yohan924-ops/L6790A-Single-Stage-PFC-LLC-Converter/Design Guide/generators/README.md

# 도구 체인과 함정 — `Design Guide/generators/`

**스크립트 하나하나가 무엇을 하는지, 표준 절차와 기대값, SMath 시트의 구조가 여기 있다.**
"이렇게 하면 파일이 안 열린다 / 조용히 틀린다" 의 함정 목록은 `.claude/rules/` 에 있고 해당 파일을
건드릴 때 자동으로 로드된다.

**무엇이 어디 있나**

| | |
| :--- | :--- |
| **§9 도구 체인** | 스크립트 하나하나가 무엇을 하는가 · 표준 절차와 기대값 · Stop hook · BOM 대조 규칙 · SMath 시트의 19개 절 구조 · 시트를 PDF 로 뽑는 설정 · 진단 프로브 시트 |
| **§11 도구 함정** | → `.claude/rules/{smath,xlsx,figures,an}.md` 로 옮겼다 |

**절 번호가 9 와 11 인 이유** — 원래 `CLAUDE.md` 의 §9·§11 이었고 2026-09-22 에 턴당
토큰을 줄이려고 여기로 옮겼다. 두 문서에 걸린 README §9.3b · README §11.1 D-25 같은 참조가
수십 개라 **번호는 그대로 두었다.** 설계 내용은 `docs/DESIGN.md` 로 갔고(절 번호 1.3 · 3 · 4.2 · 4.3 · 5 · 6 · 7 을 그대로 가져갔다), 작업 규약은
`CLAUDE.md` 의 "절대 규칙" 절에 남아 있다.

---

## 9. 도구 체인 — 이것으로 전부 재생성·검증된다

전부 `Design Guide/generators/` 에 있고, 경로는 스크립트 기준 상대경로다.

| 스크립트 | 역할 |
| :--- | :--- |
| **`l6790.py`** | **수치 정본.** 가이드 식 [1]–[106] + θ 스윕의 검증된 참조 구현. **`zvs_edge(Q, λ)` 신설**(2026-09-17) — 용량성/유도성 경계의 닫힌형. `phase()` 의 분자를 0 으로 놓은 `f_n²` 의 이차식이고 수치해와 5자리 일치한다. 게인 피크와 혼동하지 말 것 (시트 §6.1 항목 8b) |
| `l6790_validate.py` | `l6790.py`가 240 W 예제를 재현하는지 한 번에 확인 |
| **`build_l6790_smath.py`** | 정본 시트 본문. 실행하면 **`l6790.py`와 22개 항목을 자동 대조**하고 결과를 찍는다 |
| **`zedpane.py`** | **ZedGraph 판(BinaryFormatter blob)의 바이트 편집기.** 축 범위·눈금 간격·숫자 서식·제목/범례 문자열·선 굵기·로그↔선형. 전부 `Reference/Smath Bode Plot Example/Zedgraph` 의 ZedGraph 5.1 소스에서 나온 것이고 추측이 없다. **판 크기(`set_size`)는 쓰지 말 것** — 함수에 이유가 적혀 있다 |
| **`harvest_pane.py`** | **SMath 가 키운 판을 떼어내 이 프로젝트 것으로 만든다.** SMath 는 판의 곡선 목록을 입력 개수에 맞추고 저장 시 되쓰므로, 4곡선 판에 8개를 먹이고 저장하면 8곡선 판이 파일에 남는다. 그것을 `panes/*.b64` 로 보관하고 곡선마다 이름(`set_curve_labels`)과 굵기를 준다. **새 곡선의 Label 은 빈 문자열을 *참조* 하고 있어** 그 참조를 문자열 레코드로 바꿔야 한다. 첫 Label 은 클래스 정의 레코드라 이름(`ZedGraph.Label`)으로 찾는다 |
| **`zedsheet.py`** | **TI 앱노트 판 카탈로그(트레이스 1~5개)와 `make()`/`emit()`.** 어느 판이 로그 x + 선형 y 이고 어느 판이 전부 로그인지가 표로 있다. `build_gainzed.py` 와 `build_l6790_smath.py` 가 같은 것을 쓴다 |
| **`smsheet.py`** | 레이아웃 빌더. **모든 수식 문자열을 두 번 파싱한다** — 한 번은 SMath RPN, 한 번은 Python SI 값. 따라서 인쇄된 값이 옆의 수식과 어긋날 수 없다 |
| **`check_theta.py`** | **`prog` 블록(벡터 대입)을 검사하는 유일한 도구.** 다른 모든 수식은 `smsheet` 가 RPN 과 Python 으로 **두 번** 파싱하므로 인쇄된 값이 옆 수식과 어긋날 수 없는데, 벡터 대입은 인쇄되는 값이 없어 오타가 어디에도 안 나타난다 — 시트가 틀린 곡선을 그럴듯하게 그릴 뿐이다. 빌더에서 수식 **문자열을 꺼내** Python 으로 평가해 시트 §8 의 닫힌형과 대조한다(θ=π/2 에서 `f.sw.a`·`f.sw.b`, θ→0 에서 `f.o`, 그리고 시트 §7.5 의 `M.Z`·`M.OL`) |
| **`check_sm.py`** | 완성된 `.sm`을 다시 훑는다: XML 적합성 / 리전 겹침 / 우측 여백 초과 / 텍스트 재줄바꿈 / 허용 밖 함수 / 쪽수·그래프·노란 셀 수 |
| **`bom_compare.py`** | **엑셀 ↔ SMath BOM 29항목 대조** — 빠르다. hook이 매번 돌린다 |
| `fix_xl_cardano.py` | **`RTC` 격자 탐색을 Cardano 닫힌형으로** — 18블록(행 220–234). `rtc_check.py` 로 편차 0.0000 % 확인 |
| `fix_xl_fbcorner.py` · `fix_xl_fnmax_shared.py` | `Vin_max` 를 FB 코너(332.34 V)로 + `fn.max` 클램프. **후자는 공유 수식을 깨뜨려 되돌렸다** — `HISTORY.md` 시트 §3.7 |
| `fix_xl_ipri.py` | 1차 실효의 θ=0 끝점(자화 전류) |
| `fix_xl_f.py` | 실현 출력전압을 `Design Spec` 에 표기 |
| `fix_xl_cc.py` | **원인 B(C.18) 수정** — `CC` 에 θ 3열 + Simpson 적분(열 J)을 넣고 설계를 거기에 연결. 적용됨 |
| **`fix_xl_simpson_refs.py`** | **살아 있는 참조 위에 손으로 적은 상수가 얹혀 있었다** — C.18 이 `CC` 에 Simpson J열을 만들고 세 셀만 연결했다. `Power Components` D60·D61·D84·D85 는 θ=π/4 한 점(`CC!C..`)을 읽은 채 F열 손입력으로 덮여 있었다. J열로 연결하고 손입력 4칸 삭제 |
| **`fix_xl_comp.py`** | **kT 를 1 에서 2 / 1.5 로** — 데이터시트 max 는 25 °C 공정산포이지 온도가 아니다. 그리고 **`V.Fo` 1.45 → 1.15 V** — 이 한 입력이 두 문서의 R_B 창을 **겹치지 않게** 벌려 놓고 있었다. R_P 1.3 k · R_B 6.2 k |
| **`fix_xl_trunc.py`** | **[64] 가 [63] 과 다른 파형을 제곱하고 있었다** — 공진 위에서 사인이 잘리는데 실효값은 온전한 반사인파로 계산했다. `CC` 25·31·32행에 절단 인수 [64a]. **저입력에서는 인수가 정확히 1 이라 값은 하나도 안 움직인다** |
| `fix_xl_bodydiode.py` | 1차 스위치 블록에 바디 다이오드 역회복 **조건** 2행 (`Power Components` D74·D75) |
| **`fix_xl_fet.py`** | **FET 선정 결함 4건** — 1차 전류 정격을 합성 탱크 피크로 · 병렬 소자 수와 소자 1개당 전류 4행 · Rdson 온도계수 · 다이오드/SR 선택. `audit_fet.py` 가 찾아낸 것들 |
| `fix_xl_fnmax_num.py` | `RTC` 26·27행 `#NUM!` 288칸. 원인 E 이후 요구 게인이 무부하 점근선 아래로 내려가 `fn.max` 의 해가 사라졌다. `CG26` 의 가드를 전 열에 적용 |
| **`fix_xl_english.py`** | **워크북을 한 언어로.** 한글 57칸(CHANGELOG 50 + 라벨 7)을 영문으로. 수식·참조·수치는 손대지 않는다 |
| **`log_xl_findings.py`** | **셀은 안 건드리고 워크북 CHANGELOG 에만 기록한다.** 두 가지 — ① `CC` J열 Simpson(7점)과 시트의 5점 규칙을 2000구간 격자와 대조했더니 **0.0011 % · 0.0013 %** 낮다(성긴 적분이 정당하다는 증거가 없어 나중에 '개선'되거나 의심받을 자리였다) ② **`Design Spec D43`(fsw.max)은 탱크의 *상류*다** — `Res. Tank Design D13·D14` 가 그것으로 나누므로 **λ 를 계산하고 따라서 `L.m` 을 계산한다.** `Device Setting` 의 오실레이터 천장과 종류가 다르다 |
| **`log_xl_unlogged.py`** | **CHANGELOG 에 빠진 변경을 채운다.** ST 원본과 설계 시트 7장을 수식·상수 단위로 대조해, CHANGELOG 열 C 가 부르지 않는 셀에 한 줄씩 쓴다(Was/Now 는 두 파일에서 읽고 Why 만 적는다). 셀은 안 건드리고 calcChain 도 보존. 다시 돌려도 더하지 않는다. 인자로 변형 워크북을 줄 수 있다 |
| `fix_xl_causes.py` · `log_xl_causes.py` | **원인 A·C·D 의 셀 수정과 그 CHANGELOG 기록.** 이미 적용됐다. 다시 돌려도 안전하다 — 적용 여부를 보고 건너뛴다 |
| **`rtc_check.py`** | **`RTC` 격자탐색의 *답*을 독립 solver 둘과 대조** — 18점(θ 6 × 입력 3). 10,008셀을 읽는 대신 결과를 본다. 셋이 코드를 공유하지 않으므로 격자가 깨지면 반드시 어긋난다 |
| **`audit_xl.py`** | **워크북 구조 감사** — 죽은 셀 · 오류값 · 빈 셀 참조 · **선정값이 자기 한계 밖** · 수식에 박힌 상수 · 라벨/수식 방향 불일치 · **선정값을 무시하고 계산값을 읽는 곳** |
| **`audit_sm.py`** | **시트 구조 감사** — 죽은 변수 · 정의 전 사용 · **한계는 있는데 비교가 없는 짝** · 설명 없는 판정값 |
| **`audit_rpn.py`** | **`.sm` 의 RPN 을 되읽어 독립 평가.** 인쇄된 값은 smsheet 의 Python 계산이고 SMath 가 실제로 도는 것은 RPN 이다. 둘이 같은지 보는 유일한 검사 |
| **`audit_dim.py`** | **차원 해석.** 두 평가 경로 모두 단위를 스칼라로 다루므로 `V + A` 를 못 잡는다. 표시 단위가 계산 차원과 맞는지도 본다 |
| **`sr_xl.py`** | **1회성, 83차 적용** — STL160N10F8 데이터시트를 워크북에: `Power Components` C92 부품명 TPH3R70APL1 → STL160N10F8 · D96 `RD` 0.0037 → 0.0032 Ω · D98 `kT.sec` 1.9 → 1.5(둘 다 빌더 상수에서 읽음), `CHANGELOG_rev0_6` 에 기록, 변형 사본에 복사. 두 번 돌려도 같다 |
| **`lge200_xl.py`** | **LGE 구버전 워크북 이식, 2026-10-16** — LGE 가 ST 구버전(시트 보호) 워크북에 넣은 입력을 벤치 사본(`measured200_xl.py` 산출물) 위에 얹어 `Calculation Excel Sheet/variants/BENCH_200W_LGE_workbook_unencrypted.xlsx` 를 쓴다. 회로도와 대조해 17칸을 넣고(C_r 117 nF · BM 접지 · n_aux/n_sec 1.5 · c.HB 5529 pF(2.2 nF 스너버와 D–S 150 pF 포함, LGE 의 500 pF 대신) · 보상망 470 nF/4.7 µF/10 k/1.6 nF(사용자 채택 권장값, 보드는 아직 220 nF/2.3 µF/22 k) · V_Z 11.74 V(R197 100 k 결정) · UPC1008 CTR 0.54/0.65(UTC DS 곡선, 등급 최소) · 부품명 등) Vin.min 180 과 Vrect 0.395/STPS30M60S 는 넣지 않았다(사유는 스크립트 머리말). 캐시는 Excel 에서 열어야 맞는다. 기록: `docs/THREE_CORE_BOARD.md` |
| **`x3m3_xl.py`** | **3코어 670 W 워크북, 2026-10-18** — 가이드 워크북을 `Calculation Excel Sheet/variants/3CORE_670W_workbook_unencrypted.xlsx` 로 복사하고 두 설계가 다른 입력만 바꾼다. 값은 전부 `Smath/variants/L6790A_7p5to1_x3m3.sm` 의 입력 셀에 적힌 숫자에서 읽는다(표시값이 아니라 — R_T 는 표시가 한 자리라 7.7 로 읽힌다). 바꾸는 칸: 탱크 F9 · F43 · F44 · F45, `Device Setting` F24 R_T; LG 보드의 피드백 부품 · 출력 뱅크(V_Z 11.74 V · UPC1008G-LS04-R · TL431G-AE2-R · R_B · 보상망 · C_fx · PX 6800 µF × 11 · h 37 mm); 같은 보드의 1차단 c.HB 3329 pF · Cpar 400 pF(C115/C117 은 레그 양단이라 제외); SR TPH3R70APL1 3.7 mΩ · k_T 1.9. 가이드 워크북의 부하별 합성 피크 블록(`peak_xl.py`)은 복사에 따라온다. 확인: LibreOffice 재계산 사본으로 `SM_OVERRIDE=<x3m3 시트> XL_OVERRIDE=<사본> python xl_sm_compare.py` → 153/153, `rtc_check` OK. 가이드 워크북은 건드리지 않는다 |
| **`peak_xl.py`** | **부하별 탱크 피크 전류(자화 + 부하), 2026-10-18 · 10-19 다시 배치**(사용자 "수식이 너무 많고 뭐가 뭔지 모르겠다 — Res. Tank Design 에 기존 양식으로 간단하게"). 결과는 `Res. Tank Design` 70–79행, 기존 "Estimated transformer current" 표와 같은 Parameters / Name / Value / Unit 양식으로 7줄: I.Lm.pk(자화 피크, 어느 부하든) · I.Lm.zc(라인 영점 f.Min 의 자화 피크) · ld.add(부하전류가 피크에 더해지기 시작하는 부하, 50 % 점 기울기로 근사) · Ilr.pk.25/50/75/100. 중간 계산은 계산용 시트 `CC` 59–74행에 그 위 블록과 같은 모양으로(부하 0 · 25 · 50 · 75 · 100 % 를 C–G 열, 3차식으로 f_sw 를 다시 풀고 Itrafo · Ilm · r.mix · 합성 피크). 전부 살아 있는 수식이고 기존 칸은 바꾸지 않는다. 100 % 값은 `Device Setting` D32 와 1.0000. 시트 §9b 와 같은 계산 — `xl_sm_compare` 8항목. 멱등(CHANGELOG 표식). 세 워크북에 적용 |
| **`bench200_sync_xl.py`** | **200 W 벤치 워크북을 670 W 워크북과 맞춘다, 2026-10-18**(사용자 "서로 맞춰야 할 것은 맞추도록") — 같은 보드 하드웨어를 적는 다섯 칸만: t.D 270 → 220 ns · h 30 → 37 · ESR.single 30 → 50.7 mΩ · kT.pri 1.8 → 1.9 · Cpar; 두 번째 패스(같은 날, 사용자 지적)로 **c.HB 5529 → 3329 pF · Cpar → 400** — C115/C117 2.2 nF 는 레그 양단(VBUS–PGND)이라 중점 용량이 아니다. 실측 트랜스포머 · 실장 제어 부품 · 200 W 뱅크 · 보상망 · BM 접지 · R_CFG 는 그대로. 멱등 |
| **`fet_xl.py`** | **1회성, 81차 적용** — STO60N045DM9 데이터시트를 워크북에: `Design Spec` D46 `c.HB` 800 → 3028.98 pF(`l6790.PRI_FET` 로 계산, 손으로 적지 않음) · `Power Components` D58 `kT.pri` 1.8 → 1.9 · D72 `Cpar` 10 → 100 pF, `CHANGELOG_rev0_6` 에 기록, 변형 사본에 복사. 두 번 돌려도 같다 |
| **`gate_xl.py`** | **게이트 드라이버 선택 · 기동 조건, 2026-10-22**(사용자 아홉 차례 — 마지막: "출력 저항이 어디는 0 어디는 10.71 Ω — 뭔가; BOM 탭에도 게이트 드라이버단 회로도"). `Power Components` 에 행을 **끼워 넣는다**(`xl_rows.py`): **76–83** 스위치 게이트 데이터(C.g · C.gs.dev · R.g · V.pl · V.th · V.th.min · Q.gd · V.gs.max), **89–174**: 빈 행 2 · **91 "LLC Half Bridge Gate Driver Selection"** · 빈 행 2 — ① 드라이버 품번 + 데이터시트 값(노랑: I.so · I.si · V.test · V.cc.min/max · t.pd · MT · t.DT · f.max · I.Q · Rth.drv · Tj.max · V.bo.min · dV/dt.max · V.hs.max · V.IH.max · Ta.drv) 과 **출력 저항 R.o.src · R.o.sink 는 Value = V.test / I.so · I.si(단락 전류에서 유도), Selected Value(노랑, 비움) = 데이터시트가 직접 주는 값이 있으면 그것** — 계산은 Selected 가 있으면 그것, 없으면 Value ② 부트 다이오드 품번 + V.F · V.RRM · I.F · I.FSM ③ 턴오프 다이오드 품번 + V.F(0 = 없음, GOFF 분리) · I.F · I.FSM ④ 회로망은 한계 행 + 별도 Select 행(Value = 제안, Selected = 설계, 판정 없음): V.drv · R.on(max = 짧은 펄스 안 10 V, min = max(드라이버 온도, 소스 전류) − R.so − R.gi) · R.off(eff.max = min(겹침 · 소프트 턴오프 · Miller), min = 싱크 전류 · D.off 서지) · C.gs(max · min) · C.boot · R.boot(min = D.boot 서지) ⑤ 최종 값 — 판정 12(k.IG · R.off.eff · k.tD · k.tD.su · V.g.su · V.bs.1 · k.Miller · k.drv · P.drv(Ta.drv) · f.SU · k.D.boot · k.D.off); 회로도(`xl_gate_fig.py`: U.drv1 · D.boot · C.boot · R.boot · R.on · R.off · D.off · C.gs — BOM 이름과 같음)는 G 열. 옛 76–80행은 84–88, 옛 81–119행(2차 섹션)은 **175–213**. **`BOM&Schematics` 91–105 "Gate driver and gate network"**: 품번 표(U.drv1/2 · D.boot · D.off)와 값 표(V.drv · R.on · R.off · C.gs · C.boot · R.boot), 살아 있는 링크, **같은 회로도를 I91 에**, 틀 아래 테두리 행은 내려감(BOM 은 공유 수식이 있어 `xl_rows` 대신 손으로). `Res. Tank Design` 81–87: I.su · k.su.OCP2 · k.su.OCP1 · f.su.OCP1. 중간 계산 `CC` 77–167(L6790A 가정 셋: 기동 데드타임 420 ns · FB 버스 235 V · V.OH 4 V, 부트 다이오드 동저항 0.5 Ω 가정 — 부트 식 다섯이 (R.boot + 0.5 Ω) 로 통일). 선정값: 가이드 · 3코어 = 시트 §14c.1 부품에 V.drv 15 V(사용자), 벤치 = LGE 보드. 확인: 기존 셀 전부 같은 값, `xl_sm_compare` 153/153, `bom_compare` 29/0, `rtc_check` OK; 행 번호 도구 다섯은 새 번호 |
| **`restore_emf_xl.py`** | **ST 원본의 EMF 그림 셋을 되살린다**(2026-10-22, 사용자 "VCO 같은 회로 이미지가 다 지워졌다") — `Device Setting` I19 Picture 75(image9.emf) · I108 Picture 3(image8.emf) · `BOM&Schematics` C62 Picture 71(image8.emf). openpyxl 이 EMF/WMF 를 떨어뜨려("image format is not supported") 초기 사본에서 사라졌던 것. 앵커 행이 세 워크북과 원본에서 같아(확인함) 원본 앵커를 그대로 복사하고 rId · 도형 id 만 새로 매긴다, `[Content_Types]` 에 emf Default 추가. 멱등(앵커 이름 존재) |
| **`xl_rows.py`** | 워크북 한 시트에 **행 끼워 넣기**(Excel 의 행 삽입을 XML 로) — 그 시트의 셀 · 행 · 병합 · 범위 · 선택, 모든 시트의 그 시트 참조(범위 포함, 문자열 리터럴 제외), 그림 앵커 · 메모 · VML 앵커를 같이 옮긴다. 공유/배열 수식 · 조건부 서식 · 데이터 유효성 · 이름 정의 · 차트 참조가 있으면 거부 |
| **`xl_gate_fig.py`** | 워크북 게이트 드라이버 섹션 옆 회로도 `figures/xl_gate_drive.png` — 레그 하나: 하프브리지 게이트 드라이버(품번 · 핀 번호 없음, IN.H · IN.L · VCC · GND · BOOT · HO · HS · LO) · 부트스트랩(R.boot · D.boot · C.boot) · 스위치마다 R.on · R.off + D.off · 선택 C.gs. 초록 이름 = 워크북 행 이름, 값은 그리지 않아 세 워크북 공용 |
| **`xl_sm_compare.py`** | **엑셀 ↔ SMath 전량 대조 135항목** — 사양·전력예산·탱크·전류·출력뱅크·IC정수·루프·보상망. 차이마다 `same` / `INTENDED`(사유 인쇄) / `** DIFF` 로 판정. **워크북을 손댔으면 이걸 돌린다** |
| **`xlsx_patch.py`** | **워크북 XML 안전 편집.** `set_cell()`(교체-또는-순서맞춰-삽입) + 쓰기 전 전 시트 구조 검사. 인자 없이 실행하면 현재 워크북을 점검만 한다 |
| **`snapshot.py`** | **CLAUDE.md 시트 §3을 시트에서 다시 만든다.** `--check` 신선도 검사 · `--picks` 노란 셀(사람이 고른 값) 목록. 지난번 대비 무엇이 움직였는지 찍어 준다 |
| **`smresult.py`** | **`<result>` 블록의 값을 제대로 읽는다.** `<result>` 도 RPN 이라 첫 토큰만 읽으면 **단항 마이너스와 지수가 통째로 사라진다.** 도구 4개가 같은 가정을 독립적으로 하고 있었다 (`HISTORY.md` 시트 §6.6) |
| **`audit_fet.py`** | **1차·2차 FET 선정 파라미터 감사** — LLC 가 요구하는 항목별로 워크북 셀과 SMath 변수가 *있는지* 와 *수식에 쓰이는지* 를 따로 판정한다. 있는데 안 쓰이는 쪽이 더 위험하다 — 검토한 것처럼 보인다. 온도 정합성(Rdson 25 °C ↔ Tj 125 °C)도 함께 본다 |
| **`cores.py`** | **코어의 카탈로그 값과, 그것으로 푸는 권선 기하.** 코어는 하나 — **PQ 50/50(TDK B65981A · N97, 카탈로그 보빈 B65982E 12핀, `CHOSEN`, 72차)**. 3코어 설계점의 PQ 40/40 은 2026-10-01 에 지웠다. `CORES` 는 데이터시트의 전자기 값, **`MECH` 는 치수도의 기계 치수**(TDK PDF 벡터에서 읽음: 바깥다리 원호 반경 `r_win_out` 22.0 · 공차 끝 `r_win_min` 21.65, 나비넥타이 요크 `wing` · `leg_y`, 플랜지 끝 반경 `r_rim`, 튜브 `tube_od`/`tube_max`, 권선 폭 `wind_w` 30.4, 핀 피치). `zones(name, ρ)` 가 반경 ρ 의 한 턴을 바깥다리 옆 · 요크 밑만 · 코어 밖 세 구간 길이로 나누고(`YOKE_SHARE` 0.5 는 가정), `turn()` 이 그것으로 평균 턴을 낸다. **`winding(V)` 가 권선을 배치하고 `report(V)` 가 그 산수를 인쇄한다** — 단면도(`figs_ref.an_core_section`)는 결과를 그리기만 한다. **들어가지 않으면 `fits` 가 False, `why` 에 이유.** 배치는 **섹션 권선**: 튜브 쪽에서 1차 한 칸(`PRI_LAYERS` 3층 × 5 T, TIW-Litz `D_PRI` ø2.9) | 칸막이 `PARTITION` 3.0 mm | NS2 한 층 → NS3 한 층(`SEC_PER` 2 T 나란히, Litz `D_SEC` ø4.0) + NAUX, **턴당 한 가닥(`PRI_PAR` · `SEC_PAR` 1) · 뒤집기 없음**. 선경은 둥근 값으로 정했다(사용자). 층 사이 피치 `K_WIND` 1.10(가정), 층마다 테이프 `T_TAPE` 0.05 mm(가정), 축 방향 피치 `k_ax` 는 두 칸과 칸막이가 권선 폭을 정확히 채우도록 넓힌다. 반환값에 `build` · `room_min` · `clear_min` · `clear_nom`(원호까지 여유). 핀은 `BOBBINS` — 핀당 한 가닥, 센터탭은 보드에서 잇는다(핀 9 · 10). **핀 번호 방향은 도면의 1 · 6 · 7 · 12 표시에서 읽었다.** 옛 나란히 감기 + 포일 배치는 **`winding_v64()`** 로 남았다 — 이식 전 한국어판(`an_kr_body.py`)이 그 키를 읽기 때문이고, 이식 때 지운다 |
| **`bobbin_outline.py`** | **B65982E 보빈 윤곽을 데이터시트 벡터 도면에서 읽는다.** `data/TDK_B65982E_coil_former.pdf`(TDK databook 04/13 p. 287, 도면 FPK0433-H, 1:2) → `data/B65982E_outline.json`(밑면도 · 정면도 · 윗면도의 윤곽 · 숨은선 · 핀, mm). 굵은 선(0.57 pt)=윤곽, 짧은 점선(0.29 pt)=숨은선, 0.38 pt=핀; 치수선 · 글자 · 중심선은 버린다. **뷰 이름이 도면에 없어서 판단 근거를 코드에 적었다**: 핀 끝이 원으로 보이고 1 · 6 · 7 · 12 가 적힌 뷰(정면도 위)가 밑면도, 핀이 없는 뷰(정면도 아래)가 윗면도 — 제1각법. `--check` 가 도면 치수(핀 12개 · 줄 간격 45.72 · 피치 7.62 · 그룹 간격 12.7 · 높이 51 · 폭 51.6 · 실장면 위 높이 52.5)와 대조(선 두께 때문에 윤곽은 +0.4 mm 쯤). 그림 45(`figs_ref.an_xfmr_pins`)가 읽는다 — 핀 위치는 `cores.PIN_XY`(치수값), 윤곽 모양만 이 파일 |
| **`leakage_fem.py`** + **`fem2d.py`** | **그린 권선의 누설 — PQ 에서의 기준.** `fem2d` 는 2D 유한체적 A_z 풀이기(scipy), `leakage_fem` 은 `cores.winding()` 배치를 두 단면(바깥다리를 지나는 코어 단면 · 턴이 코어 밖으로 나가는 끝단 단면)으로 풀고, 반경마다 `cores.zones()` 의 턴 길이로 가중한다. `estimate(V, only='NS2'|'NS3')` 가 반쪽 단락, 기본은 둘 다 단락. `gap_len(V)` 는 L_open 에 맞는 갭(프린징 포함, 이분법), `proximity(V, f)` 는 스트랜드 와전류(부하 전류 + 자화 전류 직교 합), `dc_loss(V)`, `self_test()`(1D 닫힌 식과 5e-5), `report(V)`. 결과는 `.fem_cache.json`(무시 파일)에 저장. `MU_R` 2000 은 가정. 이 복사본 값: 반쪽 **NS2 24.50 · NS3 25.14 µH**, 둘 다 단락 **23.09 µH**(요크 몫 0–1 에서 21.89–24.29), 꽉 감으면 23.20, 칸막이 2.5 mm 22.50 · 2.0 mm 21.92, 갭 1.784 mm(프린징 없으면 1.341), 구리 직류 2.27 W |
| **`leakage.py`** | **1D 해석식 누설(Roth 급수 + 창 밖).** 턴 길이를 하나(`l_N`)로 두어 PQ 의 깊은 권선에서 **반쪽 순서를 거꾸로 낸다**(NS2 > NS3) — PQ 에서는 기준이 아니고 `leakage_fem.py` 가 기준이다. AN 의 1D 상한 추정 한 줄에만 쓴다 |
| **`figstamp.py`** | **그림이 낡았는가 — 다시 그리지 않고 판정.** `figs.save()` 가 PNG 마다 설계값 해시(`an_pdf.V` · `SH` · `cores.winding`)와 그린 함수의 소스 해시를 새기고, 이 스크립트가 지금 값과 대조해 `STALE` 을 찍는다(exit 1). **65차에 넣었다** — 64차가 `n.aux` · 개방시험 전류를 바꾸고 그림 1장만 다시 그려 핀 그림에 "NAUX 3 T", 기자력 그림에 15.19 A 가 남았고, 63차의 "2 ×" 수정도 `f13_morphing` PNG 에 반영된 적이 없었다. **Stop hook 의 6번째 검사.** 설계값이 움직이면 전 그림이 STALE 이 되므로 `figs.py --plain` 전량(약 10분) |
| **`insulation.py`** | **트랜스포머 안전 절연 — 미국 · EU · 일본 · 한국 · 중국 가정용 AV.** 요구치(강화 · 5000 m · 공간 4.5 · 연면 6.4 · 고체 0.4 mm / 테이프 2층 · 3000 V ac)와 **출처 URL**(`SOURCES`), 설계에서 추정한 작업전압(`working_voltage`), **경로마다 무엇이 절연을 맡는지**(`checks` — TIW 선재 · 핀 줄 간격 · 열린 항목 둘), 열린 항목(`OPEN`). `separation_min()` 은 "간격이 절연을 맡는다면"의 값(6.4 mm)으로 AN 6.17 과 `winding_v64` 가 읽는다. `cores` · 벤더 사양서 5절 · AN 7.12 가 여기서 읽는다. `python insulation.py` 가 보고서를 찍는다(약 20 s — `an_pdf` 를 읽는다) |
| **`figcheck.py`** | **그림 기하 검사 — `check_sm.py` 의 matplotlib 판.** 여섯 가지를 본다 — 글이 **남의 패널에 떨어지는가**(`wrong-panel`, 같은 자리의 twin 축은 한 패널로 친다) · **틀 밖으로 나가는가**(`off-page`) · 글이 **선 위에 앉았는가**(`on-ink`) · 글끼리 겹치는가(`text-text`) · **배선 5종**(`no-dot` 점 없는 T · `open-end` 허공에 끝나는 배선 · `crossing` 홉도 점도 없는 교차 · `off-grid` 45° 격자 밖 · `stray-dot` 두 가닥만 만나는 점) · **인쇄 축척에서 6.5 pt 미만 글자**(`tiny`, 실패가 아니라 보고 — 2026-09-23 부터 범례·눈금·축 이름·제목·`fig.text` 까지 잰다. 전에는 `ax.texts` 만 재서 11.6 in 폭 그림의 범례가 5 pt 로 인쇄돼도 통과했다. AN 에 배치되지 않은 그림은 인쇄 폭을 몰라 판정하지 않는다). **글·선 겹침은 픽셀로 잰다** — 그림을 두 번 렌더해(그대로 / 글자 alpha 0) 차이가 글자, 둘째 렌더의 잉크가 선이고, 겹친 픽셀 수를 센다(바닥 10 px). 꼭짓점만 보던 예전 검사는 점 2개짜리 배선 사이에 앉은 글자를 전부 통과시켰다. **검사 대상은 `figs.finish(fig)` 를 부른 뒤의 그림**이고 좌표는 `figs.saved_box(fig)` 기준 비율이다 — `bbox_inches=tight` 는 캔버스가 아니라 잉크를 자르므로 캔버스 기준으로 재면 1인치 넘게 어긋난다. `figs.save()` 가 저장 직전에 `shield()` 를 불러 **선 위에 앉은 글에만** 흰 후광을 입힌다 — 회로도 축은 건드리지 않는다(후광이 배선을 끊는다). `--crops DIR` 로 겹친 곳마다 확대 조각을 저장한다. 경위는 `HISTORY.md` 2026-09-21 |
| **`an_sentences.py`** | **긴 문장 찾기**(84차). 빌드된 PDF 의 글을 문장으로 잘라 길이 분포와 한계(기본 40 단어, 인자로 바꿈) 넘는 문장을 쪽 번호와 함께 낸다. 목차의 점선 · 표 칸 · 번호 목록은 문장이 아닌데도 섞여 나오므로 눈으로 거른다. `--kr` 은 한국어판(문장 끝의 마침표에서 자른다 — 어절 수는 기호 토큰 때문에 과소이니 글자 수로 볼 것; 84차 한국어 이식 때는 ast 로 소스 문자열을 꺼내 80자 기준으로 봤다) |
| **`diode_survey.py`** | **회로 다이오드의 인쇄 크기 조사**(84차). 그림을 figcheck 처럼 그려 기록된 `diode` 기호마다 지면 pt(figcheck 의 `_page_pt`)로 환산해 그림별 최소·최대를 낸다. 기준은 모드 시트의 16 pt; 절반이면 그 그림의 `ax._sym_mult` 를 올린다. MOSFET 바디 다이오드는 일부러 작게 그리므로 기록하지 않는다. `--kind mosfet` 이면 스위치 기호의 인쇄 높이(모드 패널 40 pt · 18 pt 에서 채널 막대가 붙었다) |
| **`an_figtext.py`** | **그림 속 글자 검사**(2026-09-23 신설, 53차). 다른 검사는 본문(`an_symbols`)이나 그림의 기하(`figcheck`)만 읽고 **그림 안에 그려진 기호·숫자는 아무도 읽지 않았다** — NS2/NS3 뒤바뀜, 같은 양의 두 이름(v_tank/v_d), 회로에 자리가 없는 파형 양이 거기 있었다. 그림마다 그려진 글자를 저장 시점에 모아 ① **UNDEFINED** 기호표에 없거나 그 그림 앞 본문·캡션·앞선 그림 라벨에 없는 기호 ② **LITERAL** 그림을 그린 함수들(프로파일러로 호출된 `figs*` 함수 전부)의 **문자열 리터럴 안에** 있는 단위 붙은 숫자 — 손으로 적은 값 ③ **USES** 기호별 사용 그림(이름 불일치 발견용)을 낸다. 약 6분. 남는 LITERAL 은 관례값(400 V 버스, 100/120/230 Vac 상용전원, 측정 조건 예, 180°)뿐이다 |
| **`schemx.nodot()`** | **도면이 “여기는 접점점을 일부러 안 찍었다” 고 선언하는 자리** (2026-09-21). 세 가닥이 만나면 관례는 점을 요구하므로 `figcheck` 가 `no-dot` 으로 잡는데, 뺄 이유가 있는 자리는 **검사를 느슨하게 하는 대신 도면이 사유를 등록한다** — 안 그러면 다음번 진짜 누락이 같은 침묵에 묻힌다. 검사기는 `nodot` 으로 **보고하되 세지 않는다**(레일 `stub` 과 같은 취급). 지금 쓰이는 곳은 8구간 시트의 센터탭 하나다 |
| **기호 크기 규칙** (`schemx.scale`) | **기호는 *자기 그림 폭에 비례* 한다** — 데이터 단위 고정도, 가지 길이 비례도 아니다. `scale = max(자기 폭 / `REF_SPAN` 22.45, (자기 폭 / 축의 그림 폭 비율) / `REF_FIGSPAN` 46.0)` — 바닥 규칙은 "종이 위에서 8구간 패널의 기호보다 작아지지 않는다" 는 뜻이다. **바닥은 축의 *명목* 위치를 읽으므로 `subplots_adjust` 를 그리기 *전에* 부른다.** **권선은 턴 *반경* 을 고정하고 턴 수를 높이에서 뽑는다**(반대로 하면 긴 권선의 턴이 커진다). 코어 바 길이는 턴 반경에 비례하고, 극성점은 리드선 **바깥쪽 · 첫 턴 높이**에 둔다. **`schem.ind` 의 리드 흡수 판정은 `s` 의 비율이 아니라 턴 반경의 절반이다** — 비율로 재면 큰 인덕터에 1 px 리드가 남아 **없는 3갈래 접점**을 만든다. 현재 값 cap 0.56–0.64 · res 1.15 · turn 0.26–0.30 · winding 0.54–0.60, 회로 다이오드 0.52/0.56, **바디 다이오드만 0.26**(기생 소자). **8구간 패널은 명시 크기를 쓰므로 픽셀 단위로 그대로다.** 경위는 `HISTORY.md` 2026-09-21 |
| **`audit_guide.py`** | **가이드 수식 태그 감사** — 중복 태그 · 끊어진 참조 · 코드에 대응이 없는 식 |
| **`an_pdf.py`** | **PDF 레이아웃 엔진 (영문·한국어 AN 공용)** — 표지·법적고지·점선 목차·머리글·번호 붙은 수식(matplotlib mathtext → PNG)·그림/표 캡션. `T()` 가 **포맷 안 된 `%%`·`%(…)` 를 거부**한다 |
| **`an_body.py`** | **AN 본문.** 레이아웃과 분리돼 있고 **손으로 적은 상수가 없다** — 전부 `an_pdf.V` 보간 |
| **`figs.py`** | 그림 생성 — 교육자료 영문 · 가이드 한국어. **한글 글꼴이 없는 PC 에서 한글 그림을 쓰면 죽는다**(2026-09-21 `_hangul_guard`) — 이 컨테이너에는 맑은고딕·나눔이 없어 한글이 전부 네모로 그려지는데 **파일은 그대로 써져서** 좋은 PNG 를 덮어쓴다. 실제로 `loop_bode.png` 가 한 번 그렇게 됐고 `git status` 가 잡았다. `save()` 가 쓰기 직전에 한글을 세어 글꼴이 없으면 그 장을 **건너뛰고**, 끝에 어느 장을 다시 그려야 하는지 찍고 **exit 2** 로 끝난다 (한국어 전용 5장: `fsw_theta`·`gain_regions`·`loop_bode`·`morphing_levels`·`tank_current`). 처음에는 예외로 죽였는데 그러면 **영문 배치 작업이 첫 한국어 그림에서 멈춘다** — 조용히 건너뛰는 것도, 전부 세우는 것도 답이 아니다.  수치는 전부 `l6790.py` 에서 가져온다. `f15`~`f17` 모핑 브리지 3장, `f19` 출력뱅크 판정식. **`--plain` 은 제목을 빼고 `figures/an/` 에 쓴다**(AN 용). **`_morph_levels(T)` 는 두 언어가 같은 그리기 코드를 쓴다** — 복사하지 말 것 |
| **`figtrim.py`** | **참조 PDF 에서 잘라 온 그림 아래에 딸려 온 *원문 캡션 조각*을 찾아 잘라낸다.** 서명이 분명하다 — **맨 아래 가장자리에 닿는 얇은 잉크 띠 + 그 위의 넓은 공백**. 진짜 그림의 패널은 이미지 경계에서 잘리지 않으므로 이 모양은 캡션 조각뿐이다. `--fix` 없이 돌리면 보고만 한다 |
| **`pdffig.py`** | **참조 PDF 에서 그림을 캡션째 잘라낸다.** 캡션을 텍스트로 찾아 앵커로 삼는다. 벡터 도면(onsemi·Infineon)은 위로 훑고, 래스터 그림(MPS)은 이미지 사각형이 곧 정답이다. `list`/`show`/`get` · `--box` 로 수동 지정 |
| **`figedit.py`** | **참조 그림에 가하는 *기록된* 편집.** **`fix_freewheel_2nd_half()`** 가 Infineon Fig 2.8 의 전류 경로를 다시 그리고(시트 §6.1 항목 8d), **`mark_modes()`** 가 그림 8 의 네 구간에 괄호를 친다(항목 8e). **`_font()` 는 Arial 이 없으면 Liberation Sans 로 간다**(2026-09-17) — 예전에는 `ImageFont.load_default()` 로 떨어졌는데 그것은 **크기 인자를 무시하는 비트맵 서체**라, Arial 이 없는 PC(이 컨테이너)에서 머리글이 의도의 1/5 크기로 조용히 그려졌다. 지금은 못 찾으면 예외로 죽는다. 이유는 둘뿐이다 — 잘라낸 상자가 라벨을 못 담았거나, 원문 기호가 이 문서와 반대 뜻이거나. 그림이 *주장하는 바*를 바꾸는 편집은 금지. `trim()`(`figtrim` 으로 캡션 조각 제거)과 **`mirror()`** 를 갖는다. **`mirror()` 는 이 모듈이 직접 쓴 파일만 `figures/an/` 로 민다** — `figures/` 와 `figures/an/` 는 같은 집합이 아니다. 생성 그림은 `figs.py --plain` 이 **제목 없는 판**을 `an/` 에 쓰므로, 전부 복사하면 AN 이 제목 붙은 판을 읽게 된다(2026-09-08 실제로 13장을 그렇게 덮었다) |
| `gate_budget.py` | 게이트 구동 예산(2026-10-18) — x3m3 시트의 f.SU · c.HB · T.T · C.g_hi · R.so/R.si 와 14c.1 의 [DS] 상수로, 세 회로망(LGE 보드 18 V/47 Ω · 시트 설계 14.35 V/4.7 Ω · 1206 제안 15 V/22 Ω)의 게이트 지연 · IC 가 줘야 할 데드타임 창(f.SU 와 운전) · 드라이버/저항/다이오드 손실과 접합 상승 · 부트스트랩 첫 펄스와 정상 상태를 표로 찍는다; R_on 훑기 포함. 인자 없음 **2026-10-21: `python gate_budget.py bench200`** — 200 W 벤치 보드(입력은 그 워크북의 F9 · F43–F45 · C_T · R_T · c.HB, 운전 주파수는 `l6790.sweep` 264 Vac HB, 런 전이는 자화 피크 · 373 V); 같은 날 x3m3 에서 c.HB 에 D–S 300 pF 를 두 번 더하던 줄을 고침(시트 c.HB 가 10-18 부터 포함) |
| `gate_wave.py` | **레그 전이의 시간 영역 해석(2026-10-21, 사용자 "게이트 저항 · 커패시턴스 · 스너버를 고려해 게이트 펄스가 느려지는 것까지")** — 게이트를 RC 하나로 보던 `gate_budget` 과 달리 레그를 회로 방정식으로 푼다(scipy LSODA): L6498LD 출력(R_so/R_si 상한, 지연 85 ns) · 켜짐 R_on · 꺼짐 (R_d + 다이오드) ∥ R_p · R_g,int 4.5 Ω · STO60N045DM9 의 C_gs 4.76 nF · C_gd(V_dg) · C_ds(V_ds)(데이터시트 그림 6 벡터, `data/STO60N045DM9_caps.json`) · 채널은 그림 4 전달 특성(0.5 A @5.06 V · 50 A @6.47 V) · 바디 다이오드 · D–S 스너버 · 중점 기생 · 탱크(기동: 출력 0 V 의 L_r–C_r, FB 는 반대 레그 거울상 · HB 는 C_r 에 V_bus/2; 운전: 자화 삼각파). C_oss 곡선을 0–400 V 적분하면 1369 pF 상당이라 표의 C_oss,eq 897 pF 에 맞게 C_ds 를 0.655 배(k.oss 1 도 함께 출력). 탱크의 정상 상태는 실제 스위칭 순간(중점 50 %)에 맞춰 네 번 반복. 출력: IC 에지부터 LS 채널 차단 · 중점 50/90 % · 스위칭 전류 · HS 채널 켜짐(0.5 A)과 50 A 능력 · 켜질 때 V_DS · 전류 반전까지의 여유 · E_off · E_on. 지금은 200 W 벤치 보드만 연결(`python gate_wave.py`, 약 30 초) |
| `trans_diagram.py` | 요구사양서(`build_trans_spec.py` nocore)의 결선도 — 26OP-LM83W 승인원 방식: 1차 핀 줄 ① ⓐ ⓑ ②(보조 a–b 는 NP1 안쪽, 2026-10-18 사용자 그림) · 코어 이중선 · 2차 핀 줄 ⑥ ⑤ ④ ③, 점은 감기 시작. `draw(lang, term)` 이 PNG 바이트를 돌려주고 빌더가 xlsx 에 박는다(파일로 남기지 않음); 단독 실행은 확인용 PNG 둘 |
| `lg_core_figure.py` | LG 26OP-LM83W(KH필룩스 승인원) 트랜스포머 하나의 구성도 → `docs/LG_26OP-LM83W_core_construction.png` · `.pdf`. EE6405 한 쌍 · 두 쌍 분해도, 윗면도(축척), 단면 둘. 치수는 승인원 5 · 6 · 11 · 17 · 18쪽에서 읽은 값만 쓰고, 승인원에 없는 갭 길이 · 리츠 외경 · 2차 동판 끝 모양은 위치만 그린다(2026-10-18) |
| `redexpert_read.py` | Würth REDEXPERT 가 내보낸 SVG 곡선(`Datasheet/Wurth_885342208026_REDEXPERT/`)의 빨간 베지어 경로를 좌표로 되돌려 ESR · DF · 임피던스 · 용량–DC 바이어스 · 용량–AC 를 표로 낸다(2026-10-18). 축 매핑은 SVG 의 눈금선에서 읽어 코드에 박았다 — 다른 품목의 내보내기에는 축 범위를 다시 맞출 것. 인자: SVG 폴더 |
| **`build_trans_spec.py`** | **트랜스포머 요구사양서(xlsx) 생성.** 인자로 변형(`7p5to1_x1`; **`7p5to1_x3m3` 는 2026-10-18 부터 `nocore` 모드** — 코어 · 보빈 · 핀 배치를 지정하지 않는 요구사양서: 단자는 26OP-LM83W 식, 코어 대신 A_e ≥ 220 mm² @75 mT · 구리 단면 · 권선이 보는 주파수(기동 포함)를 적고, **안전 절연 절은 없다**(2026-10-18 사용자: LGE 안전 설계 몫; 재질도 미지정). 컨버터 · 세트 결선은 적지 않고 트랜스포머 하나의 요구만 적는다(권선비 5 : 2 : 2 : 1 표제). **2절은 26OP-LM83W 승인원식**(2026-10-18 밤): 결선도(`trans_diagram.py`) + 권선 사양표(S → F · 턴수 · 선재 · 위치 — 리츠 가닥 수는 구리 단면에서 10 가닥 단위 올림, NAUX ø0.40), 권선 전류는 4절; 이 모드만 열 6개(정본 x1 은 5개 그대로). **같은 밤 "값만"**: 설명 글은 동등 선재 · 누설 허용폭 두 줄만 남고 조건 꼬리말 · 기동 주파수 · 양산품 언급은 없다. **`--kr` 를 더하면 한국어판 `…_KR.xlsx`**(문자열 표 `TXT`, Malgun Gothic; 이 컨테이너의 PDF 렌더는 WenQuanYi 대체 글꼴). 행 번호는 커서라 정본 레이아웃은 그대로(셀 전량 대조). `7p5to1_x3lf` 는 시트만)을 **반드시** 받고 `Calculation Excel Sheet/variants/` 에만 쓴다 — 인자 없이 돌려 정본을 덮어쓴 사고가 두 번 났다. **수치는 전부 변형 시트에서 읽는다**(2026-09-07). 손으로 박은 상수 때문에 6:1 사양서가 `f.Min` 을 90 kHz 로 달고 있었다(참값 110 kHz). openpyxl 로 새로 그린다. **단자(핀) 번호는 `cores.PINMAP` 에서 읽는다**(2026-09-21 20차 — PQ 40/40 12핀 배정, AN 그림·표와 같은 출처). **코어 개수·보조 턴수도 이제 시트에서 읽는다**(2026-09-21) — `"Three identical transformers"` 와 보조 `1 T` 가 글로 박혀 있어 `N.x` = 2 인 변형에서 거짓말을 했다. **`openpxxl` 오타로 import 단계에서 죽어 있었다** — Drive 임포트 커밋이 들고 온 것이고, 2026-09-21 에 고쳤다. **빈 칸에 빈 문자열을 쓰지 말 것** — 숫자 서식이 걸린 칸에서 `0.00` 으로 그려진다. 값이 `None` 이면 셀에 아무것도 안 쓴다 |
| **`check_trans_spec.py`** | **완성된 벤더 사양서 xlsx ↔ 변형 시트 대조.** 빌더의 상수가 아니라 **실제로 나가는 파일**을 읽어 턴수(NAUX 포함)·개방/단락 인덕턴스·전류·A.e·주파수·개방 시험 전류와 5절 절연 요구치(연면·공간, `insulation.py` 와 대조, 그리고 NP1 선재가 TIW 인지)를 본다. 포화 시험 전류는 **1차 피크가 아니라 자속 등가 전류**로 판정한다 — 개방 시험은 2차 기자력 상쇄가 없어 같은 전류로도 자속이 훨씬 크다 |
| **`an_patch.py`** | **AN 본문을 문장 단위로 갈아 끼우는 편집기.** `an_body.build()` 의 최상위 문장을 ast 로 잡아 **고유 키 부분문자열**로 통째로 교체하거나 지운다 — 긴 원문을 그대로 베낄 필요가 없어 오타로 헛매칭할 일이 없고, 키가 0개나 2개 이상 맞으면 **아무것도 쓰지 않는다.** 2026-09-22 간결화(373문장)에 썼다. 한국어판 이식에도 같은 방식 |
| **`an_symbols.py`** | **AN 이 쓰는 기호 전수조사 — 정의 없이 툭 튀어나오는 것을 잡는다.** 한 건이 실제로 나갔다(`a.s` 를 나누는데 소선이 뭔지 `a.s` 가 뭔지 앞에 한 마디도 없었다, 2026-09-22 사용자). **눈으로는 못 한다** — 100쪽에 67식이고 아래첨자 달린 이름이 수백 개다. `an_body.build()` 를 레이아웃 호출만 기록기로 바꿔 다시 실행하므로 **보간이 끝난 최종 문장을 문서 순서대로** 읽고 수식 PNG 는 한 장도 안 그린다. 이 문서가 쓰는 두 언어(수식의 TeX · 본문의 `X<sub>y</sub>`)에서 이름을 뽑고 아래첨자의 세 표기(`\mu`·`&mu;`·`mu`)를 접은 뒤 뒤쪽 기호표와 대조한다. 보고 넷 — **MISSING**(쓰는데 표에 없다) · **SILENT**(수식에만 있고 본문이 한 번도 안 쓴다 = `a.s` 그 자체) · **LATE**(본문이 수식보다 뒤에 쓴다) · **홑글자**(영문 산문에서 `C` 가 기호인지 100 °C 인지 기계가 못 가린다 — 그렇다고 말하고 목록만 준다). 첫 실행에서 **쓰인 기호 288개 중 175개가 표에 없었다.** 표는 10개 그룹 130행이 됐고 지금 MISSING 0 이다. 가다가 조판 결함 둘도 잡았다 — `\qquad` 가 다음 기호에 붙어 `\qquadf` 가 됐고 `2nV.o,eff` 가 한 단어였다 |
| **`an_kr_pdf.py`** · **`an_kr_body.py`** | **한국어판 AN.** `an_pdf` 를 임포트해 `use_korean()` 으로 NanumGothic 을 끼우고 `EQWORD`/`EQAGAIN` 만 바꾼다. **레이아웃 코드는 한 벌뿐이다** |
| `audit_notes.py` | **시트가 실제로 인쇄하는 주석을 `.sm` 에서 읽어 감사한다.** 표준 절차에는 없고 필요할 때 부른다 |
| **`an_check.py`** | **완성된 AN PDF 의 기하 검사 — `check_sm.py` 의 PDF 판.** 쪽마다 틀 밖으로 나간 것 · 텍스트끼리 겹침 · 그림이 글 위에 얹힘 · 110 dpi 미만 그림 · 원본과 종횡비가 다른 그림. **쪽 아래 여백은 실패가 아니라 보고만 한다** — 큰 그림이 남은 자리에 안 들어가 밀리는 것은 정상이다. 사람이 40쪽을 읽으면 사람이 알아채는 것만 잡힌다 |
| **`an_locate.py`** | **그림 검사 결과를 인쇄된 쪽 위에 되돌려 놓는다.** `figcheck` 의 보고는 **그림 *이름*** 으로 말하는데 PDF 에는 이름이 없고 **그림 번호와 쪽 번호**밖에 없다 — 즉 소스를 연 사람만 확인할 수 있는 보고였고, PDF 를 든 사람에게는 검증 불가능한 주장이었다(2026-09-21 사용자 지적). **이름 → 쪽 대응은 픽셀로 푼다** — PDF 안의 이미지는 `figures/an/*.png` 를 재인코딩한 것이라 바이트는 다르지만 화소는 같으므로 48×48 회색 서명으로 맞춘다(그림 41장 전부 매칭, 수식 PNG 48개는 자동으로 떨어져 나간다 — 그 자체가 검출력 확인이다). 번호는 그 이미지 **바로 아래 캡션**에서 읽으므로 독자가 보는 번호 그대로다. 출력 셋 — 표 · **`--mark` 빨간 테두리와 그림당 메모 하나가 박힌 PDF 사본**(뷰어의 주석 목록이 곧 할 일 목록이다) · **`--crops DIR` 인쇄 크기로 렌더한 뒤 확대한 조각**(5 pt 가 *얼마나* 작은지는 숫자가 아니라 크기로만 보인다). **이 PDF 에 없는 그림은 그렇다고 말한다** — `an_pfc_idea`·`f03_gain_walk`·`morphing_levels`·`an_architectures` 는 한국어판·교육자료 소속이라 영문 AN 의 결함이 아니다 |
| **`audit_md.py`** | **CLAUDE.md·HISTORY.md의 주장을 기계로 대조** — 경로 존재 · § 참조 · 개수·용지 수치 · 표 정합성. 문서를 고쳤으면 이걸 돌린다 |
| **`coldstart.py`** | **정보 없는 새 세션이 이 문서만으로 이어받을 수 있는지 모의 검증** — 답해야 할 질문 21개가 CLAUDE.md 안에서 답이 나오는지, 문서가 시키는 명령이 실제로 도는지 |
| `guard.py` | Stop hook이 부르는 검증기 — 시트 §9.1b |
| `build_probe.py` | 진단용 소형 시트 P1–P20 생성 |
| **`build_gatepower_smath.py`** | **`Smath/tools/STGAP3SXS_Gate_Driver_Power.sm`(2026-11-02, 사용자 "양전압 게이트 드라이빙 시 게이트 드라이버 손실 · 전류 계산 SMath 시트, 올린 21082025_Gate_Driver_Cal.sm 처럼")** — 같은 입력 · 같은 결과(t.r · t.f · 소스/싱크 피크 전류 · 게이트 구동 전력 · 25/45 °C 접합 온도)에 더해 게이트 전력을 드라이버 출력 · 외부 저항 · 스위치 내부 R_G 로 나눠 드라이버 몫만 발열로(옛 시트는 Q_g·V·f 전부를 드라이버에), 정지 전류 · 채널 수 · 병렬 수 · 저항 손실 · T_j,max 여유, C.eq = Q_g/V 로 본 타이밍. 예제 값(WG75N65MFW1 · 18 V · 85 kHz)은 R.g_int = 0 · I.Q = 0 에서 옛 시트 결과를 재현(152 / 85 ns · 1.125 / 2 A · 0.3213 W · +39 °C) — 빌더 자체 검사 `mismatches: 0`. 온도는 °C 숫자(단위 없음) | **같은 날 개정(사용자 "STGAP3SXS 를 쓴다 — 게이트 출력 핀이 하나, R_on 과 다이오드 + R_off")**: 회로망을 OUT – R_g,on – 게이트 · R_g,on 양단에 D_off + R_g,off(캐소드가 OUT 쪽)로 바꿨다 — 턴온은 R_g,on 만, 턴오프는 R_g,on ∥ (R_g,off + V_F)(테브난 R_eff · V_eff), 다이오드 · R_g,on 가지 피크 전류, 다이오드 경로 하강 시간(10 % 점이 V_eff 위인지 판정), 다이오드 손실 V_F·Q, 부품별 손실 합 = P_G 검산, 드라이버 소스 · 싱크 정격 · 다이오드 서지 · 평균 여유. 자체 검사는 턴오프 피크를 독립 절점 해석과 대조. **같은 날 사용자가 데이터시트(DS14758 Rev 3, 2026-10)와 평가 보드 데이터 브리프(DB5386 Rev 2)를 줘서 드라이버 값을 채웠다**: R_DON · R_DOFF 최대 0.80 · 0.65 Ω, I_GON · I_GOFF 최소 7 A(−40–125 °C), I_QH 최대 6 mA, I_QDD 최대 2.5 / 13 mA(IN+ 저 / 고 — 입력 듀티로 평균), CLAMPdrv 13 V, VH UVLO on 최대 14.3 V(S 변형), f_SW 1 MHz, R_thJA 65 °C/W(2s2p), T_J 125 °C. 손실은 최대값으로 잡아 상한. 회로망 예제는 평가 보드(R15 22 Ω · R18 2.2 Ω · D1 STPS2L40ZFY · SOFTOFF R19 10 Ω · 클램프 STL7N6F7). D_off(STPS2L40ZFY) 의 V_F · I_FSM 은 데이터시트가 없어 `[TBD DS]`, Q_g 는 여전히 WG75N65MFW1 예제. **같은 날 최소화**: 입력 · 피크 전류 · 상승/하강 · 손실 · 접합 온도만 남기고 중간값은 접힌 블록에(`Sheet.set()` 은 .sm 에 정의를 쓰지 않으므로 쓰지 말 것)
| **`build_gate_smath.py`** | **`Smath/tools/L6790A_gatedrive_x3m3.sm`(2026-10-22, 사용자 "SMath 시트도 새로 수정한 엑셀에 맞춰서" → "3코어용에다가; 드라이버를 L6498 하나만 쓸 것처럼 하지 마") — `gate_xl.py` 가 워크북에 넣은 게이트 드라이버 선택 · 기동 행의 SMath 쌍둥이, 기본은 3코어 670 W 워크북의 입력(인자 `x3m3`; `guide` 를 주면 가이드 워크북 판 `…_guide.sm` 을 만든다 — 커밋하지 않는다). 드라이버는 품번이 아니라 데이터시트 값 블록(게이트 시트 §4) — 제목에 "이번 빌드: L6498LD" 라고만 적고 모든 값은 노란 입력, 다이오드(게이트 시트 §5)도 같다.** 10절 · 347 리전 · A3 가로 14쪽 · 노란 입력 56. 식 · 이름 · 순서가 워크북과 같되 **선정값 여섯(V.drv · R.on · R.off · C.gs · C.boot · R.boot)은 게이트 시트 §6 에서 먼저 넣고 게이트 시트 §8 에서 한계와 대조**한다(SMath 는 위에서 아래로 계산하므로 워크북의 상호 참조를 그대로 둘 수 없다). 못 옮기는 것 둘: E12/E6 반올림(LOOKUP)은 반올림 전 값을 보이고 워크북이 고르는 값을 라벨에 적음; IF 분기는 설계대로 고정(D.off 장착, V.drv > 10 V, 출력 저항은 단락 전류에서) — 한계를 바꾸는 IF 둘(C.gs 만으로 게이트가 버티면 Miller 기준 제외, 킥이 V.th.min 을 넘을 때만 C.gs 필요)은 `abs()` 로 만든 계단 `s.M` · `s.hold` 로 정확히 재현. **빌더 끝의 자체 검사가 LibreOffice 재계산 사본의 값 82개와 대조**(`mismatches: 0` 이어야 함; 허용 2e-4). **`MIN`/`MAX` 보조 함수는 인자와 결과를 괄호로 감싼다** — 본 시트 빌더의 형태(괄호 없음)로는 `x/MIN(a,b)` 가 `x/(…)/2` 가 되고 `MAX(0, a-b-c, 'ohm')` 이 `c/'ohm` 만 나누어 12칸이 조용히 틀렸다(첫 빌드에서 잡음) |
| `smgen.py` | RPN 변환기 — `smsheet.py` 가 `expr_rpn`·`assign_rpn`·`rpn_xml`·`parse` 를 가져다 쓴다. **예전에 "구 산출물용, 안 쓰임" 이라고 적혀 있었는데 틀렸다** |

### 9.1 표준 절차

```
cd "Design Guide/generators"

python build_l6790_smath.py                                          # 시트 생성 + 자동 대조
python check_sm.py "../../Smath/L6790A_SingleStage_PF_LLC_Design_Guide.sm"   # 기하·함수 검사
python bom_compare.py                                                # BOM 29항목
python rtc_check.py                                                  # RTC 격자 18점
python xl_sm_compare.py                                              # 전량 101항목
python snapshot.py                                                   # CLAUDE.md 시트 §3 갱신
python check_theta.py                                                # 시트 §8.4·시트 §7.5 벡터 ↔ 시트 §8 닫힌형
python check_trans_spec.py                                           # 벤더 사양서 ↔ 변형 시트
python an_check.py                                                   # AN PDF 기하
python an_symbols.py                                                 # 기호 ↔ 기호표 전수 대조
python audit_md.py                                                   # 문서 주장 대조
python figstamp.py                                                   # AN 그림이 현재 설계값·그림 코드로 그려졌나 (65차)
python -c "import an_pdf,cores;print(cores.report(an_pdf.V))"          # 권선이 보빈에 들어가는가
```

> **설계점은 `7p5to1_x1` 하나이고 정본 시트 · 정본 워크북이 곧 그것이다**(변형 파일은 같은 바이트 사본, 2026-10-01). 다른 파일을 검사하려면 `SM_OVERRIDE` · `XL_OVERRIDE` 를 준다 — 예: 워크북 캐시가 낡았을 때 LibreOffice 로 재계산한 사본을 `XL_OVERRIDE` 로 `xl_sm_compare.py` · `rtc_check.py` 에 준다. **LibreOffice 는 기본으로 xlsx 를 다시 계산하지 않는다** — 사용자 프로필의 `registrymodifications.xcu` 에 `/org.openoffice.Office.Calc/Formula/Load` 의 `OOXMLRecalcMode` = 0 을 넣고 `soffice -env:UserInstallation=file://<프로필> --headless --convert-to xlsx` 로 변환해야 캐시가 바뀐다(81차, 그냥 변환하면 43건이 낡은 값으로 남았다).

**기대값:**

```
build      mismatches: 0
check_sm   VERDICT OK
bom        items compared: 29   different: 0
theta      mismatches: 0
rtc        대조 18점 · 최대 편차 0.20 % · VERDICT OK
xl_sm      대조 153항목 — 일치 153 · 의도된 차이 0 · 불일치 0
trans_spec 불일치 0 건
an_check   no geometry problems found
an_symbols 0 missing from the table
audit_md   no problems found
```

> `xl_sm_compare.py` 는 **이제 차이가 0 이다**(2026-08-23). 원인 A–F 를 전부 닫았고, 무엇을 왜 고쳤는지는 `HISTORY.md` 시트 §3.7 과 워크북의 `CHANGELOG_rev0_6` 76–79행에 있다. 아래 문장은 그 이전 상태를 설명한 것이다 — 남은 — 도구가 A–F 태그와 그룹 요약을 인쇄하고, `HISTORY.md` 시트 §3.7 에 표가 있다. 각 그룹 안의 두 수식은 글자까지 같고 값 하나만 다르다. 새 세션이 같은
> 5건을 다시 조사할 필요가 없다. `** DIFF` 가 하나라도 나오면 그것만 보면 된다.

**빌드 후 `check_sm.py`를 반드시 돌릴 것.** 현재 상태:

```
paper A3 Landscape 1654 x 1169 · regions 2663 · overlaps 0 · right overflow 0
page straddles 0 (한 쪽이 1120 px · 접힘 33개가 26063 px 을 숨긴다)
seam clearance 가장 아슬아슬한 곳 60 px · 여백 띠 위 60 / 아래 60
text re-wrap 0 · functions [abs atan augment cos el eval ln range sin sqrt vectorize] (전부 허용 집합)
height 91236 px, 그중 67682 px 이 인쇄됨 = 61 pages · plots 0 · zedgraph 7 · pictures 3
yellow inputs 207 · VERDICT OK
```

> **"몇 쪽"은 접힘을 뺀 높이로 센다.** 접힌 영역은 종이를 안 먹으므로 파일 높이를
> 쪽 높이로 나누면 64쪽이 나오는데 실제 인쇄물은 44쪽이다. 예전에는 그 64 쪽이 문서에 적혀 있었다.
>
> **쪽 경계는 이제 실측값이다 (2026-09-09).** `Smath/tools/L6790A_ruler.sm` — 20 px 눈금과
> **자기 y 를 적은 글자**밖에 없는 시트다. 수식이 없어 F9 가 무의미하고, 접힘이 없어
> 보이는 y 가 곧 절대 y 이고, 판이 없어 스스로 밀려날 것이 없다. 그래서 인쇄하면
> **SMath 의 경계 말고는 탓할 것이 없다.** 9쪽에서 읽은 첫 눈금이
>
> ```
> 24 · 1124 · 2244 · 3364 · 4484 · 5604 · 6724 · 7844 · 8964
> ```
>
> 이고, 쪽마다 마지막 눈금이 다음 쪽 첫 눈금에서 정확히 끝난다(1104+20 = 1124). 즉
>
> ```
> break(N) = N × 1120 + 4        PAGE_CONTENT = 1120 · PAGE_ORIGIN = 4
> ```
>
> **빌더가 쓰던 1117 · 오프셋 0 은 용지 크기에서 추론한 값이었고 틀렸다** — 쪽당 3 px
> 에 원점 4 px 이라 40쪽이면 124 px, 쪽 높이의 1/9 이다. **위 여백이 쪽마다 다르고
> 아래가 휑하던 것이 전부 이것이다.** 고친 뒤 43쪽 전부 위 여백이 정확히 60 px 이고
> 아래는 62 px 이상이다.
>
> **그리고 인쇄물이 이 모델을 채점했다 (2026-09-09, 13:22 판).** 43쪽 각각의 *첫 행*을
> 파일만 보고 예측해 PDF 와 대조했더니 **42/42 전부 맞았다**(당시 42쪽). 앞선 두 번의 역산이 실패한
> 것은 앵커로 쓴 행이 `fit()` 이 경계에 밀어 놓은 행이라 **모델이 자기 메아리를 채점**하고
> 있었기 때문인데, 이번 예측은 파일에서만 만들고 인쇄물이 독립 관측이라 그 함정이 없다.
> **쪽 경계 문제는 닫혔다. 띠를 키워서 고치려 하지 말 것.**

### 9.1b 자동 안전장치 — Stop hook (`.claude/settings.json`)

**지금 이 체크아웃에는 `.claude/` 가 비어 있다 — 훅이 없다.** 아래는 켜 두었을 때의 동작이고,
켜려면 `.claude/settings.json` 에 Stop hook 으로 `guard.py` 를 걸면 된다.

**턴이 끝날 때** `guard.py` 가 돌아, 추적 파일(시트·워크북·빌더 3종)이 **바뀐 턴에만** 검사한다.
통과하면 아무 말도 안 하고, 실패하면 **exit 2 로 턴 종료를 막는다** — ① 시트가 빌더보다 오래됐나
② `check_sm` VERDICT OK ③ `bom_compare` different 0 ④ `snapshot --check`(시트 §3 이 아직 시트를
설명하나) ⑤ `audit_md`(문서가 주장하는 경로·수치가 실재하나).

**④ 가 핵심이다.** 시트 §3 은 손으로 옮겨 적다가 실제로 낡았다 — 시트가 71.4 mF 일 때 문서는
80 mF 라고 적혀 있었다. **`guard` 는 시트를 절대 쓰지 않는다** — 재빌드는 판단이 필요한 행위이고,
시트에는 사용자가 SMath 에서 손으로 잡은 레이아웃이 들어 있을 수 있다.

### 9.2 BOM은 엑셀과 SMath가 항상 같아야 한다

`bom_compare.py`는 **엑셀 BOM 시트를 읽지 않는다.** BOM 셀은 링크이고 캐시값은 Excel이
재계산하기 전까지 낡아 있으므로, **링크가 가리키는 원본 셀**을 읽는다:

```
Res. Tank Design       F9 F43 F44 F45
Power Components       F7 D23 D24 D25 D38
Device Setting         F24 F45 D43 D46 F61 F83 F90 F91 F108 D21
CompensationNet&Check  D14 D36 F37 F41 F43 F93~F96
```

SMath 쪽은 `<result>`와 `<contract>` 표시 단위를 함께 읽어 환산한다.
**`<result>`는 이미 표시 단위 값이다** — SI로 착각해 또 나누면 전부 불일치로 보인다
(`HISTORY.md` 시트 §6.5).

### 9.3 SMath 시트의 구조 (19개 절)

| 절 | 내용 |
| :-- | :--- |
| 1–2 | 사양 · 사전 선택 (**노란 입력 셀 130개** — 시트 전체 기준) |
| 3–4 | 전력 예산 [6]–[17] · morphing 등가 입력 [18]–[20] |
| 5–7 | 권선비·요구 게인 [21]–[25] · 탱크 [26]–[35] · [43]–[45] · 최종 확인 [46]–[54] |
| 8 | **라인사이클 동작점 (닫힌형, `HISTORY.md` 시트 §2)** — HB/FB 양 코너, ZVS [38a] |
| 9 | 최악 코너 전류·응력 [63]–[70] |
| 10 | **라인사이클 실효값 (5점 Simpson)** — C_out 리플, 정류소자, 1차 |
| 11 | 출력 커패시터 [101]–[110] + **최악 위상 홀드업** |
| 12 | 트랜스포머 (LGE 3직렬 구조, A_L·자속). **개방시험 전류는 `L.mu_x` 로 나눈다 — `L.open_x` 가 아니다**. 시험 전류 자체는 시트 §14 에 있다 (시트 §6.1 항목 13) |
| 13 | 반도체 **요구조건** [111]–[121] — 소자를 고르지 않는다 |
| 14 | IC 주변 정수 [72]–[100] + **14b DS 동작 한계 13항 전수 판정** |
| 15 | 전압 루프 [122]–[132] (`K.HV`·`K.M`·`K.FF` 노출) |
| 16 | **보상망·옵토 바이어싱 [133]–[148]** — ST 도면 + 기호↔변수 대조표, 16.4 solver 없는 교차주파수, **16.6 보드선도 — ZedGraph 판 2장**, **16.7 ST 툴과 다른 점** |
| 17 | 설계 요약 (판정 지표 전부 "> 1" 형태) |
| 18 | 가정값 출처와 민감도 표 — [DS]/[TOOL]/[PICK] 구분 |
| 19 | **BOM — 전부 살아 있는 참조.** 각 행이 그 값을 만든 변수를 그대로 에코한다(`S.show`). 위쪽 노란 셀을 바꾸고 F9만 누르면 BOM이 따라온다. 부품번호만 텍스트 |

**시트 §16.6 보드선도** — **ZedGraph 판 2장**. 왼쪽에 |T|·|G_cto|·|EA| 를 **한 프레임에**
(|T| 가 나머지 둘의 합이므로 같이 봐야 한다), 오른쪽에 **루프 위상**. 양쪽에 `f.cross` 세로선이
서 있고 위상 쪽에는 목표 `Φ.M` 가로선이 하나 더 있다 — 여유를 **두 선이 만나는 자리에서 읽는다**.
**x축이 진짜 로그축이라 0.1 · 1 · 10 · 100 · 1000 Hz 로 읽힌다** — 예전에는 SMath 에 로그축이
없어 데이터에 `log10(f/Hz)` 를 넣고 눈금을 글로 설명했다.

> **위상 축 이름을 주의할 것.** 그리는 값은 `180° + arg T` 이고, **이것이 위상 여유가 되는 곳은
> |T| = 0 dB 인 한 점뿐**이다. 다른 주파수에서는 −180° 로부터의 거리일 뿐 여유가 아니다.
> 그래서 축 이름이 "phase margin" 이 아니라 `180 deg + arg T` 다.

그래프가 못 뜨더라도 판단이 가능하도록 **5개 디케이드 지점의 |T|·arg T를 일반 스칼라 행으로
따로 인쇄**한다. 이 스칼라는 루프 블록과 독립이므로, 곡선과 어긋나면 **틀린 쪽은 그래프**다.

**시트 §7.5 게인 곡선** — ZedGraph 판 **2장 · 각 8트레이스**. 계열이 *부하* 가 아니라 **라인 위상 θ** 다
— 단일단에서 동작 중 움직이는 것이 부하가 아니라 위상이기 때문이다. 반주기 동안 `Q ∝ sin²θ` 로 내려가고
요구 게인은 `1/sinθ` 로 올라가며, **그 두 발산이 상쇄되는 것이 이 토폴로지 전부**다.

| | 트레이스 |
| :--- | :--- |
| 두 프레임 공통 | `M.OL`(무부하) · `M(f_n)` at θ = π/2 · π/3 · π/4 |
| 왼쪽 @`V.in_min` | 그 세 위상의 **요구 게인 점선 3개** + **`M.Z`** |
| 오른쪽 @FB 코너 | 그 세 위상의 요구 게인 점선 3개 + **`M.inf`** |

**두 프레임의 차이는 점선 3개뿐이고 곡선은 같다 — 그것이 "입력 전압이 바뀌면 무엇이 달라지나"의 답이다.**
`M(f_n,Q)` 는 `λ.act` 와 `Q(θ) = Q.pk sin²θ` 로 정해지고 `Q.pk` 는 **전부하 라인 피크**의 값이라 입력 전압이
들어가지 않는다. `M.OL`·`M.Z`·`M.inf` 도 마찬가지다. **입력 전압은 `M.req` 로만 들어온다.**

> **그래서 라인 조건마다 프레임을 만들 이유가 없다** (2026-09-09 사용자 질문). 같은 그림을 여섯 번
> 그리고 수평선 3개만 옮기는 꼴이 된다. **그리고 이 두 장은 서로 다른 것의 최악이라 그 둘이어야 한다:**
> 왼쪽(최저 입력)은 요구 게인이 가장 높고 주파수가 `f.o` 에 가장 가까우므로 **게인과 ZVS 의 최악**,
> 오른쪽(최고 입력)은 요구 게인이 가장 낮아 주파수가 치솟으므로 **VCO 천장의 최악**이다.
> 110 V·230 V 같은 중간 조건은 둘 사이라 새로 보이는 것이 없다.
>
> **2026-09-09 에 여섯 조건을 한 장에 얹은 "개관 프레임"을 넣었다가 도로 뺐다.** 만든 이유는
> 110 V·230 V 의 동작점이 그림에 없다는 것이었고, 여섯 교차점이 시트 §8 의 Cardano 해와 정확히 일치해
> 검산이 되기도 했다. 뺀 이유는 둘이다 — **θ=π/2 한 점만 보는데 그 점이 모든 조건에서 가장 여유 있는
> 순간**이라 판정 그림 둘 사이에 놓이면 "곡선이 선 위에 있으니 통과"로 오독되고, 실제로 사용자에게
> 다섯 번 설명해도 전달되지 않았다. **설명이 다섯 번 필요한 그림은 제 몫을 못 하는 그림이다.**
> 그 동작점들은 시트 §8 에 숫자로 있고 시트 §14c 가 위상 축으로 그린다. 다시 만들지 말 것.

- **`M.OL`** = 무부하 게인(Q=0). `f_n0` 에 **극(pole)** 이 있고, 그 극이 `f_n0` 가 하한인 이유다.
- **`M.Z`** = **첨두들의 궤적 = 용량성/유도성 경계.** 닫힌형: `Q² = −2aλ/(f_n³·b·(1+1/f_n²))`,
  `a = 1+λ−λ/f_n²`, `b = f_n−1/f_n`. **`f_n0` 과 공진 사이에서만 존재**하므로(공진 위는 어떤 부하에서도
  유도성) 클램프하지 않고 **자기 x 벡터**로 그 구간만 그린다.
- **`M.inf` = 1/(1+λ.act) = 0.6857** — 무부하 게인의 절대 바닥. **`k.lam` 이 묻는 것이 이것**이다:
  9:1 은 `M.FBmax` 0.7928 > 0.6857 이라 무부하 해가 있고, 7.5:1·6:1 은 아래라 없다(워크북 `#NUM!`).

**시트 §14c 라인 반주기 (신설)** — ZedGraph 판 **3장**.

| 프레임 | 트레이스 |
| :--- | :--- |
| **`f.sw(θ)`** | 라인 조건 6곡선 + **`f.o`·`f.Min`·`f.r`·`f.sw_max_spec` 가로선 4개.** **`f.Max` 는 일부러 안 그린다** — VCO 천장 319.6 kHz 는 최고 트레이스(209.5)보다 반이나 높아 혼자 y축을 350 까지 끌어올리고 곡선 6개를 아래로 눌렀다. `k.ceil` 이 숫자로 판정하고, 그려지는 `f.sw_max_spec` 225 kHz 가 둘 중 낮은 천장이므로 **그것을 통과하면 `f.Max` 는 자동으로 통과**한다. **이 판만 y축이 `yauto`** 라 데이터를 따라간다 |
| `M.req(θ)` | 세 입력의 `M.pk/sinθ` |
| `P(θ)` | `2·P.out·sin²θ` × 100/75/50/25 % |

가운데가 핵심이다 — **`k.floor` 와 `k.ceil` 이 비율이 아니라 거리로 보이는 유일한 자리**이고,
첫 보드에서 스코프로 재는 첫 그림이다(`T.idle` 확정).

> **`f.sw(θ)` 는 시트 §8 의 3차식을 θ 로 훑은 것이 *아니다*.** 그렇게 만들었더니 **SMath 가 계산을 끝내지
> 못했다**(2026-09-08). 문제는 점 개수가 아니라 **참조 사슬의 깊이**였다 — θ → Q → a2,a0 → a1 → p,q → z → f
> 로 7단이고 단마다 여러 번 참조한다. **게인식을 주파수가 아니라 *위상* 에 대해 풀면 `sin²θ` 의 이차식**이
> 되어 닫힌형이 나온다:
> `Q.pk²b²s⁴ − s²/M.pk² + a² = 0`, `a = 1+λ−λ/f_n²`, `b = f_n−1/f_n`, **물리적 근은 마이너스 쪽**.
> `f_n` 을 `f_n0` 에서 시트 §8 이 이미 주는 코너값(`f.n.a`·`f.n.b`)까지 훑고 각 점의 θ 를 읽는다 —
> **`cos` 도 세제곱도 `acos` 항등식도 없고 사슬은 4단**이다. 양 끝이 곧 시트 §8 이므로 검산도 강하다
> (108.47 / 209.47 kHz 대 108.48 / 209.49, θ→0 에서 85.11 대 `f.o` 85.07). `V.in_nom` 곡선은
> 끝점이 시트에 없어 뺐다.

> **두 하한을 혼동하지 말 것.** `f_n0` 는 *무부하* 게인이 발산하는 주파수 = 어떤 부하로도 그 아래는
> 조정 불가. **용량성/유도성 경계는 그게 아니라 각 곡선 자신의 첨두**이고 부하에 따라 움직인다
> (전부하는 f_n 0.612). 둘 다 하한이지만 같은 하한이 아니다. `k.floor` 가 재는 것은 `f_n0` 쪽이다.

숫자를 새로 만들지 않는다; 시트 §17 이 비율로만 말하던 것을 한 프레임에 놓았을 뿐이다.

> **중첩된 분수·근호의 높이를 넉넉히 잡을 것.** `smsheet._rh()` 는 분수 한 단을 0.18줄, 근호를 0.40줄로
> 쳤는데 그건 **한 단에만 맞는 값**이다 — SMath 는 단마다 선과 위아래 여백을 그리고 근호는 내용에 따라
> 자라므로 부족분이 깊이에 따라 쌓인다. 그래서 깊게 중첩된 식만 위아래를 침범했다(2026-09-08 사용자 지적).
> 분수 0.35 · 근호 0.55 + 내용의 10 % · 함수 0.30 · 지수 0.90 · 상자 여백 22 px 로 올렸다.
> **그리고 `S.prog(h=...)` 는 이제 상한이 아니라 *하한* 이다** — 손으로 적은 `h` 는 검사되지 않는 추측이라,
> 추정값이 더 크면 추정값을 쓴다.

> **판 위아래 공간은 손으로 예약한다 — `check_sm` 이 원리적으로 못 보는 유일한 겹침이다.** SMath 는
> 프레임 아래에 **입력 행렬 이름을 한 줄씩 중괄호로** 그리는데 그것은 리전 **밖**이라 파일에 기록이 없다.
> `zedsheet` 의 `LEAD`(프레임 위) · `CAPTION` · `PER_CURVE` · `TRAIL`. **지금은 20 · 0 · 0 · 20 이다** —
> `showInputData="false"` 가 그 이름 목록 자체를 없앴으므로 자리를 예약할 이유가 사라졌다(예전 240 · 60 · 33 · 350 은
> 목록이 그려지던 시절의 값이고, 문서에 그대로 남아 있었다). **한 줄에 두 판을 놓으면 둘째는 `lead=False`.**
>
> **판 높이는 `ZS.fit()` 이 정하는 상한과 `emit()` 이 재는 잔여 공간 중 작은 쪽이다.** `emit()` 은 쪽에 남은
> 자리가 `KEEP` 배 이상이면 판을 줄여서 넣고, 아니면 다음 쪽으로 민다. **`KEEP` 은 2026-09-09 에 0.6 → 0.8
> 로 올렸다** — 0.6 에서는 같은 계열의 판이 637 · 952 · 577 로 제각각 나왔고 사용자가 그것을 손으로 키웠다.
> 0.8 이면 큰 판 다섯이 전부 **952(한 쪽에 들어가는 최대치)** 로 균일해진다. **대가는 두 쪽이다** — 42 → 44쪽이고
> 7쪽·27쪽 아래가 700 px 넘게 빈다. **판이 이 문서의 존재 이유이므로 종이가 지불한다.**
>
> **한 판이 쓸 수 있는 최대는 952 px 이다** — 띠 사이 1000 px 에서 위 20 · 아래 20+8 을 뺀 값. 그보다 크게
> 잡으면(사용자가 한때 1106 으로 했다) **어느 쪽에도 안 들어가 항상 회색 띠로 잘린다.**
> **한 줄에 두 판을 놓으면 둘째는 `lead=False`** — 아니면 여백이 두 번 들어간다.

> **벡터 원소 대입 안에 단위를 넣지 말 것.** 플롯 행렬은 순수한 숫자여야 하고, 단위가 붙은 값이 들어가면
> 그 자리에서 **바로 오류가 난다**(2026-09-08, `el(fs.1,k) := f.r/'kHz/…` 로 실제로 냈다). 시트 §16.6 이 이미
> 같은 규칙을 적어 두고 있었는데 시트 §14c 에서 어긴 것이다. 단위는 **눈에 보이는 스칼라 행에서 한 번씩** 뗀다 —
> `q.fr`·`q.fo`·`q.fmn`·`q.fmx`·`q.fsp`·`q.po`·`q.fc`. 그러면 읽는 사람이 위 행과 대조할 수도 있다.
> **`'kHz` 자체는 죄가 없다** — 시트가 식 안에서 13번 쓰고 프로브 P16 이 검증한 단위다. 자리가 문제였다.

> **`S.prog` 는 두 검사기의 사각지대다.** `smsheet` 는 prog 블록을 Python 으로 평가하지 않고,
> `audit_sm` 은 빌더의 `S.row/const/set` 만 훑었다. 그래서 시트 §14c 가 시트 §8 자리에 있으면서 시트 §14 의 `f.Min` 을
> 참조하던 **전방 참조를 아무도 못 잡았다** — 빌드는 깨끗하고 시트는 깨져 있었다. 이제 `audit_sm` 의
> **검사 6** 이 *완성된 `.sm` 을 리전 좌표 순서대로* 읽어 잡는다(빌더를 훑어서는 못 잡는다 — prog 문의 절반이
> `%s` 로 만들어져 이름이 소스에 없다). 리전을 뒤집으면 336건을 잡으므로 검출력도 확인됐다.

> **상수 선은 2점 벡터로 그린다.** 요구 게인·주파수 한계·목표 위상여유 같은 **가로선**을 스윕 전 구간에서
> 계산하는 것은 순수한 낭비다 — 직선은 두 점이면 정확히 같다. `k.2 := range(1,2)` 와 축 양 끝 벡터
> (`fx.2`·`tx.2`·`bx.2`)를 쓴다. **가로선을 2점으로 만든 것은 영구적이다** — 직선은 두 점이면
> 정확하므로 점을 더 줘도 산수만 는다.
>
> **스윕 점 개수는 2026-09-09 에 되돌렸다.** 2026-09-08 에 "계산이 너무 오래 걸린다"는 지적으로
> 절반으로 줄였다가, 곡선 해상도를 되찾으라는 지시로 **전부 2배**로 올렸다:
> `N.gc` 201→**401** · `N.mz` 120→**240** · `N.th` 121→**241** · `N.fs` 120→**240** ·
> `N.bp` 121→**241**. 원소 대입이 3,494 → **6,988** 이다(가로선 14개는 그대로).
> **`N.fs` 는 반드시 짝수로 유지할 것** — 홀수면 스윕 한가운데에서 거울상의 부호가 0 으로 나눈다.
> 다섯 개 전부 노란 셀이므로 느리면 시트에서 직접 되돌리고 F9 만 누르면 된다(재빌드 불필요).

> **판의 *창* 과 *범례* 도 구워진다 — `[BUILD]` 표시가 그 뜻이다.** `x.gl`·`x.gh`·`x.lo`·`x.hi` 를
> 고치면 **데이터만 넓어지고 프레임은 그대로**라 나머지가 잘리고, `r.g2`~`r.g6`(부하 분율)를 고치면
> 곡선만 움직이고 범례는 **옛 퍼센트를 계속 말한다.** 둘 다 F9 가 아니라 재빌드가 필요하다.
> **F9 가 안 통하는 노란 셀은 시트에서 이 아홉뿐**이라 라벨을 `[PICK]` 이 아니라 `[BUILD]` 로 달았다.
> 범례에 퍼센트를 적을 수 있는 이유가 이것이다 — 값이 아니라 **빌드에 고정된 라벨**이기 때문이다.

> **로그축은 `baseTic` 을 반드시 지정한다.** 자동이면 `ceil(log10(min))` 즉 **min 이상의 첫 온전한
> decade** 에서 눈금을 시작한다. decade 단위 step 이면 맞지만, **0.1 decade 같은 소수 step 이면
> 0.5~2.5 축이 1 부터 눈금을 그려 왼쪽 절반에 숫자가 하나도 안 나온다.** `zedsheet._logfit()` 이
> 모든 로그축에 `log10(min)` 을 박는다. (2026-09-08 사용자가 발견)

> **판 글자에는 계산값을 절대 넣지 않는다 (2026-09-08 사용자 지적).** ZedGraph 판은 **정적
> 바이트 덩어리**다 — 노란 셀을 고치고 F9 를 눌러도 판 안의 글자는 안 바뀌므로, 제목에 적힌
> "crossover 17.57 Hz" 는 곡선이 움직인 뒤에도 그대로 남는다. BOM 에 손으로 숫자를 적지 않는
> 것과 **같은 규칙**이다. 범례는 **값이 아니라 변수 이름**을 말하고(`Q = Q.pk x r.g2`), 값은
> 프레임 바로 위의 행에 있다. `zedsheet._no_values()` 가 소수점 있는 숫자가 들어간 판 글자를
> **빌드 단계에서 거부**한다.

### 9.3b 시트를 PDF 로 뽑을 때의 설정 (사용자 지정, 2026-09-09)

SMath 의 CLI(`-e`·`-p`·`-t`)는 이 PC 에서 라이선스로 막혀 있으므로 GUI 로 인쇄한다.

| 항목 | 값 |
| :--- | :--- |
| 실행 파일 | **`Solver.exe`** — `SMathStudio_Desktop.exe` 는 런처라 바로 종료된다. 프로세스 이름도 `Solver` 다 |
| 프린터 | **ezPDF Builder Supreme** |
| 인쇄 방향 | **가로** — 대화상자에서 직접 고른다 |
| 컬러 모드 | 컬러 |

**F9 를 먼저 누르지 않으면 플롯 행렬이 안 채워져 그래프 틀만 인쇄된다.**
기본 프린터를 바꿨으면 반드시 원복한다.

> **인쇄한 뒤 저장하지 말 것 — SMath 는 저장하면서 리전 좌표를 전부 다시 쓴다.**
> 순서는 **열기 → F9 → 인쇄 → 저장하지 않고 닫기** 다. 저장을 하면 시트를 다시
> 빌드해야 하고 F9 를 다시 눌러야 한다. 근거는 `.claude/rules/smath.md` 의 D-25.

### 9.4 진단 시트 `L6790A_probe.sm`

큰 시트가 안 열리거나 붉은 리전이 나오면 이것부터 연다.
**P1–P20이 각각 구성요소를 하나씩만 쓰므로, 처음 실패하는 번호가 곧 원인**이다.

| 프로브 | 검사 대상 | 기대값 |
| :-- | :--- | ---: |
| P1–P3 | 평문 수·단위·`<contract>` 표시단위 | 3 / 90 V / 150 kHz |
| P4–P7 | 소문자 `ohm`, 단위 상쇄, `sqrt`, 단위 있는 값의 비 | 0.024 ohm / 700 W / 1.4142 / 0.6 |
| P8–P9 | `atan` | 0.7854 |
| P10–P14 | `min`/`max`·`acos`·`tan` 대체식, `π` | 3·5 / 180 V·264 V / 1.0472 / 1.1918 / 3.1416 |
| **P15** | **시트 §8 Cardano 블록 전체 (k=1 분기)** | **q.x 1.43277, q.fn 0.83543** |
| **P16** | **본 시트가 쓰는 단위 21종 전수 (kohm·mohm 포함)** | 전부 1.0000 |
| P17 | 단위 있는 값의 비 → 비정수 거듭제곱 | 1.5239 / 1.2345 |
| **P18** | **`for`·`range`·`line`·`el` 루프 + 루프 안의 단위 처리** | −0.8000 / 40.0364 |
| **P19** | **`<plot>` 리전 자체** | 기울기 −20 dB/dec 직선, 44.0 → 4.0 dB |
| **P20** | **접기(`AreaRegion`)** | 접힌 상태로 열림 |
| P21–P26 | 벡터 안의 `cos` · 단항 마이너스 · `acos` 항등식 · 스칼라÷벡터 · f.sw 사슬 전체와 그 중간값 전부 | 전부 통과 |
| **P27–P29** | **팬 세로 길이를 무엇이 정하는가** — 같은 그래프를 손 안 댄 것 · 리전만 2배 · 리전과 블롭 rect 둘 다 2배 | **미확인 — `CLAUDE.md` 시트 §8.1** |

---

## 11. 도구 함정 — `.claude/rules/` 로 옮겼다

`.sm` 의 함정은 **`.claude/rules/smath.md`**, `.xlsx` 의 함정과 BOM 셀·사양 변경 시 같이 바꿀 셀은
**`.claude/rules/xlsx.md`**, 그림 규칙은 **`.claude/rules/figures.md`**, AN 규칙은 **`.claude/rules/an.md`** 에 있다.
해당 경로의 파일을 건드리는 세션에 자동으로 로드된다(2026-09-22). 번호 §11 은 옛 참조를 위해 남긴다.
