yohan924-ops/L6790A-Single-Stage-PFC-LLC-Converter/docs/DESIGN.md

# 설계 계획서 — L6790A 단일단 PF LLC

**이 문서는 설계 판단·현재 설계값·미확정 항목·동작 원리·반복 실수·핀 규칙이다.**
설계 수치를 쓰거나 설계 서술을 고치기 전에 읽는다. 세션 시작 시 자동으로 읽히지는 않는다 —
`CLAUDE.md` 가 필요할 때 이리로 보낸다.

**절 번호가 1.3 · 3 · 4.2 · 4.3 · 5 · 6 · 7 인 이유** — 원래 `CLAUDE.md` 의 절이었고
2026-09-22 에 여기로 옮겼다. `HISTORY.md` 와 `Design Guide/generators/README.md` 가 이 번호로
가리키므로 그대로 둔다. **주의:** 두 문서에서 "시트 §8 · §12 · §14 · §16.6" 처럼 8 이상은
대개 **SMath 시트의 절**(19개)이고, "시트 §1.3 · §3 · §4.2 · §6.1" 처럼 여기 있는 번호는
이 문서의 절이다 — 같은 접두어를 두 뜻으로 써 온 것이라 번호로 가른다.

---

## 1. 사양과 결정

### 1.3 아키텍처 판단 — 25 V 직출력 (확정, 2026-08-21)

ST 평가보드는 **48 V 중간 버스를 만든 뒤 후단 벅 3개**로 나눈다 (BUCK1 24 V/21 A → OLED).
즉 **ST 자신도 OLED 레일을 단일단 LLC로 직접 만들지 않는다.**
우리는 그 후단 벅을 없애는 구성이며, **그 대가가 75 mF 출력 뱅크다.**

사용자 확정 사항:

| 항목 | 확정값 |
| :--- | :--- |
| 아키텍처 | **25 V 직출력** (48 V + 후단 벅 안은 채택하지 않음) |
| 리플 허용치 | 최대 5 % (pk-pk) |
| 홀드업 | 12 ms · 최저 19 V · 최대 출력 전류 · @100 Vac |
| 홀드업 시작 위상 | **최악 위상 기준** — 리플 골(θ=45°)에서 AC가 끊기는 것이 최악이므로 `V_out − ΔV_pp/2`에서 시작 |
| 라인 주파수 | 47–63 Hz. **최악은 최소값이므로 시트 전체가 `f.line_min` = 47 Hz 기준** |
| 입력 브리지 | 양쪽 다 계산하고 시트에서 선택 (`s.br` = 1 동기 / 0 다이오드) |
| 1차 스위치 · 드라이버 · SR | **2026-10-01 사용자가 부품을 정했다** — 1차 STO60N045DM9(병렬 없음, 자리마다 1개), 게이트 드라이버 **L6498LD(SO-14) 2개**(레그마다 1개, L6790A 에는 드라이버가 없다), 2차 SR 컨트롤러 **TEA2095TE**(상세 설계는 하지 않는다 — 연결과 한계만), SR MOSFET 레그당 **2병렬**. 그 전의 "소자를 고르지 말 것"(요구값만 산정)을 대신한다. 시트 §13 · §14c.1–14c.3 |
| SMath | 사양 변경이 가능하도록 **전 입력을 변수로** |
| **VCC** | **보조권선 2T + 제너 레귤레이터** — 외부 VCC 를 쓰지 않는다 (2026-09-25 사용자, 2026-09-01 의 외부 12 V 결정을 뒤집음). 권선 → 다이오드 → C_aux → NPN 에미터 팔로워(베이스 = 15 V 제너, `R.BZ` **560 Ω** 급전) → 바이패스 다이오드(DS 5.1.8) → VCC · `C.VCC` **1000 µF**(2026-10-01, 실제 게이트 전하 · 드라이버 하한으로 다시 고름 — 전에는 820 Ω · 680 µF). VCC 13.6 V(12.85–14.35 V, 제너 ±5 %). **ST 워크북과 의도된 차이** — 워크북은 보조권선 직결을 가정한다(`k.auxr` 0.836 은 오류가 아니다). 시트 §14c |
| **보조권선** | **VCC 공급 + ZCD 감지.** `n.aux` = **1.0** → **2 T** (15:2 트랜스포머 한 개). V_aux 25 V. **삼중절연선(TIW)으로 2차 위에** 감는다 — 출력을 따라가야 `V.aux = n.aux·V.out` 이 성립하고, 1차 회로이므로 2차와 강화절연이 필요하다 |
| **권선비** | **세트 7.5 : 1 — 확정** (2026-09-21 사용자 정정). **트랜스포머 한 개, 1차 15턴 : 2차 2턴**(변형 이름 `7p5to1_x1`, 2026-10-01 부터 정본 시트 · 워크북 · AN · 벤더 사양서가 모두 이 설계점 하나). `n.T` 7.5 · `n` 6.0134 · `λ` 0.556 · `L.m` 45 µH(PQ 50/50 의 누설에 맞춘 탱크 L_r 25 · C_r 180 nF). 예전의 코어 3개 직렬(유닛 5:2) · 6:1 · 8:1 · 9:1 설계점은 지웠다 — 이 브랜치의 커밋 `0821491`, 근거는 `HISTORY.md`. **2026-10-07: 실제 시험 보드가 3코어(옛 탱크 C_r 100 · L_r 11 · R_T 11 k)라 그 변형 `7p5to1` 의 시트 · 워크북 · 사양서만 얼어 있는 사본으로 되살렸다** — `docs/THREE_CORE_BOARD.md` |
| **OVP1** | 목표 27.5 V 대신 **28.93 V** — `R.ZCD_H` 을 E24 **220 kΩ** 로 (계산값 208.17 k, `R.ZCD_L` 19 kΩ). 계산값보다 큰 E24 를 골라 리플 꼭대기에서 떨어뜨린다. OVP2 31.45 V, 기동 종료 17.11 V. **`n.aux` = 1.0 기준이다** (2026-09-25) |
| **절연** | **가정용 AV(TV) — 미국·EU·일본·한국·중국 전부를 한 구조로** (2026-09-25 사용자). 1차(NP1 · NAUX · 코어) ↔ 2차 **강화절연**, 5000 m(GB 4943.1-2022), PD2 · OVC II · 재료군 IIIb. **공간거리 4.5 mm · 연면거리 6.4 mm · 고체절연 0.4 mm 또는 테이프 2층 · 내전압 3000 V ac 60 s(4242 V dc)**. 수치와 출처는 `insulation.py`, 아래 §4.4 |

---

---

## 3. 현재 설계값 — **정본**

<!-- BEGIN GENERATED  ...  snapshot.py 가 씁니다. 손으로 고치지 마십시오 -->

SMath 시트에서 **기계가 읽어 적은 값**이다. 사람이 고치지 말 것 —
`cd "Design Guide/generators" && python snapshot.py` 로 다시 만든다.
시트를 바꾸고 이 블록을 갱신하지 않으면 **Stop hook이 턴을 막는다.**

```
탱크     Cr 180 nF · Lr 25 μH · Lm 45 μH · λ_act 0.556 · fr 75 kHz · fo 44.8 kHz
         Q_pk 0.863 · R_ac 13.65 Ω · n 6.013 · n_T 7.5
주파수   f_sw HB코너 62.2 kHz · f_sw FB코너 118.5 kHz · T_ZC 636 ns · k_ZVS 2.891
전류     I_sec,pk 99.7 A · I_Lr,pk 18.12 A · I_trafo,pk 16.58 A · I_Lm,pk 11.13 A
         I_pri,rms 13.5 A · I_pri,라인 10.41 A · I_diode 28.5 A · I_Cout 30.54 A
출력     Cout 개당 470 μF · 개수 160 · Cout 합계 75.2 mF · 리플 1.184 V · 리플 4.74 %
         홀드업 13.42 ms · k_hold 1.119 · ESR 뱅크 0.1875 mohm · R&N 18.2 mV · 개당 리플전류 0.19 A · 세라믹 10 μF
자기     직렬 개수 1 · Np 15 · Ns 2 · A_L 311 nH · B_pk 126 mT · A_e 필요 208 · k_Ae 1.594 · 개방시험 전류 14 A
IC       R_CS 24 mohm · 개당 120 mohm · 병렬 5 · I_OCP1 22.9 A · k_OCP 1.265
         R_T 22 kohm · C_T 470 pF · f_Min 48.3 kHz · f_Max 285.6 kHz
         R_CFG 30 kohm · V_BO 84.85 V · R_BM 30 kohm · C_in 2200 nF · n_aux/n_sec 1
루프     G_o 130.1 rad/s · EA_o 36.2 rad/s · f_z 6.05 Hz · f_p 47.3 Hz · f_px 999 Hz
         f_cross 17.57 Hz · Φ_M 49.64 ° · 3차 고조파 4.23 %
보상망   R_I 100 kohm · R_o 11 kohm · R_P 1.3 kohm · R_B 6.2 kohm · V_Z 12 V
         C_Fo 82 nF · C_F 560 nF · R_F 47 kohm · C_fx 1.55 nF
1차      V_DS 최소 485.4 V · P_in 684.8 W
```

**판정 지표 — 전부 "> 1" 이어야 한다** (시트 §17):

```
k.675 2.364          k.ADT_hi 1.909       k.ADT_lo 5.500       k.Ae 1.594
k.BO 1.061           k.CFG_hi 1.567       k.CFG_lo 2.000       k.CT_hi 2.128
k.CT_lo 1.741        k.CTd 1.293          k.CVCC 1.039         k.Caux 14.550
k.Cin 1.071          k.D3rd 1.182         k.DSsense 1.500      k.GM 3.418
k.Goff_D 2.400       k.Goff_avg 8.600     k.Goff_si 1.860      k.Goff_t 1.150
k.IDaux 1.773        k.LOUT2 6.960        k.NRCS 1.142         k.OCP 1.265
k.OUTdrv 1.286       k.OVP1 1.052         k.OVsat 1.258        k.PM 0.993
k.PSR 1.539          k.Pdrv 1.736         k.Ploss 0.324  <-- 미달 k.QgSR 1.599
k.RBSR 1.083         k.RBZ 1.172          k.RBZ_hi 1.020       k.RBZ_lo 1.039
k.RB_hi 1.051        k.RB_lo 1.070        k.RCS 1.022          k.RDSsec 1.539
k.RN 1.652           k.RP 1.106           k.RT_hi 1.395        k.RT_lo 4.300
k.RTd 1.079          k.RZ 1.075           k.SRVCC 1.208        k.SRdch 3.659
k.SRlo 1.129         k.SRpin 1.045        k.SU 1.416           k.TT 1.294
k.TTd 1.118          k.VBO 1.209          k.VCC 1.742          k.VCCdrv 1.176
k.VCClo 1.071        k.VCEOQ 1.950        k.VCaux 1.626        k.VDSsec 1.250
k.VGSR 1.040         k.VIH 1.600          k.VIL 2.375          k.VRbs 1.236
k.ZVS 2.891          k.auxr 0.836  <-- 미달 k.ceil 2.410         k.dvdt 1.222
k.floor 1.077        k.hold 1.119         k.lam 0.446  <-- 미달 k.pulse 10.810
k.tau_hi 1.188       k.tau_lo 4.042       k.thand 2.821

통과 72 / 75   미달: k.Ploss, k.auxr, k.lam   ← 아래 설명 참조
k.OVP1 1.052 은 V.OVP1_act 28.93 V, 목표 27.5 V, 하한은 V.out+5 % -> 합격
k.PM 0.993 은 Φ.act 49.64°, 목표 50°, 합격선 45° -> 합격
k.Ploss 0.324 는 1차 정적 도통 소자(LVG2) 9.62 W 대 잠정 예산 3 W. 어느 기술로도 소자 1개로는 불가능하다(열간 25.3 mohm 필요, 600 V 최선이 17 mohm@25C). **2026-08-24 사용자가 현 구성으로 확정** — 방열판 여부는 시제품 열 실측에서 판정한다. **오류가 아니다**
k.auxr 0.836 는 ST 툴의 **직결** 판정(보조권선을 VCC 에 바로 물릴 때 OVP2 에서 25 V 이하인가)이다. 본 설계는 2026-09-25 부터 보조권선 2T 가 **제너 레귤레이터를 거쳐** VCC 를 대므로 25 V 한계는 레귤레이터 출력에 걸리고 그것은 `k.VCC` 가 판정한다(시트 §14c). 워크북과 값을 맞추려고 계산은 남겨 둔다 — 워크북과 **의도된 차이**. **오류가 아니다**
k.lam 0.446 는 **무부하** 최소 게인 조건이라 전부하 판정과 무관하다. 무부하 게인은 점근선 1/(1+λ.act) 아래로 내려가지 않으므로 요구 게인이 그보다 낮으면 아예 해가 없다 — 그때는 버스트 모드가 맡는다. 9:1 은 231 kHz 에서 해가 있고 7.5:1 · 6:1 은 해가 없다. 가이드 부록 C.31. **오류가 아니다**
```

> 아래는 **판정이 아니라 그냥 비율**이다. "1 미만"이라고 문제 삼지 말 것:
> 

<!-- END GENERATED -->
### 3.1 왜 이 값들인가 — 놓치기 쉬운 선택 3가지

- **C_r을 계산값(94 nF)보다 크게, L_m을 계산값(22 µH)보다 작게** 잡았다. Q_pk를 낮추고 λ_act를
  지켜 ZVS 여유를 벌기 위해서다. 240 W 예제는 T_ZC 여유가 12 %뿐이었으나 여기는 108 %다.
- **CT(N_rect=1)를 택했다.** 25 V 저전압/대전류에서는 내압 여유보다 도통 손실이 지배한다.
  FB는 도통 경로에 소자가 2개라 **도통 손실이 정확히 2배**(9.6 W vs 4.8 W).
  부수 이득: ST 툴의 C.5 결함을 원천 회피하고 EVL 보드와 검증 경로를 공유한다.
- **권선비는 누설 통합형 N_p/N_s = 15/2 → n_T 7.5 → n 6.04.** LGE 기존 보드의
  3직렬 구조를 그대로 쓴다 (`HISTORY.md` 시트 §5.2). 도면에는 권선비뿐 아니라 **반드시 개방
  인덕턴스와 단락 인덕턴스를 함께 지정**한다 — n과 n_T를 혼동하면 게인이 통째로 어긋난다.

---

---

## 4. 미확정과 실측

### 4.2 아직 미확정 (잠정값으로 진행 중)

| # | 항목 | 잠정값 | 비고 |
| :-- | :--- | :--- | :--- |
| 0 | **1차 MOSFET — 확정** | STO60N045DM9 | ST MDmesh DM9 · 600 V · 45 mΩ max · TO-LL(드라이버 소스 핀). **fast-recovery 바디 다이오드**라 시트 §13.1b 요구에 맞다. 데이터시트 DS14711 Rev 4 를 2026-10-01 사용자가 줬다. `kT.pri` = **1.9** — Fig. 10 벡터 곡선에서 125 °C 1.898(전에는 사용자가 이전 판 곡선을 눈으로 읽은 1.8). `C.oss_tr` 897 pF(0–400 V) → `c.HB` = 2·897 pF·400 V/(√2·V.eq_min) + 100 pF = **3029 pF**(800 pF 가정을 대신, 400 V 전하를 그대로 써서 상한), `Q.ZVS2` 4.22 > `Q.ZVS1` 1.975 라 탱크는 그대로, `T.T` 170 ns. `Q.g` 는 Table 5 의 90 nC(0–10 V)와 Fig. 5 의 105 nC(12 V, 벡터)로 플래토 위 직선 `C.g_hi` 7.5 nF → 구동 전압에서 122.6 nC(14.35 V) · 142.5 nC(17 V). 열: R_thJC 0.4, 40×40 mm 2 oz 동박 R_thJA 22 °C/W → 정적 소자 9.27 W 면 204 °C 상승, **방열판 필수**(케이스–주위 10.4 °C/W 이하 @25 °C). `kT.sec` = **1.9** 는 2026-08-24 확정 (V_GS = 10 V 곡선, 25 °C 3.2 → 125 °C 6.1 mΩ). `kT.sec` = **1.9** 도 2026-08-24 확정 (V_GS = 10 V 곡선, 25 °C 3.2 → 125 °C 6.1 mΩ). **축이 Ta 로 적혀 있어도 "Pulse test" 라 다이가 자기발열하지 않아 Tj = Ta 다** — 펄스가 아닌 곡선이면 이렇게 쓰면 안 된다 |
| 1 | **T_idle** | 250 / 700 ns 병기 | 증거는 250 ns 쪽(`HISTORY.md` 시트 §4). **실측 전까지 확정 아님** |
| 2 | LLC단 효율 η_HB | 0.98 | 낙관적. 0.95로 바꿔도 R_CS·R_ac 3 %만 이동 |
| 3b | **2차 SR — 2 병렬로 확정** | 실측 판정 | **2026-08-24 확정.** `n.SR` = 2 · (당시) 3.7 mΩ · kT 1.9 — **83차에 STL160N10F8(3.2 mΩ · 1.5)로 바뀌어 `k.PSR` 1.539**. 소자당 14.15 A rms · 49.2 A peak · **1.41 W**, 레그당 2.82 W 로 **`k.PSR` = 1.065** — 3 W 예산을 거의 다 쓰지만 그대로 간다. 3 병렬이면 1.598 로 회복되나 채택하지 않았다. **패키지 전류정격(리드·클립)을 다이보다 먼저 확인할 것** |
| 3 | 출력 커패시터 뱅크 부피/높이 | 미정 | 75.2 mF / 30.2 A rms. 세트 공간이 안 되면 재설계 |
| 4 | 대기전력 목표 | 미정 | 버스트 진입점 `r.BM` = 0.11 가정 |
| 5 | **1차 손실 — 예산 미달을 감수하기로 확정** | 실측 판정 | **2026-08-24 확정: 현 구성 그대로 간다.** `n.par` = **1**, 병렬도 GaN도 쓰지 않는다. HB 모핑에서 정적 도통 소자(LVG2)가 탱크 전류 전체(10.9 A rms)를 연속으로 흘려 **9.62 W**, 요구 Rth(j-a) **10.4 °C/W**. 어느 기술로도 소자 1개로는 3 W 가 불가능하다 — 열간 25.3 mΩ(25 °C 기준 약 14 mΩ)이 필요한데 600 V 급 최선이 17 mΩ 이다. **방열판을 쓸지는 시제품 열 실측에서 결정한다**(시트 §4.3 항목 11). 스위칭 3자리는 4.81 W 로 문제없다. **`k.Ploss` = 0.312 는 이 결정의 결과이지 오류가 아니다. 다시 열지 말 것** |
| 5b | **`R.T` — 21.5 kΩ, 시제품 실측 후 결정** (2026-09-30, PQ 50/50 탱크) | `R.T` 21.5 kΩ | **트랜스포머 공차와 영교차 dead zone 을 `R.T` 하나로 맞바꾸는 관계다.** 이 탱크(L_r 25 · L_m 45 µH · C_r 180 nF)는 f_o 44.84 kHz, `f.Min` 48.29 kHz, `k.floor` 1.077 — 견디는 L.open 하락 `1−1/k.floor²` = **13.8 %** 라 **±10 % 공차가 들어간다**(ETD 54 탱크의 23.2 kΩ · 4.4 % 와 다르다). 대가로 `f.Min` 이 f_o 보다 7.7 % 높아 영교차 dead zone 이 넓어진다 — **이 탱크의 dead zone 비율은 다시 계산하지 않았다**(ETD 54 탱크의 표는 이 탱크 값이 아니라 지웠다). `R.T·C.T` 10.1 µs 로 DS 범위 2.5–12 µs 안. 영교차에서 칩이 실제로 f.Min 까지 내려가는지는 초안 DS 가 공개하지 않아 모른다 — "f.Min > f.o" 는 그렇다고 가정한 안전 규칙이다. 판정 실측은 §4.3 1 · 6 · 12 |
| 5c | **2차 SR 병렬 수 `n.SR`** | 2 (해소) | 9:1 에서는 `k.PSR` 0.929 로 미달이었다. **정본이 7.5:1 이 되면서 `k.PSR` 1.063 으로 통과** — 3 병렬로 올릴 이유가 없어졌다(3b 의 2 병렬 확정과 같은 값) |
| 5d | **코어 — TDK PQ 50/50(N97, B65981A) · 카탈로그 보빈 B65982E + 칸막이 3.0 mm** | `k.Ae` 1.594 | 시트는 필요한 **`A.e ≥ 208 mm²`** 와 자속을 계산하고, `A.e` 는 `cores.CHOSEN` 에서 읽는다(332 mm², `B_pk` 125.5 mT). 권선창 · 권선 배치 · 누설은 `cores.py` · `leakage_fem.py` 와 AN 7장. 2026-10-01 전까지 정본 시트는 코어 3개 자리표시자(EE6405, 113.1 mm²)였다 |
| 6 | 부록 C.9의 근거 불명 상수 | — | [28]의 π²/8, [36]의 지수 5, [128]의 0.744, K_HV |
| 7 | EVL 보드의 n = 3.2가 n인지 n_T인지 | — | 트랜스포머 실측으로만 판정 가능 |
| 8 | LGE 기존 보드의 동작점 | 버스 400 V | **버스는 400 V 로 확정**(1차 소자가 650 V 라 640 V 불가). 2차는 **직렬**이고 3개가 하나의 15:3 으로 동작한다(병렬이면 B_pk 356 mT 로 포화). 다만 그러면 요구 게인 0.536 에 부하 Q > 1 이 되어 **아직 안 닫힌다** — C_r 실측 또는 PFC단 도면 필요. `HISTORY.md` 시트 §5.2a. **우리 설계에는 영향 없다** |
| 9 | **`k.ZVS` 가 한 점만 본다** | **정본(7.5:1) 도 낙관적** | 시트는 `T.ZC` 를 **저입력 코너 전부하** 한 점에서만 잰다. 그 점은 *게인* 최악점이고 ZVS 최악점이 아니다 — 부하를 덜면 게인을 깎으려고 `f.sw` 가 올라가 자화전류 피크 `V.in/(4 f.sw L.m)` 가 떨어지는데 중점 용량은 그대로다. 부하·등가입력 2차원 스윕: **9:1** 530 ns @ 저코너 전부하(시트 2.408 과 일치) · **7.5:1(정본)** 401 ns @ 고코너 25 % 부하(시트 2.091 → **실제 1.824**) · **6:1** 363 ns @ 고코너 50 % 부하(시트 2.073 → **실제 1.649**). **셋 다 여전히 통과하므로 설계 변경 사유는 아니다.** `n` 이 큰 9:1 만 전부하 코너가 최악이었다. 시트에 부하 축을 넣는 것은 시트 §8 Cardano 블록을 부하마다 반복해야 해서 큰 작업이라 미뤄 두었다 — AN 은 이미 2차원으로 훑어 보고한다(`an_body._zvs_grid`). `HISTORY.md` 2026-09-08 |

> **1–5는 전부 SMath 시트의 노란 셀이다.** 값이 정해지면 셀만 고치고 F9.
| 10 | **보조권선 VCC 레귤레이터의 가정** | 시트 §14c.2 | 2026-10-01 실제 부품으로 다시 계산했다 — `I.VCC` = I_CC + 드라이버 정지전류 1.2 mA + 4·Q.g_run·f.Max = **144.3 mA**(전 92.8). 기동 하한은 L6790A 의 8 V 가 아니라 **`V.CC_floor` 10.61 V**(L6498 플로팅 권장 최소 9.3 V + 부트스트랩 다이오드 1.0 V(가정) + 리플 0.31 V). 기동 전류는 f.SU 를 T.OSC_SU 1 ms 동안만(DS: 16단계) 쓰고 그 뒤는 f.Max, 게이트 전하가 VCC 를 따라 줄어드는 것을 ln 으로 적분 → `C.VCC_req` 884 µF → **1000 µF**(230 Vac 첫 펄스까지 1.89 s), `R.BZ_max` 656 Ω → **560 Ω**(`P.DZ` 393 mW, `P.Qpass` 2.12 W · 공칭 1.44 W). `β.min` 50 · `I.DZ_min` 1 mA · 제너 ±5 % 는 **부품에 거는 요구값**이고, `V.F_j` 0.7 V · `V.F_bs` 1.0 V 는 가정. `t.hand` 는 **부하 없이 정격 전류로 출력 뱅크를 채운다**는 가정(TV 가 패널 부하를 레일이 선 뒤에 거는 경우) |
| 12 | **절연 — 규격 원문 미확인** | `insulation.py` | 표 값은 규격 원문이 아니라 제조사 세미나(PI · ATIS · TI)와 **CB 시험성적서 2건**(TÜV · UL)에서 읽었다. 작업전압은 설계에서 **추정**(187 V rms, 373 V pk @264 Vac)했고 인증기관이 측정한다. 30 kHz 초과 공간거리 표, 개정판(ed.3/4)의 내전압 값, 양산 내전압, 2차 리드·핀 ↔ 코어 거리, TIW 승인 주파수(500 kHz, 이 탱크의 `f.SU` 477 kHz 는 그 아래 — Lr14 에서는 503 kHz 로 넘었다)는 **인증기관·벤더 확인 항목** |
| 13a | **게이트 드라이버 L6498LD · SR TEA2095TE** | 시트 §14c.1 · 14c.3 | 내장 부트스트랩 DMOS(175 Ω)는 f.Max 에서 14.0 V 를 떨어뜨려 쓸 수 없다 → **외부 고속 다이오드**(VCC→BOOT, 1차 스위치급 내압, 부품 미정), C.BOOT 470 nF. `k.TTd` = (t.D − MT 30 ns)/T.T = 1.118 — **L_r 23.5 µH 아래면 1 미만**(FEM 하한 23.3 µH 바로 위, `an_body._ttd_lr_edge`). 드라이버 손실 0.537 W/개(출력 저항을 단락전류로 잡은 가정), 중점 기울기 40.9 V/ns(I_Lm,pk 기준, 공진 위에서는 더 클 수 있다 — 실측). LOUT2 → LIN 풀다운 58 kΩ min 은 FB/HB 판별을 해치지 않는다(`k.LOUT2` 6.96). DRV_EN 은 L6498 에 EN 이 없어 개방. **SR MOSFET 은 STL160N10F8**(2026-10-02, DS14249 Rev 5): 3.2 mΩ max · k_T 1.5(Fig. 13 벡터 1.504 @125 °C) → 소자당 0.974 W, 합 3.90 W(`k.PSR` 1.539), 100 V/80 V(`k.VDSsec` 1.25), Q_g,sync 72 nC + 7.96 nC/V × 1.2 V = 81.6 nC(`k.QgSR` 1.599). Q_g 와 k_T 는 typ 값뿐. **TEA2095TE 전원은 시트 §14c.4 의 15 V 제너 팔로워**(13.55–15.05 V, 150 mA 로 크기, 실제 94.2 mA, Q_SR 1.01 W 공칭). TEA2095TE 방전 기능(1.1–1.7 s 무동작 → 0.4 W)이 무부하 딥버스트와 겹치는지 실측. **84차(2026-10-04)**: 게이트마다 **턴오프 경로 D_G,off 1N4148W + R_G,off 2.2 Ω**(R_G 4.7 Ω 에 반병렬; I_pk 0.83 A · 플래토까지 101 ns vs 117 · s.drv 0.564 · P.drv 0.576 W, 시트 §14c.1). **Q_VCC · Q_SR = FZT651**(SOT-223, 컬렉터 패드 50×50 mm 2 oz 41.7 °C/W → 허용 주위 62 / 54 °C; 25×25 mm 면 18 °C — 시트 §14c.5). D_BS **ES1J**(V_F 1.30 V @1 A 로 시트 갱신). **TEA2095TE VCC 는 R_SR 10 Ω + C_SR 100 nF ‖ 2.2 µF**(k.SRpin 1.045; 100 nF 만이면 0.915). 옵토 SFH617A-2(CTR 값은 설계 pick — 곡선으로 확인), **TL431 두 개 다 B 등급**(R_B 창: B 1.020 · A 1.012 · 무등급 0.998). V_Z 레일은 시트 §16.1b(R_Z 2.2 k · R_Z1 38.3 k · R_Z2 10 k · C_Z 10 µF · Q6, 11.80–12.30 V). **남은 가정**: FZT651 h_FE 70 min 은 데이터시트 표 값(I_C 조건은 미대조) · 1N4148W 반복 피크 정격은 없어 IFSM(1 µs)과 평균으로 봤다 · R_sink 4.5 Ω 가정 |
| 13 | **AN 예제 트랜스포머 — TDK PQ 50/50(N97, B65981A) · 카탈로그 보빈 B65982E(12핀) + 칸막이 3.0 mm** | 시제품 실측 | 2026-09-30(72·73차). ETD 54 의 1차 3다발 · 층마다 뒤집기가 양산 불가라 버리고(사용자), 데이터시트 보빈이 있는 코어 중 **턴당 한 다발 · 층마다 권선 하나 · 뒤집기 없음**으로 반경을 채우는 것이 PQ 50/50 뿐이었다(`HISTORY.md` 72차). 치수는 TDK PDF 벡터에서 읽었다(바깥다리 원호 ø44, 나비넥타이 요크, 플랜지 끝 반경 21.3–21.6). **NP1 15 T = 3층 × 5 T, TIW-Litz ø2.9(401 × ø0.10) · 칸막이 3.0 mm · NS2 2 T 한 층 → NS3 2 T 한 층, Litz ø4.0(880 × ø0.10) · NAUX 2 T TIW 맨 위 · 층마다 테이프 0.05 mm · k_w 1.10(층 사이) · 축 방향 피치 1.218**. 반경 빌드 9.72 mm, 원호까지 0.68 mm(공차 끝 0.23). J 3.31 · 4.12 A/mm². **누설은 2D FEM(`leakage_fem.py`)**: 반쪽 **NS2 24.50 · NS3 25.14 µH**, 둘 다 단락 23.09 µH(요크 몫 0–1 에서 반쪽 23.35–26.40). 탱크 L_r 25 µH 는 반쪽 기준 — **사양서는 반쪽마다 ±10 % 로 잰다**(둘 다 단락은 기록값). 칸막이 2.5 mm 면 22.50, 2.0 mm 면 21.92 µH(둘 다 단락). 탱크는 C_r · L_m · R.T 고정으로 L_r 22.3–28.6 µH 에서 41/44. 갭 1.784 mm(FEM, 프린징 없으면 1.341). 구리 직류 2.27 W, 스트랜드 와전류 NP1 1.51–2.20 · 2차 0.78–1.14 W(62–75 kHz). `leakage.py`(1D 해석식)는 PQ 에서 반쪽 순서를 거꾸로 내므로 기준이 아니다. **남은 것**: 핀 전류 정격(보빈 업체) · Litz ø4.0 굽힘 반경 · EFOLIT 절연 두께(0.2 mm 가정) · 누설 실측 · 온도 · 핀 번호 방향(도면은 1 · 6 · 7 · 12 표시) |

### 4.3 최우선 실측 항목

1. **T_idle 확정** — 라인 반주기에 걸친 f_sw(θ) 실측. **모든 오실레이터 정수가 여기 걸려 있다**
2. **FB morphing 경계(235 V_pk, 전부하)의 f_sw** — 계산 249.6 kHz.
   T_idle = 700 ns면 VCO 상한과 거의 같다
3. **HB morphing 경계(245 V_pk, 전부하)의 ZVS** — 계산 T_ZC 457 ns.
   게이트·중점 파형으로 하드 스위칭 여부 직접 확인
4. **출력 100/120 Hz 리플과 OLED 패널 휘도** — 아키텍처 판정의 근거
5. **C_out 뱅크의 리플 전류와 온도 상승** — 계산 30.2 A rms, 개당 0.19 A
6. 90 Vac 전부하 입력 전류와 THD — 영교차 사각지대 정량화
7. **콜드 스타트업 — 75 mF 출력 뱅크를 120 ms HVSU 창 안에 세울 수 있는가.**
   240 W 예제의 4 mF보다 18배 큰 부하다. **본 프로젝트 고유의 신규 리스크**
8. 경부하에서 FB 리플 대 버스트 임계 마진 ([147] [148], R_BM 조정)
9. EVB 트랜스포머 개방/단락 인덕턴스 + 턴수 → n vs n_T 확정
10. **최악 위상 AC 드롭아웃** — θ = 45°(리플 골)에서 AC를 끊고 12 ms 후 출력이 19 V 이상인지
11. **1차·2차 소자 온도 상승 — 방열판 필요 여부를 여기서 판정한다.** 계산상 LVG2 자리 **9.27 W**(케이스–주위 10.4 °C/W 이하, 기판 동박만으로는 204 °C 상승) · SR 소자당 **1.41 W**. `k.Ploss` 0.324 · `k.PSR` 1.065 를 감수하기로 한 결정이 성립하는지가 여기서 갈린다. **HB 모핑 상태(라인 피크 > 245 V)에서 잴 것** — FB 모드에서는 그 자리가 스위칭이라 절반밖에 안 뜬다
12. **`R.T` 결정용 — 영교차 동작.** ① f.sw(θ) 에서 영교차 근처 주파수가 실제로 f.Min 까지 내려가는지 ② 90 · 230 Vac 전부하 입력 전류 파형과 THD 를 `R.T` 21.5 kΩ 과 한 단 높은 값으로 ③ 영교차 근처 게이트·중점 파형에서 하드 스위칭 여부. §4.2 5b
13. **VCC 와 보조권선 전압 대 출력** — 무부하 · 전부하 · 콜드 스타트. 보조권선이 출력을 따라가는지(`V.aux = n.aux·V.out`), `C.VCC` 가 언제 넘겨주는지, 게이트 드라이버 실제 전류, 패스 트랜지스터·HVSU 온도. §4.2 10
13a. **게이트 · 중점 타이밍과 V_BO** — 두 레그에서 게이트에 남는 데드타임, 콜드 스타트 동안 V_BO(9.3 V 이상), 중점 dv/dt(50 V/ns 이하), SR 게이트 파형(핀당 2개), 무부하 최장 버스트 휴지(1.1 s 미만). §4.2 13a
14. **트랜스포머 누설 · 권선 빌드 — 첫 샘플.** NS2 단독 · NS3 단독 단락값(탱크가 보는 값, 사양 ±10 %)과 둘 다 단락값(기록). 추정 반쪽 24.50 · 25.14 µH, 둘 다 단락 23.09 µH(PQ 50/50 · 칸막이 3.0 mm · k_w 1.10, 2D FEM)는 계산이지 측정이 아니다 — 높으면 칸막이를 얇게(2.5 mm 에서 약 −0.6 µH), 낮으면 조정 수단이 없다. 실제 권선 높이로 k_w 와 원호까지 여유(계산 0.68 mm)를 확정하고, 핀 온도 · 갭 근처 1차 권선 온도를 잰다. §4.2 13
14. **트랜스포머 작업전압과 내전압** — 첫 샘플에서 1차 ↔ 2차 작업전압(추정 187 V rms)과 3000 V ac 60 s. 인증기관에 보내기 전에. §4.4

### 4.4 트랜스포머 안전 절연 (2026-09-25)

가정용 AV 기기(TV)를 **미국 · EU · 일본 · 한국 · 중국**에 한 구조로 낸다. 요구치는 **가장 엄한 시장** 기준이다.
정본은 `Design Guide/generators/insulation.py`(출처 URL 포함)이고, 벤더 사양서 5절 · AN "Safety insulation" 두 절이 거기서 읽는다.

| 항목 | 값 | 근거 |
| :--- | :--- | :--- |
| 등급 | 1차(NP1 · NAUX) ↔ 2차(NS2 · NS3 · **코어**) **강화절연** | Class II 세트. Class I 도 덮는다. 1차가 TIW 라 코어는 2차 쪽이다(2026-09-25 구조 변경 전에는 코어를 1차로 봤다) |
| 조건 | PD2 · OVC II · 재료군 IIIb · **5000 m** | 보빈 CTI 미상이라 IIIb. 5000 m 는 GB 4943.1-2022 의 기본 가정 |
| 공간거리 | 3.0 mm × 1.48 = 4.44 → **4.5 mm** | 과도전압 2500 V, 강화는 한 단계 위 4000 V → 3.0 mm. 고도 계수 1.48. 두 CB 성적서 모두 4.5 mm 적용 |
| 연면거리 | 2 × 3.2 = **6.4 mm** | 320 V 행(264 Vac 와 추정 작업전압을 보간 없이 덮는 행). 강화 = 기초 × 2 |
| 고체절연 | 두께 ≥ **0.4 mm**, 또는 테이프 **2층**(층마다 강화 내전압 통과) | TÜV 성적서 |
| 내전압 | **3000 V ac 60 s (4242 V dc)**, NP1+NAUX ↔ NS2+NS3+코어 | TÜV 성적서(Class II · 100–240 V · 5000 m). 적용 개정판에서 재확인 |
| NP1 · NAUX | **TIW, 강화절연 승인품** — NP1 은 **TIW-Litz 1가닥**(401 × ø0.10, 바깥지름 ø2.9, 절연 0.2 mm 가정) | Elektrisola EFOLIT: ø1.5–5.0 mm, VDE 강화, 1000 V rms, 500 kHz. 이 굵기 · 절연 두께의 공급 여부는 벤더 확인 |
| 구조 | **2칸 보빈 섹션 권선**(onsemi AN-4151 · TDK · Infineon · LGE 양산품과 같은 구조): 카탈로그 보빈 B65982E, 튜브 쪽에서 1차 15 T 한 칸(3층 × 5 T, 턴당 한 가닥) \| **칸막이 3.0 mm** \| NS2 한 층(2 T) → NS3 한 층(2 T), 턴당 Litz 한 다발 + NAUX. 뒤집기 · 자리 바꾸기 없음. **층마다 테이프 0.05 mm(가정)**. 강화절연은 **전선(TIW)** 이 맡고 칸막이는 누설만 정한다 | 보빈은 TDK 카탈로그품, 칸막이만 추가 |

PQ 50/50(설계점, 72·73차): 반경 여유 10.40 mm(바깥다리 원호 반경 22.0 − 튜브 23.2/2, 공차 끝 9.95) 를 1차 3 × (2.9 × 1.10 + 0.05) = 9.72 mm 로 채우고, 2차 칸은 2 × (4.0 × 1.10 + 0.05) + NAUX = 9.61 mm 다(k_w 1.10). 원호까지 0.68 mm(공차 끝 0.23). `insulation.checks()` 는 경로마다 **무엇이 절연을 맡는지**를 적는다 — 선재가 맡는 경로(두 칸이 맞닿는 칸막이 면 포함)는 통과, 1차 핀 ↔ 코어 공간거리 6.01 mm(≥ 4.5) 통과, **1차 핀 · TIW 벗긴 끝 ↔ 코어 요크 · 2차 리드**가 열린 항목. TIW 승인 주파수 500 kHz 는 `f.SU` 477 kHz 를 덮는다. 핀 줄 사이 45.72 mm 는 통과.

---

---

## 5. 동작 원리 — 설계에 직접 쓰이는 형태만

상세는 가이드 §2. 여기서는 설계 판단에 곧바로 쓰이는 것만.

1. **게인은 제어 변수가 아니다.** 양쪽 포트가 전압원(출력은 mF급 C_out, 입력은 벌크 없는
   |v_ac(θ)|)이므로 순시 게인 `M(θ) = n·V_o,eff / V_drive(θ)`가 **경계조건으로 강제**된다.
   주파수가 조절하는 것은 Q, 즉 **전력**이다. → `f_sw(θ)` 변조가 곧 PFC.
2. **두 발산이 상쇄된다.** θ→0에서 요구 게인은 1/sinθ로 발산하지만 부하는 sin²θ로 소멸하고,
   Q→0의 게인 천장은 하측 공진 `f_o`에서 발산한다. **f_o가 주파수 하한**이다.
3. **λ ≈ 0.5 (m = L_p/L_r ≈ 3)가 단일단의 지문.** 일반 LLC의 m = 5–10을 쓰면 저입력에서
   기동조차 못 한다. 순환 전류가 크다는 것이 승압단 제거의 대가다.
4. **FB 핀은 전력 지령이다.** `V_FB = 0.5 V + 0.167 (V/Ω·W)·R_CS·P_in`. 최대전력 제한 ·
   버스트 진입점 · 과부하 검출이 전부 이 하나의 스케일 위에 있다.

**Morphing:** 라인 피크 235 V 이하 → 풀브리지(구동 2배), 245 V 이상 → 하프브리지.
LOUT2를 정적 High로 두어 2번 레그 로우사이드를 계속 도통시키는 방식이며 C_r이 DC를 차단한다.
추가 하드웨어 불필요.

> **▷ 그 결과 탱크가 보는 등가 입력 범위는 90–264 Vac가 아니라 173.2–332.3 Vac (1.92:1)이다.**
> - **HB 경계 245 V_pk → 등가 173.2 Vac** = 게인·**ZVS 최악 코너**
> - **FB 경계 235 V_pk → 등가 332.3 Vac** = **주파수 최악 코너**
>
> 이 두 점을 놓치면 설계가 성립하지 않는다. **ST 원본 툴은 이 둘 다 안 봤다.** 수정본
> rev 0.6은 HB 코너를 `Design Spec` D20(C.8)에서, FB 코너를 `RTC!C9 = MAX(D79, D81)`
> (2026-08-23)에서 본다. 시트 §4.1 인용 블록 참조.
>
> **▷ 히스테리시스 밴드를 넣으면 8 %가 더 넓다 (2026-08-24).** 235–245 V_pk 사이에서는
> **라인 전압만으로 모드가 안 정해진다** — 올라오는 중이면 245 V_pk 까지 FB 를 유지하고,
> 내려가는 중이면 235 V_pk 까지 HB 를 유지한다. 그래서 진짜 최악은 **166.2–346.5 Vac
> (2.08:1)** 이다. 여유가 게인 15.6 → **10.9 %**, ZVS 2.08 → **1.70배**, f_sw,max
> 249.6 → **263.2 kHz** 로 줄지만 **전 항목 통과한다.** 사양을 조일 때 좁은 쪽 숫자를
> 쓰지 말 것. 실사용 계통은 이 밴드(166–173 Vrms)에 앉지 않으므로 **AC 소스로 임계를
> 통과시키는 시험과 라인 딥/서지에서만 만난다** — 즉 시험에서 만난다. **프로그래머블 AC
> 소스이므로 램프가 아니라 스텝으로 볼 것** (175 → 160 V 및 그 반대). 가이드 §3.3.
>
> **▷ 위험 사항 하나 — 전환 순간의 출력 강하.** 구동이 한 라인 사이클 만에 2:1 로 변하는데 루프 교차는 17.6 Hz 다. **홀드업(전력 0, 12 ms)이 더 가혹하고 그건 이미 만족하므로 C_out 이나 루프를 손댈 이유는 없다.** 다만 그 포함관계를 시간영역으로 확인한 적은 없다. 가이드 §3.3 에 위험 사항으로 적어 두었다.

---

---

## 6. 설계에서 반복해서 틀리는 지점

### 6.1 이 토폴로지에서 반복해서 틀리는 지점

1. 탱크는 **등가 입력 범위의 진짜 양 끝**(173.2 / 332.3 Vac)에서 설계한다
2. λ ≈ 0.5를 예상한다. L_m/L_r = 5–10은 저입력 기동 실패
3. f_Min을 f_o 이상에 둔다. ACP 보호에만 의존하지 말 것
4. 권선비는 항상 **반사 전압 n·V_o,eff**로 검산한다
5. **합성 공진 전류 피크**로 판정할 것이 둘이다 — OCP1 여유와 **1차 소자 전류 정격**. `I.trafo_pk` 는 반사 부하 전류일 뿐이고 자화 전류가 빠져 있다. 가이드 [79]·[115], ST 툴 `D39`·`D65` 가 전부 이 오류였다 (부록 C.14 · C.28)
6. 출력 커패시터 리플 전류는 **2f_l 성분 포함**, 그리고 **CT면 노드 실효값**으로 판정한다
   (`HISTORY.md` 시트 §3.5)
7. L_m은 계산값 **이하**로 택한다. 위로 반올림하면 ZVS 여유가 사라진다
8. ZVS 최종 확인은 [36]–[38] 닫힌형이 아니라 **[38a] 전 영역 스윕**으로 한다.
   닫힌형의 오차는 **부호가 정해져 있지 않다** — 240 W 예제에서는 22.9 % 낙관, 본 설계에서는
   34.4 % 보수. [36] 이 적합식이고 실제 Q 가 아니라 설계값 `Q_ZVS` 로 평가하기 때문이다.
   **낙관적일 수 있다는 것이 위험한 쪽**이고, 워크북의 `RTC` 격자는 스윕과 5자리까지 일치한다
   (수치는 `HISTORY.md` 2026-08-24).
8b. **용량성/유도성 경계는 게인 피크가 아니다** (2026-09-17, 사용자가 AN 그림에서 발견).
    탱크가 용량성인 것은 `arg Z_in < 0` 인 동안이므로 경계는 **위상이 0 이 되는 점**이고,
    그 자리는 게인 곡선의 피크보다 **위**에 있다. λ 0.556·Q_pk 0.863(이 탱크)에서 피크 54.1 kHz 대
    경계 56.6 kHz 이고 **피크 바로 그 자리의 위상이 아직 −7.8°** 다(2026-10-01 `l6790.M` · `zvs_edge` · `phase` 로 다시 계산; E 60 시절 탱크 Q 0.766 에서는 105.4 대 110.1 kHz, −8.4°). 피크는 게인 곡선만
    있으면 되니까 쓰는 근사이고 **틀리는 방향이 나쁜 쪽**이다 — 아직 하드 스위칭하는
    구간을 유도성이라고 보고한다. 닫힌형이 있다: `Q²u² + (λ²+λ−Q²)u − λ² = 0`, `u = f_n²`
    — `l6790.zvs_edge(Q, λ)` 이고 `l6790.phase()` 의 수치해와 5자리까지 같다.
    **Q→0 에서 `f_n0` 로 수렴**하므로 무부하에서는 두 정의가 일치한다.
    **본 설계는 영향 없다** — 전 라인 위상 · 부하 4종 · 입력 3종을 훑어도 최악이 여전히
    영교차 근처의 `f.Min`/`f.o` = **1.023**(= `k.floor`, R.T 23.2 kΩ)이고, θ > 20° 에서는 1.097 이상이다.
    ZVS 판정 자체는 [38a] `T.ZC` 스윕이라 두 근사 어느 쪽도 안 쓴다
8c. **프리휠링(STEP 2·6)은 전력 전달 *다음* 이되 *같은 반주기 안* 이다.** 순서는
    `S1·S4 전력 전달(1) → S1·S4 켜진 채 프리휠링(2) → 데드타임(3·4) → S2·S3 전력 전달(5) →
    프리휠링(6) → 데드타임(7·8)`. **ZVS 는 데드타임에서만 일어난다.** "freewheeling" 이라는 말을
    위상천이 풀브리지 계열과 Toshiba AN 은 **데드타임의 바디 다이오드**에 쓴다 — 다른 자료와
    대조하기 전에 어느 구간인지부터 볼 것. 독립 출처는 Toshiba `Resonant Circuits and Soft
    Switching`(2019) 의 AN §3.2 8개 모드.
8d. **Infineon AN 2012-09 의 Figure 2.8 은 캡션과 맞지 않는다** — "freewheeling, 2nd half"
    라는데 그리고 있는 것은 데드타임이다(S2·S3 가 켜진 동안 S1·S4 의 바디 다이오드는 역바이어스).
    `figedit.fix_freewheel_2nd_half()` 가 다시 그린 판을 쓴다.
13. **개방시험(포화) 전류의 근거는 OVP2 다. 임의 마진을 다시 넣지 말 것.**
    개방시험은 2차 기자력 상쇄가 없어 같은 전류로도 자속이 훨씬 크므로, 시험 전류는
    *동작 자속을 재현하는* 전류이지 동작 전류가 아니다 — 15 A < 18.3 A 는 모순이 아니다.
    공진 아래에서 자화 도통 구간이 `T.r/2` 로 고정되므로 자화전류는 `f.sw` 와 무관하고
    출력 전압에만 비례하고, 최악 자속은 컨트롤러가 허용하는 최대 출력 = **OVP2** 에서 나온다:
    `I.sat_spec = I.sat_eq × V.OVP2_act/V.out`. **곱할 임의의 수가 없다.**
    분모는 `V.out` 이다 — 정확한 자속비 `(V.OVP2_act+N.rect·V.rect)/(V.out+N.rect·V.rect)` 이상이 되는 쪽.
    `V.o_eff` 로 나누면 `V.rect` > 0 일 때 그보다 작아진다(이 설계는 SR 이라 `V.rect` = 0, 값 같음. 62차).
    `I.sat_eq` 의 분모는 `L.mu_x` 다(`L.open_x` 가 아니다) — 개방시험에서 코어 중앙다리를 도는
    것은 `L.mu` 몫뿐이고, 그래서 `I.sat_eq` 는 `I.Lm_pk` 와 같아야 한다. `check_trans_spec.py` 가
    OVP2 대조를 한다. (되돌렸다 잡힌 경위는 `HISTORY.md` 2026-09-21)
9. 커패시터 ESR은 **사용 주파수**의 값을 쓴다 (데이터시트 tanδ는 120 Hz)
10. **소자 1개에 실제로 흐르는 전류로 응력을 판정한다.** 전류표는 스위치 *위치*당(1차) ·
    *레그*당(2차)이고, 병렬 개수(`n.par` · `n.SR`)로 나눠야 소자 값이 된다. 병렬 개수가
    없으면 R_DS(on) 이 "레그당"인지 "소자당"인지도 정해지지 않는다 — 두 문서가 갈라진
    지점이 정확히 여기였다. **센터탭 레그는 2차 전류 전체를 흘린다 — 절반이 아니다**
11. **R_DS(on) 은 25 °C 표제값이 아니라 Tj,max 값으로 손실을 낸다.** 슈퍼정션 약 2배,
    저전압 SR 약 1.5배. 25 °C 손실로 "Tj 125 °C 용 Rth" 를 구하면 **약 2배 후하게** 나온다
12. **C_oss 는 어느 것인지 적는다.** 표제 Coss · Co(er) · Co(tr)(= Qoss)이 3–5배 다르다.
    ZVS 는 전하 문제이므로 **Co(tr)** 이다
### 6.2 핀 규칙 (DS 명시 — 위반 시 즉시 오동작)

| 핀 | 규칙 |
| :--- | :--- |
| ISEN (6) | **필터·직렬저항 금지.** 최대전력 법칙과 OCP 설정점이 이 핀을 공유. AMR ±3 V |
| CFG (11) / BM (10) | **커패시터 금지** (파워업 시 핀스트랩). CFG는 15–100 kΩ 밖이면 IC 래치. BM을 GND에 연결하면 버스트 비활성 |
| DRV_EN (3) / RT (7) | **커패시터 금지** (2 ms마다 15 µs 샘플링 → 오검출 디스에이블). DRV_EN 은 **개방** — L6498 에 enable 입력이 없다 |
| LOUT2 (13) | **풀다운 금지** (morphing 사용 시). 300 µA가 2.5 V를 만들어야 하므로 약 8 kΩ 이하는 고정 HB로 읽힌다. L6498 LIN 의 내부 풀다운(58 kΩ min)은 괜찮다(`k.LOUT2` 6.96) |
| HVSU (1) | 입력 브리지 **앞단(AC 측)**에 HV 다이오드 2개(1000 V급). 브리지 뒤에 달면 X-cap 방전과 브라운아웃 감지가 모두 죽는다 |
| ZCD (12) | 보조 권선 극성은 **LOUT1(및 HOUT2) ON일 때 ZCD가 양(+)**. 반대면 하드 스위칭 |
| HOUTx/LOUTx | **로직 레벨 출력(V_OH 4 V)이며 드라이버가 아니다.** 레그마다 **L6498LD** 1개(HIN←HOUTx, LIN←LOUTx, V_IH 2.5 V max · V_IL 0.95 V min) |

---

## 7. 문서 성격 경고

- 데이터시트는 **DRAFT**다. TBD가 남아 있고 내부 모순이 있다.
  **양산 설계 전 정식 릴리스 DS로 반드시 재검증한다.**
- 설계 가이드는 **비공식 자료**이며 ST 공식 간행물이 아니다.
- 부록 C.5(툴의 권선비 2배)는 제공 자료로부터의 **역추론**이며 ST 문서에 명시된 바가 아니다.
  본 프로젝트는 CT(N_rect=1)를 택하므로 이 문제 자체가 발생하지 않는다.
- **AN 의 그림은 전부 우리가 그린 것이다.** 한때 15장이 ON Semiconductor · Infineon ·
  Toshiba · MPS 의 AN 을 잘라 붙인 것이었으나 `figs_ref.py` 로 전부 다시 그렸고, 캡션은
  **그림의 출처가 아니라 논지의 출처**를 인용한다. 원본 크롭은 `figures/an_ref_*_raw.png`
  4장만 기록으로 남아 있고 **어느 산출물에도 안 실린다.** (2026-09-20, `HISTORY.md`)

---

# ── 여기부터는 운영 지시 ──

**아래 세 절은 설계 내용이 아니다.** 이 폴더에서 작업하는 도구 사용자(Claude)가
파일을 깨뜨리지 않고 산출물을 재생성·검증하기 위한 절차다 — 스크립트 목록과 함정 목록
자체는 **`Design Guide/generators/README.md`** 에 있다(시트 §9).
설계를 읽으려는 사람은 여기서 멈춰도 된다 — 위 시트 §1~시트 §7이 계획서 전부다.
