yohan924-ops/L6790A-Single-Stage-PFC-LLC-Converter/docs/THREE_CORE_BOARD.md

# 3코어 시험 보드(유닛 5:2 × 3, 옛 탱크) — 되살린 변형 `7p5to1`

> 2026-10-07 사용자: 실제 시험 보드는 **5:2 트랜스포머 3개(1차 직렬 · 2차 병렬)** 이고 탱크는 **옛 설계점**(C_r 100 nF · R_T 11 kΩ)이다.
> 2026-10-01 에 "PQ50 만 남기고 지워" 지시로 삭제했던 변형 `7p5to1` 의 시트 · 워크북 · 벤더 사양서를 커밋 `0821491` 에서 되살렸다. **사양서의 단자는 되살린 뒤 고쳤다**: 2026-09-22 에 AN 핀 그림 작업을 하며 사양서 단자를 PQ 40/40 12핀 번호(1–3 / 7–9 / 10–12 / 4–6)로 바꾸고 "Coil former TDK B65884E" 줄을 넣었는데, 사용자는 PQ 40/40 을 쓰라고 한 적이 없다(2026-09-23 "PQ4040 쓰지도 않는 코어"). 2026-09-01 에 확정한 대로 **기존 양산품 26OP-LM83W 승인원 방식(1–2 / 3–5 / 4–6 / a–b, 센터탭은 보드에서 4·5 연결)** 으로 되돌리고 코어 · 보빈 · 핀 배치는 벤더 선택으로 두었다(2026-10-07).
> **얼어 있는 사본이다.** 지금 빌더(`build_l6790_smath.py` · `build_trans_spec.py`)에는 이 변형이 없어 다시 만들지 않는다. 고칠 일이 생기면 `0821491` 의 빌더를 꺼내 쓰거나, 현재 빌더에 `7p5to1` 항목을 되살린다(그러면 81–84차의 시트 §14c.1–14c.5 가 옛 탱크로 계산되므로 결과를 따로 검토해야 한다).

| 파일 | 무엇 |
| :-- | :-- |
| `Smath/variants/L6790A_7p5to1.sm` | 3코어 설계점의 SMath 시트(47쪽, 노란 입력 130개). `check_sm` OK(2026-10-07 재확인). 시트 §14c(보조권선 VCC)까지 있고 시트 §14c.1–14c.5(게이트 드라이버 · 기동 · SR · 열)는 없다 |
| **삭제 2026-10-18**(커밋 `810e0f4` 에서 복구) `Calculation Excel Sheet/variants/L6790_workbook_7p5to1.xlsx` | ST 툴 수정본, 옛 탱크 |
| **삭제 2026-10-18**(커밋 `810e0f4` 에서 복구) `Calculation Excel Sheet/variants/Transformer_Spec_7p5to1.xlsx` | 벤더 사양서 — **유닛 하나 기준**, 단자는 26OP-LM83W 승인원 방식(1–2 / 3–5 / 4–6 / a–b). 코어 · 보빈은 지정하지 않는다 |
| `Calculation Excel Sheet/variants/BENCH_200W_transformer_asbuilt.xlsx` | **실제 제작된 트랜스포머의 간단 사양서**(2026-10-07) — 벤더 핀(1차 1–4 · NS2 5–9 · NS3 7–11 · NAUX 2–3, 4핀 + 8핀 보빈), 와이어(Litz 0.1 × 130 / 0.1 × 110 bifilar / ø0.4), 코어 도면(EE 42 × 36 × 19, A_e 114 · l_e 58.82 · V_e 6706, 재질 미기재), 측정 3항(10.33 · 3.67 µH ±10 %, DC overlap 16 A) + 반쪽 누설 기록 + 극성 시험. 값은 `Transformer_Spec_7p5to1.xlsx` 에서 읽어 넣었다(손으로 적지 않음). 벤더 사본의 DC overlap 15 A 는 9월 21일판 값. **간단판(사용자: 메모 삭제 · 그림 · 와이어는 허용 전류로)**: 와이어 열은 설계 요구가 아니라 **그 와이어가 4.5 A/mm² 에서 흘릴 수 있는 전류**(NP1 1.02 mm² → 4.6 A, NS 0.86 → 3.9 A, NAUX 0.126 → 0.57 A rms; 설계 요구 10.9 / 9.4 A 의 절반 아래) · 보빈(4 + 8핀) · 코어(정면 · 측면, A–F) 그림은 `asbuilt_spec_pics.py` 가 벤더 그림을 본떠 그린다(보빈은 벤더 사양서의 측면 그림 — 위 8핀 단자 블록 · 플랜지 2 · 권선 통 · 아래 4핀 블록과 발; 2026-10-07 사용자 “보빈 생긴게 너무 다른데” 뒤 다시 그림) · 사양서 본체는 `asbuilt_spec.py` 가 만든다 · A4 가로 한 쪽. **2026-10-11 실측 열 추가**(사용자 “트랜스포머도 내가 실측한 걸로”, 이어서 “1개 기준으로만, 반쪽은 의미 없으니 빼”): 2절 표에 `Measured (per unit)` — 개방 10.3 µH, 누설(양쪽 단락) 1.9 µH(1.8–2.0), DC overlap 미측정. 반쪽 단락 항목(2a)과 세트 값 줄은 뺐다. 요구값 열은 그대로 두었다(누설은 요구의 약 절반). 스위칭 주파수 줄은 설계 탱크(L_r 11 µH) 값임을 적었다 |
| `Calculation Excel Sheet/variants/3CORE_670W_transformer_spec.xlsx` · `…_KR.xlsx` | **세 번째 안의 벤더 요구사양서 — 코어 · 보빈 · 핀 배치를 지정하지 않는다**(2026-10-18 사용자: "코어를 특정하지 말고 사양만"). `build_trans_spec.py 7p5to1_x3m3`(`nocore` 모드)가 변형 시트에서 만든다: **2026-10-18 개정판(70.5 nF / 10 / 15 µH · R_T 7.68 k)**: 유닛당 5 : 2+2 · 개방 8.33 µH ±10 % · 누설(반쪽씩) 3.33 µH ±10 % · 개방 시험 17 A · 구리 1차 ≥ 2.9 / 2차 ≥ 2.5 mm²(3.75 A/mm² 에서 올림, 10-18 개정 전류 10.86 / 9.20 A; 스트랜드 ≤ 0.10 · 포일 ≤ 0.20 mm) · **A_e ≥ 220 mm²(B_pk ≤ 75 mT, 자속 경로 전체의 유효 단면 — 플랫 코어는 요크가 정하고 한 보빈의 코어 두 개는 합산)** · 권선이 보는 주파수 130–292 kHz, 기동 527 kHz · 단자 26OP-LM83W 식(1–2 / 3–5 / 4–6 / a–b). **2026-10-18 저녁 사용자 지시로 안전 절연 절(5절) · 공진 주파수 줄 · 코어 재질 줄을 뺐다**(절연 시스템은 LGE 안전 설계가 쓴다; 벤더에겐 권선에 걸리는 주파수 자체가 중요하지 스위칭이냐 공진이냐는 무관; 재질은 아직 특정 못 함) — 정본 사양서(`7p5to1_x1`)의 5절은 그대로. **그 뒤 다시 "순수하게 트랜스포머 입장에서만"(사용자)**: 제목 아래 컨버터 · 출력 문구, 세트 구성(3개 직렬 · 병렬, "값은 트랜스포머 하나 기준"), 공진 인덕터 · C_r · 발진기 · 외부 인덕터 언급, NAUX 의 직렬 결선 설명을 전부 빼고 권선비 5 : 2 : 2 : 1 · 구조 · 권선 · 전기 요구 · 동작 조건(권선 주파수 · A_e)만 남겼다. **한국어판 `3CORE_670W_transformer_spec_KR.xlsx`** 는 같은 빌더의 `--kr`(문자열 표 `TXT`, 글꼴 Malgun Gothic, 한글 폭 보정 0.6). 정본 사양서는 영문 그대로. 누설 미달 시 유닛당 2.67–3.67 µH 는 C_r · 발진기 재선정으로 받는다(아래 시험 빌드). **4 · 5절은 한 항목 한 줄로 간추렸다**(2026-10-18 사용자 "정보가 너무 많아"): 동작 조건 4줄(f_sw · f_r · A_e · 재질), 절연 6행 — 손실 배분 · 요크 설명 긴 문장 · 절연 조건 긴 문장은 뺐다. 공진 주파수 줄에 "공진 아래에서 권선 전류는 f_r 의 반파 정현 — 도체는 f_r 기준" 을 적었다. **2026-10-18 밤(사용자 "도체 설명은 이해하기 어렵다 — 권선 스펙까지 넣자" · "권선 그림도, a–b 는 1 · 2 사이")**: 2절을 26OP-LM83W 승인원식으로 바꿨다 — 결선도(`trans_diagram.py`: 1차 줄 ① ⓐ ⓑ ②, 2차 줄 ⑥ ⑤ ④ ③, NAUX 는 NP1 안쪽, 점은 감기 시작 1 · a · 3 · 4) + 권선 사양표(S → F · 턴수 · 선재 · 위치: NP1 리츠 ø0.10 × 370 (2.91 mm²) 1차 구역, NS2 · NS3 리츠 ø0.10 × 320(2.51 mm²) 2차 구역 바이파일러, NAUX 단선 ø0.40 2차 구역 NS2 · NS3 옆). 가닥 수는 구리 단면 2.9 / 2.5 mm² 에서 10 가닥 단위로 올린 값, NAUX ø0.40 은 벤치 부품의 보조 선(1 T · 0.2 A dc 라 손실 무시). 도체 문단은 없애고 "같은 구리 · 소선 ≤ ø0.10 이면 다른 선재도" 한 줄로, 권선 전류는 4절로 옮겼다. 열 6개(정본 x1 은 5개 그대로, 출력 대조 동일). **그 뒤 "값만"(사용자, 같은 밤)**: 감는 방향 · 점 · 센터탭 · 단자 번호 출처 · 구역 배치 · 조건 꼬리말(정격 부하 · 기동 주파수 · 직류 부하 · B_pk · 코어 세트 합산) · 구조 문장의 양산품 · 제작사 언급을 전부 뺐다. 남은 글은 동등 선재 한 줄(구리 ≥ 표 · 소선 ≤ ø0.10 · NS2/NS3 동박 ≤ 0.20) 과 누설 허용폭 한 줄(2.67–3.67 µH, 샘플 전 통보). 핀 배치는 결선도 · 표가 곧 사양이다(사용자: 제작사가 아니라 우리가 정한다). 한국어판 외래어는 영어로(Litz · bifilar · peak) |
| `Calculation Excel Sheet/variants/3CORE_670W_workbook_unencrypted.xlsx` | **세 번째 안의 ST 워크북**(2026-10-18, 사용자 "670W용으로도 다시 Workbook 만들자") — `x3m3_xl.py` 가 가이드 워크북을 복사해 F9 n 5.8095 · F43 C_r 70.5 nF · F44 L_r 10 µH · F45 L_m 15 µH · `Device Setting` F24 R_T 7.68 kΩ 를 x3m3 시트에서 읽어 넣는다. **같은 날 사용자 지시로 LG 보드의 부품을 따른다**: V_Z 11.74 V(R197 100 k / R204 27 k) · 옵토 UPC1008G-LS04-R(CTR 0.54 / 0.65 · V_F 1.45) · TL431G-AE2-R(I_min 0.5 mA) · R_B 5.23 k · 보상망 **220 nF / 1.5 µF / 18 k**(영점 · 극 유지; 3차 고조파 2.8 % · PM 48.9° · f_c 12.6 Hz — 사용자 2026-10-18 "추천안으로"; 150 / 1 µF / 27 k 는 4.1 % · 17.4 Hz, 16개 뱅크 때는 100 / 680 / 39 k) · C_fx 1.6 nF · 출력 Rubycon PX 6800 µF / 35 V **× 11**(사용자 2026-10-18: 16개는 못 쓴다; C_out 74.8 mF · 리플 4.8 % · 홀드업 13.3 ms 로 용량은 충족, **개당 리플 전류 2.62 A rms 는 PX 정격 1.92 A @120 Hz, ×1.15 = 2.21 A @≥10 kHz 를 넘는다** — 보드에서 캔 온도 확인) · ESR 50.7 mΩ(120 Hz tan δ 상한) · 세라믹 10 µF × 16 · h 37 mm · c.HB **3329 pF**(C_oss 환산 2929 + 기생 100 + D–S 150 pF × 2; C115/C117 2.2 nF 는 레그 양단이라 제외 — 처음 넣었던 5529 는 10-16 의 오독, 같은 날 사용자 지적으로 정정, 200 W 워크북도 함께) · Cpar 400 · SR TPH3R70APL1 3.7 mΩ × 2/레그 · k_T 1.9(ST 기본값, 도시바 시트 없음). 1차 STO60N045DM9 는 가이드와 같다. ST 워크북은 유효 권선비 하나로만 트랜스포머를 보므로 유닛 수 · 턴 수 · A_e 칸은 없다. LibreOffice 재계산 사본이 x3m3 시트와 153/153. 시트 판정 71/75 그대로, k.TT 1.95 · k.TTd 1.68(c.HB 3329) · k.PSR 1.64 → 1.12. **의존 수식의 캐시는 가이드 값이다 — Excel 에서 한 번 열었다 저장할 것** |
| **삭제 2026-10-18**(커밋 `810e0f4` 에서 복구) `Calculation Excel Sheet/variants/L6790_workbook_7p5to1_measured_200W.xlsx` | **실측 트랜스포머로 200 W 시험용 워크북 사본**(2026-10-09, `measured200_xl.py`). 사용자 실측: 유닛마다 개방 10.3 µH, 누설 1.9 / 2.0 / 1.8 µH(2차 양쪽 단락, 100 kHz 1 V) — 설계 3.67 µH 의 약 절반. 한 유닛은 반쪽만 단락하면 2.0 µH(양쪽 1.8). 바꾼 칸: `Design Spec` D27 657.5 → 200 W, `Res. Tank Design` F44 L_r 11 → 5.7 µH, F45 L_m 20 → 25.2 µH, F9 n 6.0241 → 6.773. **C_r 100 nF · R_T 11 kΩ 는 그대로**: C_r 68–150 nF 를 3코어 시트 수식으로 훑어, 264 Vac 라인 피크 주파수를 f_Max 아래 12 % 이상 두면서 전류 · 자속이 가장 작은 값. LibreOffice 재계산 사본으로 f_r 210.8 kHz · f_o 90.5 kHz · FB 코너 1098.6 kHz 가 시트 계산과 같음을 확인. **k.CT 0.12 미달은 FB 코너(166 Vac) 하나 때문** — 150–180 Vac 를 피해 시험한다. 그 밖 90–130 Vac(FB) · 200–264 Vac(HB) 에서 200 W 라인 피크 144–282 kHz, ZVS 여유 2.5배 이상. 90 Vac 게인은 약 690 W 까지 남는다. 워크북 D43 의 C_r 제안 19 nF 는 L_r 을 자유롭게 고르는 절차의 값이라 고정된 L_r 에는 맞지 않는다(f_r 약 480 kHz). **2026-10-11 시험 보드에 단 값으로 맞춤**: `Device Setting` F61 R_BM 30 → 16 kΩ, F91 R_ZCD,H 220 → 360 kΩ, F108 R_CFG 30 → 13 kΩ, `Power Components` F7 C_in 2200 → 660 nF(330 nF × 2, 2026-10-12 — 하한 3 nF/W × P_in = 617 nF 은 넘는다), D23/D24 출력 커패시터 470 µF × 160 → **6800 µF × 5 = 34 mF**(보드 실장, 2026-10-12). LibreOffice 재계산: 보상망을 설계값(C_Fo 82 nF · C_F 560 nF · R_F 47 kΩ · C_fx 1.55 nF)으로 두면 f_cross 17.6 → **32.8 Hz**, 위상 여유 49.6 → **43.0°**, 2f_L 의 E/A 이득 0.205 → **0.384**, 3차 고조파 **9.4 %**, 워크북의 "BM 문턱에서 FB 리플" 115 mV · R_BM 5.7 kΩ 줄이라는 제안 — 같은 날 벤치에서 BM 을 GND 로 묶자 부하 시 출력 처짐이 사라짐(버스트 오진입). 보상망 실장값은 아직 모른다. **34 mF 용 보상망 제안(2026-10-13, 워크북 사본에 C_Fo · C_F · R_F 48조합을 넣어 LibreOffice 재계산, 다른 루프 부품은 설계값 가정)**: C_Fo 220 nF · C_F 2.2 µF · R_F 22 kΩ · C_fx 1.55 nF → f_cross 17.5 Hz · 위상 여유 52.5° · 3차 고조파 3.6 % · BM 문턱 FB 리플 45 mV(설계 82 nF · 560 nF · 47 kΩ 는 32.8 Hz · 43.0° · 9.4 %). 사본의 선정값 칸은 바꾸지 않았다. R_T 11 kΩ · C_T 470 pF 는 이 탱크에서 워크북 절차(R_T ≤ RT.ceil 11.22 kΩ, f_Min ≈ f_o)대로의 값. **벤치 결과(2026-10-13)**: 110 Vac 200 W 에서 R_T 11 kΩ(f_Min 92.3 kHz)은 약 20 s 뒤 FB 가 출렁이며 스위칭이 끊겼고, 10 kΩ(101 kHz)은 그 전에 달았던 8.2 kΩ(122 kHz)보다 나빴고(사용자 정정: 비교 기준은 8.2 kΩ — f_Min 이 높을수록 좋아지는 단조 경향), **6.8 kΩ(f_Min 145 kHz · f_Max 361 · f_SU 536 kHz)에서 해결** — 사본 F24 를 6.8 로. 해석(추정): f_Min 근처에서 자화 전류 n·V_out/(4fL_m) 18.2 A · 유닛당 자속 약 268 mT(92 kHz) → 11.6 A · 171 mT(145 kHz) — 코어 재질 미상(사양서 TBD)이라 포화 여유는 모른다. 내 "게인 부족이라 f_Min 을 올리면 나빠진다"는 해석은 틀렸다. 90 Vac 200 W 도 출력 처짐 없음(사용자, 2026-10-13 — FHA 라인 피크 필요 145 kHz = f_Min 인데도). 남은 확인: 역률 · 트랜스포머 온도 · 고입력(f_Max 361 kHz). **두 번째 보드(같은 트랜스포머 여분, 2026-10-13)**: R_CS 24 mΩ · R_T 6.8 kΩ · C_T 470 pF · C_r 100 nF · R_CFG 13 kΩ · BM GND · ZCD 윗저항 540 kΩ · 34 mF 용 보상망(C_Fo 220 nF · C_F 2.2 µF · R_F 22 kΩ). 200 W 에서 FB 1.5 V(포화 아님 — R_CS 를 줄여도 변화 없어 원복 권고)인데 출력이 무부하 25.0 → 200 W 24 V. 적분형 보상이면 DC 오차가 없어야 하므로 원인(분압 기준점/보상 결선)은 미확정 — REF 직접 측정은 루프를 흔들어 분압 양끝 전압으로 간접 확인하도록 했다. 임시 조치로 R_O 11 kΩ ‖ 470 kΩ(예상 무부하 25.5 · 200 W 24.5 V), 사용자: 올라감 → 200 W 실측 23.8 V 라 200 kΩ(≈24.5 V) 또는 130 kΩ(≈25.1 V, 무부하 약 27 V) 제안; 양산은 켈빈 감지 + 세라믹/필름 적분 커패시터로 원인 제거.
| **삭제 2026-10-18**(커밋 `810e0f4` 에서 복구) `Calculation Excel Sheet/variants/L6790_workbook_7p5to1_measured_200W_opt.xlsx` | **재검토 값을 넣은 두 번째 사본**(2026-10-14, `measured200_opt_xl.py` — 위 사본에서 만든다): `Res. Tank Design` F43 C_r 100 → **47 nF**, `Device Setting` D21/F21 C_T 470 → **330 pF**(수식은 D21 을 읽는다), F24 R_T 6.8 → **9.1 kΩ**, F91 R_ZCD,H 360 → 270 kΩ, F108 R_CFG 13 → 27 kΩ, F61 R_BM 16 → 15 kΩ, `CompensationNet&Check` F93–F95 → 220 nF · 2.2 µF · 22 kΩ. 근거와 LibreOffice 재계산 값은 아래 "재검토(2026-10-14)" 절. Excel 에서 한 번 열어야 캐시가 맞는다 |
| `Calculation Excel Sheet/variants/BENCH_200W_LGE_workbook_unencrypted.xlsx` | **LGE 구버전 워크북의 입력을 옮긴 세 번째 사본**(2026-10-16 자료, `lge200_xl.py` — 벤치 사본에서 만든다; **2026-10-18 `bench200_sync_xl.py` 로 670 W 워크북과 같은 보드 하드웨어 다섯 칸을 맞춤**: t.D 220 · h 37 · ESR 50.7 mΩ · kT.pri 1.9 · Cpar, 그리고 `peak_xl.py` 의 부하별 피크(`Res. Tank Design` 70–79); **두 번째 패스로 c.HB 5529 → 3329 pF · Cpar 400** — C115/C117 은 레그 양단): C_r 100 → **117 nF**, c.HB 800 → **5529 pF**(C_oss(tr) 897 pF × 2 를 245 V 로 환산 2929 + 기생 100 + C115 2.2 nF + D–S 150 pF × 2; LGE 의 500 pF 는 스너버를 빠뜨린 값이라 쓰지 않음 — **2026-10-18 정정: C115 는 회로도에서 레그 양단(VBUS–PGND)이라 c.HB 에 들지 않는다, 회로도대로면 3329 pF; 보드 확인 뒤 고친다(아래 '회로도 10-18판')**), t_D 220 → 270 ns, 커패시터 높이 25 → 30 mm, 세라믹 10 → 50 µF, P.in.BM 75 → 0 · R.BM 16 → 0(BM 접지), n_aux/n_sec 1.0 → **1.5**, TL431G-AE2-R(I.min 0.5 mA = UTC DS max) · UPC1008G-LS04-R(V.Fo 1.45 V, **CTR 0.37/0.53 → 0.54/0.65** — UPC1008 I_C–I_F 곡선의 등급 최소 환산), V_Z 12 → **11.74 V**(12V_FB 레일 TL431 분압 R197 을 130 k → **100 k** 로 바꾸기로 함, 2026-10-17 사용자 — 회로도 130 k 는 14.5 V), **보상망 C_Fo 82 → 470 nF · C_F 560 → 4700 nF · R_F 47 → 10 kΩ**(UPC1008 CTR 에 맞춘 권장 A 를 사용자가 채택, 2026-10-17 — 보드에는 아직 220 nF / 2.2 ‖ 0.1 µF / 22 k) · C_fx 1.55 → 1.6 nF, 브릿지 라벨 GBU1006 × 2, f_L 47 → 50 Hz. 넣지 않은 것: Vin.min 180(F20 은 173.2 Vac 수식), Vrect 0.395 V + STPS30M60S(구버전엔 SR 선택이 없어 쇼트키로 흉내 낸 것 — 이 사본은 Conf.SR 2 · TPH3R70APL1 · R_D 3.7 mΩ). 아래 "LGE 자료 2026-10-16" 절 |

## 재검토(2026-10-14): 이 트랜스포머로 110/230 Vac 역률과 저입력 안정을 둘 다 잡는 값

스크립트는 스크래치(`opt/review.py`, 라인 반주기 FHA 걷기 — 각 위상에서 IC 가 [f_Min, f_Max] 안의 가장 낮은 주파수로 sin² 전력을 맞추고, 못 맞추면 f_Min 에서 가능한 만큼만 보낸다. R_s 0.3 Ω). 워크북 사본 `L6790_workbook_7p5to1_measured_200W_opt.xlsx`(`measured200_opt_xl.py`) 로 교차 확인했다.

**벤치 결과를 설명하는 물리.** 아래 공진에서 자화 전류 피크는 n·V_out/(4·f_r·L_m) = 8.0 A 로 f_sw 와 무관하다(워크북 CC 시트 Ilm.pk 7.97 A, 시트 §12 주석) — 내가 앞서 말한 "92 kHz 에서 18 A" 는 틀렸다. 대신 **f_Min 이 f_o 에 가까우면 라인 영점 근처에서 탱크 전체(L_r + L_m, C_r)가 직렬 공진으로 거의 단락이 되어** 작은 입력 전압으로도 순환 전류가 R_s 로만 제한된다: 모델 최대 전류 11k(92 kHz) 16 A → 8.2k(122) 11.3 A → 6.8k(145) 9.5–10 A — 벤치 순위(11k 실패 · 10k 가 8.2k 보다 나쁨 · 6.8k 해결)와 같은 방향이고, 16 A 는 DC overlap 사양(16 A 에서 L 90 %)의 무릎이다. 측정(11k, 골짜기 11.3 A)보다 모델이 크게 나오므로 순위용. **역률은 f_Min 의 무부하 게인 M0(f_Min) 이 커야(= f_o 에 가까워야) 영점 근처가 비지 않는다**: M0 145 kHz = 1.34 → 사각 52–55°, PF(FHA) 0.83–0.86(실측 230 Vac 0.7). 두 요구는 같은 손잡이를 반대로 당긴다 → **f_o 를 f_Min 쪽으로 옮기는 것, 즉 C_r 만이 해법**(B = n·V_out/(4 f N A_e) 라 L_m 을 키워도 포화 여유는 안 바뀐다).

| 후보 | f_o / f_r | f_Min / f_Max / f_SU | M0(f_Min) | PF(FHA) 110 FB / 230 HB | 사각 | I_max(골짜기) | B_max/유닛 | 라인피크 f: 90/110/230/264 | 비고 |
| :-- | --: | --: | --: | --: | --: | --: | --: | --: | :-- |
| A0 100 nF · 470p/11k | 90.5 / 211 | 92 / 320 / 503 | 20 | 1.00 / 1.00 | 3° | 16 A | 235 mT | 143/179/192/277 | 벤치 실패 |
| A2 100 nF · 470p/6.8k | 90.5 / 211 | 145 / 361 / 536 | 1.34 | 0.83 / 0.86 | 52–55° | 9.5–10 A | 139–149 mT | 145/178/191/275 | 벤치 OK, PF 0.7 |
| B2 56 nF · 390p/8.2k | 121 / 282 | 145 / 399 / 597 | 2.7 | 0.985 / 0.987 | 23–24° | 9.4 A | 139 mT | 190/238/257/368 | |
| **B3 47 nF · 330p/9.1k** | 132 / 308 | 154 / 444 / 661 | 3.1 | **0.991 / 0.992** | 20° | **8.9 A** | **131 mT** | 207/260/280/400 | **추천** |
| B4 47 nF · 330p/10k | 132 / 308 | 141 / 435 / 654 | 6.7 | 0.999 / 0.999 | 9° | 10 A | 147 mT | 207/260/280/401 | 골짜기 전류 A2 수준 |
| B5 39 nF · 330p/9.1k | 145 / 338 | 154 / 444 / 661 | 7.4 | 0.999 / 0.999 | 8° | 9.1 A | 134 mT | 227/286/308/438 | 264 Vac 100 W 에서 f_Max 닿음 |

**벤치 결과(2026-10-14, 사용자): B3 쪽으로 C_r · C_T · R_T 만 바꾸자 역률이 나빠지고 출력 전압이 떨어졌다.** 스코프(2 ms/div, 트리거 156 V — 110 Vac 로 보임, 부하·FB 미기록): 공진 전류 최대 9.3 A 가 라인 피크 근처에 몰리고 골짜기에서는 작다. 사용자 관찰로는 라인 피크 근처에서만 공진 위(어보브)로 동작한다. 110 Vac FB 의 피크 156 V 는 n·V_out 169 V 보다 낮아 게인 1.085 가 필요하므로, 피크에서 공진 위라면 거기서 전력을 다 못 보낸다. **위 표의 FHA 추천은 이 보드에서 맞지 않았다 — 원인 미확정**(FB 전압 · 피크/골짜기 확대 파형 · 실제 C_r 값 대기). 되돌릴 기준점은 A2(C_r 117.5 nF 실장 = 47 nF 2직렬 × 5병렬, 470p/6.8k).

추가 측정(같은 날): 출력 18 V 까지 떨어짐, 입력 173 W, **FB 3.5 V 이상(포화)**, 공진 전류는 라인 피크 ±30° 에만, 그 구간은 공진 위. FB 가 포화인데 전력이 묶였으므로 IC 안의 전력 제한이다. DS §5.2.4–5.2.6 에서 FB 와 무관하게 주파수를 올려 전력을 깎는 것은 OCP1(ISEN −550 mV = 22.9 A, 측정 9.3 A 라 아님) · OVP1(출력 18 V 라 아님) · **ACP-soft(ISEN 으로 용량성 판정)** 셋뿐이라 ACP-soft 가 가장 유력하다(확인 전). 물리: f_r/f_o = √((L_r+L_m)/L_r) = 2.33 은 트랜스포머가 정하고 C_r 로는 안 바뀐다. 역률은 f_Min 을 f_o 쪽으로, 아래 공진 ZVS 는 f_Min 을 f_r 쪽으로 당긴다 — 옛 값은 f_r/f_Min 1.34 에서 돌았고 새 값은 약 1.9–2.3(발진기 실측 −15 % 포함)이라 한 스위칭 반주기에 공진 반파가 거의 두 번 들어가 전류가 바뀐 부호로 스위칭된다. FHA 는 이것을 못 본다. **C_r 로는 역률과 ZVS 를 둘 다 못 잡는다 — 비율을 바꾸려면 L_r 을 늘려야 한다(외부 직렬 인덕터; 설계 L_r 11 µH 에서 5.3 µH 모자람).**

탱크 · R_T · C_T 를 되돌린 뒤(같은 날): **ZCD 상단만 270 kΩ(22 pF 없이)으로 바꾸자 출력이 여전히 떨어지고, 540 kΩ 으로 되돌리자 회복.** DS §5.2.7: OVP1(ZCD 2.3 V, 필터 500 ns)은 스위칭을 멈추지 않고 전력을 줄이며 CSS 를 다시 충전한다 — 보조권선 피크(누설 링잉 포함)가 270k 에서 OVP1 을 넘었을 가능성. 확인 전. 기동 끝(1.36 V)과 OVP1(2.3 V)의 비는 1.69 라, 정상 운전의 ZCD 피크가 그 사이(약 1.6–1.8 V)에 오도록 R_ZCD,H 를 실측 피크로 고른다.

ZCD 실측(같은 날, 110 Vac 풀로드, R_ZCD,L 19 kΩ, ZCD 22 pF): 540 kΩ 에서 ±1.3 V(링잉 거의 없음) → 보조권선 평탄부 약 38 V, aux/sec ≈ 1.5 — **워크북의 n_aux/n_sec 1(2 T)이 틀렸고 실제 3 T 직렬로 보인다(확인 전)**. 270 kΩ 실패는 링잉이 아니라 평탄부(ZCD 2.5 V)가 OVP2 를 넘은 것. 360 kΩ 에서 ±2.0 V → 보조권선 39.9 V. **390 kΩ 권장**: ZCD 1.85 V · 기동 끝 18.3 V · OVP1 31.0 V · OVP2 33.7 V(출력 캡 35 V 아래) · OVP1 여유 24 %.

**보드 상태(2026-10-14 저녁, 사용자)**: C_r 117.5 nF(47 nF 2S×5P MLCC) · C_T 470 pF · **R_T 9.1 kΩ**(250 ns 상수로 f_Min 110 · f_Max 334 · f_SU 515 kHz, 실측은 10–15 % 낮을 수 있다; f_r/f_Min 1.76 · f_Min/f_o 1.32) · R_ZCD,H 360 kΩ + ZCD 20 pF · R_CS 24 mΩ. **110 Vac/50 Hz 에서 PF 0.98.** 9.1 k 는 보드 1 에서 8.2 k(f_Min 122)·10 k(101)가 110 Vac 200 W 20 s 뒤 불안정했던 구간 안의 값 — 장시간 200 W 시험이 아직 없고, 보드 차이인지 ZCD(540 → 360 k, SU-end 도달)인지 모른다. 220 Vac 는 기동 스파이크 때문에 미시험. 벤치 워크북 사본(`measured200_xl.py`)은 F24 9.1 로 갱신, `_opt` 사본은 실패 기록으로만 남긴다.

**기동 스파이크(무부하 AC 기동 캡처, 입력 전압 미기록, 10 ms/div)**: HS_VDS1 최대 376.8 V(정상 운전 피크 약 200 V), 탱크 전류 +17.1/−18.1 A(OCP1 22.9 A 근처), **처음 약 20 ms(라인 피크 2–3개, V_out < 약 13 V)에만**, 그 뒤 깨끗. 사용자: 턴온 스파이크. 레일 2.2 nF/레그 · D–S 150 pF 는 효과 없음(역회복 기전이라 당연). 원인 후보 둘, 0.5–1 µs/div 확대 캡처(HS/LS V_DS · 탱크 전류 · LS V_GS)로 구분 대기: ① V_out 낮아 자화전류 없음 + f < f_r(194.5 kHz) 용량성 ② 기동 중 데드타임 연장(DS §5.2.3) 동안 전류가 0 을 지나 반대로(di/dt ≈ V_bus/L_r ≈ 35 A/µs @ 200 V, 420 ns 면 15 A). 220 Vac 정상 상태 측정은 90 Vac 기동 뒤 라인 램프(모핑 on-the-fly, DS §5.1.3) 또는 출력 프리차지(> 17 V, SU-end 위)로 가능 — 기동 문제의 해결은 아니다. 264 Vac 냉기동은 단순 비례로 600 V 를 넘을 수 있어(STO60N045DM9 V_DSS 600 V) 계단식 + 80 % 중단 기준으로만.

**기동 스파이크 — 확대 파형 판독(2026-10-22, 같은 덱 슬라이드 7의 1 µs/div, 10-14 03:03, V_out 약 0.5 V, 약 444 kHz, C115 장착)**: 위 후보 ① ② 는 **둘 다 아니다** — 모든 전이에서 탱크 전류 방향이 맞고 12–14 A(ZVS 필요량 약 1.8 A). 보인 것: (a) 기동 패턴 비대칭 — HS1 약 0.6 µs · LS1 약 1.6 µs · 레그 2 는 1.05/1.2 µs, 한 에지에서 레그 1 이 0.57 µs 먼저 전환해 LS1 · LS2 동시 온 구간(전류 평탄)이 생기고 **HS1 이 피크(약 +12 A)를 혼자 끊는다**(리포트의 "HB1 duty not 1:1"). (b) 그 순간 HS_VDS1 이 약 150 V 버스 위에서 0–340 V 로 12.8 MHz 진동(중점은 0 V 에 붙어 있음 = 버스 쪽 링), 두 레그가 함께 바뀌는 에지는 ±80 V. (c) 한 장면에서 HS1 차단 약 180 ns 뒤 HS_VDS1 이 약 95 ns 동안 0 V, 같은 시간 LS_VDS1 약 320 V — 전류가 중점 밖으로 흐르는 중이라 **HS1 채널 재도통**(LS1 바디 다이오드 역회복을 동반). 재도통 원인 후보: 입력 유기 · 느린 턴오프((10 Ω + D) ∥ 47 Ω) · Miller — HIN · HS V_GS 동시 측정으로 가린다. (d) C115 장착 상태에서 12.8 MHz 이고 진폭 ±170 V / 12 A ≈ 14 Ω 라 링 용량은 C115(2.2 nF 면 ±70 V)가 아니라 FET 쪽(C_oss + 150 pF, 약 0.5–1 nF), 커뮤테이션 루프 약 150–260 nH 추정 — C115 를 4.4 nF 로 늘려 주파수가 −29 % 면 C115 주도, −5–10 % 면 루프 · FET 주도. 대책 순서: FET 핀(HS 드레인–LS 소스, R_CS 위)에 47 nF 630 V C0G(TDK C4532C0G2J473J) 레그당 1–2개 → 같은 조건 재캡처 + HIN 측정 → HIN 에 V_IH 넘는 펄스면 입력 RLC(4.7 µH + 270 Ω + 220 pF, 12.8 MHz 에서 ×0.13), 아니면 턴오프 저항 2.2–4.7 Ω. D–S 150 pF 를 떼면 기동 중 정지 · 재기동(OCP2/ACP)이 생겼다(사용자, 10-21) — 유지. 슬라이드 5 · 9 의 제목과 그림은 맞다(1 ms/div 화면의 트리거 208/356 V · 시각으로 확인).

**230 Vac PF 0.7 의 후보(2026-10-15)**: 탱크 수준에서는 230 HB(탱크 피크 163 V) ≈ 110 FB(156 V) 라 데드 앵글(51° vs 54°)도 모델 PF 도 같다 — 차이는 탱크 밖. ① **고주파 리플이 라인으로 샘**(EMI 필터 없음, 브리지 뒤 660 nF 뿐): 230 V 는 기본파 전류가 절반(0.96 vs 2.0 A)이고, HB 에서는 버스 전류가 HS1 반주기에만 흘러(LS1 반주기는 탱크가 LS1–LS2 로 순환) 리플 주성분이 2·f_sw 가 아니라 f_sw 라 660 nF 가 덜 거른다. 110 V PF 0.98 ↔ 라인 HF 약 0.4 A rms; 230 V 에서 비중 4배면 PF ≈ 0.78. **사용자 확인: AC 입력 전류가 지저분하고 220 V 에서 더 심하다** — ① 과 맞는다. ② IC 의 HB 제어(ISEN 이 HS1 반주기만 봄, +200 mV 의 고입력 용도) — 저주파 파형 모양(영점 비움 · 피크 몰림)으로 구분. 판별: 분석기 라인 필터(500 Hz) ON/OFF 의 PF 두 값, 라인 전류의 20 MHz vs 저역 뷰, 임시 DM 필터(X2 0.47 µF – DM 초크 200 µH/≥5 A – X2 0.22 µF, f_c ≈ 16 kHz, 145 kHz 에서 약 38 dB)로 재측정. 규격(IEC 61000-3-2)은 40차까지라 HF 는 EMI 필터의 몫.

**EMI 필터(CLCLC) 장착 후(2026-10-15, 사용자)**: PF **110 Vac 0.99 · 220 Vac 0.96** (R_T 9.1 k · ZCD 360 k · C_r 117.5 nF, 200 W). 230 V PF 0.7 의 대부분이 고주파 리플(①)이었다는 것이 확인됐다. 220 V 에 남은 0.04 의 내역(X캡 진상 전류 · 영점 데드 앵글 · C_in 100 Hz 왜곡)은 미분리 — 고조파 모드의 THD·변위 역률로 가른다.

B3 의 손실 지표(200 W): I_pri,rms 4.4–5.2 A(A2 4.5–5.3) · 1차 MOSFET 4개 전도 2.6–3.6 W(R_DS 68 mΩ hot) · R_CS 0.47–0.64 W · L6498 하나 0.21–0.25 W(47/10 Ω) · 라인피크 자속 81 mT(A2 117) · 자화 피크 5.5 A(A2 8.0) · ZVS 전환 71–138 ns(ADT 최대 420). C_r 스트레스: 90 Vac 피크 124 V, 골짜기 196 V, 230 HB 238 V(DC 163 포함), 264 HB 230 V, I_rms 4.4–5.2 A → 폴리프로필렌 ≥ 400 V dc, 200–400 kHz 에서 I_rms ≥ 6 A. 워크북(opt 사본) 재계산: f_r 307.5 · f_o 132.1 · f_Min 153.7 · f_Max 443.9 · f_SU 660.7 · RT.ceil 10.72(k.RT 1.18) · I_Lm,pk 5.46 · I_pri,rms(π/2) 5.42 · P_RCS 0.70 W · BM 진입 37.4 W(R_BM 15k) · OVP1/2 35.0/38.0 V · SU-end 20.7 V(ZCD 270k) · BO 76.4 Vac(R_CFG 27k) · 루프 17.5 Hz / 52.5° / D3 3.64 %. k.CT 는 여전히 미달(150–173 Vac FB 코너는 λ 0.226 의 점근 게인 0.816 > 필요 0.72 라 어떤 값으로도 불가 — 외부 직렬 인덕터 ≥ 5 µH 가 유일한 길, 탱크 재계산 필요).

**한계.** FHA 는 아래 공진에서 게인을 낮게, 위 공진에서 높게 잡는다(140 Vac 실측 250 kHz vs FHA 383–417; 90 Vac 200 W 가 6.8k 에서 버틴 것도 FHA 로는 불가). 사각·전류는 순위로만 쓴다. 코어 재질(사양서 TBD)·권선 R_ac 를 몰라 절대 효율은 못 낸다. 발진기 상수 250 ns 는 기동 주파수 실측(430 vs 503 kHz)으로 보아 ±10–15 %.(R_CS 는 이미 120 mΩ × 5 = 24 mΩ). 재계산: 버스트 진입 입력 39.9 W, OVP1 45.9 V · OVP2 49.9 V, 기동 끝 27.1 V, V_BO 36.8 Vac — 13 kΩ 는 DS Table 6 의 15 kΩ 아래라 워크북 식(4 V/kΩ)을 그대로 쓴 값이다. Excel 에서 한 번 열어야 캐시가 맞는다 |

## 200 W 브링업 테스트 리포트(2026-10-16, `261016_LGE_670W_L6790A_Single_Stage_PFC_LLC_Test.pdf`)

보드 2 · R_T 9.1 k · C_T 470 p · C_r 117.5 nF(X7R 2S5P) · ZCD 360 k + 20 p · R_CS 24 mΩ · 55G6 EMI 필터 + C_in 660 nF · C_out 34 mF · SR ON. 스코프 측정 패널에서 읽은 값:

| | 110 Vac/50 Hz | 230 Vac/50 Hz |
| :-- | :-- | :-- |
| P_in (리포트) · 효율(25 V 가정) | 238 W · 84.0 % | 231 W · 86.6 % |
| **스코프 V_out 평균** | **24.2–24.3 V** → P_out ≈ 194 W, 실효율 **≈ 81.7 %** | 24.2–24.4 V → **≈ 84.2 %** (보드 2 의 부하 레귤레이션 처짐, Kelvin 센스 미해결) |
| PF (분석기) | 0.99 | 0.96 |
| 라인 전류 rms / 최대 | 2.21 A / 3.68 A | 1.03 A / 1.75–1.93 A (최대값은 HF 잔털 포함) |
| f_sw 범위 (리포트) · 라인 피크 실측 | 110–190 kHz · **190.4 kHz** | 110–250 kHz · **253.1 kHz** |
| 탱크 전류 피크 / 반주기 rms | +9.4 / −9.7 A · 5.48 A | +9.5 / −9.8 A · 4.99 A |
| HS_VDS1 최대 | 203–217 V (버스 피크 156 V + 링잉 50–60 V) | 350–357 V (버스 325 + 25–30 V) |
| V_out 리플 pk-pk (34 mF) | 1.04–1.08 V | 1.07–1.10 V |

**읽은 것.** ① f_Min 실측 110 kHz = 250 ns 상수 계산값(110.4) — 발진기 상수는 여기서는 맞다(기동 주파수의 −15 % 는 별개). ② 110 V 라인 피크 190.4 kHz 는 공칭 f_r 194.5 kHz 바로 아래(필요 게인 1.09) — 모델과 맞다. ③ **230 V HB 라인 피크 253 kHz 는 공칭 탱크로는 불가능**(f_r 위에서는 게인 < 1 인데 필요 게인 1.04 로 25 V 를 냈다; 확대 파형도 공진 위 사인). 공진점이 그 자리에 오려면 **C_r,eff ≈ 69 nF(−40 %)** — HB 에서만 C_r 에 DC 바이어스(V_bus/2 ≈ 163 V, 2직렬이라 부품당 81 V)가 걸리고 X7R 은 바이어스로 용량이 준다. 같은 이유로 HB 에서는 f_o 도 올라가 f_Min 110 kHz 와의 간격이 좁아져 영점 데드 앵글이 커지고(230 V 라인 전류가 영점 근처에서 눌림, PF 0.96), 라인 피크가 250 kHz 로 올라가 스위칭 손실도 는다. **가장 유력한 "같은 탱크인데 230 V 가 다른" 원인 — PP 필름 C_r 로 바꿔 230 V 라인 피크 주파수가 ~190 kHz 로 내려오는지로 확정.** 새 설계(C_r 150 nF, HB 에서 DC 163 V + AC ~100 V)는 처음부터 필름. ④ 리플 1.05–1.1 V: 이상적 sin² 전력이면 I_out/(2π·f_l·C) = 0.75 V(34 mF), ESR(5개 병렬 ~6 mΩ) +0.1 V, 전해 −20 % 허용차(27 mF)면 0.94 + 0.1 ≈ 1.04 V — 데드 앵글 없이도 설명된다(데드 앵글 40° 면 리플 1.1 V 지만 PF 0.93 이라 110 V 의 0.99 와 안 맞는다). ⑤ 110 V FB 에서 V_DS 가 버스보다 50–60 V 높다 — 전환 링잉(확대 파형의 LS_VDS1 링잉), 264 V HB 정상 상태는 버스 373 + 30–60 → 400–430 V 로 600 V 안. 기동 스파이크(377 V @ ~110 V)는 별개. ⑥ 탱크 rms 5.0–5.5 A 가 110/230 V 에서 거의 같다 — 자화 순환 전류가 지배(모델 I_m,pk 8.6 A, 실측 피크 9.4–9.8). ⑦ 리포트의 트랜스포머 쪽은 `asbuilt_spec.py` 사양서 그대로 + "ST 요청대로 안 만들어짐, 권선 굵기 부족 → 최대 200 W".
⑧ **반주기 비대칭(사용자 관찰)**: 230 V HB 확대에서 공진 전류 +7.52 / −6.56 A(14 %), HS_VDS1 양의 듀티 46.9 % → **HS 가 53 %, LS 47 %**; 110 V FB 는 듀티 50–51.6 %, 전류 +7.44 / −7.92 A(6 %). 센터탭 반쪽 누설 불일치는 FB 에도 같은 크기로 나타나야 하므로 FB 의 6 % 까지만 설명한다(벤더 반쪽 단락값은 NS2 · NS3 따로 기록되지 않았다). HB 에서만 더해지는 몫의 후보: (a) **IC 의 HB 타이밍** — R_CS 가 HS1 반주기만 보므로 LS1 반주기는 다른 규칙으로 정해진다(설계팀 질문) · (b) **X7R C_r 의 전압 의존 용량** — HB 에서 C_r 이 163 ± 70 V 라 + 스윙과 − 스윙의 용량이 달라 반주기마다 공진 주기 · 피크가 다르다(FB 는 바이어스 0 이라 대칭). 듀티 53/47 의 결과: V_Cr,DC = 0.53·V_bus, 센터탭 두 반쪽 전류 불균형(SR 발열 차), rms 소폭 증가. 판별: NS2-only / NS3-only 단락 누설(유닛 3개 각각) · 230 V 확대에서 두 반주기의 사인 구간 길이 비교(같으면 IC 타이밍) · NS2/NS3 연결 바꿔 비대칭이 뒤집히는지 · 필름 C_r 로 교체(253 kHz 와 함께 사라지면 X7R).

## LGE 자료 2026-10-16 — 회로도 2쪽 · 구버전 워크북 · 테스트 덱 11장

**받은 것**: ① Altium 회로도 PDF 2쪽(AC EMI 필터 = sheet 1/3, 메인 보드 = sheet 3/3, Frank KWON, 2026-10-16) ② `16102026_LGE_200W_L6790A_Single_Stage_PFC_LLC_TV_Power.xlsx` — ST 원본 레이아웃 그대로(10 시트 · 셀 수 동일 · 수식 수정 0), 시트 보호가 걸려 있을 뿐이라 openpyxl 로 읽힌다. **ST 원본과 다른 상수 36칸** ③ `…_Test.pptx` — 2026-10-16 보고서 PDF 와 같은 파형 + 요약 + 트랜스포머 사양 슬라이드.

**회로도에서 읽은 보드(메인 보드)**: L6790A SO16N — R_T 9.1 k(R215, R210 0 Ω) · C_T 470 pF(C110) · ZCD R206 360 k / R208 18 k + R213 1 k = 19 k / C121 20 pF · CFG R212 13 k · **BM R211 0 Ω → GND** · ISEN R226 0 Ω, R_CS 120 mΩ 6432 × 5 = 24 mΩ · FB 핀 1.5 nF + 100 pF · DRV_EN R224 1 k(N.C.) · HVSU 는 ACL/ACN 에서 HS1M 둘(D31/D32)로 · **VCC 는 외부 18 V(P2 "External 18V For L6790A")**, 보조권선은 ZCD 만 구동. 게이트: L6498LD × 2, 부트 MURS160 + 10 Ω, C_boot 100 nF, **ON 47 Ω(R115 단독) · OFF (1N4148WS + R114 10 Ω) ∥ 47 Ω**(2026-10-18 정정 — 처음엔 "ON 47 + 10 Ω" 으로 잘못 읽었다; 게이트 구동 전원 VCC_GD 는 Q39 가 "Shorted" 라 외부 18 V(VCC3) 그대로), 입력 47 pF × 2. 1차 STO60N045DM9 TO-LL × 4, **레그마다 VBUS–PGND 에 C115/C117 2.2 nF/2 kV**(2026-10-18 정정 — 처음엔 반브리지 중점으로 잘못 읽었다), D–S 150 pF(C64/C67/C74/C79 — 회로도에는 N.C. 로 돼 있으나 모든 FET 에 실장, 사용자 2026-10-17) C_r 47 nF/630 V X7R 3216 × 10(2S × 5P) = 117.5 nF("Cr=117nF"). T2 1차 15 T(12–10) · 2차 2 T + 2 T(4–5–6) · **보조 3 T(8–7)**. SR: TPH3R70APL1 × 2/레그(Q25/Q26 · Q29/Q30) + TEA2095TE/1, 게이트 2.2 Ω, **SR 전원도 외부 12 V(P1) → 78D09 9 V**. 출력 6800 µF/35 V × 5 + 10 µF × 5, L2 EF-83W 후단 필터. 루프: TL431 Q44, R_I 100 k(R181) · R_o 1 k + 10 k = 11 k · R_B 6.2 k(R178) · R_P 1.3 k(R183) · **C_Fo 220 nF(C95) · R_F 22 k(R187) + C_F 2.2 µF(C98) ‖ 0.1 µF(C99)** · 옵토 UPC1008G-LS04-R(U13) · 12V_FB 레일 BSS169 + TL431 Q46(130 k / 27 k ≈ 14.5 V). 더미 부하 1.5 kΩ 1 W × 18(R137–R154, Q31 2N7002 + 180 k DISCHARGE). AC 필터 보드: LGE 55G6 필터(CM L3 + DM L4 · L5 + C122–124, 값 미측정), GBU1006 × 2 — BD2 는 N 측 · BD3 는 L 측(AC 핀 묶음), C125/C126 330 nF/275 VAC. 회로도 상단 표(λ 0.226 · n_T 7.5 · Z_o 6.98 · Z_O 16.25 Ω · f_no 0.429 · f_r 194.89 · f_o 83.70 kHz · L_µ 27.90 · L_L1 3.00 · L_L2 0.053 µH · I_R0,crit 1.763 A)는 워크북 `Res. Tank Design` D50–D56 과 같다.

**테스트 덱의 새 사실**: 110 Vac 25 V / 8 A P_in 238 W(84.0 %) · PF 0.99 · f_sw 110–190 kHz; 230 Vac 231 W(86.6 %) · PF 0.96 · 110–250 kHz; 리플 1.1 Vpp(34 mF); SR ON; 55G6 필터 + 660 nF. "VCC should be powered before AC powering" · AC 기동 400 Vpk 스파이크 · **230 Vac 기동에서 HB1 MOSFET 파손 확인** · 기동 시와 230 V 에서 HB1 듀티 1:1 아님(HOUT1/LOUT1 확인 예정 — 2026-10-16 ⑧과 같은 결론). 트랜스포머 사양 슬라이드: 1차 Litz 0.1 × 130(1.02 mm², 4.5 A/mm² 로 4.6 A rms) · 2차 0.1 × 110 bifilar(0.86 mm², 3.9 A rms) · 보조 ø0.4 · "Winding thickness is too small → Max 200 W with this transformer" · "Transformer was not made as ST requested" · 코어 42 × 7.85 × 19 × 36, E 6.0 · F 4.85 mm(A_e 114 · l_e 58.82 · V_e 6706 mm³, 재질 TBD).

**워크북 이식**(`lge200_xl.py` → `BENCH_200W_LGE_workbook_unencrypted.xlsx`): 36칸 중 15칸은 벤치 사본에 이미 있었고(P_out 200 · V_o,min 19 · Δv 5 % · T_hold 12 ms · n 6.773 · L_r 5.7 · L_m 25.2 µH · C_in 660 nF · 6800 µF × 5 · R_T 9.1 k · R_ZCD,H 360 k · R_CFG 13 k · C_oss 897 pF · STO60N045DM9 · R_D 3.7 mΩ), 21칸을 새로 넣었다(위 파일 표). 넣지 않은 둘: `Design Spec` F20 Vin.min 180 Vac(우리 F20 은 245 V/√2 = 173.2 Vac 모핑 수식, 180 은 툴의 "165–180" 힌트 안이지만 덜 보수적) · D58 Vrect 0.395 V + `Power Components` C92 STPS30M60S(구버전엔 SR 선택이 없어 쇼트키 전압강하로 흉내 — 보드는 TPH3R70APL1 SR, 시험도 SR ON; rev0_6 은 Conf.SR 2 · TPH3R70APL1 · R_D 3.7 mΩ · Vrect 0). **LibreOffice 재계산(OOXMLRecalcMode 0) 과 LGE Excel 캐시 비교** — 같은 입력에서 같은 것: f_r 194.89 · f_o 83.70 · λ 0.226 · Z_o 6.98 · OVP1/OVP2 30.59 / 33.25 V(보조 45.9 / 49.9 V) · SU-end 출력 18.1 V · V_BO 36.8 V · BM 0 · f_z/f_p 3.29 / 36.2 Hz. 다른 것: ① **f_Min / f_Max / f_SU 110.4 / 333.7 / 514.6 kHz**(rev0_6 의 250 ns 상수 — 벤치 f_Min 110 kHz 와 일치) vs 구버전 108.1 / 312.9 / 466.5 ② 합성 피크 8.63 A(부하 5.57 + 자화 8.62, 위상 반영) vs 구버전 5.47 A(부하만) → k.OCP1 2.66, 스위치 전류 정격 11.2 vs 7.1 A ③ k.CT 0.123 — FB 코너 166 Vac 에 1090 kHz 가 필요한 알려진 항목(150–180 Vac 회피), 구버전은 264 Vac HB 만 보고 CT.max 748 pF ④ 정지 소자(HB 의 LVG2) 손실 3.75 W vs 구버전 100.6 W(구버전 수식 오류) ⑤ 루프 f_cross 17.5 Hz · 위상여유 52.5° · 3차 3.24 %(구버전 17.3 / 53.7 / 3.20) — 2026-10-13 의 34 mF 제안값이 보드에 그대로 실렸다 ⑥ P_in 205.6 W(η 98 % 가정)와 실측 238 W 의 32 W 차이는 ⑦ 의 손실 예산 그대로 ⑦ k.naux 0.56 < 1 은 보조권선을 VCC 에 직결할 때의 검사라 이 보드(VCC 외부, 보조는 ZCD 만)에는 해당 없음 ⑧ 2차 권선 rms 9.7 A(rev0_6 [64]) vs 구버전 11.1 A, 출력 커패시터 rms 11.2 vs 8.7 A — 수식 차이, 사양서 전류는 rev0_6 값을 쓴다.

**옵토커플러 UPC1008G-LS04-R 반영(2026-10-17)**: UTC UPC10XX 데이터시트(unisonic.com.tw 에서 받음): 등급 UPC1008 CTR 130–260 % @ I_F 5 mA · V_F 1.45 typ / 1.6 max @ 50 mA(V_F 곡선 없음) · f_c 80 kHz · t_r 3 / t_f 4.7 µs @ R_L 100 Ω(SFH617A 와 같은 사양급 → C.opto 3 nF 유지) · UTC TL431 I_min 0.3 typ / 0.5 max mA(LGE 의 0.5 = max). 6쪽 UPC1008 I_C–I_F 곡선(래스터 300 dpi 로 읽음, 5 mA 에서 192 %): I_F 0.1 / 0.2 / 0.3 / 0.5 / 1 mA 에서 CTR 50 / 70 / 82 / 100 / 128 %. 워크북 동작점(I_tr 150 / 300 µA)을 자기일관으로 풀면 등급 최소(× 130/192) **0.54 / 0.65**(I_F 0.28 / 0.46 mA), typ 0.71 / 0.86, 등급 최대 0.86 / 1.07 → ST 관행(SFH617A 0.37 / 0.53 도 등급 하한 근처)대로 등급 최소값을 넣었다. **결과: 보드 보상망(220 nF / 2.3 µF / 22 k) 그대로면 f_cross 23.6 Hz · 위상여유 47.8° · 3차 4.7 %(등급 최소), typ 28.9 / 43.4° / 6.2 %, 등급 최대 33.0 / 40.1° / 7.5 % — SFH617A 가정(17.5 / 52.9° / 3.2 %)으로 고른 보상망이라 새 옵토에서는 목표(PM 50° · 3차 5 %)를 typ 이상에서 놓친다.** C_Fo 만 키우면 3차는 내려가도 PM 은 더 나빠진다(330–470 nF 에서 30–40°). 임피던스를 같은 비율로 줄여야 한다(C_Fo · C_F × k, R_F ÷ k; LibreOffice 재계산): A 470 nF / 4.7 µF / 10 k → 등급 최소 12.5 Hz · 55.6° · 2.2 %, typ 15.7 · 54.1° · 2.9 %, 최대 18.4 · 52.2° · 3.5 %; B 390 nF / 3.3 µF / 12 k → 14.5 · 52.8° · 2.7 / 18.2 · 50.9° · 3.5 / 21.2 · 48.9° · 4.2; C 470 / 4.7 µF / 12 k → 14.1 · 53.4° · 2.3 / 17.6 · 50.3° · 3.0 / 20.4 · 47.6° · 3.6. **권장 A**(등급 전체에서 PM ≥ 52°, 3차 ≤ 3.5 %), 과도응답을 더 원하면 B. 실장 옵토의 CTR 을 I_F · I_C 로 재면 등급 안 위치가 정해져 더 좁힐 수 있다. **사용자 결정(2026-10-17)**: 12V_FB 분압 R197 130 k → 100 k(11.74 V, 사용자 시뮬레이션은 12 V 였다 — 회로도 130 k 와 어긋난 것은 시뮬레이션 넷리스트 값 차이로 추정) 와 **보상망 A(470 nF / 4.7 µF / 10 k)** 를 사본에 넣었다. **R_B 판정**(워크북의 R.B.min 은 최대 FB 전류 300 µA 를 낼 수 있는 가장 큰 R_B 라 선택값은 그 아래여야 한다; R_p 1.3 k 가 V_F/R_p 만큼 바이어스를 가로채므로 V.Fo 에 민감): V_Z 11.74 V 에서 DS 값 V.Fo 1.45 V 면 R.B.max 5.60 / R.B.min 4.94 k 로 보드 6.2 k 는 상한 위이고, LED 동작점(0.3 mA)의 현실적인 V_F 1.1 V 면 7.25 / 6.23 k 로 6.2 k 가 통과한다. → **옵토 LED 양단 전압(핀 1–2) 실측**으로 가른다: ≤ 1.15 V 면 6.2 k 유지, 아니면 R_B 4.7 k — 그 경우 루프 이득이 1.32배 올라 A 로는 등급 최대에서 22.9 Hz · 48.6° · 4.6 % 라 **A2 680 nF / 6.8 µF / 6.8 k**(11.4 / 14.4 / 16.9 Hz · 55.8 / 54.9 / 53.5° · 2.0 / 2.6 / 3.2 %)로 간다. 사본은 R_B 6.2 k · A 다.

**정리(2026-10-17, 사용자 답)**: ZCD 아래 저항은 R208 18 k + R213 1 k = **19 k** — 워크북 19 k 가 맞다(내가 R213 을 따로 읽었다). **c.HB 는 사용자가 확인할 것이 아니라 값을 정할 문제였다**: C115/C117 2.2 nF 는 실장이고(2026-10-14 사용자 "각 레그마다 2.2 nF") STO60N045DM9 C_oss(tr) 897 pF 는 데이터시트 값이므로 **c.HB = 2929(C_oss × 2, 245 V 환산, `l6790` [116]) + 100(기생) + 2200 + 150 × 2(D–S, 2026-10-17 사용자: 모든 FET 에 실장, 회로도 누락) = 5529 pF** 로 넣었다. 워크북에서 c.HB 를 읽는 곳은 둘뿐이다: `Res. Tank Design` D60 I.R0,crit = √(2·c.HB/(L_r + L_m))·√2·V_in,min — 에너지 기준 ZVS 임계 전류, 500 pF 에서 1.39 A · 5529 pF 에서 4.64 A, 자화 피크 8.62 A 와 비교 — 와 D37 전이 시간 T.T. 데드타임 기준(워크북에 없음)으로는 C·V_bus/t_D 가 5.0 A(245 V) · 5.8 A(325 V, C_oss 환산 2208 + 2600) · 6.2 A(373 V) 필요하고 8.6 A 가 있으니 여유 1.4–1.7배. 구버전 D60 은 √2 가 빠져 있다(500 pF 에서 1.024 A = 5.689 mA/V × 180 V). t_D 270 ns 는 LGE 값 그대로(IC 의 데드타임은 적응형). **두 150 pF 가 더해지는 이유(2026-10-17 사용자 질문)**: 전이 때 충방전되는 노드는 버스가 아니라 중점이다 — HS 캡은 중점–+레일, LS 캡은 중점–GND 에 있고 +레일과 GND 는 벌크 커패시터로 교류 같은 노드라, 중점이 ΔV 움직이면 LS 캡은 C·ΔV 를 받고 HS 캡은 C·ΔV 를 내놓는데 둘 다 중점을 지나 탱크 전류가 댄다 → (C_HS + C_LS)·ΔV. 버스 양단에서 보면 직렬(75 pF)이지만 그 노드는 전이와 무관하다. 두 C_oss 를 2 × 897 로 더한 것과 같은 이유. 직렬로 봐도 c.HB 는 4 % 차이. **데이터시트 재확인(2026-10-17)**: STO60N045DM9 DS14711 Rev 4 는 81차에 업로드본에서 읽어 표 값만 남아 있고(C_oss eq. 시간등가 0–400 V **897 pF**, C_oss @400 V **86 pF**, Q_g 90 nC @10 V — 빌더 상수 `C.oss_tr` · `C.oss_400`) PDF 는 저장소에 없다. 이 세션에서는 st.com(503 · 빈 응답) · Farnell(503) · RS(403) · Mouser(봇 차단) · alldatasheet(403) 전부 막혀 곡선을 다시 못 읽었다. 그러나 표의 두 값으로 전하가 묶인다: Q_oss(400 V) = 897 pF × 400 V = 358.8 nC 이고, 초접합 C_oss 는 전압이 오르면 단조 감소하므로 245–400 V 구간의 C_oss 는 86 pF 이상(400 V 값)이고 넉넉히 1.5배 129 pF 이하로 잡으면 Q_oss(245 V) = 339–346 nC → 두 소자 전하를 245 V 로 나눈 C_oss 항 **2767–2820 pF**(규칙 [116] 의 2929 보다 4–6 % 작다); 325 V 에서 2148–2168 · 373 V 에서 1905–1912 pF. 따라서 c.HB(245 V) = 5.37–5.42 nF 이고 워크북의 **5529 pF 는 ≤ 3 % 보수적 — 유지**. 곡선을 읽어도 이 1 % 띠 안에서만 움직인다. 참고로 LCSC 에 있는 형제 소자 STP60N043DM9(DS, 2023-08) 표는 C_oss 82 pF @400 V · C_oss eq. 729 pF(0–400 V) 로 표 형식(시간등가 정의 · 400 V 조건)만 확인했고 값은 쓰지 않았다(다른 다이). **5.5 nF 가 정상 범주인가(2026-10-17)**: 잣대는 전이 시간 C·V_bus/I_m 이 IC 의 적응 데드타임 창(DS: T_ADT 40–420 ns, ADT 전 최소 펄스 370 ns) 안에 드는가다. LGE 보드 5.4 / 4.8 / 4.5 nF × 245 / 325 / 373 V ÷ 8.6 A = **154 / 181 / 195 ns**(420 ns 의 절반 아래); ST EVK 는 2.2 nF + STL38N60DM6 C_oss 두 개 ≈ 3 nF 에 I_m 2.57 A 라 ≈ 330–390 ns 로 창을 거의 채운다; 정본 PQ50 시트는 3.0 nF(C_oss 만) 에 11 A 라 ≈ 70 ns. 즉 LGE 값은 둘 사이, ZVS 가 유지되는 한 정상이고 ST 관행보다 오히려 작은 쪽이다. 얻는 것: 턴오프 손실 ∝ 1/C(2.2 nF 가 C_oss 만일 때의 약 1/5) · 중점 dv/dt 1.6–1.9 V/ns(C_oss 만이면 약 40 V/ns). **값이 문제가 되는 때는 ZVS 가 깨지는 순간뿐**: 스위칭 순간 전류가 C·V/420 ns = 3.2 / 3.7 / 4.0 A(245 / 325 / 373 V) 아래면 전이가 창 안에 못 끝나 하드 턴온이 되고, 그때 반대편 스위치에 걸린 C115 2.2 nF 의 ½CV²(155 V 에서 26 µJ · 325 V 에서 116 µJ)가 채널로 방전되며 전류 펄스 ≈ V·√(C/L_loop)(L 20 nH 가정 ≈ 50 A @155 V · 108 A @325 V)와 링잉이 생긴다 — 110 Vac 기동에서 본 HS_VDS1 376.8 V 는 버스 155 V 의 2.4배이고 같은 비율이면 325 V 버스에서 ~780 V 다. DS 5.2.3 의 소자화 감지는 '첫 펄스들'의 하드 스위칭만 막고 ADT 가 켜지면 보류된다. 그러므로 230 Vac 기동 파손의 후보에 바디 다이오드 역회복(기존)과 함께 **스너버 방전**을 올린다. 시험: 230 V 기동 조사에 한해 C115/C117 을 떼거나 470 pF 로 줄여 첫 펄스 스파이크(HS_VDS1 · LS 게이트, 1 µs/div, 110 V 부터)를 비교한다 — 정상 운전의 턴오프 손실은 그만큼 늘므로(t_f 가 느리면 수 W) 양산값은 파형을 본 뒤 정한다. 워크북 c.HB 5529 pF 는 보드 그대로 유지. 보조 3 T 는 유닛당 1 T 직렬(사양서)이라 n_aux/n_sec 1.5 와 ZCD 2.0 V 실측이 맞는다.

**회로도 10-18판(2026-10-18, `181026_LGE_200W_…_TV_Power.pdf`)** — 10-16판과 픽셀 단위로 대조하면 바뀐 곳은 둘이다: ① **C127–C130 150 pF/2 kV** 가 네 FET(Q27 · Q28 · Q32 · Q34)의 D–S 에 그려졌다(전에는 C64/C67/C74/C79 N.C., 실장은 2026-10-17 사용자 말대로) ② **R197 130 k → 100 k** — 12V_FB 레일(BSS169 Q40 + TL431 Q46, 하단 R204 27 k)이 2.495 × (1 + 100/27) = **11.7 V**(전 14.5 V). 보상망(C95 · R187 · C98 · C99)은 그대로다. **트랜스포머 극성(사용자: "권선 시작점이 맞나")**: 데이터시트 §5.3.4(LOUT1 · HOUT2 ON 에서 ZCD 양) · 그림 9 와 같은 배치 — 1차 ● 12 → HB1(Q27/Q28, U9 ← HOUT1/LOUT1), 10 → C_r → HB2(Q32/Q34, U10 ← HOUT2/LOUT2); 보조 ● 8 → R136 → VCC_GND, 7 → ZCD_AUX; 2차 ● 4(→ DSA) · 5(탭 → 출력), 6 → DSB. LOUT1 + HOUT2 에서 10 쪽이 + 라 7 이 + 다. 기능을 정하는 것은 1차 ↔ 보조 극성뿐이고 2차는 통째로 뒤집어도 같다(센터탭 전파 — 어느 SR 이 어느 반주기에 켜지느냐만 바뀐다). 두 반쪽의 상대 극성(직렬 가극)과 유닛 셋의 방향(1차 · 보조 직렬은 끝 → 다음 시작, 2차 병렬은 같은 끝끼리)은 지켜야 한다. **정정**: C115/C117 2.2 nF 는 10-16판에서도 반브리지 중점이 아니라 **레그 양단(VBUS–PGND)** 이다(중점 선이 건너뛰기 표시로 지나간다). 중점 스너버로 읽은 것은 내 오독이다 — 회로도대로면 c.HB = 2929 + 100 + 150 × 2 = **3329 pF**(워크북 사본의 5529 아님)이고, 하드 턴온 때 방전되는 것은 D–S 150 pF 의 ½CV²(325 V 에서 7.9 µJ)뿐이라 위 '정리' 단락의 "C115 방전" 파손 후보는 철회한다. 실제 보드가 회로도와 같은지 확인한 뒤 `BENCH_200W_LGE_workbook_unencrypted.xlsx` 의 c.HB 를 고친다. **레그 입력 교체(사용자: LEG1 이 IC 에서 멀다)**: 된다 — 네 논리 신호를 함께 바꾸고(HOUT1 ↔ HOUT2, LOUT1 ↔ LOUT2) **보조권선 두 끝도 바꾼다**(7 → GND, 8 → ZCD_AUX; 그대로 두면 LOUT1 · HOUT2 에서 ZCD 가 음이 되어 DS 말대로 첫 펄스가 하드 스위칭). 데이터시트가 레그 위치로 요구하는 것은 이 ZCD 극성뿐이다(그림 9 의 HB1 → 트랜스포머 · HB2 → C_r 는 예시이고 다른 제약은 적혀 있지 않다). FB 는 대칭이고 C_r 의 DC(V_in/2, HB)는 어느 레그가 스위칭하든 같다(탱크는 직렬 고리). 바뀌는 것은 HB 모드(그림 7: LOUT2 상시 ON, 레그 1 만 스위칭)의 둘이다: 정지 소자(탱크 전류 전체를 계속 흘리는 하단)가 Q34 → **Q28** 로 옮겨 가 열 설계가 따라가야 하고, 1차의 튀는 끝이 12 → 10 으로 바뀌어(정지 쪽 12 가 0 V) 1차–2차 결합 공통모드 잡음이 달라질 수 있다 — 전도 EMI 재확인. LOUT2 가 U9 LIN 으로 가도 같은 L6498LD 입력(100 Ω + 47 pF, 내부 풀다운 58 kΩ min)이라 핀스트랩(풀다운 금지)은 그대로다. 트랜스포머 사양(감기 시작 1 · 3 · 4 · a = 점)은 바뀌지 않고 PCB 결선만 바뀐다.

**기동 듀티 비대칭 · 기동 주파수와 구동 회로(2026-10-18, 사용자 "AC 기동의 Leg1 HS–LS 듀티 비대칭을 고민해 줘 · 기동 주파수가 게이트 드라이버 · 구동 회로에 맞나")** — ① **관찰**(테스트 덱 7쪽 확대 캡처: 110 Vac 무부하 AC 기동 직후, 1 µs/div, V_out 평균 0.53 V): 주파수 ≈ 480–530 kHz(= f_SU), **Leg1 노드 high(HS1) ≈ 0.6 µs · low(LS1) ≈ 1.3–1.5 µs, Leg2 는 ≈ 50/50** — 매 주기 두 하단이 같이 켜진 0 V 구간(≈ 0.35 µs)이 생기고 탱크 전류는 −9.7 / +7.3 A 삼각파에 그 구간만 평평하다. 네 노드 전이는 모두 전류가 ZVS 방향일 때 일어났다(전류 프로브 방향 확인 필요). HS1 이 꺼지는 모서리에 12.8 MHz 링잉(HS_VDS1 최대 343 V, 버스 ≈ 124 V)이 있고 같은 순간 정지해 있던 Leg2 의 HS_VDS2 도 +85 V 울린다 — 레그 디커플링이 2.2 nF(C115/C117)뿐인 버스 레일의 링잉. ② **해석**: 비대칭은 Leg1 에만 있고 Leg2 는 발진기 반주기를 따르므로 전력단이 아니라 IC 패턴이다 — DS §5.2.3 "Demagnetization sensing: 스위칭을 시작할 때마다 ZCD · ISEN 에 따라 켜짐 펄스나 데드타임을 늘릴 수 있다, ADT 가 켜지면 멈춘다" 와 맞고 ZCD 극성 규칙도 LOUT1 기준이다. 오래 가는 이유: ZCD ≈ 0.075 × V_out(3T/2T · 360 k/19 k)이라 V_out < 2.7 V 동안 ±0.2 V 문턱 아래 — 탈자화를 ZCD 로 못 보고, C_out 34 mF(설계 75 mF)가 그 구간을 수 ms 로 늘린다. 부트스트랩 탓은 아니다(VCC_GD 18 V 에서 f_SU 정상 상태 V_BS ≥ 14.8 V; 부트 부족이면 HS 펄스가 통째로 빠지지 LS1 이 매번 늘지 않고, 같은 회로의 Leg2 는 대칭). ③ **위험**: FB(110 Vac)에서는 0 V 구간일 뿐이고 이 캡처는 소프트 스위칭이다. HB(230 Vac, LOUT2 상시 ON)에서는 C_r 의 DC 가 D_HS1 × V_bus 에 앉는다(D 0.3 이면 0.5 대신 0.3 V_bus) — IC 가 듀티를 바꿀 때(ADT 전환 · ZCD 가 살아날 때) C_r DC 가 최대 0.2 V_bus ≈ 65 V 옮겨 가는 동안 탱크 전류가 치우쳐 한쪽 모서리의 ZVS 가 깨질 수 있고, 그러면 바디 다이오드 역회복과 위 링잉이 325 V 버스 위에 얹힌다 — **230 Vac 기동 HB1 파손의 가설(미확인)**. ④ **시험**: (A) L6790A 핀의 HOUT1 · LOUT1 · HOUT2 · LOUT2 + 노드1 + 탱크 전류를 AC 투입 트리거로 첫 50 ms — 논리 단에서 LOUT1 > HOUT1 이면 IC(§5.2.3), 논리는 대칭인데 노드만 비대칭이면 구동 회로; 첫 HVG1 펄스가 빠지는지도 (B) AC 전에 V_out 을 5 V · 20 V 로 미리 충전 — 비대칭 구간이 줄면 ZCD 무감 구간 확정 (C) HB 기동을 180 · 200 · 220 Vac 로 올리며(HS_VDS1 480 V 에서 중단) 듀티가 바뀌는 순간 늦게 넘어가는 모서리가 있는지 (D) 레그마다 100–220 nF/630 V(C0G · 필름)를 레그 바로 옆에 — 660 nF 입력 예산 안에서 — 달고 링잉 비교 (E) ST BU 에 ADT 전 기동 데드타임 · LOUT1 연장 한도 확인(DS 에 없음). 230 Vac 정상 상태의 53/47(⑧)은 ADT 가 켜진 뒤의 별개 현상이다. ⑤ **기동 주파수와 구동 회로**(x3m3 f_SU 526.6 kHz — 지금 보드 R_T 9.1 k 의 515 kHz 와 같은 급, 실측 480–530 kHz; R_T · C_T 가 정하고 1 ms 동안 16단계로 내려간다; IC 상한 ≈ 675 kHz): 반주기 950 ns, 전류 역전은 모서리 뒤 T/4 = 475 ns. V_out ≈ 0 에서 스위칭 전류는 L_r–C_r 직렬 전류 FB 155 V 8.3 A · 235 V 12.5 A · HB 325 V 8.7 A, 전이 T.T FB 62 · HB 125 ns(c.HB 3329 pF), dv/dt 2.5–3.8 V/ns(L6498 한계 50). LGE 게이트 회로(켜짐 47 Ω, 꺼짐 (D + 10 Ω) ∥ 47 Ω, 18 V, 드라이버 출력 저항 상한 10.7/9.7 Ω, 게이트 7.5 nF): τ_on 467 ns — 6.3 V 까지 201 ns, f_SU 펄스 끝에서 게이트 12.2–14.2 V(18 V 못 감); τ_off 168 ns — 플래토까지 121–148 ns(정상 운전 190 ns). 쓸 수 있는 데드타임 창(들어오는 게이트 6.3 V 가 전이 뒤 · 전류 역전 전): FB 13–365 ~ 78–430 ns, HB 75–365 ~ 140–430 ns — **IC 최대 420 ns 는 게이트 12 V 에서 창 상한 365 ns 를 넘는다**(V_th 기준이면 약 450 ns 라 경계); ADT 전 기동 데드타임은 DS 에 없다 → 측정. 최소 펄스 370 ns(ADT 전) ≤ 530–730 ns OK. 부트스트랩(C63/C72 100 nF · R113/R155 10 Ω · MURS160): 정상 상태 V_BS ≥ 14.8 V OK, **첫 LOUT1 펄스(370–600 ns)로는 0 → 5.3–7.7 V(τ 1 µs) — 첫 HS1 펄스가 L6498 UVLO 로 빠질 수 있다**(FB 재시작 그림 6 은 LOUT2 만 5 µs 미리 켜 Leg2 부트만 채운다) → R113/R155 를 2.2–3.3 Ω 로(τ 0.22–0.33 µs). 손실: 드라이버 0.45 W(f_SU) · 0.40 W(292 kHz) ≤ 1 W OK; **R115/R120/R157/R162 47 Ω(0603) 0.10 W(110 kHz) – 0.27 W(292 kHz) – 0.43 W(f_SU), R114 류 10 Ω 0.05–0.13 W — 보통 0603 정격 0.1 W 를 운전 중에도 넘는다**(품목 정격 확인; 1206 이상, 또는 VCC_GD 15 V · R_on 22 Ω); D17 류 1N4148WS 평균 15–48 mA · 피크 0.7 A(반복 피크 정격 확인). 가정: 게이트 = 7.5 nF 선형(ZVS, 드레인이 내려간 뒤의 기울기), 드라이버 출력 저항은 단락 전류 하한에서 낸 상한, MURS160 V_F 1.0 V; 하드 스위칭이면 밀러 전하가 더해진다. **⑥ 재계산 — `gate_budget.py`(2026-10-18 밤, 사용자: "527 kHz 가 데드타임 · 상승 · 하강 시간으로 감당되는지 계산이 없다, 게이트 저항은 전부 1206, 부트 저항을 낮추는 근거가 없다, 저항을 낮추면 드라이버가 타지 않나"; 켜짐 47 Ω 단독으로 정정한 뒤)**. 세 회로망을 같은 식으로: LGE 보드(18 V · 47 / (10+D)∥47 · 부트 10 Ω × 100 nF) · 시트 설계(14.35 V · 4.7 / (2.2+D)∥4.7 · ES1J × 470 nF) · 1206 제안(15 V · 22 / (4.7+D)∥22 · 부트 3.3 Ω × 100 nF). **타이밍 — 셋 다 527 kHz 를 감당한다**: 반주기 950 ns, 전류 역전 T/4 = 475 ns; 게이트 지연 LGE τ_on 467 ns(V_th 117 · 플래토 201 ns) · τ_off 168 ns, 제안 279 / 135 ns, 시트 149 / 118 ns; 530 ns 펄스 끝 게이트 12.2 / 12.8 / 13.9 V(10 V 정격 소자라 충분); 깨끗한 ZVS 의 IC 데드타임 창 LGE 95–363(FB) · 157–363(HB) ns, 제안 108–395 · 171–395, 시트 142–457 · 205–457 — **IC 최대 420 ns 가 LGE · 제안의 창 상한을 25–57 ns 넘지만 그 뒤 노드는 2차식으로 천천히 되돌아가(50 V 되돌아가는 데 FB 147 · HB 101 ns) 부분 하드 스위칭은 464–541 ns 부터, 완전 하드는 621–653 ns 부터**: 즉 ADT 범위의 데드타임은 전부 무해하고, 위험한 것은 ADT 전 기동 패턴이 데드타임을 460 ns 넘게 늘리는 경우뿐(DS 미기재 → 측정 · BU). 운전 중 필요한 데드타임 171–203 ns 는 ADT 40–420 안. 드라이버 자체 상승 · 하강은 제한이 아니다(출력 저항 상한 10.7 / 9.7 Ω 이 22 Ω 이상의 외부 저항에선 루프의 1/3 미만; 출력 전류 0.3–0.9 A 로 1.4 / 1.55 A 하한 안 — 자기 제한). **발열 — 저항을 낮추면 게이트 전력이 드라이버로 옮겨 간다**: 게이트 전력은 한 드라이버당 2 × C_g V² f 로 고정(18 V · 292 kHz 1.42 W, 15 V 0.99 W, 14.35 V 0.90 W)이고 드라이버 몫 = R_drv/(R_drv + R_G + R_g,int). 292 kHz(정격 라인 피크, 연속 최악)에서 드라이버 손실 · 접합 상승(R_th 120 K/W): LGE 0.41 W · +50 K, 시트 설계 0.53 W · +64 K(시트의 k.Pdrv 1.43 은 25 °C 정격 기준 — 세트 안 70 °C 면 T_j 134 °C 로 경계), 제안 0.41 W · +50 K; R_on 훑기(292 kHz): 18 V 에서 4.7 Ω 0.83 W(+100 K, 불가) · 22 Ω 0.59 W · 47 Ω 0.41 W, 15 V 에서 4.7 Ω 0.58 W · 22 Ω 0.41 W · 47 Ω 0.29 W. 1 ms 의 f_SU 버스트(0.46–0.92 W)는 1 mJ 미만이라 다이 온도에 무의미 — 기동이 아니라 연속 운전이 드라이버를 정한다. R_on 1206(0.25 W): 18 V · 47 Ω 0.27 W(107 %, 불가) · 22 Ω 0.21 W(84 %), 15 V · 22 Ω 0.146 W(58 %) · 47 Ω 0.186 W(74 %); 꺼짐 가지 10 Ω 0.10 W(1206 40 %), 다이오드 평균 27–31 mA · 피크 0.6–0.8 A. **부트스트랩 — 근거**: 스위칭 전에는 노드가 버스 중간쯤에 떠 있어 다이오드가 역바이어스라 C_boot 는 빈 채로 첫 LOUT 펄스(370–730 ns)에만 충전된다; LGE τ = 10 Ω × 100 nF = 1.0 µs 라 **5.3–8.8 V — DS 권장 최소 9.3 V 미달 → 첫 HOUT1 이 게이트 펄스를 못 만들 수 있다**(L6498 의 V_BS 기동 문턱값은 메모에 없음 — 확인; FB 재시작 그림 6 은 LOUT2 만 5 µs 미리 켠다); 3.3 Ω 이면 τ 0.33 µs → 9.4–12.5 V, 빈 C_boot 로의 피크 충전 전류 1.7 → 4.2 A(0.3 µs; MURS160 · ES1J 급 I_FSM 수십 A — DS 로 확인), 저항 없이 다이오드만이면 26 A 라 몇 Ω 은 둬야 한다; f_SU 정상 상태는 셋 다 문제없다(V_BS 최소 12.8–14.8 V). **결론**: 527 kHz 는 타이밍으로는 감당된다; 바꿀 것은 ① 구동 전압 15 V(18 V 는 모든 손실을 1.44배) ② R_on 22 Ω 1206(드라이버 +50 K · 저항 58 %) ③ 꺼짐 4.7 Ω + 1N4148W ∥ 22 Ω ④ 부트 저항 3.3 Ω(시험 A 에서 첫 HS1 펄스가 빠지면) ⑤ 시트 설계의 4.7 / 2.2 Ω 도 같은 이유로 22 / 4.7 로 올릴 것(켜짐 지연 49 → 87 ns, ZVS 영향 없음). 드라이버 소손 경로 중 평균 전력 · 피크 전류는 위와 같고, 남는 것은 노드 링잉이 OUT 핀에 주는 음전압(기동 캡처의 LS_VDS1 ±100 V 링잉) — 버스 디커플링(위 D)이 그 답이다. 가정: V_th 4 V · 주위 70 °C · 드라이버 출력 저항 상한(실제는 더 낮아 외부 저항 몫이 조금 더 크다). **⑦ 18 V 기준 재권고 · VCC 시퀀스 · 켈빈 PGND(2026-10-18 밤, 사용자가 L6498LD DocID030318 Rev 3 · STO60N045DM9 DS14711 Rev 4 를 줌 → `Datasheet/`)**. L6498 실값: t_on/t_off 85 typ · 120 max ns(둘이 같아 상쇄, MT 30 max 만 남음), t_r/t_f 25 ns @1 nF(7.5 nF 게이트에선 ≈ 190 ns — 출력 저항 ≈ 10 Ω, 위 상한과 일치), I_so 1.7/1.4 A · I_si 2.5/1.55 A(25 °C typ/전온도 min), VCC 권장 10–20 V(abs 21), VBO_thON 8.0/8.6/9.1 V · VBO_thOFF 7.5/8.0/8.5 V, 권장 V_BO ≥ 9.3 V, **VPS = PGND − SGND 권장 ±5 V · abs min VCC − 21 V(18 V 에서 −3 V)**, OUT 권장 −9 V dc · 480 V, f_sw 권장 최대 800 kHz @1 nF, T_j 권장 125 °C, R_th 120 K/W(SO-14). **18 V 권고 — 값은 그대로, 패키지만 1206**: R_on 47 Ω(0603 → 1206), R_off 10 Ω + 1N4148WS(1206), 부트 R113/R155 10 → 3.3 Ω. 근거: 라인 주기 시간평균 주파수(`l6790.sweep`, x3m3 정격)는 FB 코너 213 kHz · 230/264 Vac HB 143/151 kHz · 110 Vac FB 140 kHz 라 1206 0.25 W 의 47 Ω 은 평균 0.19/0.13 W(78/54 %), 라인 피크 292 kHz 순간 0.27 W(107 %)는 초 단위 열시정수에 묻힌다(0.5 W 급 1206 이면 여유); 드라이버는 상한 0.41 W(피크) · 0.30 W(평균) → +36–50 K, 70 °C 에서 106–120 °C(권장 125 안, 벤치 25 °C 61–75 °C) — R_on 을 22 Ω 로 내리면 0.54 W(+65 K), 4.7 Ω 0.83 W(+100 K)라 불가; 68 Ω 로 올리면 V_th 까지 157 ns · f_SU 창 120–297 ns 라 IC 420 ns 에서 HB 노드가 ≈ 75 V 되돌아가 기동 부분 하드 스위칭; R_off 22 Ω 은 드라이버 0.06 W 를 아끼지만 채널 핀치오프(V_gs 4.5 → 4 V) 20 → 26 ns 로 느려져 MOSFET 턴오프 중첩 손실이 더 는다(거칠게 0.5 → 0.8 W/소자 @292 kHz) → 10 Ω 유지. 부트 3.3 Ω 근거: 첫 LOUT 펄스(370–730 ns)로 10 Ω × 100 nF 는 5.3–8.8 V — **VBO_thON max 9.1 V 미만이라 첫 HVG 가 안 나올 수 있다**; 3.3 Ω 이면 9.4–12.5 V, 빈 C_boot 피크 (18 − 1)/3.3 = 5.2 A · 0.3 µs(MURS160 급 I_FSM 수십 A). **VCC 시퀀스(사용자 ①②)**: 보드는 VCC3(외부 18 V) → D18 1N4148WS → VCC_IC(C120 10 µF + C108 0.1 µF) = 17.3 V — L6790A VCCon 17 V(typ, DRAFT DS 에 min/max 없음)보다 0.3 V 위라 이 샘플에선 되지만 사양 여유는 없다; 드라이버 VCC_GD 는 Q39 'Shorted' 라 18 V 직결(L6498 권장 상한 20 V). 17 V 는 L6790A VCC 핀만의 요구이고 L6498 에는 없다 → 드라이버 레일만 15 V 로 나눌 수 있다(Q39 자리). 외부 15 V 를 D18 로 넣으면 핀 14.3 V 에서 HVSU 가 10.1 µF 를 17 V 까지 올려야 한다: 2.7 V × 10.1 µF /(9 − 3 mA) ≈ 4.5 ms(115 Vac 13 mA 면 2.7 ms) — **충전기가 켜져 있다면**. DS 는 충전기 켜짐을 'VCC 가 12 V(VCC_HVSUon) 아래로 떨어질 때'로만 적고, POR 뒤 첫 VCCon 까지 켜져 있는지는 안 적었다 → 사용자 ②의 우려는 성립 가능: 외부 소스가 VCC 를 12–17 V 에 붙들면 HVSU 가 17 V 까지 올려 주리란 보장이 DS 에 없다. 안전 구간은 둘: 핀 기준 **< 12 V**(다이오드 경유 프리바이어스, HVSU 가 정상 기동) 또는 **≥ 17.5 V**(외부가 VCCon 을 넘김 — 지금 방식; 18.5–20 V 외부면 여유, 단 드라이버 레일은 20 V 아래로 분리). 12–17 V 는 애매 구간. **확인 시험 하나**: 외부 15 V(D18 경유) 걸고 AC 투입 → VCC_IC 가 17 V 로 올라 기동하면 POR 부터 충전기 ON(15 V 외부 가능), 14.3 V 에 머물면 애매 구간 실재. 'VCC 가 AC 보다 먼저' 는 벤치 전용 제약이다: IC 와 드라이버가 다 외부 전원이라 AC 먼저면 HVSU 가 VCC_IC 만 17 V 로 올리고(D18 때문에 VCC3/VCC_GD 로는 못 감) 게이트 펄스 없이 120 ms 뒤 HVSU 차단 → UVLO 2 s 재시도 반복; 제품은 외부 VCC 가 없어 HVSU 0 → 17 V → 기동 → 보조 레귤레이터(12.85–14.35 V, 바이패스 다이오드)로 넘어가므로 시퀀스 문제가 없다. **켈빈 PGND(사용자 ④) — 맞는 연결**: STO60N045DM9 핀 2 'Driver source' · 3–8 'Power source'; 보드는 PGND_1/2 → Q28/Q34 핀 2 만, OUT → Q27/Q32 핀 2 만, R227–R230(핀 2 ↔ 3–8 연결) N.C. — 게이트 루프가 전원 소스 리드 · 션트 인덕턴스를 빠져나가고 V_GS 에 션트 전압(24 mΩ × 18 A = 0.43 V)과 L·di/dt 가 안 실린다; L6498 그림 6 의 'PGND → 하단 소스' 를 켈빈 소자에 적용한 것이다. 조건: VPS 권장 ±5 V · abs −3 V(18 V 기준) — PGND 는 션트(24 mΩ)로만 접지되므로 기동 때 PGND_1 − SGND 를 재 볼 것(음으로 3 V 넘으면 드라이버 abs max; 15 V 레일이면 −6 V); C68/C80 0.1 µF 는 VCC–PGND 사이에 핀 바로 옆(DS 의 C_VCC2 = LVG 루프 커패시터); R227–R230 은 계속 N.C.; 블리더는 불필요(DS 각주 1: VCC > 3 V 에서 LVG/HVG < 1 V 보증). **⑧ 시퀀스 · 래치 · 켈빈 루프(2026-10-18 밤, 사용자 "AC 먼저 넣고 VCC 넣으면 동작한 적이 없다 — 래치인가" · "15 V 면 HVSU 가 충전 전류를 안 흘리는데 시퀀스가 어떻게 되나" · "게이트 전류가 PGND 로 안 돌아가고 션트로 나가는 것 아니냐")**. ① **AC 먼저 → 래치가 맞다, 다만 원인은 'VCC 있고 AC 없음'이 아니라 'AC 있고 드라이버 전원 없음'**: DS 그림 4 는 AC(브라운인 이상)가 있는 채로 VCC 가 VCCon 에 닿는 순간 LOUT1 이 시작됨을 보여준다. AC 먼저면 HVSU 가 VCC_IC 만 17 V 로 올리고(D18 때문에 VCC3/VCC_GD 로는 못 감; 10.1 µF 라 AC 투입 뒤 13–19 ms), 드라이버가 꺼져 있어 **IC 자신의 스위칭 7 주기**(AC 주기가 아니다 — f_SU ≈ 500 kHz 면 첫 펄스 뒤 약 14 µs) 동안 ISEN · ZCD 신호가 없다 → **5.2.9 ISEN 단선 보호 → 래치**. 래치 상태에서는 HVSU 가 'latched condition 4.5 mA' 로 VCC 를 12–17 V 에 유지하므로 AC 가 있는 한 안 풀리고, 뒤에 18 V 를 넣어도 VCC 가 POR 아래로 안 가니 그대로다(DS 에 래치 해제 조건은 명시돼 있지 않다 — 통상 POR). 해제: AC 와 외부 VCC 를 모두 끊어 VCC_IC < 7 V(VCC_PORoff). 'VCC 먼저 + AC 없음'은 래치가 아니라 브라운아웃 대기(5.2.2: 브라운인 되면 HVSU 재충전 + 세이프 스타트) — 벤치 경험과 일치. 제품(외부 VCC 없음)은 드라이버가 같은 VCC 에 있어 생길 수 없다. 벤치 대책: 시퀀스 유지, 또는 외부 18 V 를 AC 와 연동(릴레이 · 시퀀서). ② **15 V 시퀀스**(정정 — 처음엔 '12/17 V 히스테리시스'라고 잘못 읽었다, 사용자 지적): 그림 4(400 dpi 로 다시 봄)의 120 ms 구간 톱니는 **VCCon 과 그 조금 아래(VCC_HVSUon 까지 가지 않는, 이름 없는 레벨) 사이**다 — 기동 중에는 HVSU 가 VCC 를 17 V 근처에 얕은 히스테리시스로 붙들고, 120 ms(THVSU_OUT) 뒤 발전기를 끈다; 그때 보조가 없으면(점선) VCC 가 **VCC_HVSUon 12 V 까지 내려가 거기서 유지**된다(4.5 mA 'restart after timeout' 모드). 즉 12 V 는 120 ms 뒤의 재가동 문턱이지 기동 중 하한이 아니다. 0 → 17 V 의 첫 충전은 한 번에 연속이다(V_VCC_SO 1 V 아래에선 작은 전류). 외부 15 V(핀 14.3 V)의 질문은 이렇게 된다: 0 → 14.3 V 로 올라온 IC 는 '첫 VCCon 이전' 상태이고 120 ms 타이머도 돈 적이 없으므로 충전기가 꺼질 사건이 없었다 → AC 가 오면 9–13 mA 로 14.3 → 17 V(4.5/2.7 ms) → VCCon → 기동 → 120 ms 뒤 발전기 OFF → VCC_IC 는 I_CC 로 17 → 14.3 V 내려와 D18 이 받치고(VCCoff 8 V 위, 12 V 재가동 안 됨) → 15 V 외부로 운전. '첫 VCCon 이전엔 충전기가 켜져 있다'는 그림의 첫 램프에서 읽은 것이고 상태기계는 DS 에 없다(HV 가 있을 때 VCC < 12 V 였어야 켜지는 구현이면 실패) → 시험 하나(외부 15 V + AC 투입 → VCC_IC 17 V 도달 여부). 안 되면 핀 기준 ≥ 17.5 V 외부(드라이버 레일은 분리) 또는 < 12 V 프리바이어스. ③ **켈빈 루프 — 보드가 이미 맞다**(정정: 처음엔 C65 도 SGND 로 잘못 읽고 '켈빈 무효'라 썼다 — 사용자 지적, 1400 dpi 로 다시 봄): **C65 10 µF(U10 은 C78)는 VCC–PGND_1(켈빈)**, C68 0.1 µF(C80)는 VCC–VCC_GND(SGND)다 — L6498 DS 그림 6 의 C_VCC2(VCC–PGND) · C_VCC1(VCC–SGND) 과 같은 구성. 하단 게이트 펄스는 C65 → VCC → LVG → R_G → 게이트 → 켈빈 핀 2 → PGND_1 → C65 로 국소 순환하고, 션트에는 평균 전류(Q_g·f ≈ 40 mA/소자 → 24 mΩ 에 1 mV)만 흐른다 — 게이트 전류가 션트로 나간다는 걱정은 평균분에만 해당하고 무시할 크기다. PGND 를 VCC_GND 에 직접 이으면 안 된다(켈빈 본딩 + PGND 배선이 션트와 병렬 → 주전류 일부가 켈빈 핀으로, ISEN 왜곡). 남는 메모 둘: 10 µF 3216 MLCC 는 18 V 바이어스에서 용량이 반쯤으로 줄어도 0.1 µC 펄스엔 충분하지만 핀 7–5 에 0.1 µF 하나 더 두면 ESL 면에서 낫다(필수 아님); HS 쪽은 C63/C72 100 nF 가 BOOT–OUT(= Q27/Q32 켈빈)이라 같은 국소 루프다.

**⑨ RT 로 붙들고, 풀릴 때 로드 스위치로 VCC_GD 를 켜는 기동(2026-10-18 밤, 사용자 질문)** — DS: 디스에이블 문턱 RT 0.5 V · DRV_EN 1.5 V(히스테리시스 100 mV), 2 ms 마다 15 µs 샘플링, 해제 뒤 세이프 스타트; DRV_EN 은 출력(V_OH 4 V · 500 Ω)이기도 하며 **스위칭 50 µs 전(T_DRV_EN_early, typ 만 있음)** 에 High. 반대 근거는 시간 하나다: 첫 펄스는 RT 해제 뒤 빠르면 약 65 µs(샘플이 바로 걸릴 때), 늦어도 2.05 ms 에 나오는데, 지금 부품(Q39 KTN2907 PNP, R223 10 k → I_B 1.7 mA → I_C 0.2–0.5 A)으로 드라이버 레일 ≈ 22 µF(C96 2.2 + C65/C78 10 + 10 + 0.1 ×3)를 17 V 까지 채우는 데 **0.7–1.3 ms** 가 걸린다 → 절반쯤의 기동에서 첫 펄스가 빈 드라이버로 나가 ISEN 단선 래치. 근본적 불가가 아니라 속도 문제이고 해법은 둘: **(B, 권장) 두 단계 제어** — 외부 신호 하나가 로드 스위치를 바로 켜고 RT 풀다운 트랜지스터는 ≥ 5 ms 뒤에 놓는다(지연 RC 는 그 트랜지스터의 게이트에, RT 핀에는 커패시터 금지). 지금 PNP 그대로 되고, 버스트 모드(BM 접지라 지금은 비활성)와도 무관. **(A) DRV_EN 구동 고속 스위치** — Q39 를 P-MOSFET(30 V · 수십 mΩ)로, 직렬 1–2.2 Ω, 드라이버 레일 용량을 ≤ 4–5 µF 로(C65/C78 10 → 1 µF: 펄스당 0.135 µC 라 0.14 V 처짐이면 충분), VCC3 쪽에 47–100 µF 벌크 → τ ≈ 10 µs, 17 V 까지 ≈ 25 µs < 50 µs; C104 는 DRV_EN 경로에서 제거; 스코프로 DRV_EN ↑ → VCC_GD ≥ 16 V 가 40 µs 안인지 확인(T_DRV_EN_early 는 typ 뿐). 이 방식은 ST 가 'idle 모드 전력 절감'으로 의도한 쓰임이지만 버스트마다 레일을 다시 채운다. 어느 쪽이든 AC 먼저/VCC 먼저 순서는 무관해진다(디스에이블 중엔 펄스가 없어 래치가 안 생김).

**⑩ AC 먼저 → 수백 ms 뒤 VCC3 → 외부 EN 이 RT 를 놓는 시퀀스(2026-10-18 밤, 사용자)** — 이 순서는 성립한다: 드라이버 전원(VCC3)이 RT 해제보다 먼저 있으므로 첫 펄스가 빈 드라이버로 나가지 않는다. AC 투입 → HVSU 가 VCC_IC 를 17 V 로 → RT 가 0.5 V 아래라 디스에이블(§5.1.6: 스위칭 정지, HVSU 는 줄인 전류로 IC 유지, I_DIS 800 µA) → VCC3 18 V 가 들어와 D18 경유 17.3 V 로 VCC_IC 를 넘겨받고 VCC_GD 를 채움 → EN 이 RT 를 놓으면 다음 2 ms 샘플에서 세이프 스타트. **확인할 것 하나(DS 미기재)**: AC 로 VCC 가 처음 VCCon 에 닿을 때 IC 가 펄스보다 RT 를 먼저 보는가 — 그림 4 는 VCCon 에서 바로 LOUT1 을 그리고, 디스에이블 확인은 '2 ms 마다 15 µs' 로만 적혀 있다. 첫 펄스가 먼저 나오면 드라이버가 꺼져 있어 7 스위칭 주기 뒤 ISEN 래치. 시험: RT 를 GND 로 잡고 VCC3 없이 AC 만 → IC 핀 LOUT1/HOUT1 을 단일 트리거로 — 펄스가 하나도 없어야 한다; 그 뒤 VCC3 → EN 해제로 기동되는지. 펄스가 보이면 BU 확인, 그때는 DRV_EN 도 같이 Low 로(같은 샘플 규칙이라 같은 결과일 가능성 높음) 또는 VCC3 먼저로 되돌린다. 회로: RT 핀 노드(R210 0 Ω 앞, IC 쪽)를 N-MOSFET(2N7002 급, C_oss 수 pF)으로 VCC_GND 에 — 핀에 커패시터 · RC 금지, 게이트 쪽에 RC 는 가능; EN 이 2차/시스템 쪽 신호면 옵토로 넘긴다(RT 는 VCC_GND 기준); EN 해제 전에 VCC_GD ≥ 16 V 를 보장(VCC3 투입 뒤 ≥ 5 ms). 남는 위험은 기존과 같다: 해제 시점의 라인 위상에서 HB 세이프 스타트(230 Vac) · 첫 LOUT 부트 충전(부트 3.3 Ω).

**조치 목록(2026-10-18 밤 정리 — 위 ⑤–⑧의 결론만)**. 벤치 보드: ① 시퀀스는 VCC(18 V) 먼저 → AC; AC 를 먼저 넣었으면 둘 다 끄고 VCC_IC < 7 V 뒤 재시도(§5.2.9 래치 — L6790A 의 HOUT/LOUT 는 VCC_IC 로 나오지만 L6498 의 VCC 핀은 VCC3 라 D18 때문에 비어 있어 게이트 펄스가 없다) ② 게이트 저항 값 유지(47 / 10 Ω + 1N4148WS), 0603 → 1206(0.5 W 급이면 여유); 부트 R113/R155 10 → 3.3 Ω ③ 입력 660 nF 중 220 nF × 2 를 레그 옆으로(230 V 기동 파손 처방) ④ C_r X7R → C0G(2S × 3P 70.5 nF; 패드가 달라 보드 개정 때, 벤치는 한 열이라도) ⑤ PGND · 켈빈 · C65/C78 은 손대지 않는다 ⑥ 측정 A(IC 핀 HOUT1 · LOUT1 · HOUT2 · LOUT2 + 노드 1 + 탱크 전류, AC 투입 트리거 50 ms — 기동 비대칭이 IC 로직인지, 첫 HS1 펄스가 나오는지) · B(V_out 5 / 20 V 프리차지) · C(디커플링 뒤 180 → 220 Vac HB 기동 계단) ⑦ BU 질의: ZCD 문턱 아래 탈자화 감지 패턴과 데드타임 연장 한도 · 래치 해제 조건 · HVSU 충전기가 12–17 V 프리바이어스에서 켜지는지 ⑧ 선택: 외부 15 V(D18 경유) + AC 시험 → VCC_IC 17 V 도달하면 드라이버 레일 15 V 로(손실 0.69 배). 670 W 설계: 시트 14c.1 의 R_G 4.7 / 2.2 → 22 / 4.7 Ω(사용자 확인 뒤 빌더 수정) · 레그 디커플링을 회로도에 · 레그 교체 시 보조권선 7 ↔ 8 동반 · 요구사양서는 현재 판으로 발송. 하지 말 것: PGND–VCC_GND 직결 · 18 V 에서 R_G 4.7 Ω · 노드 RC 스너버 · 외부 VCC 12–17 V 구간(시험 전).

## 두 번째 권선(저주파) 설계안 — 변형 `7p5to1_x3lf` (2026-10-16)

사용자: 지금 트랜스포머로는 670 W 를 못 돌리고(벤더 와이어가 설계 요구 전류의 절반, 코어가 141 mT · 194.5 kHz), 200 W 효율이 110 Vac 84 % · 230 Vac 87 % 뿐이다. 본사 EVK(EVAL 240W-60V, ITACOIL OP2207034 · `L6790_Tec_MKT_18_06_26`)를 참고해 **같은 3코어 구조로 주파수를 내려** 다시 감는다. 수치는 전부 `build_l6790_smath.py` 의 변형 `7p5to1_x3lf`(`L6790_VARIANT=7p5to1_x3lf`) → `Smath/variants/L6790A_7p5to1_x3lf.sm` 에서 읽는다(빌더 대조 mismatches 0 · `check_sm` OK · **판정 71/75**, 미달은 정본과 같은 셋(k.Ploss · k.auxr · k.lam)과 k.CVCC 0.997).

**EVK 에서 읽은 것**(슬라이드 이미지에서 읽음 — 저해상도라 C_r 은 추정): 240 W / 60 V / 4 A. 트랜스포머 L_pri(개방) 225 µH · 누설 52.2 µH(Sec1 또는 Sec2 단락) → L_m ≈ 173 µH · **λ ≈ 0.30** · 권선비 Sec1:Pri:Sec2:AuxS:AuxP = 1:2.9:1:0.4:0.4 → n·V_out = 174 V(우리 169 V 와 같은 급). 회로도의 C13 · C14 33 nF 가 공진 캡이면 C_r 66 nF → **f_r ≈ 86 kHz · f_o ≈ 41 kHz · Z_0 ≈ 28 Ω · Q(240 W) ≈ 0.27**. 실측 파형: 라인 피크 93 kHz(공진 바로 위) · π/4 71 kHz · 영점 근처 47.2 kHz(f_Min/f_o ≈ 1.1) — 115 FB 와 230 HB 가 같은 주파수. R_CS 180‖180‖220 mΩ = 63.9 mΩ → **P_in,max 263 W = 1.1 × P_in**(우리 200 W 보드의 24 mΩ 은 700 W). C_in 820 nF(3.4 nF/W). ZCD 240k/22k 에 aux/sec 0.4 → **ZCD 평탄부 ≈ 2.0 V**(우리 360 k 선택과 같다). R_T 28.7k · C_T 470p · R_BM 30k. 출력 6 × 680 µF/80 V. 결과: 효율 **94.4 %(115 V) · 96.4 %(230 V)** — 230 V 가 2 % 좋은 것은 EVK 도 같다 · PF 0.98/0.95 · THD 1.75/3 % · BM 진입 56 W · 무부하 < 180 mW.

**84–87 % 의 추정 내역(200 W, 벤치 탱크)**: 철손 ~11 W(3코어 × 6.7 cm³, 141 mT · 194.5 kHz, N87 급 Steinmetz 가정 ±50 % — **열화상으로 코어 온도를 먼저 볼 것**) · 자화 전류 8.6 A pk 의 전도 ~3.4 W · 브리지 110 V 3.6 W(230 V 1.8 W) · R_CS 0.6 · SR·게이트·필터 ~2 W → 약 21 W = 10.5 % → 89.5 %. 실측과의 차 3–5 % 는 미해명(골짜기 하드 스위칭 · 권선 AC 저항). 주파수를 내리고 턴을 늘리면 철손이 11 → 4.6 W 로 간다(아래).

| 항목 | 첫 권선(설계 / 실물) | **두 번째 권선 `7p5to1_x3lf`** |
| :-- | :-- | :-- |
| 유닛당 권선 N_p : N_s+N_s | 5 : 2+2 | **10 : 4+4** (n_T 7.5 그대로) |
| C_r / L_r / L_m | 100 nF / 11 / 20 µH (실물 117.5 / 5.7 / 25.2) | **150 nF / 18 / 33 µH**(λ 0.545 · Q_pk 0.80 · Z_0 11.0 Ω) |
| f_r / f_o | 151.8 / 90.4 (실물 194.5 / 83.5) | **96.9 / 57.5 kHz** |
| R_T · C_T → f_Min / f_Max / f_SU | 11 k · 470 p → 92 / 320 / 503 | **16.5 k · 470 p → 62.5 / 296.5 / 485 kHz**(k.RTd 1.088 · k.floor 1.085) |
| B_pk/유닛 (A_e 114) | 182 (실물 141) mT | **141.5 mT** |
| 철손 추정(3코어, ±50 %) | 15 (실물 11) W | **4.6 W** |
| 유닛당 개방 L (벤더 측정값) · A_L | 10.33 µH · 413 nH | **17.0 µH ±10 % · 170 nH** |
| 유닛당 누설(2차 둘 다 단락) | 3.67 µH (실물 1.9) | **6.0 µH** — 같은 동심 구조면 1.9 × (10/5)² = 7.6 µH 가 나올 것; **실측 뒤 C_r 재선정**(L_r 22 µH 면 120 nF, f_r 98 kHz) |
| I_Lm,pk / I_trafo,pk / **합성 피크 I_Lr,pk** | 12.4 / 16.4 / 18.3 A | **11.8 / 16.5 / 18.2 A**(단순 합 28.3) |
| 1차 rms 라인피크 / 라인주기 | 13.76 / 10.9 A | **13.6 / 10.7 A** → Litz ≥ 2.4 mm² @4.5 A/mm² |
| 2차 반권선 rms, 유닛당 | 9.4 A | **9.5 A** → ≥ 2.1 mm² |
| OCP1 (R_CS 24 mΩ) | 22.9 A · k 1.25 | 22.9 A · **k.OCP 1.258** |

**창 적합성 — 미확정(벤더 보빈 창 면적 필요)**: 유닛당 구리 10 × 2.4 + 8 × 2.1 ≈ 40 mm², Litz 외경 기준 약 80 mm² + aux · 테이프 → 95–100 mm². 코어 도면(A 42 · D 36 · E 6 · F 4.85)에서 창은 변 15 × 9.7 mm ≈ 145 mm² 총, 보빈 빼면 ~110 mm² 로 추정 → **4.5 A/mm² 에서는 85–90 % 채움이라 들어가지 않을 가능성이 크다.** 6 A/mm² 면 30 mm²(~65 %, 열 실측 조건). 안 들어가면 같은 높이의 한 단계 큰 플랫 코어. 더 낮은 f_r(75 kHz, PQ50 탱크 180/25/45 를 15 : 6+6 으로, B 122 mT, 철손 ~2.3 W)은 구리 60 mm² 라 큰 코어에서만 가능.

**"2차 2 T(또는 1 T) 유지 + 인덕턴스만 키워 주파수를 내리기" 검토(2026-10-16, 사용자 요청 — 얇고 넓은 LG형 코어라 4 T 가 어렵다)** — 스크래치 `x3/scan3.py`(l6790 모델). 결론 **불가**, 이유 셋. ① 자속 B = V_out/(4·f_r·N_s·A_e): N_s 2 · A_e 114 에서 141 mT(194.5 kHz) → 183(150) → 274 mT(100 kHz); N_s·A_e 고정이면 철손 ∝ f^−1.2 라 주파수를 내릴수록 늘어난다(56 nF/25/50 의 f_r 134 kHz: 204 mT · 17.5 W 대 11.3 W). 100 kHz 로 가려면 A_e ≥ 223 mm²/유닛(75 kHz 는 298). ② 스위칭 관련 손실(게이트 + 턴오프 추정)은 1.4–1.9 W 로 200 W 손실 36 W 의 5 % — 반으로 줄여도 1 W. ③ 자화 피크 I_m = (π/2)·λ·n·V_out/Z_0 — **f_r 과 무관**하고 Z_0 는 657 W 부하가 정한다(Q_pk ≈ 0.8 → Z_0 11–13 Ω; Z_0 16/18/30 Ω 은 90 Vac 에서 라인 각의 50/42/22 % 만 공급 가능 — 불가). 그래서 657 W 탱크는 어느 주파수든 I_m ≈ 10 A 이고, 200 W 시험 효율이 낮은 것은 그 탱크를 30 % 부하로 돌리는 데 따른 고정 손실(철손 11 + 순환 전도 7 W)이다. **N_s 1 은 7.5:1 × 3유닛과 양립 불가**(N_p 2.5), 자속 2배(f_r ≥ 390 kHz), 72차 ELP 8:1 탐색도 해 없음. **얇은 코어 · 5:2+2 로 할 수 있는 것 = 원 설계점을 자속에 맞춰 재배치(M3)**: C_r **68 nF 필름** · L_r 10 · L_m 20 µH(λ 0.5 · Z_0 12.1 · Q_pk 0.86) · f_r 193 · f_o 111 kHz · R_T 8.3 k · C_T 470 p → f_Min 120 · f_Max 341 kHz · B 142 mT · A_L 400 nH/유닛(지금 412 — 갭 거의 그대로) · **누설 3.3 µH/유닛 필요**(원 사양 3.67, 납품 1.9 — 칸막이/나란히 감기 또는 외부 5 µH) · I_m 9.9 · 합성 피크 18.6 · I_pri,rms 9.9 A · 유닛당 구리 ≈ 19 mm²(지금 와이어의 2배, 10:4+4 의 절반이라 창에 들어감) · 657 W 손실 추정 철손 11.4 + 1차 전도 15.7 + 게이트/턴오프 1.8 W. PF 창 · ZVS 여유 · 기동 전류(Z_0 7 → 12)는 고쳐지지만 **효율은 10:4+4(철손 4.6 W)보다 657 W 에서 약 1 %, 200 W 에서 약 3 % 낮다** — 효율을 올리려면 A_e(넓은 다리의 플랫 코어) 또는 저손실 재질뿐.

**"코어를 키우면?"(2026-10-16)** — 5:2+2 · 3유닛 유지, 철손 = 3 × V_e × P_v(f, B), B = V_out/(4·f_r·2·A_e), N87 급 ±50 %: | 코어 | 193 kHz | 150 | 120 | 100 | 75 | — EE42×36×19(114 mm², 6.7 cm³) 142 mT 11.4 W / 183 15.4 / 228 20.1 / 274 25.0 / 365 35.3 W · **A_e 225 급(13.9 cm³, ELP 43/10/28 류) 72 mT 4.3 W / 93 5.8 / 116 7.6 / 139 9.5 / 185 13.4 W** · A_e 308 급(24.8 cm³, E 58/11/38 류) 53 mT 3.5 / 68 4.7 / 85 6.2 / 101 7.7 / 135 10.9 W. 큰 코어는 주파수를 내릴 수 **있게** 하지만, 그 크기를 주파수 내리는 데 쓰면 부피가 같이 늘어 철손이 거의 안 준다(225 급 · 100 kHz 9.5 W ≈ 지금 11.4 W); **같은 ~190 kHz 에서 B 를 내리는 데 쓰면 11.4 → 4.3 W**(10:4+4 의 4.6 W 와 같음). 스위칭 관련 손실은 턴오프 속도에 따라 1–4 W(R_G,off 10 Ω 이면 위쪽) — 주파수 반감으로 1–2 W, 턴오프 경로(정본 84차 D_G,off)로도 줄일 수 있다. 자화 전류는 f_r 무관. → **권장: 큰 플랫 코어(A_e ≥ 220 mm²/유닛, 창 총면적 ≥ ~90 mm², 같은 높이급) + 5:2+2 + M3 탱크(68 nF 필름 / 10 / 20 µH, f_r 193) + 저손실 재질.** 주파수를 내리는 건 코어를 그 이상 키울 때만 뜻이 있다.

**"670 W 로 올라가면 스위칭 손실도 커지니 주파수를 내리는 게 이득?"(2026-10-16)** — 아니다. 손실 예산을 다시 세웠다(스크래치 계산. 가정: 1차 STO60N045DM9 자리마다 1개, 45 mΩ × k_T 1.5(정본 1.9 면 +27 %) · R_CS 24 mΩ · 브릿지 V_F 0.9 V + 10 mΩ · EMI 필터 + 배선 0.10 Ω · SR STL160N10F8 레그당 2병렬 3.2 mΩ × 1.5 · 게이트 122 nC × 14.3 V, SR 81.6 nC × 11.2 V · 레그 커패시턴스 2.5 nF(2.2 nF 스너버 + C_oss + 150 pF) · 바디 다이오드 1 V × 140 ns · 제어 · 드라이버 정지 1.2 W · 권선 3.5 W · 34 mF 뱅크 ESR 2 W — 권선 · 뱅크 · 철손은 ±50 % 짐작. 턴오프 에너지는 채널 전류가 t_f 동안 직선으로 꺼지고 레그 커패시턴스가 나머지를 받는 수치 모델(V_bus 클램프), t_f 20 / 50 / 100 ns 세 경우. 전류 · 평균 f_sw 는 `l6790.sweep` 의 라인주기 값):
① **스위칭 손실은 부하를 따라 커지지 않는다.** 공진 아래에서 끄는 전류는 자화 전류 피크 n·V_out/(4·f_r·L_m)(지금 8.6 A · M3 9.9 A · 97 kHz 안 11.8 A)이고 부하 전류가 안 들어간다. 지금 탱크로 200 → 657.5 W(110 V)에서 커지는 것은 MOSFET 도통 5.5 → 11.9 W(200 W 의 1차 rms 6.4 A 가 이미 순환 전류다) · R_CS 1.0 → 2.1 · SR 0.4 → 4.2 · **브릿지 + 필터 3.6 → 15.3 W** 이고, 게이트 + SR 게이트 + 바디 2.0 → 1.9 W, 턴오프 0.2 / 1.6 / 6.2 → 0.2 / 1.5 / 6.1 W 로 그대로다(평균 f_sw 124 → 122 kHz).
② **주파수 반감의 이득은 1.3–4.1 W(0.2–0.6 %)다.** 657.5 W · 110 V 의 스위칭 관련 합(게이트 + SR 게이트 + 바디 + 턴오프): M3(f_r 193, 평균 154 kHz) 3.0 / 5.1 / 12.7 W, 97 kHz 탱크(평균 79 kHz) 1.7 / 3.2 / 8.6 W. 그런데 2 T 2차로 97 kHz 를 받으려면 A_e 225 급이어야 하고 그 코어의 철손은 97 kHz 에서 9.5 W, 193 kHz 에서 4.3 W — 차이 5.2 W 가 스위칭 이득을 먹는다. 합계(110 V, t_f 20 / 50 / 100 ns): **M3 + 225 코어 45.2 / 47.3 / 54.9 W(93.6 / 93.3 / 92.3 %)** · 97 kHz 탱크 + 225 코어 51.4 / 52.9 / 58.3 W(92.8 / 92.5 / 91.9 %) · 10:4+4 EE42 46.5 / 48.0 / 53.4 W(93.4 / 93.2 / 92.5 %) · 지금 탱크 그대로 53.7 / 54.9 / 59.5 W. 230 V(HB, 스위칭 소자 2개): 34.1 / 35.2 / 39.1 W(95.1 / 94.9 / 94.4 %) · 40.8 / 41.6 / 44.4 · 35.9 / 36.7 / 39.5 W.
③ **턴오프 손실이 실제로 크다면 고칠 것은 주파수가 아니라 턴오프 경로다.** t_f 100 ns 급이면 193 kHz 에서 10 W 인데 반감은 10 → 7 W, D_G,off + 낮은 R_G,off(정본 84차)로 t_f 20 ns 급이면 10 → 0.4 W. **HOUT/LOUT(V_GS) · V_DS · 탱크 전류를 20 ns/div 로 같이 찍어 t_f 를 읽는 것이 먼저다** — 이 보드의 t_f 는 모른다.
④ **90 % 중반**: 657.5 W 에서 94 / 95 / 96 % 는 손실 42.0 / 34.6 / 27.4 W. 230 V 는 큰 플랫 코어(철손 4–5 W)면 어느 탱크로도 94.5–95 %. **110 V 는 이 모델로 ~93 %** — 브릿지 11.2 + 필터 4.1 W(2.3 %)와 MOSFET 10.7 + R_CS 1.9 W(1.9 %)가 바닥이다. 94 % 로 올리려면 1차 MOSFET 자리마다 2병렬(도통 −5.4, 게이트 +1.1 W) · 저 DCR 필터(−1~2 W) · SR 레그당 3개(−1.1 W); 95 % 는 브릿지 11 W 를 손대지 않고는 안 나온다. ST 의 "95 % @115 Vac"(L6790_Tec_MKT p.13)는 EVL6790-240W(60 V / 4 A — 2차 전류 1/6.6, 라인 전류 1/2.7) 수치라 657 W / 25 V 의 기준이 못 된다.
⑤ **200 W 실측 84 / 87 %(손실 38.1 / 29.9 W)** 를 같은 모델로 보면 110 V 30.6 / 31.9 / 36.6 W, 230 V 27.6 / 28.3 / 30.7 W. 제일 큰 한 덩어리가 **철손 11.3 W(손실의 1/3)** 이고 부하가 올라가도 그대로다(657 W 에서는 1.7 %). 230 V 가 좋은 큰 이유는 라인 전류가 반이라 브릿지 + 필터 3.6 → 1.6 W 인 것이지 스위칭(게이트 · 바디 −0.9 W, 턴오프 −0.1~−3 W)이 아니다.
⑥ **모델에 없는 것 — X7R C_r 의 유전 손실.** C_r 의 무효전력 I²/(ωC) 는 200 W 에서 약 470 var(6.4 A · 74 V rms)이고 손실 = 무효전력 × DF. X7R 의 DF 는 DS 에 1 kHz 2.5 % 이하만 있고 150–250 kHz · 60 V rms 에서의 값은 모른다 — 1–2.5 % 면 **4–11 W**, 한 개당 0.4–0.9 W(Würth 885342208026 · 1206, 2S × 5P — 아래 2026-10-18 문단). 필름(PP, DF 0.05 % 이하)이면 0.2 W. 657 W M3 탱크(68 nF, 135 V rms)는 무효전력 1200 var 라 X7R 이면 12–30 W 가 되어 애초에 안 되고, 필름이면 0.4–0.6 W. **200 W 10분 뒤 C_r 온도(손 · 열화상)가 바로 답한다.** 필름 교체 시험은 C_r,eff −40 %(230 V) 가설과 이것을 한 번에 가른다. X2 급 필름을 쓸 때는 V_rms–주파수 허용 곡선을 봐야 한다 — X2 는 50/60 Hz 용이라 100 kHz 대의 허용 V_rms 가 정격보다 훨씬 낮은 품종이 많다. 공진용(펄스 · dV/dt 정격)의 PP 가 맞다.
⑦ **"지금 85 % 인데 어떻게 93 % 가 되나"(같은 날)** — 손실을 부하 무관(철손 11.3 · 순환 전류 도통 4.0 · 정지 1.2 · 게이트 + 바디 1.9 · 턴오프 0.2–6.1 W = 18.6–24.6 W)과 부하 비례(MOSFET + R_CS 의 부하 성분 · 브릿지 · 필터 · SR · 권선 · C_out)로 나누면, 110 V 에서 부하 비례분이 200 W 7.6 W → 657.5 W 35.1 W 로 4.6배가 되는 동안 부하 무관분은 그대로다. 200 W 는 1차 rms 6.4 A 중 자화 성분이 5.0 A 인 가벼운 부하다. 모델 합계: 200 W 26.2–32.1 W(86–88 %) · 657.5 W 53.7–59.5 W(91.7–92.5 %); 230 V 23.2–26.3 W(88–90 %) · 42.3–45.4 W(93.5–94.0 %). **실측 38.1 / 29.9 W 와의 차이 6–12 / 3.6–6.7 W 는 설명되지 않는다.** 그 성격에 따라 지금 보드 그대로 657.5 W 의 예측이 갈린다: 부하 무관형(N87 급보다 나쁜 코어 재질 등)이면 110 V 60–72 W(90.1–91.6 %) · 230 V 46–52 W(92.7–93.5 %), 전류 제곱형(X7R 유전 손실 · 가는 권선 — 1차 rms 6.4 → 9.4 A 라 ×2.2)이면 110 V 67–86 W(88.4–90.7 %) · 230 V 50–59 W(91.7–93.0 %). 85 → 93–95 % 중 약 5 %p 는 부하가 커져 고정 손실이 희석되는 몫이고(보드를 안 바꿔도 생긴다), 설계 변경(큰 코어 −7 W · 필름 C_r · 빠른 턴오프)의 모델상 몫은 약 1 %p(110 V 53.7–59.5 → 45.2–54.9 W · 230 V 42.3–45.4 → 34.1–39.1 W)다. **④ 의 93 / 95 % 는 이 6–12 W 의 출처를 찾아 없앤다는 조건부 숫자다** — 손실 배분 측정(온도 · 턴오프 파형 · 필름 교체)이 설계 변경보다 먼저인 이유.
⑧ **"본사 240 W 보드는 왜 효율이 좋은가"(같은 날)** — EVK 예비 측정(SR 보드, "optimizations on going"): 115 V 25 / 50 / 75 / 100 % 부하 92.5 / 94.3 / 94.4 / 94.3 %, 230 V 93.1 / 96.3 / 96.4 / 96.3 % → 풀로드 손실 14.5 / 9.2 W, 25 % 부하(60 W) 4.9 / 4.4 W. 같은 모델을 EVK 에 적용(ITACOIL 225 / 52.2 µH → λ 0.302 · n_eff 2.54 · C_r 66 nF → f_r 85.7 · f_o 41.3 kHz · Z_0 28.1 Ω · I_m 2.57 A pk; MOS-HB 보드 STL38N60DM6 91 mΩ × 1.5, R_G 1 Ω(150 Ω 자리 미실장) + 레그 2.2 nF; R_CS 63.9 mΩ; GBJ1506U; CM 초크 17 + 33 mH, DCR 은 자료에 없어 0.25 Ω 가정; SR TEA2095 레그당 2개, 15 mΩ 가정; 게이트 60 nC × 12 V 가정): 115 V 풀로드 1차 rms 2.86 A(순환 1.46 A rms) · 평균 f_sw 66 kHz · MOSFET 2.23 W(순환분 0.72) · R_CS 0.52 · 브릿지 3.60 · 필터 1.22 · SR 0.24 · 게이트 + 바디 + 턴오프 0.37 · 정지 1.0 = 9.2 W → **실측 14.5 W 와의 차 5.3 W 가 철손 + 권선 + 나머지**; 25 % 부하에서는 그 차가 1.5–1.7 W 라 **철손은 2 W 아래(≤ 0.7 %)**. 출력 기준 비율(EVK 115 V 풀로드 / 우리 지금 200 W 110 V 실측 / 우리 새 설계 657.5 W 110 V 모델): 브릿지 + 필터 2.0 / 1.8 / 2.3 % · 1차 MOSFET + R_CS 1.15 / 3.3 / 1.9 %(그중 순환 전류 0.3 / 2.0 / 0.8 %) · 2차(SR + 권선 + C_out) ~0.15 / 0.4 / 1.1 % · 철손 ≤ 0.7 / 5.7 / 0.65 % · 게이트 + 바디 + 정지 0.55 / 1.6 / 0.6 % · 턴오프 ~0 / 0.1–3.1 / 0.06–1.5 % · 미해명 (철손 포함 2.2) / 3–6 / — → 합계 6.0 / 19 / 6.9–8.4 %. **차이의 뿌리는 넷**: ⓐ 60 V / 4 A 출력 — 2차 전류가 1/6.6 이라 2차 I²R 이 1/43, 우리는 2병렬 SR · 굵은 Litz 로 눌러도 1.1 %; ⓑ 전력 2.7배 — 같은 비율을 지키려면 R_DS · R_CS · 필터 DCR 도 1/2.7 이어야 하는데 우리 45 / 24 mΩ 은 그들 91 / 64 mΩ 의 1/2 · 1/2.7 뿐(MOSFET 1.6 vs 0.9 %); ⓒ 순환 전류 — I_m 2.57 A 는 부하 피크 4.95 A 의 0.52배(λ 0.30 · Z_0 28 Ω), 우리는 8.6–9.9 A 로 12.2 A 의 0.7–0.8배이고 200 W 에서는 2.3배; ⓓ 턴오프 — I_m 1/3.8(에너지 1/15) · 주파수 1/2.3 · R_G 1 Ω 이라 0.01 W. 브릿지 + 필터는 그들도 2 % 를 못 피한다. 그들의 86 kHz 는 60 V 출력이라 2차 턴을 충분히 감을 수 있어 가능한 것이고(턴수는 자료에 없다), 25 V · 2 T 로 86 kHz 면 유닛당 A_e 292 mm² 가 필요하다. 우리 200 W(30 % 부하) 84–87 % 와 그들 25 % 부하 92.5–93.1 % 의 8 %p ≈ 20 W 는 철손 초과 ~6 W(그들 ≤ 1.7 W 를 전력비 2.74 로 늘려도 4.7 W) + 순환 전류 ~2 W + 미해명 6–12 W 다.
⑨ **차이 13 %p 의 분해(같은 날)** — 우리 200 W · 110 V 19 %(38.1 W) 대 EVK 115 V 풀로드 6.0 %: **철손 11.3 − ≤1.7 W → 4.8 %p** · **턴오프 + 미해명 12.2 W → 6 %p**(모델 26.2–32.1 W 의 t_f 폭과 실측 차를 합친 것, 서로 겹치므로 합으로만 센다: X7R C_r 유전 손실 4–11 W · 느린 게이트 ≤ 6 W · 벤더 와이어(설계 전류의 절반)) · **순환 전류 4.0 − 0.7 W → 1.7 %p**(657 W 탱크 Z_0 7 Ω 을 200 W 로 돌린 것, 657 W 에서는 0.8 %) · 게이트 + 바디 + 정지 3.2 − 1.4 W → 0.9 %p(주파수 1.9배 · Q_g 2배) · 브릿지 · 필터 · 도통 · 2차는 3.45 대 3.0 % 로 같다. 즉 **절반은 트랜스포머(철손 + 순환 전류 6.5 %p), 절반은 측정으로만 갈리는 12 W** 다.

**세 번째 안(2026-10-17) — 변형 `7p5to1_x3m3`: 플랫 코어 3개 · 5 : 2+2 · f_r 193 kHz.** 사용자 조건(2차 2 T 유지 · 얇고 넓은 코어 · 3코어 · 90 % 중반)에 맞춰, 큰 플랫 코어(A_e 225, TDK ELP 43/10/28)와 정본의 정규화 탱크(λ 0.556 · Q 0.86 · n 6.01)를 193 kHz 로 환산한 68 nF / 10 / 18 µH 로 빌드하니 **69/75 — k.ZVS 0.962 · k.TTd 0.946 미달**(L_m 20 µH 였던 첫 빌드는 67/75, k.ZVS 0.294: 코너 a = 모핑 문턱 173 Vac HB 의 라인 피크가 게인 피크의 1.6 % 아래, FHA 입력 위상 3.5°). 원인은 주파수다: 영점 교차 시간 T.ZC = φ/(2πf) 가 같은 위상이라도 193 kHz 에선 75 kHz 의 1/2.6 이라 220 ns 데드타임 기준이 빡빡하다. `l6790.sweep` 로 f_r 160–193 kHz × λ 0.5 / 0.556 / 0.62 × Z_0 10 / 11.8 / 13.5 Ω 을 훑으니 **k.ZVS 는 Z_0 에 극도로 민감**(193 kHz · λ 0.556 에서 Z_0 11.8 Ω 1.12 → 12.1 Ω 0.96 → 13.5 Ω 0.02)하고, Z_0 를 내리거나 λ 를 올리면 회복된다(I_m 은 그만큼 는다). 빌더로 확인한 두 후보(둘 다 **71/75**, 미달은 정본과 같은 k.CVCC(C_VCC 1200 µF 필요) · k.Ploss · k.auxr · k.lam 뿐): **B** C_r 75 nF(150 nF 필름 2직렬) · L_r 9.1 · L_m 15 µH(λ 0.607 · Z_0 11.0 Ω · Q 0.83 · n 5.917) → k.ZVS 1.73 · k.TT 2.14 · k.TTd 1.84 · I_Lm 12.8 A · I_pri 라인주기 10.97 / 피크 13.75 A · 합성 피크 18.3 A · 2차 권선당 9.31 A · 유닛당 L_open 8.03 · L_m 6.34 · L_lk 3.03 µH · A_L 321 nH · 포화 시험 16.1 A; **C** 68 nF · 10 · 16 µH(λ 0.625 · Z_0 12.1 · Q 0.93 · n 5.883) → 1.42 / 1.74 / 1.50 · I_Lm 11.9 A · 10.57 / 13.5 A · 18.1 A · 유닛당 8.67 / 6.80 / 3.33 µH · 347 nH · 15.0 A. 공통: f_o 118–120 · f_Min 126.6(R_T 7.87 k · C_T 470 p) · f_Max 346 · f_SU 525 kHz · B_pk 72 mT · 보조 유닛당 1 T 를 **두 유닛만 직렬**(비 1, ZCD 220 k / 19 k, OVP 27.5 / 29.9 V — 셋 직렬이면 비 1.5 라 보조 전압이 OVP2 에서 50 V, k.SRVCC 0.76 미달). **B 를 변형으로 둔다**: LGE 보드처럼 중점 2.2 nF 스너버(c.HB 5.5 nF)를 쓰면 k.TT 가 B 2.14 → 1.17, C 1.74 → 0.95 라 B 만 남고, 도통 손실 차이는 약 1 W(I_pri² 비 1.08)다.

**코어(TDK ELP 43/10/28 쌍, B66291/B66461, IEC 62317-9, 데이터시트 06/13)**: A_e 225 · A_min 217 mm² · l_e 61.6 mm · V_e 13.75 cm³ · 70 g/세트 · 43.2 × 27.9 × (9.5 × 2) mm · 창 반경 (35.4 − 8.1)/2 = 13.65 mm × 축(권선 폭) 5.4 × 2 = 10.8 mm. N97 A_L 7500 ±25 %(무갭) · P_V < 7.0 W/세트 @200 mT · 100 kHz · 100 °C → 72 mT · 193 kHz 로 환산(지수 2.5 / 1.3, 상한) ≤ 1.3 W/세트, 3 세트 ≤ 3.8 W(N95 도 가능, N49 는 193 kHz 에선 오히려 불리). A_L 321 nH 는 N87 K1/K2 계수로 총 갭 ≈ 1.15 mm(벤더는 갭이 아니라 A_L 로 맞춘다). 권선 적합(유닛당): 1차 5 T TIW-Litz ≥ 3.0 mm²(0.1 × 400, OD ≈ 3.0 mm) 2층(3 + 2 T) 반경 6 mm · 2차 2 + 2 T Litz ≥ 2.5 mm²(0.1 × 320, OD ≈ 2.5 mm) 한 층 반경 2.5 mm · 보조 1 T ø0.4 TIW · 테이프 → 반경 약 10 mm / 13.65 mm, 남는 3.5 mm 가 1차–2차 간격(누설). 평면 코어라 표준 와이어 보빈이 없다 — 벤더 보빈 확인 항목. **누설이 관건**: 5 T 라 N² 이 작아 유닛당 3.0 µH 가 쉽지 않다(1차원 동심 추정 1.7–2 µH, 벤더의 지난 권선은 가는 선으로 1.9 µH). 사양서에는 L_lk 3.0 µH ±15 % 를 적되 **L_r 8–11 µH(3 × L_lk) 안이면 C_r 로 f_r 을 맞추고**, 모자라면 외부 공진 인덕터 L_ext = 9.1 − 3·L_lk 자리를 보드에 둔다. 손실: 코어 ≤ 1.3 + 구리 ≈ 1.0 W/유닛(1차 5 T × MLT 0.1 m × 5.6 mΩ/m × 10.97² · 2차 2 × 2 T × 7 mΩ/m × 9.31² · AC 계수 1.3) → 세트 약 7 W, 유닛당 2.3 W 는 자연대류에서 50 K 급 상승이라 배치 간격 확인. 수입 검사(유닛): L_open 8.03 µH ±10 % · L_lk 3.03 µH ±15 %(5–9 · 7–11 단락, 2–3 개방, 100 kHz 1 V) · DCR 1차 ≤ 3.5 mΩ · 2차 ≤ 2 mΩ · 권선비 5 : 2 : 2 : 1 과 극성(핀 맵 `cores.PINMAP`) · 내전압(정본 사양서 조항) · 16.1 A DC 바이어스에서 90 % · **선 규격(가닥 수 × 지름) 신고** — 지난번 "ST 요청대로 안 만든" 일을 막는 항목. 보드 쪽 동반 변경: C_VCC 1200 µF · 보조 2 T 결선 · C_r 필름 150 nF × 2 직렬 · R_T 7.87 k · 스너버 유지 시 B. 벤더 사양서 파일은 보빈 · 핀이 정해진 뒤 `build_trans_spec.py` 를 3유닛용으로 확장해 만든다.

**"LG 트랜스포머(26OP-LM83W)와 같은 코어(EE6405)를 쓰면?"(2026-10-17, 사용자 질문)** — 승인원(`LGE Material/기존 PFC + LLC 트랜스포머 사양서.pdf` 5 · 6 · 7 · 11 · 12 · 17 · 18쪽)을 다시 읽었다(HISTORY §5.2b). ① **한 유닛에 EE6405 가 두 세트다**: 보빈 중앙 구멍 8.5 × **68.0** mm(= 코어 깊이 C 33.5 × 2) · 권선부 길이 68 · 몸체 60 × 103 · 완성품 143.9 × 67 × 4.8 mm · 사이드 본드 면적 **3216 mm² = 2 세트 × 2 창 × 24 × 33.5**. HISTORY §5.2 의 "A_e 113.1" 은 세트 하나 값이고 권선이 두 센터 다리를 함께 감으므로 유닛의 유효 단면은 **226 mm²** — 변형 `7p5to1_x3m3` 가 가정한 225 와 같다. 즉 **자속 조건은 같은 코어 두 세트로 충족된다**(2 T · 192.6 kHz 에서 71.7 mT; 한 세트면 143 mT). 어제 "코어 단면이 LG 것의 두 배여야 한다" 고 한 것은 세트 하나를 유닛으로 센 것이라 틀렸다 — 같은 급이다. ② **창 높이가 1.4 mm 다**: 코어 표 B 2.30(반쪽 높이) · F 0.70 · B−F 1.60 은 요크 1.6 · 다리 0.7 로 읽어야 IEC 환산 A_e 가 108 mm²(≈ 113, **요크 2 × 1.6 × 33.5 = 107 이 병목** — 센터 다리 8 × 33.5 = 268 이 아니다)이 되고 반대로 읽으면 48 이다; 옆면도(두꺼운 판에 낮은 돌기)와 보빈 권선부 두께 1.30 ± 0.1 도 같은 쪽이다. → 창은 한쪽 **24(반경) × 1.4(축) mm = 33.6 mm²**, 깊이 2 × 33.5, MLT ≈ 170 mm(1차 DCR 55 mΩ max 와 어긋나지 않음: 0.45 mm² × 5 T → 32 mΩ@20 °C). LG 2차가 0.5 mm 동판 1 T 두 장(겹쳐 1.0 mm)이고 1차가 ø1.1 리츠 한 층인 이유다. ③ **그 창에 670 W 권선이 안 들어간다**: 1차 11 A rms 에 LG 리츠 0.04 × 360(0.45 mm²)은 24 A/mm² · 유닛당 DC 5.1 W(100 °C). 1.5–1.8 mm² 가 필요한데 그 리츠 다발은 ø2.1–2.3 mm 로 창 높이를 넘고, 1.0 × 1.8 mm 로 눌러도 5 T 가 반경 10–11 mm 다. 2차 2+2 T 는 LG 포일 0.5 × 4.5 를 겹치면 2.0 mm(> 1.4), 옆으로 놓으면 18 mm 라 1차와 합쳐 24 mm 를 넘는다 — 포일 폭 3 mm(6 A/mm²)로 줄여야 12 + 11 + 칸막이 0.7 ≈ 23.5 mm, 여유 0. ④ LG 식 분할 배치(센터 다리 쪽 1차 칸 · 바깥 2차 칸)는 5 T 에서 누설 14 µH/유닛(560 nH/T²)인데 우리 요구는 3.0 µH(121 nH/T²)라 배치도 그대로 못 쓴다. ⑤ 철손은 세트 둘 V_e 12.9 cm³/유닛으로 ELP 43/10/28 쌍(13.7)과 같은 급이라 **GP98 이 N97/PC95 급이면** 3 유닛 4 W 안팎 — GP98 의 손실 곡선은 못 찾았다(웹 검색 1회, 관유다 자료 필요). **결론: 같은 EE6405 는 자속 · 철손 쪽은 되지만 창 높이 1.4 mm 때문에 2 T 2차 · 670 W 구리가 들어가지 않는다.** 되는 길은 같은 발자국(64 × 33.5 두 세트, A_e 226/유닛)에 다리만 높인 코어(창 4–5 mm → 두께 4.8 → 8 mm 급) — 벤더 맞춤이며 "같은 코어" 는 아니다. 세트를 셋으로 늘려도(A_e 339, 48 mT) 창 높이는 그대로라 소용없고, 1 T 2차는 5 : 1+1 → n_T 15 로 권선비가 깨진다.

**요구사양서(2026-10-18, 사용자: "코어를 특정해서 사양서를 만들지는 말고 사양만 특정해서 깔끔하게")** — `build_trans_spec.py` 에 `nocore` 모드를 넣고 `3CORE_670W_transformer_spec.xlsx` 를 만들었다(위 표). 정본 사양서(`7p5to1_x1`)는 셀 전량 대조로 바뀐 것이 없다. 코어 자리에 들어간 요구는 셋: **A_e ≥ 220 mm²**(= V_o/(4·f_r·2·0.075 T) = 216 → 10 단위 올림; 자속 경로 전체 기준, 요크 제한 · 코어 두 개 합산 명시) · **재질 N97/PC95/3C95 급** · 손실 배분 코어 1.3 + 구리 1.0 W/유닛. 구리는 설계 예(3.0 / 2.5 mm²)의 3.75 A/mm² 로 적었다 — 플랫 코어는 턴 길이가 길어 일반 가정 4.5 A/mm² 보다 굵게. 높이는 수치로 적지 않았다(세트 기구가 정한다 — 26OP-LM83W 4.8 mm 를 "flat construction" 의 기준으로만 언급). **표피효과의 기준 주파수(2026-10-18, 사용자 질문)**: 공진 아래에서 2차 전류와 1차의 부하 성분은 f_r 의 반파 정현 펄스이고 자화 성분만 f_sw 의 삼각파다; 공진 위에서는 f_sw 의 연속 정현이 된다. 스트랜드 · 포일 두께는 **f_r 193 kHz(δ 0.17 mm @100 °C)** 와 전부하 최고 307 kHz(δ 0.14 mm) 둘 다 덮게 ø0.10 으로 잡았다. **"공진 위 영역은 거의 안 들어가나?"(같은 날)** — 아니다. `l6790.sweep`(FHA, x3m3 탱크 n 5.917 · Q_pk 0.833 · λ 0.607)로 라인 반주기를 훑으면 요구 게인 M_req = 2·n·V_o/(√2·V_eq·sinθ) 가 1 아래로 내려가는 각에서 f_sw > f_r 이고, 그 경계는 V_eq·sinθ > 2·n·V_o/√2 = **209 V** 다(FB 는 V_eq = 2·Vac, HB 는 Vac). 즉 **FB 105 Vac 위, HB 209 Vac 위에서는 라인 피크 둘레가 공진 위**이고 그 시간 · 에너지 비율은 부하와 무관하다(FHA 에서 f_r 의 게인은 Q 와 무관하게 1). 전부하: 90 Vac FB 0 %(피크 171 kHz) · 105 Vac 5 %/11 %(시간/에너지, 피크 193) · **110 Vac 20 %/39 %(201 kHz)** · 120 Vac 33 %/60 %(217) · 166 Vac FB 가장자리 57 %/88 %(307) · 173 Vac HB 가장자리 0 %(166) · 209 Vac HB 0 %(193) · **230 Vac 27 %/51 %(209)** · 264 Vac 42 %/73 %(238 kHz). 30 % 부하(197 W)는 비율이 같고 피크 주파수만 오른다(166 Vac FB 가장자리 471 kHz — FHA 는 공진 위 주파수를 과대 산정한다, 140 Vac 실측 250 vs FHA 383–417). 공진 아래에만 머무는 조건은 90–105 Vac FB 와 173–209 Vac HB 뿐이다. 그래서 사양서 4절 공진 주파수 줄을 "공진 아래 f_r 반파 정현 · 위에서는 f_sw 정현(라인 피크 둘레), 도체는 범위 상단 기준" 으로, 2절 도체 주석의 표피 깊이를 193 kHz 와 307 kHz 둘 다로 고쳤다. **본사 240 W EVK 실측이 같은 그림이다(사용자 지적, 같은 날)**: 슬라이드의 115 Vac FB = 230 Vac HB 파형 라인 피크 93 · π/4 71 · 영점 근처 47.2 kHz 를 f_r ≈ 86 kHz(C_r 66 nF 추정)로 나누면 **1.08 · 0.83 · 0.55 f_r**, 우리 x3m3 모델의 115 FB / 230 HB 는 **1.08 · 0.85 · 0.66 f_r**(피크 209 · π/4 164 · f_Min 126.6 kHz) — 피크가 공진 살짝 위인 것은 ST 툴의 권선비 규칙(공진점을 V_in,res = 0.95 × V_in,nom 에 두므로 정격 라인 피크는 공진 위, `l6790.design` 의 `d_res`; x3m3 는 n 5.917 이라 공진점 209 V eq = 0.91 × 230) 그대로다. 영점 쪽 차이(0.55 vs 0.66)는 f_Min 의 선택 차이(우리는 k.floor 규칙으로 f_Min > f_o). **누설 공차 · 허용 범위를 시험 빌드로 확인**(`build_l6790_smath.py` 사본으로 x3m3 를 다시 빌드, 스크래치 `x3spec/trials.py`, R_T 7.87 k · C_T 470 p 고정): 설계점 71/75; **C_r 75 nF 고정에 누설 −15 % (L_r 7.74)는 k.CTd 0.966 · k.ceil 0.991 로 69/75** — f_r 209 kHz 에 f_Max 346 이 모자란다; −10 % (8.19)는 k.CTd 1.041 · k.ceil 1.037 로 71/75, +15 % 도 71/75 → **공차는 통일 ±10 %** 그대로(2026-09-07 규칙). 범위: L_r 8.0 µH 를 C_r 85.3 nF 로, 11.0 µH 를 62.1 nF 로 다시 맞추면 둘 다 71/75(k.ZVS 1.90 · 1.57, Z_0 9.7 · 13.3 Ω) — 단 그 끝점의 −10 % 코너는 발진기 재선정 없이는 미달(8.0 의 −10 %: k.CTd 0.915 · k.ceil 0.973; 11.0 의 −10 %: k.floor · k.RTd 0.989)이라 사양서에는 "C.r 과 발진기 설정을 다시 고른다" 로 적었다. 벤더가 3.03 을 못 맞추면 견적 단계에서 도달값을 받고 그 값에 C_r · R_T · C_T 를 다시 고른 뒤 ±10 % 를 건다. 또 하나 — **f.SU 525 kHz 가 TIW-Litz 승인 주파수 500 kHz(EFOLIT, DESIGN.md §4.2 12)를 넘는다**: 사양서 5-5 에 "기동 주파수 525 kHz 를 덮는 승인품" 으로 적었고, 못 구하면 기동 주파수를 낮추는 쪽(R_T · C_T)을 봐야 한다 — 미결.

**C_r 를 MLCC 로(2026-10-18, 사용자: "75 nF 는 병렬로 맞추기 어렵고 필름도 쓰기 어렵다 — MLCC 로는 절대 안 되나?")** — 안 되는 것은 MLCC 가 아니라 **X7R(2종 유전체)** 이다. ① **손실**: C_r 이 다루는 무효전력은 657.5 W · 90 Vac 에서 I_pri,lc 10.97 A rms × X_C 11.0 Ω = **1325 var**(라인주기 평균; HB 가장자리 173 Vac 도 1326 var). 손실 = var × DF: C0G DF 0.03 %(전형) 0.4 W · 0.1 %(규격 상한) 1.3 W, **X7R 1 % 13 W · 2.5 % 33 W**(데이터시트 DF 는 1 kHz 값이고 고주파 · 큰 AC 에서 더 커진다 — AVX 노트: "X7R 의 DF 는 주파수와 함께 계속 커져 발열로 고장"). 지금 200 W 보드의 X7R C_r 이 ⑥ 에서 4–11 W 로 추정된 것과 같은 선이다. ② **용량 안정성**: HB 모드에서 C_r 에는 V_in(t)/2 의 DC 바이어스(264 Vac 피크에서 187 V)가 걸린다 — X7R 은 여기서 20–40 % 가 빠져 f_r 이 올라간다(200 W 보드의 "230 V 에서 C_r,eff −40 %" 가설이 바로 이것); FB 모드(저입력)에는 바이어스가 없다. 온도 ±15 % · 에이징 · AC 전압 의존도 겹친다. C0G 는 0 ± 30 ppm/°C, 바이어스 · AC · 에이징 무관, 공차 J ±5 %. ③ **전압 · 전류**: `l6790.sweep` 으로 라인주기를 훑은 C_r 피크 전압은 FB 90 Vac 197 V(AC 394 Vpp, 바이어스 0) · **HB 173 Vac 가장자리 324 V(AC 403 Vpp + DC 122 V)** · 230 Vac 318 · 264 Vac 313 V → 630 V 급 C0G 한 단(직렬 없이)으로 2배 여유. 전류 11 A rms 는 용량비로 나뉜다(68 nF 한 알이 10 A — C0G DF 0.05 % 면 ESR 6 mΩ · 0.6 W, X7R DF 2 % 면 243 mΩ · 24 W). AVX 1210 33 nF C0G 의 리플 정격은 200 kHz 3.72 A(노트 그림 7)라 2220 급 4–5알 병렬이면 알당 2–3 A 로 정격 안이다 — 선정 품목의 리플 정격 곡선으로 확인. ④ **구할 수 있는 값**: 630 V C0G 2220 은 TDK C5750C0G2J683J230KC(68 nF, ±5 %) · KEMET 2220 630 V C0G 가 0.15–0.2 µF 까지 품목에 있다(웹 검색 결과 — 재고 · 가격은 확인 필요). 75 nF = 68 + 6.8, 또는 5 × 15 nF. ⑤ **표준값으로 재중심해도 된다(시험 빌드, f_r 193 kHz 고정, R_T 7.87 k)**: 75/9.1(설계) 71/75 k.ZVS 1.73 · **80 nF/8.5 µH(8 × 10 nF) 71/75 k.ZVS 1.80** · **82 nF/8.3 µH(E12) 71/75 k.ZVS 1.83, Z_0 10.1** · 88/7.7(4 × 22 nF) 71/75 k.ZVS 1.93 · 68/10(E6) 71/75 k.ZVS 1.62 · 100/6.8 은 69/75(k.CTd 0.889 · k.ceil 0.973 — Z_0 8.2 로 너무 낮다). C_r 을 키우면 Z_0 가 내려가 ZVS 여유는 늘고 누설 목표(L_r/3)는 2.57–2.83 µH 로 **더 쉬워진다**; 대신 I_Lm 12.8 → 13.1 A(88 nF) 로 순환 전류가 2–3 % 는다. **권장: C0G 630 V 2220 병렬, 값은 75–88 nF 중 품목이 맞는 것(82 nF E12 가 무난), 사양서 · 시트는 값이 정해지면 재빌드.** 필름을 쓴다면 공진용(펄스 정격 PP)이지 X2 가 아니다(⑥). **"200 W 시험의 C_r(47 nF 2S × 5P = 117.5 nF X7R)이 정말 그렇게 손실이 컸나?"(사용자, 같은 날)** — 단정은 못 한다, DF 를 모르기 때문이다. 벤치 탱크(117.5 nF · 5.7 / 25.2 µH · n 6.773)를 200 W 로 훑으면 C_r 전류 6.4 A rms(라인주기) · 무효전력 **280–440 var**(전류 성분을 f_r 194.5 kHz 로 보느냐 평균 f_sw 130 kHz 로 보느냐의 폭) · C_r 피크 전압 60 V(110 FB) / 223 V(230 HB, 바이어스 포함). 10알에 나뉘어 **알당 1.27 A rms · 약 22 V rms** 다 — 2S 가 전압을 반으로 나눠 AC 전계를 낮추고 5P 가 열을 나누므로 눈에 안 띌 수 있다. 손실 = var × DF: **DF 0.5 % 면 1.4–2.2 W(알당 0.14–0.22 W) · 1 % 면 2.8–4.4 W · 2.5 % 면 7–11 W(알당 0.7–1.1 W)**. 1206 의 보드 위 열저항을 대략 100 K/W 안팎(패드 · 동박에 크게 좌우)으로 보면 알당 0.15 W 는 15 K 안팎, 0.7 W 는 70 K 급이다 — **열화상 한 장이 DF 를 알려 준다**(⑨ 의 미해명 6–12 W 중 C_r 몫이 얼마인지도). 소신호 DF 는 LCR 미터 100 kHz 로 잴 수 있지만 큰 AC 에서의 값은 아니다; 가장 확실한 것은 한 열(2S)을 C0G 로 바꿔 효율 차를 보는 것. **사용자가 준 커패시터 사양서(같은 날 "커패시터 사양서는 줬었잖아")** — Würth **885342208026**, WCAP-CSMH, 데이터시트 2022-09-29 rev 001.000(`Datasheet/Wurth_885342208026_WCAP-CSMH_47nF_630V_X7R_1206.pdf`, we-online 에서 내려받음): **1206**(3.2 × 1.6 × 1.6 mm) · 47 nF ±10 %(1 kHz · 1 ±0.2 V rms · 25 °C) · 630 V DC · **X7R Class II** · **DF 2.5 % max(1 kHz · 1 V rms · 25 °C)** · IR 2.127 GΩ min(500 V 60 s) · TC ±15 % · −55…+125 °C · 내전압 150 % V_R 15 s. 8쪽 전부가 표 · 치수 · 포장 · 납땜 프로파일 · 주의사항이고 **ESR/임피던스–주파수, 용량–DC 바이어스, 용량–AC 전압 곡선은 없다** — 그래서 손실 계산에 쓸 수 있는 DF 는 1 kHz 소신호 상한 2.5 % 뿐이고, 130–195 kHz · 알당 22 V rms 에서의 값은 이 사양서로는 모른다. 알당 X_C 는 194.5 kHz 에서 17.5 Ω 이라 DF 0.5 / 1 / 2.5 % 는 ESR 0.09 / 0.17 / 0.44 Ω, 10알 × 1.27² × ESR = 1.4 / 2.8 / 7.1 W. Würth REDEXPERT 에는 이 품목의 ESR–주파수 · DC 바이어스 곡선이 있으니 **200 kHz ESR 한 값**을 읽으면 손실이 16 × ESR[Ω] W 로 바로 나온다(소신호 값이라 큰 AC 에서는 하한). **REDEXPERT 곡선 5장(사용자 제공, 같은 날; `Datasheet/Wurth_885342208026_REDEXPERT/*.svg`, 벡터 경로를 `redexpert_read.py` 로 읽음)**: ① **ESR–주파수(소신호)**: 1 kHz 5.9 Ω(DF 0.18 %) · 100 kHz 374 mΩ(1.08 %) · 130 kHz 299 mΩ(1.11 %) · **194.5 kHz 208 mΩ(DF 1.16 %)** · 300 kHz 142 mΩ(1.21 %) · 1 MHz 59 mΩ(1.68 %) — 임피던스 곡선에서 역산한 C 는 45–47 nF 로 일관. **200 W 손실 하한 = 10알 × 1.27² × ESR: 194.5 kHz 기준 3.4 W, 자화 성분 1.0 A @130 kHz + 부하 성분 0.8 A @194.5 kHz 로 나누면 4.3 W** — 데이터시트 상한 2.5 % 의 절반, 전형값 가정 1 % 와 같은 자리다. ② **용량–DC 바이어스**: 0 V 47.0 · 41 V −5.6 % · 50 V −9.5 % · **81 V −25 %**(230 Vac HB 라인 피크에서 알 하나, 2S) · **93 V −31 %**(264 Vac) · 120 V −44 % · 163 V −58 %(2S 열 전체의 V_in/2) · 300 V −79 %. 스윙을 포함한 전하 평균 유효 용량: 230 HB 200 W 알당 82 V ± 30 V → 35.2 nF(−25 %) → **열 전체 88 nF, f_r × 1.16 = 225 kHz**; 264 HB → 81 nF, × 1.20; FB(110 · 90 Vac)는 0~−6 %. 공진 위 운전 1.08 배를 곱하면 230 V 라인 피크 ≈ 243 kHz — **실측 253 kHz 가 이것이다**(2026-10-14 의 "C_r,eff −40 %" 가설 확정: 바이어스 −25 % + 공진 위 운전). ③ **용량–AC 전압**(0–12 V rms 까지만): 1 V 0 · 2 V +1.7 · 5 V +6.2 · 8 V +9.9 · 10 V +12 % — 알당 실제 22 V rms 는 그래프 밖이고, 이렇게 가파른 AC 의존은 히스테리시스가 커진다는 뜻이라 큰 신호 DF 는 소신호 1.16 % 보다 높다. **결론: 200 W 에서 C_r 손실은 최소 3.4–4.3 W(소신호 ESR), 실제는 그 이상 — 미해명 6–12 W 의 절반 안팎이 여기일 수 있다. 657 W 에 같은 급 X7R 이면 1325 var × 1.16 % = 15 W 가 하한.** 열화상 한 장이 큰 신호 값을 준다. **TDK C4532C0G2J473J320KA 를 2S × 3P = 70.5 nF 로(사용자 제안, 2026-10-18; TDK 사이트에서 내려받은 특성 CSV 5종 `Datasheet/TDK_C4532C0G2J473J320KA/`)** — 1812(4.5 × 3.2 × 3.2 mm) · 47 nF ±5 % · 630 V · C0G. 데이터: **ESR 100–300 kHz 2.3–3.3 mΩ(192 kHz 2.96 mΩ, DF 0.017 %)** · C 47.7 nF 가 1 MHz 까지 평탄 · SRF 17.1 MHz(ESL 1.8 nH) · **DC 바이어스 0–630 V 에서 47.0 nF 그대로** · −55~125 °C 에서 −0.2 %. 어레이: 알당 전류 1/3, 전압 1/2 → 657 W 에서 알당 3.66 A rms · 피크 168 V(HB 가장자리, DC 61 + AC 76 V rms; 정격의 27 %) · **손실 0.04 W/알, 6알 0.24 W**(큰 신호 10배 여유를 줘도 2.4 W) — X7R 의 15 W 와 비교 끝. 200 W 는 알당 2.1 A · 0.014 W. 2S 는 C0G 에선 용량 안정성 때문이 아니라 **알 하나가 단락돼도 나머지가 324 V 피크를 630 V 로 받는 안전 여유** 때문에 유지할 가치가 있다(LGE 양산품도 2S). 탱크(시험 빌드, R_T 7.87 k): **70.5 nF + L_r 9.68 µH(f_r 193 유지) 71/75, k.ZVS 1.66 · Z_0 11.7 Ω · 유닛당 누설 3.23 µH**; 70.5 nF + L_r 9.1 µH(그대로) 는 f_r 198.7 kHz 로 71/75 이지만 k.ZVS 1.56 · k.floor 1.037 로 여유가 줄고; 1S × 2P 94 nF 은 k.CTd 0.952 로 70/75(Z_0 8.8). → **채택 가능, f_r 을 지키려면 L_r 9.7 µH(누설 목표 3.23 µH/유닛)로 사양서 · 시트를 다시 빌드.** 벤치 200 W 보드에서 X7R 대 C0G 를 같은 탱크로 가르려면 2S × 5P = 117.5 nF(10알, 1812 라 1206 패드엔 안 맞음). **TDK 허용 곡선 3종(사용자 추가 제공, 같은 날; `ripple_temperature_rise.csv` · `max_allowable_current.csv` · `max_allowable_voltage.csv`)**: 리플 온도상승은 ΔT = k·I² 로 85 / 100 / 300 kHz 에서 k 1.09 / 0.90 / 0.50 °C/A² 이고, 허용 전류 · 허용 전압 곡선은 **ΔT 20 °C 기준**으로 서로 환산된다(저주파는 630 Vp-p 로 캡): 100 kHz 4.72 A · 452 Vp-p, 130 kHz 5.50 A · 405 Vp-p, **190 kHz 6.34 A · 320 Vp-p**, 240 kHz 6.35 A · 253 Vp-p, 300 kHz 6.35 A · 203 Vp-p. 카탈로그 PDF 는 여전히 못 읽었지만 이 곡선이 그 표다. **대조(2S × 3P, 알 하나 = 전류 1/3 · 전압 1/2, 새 탱크 70.5 nF / 10 / 15, 라인주기 최악각)**: 657 W HB 가장자리 **3.65 A rms(허용의 57 %) · 217 Vp-p @190 kHz(68 %) · ΔT ≈ 9 °C**; 657 W 90 FB 3.60 A · 212 Vp-p(66 %); 264 HB 3.17 A · 141 Vp-p @230 kHz(53 %); 200 W 는 2.7 A · 155 Vp-p(43 / 48 %). **전류 · 전압 · 온도 모두 TDK 허용 안, 여유 1.5배 이상.** 1S × 2P(94 nF)였다면 알당 전압이 열 전압 전체(≈ 320 Vp-p)라 허용의 100 % 였을 것 — 2S 가 전압 쪽에서도 필요했다. 남은 확인은 1812 의 굴곡 균열(소프트 터미네이션 품종 여부)뿐. **출처**: KYOCERA-AVX "C0G High Voltage MLCC in DC-DC and OBC Applications"(스크래치 `avx_c0g/avx.txt`), TDK 테크라이브러리 "MLCC C0G in resonant circuits"(403 으로 본문 못 읽음), RS · chipdip 품목 페이지.

**부하별 합성 피크 — 자화전류에 부하전류가 더해지는가(2026-10-18, 사용자 "빌로우 영역에서 부하가 작으면 공진전류가 더해져도 피크는 자화전류 그대로일 수 있고 반대로 완전히 더해질 수도 있다 — 자동으로 계산하게")** — 공진 아래에서 자화전류는 반주기 **끝**에서 피크인 삼각파이고 반사 부하전류는 **가운데**에서 피크인 반파 정현이라, r.mix = 2·I_Lm/(π·I_trafo) ≥ 1 이면 합은 자화 피크에서 끝나고(부하가 더해지지 않음) 그 아래에서만 부하가 피크를 올린다(가이드 식 [79], 시트 §9 의 x.pk). 시트 §9b(빌더) 는 V_in,min 라인 피크에서 부하 0 · 25 · 50 · 75 % 마다 시트 §8 의 3차식으로 주파수를 다시 풀어 이 판정을 하고(100 % 는 시트 §9), 시트 §14.1 에 부하별 OCP1 여유 m.OCP.* 와 영점 교차(f.Min, 어느 부하든)의 자화 바닥 I.Lm_pk.zc 를 둔다. 워크북 셋에는 `peak_xl.py` 가 결과 7줄을 `Res. Tank Design` 70–79행(기존 Parameters / Name / Value / Unit 양식), 중간 계산을 `CC` 59–74행에 살아 있는 수식으로 넣었다(2026-10-19 사용자 "수식이 너무 많다 — Res. Tank Design 에 간단하게" 로 `Device Setting` 116–141행에서 옮김; `xl_sm_compare` 8항목, 100 % 값은 D32 와 1.0000). 부하전류가 피크에 더해지기 시작하는 부하 ld.add(근사): 가이드 44 % · 3코어 51 % · 200 W 99 %. 25 · 50 % 열은 빌더가 `l6790.sweep(load=…)` 와 대조한다(mismatches 0). 결과(LibreOffice 재계산): | 부하 | 가이드 PQ50 I_Lr,pk | 3코어 670 W | 200 W 벤치(117 nF / 5.7 / 25.2 µH, n 6.773) | — 0 % 11.13 / 12.77 / 8.62 A(= 자화 피크) · 25 % 11.13 / 12.77 / 8.62 · 50 % 11.42 / 12.77 / 8.62 · 75 % 14.26 / 14.85 / 8.62 · 100 % 18.12 / 18.22 / 8.63 A. 즉 **가이드는 25 %, 3코어는 50 % 까지 피크가 자화전류 그대로**이고 200 W 벤치는 정격에서도 자화전류(8.62 A)가 피크다(r.mix 0.985). OCP1 22.9 A(R_CS 24 mΩ) 여유는 100 % 에서 1.27 / 1.26 / 2.66, 영점 교차 바닥에서 2.06 / 1.80 / 2.66. 한계 둘: 무부하는 IC 가 버스트라 0 % 열은 그 주파수에서 탱크가 지닐 자화전류이지 정상 상태가 아니고, 영점 교차 근처 주파수가 f.Min 까지 내려간다는 것은 전부하에서 확인된 거동이다. OVP(ZCD 의 보조권선 전압)는 탱크 전류와 무관하다 — 자화전류가 건드리는 것은 R_CS · OCP1/OCP2 · 최대전력 법칙(16.8/R_CS)이다.

**기동 링잉 후속 벤치(2026-10-26 · 27, 사용자, 200 W 시험 중)** — ① 게이트 입력(드라이버 HIN/LIN)에 RLC 필터 4.7 µH + 270 Ω + 220 pF 를 달자 링잉이 "조금" 줄었다. 링잉 주파수 실측 **약 6.5 MHz = VDS 링과 같음**(10-14 캡처의 12.8 MHz 가 아님). 이 필터는 6.5 MHz 에서 ×0.40 뿐이라(12.8 MHz ×0.135) "조금" 과 맞는다. 필터 강화는 하지 않는다 — L6498 문턱 비대칭(V_il 0.95–1.45 · V_ih 2.0–2.5 V) 때문에 끄는 에지가 늦어 데드타임을 먹는다: 지금 값 최악 41 ns(HOUT 4 V 가정, 5 V 면 57), 470 pF 면 94–137 ns(설계 데드타임 220 ns). 6.5 MHz 는 주파수가 절반이라 L·C 4배 — 루프 176 nH(10-14 진폭 추정) 그대로면 링 용량 3.4 nF ≈ C115 2.2 + C_oss 0.9 + D–S 0.3 nF, 즉 레그 전체가 입력 660 nF 까지의 버스 인덕턴스와 공진하는 모양(확인 전). 처방은 FET 핀 47 nF C0G(HS 드레인–LS 파워 소스 3–8번 핀, R_CS 위, 켈빈 핀 아님 — **장착 여부 미확인**). ② **110 Vac 기동 탱크 전류 약 ±30 A @ 약 400 kHz**(C_T 470 p / R_T 9.1 k, 계산 f_SU 515 kHz 의 0.78배) — OCP2 31.25 A 의 96 %. 공칭 탱크(5.7 µH / 117 nF, FB 156 V) 정상 상태 모델은 21.4 A 라 1.4배 차이: 후보는 기동 과도(탱크 자유 진동이 겹침) · L_r 이 약 4.4 µH · 피크에 링이 얹힘 · 기동 비대칭 패턴 — **미확정**(110 V FB 라 X7R DC 바이어스는 아님). 30 A 가 OCP1 22.9 A 를 넘는데 주파수가 오르지 않는 이유(기동 고정 주파수 구간의 OCP1 동작)는 DRAFT DS 로 모른다 — ST 질의. ③ 기동 주파수를 낮추자는 제안은 이 측정으로 철회하고 **C_T 330 pF / R_T 13 kΩ 으로 올림**(계산 f_SU 638 · f_Max 413 · f_Min 110 kHz, 실제 약 500 kHz 추정; 끊는 전류 추정 16–21 A) → VDS 링이 "약간" 줄었다. 벤치 워크북 사본 재계산: 최악 버스 I.su 17.5 A · k.su.OCP1 1.31 · OCP2 1.78 이지만 **게이트가 못 따라감** — R_on 47 Ω 에서 V.g.su 9.75 V CHECK · k.tD.su 0.57 CHECK(기동 데드타임 420 ns 가정 대비 허용 81–240 ns). R_on 22 Ω 이면 13.1 V · 0.87(15 Ω 이하는 f_Max 413 kHz 에서 드라이버 손실 0.83 W 초과). R_on 손실은 f_Max 에서 0.35–0.40 W 라 지금 1608(0.1 W 급)은 정격 초과 가능 — 2010 또는 1206 × 2. ④ **R_CS 를 키우자 링이 줄었다** — 저항의 감쇠(수십 mΩ vs 링 임피던스 약 7 Ω)가 아니라 OCP 문턱이 내려가 기동 전류가 제한된 효과로 본다. 200 W 시험에서는 36 mΩ 까지(OCP1 15.3 A · 200 W 피크 8.6 A 여유 1.77 · 기동 OCP2 20.8 A / 17.5 A = 1.19), 48 mΩ 는 기동 OCP2 초과 가능. 670 W(3코어 워크북 R.CS 상한 24.5 mΩ, 풀로드 피크 18.2 A)에는 가져갈 수 없으므로, 47 nF · R_on 22 Ω · RC 감쇠기 효과는 24 mΩ 에서도 확인할 것. RC 감쇠기는 47 nF 와 같은 자리(버스 양단이라 c.HB · ZVS 불변), 값은 ΔC(1–2 nF C0G) 를 붙여 주파수 이동으로 링 L · C 를 잰 뒤 R_d = √(L/C), C_d = 3–4 C(잠정 7 Ω · 10–15 nF, 레그당 정상 운전 2–3 W, 무유도 저항).

**무부하 AC 기동 VDS 피크 — 230 Vac 약 650 V, 110 Vac 약 280 V(2026-10-27, 사용자, R_CS 40 mΩ · C_T 330 p / R_T 13 k)**: 230 V 피크가 **2 × 버스 피크(2 × 325 = 651 V)** 와 같고 110 V 도 1.8 × 156 V 다 — 끊는 전류가 아니라 버스 전압에 비례하므로 R_CS · f_SU 로 줄지 않은 것과 맞는다. 해석(확인 전): 레그 국부 용량이 C115 2.2 nF 뿐이라 저장 전하 0.72 µC(325 V)가 STO60N045DM9 바디 다이오드 Q_rr 1.16 µC(25 °C) · 2.8 µC(150 °C)(DS: 56 A, 100 A/µs)보다 작다 — HS 가 역회복 중인 LS 바디 다이오드 위로 켜지면(10-14 캡처의 HS1 재도통) 레일이 0 근처까지 꺼지고 버스 인덕턴스가 되채우며 2 × V_bus 로 넘친다. **600 V V_(BR)DSS 를 넘으므로 애벌런치 영역일 가능성이 크고(I_AR 6 A), 230 V 기동 파손과 같은 기전으로 본다 — 230 Vac 시험 중단.** 국부 용량별 Q_rr 에 의한 레일 처짐(325 V): 2.2 nF 전량 · +47 nF 24–57 V · +2 × 47 nF 12–29 V · +2 × 47 nF + 2 × 220 nF 2–5 V. 처방: 레그마다 47 nF C0G × 2 를 FET 핀에 + 입력 660 nF 중 220 nF × 2 를 레그 옆으로(10-18 조치 ③), R_on 22 Ω 로 하드 커뮤테이션 감소, 650 V 를 본 FET 는 V_(BR)DSS · 게이트 누설 · R_DS(on) 확인 또는 교체. 재시험은 110 V → 180 V → 230 V 계단, VDS 480 V(80 %)에서 중단.

**200 W 보드의 기동 주파수 515 kHz 를 지금 게이트 회로가 감당하나(2026-10-21, 사용자 "L6498LD 와 게이트 저항 변경 전 회로로 지금 스타트업 주파수가 감당 가능한지")** — `gate_budget.py bench200`(같은 모델, 200 W 탱크 117 nF / 5.7 / 25.2 µH, C_T 470 p · R_T 9.1 k → f_SU 515 · f_Max 334 · f_Min 110 kHz, c.HB 3329 pF; 회로는 18 V · R_on 47 Ω(0603) · R_off (10 Ω + 1N4148WS) ∥ 47 Ω · 부트 10 Ω × 100 nF). **감당한다 — 결론 셋.** ① 타이밍: 게이트가 플래토까지 201 ns(켜짐) · 187 ns(꺼짐); 515 kHz 에서 깨끗한 ZVS 를 주는 IC 데드타임 창은 FB 70–378 ns · HB 105–378 ns. IC 가 최대 420 ns 를 쓰면 들어오는 스위치가 전류 반전 42 ns 뒤에 켜지고 그동안 중점이 되돌아가는 폭은 FB 155 V 에서 약 7 V · HB 325 V 에서 약 15 V 라 거의 ZVS 다. 완전한 하드 스위칭에는 573 ns 이상이 필요한데 IC 최대가 420 ns 라 **게이트 회로만으로는 하드 스위칭이 나지 않는다** — 입력 유기 가설과 맞는다. ② 드라이버: f_SU 0.47 W(ΔT_j 56 K)는 1 ms 뿐이라 열적으로 무의미; 연속 최악(264 Vac HB 라인 피크 263 kHz) 0.38 W → T_j 70 + 46 = 116 °C; 피크 전류 0.29 / 0.78 A(한계 1.4 / 1.55 A); 데이터시트 최대 f_SW 800 kHz(1 nF 부하); VCC 18 V 는 권장 10–20 V 안, 절대최대 21 V; 기동 dv/dt 4.5–4.7 V/ns ≪ ±50 V/ns. 게이트는 f_SU 에서 12.5 V(데드타임 420 ns) · 14.4 V(220 ns)까지만 차지만 RDS(on) 규정 10 V 위. ③ 약점 둘 — 기동만의 문제는 하나: **부트 10 Ω × 100 nF 는 첫 LOUT 펄스(370–730 ns)로 C_BOOT 를 5.3–8.8 V 까지만 채워 첫 HOUT 하나가 UVLO 로 빠질 수 있다**(권장 V_BO ≥ 9.3 V; 두 번째 LOUT 뒤 약 11 V) → 3.3 Ω 이면 첫 펄스로 9.4 V 이상. 다른 하나는 연속 운전: R_on 47 Ω 0603(0.1 W)이 라인 평균 0.12 W(115/230 Vac) · 0.15 W(264 Vac) · 라인 피크 0.17–0.24 W 라 정격 초과 → 1206. 기동의 0.43 W 는 1 ms(0.43 mJ)라 문제 아님. 가정: V_th 4 V(DS 3.5–4.5), 드라이버 R_so / R_si 는 15 V / 단락 전류 최소로 본 상한 10.7 / 9.7 Ω, **기동 중 IC 데드타임은 데이터시트에 없다**(ADT 40–420 ns, 펄스 370 ns 이상에서 ADT 가동) — 420 / 220 ns 두 경우로 봤으니 V_GS 로 실측할 것.

**게이트 펄스가 얼마나 늦어지나 — 저항 · MOSFET 커패시턴스 · 스너버를 넣은 시간 영역 해석(2026-10-21, 사용자)** — `gate_wave.py`(200 W 보드, 탱크 117 nF / 5.7 µH, f_SU 515 kHz; 1차 STO60N045DM9 의 그림 4 · 6 을 벡터로 읽어 넣음). 지금 회로(18 V · 47 Ω / (10 Ω + D) ∥ 47 Ω · D–S 150 pF), IC 에지 기준: **LOUT 하강 → LS 채널 실제 차단 305–328 ns**(드라이버 85 + 게이트 방전 220–243; 6.0 → 5.06 V 밀러 구간만 105 ns) · **HOUT 상승 → HS 채널 켜짐(0.5 A) +293–320 ns, 50 A 능력 +353–380 ns**(운전 180 kHz 에서도 +286–316 ns). RC 하나로 본 `gate_budget`(4 V 까지 117 ns + 85)보다 약 100 ns 늦다 — 이 MOSFET 은 그림 4 에서 5.0 V 에 0.3 A · 6.0 V 에 22 A 라 실제 도통이 5.06 V 부터이고, V_DS ≈ 0 의 입력 C 가 7.2 nF(C_gd 2.4 nF 포함)이며, 데드타임 420 ns 면 HS 게이트가 앞선 전이의 dv/dt 로 −1.4 V 에서 출발한다. 두 에지가 거의 같이 늦어서 전력단의 데드타임은 IC 값과 10–20 ns 안으로 같다. 기동 스위칭 전류 15.7 A(정상 상태, 라인 피크)에서 **HS 채널이 켜질 때 V_DS −0.9~−1.4 V(바디 다이오드 도통, ZVS)** 이고 전류 반전까지 여유는 데드타임 420 ns 에서 62–69 ns · 220 ns 에서 255–261 ns(22 Ω 1206 안: 138–145 / 326–332 ns). **스너버 150 pF 는 게이트 타이밍을 거의 안 바꾸고(±3 ns) 중점 최대 dv/dt 를 반으로 줄인다**: 기동 FB 40 → 22 V/ns, 기동 230 Vac HB **54 → 27 V/ns**(L6498LD dV/dt 내성 ±50 V/ns — 스너버가 없으면 넘는다), 운전 18 → 9.5 V/ns; E_off 는 4–13 % 감소(기동 10.1 → 9.7 µJ FB, 12.0 → 10.5 µJ HB; 운전 3.3 µJ). 470 pF · 1 nF 는 dv/dt 12 · 6.5 V/ns, 전이 10–90 % 27 · 36 ns. 입력 RLC 필터는 HIN · LIN 에 같은 지연을 더하므로 이 여유를 먹지 않는다(문턱 비대칭 16–31 ns 는 데드타임을 줄이는 쪽 → 여유는 오히려 는다). 가정: C_oss 를 표의 897 pF 에 맞춰 0.655 배(곡선 그대로면 E_off 약 −20 %, 타이밍 ±5 ns), 드라이버 저항은 상한, 지연 85 ns 는 typ(max 120), 기동 IC 데드타임은 데이터시트에 없어 220 / 420 두 경우, 기동 탱크는 출력 0 V 의 L_r–C_r.

**설계점 개정(2026-10-18, 사용자: "L_r 도 10 µH 로 하고 L_open 도 소수점 없게")** — 변형 `7p5to1_x3m3` 를 **C_r 70.5 nF(TDK C4532C0G2J473J320KA 2S × 3P) · L_r 10 µH · L_m 15 µH(L_open 25 µH) · R_T 7.68 kΩ(E96) · C_T 470 pF** 로 다시 빌드했다(mismatches 0 · check_sm OK · **71/75**, 미달은 그대로 k.CVCC 0.833 · k.Ploss · k.auxr · k.lam). 세트 10 / 25 µH 라 유닛은 **3.33 / 8.33 µH** — 둘 다 정수로 하려면 L_r 9 µH(3.00 / 8.00)인데 70.5 nF 에선 f_r 199.8 kHz · k.ZVS 1.54 · k.floor 1.035 로 여유가 줄어 10 µH 를 택했다(75 nF 에서라면 9/15 가 8.00/3.00 에 71/75 · k.ZVS 1.71). 바뀐 값: f_r 192.7 → **189.6 kHz** · f_o 119.9 · f_Min 126.6 → **129.6**(R_T 7.87 → 7.68 k, k.floor 1.056 → **1.081**, R.T_ceil 8.34 k) · f_Max 348.6 · 전부하 f_sw 130–292 kHz · f_SU 527 kHz · Z_0 11.0 → 11.9 Ω · Q_pk 0.93 · k.ZVS 1.73 → **1.72** · k.TTd 1.85 · I_Lm 12.8 A · B_pk 73.3 mT(A_e 225 자리값) · 1차 10.9 / 18.2 A · 2차(유닛) 9.2 / 31.2 A · I_VCC 175 mA · 개방 시험 17 A. **후보 비교(시험 빌드)**: A 70.5/10/14(L_open 24 → 8.00/3.33) 71/75 이지만 k.floor 1.035 · I_Lm 13.5 A; **B 70.5/10/15 채택**; C 70.5/10/17(27 → 9.00/3.33) k.ZVS 1.32; D 70.5/10/20(30) k.ZVS 0.49 탈락; E 75/10/14 k.dvdt 0.977 탈락. **코너 확인(모두 71/75)**: L_r ±10 %(9 / 11 µH) k.ZVS 1.54 / 1.90; L_open ±10 %(9/13.5 · 11/16.5) k.floor 1.025 / 1.133(R_T 7.87 이었으면 1.002); 누설 범위 L_r 8 µH(C_r 88.1 nF 재중심) · 11 µH(64.1) 71/75 → 사양서의 2.67–3.67 µH 문구 유지. 시트 · 사양서 재빌드 완료(파일 표). 이전 단락들의 75 / 9.1 / 15 · f_r 193 · 3.03 µH 는 10-17 상태다.

**본사 EVL6790_670W(48 V / 14 A) 탱크와 비교(2026-10-17)** — 사용자 전언 "66 nF · 11 · 22 µH" 를 `EVB Schematic/MOTHER B_EVL6790_670W_REV1` 로 확인했다(HISTORY §5.1 의 역산과 같다). T1 TL301698A-003 옆 PARAMETERS 주석: **L_r 11 µH · L_m 22 µH · n 3.2 · n_as 0.33 · I_pri 9.67 A rms / 17.63 A pk · I_sec 16.30 A rms / 56.41 A pk**. 공진 커패시터는 C9 · C12 · C13 **33 nF(B32652A0333J000, 필름) 3개 병렬 = 99 nF**("3 in parallel × current rating" — 66 nF 는 두 개만 센 값). → **f_r 152.5 kHz · f_o 88.1 kHz · λ 0.50 · Z_0 10.5 Ω**. n 3.2 를 ST 툴 표기대로 유효비로 보면(툴은 F9 "n" 이 유효비, D51 "n.T" 가 실권선비; 반사 전압 154 V 가 우리 148 V 와 같은 급이라는 CLAUDE.md 의 비교와도 맞다) Q.pk 0.74 · 코너 필요 게인 1.254 · FHA 피크 1.389 · **여유 +10.8 %** · I_m 11.4 A. 도터보드 R_T 13 k · C_T 470 p → f_Min 78.6 kHz(f_o 의 0.89배 — 우리 k.floor 규칙과 달리 f_o 아래) · f_Max 309 kHz. 즉 본사도 λ 0.5 · Z_0 ≈ 10.5 Ω 급이고 우리와의 차이는 **주파수(152.5 vs 193 kHz)** 다. 같은 정규화 설계(λ 0.5 · Z_0 11.0 · Q 0.78)를 193 kHz 로 옮긴 후보 D(75 nF / 9.1 / 18.2 µH, R_T 8.3 k)를 빌더로 돌리면 71/75 이지만 **k.ZVS 1.058 · k.TTd 1.011** 의 턱걸이(I_Lm 10.9 A · I_pri 라인주기 10.47 A)다 — T.ZC 가 1/f 라 193 kHz 에선 152.5 kHz 보다 시간 여유가 21 % 적다. 그래서 λ 0.607 로 피크 여유를 더 산 **B(k.ZVS 1.73)를 유지**한다(I_m 1.9 A 더, 도통 약 1 W). 본사처럼 152 kHz 로 내리면 B_pk 72 → 91 mT 로 철손 약 1.8배(≈ 7 W)라 2 T 2차에선 택하지 않는다. 같은 잣대의 다른 안: 첫 M3 68/10/20 여유 +3.2 %(k.ZVS 0.29) · C 68/10/16 +13.1 % · 정본 PQ50 +9.5 % · ST 원본 워크북(100/11/24, n 7.45) +18.9 %. 남은 미확정은 HISTORY §5.1 그대로 n 3.2 가 유효비인지 실권선비인지(트랜스포머 실측으로 판정).

**미결**: ① 보빈 창 실측 → 코어 확정 ② 누설 실측 → C_r(150 ↔ 120 nF) ③ k.CVCC 0.997 → C_VCC 1000 → 1200 µF 검토 ④ aux 4 T 의 유닛 배분(2+1+1 또는 한 유닛) · R_ZCD,H 재계산(지금 보드는 aux/sec 1.5 에 360 k) ⑤ 벤더 사양서 `build_trans_spec.py 7p5to1_x3lf` 는 코어 확정 뒤 ⑥ (x3m3, 2026-10-18) TPH3R70APL1 데이터시트 — Q_g · C_iss · R_thJA · k_T 를 모른다, 시트의 그 행들은 STL160N10F8 값 그대로 ⑦ (x3m3) c.HB 3329 pF 는 D–S 150 pF 가 670 W 보드에도 실장된다는 가정 — 보드 확정 뒤 다시 ⑧ 두 워크북이 아직 다른 보드 선택: 브릿지(GBU1006 × 2 vs GBJ1506U) · BM 접지(0 vs 75 W / 30 k) · R_CFG(13 vs 30 k) · ZCD 분압(360 k · aux/sec 1.5 vs 220 k · 1.0 — 트랜스포머가 정한다).

**워크북의 자화 전류 · 합성 피크**: ST 원본에도 `CC!C28:E28` "Ilm.pk.tsw (trapezoidal)" = n·V_out/(4·L_m·f_sw,s)(V_in,min 의 θ = π/4 · π/3 · π/2)가 있다. 원본에 **없는** 것은 위상을 넣은 합성 피크 — 원본 `Device Setting!D32 = CC!E27`(부하 성분만)이고, rev0_6 의 D32 가 `IF(2·E28/(π·E27) ≥ 1, E28, E28·(2·acos(−2·E28/(π·E27))/π − 1) + E27·√(1 − (2·E28/(π·E27))²))`(가이드 식 [79], `l6790.py` 의 `comp`) 로 바꿨고 k.OCP1(D50) 과 MOSFET 정격(Power Components C65)이 이것을 읽는다. 다른 판의 ST 워크북에 옮길 때 이 세 셀을 넣으면 된다.

## 설계점(2026-10-01 시점의 `docs/DESIGN.md` §3 그대로)

```
탱크     Cr 100 nF · Lr 11 μH · Lm 20 μH · λ_act 0.55 · fr 151.8 kHz · fo 90.4 kHz
         Q_pk 0.765 · R_ac 13.7 Ω · n 6.024 · n_T 7.5
주파수   f_sw HB코너 127.1 kHz · f_sw FB코너 249 kHz · T_ZC 460 ns · k_ZVS 2.091
전류     I_sec,pk 98.6 A · I_Lr,pk 18.32 A · I_trafo,pk 16.37 A · I_Lm,pk 12.41 A
         I_pri,rms 13.76 A · I_pri,라인 10.91 A · I_diode 28.34 A · I_Cout 30.24 A
출력     Cout 개당 470 μF · 개수 160 · Cout 합계 75.2 mF · 리플 1.184 V · 리플 4.74 %
         홀드업 13.42 ms · k_hold 1.119
자기     직렬 개수 3 · Np 5 · Ns 2 · A_L 413 nH · B_pk 182 mT · A_e 필요 103 · 개방시험 전류 15.6 A
IC       R_CS 24 mohm · 개당 120 mohm · 병렬 5 · I_OCP1 22.9 A · k_OCP 1.251
         R_T 11 kohm · C_T 470 pF · f_Min 92.2 kHz · f_Max 319.6 kHz
         R_CFG 30 kohm · V_BO 84.85 V · R_BM 30 kohm · C_in 2200 nF · n_aux/n_sec 1
루프     f_cross 17.57 Hz · Φ_M 49.64 ° · 3차 고조파 4.23 %
보상망   R_I 100 kohm · R_o 11 kohm · R_P 1.3 kohm · R_B 6.2 kohm · V_Z 12 V
         C_Fo 82 nF · C_F 560 nF · R_F 47 kohm · C_fx 1.55 nF
VCC      보조권선 유닛당 1 T(둘만 직렬 = 2 T) · 제너 15 V · R_BZ 820 Ω · C_VCC 680 μF · V_CC,reg 13.6 V
```

## 트랜스포머 수입 검사(유닛 하나, 1차 단자 1–2, LCR 100 kHz / 1 V, 직렬 등가 L_s)

| 항목 | 요구 | 조건 |
| :-- | --: | :-- |
| L_open | 10.33 µH ±10 % | 나머지 권선 전부 Open. 3개 직렬 = 31 µH(L_r + L_m) |
| 누설 | 3.67 µH ±10 % | **2차 둘 다 Short**(NS2 3–5 + NS3 4–6), NAUX a–b Open. 3개 직렬 = 11 µH = L_r. 반쪽 하나만 Short 한 값은 이보다 높게 나오고 기록만 한다 |
| DC overlap | 16 A 에서 초기 인덕턴스의 90 % 이상 | 상온 |
| 권선비 · 극성 | 3–5, 4–6 각각 1차의 2/5; 4·5 를 잇고 3–6 이 그 두 배 | 0 근처면 반쪽이 거꾸로 |
| 센터탭 | 보드에서 4·5 연결 | 트랜스포머 안에서 잇지 않는다 |

공진으로 확인하면(C_r 100 nF): 2차 Short 에서 f_r 151.8 kHz, 전부 Open 에서 f_o 90.4 kHz. 세 유닛을 직렬로 이은 채 잰다.

## 이 보드에 지금 문서가 맞지 않는 것

- 정본 시트 · 워크북 · AN(영문 · 한국어)은 전부 **PQ 50/50 한 개, C_r 180 nF · L_r 25 · L_m 45 µH · R_T 21.5 kΩ** 기준이다. 판정 여유 · 주파수 · 탱크 전류가 다르다. 이 보드의 숫자는 위 블록과 되살린 시트에서 읽는다.
- 81–84차에 확정한 부품(STO60N045DM9 · L6498LD · 턴오프 경로 · STL160N10F8 · TEA2095TE 전원 · FZT651 · BZT52H-C15 · R_BZ 560 Ω · C_VCC 1000 µF)은 PQ50 탱크로 계산한 것이다. 옛 보드의 f_Max 319.6 kHz 에서는 게이트 전류 N_sw·Q_g·f 가 2.6 배 크므로 I_VCC · R_BZ · C_VCC · P_drv · V_BO 를 옛 시트 §14c 의 값(R_BZ 820 · C_VCC 680, Q_g 78.6 nC typ 가정)으로 봐야 하고, 드라이버 · SR 판정은 아예 없다.
- 벤치 측정 항목(AN 7.32)과 접지 · 프로브 규칙은 두 보드에 같다. 모핑 경계 235/245 V_pk, 등가 입력 173.2–332.3 Vac 도 같다.
