yohan924-ops/L6790A-Single-Stage-PFC-LLC-Converter/Calculation Excel Sheet/variants/Transformer_Spec_7p5to1_x3m3_KR.xlsx

트랜스포머 요구사양서
권선비 NP1 : NS2 : NS3 : NAUX = 5 : 2 : 2 : 1
1. 구조
• 납작한(저배) 구조. 전체 높이는 첫 샘플 전에 협의.
2. 권선 사양
번호 | 권선 | S → F | 턴수 | 선재 (구리 단면) | 위치
1 | NP1 1차 | 1 → 2 | 5 T | Litz ø0.10 × 370 (2.91 mm²) | 1차 구역
2 | NS2 2차 A | 3 → 5 | 2 T | Litz ø0.10 × 320 (2.51 mm²) | 2차 구역, NS3 와 함께 (bifilar)
3 | NS3 2차 B | 4 → 6 | 2 T | Litz ø0.10 × 320 (2.51 mm²) | 2차 구역, NS2 와 함께 (bifilar)
4 | NAUX 보조 | a → b | 1 T | 단선 ø0.40 (0.13 mm²) | 2차 구역, NS2 · NS3 옆
동등 선재 가능: 구리 단면 표 이상 · 소선 ≤ ø0.10 mm; NS2 · NS3 는 두께 ≤ 0.20 mm 동박도 가능.
3. 전기 요구사양
측정: LCR 미터, 100 kHz / 1 V.
번호 | 항목 | 단자 | 요구값 |  | 조건
1 | 인덕턴스 | 1 – 2 | 8.33 µH ±10 % |  | 다른 권선 개방
2 | 누설 인덕턴스 | 1 – 2 | 3.33 µH ±10 % |  | NS2 단락(NS3 · NAUX 개방); 이어서 NS3 단락(NS2 · NAUX 개방) — 둘 다
3 | DC 중첩(포화) | 1 – 2 | 초기 인덕턴스의 90 % 이상 |  | 17 A dc, 상온
항목 2: 샘플 전에 알리면 2.67–3.67 µH 까지 가능, 그때 ±10 % 는 알린 값 기준.
4. 동작 조건
• | 권선 주파수 |  | 130 – 292 kHz
• | 권선 전류 NP1 |  | 10.9 A rms / 18.2 A peak
• | 권선 전류 NS2, NS3 |  | 9.2 A rms / 31.2 A peak
• | 권선 전류 NAUX |  | 175 mA dc
• | 코어 유효 단면적 |  | Ae ≥ 220 mm²
