yohan924-ops/L6790A-Single-Stage-PFC-LLC-Converter/Calculation Excel Sheet/GUIDE_PQ50_657W_workbook_rev0_6_unencrypted.xlsx

Sheet: CHANGELOG_rev0_6
L6790 design spreadsheet r1.0 - corrections applied (design guide rev 0.6)
Every change below is documented as a cell comment in place. Open in Excel and press Ctrl+Alt+F9 to force a full recalculation.
Sheet | Cell | Was | Now | Why
Design Spec | D20 | =IF('Design Spec'!D80=0,IF(2*D13>IF(165>D14/2,165,D14/2),_xlfn.CONCAT(IF(165>D14/2,165,_xlfn.FLOOR.MATH(D14/2)),"-",2*D13),2*D13),D13) | =MIN(2*D13,245/SQRT(2)) | C.8 : with morphing the worst LOW equivalent input is the HB side of the morphing threshold, VHVPK_BIH/sqrt2 = 173.24 Vac - not a 165..180 range.
Design Spec | F20 | 180 | =D20 | C.8 : selected value must follow the corrected D20 (173.24 Vac).
Design Spec | D81 | None | =2*235/SQRT(2) | C.8 NEW : highest equivalent input = FB side of the morphing threshold, 2*VHVPK_BOH/sqrt2 = 332.34 Vac. This corner fixes the MAXIMUM operating frequency (240.9 kHz), which the tool never evaluates.
Res. Tank Design | D9 | =(SQRT(2)*'Design Spec'!D89)/(2*(('Design Spec'!D95+'Design Spec'!D107*'Design Spec'!D106)/'Design Spec'!D107)) | =(SQRT(2)*'Design Spec'!D89)/(2*('Design Spec'!D95+'Design Spec'!D107*'Design Spec'!D106)) | C.5 : the rectifier drop is already counted Nrect times in the numerator; dividing by Nrect again doubles n. Physical Np/Ns = n*Vo.eff/(Vout+Nrect*Vrect).
Res. Tank Design | F9 | 5 | 2.5 | C.5 : selected turns ratio follows the corrected D9 (2.519 -> 2.5).
Res. Tank Design | D10 | =2*IF(F9,F9,D9)*(('Design Spec'!D95+'Design Spec'!D107*'Design Spec'!D106)/'Design Spec'!D107)/(SQRT(2)*'Design Spec'!D83) | =2*IF(F9,F9,D9)*(('Design Spec'!D95+'Design Spec'!D107*'Design Spec'!D106))/(SQRT(2)*'Design Spec'!D83) | C.5 : reflected output voltage is (Vout+Nrect*Vrect), not divided by Nrect.
Res. Tank Design | D11 | =2*IF(F9,F9,D9)*(('Design Spec'!D95+'Design Spec'!D107*'Design Spec'!D106)/'Design Spec'!D107)/(SQRT(2)*'Design Spec'!D79) | =2*IF(F9,F9,D9)*(('Design Spec'!D95+'Design Spec'!D107*'Design Spec'!D106))/(SQRT(2)*'Design Spec'!D79) | C.5 : reflected output voltage is (Vout+Nrect*Vrect), not divided by Nrect.
Res. Tank Design | D17 | =((IF(F9,F9,D9))^2)*(4/((PI())^2))*(((('Design Spec'!D95+'Design Spec'!D107*'Design Spec'!D106)/'Design Spec'!D107)^2)/('Preliminary Calculation'!D10)) | =((IF(F9,F9,D9))^2)*(4/((PI())^2))*(((('Design Spec'!D95+'Design Spec'!D107*'Design Spec'!D106))^2)/('Preliminary Calculation'!D10)) | C.5 : reflected output voltage is (Vout+Nrect*Vrect), not divided by Nrect.
Res. Tank Design | D20 | =((SQRT((D16*(1+D16))))/(2*IF(F9,F9,D9)))*((SQRT(2)*'Design Spec'!D83)/((('Design Spec'!D95+'Design Spec'!D107*'Design Spec'!D106)/'Design Spec'!D107))) | =((SQRT((D16*(1+D16))))/(2*IF(F9,F9,D9)))*((SQRT(2)*'Design Spec'!D83)/((('Design Spec'!D95+'Design Spec'!D107*'Design Spec'!D106)))) | C.5 : reflected output voltage is (Vout+Nrect*Vrect), not divided by Nrect.
Res. Tank Design | D35 | =(PI()*'Design Spec'!D98)/(SQRT(2)*('Preliminary Calculation'!D17/100)*'Design Spec'!D83*COS('Res. Tank Design'!D29)) | =(2*PI()*'Design Spec'!D98)/(SQRT(2)*('Preliminary Calculation'!D17/100)*'Design Spec'!D83*COS('Res. Tank Design'!D29)) | C.6 : at the line peak the instantaneous tank power is 2*Pout, not Pout. The tool value is exactly half.
Res. Tank Design | D60 | =(SQRT(2*(('Design Spec'!D111*(10^-12))/((IF(F44,F44,D44)+IF(F45,F45,D45))*(10^-6)))))*('Design Spec'!D83) | =(SQRT(2*(('Design Spec'!D111*(10^-12))/((IF(F44,F44,D44)+IF(F45,F45,D45))*(10^-6)))))*(SQRT(2)*'Design Spec'!D83) | C.6 : Vin must be the PEAK, not the rms value.
Device Setting | D3 | =MIN('Design Spec'!D104,D2*1.5) | =MAX(D2,MIN('Design Spec'!D104,D2*1.5)) | NEW (guide eq.[62]) : the outer MAX was missing, so the oscillator could be sized for a ceiling BELOW the real maximum operating frequency.
Device Setting | D83 | =D74/((D79/'Design Spec'!D107)) | =D74/D79 | C.8 : the same sheet computes V.aux.OVP2 WITHOUT dividing by Nrect, so the limit was 2x too permissive. Correct upper bound = V.AUX.max / V.OVP2.out.
Preliminary Calculation | D17 | =('Design Spec'!D98)/('Design Spec'!D98+('Preliminary Calculation'!D13+'Preliminary Calculation'!D12))*100 | =D9/(D9+D13)*100 | NEW : D17 is used downstream AS eta.HB, but computed Pout/(Pout+Pd.rect+Pd.LLC) = eta.rect*eta.HB. Identical only while Vrect = 0.
Preliminary Calculation | D19 | =D17*D18/100 | =D17*D8/100*D18/100 | NEW : keep eta.tot = eta.HB * eta.rect * eta.ac after the D17 correction.
CC | C25 | =IF('Design Spec'!$D$107=1,C24/2,C24/SQRT(2)) | =IF('Design Spec'!$D$107=1,C24*SQRT(MIN(C21,C22)/C22/4),C24*SQRT(MIN(C21,C22)/C22/2)) | C.8 : below resonance the secondary current is a half-sine that flows only for 1/(2*fr) of each half period; the rms therefore carries sqrt(d), d = min(fsw,fr)/fr. The same sheet already applies d in row 31.
CC | D25 | =IF('Design Spec'!$D$107=1,D24/2,D24/SQRT(2)) | =IF('Design Spec'!$D$107=1,D24*SQRT(MIN(D21,D22)/D22/4),D24*SQRT(MIN(D21,D22)/D22/2)) | C.8 : below resonance the secondary current is a half-sine that flows only for 1/(2*fr) of each half period; the rms therefore carries sqrt(d), d = min(fsw,fr)/fr. The same sheet already applies d in row 31.
CC | E25 | =IF('Design Spec'!$D$107=1,E24/2,E24/SQRT(2)) | =IF('Design Spec'!$D$107=1,E24*SQRT(MIN(E21,E22)/E22/4),E24*SQRT(MIN(E21,E22)/E22/2)) | C.8 : below resonance the secondary current is a half-sine that flows only for 1/(2*fr) of each half period; the rms therefore carries sqrt(d), d = min(fsw,fr)/fr. The same sheet already applies d in row 31.
CC | C26 | =IF('Design Spec'!$D$107=1,C25,C25/SQRT(2)) | =IF('Design Spec'!$D$107=1,C25,C25/SQRT(2)) | C.6 : referenced D108 (Vf.BR) instead of D107 (rectifier configuration).
CC | D26 | =IF('Design Spec'!$D$108=1,D25,D25/SQRT(2)) | =IF('Design Spec'!$D$107=1,D25,D25/SQRT(2)) | C.6 : referenced D108 (Vf.BR) instead of D107 (rectifier configuration).
CC | E26 | =IF('Design Spec'!$D$108=1,E25,E25/SQRT(2)) | =IF('Design Spec'!$D$107=1,E25,E25/SQRT(2)) | C.6 : referenced D108 (Vf.BR) instead of D107 (rectifier configuration).
CC | C31 | =SQRT(0.5*IF(C21>C22,C22,C21)/C22*(C24^2)-C23^2) | =SQRT(0.5*MIN(C21,C22)/C22*(C24^2)-C23^2+C15^2/2) | C.8 : row 31 held only the switching-frequency component at ONE line phase. The output bank also carries the whole 2*fl buffer current, Iout/sqrt2. NOTE: still a single-phase estimate - the guide value 4.72 A comes from a full theta average, eq.[70a].
CC | D31 | None | =SQRT(0.5*MIN(D21,D22)/D22*(D24^2)-D23^2+D15^2/2) | C.8 : row 31 held only the switching-frequency component at ONE line phase. The output bank also carries the whole 2*fl buffer current, Iout/sqrt2. NOTE: still a single-phase estimate - the guide value 4.72 A comes from a full theta average, eq.[70a].
CC | E31 | None | =SQRT(0.5*MIN(E21,E22)/E22*(E24^2)-E23^2+E15^2/2) | C.8 : row 31 held only the switching-frequency component at ONE line phase. The output bank also carries the whole 2*fl buffer current, Iout/sqrt2. NOTE: still a single-phase estimate - the guide value 4.72 A comes from a full theta average, eq.[70a].
CompensationNet&Check | D15 | =300/D31 | 300 | C.8 : I.FB.max is the 300 uA datasheet minimum. D43 divides by CTR again, so CTR was applied twice (300 -> 566 -> 1068 uA).
CompensationNet&Check | D42 | =(D14-(D22+D28))/(((D16*10^-6)/D29)+(D23*10^-3))/1000 | =(D14-(D22+D28))/(((D16*10^-6)/D29)+(D28/(F41*1000)))/1000 | NEW / DS 5.2.12 : the denominator term is V_F/R_P, not I.min. They coincide only when R_P is chosen exactly at R_P,max.
CompensationNet&Check | D43 | =(D14-(D22+D28))/(((D15*10^-6)/D31)+(D23*10^-3))/1000 | =(D14-(D22+D28))/(((D15*10^-6)/D31)+(D28/(F41*1000)))/1000 | C.8 + DS 5.2.12 : CTR applied once, and V_F/R_P instead of I.min.
CompensationNet&Check | F43 | 4.7 | 6.8 | C.8 : with the corrected window 6.27..7.13 kOhm, 4.7 kOhm is outside.
Power Components | D40 | =D28*D28*(((2*PI()*CC!C21*1000*D38*10^-6)/(D36/100))+(D27/1000)^-1)^-1 | =D28*D28*(((2*PI()*CC!E21*1000*D38*10^-6)/(D36/100))+(D27/1000)^-1)^-1 | C.8 : D37/D39 use fsw at theta=pi/2 (CC!E21) but D40 used CC!C21 (theta=pi/4).
RTC | 2803 cells, rows 16-18, 41-46, 53-58, 67-72, 81-86, 95-107 | (Vout+Nrect*Vrect)/Nrect | (Vout+Nrect*Vrect) | C.5 propagated. The RTC gain and Q grid carries its own copy of the reflected output voltage and divided it by Nrect a second time. Left unfixed, the corrected n = 2.5 halves every gain in the grid and the whole sheet returns #NUM.
NOT fixable by a cell edit - structural limits of the workbook
RTC!25/26 - the fn search grid stops at fn.max = sqrt(lambda/(1+lambda-1/M.Vmax.pk)) = 1.3703 (205.9 kHz). The real full-load operating point at the FB morphing threshold sits at fn = 1.603 (240.9 kHz) and simply cannot be represented. Device Setting!D2 therefore still reports 187 kHz.
CC rows 20-31 evaluate only theta = pi/4, pi/3, pi/2. Eq.[70a] (output-capacitor rms) and the mains-cycle rms currents need an average over the whole half line cycle.
Design Spec!D33/34/37 - the OutCap_Sel_DB auto-selection result is referenced by no cell; Power Components uses manual entries only, with no warning when the two disagree.
Design Spec!D48 (Cp = 2 nF) is a dead input cell, referenced nowhere.
Power Components!D77 - C.tot = 2*Coss + Cpar is never fed back into Design Spec!D46 (c.HB), so eq.[116] iteration does not happen.
Device Setting!B113 - the 'Split resonant capacitors for forced HB configuration' clause has a heading but no content (DS 5.3.1 requires two Cr/2 capacitors in that configuration).
Res. Tank Design!D9 vs D51 - n is labelled 'Physical Turn Ratio' and n.T 'Real Turn Ratio' at the same time. Only one of them can be the ratio you actually wind (guide 3.10).
ADDED 2026-08-21 - ISEN (pin 6) block, guide eq. [79] [81] [84]. None of these five were touched by rev 0.6.
Device Setting | D32 | =CC!E27 (= I.trafo.pk only) | =IF(z>=1,CC!E28,CC!E28*(2*ACOS(-z)/PI()-1)+CC!E27*SQRT(1-z^2)), z=2*CC!E28/(PI()*CC!E27) | C.14 (guide eq.[79]): R.CS is in the bridge return and sees the COMPOSITE tank current, load component plus magnetizing component. The cell is named Ilr.pk.max but was wired to I.trafo.pk, which is about 10 % low, so R.CS.max2 came out about 10 % too permissive. Closed form: the peak of I.Lm.pk*(2x-1)+I.trafo.pk*sin(pi*x) is at cos(pi*x)=-z.
Device Setting | D33 | =MAX(CC!C29,'Preliminary Calculation'!D11) | =MAX(CC!E29,'Preliminary Calculation'!D11) | C.16: CC!C29 is the switching-period rms at theta = pi/4 only - neither the line-cycle rms (the physically correct basis for dissipation) nor the worst switching period. Guide eq.[81] and its worked example use the worst switching period, CC!E29 at theta = pi/2. Conservative, and it makes the parallel-resistor count honest.
Device Setting | D45 | =D43*(3/220+1/440)^-1 (= 188.571 mOhm, constant) | =D44 | C.15: this was not a calculation. (3/220+1/440)^-1 = 62.857 mOhm is the EVL board network 220||220||220||(220+220) written as a conductance sum; multiplying by D43 only cancelled the /D43 on the next row, so R.CS stayed 62.857 mOhm whatever the design. It also exceeded its own ceiling D44 without any warning once the spec changed. D45 is now the calculated maximum single resistor and F45 holds the selection.
Device Setting | F45 / D43 / D46 | text "220||220||220||(220+220)" / 3 / =D45/D43 | 120 (mOhm) / 5 / =IF(ISNUMBER(F45),F45,D45)/D43 | F45 is now a numeric selected value, following the IF(selected,selected,calculated) idiom used everywhere else in this workbook. 5 x 120 mOhm = 24.0 mOhm, which is below D38 and matches the SMath design sheet. Note the old network was NOT three equal resistors: it was five 220 mOhm parts (three single + two in series, equivalent to 3.5 in parallel) sharing power 28.6 / 28.6 / 28.6 / 7.1 / 7.1 %, so the "N identical resistors" model behind D46 never described it.
Device Setting | F61 | 78 (kOhm) | 30 (kOhm) | Consequence of the R.CS correction, not an independent change: D61 R.BM.max = 16.7*(P.in.BM*R.CS) is proportional to R.CS, so it fell from 78.7 to 30.1 kOhm. Leaving 78 kOhm would have moved the burst entry to 195 W. 30 kOhm reproduces the D57 = 75 W that was already selected. NOTE: D57 = 75 W is itself a leftover from the 240 W example - it is 11 % of P.in here, not the 30 % it was there.
Device Setting | D45 / B45 | =D44 (122.668 mOhm) | =LOOKUP(D44/10^INT(LOG10(D44)),{E24 mantissas})*10^INT(LOG10(D44)) | D44 is the ceiling, not a part number - 122.668 mOhm cannot be bought. D45 now reports the largest E24 value at or below it (120 mOhm), so the row reads as a suggestion and F45 stays the place where the real choice goes. D46 already takes IF(ISNUMBER(F45),F45,D45)/D43, so leaving F45 empty falls back on the suggestion.
BOM&Schematics | C19:G22 | the capacitor bank was one row holding only the SINGLE value (680 uF), with the count on its own line and no total anywhere; a first fix put Count/TOTAL in H/I, which sits under the Power Part Schematics picture and overwrote the column G source hint | four rows inside the existing C..F table: single, count, TOTAL (= E19*E20/1000, in mF) and the ceramic. The blank row 22 is used so no row is inserted and nothing below moves | A bank is only defined by single x count = total. Column G carries =IF(E..,"","<source sheet>") on every row of this sheet and must not be taken.
BOM&Schematics | F44 / F38 | C.f unit "uF"; number of sense resistors unit "mOhm" | C.f unit "nF"; count unit "-" | Labelling errors. C.f is 200 nF everywhere else (CompensationNet&Check F94) and D38 is a count.
CompensationNet&Check | F43 | 16 kOhm - BELOW its own D43 minimum of 16.024 kOhm | 16.5 kOhm | Outside the D42..D43 window the FB anti-saturation circuit loses its linear range. 16.5 k sits inside 16.02..18.22 k with 3 % margin at the bottom and 10 % at the top.
Device Setting | F108 | 32 kOhm - V.BO = 90.5 V, ABOVE V.AC_min = 90 V | 30 kOhm - V.BO = 84.9 V | D108 gives 31.82 k as the ceiling for a 90 V brown-out point. At 32 k the converter browns out at minimum line. 30 k also keeps CFG inside the 15..47 k morphing window.
Res. Tank Design / Power Components | C65 C67 C60 C61 C84 C85 / F60 F61 F84 F85 / D78 D100 | CC!C25/C26/C29/C30 (a SINGLE point, theta=pi/4) were labelled "mains cycle" rms, and those values fed the semiconductor loss calculations directly. | Relabelled "@theta=pi/4 (approx.)", and added yellow input cells in column F carrying the line-cycle rms from the SMath sheet (F60 10.90 / F61 7.707 / F84 and F85 28.31 A). The loss formulas D78 and D100 prefer the selected value via IF(ISNUMBER(F..),F..,D..). | theta=pi/4 equals the line-cycle rms only if the envelope is sin(theta). The real envelope is sin^2(theta), so the primary is understated by 5.9 % and the secondary by 17.6 %; loss goes as the square, so rectifier loss is out by a factor 1.38 (7.93 -> 10.98 W, required Rth 12.60 -> 9.11 C/W). The CC sheet had only three theta columns, too few to integrate, so the SMath figures were imported. HISTORY.md C.18
CompensationNet&Check | H132:AV167 (196 cells) | The high-frequency pole f_px is computed in D104 and then referenced by no loop-verification formula at all. Gain, phase and crossover were built from f_z and f_p alone. | Inserted the f_px term into 196 cells: /(1+(f/f_px)^2) into the 120 gain formulas, -ATAN(f/f_px) into the 76 phase formulas. | Phase near crossover came out 0.8 to 1.1 degrees optimistic. In a design whose margin sits close to 45 degrees that can invert the verdict. Appendix C.12
CompensationNet&Check | D73 | Labelled "Required E/A Gain @ 2fL,min", but the denominator was D65 - the ripple at the NOMINAL line frequency. D68 computes the f_l,min ripple and was never referenced. | Denominator changed to D68. | 50/47 = 1.064x optimistic. The error propagates EA_o -> f_MB -> f_z -> C_Fo -> R_F, moving the compensation values by 3 to 6 %. Where a line-frequency RANGE is specified, the minimum is the worst case. Appendix C.13
Design Spec | D46 · D47 | The ST tool defaults c.HB = 500 pF and t.D = 270 ns were still in place. | c.HB = 800 pF, t.D = 220 ns - the parts actually selected for this design. | The SMath sheet used 800 pF / 220 ns from the start, so the two documents disagreed at the INPUT. Q.ZVS.2 is non-dominant, so the tank does not move; only the T.ZC verdict becomes correct.
Device Setting | D13 | T_idle = 350 ns (the value implied by the C_T,max expression in DS section 5.3.2). | 250 ns - back-solved from all eight cells of the f_osc row of DS Table 5. Now identical to the SMath sheet. | The datasheet implies three different values (700 / 350 / 250 ns). The eight measured cells of Table 5 all land within 0.2 ns of 250.0 ns, so that reading was adopted. The two documents have to agree on the input for the comparison to mean anything. NOT CONFIRMED until measured - re-check the margin at 700 ns too. Appendix C.1
CompensationNet&Check | C130:E134 (new) | Gain margin appears nowhere in the workbook. Only phase margin, in D124. | f.180 = SQRT(f_p*f_px - f_z*(f_p+f_px)) locates arg T = -180 deg in closed form; GM[dB] and the ratio k.GM against target are computed from |T| there. Currently f.180 = 206.0 Hz, GM = 34.3 dB, k.GM = 3.43. | Phase margin alone does not close the stability argument. This compensator has one zero against two poles at high frequency, so the phase heads for -270 deg and arg T crosses -180 at a finite frequency. No bisection is needed - take the tangent, divide through by f, and a single square root remains.
CompensationNet&Check | F41 | R_P selected 1.5 kOhm, while D41 right beside it computes an upper limit of 1.4375 kOhm. The limit is violated by 4.3 %. | 1.4 kOhm (E96) | R_P,max = V_F/I_min [144]. At 1.5 k the shunt-regulator cathode current falls to 1.15/1.5 = 0.767 mA, below the 0.8 mA minimum, and it stops regulating. AN UPPER LIMIT IS ROUNDED DOWN. The 240 W example in the design guide rounds 1.44 up to 1.5 and commits the same violation. Side effect: the R_B window moves from 16.02-18.22 to 15.39-17.41 kOhm; the selected 16.5 k is still inside it (7.2 % low, 5.5 % high). Appendix C.14
Power Components | F7 | C_in selected 2000 nF, while D7 computes a lower limit of 2054.32 nF. Short by 2.6 %. | 2200 nF (E6) | 3 nF/W is a FLOOR. Below it the differential attenuation of the EMI filter is insufficient.
Device Setting | C24 | Labelled "RT.min". But f_Min = 1/(2*(C_T*R_T + T_idle)) FALLS as R_T rises, so this value is the R_T at which f_Min exactly equals f_o - and R_T must stay BELOW it. | Relabelled "RT.ceil (NOT a minimum)". | Read as labelled, a designer rounds R_T up, the VCO clamp drops below f_o, and entry into the capacitive region is left to the ACP protection alone - which the design rules explicitly forbid. The selected 11 kOhm is below the 11.02 k ceiling, so the direction is right.
Device Setting | C22 C25 C84 (new) | The C_T design ceiling (D19) and floor (D20), the R_T ceiling (D24) and the n_aux/n_sec ceiling (D83) are all computed, and no cell compares any of them against the selected value. | Three ratio cells added - k.CT, k.RT.ceil, k.naux (C22, C25, C84). All must read greater than 1. | A limit that is computed but never compared lets a violation pass silently. Same structure as C.15, where the R_CS selection exceeded its own D44 ceiling by 2.6x without a warning. The SMath sheet carries the same checks as k.CTd / k.RTd / k.auxr.
CC | D39 E39 D52 E52 | The same defect C.6 fixed was still present in the 75 % and 50 % load blocks: IF('Design Spec'!$D$108=1,...) reads Vf.BR (0.08 V) instead of the rectifier configuration (D107). 0.08 is never 1, so the condition is always false and the FB branch (/SQRT(2)) runs even in a CT design. | All four cells re-pointed to $D$107. | The C.6 fix in rev 0.6 was applied to the 100 % load block (row 26) only and missed the other two. Nothing currently reads rows 34-54, so there is no numerical impact today - which is why it survived. The moment those blocks are used, the per-winding rms comes out 29 % low. Appendix C.25
BOM&Schematics | C55 · C56 | R.ZCD.L (19 k) was described as the "Upper ZCD resistor" and R.ZCD.H (162 k) as the "Lower ZCD resistor". The values and links were right; only the two descriptions were swapped. | "Lower ZCD resistor (to GND)" / "Upper ZCD resistor (to aux winding)" | Built as this BOM reads, the divider ratio is inverted: the OVP1 threshold becomes 2.3/0.8 x (19/162+1) = 3.2 V instead of 27.4 V, and the converter trips into OVP the instant it starts. Appendix C.26
BOM&Schematics | E37 | The formula read 'Device Setting'!D$45, which is the CALCULATED E24 value, and ignored the selected value F45. | =IF('Device Setting'!F45,'Device Setting'!F45,'Device Setting'!D45) | Invisible today because D45 and F45 happen to be 120 mOhm both. Change F45 and the BOM does not follow. The workbook idiom is IF(F,F,D) and every other BOM row uses it. Appendix C.27
Design Spec | C15 · C59 | Two different inputs are both labelled "Config.". D15 selects the input arrangement and feeds only D80; D59 selects the output rectifier configuration and drives 125 cells through D107. | C15 = "Config.mains", C59 = "Config.rect" | Going by the name, a user edits the upper one, changes nothing about the rectifier configuration, and believes they did. The wiring is correct, so only the labels were fixed.
Res. Tank Design | D28 · D29 · D30 | The ZVS check is never recomputed after the tank is selected. D28 re-derives f.n = 0.82111 from the fitted expression [36] (whose exponent 5 has no basis in any ST document); D29 takes the phase at the design ceiling Q_ZVS = 0.8466 rather than the Q the converter runs at; and D30 divides by the TARGET 'Design Spec'!D102 = 150 kHz rather than the real resonant frequency. Result: T_ZC = 303 ns, 34 % below the truth. | The realised values were already inside the workbook - the grid solution RTC!$BB$149 = 0.84006 and RTC!$C$41 = 0.7717. D28 -> RTC!$BB$149, both Q occurrences in D29 -> RTC!$C$41, and the denominator of D30 -> D55 (the real f.r, 151.748 kHz). T_ZC 303 -> 457 ns. The tank-selection path (D26 -> D27 -> D43..D45) was not touched.
CompensationNet&Check | D110 | The verification block carries its own line-frequency input, D110 = 50 Hz, while the design block designs at the worst case of 47 Hz (D7, D68, D73, D83). The design is therefore verified at a gentler line frequency than it was designed for, and D116, AV122, D125, D126, D128 and D129 all come out optimistic. | D110 = 47 (the worst case of the 47-63 Hz specification, matching Design Spec!D17). Third harmonic 3.86 -> 4.31 %, burst FB ripple 47.3 -> 52.9 mV, R_BM adjustment range 2.37 -> 2.65 kohm.
Power Components | D22 · D33 | Hold-up is assumed to start discharging from the nominal output, 25 V (D14). The real output swings 24.41 to 25.59 V on the 2f_L ripple and the AC can be lost at any phase, so the worst case is the ripple trough. Energy goes as V^2, so the result is 12.5 % optimistic. The actual ripple is already in D31, one row below. | D14^2 replaced by (D14-D31/2)^2 in both formulas. Required capacitance 59.77 -> 67.22 mF, achieved hold-up 15.10 -> 13.42 ms. The chain is D22 -> D31 -> D26 -> D23/D24 (selected by hand), so this is not a circular reference.
CC · Res. Tank Design · Power Components | CC F~H 20:31 · CC 32 · CC J · Res.Tank D65 D67 · Power D28 | C.18 - the three currents the design calls line-cycle rms are in fact a single point at theta=pi/4. Res.Tank D65 = CC!C29, D67 = CC!C25 and Power D28 = CC!C31 each read one cell of CC. The output bank ripple current reads 21.77 A where the line-cycle rms is 30.19 A - 28 % low, and that value sets the number of output capacitors. | RTC already solves six theta (pi/12 to pi/2 in 15 deg steps); CC was only reading three of them. Columns F, G and H now take the remaining three from RTC!BC150, BC153 and BC154, row 32 holds the square of the node current, and column J carries a Simpson integral (weights 1,4,2,4,2,4,1 divided by 18). The theta=0 sample is exactly zero because the load goes as sin^2(theta). D65 -> CC!J29, D67 -> CC!J25, Power D28 -> CC!J31. Against a 721-point sweep: secondary -0.04 %, bank ripple -0.08 %, primary -1.83 %. Only the primary keeps a residual, because the magnetising current does not vanish at theta=0; extrapolating the endpoint makes it worse (+4.7 %), and theta -> 0 is burst territory that is never reached.
Power Components | D74 · D75 | The primary switch selection block asks for no body-diode recovery condition. In normal ZVS the body diode conducts only during the dead time and the channel takes the current over at almost zero volts, so no recovery happens; in the CAPACITIVE region the current leads, the opposite device turns on while this diode is still conducting, the diode is hard reverse-recovered, and a shoot-through current crosses the bus. Overload, a load step, low line and start-up all enter that region for a few cycles, so it has to be survivable rather than merely avoided. | D74 = SQRT(2)*Vac,max = 373.4 V (the capacitive region offers no soft transition, so it is the raw rectified line peak); D75 = CC!C28 = the magnetising peak, 12.36 A. No Qrr is assumed - that is a device number. Specify trr and Qrr AT THESE CONDITIONS, not at the datasheet default (usually 25 C and a low dI/dt): Qrr roughly doubles from 25 C to 125 C.
Power Components | D62 · D66 · D68 · D87 · D91 · D103 (new) | Every current in these blocks was per switch POSITION (primary) or per LEG (secondary), and the loss and rating rows then used them as though one device carried the lot. There was no parallel-device count anywhere, so R_DS(on) meant per leg here and per device in the SMath sheet and the two could not be compared. | n.par (D68) = 2 primary devices in parallel per switch position and n.SR (D103) = 3 SR devices in parallel per leg. Four rows carry what ONE device sees: Imos.rms.dev (D62) = 3.854 A and Ilr.pk.dev (D66) = 9.159 A on the primary, Isr.rms.dev (D87) = 9.437 A and Isr.pk.dev (D91) = 32.79 A on the secondary. The loss formulas D78 and D100 are now built on those per-device currents. | n.par = 2 is set by the LOSS budget, not by the current rating: the statically-on device in half-bridge mode carries the whole tank current (10.9 A rms), and at 24 mOhm/25 C - about the best a 600 V superjunction part offers - a single device dissipates 5.7 W against a 3 W budget. CAUTION: these rows assume ideal current sharing. R_DS(on) spread means the hottest device takes more; allow about 20 % when sourcing, or bin the parts.
Power Components | D80 · D98 (new) · D70 · D96 · D78 · D100 · D102 | D78 and D100 computed conduction loss from R_DS(on) at 25 C, and D79 and D101 then asked what R_th holds the junction at 125 C. The numerator and the denominator of the same calculation were at different temperatures. Device data D70 and D96 still held the ST example parts. | kT.pri (D80) = 2.0 and kT.sec (D98) = 1.5 carry the R_DS(on) rise to Tj,max and enter D78 and D100. D70 = 24 mOhm and D96 = 2 mOhm at 25 C, the classes the D65 and D90 requirements ask for. Loss per primary device 2.970 -> 0.713 W with the required Rth 33.7 -> 140 C/W; total rectifier loss 1.603 W, which is what SMath section 13.3 computes. | A limit evaluated at the wrong temperature is not conservative, it is wrong in the dangerous direction - the required R_th was about 2x too generous. KNOWN LIMITATION, unchanged: D78 and D79 describe a SWITCHING device. In half-bridge morphing mode the L6790A holds LOUT2 high, so the low-side device of leg 2 conducts continuously and dissipates twice as much; the workbook has no row for it and SMath section 13.3 does (P.mos_dc). Also unchanged: Tj,max stays a literal 125 inside D79 and D101.
Power Components | D93 (new) · D95 · C67 · C92 | The secondary loss was a DIODE model, Vf*Iavg + rd*Irms^2, and C92 named a Schottky - while this design rectifies synchronously, where the channel carries the current and the forward drop does not apply. C67 and C92 also named parts that meet none of the requirement rows above them. | Conf.SR (D93) selects 1 = diode/Schottky or 2 = SR MOSFET; at 2 the forward-drop term drops out of D100. D95 keeps its value and says in its label that it applies only at Conf.SR = 1. C67 and C92 now state the requirement the part has to meet instead of naming one. | The sheet can express either rectifier now, rather than silently assuming a diode. NOT MODELLED at Conf.SR = 2: the body diode conducts during the SR dead time, and its Qrr is recovered every cycle. Both need an SR dead time the sheet does not have. A part number in a live sheet also has to be re-checked by hand on every input change, and it is the one thing on the sheet no calculation can verify.
Power Components | D65 (primary switch current rating) | The primary switch current rating was 1.3 * CC!E27 = 1.3 * Itrafo.pk = 21.31 A. Itrafo.pk is the REFLECTED LOAD current alone. A bridge switch carries the composite tank current i_Lr, which is the load current plus the magnetizing current, and those two peak at different instants. Guide equation [115] is written the same way. | 1.3 * 'Device Setting'!D32 = 23.81 A. D32 is the composite peak the workbook already solves for the OCP1 setting, and it agrees with the SMath sheet (I.Lr_pk) to five figures. | The rating was 12 % light on the one parameter that decides whether the switch survives an overload. It is also the quantity OCP1 watches, so the protection threshold and the device rating are now derived from the same number instead of two different ones.
RTC | C26:CF26 (82 cells + row 27) | Every cell of row 26 returned #NUM!, and row 27 with it - 164 error cells. fn.max = SQRT(lambda/(1+lambda-1/M)) has no root once M falls below the no-load asymptote 1/(1+lambda) = 0.6452, and cause E moved Vin_max to the FB morphing corner (332.34 Vac equivalent), which took the required gain down to M = 0.6383. | The per-column expression now carries the same guard CG26 already had: IF(1+lambda-1/M>0, SQRT(...), $CG$26). All three shared-formula groups in the row were rewritten as plain formulas so that no master is left pointing at followers with different text. | Nothing read rows 26 or 27 - the grid axis comes from CG25 = 1.5*CG26 by linear interpolation and the answers come from the Cardano block, so no number moves. But 164 visible errors read as a broken workbook and they bury real findings in the audit output. The guard is not a fudge: below the asymptote there is genuinely no no-load crossing, and the ceiling then comes from the loaded curve and from the design f_sw,max, which are the other two terms of the CG26 MAX. Grid top is now f_n = 2.2241 = 337.5 kHz, and f_sw,max 249.6 kHz sits inside it.
CC | C25:H25 · C31:H31 · C32:H32 | [64] takes the secondary rms as Ipk*SQRT(d/4) with d = MIN(fsw,fr)/fr, which clamps to Ipk/2 above resonance - the rms of a FULL half sine. But [63], one row above, computes the peak from a TRUNCATED sine: its 1-COS(PI*fr/fsw) denominator is exactly that truncation. Above resonance the switching half period ends before the resonant half sine does and the current never returns to zero, so the two rows describe different waveforms. | Multiplied the mean square by the truncation factor 1-SIN(2*Dphi)/(2*Dphi), Dphi = PI*fr/MAX(fsw,fr), in rows 25, 31 and 32. Below resonance Dphi = PI and the factor is exactly 1. | NO VALUE IN THIS WORKBOOK CHANGES. CC evaluates at Vin,min, where fsw runs 90.4 to 127.5 kHz and never reaches fr = 151.7 kHz, so the factor is 1 at every theta. At the FB morphing corner, where 56 % of the line cycle is above resonance, the old expression is 8.0 % low on the per-leg rms (23.04 vs 24.89 A) - and 8.4 % low on the guide's 240 W example. Both designs still have their worst secondary rms at LOW line (28.33 A here), so no sizing moves. It matters if a re-spec makes high line the worst corner. The same correction is in l6790.py, the SMath sheet (k.tr) and guide [64a].
Power Components | D60 · D61 · D84 · D85 · F60 · F61 · F84 · F85 | These four read CC!C29, C30, C25 and C26 - the SINGLE theta=pi/4 sample - with a hand-typed yellow override in column F carrying the line-cycle value copied from the SMath sheet. The override dates from before the C.18 fix, which gave CC a Simpson integral in column J and re-pointed Res. Tank Design D65 and D67 and Power Components D28 at it. These four were missed. | D60 -> CC!J29, D61 -> CC!J30, D84 -> CC!J25, D85 -> CC!J26, and the four F overrides cleared so nothing is typed by hand any more. Column C labels now say "line cycle, Simpson" instead of "@theta=pi/4". | This is the C.27 pattern: a typed constant on top of a live reference. Change an input and the J column follows while the typed F cells do not, so the design silently keeps yesterday's numbers. The typed values were rounded as well - 10.9 against 10.8976 and 28.31 against 28.3008 - so the loss and rating rows built on them were out by up to 0.04 %. Nothing moves visibly today because the typed values were correct when they were typed; the point is that they could not stay correct.
Power Components | D82 (new) · D79 | D78 is the loss in a SWITCHING device and D79 sized R_th from it. In half-bridge morphing mode the L6790A holds LOUT2 statically high, so the low-side switch of leg 2 conducts CONTINUOUSLY and carries the whole tank current rather than I/SQRT(2) - twice the loss. The workbook had no row for that device, so its thermal answer was for the cooler of the two. | D82 = D70*D80*(D60/D68)^2, the loss in the statically-on device, and D79 now divides by MAX(D78,D82). With n.par = 1: switching device 2.85 W, static device 5.70 W, required Rth 35.1 -> 17.5 C/W. | This was recorded as a known limitation while n.par = 2 held the static device at 2.85 W. With one device per position it is the binding case, and half-bridge mode is not a corner - it is what the converter runs in on a 220 V mains. NOTE that 5.70 W exceeds the provisional 3 W budget by 1.9x. To meet 3 W the part would need 25.3 mOhm HOT, about 12.6 mOhm at 25 C, and no 600 V superjunction device is made that low - the best available class is 17 to 24 mOhm, which gives 4.04 to 5.70 W. Either the budget rises to about 6 W or that one position needs two devices in parallel. The SMath verdict k.Ploss reports the shortfall as 0.526.
Power Components | D80 · D98 | Both temperature multipliers were set to 1 while D70 and D96 hold the datasheet MAXIMUM R_DS(on). A datasheet maximum covers process spread at T_j = 25 C; it says nothing about temperature. | kT.pri = 2 and kT.sec = 1.5, the usual rise to T_j = 125 C for a 600 V superjunction part and a low-voltage trench SR FET. Read the exact factor off the part's normalized R_DS(on) vs T_j curve and correct these. | With STO60N045DM9 at 45 mOhm max: switching device 2.67 -> 5.35 W, statically-on device 5.34 -> 10.69 W, required Rth 18.7 -> 9.36 C/W. The statically-on device is the one that conducts continuously in half-bridge morphing mode, which is the normal mode on a 220 V mains.
CompensationNet&Check | D28 · F41 · F43 | V.Fo was 1.45 V here and 1.15 V in the SMath sheet. It feeds R.P_max and both ends of the R.B window, and the 20 % it put between them left the two R.B windows DISJOINT - 5.873..6.652 k here against 6.934..8.001 k there - so no resistor value could satisfy both documents. R.P was selected at 1.8 k and R.B at 5.6 k, which violate the SMath limits. | V.Fo = 1.15 V on both. R.P = 1.3 k, below the 1.438 k ceiling. R.B = 6.2 k. NOTE that the R.B window MOVES WITH R.P - V.Fo/R.P sits in its denominator - so bringing R.P down to 1.3 k pulled the window from 6.934..8.001 k to 5.759..6.477 k. 6.2 k is the geometric middle of the window that actually applies. | The loop drives the LED at I.FB/CTR of about 0.55 mA, where an SFH617A sits near 1.1 V; 1.45 V is its drop at tens of milliamps, which this loop never reaches. 1.15 V is also the conservative choice for R.P, whose limit is a MAXIMUM and must be rounded down - at 1.8 k the shunt regulator cathode current falls under its 0.8 mA minimum and it stops regulating (appendix C.23). C.Fo, C.F and R.F depend on R.B and are re-selected in the SMath sheet against the new calculated values.
Power Components | D58 · D78 · D79 · D80 · D82 | B81 is the SECONDARY section title, and the statically-on primary loss had been added at row 82 - below it - so a primary number sat inside the secondary section. kT.pri was at row 80, an input dropped into the middle of the primary results block. | The primary results block, rows 77 to 80, now reads Ctot, loss in one SWITCHING device, loss in the STATICALLY-ON device, and Rth on the worse of the two. Row 82 is cleared. kT.pri moved to row 58, under the section title, where it applies to the whole block. | No value changes: D78 2.850 W, D79 5.700 W (was D82), D80 17.54 C/W. Nothing outside this block read any of the moved cells, so only the workbook-to-SMath comparison had to follow (P.mos_dev now maps to D79).
Power Components | D58 (kT.pri confirmed) | kT.pri was 2, an estimate for the superjunction class. | 1.8, read off the STO60N045DM9 normalized RDSon vs Tj curve at Tj = 125 C. | Hot RDSon 90 -> 81 mOhm. Switching device 5.34 -> 4.81 W, statically-on device 10.69 -> 9.62 W, required Rth 9.36 -> 10.40 C/W. kT.sec = 1.5 is still an estimate - confirm it from the SR part datasheet the same way.
Power Components | D98 (kT.sec confirmed) | kT.sec was 1.5, an estimate for the low-voltage trench class. | 1.9, read off the SR part RDSon vs Ta curve at VGS = 10 V: about 3.2 mOhm at 25 C against 6.1 mOhm at 125 C. The axis is labelled Ta rather than Tj, but it is a PULSE test - the die cannot self-heat during the pulse, so Tj = Ta and the curve is the junction dependence. A non-pulsed RDSon vs Ta curve could not be used this way. | Hot RDSon 5.55 -> 7.03 mOhm, leg 2.775 -> 3.515 mOhm. Loss per device 1.11 -> 1.41 W, total secondary 4.45 -> 5.63 W, and the budget margin k.PSR falls 1.349 -> 1.065. The 3 W per leg budget is now nearly spent: a third device per leg would restore it. The 25 C figure entered in D96 must be the one specified at the SAME VGS = 10 V.
Res. Tank Design | D12 | =(1/(D11))-1 D11 evaluates the gain at VAC.max = 264 V | =1/(2*IF(F9,F9,D9)*((DS!D95+DS!D107*DS!D106))/(SQRT(2)*DS!D81))-1 | lambda.min.1 asks that the tank can REACH DOWN to the lowest required gain, which happens at the HIGHEST equivalent input. After morphing that is the FB side of the threshold, Design Spec D81 = 332.34 V, not the AC maximum 264 V. RTC!C9 was re-pointed to the same corner (cause E) and this row was left behind. lambda.min.1 0.0019 -> 0.2613, and the resulting lambda requirement 0.125 -> 0.5785. NO SELECTED VALUE CHANGES - lambda.act stays 0.4583 from L.r/L.m - but the workbook now shows the selection sitting below the NO-LOAD requirement asked at f.sw,max,spec. At full load the same corner is reached at 209.5 kHz; at no load it needs about 231 kHz against a 225 kHz target, inside the 319.6 kHz VCO ceiling.
 |  |  |  | rev 0.7 - changes that were made earlier but never written into this log (found 2026-09-23 by comparing every design-sheet formula and constant with the ST original). Records only: no cell was changed.
Design Spec | G23 | (empty) | ='CompensationNet&Check'!D38 | Added. Shows the output voltage the fitted divider actually regulates to (CompensationNet&Check D38) next to the target in D23, so the E-series rounding of R.I / R.O is visible on the specification page.
Design Spec | D24 | 16 | 19 | Project specification: hold-up ends at or above this voltage (docs/DESIGN.md, specification table).
Design Spec | D25 | 10 | 5 | Project specification: output ripple at most this, peak to peak.
Design Spec | D26 | 10 | 12 | Project specification: hold-up time at 100 Vac, full load, starting at the ripple trough.
Res. Tank Design | D65 | =CC!C29 | =CC!J29 | C.18: the line-cycle rms now comes from the Simpson integral in CC column J instead of the single-phase theta = pi/4 approximation in column C. The C.18 rows of this log name the CC cells, not this reader.
Res. Tank Design | D67 | =CC!C25 | =CC!J25 | C.18: the line-cycle rms now comes from the Simpson integral in CC column J instead of the single-phase theta = pi/4 approximation in column C. The C.18 rows of this log name the CC cells, not this reader.
Res. Tank Design | F45 | 24 | 20 | Selected magnetizing inductance of this design point, chosen together with the turns ratio so that n.T = n*sqrt(1+lambda.act) is a ratio that can be wound. The calculated D45 is the no-load condition at the high corner, which the design knowingly does not meet (burst mode covers it), so it is not a value to round to.
Power Components | D28 | =CC!C31 | =CC!J31 | C.18: the line-cycle rms now comes from the Simpson integral in CC column J instead of the single-phase theta = pi/4 approximation in column C. The C.18 rows of this log name the CC cells, not this reader.
Power Components | D71 | 86 | 897 | Entered with the STO60N045DM9 selection. WHICH datasheet capacitance this is (small-signal Coss, Co(er) or Co(tr)) is not recorded, and ZVS needs Co(tr). D77 Ctot = 2*D71 + D72 is read by no formula: the ZVS check uses Design Spec D46 (the midpoint capacitance input). Open item - confirm against the datasheet.
Device Setting | F21 | (empty) | 470 | Selected timing capacitor, shown in the selection column like the other blocks. No formula reads F21 - they read D21, which holds the same value. Keep the two equal.
Device Setting | D22 | (empty) | =MIN(D19/D21,D21/D20) | Added margin check: the timing capacitor inside its window, min(CT.max/CT, CT/CT.min) > 1.
Device Setting | D25 | (empty) | =D24/IF(ISNUMBER(F24),F24,D24) | Added margin check: RT.ceil (D24) over the selected RT > 1, i.e. f.Min stays above f.o. RT.ceil is a MAXIMUM despite the ST label "Minimum Resistor value".
Device Setting | D49 | (empty) | =0.55/D46*1000 | Added: OCP1 trip current from the 0.55 V ISEN threshold over R.CS (D46, mOhm).
Device Setting | G49 | (empty) | =0.75/D46*1000 | Added: OCP2 trip current from the 0.75 V ISEN threshold over R.CS.
Device Setting | D50 | (empty) | =D49/D32 | Added margin check: OCP1 over the composite tank peak D32, target > 1.2.
Device Setting | F83 | 3 | 1.5 | Selected auxiliary-to-secondary ratio: 3 auxiliary turns on 2 secondary turns. The auxiliary winding only senses (ZCD); VCC comes from an external 12 V rail, so the D83 limit - which protects VCC at OVP2 - does not apply, and D84 below 1 is expected.
Device Setting | D84 | (empty) | =D83/IF(ISNUMBER(F83),F83,D83) | Added margin check k.naux = D83 / selected ratio. It matters only when the auxiliary winding supplies VCC; here the winding only senses (ZCD) and VCC comes from an external rail, so a value below 1 is not a failure.
Device Setting | F91 | 680 | 330 | Selected upper ZCD resistor: the E24 value just ABOVE the calculated one, so that OVP1 lands above the output ripple peak rather than on it.
Device Setting | D71 (and cached D88, D98, D99) | D71 "DS_IC start-up phase end th at ZCD pin" held 1.35 V, the ST tool value. The draft datasheet electrical characteristics table gives V_ZCD_SUend = 1.36 V (typ). | D71 = 1.36 V, the datasheet value (user decision 2026-09-24). D88, D98 and D99 keep their formulas; their cached values were recomputed. | The output voltage at which start-up hands over to the loop (D99) moves by +0.7 %. Nothing else reads these cells; no margin moves.
Device Setting | F83, F91, B84 (and cached D84-D100, BOM E56) | The auxiliary winding was a ZCD sense winding (n.aux 1.5, three turns on three cores in series, R.ZCD_H 330 k) and VCC came from an external 12 V rail. The user decided (2026-09-25) that there is no external rail: the auxiliary winding supplies VCC, 2 turns, through a Zener regulator. | F83 = 1.0 (2 T on N.s = 2), F91 = 220 k (E24 above the calculated 208.2 k). B84 explains that D84 < 1 is intended. Formulas unchanged; cached values recomputed. | OVP1 28.93 V, OVP2 31.45 V, start-up hand-over 17.11 V. D84 = 0.84 reads as a failure in the ST tool and is not one here - the regulator between the winding and VCC is a deliberate difference from the ST tool's direct-feed assumption.
 |  |  |  | Lr14 copy, 2026-09-26 (user): tank L.r 14 uH / L.m 25.46 uH / C.r 100 nF. lambda stays 0.55, so n is unchanged; f.r falls to 134.5 kHz. The example transformer (E 60/22/16) then fills its window exactly.
Res. Tank Design | F44 | 11 | 14 | L.r leakage (resonant) inductance, uH
Res. Tank Design | F45 | 20 | 25.46 | L.m magnetizing inductance, uH
 |  |  |  | Lr14 copy, 2026-09-27 (user): the transformer is TDK ETD 54/28/19 on its catalogue former B66396W with a 2.0 mm partition and nothing left empty; its leakage, 23.4 uH, is the tank L.r. lambda stays 0.55 (L.m 42.55 uH), C.r 200 nF keeps Q near 0.8; f.r 73.6 kHz, f.o 43.8 kHz, so R.T moves to 23.2 kOhm (f.Min 44.8 kHz).
Res. Tank Design | F43 | 100 | 200 | C.r resonant capacitor, nF
Res. Tank Design | F44 | 14 | 23.4 | L.r leakage (resonant) inductance, uH
Res. Tank Design | F45 | 25.46 | 42.55 | L.m magnetizing inductance, uH
Device Setting | F24 | 11 | 23.2 | R.T timing resistor, kOhm
 |  |  |  | PQ50 copy, 2026-09-30 (user): the transformer is ONE TDK PQ 50/50 (N97) on its catalogue former B65982E with a 3.0 mm partition, 15 : 2 (NP1 3 x 5 T TIW-Litz d 2.9, NS2 then NS3 2 T layers Litz d 4.0). 2-D FEM leakage 23.3-26.4 uH, so L.r 25 uH; C.r 180 nF (E12), L.m 45 uH (lambda 0.556), R.T 21.5 kOhm (E96, f.Min 48.3 kHz).
Res. Tank Design | F43 | 200 | 180 | C.r resonant capacitor, nF
Res. Tank Design | F44 | 23.4 | 25 | L.r leakage (resonant) inductance, uH
Res. Tank Design | F45 | 42.55 | 45 | L.m magnetizing inductance, uH
Device Setting | F24 | 23.2 | 21.5 | R.T timing resistor, kOhm
Res. Tank Design | F9 | 6.0241 | 6.0134 | n effective turns ratio = 7.5/sqrt(1 + L.r/L.m), lambda 25/45
 |  |  |  | STO60N045DM9 datasheet (DS14711 Rev 4), 2026-10-01 (user): c.HB is now the charge of two devices, 2 x 897 pF x 400 V over the corner bus sqrt(2) x V.eq_min, plus 100 pF layout (was an 800 pF pick); kT.pri from Fig. 10. Q.ZVS2 falls to 4.22 but Q.ZVS1 1.97 still binds, so the tank is unchanged; T.T rises to 170 ns (t.D 220 ns).
Design Spec | D46 | 800 | 3028.98 | c.HB midpoint capacitance, pF - from C_oss eq. 897 pF (0..400 V)
Power Components | D58 | 1.8 | 1.9 | kT.pri RDSon rise to Tj 125 C - Fig. 10 vector read 1.898
Power Components | D72 | 10 | 100 | Cpar midpoint layout parasitic, pF - as the SMath sheet
 |  |  |  | STL160N10F8 datasheet (DS14249 Rev 5), 2026-10-02 (user): the SR MOSFET, two per leg. RDSon 3.2 mOhm max and kT 1.5 replace the earlier 3.7 mOhm and 1.9; the SR conduction loss falls from 5.71 to 3.90 W. 100 V against the 80 V recommended.
Power Components | C92 | TPH3R70APL1 | STL160N10F8 | SR part number
Power Components | D96 | 0.0037 | 0.0032 | RD SR RDSon max 25 C, VGS 10 V - STL160N10F8 Table 3
Power Components | D98 | 1.9 | 1.5 | kT.sec RDSon rise to Tj 125 C - Fig. 13 vector read 1.504
 |  |  |  | LED rail V_Z designed (sheet 16.1b), 2026-10-02: a TL431B shunt regulator fed from V_out through R_Z 2.2 kOhm, divider 38.3k / 10k. A +-5 % Zener does not fit the R_B window (k 1.07 / 1.051).
CompensationNet&Check | D14 | 12 | 12.05085 | V_Z = V.R (1 + R.Z1/R.Z2)
 |  |  |  | peak tank current vs load (Res. Tank Design 70-79, CC 59-74) - ADDED (user, 2026-10-18/19): below resonance the magnetizing current peaks at the end of the half cycle and the load current in the middle, so at light load the peak IS the magnetizing current and only above ld.add does the load raise it ([79], as Device Setting D32 at 100 %). Res. Tank Design 73-79 hold the results; CC 59-74 re-solve the frequency at 0/25/50/75/100 % load (closed-form cubic of the SMath sheet, section 8) and compute I.trafo, I.lm and the composite peak. Live formulas on the book inputs; no existing cell changes.
Res. Tank Design | D73:D79 |  |  | I.Lm.pk, I.Lm.zc, ld.add, Ilr.pk at 25/50/75/100 %
CC | B59:G74 |  |  | working: cubic, fsw, Itrafo.pk, Ilm.pk, r.mix, composite peak
 |  |  |  | gate driver selection in the switch section, start-up in Res. Tank Design - ADDED (user, 2026-10-22). Power Components rows inserted (xl_rows.py, every reference followed): 76-83 the switch gate data (STO60N045DM9: C.g 7.5 nF Qg slope, C.gs 4.76 nF, R.g 4.5, V.pl 6.3, V.th 4.0 / 3.5, Q.gd 13 nC, V.gs 20 V); 89-174 LLC Half Bridge Gate Driver Selection - part number, driver datasheet values (L6498LD: 1.4 / 1.55 A at 15 V, 10-20 V, 85 ns, MT 30 ns, no internal dead time, 800 kHz, 0.6 mA, 120 K/W, 125 C, V.BO 9.3 V), gate network (Value = recommendation, Selected Value = design sheet section 14c.1 parts (R.G 4.7, R.G_off 2.2 ohm + 1N4148W, C.BOOT 470 nF, ES1J V.F 1.3 V, no series resistor) at V.drv 15 V (user, 2026-10-22; the sheet regulator is 12.85-14.35 V), G = OK / CHECK and the allowed range), results with G = OK / CHECK and the limit, schematic at column G, two blank rows before and after the section. Old rows 76-80 are now 84-88 and old 81-119 (the secondary section) 175-213. BOM&Schematics 91-105: gate driver and gate network (PN and values, live links); CHANGELOG entries above this line name the old rows. Res. Tank Design 81-87: start-up I.su, k.su.OCP2, k.su.OCP1, f.su.OCP1. CC 77-168: the working (gate_budget.py model).
Power Components | B76:E83 |  |  | switch gate data (yellow)
Power Components | B89:G174 |  |  | gate driver selection
Res. Tank Design | B81:F87 |  |  | start-up: I.su, k.su.OCP2, k.su.OCP1, f.su.OCP1
CC | B77:D168 |  |  | gate drive working

Sheet: Design Spec
 |  |  |  |  |  | Release 1.0
Input data specs. and pre design choices
Parameters | Name | Value | Unit
Minimum Input voltage | VAC.min | 90 | Vac
Maximum Input voltage | VAC.max | 264 | Vac
Selected configuration: universal mains range | Config.mains | 1 | -
Line frequency | fl | 50 | Hz
Minimum Line frequency | fl.min | 47 | Hz
Parameters | Name | Value | Unit | Selected value
Minimum voltage for Res. Tank Design | Vin.min | 173.2411614 | Vac | 173.2411614
Parameters | Name | Value | Unit |  |  |  | *25
Regulated Output Voltage - TARGET (the divider is chosen to hit this) | V.out | 25 | V | realised value (selected divider) -> | 25.17681818
Minimum admitted voltage (for hold up req) | Vo_min_adm | 19 | V
Output voltage ripple pk-pk | ∆vout | 5 | %
Hold up capability | Thold | 12 | ms
Maximum Output Power | Pout | 657.5 | W
Expected HB efficiency | ηLLC | 98 | %
Max capacitor height (empty or 0 for unlimited) | h | 25 | mm
Output cap estimation (MCLPR series) | Name | Value | Unit
Output capacitor working voltage | W.V | 50 | V
Single capacitor value | Cout.s.est | 4700 | uF
Equivalent Series Resistor | ESR.single | 0.08465688462 | Ω
Case Size diameter | ØD | 30 | mm
Case Size height | h | 25 | mm
Estimated number of cap | n.Cap | 16 | -
Expected ouptut cap volume [cm3] | Cap.Volume | 282.74 | cm3
Parameters | Name | Value | Unit
Upper Resonant Frequency | f.R1 | 150 | kHz
Minimum switching frequency | fsw.min | 50 | kHz
Maximum Switching Frequency (1.5*f.R1 sugg) | fsw.max | 225 | kHz
Parameters | Name | Value | Unit
Single HB midpoint estimated Cap | c.HB | 3028.98 | pF
Dead Time | t.D | 220 | ns
Parassitic Capacitance | Cp | 2 | nF
EMI filter resistance | R.EMI | 0.15 | Ω
Parameters | Name | Value | Unit
Bridge Rectifier Voltage Drop | Vf.BR | 0.08 | V
Dynamic Resistance (1 diode) | Rd | 0.04 | Ω
Output stage configuration (CT/FB)
Parameters | Name | Value | Unit
Output Rectifier Voltage Drop | Vrect | 0 | V
Output Rectifier configuration (1 = CT, 2 = FB) | Config.rect | 1 | -
Configuration 1: CT=Center Tap Rectification |  |  |  | Configuration 2: FB=Full Bridge Rectification
To blank
Parameters | Name | Value | Unit
Minimum Input voltage (for input curr) | VAC.min | 90 | Vac
Maximum Input voltage | VAC.max | 264 | Vac
Universal range configuration |  | 0
Maximum equivalent input for Res. Tank Design (FB morphing side) | Vin.FBmax | 332.3401872 | Vac |  |  | 0 | Universal range = calcoli ok
Parameters | Name | Value | Unit |  |  | 1 | FB a bassa rete = I calcoli del tank sono ok, cambia la dissipazione ?
Minimum voltage for Res. Tank Design | Vin.min | 173.2411614 | Vac |  |  | 2 | HB a bassa rete = va dimezzata la tensione di ingresso con la quale si calcola il tank, aumenta dissipazione sui mos
 |  |  |  |  |  | 3 | FB ad alta rete = va raddoppiata la tensione di ingresso con la quale si calcola il tank, diminuisce dissipazione sui mos
Parameters | Name | Value | Unit |  |  | 4 | HB ad alta rete = I calcoli del tank sono ok, cambia la dissipazione sul ponte a diodi in ingresso (dovrebbe già essere corretta nei calcoli, prendendo Vinmin)
High line resonant operation | Vin.nom | 225 | Vac
Nominal input voltage (config dependent) | Fixed | 225 | Vac
Above resonance modulation depth |  | 5 | %
Input voltage for imposing resonant operation | Vin.res | 213.75 | Vac
Line frequency | fl | 50 | Hz
Minimum Line frequency | fl.min | 47 | Hz
Maximum cap height | h | 25 | mm
Parameters | Name | Value | Unit
Regulated Output Voltage | V.out | 25 | V
Minimum admitted voltage (for hold up req) | Vo_min_adm | 19 | V
Output voltage ripple | ∆vout | 5 | %
Maximum Output Power | Pout | 657.5 | W
Expected HB efficiency | ηLLC | 98 | %
Upper Resonant Frequency | f.R1 | 150 | kHz
Minimum switching frequency | fsw.min | 50 | kHz
Maximum Switching Frequency | fsw.max | 225 | kHz
Output Rectifier Voltage Drop | Vrect | 0 | V
Output Rectifier configuration (1 = CT, 2 = FB) |  | 1
Bridge Rectifier Voltage Drop | Vf.BR | 0.08 | V
Dynamic Resistance (1 diode) | Rd | 0.04 | Ω
HB midpoint estimated Cap | c.HB | 800 | pF
Dead Time | t.D | 220 | ns
Cap… | Cp | 2 | nF
EMI filter resistance | R.EMI | 0.15 | Ω

Sheet: Preliminary Calculation
Preliminary Calculations
Parameters | Name | Value | Unit
Output current | Iout | 26.30 | A
Output rectifier efficiency | η.rect | 100.00 | %
Transformer output power | P.sec | 657.50 | W
LLC converter input power | P.in.LLC | 670.92 | W
Max mains input rms current | I.in.max | 7.45 | A
Output rectifier dissipation | P.d.Drect | 0.00 | W
LLC converter dissipation (trafo+MOS) | P.d.LLC | 13.42 | W
Bridge rectifier dissipation | P.D.br | 5.52 | W
EMI filter resistance dissipation | P.D.Rin | 8.34 | W
TOTAL power dissipation | P.D | 27.27 | W
HB converter expected efficiency | η.HB | 98.00 | %
EMI filter and bridge rectifier efficiency | η.ac | 97.98 | %
Total expected efficiency | η.tot | 96.02 | %
Rated input power | P.in | 684.77 | W

Sheet: Res. Tank Design
Resonant Tank Design
FHA-based design
Parameters | Name | Value | Unit | Selected Value
Physical Turn Ratio (npri/nsec): | n | 6.046 | - | 6.0134
Maximum Voltage Gain@Vin.min | M.Vmin.pk | 1.229 | -
Minimum Voltage Gain@Vin.min | M.Vmax.pk | 0.807 | -
Min λ ratio for min gain req | λ.min.1 | 0.560 | -
Min λ ratio for max freq req | λ.min.2 | 1.009 | -
Min λ ratio for max freq req (TD) | λ.min.TD | 1.241 | -
Min λ ratio for min freq req | λ.min.3 | 0.125 | -
Equivalent output impedance | Rac | 13.701 | Ω
For ZVS at Vin.min and max load | QZVS.1 | 1.957 | -
For ZVS at Vin.max and zero load | QZVS.2 | 15.853 | -
ZVS condition
Parameters | Name | Value | Unit
Margin to achieve ZVS | ZVSmargin | 15 | %
Selected quality factor | QZVS | 1.702 | -
Resonant tank characteristic imp | Z0 | 23.318 | Ω
Minimum fsw.norm at Vin.min.pk | f.n.min | 0.838 | -
Minimum resonant tank phase shift | φ.min | 0.367 | -
Resonant current ZC instant | T.ZC | 460.02 | ns
Reference Dead time | T.D | 220.00 | ns
ZVS condition satisfied? | Yes
Parameters | Name | Value | Unit
Peak Resonant Current | IR1.pk | 18.44 | A
Minimum current for achieving ZVS | IR0 | 6.62 | A
Transition time | T.T | 29.59 | ns
Resonant Tank Parameters
Parameters | Name | Value | Unit | Selected Value
Turn Ratio | n | 6.024 | -
Resonant Capacitor | C.r | 45.503 | nF | 180
Leakage inductance | L.r | 11.258 | µH | 25
Magnetizing inductance | L.m | 8.866 | µH | 45
Final Design Check
Parameters | Name | Value | Unit
Series over parallel inductance ratio | λ | 0.550 | -
Real Turn Ratio | n.T | 7.500 | -
Series resonant characteristic imp | Z.o | 10.49 | Ω
Parallel resonant characteristic imp | Z.O | 17.61 | Ω
Normalized parallel resonant frequency | f.no | 0.596 | -
Series resonant frequency | f.r | 151.75 | kHz
Parallel resonant frequency | f.o | 90.39 | kHz
Primary inductance | L.μ | 24.90 | µH
Primary side leakage inductance | L.L1 | 6.10 | µH
Secondary side leakaged inductance | L.L2 | 0.108 | µH
Current for achieving ZVS | I.R0.crit | 1.760 | A
Estimated transformer current
Parameters | Name | Value | Unit
Primary RMS current @ Vin min | Ipri.rms @θ=π/4 (approx.) | 10.91 | A
Primary peak current @ Vin_min | Ipri.pk (at Vin.min pk) | 16.37 | A
Secondary RMS current @ Vin min | Isec.rms @θ=π/4 (approx.) | 28.33 | A
Secondary peak current @ Vin_min | Isec.pk (at Vin.min pk) | 98.62 | A
Peak tank current vs load (magnetizing + load)
Parameters | Name | Value | Unit
Magnetizing current peak (any load) | I.Lm.pk |  | A
Magnetizing current peak @ line zero crossing (f.Min) | I.Lm.zc |  | A
Load above which the load current adds to the peak (approx.) | ld.add |  | %
Peak tank current @ 25 % load | Ilr.pk.25 |  | A
Peak tank current @ 50 % load | Ilr.pk.50 |  | A
Peak tank current @ 75 % load | Ilr.pk.75 |  | A
Peak tank current @ 100 % load | Ilr.pk.100 |  | A
Start-up with the output near 0 V
Parameters | Name | Value | Unit | Check
Start-up tank peak at f.SU | I.su |  | A
OCP2 margin at start-up (>1) | k.su.OCP2 |  | -
OCP1 margin at start-up (>1) | k.su.OCP1 |  | -
Start-up floor before OCP1 | f.su.OCP1 |  | kHz

Sheet: Power Components
Input capacitor selection
Parameters | Name | Value | Unit | Selected Value
Minimum Input Cap. | C.in.min | 2054.32 | nF | 2200
Output capacitor selection
Parameter | Name | Value | Unit
Output cap considering ripple pk-pk | Cout1 | 71247.23 | uF
Ouptut cap considering hold up | Cout2 | 67222.38 | uF
Number of output capacitors | n.Cout | 160 | -
Insert the single capacitor value | Cout.single | 470 | uF
Insert the ESR value of the single capacitor | ESR.single | 30 | mΩ
Total ouptut capacitor Cout | Cout | 75200.00 | uF
Total ESR of Cout | ESR | 0.19 | mΩ
Output cap RMS current | I.Cout.RMS | 30.22 | A
Parameter | Name | Value | Unit
Low frequency ripple voltage pk-pk recalculation | V_Ripple_pk-pk | 1.18 | V
% Ripple pk-pk on Vout | Ripple pk-pk % | 4.74 | %
Hold up time recalculation | Thold | 13.42 | ms
Estimated maximum R&N @ Vinmin | R&N_0 | 18.49 | mV
Maximum allowed R&N @ fsw | R&N_max | 30 | mV
Displacement factor of ceramic capacitor | DF | 2.5 | %
Suggested minimum ceramic capacitor | Cceramic min | 0.00 | uF
Select the ceramic capacitor | Cceramic | 10 | uF
Estimated R&N @ fsw | R&N | 17.45 | mV
Estimated dissipated power on output capacitors | P.Cout | 0.16 | W
Input Bridge Rectifier
Parameter | Name | Value | Unit
Maximum RMS Input Current | Iin | 7.45 | A
Parameter | Name | Value | Unit
Selected Bridge Forward Voltage (1 diode) | Vth | 0.08 | V
Dynamic Resistance (1 diode) | Rd | 0.04 | Ω |  | Bridge rectifier schematic
 |  |  |  |  | GBJ1506U
Please Select a BRIDGE RECTIFIER part number | GBJ1506U
Parameter | Name | Value | Unit
Rectified Sine Current (half wave)_RMS | I hw_RMS | 5.27 | A
Rectified Sine Current (half wave)_Average | I hw_Average | 3.36 | A
Power dissipation | Pbridge | 5.52 | W
LLC Half Brigdge Power Switch Selection
Rdson multiplier at Tj,max - same VGS = 10 V curve | kT.pri | 1.9 | -
Parameter | Name | Value | Unit
Primary RMS current @Vin min - whole tank | Ipri.rms (line cycle, Simpson) | 10.91 | A
Primary RMS Switch current @Vin min - per switch POSITION | Imos.rms per position (line cycle, Simpson) | 7.72 | A
Primary RMS current in ONE device | Imos.rms.dev | 7.72 | A
Parameter | Name | Value | Unit
Suggested Min Voltage rating for each power | VDS | 485.28 | V
Suggested Min Current rating per switch POSITION | IF Switch (composite tank peak) | 23.81 | A
Primary peak current in ONE device | Ilr.pk.dev | 18.32 | A
Please Select a dedicated Switch part number | STO60N045DM9
Devices in parallel per switch position | n.par | 1 | -
Parameter | Name | Value | Unit
Rdson max @Tc = 25˚C, VGS = 10 V, ID = 28 A (per device) | Rdson | 0.045 | Ω
Drain Capacitance | Coss | 897 | pF
Parassitic Drain Node Capacitance | Cpar | 100 | pF
Operating Ambient Temperature | Ta | 25 | C˚
Body diode recovery condition - bus voltage | Vbd.rr | 373.35 | V
Body diode recovery condition - current | Ibd.rr | 12.41 | A
Gate capacitance, Qg slope above the plateau | C.g | 7.5 | nF
Gate-source capacitance (Ciss - Crss) | C.gs.dev | 4.76 | nF
Internal gate resistance | R.g | 4.5 | Ω
Miller plateau voltage | V.pl | 6.3 | V
Gate threshold, typ | V.th | 4 | V
Gate threshold, min | V.th.min | 3.5 | V
Miller charge over the bus swing | Q.gd | 13 | nC
Gate-source voltage rating | V.gs.max | 20 | V
Parameter | Name | Value | Unit
Total HB parassitic Capacitance | Ctot | 1804 | pF
Maximum Power Losses estimation for ONE SWITCHING device | Pdiss.s | 4.82 | W
Power loss in the STATICALLY-ON device (HB morphing mode) | Pdiss.dc | 9.65 | W
Estimated Rth max j-a at Tj = 125˚C, on the WORSE device | Rth | 10.37 | ˚C/W
LLC Half Bridge Gate Driver Selection
Please Select a dedicated Gate Driver part number | L6498LD
Parameter | Name | Value | Unit | Selected Value
Source current, min | I.so | 1.4 | A
Sink current, min | I.si | 1.55 | A
Test supply voltage for I.so, I.si | V.test | 15 | V
Output resistance, source (or type the DS value) | R.o.src |  | Ω
Output resistance, sink (or type the DS value) | R.o.sink |  | Ω
Supply voltage, min | V.cc.min | 10 | V
Supply voltage, max | V.cc.max | 20 | V
Propagation delay | t.pd | 85 | ns
Delay matching, max | MT | 30 | ns
Internal dead time (0 = none) | t.DT | 0 | ns
Maximum switching frequency | f.max | 800 | kHz
Quiescent current, max | I.Q | 0.6 | mA
Thermal resistance j-a | Rth.drv | 120 | ˚C/W
Junction temperature, max | Tj.max | 125 | ˚C
Bootstrap supply, min | V.bo.min | 9.3 | V
HS pin dV/dt immunity | dV/dt.max | 50 | V/ns
HS pin voltage rating | V.hs.max | 480 | V
Logic input high, max | V.IH.max | 2.5 | V
Operating Ambient Temperature | Ta.drv | 25 | ˚C
Please Select the bootstrap diode part number | ES1J
Parameter | Name | Value | Unit
Forward voltage | V.F.boot | 1.3 | V
Repetitive reverse voltage | V.RRM.boot | 600 | V
Average forward current | I.F.boot | 1 | A
Surge current (8.3 ms) | I.FSM.boot | 30 | A
Please Select the turn-off diode part number | 1N4148W
Parameter | Name | Value | Unit
Forward voltage (0 = no diode, GOFF pin) | V.F.off | 0.7 | V
Average forward current | I.F.off | 0.3 | A
Surge current (1 us) | I.FSM.off | 2 | A
Parameters | Name | Value | Unit | Selected Value
Maximum gate drive voltage | V.drv.max |  | V
Minimum gate drive voltage | V.drv.min |  | V
Select the gate drive voltage | V.drv |  | V | 15
Maximum turn-on resistor (10 V within the pulse) | R.on.max |  | Ω
Minimum turn-on resistor (driver temperature, current) | R.on.min |  | Ω
Select the turn-on resistor (Value: E12) | R.on |  | Ω | 4.7
Maximum turn-off path resistance (off in time) | R.off.eff.max |  | Ω
Minimum turn-off resistor (sink current, D.off surge) | R.off.min |  | Ω
Select the turn-off resistor (Value: E12) | R.off |  | Ω | 2.2
Maximum gate-source capacitor (10 V within the pulse) | C.gs.max |  | nF
Minimum gate-source capacitor (Miller) | C.gs.min |  | nF
Select the gate-source capacitor (Value: E6) | C.gs |  | nF | 0
Maximum bootstrap capacitor (first pulse to V.bo.min) | C.boot.max |  | nF
Minimum bootstrap capacitor (10 x C.gate) | C.boot.min |  | nF
Select the bootstrap capacitor (Value: E6) | C.boot |  | nF | 470
Maximum bootstrap resistor (first pulse to V.bo.min) | R.boot.max |  | Ω
Minimum bootstrap resistor (D.boot surge) | R.boot.min |  | Ω
Select the bootstrap resistor (Value: E12) | R.boot |  | Ω | 0
Parameters | Name | Value | Unit | Check
Peak gate current, turn-on | I.g.on |  | A
Peak gate current, turn-off | I.g.off |  | A
Driver current margin (>1) | k.IG |  | -
Turn-off path resistance | R.off.eff |  | Ω
Dead time needed in run | t.D.need |  | ns
Dead time allowed in run | t.D.max |  | ns
Dead time margin in run (>1) | k.tD |  | -
Start-up dead time needed | t.D.su.min |  | ns
Start-up dead time allowed | t.D.su.max |  | ns
Start-up dead time margin (>1) | k.tD.su |  | -
Gate voltage, end of start-up pulse | V.g.su |  | V
V.BS after the first LOUT pulse | V.bs.1 |  | V
V.BS minimum, steady at f.SU | V.bs.min |  | V
Miller margin (>1) | k.Miller |  | -
Midpoint dv/dt at start-up | dv/dt.su |  | V/ns
Driver ratings margin (>1) | k.drv |  | -
Maximum driver dissipation at Ta | P.drv.max |  | W
Driver dissipation at f.Max | P.drv |  | W
Driver junction temperature | Tj.drv |  | ˚C
Start-up switching frequency | f.SU |  | kHz
R.on dissipation at f.Max | P.Ron |  | W
R.off dissipation at f.Max | P.Roff |  | W
D.boot peak current | I.boot.pk |  | A
D.boot average current | I.boot.avg |  | mA
D.boot reverse voltage | V.R.boot |  | V
D.boot margin (>1) | k.D.boot |  | -
D.off peak current | I.off.pk |  | A
D.off average current | I.off.avg |  | mA
D.off margin (>1) | k.D.off |  | -
Secondary Side Power Switch Selection in center tap configuration
Parameter | Name | Value | Unit [ ]
Secondary RMS current @Vin min - each winding | Isec.rms per winding (line cycle, Simpson) | 28.33 | A
Secondary RMS Switch current @Vin min - each LEG | Idiode.rms per leg (line cycle, Simpson) | 28.33 | A
Secondary peak Switch current @Vin min - each LEG | Isec.pk | 98.62 | A
Secondary RMS current in ONE device | Isr.rms.dev | 14.16 | A
Parameter | Name | Value | Unit [ ]
Suggested Min Voltage rating for each power switch | VDS | 60.00 | V
Suggested Min Current rating per LEG | IF Switch | 118.34 | A
Secondary peak current in ONE device | Isr.pk.dev | 49.31 | A
Please Select a dedicated Switch part number | STL160N10F8
Rectifier device type (1 = diode/Schottky, 2 = SR MOSFET) | Conf.SR | 2 | -
Parameter | Name | Value | Unit
Rectifier forward voltage drop (Conf.SR = 1 only) | Vth | 0 | V
Rdson max @25˚C, VGS = 10 V (per device) | RD | 0.0032 | Ω
Operating Ambient Temperature | Ta | 25 | C˚
Rdson multiplier at Tj,max - same VGS = 10 V curve | kT.sec | 1.5 | -
Parameter | Name | Value | Unit
Maximum Power Losses estimation for ONE device | Pdiss_d | 1.41 | W
Estimated Rth, per device, at Tj = 125˚C | Rth | 70.90 | ˚C/W
Total Power dissipation, all rectifier devices | Pdiss | 5.64 | W
SR devices in parallel per leg | n.SR | 2 | -
Conf.1: CT=Center Tap Rectification | Conf.2: FB=Full Bridge Rectification

Sheet: Device Setting
Minimum switching frequency = lower resonant frequency | f.sw.min | 90.39 | kHz
1-VCO timing components setting
Parameters | Name | Value | Unit |  |  |  | VCO block diagram
Maximum Timing Capacitor | CT.max | 702.59 | pF
Minimum Timing Capacitor | CT.min | 176.04 | pF
Select the timing capacitor between CTmin and Ctmax | CT | 470.00 | pF | 470
 | k.CT (>1) | 1.49 | -
Parameters | Name | Value | Unit | Selected Value
Minimum Resistor value | RT.ceil (NOT a minimum) | 11.24 | kΩ | 21.50
 | k.RT.ceil (>1) | 1.02 | -
Parameters | Name | Value | Unit
Actual Max. switching frequency | f.Max | 319.61 | kHz
Actual Min. switching frequency | f.Min | 92.25 | kHz
Actual Start-up switching frequency | f.start-up | 503.33 | kHz
2-ISEN (Pin6) Current sense resistor calculation
Parameters | Name | Value | Unit
Max input power at FB voltage clamped to the VFB.max | R.CS.max1 | 24.53 | mΩ
Minimum input voltage, the maximum input peak current | R.CS.max2 | 30.03 | mΩ
Sense dissipation @ low mains | P.Rcs.avg | 4.65 | W
Single sense resistor maximum power dissipation | P.Rcs.sing | 1 | W
Minimum number or parallel sense resistors | N.Rcs.sing | 5 | -
Select number of parallel sense resistors | N.Rcs.parall | 5 | -
Maximum value of single sense resistor | Max.Rcs.parall | 122.67 | mΩ
Suggested single sense resistor (largest E24 value at or below D44) - put your actual choice in F45 | R.CS.single | 120.00 | mΩ | 120 |  |  | 327.2727273 | 180||180||240
Current sense resistor | R.CS | 24 | mΩ
Actual estimated power dissipation on current sense resistor | P.Rcs.act | 4.54 | W
Actual estimated maximum input power | Pin.max | 700.00 | W
OCP1 / OCP2 trip currents [84] - ADDED | I.OCP1 | 22.92 | A | I.OCP2 | 31.25 | A
OCP1 margin over the composite peak D32 - target > 1.2 | k.OCP1 | 1.25 | -
3-BM (pin10) - Burst mode resistor setting:
Parameters | Name | Value | Unit
Input power burst mode threshold | P.in.BM | 75 | W
Expected converter efficiency at BM entering threshold | η.BM.in | 90 | %
Parameters | Name | Value | Unit | Selected Value
Maximum burst mode resistor | R.BM.max | 30.06 | kΩ | 30
Parameters | Name | Value | Unit
Expected BM entering threshold | P.in.BM.exp | 74.85 | W
Expected output power at BM entering | P.o.BM.exp | 67.37 | W
4-ZCD (Pin12) resistors setting:
Parameters | Name | Value | Unit
OVP1 threshold percentage | V.OVP1% | 10 | %
OVP1 threshold | V.OVP1 | 27.50 | V
OVP2 threshold | V.OVP2 | 29.89 | V
Parameters | Name | Value | Unit | Selected Value
Bias current of ZCD resistor divider at OVP1 threshold | I.bias.OVP1 | 120 | µA
Maximum auxiliary to secondary turn ratio (naux/nsec) | n.aux_sec_max | 0.836 | - | 1.000
Auxiliary ratio check for a winding wired STRAIGHT to VCC. This design feeds VCC through a Zener regulator (about 13.6 V), so D84 < 1 is intended: the 25 V limit applies to the regulator output, checked in the SMath sheet section 14c (k.VCC). | k.naux (>1) | 0.84 | -
Parameters | Name | Value | Unit | Selected Value
Peak aux voltage at OVP1 | V.aux.OVP1 | 27.50 | V
Peak aux voltage at OVP2 | V.aux.OVP2 | 29.89 | V
Peak aux voltage at end of start-up | V.aux.startup.end | 16.26 | V
Peak output voltage at end of start-up | V.out.startup.end | 16.26 | V
Lower ZCD resistor divider | R.ZCD.L.min | 19.17 | kΩ | 19
Upper ZCD resistor divider | R.ZCD.H.max | 208.17 | kΩ | 220
Parameters | Name | Value | Unit
OVP1 actual thresholds | V.OVP1 | 28.93 | V
OVP2 actual thresholds | V.OVP2 | 31.45 | V
OVP1 on auxiliary winding | V.aux.OVP1 | 28.93 | V
OVP2 on auxiliary winding | V.aux.OVP2 | 31.45 | V
Actual End-Start-up voltage on aux | V.aux.startup.end | 17.11 | V
Actual End-Start-up voltage on output | V.out.startup.end | 17.11 | V
Actual auxiliary regulated voltage | V.aux.reg | 25.00 | V
5-CFG (Pin11) - resistor setting:
Parameters | Name | Value | Unit | Selected Value |  |  | Configuration table summary
Configuration resistor value | R.CFG.max | 31.82 | kΩ | 30
Actual brownout threshold | V.BO | 84.85 | V
LOUT2 setting | Connect to driver
Actual configuration | Morphing enabled
Split resonant capacitors for forced HB configuration

Sheet: CompensationNet&Check
FB and secondary side voltage control loop
Parameters | Name | Value | Unit |  | Secondary side voltage control loop schematics:
Feedback supply voltage | V.Z | 12.05085 | V
Please Select a Voltage Regulator part number | TL431AIT
Parameters | Name | Value | Unit
Tx431 referemce voltage | V.R | 2.495 | V
Tx431 min operating current | I.min | 0.8 | mA
Please Select an Optocoupler part number | SFH617A
Parameters | Name | Value | Unit
Optodiode voltage drop | V.Fo | 1.15 | V
Optocoupler transfer ratio when Itr = 150uA | CTR.steady | 0.37
Optocoupler capacitance | C.opto | 3 | nF
Optocoupler transfer ratio when Itr = 300uA | CTR.max | 0.53 | -
Output feedback divider and Vout setting
Parameters | Name | Value | Unit | Selected value
Upper resistor divider | R.I | 100.00 | kΩ
Lower resistor divider | Ro | 11.09 | kΩ | 11
Regulated output voltage - ACTUAL, from the selected divider (target is Design Spec D23) | Vout | 25.18 | V
Parameters | Name | Value | Unit | Selected value
Limiting Resistor | R.p.Max | 1.44 | kΩ | 1.3
External EA biasing resistor_max value | R.B.max | 6.48 | kΩ
External EA biasing resistor_min value | R.B.min | 5.76 | kΩ | 6.2
Maximum Feedback current | I.FB | 290.22 | µA
Feedback Loop Requirements
Parameters | Name | Value | Unit
Required phase margin | Φ.M | 50 | deg
Max. 3rd harm. Distortion @ full load: | D.3rd% | 5 | %
Output Power setpoint | Po | 657.5 | W
Parameters | Name | Value | Unit | Selected value
Error Amplifier FB voltage at output power Po | V.FB(Po) | 2.69 | V
Output ripple voltage @ 2fL and output power Po (peak-peak): | DV(Po,fl) | 1.11 | V
Control-to-output Transfer Function (Constant-power Load) @ output power Po | Go(Po) | 130.06 | Hz
Error Amplifier Quiescent Point | V.FB_set | 3.19 | V
Output ripple voltage @ 2fLmin: (peak-peak) | ΔV.O | 1.18 | V
Parameters | Name | Value | Unit
Control-to-output Transfer Function (Constant-power Load) worst case | G.o_wstOC | 130.06 | Hz
Control-to-Output TF Crossover Frequency | f.cto_Cross | 20.70 | Hz
Required E/A Gain @ 2fLmin | EA_G.2fl | 0.454 | -
Max-to-min input voltage ratio | Γ.v | 1.13 | -
Parameters | Name | Value | Unit
Required Venable's α factor | α.v | 1.2 | - | fissato
Required Venable's K factor | K.v | 2.72 | -
Compensated Error Amplifier Goal Transfer Function (Type II + HF pole):
Parameters | Name | Value | Unit
Required Unity Gain Factor | EA.o_Goal | 36.20 | Hz
Required Central Frequency | f.MB | 16.92 | Hz
Required Pole Frequencies | f.p_Goal | 46.06 | Hz
Required Zero Frequency | f.z_Goal | 6.22 | Hz
Added high frequency pole | f.p_HF | 1000 | Hz
ERROR AMPLIFIER Compensation Network Implementation (circuit connected to pin 9)
Parameters | Name | Value | Unit | Selected value
Calculated feedback capacitor CFo | C.Fo | 77.88 | nF | 82
Calculated feedback capacitor CF | C.f | 525.49 | nF | 560
Calculated feedback resistor RF | R.f | 45.72 | kΩ | 47
Calculated feedback capacitor CFo for fpx pol | C.fx | 1.55 | nF | 1.55
Implemented Error Amplifier Transfer Function Expression
Parameters | Name | Value | Unit
Implemented EA Unity Gain Factor | EA.o | 32.53 | Hz
Implemented EA Zero and Pole Frequency | f.z | 6.05 | Hz
Implemented EA Zero and Pole Frequency | f.p | 47.34 | Hz
Implemented EA Higher Pole Frequency: | f.px | 999.40 | Hz
Loop Compensation Check @ Operating Conditions
Parameters | Name | Value | Unit
Line frequency | fl | 47 | Hz
Output Power percentage | P.o.% | 100 | %
Output Power setpoint | P.o.x | 657.5 | W
Parameters | Name | Value | Unit
Error Amplifier Quiescent Point | V.FB_OC | 3.19 | V
Output ripple voltage @ 2fL: (peak) | ΔV.O_OC | 1.18 | V
Control-to-Output Transfer function (constant-power load) | G.o_OC | 130.06 | Hz
Control-to-Output TF Crossover Frequency | f.cto_cross | 20.70 | Hz
Feedback Loop Requirements check |  |  |  |  |  |  |  |  |  |  |  |  |  |  |  |  |  |  |  |  |  |  |  |  |  |  |  |  |  |  |  |  |  |  |  |  |  |  |  |  |  |  | Fcross |  | 2*fL
Parameters | Name | Value | Unit |  | frequency | 0.1 | 0.2 | 0.3 | 0.4 | 0.5 | 0.6 | 0.7 | 0.8 | 0.9 | 1 | 2 | 3 | 4 | 5 | 6 | 7 | 8 | 9 | 10 | 20 | 30 | 40 | 50 | 60 | 70 | 80 | 90 | 100 | 200 | 300 | 400 | 500 | 600 | 700 | 800 | 900 | 1000 | 17.57 | frequency | 94 | Hz
Crossover Frequency | f.cross | 17.57 | Hz |  | G.cto_OC | 206.9953766 | 103.4976883 | 68.99845886 | 51.74884414 | 41.39907531 | 34.49922943 | 29.57076808 | 25.87442207 | 22.99948629 | 20.69953766 | 10.34976883 | 6.899845886 | 5.174884414 | 4.139907531 | 3.449922943 | 2.957076808 | 2.587442207 | 2.299948629 | 2.069953766 | 1.034976883 | 0.6899845886 | 0.5174884414 | 0.4139907531 | 0.3449922943 | 0.2957076808 | 0.2587442207 | 0.2299948629 | 0.2069953766 | 0.1034976883 | 0.06899845886 | 0.05174884414 | 0.04139907531 | 0.03449922943 | 0.02957076808 | 0.02587442207 | 0.02299948629 | 0.02069953766 | 1.178032941 | G.cto_OC
Actual Phase Margin | ϕ.M.Act | 49.64 | Deg
Actual E/A Gain @ 2fL | EAG.2fl.Act | 0.384 | -
Actual 3rd Harmonic Distortion @ 2fL | D.3rd%.Act | 4.23 | % |  | IGcto_OCI | 46.3192129 | 40.29861299 | 36.77678781 | 34.27801308 | 32.33981282 | 30.7561879 | 29.4172521 | 28.25741316 | 27.23436272 | 26.3192129 | 20.29861299 | 16.77678781 | 14.27801308 | 12.33981282 | 10.7561879 | 9.417252104 | 8.257413164 | 7.234362715 | 6.319212904 | 0.298612991 | -3.22321219 | -5.721986922 | -7.660187182 | -9.243812103 | -10.5827479 | -11.74258684 | -12.76563728 | -13.6807871 | -19.70138701 | -23.22321219 | -25.72198692 | -27.66018718 | -29.2438121 | -30.5827479 | -31.74258684 | -32.76563728 | -33.6807871 | 1.423148696 | IGcto_OCI
 |  |  |  |  | Fase_Gcto_OC | -90 | -90 | -90 | -90 | -90 | -90 | -90 | -90 | -90 | -90 | -90 | -90 | -90 | -90 | -90 | -90 | -90 | -90 | -90 | -90 | -90 | -90 | -90 | -90 | -90 | -90 | -90 | -90 | -90 | -90 | -90 | -90 | -90 | -90 | -90 | -90 | -90 | -90 | Fase_Gcto_OC
Estimated FB ripple at BM entering threshold | ΔV.FM@BM | 51.91 | mV
Suggested reduction of RBM resistor | ΔRBM | 2.60 | kΩ
 | f.180 | 202.45 | Hz
 | |T|@f.180 | 0.02 | -
 | GM | 34.18 | dB |  | EA (f) | 51.78709973 | 25.90399324 | 17.28092592 | 12.97286094 | 10.39078858 | 8.671703656 | 7.445745189 | 6.527981292 | 5.815670824 | 5.24716805 | 2.724507086 | 1.922880914 | 1.54657223 | 1.336326744 | 1.206074545 | 1.119367952 | 1.058364868 | 1.013442979 | 0.9790367312 | 0.8239076325 | 0.7375270701 | 0.66099957 | 0.5923020719 | 0.532158134 | 0.480336654 | 0.4359568903 | 0.3979419901 | 0.3652572913 | 0.1935027735 | 0.1278718805 | 0.09345195995 | 0.07219399527 | 0.05775229833 | 0.04732962548 | 0.0394933956 | 0.0334269107 | 0.02862605143 | 0.8488727291 | EA (f) | 0.3842823964 | EA(2fL)
 | GM.target | 10.00 | dB |  | IEA(f)I | 34.28443179 | 28.26733436 | 24.75134017 | 22.26071526 | 20.33297017 | 18.76208856 | 17.43816339 | 16.29557802 | 15.29199634 | 14.39849947 | 8.705758836 | 5.679047776 | 3.787404154 | 2.518253203 | 1.627483031 | 0.9794573711 | 0.4927083066 | 0.1159863678 | -0.184020283 | -1.682429479 | -2.644440696 | -3.595976461 | -4.549134964 | -5.479185907 | -6.369085431 | -7.211129078 | -8.00360465 | -8.748022118 | -14.26625612 | -17.86449896 | -20.58823172 | -22.82997847 | -24.76861456 | -26.49733864 | -28.06951049 | -29.51807518 | -30.86477106 | -1.423148367 | IEA(f)I
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
 |  |  |  |  | 26 | 17.571 | 17.571 | 5.581789273e-07 | -1.523165025e-06 | 17.571 | -4.824940227e-07
 |  |  |  |  | 27 | 17.571 | 17.571 | 5.581789273e-07 | -4.824940227e-07 | 17.571 | 3.78422087e-08

Sheet: BOM&Schematics
 |  |  |  | Power Part Schematics
BOM and Schematics
Resonant tank parameters
Parameters | Name | Value | Unit
Magnetizing inductance | L.m | 20.00 | µH
Leakage inductance | L.r | 11.00 | µH
Resonant Capacitor | C.r | 100.00 | nF
Pri. to Sec. turn ratio | n | 6.02 | -
Auxiliary to Secondary turn ratio | n.aux_sec | 1.50 | -
Input and output cap
Parameters | Name | Value | Unit
PFC input Capacitor | Cin | 2200 | nF
Output EL capacitor (single) | C.out.single | 470 | µF
Number of output EL capacitors | n.Cout | 160 | -
Output capacitance TOTAL | C.out | 75.2 | mF
Output ceramic, high frequency | Cout ceramic | 10 | µF
HVSU connecting diodes PN
Selected component | PN
Example of Diodes PN (x 2) | S1M
Input Bridge Rectifier PN
Selected component | PN
Input Bridge Rectifier PN | GBJ1506U
Sense resistor
Parameters | Name | Value | Unit
Rsense total value | R.CS | 24.00 | mΩ
Single Rsense value | R.CS.single | 120.00 | mΩ
Number of Rsense | N.Rcs.parall | 5 | -
Compensation network and Output Divider
Parameters | Name | Value | Unit
Feedback capacitor CFo | C.fo | 82.0 | nF
Feedback capacitor CF | C.f | 560.0 | nF
Feedback resistor RF | R.f | 47.0 | kΩ
feedback capacitor | C.fx | 1.6 | nF
Output Voltage upper resistor | R.I | 100.0 | kΩ
Output Voltage lower resistor | R.o | 11.0 | kΩ
Photodiode parallel resistor | R.P | 1.3 | kΩ
Bias resistor | R.B | 6.2 | kΩ | Controller Part Schematics
L6790 pin configuration
Parameters | Name | Value | Unit
Lower ZCD resistor (to GND) | R.ZCD.L | 19.0 | kΩ
Upper ZCD resistor (to aux winding) | R.ZCD.H | 220.0 | kΩ
VCO Timing Capacitor | C.T | 470.0 | pF
VCO Timing Resistor | R.T | 11.0 | kΩ
Burst Mode resistor | R.BM | 30.0 | kΩ
CFG resistor | R.CFG | 30.0 | kΩ
Half Bridge Switches PN
Parameters | Name | PN
Primary switches | HVG1, HVG2, LVG1, LVG2 | STO60N045DM9
Output power stage PN
Parameters | Name | PN
Center Tap diodes | D1, D2 | TPH3R70APL1
Optocoupler PN
Parameters | PN
Feedabck Optocoupler | SFH617A
EA Voltage Reference PN
Parameters | PN
External Error Amplifier | TL431AIT
Gate driver and gate network
Parameters | Name | PN
Gate drivers (one per leg) | U.drv1, U.drv2
Bootstrap diode (one per leg) | D.boot
Turn-off gate diode (one per switch) | D.off
Parameters | Name | Value | Unit
Gate drive voltage | V.drv |  | V
Turn-on gate resistor (one per switch) | R.on |  | Ω
Turn-off gate resistor (one per switch) | R.off |  | Ω
Gate-source capacitor, option (one per switch) | C.gs |  | nF
Bootstrap capacitor (one per leg) | C.boot |  | nF
Bootstrap resistor (one per leg) | R.boot |  | Ω

Sheet: RTC
 | 1 | 2 | 3 | 4 | 5 | 6 | 7 | 8 | 9 | 10 | 11 | 12 | 13 | 14 | 15 | 16 | 17 | 18 | 19 | 20 | 21 | 22 | 23 | 24 | 25 | 26 | 27 | 28 | 29 | 30 | 31 | 32 | 33 | 34 | 35 | 36 | 37 | 38 | 39 | 40 | 41 | 42 | 43 | 44 | 45 | 46 | 47 | 48 | 49 | 50 | 51 | 52 | 53 | 54 | 55 | 56 | 57 | 58
θ | 0.1 | 0.2 | 0.3 | 0.4 | 0.5 | 0.6 | 0.7 | 0.8 | 0.9 | 1 | 1.1 | 1.2 | 1.3 | 1.4 | 1.5 | 1.6 | 1.7 | 1.8 | 1.9 | 2 | 2.1 | 2.2 | 2.3 | 2.4 | 2.5 | 2.6 | 2.7 | 2.8 | 2.9 | 3 | 3.09 | 3.1
V.out | 25 | 25 | 25 | 25 | 25 | 25 | 25 | 25 | 25 | 25 | 25 | 25 | 25 | 25 | 25 | 25 | 25 | 25 | 25 | 25 | 25 | 25 | 25 | 25 | 25 | 25 | 25 | 25 | 25 | 25 | 25 | 25 | 25 | 25 | 25 | 25 | 25 | 25 | 25 | 25 | 25 | 25 | 25 | 25 | 25 | 25 | 25 | 25 | 25 | 25 | 25 | 25 | 25 | 25 | 25 | 25 | 25 | 25
V.f | 0 | 0 | 0 | 0 | 0 | 0 | 0 | 0 | 0 | 0 | 0 | 0 | 0 | 0 | 0 | 0 | 0 | 0 | 0 | 0 | 0 | 0 | 0 | 0 | 0 | 0 | 0 | 0 | 0 | 0 | 0 | 0 | 0 | 0 | 0 | 0 | 0 | 0 | 0 | 0 | 0 | 0 | 0 | 0 | 0 | 0 | 0 | 0 | 0 | 0 | 0 | 0 | 0 | 0 | 0 | 0 | 0 | 0
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

Sheet: OutCap_Sel_DB
Case Size Table and Permissible Ripple Current |  |  |  |  |  |  |  | Multicomp PRO MCLPR Series
W.V. | Cap.(μF) | Case Size ØD [mm] | Case Size L [mm] | R.C. [A rms] | tan(delta) | Estimated ESR | Volume cm3 | Cap/Vol | Energy/Vol maximum | Energy/Vol suitable cap | Total volume | Min | W.V. | Cap.(μF) | Case Size ØD [mm] | Case Size L [mm] | ESR | Expected cap volume [cm3] | W.V. | Cap.(μF) | Case Size ØD [mm] | Case Size L [mm] | ESR | Number of caps | Volume check
25 | 3300 | 20 | 30 | 2.05 | 0.2 | 0.08038128439 | 9.424777961 | 350.1408748 | 109419.0234 |  |  |  |  |  |  |  |  | 282.7433388 | 50 | 4700 | 30 | 25 | 0.08465688462 | 16 | 282.7433388
25 | 3300 | 22 | 25 | 2.1 | 0.2 | 0.08038128439 | 9.503317777 | 347.2471486 | 108514.7339
25 | 4700 | 20 | 30 | 2.5 | 0.3 | 0.08465688462 | 9.424777961 | 498.6854884 | 155839.2151
25 | 4700 | 22 | 25 | 2.2 | 0.3 | 0.08465688462 | 9.503317777 | 494.5641207 | 154551.2877 |  |  |  |  |  |  |  |  | Output voltage |  | 25 | link
25 | 5600 | 22 | 31 | 2.6 | 0.3 | 0.07105131388 | 11.78411404 | 475.2160391 | 148505.0122 |  |  |  |  |  |  |  |  | Ripple pk-pk |  | 5
25 | 6800 | 22 | 30 | 2.85 | 0.3 | 0.05851284672 | 11.40398133 | 596.2829824 | 186338.432 |  |  |  |  |  |  |  |  | Maximum output voltage |  | 30.625
25 | 6800 | 25 | 26 | 2.7 | 0.3 | 0.05851284672 | 12.76272016 | 532.8017787 | 166500.5558 |  |  |  |  |  |  |  |  | Min cap for ripple pk-pk |  | 71247.23 | link
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
450 | 220 | 25 | 50 | 1.06 | 0.2 | 1.205719266 | 24.54369261 | 8.963606395 | 907565.1475
450 | 220 | 35 | 37 | 0.97 | 0.2 | 1.205719266 | 35.59817176 | 6.180092661 | 625734.3819
450 | 330 | 35 | 47 | 1.13 | 0.2 | 0.8038128439 | 45.21929926 | 7.297768993 | 738899.1105
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
