yohan924-ops/L6790A-Single-Stage-PFC-LLC-Converter/Calculation Excel Sheet/variants/3CORE_670W_transformer_spec.xlsx

TRANSFORMER SPECIFICATION
Turns NP1 : NS2 : NS3 : NAUX = 5 : 2 : 2 : 1
1. CONSTRUCTION
• Flat (low-profile) construction. Overall height agreed before the first samples.
2. WINDING SPEC
No | Winding | S → F | Turns | Wire (copper) | Location
1 | NP1 Primary | 1 → 2 | 5 T | Litz ø0.10 × 370 (2.91 mm²) | Primary section
2 | NS2 Secondary A | 3 → 5 | 2 T | Litz ø0.10 × 320 (2.51 mm²) | Secondary section, with NS3 (bifilar)
3 | NS3 Secondary B | 4 → 6 | 2 T | Litz ø0.10 × 320 (2.51 mm²) | Secondary section, with NS2 (bifilar)
4 | NAUX Auxiliary | a → b | 1 T | Solid ø0.40 (0.13 mm²) | Secondary section, beside NS2 · NS3
Equivalent wire acceptable: copper ≥ table, strand ≤ ø0.10 mm; NS2 · NS3 may be copper foil ≤ 0.20 mm thick.
3. ELECTRICAL REQUIREMENTS
Measured with an LCR meter at 100 kHz / 1 V.
No | Item | Terminal | Requirement |  | Condition
1 | INDUCTANCE | 1 – 2 | 8.33 µH ±10 % |  | Other windings OPEN
2 | LEAKAGE INDUCTANCE | 1 – 2 | 3.33 µH ±10 % |  | NS2 SHORT (NS3, NAUX open); then NS3 SHORT (NS2, NAUX open) — both
3 | D.C OVERLAP | 1 – 2 | ≥ 90 % of initial inductance |  | 17 A dc, room temperature
Item 2: 2.67 to 3.67 µH is acceptable if stated before samples; the ±10 % then applies to the stated value.
4. OPERATING CONDITIONS
• | Winding frequency |  | 130 to 292 kHz
• | Winding current NP1 |  | 10.9 A rms / 18.2 A peak
• | Winding current NS2, NS3 |  | 9.2 A rms / 31.2 A peak
• | Winding current NAUX |  | 175 mA dc
• | Core effective area |  | Ae ≥ 220 mm²
