yohan924-ops/L6790A-Single-Stage-PFC-LLC-Converter/Calculation Excel Sheet/variants/Transformer_Spec_7p5to1_x3m3.xlsx

TRANSFORMER SPECIFICATION
Turns NP1 : NS2 : NS3 : NAUX = 5 : 2 : 2 : 1
1. CONSTRUCTION
• Flat (low-profile) construction as the production part 26OP-LM83W. Core and coil former are the supplier’s choice; the windings are as section 2. The overall height is agreed before the first samples.
2. WINDING SPEC
No | Winding | S → F | Turns | Wire (copper) | Location
1 | NP1 Primary | 1 → 2 | 5 T | Litz ø0.10 × 370 (2.91 mm²) | Primary section
2 | NS2 Secondary A | 3 → 5 | 2 T | Litz ø0.10 × 320 (2.51 mm²) | Secondary section, with NS3 (bifilar)
3 | NS3 Secondary B | 4 → 6 | 2 T | Litz ø0.10 × 320 (2.51 mm²) | Secondary section, with NS2 (bifilar)
4 | NAUX Auxiliary | a → b | 1 T | Solid ø0.40 (0.13 mm²) | Secondary section, beside NS2 · NS3
Winding direction: all windings in the same direction. S = start, F = finish; the starts (1, 3, 4, a) are the dots (●) in the diagram above.
Primary section and secondary section side by side, as 26OP-LM83W; the spacing between them sets item 3-2. NAUX is in the secondary section so that its voltage follows the secondaries.
Centre tap is made on the PCB by joining pins 4 and 5 — do NOT join them inside the transformer. One conductor per pin; a secondary pin carries its whole winding current (9.2 A rms): confirm the pin current rating, or bring the secondary ends straight out.
Another wire is acceptable with at least the same copper and strands ≤ ø0.10 (skin depth 0.14 mm at 292 kHz); NS2 and NS3 may also be copper foil ≤ 0.20 mm thick.
Terminal numbers follow the production part 26OP-LM83W (approval sheet, KH Feelux); the pin layout is the supplier’s choice.
3. ELECTRICAL REQUIREMENTS
Measured with an LCR meter at 100 kHz / 1 V.
No | Item | Terminal | Requirement |  | Condition
1 | INDUCTANCE | 1 – 2 | 8.33 µH ±10 % |  | All other windings OPEN. L.mag + L.leak, not L.mag alone.
2 | LEAKAGE INDUCTANCE | 1 – 2 | 3.33 µH ±10 % |  | EACH HALF: NS2 short alone, then NS3 short alone; the other half and NAUX open. Both must pass. A target, not a maximum.
3 | D.C OVERLAP | 1 – 2 | ≥ 90 % of initial inductance |  | Test current 17 A, normal temperature
Item 2 is a target, not a maximum: if the construction cannot reach it, state the value it reaches BEFORE samples — 2.67 to 3.67 µH is acceptable, the ±10 % then applying around the stated value.
With NS2 and NS3 both shorted the reading is lower: record it, do not hold it to item 2. The auxiliary is NOT shorted.
4. OPERATING CONDITIONS
• | Winding frequency |  | 130 to 292 kHz |  | of the winding current and voltage at full load; up to 527 kHz briefly at start-up
• | Winding current NP1 |  | 10.9 A rms / 18.2 A peak |  | at full load — the wire of section 2 carries it at ≤ 3.74 A/mm²
• | Winding current NS2, NS3 |  | 9.2 A rms / 31.2 A peak |  | each, at full load
• | Winding current NAUX |  | 175 mA dc |  | dc load
• | Core effective area |  | Ae ≥ 220 mm² |  | keeps B.pk ≤ 75 mT with 2 T at 190 kHz. Ae of the whole flux path: yoke-limited in a flat core; two core sets (pairs) placed side by side in one former add.
