yohan924-ops/L6790A-Single-Stage-PFC-LLC-Converter/Calculation Excel Sheet/variants/Transformer_Spec_7p5to1_asbuilt.xlsx

TRANSFORMER SPECIFICATION — as built, with bench measurement
L6790A single-stage PF LLC, 25 V / 26.3 A. 3 units per set (primaries in series, secondaries in parallel). Values per unit.
1. WINDING
No | Winding | Terminal | Turns | Wire | Current capability (4.5 A/mm²)
1 | NP1 Primary | 1 – 4 | 5 T | Litz 0.1 mm × 130 (1.02 mm²) | 4.6 A rms
2 | NS2 Secondary A | 5 – 9 | 2 T | Litz 0.1 mm × 110, bifilar (0.86 mm²) | 3.9 A rms
3 | NS3 Secondary B | 7 – 11 | 2 T | Litz 0.1 mm × 110, bifilar (0.86 mm²) | 3.9 A rms
4 | NAUX Auxiliary | 2 – 3 | 1 T | ø0.4 mm (0.126 mm²) | 0.57 A rms
Centre tap on the PCB: the NS2 end and the NS3 start that add up (section 4). Not joined inside the transformer.
2. ELECTRICAL REQUIREMENTS (LCR 100 kHz / 1 V, series L_s, per unit)
No | Item | Terminal | Measured (3 units) | Requirement | Condition
1 | INDUCTANCE | 1 – 4 | 10.3 / 10.3 / 10.3 µH | 10.33 µH ±10 % | all other windings OPEN
2 | LEAKAGE INDUCTANCE | 1 – 4 | 1.9 / 2.0 / 1.8 µH | 3.67 µH ±10 % | 5–9 and 7–11 both SHORT, 2–3 OPEN
2a | Leakage, one half | 1 – 4 | 2.0 µH (one unit; 1.8 both SHORT) | record | 5–9 only SHORT, then 7–11 only SHORT
3 | D.C OVERLAP | 1 – 4 | not measured | ≥ 90 % of initial inductance | 16 A dc, room temperature, other windings OPEN
Measured 2026-10-09. Set of 3 in series: L_r 5.7 µH (sum of leakage), L_m 25.2 µH (open 30.9 − L_r), n_eff = 7.5 / √(1 + L_r/L_m) = 6.773. Leakage is about half the requirement.
3. CORE (A_e 114 mm², l_e 58.82 mm, V_e 6706 mm³, C1 0.52 mm⁻¹, ≈ 33.8 g/pair, material: TBD)
 | A | 42.00 ± 0.60 |  | E | 6.00 ± 0.20
 | B | 7.85 ± 0.15 |  | F | 4.85 ± 0.15
 | C | 19.00 ± 0.30 |  | B − F | 3.00 ± 0.15
 | D | 36.00 +0.5 / −0.3
4. POLARITY (before fitting)
Drive 1–4 with ~5 V, 50–100 kHz sine. 5–9 and 7–11 read 2/5 of it, 2–3 reads 1/5. Join one end of NS2 to one end of NS3 and find the pair whose remaining ends read double: those two pins are the centre tap. Near zero = wrong pair.
 | Switching frequency | 92 to 249 kHz |  | at full load, design tank (L_r 11 µH)
