yohan924-ops/L6790A-Single-Stage-PFC-LLC-Converter/Calculation Excel Sheet/variants/Transformer_Spec_7p5to1.xlsx

TRANSFORMER SPECIFICATION
L6790A single-stage PF LLC converter 25 V / 26.3 A output — turns ratio 7.5 : 1
1. CONFIGURATION
• Three identical transformers per set — primaries in series, secondaries in parallel.
• EVERY VALUE BELOW IS PER TRANSFORMER.
2. WINDING
No | Winding | Terminal | Turns | Winding current rms / peak
1 | NP1 Primary | 1 – 2 | 5 Ts | 10.9 A / 18.3 A
2 | NS2 Secondary A | 3 – 5 | 2 T | 9.4 A / 32.9 A
3 | NS3 Secondary B | 4 – 6 | 2 T | 9.4 A / 32.9 A
4 | NAUX Auxiliary (VCC, ZCD) | a – b | 1 T | 104 mA dc load (VCC)
Centre tap is made on the PCB by joining pins 4 and 5 — do NOT join them inside the transformer.
Terminal numbers follow the existing production part 26OP-LM83W (approval sheet, KH Feelux): primary 1 – 2, secondaries 3 – 5 and 4 – 6, auxiliary a – b. Core, bobbin and pin layout are the supplier’s choice.
3. ELECTRICAL REQUIREMENTS
Measured with an LCR meter at 100 kHz / 1 V.
No | Item | Terminal | Requirement | Condition
1 | INDUCTANCE | 1 – 2 | 10.33 µH ±10 % | All other windings OPEN. L.mag + L.leak, not L.mag alone.
2 | LEAKAGE INDUCTANCE | 1 – 2 | 3.67 µH ±10 % | SECONDARY ALL SHORT (NS2 + NS3). NAUX open. Resonant inductor — a target, not a maximum.
3 | D.C OVERLAP | 1 – 2 | ≥ 90 % of initial inductance | Test current 16 A, normal temperature
Both measured at 1 – 2 of ONE transformer. Three in series give a total ratio of 7.5 : 1.
Item 2 follows the existing production part 26OP-LM83W clause 4-2, "SECONDARY ALL SHORT" — same vendor, same centre-tapped construction. The auxiliary is NOT shorted.
4. OPERATING CONDITIONS
• | Switching frequency |  | 92 to 249 kHz | at full load
• | Core effective area |  | Ae ≥ 103 mm² | holds the peak flux density at or below 0.20 T
Core, bobbin, wire and winding arrangement are the supplier’s choice, provided sections 3 and 5 are met.
5. SAFETY INSULATION
Household AV (TV) for the US, EU, Japan, Korea and China: IEC 62368-1 as adopted there, GB 4943.1-2022 in China (5000 m).
No | Item | Between | Requirement | Condition
1 | Insulation grade | primary | secondary | REINFORCED | Primary = NP1, NAUX; secondary = NS2, NS3 and the CORE. Pollution degree 2, overvoltage category II, material group IIIb, 5000 m.
2 | Creepage | primary | secondary | ≥ 6.4 mm | Wherever the triple insulation ends: primary pins and stripped wire ends to the core and to secondary leads and pins (320 V rms row, reinforced = 2 × basic).
3 | Clearance | primary | secondary | ≥ 4.5 mm | 3.0 mm at 2000 m × 1.48 for 5000 m, rounded up.
4 | NP1 wire | NP1 | secondary | TIW-Litz, reinforced | Triple-insulated Litz approved as reinforced insulation to IEC 62368-1, one wire from pin to pin. The partition between the sections carries NO insulation; it sets item 3-2.
5 | NAUX wire | NAUX | secondary | TIW, reinforced | Triple-insulated wire approved as reinforced insulation to IEC 62368-1, wound OVER the secondary; leads stay insulated up to the primary-row pins. Its approved frequency must cover the start-up frequency.
6 | Solid insulation | primary | secondary | DTI ≥ 0.4 mm or ≥ 2 tape layers | Where tape or sleeving carries it: each tape layer passes the reinforced test. Sleeve primary leads that leave the triple insulation near the core.
7 | Electric strength | primary | secondary | 3000 V ac 60 s (4242 V dc) | NP1 + NAUX joined against NS2 + NS3 + core joined. Type test, no breakdown. Routine test voltage and time as agreed with the certifier.
The working voltage behind item 2 is an estimate from the design (187 V rms, 373 V peak at 264 Vac); the certifying body measures it.
NAUX: 1 T on EVERY unit; the set series-connects 2 turns in all, the rest stay open.
