yohan924-ops/L6790A-Single-Stage-PFC-LLC-Converter/Calculation Excel Sheet/variants/Transformer_Spec_7p5to1_x1.xlsx

TRANSFORMER SPECIFICATION
L6790A single-stage PF LLC converter 25 V / 26.3 A output — turns ratio 7.5 : 1
1. CONFIGURATION
• One transformer per set on TDK PQ 50/50 (core B65981A, B65982E coil former, 12 pins).
• EVERY VALUE BELOW IS PER TRANSFORMER.
2. WINDING
No | Winding | Terminal | Turns | Winding current rms / peak
1 | NP1 Primary | 1 – 3 | 15 T | 10.4 A / 18.1 A
2 | NS2 Secondary A | 7 – 9 | 2 T | 28.5 A / 99.7 A
3 | NS3 Secondary B | 10 – 12 | 2 T | 28.5 A / 99.7 A
4 | NAUX Auxiliary (VCC, ZCD) | 4 – 6 | 2 T | 144 mA dc load (VCC)
Centre tap is made on the PCB by joining pins 9 and 10 — do NOT join them inside the transformer. One conductor per pin; a secondary pin carries its whole winding current: confirm the pin current rating, or bring the secondary ends straight out.
Coil former TDK B65982E (PQ 50/50), 12 pins, with a 3.0 mm partition added between the two sections. Pin numbers as the data sheet gives them in its view from below, the pin side: pin 1 at the chamfered corner, 1 to 6 in one row and 7 to 12 in the other, 6 facing 7 and 1 facing 12. The data sheet prints 1, 6, 7 and 12; the pins between are counted. Seen from the component side of the board, left and right are exchanged.
3. ELECTRICAL REQUIREMENTS
Measured with an LCR meter at 100 kHz / 1 V.
No | Item | Terminal | Requirement | Condition
1 | INDUCTANCE | 1 – 3 | 70.00 µH ±10 % | All other windings OPEN. L.mag + L.leak, not L.mag alone.
2 | LEAKAGE INDUCTANCE | 1 – 3 | 25.00 µH ±10 % | EACH HALF: NS2 short alone, then NS3 short alone; the other half and NAUX open. Both must pass. Resonant inductor — a target, not a maximum.
3 | D.C OVERLAP | 1 – 3 | ≥ 90 % of initial inductance | Test current 14 A, normal temperature
Both measured at 1 – 3 of ONE transformer. Item 2 is set by the winding and the partition between the two sections: measure it, and each half alone, on the first samples; a thinner partition lowers it.
Item 2, each half: in service only one half conducts at a time, and the two halves lie in different layers. With NS2 and NS3 both shorted the reading is lower (about 23.1 µH estimated): record it, do not hold it to item 2. The auxiliary is NOT shorted.
4. OPERATING CONDITIONS
• | Switching frequency |  | 48 to 118 kHz | at full load
• | Core effective area |  | Ae ≥ 208 mm² | holds the peak flux density at or below 0.20 T
The core, coil former and winding arrangement of the reference design set item 3-2. Another construction is acceptable only when sections 3 and 5 are met and the first samples are approved.
5. SAFETY INSULATION
Household AV (TV) for the US, EU, Japan, Korea and China: IEC 62368-1 as adopted there, GB 4943.1-2022 in China (5000 m).
No | Item | Between | Requirement | Condition
1 | Insulation grade | primary | secondary | REINFORCED | Primary = NP1, NAUX; secondary = NS2, NS3 and the CORE. Pollution degree 2, overvoltage category II, material group IIIb, 5000 m.
2 | Creepage | primary | secondary | ≥ 6.4 mm | Wherever the triple insulation ends: primary pins and stripped wire ends to the core and to secondary leads and pins (320 V rms row, reinforced = 2 × basic).
3 | Clearance | primary | secondary | ≥ 4.5 mm | 3.0 mm at 2000 m × 1.48 for 5000 m, rounded up.
4 | NP1 wire | NP1 | secondary | TIW-Litz, reinforced | Triple-insulated Litz approved as reinforced insulation to IEC 62368-1, one wire from pin to pin. The partition between the sections carries NO insulation; it sets item 3-2.
5 | NAUX wire | NAUX | secondary | TIW, reinforced | Triple-insulated wire approved as reinforced insulation to IEC 62368-1, wound OVER the secondary; leads stay insulated up to the primary-row pins. Its approved frequency must cover the start-up frequency.
6 | Solid insulation | primary | secondary | DTI ≥ 0.4 mm or ≥ 2 tape layers | Where tape or sleeving carries it: each tape layer passes the reinforced test. Sleeve primary leads that leave the triple insulation near the core.
7 | Electric strength | primary | secondary | 3000 V ac 60 s (4242 V dc) | NP1 + NAUX joined against NS2 + NS3 + core joined. Type test, no breakdown. Routine test voltage and time as agreed with the certifier.
The working voltage behind item 2 is an estimate from the design (187 V rms, 373 V peak at 264 Vac); the certifying body measures it.
