yohan924-ops/L6790A-Single-Stage-PFC-LLC-Converter/Calculation Excel Sheet/ST_original_04092026_LGE_670W_L6790A_spreadsheet_unencrypted.xlsx

Sheet: Design Spec
 |  |  |  |  | Release 1.0
Input data specs. and pre design choices
Parameters | Name | Value | Unit
Minimum Input voltage | VAC.min | 90 | Vac
Maximum Input voltage | VAC.max | 264 | Vac
Selected configuration: universal mains range | Config. | 1 | -
Line frequency | fl | 50 | Hz
Minimum Line frequency | fl.min | 47 | Hz
Parameters | Name | Value | Unit | Selected value
Minimum voltage for Res. Tank Design | Vin.min | 165-180 | Vac | 173.2411614
Parameters | Name | Value | Unit
Regulated Output Voltage | V.out | 25 | V
Minimum admitted voltage (for hold up req) | Vo_min_adm | 16 | V
Output voltage ripple pk-pk | ∆vout | 10 | %
Hold up capability | Thold | 10 | ms
Maximum Output Power | Pout | 657.5 | W
Expected HB efficiency | ηLLC | 98 | %
Max capacitor height (empty or 0 for unlimited) | h | 25 | mm
Output cap estimation (MCLPR series) | Name | Value | Unit
Output capacitor working voltage | W.V | 50 | V
Single capacitor value | Cout.s.est | 4700 | uF
Equivalent Series Resistor | ESR.single | 0.08465688462 | Ω
Case Size diameter | ØD | 30 | mm
Case Size height | h | 25 | mm
Estimated number of cap | n.Cap | 8 | -
Expected ouptut cap volume [cm3] | Cap.Volume | 141.37 | cm3
Parameters | Name | Value | Unit
Upper Resonant Frequency | f.R1 | 150 | kHz
Minimum switching frequency | fsw.min | 50 | kHz
Maximum Switching Frequency (1.5*f.R1 sugg) | fsw.max | 225 | kHz
Parameters | Name | Value | Unit
Single HB midpoint estimated Cap | c.HB | 800 | pF
Dead Time | t.D | 220 | ns
Parassitic Capacitance | Cp | 2 | nF
EMI filter resistance | R.EMI | 0.15 | Ω
Parameters | Name | Value | Unit
Bridge Rectifier Voltage Drop | Vf.BR | 0.08 | V
Dynamic Resistance (1 diode) | Rd | 0.04 | Ω
Output stage configuration (CT/FB)
Parameters | Name | Value | Unit
Output Rectifier Voltage Drop | Vrect | 0 | V
Output Rectifier configuration (1 = CT, 2 = FB) | Config. | 1 | -
Configuration 1: CT=Center Tap Rectification |  |  |  | Configuration 2: FB=Full Bridge Rectification
To blank
Parameters | Name | Value | Unit
Minimum Input voltage (for input curr) | VAC.min | 90 | Vac
Maximum Input voltage | VAC.max | 264 | Vac
Universal range configuration |  | 0
 |  |  |  |  | 0 | Universal range = calcoli ok
Parameters | Name | Value | Unit |  | 1 | FB a bassa rete = I calcoli del tank sono ok, cambia la dissipazione ?
Minimum voltage for Res. Tank Design | Vin.min | 173.2411614 | Vac |  | 2 | HB a bassa rete = va dimezzata la tensione di ingresso con la quale si calcola il tank, aumenta dissipazione sui mos
 |  |  |  |  | 3 | FB ad alta rete = va raddoppiata la tensione di ingresso con la quale si calcola il tank, diminuisce dissipazione sui mos
Parameters | Name | Value | Unit |  | 4 | HB ad alta rete = I calcoli del tank sono ok, cambia la dissipazione sul ponte a diodi in ingresso (dovrebbe già essere corretta nei calcoli, prendendo Vinmin)
High line resonant operation | Vin.nom | 225 | Vac
Nominal input voltage (config dependent) | Fixed | 225 | Vac
Above resonance modulation depth |  | 5 | %
Input voltage for imposing resonant operation | Vin.res | 213.75 | Vac
Line frequency | fl | 50 | Hz
Minimum Line frequency | fl.min | 47 | Hz
Maximum cap height | h | 25 | mm
Parameters | Name | Value | Unit
Regulated Output Voltage | V.out | 25 | V
Minimum admitted voltage (for hold up req) | Vo_min_adm | 16 | V
Output voltage ripple | ∆vout | 10 | %
Maximum Output Power | Pout | 657.5 | W
Expected HB efficiency | ηLLC | 98 | %
Upper Resonant Frequency | f.R1 | 150 | kHz
Minimum switching frequency | fsw.min | 50 | kHz
Maximum Switching Frequency | fsw.max | 225 | kHz
Output Rectifier Voltage Drop | Vrect | 0 | V
Output Rectifier configuration (1 = CT, 2 = FB) |  | 1
Bridge Rectifier Voltage Drop | Vf.BR | 0.08 | V
Dynamic Resistance (1 diode) | Rd | 0.04 | Ω
HB midpoint estimated Cap | c.HB | 800 | pF
Dead Time | t.D | 220 | ns
Cap… | Cp | 2 | nF
EMI filter resistance | R.EMI | 0.15 | Ω

Sheet: Preliminary Calculation
Preliminary Calculations
Parameters | Name | Value | Unit
Output current | Iout | 26.30 | A
Output rectifier efficiency | η.rect | 100.00 | %
Transformer output power | P.sec | 657.50 | W
LLC converter input power | P.in.LLC | 670.92 | W
Max mains input rms current | I.in.max | 7.45 | A
Output rectifier dissipation | P.d.Drect | 0.00 | W
LLC converter dissipation (trafo+MOS) | P.d.LLC | 13.42 | W
Bridge rectifier dissipation | P.D.br | 5.52 | W
EMI filter resistance dissipation | P.D.Rin | 8.34 | W
TOTAL power dissipation | P.D | 27.27 | W
HB converter expected efficiency | η.HB | 98.00 | %
EMI filter and bridge rectifier efficiency | η.ac | 97.98 | %
Total expected efficiency | η.tot | 96.02 | %
Rated input power | P.in | 684.77 | W

Sheet: Res. Tank Design
Resonant Tank Design
FHA-based design
Parameters | Name | Value | Unit | Selected Value
Physical Turn Ratio (npri/nsec): | n | 6.046 | - | 7.4527
Maximum Voltage Gain@Vin.min | M.Vmin.pk | 1.521 | -
Minimum Voltage Gain@Vin.min | M.Vmax.pk | 0.998 | -
Min λ ratio for min gain req | λ.min.1 | 0.002 | -
Min λ ratio for max freq req | λ.min.2 | 0.003 | -
Min λ ratio for max freq req (TD) | λ.min.TD | 0.004 | -
Min λ ratio for min freq req | λ.min.3 | 0.125 | -
Equivalent output impedance | Rac | 20.970 | Ω
For ZVS at Vin.min and max load | QZVS.1 | 0.257 | -
For ZVS at Vin.max and zero load | QZVS.2 | 1.044 | -
ZVS condition
Parameters | Name | Value | Unit
Margin to achieve ZVS | ZVSmargin | 15 | %
Selected quality factor | QZVS | 0.223 | -
Resonant tank characteristic imp | Z0 | 4.682 | Ω
Minimum fsw.norm at Vin.min.pk | f.n.min | 0.460 | -
Minimum resonant tank phase shift | φ.min | 0.261 | -
Resonant current ZC instant | T.ZC | 601.94 | ns
Reference Dead time | T.D | 220.00 | ns
ZVS condition satisfied? | Yes
Parameters | Name | Value | Unit
Peak Resonant Current | IR1.pk | 8.90 | A
Minimum current for achieving ZVS | IR0 | 2.30 | A
Transition time | T.T | 85.35 | ns
Resonant Tank Parameters
Parameters | Name | Value | Unit | Selected Value
Turn Ratio | n | 7.453 | -
Resonant Capacitor | C.r | 226.610 | nF | 100
Leakage inductance | L.r | 11.258 | µH | 11
Magnetizing inductance | L.m | 88.000 | µH | 24
Final Design Check
Parameters | Name | Value | Unit
Series over parallel inductance ratio | λ | 0.458 | -
Real Turn Ratio | n.T | 9.000 | -
Series resonant characteristic imp | Z.o | 10.49 | Ω
Parallel resonant characteristic imp | Z.O | 18.71 | Ω
Normalized parallel resonant frequency | f.no | 0.561 | -
Series resonant frequency | f.r | 151.75 | kHz
Parallel resonant frequency | f.o | 85.07 | kHz
Primary inductance | L.μ | 28.98 | µH
Primary side leakage inductance | L.L1 | 6.02 | µH
Secondary side leakaged inductance | L.L2 | 0.074 | µH
Current for achieving ZVS | I.R0.crit | 1.171 | A
Estimated transformer current
Parameters | Name | Value | Unit
Primary RMS current @ Vin min | Ipri.rms (mains cycle) | 10.40 | A
Primary peak current @ Vin_min | Ipri.pk (at Vin.min pk) | 15.51 | A
Secondary RMS current @ Vin min | Isec.rms (mains cycle) | 31.17 | A
Secondary peak current @ Vin_min | Isec.pk (at Vin.min pk) | 115.57 | A

Sheet: Power Components
Input capacitor selection
Parameters | Name | Value | Unit | Selected Value
Minimum Input Cap. | C.in.min | 2054.32 | nF | 2200
Output capacitor selection
Parameter | Name | Value | Unit
Output cap considering ripple pk-pk | Cout1 | 35623.62 | uF
Ouptut cap considering hold up | Cout2 | 35636.86 | uF
Number of output capacitors | n.Cout | 160 | -
Insert the single capacitor value | Cout.single | 470 | uF
Insert the ESR value of the single capacitor | ESR.single | 30 | mΩ
Total ouptut capacitor Cout | Cout | 75200.00 | uF
Total ESR of Cout | ESR | 0.19 | mΩ
Output cap RMS current | I.Cout.RMS | 24.41 | A
Parameter | Name | Value | Unit
Low frequency ripple voltage pk-pk recalculation | V_Ripple_pk-pk | 1.18 | V
% Ripple pk-pk on Vout | Ripple pk-pk % | 4.74 | %
Hold up time recalculation | Thold | 21.10 | ms
Estimated maximum R&N @ Vinmin | R&N_0 | 21.67 | mV
Maximum allowed R&N @ fsw | R&N_max | 30 | mV
Displacement factor of ceramic capacitor | DF | 2.5 | %
Suggested minimum ceramic capacitor | Cceramic min | 0.00 | uF
Select the ceramic capacitor | Cceramic | 10 | uF
Estimated R&N @ fsw | R&N | 20.62 | mV
Estimated dissipated power on output capacitors | P.Cout | 0.11 | W
Input Bridge Rectifier
Parameter | Name | Value | Unit
Maximum RMS Input Current | Iin | 7.45 | A
Parameter | Name | Value | Unit
Selected Bridge Forward Voltage (1 diode) | Vth | 0.08 | V
Dynamic Resistance (1 diode) | Rd | 0.04 | Ω |  | Bridge rectifier schematic
 |  |  |  |  | GBJ1506U
Please Select a BRIDGE RECTIFIER part number | GBJ1506U
Parameter | Name | Value | Unit
Rectified Sine Current (half wave)_RMS | I hw_RMS | 5.27 | A
Rectified Sine Current (half wave)_Average | I hw_Average | 3.36 | A
Power dissipation | Pbridge | 5.52 | W
LLC Half Brigdge Power Switch Selection
Parameter | Name | Value | Unit
Primary RMS current @Vin min | Ipri.rms | 10.40 | A
Primary RMS Switch current @Vin min | Ipri.rms (per mos) | 7.35 | A
Parameter | Name | Value | Unit
Suggested Min Voltage rating for each power | VDS | 485.28 | V
Suggested Min Current rating for each power | IF Switch | 20.16 | A
Please Select a dedicated Switch part number | STO60N045DM9
Parameter | Name | Value | Unit
Rdson resistance@25˚C | Rdson | 0.045 | Ω
Drain Capacitance | Coss | 86 | pF
Parassitic Drain Node Capacitance | Cpar | 10 | pF
Operating Ambient Temperature | Ta | 25 | C˚
Parameter | Name | Value | Unit
Total HB parassitic Capacitance | Ctot | 182 | pF
Maximum Power Losses extimation for each switch | Pdiss.s | 2.43 | W
Extimated Rth max j-a | Rth | 41.10 | ˚C/W
Secondary Side Power Switch Selection in center tap configuration
Parameter | Name | Value | Unit [ ]
Secondary RMS current @Vin min-each winding | Isec.rms (per winding) | 31.17 | A
Secondary RMS Switch current @Vin min-each diode | Idiode.rms (per diode) | 31.17 | A
Secondary peak Switch current @Vin min-each diode | Isec.pk | 115.57 | A
Parameter | Name | Value | Unit [ ]
Suggested Min Voltage rating for each power switch | VDS | 60.00 | V
Suggested Min Current rating for each power switch | IF Switch | 138.68 | A
Please Select a dedicated Switch part number | TPH3R70APL1
Parameter | Name | Value | Unit
Forward voltage drop | Vth | 0 | V
Rdson resistance@25˚C | RD | 0.0031 | Ω
Operating Ambient Temperature | Ta | 25 | C˚
Parameter | Name | Value | Unit
Maximum Power Losses extimation for each switch | Pdiss_d | 3.01 | W
Extimated Rth | Rth | 33.20 | ˚C/W
Total Power dissipation | Pdiss | 6.02 | W
Conf.1: CT=Center Tap Rectification | Conf.2: FB=Full Bridge Rectification

Sheet: Device Setting
Minimum switching frequency = lower resonant frequency | f.sw.min | 85.07 | kHz
1-VCO timing components setting
Parameters | Name | Value | Unit |  | VCO block diagram
Maximum Timing Capacitor | CT.max | 754.99 | pF
Minimum Timing Capacitor | CT.min | 184.25 | pF
Select the timing capacitor between CTmin and Ctmax | CT | 470.00 | pF
Parameters | Name | Value | Unit | Selected Value
Minimum Resistor value | RT.min | 11.76 | kΩ | 11.00
Parameters | Name | Value | Unit
Actual Max. switching frequency | f.Max | 300.41 | kHz
Actual Min. switching frequency | f.Min | 90.58 | kHz
Actual Start-up switching frequency | f.start-up | 457.30 | kHz
2-ISEN (Pin6) Current sense resistor calculation
Parameters | Name | Value | Unit
Max input power at FB voltage clamped to the VFB.max | R.CS.max1 | 24.53 | mΩ
Minimum input voltage, the maximum input peak current | R.CS.max2 | 35.47 | mΩ
Sense dissipation @ low mains | P.Rcs.avg | 2.65 | W
Single sense resistor maximum power dissipation | P.Rcs.sing | 1 | W
Minimum number or parallel sense resistors | N.Rcs.sing | 3 | -
Select number of parallel sense resistors | N.Rcs.parall | 5 | -
Maximum value of single sense resistor | Max.Rcs.parall | 122.67 | mΩ
Select current sense resistor | R.CS.single | 120.00 | mΩ | 220||220||220||(220+220) | 327.2727273 | 180||180||240
Current sense resistor | R.CS | 24 | mΩ
Actual estimated power dissipation on current sense resistor | P.Rcs.act | 2.60 | W
Actual estimated maximum input power | Pin.max | 700.00 | W
3-BM (pin10) - Burst mode resistor setting:
Parameters | Name | Value | Unit
Input power burst mode threshold | P.in.BM | 75 | W
Expected converter efficiency at BM entering threshold | η.BM.in | 90 | %
Parameters | Name | Value | Unit | Selected Value
Maximum burst mode resistor | R.BM.max | 30.06 | kΩ | 30
Parameters | Name | Value | Unit
Expected BM entering threshold | P.in.BM.exp | 74.85 | W
Expected output power at BM entering | P.o.BM.exp | 67.37 | W
4-ZCD (Pin12) resistors setting:
Parameters | Name | Value | Unit
OVP1 threshold percentage | V.OVP1% | 10 | %
OVP1 threshold | V.OVP1 | 27.50 | V
OVP2 threshold | V.OVP2 | 29.89 | V
Parameters | Name | Value | Unit | Selected Value
Bias current of ZCD resistor divider at OVP1 threshold | I.bias.OVP1 | 120 | µA
Maximum auxiliary to secondary turn ratio (naux/nsec) | n.aux_sec_max | 0.836 | - | 3.000
Parameters | Name | Value | Unit | Selected Value
Peak aux voltage at OVP1 | V.aux.OVP1 | 82.50 | V
Peak aux voltage at OVP2 | V.aux.OVP2 | 89.67 | V
Peak aux voltage at end of start-up | V.aux.startup.end | 48.42 | V
Peak output voltage at end of start-up | V.out.startup.end | 16.14 | V
Lower ZCD resistor divider | R.ZCD.L.min | 19.17 | kΩ | 19
Upper ZCD resistor divider | R.ZCD.H.max | 662.52 | kΩ | 680
Parameters | Name | Value | Unit
OVP1 actual thresholds | V.OVP1 | 28.21 | V
OVP2 actual thresholds | V.OVP2 | 30.66 | V
OVP1 on auxiliary winding | V.aux.OVP1 | 84.62 | V
OVP2 on auxiliary winding | V.aux.OVP2 | 91.97 | V
Actual End-Start-up voltage on aux | V.aux.startup.end | 49.67 | V
Actual End-Start-up voltage on output | V.out.startup.end | 16.56 | V
Actual auxiliary regulated voltage | V.aux.reg | 75.00 | V
5-CFG (Pin11) - resistor setting:
Parameters | Name | Value | Unit | Selected Value | Configuration table summary
Configuration resistor value | R.CFG.max | 31.82 | kΩ | 30
Actual brownout threshold | V.BO | 84.85 | V
LOUT2 setting | Connect to driver
Actual configuration | Morphing enabled
Split resonant capacitors for forced HB configuration

Sheet: CompensationNet&Check
FB and secondary side voltage control loop
Parameters | Name | Value | Unit |  | Secondary side voltage control loop schematics:
Feedback supply voltage | V.Z | 12 | V
Please Select a Voltage Regulator part number | TL431AIT
Parameters | Name | Value | Unit
Tx431 referemce voltage | V.R | 2.495 | V
Tx431 min operating current | I.min | 0.8 | mA
Please Select an Optocoupler part number | SFH617A
Parameters | Name | Value | Unit
Optodiode voltage drop | V.Fo | 1.15 | V
Optocoupler transfer ratio when Itr = 150uA | CTR.steady | 0.37
Optocoupler capacitance | C.opto | 3 | nF
Optocoupler transfer ratio when Itr = 300uA | CTR.max | 0.53 | -
Output feedback divider and Vout setting
Parameters | Name | Value | Unit | Selected value
Upper resistor divider | R.I | 100.00 | kΩ
Lower resistor divider | Ro | 11.09 | kΩ | 11
Regulated ouput voltage | Vout | 25.18 | V
Parameters | Name | Value | Unit | Selected value
Limiting Resistor | R.p.Max | 1.44 | kΩ | 1.3
External EA biasing resistor_max value | R.B.max | 6.93 | kΩ
External EA biasing resistor_min value | R.B.min | 4.47 | kΩ | 6.2
Maximum Feedback current | I.FB | 290.22 | µA
Feedback Loop Requirements
Parameters | Name | Value | Unit
Required phase margin | Φ.M | 50 | deg
Max. 3rd harm. Distortion @ full load: | D.3rd% | 5 | %
Output Power setpoint | Po | 657.5 | W
Parameters | Name | Value | Unit | Selected value
Error Amplifier FB voltage at output power Po | V.FB(Po) | 2.69 | V
Output ripple voltage @ 2fL and output power Po (peak-peak): | DV(Po,fl) | 1.11 | V
Control-to-output Transfer Function (Constant-power Load) @ output power Po | Go(Po) | 130.06 | Hz
Error Amplifier Quiescent Point | V.FB_set | 3.19 | V
Output ripple voltage @ 2fLmin: (peak-peak) | ΔV.O | 1.18 | V
Parameters | Name | Value | Unit
Control-to-output Transfer Function (Constant-power Load) worst case | G.o_wstOC | 130.06 | Hz
Control-to-Output TF Crossover Frequency | f.cto_Cross | 20.70 | Hz
Required E/A Gain @ 2fLmin | EA_G.2fl | 0.483 | -
Max-to-min input voltage ratio | Γ.v | 1.13 | -
Parameters | Name | Value | Unit
Required Venable's α factor | α.v | 1.2 | - | fissato
Required Venable's K factor | K.v | 2.72 | -
Compensated Error Amplifier Goal Transfer Function (Type II + HF pole):
Parameters | Name | Value | Unit
Required Unity Gain Factor | EA.o_Goal | 38.51 | Hz
Required Central Frequency | f.MB | 17.45 | Hz
Required Pole Frequencies | f.p_Goal | 47.50 | Hz
Required Zero Frequency | f.z_Goal | 6.41 | Hz
Added high frequency pole | f.p_HF | 1000 | Hz
ERROR AMPLIFIER Compensation Network Implementation (circuit connected to pin 9)
Parameters | Name | Value | Unit | Selected value
Calculated feedback capacitor CFo | C.Fo | 73.20 | nF | 82
Calculated feedback capacitor CF | C.f | 525.49 | nF | 560
Calculated feedback resistor RF | R.f | 44.32 | kΩ | 47
Calculated feedback capacitor CFo for fpx pol | C.fx | 1.55 | nF | 1.55
Implemented Error Amplifier Transfer Function Expression
Parameters | Name | Value | Unit
Implemented EA Unity Gain Factor | EA.o | 32.53 | Hz
Implemented EA Zero and Pole Frequency | f.z | 6.05 | Hz
Implemented EA Zero and Pole Frequency | f.p | 47.34 | Hz
Implemented EA Higher Pole Frequency: | f.px | 999.40 | Hz
Loop Compensation Check @ Operating Conditions
Parameters | Name | Value | Unit
Line frequency | fl | 47 | Hz
Output Power percentage | P.o.% | 100 | %
Output Power setpoint | P.o.x | 657.5 | W
Parameters | Name | Value | Unit
Error Amplifier Quiescent Point | V.FB_OC | 3.19 | V
Output ripple voltage @ 2fL: (peak) | ΔV.O_OC | 1.18 | V
Control-to-Output Transfer function (constant-power load) | G.o_OC | 130.06 | Hz
Control-to-Output TF Crossover Frequency | f.cto_cross | 20.70 | Hz
Feedback Loop Requirements check |  |  |  |  |  |  |  |  |  |  |  |  |  |  |  |  |  |  |  |  |  |  |  |  |  |  |  |  |  |  |  |  |  |  |  |  |  |  |  |  |  |  | Fcross |  | 2*fL
Parameters | Name | Value | Unit |  | frequency | 0.1 | 0.2 | 0.3 | 0.4 | 0.5 | 0.6 | 0.7 | 0.8 | 0.9 | 1 | 2 | 3 | 4 | 5 | 6 | 7 | 8 | 9 | 10 | 20 | 30 | 40 | 50 | 60 | 70 | 80 | 90 | 100 | 200 | 300 | 400 | 500 | 600 | 700 | 800 | 900 | 1000 | 17.57 | frequency | 94 | Hz
Crossover Frequency | f.cross | 17.57 | Hz |  | G.cto_OC | 206.9953766 | 103.4976883 | 68.99845886 | 51.74884414 | 41.39907531 | 34.49922943 | 29.57076808 | 25.87442207 | 22.99948629 | 20.69953766 | 10.34976883 | 6.899845886 | 5.174884414 | 4.139907531 | 3.449922943 | 2.957076808 | 2.587442207 | 2.299948629 | 2.069953766 | 1.034976883 | 0.6899845886 | 0.5174884414 | 0.4139907531 | 0.3449922943 | 0.2957076808 | 0.2587442207 | 0.2299948629 | 0.2069953766 | 0.1034976883 | 0.06899845886 | 0.05174884414 | 0.04139907531 | 0.03449922943 | 0.02957076808 | 0.02587442207 | 0.02299948629 | 0.02069953766 | 1.177884121 | G.cto_OC
Actual Phase Margin | ϕ.M.Act | 50.65 | Deg
Actual E/A Gain @ 2fL | EAG.2fl.Act | 0.386 | -
Actual 3rd Harmonic Distortion @ 2fL | D.3rd%.Act | 4.25 | % |  | IGcto_OCI | 46.3192129 | 40.29861299 | 36.77678781 | 34.27801308 | 32.33981282 | 30.7561879 | 29.4172521 | 28.25741316 | 27.23436272 | 26.3192129 | 20.29861299 | 16.77678781 | 14.27801308 | 12.33981282 | 10.7561879 | 9.417252104 | 8.257413164 | 7.234362715 | 6.319212904 | 0.298612991 | -3.22321219 | -5.721986922 | -7.660187182 | -9.243812103 | -10.5827479 | -11.74258684 | -12.76563728 | -13.6807871 | -19.70138701 | -23.22321219 | -25.72198692 | -27.66018718 | -29.2438121 | -30.5827479 | -31.74258684 | -32.76563728 | -33.6807871 | 1.422051342 | IGcto_OCI
 |  |  |  |  | Fase_Gcto_OC | -90 | -90 | -90 | -90 | -90 | -90 | -90 | -90 | -90 | -90 | -90 | -90 | -90 | -90 | -90 | -90 | -90 | -90 | -90 | -90 | -90 | -90 | -90 | -90 | -90 | -90 | -90 | -90 | -90 | -90 | -90 | -90 | -90 | -90 | -90 | -90 | -90 | -90 | Fase_Gcto_OC
Estimated FB ripple at BM entering threshold | ΔV.FM@BM | 52.14 | mV
Suggested reduction of RBM resistor | ΔRBM | 2.61 | kΩ
 |  |  |  |  | EA (f) | 51.78709999 | 25.90399375 | 17.2809267 | 12.97286198 | 10.39078988 | 8.671705218 | 7.445747016 | 6.527983384 | 5.815673183 | 5.247170677 | 2.724512542 | 1.922889577 | 1.546584617 | 1.336343468 | 1.20609628 | 1.119395409 | 1.058398776 | 1.013484072 | 0.9790857403 | 0.8240725944 | 0.737859279 | 0.6615287896 | 0.5930428709 | 0.5331163005 | 0.4815134434 | 0.437351389 | 0.3995523227 | 0.3670812061 | 0.1973394179 | 0.1335087481 | 0.100659135 | 0.08072498441 | 0.06736082496 | 0.05778452033 | 0.05058801402 | 0.04498333097 | 0.04049544152 | 0.848979576 | EA (f) | 0.3859784418 | EA(2fL)
 |  |  |  |  | IEA(f)I | 34.28443184 | 28.26733453 | 24.75134056 | 22.26071595 | 20.33297125 | 18.76209013 | 17.43816552 | 16.29558081 | 15.29199986 | 14.39850382 | 8.705776228 | 5.679086909 | 3.787473723 | 2.518361905 | 1.627639561 | 0.9796704245 | 0.4929865783 | 0.1163385523 | -0.1835854914 | -1.680690573 | -2.640529137 | -3.589025013 | -4.53827821 | -5.463560766 | -6.347831666 | -7.183389796 | -7.968526807 | -8.704757001 | -14.09572314 | -17.48980553 | -19.94293612 | -21.8598406 | -23.43185205 | -24.76376975 | -25.91904739 | -26.93896777 | -27.85187723 | -1.42205515 | IEA(f)I
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
 |  |  |  |  | 26 | 17.573 | 17.573 | 1.122032809e-06 | -9.585321409e-07 | 17.573 | 8.174936017e-08
 |  |  |  |  | 27 | 17.573 | 17.573 | 8.174936017e-08 | -9.585321409e-07 | 17.573 | -4.38391634e-07

Sheet: BOM&Schematics
 |  |  |  | Power Part Schematics
BOM and Schematics
Resonant tank parameters
Parameters | Name | Value | Unit
Magnetizing inductance | L.m | 24.00 | µH
Leakage inductance | L.r | 11.00 | µH
Resonant Capacitor | C.r | 100.00 | nF
Pri. to Sec. turn ratio | n | 7.45 | -
Auxiliary to Secondary turn ratio | n.aux_sec | 3.00 | -
Input and output cap
Parameters | Name | Value | Unit
PFC input Capacitor | Cin | 2200 | nF
Number of output EL capacitor | n.Cout | 160 | -
PFC Output EL Capacitor (single) | Cout | 470 | µF
PFC Output Ceramic Capcitor | Cout ceramic | 10 | µF
HVSU connecting diodes PN
Selected component | PN
Example of Diodes PN (x 2) | S1M
Input Bridge Rectifier PN
Selected component | PN
Input Bridge Rectifier PN | GBJ1506U
Sense resistor
Parameters | Name | Value | Unit
Rsense total value | R.CS | 24.00 | mΩ
Single Rsense value | R.CS.single | 120.00 | mΩ
Number of Rsense | N.Rcs.parall | 5 | mΩ
Compensation network and Output Divider
Parameters | Name | Value | Unit
Feedback capacitor CFo | C.fo | 82.0 | nF
Feedback capacitor CF | C.f | 560.0 | µF
Feedback resistor RF | R.f | 47.0 | kΩ
feedback capacitor | C.fx | 1.6 | nF
Output Voltage upper resistor | R.I | 100.0 | kΩ
Output Voltage lower resistor | R.o | 11.0 | kΩ
Photodiode parallel resistor | R.P | 1.3 | kΩ
Bias resistor | R.B | 6.2 | kΩ | Controller Part Schematics
L6790 pin configuration
Parameters | Name | Value | Unit
Upper ZCD resistor | R.ZCD.L | 19.0 | kΩ
Lower ZCD resistor | R.ZCD.H | 680.0 | kΩ
VCO Timing Capacitor | C.T | 470.0 | pF
VCO Timing Resistor | R.T | 11.0 | kΩ
Burst Mode resistor | R.BM | 30.0 | kΩ
CFG resistor | R.CFG | 30.0 | kΩ
Half Bridge Switches PN
Parameters | Name | PN
Primary switches | HVG1, HVG2, LVG1, LVG2 | STO60N045DM9
Output power stage PN
Parameters | Name | PN
Center Tap diodes | D1, D2 | TPH3R70APL1
Optocoupler PN
Parameters | PN
Feedabck Optocoupler | SFH617A
EA Voltage Reference PN
Parameters | PN
External Error Amplifier | TL431AIT

Sheet: RTC
 | 1 | 2 | 3 | 4 | 5 | 6 | 7 | 8 | 9 | 10 | 11 | 12 | 13 | 14 | 15 | 16 | 17 | 18 | 19 | 20 | 21 | 22 | 23 | 24 | 25 | 26 | 27 | 28 | 29 | 30 | 31 | 32 | 33 | 34 | 35 | 36 | 37 | 38 | 39 | 40 | 41 | 42 | 43 | 44 | 45 | 46 | 47 | 48 | 49 | 50 | 51 | 52 | 53 | 54 | 55 | 56 | 57 | 58
θ | 0.1 | 0.2 | 0.3 | 0.4 | 0.5 | 0.6 | 0.7 | 0.8 | 0.9 | 1 | 1.1 | 1.2 | 1.3 | 1.4 | 1.5 | 1.6 | 1.7 | 1.8 | 1.9 | 2 | 2.1 | 2.2 | 2.3 | 2.4 | 2.5 | 2.6 | 2.7 | 2.8 | 2.9 | 3 | 3.09 | 3.1
V.out | 25 | 25 | 25 | 25 | 25 | 25 | 25 | 25 | 25 | 25 | 25 | 25 | 25 | 25 | 25 | 25 | 25 | 25 | 25 | 25 | 25 | 25 | 25 | 25 | 25 | 25 | 25 | 25 | 25 | 25 | 25 | 25 | 25 | 25 | 25 | 25 | 25 | 25 | 25 | 25 | 25 | 25 | 25 | 25 | 25 | 25 | 25 | 25 | 25 | 25 | 25 | 25 | 25 | 25 | 25 | 25 | 25 | 25
V.f | 0 | 0 | 0 | 0 | 0 | 0 | 0 | 0 | 0 | 0 | 0 | 0 | 0 | 0 | 0 | 0 | 0 | 0 | 0 | 0 | 0 | 0 | 0 | 0 | 0 | 0 | 0 | 0 | 0 | 0 | 0 | 0 | 0 | 0 | 0 | 0 | 0 | 0 | 0 | 0 | 0 | 0 | 0 | 0 | 0 | 0 | 0 | 0 | 0 | 0 | 0 | 0 | 0 | 0 | 0 | 0 | 0 | 0
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
IF<0,005 | 0 | 0 | 0 | 0 | 0 | 0 | 0 | 0 | 0 | 0 | 0 | 0 | 0 | 0 | 0 | 0 | 0 | 0 | 0 | 0 | 0 | 0 | 0 | 0 | 0 | 0 | 0 | 0 | 0 | 0 | 0 | 0 | 0 | 0 | 0 | 0 | 0 | 0.546019157 | 0 | 0 | 0 | 0 | 0 | 0 | 0 | 0 | 0 | 0 | 0 | 0.7101449275 | 0.7246376812 | 0 | 0 | 0 | 0 | 0 | 0 | 0

Sheet: OutCap_Sel_DB
Case Size Table and Permissible Ripple Current |  |  |  |  |  |  |  | Multicomp PRO MCLPR Series
W.V. | Cap.(μF) | Case Size ØD [mm] | Case Size L [mm] | R.C. [A rms] | tan(delta) | Estimated ESR | Volume cm3 | Cap/Vol | Energy/Vol maximum | Energy/Vol suitable cap | Total volume | Min | W.V. | Cap.(μF) | Case Size ØD [mm] | Case Size L [mm] | ESR | Expected cap volume [cm3] | W.V. | Cap.(μF) | Case Size ØD [mm] | Case Size L [mm] | ESR | Number of caps | Volume check
25 | 3300 | 20 | 30 | 2.05 | 0.2 | 0.08038128439 | 9.424777961 | 350.1408748 | 109419.0234 |  |  |  |  |  |  |  |  | 141.3716694 | 50 | 4700 | 30 | 25 | 0.08465688462 | 8 | 141.3716694
25 | 3300 | 22 | 25 | 2.1 | 0.2 | 0.08038128439 | 9.503317777 | 347.2471486 | 108514.7339
25 | 4700 | 20 | 30 | 2.5 | 0.3 | 0.08465688462 | 9.424777961 | 498.6854884 | 155839.2151
25 | 4700 | 22 | 25 | 2.2 | 0.3 | 0.08465688462 | 9.503317777 | 494.5641207 | 154551.2877 |  |  |  |  |  |  |  |  | Output voltage |  | 25 | link
25 | 5600 | 22 | 31 | 2.6 | 0.3 | 0.07105131388 | 11.78411404 | 475.2160391 | 148505.0122 |  |  |  |  |  |  |  |  | Ripple pk-pk |  | 10
25 | 6800 | 22 | 30 | 2.85 | 0.3 | 0.05851284672 | 11.40398133 | 596.2829824 | 186338.432 |  |  |  |  |  |  |  |  | Maximum output voltage |  | 31.25
25 | 6800 | 25 | 26 | 2.7 | 0.3 | 0.05851284672 | 12.76272016 | 532.8017787 | 166500.5558 |  |  |  |  |  |  |  |  | Min cap for ripple pk-pk |  | 35623.62 | link
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
450 | 220 | 25 | 50 | 1.06 | 0.2 | 1.205719266 | 24.54369261 | 8.963606395 | 907565.1475
450 | 220 | 35 | 37 | 0.97 | 0.2 | 1.205719266 | 35.59817176 | 6.180092661 | 625734.3819
450 | 330 | 35 | 47 | 1.13 | 0.2 | 0.8038128439 | 45.21929926 | 7.297768993 | 738899.1105
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
