yohan924-ops/L6790A-Single-Stage-PFC-LLC-Converter/PQ50/Design Guide/figures/an/bom_power_stage.png

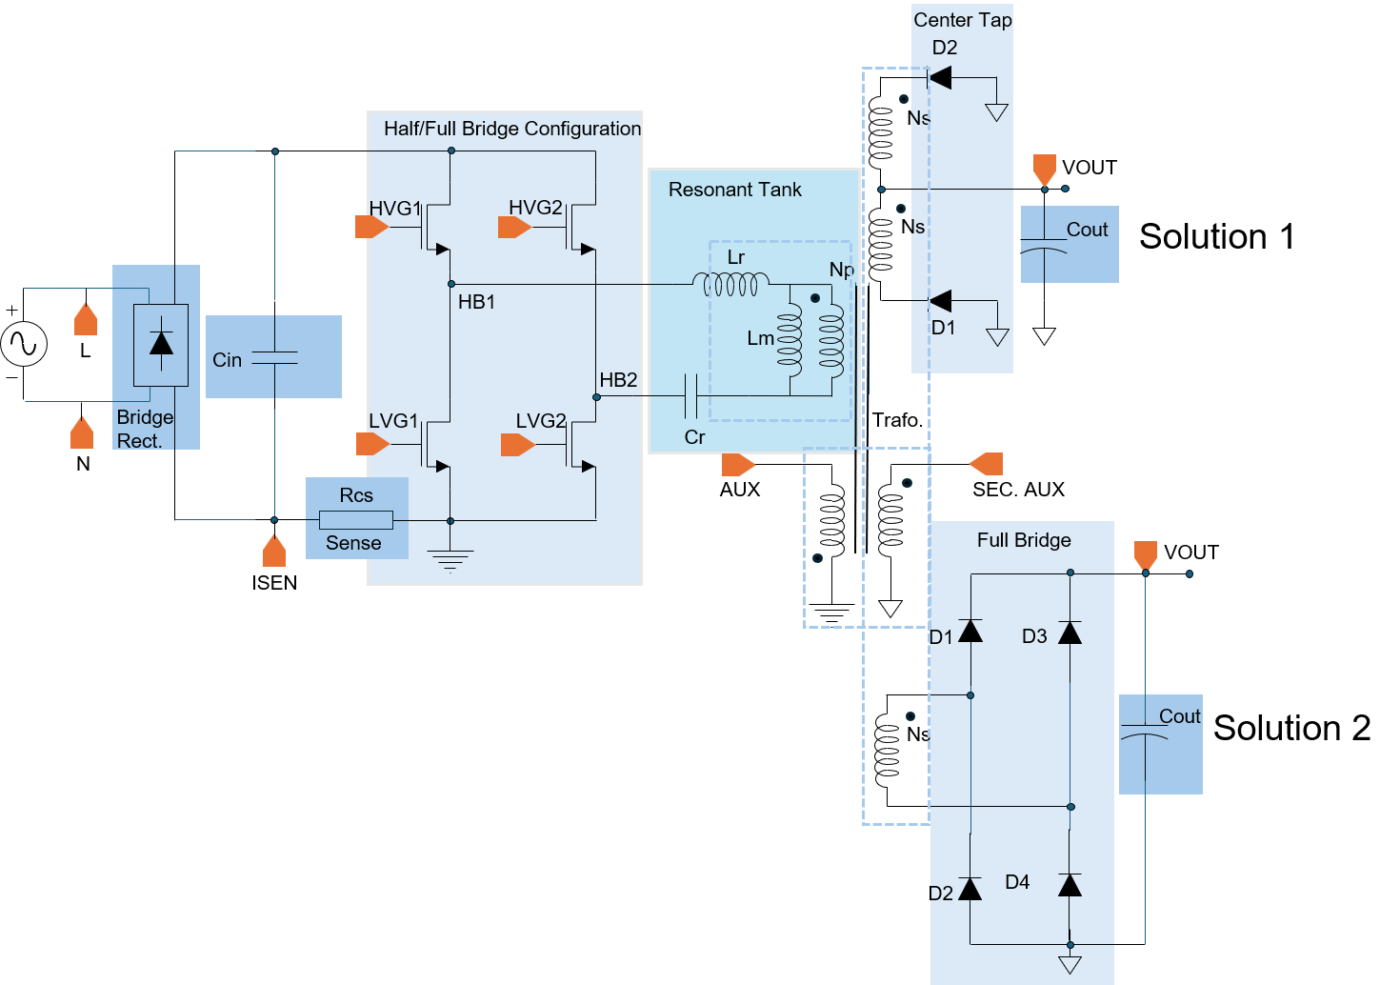
PQ50/Design Guide/figures/an/bom_power_stage.png
