yohan924-ops/L6790A-Single-Stage-PFC-LLC-Converter/docs/LG_26OP-LM83W_core_construction.pdf

위쪽 반쪽 (센터 다리에 갭 · 승인원 "TOP GAP")

갭 위치 (길이는 승인원에 없음)

아래쪽 반쪽 (갭 없음)

A = 64.0 (폭)

C = 33.5 (깊이)

D 8.0
창 24.0

4.0

한 반쪽: 판 1.6 + 다리 0.7 = 2.3 mm. 두 반쪽을 맞대면 두께 4.6 mm, 창 높이 1.4 mm.
한 쌍의 A_e 113.1 mm² · l_e 57.13 mm · V_e 6461 mm³ (승인원 17쪽). 두께 방향은 3배로 그렸다.

## ① 코어 한 세트 = 반쪽 2개 (EE6405 한 쌍)

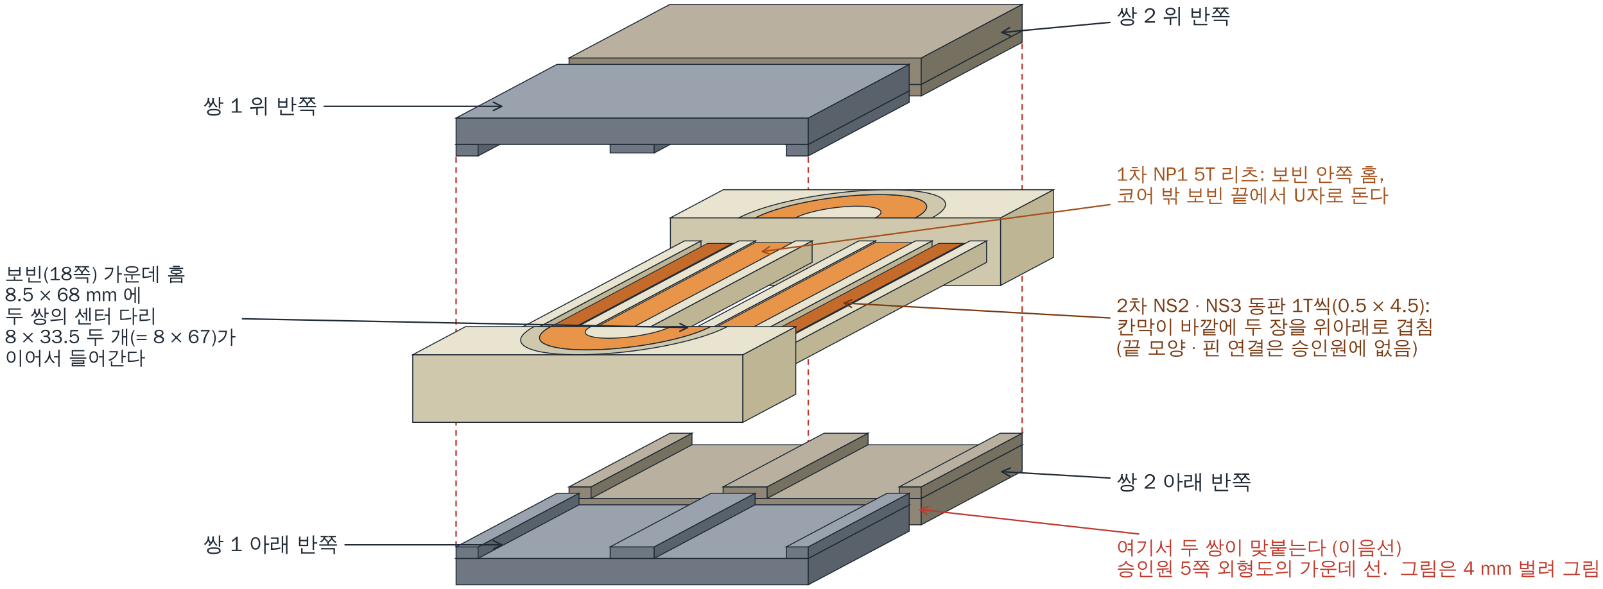
[picture p8: figure]
여기서 두 쌍이 맞붙는다 (이음선) 승인원 5쪽 외형도의 가운데 선. 그림은 4 mm 벌려 그림; 보빈(18쪽) 가운데 홈 8.5 × 68 mm 에 두 쌍의 센터 다리 8 × 33.5 두 개(= 8 × 67)가 이어서 들어간다; 1차 NP1 5T 리츠: 보빈 안쪽 홈, 코어 밖 보빈 끝에서 U자로 돈다; 2차 NS2 · NS3 동판 1T씩(0.5 × 4.5): 칸막이 바깥에 두 장을 위아래로 겹침 (끝 모양 · 핀 연결은 승인원에 없음)

두께 방향 3배. 보빈 끝 블록의 홈 깊이는 단순화.

## ② LG 26OP-LM83W: ①의 한 쌍을 깊이 방향으로 2쌍 → 반쪽 4개 + 보빈 하나 + 권선 한 벌 (분해도)

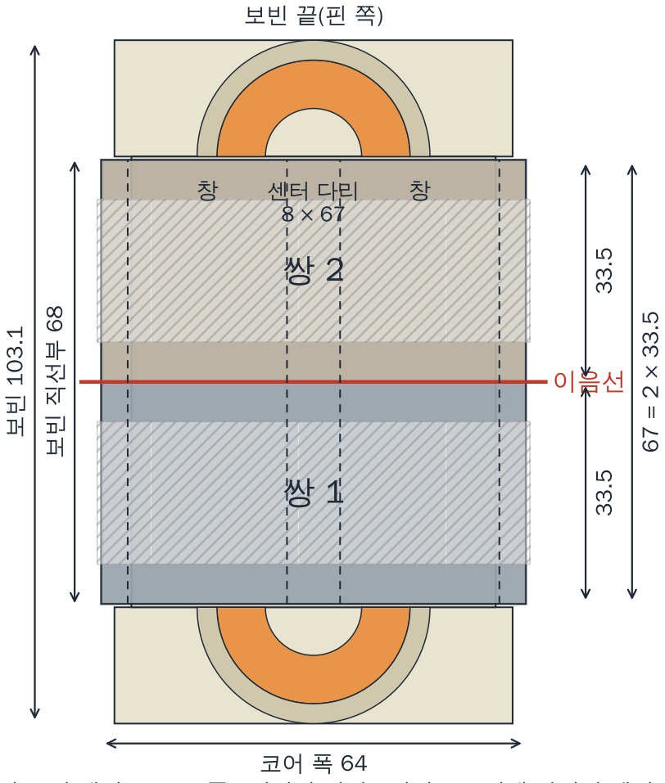
[picture p9: figure]
이음선33.5 33.5; 직선부 68

빗금 띠 = 코어 고정 테이프(21.5 폭), 쌍마다 하나. 점선 = 코어에 가려진 센터 다리 · 창. 주황 = 1차 권선이 코어 밖으로 나와 U자로 도는 부분.

## ③ 위에서 본 모습 (축척 그대로, mm)

2차 NS2 · NS3 동판 2장 (겹침)

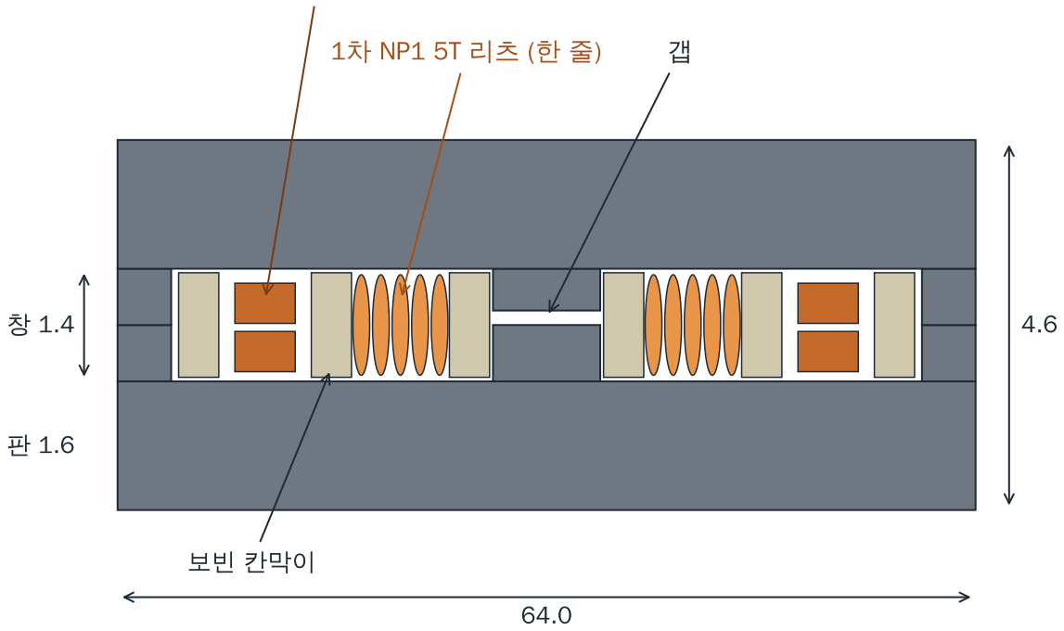
[picture p10: figure]
보빈 칸막이

창 24.0 | 8.0

창 폭 24 mm 를 바깥쪽부터: 보빈 레일 · 2차 동판 · 칸막이 · 1차 리츠 · 안쪽 벽 순(승인원 11쪽 · 18쪽).
높이 1.4 mm 라 1차는 한 줄, 2차는 0.5 mm 판 두 장이 한계. 갭 길이 · 리츠 외경은 승인원에 없어 크기 없이 위치만 표시.

## ④ 단면 A–A: 한 쌍을 폭 방향으로 자른 면 (두께 방향 6배)

이음선

쌍 1 | 쌍 2

갭(위 반쪽 센터 다리, 길이 미기재)
1차 권선
(U자 끝)

1차 권선
(U자 끝)
보빈 끝 | 보빈 끝
33.5 | 33.5

센터 다리 67 (= 33.5 × 2)

권선은 두 쌍의 센터 다리 전체(67 mm)를 한 바퀴로 감싸고, 코어 밖 보빈 끝에서 돌아 나간다. 그래서 자속이 지나는 단면도 두 쌍 합계: A_e 113.1 × 2 = 226 mm² (높이는 한 쌍과 같은 4.6 mm).

## ⑤ 단면 B–B: 센터 다리를 길이 방향으로 자른 면 (두께 방향 6배)

# LG 26OP-LM83W (KH필룩스) 트랜스포머 하나의 구성 — 승인원 치수 그대로

코어 EE6405 반쪽 4개 = 한 쌍(반쪽 2개)을 깊이 방향으로 2쌍 맞붙임. 권선 하나가 두 쌍의 센터 다리를 한꺼번에 감는다. (LG 보드에는 이 트랜스포머가 3개, 1차 직렬)

근거(승인원, KH필룩스 2025-05-26): 17쪽 코어 치수 A 64 · B 2.30 · C 33.5 · D 8.0 · E 56 · F 0.70 · B-F 1.60 / 18쪽 보빈 중앙 홈 8.50 · 직선부 68.00 · 82.50 · 97.10 · 103.10 · 14.50 · 29.10 · 35.10 · 48.90 · 54.90 · 60.00 / 5쪽 외형도: 도면의 143.9 mm 치수를 자로 재면 코어 영역 66.9 mm, 윗면 · 밑면 모두 정확히 가운데에 이음선, 테이프 띠가 각 쌍 중심에 하나씩 / 6쪽 권선표 / 11쪽 내부 구조(8절).
사양서 어디에도 코어 수량은 숫자로 적혀 있지 않다(19쪽 QC 공정도는 다른 모델 24OP-LM77G 의 표). 갭 길이 · 리츠 외경 · 2차 동판의 끝 모양은 승인원에 없어 치수 없이 그렸다.
