yohan924-ops/L6790A-Single-Stage-PFC-LLC-Converter/PQ50/Design Guide/generators/README.md

# 도구 체인과 함정 — `Design Guide/generators/`

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

**무엇이 어디 있나**

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

---

## 9. 도구 체인 — 이것으로 전부 재생성·검증된다

전부 `Design Guide/generators/` 에 있고, 경로는 스크립트 기준 상대경로다.

| 스크립트 | 역할 |
| :--- | :--- |
| **`l6790.py`** | **수치 정본.** 가이드 식 [1]–[106] + θ 스윕의 검증된 참조 구현. **`zvs_edge(Q, λ)` 신설**(2026-09-17) — 용량성/유도성 경계의 닫힌형. `phase()` 의 분자를 0 으로 놓은 `f_n²` 의 이차식이고 수치해와 5자리 일치한다. 게인 피크와 혼동하지 말 것 (시트 §6.1 항목 8b) |
| `l6790_validate.py` | `l6790.py`가 240 W 예제를 재현하는지 한 번에 확인 |
| **`build_l6790_smath.py`** | 정본 시트 본문. 실행하면 **`l6790.py`와 22개 항목을 자동 대조**하고 결과를 찍는다 |
| **`zedpane.py`** | **ZedGraph 판(BinaryFormatter blob)의 바이트 편집기.** 축 범위·눈금 간격·숫자 서식·제목/범례 문자열·선 굵기·로그↔선형. 전부 `Reference/Smath Bode Plot Example/Zedgraph` 의 ZedGraph 5.1 소스에서 나온 것이고 추측이 없다. **판 크기(`set_size`)는 쓰지 말 것** — 함수에 이유가 적혀 있다 |
| **`harvest_pane.py`** | **SMath 가 키운 판을 떼어내 이 프로젝트 것으로 만든다.** SMath 는 판의 곡선 목록을 입력 개수에 맞추고 저장 시 되쓰므로, 4곡선 판에 8개를 먹이고 저장하면 8곡선 판이 파일에 남는다. 그것을 `panes/*.b64` 로 보관하고 곡선마다 이름(`set_curve_labels`)과 굵기를 준다. **새 곡선의 Label 은 빈 문자열을 *참조* 하고 있어** 그 참조를 문자열 레코드로 바꿔야 한다. 첫 Label 은 클래스 정의 레코드라 이름(`ZedGraph.Label`)으로 찾는다 |
| **`zedsheet.py`** | **TI 앱노트 판 카탈로그(트레이스 1~5개)와 `make()`/`emit()`.** 어느 판이 로그 x + 선형 y 이고 어느 판이 전부 로그인지가 표로 있다. `build_gainzed.py` 와 `build_l6790_smath.py` 가 같은 것을 쓴다 |
| **`smsheet.py`** | 레이아웃 빌더. **모든 수식 문자열을 두 번 파싱한다** — 한 번은 SMath RPN, 한 번은 Python SI 값. 따라서 인쇄된 값이 옆의 수식과 어긋날 수 없다 |
| **`check_theta.py`** | **`prog` 블록(벡터 대입)을 검사하는 유일한 도구.** 다른 모든 수식은 `smsheet` 가 RPN 과 Python 으로 **두 번** 파싱하므로 인쇄된 값이 옆 수식과 어긋날 수 없는데, 벡터 대입은 인쇄되는 값이 없어 오타가 어디에도 안 나타난다 — 시트가 틀린 곡선을 그럴듯하게 그릴 뿐이다. 빌더에서 수식 **문자열을 꺼내** Python 으로 평가해 시트 §8 의 닫힌형과 대조한다(θ=π/2 에서 `f.sw.a`·`f.sw.b`, θ→0 에서 `f.o`, 그리고 시트 §7.5 의 `M.Z`·`M.OL`) |
| **`check_sm.py`** | 완성된 `.sm`을 다시 훑는다: XML 적합성 / 리전 겹침 / 우측 여백 초과 / 텍스트 재줄바꿈 / 허용 밖 함수 / 쪽수·그래프·노란 셀 수 |
| **`bom_compare.py`** | **엑셀 ↔ SMath BOM 29항목 대조** — 빠르다. hook이 매번 돌린다 |
| `fix_xl_cardano.py` | **`RTC` 격자 탐색을 Cardano 닫힌형으로** — 18블록(행 220–234). `rtc_check.py` 로 편차 0.0000 % 확인 |
| `fix_xl_fbcorner.py` · `fix_xl_fnmax_shared.py` | `Vin_max` 를 FB 코너(332.34 V)로 + `fn.max` 클램프. **후자는 공유 수식을 깨뜨려 되돌렸다** — `HISTORY.md` 시트 §3.7 |
| `fix_xl_ipri.py` | 1차 실효의 θ=0 끝점(자화 전류) |
| `fix_xl_f.py` | 실현 출력전압을 `Design Spec` 에 표기 |
| `fix_xl_suend.py` | `Device Setting` D71 기동 종료 ZCD 임계 1.35 → **1.36 V**(DS 값, 2026-09-24 사용자) + D88·D98·D99 캐시값 재계산 · CHANGELOG 기록. 정본·variants 복사본·6:1 |
| `fix_xl_aux2t.py` | `Device Setting` F83 `n.aux` 1.5 → **1.0**, F91 `R.ZCD_H` 330 → **220 k**, B84 설명(보조권선이 제너 레귤레이터를 거쳐 VCC 공급 — D84 < 1 은 **의도된 차이**), D84–D100 · `BOM&Schematics` E56 캐시 재계산 · CHANGELOG. 정본·variants 복사본·6:1 (2026-09-25) |
| `fix_xl_cc.py` | **원인 B(C.18) 수정** — `CC` 에 θ 3열 + Simpson 적분(열 J)을 넣고 설계를 거기에 연결. 적용됨 |
| **`fix_xl_simpson_refs.py`** | **살아 있는 참조 위에 손으로 적은 상수가 얹혀 있었다** — C.18 이 `CC` 에 Simpson J열을 만들고 세 셀만 연결했다. `Power Components` D60·D61·D84·D85 는 θ=π/4 한 점(`CC!C..`)을 읽은 채 F열 손입력으로 덮여 있었다. J열로 연결하고 손입력 4칸 삭제 |
| **`fix_xl_comp.py`** | **kT 를 1 에서 2 / 1.5 로** — 데이터시트 max 는 25 °C 공정산포이지 온도가 아니다. 그리고 **`V.Fo` 1.45 → 1.15 V** — 이 한 입력이 두 문서의 R_B 창을 **겹치지 않게** 벌려 놓고 있었다. R_P 1.3 k · R_B 6.2 k |
| **`fix_xl_trunc.py`** | **[64] 가 [63] 과 다른 파형을 제곱하고 있었다** — 공진 위에서 사인이 잘리는데 실효값은 온전한 반사인파로 계산했다. `CC` 25·31·32행에 절단 인수 [64a]. **저입력에서는 인수가 정확히 1 이라 값은 하나도 안 움직인다** |
| `fix_xl_bodydiode.py` | 1차 스위치 블록에 바디 다이오드 역회복 **조건** 2행 (`Power Components` D74·D75) |
| **`fix_xl_fet.py`** | **FET 선정 결함 4건** — 1차 전류 정격을 합성 탱크 피크로 · 병렬 소자 수와 소자 1개당 전류 4행 · Rdson 온도계수 · 다이오드/SR 선택. `audit_fet.py` 가 찾아낸 것들 |
| `fix_xl_fnmax_num.py` | `RTC` 26·27행 `#NUM!` 288칸. 원인 E 이후 요구 게인이 무부하 점근선 아래로 내려가 `fn.max` 의 해가 사라졌다. `CG26` 의 가드를 전 열에 적용 |
| **`fix_xl_english.py`** | **워크북을 한 언어로.** 한글 57칸(CHANGELOG 50 + 라벨 7)을 영문으로. 수식·참조·수치는 손대지 않는다 |
| **`log_xl_findings.py`** | **셀은 안 건드리고 워크북 CHANGELOG 에만 기록한다.** 두 가지 — ① `CC` J열 Simpson(7점)과 시트의 5점 규칙을 2000구간 격자와 대조했더니 **0.0011 % · 0.0013 %** 낮다(성긴 적분이 정당하다는 증거가 없어 나중에 '개선'되거나 의심받을 자리였다) ② **`Design Spec D43`(fsw.max)은 탱크의 *상류*다** — `Res. Tank Design D13·D14` 가 그것으로 나누므로 **λ 를 계산하고 따라서 `L.m` 을 계산한다.** `Device Setting` 의 오실레이터 천장과 종류가 다르다 |
| **`log_xl_unlogged.py`** | **CHANGELOG 에 빠진 변경을 채운다.** ST 원본과 설계 시트 7장을 수식·상수 단위로 대조해, CHANGELOG 열 C 가 부르지 않는 셀에 한 줄씩 쓴다(Was/Now 는 두 파일에서 읽고 Why 만 적는다). 셀은 안 건드리고 calcChain 도 보존. 다시 돌려도 더하지 않는다. 인자로 변형 워크북을 줄 수 있다 |
| `fix_xl_causes.py` · `log_xl_causes.py` | **원인 A·C·D 의 셀 수정과 그 CHANGELOG 기록.** 이미 적용됐다. 다시 돌려도 안전하다 — 적용 여부를 보고 건너뛴다 |
| **`rtc_check.py`** | **`RTC` 격자탐색의 *답*을 독립 solver 둘과 대조** — 18점(θ 6 × 입력 3). 10,008셀을 읽는 대신 결과를 본다. 셋이 코드를 공유하지 않으므로 격자가 깨지면 반드시 어긋난다 |
| **`audit_xl.py`** | **워크북 구조 감사** — 죽은 셀 · 오류값 · 빈 셀 참조 · **선정값이 자기 한계 밖** · 수식에 박힌 상수 · 라벨/수식 방향 불일치 · **선정값을 무시하고 계산값을 읽는 곳** |
| **`audit_sm.py`** | **시트 구조 감사** — 죽은 변수 · 정의 전 사용 · **한계는 있는데 비교가 없는 짝** · 설명 없는 판정값 |
| **`audit_rpn.py`** | **`.sm` 의 RPN 을 되읽어 독립 평가.** 인쇄된 값은 smsheet 의 Python 계산이고 SMath 가 실제로 도는 것은 RPN 이다. 둘이 같은지 보는 유일한 검사 |
| **`audit_dim.py`** | **차원 해석.** 두 평가 경로 모두 단위를 스칼라로 다루므로 `V + A` 를 못 잡는다. 표시 단위가 계산 차원과 맞는지도 본다 |
| **`xl_sm_compare.py`** | **엑셀 ↔ SMath 전량 대조 135항목** — 사양·전력예산·탱크·전류·출력뱅크·IC정수·루프·보상망. 차이마다 `same` / `INTENDED`(사유 인쇄) / `** DIFF` 로 판정. **워크북을 손댔으면 이걸 돌린다** |
| **`xlsx_patch.py`** | **워크북 XML 안전 편집.** `set_cell()`(교체-또는-순서맞춰-삽입) + 쓰기 전 전 시트 구조 검사. 인자 없이 실행하면 현재 워크북을 점검만 한다 |
| **`snapshot.py`** | **CLAUDE.md 시트 §3을 시트에서 다시 만든다.** `--check` 신선도 검사 · `--picks` 노란 셀(사람이 고른 값) 목록. 지난번 대비 무엇이 움직였는지 찍어 준다 |
| **`smresult.py`** | **`<result>` 블록의 값을 제대로 읽는다.** `<result>` 도 RPN 이라 첫 토큰만 읽으면 **단항 마이너스와 지수가 통째로 사라진다.** 도구 4개가 같은 가정을 독립적으로 하고 있었다 (`HISTORY.md` 시트 §6.6) |
| **`audit_fet.py`** | **1차·2차 FET 선정 파라미터 감사** — LLC 가 요구하는 항목별로 워크북 셀과 SMath 변수가 *있는지* 와 *수식에 쓰이는지* 를 따로 판정한다. 있는데 안 쓰이는 쪽이 더 위험하다 — 검토한 것처럼 보인다. 온도 정합성(Rdson 25 °C ↔ Tj 125 °C)도 함께 본다 |
| **`cores.py`** | **코어의 카탈로그 값과, 그것으로 푸는 권선 기하.** 코어는 둘 — AN 예제의 **PQ 50/50(TDK B65981A · N97, 카탈로그 보빈 B65982E 12핀, `CHOSEN`, 이 복사본 72차)** 과 3코어 설계점의 **PQ 40/40**. `CORES` 는 데이터시트의 전자기 값, **`MECH` 는 치수도의 기계 치수**(TDK PDF 벡터에서 읽음: 바깥다리 원호 반경 `r_win_out` 22.0 · 공차 끝 `r_win_min` 21.65, 나비넥타이 요크 `wing` · `leg_y`, 플랜지 끝 반경 `r_rim`, 튜브 `tube_od`/`tube_max`, 권선 폭 `wind_w` 30.4, 핀 피치). `zones(name, ρ)` 가 반경 ρ 의 한 턴을 바깥다리 옆 · 요크 밑만 · 코어 밖 세 구간 길이로 나누고(`YOKE_SHARE` 0.5 는 가정), `turn()` 이 그것으로 평균 턴을 낸다. **`winding(V)` 가 권선을 배치하고 `report(V)` 가 그 산수를 인쇄한다** — 단면도(`figs_ref.an_core_section`)는 결과를 그리기만 한다. **들어가지 않으면 `fits` 가 False, `why` 에 이유.** 배치는 **섹션 권선**: 튜브 쪽에서 1차 한 칸(`PRI_LAYERS` 3층 × 5 T, TIW-Litz `D_PRI` ø2.9) | 칸막이 `PARTITION` 3.0 mm | NS2 한 층 → NS3 한 층(`SEC_PER` 2 T 나란히, Litz `D_SEC` ø4.0) + NAUX, **턴당 한 가닥(`PRI_PAR` · `SEC_PAR` 1) · 뒤집기 없음**. 선경은 둥근 값으로 정했다(사용자). 층 사이 피치 `K_WIND` 1.10(가정), 층마다 테이프 `T_TAPE` 0.05 mm(가정), 축 방향 피치 `k_ax` 는 두 칸과 칸막이가 권선 폭을 정확히 채우도록 넓힌다. 반환값에 `build` · `room_min` · `clear_min` · `clear_nom`(원호까지 여유). 핀은 `BOBBINS` — 핀당 한 가닥, 센터탭은 보드에서 잇는다(핀 9 · 10). **핀 번호 방향은 도면의 1 · 6 · 7 · 12 표시에서 읽었다.** 옛 나란히 감기 + 포일 배치는 **`winding_v64()`** 로 남았다 — 이식 전 한국어판(`an_kr_body.py`)이 그 키를 읽기 때문이고, 이식 때 지운다 |
| **`bobbin_outline.py`** | **B65982E 보빈 윤곽을 데이터시트 벡터 도면에서 읽는다.** `data/TDK_B65982E_coil_former.pdf`(TDK databook 04/13 p. 287, 도면 FPK0433-H, 1:2) → `data/B65982E_outline.json`(밑면도 · 정면도 · 윗면도의 윤곽 · 숨은선 · 핀, mm). 굵은 선(0.57 pt)=윤곽, 짧은 점선(0.29 pt)=숨은선, 0.38 pt=핀; 치수선 · 글자 · 중심선은 버린다. **뷰 이름이 도면에 없어서 판단 근거를 코드에 적었다**: 핀 끝이 원으로 보이고 1 · 6 · 7 · 12 가 적힌 뷰(정면도 위)가 밑면도, 핀이 없는 뷰(정면도 아래)가 윗면도 — 제1각법. `--check` 가 도면 치수(핀 12개 · 줄 간격 45.72 · 피치 7.62 · 그룹 간격 12.7 · 높이 51 · 폭 51.6 · 실장면 위 높이 52.5)와 대조(선 두께 때문에 윤곽은 +0.4 mm 쯤). 그림 45(`figs_ref.an_xfmr_pins`)가 읽는다 — 핀 위치는 `cores.PIN_XY`(치수값), 윤곽 모양만 이 파일 |
| **`leakage_fem.py`** + **`fem2d.py`** | **그린 권선의 누설 — PQ 에서의 기준.** `fem2d` 는 2D 유한체적 A_z 풀이기(scipy), `leakage_fem` 은 `cores.winding()` 배치를 두 단면(바깥다리를 지나는 코어 단면 · 턴이 코어 밖으로 나가는 끝단 단면)으로 풀고, 반경마다 `cores.zones()` 의 턴 길이로 가중한다. `estimate(V, only='NS2'|'NS3')` 가 반쪽 단락, 기본은 둘 다 단락. `gap_len(V)` 는 L_open 에 맞는 갭(프린징 포함, 이분법), `proximity(V, f)` 는 스트랜드 와전류(부하 전류 + 자화 전류 직교 합), `dc_loss(V)`, `self_test()`(1D 닫힌 식과 5e-5), `report(V)`. 결과는 `.fem_cache.json`(무시 파일)에 저장. `MU_R` 2000 은 가정. 이 복사본 값: 반쪽 **NS2 24.50 · NS3 25.14 µH**, 둘 다 단락 **23.09 µH**(요크 몫 0–1 에서 21.89–24.29), 꽉 감으면 23.20, 칸막이 2.5 mm 22.50 · 2.0 mm 21.92, 갭 1.784 mm(프린징 없으면 1.341), 구리 직류 2.27 W |
| **`leakage.py`** | **1D 해석식 누설(Roth 급수 + 창 밖).** 턴 길이를 하나(`l_N`)로 두어 PQ 의 깊은 권선에서 **반쪽 순서를 거꾸로 낸다**(NS2 > NS3) — PQ 에서는 기준이 아니고 `leakage_fem.py` 가 기준이다. AN 의 1D 상한 추정 한 줄에만 쓴다 |
| **`figstamp.py`** | **그림이 낡았는가 — 다시 그리지 않고 판정.** `figs.save()` 가 PNG 마다 설계값 해시(`an_pdf.V` · `SH` · `cores.winding`)와 그린 함수의 소스 해시를 새기고, 이 스크립트가 지금 값과 대조해 `STALE` 을 찍는다(exit 1). **65차에 넣었다** — 64차가 `n.aux` · 개방시험 전류를 바꾸고 그림 1장만 다시 그려 핀 그림에 "NAUX 3 T", 기자력 그림에 15.19 A 가 남았고, 63차의 "2 ×" 수정도 `f13_morphing` PNG 에 반영된 적이 없었다. **Stop hook 의 6번째 검사.** 설계값이 움직이면 전 그림이 STALE 이 되므로 `figs.py --plain` 전량(약 10분) |
| **`insulation.py`** | **트랜스포머 안전 절연 — 미국 · EU · 일본 · 한국 · 중국 가정용 AV.** 요구치(강화 · 5000 m · 공간 4.5 · 연면 6.4 · 고체 0.4 mm / 테이프 2층 · 3000 V ac)와 **출처 URL**(`SOURCES`), 설계에서 추정한 작업전압(`working_voltage`), **경로마다 무엇이 절연을 맡는지**(`checks` — TIW 선재 · 핀 줄 간격 · 열린 항목 둘), 열린 항목(`OPEN`). `separation_min()` 은 "간격이 절연을 맡는다면"의 값(6.4 mm)으로 AN 6.17 과 `winding_v64` 가 읽는다. `cores` · 벤더 사양서 5절 · AN 7.12 가 여기서 읽는다. `python insulation.py` 가 보고서를 찍는다(약 20 s — `an_pdf` 를 읽는다) |
| **`figcheck.py`** | **그림 기하 검사 — `check_sm.py` 의 matplotlib 판.** 여섯 가지를 본다 — 글이 **남의 패널에 떨어지는가**(`wrong-panel`, 같은 자리의 twin 축은 한 패널로 친다) · **틀 밖으로 나가는가**(`off-page`) · 글이 **선 위에 앉았는가**(`on-ink`) · 글끼리 겹치는가(`text-text`) · **배선 5종**(`no-dot` 점 없는 T · `open-end` 허공에 끝나는 배선 · `crossing` 홉도 점도 없는 교차 · `off-grid` 45° 격자 밖 · `stray-dot` 두 가닥만 만나는 점) · **인쇄 축척에서 6.5 pt 미만 글자**(`tiny`, 실패가 아니라 보고 — 2026-09-23 부터 범례·눈금·축 이름·제목·`fig.text` 까지 잰다. 전에는 `ax.texts` 만 재서 11.6 in 폭 그림의 범례가 5 pt 로 인쇄돼도 통과했다. AN 에 배치되지 않은 그림은 인쇄 폭을 몰라 판정하지 않는다). **글·선 겹침은 픽셀로 잰다** — 그림을 두 번 렌더해(그대로 / 글자 alpha 0) 차이가 글자, 둘째 렌더의 잉크가 선이고, 겹친 픽셀 수를 센다(바닥 10 px). 꼭짓점만 보던 예전 검사는 점 2개짜리 배선 사이에 앉은 글자를 전부 통과시켰다. **검사 대상은 `figs.finish(fig)` 를 부른 뒤의 그림**이고 좌표는 `figs.saved_box(fig)` 기준 비율이다 — `bbox_inches=tight` 는 캔버스가 아니라 잉크를 자르므로 캔버스 기준으로 재면 1인치 넘게 어긋난다. `figs.save()` 가 저장 직전에 `shield()` 를 불러 **선 위에 앉은 글에만** 흰 후광을 입힌다 — 회로도 축은 건드리지 않는다(후광이 배선을 끊는다). `--crops DIR` 로 겹친 곳마다 확대 조각을 저장한다. 경위는 `HISTORY.md` 2026-09-21 |
| **`an_figtext.py`** | **그림 속 글자 검사**(2026-09-23 신설, 53차). 다른 검사는 본문(`an_symbols`)이나 그림의 기하(`figcheck`)만 읽고 **그림 안에 그려진 기호·숫자는 아무도 읽지 않았다** — NS2/NS3 뒤바뀜, 같은 양의 두 이름(v_tank/v_d), 회로에 자리가 없는 파형 양이 거기 있었다. 그림마다 그려진 글자를 저장 시점에 모아 ① **UNDEFINED** 기호표에 없거나 그 그림 앞 본문·캡션·앞선 그림 라벨에 없는 기호 ② **LITERAL** 그림을 그린 함수들(프로파일러로 호출된 `figs*` 함수 전부)의 **문자열 리터럴 안에** 있는 단위 붙은 숫자 — 손으로 적은 값 ③ **USES** 기호별 사용 그림(이름 불일치 발견용)을 낸다. 약 6분. 남는 LITERAL 은 관례값(400 V 버스, 100/120/230 Vac 상용전원, 측정 조건 예, 180°)뿐이다 |
| **`schemx.nodot()`** | **도면이 “여기는 접점점을 일부러 안 찍었다” 고 선언하는 자리** (2026-09-21). 세 가닥이 만나면 관례는 점을 요구하므로 `figcheck` 가 `no-dot` 으로 잡는데, 뺄 이유가 있는 자리는 **검사를 느슨하게 하는 대신 도면이 사유를 등록한다** — 안 그러면 다음번 진짜 누락이 같은 침묵에 묻힌다. 검사기는 `nodot` 으로 **보고하되 세지 않는다**(레일 `stub` 과 같은 취급). 지금 쓰이는 곳은 8구간 시트의 센터탭 하나다 |
| **기호 크기 규칙** (`schemx.scale`) | **기호는 *자기 그림 폭에 비례* 한다** — 데이터 단위 고정도, 가지 길이 비례도 아니다. `scale = max(자기 폭 / `REF_SPAN` 22.45, (자기 폭 / 축의 그림 폭 비율) / `REF_FIGSPAN` 46.0)` — 바닥 규칙은 "종이 위에서 8구간 패널의 기호보다 작아지지 않는다" 는 뜻이다. **바닥은 축의 *명목* 위치를 읽으므로 `subplots_adjust` 를 그리기 *전에* 부른다.** **권선은 턴 *반경* 을 고정하고 턴 수를 높이에서 뽑는다**(반대로 하면 긴 권선의 턴이 커진다). 코어 바 길이는 턴 반경에 비례하고, 극성점은 리드선 **바깥쪽 · 첫 턴 높이**에 둔다. **`schem.ind` 의 리드 흡수 판정은 `s` 의 비율이 아니라 턴 반경의 절반이다** — 비율로 재면 큰 인덕터에 1 px 리드가 남아 **없는 3갈래 접점**을 만든다. 현재 값 cap 0.56–0.64 · res 1.15 · turn 0.26–0.30 · winding 0.54–0.60, 회로 다이오드 0.52/0.56, **바디 다이오드만 0.26**(기생 소자). **8구간 패널은 명시 크기를 쓰므로 픽셀 단위로 그대로다.** 경위는 `HISTORY.md` 2026-09-21 |
| **`audit_guide.py`** | **가이드 수식 태그 감사** — 중복 태그 · 끊어진 참조 · 코드에 대응이 없는 식 |
| **`an_pdf.py`** | **PDF 레이아웃 엔진 (영문·한국어 AN 공용)** — 표지·법적고지·점선 목차·머리글·번호 붙은 수식(matplotlib mathtext → PNG)·그림/표 캡션. `T()` 가 **포맷 안 된 `%%`·`%(…)` 를 거부**한다 |
| **`an_body.py`** | **AN 본문.** 레이아웃과 분리돼 있고 **손으로 적은 상수가 없다** — 전부 `an_pdf.V` 보간 |
| **`figs.py`** | 그림 생성 — 교육자료 영문 · 가이드 한국어. **한글 글꼴이 없는 PC 에서 한글 그림을 쓰면 죽는다**(2026-09-21 `_hangul_guard`) — 이 컨테이너에는 맑은고딕·나눔이 없어 한글이 전부 네모로 그려지는데 **파일은 그대로 써져서** 좋은 PNG 를 덮어쓴다. 실제로 `loop_bode.png` 가 한 번 그렇게 됐고 `git status` 가 잡았다. `save()` 가 쓰기 직전에 한글을 세어 글꼴이 없으면 그 장을 **건너뛰고**, 끝에 어느 장을 다시 그려야 하는지 찍고 **exit 2** 로 끝난다 (한국어 전용 5장: `fsw_theta`·`gain_regions`·`loop_bode`·`morphing_levels`·`tank_current`). 처음에는 예외로 죽였는데 그러면 **영문 배치 작업이 첫 한국어 그림에서 멈춘다** — 조용히 건너뛰는 것도, 전부 세우는 것도 답이 아니다.  수치는 전부 `l6790.py` 에서 가져온다. `f15`~`f17` 모핑 브리지 3장, `f19` 출력뱅크 판정식. **`--plain` 은 제목을 빼고 `figures/an/` 에 쓴다**(AN 용). **`_morph_levels(T)` 는 두 언어가 같은 그리기 코드를 쓴다** — 복사하지 말 것 |
| **`figtrim.py`** | **참조 PDF 에서 잘라 온 그림 아래에 딸려 온 *원문 캡션 조각*을 찾아 잘라낸다.** 서명이 분명하다 — **맨 아래 가장자리에 닿는 얇은 잉크 띠 + 그 위의 넓은 공백**. 진짜 그림의 패널은 이미지 경계에서 잘리지 않으므로 이 모양은 캡션 조각뿐이다. `--fix` 없이 돌리면 보고만 한다 |
| **`pdffig.py`** | **참조 PDF 에서 그림을 캡션째 잘라낸다.** 캡션을 텍스트로 찾아 앵커로 삼는다. 벡터 도면(onsemi·Infineon)은 위로 훑고, 래스터 그림(MPS)은 이미지 사각형이 곧 정답이다. `list`/`show`/`get` · `--box` 로 수동 지정 |
| **`figedit.py`** | **참조 그림에 가하는 *기록된* 편집.** **`fix_freewheel_2nd_half()`** 가 Infineon Fig 2.8 의 전류 경로를 다시 그리고(시트 §6.1 항목 8d), **`mark_modes()`** 가 그림 8 의 네 구간에 괄호를 친다(항목 8e). **`_font()` 는 Arial 이 없으면 Liberation Sans 로 간다**(2026-09-17) — 예전에는 `ImageFont.load_default()` 로 떨어졌는데 그것은 **크기 인자를 무시하는 비트맵 서체**라, Arial 이 없는 PC(이 컨테이너)에서 머리글이 의도의 1/5 크기로 조용히 그려졌다. 지금은 못 찾으면 예외로 죽는다. 이유는 둘뿐이다 — 잘라낸 상자가 라벨을 못 담았거나, 원문 기호가 이 문서와 반대 뜻이거나. 그림이 *주장하는 바*를 바꾸는 편집은 금지. `trim()`(`figtrim` 으로 캡션 조각 제거)과 **`mirror()`** 를 갖는다. **`mirror()` 는 이 모듈이 직접 쓴 파일만 `figures/an/` 로 민다** — `figures/` 와 `figures/an/` 는 같은 집합이 아니다. 생성 그림은 `figs.py --plain` 이 **제목 없는 판**을 `an/` 에 쓰므로, 전부 복사하면 AN 이 제목 붙은 판을 읽게 된다(2026-09-08 실제로 13장을 그렇게 덮었다) |
| **`build_trans_spec.py`** | **트랜스포머 요구사양서(xlsx) 생성.** 인자로 변형(`7p5to1`/`7p5to1_x1`/`8to1`/`6to1`)을 **반드시** 받고 `Calculation Excel Sheet/variants/` 에만 쓴다 — 인자 없이 돌려 정본을 덮어쓴 사고가 두 번 났다. **수치는 전부 변형 시트에서 읽는다**(2026-09-07). 손으로 박은 상수 때문에 6:1 사양서가 `f.Min` 을 90 kHz 로 달고 있었다(참값 110 kHz). openpyxl 로 새로 그린다. **단자(핀) 번호는 `cores.PINMAP` 에서 읽는다**(2026-09-21 20차 — PQ 40/40 12핀 배정, AN 그림·표와 같은 출처). **코어 개수·보조 턴수도 이제 시트에서 읽는다**(2026-09-21) — `"Three identical transformers"` 와 보조 `1 T` 가 글로 박혀 있어 `N.x` = 2 인 변형에서 거짓말을 했다. **`openpxxl` 오타로 import 단계에서 죽어 있었다** — Drive 임포트 커밋이 들고 온 것이고, 2026-09-21 에 고쳤다. **빈 칸에 빈 문자열을 쓰지 말 것** — 숫자 서식이 걸린 칸에서 `0.00` 으로 그려진다. 값이 `None` 이면 셀에 아무것도 안 쓴다 |
| **`check_trans_spec.py`** | **완성된 벤더 사양서 xlsx ↔ 변형 시트 대조.** 빌더의 상수가 아니라 **실제로 나가는 파일**을 읽어 턴수(NAUX 포함)·개방/단락 인덕턴스·전류·A.e·주파수·개방 시험 전류와 5절 절연 요구치(연면·공간, `insulation.py` 와 대조, 그리고 NP1 선재가 TIW 인지)를 본다. 포화 시험 전류는 **1차 피크가 아니라 자속 등가 전류**로 판정한다 — 개방 시험은 2차 기자력 상쇄가 없어 같은 전류로도 자속이 훨씬 크다 |
| **`an_patch.py`** | **AN 본문을 문장 단위로 갈아 끼우는 편집기.** `an_body.build()` 의 최상위 문장을 ast 로 잡아 **고유 키 부분문자열**로 통째로 교체하거나 지운다 — 긴 원문을 그대로 베낄 필요가 없어 오타로 헛매칭할 일이 없고, 키가 0개나 2개 이상 맞으면 **아무것도 쓰지 않는다.** 2026-09-22 간결화(373문장)에 썼다. 한국어판 이식에도 같은 방식 |
| **`an_symbols.py`** | **AN 이 쓰는 기호 전수조사 — 정의 없이 툭 튀어나오는 것을 잡는다.** 한 건이 실제로 나갔다(`a.s` 를 나누는데 소선이 뭔지 `a.s` 가 뭔지 앞에 한 마디도 없었다, 2026-09-22 사용자). **눈으로는 못 한다** — 100쪽에 67식이고 아래첨자 달린 이름이 수백 개다. `an_body.build()` 를 레이아웃 호출만 기록기로 바꿔 다시 실행하므로 **보간이 끝난 최종 문장을 문서 순서대로** 읽고 수식 PNG 는 한 장도 안 그린다. 이 문서가 쓰는 두 언어(수식의 TeX · 본문의 `X<sub>y</sub>`)에서 이름을 뽑고 아래첨자의 세 표기(`\mu`·`&mu;`·`mu`)를 접은 뒤 뒤쪽 기호표와 대조한다. 보고 넷 — **MISSING**(쓰는데 표에 없다) · **SILENT**(수식에만 있고 본문이 한 번도 안 쓴다 = `a.s` 그 자체) · **LATE**(본문이 수식보다 뒤에 쓴다) · **홑글자**(영문 산문에서 `C` 가 기호인지 100 °C 인지 기계가 못 가린다 — 그렇다고 말하고 목록만 준다). 첫 실행에서 **쓰인 기호 288개 중 175개가 표에 없었다.** 표는 10개 그룹 130행이 됐고 지금 MISSING 0 이다. 가다가 조판 결함 둘도 잡았다 — `\qquad` 가 다음 기호에 붙어 `\qquadf` 가 됐고 `2nV.o,eff` 가 한 단어였다 |
| **`an_kr_pdf.py`** · **`an_kr_body.py`** | **한국어판 AN.** `an_pdf` 를 임포트해 `use_korean()` 으로 NanumGothic 을 끼우고 `EQWORD`/`EQAGAIN` 만 바꾼다. **레이아웃 코드는 한 벌뿐이다** |
| `audit_notes.py` | **시트가 실제로 인쇄하는 주석을 `.sm` 에서 읽어 감사한다.** 표준 절차에는 없고 필요할 때 부른다 |
| **`an_check.py`** | **완성된 AN PDF 의 기하 검사 — `check_sm.py` 의 PDF 판.** 쪽마다 틀 밖으로 나간 것 · 텍스트끼리 겹침 · 그림이 글 위에 얹힘 · 110 dpi 미만 그림 · 원본과 종횡비가 다른 그림. **쪽 아래 여백은 실패가 아니라 보고만 한다** — 큰 그림이 남은 자리에 안 들어가 밀리는 것은 정상이다. 사람이 40쪽을 읽으면 사람이 알아채는 것만 잡힌다 |
| **`an_locate.py`** | **그림 검사 결과를 인쇄된 쪽 위에 되돌려 놓는다.** `figcheck` 의 보고는 **그림 *이름*** 으로 말하는데 PDF 에는 이름이 없고 **그림 번호와 쪽 번호**밖에 없다 — 즉 소스를 연 사람만 확인할 수 있는 보고였고, PDF 를 든 사람에게는 검증 불가능한 주장이었다(2026-09-21 사용자 지적). **이름 → 쪽 대응은 픽셀로 푼다** — PDF 안의 이미지는 `figures/an/*.png` 를 재인코딩한 것이라 바이트는 다르지만 화소는 같으므로 48×48 회색 서명으로 맞춘다(그림 41장 전부 매칭, 수식 PNG 48개는 자동으로 떨어져 나간다 — 그 자체가 검출력 확인이다). 번호는 그 이미지 **바로 아래 캡션**에서 읽으므로 독자가 보는 번호 그대로다. 출력 셋 — 표 · **`--mark` 빨간 테두리와 그림당 메모 하나가 박힌 PDF 사본**(뷰어의 주석 목록이 곧 할 일 목록이다) · **`--crops DIR` 인쇄 크기로 렌더한 뒤 확대한 조각**(5 pt 가 *얼마나* 작은지는 숫자가 아니라 크기로만 보인다). **이 PDF 에 없는 그림은 그렇다고 말한다** — `an_pfc_idea`·`f03_gain_walk`·`morphing_levels`·`an_architectures` 는 한국어판·교육자료 소속이라 영문 AN 의 결함이 아니다 |
| **`audit_md.py`** | **CLAUDE.md·HISTORY.md의 주장을 기계로 대조** — 경로 존재 · § 참조 · 개수·용지 수치 · 표 정합성. 문서를 고쳤으면 이걸 돌린다 |
| **`coldstart.py`** | **정보 없는 새 세션이 이 문서만으로 이어받을 수 있는지 모의 검증** — 답해야 할 질문 21개가 CLAUDE.md 안에서 답이 나오는지, 문서가 시키는 명령이 실제로 도는지 |
| `guard.py` | Stop hook이 부르는 검증기 — 시트 §9.1b |
| `build_probe.py` | 진단용 소형 시트 P1–P20 생성 |
| `smgen.py` | RPN 변환기 — `smsheet.py` 가 `expr_rpn`·`assign_rpn`·`rpn_xml`·`parse` 를 가져다 쓴다. **예전에 "구 산출물용, 안 쓰임" 이라고 적혀 있었는데 틀렸다** |

### 9.1 표준 절차

```
cd "Design Guide/generators"

python build_l6790_smath.py                                          # 시트 생성 + 자동 대조
python check_sm.py "../../Smath/L6790A_SingleStage_PF_LLC_Design_Guide.sm"   # 기하·함수 검사
python bom_compare.py                                                # BOM 29항목
python rtc_check.py                                                  # RTC 격자 18점
python xl_sm_compare.py                                              # 전량 101항목
python snapshot.py                                                   # CLAUDE.md 시트 §3 갱신
python check_theta.py                                                # 시트 §8.4·시트 §7.5 벡터 ↔ 시트 §8 닫힌형
python check_trans_spec.py                                           # 벤더 사양서 ↔ 변형 시트
python an_check.py                                                   # AN PDF 기하
python an_symbols.py                                                 # 기호 ↔ 기호표 전수 대조
python audit_md.py                                                   # 문서 주장 대조
python figstamp.py                                                   # AN 그림이 현재 설계값·그림 코드로 그려졌나 (65차)
python -c "import an_pdf,cores;print(cores.report(an_pdf.V))"          # 권선이 보빈에 들어가는가
```

> **변형을 검사하려면 `SM_OVERRIDE` · `XL_OVERRIDE` 를 준다.** `check_sm.py` 는 경로를 인자로 받고, `audit_sm.py` 는 빌더를 읽으므로 3종 공통이라 스위치가 없다.
>
> ```
> SM_OVERRIDE=../../Smath/variants/L6790A_6to1.sm \
>   XL_OVERRIDE="../../Calculation Excel Sheet/variants/L6790_workbook_6to1.xlsx" \
>   python xl_sm_compare.py
> ```

**기대값:**

```
build      mismatches: 0
check_sm   VERDICT OK
bom        items compared: 29   different: 0
theta      mismatches: 0
rtc        대조 18점 · 최대 편차 0.20 % · VERDICT OK
xl_sm      대조 145항목 — 일치 145 · 의도된 차이 0 · 불일치 0
trans_spec 불일치 0 건
an_check   no geometry problems found
an_symbols 0 missing from the table
audit_md   no problems found
```

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

**빌드 후 `check_sm.py`를 반드시 돌릴 것.** 현재 상태:

```
paper A3 Landscape 1654 x 1169 · regions 1987 · overlaps 0 · right overflow 0
page straddles 0 (한 쪽이 1120 px · 접힘 25개가 23440 px 을 숨긴다)
seam clearance 가장 아슬아슬한 곳 61 px · 여백 띠 위 60 / 아래 60
text re-wrap 0 · functions [abs atan augment cos el eval ln range sin sqrt vectorize] (전부 허용 집합)
height 72250 px, 그중 48810 px 이 인쇄됨 = 44 pages · plots 0 · zedgraph 7 · pictures 3
yellow inputs 130 · VERDICT OK
```

> **"몇 쪽"은 접힘을 뺀 높이로 센다.** 접힌 영역은 종이를 안 먹으므로 파일 높이를
> 쪽 높이로 나누면 64쪽이 나오는데 실제 인쇄물은 44쪽이다. 예전에는 그 64 쪽이 문서에 적혀 있었다.
>
> **쪽 경계는 이제 실측값이다 (2026-09-09).** `Smath/L6790A_ruler.sm` — 20 px 눈금과
> **자기 y 를 적은 글자**밖에 없는 시트다. 수식이 없어 F9 가 무의미하고, 접힘이 없어
> 보이는 y 가 곧 절대 y 이고, 판이 없어 스스로 밀려날 것이 없다. 그래서 인쇄하면
> **SMath 의 경계 말고는 탓할 것이 없다.** 9쪽에서 읽은 첫 눈금이
>
> ```
> 24 · 1124 · 2244 · 3364 · 4484 · 5604 · 6724 · 7844 · 8964
> ```
>
> 이고, 쪽마다 마지막 눈금이 다음 쪽 첫 눈금에서 정확히 끝난다(1104+20 = 1124). 즉
>
> ```
> break(N) = N × 1120 + 4        PAGE_CONTENT = 1120 · PAGE_ORIGIN = 4
> ```
>
> **빌더가 쓰던 1117 · 오프셋 0 은 용지 크기에서 추론한 값이었고 틀렸다** — 쪽당 3 px
> 에 원점 4 px 이라 40쪽이면 124 px, 쪽 높이의 1/9 이다. **위 여백이 쪽마다 다르고
> 아래가 휑하던 것이 전부 이것이다.** 고친 뒤 43쪽 전부 위 여백이 정확히 60 px 이고
> 아래는 62 px 이상이다.
>
> **그리고 인쇄물이 이 모델을 채점했다 (2026-09-09, 13:22 판).** 43쪽 각각의 *첫 행*을
> 파일만 보고 예측해 PDF 와 대조했더니 **42/42 전부 맞았다**(당시 42쪽). 앞선 두 번의 역산이 실패한
> 것은 앵커로 쓴 행이 `fit()` 이 경계에 밀어 놓은 행이라 **모델이 자기 메아리를 채점**하고
> 있었기 때문인데, 이번 예측은 파일에서만 만들고 인쇄물이 독립 관측이라 그 함정이 없다.
> **쪽 경계 문제는 닫혔다. 띠를 키워서 고치려 하지 말 것.**

### 9.1b 자동 안전장치 — Stop hook (`.claude/settings.json`)

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

### 9.2 BOM은 엑셀과 SMath가 항상 같아야 한다

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

```
Res. Tank Design       F9 F43 F44 F45
Power Components       F7 D23 D24 D25 D38
Device Setting         F24 F45 D43 D46 F61 F83 F90 F91 F108 D21
CompensationNet&Check  D14 D36 F37 F41 F43 F93~F96
```

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

### 9.3 SMath 시트의 구조 (19개 절)

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

**시트 §14c 라인 반주기 (신설)** — ZedGraph 판 **3장**.

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

숫자를 새로 만들지 않는다; 시트 §17 이 비율로만 말하던 것을 한 프레임에 놓았을 뿐이다.

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

### 9.3b 시트를 PDF 로 뽑을 때의 설정 (사용자 지정, 2026-09-09)

SMath 의 CLI(`-e`·`-p`·`-t`)는 이 PC 에서 라이선스로 막혀 있으므로 GUI 로 인쇄한다.

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

### 9.4 진단 시트 `L6790A_probe.sm`

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

---

## 11. 도구 함정 — `.claude/rules/` 로 옮겼다

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
