yohan924-ops/L6790A-Single-Stage-PFC-LLC-Converter/Design Guide/figures/an/an_tank_current.png

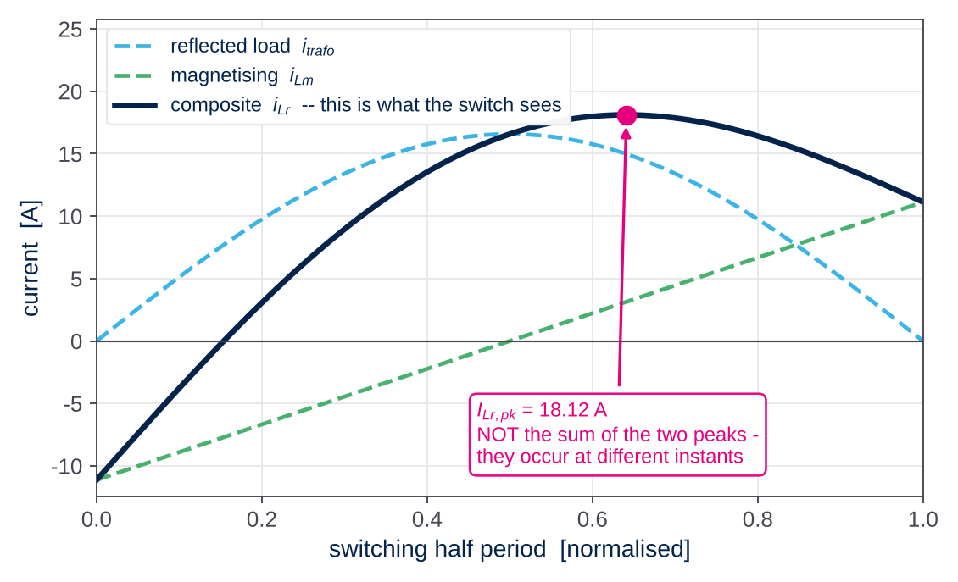
Design Guide/figures/an/an_tank_current.png
