yohan924-ops/L6790A-Single-Stage-PFC-LLC-Converter/Design Guide/figures/an/f02_two_resonances.png

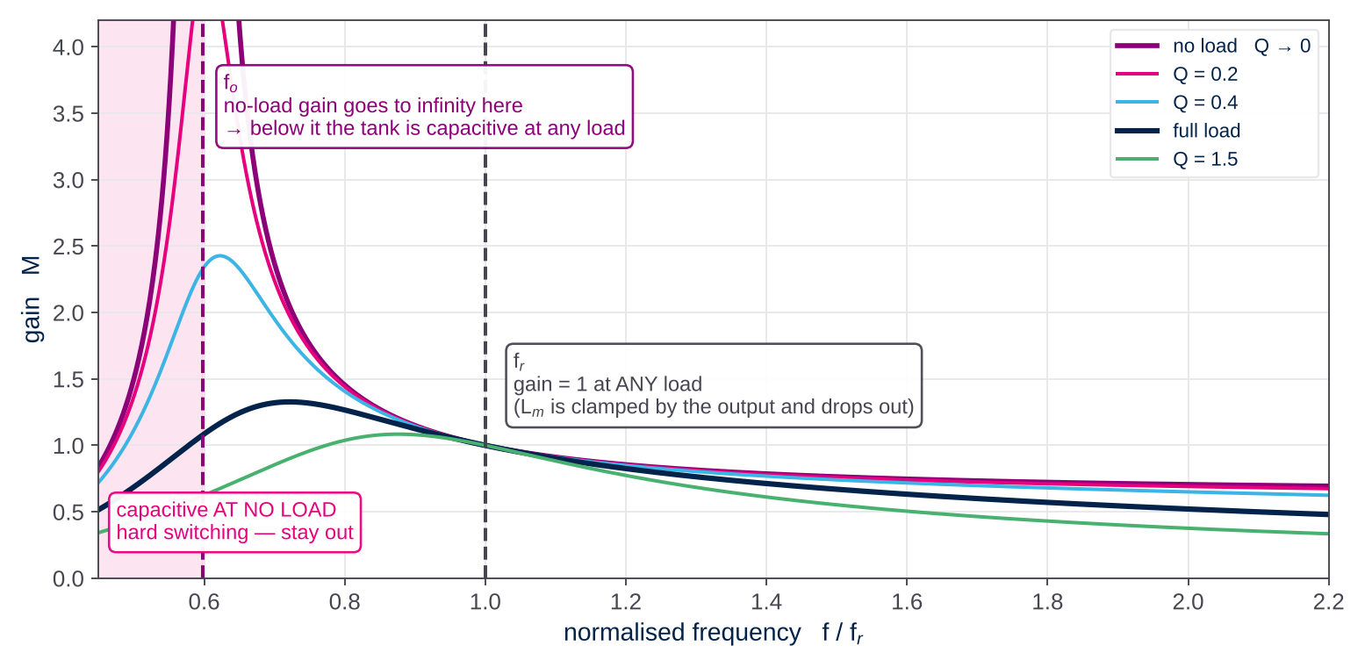
Design Guide/figures/an/f02_two_resonances.png
