yohan924-ops/L6790A-Single-Stage-PFC-LLC-Converter/Design Guide/figures/an/f03_gain_walk.png

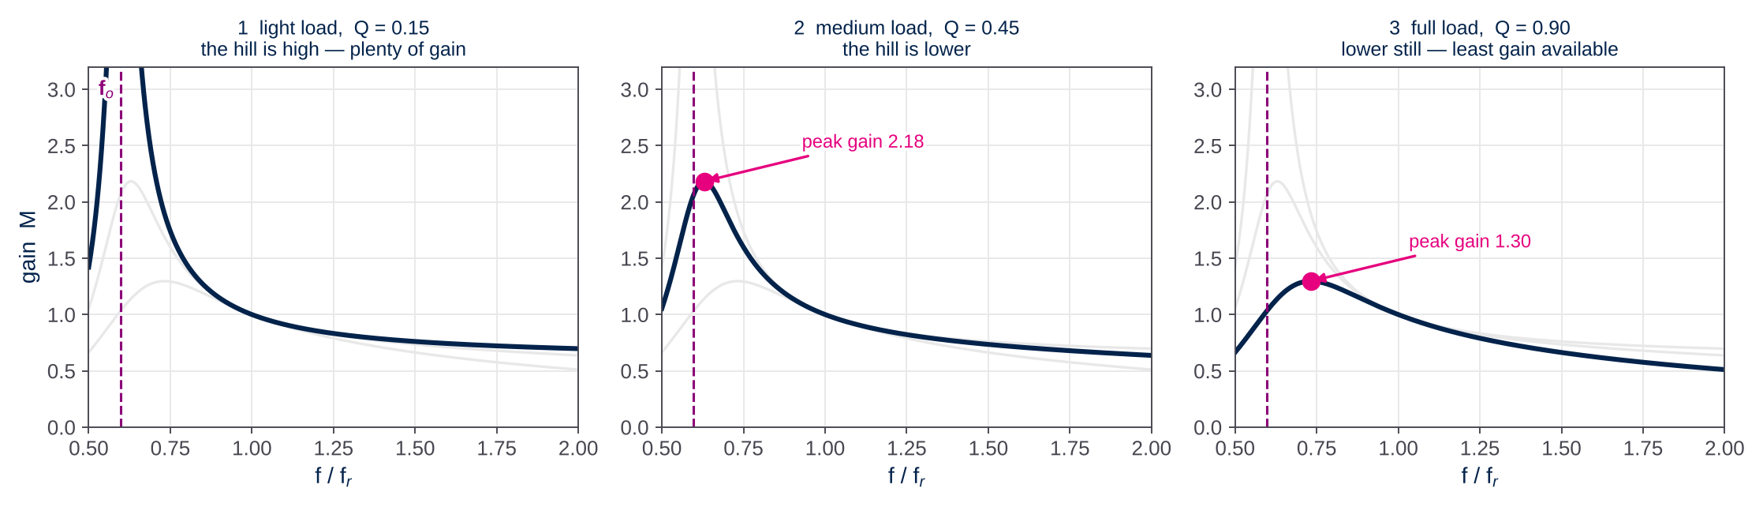
Design Guide/figures/an/f03_gain_walk.png
