yohan924-ops/L6790A-Single-Stage-PFC-LLC-Converter/Design Guide/figures/an/f05_zvs_mechanism.png

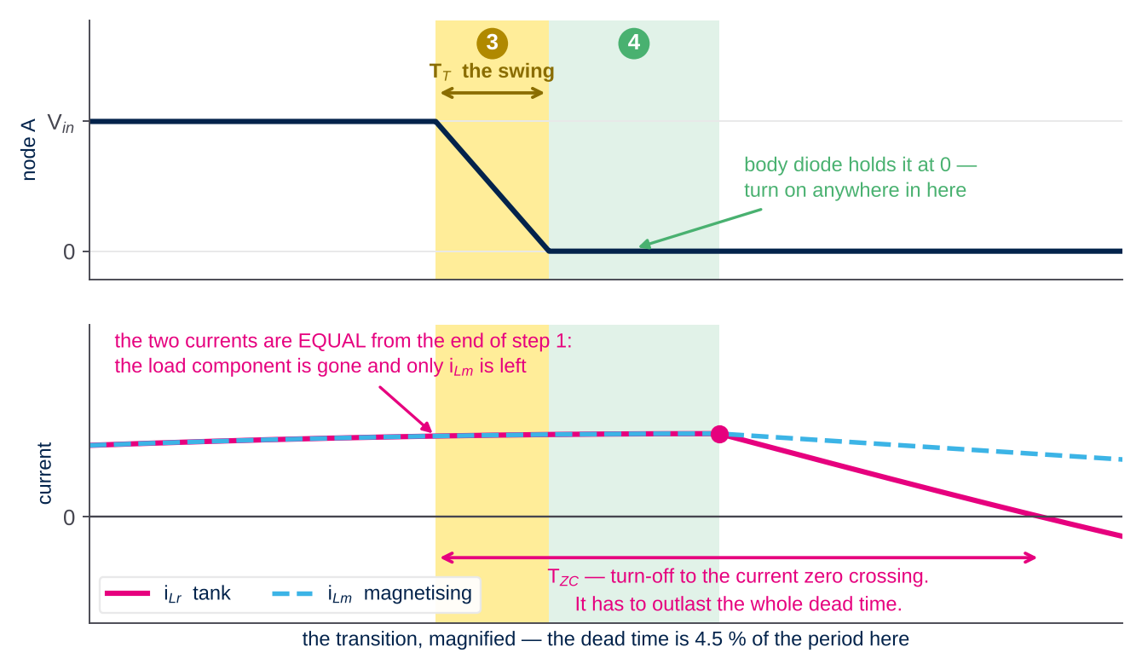
Design Guide/figures/an/f05_zvs_mechanism.png
