yohan924-ops/L6790A-Single-Stage-PFC-LLC-Converter/Design Guide/figures/an/f11_power_balance.png

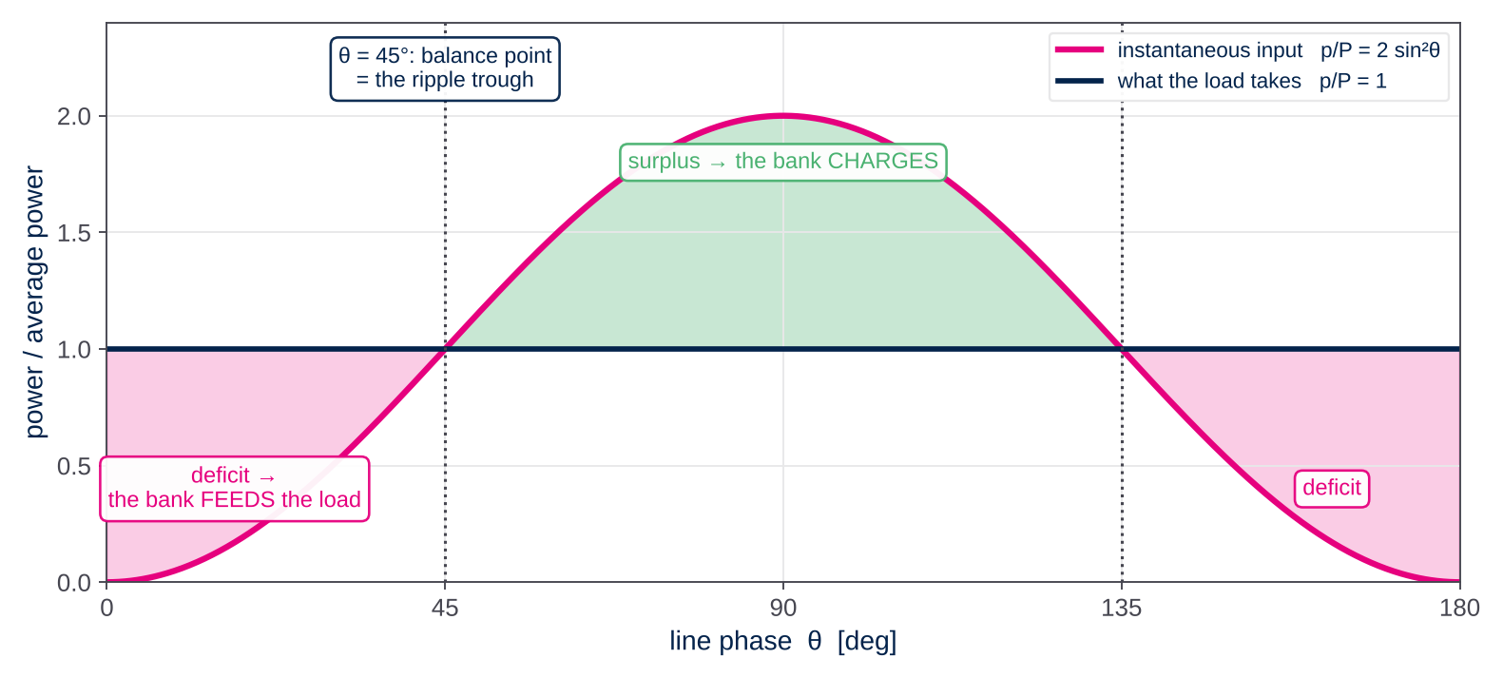
Design Guide/figures/an/f11_power_balance.png
