yohan924-ops/L6790A-Single-Stage-PFC-LLC-Converter/Design Guide/figures/an/f12_two_divergences.png

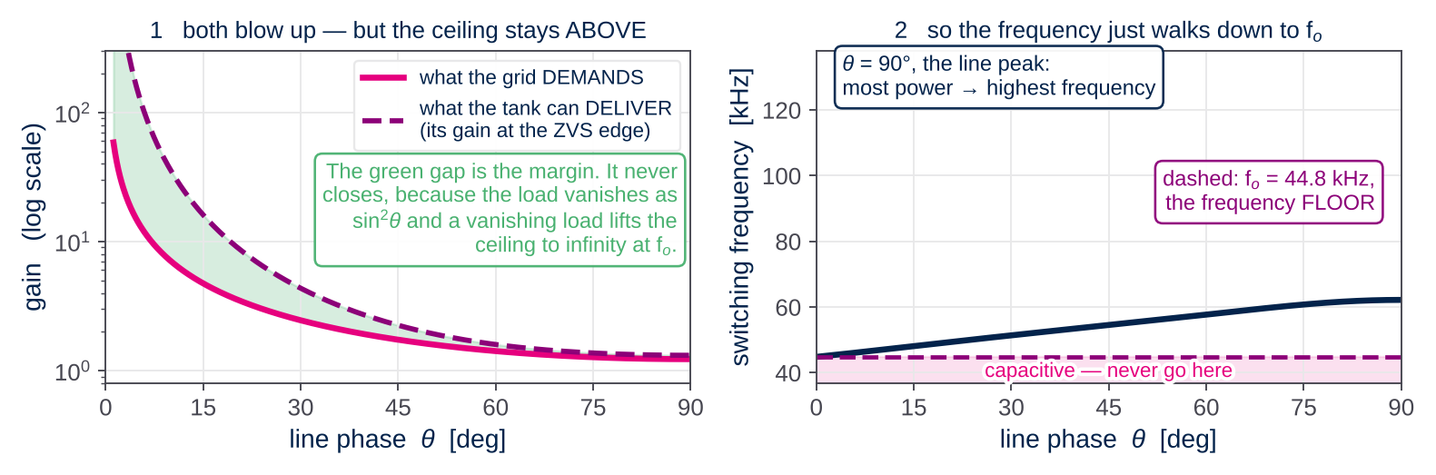
Design Guide/figures/an/f12_two_divergences.png
