yohan924-ops/L6790A-Single-Stage-PFC-LLC-Converter/Design Guide/figures/an/f13_morphing.png

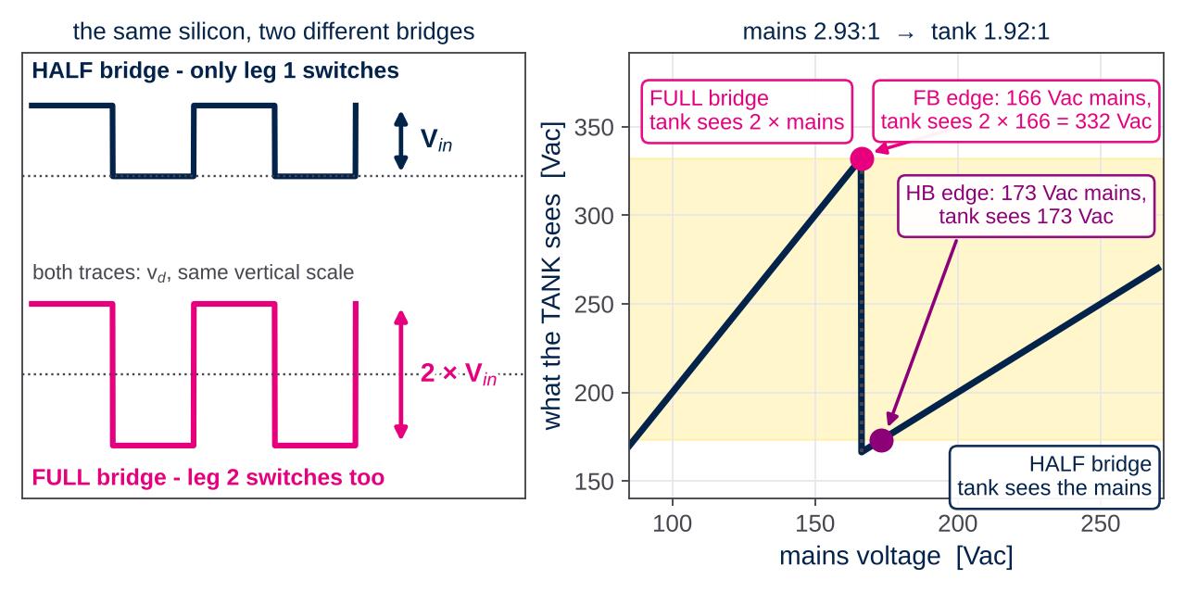
Design Guide/figures/an/f13_morphing.png
