yohan924-ops/L6790A-Single-Stage-PFC-LLC-Converter/Design Guide/figures/an/f14_fsw_theta.png

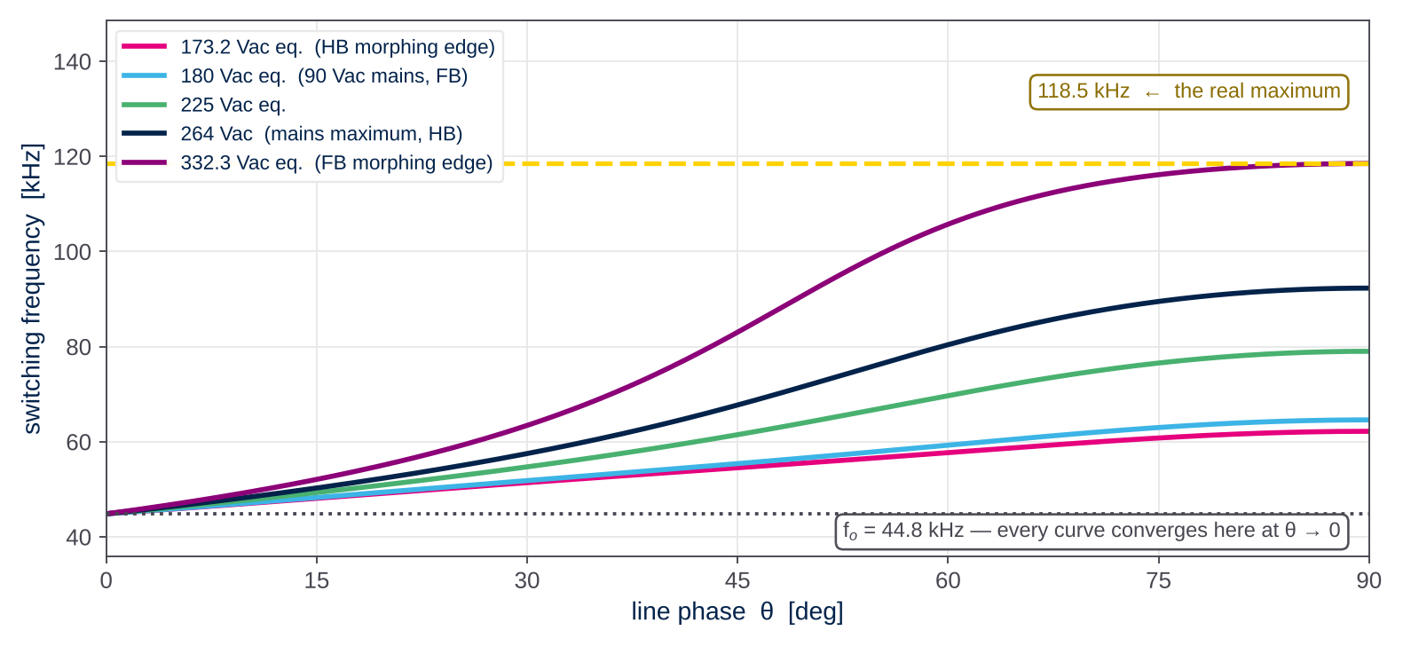
Design Guide/figures/an/f14_fsw_theta.png
