yohan924-ops/L6790A-Single-Stage-PFC-LLC-Converter/Design Guide/figures/an/f15_bridge_fb.png

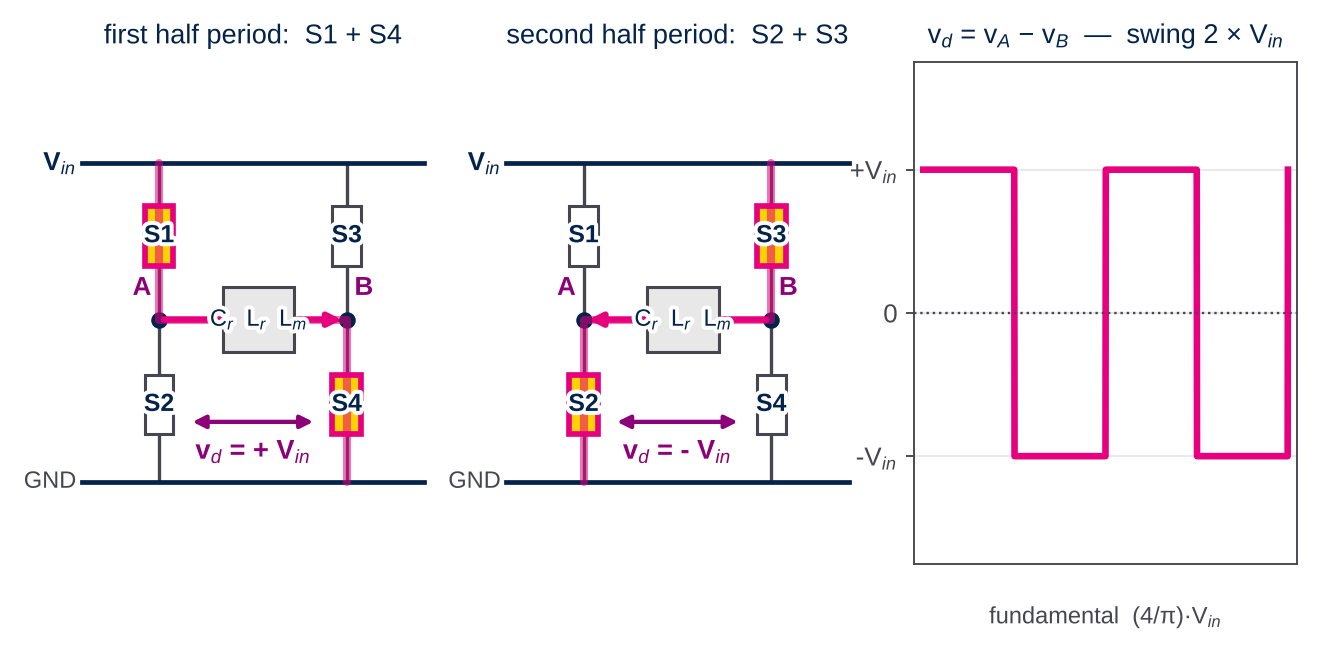
Design Guide/figures/an/f15_bridge_fb.png
