yohan924-ops/L6790A-Single-Stage-PFC-LLC-Converter/Design Guide/figures/an/f16_bridge_hb.png

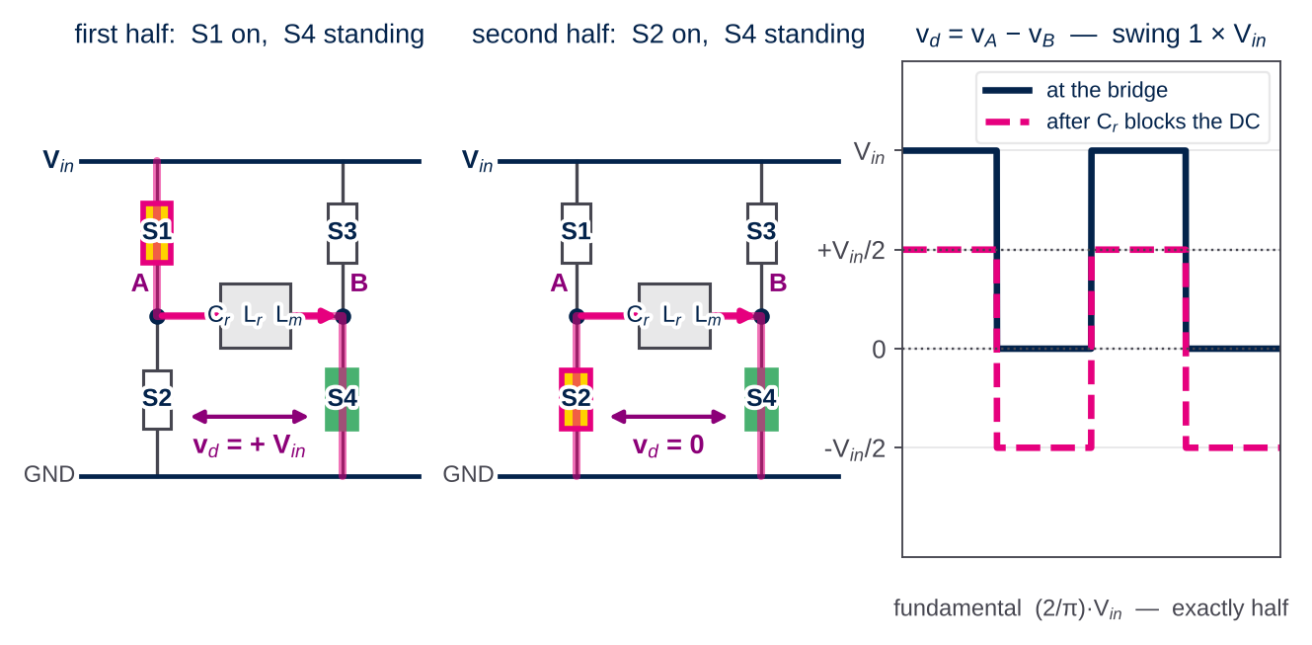
Design Guide/figures/an/f16_bridge_hb.png
