yohan924-ops/L6790A-Single-Stage-PFC-LLC-Converter/Design Guide/figures/an/f17_morph_gates.png

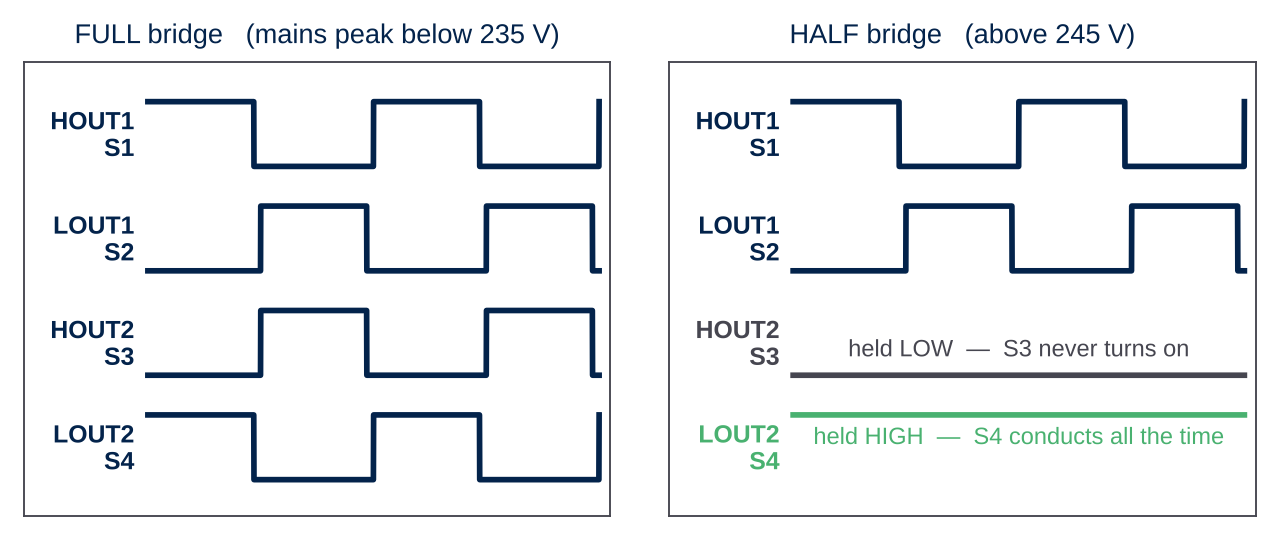
Design Guide/figures/an/f17_morph_gates.png
