yohan924-ops/L6790A-Single-Stage-PFC-LLC-Converter/Design Guide/figures/an/f18_morph_levels.png

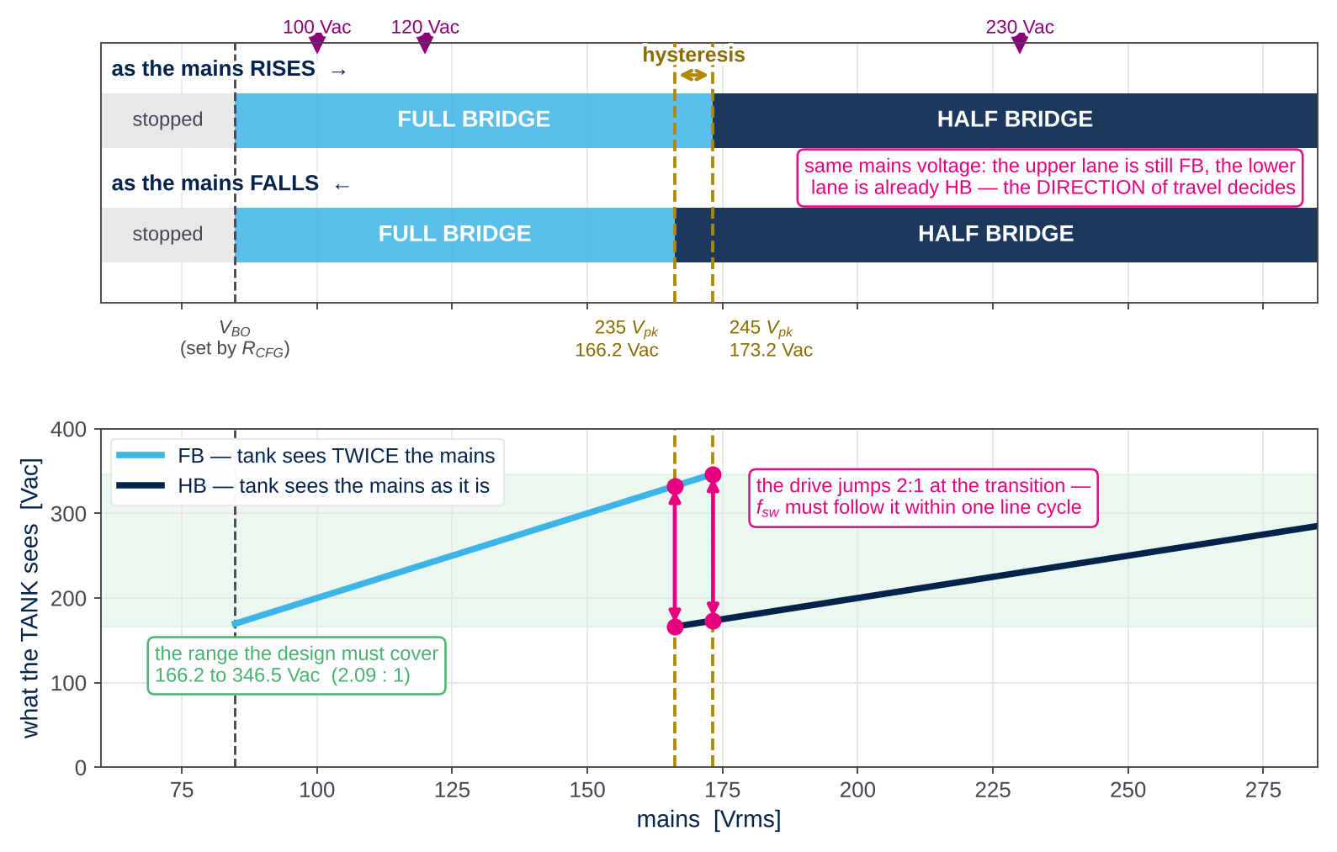
Design Guide/figures/an/f18_morph_levels.png
