yohan924-ops/L6790A-Single-Stage-PFC-LLC-Converter/Design Guide/figures/an/f19_cout_criterion.png

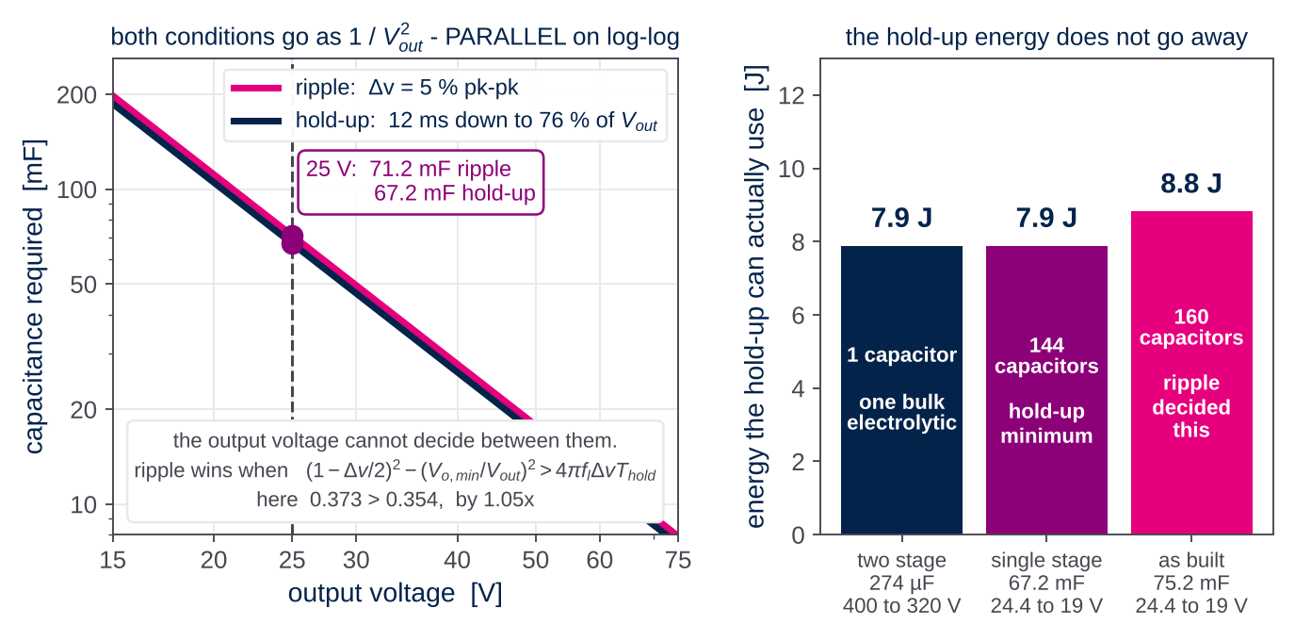
Design Guide/figures/an/f19_cout_criterion.png
