yohan924-ops/L6790A-Single-Stage-PFC-LLC-Converter/Design Guide/figures/an/fsw_theta.png

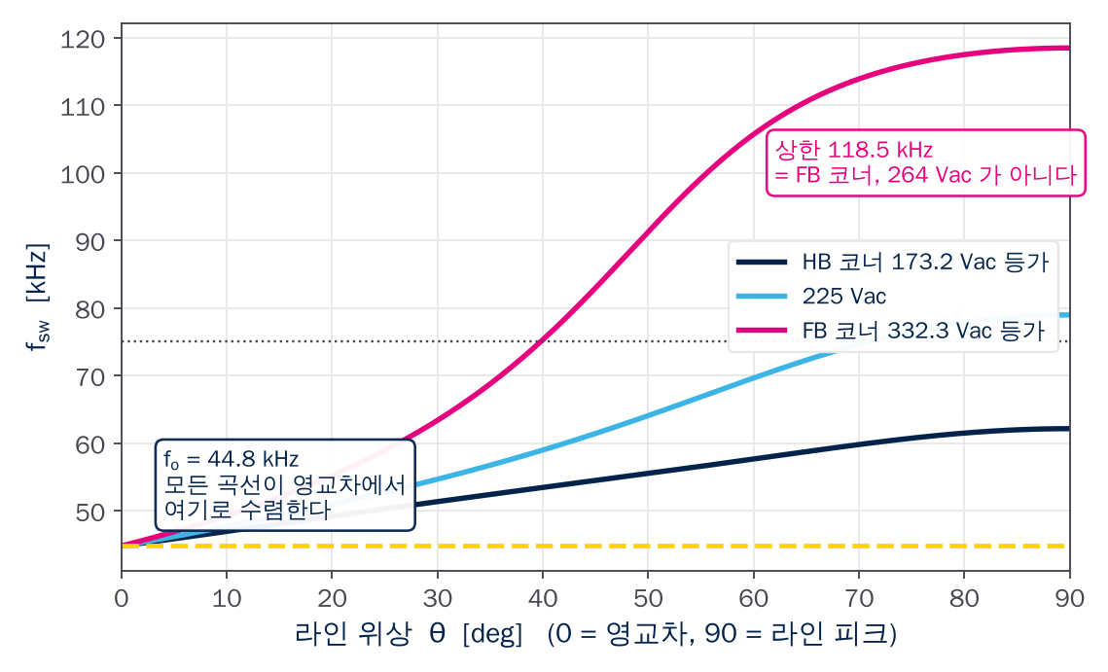
Design Guide/figures/an/fsw_theta.png
