yohan924-ops/L6790A-Single-Stage-PFC-LLC-Converter/Design Guide/figures/an/gain_regions.png

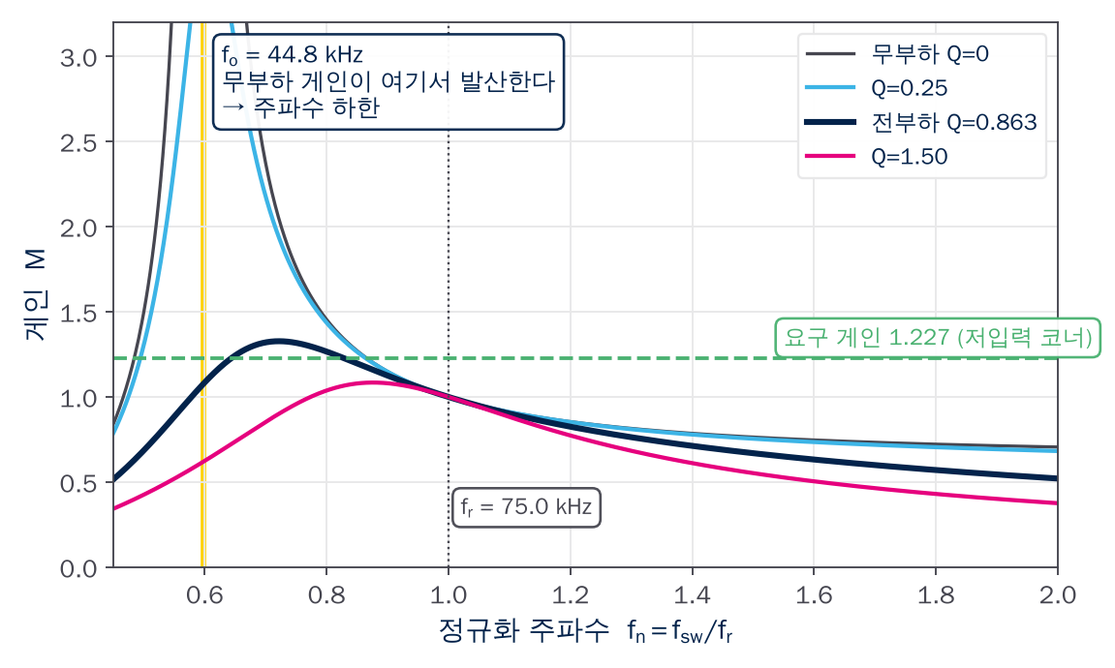
Design Guide/figures/an/gain_regions.png
