yohan924-ops/L6790A-Single-Stage-PFC-LLC-Converter/Design Guide/figures/an/tank_current.png

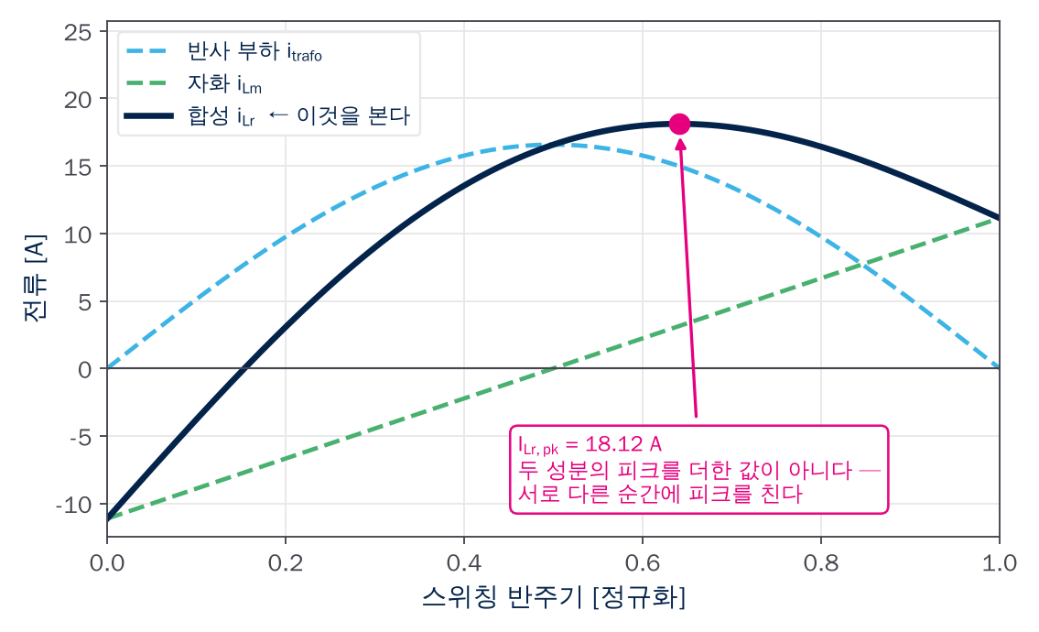
Design Guide/figures/an/tank_current.png
