yohan924-ops/L6790A-Single-Stage-PFC-LLC-Converter/Design Guide/generators/bobbin.png

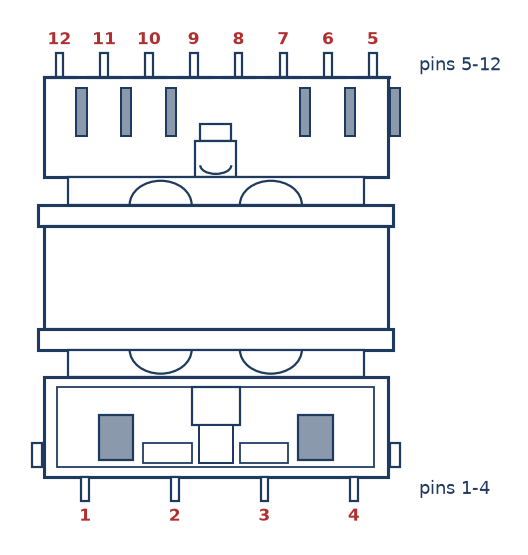
Design Guide/generators/bobbin.png
