yohan924-ops/L6790A-Single-Stage-PFC-LLC-Converter/Design Guide/generators/core.png

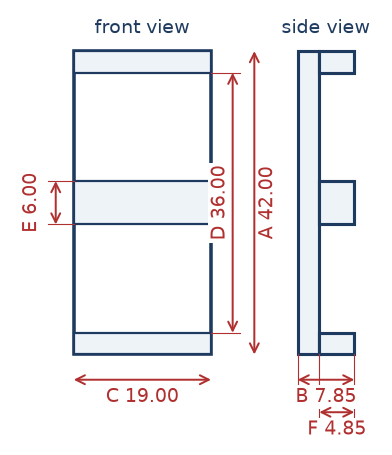
Design Guide/generators/core.png
