yohan924-ops/L6790A-Single-Stage-PFC-LLC-Converter/docs/LG_26OP-LM83W_core_construction.png

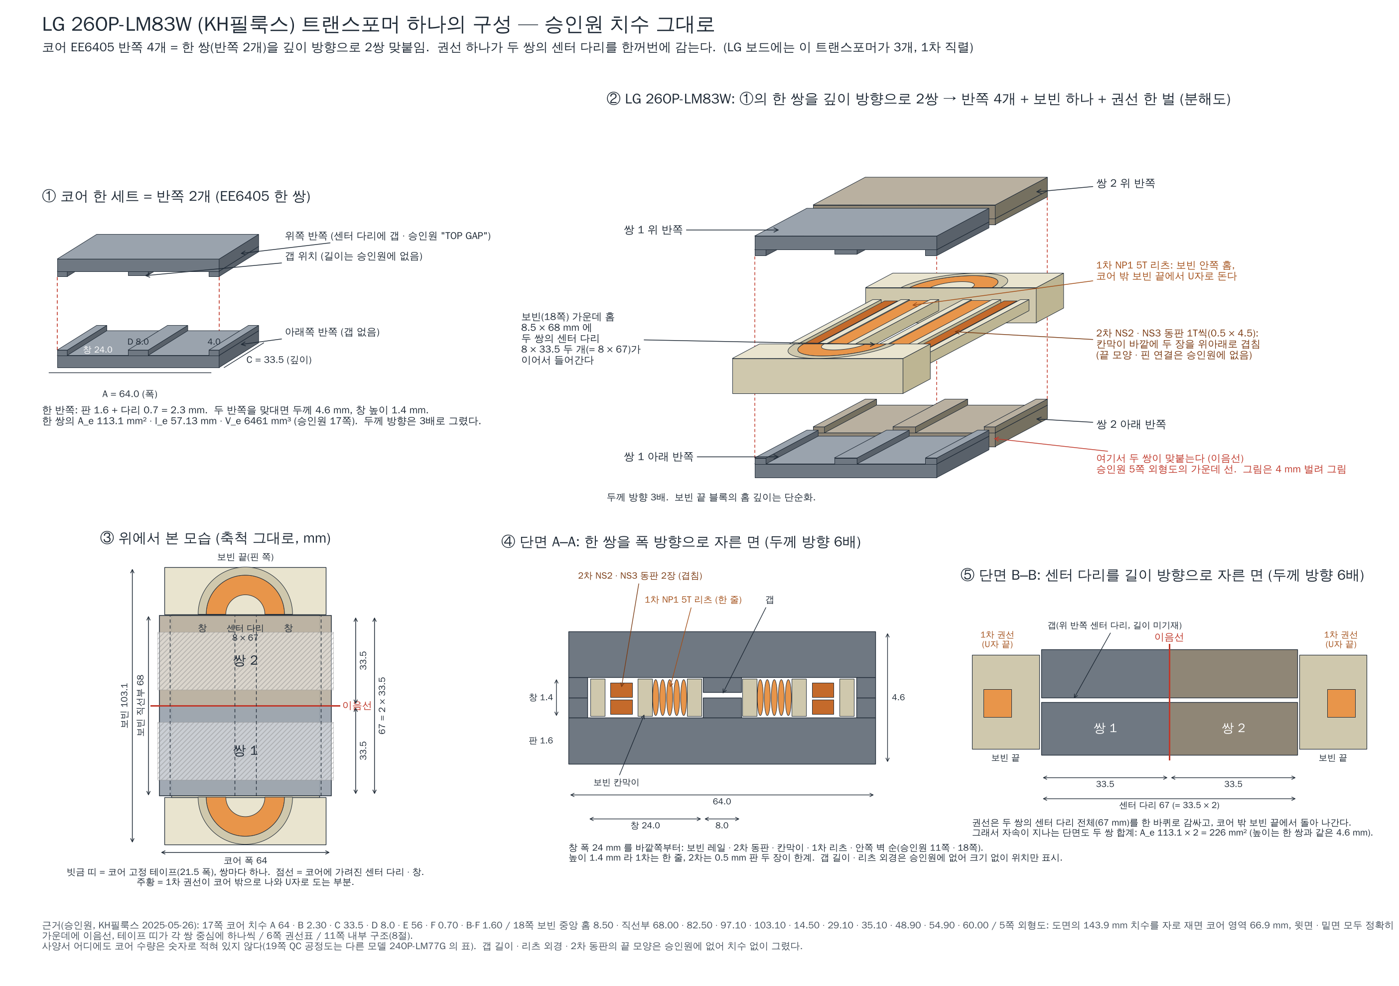
docs/LG_26OP-LM83W_core_construction.png
