yohan924-ops/L6790A-Single-Stage-PFC-LLC-Converter/PQ50/Design Guide/figures/an/an_dc_overlap.png

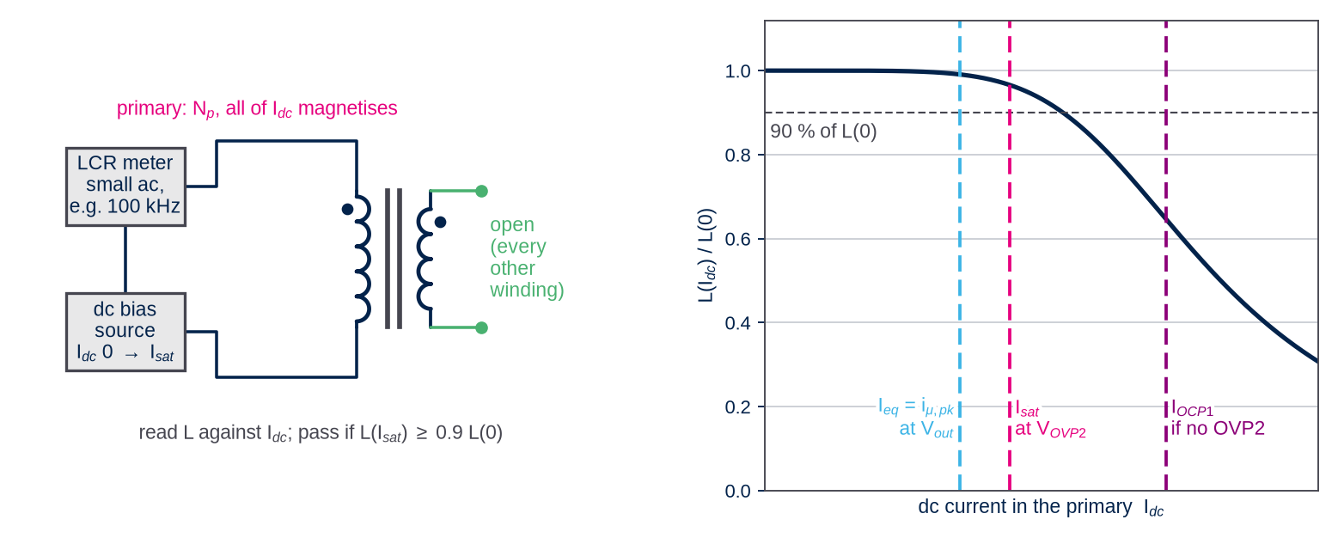
PQ50/Design Guide/figures/an/an_dc_overlap.png
