yohan924-ops/L6790A-Single-Stage-PFC-LLC-Converter/PQ50/Design Guide/figures/an_pfc_boost.png

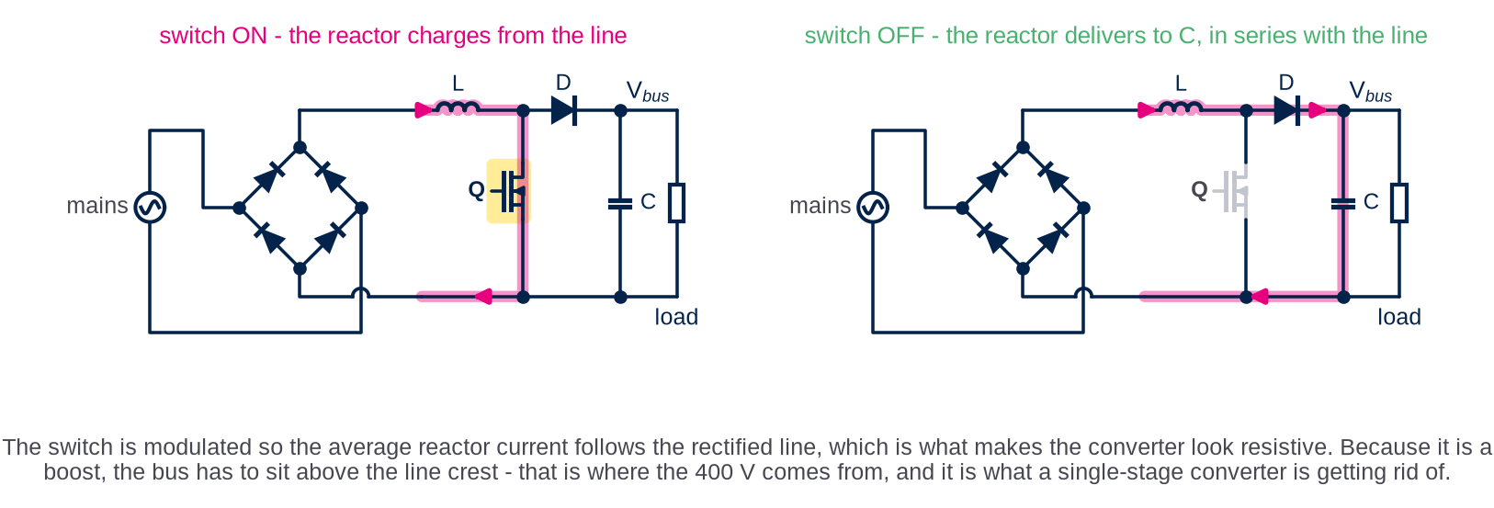
PQ50/Design Guide/figures/an_pfc_boost.png
