yohan924-ops/L6790A-Single-Stage-PFC-LLC-Converter/PQ50/Design Guide/figures/an_ref_op_free_raw.png

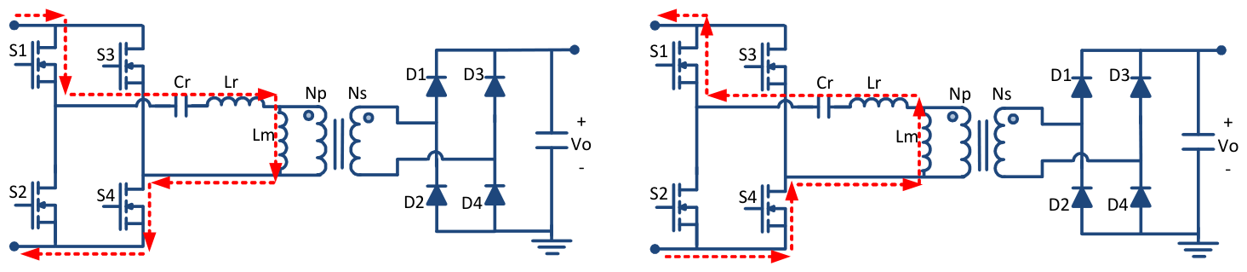
PQ50/Design Guide/figures/an_ref_op_free_raw.png
