yohan924-ops/L6790A-Single-Stage-PFC-LLC-Converter/PQ50/Design Guide/figures/f02_two_resonances.png

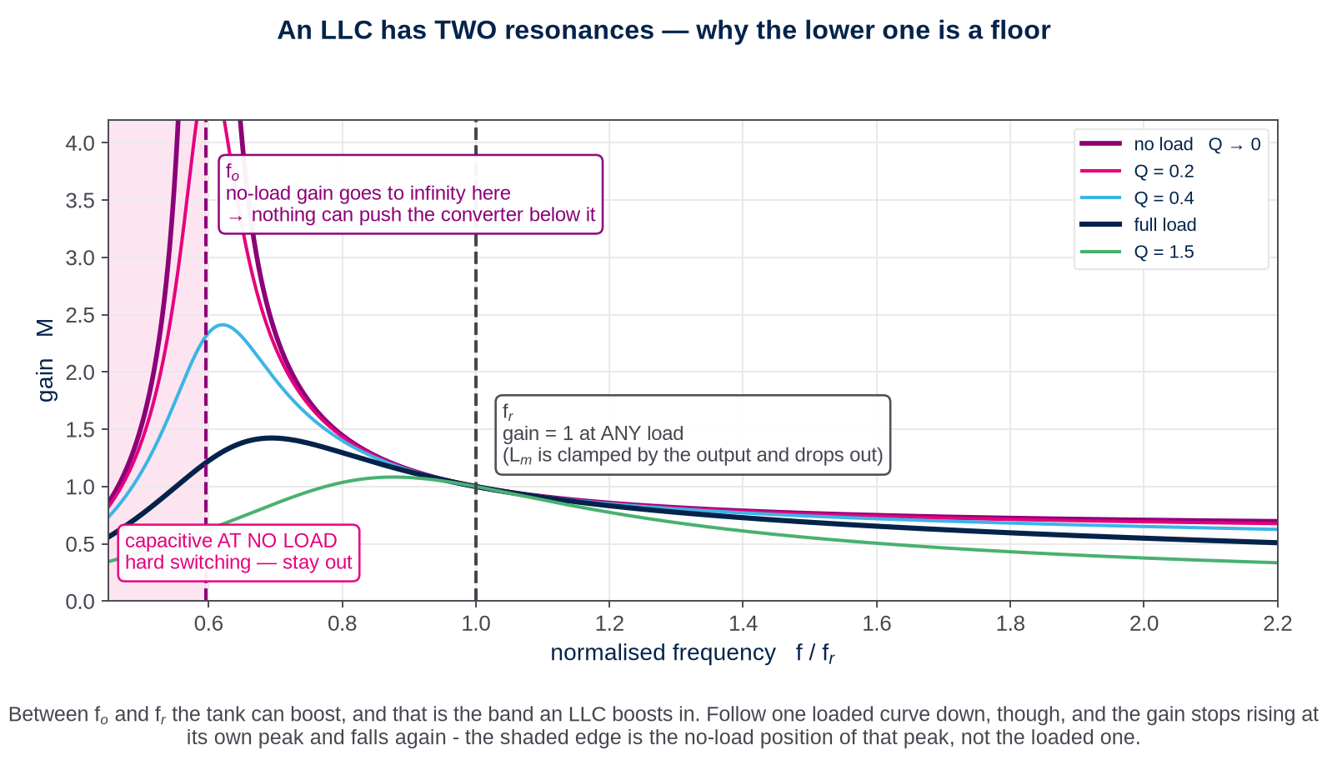
PQ50/Design Guide/figures/f02_two_resonances.png
