yohan924-ops/L6790A-Single-Stage-PFC-LLC-Converter/PQ50/Design Guide/figures/f03_gain_walk.png

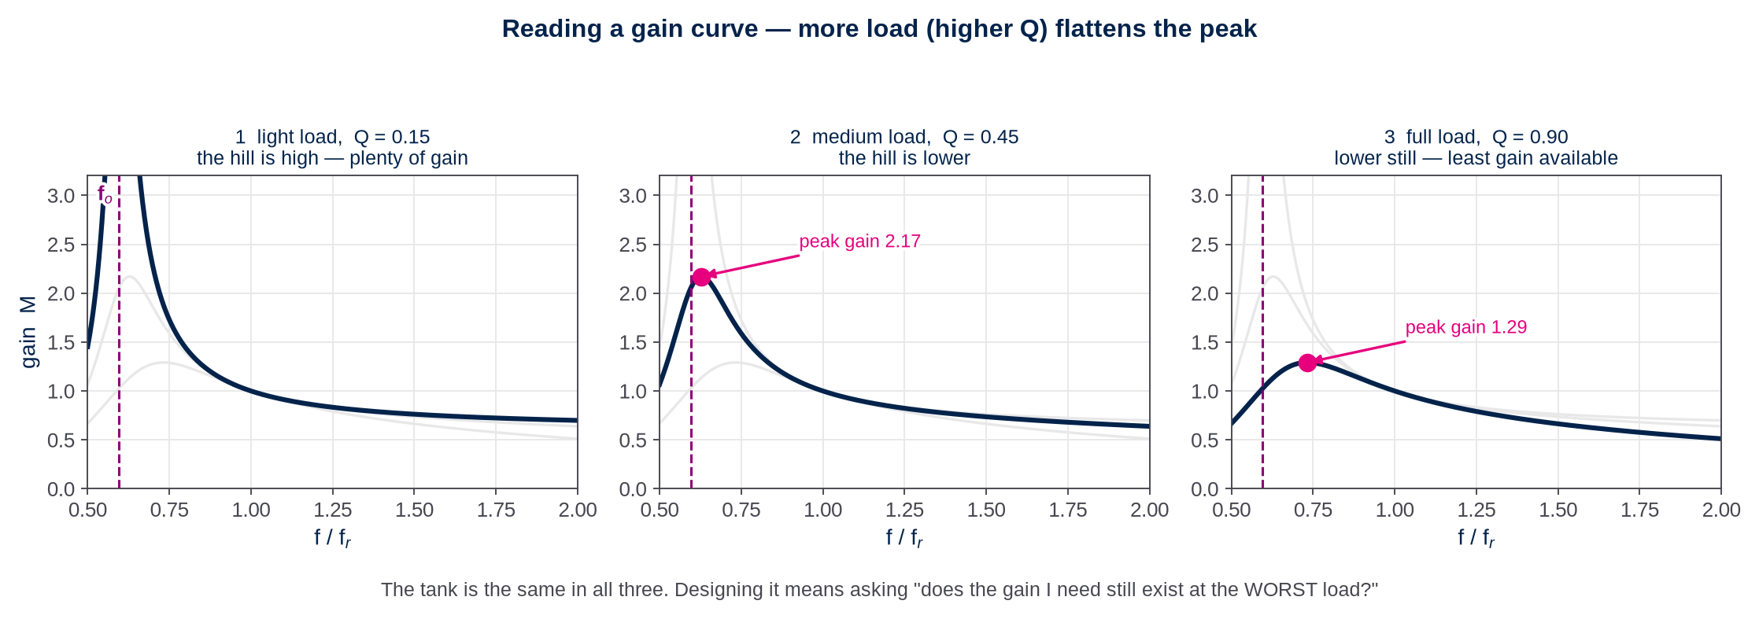
PQ50/Design Guide/figures/f03_gain_walk.png
