yohan924-ops/L6790A-Single-Stage-PFC-LLC-Converter/PQ50/Design Guide/figures/f04_three_regions.png

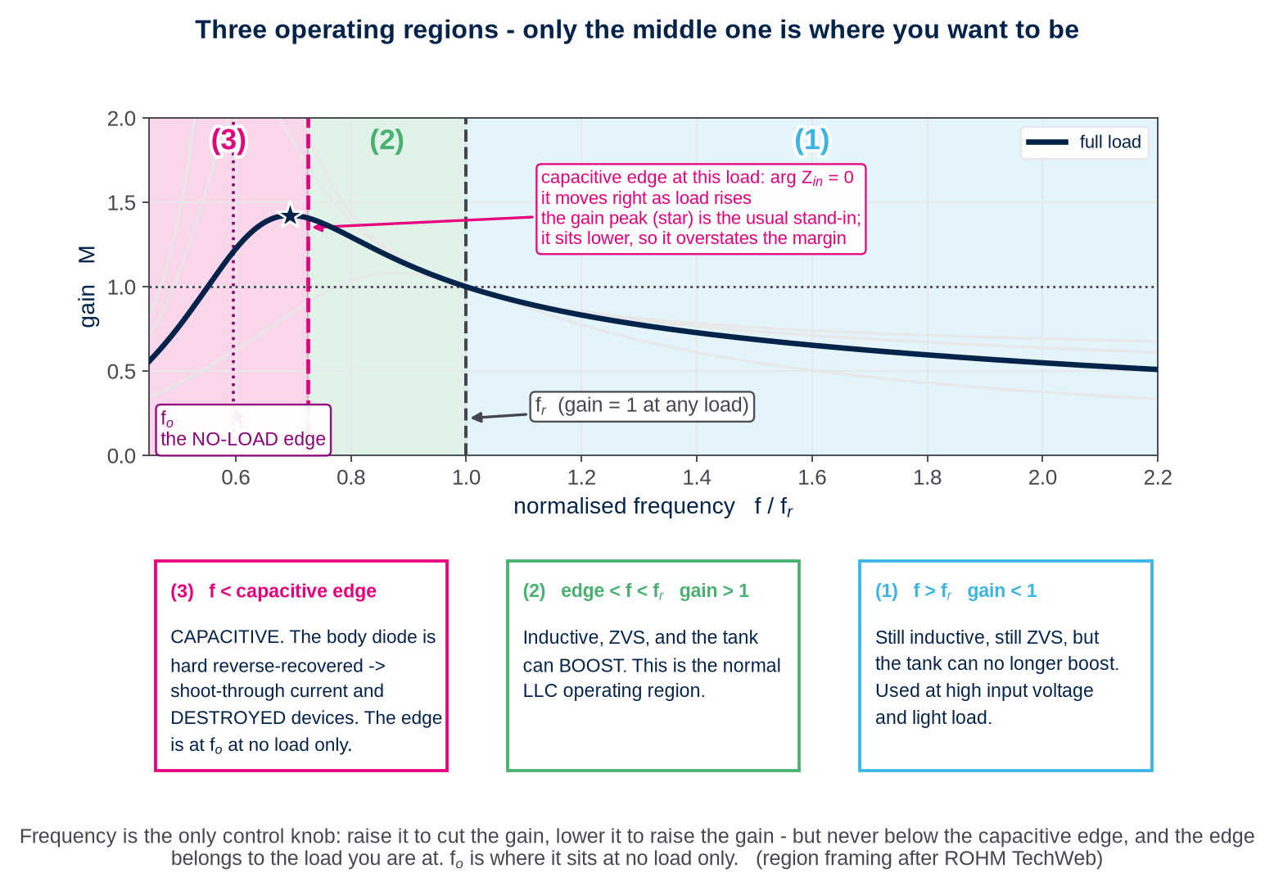
PQ50/Design Guide/figures/f04_three_regions.png
