yohan924-ops/L6790A-Single-Stage-PFC-LLC-Converter/PQ50/Design Guide/figures/f05_zvs_mechanism.png

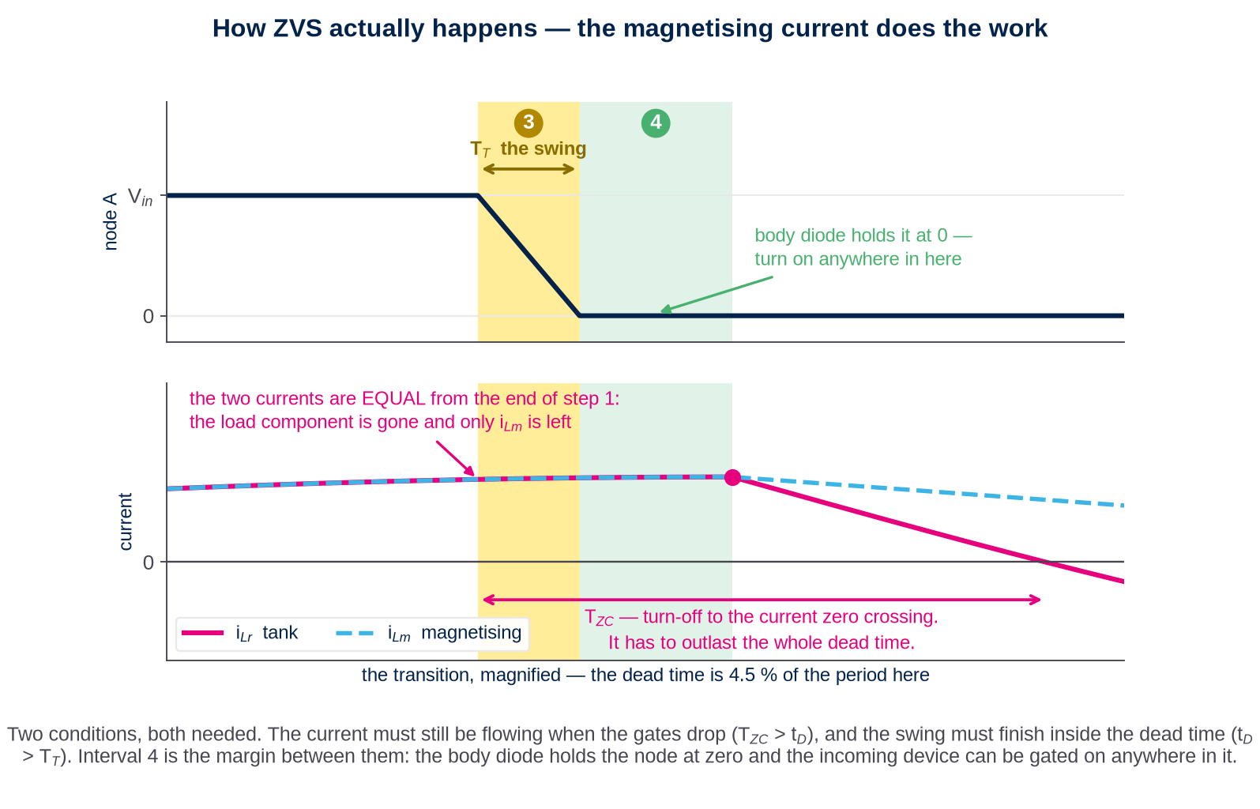
PQ50/Design Guide/figures/f05_zvs_mechanism.png
