yohan924-ops/L6790A-Single-Stage-PFC-LLC-Converter/PQ50/Design Guide/figures/f11_power_balance.png

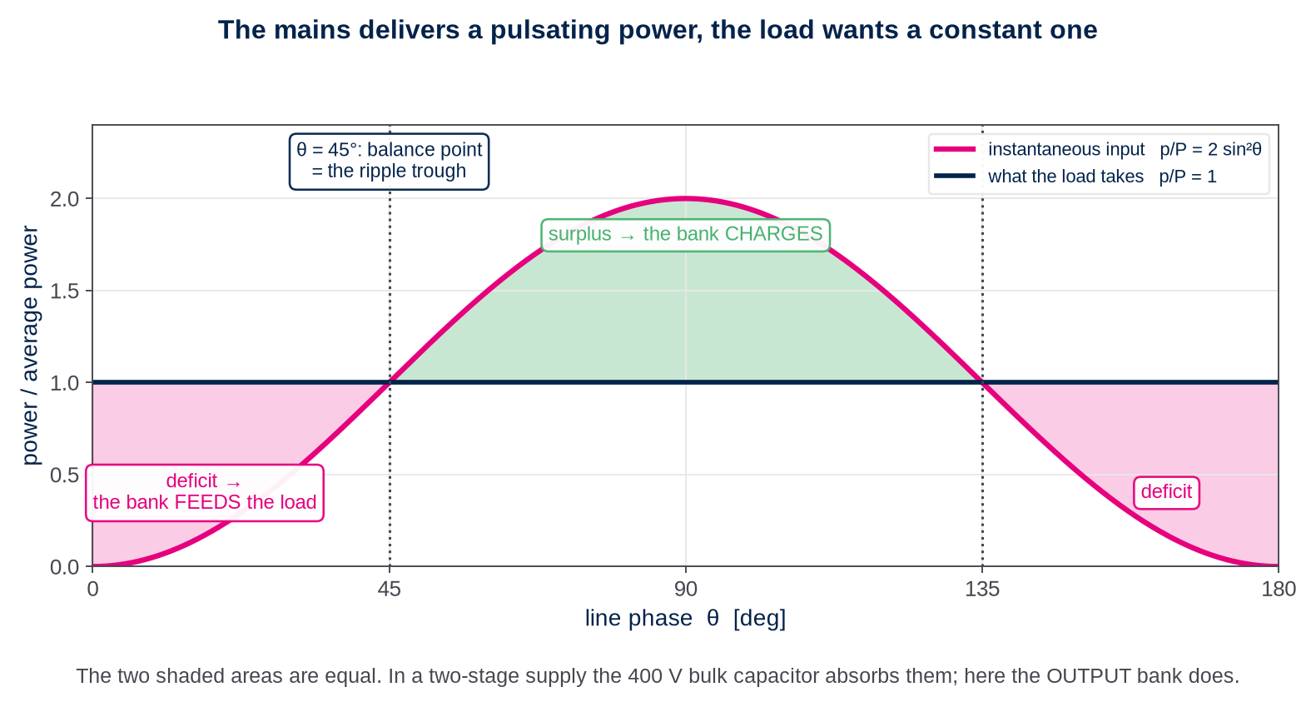
PQ50/Design Guide/figures/f11_power_balance.png
