yohan924-ops/L6790A-Single-Stage-PFC-LLC-Converter/PQ50/Design Guide/figures/f12_two_divergences.png

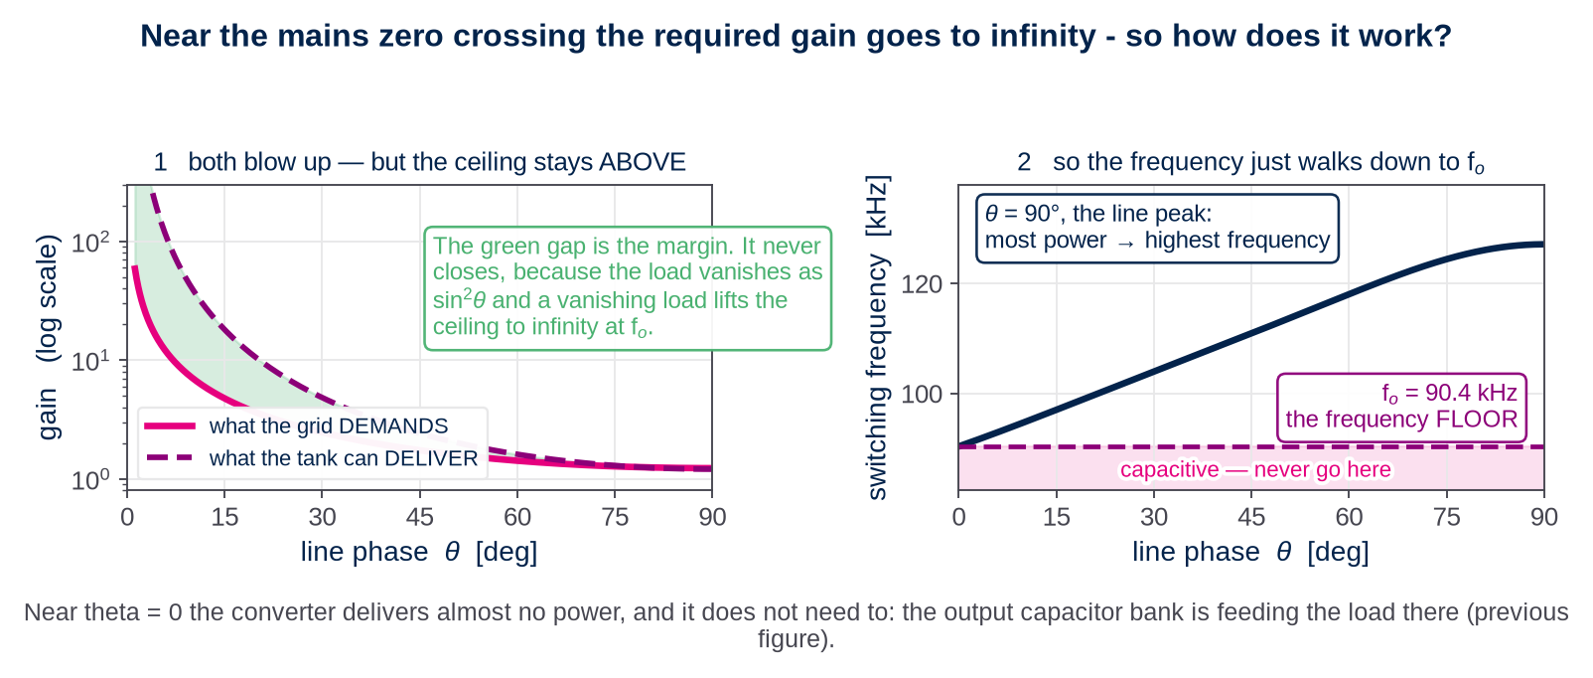
PQ50/Design Guide/figures/f12_two_divergences.png
