yohan924-ops/L6790A-Single-Stage-PFC-LLC-Converter/PQ50/Design Guide/figures/f14_fsw_theta.png

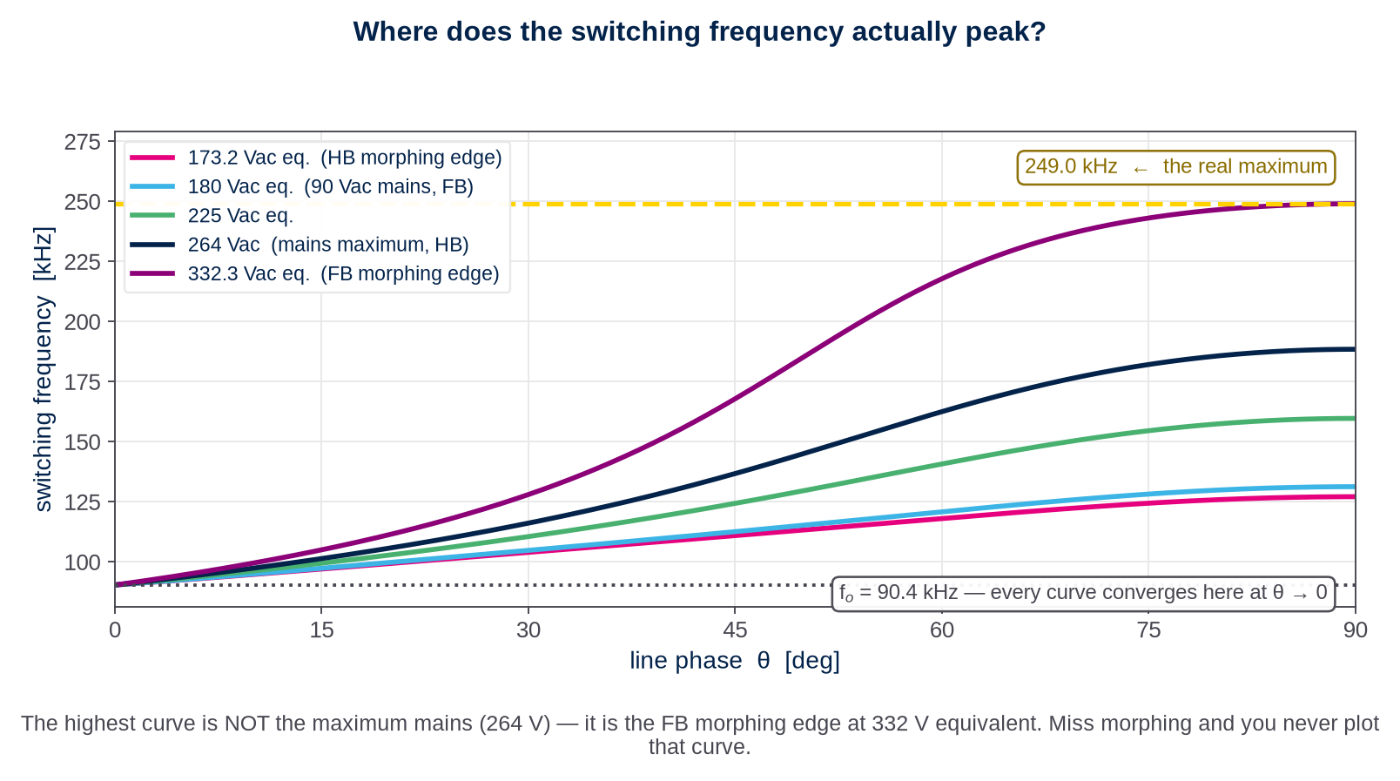
PQ50/Design Guide/figures/f14_fsw_theta.png
