yohan924-ops/L6790A-Single-Stage-PFC-LLC-Converter/PQ50/Design Guide/figures/f15_bridge_fb.png

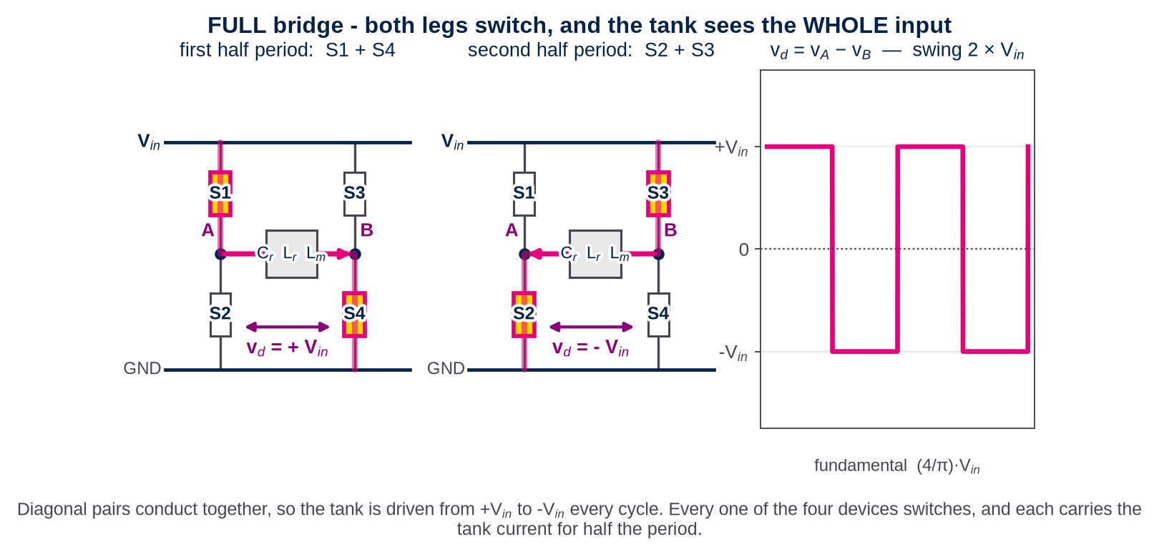
PQ50/Design Guide/figures/f15_bridge_fb.png
