yohan924-ops/L6790A-Single-Stage-PFC-LLC-Converter/PQ50/Design Guide/figures/f16_bridge_hb.png

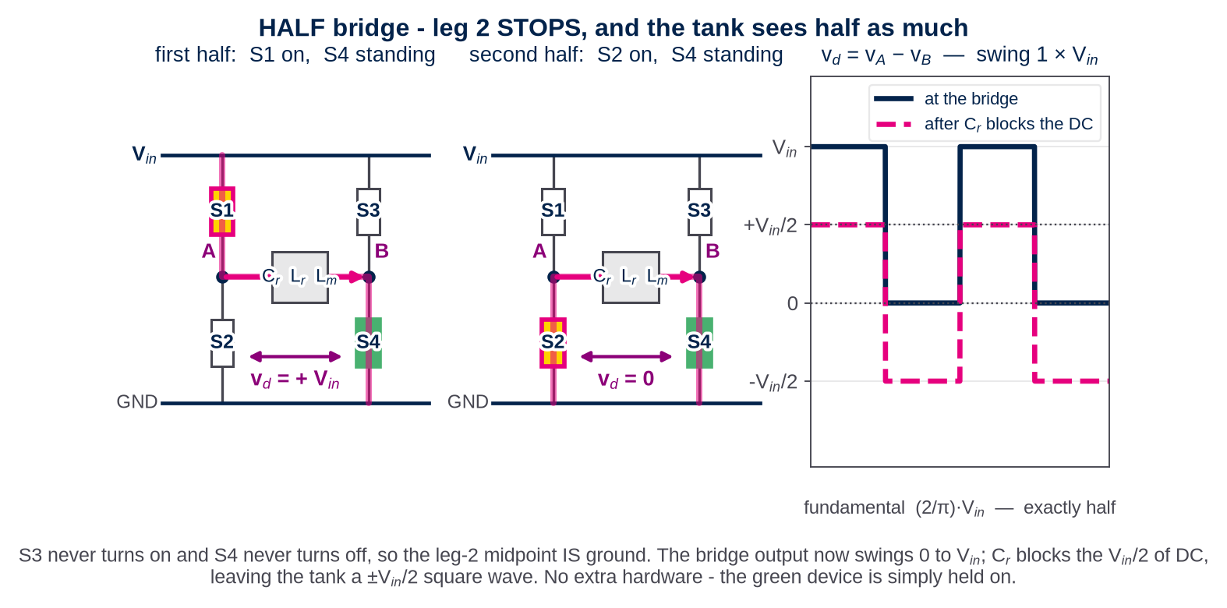
PQ50/Design Guide/figures/f16_bridge_hb.png
