yohan924-ops/L6790A-Single-Stage-PFC-LLC-Converter/PQ50/Design Guide/figures/f17_morph_gates.png

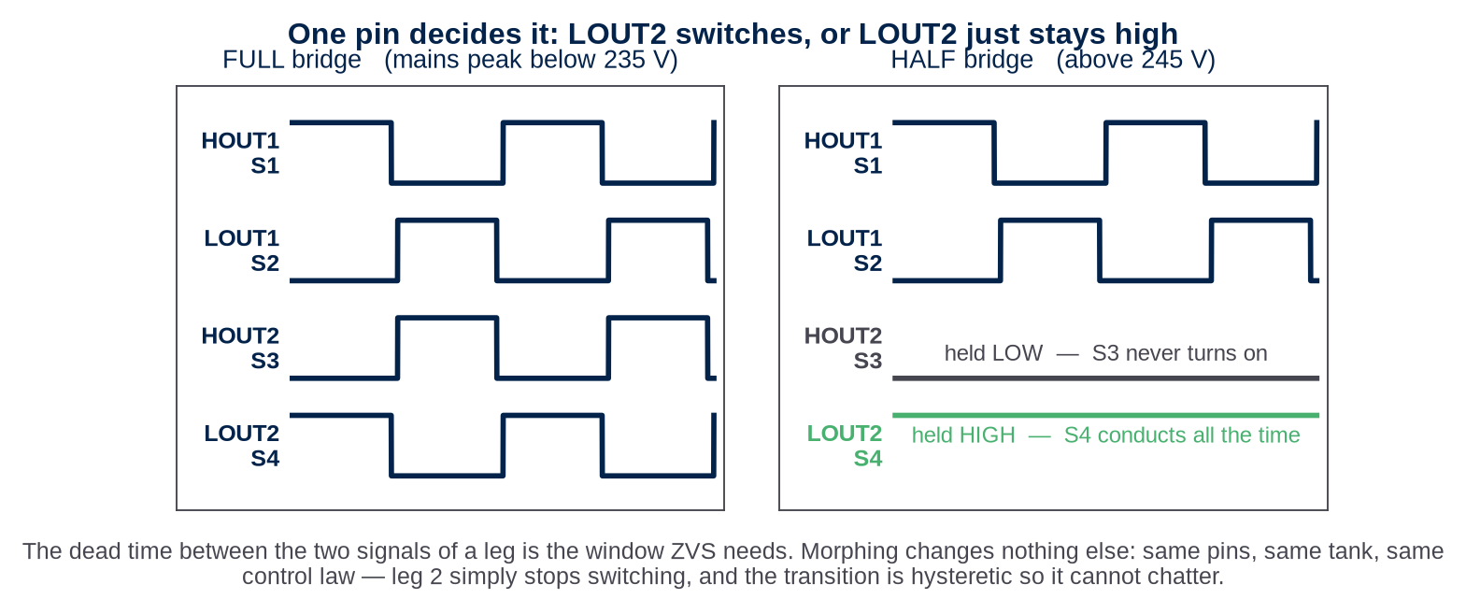
PQ50/Design Guide/figures/f17_morph_gates.png
