yohan924-ops/L6790A-Single-Stage-PFC-LLC-Converter/PQ50/Design Guide/figures/f18_morph_levels.png

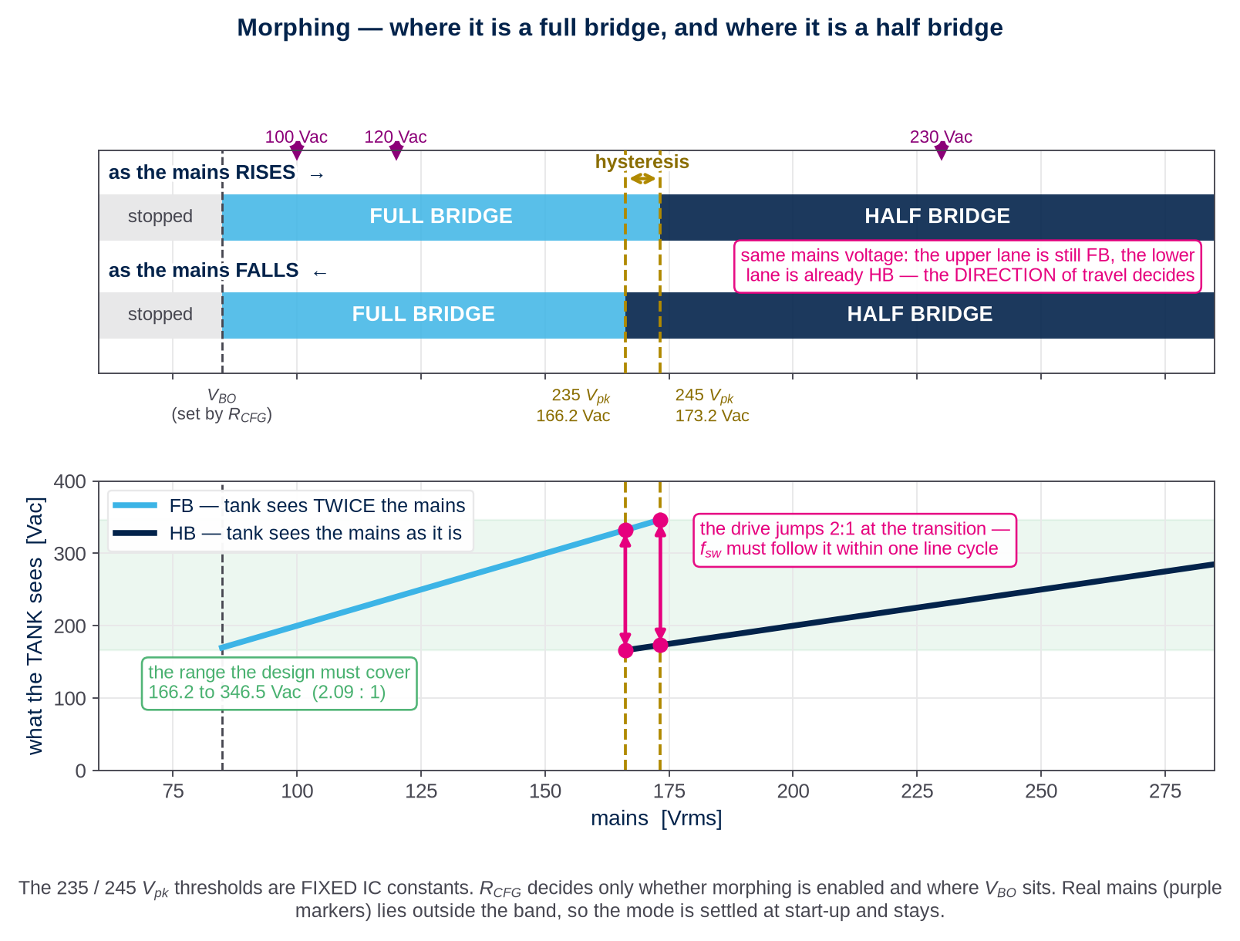
PQ50/Design Guide/figures/f18_morph_levels.png
