yohan924-ops/L6790A-Single-Stage-PFC-LLC-Converter/PQ50/Design Guide/figures/f19_cout_criterion.png

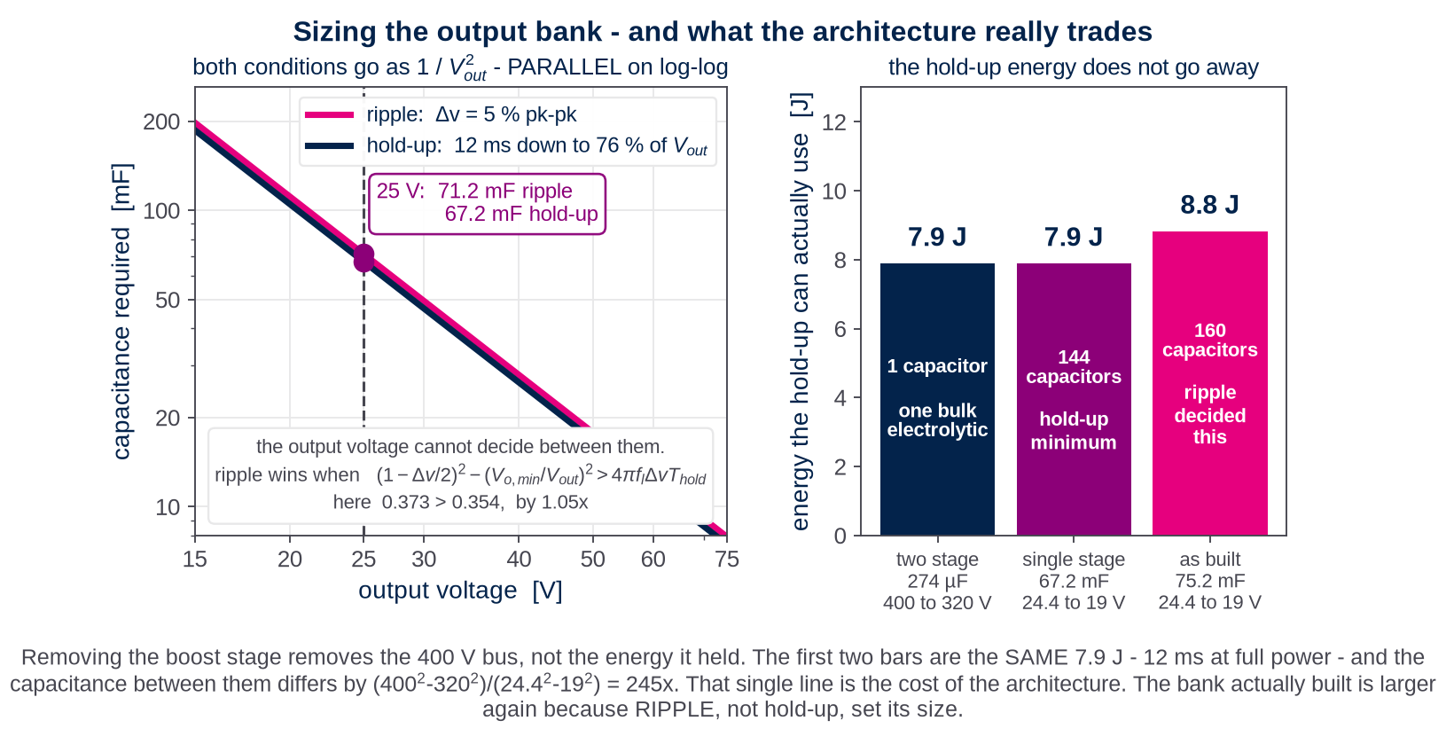
PQ50/Design Guide/figures/f19_cout_criterion.png
