yohan924-ops/L6790A-Single-Stage-PFC-LLC-Converter/PQ50/Design Guide/figures/gain_vs_m.png

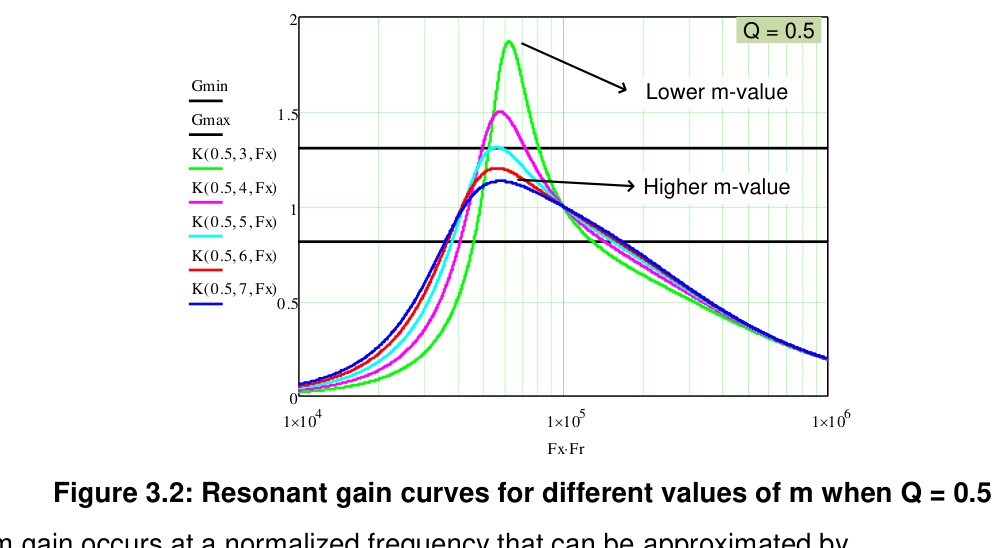
PQ50/Design Guide/figures/gain_vs_m.png
