yohan924-ops/L6790A-Single-Stage-PFC-LLC-Converter/PQ50/Design Guide/figures/max_gain.png

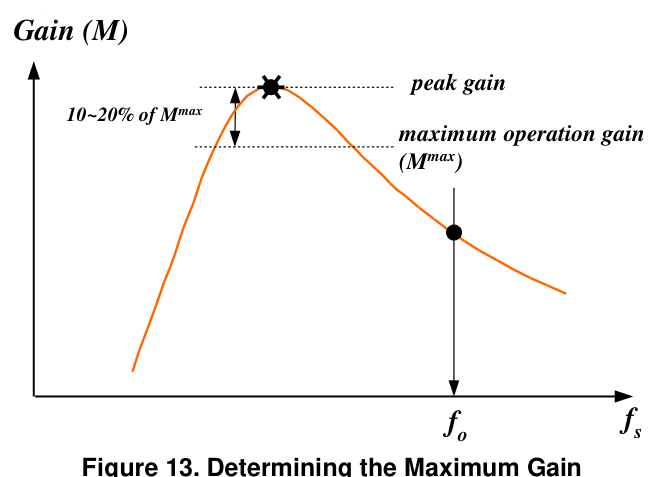
PQ50/Design Guide/figures/max_gain.png
