yohan924-ops/L6790A-Single-Stage-PFC-LLC-Converter/PQ50/Design Guide/figures/mps2_f9.png

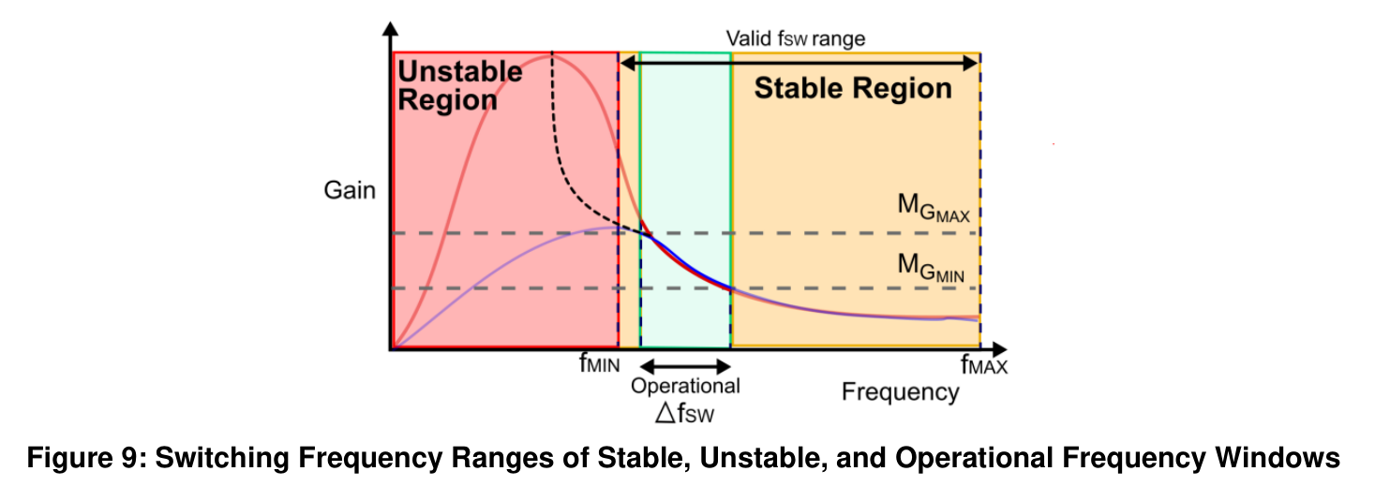
PQ50/Design Guide/figures/mps2_f9.png
