yohan924-ops/L6790A-Single-Stage-PFC-LLC-Converter/PQ50/Design Guide/figures/ref_hb_at_resonance.png

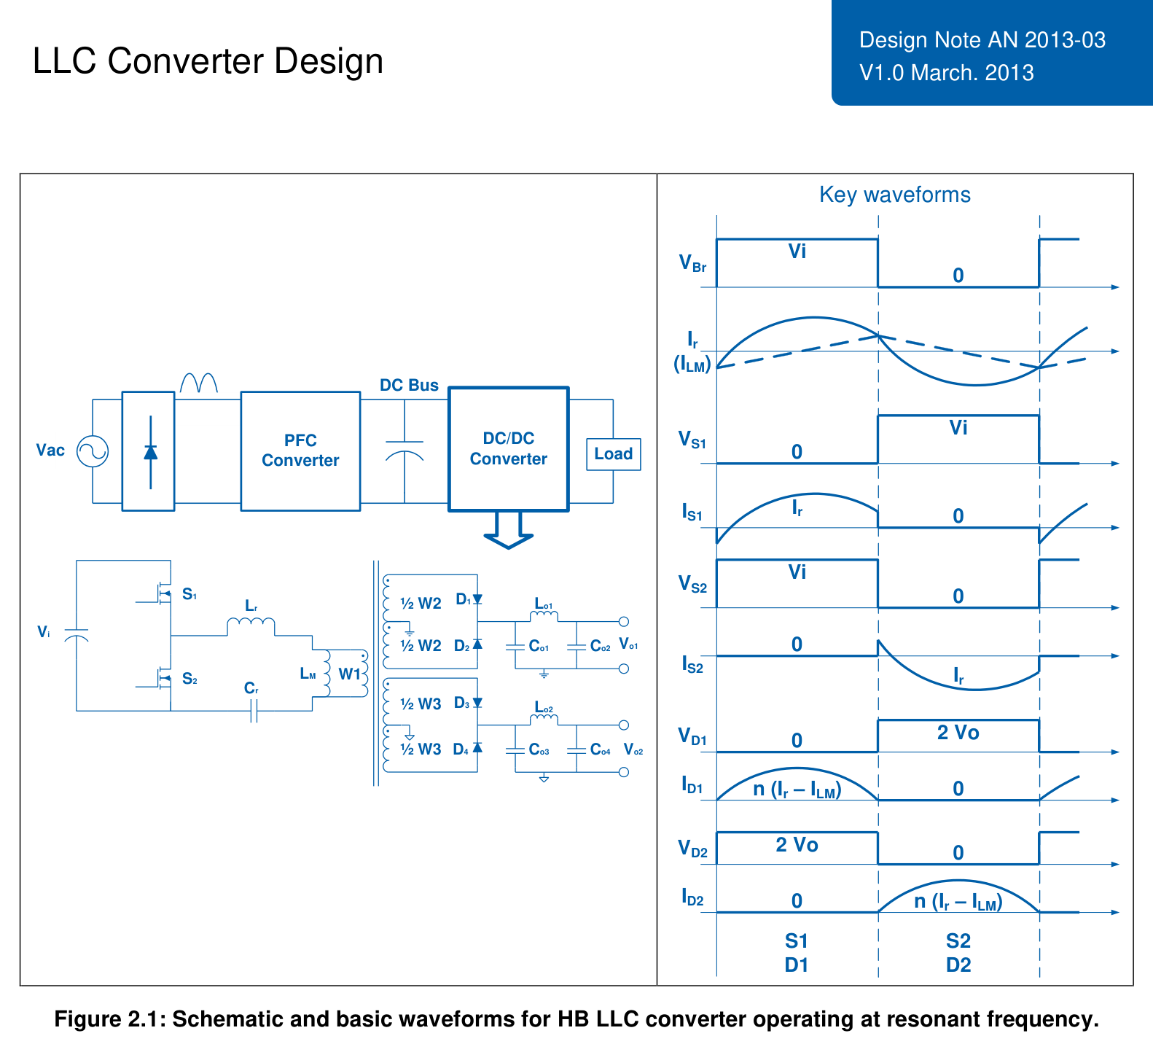
PQ50/Design Guide/figures/ref_hb_at_resonance.png
