yohan924-ops/L6790A-Single-Stage-PFC-LLC-Converter/PQ50/Design Guide/figures/ref_operation_modes.png

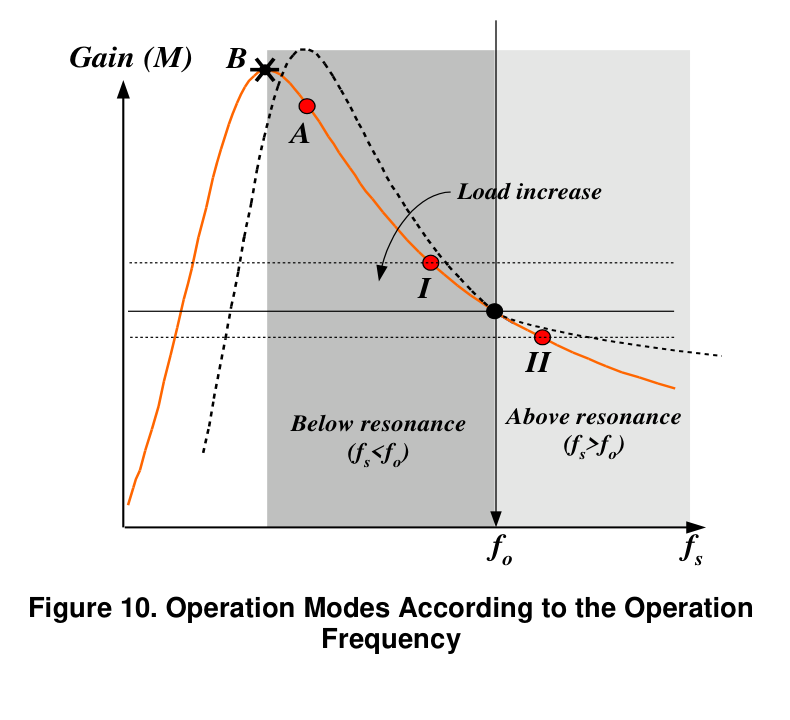
PQ50/Design Guide/figures/ref_operation_modes.png
