yohan924-ops/L6790A-Single-Stage-PFC-LLC-Converter/PQ50/Design Guide/figures/ref_peak_gain_q.png

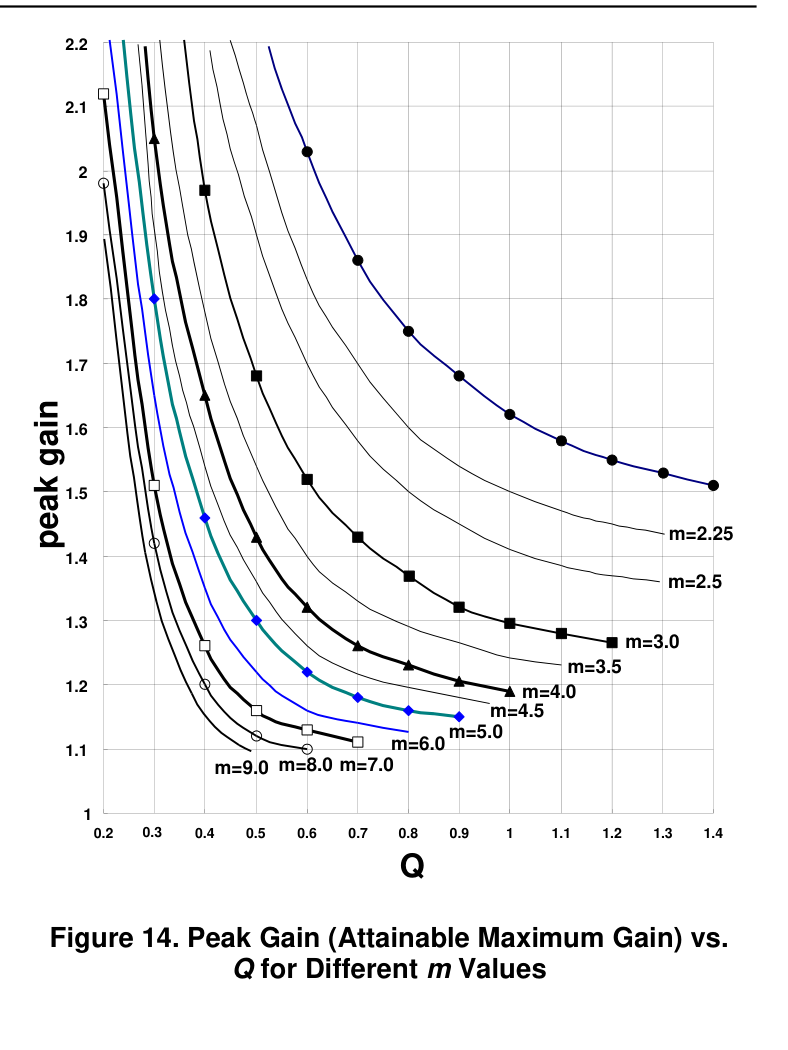
PQ50/Design Guide/figures/ref_peak_gain_q.png
