yohan924-ops/L6790A-Single-Stage-PFC-LLC-Converter/PQ50/Design Guide/figures/ref_rac_derivation.png

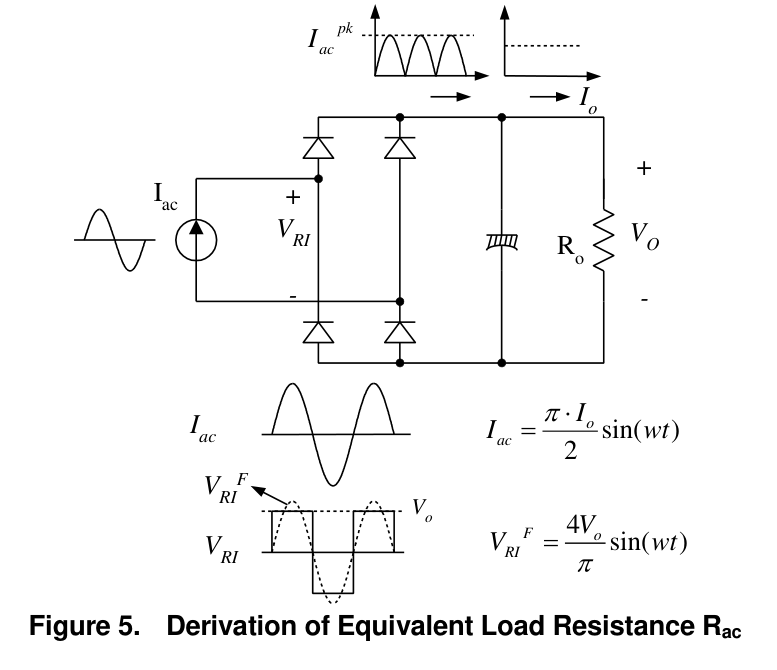
PQ50/Design Guide/figures/ref_rac_derivation.png
