yohan924-ops/L6790A-Single-Stage-PFC-LLC-Converter/PQ50/Design Guide/figures/resonant_current.png

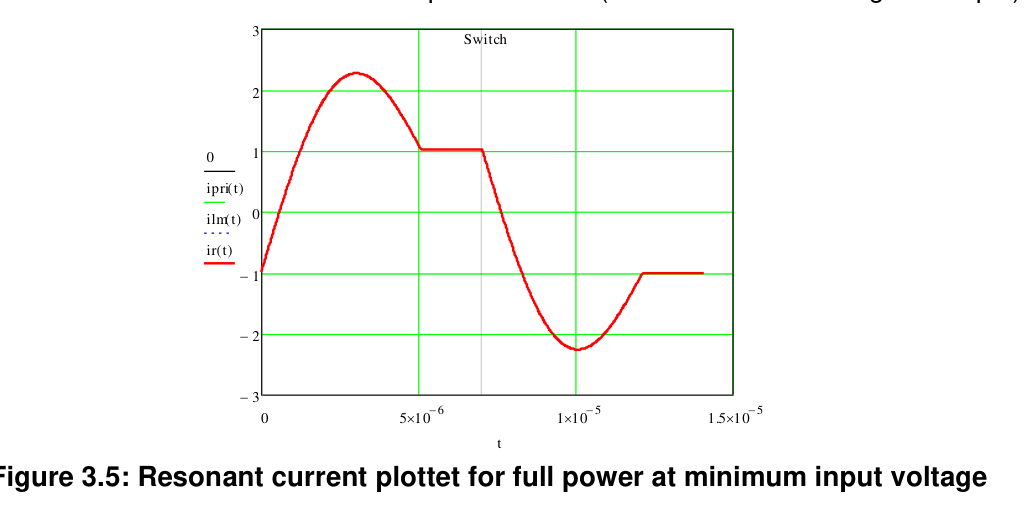
PQ50/Design Guide/figures/resonant_current.png
