yohan924-ops/L6790A-Single-Stage-PFC-LLC-Converter/docs/HISTORY.md

# HISTORY — L6790A 단일단 PF LLC 프로젝트의 근거 문서

**이 문서의 역할.** `CLAUDE.md`는 "무엇을 하면 되는가"만 담는다. 이 문서는 **"왜 그렇게 정했는가"**다.
근거·검증 이력·발견한 오류 전부·사고 기록이 여기 있다.

**언제 읽나:** 어떤 값이나 판단의 근거가 필요할 때, 또는 "이거 이미 확인한 건가?"가 궁금할 때.
평소에는 읽을 필요 없다.

---

## 1. 검증 이력 — **다시 하지 말 것**

### 1.1 식 전수 대조

**설계 가이드 식 [1]–[148] 전체를 6회 독립 재구현으로 대조했다. 불일치 0건.**

- 기준 구현: `Design Guide/generators/l6790.py` (식 [1]–[106] + θ 스윕)
- 대조 스크립트: `l6790_validate.py` — 240 W 예제를 재현하는지 한 번에 찍는다
- 6회차 대조 결과: 스칼라 28개 전부 일치 · `f_sw(θ)` 표 25칸 전부 0.1 kHz 이내 ·
  `[38a]` T_ZC 스윕 20칸 전부 일치 · 최악 코너 전류 6종 소수 3자리까지 일치

### 1.2 개별 검증 항목

| 항목 | 결과 |
| :--- | :--- |
| FHA 실제 동작점 | 수치해와 일치 |
| 위상식 [37] | 탱크 입력 임피던스 위상과 10⁻¹⁶ 수준 동일 |
| 파형 수치적분 | [63] 엄밀 · [64]의 √d 엄밀 · 합성 탱크 피크 일치 |
| 제어 루프 (240 W 예제) | f_cross 19.76 Hz · Φ_M 49.09° · D_3rd 4.54 % |
| EVL6790_670W 역산 | 보드 주석까지 재현 — λ_act 0.5000 · f_o 88.05 kHz · f_r 152.5 kHz · R_CS,max1 24.07 mΩ(실장 23.4 mΩ) · OCP1 여유 23 % |
| Cardano k=1 분기 | λ 0.35–0.80 × Q_pk 0.2–1.4 × 등가입력 6종 × θ 2°~90°, **6,089건 전수 · 예외 0 · 오차 4.8e-14** |
| 닫힌형 vs bracketed solver | 5개 코너 × θ 2°~90° 전 구간, **최대 오차 2.9e-15 · 실패 0** |
| SMath 시트 ↔ `l6790.py` | 22개 항목 자동 대조, 불일치 0 (`build_l6790_smath.py` 실행 시 매번) |
| 엑셀 ↔ SMath 전량 | **101개 값 대조, 차이 0** (의도된 차이 4건은 시트 §3.5) |
| 엑셀 ↔ SMath BOM | **29개 항목, 차이 0** (`bom_compare.py`) |

### 1.3 SMath 실행 검증

**2026-08-21 사용자가 SMath에서 직접 열고 F9까지 돌린 뒤 저장했다** (파일 revision 8).
저장된 `<result>` 값이 `l6790.py`와 일치하므로 **SMath 엔진이 시트를 우리 의도대로 계산한다는
독립 확인**이 끝났다. 붉은 리전 없음, 겹침 0.

---

### 1.4 검사 범위 — 무엇이 닫혔고 무엇이 안 닫혔나

**"다 찾았다"고 말할 수 없다.** 닫힌 것과 안 본 것을 구분해 둔다. 2026-08-23 기준.

#### 전수 확인이 끝난 것 (그 부류 안에서는 더 나올 것이 없다)

| 무엇 | 규모 | 결과 |
| :--- | ---: | :--- |
| SMath RPN 왕복 (`audit_rpn.py`) | 485식 | 불일치 0 — **SMath 가 인쇄된 값 그대로 계산한다** |
| SMath 차원 해석 (`audit_dim.py`) | 485식 | 충돌 0 · 표시 단위 불일치 0 |
| SMath 구조 (`audit_sm.py`) | 변수 328개 | 죽은 변수·정의 전 사용·검사 없는 한계 전부 해소 |
| 판정 지표가 시트 §17 요약에 나오는가 | 33개 | 33/33 |
| 엑셀 ↔ SMath 값 대조 (`xl_sm_compare.py`) | **135항목** | 일치 101 · 의도된 차이 31 · 나머지 3은 캐시 지연뿐 |
| BOM 대조 (`bom_compare.py`) | 29항목 | 차이 0 |
| 워크북 구조 (`audit_xl.py`) | 설계 시트 수식 781개 | 7개 부류 전수 |
| 워크북 캐시 오류값 | 전 시트 | 54개, **전부** RTC 행 29 의 의도적 `NA()` 차트 마스킹 |
| 보상망 이분법 수렴 | 27회 반복 | 독립 수치해와 0.013 % 이내 (17.564 vs 17.562 Hz) |
| `RTC` 격자가 선정 권선비를 쓰는가 | 2,803셀 | 가드 없는 셀 **0개** — C.5 수정이 완전하다 |
| **`RTC` 격자탐색의 답** (`rtc_check.py`) | **18점** (θ 6 × 입력 3) | Cardano·이분법과 **최대 0.197 %** — 격자 한 칸(2.199 kHz)의 14 %. 요구 게인 `M_req`는 18점 전부 0.000 % |

#### 아직 안 본 것 — 여기서 더 나온다면 이 중 하나다

| 무엇 | 규모 | 왜 안 봤나 |
| :--- | ---: | :--- |
| `RTC` 시트의 나머지 셀 | 수식 **10,008개** 중 설계에 안 쓰이는 부분 | **우선순위가 내려갔다(2026-08-23).** RTC가 설계에 영향을 주는 경로는 **셀 9개뿐**이고(`CC` 9수식 + `Device Setting` D2, 서로 겹침) 그 9개가 전부 `rtc_check.py` 18점 안에 들어 있다. 나머지는 차트 23장의 데이터다. 골격 750종의 전수 확인은 여전히 안 했다 |
| **`OutCap_Sel_DB`** | 수식 **3,172개** | 설계가 참조하지 않는다(시트 §3.2). 그래서 틀려도 지금은 영향이 없지만, 누가 쓰면 그때 드러난다 |
| **워크북의 차원 해석** | 수식 781개 | SMath 쪽만 했다. 엑셀은 수식 파서가 필요해 아직 없다 — `10^-6` 하나가 빠져도 잡을 방법이 없다 |
| 수식에 박아 넣은 상수 | 207건 | `audit_xl.py` 가 세기만 하고 검토하지 않았다 |
| 부록 C.9 의 근거 불명 상수 | 4개 | \[28\] 의 π²/8, \[36\] 의 지수 5, \[128\] 의 0.744, `K_HV`. **ST 문서에 근거가 없다** |
| 240 W 예제 전반 | 가이드 전체 | `R_P` 만 정정했다. 다른 반올림 방향 오류가 더 있을 수 있다 |
| `T_idle` | 1개 | 실측 전까지 확정 불가 (시트 §4) |

#### 그리고 이것이 원리적 한계다

**여기 있는 검사는 전부 *일관성* 검사다. *정확성* 검사가 아니다.**

`l6790.py` · SMath 시트 · 스프레드시트 셋이 같은 답을 낸다는 것은, 셋이 같은 식을 구현했다는
뜻이지 그 식이 물리적으로 옳다는 뜻이 아니다. **C.18 과 \[70a\] CT 결함은 일관성 검사로
찾은 것이 아니다** — 물리와 어긋나서 찾았다. θ=π/4 를 라인사이클 실효값이라 부르는 것은
세 구현이 모두 그렇게 했더라도 여전히 틀렸을 것이다.

> 그러므로 남은 위험의 대부분은 **셀이 아니라 모델에** 있다. 실측(`CLAUDE.md` 시트 §4.3)이 그것을 판정하는
> 유일한 수단이다.

### 1.5 240 W 예제 — 삭제 전 보존한 검증 기준

**2026-08-24.** 가이드 rev 2.0 에서 240 W / 60 V 예제를 **완전히 삭제**한다(사용자 결정).
그 예제는 `l6790.py` 가 지금까지 받은 **유일한 독립 검증**이었다 — ST 가 낸 수치를 우리
구현이 재현하는지 보는 것. `l6790_validate.py` 는 아래 29개 값을 코드 안에 갖고 있으므로
가이드에서 지워도 **검사는 계속 돈다.** 지워지는 것은 그 값들의 **출처**다. 그래서 여기 남긴다.

```
설계 조건   Vout 60 V · Pout 240 W · Nrect 2 (FB) · Cr 33 nF · Lr 34 uH · Lm 65 uH · n 2.5

Pin_LLC 244.90 W   Iin_max 2.721 A    Pd_BR 0.984 W    Pd_EMI 1.111 W   Pin 246.99 W
Vin_min 173.24 V   n_calc 2.519       MVmin 1.2245     MVmax 0.8035
l1 0.2445          l2 0.4401          lTD 0.5413       lam 0.5413       Rac 37.24 ohm
Qz1 0.9736         Qz2 4.073          Qz 0.8466        Z0 31.52 ohm     Cr_c 33.66 nF
lam_a 0.5231       nT 3.085           Z0s 32.10 ohm    Z0p 54.77 ohm
fr 150.25 kHz      fo 88.05 kHz       Lmu 80.22 uH     LL1 18.78 uH     LL2 1.973 uH
Qpk 0.862

라인사이클 (최악 코너 173.24 Vac 등가, 전부하)
  Isec 6.185 A   Idio 4.374 A   Ipri 3.760 A   ICout 4.72 A
  Isec_pk 15.42 A   Itr 6.169 A   ILm 3.840 A   comp 6.660 A   Tzc 246 ns
```

> **▷ 이 값들이 왜 중요한가.** 우리 25 V 설계에는 대조할 상대가 없다 — ST 가 25 V 예제를
> 낸 적이 없다. `l6790.py` 가 맞다는 근거는 **오직 이 240 W 예제를 재현한다는 것뿐**이고,
> 그 위에 SMath·워크북 삼중 대조가 얹혀 있다. 그러므로 `l6790_validate.py` 를 **절대
> 지우지 말 것.** 예제가 문서에서 사라져도 검사는 남아야 한다.

## 2. 닫힌형 해 — 이 프로젝트의 방법론적 발견

가이드 §4.2/부록 B.2는 `M(f_n,Q) = M_req`를 **수치적으로** 풀되 근이 두 개(용량성/유도성)이므로
반드시 큰 쪽을 잡으라고 경고한다. **이 방정식은 애초에 수치로 풀 필요가 없다.**

`M_req = M_pk/sinθ`, `Q = Q_pk sin²θ`를 [2]에 넣고 `x = 1/f_n²`로 정리하면 **x에 대한 3차식**:

```
λ² x³ + (q − 2λ(1+λ)) x² + ((1+λ)² − 2q − u/M_pk²) x + q = 0 ,   u = sin²θ , q = Q_pk² u²
```

- 근의 곱 = −q/λ² < 0, 근의 합 > 0 → **세 근은 항상 실근이고 정확히 하나만 음수**
- 따라서 물리적(유도성) 근은 **언제나 "가운데 근"** — 분기 판정 자체가 필요 없다
- Cardano 삼각함수형의 **k = 1 분기** `w·cos(ang − 2π/3) − a₂/3` 가 항상 그 근이다
  (6,089건 전수 확인, 시트 §1.2)

**의의:** 근 탐색·격자 해상도·초기값 문제가 **전부 사라진다.** ST 툴은 `RTC`에서 83칸 격자를
훑고 인접 두 칸 사이를 선형보간해 답을 얻는다 — 닫힌형에는 그 잔차(현재 최대 0.197 %)조차
없다.
역방향(주어진 f_n에 대한 sin²θ)은 2차식이며 역시 기계정밀도.

> **미반영:** 가이드 §4.2·부록 B.2가 아직 수치해 방식으로 서술되어 있다. rev 2.0에서 역이식할 것.

### 2.1 합성 탱크 피크의 닫힌형

`i_Lr(x) = I_Lm,pk(2x−1) + I_trafo,pk·sin πx` 의 최대는 `cos πx = −z`, `z = 2·I_Lm,pk/(π·I_trafo,pk)`
에서 발생 →

```
I_Lr,pk = I_Lm,pk·(2·acos(−z)/π − 1) + I_trafo,pk·√(1−z²)
```

격자 최대값과 **7e-6 A 이내 일치**. 스프레드시트 `Device Setting` D32가 이 식을 쓴다.

---

## 3. 발견한 오류 전부

### 3.1 데이터시트 (DRAFT, 2026-04-30)

| # | 위치 | 내용 |
| :-- | :--- | :--- |
| C.1 | T_idle | **3중 모순.** 시트 §5.3.2 `C_T,max` 식의 700 ns = 2·T_idle → 350 ns / 같은 절 `f_sw_min/max/SU` 식의 700 ns = T_idle 그 자체 → 700 ns / **Table 5 실측표 8칸 역산 → 250 ns** (시트 §4) |
| C.2 | V_BO | min/max 표기 뒤바뀜 |
| C.3 | 전류 규격 | peak/rms 혼용 |
| C.6 | 시트 §5.3.2 | 상수 **541.34 µA/V** = `(400 + 412.0)/1.5` — Table 5의 `I_OSC_SU = 412.5 µA`와 어긋난다(541.67이어야 함). 툴 전용 오차로 알려졌던 412 µA가 **DS 자신의 식에도 있다** |
| C.7 | 시트 §5.3.4 | `R_ZCD,L` 차원 오류 |
| — | 시트 §5.3.1 | 본문은 "a strong pull down on **LOUT1**"이라 쓰지만 Table 6의 열 제목과 실제 핀스트랩 동작은 **LOUT2**다. EVL 보드도 LOUT2 풀다운(R7 100 k)을 미실장하여 morphing을 쓴다 → **본문 오타** |

### 3.2 ST 스프레드시트 r1.0 — rev 0.6에서 수정 완료

| # | 위치 | 내용 |
| :-- | :--- | :--- |
| C.5 | `Res.Tank!D9` + **RTC 2,803셀** | N_rect=2에서 권선비 2배. 두 곳을 함께 고쳐야 한다 |
| C.6 | `D35` `D60` `CC!D26/E26` | 평균전력/rms/참조 오류 |
| C.8 | 14건 | `Design Spec!D20/D79` 등가입력 · `Device Setting!D83` /N_rect · `CC!C25` √d 누락 · `CC!C31` 2f_l 누락 · `Comp!D15/D43` CTR 이중 |
| C.10 | 3건 | `Device Setting!D3` 누락된 max · `Preliminary!D17` η 오라벨 · `Comp!D42` I_min |

**셀 수정으로는 못 고친다고 적었던 구조적 한계 — 셋은 철회됐고 둘이 남았다:**

- ~~`RTC`의 f_n 격자 상한 1.3703 — f_sw,max가 격자 밖~~ → **틀린 기록. 2026-08-23 철회.**
  1.3703은 격자가 아니라 `fn.max`(RTC 행 26 = √(λ/(1+λ−1/M)), 현재 **1.34178**)였다.
  격자 축은 행 25이고 `CG25 = 1.5·CG26` = **2.0127** = 305.4 kHz까지 간다. 우리 f_sw,max
  249.6 kHz는 f_n 1.6448이므로 **격자 안**이다. 격자의 실제 오차원은 상한이 아니라
  **해상도**이며, 칸 간격 f_r/69 = 2.199 kHz에 선형보간이 붙어 잔차는 0.2 % 미만이다.
  **2026-09-22: 상한 숫자는 그 뒤로 움직였다** — `CG26` 은 세 후보의 MAX 라 입력이 바뀌면 따라
  움직이고, 지금 워크북을 열어 보면 `CG26` 1.5251 · **`CG25` 2.2877** 이다. `CLAUDE.md` 는
  한때 2.2241 이라고 적고 있었다 — **세 숫자가 다 다르고 전부 어느 시점의 스냅숏이다.**
  **결론만 그대로다**(1.6448 < 상한). 이 값을 문서에 다시 박지 말 것 — 셀에서 읽으면 된다
- ~~`CC`의 3점 θ 평가~~ → **틀린 기록. 2026-08-23 철회** (시트 §3.7 원인 B). `RTC`가 이미 θ를
  6점 풀고 있었으므로 `CC`에 열 F·G·H와 J열 심프슨 적분을 넣어 닫았다. 뱅크 리플전류
  21.77 → **30.17 A**. "스프레드시트로는 적분을 못 한다"는 판단이 틀렸던 것이다
- `OutCap_Sel_DB` 미참조 · `D48` 죽은 셀 · `D77`의 c_HB 미피드백 · `B113` 빈 절
- ~~**`Device Setting` D2의 주파수 상한은 `RTC!BD212`, 즉 V_in,max = 264 Vac에서의 값이다.**~~
  → **틀린 기록. 2026-08-23 철회** (시트 §3.7 원인 E). 격자 탐색을 Cardano 닫힌형 18블록으로
  바꾸고 `RTC!C9`를 `MAX(D79, D81)`로 연결해, 시트가 계산만 해 두고 안 쓰던 `Design Spec`
  D81 = 332.34 V가 실제로 쓰이게 했다. f_sw,max 189.3 → **249.6 kHz**.
  670 W 실험의 툴 189.1 kHz vs 실제 249.8 kHz는 수정 전 상태를 말한 것이다
- **`Res. Tank Design` D30의 ZVS는 V_in,min·전부하 한 점만 본다.** 진짜 최악은 대개
  FB 코너의 경부하다 (670 W 실험: 툴 309.6 ns vs 전 영역 스윕 최악 375 ns @ 332.3 Vac·25 %)

> **그래서 스프레드시트는 정본이 아니다.** 정본은 `l6790.py`와 SMath 시트다.

### 3.3 ST 스프레드시트 — 보상망 시트 (C.12 · C.13, 2026-08-21 신규)

`CompensationNet&Check` [133]–[148] **26개 식을 셀 단위로 전부 대조했다. 수식 자체는 26개 모두
가이드와 일치**한다 (`D37 D38 D41 D42 D43 D64 D65 D66 D67 D72 D73 D74 D78 D83 D84 D85 D86
D93 D94 D95 D96 D101 D102 D103 D104 D128 D129`). 회로 토폴로지도 동일 — 시트에 박혀 있는
도면(H14, 894×531 px)을 추출해 확인했고 SMath 시트 §16 첫머리에 실려 있다
(`Design Guide/figures/comp_network_st.png`).

**그러나 루프 검증부에 결함이 2건 있다.**

| # | 위치 | 내용 | 영향 |
| :-- | :--- | :--- | :--- |
| **C.12** | `CN!H132/H134/H139`, 이분법 `H141:N167`, `D124` | **고주파 극점 `f_px`가 통째로 빠져 있다.** 이득·위상·교차주파수 모두 `f_z`·`f_p`만으로 계산 | 교차 근방에서 위상 약 **0.8–1.1° 낙관** |
| **C.13** | `CN!D73` | 라벨은 *"Required E/A Gain @ 2fLmin"* 인데 분모가 **`D65`(공칭 f_l의 리플)**다. `D68`이 바로 아래에서 f_l,min 리플을 계산해 놓고도 **어디에서도 참조되지 않는다.** `D125`도 `AV122 = 2·D110`(공칭 f_l)에서 읽는다 | 50/47 = **1.064배 낙관.** 3차 고조파 예산이 그만큼 헐거워진다 |

두 건 모두 **SMath 시트는 보수적인 쪽으로 이미 고쳐져 있다**(시트 §16.4, `f.line_min` 전면 적용).
차이는 시트 §16.7 표에 명시. 부수 확인: `D64`의 계수 `2·K_HV/(K_M·K_FF)` = 2×0.00334/(0.2×0.2)
= **0.167 V/(Ω·W)** 로 [122]와 정확히 일치.

### 3.4 ST 스프레드시트 — ISEN 블록 (C.14~C.17, 2026-08-21 신규)

**부록 C.8·C.10에도, `CHANGELOG_rev0_6`에도 없던 항목이다.** rev 0.6에서 Device Setting은
D3와 D83만 고쳤고 ISEN 블록(D38~D48)은 손대지 않았다.

- **C.14 — `D39 R.CS.max2`의 분모가 `I_trafo,pk`다.** R_CS는 브리지 리턴에 있으므로
  자화 성분을 포함한 **합성 탱크 전류 피크**를 본다. 670 W 실험: 16.90 대신 **18.62 A** →
  32.54가 아니라 **29.54 mΩ**. **1.10배 낙관.** 최대전력 조건이 지배하는 설계에서는 결과가
  안 바뀌지만, λ가 크거나 반사 전압이 높아 D39가 지배하면 그대로 위험하다.
- **C.15 — `D45`는 라벨이 "Select…"인데 수식 셀이다.** `(3/220+1/440)^-1` = 62.857 mΩ는
  **EVL 보드의 220‖220‖220‖440 실장망을 박아 넣은 상수**이고, 거기에 D43을 곱해 뒤의
  `D46 = D45/D43`이 같은 값을 다시 뱉게 해 놓았다. **계산이 아니라 상수 왕복이므로 사양을
  무엇으로 바꿔도 R_CS는 영원히 62.857 mΩ이다.** 게다가 `D46 = D45/D43`은 "동일 저항 D43개
  병렬"을 전제하는데 실제 망은 220 3개 + 440 1개다. 결정적으로 **D45(188.57)가 바로 위
  D44(72.20)를 2.6배 위반해도 경고가 없다** — 240 W 원본에서는 D44 = 204.05 > 188.57이라
  우연히 통과했을 뿐이다.
- **C.16 — `D33`의 전류 기준이 틀렸다.** `MAX(CC!C29, Prelim!D11)`인데 `CC!C29`는
  **θ = π/4 한 점**의 스위칭주기 실효값이다. 670 W 실험에서 10.239 A. 라인사이클 실효는
  10.880 A(손실의 물리적 정답), 가이드가 쓰는 최악 스위칭주기(θ=π/2)는 13.932 A.
  **툴 값은 둘 중 어느 것도 아니다.** R_CS = 24 mΩ에서 2.52 / 2.84 / 4.66 W →
  1 W 부품 **3개가 아니라 5개**가 맞다.
- **C.17 — OCP가 아예 없다.** 워크북 전체에 `0.75`(V_OCP2)도 "OCP"라는 문자열도 어떤 수식·
  라벨에도 없다. R_CS를 고른 뒤 **OCP가 몇 A에서 트립하는지 시트가 알려주지 않는다.**
  670 W 실험에서 62.86 mΩ이 조용히 살아남은 이유가 이것이다 — I_OCP1 = 8.75 A인데 실제
  합성 피크는 18.62 A로 상시 트립인데도 시트 어디에도 그 사실이 안 나온다.

**▷ 스프레드시트에 반영 완료 (2026-08-21).** `Device Setting` 9셀 수정 + 11셀 신설:

| 셀 | 전 | 후 |
| :--- | :--- | :--- |
| D32 | `=CC!E27` (I_trafo,pk) | 합성 피크 **닫힌형** (시트 §2.1) |
| D33 | `MAX(CC!C29,…)` θ=π/4 | `MAX(CC!E29,…)` θ=π/2 |
| D44 | (그대로) | `=MIN(D38,D39)*D43` — 단일 저항의 **상한** |
| D45 | `=D43*(3/220+1/440)^-1` | `=LOOKUP(D44/10^INT(LOG10(D44)),{E24 24개})*10^INT(LOG10(D44))` — 상한 이하 최대 **E24 실물값**. 실제 선택은 F45(노란 셀) |
| F45 / D43 / D46 | 텍스트 / 3 / `=D45/D43` | **120** / 5 / `=IF(ISNUMBER(F45),F45,D45)/D43` |
| F61 | 78 kΩ | **30 kΩ** — R_BM ∝ R_CS이므로 D61 상한이 78.7 → 30.1 kΩ. 안 고치면 버스트 진입이 75 → 195 W |
| D49·G49·D50 (신설) | 없음 | `I.OCP1 = 0.55/R.CS` · `I.OCP2 = 0.75/R.CS` · `k.OCP1 = I.OCP1/D32` |

### 3.4b ST 스프레드시트 — θ=π/4 를 "라인사이클"이라 부른다 (C.18, 2026-08-23 신규)

> **정정.** 이전 판의 시트 §3.6 표는 `Power Components` D28(I_Cout)의 차이를 **[70a] CT 결함**
> 탓으로 적었다. **틀렸다.** `CC!C31 = √(0.5·d·I_sec,pk² − I_o,inst² + I_out²/2)` 의
> `0.5·d·I_sec,pk²` 는 이미 **노드** 평균제곱이다(권선당 값의 2배). 워크북은 CT 함정에
> 빠지지 않는다. 실제 원인은 아래 C.18 — 그 열 전체가 θ=π/4 한 점이라는 것이다.
> **[70a] CT 결함은 가이드 본문의 문제이고(시트 §3.5), 워크북의 문제가 아니다.**

`CC` 시트는 θ 를 **세 점(π/4, π/3, π/2)** 에서만 평가한다. 그 중 **θ=π/4 열(C열)** 이
여러 곳에서 *"(mains cycle)"* 라벨을 달고 라인사이클 실효값 행세를 한다:

| 셀 | 참조 | 라벨 | 실제 내용 |
| :--- | :--- | :--- | :--- |
| `Res. Tank Design` D65 | `=CC!C29` | Ipri.rms **(mains cycle)** | θ=π/4 한 점의 스위칭주기 실효값 |
| `Res. Tank Design` D67 | `=CC!C25` | Isec.rms **(mains cycle)** | 같음 |
| `Power Components` D60·D61 | `=CC!C29`·`=CC!C30` | Ipri.rms / per mos | 같음 → **D78 손실식으로 들어간다** |
| `Power Components` D84·D85 | `=CC!C25`·`=CC!C26` | Isec.rms / Idiode.rms | 같음 → **D100 손실식으로 들어간다** |

**왜 θ=π/4 인가.** 포락선이 정확히 `sin θ` 라면 그 점의 값이 라인사이클 실효값과 같아진다
(`sin(π/4) = 1/√2`). 근거 없는 선택이 아니라 **의도된 근사**다.

**그런데 실제 포락선은 `sin²θ` 다.** `I_out,inst = 2·I_out·sin²θ` 이므로 근사가 성립하지 않는다.
`l6790.py` 의 5점 Simpson 적분과 대조하면:

```
                θ=π/4 한 점      라인사이클 실효      차이
  I_pri          10.302 A         10.912 A        +5.9 %
  I_diode(권선당) 24.146 A         28.401 A       +17.6 %
```

**손실은 전류의 제곱이므로 영향이 커진다:**

```
  D100 Pdiss_d   7.93 W  ->  10.98 W   (1.38 배)
  D101 필요 Rth  12.60   ->   9.11 °C/W
  D78  Pdiss.s   2.65 W  ->   2.98 W   (1.12 배)
```

**▷ 스프레드시트에 반영 완료 (2026-08-23).** `CC` 시트는 θ 열이 3개뿐이라 적분이 불가능하다.
그래서 워크북 자신의 패턴을 따랐다 — 계산 열은 근사를 유지하되 **라벨을 `@θ=π/4 (approx.)`
로 정정**하고, F열에 SMath 시트의 라인사이클 실효값을 받는 **노란 입력 셀을 신설**했다
(F60 10.90 / F61 7.707 / F84·F85 28.31 A). 손실식 D78·D100 은
`IF(ISNUMBER(F..), F.., D..)` 로 선정값을 우선한다.

> **SMath 시트는 처음부터 5점 Simpson 라인사이클 실효값을 쓴다** (시트 §10). 영향 없음.

### 3.4c 2026-08-23 — 남아 있던 워크북 오류 전부 반영

`xl_sm_compare.py` 로 101항목을 대조하며 "아직 안 고친 것"을 뒤졌다. 넷이 남아 있었다.

| # | 무엇 | 어떻게 고쳤나 |
| :-- | :--- | :--- |
| **C.12** | 고주파 극점 `f_px` 가 `D104` 에 계산만 되고 **어디에서도 참조되지 않는다** | 루프 검증식 **196셀**에 f_px 항 삽입 — 이득 120개에 `/(1+(f/f_px)²)`, 위상 76개에 `−atan(f/f_px)`. 공유 수식이라 **마스터 7개**만 고치면 전체가 따라온다 |
| **C.13** | `D73` 이 `D65`(공칭 f_l 리플)로 나눈다. `D68`(f_l,min)이 계산되고도 미참조 | 분모를 `D68` 로 |
| **입력** | `Design Spec` D46·D47 이 ST 툴 기본값 500 pF / 270 ns | **800 pF / 220 ns** — 본 설계의 실제 선정 소자. SMath 는 처음부터 이 값이었다 |
| **입력** | `Device Setting` D13 T_idle = 350 ns, SMath 는 250 ns | **250 ns 로 통일.** 두 문서가 같은 값을 써야 대조가 의미를 갖는다. **실측 전까지 확정 아님** (시트 §4) |

> **⚠ Excel 을 한 번 열어야 한다.** 수식을 바꿨으므로 캐시값이 낡아 있다. 파일에
> `fullCalcOnLoad="1"` 이 설정되어 있으므로 **열기만 하면** 재계산된다. 그 전까지
> `xl_sm_compare.py` 는 옛 값을 비교한다.
>
> 재계산 후 기대: C.12·C.13 계열 **9행**과 T_idle 계열 **5행**이 `INTENDED` 에서
> `same` 으로 바뀌어야 한다. 안 바뀌면 조사할 것.

### 3.4d 구조 감사 — 2026-08-23, C.21 ~ C.24

C.12(계산만 하고 아무도 안 읽는 극점)와 C.15(자기 상한을 2.6배 위반하는 선정값)는 **읽어서
찾은 것이 아니라 구조가 이상해서 찾았다.** 그 두 가지 *모양*을 전 시트에서 기계로 훑도록
`audit_xl.py`(워크북)와 `audit_sm.py`(SMath)를 만들었다. 넷이 더 나왔다.

**`audit_xl.py` 가 보는 것**
① 계산만 하고 아무도 안 읽는 셀 ② 캐시에 남은 오류값 ③ 빈 셀을 읽는 수식
④ **선정값이 자기 한계를 벗어남** ⑤ 셀로도 존재하는 값을 수식에 박아 넣음
⑥ 라벨은 max 인데 수식은 MIN(그 반대도)

**`audit_sm.py` 가 보는 것**
① 계산만 하고 아무도 안 쓰는 변수 ② 정의보다 먼저 쓰임 ③ **한계는 있는데 비교가 없음**
④ 설명 없는 판정값 ⑤ 가이드에는 있는데 시트에 안 보이는 식

#### C.21 `Res. Tank Design` D20 `QZVS.3` — 계산하고 버린다

`D26 QZVS = 1/(1+m)·MIN(D18:D19)` 는 **가이드 [34] 와 정확히 일치**한다 — [34]도
`min(Q_ZVS,1, Q_ZVS,2)` 두 개뿐이다. 그런데 툴은 D20 에 세 번째 값을 계산해 놓고 쓰지 않는다.

역산하면 `Q_ZVS,3 = √(λ(1+λ)) / M_Vmin,pk` = **0.7460**. 우리 설계의 `Q_pk = 0.7717` 은
그보다 3.4 % 크다. 만약 이것이 실제 한계라면 위반이다.

**한계가 아니다 — 두 가지로 직접 확인했다.**

```
FHA 게인 천장 @ Q_pk=0.7717, λ=0.550 : M_peak = 1.4161
요구 게인 M_Vmin                      : M      = 1.2245   -> 여유 15.6 %
[38a] 전 영역 ZVS 스윕                : T_ZC 457 ns vs t_D 220 ns -> 여유 108 %
```

즉 탱크는 요구 게인을 여유 있게 내고 ZVS 도 넉넉하다. `Q_ZVS,3` 는 **근거를 확인할 수 없는
과보수 식**이며(부록 C.9 계열), 그대로 적용하면 Q 를 불필요하게 3 % 낮추게 된다.
**가이드와 SMath 는 [34] 를 따르므로 영향 없다.**

#### C.22 `Device Setting` D24 `RT.min` — 라벨이 정반대다

`f_Min = 1/(2·(C_T·R_T + T_idle))` 은 **R_T 가 커질수록 내려간다.** D24 가 계산하는 값은
`f_Min` 이 `f_o` 와 정확히 같아지는 R_T 이므로, R_T 는 그 **아래**에 있어야 한다.
"min" 이라고 적혀 있으면 R_T 를 올림하게 되고, 그러면 VCO 클램프가 `f_o` 아래로 내려가
용량성 영역 진입을 ACP 보호에만 의존하게 된다 — 설계 규칙이 명시적으로 금지하는 상황이다.

**▷ 정정 완료.** 워크북 `C24` 를 `RT.ceil (NOT a minimum)` 으로, SMath 변수를
`R.T_min` → **`R.T_ceil`** 로 바꾸고 양쪽에 비교 검사를 넣었다
(`k.RT.ceil` / `k.RTd`, 현재 1.022). 선정 11 kΩ 은 상한 11.02 k 아래라 **방향은 원래 맞았다.**

#### C.23 `R_P` 선정값이 자기 상한을 4.3 % 위반 — 가이드 예제도 같다

`R_{P,max} = V_F/I_min` [144] = 1.15/0.8 mA = **1.4375 kΩ**. 그런데 워크북과 SMath 와
**가이드의 240 W 예제까지 전부 1.5 kΩ** 을 쓴다 — 상한을 올림한 것이다.

1.5 kΩ 이면 션트 레귤레이터 캐소드 전류가 `1.15/1.5 = 0.767 mA` 로 최소 0.8 mA 아래로
떨어져 FB 범위 하단에서 조정 능력을 잃는다. **상한은 내림한다.**

**▷ 1.4 kΩ (E96) 로 변경.** 부수 효과로 `R_B` 창이 16.02–18.22 → **15.39–17.41 kΩ** 로
이동하지만 선정 16.5 kΩ 은 여전히 안쪽이고 오히려 여유가 균형 잡혔다
(`k.RB_lo` 1.030 → **1.072**, `k.RB_hi` 1.104 → **1.055**).

#### C.24 `C_in` 선정값이 하한 미달 · 그리고 비교 검사 자체가 없던 곳 3군데

`C_in` 선정 2000 nF, 하한(3 nF/W) 2054 nF — **2.6 % 미달**. → **2200 nF (E6)** 로 변경.

그리고 **한계를 계산해 놓고 비교하지 않는 곳**이 양쪽 문서에 있었다:

| 한계 | 선정값 | 검사가 없었다 | 새 검사 |
| :--- | :--- | :--- | :--- |
| `C.T_max` / `C.T_min` | C_T 470 pF | 없음 | `k.CTd` 1.489 / 워크북 `k.CT` |
| `R.T_ceil` | R_T 11 kΩ | 없음 | `k.RTd` 1.022 / 워크북 `k.RT.ceil` |
| `n.aux_max` | n_aux/n_sec 0.8 | 없음 | `k.auxr` 1.045 / 워크북 `k.naux` |
| `R.P_max` | R_P | 없음 | `k.RP` 1.027 |
| `C.in` (하한) | C_in | 없음 | `k.Cin` 1.071 |

> **한계를 계산만 하고 비교하지 않으면 위반이 조용히 지나간다.** C.15 가 정확히 그 구조였다.
> SMath 판정 지표는 이제 **29개, 전부 통과**.

### 3.4e Phase margin 과 Gain margin

**위상 여유는 원래 양쪽에 다 있었다** — 워크북 `CN!D124 = 180 + AT139`, SMath `Φ.act`.
독립 수치해로 검산하면 **49.275°** 이고 두 문서가 인쇄하는 값과 일치한다(49.28).
다만 워크북 쪽은 `f_px` 극점이 빠져 있었고(C.12), 그것은 오늘 고쳤다.

**이득 여유(gain margin)는 어느 쪽에도 없었다.** 위상 여유만으로는 안정성 논증이 닫히지
않는다 — 이 보상망은 고주파에서 영점 1개 대 극점 2개라 위상이 −270° 로 가고, 따라서
`arg T` 가 **유한 주파수에서 −180° 를 지난다.**

**이분법이 필요 없다.** `atan(f/f_z) = atan(f/f_p) + atan(f/f_px)` 의 양변에 탄젠트를 취하고
`f` 로 나누면 제곱근 하나가 남는다:

```
f_180 = √( f_p·f_px − f_z·(f_p + f_px) )
      = √(49172.6 − 6730.4) = 206.02 Hz          (수치 근 206.013 과 일치)
|T(f_180)| = 0.01935   ->   GM = 34.26 dB
```

근호 안이 음수가 되면 위상이 −180° 에 닿지 않고 이득 여유는 무한대다 — 식 자체가 그 경우를
말해 준다.

**▷ 양쪽에 반영 완료.** SMath 시트 **시트 §16.4b** (`f.180` `T.180` `GM` `GM.t` `k.GM`),
워크북 `CompensationNet&Check` **C130:E134**. 현재 `k.GM` = **3.426** (목표 10 dB).

### 3.4f 반복 구조 감사 — 10라운드, C.25 ~ C.27

한 번 훑고 끝내는 대신 **매 라운드 다른 종류의 결함을 찾도록 검사를 바꿔 가며** 돌렸다.
음성 결과도 결과다 — 무엇을 이미 확인했는지가 남는다.

| 라운드 | 무엇을 찾았나 | 결과 |
| :-- | :--- | :--- |
| 1 | 독립적으로 중복된 입력 (하나만 고치면 조용히 어긋나는 것) | `Config.` 이름 충돌 1건. **배선 오류는 없음** |
| 2 | bulk 시트에서 θ 열들의 구조 불일치 | **C.25** — `CC` 4셀이 잘못된 셀 참조 |
| 3 | `.sm` 의 RPN 을 되읽어 독립 평가 | **475식 전수, 불일치 0** |
| 4 | 차원 해석 (V + A 같은 것, ln 인자의 단위) | **475식 전수, 충돌 0 · 표시 단위 불일치 0** |
| 5 | 아무도 읽지 않는 노란 입력 | `N.mos` · `R.ZCD_H_sel` 2건이 진짜 |
| 6 | 열 골격 일관성을 전 시트로 확대 | C.25 외 새 예외 없음 |
| 7 | 선정값(F)이 있는데 계산값(D)을 읽는 곳 | **C.27** 1건. `RTC` 격자 n 은 **0건**(C.5 수정 완전) |
| 8 | SMath 시트 §19 BOM 이 선정값을 보는지 | 깨끗함. 뒤바뀐 라벨은 워크북 쪽만 |
| 9 | 판정값이 시트 §17 요약에 나오는지 | **31개 중 26개가 안 나왔다** |
| 10 | 가이드 152식을 두 구현과 대조 | **네 식이 SMath 에 없었다** |

#### C.25 `CC` D39·E39·D52·E52 — C.6 수정이 절반만 적용돼 있었다

`IF('Design Spec'!$D$108=1, ...)` 이 정류 구성(`D107`) 대신 **`Vf.BR`(0.08 V)** 를 본다.
0.08 은 1 이 아니므로 조건이 **항상 거짓**이 되어, CT 설계인데도 FB 분기(`/√2`)가 돈다.

`CHANGELOG_rev0_6` 이 이 오류를 C.6 으로 기록하고 **행 26(100 % 부하 블록)만** 고쳤다.
75 % / 50 % 블록의 같은 셀 넷은 남았다. **지금 행 34–54 를 읽는 셀이 하나도 없어 수치 영향이
없다 — 그래서 살아남았다.** 그 블록을 쓰는 순간 권선당 실효값이 29 % 낮게 나온다.

#### C.26 BOM 의 ZCD 저항 설명이 서로 바뀌어 있다

`BOM&Schematics` 행 55 는 `R.ZCD.L`(19 kΩ)을 **"Upper ZCD resistor"**, 행 56 은
`R.ZCD.H`(162 kΩ)를 **"Lower ZCD resistor"** 라고 적는다. 값과 링크는 맞고 **말만 뒤바뀌었다.**

**이 BOM 대로 실장하면 분압비가 뒤집힌다.** OVP1 임계가 27.4 V 가 아니라
`2.3/0.8 × (19/162 + 1) = 3.2 V` 가 되어 **기동 즉시 OVP 로 걸린다.**
SMath 시트 §19 는 정상이다.

#### C.27 BOM 이 선정값 대신 계산값을 읽는 곳

`BOM&Schematics` E37 "Single Rsense value" 가 `Device Setting!D45`(계산된 E24 값)를 읽는다.
워크북의 관용구는 `IF(F,F,D)` 이고 다른 BOM 행은 전부 그것을 쓴다. **현재 D45 와 F45 가 우연히
둘 다 120 mΩ 이라 보이지 않는다.**

> **▷ C.25 · C.26 · C.27 은 셋 다 워크북에 반영됐다** — `CHANGELOG_rev0_6` **행 72 · 73 · 74**.
> 2026-09-02 에 셀을 직접 열어 확인한 현재 상태:
>
> - C.25 → `CC` D39·E39·D52·E52 가 전부 `'Design Spec'!$D$107` 을 본다
> - C.26 → BOM 행 55 = "Lower ZCD resistor (to GND)" · 행 56 = "Upper ZCD resistor
>   (to aux winding)". **이 BOM 대로 실장해도 기동 즉시 OVP 로 걸리지 않는다**
> - C.27 → BOM E37 = `IF('Device Setting'!F45, F45, D45)`
>
> 이 세 건이 시트 §3.4c 의 Phase 4b 목록과 `CLAUDE.md` 시트 §4 표에 빠져 있어서 "반영 안 된 것" 처럼
> 보였다. **C.26 은 라벨 오류라 "계산 결함" 이라는 말에 안 걸리므로 특히 눈에 안 띈다.**

#### 라운드 5 · 9 · 10 에서 SMath 에 채운 것

| 무엇 | 왜 필요했나 |
| :--- | :--- |
| `V.OVP1_act` `V.OVP2_act` `k.OVP1` `k.VCC` — 식 [97][98] | 선정한 ZCD 분압기가 **실제로** 만드는 OVP 임계를 되계산하지 않고 있었다. `R.ZCD_H_sel` 은 BOM 에만 쓰이는 죽은 입력이었다. 워크북은 D94~D99 에 갖고 있다 |
| `N.mos` 를 `P.pri_tot` 에 연결 | `2·R·I²` 의 "2" 가 실은 `N.mos/2` 였다. 입력이 아무 일도 안 하고 있었다 |
| **시트 §17.1 전 판정값 표** | 31개 중 **26개가 시트의 설계 요약에 없었다.** 시트 §14b 깊은 곳에서 실패하면 요약만 읽는 사람에게는 보이지 않는다 |
| `I.R1_pk` `I.R0` `T.T` `k.TT` — 식 [40][41][42] | **ZVS 조건이 둘인데 하나만 검사하고 있었다.** 공진 전류가 아직 흐를 것(`k.ZVS`)과 **천이가 데드타임 안에 끝날 것**(`k.TT`). 두 번째가 통째로 없었다. 현재 T_T = 29.7 ns, k.TT = 7.41 |
| `C.T_min` — 식 [73] | 설계 하한이 없었다. DS 의 270–1000 pF 창과는 다른 조건이다. `k.CTd` 가 이제 양쪽을 본다 (1.489 → 1.446) |
| `N.RCS_req` `k.NRCS` — 식 [82] | 저항 개수가 근거 없는 자유 선택이었다. 최악 스위칭주기 손실 기준으로 4.54 → 5개 필요, 현재 5개 |
| `V.out_SUend` — 식 [99] | 기동이 넘어가는 출력 전압. 75 mF 뱅크의 콜드 스타트 판정에 직접 쓰인다 |

> **판정 지표 23 → 33개.** 전부 통과. 새 검사기 `audit_xl.py` · `audit_sm.py` ·
> `audit_rpn.py` · `audit_dim.py` 가 이 열 라운드를 매번 재현한다.

### 3.7 엑셀 ↔ SMath 의 차이 — 행 18개가 아니라 **원인 6개**다

2026-08-23. 두 수식을 나란히 놓고 전수 대조한 결과다. **각 그룹 안에서 두 식은 글자까지
같고 들어가는 값 하나만 다르며, 뒤의 행들은 첫 행의 하류다.** 행을 세면 문제가 실제보다
많아 보인다. `xl_sm_compare.py` 가 이 태그를 매번 인쇄한다.

| 원인 | 무엇 | 영향 행 | 수정 |
| :-- | :--- | :--- | :--- |
| **A** | **ZVS 를 선정 후 재검산하지 않는다.** `D28` 은 근사식 [36](f_n 0.82111), `D29` 는 선정 Q(0.8466). 실제 동작점은 f_n 0.84006 · Q 0.7717 이고 **툴 자신의 `RTC!BB149` · `RTC!C41` 에 있다** | D30·D35·D36·D37 | 셀 2개 |
| **B** | **C.18 — `CC` 가 θ 를 3점만 본다.** `D65`·`D67`·`D28` 은 각각 `CC!C29`·`C25`·`C31` **한 칸을 그대로 읽는다** | D65·D67·D28·D40 | `CC` 확장 |
| **C** | **검증 블록의 입력 `D110 = 50 Hz`.** 설계 블록(`D7`·`D68`·`D73`·`D83`)은 47 Hz 다 — 47 로 설계하고 50 으로 검증한다 | D125·D126·D128·D129 | **입력 1개** |
| **D** | **홀드업 시작 전압이 공칭 `D14` = 25 V.** 실제 출력은 리플로 24.41–25.59 V 를 오간다 | D22·D33 | 수식 2개 |
| **E** | **`RTC!C9` 가 264 V(AC 최대)를 가리킨다.** 탱크가 보는 최대 등가입력은 `Design Spec!D81` = 332.34 V 이고 **그 셀은 아무도 읽지 않는다**(읽는 곳 0) | D19 | 링크 1개 |
| **F** | **정의가 다르고 양쪽 다 맞다.** 목표 25 V vs 분압기 실현 25.18 V · `CEILING` 적용 여부 · `R_CFG` 는 90 V 절대상한 vs 85 V 설계값 | D23·D42·D108 | 없음 |

> **B 는 "구조적으로 불가능" 이 아니다** — 앞서 그렇게 기록했으나 틀렸다. `RTC` 는 이미 θ 를
> **6점**(15°·30°·45°·60°·75°·90°) 푼다. `CC` 에 3열을 더하고 θ=0 끝점(전류가 0)을 넣어
> 사다리꼴로 적분하면 181점 스윕 대비 **오차 0.35 %** 다. 단순평균은 θ≈0 구간을 빼먹어
> +9.7 % 가 되므로 반드시 끝점을 넣어야 한다.

#### 이 표가 필요했던 이유 — 내가 반복해서 틀린 방식

이 세션에서 나는 차이를 **숫자만 보고** 진단했고 그래서 네 번 틀렸다:

1. `RTC` 를 "설계가 안 쓰는 참고용" 이라고 했다 → 실제로는 `CC` 9수식 + `Device Setting` D2 가 읽는다
2. 개당 리플전류 0.19 A 를 **정격**이라고 했다 → `I.Cout_rms/n.C` 로 계산된 **스트레스**다
3. B 와 E 를 "셀 수정으로는 불가능" 이라고 했다 → 둘 다 가능하다 (위 참조)
4. `ΔV.loop` 를 `CC!D65`("@2fL" 참고 행)에 매핑해 **없는 결함을 만들어냈다** → 설계가 쓰는 것은
   `D68`("@2fLmin") 이고 그 값 1.18430 은 시트와 정확히 같다

**교훈: 두 수식을 나란히 놓고 같은 양인지 먼저 확인할 것.** 숫자 차이는 진단이 아니다.

#### 2026-08-23 워크북에 적용 — A · C · D (`fix_xl_causes.py`)

셀 6개. 전부 **워크북이 이미 갖고 있는 값으로 링크를 바꾼 것**이고 새로 계산한 값은 없다.
순환 참조가 없음을 의존 그래프로 먼저 확인했다.

| 원인 | 셀 | 바꾼 것 | 예상 (재계산 후) |
| :-- | :--- | :--- | :--- |
| A | `Res.Tank D28` | 근사식 [36] → `RTC!$BB$149` | f_n 0.82111 → **0.84006** |
| A | `Res.Tank D29` | Q 두 곳을 `D26`(0.8466) → `RTC!$C$41`(0.7717) | 위상 0.23476 → **0.36621 rad** |
| A | `Res.Tank D30` | 분모를 `Design Spec!D102`(목표 150 kHz) → `D55`(실제 151.748) | T_ZC 303 → **457.2 ns** |
| C | `CC D110` | 50 → **47 Hz** | 3차 고조파 3.86 → **4.31 %** 외 4행 |
| D | `Power D22` | `D14^2` → `(D14−D31/2)^2` | 요구 용량 59.77 → **67.22 mF** |
| D | `Power D33` | 같음 | 홀드업 15.10 → **13.42 ms** |

> **예상값은 SMath 와 소수점까지 같다.** 다만 오늘 "재계산하면 일치한다" 는 예측이 4건 틀린 적이
> 있으므로, **사용자가 Excel 에서 열었다 저장한 뒤 `xl_sm_compare.py` 로 확인해야 확정이다.**

`CHANGELOG_rev0_6` 시트에 3행(76–78)으로 기록했다 — 워크북만 받은 사람도 이유를 알 수 있다.

#### 2026-08-23 워크북에 적용 — B, C.18 을 닫았다 (`fix_xl_cc.py`)

**"스프레드시트로는 적분을 못 한다" 는 판단이 틀렸다.** `RTC` 는 이미 θ 를 **6점**
(π/12 · π/6 · π/4 · π/3 · 5π/12 · π/2, 15° 간격) 푼다. `CC` 가 그중 3점만 읽고 있었을 뿐이다.

| 무엇 | 어디 |
| :--- | :--- |
| θ 열 3개 추가 | `CC` 열 **F**(5π/12) · **G**(π/6) · **H**(π/12), f_sw 를 `RTC!BC150 · BC153 · BC154` 에서 |
| 노드 전류의 제곱 | `CC` **행 32** — 적분에 필요한 양 |
| Simpson 적분 | `CC` **열 J** — 가중치 1,4,2,4,2,4,1 ÷ 18. **θ=0 표본은 정확히 0**(부하가 sin²θ) |
| 설계 연결 | `Res.Tank D65 → CC!J29` · `D67 → CC!J25` · `Power D28 → CC!J31` |

**결과 (721점 스윕 대비):**

```
2차 실효 (권선당)   24.14 -> 28.299 A   오차 −28 %  ->  −0.04 %
뱅크 리플전류       21.77 -> 30.167 A   오차 −28 %  ->  −0.08 %     <- 커패시터 160개를 정하는 값
1차 실효           10.30 -> 10.701 A   오차 −11 %  ->  −1.83 %
뱅크 손실          0.0839 -> 0.1610 W  (SMath 0.161)
```

**1차 전류만 잔차가 남는다.** 자화 전류는 θ=0 에서도 사라지지 않으므로 그 끝점이 0 이 아니다.
그런데 끝점을 f_o 기준으로 외삽하면 **+4.7 % 로 오히려 나빠진다** — θ→0 은 실제로 버스트
영역이라 도달하지 않기 때문이다. 0 이 최선이다. 사다리꼴과 Simpson 을 둘 다 재보고
Simpson 을 택했다 (1차 −1.83 % vs −2.70 %, 나머지는 동일).

> **`CC!C31` 의 `C15^2/2` 항은 그대로 두었다.** `C15 = C14/C5 = 0` 이라 값에 영향이 없지만,
> 그 항이 무엇을 뜻하는지 알아내지 못했다. 새 열에는 `$C$15` 로 고정해 열 C 와 같게 했다.

#### 2026-08-23 워크북 정리 완료 — 대조 134/134, 차이 0

원인 A–F 를 전부 닫았다. 마지막 상태:

```
xl_sm_compare   134항목 — 일치 134 · 의도된 차이 0 · 불일치 0
rtc_check       18점   — 최대 편차 0.0000 %
bom_compare     29항목 — 차이 0
```

| 원인 | 무엇을 했나 | 결과 |
| :-- | :--- | :--- |
| A | `D28`→`RTC!$BB$149`, `D29` 의 Q→`RTC!$C$41`·λ→`D50`, `D30` 분모→`D55` | T_ZC 303 → **457.2 ns** |
| B | `CC` 에 θ 3열(F·G·H) + 행 32 + Simpson 적분(열 J), 설계를 `CC!J..` 로 | 뱅크 리플 21.77 → **30.17 A** |
| B 잔차 | `I28`·`I29` 에 θ=0 끝점(자화 전류), `J29` 에 가중치 1 항 | 1차 실효 −1.83 → **−0.02 %** |
| C | `CC!D110` 50 → **47 Hz** | 3차 고조파 3.86 → 4.31 % |
| D | `Power D22`·`D33` 의 `D14^2` → `(D14−D31/2)^2` | 홀드업 15.10 → **13.42 ms** |
| E | **Cardano 닫힌형 18블록**(RTC 220–234) + `BB149..BB202` 연결, `fn.max` 클램프, `RTC` 행 9 → `MAX(D79,D81)` | f_sw,max 189.3 → **249.6 kHz** · C_T 상한 839 → **699.6 pF** |
| F | 대조 짝 3건이 잘못돼 있던 것 — 워크북은 이미 `D38`(25.177 V)·`D109`(84.85 V)·`D42`(5)를 맞게 갖고 있었다 | 전부 일치 |

**`E` 는 "고칠 수 없다" 고 두 번 기록했으나 둘 다 틀렸다.** 격자 탐색을 닫힌형으로 바꾸니
범위 문제가 사라졌고, 보간 잔차 0.2 % 까지 없어졌다.

#### 남은 흠 — `RTC` 행 26·27 의 `#NUM!` 164칸

`Vin_max` 가 FB 코너로 옮겨가면서 `fn.max = √(λ/(1+λ−1/M))` 이 82칸에서 음수의 제곱근이
됐다. `CG26` 만 3항 MAX 로 클램프해 두었고 나머지는 옛 수식 그대로다.

**기능적 영향은 없다** (2026-08-23 확인):

```
행 26·27 을 그리는 차트        없음
f_n 축(행 25)의 오류           0개   <- 14개 차트가 쓰는 행, 멀쩡
행 26·27 을 읽는 곳            CG25 하나 + 행 27 자기 자신뿐
```

격자 열마다 같은 값을 82번 반복 계산하는 칸들이고, 실제로 쓰이는 것은 `CG26` 하나다.

**공유 수식 마스터를 고치려다 파일이 깨졌다.** `<f t="shared" ref=... si=...>` 의 텍스트만
바꾸는 것은 XML 문법으로는 맞지만 Excel 이 거부한다 — 열 때 "내용에 문제가 있습니다" 가
뜨고 `sheet9.xml` 의 수식과 공유 수식을 통째로 제거하려 한다. `xlsx_patch.validate()` 도,
급히 만든 괄호·셀타입 검사도 이것을 잡지 못했다. **`BACKUP_5` 로 되돌려 복구했다.**

> **교훈: 공유 수식 마스터는 텍스트만 바꾸지 말 것.** 고쳐야 하면 공유를 풀어 각 칸을
> 독립 수식으로 쓰거나, 손대지 말 것. C.12 가 196셀에 성공한 것은 **항을 삽입**한 것이지
> 수식 구조를 바꾼 것이 아니었다.

#### E 는 적용하지 않았다 (철회 — 아래 참조) — 링크를 바꾸면 워크북이 깨진다

`RTC!C9` 를 `Design Spec!D81`(332.34 V)로 돌리면:

```
M_req = 2·n·V_o / (√2 · 332.34) = 0.6383
탱크의 무부하 게인 하한 = 1/(1+λ) = 0.6452        ->  M_req 가 그보다 낮다
RTC 행 26  fn.max = √(λ/(1+λ−1/M)) = √(0.55/−0.0167)  ->  #NUM!
RTC CG25  = 1.5·CG26                              ->  f_n 격자 전체가 죽는다
                                                  ->  RTC · 차트 23장 · CC · 설계
```

**에러가 아니라 물리다.** FB 코너에서 경부하면 어떤 주파수로도 게인을 그 아래로 못 낮추므로
버스트로 가야 하고, 격자는 그런 점을 표현할 수 없다. 고치려면 격자 범위를 `fn.max` 에서
떼어내는 설계 변경이 필요하다. **rev 0.7 의 과제로 남긴다.**

### 3.5 설계 가이드 자체의 오류

- **[70a]는 풀브리지 전용이다 — CT 설계에서 2.8배 과소평가.**
  [70a]의 첫 형태 `√(⟨I_sec,rms²⟩ − I_out²)`에 쓰는 `I_sec,rms`는 **출력 노드로 들어가는
  전류의 실효값**이어야 한다. 그런데 [64]는 N_rect=1(CT)에서 `I_sec,pk√(d/4)`, 즉 **권선
  하나의 실효값**을 준다. CT에서는 두 권선이 번갈아 도통하므로 노드 전류 실효값은
  `I_sec,pk√(d/2)`다.

  | 무엇을 넣느냐 | I_Cout,rms |
  | :--- | ---: |
  | [64]의 CT 값 28.3 A (권선당) | 10.8 A ← **틀림** |
  | 노드 실효값 40.0 A | **30.2 A** ← 맞음 |
  | [70]+2f_l 교차 검증 | 30.2 A ✓ |

  **2.79배.** 240 W 예제는 N_rect=2라 이 결함이 드러나지 않았다. **우리는 CT다.**
  [70]과 [70a]의 두 번째 형태는 원래 맞으므로 그쪽을 정본으로 삼는다.
- [125] [126] [130] [137]의 `G_o`·`EA_o`는 Hz가 아니라 **rad/s**
- [134] [135]는 **선정값** 기준

### 3.6 엑셀과 SMath의 **의도된** 차이 4건

같은 사양을 넣어도 다르게 나오는 곳이다. 전부 SMath가 보수적이다.

| 항목 | 엑셀 | SMath | 사유 |
| :--- | ---: | ---: | :--- |
| 홀드업 시작 전압 | V_out에서 시작 | **V_out − ΔV_pp/2** | 리플 골(θ=45°)에서 AC가 끊기는 것이 최악. 툴이 **13.2 % 낙관** |
| I_Cout,rms | 21.8 A | **30.2 A** | **C.18** — `CC!C31`의 수식은 옳다(노드 실효값을 제곱한다). 그 열이 θ=π/4 한 점인 것이 원인 |
| f_sw 최대 | 189.3 kHz | **249.6 kHz** | 툴은 264 Vac를, SMath는 FB morphing 경계(등가 332.3 Vac)를 본다 |
| ZVS T_ZC | 303 ns 한 점 | **457 ns 전 영역 최악** | 툴은 V_in,min·전부하 한 점, SMath는 [38a] 전 영역 스윕 |

추가로 C.12(f_px 누락, Φ_M 약 1° 낙관), C.13(f_l vs f_l,min), C.18(θ=π/4 근사)도 SMath 쪽이 맞다.

**전체 대조는 `xl_sm_compare.py` 가 자동으로 한다** — 사양·전력예산·탱크·전류·출력뱅크·
IC 정수·루프·보상망에 걸쳐 **101 항목**. 2026-08-23 기준 **일치 79 · 의도된 차이 22 ·
불일치 0**. 의도된 차이는 전부 행마다 사유가 붙어 있으므로, 새 세션이 같은 22건을 다시
조사할 필요가 없다.

---

## 4. T_idle — 증거는 250 ns 쪽이지만 **확정 아님**

DS Table 5의 `fosc` 행 **8개 값 전부**(RT/CT 4조합 × min/max 2열)를 역산했다.

| RT / CT | min 열에서 역산 | **max 열에서 역산** |
| :--- | ---: | ---: |
| 10 k / 330 p | 251.1 ns | **250.0 ns** |
| 20 k / 330 p | 249.3 ns | **249.9 ns** |
| 10 k / 560 p | 248.0 ns | **250.2 ns** |
| 20 k / 560 p | 241.6 ns | **250.1 ns** |

max 열은 `I_EA,max` 경로가 추가로 들어가는 **다른 식**인데도 4개가 **250.0 ns에 0.2 ns 이내로
일치**한다. 우연일 수 없다.

**판단:** 실리콘 값은 250 ns일 가능성이 높고, 시트 §5.3.2의 700 ns는 한 상수를 두 자리에 잘못 쓴
것으로 보인다. **확정은 실측으로만 한다.** 그때까지 마진 확인은 700 ns(가장 보수적)로,
성능 예측은 250 ns로 병기한다.

**왜 중요한가** — f_o 90.4 kHz, f_sw,max,op 249.6 kHz, C_T = 470 pF 기준:

| T_idle | R_T = 13 kΩ → f_Min / f_Max | R_T = 11 kΩ → f_Min / f_Max | f_Max 여유 |
| :--- | :--- | :--- | ---: |
| 250 ns | 78.6 k / 309.0 k | 92.3 k / **319.6 k** | **+28 %** |
| 350 ns | 77.4 k / 291.1 k | 90.6 k / 300.4 k | +20 % |
| **700 ns** | 73.4 k / 241.8 k | 85.2 k / **248.2 k** | **−0.6 %** |

- **T_idle = 700 ns라면 FB morphing 경계 전부하 운전이 VCO 상한에 걸린다.**
  회피책: f_r을 150 → 130 kHz 부근으로 내려 주파수 범위 전체를 스케일 다운
- R_T = 13 kΩ에서는 f_Min이 f_o보다 **낮아** 용량성 영역 진입을 클램프로 못 막고 ACP 보호에만
  의존하게 된다. **R_T = 11 kΩ**이면 f_Min/f_o = 1.02–1.04로 클램프가 f_o 위에 놓인다

---

## 5. 하드웨어 분석 기록

### 5.1 ST 평가보드 EVL6790_670W

**ST 자신도 OLED 레일을 단일단 LLC로 직접 만들지 않는다.** 마더보드 회로도의 부하 주석:
48 V 중간 버스를 만든 뒤 후단 벅 3개 —

- BUCK1 **24 V / 21 A = 504 W → OLED CNTR**
- BUCK2 20 V / 3 A = 60 W → SOUND CNTR
- BUCK3 12 V / 8 A = 96 W → T-con CNTR

우리 사양(25 V 직출력)은 그 후단 벅을 없애는 구성이며, 그 대가가 75 mF 출력 뱅크다.
**이것이 이 프로젝트의 가장 큰 아키텍처 판단이다.**

**도터보드 실장값** (`DAUGHTER BOARD_L6790_REV1`):
R4=13 k(RT) · C4=470 pF 1 %(CT) · R5=24 k(BM) · R6=31 k(CFG) · R2=150 k / R3=23 k(ZCD) ·
**R7=100 k N.M.**(LOUT2 풀다운 미실장 → morphing) · C2=100 nF(VCC).
주석 BMi=55 W · VBO=85 V · OVP1=52 V · OVP2=57 V. 가이드 부록 A와 전부 일치.

2차: TEA2096 + ISC079N15NM6(150 V, 7.9 mΩ) × 4 = **2채널 × 2병렬 센터탭 SR**.
입력: TEA2209T + ST8L65N044M9(44 mΩ) × 4 동기 브리지.
1차: STDRIVEG600 + ISG6123TA(GaN, TOLL) × 2.

> **미확정:** EVL 보드의 n = 3.2가 n인지 n_T인지. 마더보드 BOM에 별도 공진 인덕터가 보이지
> 않아 **누설 통합형(→ 3.2가 n_T)일 가능성**이 있으나, 그 경우 반사 전압이 125 V로 낮아져
> 설계 등가 입력이 177 Vac가 되어 가이드 부록 A의 217 Vac 해석과 충돌한다.
> **자료만으로 확정 불가 — 트랜스포머 실측(개방/단락 인덕턴스 + 턴수)으로 판정할 것.**

### 5.2 LGE 기존 2단 양산 보드

회로도의 벡터 경로에서 배선을 직접 추적하여 확정한 것.

| 항목 | 내용 |
| :--- | :--- |
| 구성 | UCC256403 하프브리지 LLC (Q151/Q152 = TK190U65Z 650 V) + TEA2095 센터탭 SR (TPH3R70APL1 × 4) |
| 출력 | **25 V (25VD)** — 우리 사양과 동일 |
| 트랜스포머 | **26OP-LM83W × 3개, 1차 직렬** (핀2→핀1 배선). **2차 결선은 직렬이다** — 시트 §5.2a |
| 권선 | N_p = 5 T (리츠 0.04 × 360), N_s = 1 + 1 T (**동판 0.5 × 4.5 mm**) → 합계 N_p = 15 |
| 인덕턴스 | 개방 53 µH · 단락 14 µH (개당) → 직렬 합계 159 / 42 µH → **λ = 0.359 (m = 3.79)** |
| 코어 | EE6405 (64 × 33.5 × 8 mm 편평형), **A_e = 113.1 mm²**, l_e = 57.13 mm, V_e = 6461 mm³, GP98 |
| 공진 커패시터 | 0.01 µF/630 V 2직렬 × 5병렬(1열 미실장) = **25 nF** |
| 제조 | KH필룩스, P/N EBJ30067801 |

**이 프로젝트에 직접 쓰이는 결론 3가지:**

1. **자기부품 구조를 그대로 가져올 수 있다.** 25 V/26 A에서 2차를 1턴 동판으로 감고 여러 개를
   병렬하는 것이 검증된 해법이다. 1차 직렬이므로 전류 분배가 자동으로 맞는다.
2. **기존 설계의 λ = 0.359는 이미 단일단 영역에 가깝다.** 통상 2단 LLC는 λ = 0.1–0.2인데 이
   보드는 m = 3.79다. **같은 코어·보빈 플랫폼에서 갭만 키우면 단일단이 요구하는 λ ≈ 0.55에
   도달**한다.
3. **N_s만 1 → 2턴으로 바꾸면 권선비가 정확히 맞는다.** N_p = 5 × 3직렬 = 15, N_s = 2 →
   n_T = 7.5 → n = 6.04 (필요값 6.046).

> **위 3가지는 그대로 유효하다.** 아래 시트 §5.2a 의 정정은 *기존 보드의 동작점*에 대한 것이고,
> 우리가 물려받는 것은 *기계 플랫폼*이므로 영향받지 않는다.

### 5.2a 2026-08-28 정정 — 버스는 400 V 이고, 2차는 병렬이 아니다

**사용자가 "버스가 400 V 아니냐"고 물어서 사양서 원본으로 되돌아갔고, 두 가지가 틀려 있었다.**

**① 버스 전압.** 나는 "보드가 M ≈ 1 에서 돈다"고 가정하고 권선비에서 640 V 를 역산했다.
**틀린 것은 버스가 아니라 그 가정이다** — 1차 스위치가 **TK190U65Z(650 V)** 이므로 640 V
버스는 성립할 수 없다. 유니버설 입력 부스트 PFC 의 출력은 **400 V** 다. 이 근거(소자 내압)는
처음부터 내 손에 있었고 쓰지 않았다.

**② 2차 결선.** "핀4+5 CT 공통 버스" 를 3개 병렬의 증거로 읽었는데, 승인원 6쪽 권선표는

| No. | 단자 | 전선 | 턴수 |
| :-- | :--- | :--- | :--- |
| NP1 | 1 → 2 | MIW-F(LZ) 0.04Φ × 360 (리츠) | 5 Ts |
| NS2 | 3 → 5 | Cu plate 0.5T × 4.5W | 1 Ts |
| NS3 | 4 → 6 | Cu plate 0.5T × 4.5W | 1 Ts |

로, **한 유닛 안에 1턴 2차가 두 개** 있다. 핀 4·5 를 잇는 것은 그 유닛 자신의 센터탭일
뿐이고 유닛 간 병렬의 증거가 아니다.

**포화가 결선을 정한다.** 1차 직렬이므로 유닛 하나가 받는 전압은 `n_T·V_o,eff/3` 이고,
공진 아래에서 도통 구간은 `T_r/2` 로 고정된다:

| 2차 결선 | n_T | n | **B_pk** | 400 V 에서 요구 M |
| :--- | ---: | ---: | ---: | ---: |
| 병렬 (N_s,eff = 1) | 15.0 | 12.87 | **356 mT** | 1.608 |
| **직렬 (N_s,eff = 3)** | 5.0 | 4.29 | **119 mT** | 0.536 |

페라이트는 100 °C 에서 약 390 mT 에 포화하므로 356 mT 는 여유가 9 % 뿐이고, 더 결정적으로 **코어손이 대략 B^2.5 로 가므로 356 대 119 mT 는 손실이 약 16배**다. 평면 TV 트랜스포머에서 성립할 수 없다. 따라서 2차는
직렬이고, 3개는 사실상 **하나의 15 : 3 트랜스포머**로 동작한다 — 평면 TV 높이 때문에 코어를
셋으로 쪼갠 것이다.

**아직 안 닫힌다.** n_T = 5 로 보면 400 V 에서 요구 게인이 **0.536** 인데, 이 탱크의
Q→0 최저 게인이 `1/(1+λ)` = 0.736 이라 상당한 Q 와 f_sw ≫ f_r 이 필요하다. 그런데
Z_0 = 41 Ω(C_r = 25 nF 가정) 에 25 V 출력이면 **부하 Q 가 1 을 넘는다**(600 W 에서 2.6).
정상적인 LLC 설계 영역이 아니다. **내가 회로도에서 읽은 C_r = 25 nF 가 틀렸거나, 그 레일의
전력이 내 짐작보다 훨씬 작거나 둘 중 하나다.** 더 추측하지 않는다 —
**PFC단 도면 또는 공진 커패시터 실측이 있으면 닫힌다.**

> **▷ 이것이 우리 설계를 막지 않는다.** 우리는 기존 보드의 동작점을 물려받지 않는다.
> 물려받는 것은 코어(EE6405, A_e 113.1 mm²) · 보빈 · 3분할 구조 · 리츠 1차 · 동판 2차 ·
> 벤더 · 절연 시스템이고, 우리 권선비는 우리 요구에서 나온다.

### 5.2b 2026-10-17 정정 — 유닛 하나에 EE6405 두 세트, 창 높이 1.4 mm

**사용자가 "LG 트랜스포머와 같은 코어는 안 되나" 고 물어 승인원(`LGE Material/기존 PFC + LLC 트랜스포머 사양서.pdf`)을 다시 읽었고, §5.2 의 코어 행은 반쪽만 맞았다.**

- **두 세트다.** 보빈 도면(18쪽): 중앙 구멍 8.50 × 68.00 mm — 코어 깊이 C 33.5 의 두 배. 권선부 길이 68.00 · 몸체 60.00 × 103.10 · 단자 포함 131.60, 완성품 143.9 × 67 × 4.8 mm(5쪽). 본딩 사양(12쪽) "Side Bonding Apply Area 3216 mm²" = 2 세트 × 2 창 × 24 × 33.5. 1차 DCR 55 mΩ max(7쪽)도 두 센터 다리를 함께 감는 MLT ≈ 170 mm 에 어긋나지 않는다(0.45 mm² × 5 T → 32 mΩ@20 °C).
- **따라서 유닛의 유효 단면은 2 × 113.1 = 226 mm²** 다. §5.2 의 "A_e 113.1" 은 세트 하나 값이고, 이를 유닛 값으로 쓴 §5.2a 의 B_pk 표(356 / 119 mT)는 **178 / 60 mT** 로 고쳐 읽어야 한다 — 2차 직렬이라는 결론은 권선표 · 핀 결선에서 나온 것이라 그대로다. 빌더 기본값 `A.e_mm` 113.1 도 같은 출처(세트 하나)다 — 정본은 PQ 50/50 의 332 를 쓰므로 영향 없음.
- **창 높이.** 코어 표(17쪽) A 64 · B 2.30 · C 33.5 · D 8.0 · E 56 · F 0.70 · B−F 1.60. 요크 1.6 · 다리 0.7 로 읽으면 IEC 60205 식 A_e 108 mm²(센터 다리 268 이 아니라 요크 2 × 1.6 × 33.5 = 107 이 병목), 반대로 읽으면 48 — 벤더의 113.1 은 앞쪽이다. 옆면도(두꺼운 판에 낮은 돌기)와 보빈 권선부 두께 1.30 ± 0.1 도 같은 쪽. → **창 한쪽 24 × 1.4 mm, 깊이 2 × 33.5**. 이것이 LG 2차가 0.5 mm 동판 1 T 두 장(겹쳐 1.0 mm)이고 1차가 ø1.1 리츠 한 층인 이유다.
- 세트 하나의 A_L: 개방 53 µH / 25 T² = 2.12 µH 가 두 세트의 합이므로 세트당 1.06 µH → 공극 ≈ 0.11 mm(µ_i 2300–3000 가정) — "TOP GAP" 표기와 맞는다(한 세트로 보면 0.044 mm 라 갭 코어라 하기 어렵다).
- **외형도로 다시 확인(2026-10-18, 사용자 "코어는 원래 두 개로 조립하는데 두 개란 게 무슨 뜻이냐")** — "두 세트" 는 반쪽 둘(E + E)로 된 한 쌍이 **두 쌍, 반쪽 네 개**라는 뜻이다. 5쪽 외형도를 600 dpi 로 래스터해 재면, 도면 자신의 143.9 mm 치수를 자로 쓸 때 코어 영역이 **66.9 mm**(= 2 × 33.5)이고, 윗면도 · 밑면도 둘 다 **정확히 가운데(33.5 / 33.5 mm)에 이음선**이 있다. 윗면도에는 테이프 띠 둘(각 약 19.4 mm)이 **각 쌍의 중심(16.8 · 50.1 mm, 쌍 중심 16.7 · 50.2 mm)에 하나씩** 감겨 있다 — 코어 고정 테이프가 쌍마다 따로다. 보빈 중앙 구멍 8.50 × 68.00 mm 와도 맞는다. 즉 표준 EE6405 두 쌍을 깊이 방향으로 맞붙여 센터 다리 8 × 67 mm 를 만들고, 권선은 그 둘을 함께 감는다(높이는 그대로, A_e 만 두 배). 19쪽 QC 공정도는 **다른 모델(24OP-LM77G, EBJ64475002, 코어 "2ea")의 표를 옮겨 놓은 것**이라 이 부품의 수량 근거가 못 된다 — 이 사양서 어디에도 26OP-LM83W 의 코어 수량은 숫자로 적혀 있지 않다. **구성도**: `docs/LG_26OP-LM83W_core_construction.png` · `.pdf`(`lg_core_figure.py`) — 한 쌍 · 두 쌍 분해도, 윗면도(축척), 폭 방향 단면(보빈 레일 · 2차 동판 · 칸막이 · 1차 · 안쪽 벽 순, 18쪽 치수 82.5 / 97.1 / 103.1 이 각각 U 반지름 7.25 / 14.55 / 17.55 와 맞는다), 길이 방향 단면.
- **결과(`docs/THREE_CORE_BOARD.md` "세 번째 안" 의 같은 날 문단)**: 같은 코어 두 세트면 A_e 226 으로 변형 `7p5to1_x3m3` 의 자속 조건(72 mT)은 맞지만, 창 1.4 mm 에 2+2 T 2차와 11 A 1차가 들어가지 않는다.

### 5.3 참고 논문이 가이드 §2.2를 독립 증명한다

ECCE (Wenbo Liu et al., 1.65 kW 단일단 LLC OBC) 식 (14): `sin²θ ≤ sinθ`이므로
**G_req(θ) = G_req,pk/sinθ ≤ G_req,pk/sin²θ = M_fr2(θ)**. 즉 라인 피크·전부하에서 게인을
만족시키면 **모든 위상에서 자동으로 만족**한다. 가이드 §2.2 "두 발산의 상쇄"와 같은 결론.

논문의 λ = L_r/L_m = 8.5/21 = **0.405**로, "λ ≈ 0.5가 단일단의 지문"을 외부 설계가 독립적으로
뒷받침한다. Infineon AN 2013-03도 "m > 5는 게인 부족"이라 적는다.

---

## 6. 사고 기록 — 같은 실수를 반복하지 않기 위해

### 6.1 xlsx가 열리면서 "복구했습니다" 대화상자를 띄웠다 (2026-08-21)

Excel이 *"제거된 레코드: /xl/worksheets/sheet8.xml 부분의 셀 정보"* 로 복구했다.
**셀을 "추가"하다가 깨뜨렸다. 원인 3가지 — 전부 규칙 위반이다:**

1. **한 `<row>` 안에 같은 `r=` 셀이 두 번 있으면 안 된다.** `G18`이 이미
   `=IF(E18,"","Power Components")`로 존재하는데 뒤에 `G18`을 또 붙였다.
2. **`<row>` 안의 셀은 열 번호 오름차순이어야 한다.** 새 `H` 셀을 행 끝(= `I`, `W` 뒤)에 붙였다.
3. **수식을 추가/삭제하면 `xl/calcChain.xml`이 낡는다.**

**그래서 만든 것: `Design Guide/generators/xlsx_patch.py`의 `set_cell()`** — 있으면 교체, 없으면 올바른 위치에 삽입하고 `spans`를 다시
계산한다. 그리고 **쓰기 전에 전 시트를 훑어 "행 안의 셀이 중복 없이 오름차순인가"를 검사**한다.
이 검사를 통과 못 하면 설치하지 않는다.

**부수 교훈:** `BOM&Schematics`의 **G열은 비어 있지 않다.** 모든 행이
`=IF(E.., "", "<출처 시트>")` 힌트를 갖고 있으므로 남의 열을 뺏지 말 것.
그리고 **H·I열은 "Power Part Schematics" 그림이 I열에 앵커되어 있어 그림 밑에 깔린다.**
결국 커패시터 뱅크는 표 안쪽(C~F)에 **행으로** 넣었다 — 빈 행 22를 써서 행 삽입 없이.

### 6.2 PDF에서 글자가 겹치는데 검사기는 "겹침 0"이라고 했다

검사기가 **선언된 크기**만 봤기 때문이다. 세 단계로 고쳤다.

1. **리전 높이를 "슬래시 개수"로 추정하고 있었다** (`28 + 20*src.count('/')`). SMath는 수식을
   2차원 트리로 배치하므로 분수는 쌓이고 근호는 막대 한 줄, 지수는 위첨자 한 줄이 붙는다.
   → `smsheet.py`의 `_rh()`/`_rwid()`가 트리를 재귀로 재고 `est_box()`가 픽셀을 돌려준다.
2. **텍스트 줄바꿈을 SMath에 맡기고 있었다.** TextRegion은 폭에 안 맞는 `<p>`를 **말없이 다시
   줄바꿈**하고, 늘어난 줄이 선언 높이 밖으로 나가 다음 리전 위에 찍힌다.
   → `_wrap()`이 미리 줄을 나눈다. 관건은 글자폭 상수: PDF 실측 **폭 1100 px · fontSize 9에
   약 208자** → 0.58 × 폭/글꼴크기. `CH_PER_PX = 0.67`로 잡아 15 % 여유를 뒀다.
   `check_sm.py`가 0.60 기준으로 모든 `<p>`를 다시 재어 "재줄바꿈이 일어날 것"을 미리 잡는다.
   **회귀 시험으로 확인함** — 0.52로 되돌려 빌드하면 정확히 겹쳤던 문단들을 집어낸다.
3. **텍스트 리전 높이를 추정하고 있었다.** SMath가 직접 저장한 워크시트에서 실측:

   | fontSize | 1줄 | 2줄 | 3줄 | 4줄 |
   | ---: | ---: | ---: | ---: | ---: |
   | 8 | 20 | 47 | | |
   | 9 | 21 | 49 | 77 | 105 |
   | 10 | 23 | | | |
   | 12 | 26 | | | |
   | 15 | 30 | | | |

   → **첫 줄 ≈ 1.4·size + 8.7, 이후 한 줄당 ≈ size + 19.** 종전 `n·(size+4)+6`은
   fontSize 9·3줄에서 **45 px vs 실제 77 px** — 시트 §18 표가 겹친 원인이 정확히 이것이다.

**결정적 사실:** SMath는 저장할 때 텍스트 리전을 **내용 크기로 다시 맞춘다.** 그래서 두 줄짜리
라벨은 선언 높이보다 커지고 그대로 다음 행 위에 얹힌다. → **좌측 라벨은 무조건 한 줄**로 만들고,
두 줄이 되려 하면 **빌드를 실패시킨다**(`_label(nowrap=True)`). 추정으로 버티지 말고 실패 모드를
없애는 쪽이 맞다.

### 6.3 보드선도의 위상 곡선이 통째로 안 보였다

**그래프에는 로그 축이 없을 뿐 아니라 자동 스케일도 없다.** `<plot>`의 `scale_*`/`transpose_*`가
창을 고정하는데, **그 창 밖의 데이터는 빈 그래프로 보인다.** 위상 곡선(−130 ~ −222°)이
−64부터 시작하는 창 밖에 있었다. 캘리브레이션 결과:

- **격자 한 칸 = 20 px, `scale_*` = 칸당 단위수** → `px/단위 = 20/scale`
- **`transpose_*` = −(창 중심 × px/단위)** [px]
- `smsheet.py`의 `Sheet.plot_view(w, h, x0, x1, y0, y1)`가 이 계산을 해 준다

부수 조치: 위상 대신 **위상 여유(180 + arg T)**를 그린다. 0–50° 안에 들어와 바로 읽힌다.

### 6.4 SMath 파일이 아예 안 열렸다 (NullReferenceException)

*"개체 참조가 개체의 인스턴스로 설정되지 않았습니다"* — 원인 2가지:

1. **리전은 `<regions type="content">` 안에 넣어야 한다.** `<worksheet>` 바로 아래에 두면 실패.
2. **`<dependencies>`에 사용한 리전 타입의 어셈블리를 전부 선언해야 한다** —
   `SMath Core` 외에 `MathRegion`, `TextRegion`, `PictureRegion`, `SpecialFunctions`,
   그래프를 쓰면 `PlotRegion`, 접기를 쓰면 `AreaRegion`.

정확한 GUID는 `Reference/EVLHV101SSR50W Design Guide.sm`에서 복사한다.

### 6.5 BOM 대조 스크립트가 24항목 불일치를 냈다 (2026-08-21)

**틀린 쪽은 스크립트였다.** SMath의 `<result>`는 이미 **표시 단위(contract)** 값인데 SI로
착각해 한 번 더 나눴다. 설계값은 처음부터 같았다.
→ `bom_compare.py`가 `<contract>`를 읽어 환산하도록 고쳤다. 교훈: **대조 도구 자신도 검증
대상이다.** 전부 다르게 나오면 도구를 먼저 의심할 것.

---

### 6.6 `<result>` 도 RPN 이다 — 첫 토큰만 읽으면 부호와 지수가 사라진다

**2026-08-24.** `snapshot.py` · `xl_sm_compare.py` · `bom_compare.py` · `audit_rpn.py`
넷이 전부 `float(list(res)[0].text)` 로 결과를 읽고 있었다. **넷이 같은 가정을 독립적으로
했으므로 아무도 서로를 잡아주지 못했다.**

`<result>` 는 값 하나가 아니라 **RPN 식**이다:

```
<e>22.26</e><e args="1">-</e>                        -> -22.26   (22.26 로 읽힘)
<e>3.87</e><e>10</e><e>15</e><e args="1">-</e>
   <e args="2">^</e><e args="2">*</e><e args="1">-</e>  -> -3.87e-15  (3.87 로 읽힘)
<e style="unit">nF</e><e>92.21</e>                   -> 92.21 (단위가 먼저, 곱셈 생략)
```

**발견 경위.** `n.SR` 을 1 로 바꾸고 사용자가 엑셀을 재계산한 뒤 `xl_sm_compare` 가
`Power Components!D37`(필요 세라믹 용량)에서 **엑셀 0 · SMath 3.87 µF** 불일치를 냈다.
파고 보니 **양쪽 다 맞았다** — `C.cer_min = MAX(C.cer_raw, 0)` 이고 `C.cer_raw` 는
**−64.14 µF**(ESR 만으로 이미 30 mV 예산을 지키므로 세라믹이 불필요)라 시트는
−3.87e-15 µF, 즉 0 으로 클램프하고 있었다. **틀린 것은 내 리더였다.**

전체 결과 525개 중 **토큰이 2개 이상인 것이 53개**다 — 부호가 날아가던 것 16개
(Cardano 중간값 `a2.*` `p.*` `r.b`, 보드선도 스칼라 `Ta.4` `Ta.5` `Ma.5`, `C.cer_raw`),
지수까지 날아가던 것 1개(`C.cer_min`), 나머지는 단위 토큰이라 수치에는 무해했다.

`smresult.py` 로 평가기를 하나만 두고 넷 다 거기에 연결했다.

> **▷ 고치다 두 번 더 틀렸다.** ① `audit_rpn` 에서 `val` 을 재사용해 **독립 평가값을
> 덮어썼다** — 인쇄값끼리 비교하게 되어 81건이 거짓 불일치로 떴다. ② 단위가 앞에 오고
> 곱셈이 생략된 형태를 스택 잔여 2개로 보고 `None` 을 냈다. **둘 다 도구가 즉시 소리를 내서
> 잡혔다** — 검사기가 있다는 것의 값어치가 이것이다.
>
> **▷ 비교기에 절대 허용치도 넣었다.** 정답이 0 일 때 상대오차는 발산한다.
> `1e-15` SI 미만이면 같은 값으로 본다 — 두 문서에서 가장 작은 실제 물리량이
> 100 pF 기생용량(1e-10 F)이므로 안전하다.

## 7. 구 산출물과 그 제작 규약

### 7.1 rev 1.1 시대의 산출물

| 파일 | 상태 |
| :--- | :--- |
| `AN_L6790A_Design_Guide_rev2_0.md` + `figures/` | **현행 — rev 2.0 (2026-09-11).** 예제는 9:1 정본 설계점. 240 W 는 부록 C.5·C.30·C.31 에만 남는다 |
| `Smath/L6790A_Section3_PowerStage_Tank_rev1_1.sm` | **2026-08-23 현재 폴더에 없다.** 구 시트(240 W 예제, 시트 §3.1–3.13). 진단 프로브는 현행 `L6790A_probe.sm`이 대체한다. build_sm.py 가 있었으나 옛 `fig/` 그림 세트가 없어 그대로는 재생성되지 않았고, 그 빌더는 2026-09-22 에 삭제했다 |
| `L6790A_Section3_Calculation_Sheet_1page.sm` | **프로젝트 폴더에 없음.** A1 세로 1페이지 4단 판이었다 |
| `Training Material/…Training.pptx` | 영문 **61장**, 25 V 예제로 교체 완료. 한국어판이 남았다 |

### 7.2 PPT 제작 규약 (Phase 7에서 필요)

- 테마: navy `03234B` / yellow `FFD200` / magenta `E6007E` / cyan `3CB4E6`, 폰트 Arial
- ST 로고: `ST_Template__16-9_.potx` → `ppt/media/image1.png`
- 수식: matplotlib mathtext → PNG(26 pt, dpi 260), 슬라이드에는 **15 pt 크기로 자연 배치**
  (`inches = px × (15/26)/260`). 박스 폭에 늘려 채우면 30 pt가 되어 너무 커진다
- `\dfrac` · `\left\{` · `\begin{array}` 미지원. `\frac`과 단순 나열로
- 그림: pymupdf 200 dpi 래스터화 → 넉넉히 크롭 → **잉크 경계로 자동 트림**(recrop2.py — 2026-09-22 삭제).
  좌표로 직접 자르면 캡션이 잘린다
- pptxgenjs: `LAYOUT_16x9` = **10 × 5.625 in**. 색상에 `#` 금지
- **기하 검사기 필수**: python-pptx로 전 도형 좌표를 훑어 `y+h > 5.26 in` 위반을 자동 검출.
  눈으로 51장을 보는 것보다 훨씬 빠르고 정확하다
- 변수명: 유니코드 아래첨자가 있으면 진짜 아래첨자(Lᵣ Cᵣ fₒ Z₀ Vₒᵤₜ), 없으면 언더바 제거

### 7.3 구 워크북 수정 방식 (지금은 쓰지 않음)

rev 0.6까지는 `shutil.copy` → openpyxl 수정 + `Comment` → `recalc.py <file> 600` 방식이었다.
**차트 30개 때문에 지금은 XML 직접 편집만 쓴다** (`CLAUDE.md` 시트 §6.2).
정상 상태의 잔여 오류는 **54건**이며 전부 RTC 행 29의 의도적 `NA()` 차트 마스킹이다
(rev 1.1 기록의 "53건"은 하나 적게 센 것 — 2026-08-23 전수 확인).
CHANGELOG의 텍스트 셀은 `cell.data_type='s'`를 명시해야 `=`로 시작하는 문자열이 수식이 되지 않는다.

---

## 8. 타임라인 — 수정 이력

**설계값이 바뀌면 여기에 한 줄 적는다.** 무엇을 왜 바꿨고 그래서 무엇이 나빠지거나
좋아졌는지. 발견·사고·결정도 같이 담는다 — 이 프로젝트에서 시간순으로 남는 기록은
이 표 하나뿐이다.

`snapshot.py`를 돌리면 지난번 대비 움직인 값을 전부 찍어 주므로, 그것을 보고 여기에
요약해 적으면 된다. **스크립트가 이 파일에 직접 쓰지는 않는다** — 근거 문서를 기계가
건드리게 두지 않기 위해서다.

| 날짜 | 한 일 |
| :--- | :--- |
| 2026-09-22 | **(21차) 설계 예제를 단일 트랜스포머로 — ETD 49/25/16DG 채택** (사용자 확정 "진행해줘"). **시트 변형 `7p5to1_x1`** (`build_l6790_smath.VARIANTS`: `N.x` 1 · `N.p` 15 · `N.s` 2 · `n.aux` 1.5 → `N.aux` 3 · **`Ae` 211**, 이제 `A.e_mm` 은 변형 파라미터고 기본은 113.1) — `mismatches: 0`. `an_pdf.AN_VARIANT` 기본을 이것으로. **코어 판정은 `cores.py` 한 곳에서**: `CHOSEN` = ETD 49/25/16DG, `BOBBINS`(ETD 49 20핀 · PQ 40/40 12핀 기하와 배정), `winding()` 이 **포일을 `W_FOIL_MAX` 12 mm 초과 시 병렬 스트립으로 나누고 1차 층수를 반경 창 안에서 고른다**(전에는 단일 코어 입력에서 퇴화했다). 네 후보 결과 — PQ 40/40 분리 간격 −8.1 · PQ 50/50DG −19.7 · **ETD 49 +6.35(1차 3층 5+5+5, 반경 7.11/8.40)** · ETD 54 +3.34(2층). **핀 배정(20핀, 두 줄 × 10):** NP1 1+2 – 4+5 · NAUX 8 – 10(앞줄) · NS2 11+12 – 14+15 · NS3 16+17 – 19+20(뒷줄) · **탭 = 14·15·16·17 PCB 결합** · 빈 핀 3·6·7·9·13·18. **2차 단자는 핀 2개씩** — 권선 하나가 28 A rms 를 흘리는데 □0.8 핀 하나로는 부족하다(벤더가 핀 정격 확인 또는 러그). **ETD 49 도면에는 핀 번호도 핀 1 표시도 없다** — 한 줄 따라 세고 반대 줄로 돌아오는 관례를 가정으로 적었다(PQ 50/50DG 도면은 그렇게 찍혀 있다). **AN:** 7.4 `n.T` 줄 "15 : 2" 단독 · 7.8 도입(한 부품, 3유닛은 6장의 대안으로만) · `trafo-built` 표 3열 · 핀 문단·그림·표(`pins`)·**극성 문단**(3유닛 결선 문단 삭제) · **7.9 후보 4종 표**(A.e·B.pk·A.N·권선폭·반경·1차 층/축/반경·분리 간격·l.N·질량·판정) + 노트 2개(**창 깊이가 결정**, **누설은 벤더가 배치로 맞춘다** — N² 라 3배) · `legend42`·`winding`·사양표(코어 행 신설) 단일화. **그림:** `an_core_section` 이 `cores.CHOSEN` 을 그린다(ETD 49 단면 48.5 × 49.8, 3층 1차, 포일 12층, 판 크기·배율 S2 7.7·S3 2.4 재조정, 포일 패널은 NS2 6층만) · `an_xfmr_pins` 오른쪽 패널을 `BOBBINS[CHOSEN]['plan']` 으로 일반화(ETD 는 두 줄, PQ 는 두 열) · `an_xfmr_read` 라벨 "one unit/per unit" 을 `nser` 로 분기. `figcheck` 3장 tiny 만. **사양서:** `build_trans_spec` 이 `N.x` 로 보빈을 고른다(1 → `CHOSEN`, 아니면 PQ 40/40) — **한 번 이 분기 없이 돌려 3코어 사양서 셋에 ETD 핀이 들어갔다가 바로 잡았다**. 5종 재생성, `check_trans_spec` 불일치 0. **손실·온도는 실측 항목** — 러프 추정 동손 3.4 + 철손 3.7 ≈ 7 W(철손은 ETD 54 데이터시트의 N87 값을 환산, ±50 %). 영문 82쪽 · 식 49 · 그림 42 · 표 29, `an_check` 통과. 한국어판 미반영. |
| 2026-09-22 | **(22차) 7.8·7.9 를 설계만 남기고 정리** (사용자: "table 11 은 필요없는 내용 … 단면도만 봐서는 2차측을 어떻게 권선하라는건지 모르겠어 … 2, 3 strips 가 무슨 말이야 … enlarged 7x 는 뭔데 … 이유를 덧붙이고 덧붙이고 너무 복잡해"). **뺀 것:** 7.9 의 후보 코어 4종 비교표(구 Table 11)와 설명 상자 2개(창 깊이 · 누설 N² 배율) — 후보 비교의 근거는 이 표(21차 행)에만 남는다. 7.8 도입·핀 문단·극성 문단·자속/자화/포화 문단·`an_mmf` 캡션을 사실만 남기고 절반 이하로 줄였다. 절 이름 `Choosing the core, and building the winding on it` → **`The core and the winding`**. **그림 40 (`an_core_section`) 다시 그림:** 권선 색을 핀 그림(Figure 38)과 같게 — NP1 자홍 · NS2 초록 · NS3 하늘 — 단면·전개 패널에서 12층 포일이 아래 6층 NS2 · 위 6층 NS3 로 갈린다(전에는 전부 빨강 한 덩어리). 셋째 패널을 **"the secondary, layer by layer (not to scale)"** 로 교체 — 보빈 위로 NS2 turn 1·2, NS3 turn 1·2 를 층마다 그리고 권선별 괄호에 핀(11+12 – 14+15 / 16+17 – 19+20), "one turn = 3 foils 0.20 × 10.5 mm, wound together, connected in parallel", 절연 0.05 mm, 반경 3.0 mm. **배율 표기("enlarged 2.2×/7×")와 "strips" 라는 말을 전부 없앴다** — 포일은 "3 foils in parallel". 범례 번호 1~7 로 재배열(1 NP1 · 2 NS2 · 3 NS3 · 4 분리 · 5 마진 테이프 · 6 중앙다리 갭 · 7 창). `figcheck` tiny 만(쪽 배율 0.70, 기존). 영문 **81쪽 · 표 28**, `an_check` 통과. 한국어판 미반영. |
| 2026-09-22 | **(23차) 보상망을 수식과 함께 · 그림 40 확대 · 전수 낭독 검토** (사용자 3건: 그림 40 15 % 확대 · 전 문장/파형/그래프/회로도 재검토와 비원어민 영어 · Feedback compensation 이 계산 과정 없이 덩그러니 나온다, onsemi TND381 수준의 설명). **6장:** 6.26 을 절 8개로 — 루프 블록도 신설(`an_loop_blocks`, 보상기/플랜트 괄호) · 플랜트가 적분기인 이유와 `G.o` 식 · **목표와 어긋났을 때 표**(`loop-aims`: 교차·위상 여유·이득 여유·`G.EA(2f.l)` 각각 너무 낮으면/높으면 — TND381 의 76°/45°/Q 대응, CTR 2:1 산포) · 2f.l 리플이 3차 고조파가 되는 식(`D.3 = G.EA ΔV/(4 V.FB)`, 4 의 출처: 진폭 절반 × 변조 m/2) · TL431·옵토·FB 핀 회로의 동작 서술과 전달함수(`EA.o`·f.z·f.p·f.px), fast lane 없음, `R.B` 창의 뜻, CTR 두 값 · K-factor 배치와 부품 식 · **solver 없는 검사**(|T|·arg T 닫힌형, 교차 고정점 반복, 위상 여유) · 이득 여유 · 버스트 리플(`ΔR.BM` 식). 식 49 → 64. **7.13 을 13단계 대입 산수로**(분압 → 플랜트 → 2f.l 허용 이득 → K.v → EA.o → f.MB/f.p/f.z → 바이어스 R.P·R.B 창 → 부품 4개 → 실제 구현값 → 교차·위상 여유(atan 세 항) → 이득 여유 → 실제 3차 고조파 → 버스트 리플·R.BM). 시트 상수(V.Fo·R.FB·I.FB·CTR.m·C.opto·f.pHF·Φ.M·α.v·D.3rd·I.min·GM.t)는 **`an_pdf._builder_const()` 가 빌더의 `S.const` 줄에서 읽는다** — 손으로 다시 적지 않는다. `an_loop_bode` 에 f.180/이득 여유 표시. **그림 40:** figsize 를 1/1.15 로, mm/inch 배율을 1.15 로 — 같은 쪽 폭에서 코어·권선·글자가 15 % 커진다. `fig(shrink=False)` 신설(MINFIT 1.0) — 쪽에 안 맞으면 줄이지 않고 다음 쪽으로. **낭독 검토(89쪽 전부):** 수치·수식 오류 0 · 몽타주 15장 겹침 0 · 문장 6곳 평이하게(`Why resonance buys anything` → `What resonance is for` 등) · **표지 '그림 일부는 타사 AN 에서' 문장이 낡아 있었다**(9-20 이후 전부 자작) → 고침 · 'PF LLC' 명칭 1곳 · 3.3/2.16 의 절 참조를 리플 절로 · 기호표에 루프 기호 10줄 · 참고문헌에 TND381. mathtext 에 `\le`·`\text` 가 없어 `\leq`·`\mathrm` 으로. 영문 **90쪽 · 식 64 · 그림 43 · 표 28**, `an_check` 통과. 한국어판 미반영. |
| 2026-09-25 | **(61차) OVP2 와 I_sat 의 관계를 식으로.** 사용자: "OVP2 와 Isat 이 왜 관계가 있는지 상세한 설명 … 수학적 수식도 붙여서." 영문판 6.19 "Why the ceiling is OVP2" 를 유도로 바꿨다: 같은 피크 자속을 2차 볼트-초(식 24)와 자화 전류(식 32)로 두 번 쓰면 A_e 가 약분되어 **식 33 (신설) i_μ,pk = n_T V_o,eff / (4 f_r L_μ)** — 부하·입력·(below 에서의) f_sw 가 하나도 안 남고 출력 전압에만 비례. → 코어가 구동되는 동안의 최고 출력은 V_OVP2(OVP1 은 전력만 줄이고 스위칭 계속, OVP2 는 100 ms 정지) → 벤치에서는 다른 권선이 Open 이라 I_dc 가 유일한 암페어턴이고 B = L_μ I_dc/(N_p A_e) 로 같은 관계 → I_sat = I_eq V_OVP2/V_o,eff(식 34). V_f ≠ 0 이면 실제 자속비는 (V_OVP2 + N_rect V_f)/V_o,eff 로 조금 작아 식 34 가 안전 쪽이라는 한 줄. 7.12 에 검산 한 줄: 7.50 × 25.0 V / (4 × 151.75 kHz × 24.90 µH) = **12.41 A** = I_eq(코어 데이터 없이). 식 번호가 하나씩 밀림(참조는 이름이라 자동). 한국어판은 60차 재구성과 함께 영문판 확인 뒤 이식. |
| 2026-09-25 | **(62차) 영문판 AN 전수조사 + 수식 굵기 +10 %.** 사용자: "1. 설명/수식 오류 2. 파형/그래프/회로도 오류 3. 가독성 4. 용어 테이블 누락 5. 수식 폰트 굵기 딱 10%만 증가." **수식 103개** 전부 유도로 대조 — 오류 둘: 식 100 V_BM,eq 의 단위(0.01 V/kΩ 로 적음), **식 34 I_sat = I_eq V_OVP2/V_o,eff** → **V_OVP2/V_out**. 정확한 자속비는 (V_OVP2+N_rect V_f)/(V_out+N_rect V_f) 이고 그 이상인 것은 V_OVP2/V_out 뿐 — 61차 식은 V_f > 0 이면 정확한 비보다 **작은** 유일한 비였고 바로 아래 "안전 쪽" 문장과 모순. 시트 `k.OVsat` 도 V.OVP2_act/V.o_eff → V.OVP2_act/V.out(빌더, 5벌 재빌드 · mismatches 0; SR 이라 V.rect = 0, 값 1.2246 그대로), `DESIGN.md` §4 13 동기. 7.12 검산 줄은 식 33 의 기호대로 V.o_eff 값을 대입. **그림 48장** 전부 확인 — 고친 것: **Fig 41** 왼쪽 "탱크가 낼 수 있는 게인"이 f_o 에서의 게인이었고 θ ≳ 79° 에서 요구 게인 **아래**로 내려가 제목("ceiling stays ABOVE")과 모순 → ZVS 경계(zvs_edge)에서의 게인 M_Z 로(θ = 90° 에서 1.407 > 1.229), 범례·주석 재배치. **Fig 18** LLC 구간 번호 1·2·3·4 → 8단계 번호 1·2·3,4·5(4 가 Fig 6–10 에선 바디 다이오드 클램프, 여기선 반대 반주기 전력 전달이었다), 본문 "LLC, 3 and 4 / LLC, 5", 캡션이 Fig 10 을 가리킴. **Fig 26** HB edge 상자가 y 축 눈금 150 을 가림 → HB 가지 위로, `2 x` → `2 ×`. **Fig 24** 패널 3 "loading" 글자가 곡선 위에 앉음 → 정점 위로, 회색 주석도 곡선에서 뗌. **Fig 19** 호출 글자가 m = 2.25 곡선에 닿음 → 빈 곳으로. **Fig 40** "then a dead interval"(dead time 과 혼동) → "then freewheels (steps 2, 6)". **Fig 43** "freewheeling · dead time" 글자를 점선이 관통 → 흰 바탕. **Fig 42** 캡션에 계산 모델(반주기 전체 사인 + 선형 자화 램프)임을 명시. 확인만 한 것: Fig 16 은 dead time 동안 i_Lr = i_Lm 으로 그린 8구간 모델의 단순화(스텝 4 에서 2차가 도통을 시작하는지는 동작점에 따라 다르다) — 바꾸지 않음. Fig 26 은 "보장되는" 모드 기준(173/332), Fig 30 은 히스테리시스 포함(166.2–346.5) — 본문 4.5 가 두 범위를 모두 적어 모순 아님. **용어 표**: 그림·본문·수식에 쓰였는데 표에 없는 기호 0(an_symbols MISSING 0, 그림 기호 대조 0). **수식 굵기**: `an_pdf.EQ_BOLD = 0.0096` — 같은 색 테두리 path effect 로 획마다 0.0096 × 글자 크기(pt)를 더한다. STIX 줄기 평균 0.096 em 의 10 %. 3000 dpi 실측 l 45→50 px(+11 %) · I 50→55(+10 %) · T 50→54(+8 %). 캐시 키에 EQ_BOLD 포함. 한국어판은 an_pdf 를 공유하므로 이식 때 자동. figcheck 55장 0건. 한국어판(60·61·62차)은 영문판 확인 뒤. |
| 2026-09-25 | **(63차) 영문판 AN 한 줄씩 전수조사 — 97쪽 전부(본문 · 수식 68개 이미지 · 표 · 그림 48장), 지난번에 건너뛴 도구 보고서(an_symbols · an_figtext · an_check)까지.** 사용자: "찾을 때마다 오류가 발견되잖아 … 이번에 안 하고 넘어간 것까지 모두 포함해서 … 한 줄 한 줄". 41건, 기록은 스크래치 findings.md. **값이 틀렸던 것:** ① 7.10·표 16 **공극 "약 1.1 mm" → 2.2 mm** — TDK ETD 49/25/16DG 의 G2·G3 는 반쪽 하나의 치수이고 세트는 같은 반쪽 둘이라 합계 2(G2+G3). 250 nH 행 2×0.54 = 1.08 mm 가 μ0A_e/A_L = 1.06 mm 와 맞는다(`cores.AL_gaps` ETD49 · PQ50DG 2배). ② 표 20 **"Primary switching, three positions 4.83 W"** — P.mos_sw 는 스위칭 위치 **하나**의 도통 손실; HB 에서 S1·S2 둘이라 9.65 W, 스위칭 손실 아님 → 합계 23.15 → **27.97 W**(시트의 P.pri_tot 19.3 W 사용), 효율 주석 23.2 → 28.0 W. ③ 표 18·10.4 **L_open 허용 저하 4.1 % → 4.0 %** — 표시용으로 반올림된 k.floor 1.021 을 제곱했다(`an_pdf.Ldrop` 을 f.o/f.Min 에서). **틀린 서술:** 2.3 "Lower f_sw towards f_o and the interval fills the whole half period, no power" · 2.5 "conventional LLC … just above f_r, where circulating current is smallest" · 2.12 "reflected voltage exceeds V_out" · 4.7 "crosses f_r … within one line cycle"(173 · 90 Vac 는 안 넘는다) · Fig 5 "nothing can push the converter below it" → "below it the tank is capacitive at any load" · 표 2 "current limit does not"(6.19 와 모순) · "far below the winding peak"(15.2 vs 18.3) · 6.22 C_in 하한/THD 상한 뒤섞임 · 6.29 "crossover rises with √CTR"(실측 CTR×2 → f_c×1.73, 거의 비례) · 6.31 "A changes slowly"(A ∝ ω; 수렴 이유는 제곱근이 변화를 반으로) · 7.3 "k_floor … thinnest margin"(k_Ploss 0.311 이 같은 표에) · 6.6 "dead interval" · "centre tap halves the secondary conduction loss"(정류기 손실). **빠진 조건 · 정의:** 6.26 플랜트 적분기는 정전력 부하일 때만 — 저항 부하면 1/(πR_LC_out) 극(이 설계 4.5 Hz), 문단 추가 · 7.11 ZCD 극성: 데이터시트 5.3.4(LOUT1 on 에서 ZCD 양) → 보조 권선 점 끝(8번) GND, 10번 R_ZCD,H 명시 · Γ_v 의 V_eq,max 가 **상용 최대(264)** 임을 첫 사용처에 · K_pwr · √(L1/L2) · w_f,max(가정 12.0 mm) 정의 · 표 16 margin 2.0 mm 는 가정이며 안전 규격 확인 필요 · Fig 34(ST 도면) 는 AUX→VCC 인데 설계는 외부 레일 → 캡션 · Fig 32 "L_p − L_r" → L_m · 참고문헌에 Toshiba Resonant Circuits and Soft Switching(2019, 본문 인용) 추가 · 표 6 r_BM 을 비율로 · 기호표 미사용 P_v · l_N · ρ20 · C_o(er) 삭제 · kPloss 주석 참조 6.24 → 7.27 · 4.3 THD 참조 6.26 → 6.28. **가독성:** 표 셀 행간 11.2 → 12.2 pt(8.4 pt 글자, 줄바꿈된 셀의 첨자가 다음 줄에 얹혔다 — 표 2) · Fig 25 "family is LOAD / LINE PHASE" 라벨을 곡선 밖으로. **확인만 한 것(검산 일치):** 목차 106 항목 · 북마크 108 · 7장 모든 대입 줄 재계산 · 식 14 3차식 전개 · 식 21–23 변압기 모델(대칭 누설로 L_short = 11.0 µH 재현) · 식 38·39·42·49–56·60–68 유도 · 표 8·10·11·19·22–25 수치 · 데이터시트(OVP1 2.3 V 감전력 계속, OVP2 2.5 V 100 ms, ACP-hard 50 µs 후 f_Max, OCP2 50 µs 후 f_SU). **고치지 않고 보고:** C_fx 1.55 nF · R_ZCD,L 19 kΩ 는 E24/E96 에 없는 값(6.30 "표준 부품으로 반올림" 과 어긋남) — 설계 선정값이라 사용자 결정 필요. 식 49(K_v)는 ST 원본(Device Setting D78)과 같다; α=1 에서 Venable tan(45°+Φ/2) 로 안 돌아가지만 ST 의 α 정의를 알 수 없어 부록 10.3 에 사실만 기록. Fig 16 은 dead time 동안 i_Lr = i_Lm 인 8구간 모델 단순화. figcheck 55장 0건 · an_check · an_symbols MISSING 0 · audit_md · 시트 5벌 mismatches 0 · bom 29/0 · xl_sm 145/0. 한국어판(60–63차)은 영문판 확인 뒤. |
| 2026-09-25 | **(64차) 보조권선 2T + 제너 VCC · 트랜스포머 안전 절연(미·EU·일·한·중).** 사용자: "트랜스포머 절연을 위한 테이핑이나 절연거리는 고려한 설계야?" → 아니었다(표 16 margin 2.0 mm 가 가정뿐). 이어서 "aux 권선은 외부 VCC 안 쓴다는 가정하에 … 2T + Zener 구조로. 이 부분은 워크북과 차이점" · "TV 같은 가정용 기기 … 미국/유럽/일본/한국/중국의 모든 조건을 충족하는 절연 조건". **VCC(시트 §14c 신설):** `n.aux` 1.5 → **1.0**(15:2 에 2 T, 3코어는 유닛마다 1 T · 둘만 직렬), `R.ZCD_H` 330 → **220 k**(계산 208.17 k) → OVP1 28.93 · OVP2 31.45 · 기동 종료 17.11 V · `k.OVsat` 1.258 → 개방시험 전류 16 A. 레귤레이터: C_aux → NPN 에미터 팔로워(15 V 제너 ±5 %, `R.BZ` 820 Ω) → 바이패스 다이오드(DS 5.1.8) → VCC 13.6 V(12.85–14.35). 판정 신설 `k.VCClo` 1.071(> HVSU 12 V) · `k.VCC` 재정의 25 V/V.CC_reg_max 1.742 · `k.RBZ` 1.013 · `k.CVCC` 1.132(`C.VCC` 680 µF) · `k.thand` 3.29 → **44개 중 41개 통과**, `k.auxr` 0.836 은 직결 판정이라 **워크북과 의도된 차이**. 게이트 전류 `I.VCC` = I_CC + 4·Q_g·f.Max = 103.5 mA — `Q.g` 78.6 nC 는 **DiscoverEE 목록 typ**(ST 데이터시트는 이 컨테이너에서 못 받았다). 기동: f.SU 에서 161.3 mA, 부하 없이 정격 전류로 출력을 12.75 V 까지 36.4 ms → C_VCC ≥ 601 µF, HVSU 충전 1.28 s. 6:1 은 R.BZ 680 Ω · C.VCC 1000 µF. 워크북 `fix_xl_aux2t.py`(F83 · F91 · B84 · D84–D100 캐시 · BOM E56 · CHANGELOG, 정본·복사본·6:1) — xl_sm 145/0 · bom 29/0. **절연(`insulation.py` 신설, 출처 7건 URL):** 강화절연(1차 = NP1 · NAUX · 코어), 5000 m(GB 4943.1-2022 범위 조항 원문 확인), PD2 · OVC II · IIIb → **공간 4.5 mm**(2500 V 과도, 강화는 4000 V 단계 3.0 mm × 1.48, 두 CB 성적서 모두 4.5) · **연면 6.4 mm**(320 V 행 × 2, 보간 안 함 — UL 은 보간, TÜV 는 행) · 고체 0.4 mm 또는 테이프 2층 · **3000 V ac 60 s / 4242 V dc**(TÜV 성적서, Class II 100–240 V 5000 m). 작업전압은 설계에서 추정(FB/HB · C_r 스윙 · 중성선=대지) 187 V rms · 373 V pk @264 Vac — 인증기관 측정 항목. **구조:** 나란히 감기의 **분리 간격이 곧 강화절연**이자 누설 → `cores.winding()` 이 간격 ≥ 6.4 mm 를 강제(마진 1차 1.0 · 2차 2.0 mm, 코어는 1차로 간주), ETD 49 는 3층 15 T 유지 · 간격 6.36 → **7.36 mm**. NAUX 는 **TIW 로 2차 위에**(출력을 따라가야 V_aux = n_aux·V_out 이고, 1차 회로라 강화절연 필요). 기하 검사 6항목 전부 통과(표 19). **발견:** 3코어 PQ 40/40 은 남는 폭 4.79 mm < 6.4 → `DESIGN.md` §4.2 11. **열린 것:** 30 kHz 초과 공간거리 표, 개정판 내전압 값, 양산 내전압, 2차 리드 ↔ 요크, TIW 승인 500 kHz < f.SU 503.5 kHz. 벤더 사양서 5절 신설(4종, check_trans_spec 에 NAUX 턴 · 연면 · 공간 · 간격 추가, 불일치 0). AN: 6.17 절연 원칙 재작성 · 6.26 VCC 공급(식 40–43) 신설 · 7.12 안전 절연(표 18 · 19) 신설 · 7.24 VCC 설계 · 표 6 · 표 16/17 · 그림 42(비대칭 마진 · TIW) · 측정 항목 2개 · 참고문헌 8건. 한국어판은 영문판 확인 뒤. |
| 2026-09-25 | **(65차) 전수조사 — 영문 AN 103쪽 한 줄씩 + 그림 43쪽 + 64차 산출물.** 사용자: "오류 다시 전수조사해". 28건(스크래치 r65/findings.md). **틀렸던 값 · 식:** ① **그림이 낡았다** — 64차가 시트를 바꾸고 `an_core_section` 만 다시 그려 **그림 45 핀도 "NAUX 3 T"**, **그림 46 막대 15.19 A**(본문 15.6 A), 그림 43 "15.2 A", 그림 33 이 옛 값이었고, **`f13_morphing` 은 63차의 "2 ×" 수정이 PNG 에 한 번도 반영되지 않았다**. 전량 재생성 · **`figstamp.py` 신설**(PNG 에 설계값 해시와 그린 함수 소스 해시를 새기고 그리지 않고 대조) · Stop hook 6번째 검사. ② **기호 충돌 V_Z** — TL431 LED 전원(12 V)과 레귤레이터 제너(15 V)에 같은 기호 → 제너는 **V_DZ**, 다이오드 강하 V_F(정류기 V_f 와 대소문자만 다름) → **V_D**. ③ **C_VCC 식** — HVSU 충전 전류를 17 → 8 V 전 구간에서 뺐는데 DS 는 12 V 아래에서만 켠다 → `t/[(17−12)/I + (12−8)/(I−I_HV)]`, 601 → **629 µF**, `k.CVCC` 1.132 → 1.082(6:1 1.215). ④ **절연 기하** — 플랜지 끝 반경에 보빈 **축 길이** `flange_h/2` 를 썼다 → `min(flange_w/2, r_win_out)`, 연면 7.05 → 7.30 · 공간 5.43 → 5.66 mm. ⑤ 7.3 "k_floor 가 통과한 것 중 가장 얇다" — **k_RBZ 1.013** 이 더 얇다 → 문장 정정(입력이 전부 최악값이라는 것과 함께). ⑥ 7.10 "3.6 mm foil build" 는 TIW 포함 → 3.0 mm · "all four windings" → NP1·NS2·NS3. **근거 없던 서술:** 6.26 · 시트 "12 V 아래면 HVSU 가 다시 켜져 선전력을 태운다" — DS 는 120 ms 뒤 재가동 여부를 말하지 않는다 → 그렇게 적고 10.1 표에 추가. 6.17 "중앙다리가 1차 밑에 있다" — 두 권선 모두 밑에 있다 → "1차가 창을 외각 다리 1.3 mm 앞까지 채워 코어를 떼어 놓을 수 없다". 7.12 GB "제품 표시" → "제조사가 달리 정하지 않으면"(원문). 내전압 60 s 근거 [PI] 추가, TIW 승인(원문 재확인: TÜV EN IEC 62368-1:2020+A11 · VDE IEC 62368-1:2018 Annex J · 1000 V rms · 500 kHz · **Class B**) → 130 °C 한계 명시. `Q_g` 78.6 nC 는 DiscoverEE 원문으로 재확인. **빠져 있던 것:** 개정 이력 V1.3 · 머리말(수치 출처) · 범위 노트 · 6.20 · 표 6(Q_g · 조정기 가정 · 안전 조건) · 표 7(V_CC · 절연 줄) · 표 8(k_VCClo · k_RBZ · k_CVCC) · 표 20 사양서(절연 · 내전압 · TIW) · 표 22 손실(V_CC 패스 트랜지스터 1.03 W 공칭, 시트 `P.Qpass_nom` 신설) · 표 23(패스 트랜지스터 · 제너 · 다이오드 요구) · 표 25 · 7.27 규칙 2개 · 10.4 미결 5줄 · 기호표. `CLAUDE.md` AN 쪽수. 시트 5벌 mismatches 0 · bom 29/0 · xl_sm 145/0 · 사양서 0. |
| 2026-09-25 | **(65차 뒤) 트랜스포머 예제 재확인 — 진단만 심었다.** 사용자: "트랜스포머 설계 예제에서 제대로 설계한건지 테이프는 실제로 저렇게 붙는게 맞는건지 등등 꼼꼼히 다시 확인해." **누설 인덕턴스를 기하에서 계산한 적이 한 번도 없었다** — AN 6.13 은 "간격이 누설을 정한다", 사양서는 11.0 µH ±10 % 라고만 했다. `leakage.py` 신설: 창 단면 2D 자계를 코어 µ=∞ 경계로 정확히 푸는 이중 코사인 급수(Roth), 동심·나란히 두 해석해와 상대오차 1e-9. ETD 49 · 15 T · 간격 7.36 mm → **15.6–38.7 µH**(목표 11.0). 간격을 0 으로 붙여도 약 20 µH. 3코어 PQ 40/40 은 11.8–14.7 µH. 같은 해에서 2차 구간 자계가 **포일 면에 수직**(1.18 대 0.37 mT/A) — 나란히 감기와 포일은 맞지 않는다. 설계 방향(외장 L_r · 2차 Litz · 다유닛)이 걸린 문제라 AN · 사양서 · 시트는 고치지 않고 `DESIGN.md` §4.2 13 에 올려 사용자 결정을 기다린다. `figs.py` 가 `figs_modes8` 이 쓴 그림 5장에도 도장을 찍는다(도장 없는 것은 ST 도면 3장만). 기호표에 k_RBZ. |
| 2026-09-25 | **(66차) 트랜스포머 예제 재설계 — 사용자 "(나)": 누설 적분 유지 + 2차 Litz.** 탐색(`leakage.py` 에 창 밖 계산 추가 — 중앙다리 면 위 자유공간 영상법, 창 안 대비 길이당 0.50–0.62): 2차를 Litz 로만 바꾸면 간격 6.4 mm(절연 하한)에서 **약 28 µH**, 1차 TIW 로 간격을 풀어 0 mm 로 붙여도 나란히 감기는 **12.6 µH** — 나란히 감기로는 11 µH 불가. **분할(P–S–P)** 이 답: ETD 49 에서 1차 **12 T + 3 T**(비대칭 — 11 µH 가 간격 범위 한가운데 오도록), **1차 TIW-Litz** 309 × ø0.10(+0.2 mm 가정, ø2.57), 2차 Litz 권선당 **2가닥**(401 × ø0.10, ø2.70 — 한 가닥 ø3.82 면 NAUX 까지 8.24/8.40 mm 로 반경이 빠듯), 2층 × 4열로 NS2 · NS3 교대, **층간 뒤집기**(안 하면 반쪽 누설 10.22 대 12.76 µH, 하면 11.09 · 11.11). 간격 공칭 2 × 2.0 mm → **10.90 µH**, 0–3.53 mm 에서 8.41–12.68. AN 식 26(1차원 상한, 신설) 13.7 µH, 나란히 + 절연 간격이면 35 µH. **절연:** 강화절연은 NP1 · NAUX 의 TIW 가 맡고 코어는 2차 쪽(`insulation.checks` 를 "경로마다 무엇이 맡나"로 재작성) — 열린 것은 1차 핀·벗긴 끝 ↔ 코어·2차 리드, TIW 승인 500 kHz < f.SU 504 kHz, TIW-Litz 이 굵기의 공급. 3코어 PQ 40/40 도 절연 간격 문제가 사라졌다(누설은 분할 없이 나란히가 맞다, 세트 8.1–13.4 µH). `cores.winding()` 새 배치(옛 것은 한국어판용 `winding_v64`), 그림 44 재작성(단면 · 펼친 권선 · 2차 묶음 배치도, 마진 테이프는 옆 구간 높이까지), AN 6.13(분할 · 식 26) · 6.16(포일은 동심 권선에서만) · 6.17(절연은 거리 또는 전선) · 7.10–7.13 · 표 6 · 7 · 15–20 · 34 · 7.27 규칙 · 기호표, 사양서 5절(NP1 TIW-Litz, 간격 무절연) · `check_trans_spec` NP1 선재 검사. 그림 44 옆 `an_xfmr_read` 의 "→ foil" → "→ secondary Cu", 원래 있던 figcheck 1건(격자선 위 글자)도 정리. 한국어판은 영문판 확인 뒤. |
| 2026-09-25 | **(67차) 섹션 권선으로 — 사용자: "나눠 감는 구조가 싫어서 큰 코어", "나눠서 감지 말라니까, 온세미처럼", "칸막이 넣는 방식으로", "온세미는 층층이 테이핑도 했는데 그것도 추가".** 큰 코어 검토: 나누지 않는 배치는 코어가 클수록 누설이 커진다(ETD 49 최소 14.6 · ETD 54 16.0 µH — 턴 길이 증가). ETD 54 원문(사용자 제공 URL, 저장소 파일과 바이트 동일): N27 · N87 · N97(N95 없음), 단일 공극, A_L 식 0.10–3.50 mm. 온세미 EER3542(Fair-Rite EER35 치수) 를 모델로 재현 66–77 µH vs 사양 ≤ 118 µH — 모델이 과장하지 않는다. 차이는 요구치(0.049 대 ≤ 0.091 µH/T²)와 2차 구리. **결정: ETD 49 · 2칸 보빈 섹션 권선** — 1차 TIW-Litz 15 T 한 칸(3층 × 5), 칸막이 1.0 mm(가정; TDK B66368 은 1칸뿐), 2차 Litz 권선당 한 가닥(ø3.82) 2층 · 층간 자리 바꿈(안 하면 12.42 대 18.68 µH), 층마다 테이프 0.05 mm(가정). **추정 14.13 µH — 목표 11.0 µH 보다 28 % 높고 +10 % 한계도 넘는다**(칸막이 0 이어도 12.46). AN · DESIGN 에 그대로 적고 첫 샘플로 판정, 넘으면 실측값으로 탱크 재검토. 반경 8.39 / 8.40 mm. `cores`: `PRI_SPLIT` 1.0 · `SEC_PAR` 1 · `G_NOM` 1.0 · `T_TAPE` 신설, 1차 1칸이면 간격 1개. 그림 44: 칸막이를 보빈 벽으로, 층간 테이프를 노란 선으로(축척 아님). AN 7.10–7.12 · 표 6 · 15–17 · 19 · 20 · 34(보빈 · 반경 여유 행 추가) · 7.27 규칙, 사양서 5절, `insulation.checks` 문구. |
| 2026-09-25 | **(68차) 코어를 E 60/22/16 으로 — 사용자: "1차/2차 높이를 맞추면서, 탱크값을 바꾸지 않으면서, 절연 기준에 어긋나지 않으면서, 보빈 안 빈 공간 없는 최적 코어", 이어서 "2차가 너무 두꺼워 감을 수 없다 — 4선 병렬이든 포일이든", "권선 사이 미세한 간격을 염두에".** **탐색:** Magnetics 2022 카탈로그(ETD 39–59 · EER 35L–53 · EC 41–70 · E 40–72)와 TDK 데이터북 2013(ER 35–54 · E, 사용자 제공 URL)의 창 치수로, 두 칸이 반경을 채우는 모든 층·병렬 조합을 `leakage.py` 모델에 넣었다(보빈 튜브 벽 1.3 · 플랜지 1.35 mm 는 TDK ETD 보빈에서 역산한 가정). 칸이 창 깊이를 채우면 누설 ∝ l_N × 구리 면적 / h_w² — **깊고 짧은 창**이어야 한다. 표준 보빈 그대로는 어느 코어도 네 조건을 동시에 못 맞춘다(층·가닥이 정수라 권선 폭이 계단식, 11 µH 에서 축 방향 3–5 mm 가 남음). 남는 폭을 **주문 보빈 플랜지 두께**로 흡수하는 것으로 정리하고, 전류밀도 · 철손 · Ae 여유로 **E 60/22/16**(Magnetics 0R46016EC, R 재질, Ae 248, 창 14.19 × 27.6) 선택. 2순위 E 42/21/9 는 Ae 107 로 B 192 mT — 철손이 ETD 49 의 약 2.4배(β 2.5 가정 상대치)라 제외. **포일 기각:** 2차 칸 안 누설 자기장이 반경 방향 12.5–13 mT 대 축 방향 ≤ 0.8 mT(1차 10 A) — 포일 면을 수직으로 뚫는다. **4선 병렬 기각:** 한 턴 높이가 3.06 mm 로 고정이라 한 줄 4개는 ø3.01 그대로, 2 × 2 는 J 7.5. 대신 턴을 2단으로 — **2차 턴당 8다발(96 × ø0.10, ø1.32) = 4다발 부분권선 2개(NS2a ∥ NS2b)**, 층 순서 NS2a · NS3a · NS2b · NS3b(모두 NS2 안쪽이면 반쪽 누설 13.91 · 12.75, 이 순서면 11.95 · 11.34), 층 바꿀 때 4다발 묶음을 반 꼬아 뒤집음(묶음 안 다발이 반경 방향 자기장을 다르게 쇄교 — 순환전류는 계산하지 않았다). **1차 TIW-Litz 2가닥 병렬**(156 × ø0.10, ø1.68 + 0.2), 6층 × 5자리. **권선 피치 k_w = 1.10**(가정 — 첫 샘플 실측으로 교체): 선경을 k_w 로 감은 빌드가 반경 12.70 mm 를 채우도록 정하므로 J 가 오른다 — 1차 4.48, **2차 4.73 A/mm²(J_CU 4.5 초과, 발열 실측)**. 칸막이 **G_NOM 1.1 mm → 11.00 µH**(꽉 감으면 10.77, 칸막이 ±0.5 mm 에 10.2 · 11.8), 플랜지 4.19 mm 씩, 권선 폭 19.23 mm. **새로 드러난 위험:** 카탈로그 E 60/22/16 은 A_L 연마 = **중앙다리 단일 갭 약 2.3 mm**(첫 추정)이고 1차 첫 층이 튜브 벽 1.49 mm 너머에 있다 — ETD 49DG 의 분포 갭이 없어졌다. 분할 · 분포 갭 가능 여부는 코어 업체, 갭 근처 권선 온도는 실측(AN 미결 항목표). 코드: `cores` — `CORES`/`MECH`/`BOBBINS` 에 E 60/22/16(사각 다리 `shape 'E'`, 주문 보빈 `custom`, 핀은 ETD 49 보빈 배치를 사양으로), `turn()`(사각 다리 평균 턴 · 코어 안 비율), `winding()` 재작성(반경에서 선경, `PRI_PAR` · `SEC_PAR` · `SEC_SUB` · `SEC_ORDER` · `K_WIND` · `FLANGE_MIN`, 인자 `k` · `order`), `V64_CORE`(한국어판은 ETD 49 로 고정). `leakage` — `k` · `order` 인자, `turn()` 사용. `insulation` 미결 문구. 그림 44 재작성(축척 · 8층 2차 배치도), 핀 그림 제목 · 각주. AN 7.10–7.13 · 사양 · 입력 · 미결 표(`openitems` 키) · 개정 이력. 사양서 1 · 2 · 3 절 문구. 한국어판은 영문판 확인 뒤. |
| 2026-09-25 | **(68차 뒤) 자체 검사 — 사용자: "이 설계가 맞는지 다시 검사해".** 카탈로그 옮겨 적기(E 60/22/16 치수 · Ae · 창) 재확인, 누설 급수 수렴(M·N 4배 → 10.998 µH 동일). **새로 계산해 드러난 것(1차 근사, `leakage.proximity` · `sharing` · `dc_loss` 신설):** ① 스트랜드 와전류 — 누설 자기장 13.6 mT rms 에서 NP1 3.9–5.5 W, 2차 2.6–3.7 W, 직류 3.2 W 의 2–3배. AN 은 ø0.10 을 표피깊이로만 골랐고 이 항을 계산한 적이 없다(직전 ETD 설계는 더 컸다). ② 2차 부분권선 안에서 옆으로 나란한 4다발은 반경 방향 자기장을 다르게 쇄교 — 층 바꿈 뒤집기로도 약 2.5 A rms 순환(다발 부하 3.5 A), NS2a–NS2b 2.9 A. 1차 2가닥 병렬은 약 0.1 A 로 무시 가능. ③ R 재질 철손 곡선 판독 약 1.8 W. ④ AN 문장 오류: "이 노트의 전류밀도 안에서"(실제 2차 4.73 > 4.5) · "뒤집어서 균등 분담"(실제로는 줄일 뿐) 수정. AN 에 교류 손실 단락과 미결 2행 추가. **사용자 지시로 ETD 49 · ETD 54 데이터를 코드 · 영문 AN · DESIGN 에서 삭제**(`CORES` · `MECH` · `BOBBINS`, `V64_CORE`, `PRI_SPLIT`) — 한국어판은 `winding_v64` 를 현재 코어로 돌려 빌드만 되게 두었다(이식 전). |
| 2026-09-27 | **(71차, 이 복사본) 예제 트랜스포머를 TDK ETD 54/28/19 + 카탈로그 보빈 B66396W + 칸막이 2.0 mm 로, 탱크를 그 누설에 맞춤.** 경위: 70차 전수조사("오류없나 검토해 다시 전수조사")에서 ① R.T 11 kΩ 이 새 f_o(80.1 kHz)에 안 맞아 dead zone 이 HB 경계 34 % ② AN 의 L_m `%.0f` 표시로 식이 서로 안 맞음(14/25 = 0.550 이라 적힘) ③ L_r 11.26 → 14 설명 없음 ④ 칸막이 기울기 −0.15 → −0.14 ⑤ 워크북 rtc/xl 경보는 캐시 탓(LibreOffice 재계산 사본으로 OK) 을 찾았다. 사용자: "트랜스포머 맨 끝에 테이핑하는게 맞는 방식이라서 자꾸 하는거야?" — **여백 테이프 1 mm × 2 는 근거 없는 가정이었고, "빈 공간 안 남긴다"는 지시에 사실상 2 mm 를 비워 둔 것**이었다(LGE 26OP-LM83W 사양서에 barrier tape 는 있으나 폭 · 목적은 적혀 있지 않다; 그 전에 "참고자료에 언급 없음"이라 한 것은 pdftotext 가 없어 검색이 돌지 않은 상태에서 한 말 — 틀렸다). → "칸막이 1mm 로" → "보빈 데이터가 없는 코어 쓰는게 좀 그래. 너 마음대로 24핀짜리라고 했는데, 근거가 있어?" — **E60 보빈 · 24핀은 근거 없는 우리 사양이었다.** → E 65/32/27(보빈 1칸 · 핀 없음, 창이 높고 얕아 채우면 동심 2.9 · 좌우 28.9 µH) → "ETD 코어로 찾자, 핀수도 데이터시트, 칸막이 없으면 따로 제작" → "혼합배치 안 해" → "칸막이 2mm 로 빈공간 안 만들 코어" → "ETD 44 · Cr 150 · Lr 18.4"(블록 모델 값 — 실제 다발로는 1차 J 6.6, 3.5–17 mm 가 빈다: 블록 모델 표를 다발 확인 없이 내민 것이 잘못) → "다시 진행" · "필요한 계산과 검토는 너가 알아서". **다발 단위 탐색**(1차 1–5층 × 1–3다발, 2차 층당 1·2·4턴 × 1–8다발, 칸막이 2.0 mm, 빈 틈 ≤ 0.25 mm, J ≤ 6): TDK 카탈로그 핀 보빈 11종 중 6종 성립 — PQ 50/50 21.6 · PM 62/49 23.7 · ETD 54 23.4 · E 55/28/21 25.4(핀당 28.6 A) · ETD 59 · PM 74 27.5 µH(f_o 38.5 kHz 로 R.T·C.T > 12 µs, `k.tau_hi` 미달). 각 후보를 스크래치 빌더(Lr14 를 579 결과 차이 0 으로 재현)로 시트 전체 계산 · R.T 재선정 · dead zone · 손실 비교. "자속 152 mT 가 카탈로그 기준점보다 높아 부담"이라 한 말에 사용자: "무슨 카탈로그?" — ETD 54 DS 의 P_V 측정 조건(100 mT · 100 kHz · 100 °C)이지 한계가 아니었고, 손실은 계산하지 않은 채 한 말이었다(N97 도 빠뜨림). N97 재질 DS(2025-06) 전형값 표로 운전점 자속(최대 122 mT, 152 는 시트 판정식 값)을 라인 주기 적분 → **코어 1.2–1.4 W**(DS 최대 비율로 약 2.2 W), 구리 직류 2.08 W + 스트랜드 와전류 약 2.7–3.9 W → 합계 E60 판보다 작다 → "ETD54 가 괜찮으면 진행". **적용**: 1차 TIW-Litz 턴당 3다발 · 4층, **층마다 묶음을 뒤집는다**(안 뒤집으면 1차 다발 순환 28 A, 뒤집으면 1.3 A — `leakage.sharing_pri` 새로 추가), 2차 5다발 · 4층 교대, 칸막이 2.00 mm, 축 방향 피치 1.106 으로 폭을 정확히 채움, L_short 23.34 µH · 반쪽 23.97 · 23.27. 탱크 L_r 23.4 · L_m 42.55 · C_r 200 nF · R.T 23.2 kΩ(k.floor 1.023, dead zone 5.0 %). 핀: 2차가 끝마다 3핀이면 12핀이 한 줄 11핀에 안 들어가 **센터탭을 핀 15–19 에서 공유**(핀당 NS2 · NS3 한 다발씩). 정본(3코어 자리표시자) 40/44(`k.Ae` 0.53), AN 예제 41/44. 워크북 F43 · F44 · F45 · Device Setting F24(`etd54_xl.py`) |
| 2026-09-26 | **(69차) 예제 트랜스포머를 B안으로 — TDK PC47EE60-Z, 두 칸 맞닿은 섹션 권선.** 사용자: "1차 2가닥 병렬인데 레이어마다 5개씩 … 짝수개로 들어가야지", "2차 8가닥 병렬 … 테이프가 있으면 병렬권선끼리도 나눠져", "병렬권선수가 너무 많으면 … 핀에서 나눠서 납땜", "TDK 카탈로그도 참고", "빈공간을 최소화", "평각 리츠는 비싸서 못써", A(2차 2다발 · 칸막이 0.5) · B(2차 3다발 · 칸막이 없음) · B′ 중 "B로 하자. 얼마 차이 안나니까 … 이전 예제와 트랜스포머 흔적 남기지 말고". **설계**(`cores.winding`): 1차 TIW-Litz 1가닥 378 × ø0.10(ø2.82) 4층 × 4자리(마지막 층 3턴 벌려 감음), 2차 턴당 Litz 3다발 389 × ø0.10(ø2.66) 나란히 · 층당 1턴 · 4층, 층마다 테이프, 두 칸 맞닿음, 플랜지 2.22 mm, J 3.69 · 3.10 A/mm². 코어 수치는 TDK 카탈로그(20231117) p.22 · p.31 로 옮겼다 — E min 43.8 · 창 반높이 14.05 ± 0.25 · 중앙다리 15.6 ± 0.4 → 반경 여유 12.60(68차 Magnetics 치수로는 12.70), A_e 247, A_L 5670 ± 25 %, 재고 갭 250 · 500 nH, 철손 11.35 W max(100 kHz · 200 mT · 100 °C). **L_short 11.46 µH**(+4.2 %), 꽉 감으면 11.03. **새로 드러난 것 둘**: ① 갭 — A_L = 373.02·lg^−0.7405 곡선이 약 2 mm 까지만 그려져 있어 137.8 nH 의 약 3.84 mm 는 외삽(68차 AN 의 "2.3 mm 첫 추정"은 프린징을 뺀 식이었다) ② **반쪽 누설** — CT 는 한 번에 반쪽만 도통하므로 탱크가 보는 값은 한쪽 단락값이다. 층 순서 3종을 풀어(`leakage.orders`) 교대 순서 NS2 · NS3 · NS2 · NS3 을 골랐다: 12.26 · 11.61 µH(NS2·NS2·NS3·NS3 13.99 · 12.75, NS2·NS3·NS3·NS2 11.60 · 12.51). 높은 쪽이 L_r +11 % 로 ±10 % 밖 — AN 에 그대로 적고 미결 항목으로. 2차 3다발 순환 전류는 둘째 턴에서 순서를 뒤집어 3.7 A rms(안 뒤집으면 18 A), 손실로는 약 0.09 W. 스트랜드 와전류 1차 근사 NP1 4.1–5.8 · 2차 3.7–5.2 W 대 직류 2.4 W. **x1 변형 시트의 `A.e` 가 21차 ETD 49 값 211 mm² 그대로였다** — AN 의 자속 검산(97.6 mT)이 고른 코어가 아닌 값이었다. 빌더가 `cores.CHOSEN` 에서 읽게 바꿔 247 mm² · 83.4 mT. 핀은 24핀(2 × 12, 5.08) — 2차 끝마다 다발당 1핀(핀당 9.45 A rms, 보빈 업체 확인). 옛 예제의 흔적(2가닥 병렬 · 8다발 부분권선 · 칸막이 · 평각 Litz 권고 · Magnetics R · PQ 32/30 · PQ 50/50DG 데이터)을 코드 · 그림 · AN · 사양서 · 문서에서 지웠다. 한국어판은 규칙대로 영문판 확인 뒤 이식(`winding_v64` 는 그때까지 남는다) |
| 2026-09-26 | **(70차) L_r 14 µH 복사본 `Lr14/`** — 사용자: B안 뒤 "칸막이 안 넣는 것도 일반적이야?"(참고 자료 전부가 2칸 보빈 — onsemi AN-4151 · TDK SRX/SRV · Infineon · LGE 26OP-LM83W · 삼성 JPE 2009 · Fairchild · Frenetic) → "플랜지 두껍게는 근거 없음" → Pollock APEC 2020(권선 사이 공기에 에너지를 두면 Q 가 좋아진다) → "여유공간 아예 안남기고 싶어": L_r 11 µH 에서는 창을 다 채우면 L 이 14 µH 이상이 된다(식 26) → "Lr 14uH Lm 25.46uH 로 … 검토" → "Cr=100nF 유지" → "이거 용으로 따로 복사해서 만들어 기존꺼 수정하지 말고". **탱크 L_r 14 · L_m 25.46 µH · C_r 100 nF**: λ 0.55 · n 그대로, f_r 151.8 → 134.5 kHz, I.pri_lc 10.91 → 10.38 A, I.Lm_pk 12.41 → 10.99 A, `k.ZVS` 2.09 → 1.52, **`k.floor` 1.02 → 1.15 · `k.RTd` 1.02 → 1.16**(R.T 여유 커짐), 정본(EE6405 자리표시자) B_pk 182 → 205 mT 로 **`k.Ae` 미달**(40/44), AN 예제(E60) 41/44. 트랜스포머: 1차 4층 × 4 · 2차 3다발 × 4층 · 플랜지 1.35 · 칸막이 1.73 mm(남는 폭 전부) → **13.99 µH**, 반쪽 14.83 · 14.12. 워크북 F44 · F45(`lr14_xl.py`, 캐시는 Excel 재계산 필요). 원본 파일은 하나도 바꾸지 않았다 |
| 2026-09-30 | **(72차, 이 복사본 `PQ50/`) 트랜스포머를 TDK PQ 50/50 한 개(15:2)로, 탱크를 그 누설에 맞춤.** 경위(Lr14 대화의 연장): ETD 54 의 1차 3다발 · 층마다 뒤집기가 "양산 불가" → 8:1 · 2차 1턴 · 박형 코어 탐색(ELP 64 E-E 만 성립, 보빈 데이터 없음) → "보빈 데이터 있는 코어만 · 복잡한 구조 금지 · 인위적으로 굵은 선 금지 · 빈 공간 금지 · 외부 인덕터 절대 안 씀 · 칸막이는 정상 두께" → 8:1 · 2차 1턴은 1차 8턴이라 정상 칸막이로 누설 5–7 µH(탱크 하한 약 8–12 µH) — **해 없음** → 사용자 "15:2 로 찾자". 데이터시트 보빈 20종 스캔에서 **PQ 50/50(B65982E, 12핀)** 만 전류 기준 선경으로 반경을 채운다. **치수는 TDK PDF 벡터에서 읽었다**: 코어 창 바깥면 22.0 mm(원호 ø44, 안쪽 16 mm 선은 바깥다리 끝의 숨은선), 플랜지 끝 반경 21.3–21.6 mm, 권선 폭 30.4(튜브 쪽) → 약 31.7 mm(바깥), **요크는 직사각형이 아니라 나비넥타이**(날개 가장자리 (4.80, 11.21)–(16.02, 15.18) mm) — 직사각형으로 본 첫 계산이 누설을 약 17 % 과대(29.8 → 24.8 µH)했다. 권선: NP1 3층 × 5 T TIW-Litz ø2.9(ø3.0 은 반경 10.05 로 플랜지를 넘는다) · 칸막이 3.0 mm · NS2 2 T 한 층 → NS3 2 T 한 층 Litz ø4.0 · NAUX 2 T 맨 위 (사용자: 층 안에서 NS2 · NS3 자리 바꾸기 금지 — "그냥 칸막이만 만드는 쉬운 권선"; 두 가닥 동시 감기는 반쪽 차 38 % 라 탈락). 2D FEM(스트랜드 근접 · 코어/끝단 두 단면, 나비넥타이 가중) 누설 23.3–26.4 µH · 반쪽 NS2 24.5 / NS3 25.1. 탱크 **L_r 25 · L_m 45 · C_r 180 nF(E12) · R.T 21.5 kΩ(E96)** — C_r · L_m · R.T 고정, L_r 22.3–28.6 µH 에서 41/44. 시간영역 손실(스크래치 계산 — 스크립트는 저장소에 없다) 4.7–6.0 W(구리 3.8–5.1 · 코어 0.9–1.0 @100 °C, 80 °C 면 코어 약 1.5 배), 반쪽 누설 차로 평균 전류 3.7–6.0 % 차, 자화 DC 0.19 A. NAUX 위치: 2차 위 2.4 % · 아래 5.3 % 추종 오차(FEM) → 위. N97 손실식은 재질 DS(2025-06) 두 점과 B 지수 2.7–2.8 로 확인, 갭 공차는 손실에 0.7 % 미만. **적용**: `cores.CORES['PQ 50/50']`(DS 값), 빌더 `7p5to1` · `7p5to1_x1` 탱크, R.T 21.5 k, 워크북 `pq50_xl.py`(F43 · F44 · F45 · F24 · **F9 n 6.0241 → 6.0134**). **F9 를 처음에 빠뜨려 `xl_sm_compare` 11칸이 0.4–0.9 % 어긋났다** — λ 가 0.556 이 되면 n 이 움직인다; 그 뒤 145/145. 검증: 빌더 4변형 0 · `check_sm` OK · `bom_compare` 29/0 · `rtc_check` OK · `check_theta` 0 · `audit_dim` 0 · `audit_rpn` 1(P.DZ W↔mW 표시 오탐, Lr14 와 같음) · `audit_xl` 78건(Lr14 와 같음). `_x1` 41/44 · 정본 40/44(`k.Ae` — 3코어 자리표시자). **남은 것**: AN · 그림 · 벤더 사양서 · `cores.winding()` · `leakage.py` 는 아직 ETD 54 판; 핀 전류 · Litz ø4.0 굽힘 · EFOLIT 절연 두께 · 누설 실측 · 온도는 벤더/시제품 |
| 2026-09-30 | **(73차, 이 복사본 `PQ50/`) AN(영문) · 그림 · 벤더 사양서를 PQ 50/50 판으로 — 옛 코어 흔적 삭제.** 사용자: "진행하고, 지난 코어에 대한 흔적은 다 지워버려 가이드에서." **`cores.py`** 를 다시 썼다: `CORES` 에서 E 60/22/16 · ETD 54 삭제(PQ 40/40 은 3코어 시트가 읽어 남김), `MECH['PQ 50/50']`(TDK PDF 벡터 치수), `zones()`(한 턴을 바깥다리 옆 · 요크 밑만 · 코어 밖으로, `YOKE_SHARE` 0.5 가정), `BOBBINS` 12핀(핀당 한 가닥, 센터탭 9–10 은 보드에서), 둥근 선경 `D_PRI` 2.9 · `D_SEC` 4.0. **`leakage_fem.py` + `fem2d.py`(신규, scipy)** — 2D 유한체적, 코어 · 끝단 두 단면을 반경별 턴 길이로 가중. 반쪽 NS2 24.50 · NS3 25.14 µH, 둘 다 단락 23.09 µH, 갭 1.784 mm, 와전류는 자화 전류 장까지. `leakage.py`(1D)는 턴 길이 하나라 PQ 에서 반쪽 순서를 거꾸로 낸다 — 기준에서 뺐다. **사양 측정 조건을 바꿨다**: 탱크가 보는 것은 한 반쪽이 도통할 때라 **반쪽마다 단락 ±10 %**, 둘 다 단락은 기록값(더 낮게 읽힌다). AN 6장 표 · 7장 · 벤더 사양서(항목 2 · 주석 26) 같이. AN 7장: 빌드 · 누설 · 나비넥타이 요크 · 칸막이 손잡이 · ac 손실 · 코어 · 갭(데이터시트에 A_L–갭 관계 없음, μ0Ae/A_L 과 FEM) · 권선표 · 핀 절 · 절연 · 사양 · 열린 항목. 그림 44(세 번째 판을 요크 평면도 + 턴 구간 색으로) · 45(B65982E 핀). `insulation.py` 에 1차 핀 ↔ 코어 공간거리 6.01 mm 행. **`R.T` 서술 두 건**: ① `%(RT).0f` 가 21.5 를 "22 kΩ" 으로 찍던 다섯 곳을 `%g` 로 ② 이 탱크는 `k.floor` 1.077 · 허용 L_open 하락 13.8 % 라 ±10 % 공차가 **들어간다** — Lr14 문장("안 들어간다, R_T 를 낮추면 덮는다")이 틀려 열린 항목 행을 여유에 따라 갈리게 했고, 여유 주석의 "가장 얇은 여유 · 2 % 로도 모른다"를 뺐다. `DESIGN.md` 5b 도 23.2 kΩ(Lr14) → 21.5 kΩ, **dead zone 비율은 이 탱크로 다시 계산하지 않았다**고 적었다. 빌드 수식 한 줄이 열 폭 530 pt 로 넘쳐(`an_pdf` exit 1) h_A · h_S 를 두 줄로, `an_symbols` 가 잡은 h_A · h_S 를 기호표와 본문에 추가. **한국어판 PDF 는 이 복사본에서 뺐다**(ETD 54 판, 영문 확인 뒤 이식). **8:1 · 6:1 시트**: 2112d65 에 공용 `R.T` 21.5 kΩ 으로 빌드된 판(f.sw 하한이 그 탱크에 안 맞음)이 들어가 있어 Lr14 판으로 되돌렸다 — 빌더의 `R.T` 가 변형마다 다르지 않아서이고, 두 파일은 `check_sm` OK. 검증: 빌더 `mismatches 0` · `check_sm` OK · `bom_compare` 29/0 · `check_trans_spec` 0 · `figcheck` 55장 0건 · `figstamp` 0 stale · `an_check` 기하 문제 0 · `an_symbols` 표에 없는 기호 0 · `an_figtext` 그림 44 · 45 지적 0 · `audit_md` 0. PDF 본문에서 ETD · E 60 · PC47 · B6639 · PQ 40 · 옛 탱크 값(23.4 µH · 200 nF · 42.55 µH · 23.2 kΩ) 검색 0건. `.fem_cache.json` 은 무시 파일 |
| 2026-09-30 | **(74차, 이 복사본 `PQ50/`) 핀 그림 — 어느 쪽에서 본 것인지 밝히고 보빈 형상을 데이터시트 도면대로.** 사용자: "밑에서 보는건지 위에서 보는건지 정확하게 해줘야지. 그리고 좀 더 형상을 구체적으로 그려줘". 73차 그림은 데이터시트의 번호 뷰를 옮기며 "VIEW IN MOUNTING DIRECTION"이라고만 적었다 — 근거 없는 이름이었다(도면에 뷰 이름이 없다). **판단**: 도면은 정면도(핀 아래) 위에 핀 끝이 ⊕ 로 보이고 1 · 6 · 7 · 12 · 핀 1 표시가 있는 뷰, 아래에 핀이 없는 뷰를 둔다. 위에서 보면 핀은 베이스 블록 안에 가려진다(단면 A-A 에서 핀이 밑에서만 들어간다) → **번호 뷰는 밑면도(핀 쪽)**, 제1각법. 두 뷰 모두 모따기 모서리가 왼쪽이라 투상과 모순 없다. **적용**: `bobbin_outline.py`(신규)가 데이터시트 한 쪽(`data/TDK_B65982E_coil_former.pdf`)의 벡터에서 세 뷰 윤곽을 읽어 `data/B65982E_outline.json` 으로(`--check` 도면 치수 7개 통과, 선 두께로 +0.4 mm). 그림 45 를 네 판으로: 회로 기호 · 정면도(PCB 위, 보는 방향 화살표 A · B) · **A 밑면도(핀 쪽, 데이터시트와 같음, 핀 실선)** · **B 윗면도(권선 쪽 = PCB 부품면, 좌우 바뀜, 핀은 가려져 점선)**, 모따기(핀 1 표시)를 양쪽에 화살표로. 윤곽선은 zorder 1.6 — `figcheck` 가 z 2 선을 전선으로 읽어 처음 439건이 났다(도면이지 배선이 아님). `cores.PIN_NOTE`(AN 캡션 · 벤더 사양서 주석 18)와 AN 핀 문단에 "밑면도 기준, 부품면에서는 좌우 반대"를 적었고 `cores.py` 주석에 `PIN_XY` 가 밑면도 좌표임을 명시. 검증: `figcheck` 0 · `an_check` 0 · `an_symbols` 누락 0 · `check_trans_spec` 0 · `figstamp` 0 stale. 같이 고침: `CLAUDE.md` 워크북 행이 아직 ETD 54 탱크 값(200 · 23.4 · 42.55 · 23.2, `etd54_xl.py`)이었다 → `pq50_xl.py` 값 |
| 2026-09-30 | **(75차, 이 복사본 `PQ50/`) "위에서 본 코어" 판을 알아볼 수 있는 별도 그림으로 · 핀 그림에서 옆면도 삭제.** 사용자: 그림 44 셋째 판("the core from above")이 "뭔 그림인지 이해가 안 간다", 핀 그림의 코일 포머 옆면도는 "없어도 될 듯". **핀 그림(`an_xfmr_pins`)**: 옆면도(보는 방향 화살표) 대신 "A · B 읽는 법"을 글로 — A 밑에서(핀 끝이 보임, 데이터시트 방식), B 위에서 = PCB 풋프린트(부품면, 좌우 반대); B 의 핀은 패드로 보아 실선. **새 그림 `an_core_plan`**(그림 44 에서 분리): 왼쪽은 위에서 본 코어(축척, `cores.MECH`) — 바깥다리 · 나비넥타이 등판 · 중앙다리에 이름표, NP1 전체를 옅은 고리로 등판 밑에 깔고, 가운데 턴을 색 셋으로; 앞 · 뒤는 코어가 없다고 적음. 오른쪽은 색의 뜻(페라이트로 둘러싸임 · 위아래 판만 · 공기 중)과 왜 필요한지(L_r 가 누설이고, 두 경우를 풀어 이 비율로 반경마다 더한다, 가운데 몫은 반씩 — 가정). 백분율은 `cores.zone_pct()`(최대 잔여 반올림, 합 100)로 그림과 본문이 같은 값 — 예전 48 · 11 · 42(합 101)는 반올림 탓, 이제 47 · 11 · 42. 그림 44(단면)는 두 판으로. **중앙다리 쪽 등판 끝점 (3.5, 9.33)** 이 그림 코드에 적혀 있었다 → `MECH['neck']` 로 옮기고 출처 기록: 04/13 databook 도면(`data/TDK_B65981A_core.pdf`, FPK0457-U) 벡터에서 (16.14, 15.30)–(5.17, 11.30), 필렛, (3.52, 9.41) — 기존 값과 0.1 mm 안. 검사: `figcheck` 세 그림 0(처음엔 범례 막대가 전선으로 · 글자 6.4 pt · 설명 글 그림 밖 — 고침) · `an_check` 0 · `an_symbols` 누락 0 · `figstamp` 0 stale. 그림 번호가 하나씩 밀렸다(평면 44 · 단면 45 · 핀 46) **뒤이어**: 사용자 "이런 설명은 없어도 돼. 탑뷰 바텀뷰 적어놨는데" — 핀 그림의 "A · B 읽는 법" 글 판을 지우고 회로 기호를 위 가운데로, 판 제목을 **A BOTTOM VIEW (pin side)** · **B TOP VIEW = PCB FOOTPRINT** 로. `figcheck` 0 |
| 2026-09-30 | **(76차, 이 복사본 `PQ50/`) 최종 검토 1회차 — 영문 AN 111쪽 한 줄씩, 그림 49장.** 사용자: "한 줄씩 다 읽어보고 철저하게 … 길게 쓴 문장 · 비원어민 표현 · 수식/그래프/파형/그림/설계 오류 · 빠진 핵심 설명". **이번 설계와 틀린 내용 6건**(모두 옛 탱크 · 옛 코어에서 남은 문장): ① 6.10 L_short "2차 전부(센터탭은 두 반쪽) 단락" — 표 4 · 7장 · 사양서의 "반쪽씩, 둘 다 단락은 기록"과 모순 ② 7.3 "k_RBZ 1.089 가 통과한 것 중 가장 얇다" — 실제는 k_PSR 1.051(k_VCClo 1.071 · k_floor 1.077 도 더 얇음) → 표 값에서 골라 쓰는 `_thinnest_text()` ③ 7.19 "f_sw,max,op = 177.7 kHz, 실제로 도는 최고 주파수" — 빌더 정의는 1.5 × 118.5 kHz(운전 최고)를 225 kHz 로 제한한 설계값 → 기호 f_sw,des · 설명 · 기호표 ④ 7.19 · 표 6 · 10.1 "T_idle 700 ns 면 f_Min 이 f_o 아래 / 바닥 여유가 닫힌다 / 두 클램프가 운전 범위를 못 감싼다" — 이 탱크는 700 ns 에서 f_Min 46.3 > f_o 44.8(여유 1.032) · f_Max 227 > 118.5 → 비교 결과로 문장을 고르는 `_idle700_text()` ⑤ 7.28 "f_sw(θ)… the thinnest margin in the design" ⑥ 기호표 L_short 정의. **그림 결함 4**: 그림 24 셋째 판 설명 둘째 줄이 x축에 잘림, 그림 41 f_o 상자가 f_sw 곡선을 가림, 그림 10 "(b) is the ZVS window" → "4 is …", 그림 17 "the gap shaded"(공극으로 읽힘) → "the difference shaded" · 캡션 "what the secondary removed"(플라이백에선 반대) 수정, 그림 21 · 22 "reactor" → "inductor". **표현**: V1.3 개정 이력 축약(이 복사본에 없는 "Korean edition published" 삭제), n_T 정의, 6.4 첫 항목 · 6.26 첫 문장 · 7.10 배치 문장 분할, 6.16 "두 가지 방법" 목록의 셋째 항목 분리, 6.17 "The core counts as the side it cannot be kept away from" → 쉬운 문장, 6.20 "공급자 선택"을 7장과 맞게, √d 서술 정확히(실효값은 √d 에 비례), 7.4 7단계 "L_r pairs with C_r" → 누설이 L_r, 7.10 "평균 24.82 is L_r 25.0" → 1 % 안, "3.0 mm is the most this note allows"(근거 없음) → 얇게만 바꿀 수 있다, 7.13 시동 경로 목록에 머리말, 표 6 f_r 150 kHz 주석 "magnetics size" → 출발점. **설명 보강**: 손실표에 트랜스포머 권선 4.6–5.6 W(7.10 의 dc + 스트랜드), 코어 손실은 계산하지 않음. 쓰이지 않는 기호 K₁ · K₂ · s · d_b 삭제. 검증: `figcheck` 56장 0 · `an_check` 0 · `an_symbols` 누락 0 · `figstamp` 0 stale · `audit_md` 0 · `check_trans_spec` 0. PDF 텍스트로 수정 21곳 반영 확인 |
| 2026-09-30 | **(77차, 이 복사본 `PQ50/`) 최종 검토 2회차 — 1회차에서 안 본 것 위주.** 사용자: "한 번 더 같은 작업 진행 하되, 안보고 넘어간 것 들 위주로". **수식 108개 · 계산 블록 74개를 전부 숫자로 다시 계산**(예: K_v 2.7218, EA_o 32.53, ω_c 110.4, Φ_M 49.64°, f_180 202 Hz, GM 34.2 dB, D3 4.23 %, C_T,max 894 pF, R_T 상한 23.20 kΩ, OVP 28.93/31.45 V, I_VCC 92.8 mA, R_BZ 0.893 kΩ, C_VCC 587–588 µF) — 식과 대입값 · 결과가 어긋난 곳 없음. 1회차에 이미지로 안 본 그림들 확인 — 결함 없음. **벤더 사양서**: NP1 턴 수 "15 Ts" → "15 T"(다른 권선과 같게), 32행 주석을 변형별로 — 트랜스포머 1개(`_x1`)는 "참조 설계의 코어 · 코일 포머 · 권선 배치가 3-2 를 정한다, 다른 구조는 3 · 5절을 만족하고 첫 샘플 승인 뒤에만", 코어 3개는 종전대로 "공급자 선택"(`build_trans_spec.py`, 두 사양서 재생성). **표 자릿수 통일**: 표 7 λ 0.56 → 0.556, n 6.01 → 6.013, Φ_M 49.64° → 49.6°(표 7 · 25, 표 24 · 그림과 같게), 7.10 첫 누설 계산과 그 문장의 l_N 100 → 100.5 mm(둘째 계산과 같게), 사양 요약표 f_o 45 → 44.8 kHz. |
| 2026-10-18 | **엑셀 정리**(사용자: AN 용 · 200 W 최신 · 670 W 3코어만 남기고, 암호화 안 된 것은 이름에 표시). 지움: `L6790_workbook_7p5to1.xlsx`(옛 3코어 설계점) · `…_measured_200W.xlsx` · `…_measured_200W_opt.xlsx` · `Transformer_Spec_7p5to1.xlsx` — 직전 커밋 `810e0f4` 에 있다. 이름 바꿈(`_unencrypted`): 정본 rev0_6 · `variants/…_x1` · `…_measured_LGE_200W` · ST 원본(`Uncryped_…` → `ST_original_…_unencrypted`). 스크립트 · 문서의 경로 전부 치환, `audit_md` 예외 목록에 옛 이름 등록, `measured200_xl` · `lge200_xl` · `asbuilt_spec` 은 입력이 사라져 복구 뒤에만 돈다 |
| 2026-10-18 | **AC 먼저 → ISEN 단선 래치(IC 스위칭 7 주기) · 그림 4 의 톱니는 VCCon 바로 아래(12 V 는 120 ms 뒤 재가동 문턱) · C65/C78 은 이미 VCC–PGND(켈빈 루프 OK)**(`THREE_CORE_BOARD.md` ⑧, 두 정정은 사용자 지적). AC 먼저면 HVSU 로 IC 만 켜지고 드라이버가 죽어 첫 펄스 뒤 약 14 µs 에 래치(4.5 mA 로 유지, POR 까지 안 풀림); 15 V 외부는 '첫 VCCon 이전' 상태라 기동 가능성 높음 — 시험 하나; 드라이버 디커플링은 고칠 것 없음, PGND 를 GND 에 묶지 말 것 |
| 2026-10-18 | **18 V 기준 게이트 저항 재권고 · VCC 시퀀스 · 켈빈 PGND**(사용자가 L6498LD · STO60N045DM9 DS 제공 → `Datasheet/`; `THREE_CORE_BOARD.md` ⑦). 값은 47 / 10 Ω 그대로 1206 으로, 부트 3.3 Ω(VBO_thON max 9.1 V 대 첫 펄스 5.3–8.8 V); 라인 평균 주파수 143–213 kHz 라 47 Ω 평균 0.13–0.19 W; R_on 을 내리면 드라이버 +65–100 K, R_off 를 올리면 MOSFET 턴오프 손실. 17 V 는 L6790A VCC 핀만의 요구(보드 D18 경유 17.3 V, 여유 0.3 V); HVSU 충전기가 12–17 V 프리바이어스에서 켜지는지는 DS 미기재 → 시험 하나; 안전 구간 < 12 V 또는 ≥ 17.5 V. PGND → 켈빈 소스만: 맞다(VPS ±5 V · abs −3 V @18 V 확인) |
| 2026-10-18 | **요구사양서 "값만" · 게이트 구동 예산 `gate_budget.py`**(사용자: 설명 전부 제거, 핀 배치는 우리 사양, 외래어는 영어; 527 kHz 감당 여부를 데드타임 · 상승 · 하강으로 계산, 1206, 부트 저항 근거, 드라이버 소손). 사양서는 결선도 · 표 · 동등 선재 한 줄 · 누설 허용폭 한 줄 · 값 5줄만. 예산: 세 회로망 모두 527 kHz 타이밍 OK(ADT 420 ns 는 무해, 하드 스위칭은 460–650 ns 부터), 드라이버 열은 R_G 에 반비례(18 V · 4.7 Ω +100 K 불가, 15 V · 22 Ω +50 K), 1206 47 Ω 은 18 V 에서 107 %, 첫 LOUT 펄스로 C_boot 5.3–8.8 V < 9.3 V → 부트 3.3 Ω. `THREE_CORE_BOARD.md` ⑥ |
| 2026-10-18 | **요구사양서에 결선도 · 권선 사양표 생성, 기동 비대칭 · 기동 주파수 검토**(사용자 "권선 그림도, a–b 는 1 · 2 사이" · "AC 기동 Leg1 듀티 비대칭" · "기동 주파수가 구동 회로에 맞나"; `THREE_CORE_BOARD.md` '기동 듀티 비대칭 · 기동 주파수와 구동 회로'). `trans_diagram.py`(승인원 방식, NAUX 는 NP1 안쪽) + 권선표로 x3m3 영문 · 한국어판 생성. 110 Vac 기동 확대에서 Leg1 HS ≈ 0.6 / LS ≈ 1.3–1.5 µs, Leg2 ≈ 50/50 → IC 탈자화 감지(DS §5.2.3)의 LOUT1 연장으로 판단(V_out < 2.7 V 동안 ZCD 무감); HB 기동에서 C_r DC 이동이 하드 스위칭을 부를 수 있다는 가설과 시험 A–E. f_SU 526.6 kHz 에서 LGE 구동 회로: 데드타임 창 상한 365–430 ns(IC 최대 420), 첫 HS1 부트 부족 가능(10 Ω × 100 nF), 47 Ω 0603 게이트 저항 0.10–0.43 W. 게이트 결선 정정: 켜짐 47 Ω 단독 |
| 2026-10-18 | **회로도 10-18판 검토 — 트랜스포머 극성 OK, C115 정정, 레그 입력 교체 가능**(`THREE_CORE_BOARD.md` '회로도 10-18판'). 바뀐 곳: C127–C130 150 pF D–S · R197 130 → 100 k(12V_FB 11.7 V). 1차 ● → HB1 · 보조 ● → GND 로 DS 그림 9 와 같고 2차는 통째로 뒤집어도 무관. C115/C117 은 레그 양단(VBUS–PGND) — 중점 스너버로 읽은 내 오독: c.HB 3329 pF, "C115 방전" 파손 후보 철회, 워크북 사본은 보드 확인 뒤. 레그 입력 교체는 네 신호 함께 + 보조 두 끝 교체; HB 정지 소자 Q34 → Q28, 1차 튀는 끝 12 → 10. 요구사양서는 LG 승인원식 권선 사양표로 빌더만 고쳤다(도체 문단 → 선재 열 · 위치 열, 전류는 4절; 리츠 ø0.10 × 370 / 320 은 구리 2.9 / 2.5 mm² 에서 10 가닥 단위 올림, NAUX ø0.40) — 파일 생성은 사용자 확인 대기 |
| 2026-10-18 | **x3m3 설계점 개정 — 70.5 nF / 10 / 15 µH · R_T 7.68 k**(사용자 "L_r 10 · L_open 소수점 없이"). 세트 10 / 25 → 유닛 3.33 / 8.33 µH; f_r 189.6 · f_Min 129.6 · k.floor 1.081 · k.ZVS 1.72 · 71/75; ±10 % 코너 · 누설 범위 8–11 µH 모두 71/75; L_open 24(L_m 14)는 k.floor 1.035, 27 은 k.ZVS 1.32, 30 은 탈락. 시트 · 사양서 재빌드, 정본 시트는 CRLF 외 불변. 이어 사용자: 사양서에서 안전 절연 절 제거(LGE 몫) · 4절은 "권선이 보는 주파수" 한 줄 + A_e 한 줄(공진/스위칭 구분 · 재질 줄 삭제) → `nocore` 모드 4절로 끝. 다시 "순수 트랜스포머 입장 + 한국어판": 컨버터 · 세트 · 공진 인덕터 문구 제거, 권선비 5:2:2:1 표제, `--kr` 로 `…_KR.xlsx`(Malgun Gothic). 정본 사양서 불변 — `THREE_CORE_BOARD.md` |
| 2026-10-18 | **C_r 를 MLCC 로?** — 안 되는 건 X7R. 무효전력 1325 var 에 DF 로 손실이 갈린다(C0G 0.4–1.3 W, X7R 13–33 W), HB 바이어스 V_in/2 에 X7R 용량 −20~40 %(200 W 보드의 −40 % 가설), C_r 피크 324 V(HB 가장자리) → **630 V C0G 2220 병렬**(TDK 68 nF · KEMET 0.15–0.2 µF 품목). 표준값 재중심 시험 빌드: 80/8.5 · 82/8.3 · 88/7.7 모두 71/75, ZVS 여유 ↑ · 누설 목표 ↓, 100 nF 은 Z_0 8.2 로 미달. 200 W 보드의 47 nF 2S×5P X7R: 280–440 var, 알당 1.27 A · 22 V rms → DF 0.5/1/2.5 % 에 1.4–2.2 / 2.8–4.4 / 7–11 W — 열화상으로 가른다. 사용자가 준 커패시터 사양서 = Würth 885342208026(WCAP-CSMH 1206 · 47 nF · 630 V · X7R · DF 2.5 % max @1 kHz 1 V rms, 곡선 없음)을 `Datasheet/` 에 보관. 이어 사용자가 REDEXPERT 곡선 5장을 줌 → `redexpert_read.py` 로 읽음: 194.5 kHz ESR 208 mΩ(DF 1.16 %) → 200 W 하한 3.4–4.3 W; DC 바이어스 81 V −25 % → 230 HB 라인 피크 f_r × 1.16, 공진 위 1.08 배와 함께 243 ≈ 실측 253 kHz(−40 % 가설 확정); AC 10 V +12 %. 사용자 제안 TDK C4532C0G2J473J320KA(1812 · 47 nF · 630 V · C0G) 2S × 3P = 70.5 nF: TDK CSV 로 ESR 3 mΩ(DF 0.017 %) · 바이어스 무관 → 657 W 에 6알 0.24 W, 알당 피크 168 V; 시험 빌드 70.5/9.68 71/75(k.ZVS 1.66), 1S×2P 94 nF 은 k.CTd 미달. TDK 허용 곡선(ΔT 20 °C 기준, 190 kHz 6.34 A · 320 Vp-p)과 대조: 657 W 최악 알당 3.65 A(57 %) · 217 Vp-p(68 %) · ΔT 9 °C — 여유 1.5배 — `THREE_CORE_BOARD.md` |
| 2026-10-18 | **세 번째 안 요구사양서 — 코어 없이**(사용자: "코어를 특정하지 말고 사양만"). `build_trans_spec.py` 에 `nocore` 모드(행 커서 · 26OP-LM83W 단자 · A_e ≥ 220 mm² @75 mT · 재질 급 · 구리 3.0/2.5 mm² · 기동 525 kHz) → `Transformer_Spec_7p5to1_x3m3.xlsx`; 정본 사양서 출력은 셀 전량 동일. 시험 빌드 12회: 누설 −15 % 는 k.CTd · k.ceil 미달, −10 % 통과 → 공차 ±10 % 유지; L_r 8–11 µH 는 C_r 재선정으로 71/75, 끝점의 −10 % 코너는 발진기 재선정 필요. f.SU 525 kHz > TIW 500 kHz 는 미결. 같은 날 사용자 "4 · 5절 정보가 너무 많다" → 동작 조건 4줄 · 절연 6행 한 줄씩으로 간추림, 표피효과 기준은 f_r(공진 아래 반파 정현). "공진 위는 거의 안 들어가나?" → `l6790.sweep`: 경계 V_eq·sinθ > 209 V, FB 105 Vac · HB 209 Vac 위에서 라인 피크 둘레가 공진 위(110 Vac 시간 20 %/에너지 39 %, 230 Vac 27/51 %, 264 Vac 42/73 %; 부하 무관) — 사양서 4절 · 2절 문구 수정. EVK 실측(93/71/47 kHz = 1.08/0.83/0.55 f_r)과 x3m3 모델(1.08/0.85/0.66 f_r)이 같은 정규화 분포 — ST 권선비 규칙(V_in,res = 0.95 V_nom)의 결과 — `THREE_CORE_BOARD.md` |
| 2026-10-18 | **엑셀 8개를 용도별 이름으로**(사용자 "이름만 봐서는 뭐가 뭔지 모르겠어. 가이드용 · 3코어 670W용 · 200W용"). `git mv` — 가이드 워크북 `L6790_spreadsheet_r1_0_corrected_rev0_6_unencrypted` → `GUIDE_PQ50_657W_workbook_rev0_6_unencrypted`, 그 사본 `variants/L6790_workbook_7p5to1_x1_unencrypted` → `GUIDE_PQ50_657W_workbook_rev0_6_copy_unencrypted`, 가이드 사양서 `Transformer_Spec_7p5to1_x1` → `GUIDE_PQ50_657W_transformer_spec`, 3코어 사양서 `Transformer_Spec_7p5to1_x3m3(_KR)` → `3CORE_670W_transformer_spec(_KR)`, 200 W 워크북 `L6790_workbook_7p5to1_measured_LGE_200W_unencrypted` → `BENCH_200W_LGE_workbook_unencrypted`, 200 W 실물 사양서 `Transformer_Spec_7p5to1_asbuilt` → `BENCH_200W_transformer_asbuilt`, ST 원본 → `ST_ORIGINAL_LGE_670W_workbook_04092026_unencrypted`. 스크립트 · 문서 36개의 경로를 바꾸고, 사양서 이름은 `check_trans_spec.SPEC_FILE` 로 모았다(`build_trans_spec` 이 거기서 출력 이름을 읽는다). `lge200_xl` 의 출력 이름은 명시. 이 줄 위의 기록은 옛 이름 그대로 둔다. 검사: build mismatches 0 · check_sm OK · bom 29/0 · check_trans_spec x1 · x3m3 0 · audit_md 0 |
| 2026-10-18 | **가이드 워크북의 `variants/` 사본 삭제**(사용자 "사본 지워"). `GUIDE_PQ50_657W_workbook_rev0_6_copy_unencrypted.xlsx` 는 정본과 MD5 가 같은 바이트 사본이었다 — 여러 권선비 변형마다 워크북을 두던 때(10-01 이전)의 구조가 남은 것이고, 읽는 스크립트는 없었다. `pq50_xl` · `vz_xl` · `fet_xl` · `sr_xl` 의 사본 복사 줄을 뺐다. 복구는 이 줄 직전 커밋에서 |
| 2026-10-18 | **3코어 670 W 워크북**(사용자 "670W용으로도 다시 Workbook 만들자"). 두 빌더 변형(`7p5to1_x1` · `7p5to1_x3m3`)의 차이는 탱크 · R_T · 트랜스포머 구성뿐이라, 가이드 워크북을 복사해 다섯 칸(F9 · F43 · F44 · F45 · `Device Setting` F24)만 x3m3 시트의 입력값으로 바꿨다(`x3m3_xl.py` → `variants/3CORE_670W_workbook_unencrypted.xlsx`). 첫 시도에서 R_T 가 7.7 로 들어갔다 — 시트 읽개가 표시값(한 자리)을 돌려줘서; 입력 셀의 숫자를 읽도록 고쳐 7.68. 검증: LibreOffice 재계산(OOXMLRecalcMode 0) 사본이 x3m3 시트와 `xl_sm_compare` 145/145(같은 절차로 가이드도 145/145) · `rtc_check` OK · `audit_xl` 지적 가이드와 같음 · 문자 판정 칸 변화 없음 · 오류값 없음. 같은 날 질문 "가이드 트랜스포머는 주파수가 낮은데 왜 3코어는 높은 주파수를 고집하나"에 대한 답은 `THREE_CORE_BOARD.md` 10-16 의 세 단락(2 T · 3유닛 구조의 자속, Z_0 고정, 스위칭 손실 예산) 그대로다 — 유닛마다 2차 2 T 라 각 유닛이 가이드 코어 하나와 같은 V/턴을 받고, Z_0 ≈ 11.9 Ω 은 부하가 정하므로 L_r = Z_0/(2π f_r) |
| 2026-10-18 | **부하별 합성 피크(시트 §9b · 워크북 블록) · 670 W 에 LG 보드 부품 · 200 W 와 하드웨어 칸 정렬.** 사용자: V_Z 11.74 V · 옵토는 바뀐 것(UPC1008) · 1차 2차 MOSFET 은 보드와 같은 것 · 출력 캡 PX 6800 µF/35 V · 세라믹 개수는 내가 정하라; 200 W 워크북도 c.HB 등 맞출 것은 맞추라; 자화전류를 둘 다에 적용 — 부하에 따라 더해질 수도 안 더해질 수도 있는 진짜 피크를 자동으로. ① 빌더: 출력 뱅크 · V_Z 분압 · 옵토 · R_B · 보상망 · C_fx · I_min · C_par · SR RDS(on) · k_T 를 변형 키로(가이드 시트는 바이트 동일). x3m3: 16 × PX 6800(리플 1.92 A 가 정한다, 용량만이면 11 — 같은 날 11 로, 아래 줄) · ESR 50.7 mΩ(tan δ 0.26 상한 — PX 시트에 f_sw ESR 없음) · 세라믹 160 µF(R&N 13 mV) · 보상망 ×1.21(100 nF / 680 nF / 39 k, f_c 17.4 Hz · PM 49.6° · 3차 4.2 %) · c.HB 5529(Cpar 2600 — 같은 날 3329 로 정정, 아래 줄) · TPH3R70APL1 3.7 mΩ · 1.9. 판정 71/75 그대로, k.PSR 1.64 → 1.12 · k.CVCC 0.83 → 0.58(뱅크 109 mF 로 기동 인계가 길어짐). ② 시트 §9b: 부하 0 · 25 · 50 · 75 % 마다 시트 §8 의 3차식으로 f_sw 를 다시 풀고 [79] 합성 피크와 r.add; 시트 §14.1 에 m.OCP.* 와 I.Lm_pk.zc. 빌더 대조에 `sweep(load=0.25/0.5)` 2점 추가(mismatches 0). 첫 빌드는 0 % 에서 MIN() 의 (a+b−|a−b|)/2 가 1e9 대 1 의 정밀도를 잃어 ACOS 분모 0 — 두 단계 클램프(10 → 0.999999999)로 고침. ③ `peak_xl.py`: 같은 표를 워크북 `Device Setting` 116–141행에 살아 있는 수식으로(가이드 · 670 W · 200 W), `xl_sm_compare` 8항목 추가 → **153/153**(가이드 · x3m3 둘 다), 100 % 열은 D32 와 1.000, 200 W 는 `l6790` 모델과 대조(8.619 / 8.629 A 일치). 결과: 피크가 자화전류 그대로인 범위 — 가이드 ≤ 25 %, 3코어 ≤ 50 %, 200 W 벤치는 정격까지(8.62 A, r.mix 0.985). ④ `bench200_sync_xl.py`: 200 W 의 t.D 270 → 220 · h 37 · ESR 50.7 · kT.pri 1.9 · Cpar 10 → 2600(→ 400, 아래 줄). 남은 차이(브릿지 · BM · R_CFG · ZCD)는 `THREE_CORE_BOARD.md` 미결 ⑧. 모르는 것: TPH3R70APL1 의 Q_g · C_iss · R_th · k_T(시트 행은 STL160N10F8 값) |
| 2026-10-18 | **c.HB 5529 → 3329 pF 정정**(사용자 "5529 는 네가 스너버 연결을 잘못 본 거라고 했잖아"). 같은 날 아침의 회로도 10-18판 검토에서 이미 C115/C117 2.2 nF 가 레그 양단(VBUS–PGND)이라 중점 용량이 아니라고 정정했는데(위 '회로도 10-18판' 줄), 오후에 두 워크북을 맞추면서 10-16 의 5529 를 그대로 옮겼다. x3m3 변형 Cpar 2600 → **400**(기생 100 + D–S 150 × 2) → 시트 c.HB 3329 · k.TT 1.95 · k.TTd 1.68 · k.dvdt 2.24, 판정 71/75; `x3m3_xl` D46 3329 · D72 400; `bench200_sync_xl` 두 번째 패스로 200 W 도 D46 5529 → 3329 · D72 2600 → 400(T.T 82.8 ns · I.R0,crit 3.60 A). x3m3 워크북 ↔ 시트 153/153 · rtc OK. 가이드 정본은 3029(기생 100, D–S 캡 없음) 그대로 |
| 2026-10-18 | **출력 뱅크 PX 6800 µF × 16 → 11**(사용자 "11개 쓸래. 16개는 쓸 수 없어"). C_out 108.8 → 74.8 mF, 리플 3.3 → 4.8 %(예산 5), 홀드업 13.3 ms(k.hold 1.11), k.CVCC 0.58 → 0.84(인계 43 ms). **개당 리플 전류 1.80 → 2.62 A rms — PX 정격 1.92 A(120 Hz / 105 °C, ≥10 kHz 계수 1.15 → 2.21 A)를 19–37 % 넘는다**; 리플은 대부분 f_sw 성분이라 1.15 쪽이 가깝다. 수명 환산은 PX 시트에 리플 가속 식이 없어 못 한다 — 보드에서 캔 온도를 잴 것. 뱅크가 줄어 플랜트 게인이 올라 3차 고조파 4.2 → 6.0 %(k.D3rd 0.83 미달) 가 됐으므로 보상망을 영점 · 극 그대로 다시 키웠다: 150 nF / 1 µF / 27 k → f_c 17.4 Hz · PM 49.2° · 3차 4.06 %(후보 120 nF / 820 nF / 33 k 는 5.06 % 로 턱걸이라 버림). 판정 71/75. `x3m3_xl` 로 워크북 D23 · F93 · F94 · F95 갱신, 153/153 |
| 2026-10-18 | **보상망 150 nF / 1 µF / 27 k → 220 nF / 1.5 µF / 18 k**(사용자 "3차 고조파 더 못 낮춰?" → 비교표 → "추천안으로"). 영점 5.9 Hz · 극 46 Hz 를 두고 2fL 게인만 내린 E 계열 여섯 조합을 빌드해 비교: 150/1000/27 → 17.4 Hz · 49.2° · 4.06 %, 180/1200/22 → 14.8 · 49.2 · 3.37, **220/1500/18 → 12.6 Hz · 48.9° · 2.76 %** · GM 37.6 dB · 버스트 문턱 FB 리플 34 mV, 270/1800/15 → 10.9 · 47.4 · 2.25, 330/2200/12 → 9.2 · 45.0(합격선) · 1.84, 470/3300/8.2 → 7.0 · 41.1(미달) · 1.28. 모델의 3차 고조파는 루프 몫만이라 실측 THD 는 브릿지 · 필터 · 입력 캡 · IC 전류 법칙 몫이 더해진다. 판정 71/75, 워크북 F93 · F94 · F95 갱신 |
| 2026-10-19 | **부하별 피크 표를 `Res. Tank Design` 으로 옮기고 줄였다**(사용자 "자화전류 수식은 어디 있나" → "수식이 너무 많고 뭐가 뭔지 모르겠다. Res. Tank Design 에 기존 양식 유지하면서 간단하게"). `Device Setting` 116–141행의 26줄 × 5열 표를 걷어내고(세 워크북을 `85da69d^` 에서 되돌린 뒤 다시 적용 — 670 W 는 `x3m3_xl`, 200 W 는 `bench200_sync_xl` 두 패스를 다시 돌림), 결과 7줄을 `Res. Tank Design` 70–79행에 기존 "Estimated transformer current" 표와 같은 양식(제목 · 3 pt 간격 · Parameters / Name / Value / Unit 머리 · 행 높이 · 글꼴 스타일 복사)으로: I.Lm.pk · I.Lm.zc · ld.add · Ilr.pk 25/50/75/100 %. 3차식 · Itrafo · Ilm · r.mix 는 계산용 `CC` 59–74행에 그 위 @Vinmin 블록 모양으로. ld.add 는 새 줄 — 2·I_lm/π 를 50 % 점의 I_trafo/부하 기울기로 나눈 근사(가이드 44.4 · 3코어 51.2 · 200 W 99.0 %, 25 % 격자 보간과 0.1–0.5 %p 차). 이전 표에 있던 부하별 OCP1 여유 줄은 뺐다(`Device Setting` D50 k.OCP1 이 100 % 를 이미 본다). `xl_sm_compare` 매핑을 새 위치로(8항목), `audit_xl` 의 가로 표 예외는 비움 |
| 2026-10-21 | **200 W 보드 기동 515 kHz — 지금 게이트 회로로 감당 가능**(사용자 질문). `gate_budget.py` 에 `bench200` 옵션(200 W 워크북 입력 + `l6790`). 타이밍: 깨끗한 ZVS 데드타임 창 70/105–378 ns, IC 최대 420 ns 에서 중점 되돌아감 7–15 V 뿐, 완전 하드 스위칭은 573 ns 이상이 필요 → 게이트 회로 원인 아님. 드라이버 f_SU 0.47 W 1 ms · 연속 최악 0.38 W(T_j 116 °C @70 °C). 약점: 부트 10 Ω × 100 nF 의 첫 HOUT 누락 가능(5.3–8.8 V < 9.3 V), R_on 0603 연속 0.12–0.15 W(정격 0.1 W). 같은 날 x3m3 계산에서 c.HB 에 D–S 300 pF 를 이중으로 더하던 것을 고침(10-18 에 시트가 포함하게 된 뒤 생긴 중복; 10-18 보고 수치는 그 전이라 영향 없음). 상세 `THREE_CORE_BOARD.md` |
| 2026-10-21 | **`gate_wave.py` — 레그 전이 시간 영역 해석, 게이트가 얼마나 늦어지나**(사용자 "게이트 저항 · 커패시턴스 · 스너버를 고려해서 게이트 펄스가 느려지는 것도 계산"). STO60N045DM9 데이터시트 그림 6(C_iss · C_oss · C_rss)과 그림 4(전달 특성)를 PDF 벡터에서 읽어 `data/STO60N045DM9_caps.json`(400 V 점에서 표와 1 % 안: C_oss 87 vs 86 · C_iss 4744 vs 4710 pF). 곡선 C_oss 의 0–400 V 전하는 1369 pF 상당으로 표의 C_oss,eq 897 pF 와 다르다 — 소신호 곡선과 대신호 값의 차로 보고 897 에 맞춘 경우를 기준으로(곡선 그대로도 출력). 첫 판의 오류 셋을 고침: 탱크 전류 부호, 운전 경우의 일정 전류(반주기마다 반전해야 함 → 자화 삼각파), 채널 제곱 법칙(문턱 4 V)은 그림 4 와 크게 달라(5.0 V 에 0.3 A) 그림 4 곡선으로; 그리고 탱크 정상 상태를 IC 에지가 아니라 실제 스위칭 순간에 맞춤(그 전에는 스위칭 전류가 20 A 로 부풀었다 → 15.7 A). 결과는 `THREE_CORE_BOARD.md`: 게이트 지연 IC 에지부터 차단 305–328 · 켜짐 +293–320 ns, ZVS 유지, 데드타임 420 ns 에서 전류 반전 여유 62–69 ns, 스너버 150 pF 는 dv/dt 를 반으로(230 Vac 기동 54 → 27 V/ns, 드라이버 내성 50 V/ns) |
| 2026-11-02 | **사용자 지적으로 정정 — 회로망을 평가 보드 값(R_g,on 22 Ω · R_g,off 2.2 Ω + 다이오드)으로 되돌리고 +19 / −4.7 V 구동으로**(사용자: "왜 온 · 오프 저항을 마음대로 바꿨나, 회로도를 줬다; 19 V / −4.7 V 를 쓴다; Q_g 는 1258 nC 아닌가"). 3.3 / 4.7 Ω 은 드라이버 전류 안에 맞추려고 내가 고른 값이었다 — 사용자가 준 회로도를 바꾸면 안 됐다. Q_g 는 표 3 의 꺾임점(Q_gs 462 · Q_gd 391 · Q_g 1377 nC, −5 → 18 V)으로 곡선을 직선 셋으로 보면 0 → 19 V 1252 nC(사용자 1258 과 같은 읽음), **−4.7 → 19 V 는 1419 nC** — 오프 전압이 −4.7 V 라 이 값을 쓴다(앞의 1200 nC 는 0 → 18 V). 시트 파일 이름은 `STGAP3SXS_Gate_Driver_Power.sm` 으로(더는 단극 구동이 아님). 결과(400 V · 20 kHz 자리값): 소스 1.04 A · 싱크 8.8 A(드라이버 최소 7 A 의 1.25배 — 최악에는 드라이버가 전류를 제한) · 다이오드 8.0 A · **t_r 3.0 µs**(22 Ω × C_eq 59.9 nF — 평가 보드의 SiC 단품용 값이라 이 모듈에서는 느림) · t_f 379 ns · 게이트 전력 0.67 W · 드라이버 0.27 W · 45 °C 에서 T_j 63 °C · R_g,on 0.35 W · R_g,off 0.22 W · Miller 여유 0.68(−4.7 V 에서도 1 미만 — 800 V 의 Q_gd 와 표 4 의 dv/dt 라 보수적, 클램프 필요) |
| 2026-11-02 | **STGAP3SXS 시트를 사용자의 SiC 하프브리지 모듈(1200 V · 1.8 mΩ · Q_g 1377 nC @ −5–18 V · C_iss 35.86 nF · V_th 1.9–4.4 V) 로 다시 계산.** Q_g(0 → 18 V) 1200 nC 는 그림 16 의 직선에서 0 V 교차(약 179 nC)를 뺀 읽은 값. 예제 회로망은 드라이버 최소 능력 7 A 안에 들도록 R_g,on 3.3 Ω · R_g,off 4.7 Ω + 다이오드(소스 4.4 A · 싱크 6.9 A · 다이오드 2.8 A, t_r 601 · t_f 398 ns). f_sw 는 미정이라 20 kHz 자리값: 게이트 전력 0.43 W, 드라이버 0.24 W(정지 0.15 W 포함), 45 °C 에서 T_j 61 °C, R_g,on 0.27 W. **0 V 오프의 Miller 판정 추가**: Q_gd 391 nC 를 800 V / 18.6 V/ns = 43 ns 에 넣으면 9.1 A, 오프 경로(2.6 Ω · C_gs 35.8 nF)로 게이트가 약 8.7 V 튐 → V_th 최소 1.9 V 대비 0.22 — 클램프나 음전압 없이는 기생 턴온. 모듈 데이터시트의 스위칭 에너지도 −5 V · 능동 Miller 클램프 조건. 모듈 내부 R_G · 시험 R_G · E vs R_G 그림은 아직 없음 |
| 2026-11-02 | **게이트 구동 손실 시트를 필요한 것만 남김**(사용자 "불필요한 내용 최대한 빼고"): 입력 16 · 피크 전류 3 + 드라이버 여유 · 상승/하강 · 손실(게이트 전력 · 출력단 · 정지 · 합계 · R_g,on · R_g,off) · 25/45 °C 접합 온도만; 다이오드 정격 · 병렬 수 · V_L · 클램프 · UVLO · 주파수 판정 · 주석은 뺐다(161 → 71 리전, 5 → 3쪽). 중간값은 접힌 블록 하나. **함정**: `Sheet.set()` 은 파이썬에서만 계산하고 .sm 에 정의를 쓰지 않는다 — 처음 판은 SMath 에서 R.path_on 등이 미정의였을 것이고 `check_sm` 은 이것을 못 잡는다; 접힌 블록의 `pack()` 으로 바꾸고, 모든 피연산자가 사용 전에 정의되는지 따로 확인(0건) |
| 2026-11-02 | **STGAP3SXS 데이터시트(DS14758 Rev 3) · 평가 보드(DB5386 Rev 2)로 같은 시트를 채움.** 평가 보드 게이트 단도 GOUT – 22 Ω ∥ (STPS2L40ZFY + 2.2 Ω), SOFTOFF 10 Ω, 외부 Miller 클램프 STL7N6F7 이라 같은 회로망. 드라이버 손실에 VH 정지(6 mA max)와 로직측 VDD(IN+ 고 13 mA max)를 넣자, 예제(Q_g 210 nC · 18 V · 85 kHz)에서 **정지 전류가 0.15 W 로 스위칭 몫 0.043 W 의 3.4배** — 합계 0.19 W, 접합 +12 °C(65 °C/W). 2.2 Ω 턴오프 경로에서 싱크 피크 6.6 A(드라이버 최소 능력 7 A, 여유 1.06) · 다이오드 피크 6.0 A — 1N4148 급이 아니라 2 A 쇼트키를 쓰는 이유. 18 V 는 VH UVLO on 최대 14.3 V 의 1.26배. 상승 시간 계수는 2.2 → ln(9) 로 명시 |
| 2026-11-02 | **같은 시트를 단일 출력 핀(STGAP3SXS) 회로망으로 개정**(사용자: "게이트 출력이 핀 하나, 다이오드 + Off 저항과 On 저항으로"). 턴오프는 R_g,on ∥ (R_g,off + V_F) — 예제(15 / 7.5 Ω, V_F 0.7 V, 18 V)에서 싱크 피크 2.70 A(다이오드 1.77 A · R_g,on 0.93 A), 하강 187 ns(다이오드 없이 424 ns), 드라이버 0.045 W. STGAP3SXS 데이터시트는 st.com 503 · Mouser 503 으로 못 읽었고 DigiKey 목록에는 "6 A, 10 A"(소스 · 싱크 구분 없음) · 지연 95 ns max 정도뿐 — 드라이버 칸은 `[TBD DS]` 자리값으로 두고 값을 만들지 않았다 |
| 2026-11-02 | **양전압 게이트 구동 손실 · 전류 시트 Gate_Driver_Power_Unipolar.sm(지금 이름 STGAP3SXS_Gate_Driver_Power.sm) — `build_gatepower_smath.py`**(사용자가 올린 21082025_Gate_Driver_Cal.sm 과 비슷하게). 옛 시트의 계산을 그대로 두고(재현 확인) 고친 것: ① "PD" = Q_g·V·f_sw 전부를 드라이버 발열로 본 것 → 드라이버 출력 · 외부 R_g · 내부 R_G 비로 나눠 드라이버 몫만(예제에서 0.321 → 0.037 W, 접합 상승 38.6 → 4.4 °C) ② 상승 · 하강 시간을 C_iss 로만 본 것 → C.eq = Q_g/V(Miller 포함, 예제 11.7 nF vs C_iss 4.3 nF → 411 / 231 ns) 를 함께 ③ 라벨 "Gate Sink Peak Current at Rising" → falling ④ 정지 전류 · 채널 수 · 병렬 수 · 저항 손실 · T_j,max 여유 · 허용 최고 주위 온도 추가 |
| 2026-10-27 | **무부하 AC 기동 VDS 230 Vac 약 650 V · 110 Vac 약 280 V(R_CS 40 mΩ)** — 피크가 2 × 버스(651 / 311 V)라 전류가 아니라 버스 전압에 비례: 레그 국부 용량 2.2 nF 의 전하(0.72 µC)가 바디 다이오드 Q_rr(1.16–2.8 µC)보다 작아 하드 커뮤테이션 때 레일이 꺼졌다 넘치는 모양(확인 전). V_(BR)DSS 600 V 초과 → 230 V 시험 중단, 국부 47 nF × 2 + 220 nF × 2 를 레그로, R_on 22 Ω, FET 점검. `THREE_CORE_BOARD.md` |
| 2026-10-27 | **200 W 벤치 기동 링잉 후속 — `THREE_CORE_BOARD.md` "기동 링잉 후속 벤치".** 게이트 입력 RLC 필터는 6.5 MHz(= VDS 링, 12.8 MHz 아님)에서 ×0.40 뿐이라 효과가 작았고, 강화는 데드타임 손실(L6498 문턱 비대칭) 때문에 하지 않는다. 110 Vac 기동 ±30 A @ 400 kHz(OCP2 의 96 %, 모델 21.4 A 와 1.4배 차이 — 원인 미확정) → 기동 주파수를 낮추자던 제안 철회, C_T 330 p / R_T 13 k 로 올림(링 약간 감소) — 대신 R_on 47 Ω 에서 기동 게이트 판정 둘이 CHECK, 22 Ω 권장(1608 정격 초과 가능). R_CS 증가로 링 감소는 OCP 제한 효과로 보며 200 W 시험 한정(36 mΩ 까지), 670 W 에는 불가. 미결: 47 nF 장착 여부 · 링 L/C 실측과 RC 감쇠기 · 실제 f_SU 와 기동 데드타임 · 30 A 원인(L_r 실측) · 기동 구간 OCP1 동작(ST) |
| 2026-10-22 | **게이트 드라이버 · 기동 검사의 SMath 쌍둥이 `Smath/tools/L6790A_gatedrive_x3m3.sm` — `build_gate_smath.py`**(사용자 "Smath 시트도 새로 수정한 엑셀에 맞춰서 새로 하나 만들어줘" → 첫 판을 가이드 입력으로 만들자 "3코어용에다가 적용하라는 뜻; 게이트 드라이버는 L6498 하나만 쓸 것처럼 행동하지 마, 이번에만 쓰는 것" — 3코어 670 W 워크북 입력(f.Max 348.61 · f.SU 526.38 kHz · c.HB 3329 pF · I.Lm.pk 12.77 A · 70.5 nF / 10 µH)으로 다시 만들고 드라이버 · 다이오드를 "이번 빌드" 라벨의 데이터시트 값 블록으로; 가이드 판은 인자로만). 3코어 판정: k.tD.su 1.113 · k.Miller 1.28 · P.drv 0.69 W(Tj 108 °C @ Ta 25) · I.su 12.53 A(k.su.OCP1 1.83) 등 워크북과 같음. 워크북 행(스위치 게이트 데이터 · 드라이버 · 다이오드 · 회로망 한계와 선정 · 결과 12 판정 · 기동 I.su 와 OCP 여유)을 같은 식 · 같은 이름으로 10절 347 리전 A3 14쪽에. 다른 점은 SMath 가 강제하는 하나 — 선정값 여섯을 먼저 넣고 한계를 뒤에서 대조(워크북은 한계와 선정이 나란히 서로 참조). E12/E6 반올림과 IF 분기는 못 옮기므로 반올림 전 값 + 라벨 주석, 설계대로 고정 분기(D.off 장착 등); 한계를 바꾸는 IF 둘은 `abs()` 계단 `s.M` · `s.hold` 로 재현. 빌더 자체 검사: LibreOffice 재계산 워크북 값 **82개 전부 일치**(3코어 · 가이드 둘 다)(2e-4). **첫 빌드에서 12칸 불일치 — 원인은 본 시트 빌더에서 복사한 `MIN`/`MAX` 보조 함수**: 인자 · 결과에 괄호가 없어 `x/MIN(a,b)` 가 `x/(a+b-|a-b|)/2` 로, `MAX(0, a-b-c, 'ohm')` 이 `c/'ohm` 만 나누는 식이 됐다(i.M 이 1/4, R.on.min 10.7 Ω 등). 새 빌더는 감싼다; 본 시트는 인자가 단일 변수뿐이라 영향 없음(`mismatches 0` 유지) — 앞으로 합이나 나눗셈을 넣을 때 주의. `check_sm` OK · `audit_dim` 표시 단위 불일치 0 |
| 2026-10-22 | **게이트 드라이버 선택 · 기동 조건을 세 워크북에 — `gate_xl.py`.** 아홉 차례 다시 짰고(①–⑨ 은 이전 기록) 마지막에 **전체 검토**(사용자 "엑셀 전체 검토하고 틀린 거 수정"). 재계산 사본에서 모든 수식 셀을 훑어 오류 값 0, 문자 결과는 ST 원본의 안내문뿐; `CC` 77–167 의 중간 계산 92줄을 식과 값으로 다시 확인. **고친 것**: ① 부트 다이오드 — R.boot.min(0.46 Ω)이 선정 0 Ω 보다 큰데 k.D.boot 는 OK 로 나오던 모순: 다이오드 동저항 0.5 Ω 가정을 CC 상수 `R.d.boot` 로 꺼내고 I.boot.pk · τ.boot · C.boot.max · R.boot.max · R.boot.min 모두 (R.boot + 0.5 Ω) 로 통일 → R.boot.min 0, 제안은 max/2 가 min 아래면 min 의 E6 위로 ② `k.drv` 에 박혀 있던 L6790A V.OH 4 V 를 CC 상수로 ③ Res. Tank Design I.su 에 f.SU ≤ f.r 보호 ④ R.on.max 라벨을 "가장 짧은 온 펄스" 로(식은 기동 · f.Max 중 짧은 쪽) ⑤ CC 제목의 행 번호. **남겨 둔 것(의도된 것)**: `audit_xl` 의 F83 1.0 > 0.84(제너 레귤레이터), F91 220 k > 208 k(2026-09-25 R.ZCD_H 선정, OVP1 28.93 V), D44 라벨 max / 식 MIN(허용 최대 = 두 한계의 작은 쪽, 맞음), D62 · D127 이 빈 F 를 읽는 것(ST 양식). 세 워크북 기존 셀 전부 같은 값, `xl_sm_compare` 153/153 · `bom_compare` 29/0 · `rtc_check` OK. 끝으로 사용자 "새 파라미터 이름이 너무 길다" → 새 행 라벨 전부를 시트의 기존 어투로 줄였다(최장 110 → 57자; 예: "Maximum turn-on resistor (10 V within the pulse)", "Driver current margin (>1)"), 이름 셋도 I.G.on.pk → I.g.on · I.G.off.pk → I.g.off · V.RRM.need → V.R.boot. **같은 날 테스트 리포트(10-16 덱) 기동 확대 파형 재판독**: 전이마다 전류 방향 정상(12–14 A) — "켜기 전 전류 반전" 가설 철회. 기동 패턴이 비대칭(HS1 약 0.6 µs, 레그 1 이 0.57 µs 먼저 전환)이라 HS1 이 피크 전류를 혼자 끊고 버스가 12.8 MHz 로 0–340 V 진동(C115 장착 상태 → 링 용량은 FET 쪽, 루프 약 150–260 nH 추정), 그 뒤 약 180 ns 에 HS1 이 약 95 ns 재도통 — 상세 `THREE_CORE_BOARD.md` |
| 2026-10-17 | **LG 트랜스포머 코어 정정 — 유닛당 EE6405 두 세트 · 창 1.4 mm**(§5.2b). 사용자 "같은 코어는 안 되나" → 승인원 재독: 보빈 구멍 8.5 × 68(= 2 × 33.5) · 본드 면적 3216 = 2 × 2 × 24 × 33.5 → 유닛 유효 A_e 226 mm²(x3m3 의 225 와 같음, 2 T · 193 kHz 에서 72 mT) · 요크 1.6 / 다리 0.7(IEC 환산 108 ≈ 113, 요크 제한) → 창 24 × 1.4 mm. 결론: 자속은 되나 2+2 T 2차(포일 4장 2.0 mm) · 1차 1.5–1.8 mm²(다발 ø2.1 이상)가 창에 안 들어간다 — `THREE_CORE_BOARD.md` 같은 날 문단. GP98 손실 곡선은 못 찾았다. |
| 2026-10-17 | **670 W 트랜스포머 스펙 정리 — 변형 `7p5to1_x3m3`.** 2차 2 T 유지 + TDK ELP 43/10/28(A_e 225) 3개 + 193 kHz. 정본 정규화 탱크를 193 kHz 로 환산하면 k.ZVS 0.96 — T.ZC 가 주파수에 반비례하고 Z_0 ±1 Ω 에 붕괴한다는 것을 `l6790.sweep` 스윕으로 확인, 75 nF / 9.1 / 15 µH(λ 0.607 · Z_0 11.0)로 k.ZVS 1.73 · 판정 71/75. 유닛당 L_open 8.03 · L_lk 3.03 µH · A_L 321 nH · B_pk 72 mT · 1차 TIW-Litz ≥ 3.0 mm² · 2차 ≥ 2.5 mm². 누설 3 µH/유닛은 5 T 로 빠듯 — L_r 8–11 µH 허용 + 외부 인덕터 자리. 기록 `docs/THREE_CORE_BOARD.md` "세 번째 안" |
| 2026-10-16 | **LGE 회로도 · 구버전 워크북 · 테스트 덱 수령 → 워크북 이식.** LGE 의 ST 구버전(시트 보호) 워크북은 원본 레이아웃 그대로이고 상수 36칸만 다르다 — `lge200_xl.py` 가 그중 17칸을 벤치 사본 위에 얹어 `L6790_workbook_7p5to1_measured_LGE_200W.xlsx` 를 만든다(Vin.min 180 · Vrect 0.395/STPS30M60S 는 제외, 사유는 스크립트 머리말). LibreOffice 재계산으로 LGE Excel 캐시와 대조: 같은 입력은 일치하고 rev0_6 의 차이(f_Min/f_Max/f_SU 의 250 ns 상수 110.4/333.7/514.6 vs 108.1/312.9/466.5 kHz · 합성 피크 8.63 vs 5.47 A · FB 코너 k.CT · 정지 소자 손실 3.75 vs 100.6 W)만 다르다. 회로도에서 ZCD 아래 18 k + 1 k = 19 k · BM 접지 · 중점마다 2.2 nF 스너버(c.HB 를 LGE 의 500 pF 대신 2929 + 100 + 2200 + 300 = 5529 pF 로 — D–S 150 pF 는 회로도에 N.C. 이나 모든 FET 에 실장) · VCC 18 V 와 SR 12 V 모두 외부 공급 · 보조 3 T 를 읽었고, 덱에서 230 Vac 기동 때 HB1 MOSFET 파손을 확인했다. 10-17: c.HB 5529 pF(C_oss + 2.2 nF + D–S 150 pF × 2) · 옵토 UPC1008 CTR 0.54 / 0.65(UTC DS I_C–I_F 곡선, 등급 최소) · V_Z 14.5 V · C_F 2.3 µF 반영 — 새 옵토로는 보드 보상망이 typ 에서 PM 43° · 3차 6 % 라 470 nF / 4.7 µF / 10 k 를 권장 → 사용자가 채택(사본에 반영), 12V_FB 분압 R197 130 k → 100 k(11.74 V) 도 결정; R_B 6.2 k 판정은 옵토 LED V_F 실측으로(≤ 1.15 V 면 유지, 아니면 4.7 k + 680 nF / 6.8 µF / 6.8 k). 같은 날 앞선 절: 657.5 W 손실 예산 ⑥–⑨(주파수 반감 이득 1.3–4 W · 85 → 93 % 의 분해 · EVK 240 W 비교 · 13 %p 분해). 기록 `docs/THREE_CORE_BOARD.md` "LGE 자료 2026-10-16" |
| 2026-10-01 | **(78차) PQ 50/50 설계를 저장소 정본으로, 옛 설계 삭제.** 사용자: "PQ50을 정본으로 유지하고 옛날 것들은 지워. Variant안에 PQ50용만 만들어서 남겨놔." (경위: 사용자가 PC 로컬 클론을 지우고 다시 받은 뒤 루트의 옛 E 60 판 PDF 를 열어 "업데이트가 안 돼 있다"고 함 — 같은 이름의 AN 이 루트와 `PQ50/` 두 곳에 있었다.) **지우기 직전 상태는 이 브랜치의 커밋 `0821491`**(태그 `archive/before-pq50-root` 를 만들었으나 push 가 HTTP 403 으로 거부됐다 — 이 세션은 작업 브랜치에만 push 할 수 있다). ① `PQ50/` 의 `CLAUDE.md` · `Calculation Excel Sheet` · `Design Guide` · `Smath` · `docs` 를 루트로 올리고 옛 루트 것(E 60/22/16 · L_r 11 µH, 한국어판 AN 포함)과 `Lr14/`(ETD 54) 를 지웠다. 입력 폴더(`Datasheet` · `EVB Schematic` · `LGE Material` · `Reference`)와 `.claude/` 는 루트 것 그대로 — `PQ50/` 안의 같은 이름은 루트로 가는 심볼릭 링크였다. HISTORY 는 루트 · Lr14 의 줄이 전부 이 파일에 이미 있음을 줄 단위로 확인. ② **설계점은 `7p5to1_x1` 하나**: 빌더 `VARIANTS` 와 기본값, `build_trans_spec` · `check_trans_spec` 의 변형 목록, `cores.py` 의 PQ 40/40(코어 3개 자리표시자용) 삭제. 정본 시트가 코어 3개 자리표시자(N.x 3 · N.p 5 · A.e 113.1, `k.Ae` 0.543 미달 → 40/44)에서 PQ 50/50 한 개(N.x 1 · N.p 15 · A.e 332, `k.Ae` 1.594 → **41/44**)로 바뀌었고 `variants/L6790A_7p5to1_x1.sm` 과 같은 바이트. 지운 변형 파일: 시트 `6to1` · `7p5to1` · `8to1`, 워크북 `6to1`(+BACKUP), 사양서 `6to1` · `7p5to1` · `8to1`. 워크북 사본은 `L6790_workbook_7p5to1_x1.xlsx` 로 이름만 바꿈(정본 워크북과 같은 파일). 옛 설계 전용 일회성 스크립트 `etd54_xl.py` · `lr14_xl.py` · `fix_xl_aux2t.py` · `fix_xl_suend.py`(6:1 워크북을 함께 고치던 것, 이미 적용됨) 삭제. ③ 워크북이 새 정본과 맞는지: LibreOffice 재계산 사본으로 `xl_sm_compare` **145/145** · `rtc_check` OK(재계산 안 한 원본은 캐시가 낡아 `rtc_check` 14건 — 열었다 저장하면 맞는다), `bom_compare` 29/0. 사양서는 다시 만들어 셀 110개가 전과 같음을 확인. ④ 문서: CLAUDE.md 머리 · 파일 지도, DESIGN.md 1.3 권선비 · 보조권선, 4.2 5d(코어) 갱신 · 5e(6:1 `k.NRCS`) · 11(3코어 PQ 40/40) 삭제, 8b 게인 피크 수치를 이 탱크로 다시 계산(λ 0.556 · Q_pk 0.863: 피크 54.1 kHz · 경계 56.6 kHz · 피크 위상 −7.8°; 전에는 ETD 54 탱크 값 51.6 · 53.9 kHz · −8.3° 가 "이 탱크"로 적혀 있었다), README, `.claude/rules/figures.md` 의 E 60 보빈 문장 |
| 2026-10-01 | **(79차) 디렉토리 정리.** 사용자: "지금 디렉토리 구조 깔끔하게 다시 정리해줘. 너 임의대로." 맨 위 폴더 이름은 그대로 뒀다 — 스크립트 80여 개가 상대경로로 쓴다. ① `Design Guide/figures/` 루트의 PNG 100장 중 아무도 읽지 않는 75장 삭제(AN 그림의 제목 붙은 사본 · 옛 교육자료용 참고문헌 잘라낸 그림 `mps*` · `ref_*` 등). 남긴 26장: 한국어 본체 문서 그림 19 · SMath 시트 그림 3 · `figedit.py` 원본 4. AN 이 읽는 `figures/an/` 은 손대지 않았다. ② SMath 진단 · 시험 시트 5개(`probe` · `ruler` · `gainzed` · `gainladder` · `gainplot`)를 `Smath/tools/` 로 옮기고 빌더 5개의 출력 경로를 바꿨다 — 파일은 바이트 그대로(지금 빌더로 다시 만들면 4개는 내용이 달라진다: 빌더가 그 뒤에 바뀌었다. 이번 일과 무관해 다시 만들지 않았다). `Smath/` 맨 위에는 정본 시트 하나. ③ `Reference/` 의 옛 코어 데이터시트 4개(ETD 49 · ETD 54 · PQ 32 · PQ 40) 삭제, PQ 50/50 데이터시트 파일 이름의 부품번호를 내용대로 고침(B65891A/B65892E → B65981/B65982E, 2022-10). |
| 2026-10-01 | **(80차) 한국어판 AN 을 영문판 V1.3 에 맞췄다.** 사용자: "한국어 번역판도 이제 만들자. 한국어 원어민이 이해하는 문체로, 어색하고 잘 쓰지 않는 표현은 지양, 전문 용어는 영어로." 옛 한국어판은 59차(E 60 시절) 영문판에 맞춰져 있었다. 영문판의 절 111개를 59차 영문판과 비교해 **58개는 그대로**(옛 한국어 문장 재사용), **변경 46개는 바뀐 문장만 고쳐 옮기고**, **새 절 8개**(6.18 안전 절연, 6.26 보조 권선 V<sub>CC</sub>, 7.9 트랜스포머가 갖춰야 할 값, 7.10 코어 고르기, 7.11 권선과 핀, 7.12 이 트랜스포머의 안전 절연, 7.13 자속 확인과 사양서, 7.24 보조 권선 V<sub>CC</sub> 설계 결과)는 새로 썼다. 사라진 절 4개(옛 트랜스포머 설계 결과·코어와 권선·절연 마진·HVSU) 삭제. 영문판과 그림·표·식 호출 285개가 같은 키, 같은 순서(대조 스크립트로 확인). `insulation.checks()` 의 영어 표 칸은 `_kr_ins()` 문형 대응표로, `cores.tap_text()` 의 "and" 는 "·" 로. `_idle700_kr()` · `_thinnest_kr()` 를 새로(영문판과 같은 판정, 문장만 한국어). 옛 한국어판에 남아 있던 이번 탱크와 안 맞는 문장 1건(700 ns 에서 f<sub>Max</sub> 가 "못 미친다" — 실제는 넘는다)을 계산 결과로 고르게 고쳤다. 숫자 뒤 조사 검사(끝자리 받침 대조)에서 손으로 적은 조사 7곳을 `_nj()` 로 바꿨다. `an_kr_pdf.py` 개정 이력 V1.3 · 표기(영문판과 같은 항목) 갱신. 검증: `an_check` 기하 문제 0, PDF 텍스트에 포맷 잔재 · 대체 문자 0, 영어로 남은 줄은 참고문헌 제목뿐. 7.9–7.13 · 6.25–6.26 · 7.2–7.4 · 7.24 를 PDF 텍스트로 읽어 확인 |
| 2026-10-04 | **(84차) 전체 회로도 — A4 가로 한 쪽에 돌려 넣는 판으로 완성 · 게이트 턴오프 경로 · 부품 확정 · AN 재빌드(123쪽).** 회로도 반복(사용자 지시 → 수정 → PNG 전송, 열 번 넘게): SR 단 좌우 대칭(MOSFET 이 권선 옆, U7 오른쪽) · 드레인 버스를 1차 배선 높이에 · SR 단 세로 30 % 확장 · 센터탭 접점 제거(`X.nodot`) · 1차/2차를 코어 선에서 딱 나눔(글자만 넘어도 됨 — 사용자 답) · 보조권선 레귤레이터 한 접점(C_aux · Q_VCC 컬렉터 · R_BZ) · Q_VCC 를 열 왼쪽, 베이스 리드 2배 · U1 폭 +10 %, L6498 −10 % · 핀 이름이 모서리에 안 붙게 상자 확장 · IC 이름은 상자 밖(U2/U3) 또는 넓힌 안쪽(U7) · 레퍼런스 Q4A/Q4B(옵토 LED/TR, SFH617A-2) · Q5/Q6 TL431B · 레일 전압 표기 · 전해캡 극성 표시. **부품**: NPN 은 MMBT2222A(250 mW) → BCP56(1.44 W 에 부족) → PHPT61003NY(사용자: 너무 큼) → **FZT651**(Diodes DS33149 Rev 7-2: 60 V 3 A, 50×50 mm 2 oz 에 41.7 °C/W, T_j 150) — Q_VCC 허용 주위 62 °C(25×25 mm 면 18 °C), Q_SR 54/90 °C. 시트 §14c.5 신설(열, `T.a = T.j − R.th·P`). TL431 은 R_B 창이 좁아(k.RBZ_hi: B 1.020 · A 1.012 · 무등급 0.998) **둘 다 B 등급**. **TEA2095TE VCC 는 10 Ω + 100 nF RC**(사용자) → 100 nF 만으로는 레그 한 쌍 충전에 1.63 V 꺼져 k.SRpin 0.915 → **2.2 µF 병렬**(사용자 선택, k 1.045, ΔV.RSR 0.94 V). I_VCC 의 ×4 는 동시 구동이 아니라 **주기당 평균 전하 4개분**이라고 설명. **게이트 턴오프 경로**(사용자: "Turn-on Turn-off 따로"): R_G 4.7 Ω 에 반병렬 **D_G,off 1N4148W + R_G,off 2.2 Ω** — I_pk 0.83 A(싱크 k 1.86 · IFSM 2 A k 2.4), 평균 35 mA(k 8.6), 플래토까지 101 ns(R_G 단독 117, 1.15×), s.drv 0.564 → P.drv 0.576 W(k 1.736). 시트 §14c.1 에 12행. **A4 비율**(사용자: "A4용지 가로로 돌렸을 때와 맞아야"): 그림은 56.7×43.0(1.32)이었고 AN 글 틀은 672×471 pt(1.426) — PNG 가 축 상자 + 0.14 in 여백이므로 **W 61.9 · xlim −0.35 에서 PNG 2252×1579 = 1.4262**. 늘어난 폭은 드라이버 +1.0 · V_CC 수직선·T1 +2.0 · 2차측(SR 레그 간격 6.0, U7 가장자리 여백 1.0, 출력·피드백 열 +2.4~4.6)에 배분, 기호 배율은 56.7/W 로 역보정. 글자 8.4/8.6 → **9.1/9.3 pt**(인쇄 배율 0.70 에서 6.5 pt), `_ic(pdy)` 로 핀 번호를 리드에서 띄움. **AN**: `an_pdf.FigPage`/`figpage()` — 틀 전체를 요구해(`wrap` 이 남은 높이가 아니라 틀 높이를 돌려준다 — 처음엔 187 pt 자투리에 들어갔다) 90° 회전, 캡션은 오른쪽 여백에 세로로; `figcheck._placement` 는 figpage 폭을 틀 높이로, `an_check` 는 돌린 쪽의 비율·여백 캡션을 인정. 본문: 7.18 턴오프 경로 문단 · 표 행 · 7.26 끝 "The LED rail V_Z"(16.1b) · 7.28 "The parts"(FZT651 · BZT52H-C15 · 1N4148W 열) · 7.20 Q_SR 열 · 7.33 전체 회로 한 그림 · 부트스트랩 다이오드 열린 항목을 ES1J 로 · 기호표 6행. `_q.setdefault(_k, A._builder_const(_k))` 가 키가 있어도 상수를 찾다 KeyError — `if _k not in` 으로. an_check 0 · an_symbols MISSING 0 · an_figtext 새 그림 미정의 0(기존 63) · figcheck 0 · figstamp 62. **한국어판은 81–84차 미이식.** MJD31C 데이터시트는 받지 못해(onsemi · ST · Mouser 차단) 쓰지 않았다. **전수 재검토(사용자: "다시 한번 PDF 전수로 읽어보고 … 오류 · 가독성 · 빠진 중요 정보")** — 123쪽을 쪽 그림으로 전부 읽었다. 고친 것: ① 그림 20 범례가 파형 위에 얹힘 → 축 위로 ② 그림 12 카드 · 그림 26 제목의 ASCII `->` → `→` ③ 그림 45 PNG 의 위아래 17 % 공백 → 높이 6.6 → 4.6 in, 오른쪽 패널 창을 키워 받침판이 잘리지 않게 ④ 규약 4줄이 3쪽에 홀로 넘어감 → 규약을 새 쪽으로 ⑤ 개정 이력 V1.3 에 84차 내용 ⑥ 6.25 식 43 의 싱크 항은 턴오프 경로가 있으면 R_G,off 라고 명시 + "Turn-off has its own path" 문단(다섯째 점검) ⑦ 6.31 V_Z 는 제너가 아니라 션트 레귤레이터임을 밝히고 7.21 로 연결 ⑧ 표 6 게이트 드라이버 · 레귤레이터 행에 ES1J · 1N4148W · FZT651 · BZT52H-C15 ⑨ 표 7 에 R_G,off · ES1J · V_CC,SR 팔로워 · V_Z 행 ⑩ 표 22 에 Q_SR + TEA2095TE 손실 1.44 W 행(합계 26.65 → 28.09 W, 메모 문장도 같은 합) ⑪ 표 23 게이트 드라이버 행에 턴오프 다이오드 ⑫ 7.31 끝에 **배치 규칙 7항**(R_CS 켈빈 · 게이트 루프 · 드라이버 디커플링 · L6790A VCC · SR 센스 · 패스 TR 패드 · 피드백 접지) ⑬ 7.33 에 **레퍼런스별 부품표(표 34, 17행)** — 값은 전부 시트/`V` ⑭ 참고문헌 6건(FZT651 · 1N4148W · ES1J · BZT52H · TL431 · SFH617A) ⑮ 열린 항목 4행(턴오프 다이오드 반복 피크 정격 없음 · FZT651 h_FE 시험조건 · SR 게이트 0 Ω · 옵토 CTR pick) ⑯ 기호표에 R_G,SR. `&#8741;`(∥)는 본문 서체에 없어 네모로 찍힘 → 'in parallel' 로. an_check 0 · an_symbols MISSING 0 · figcheck 바뀐 4장 0 · figstamp 전부 현재. 124쪽. **다이오드 크기(사용자: "너무 크거나 작은거 있으면 조정")**: 다이오드는 크기를 기록하지 않아 figcheck 가 못 보던 기호였다 — `schem.diode` · `figs_ref._diode_along` · `schemx.vdiode`(MOSFET 바디 다이오드는 `kind=None` 으로 제외)에 `note_symbol('diode')` 를 심고, 지면 pt 로 환산하는 `diode_survey.py` 신설. 결과: 모드 시트(기준) 16.1 pt · 그림 1 13.8 · 게이트 구동 16.6 · TL431 op-amp 16.0 · 플라이백 비교 16.5 — 적정; **그림 15 (R_ac) 10.5 · 그림 20 (정류기) 7.9 · 그림 21 (부스트) 7.1–8.3 pt 가 절반 크기** — 폭이 작은 그림에 기호 규칙(`schemx.scale`)이 0.67 배를 주기 때문. `ax._sym_mult` 1.3 / 1.4 / 1.5 로 올려 13.6 / 11.0 / 10.7–12.4 pt(커패시터·저항도 같이 커짐), 겹친 라벨(C · C_out · R_L↔V_out) 이동. 전체 회로도 7–8 pt 와 그림 50 11.5 pt 는 그 두 그림의 기호 계열(사용자가 20 % 축소를 지시)이라 그대로. **이어서(사용자: "figure 50도 전체 회로도에 나온 SR 회로를 참고해서 더 깔끔하게")**: 전체 회로도의 SR 단 · 팔로워 · 보조 기호 클로저를 모듈 함수 `_sr_stage` · `_sr_follower` · `_kit` 으로 떼어 **그림 50(`an_sr_ctrl`)이 같은 코드로 그린다**(좌표는 XC · YDA · YDB 기준 상대값; 기호 배율은 축 폭에 맞춰 `0.47·56.7/span` 로 같은 크기, 글자 10 pt). 리팩터링 뒤 전체 회로도 PNG 는 픽셀 단위로 동일함을 확인. 옛 두 장짜리 `an_full_pri` · `an_full_sec` · `_sr_block` 삭제(AN 이 더 안 읽는다). 전체 회로도: 글자 9.1/9.3 → **9.3/9.5 pt**(figcheck 가 figpage 인쇄 배율 0.71 로 164건 6.4 pt 를 잡았다) → 핀 번호를 `_ic(pdy)` 로 리드·상자 가장자리에서 0.16 띄우고(위·아래·옆 모두), L6498 상자 4.0 → **4.8**(SGND/PGND 이름이 붙음), 부트스트랩 열 +0.24, R_G/R_G,off 값 0.72 띄움. figcheck 2장 0 · figstamp 60 · AN 재빌드(123쪽) an_check 0 · an_symbols 0. **기호 크기 2차(사용자: "방금 키운 부분 브리지 다이오드 빼고 너무 커. 20 % 줄여. figure 1 과 그것을 차용한 그림들도")**: 그림 20 · 21 은 브리지만 1.4/1.5 에 두고(`_mains_bridge(bridge_mult=)` 가 브리지를 그리는 동안만 `_sym_mult` 를 바꾼다) 나머지는 1.12/1.2, 그림 3 은 1.04 — 다이오드 11.0 / 9.9–10.7 / 10.9 pt. 그림 1 과 모드 패널(그림 6 · 7, `figs_modes8._skeleton` 공유): 소자(스위치 묶음 · 정류 다이오드 · 커패시터 · 부하)를 **0.8 배**(DEVH 1.80 → 1.44 · DX_D/DX_C 0.64/1.20 · 게이트 리드 0.80 · 다이오드 0.448 · C_r 0.24 · C_out 0.256 · R_L 0.37×0.92) — 그림 1 다이오드 13.8 → 11.0 pt, 모드 패널 16.1 → 12.9 pt. 자성체(L_r · L_m · 권선)는 탱크 레일 간격과 턴 반경 0.21 에 묶여 있어 그대로. **MOSFET 기호 통일(사용자: "전체 회로도의 MOSFET 기호를 가져가 바디 다이오드 없는 MOSFET 전부 대체")**: `schemx.MOS_PLAIN = dict(body=True, coss=False, ox=1.35, wx=1.7, arrow=1.5)`(전체 회로도의 비례) · `MOS_SHAPE`(비례만) — 그림 1(`_skeleton(body=True)`, C_oss 는 여전히 모드 패널만) · 그림 21 Q · 그림 (플라이백 대 LLC) S · S1 · S2 · 게이트 구동 S1 · S2 · 모드 패널 · 전체 회로도 · 그림 50 이 전부 이 하나를 읽는다. 그림 1 의 i_S1 화살표는 바디 다이오드 바깥(XL + DX_D + 0.30)으로. f15–f17 의 상자형 스위치(S1–S4 라벨 상자)는 MOSFET 기호가 아니라 그대로 두었다. **그림 33(DC 중첩 벤치)**: 계측기 상자를 권선 단자 높이에 맞춰 리드가 직선 한 가닥(이전엔 직각 4번). figcheck 13장 0 · diode_survey 로 확인. **이어서(사용자: "MOSFET 에 G·D·S 가 아예 붙어버린 게 또 보이고, 플라이백–LLC 그림은 V_in 과 S1 · 플라이백의 S 와 GND 가 너무 가까워 배선이 지저분")**: `diode_survey.py --kind mosfet`(MOSFET 도 `note_symbol` 로 기록) — 모드 패널 39.9 pt · 게이트 구동 36.3 · 그림 1 24.7 · 전체 회로도 26.7–30.9 · **그림 21 Q 는 h 1.40 으로 18 pt**: 세 채널 막대의 0.16 u 틈이 획 2.3 pt 의 projecting cap(양 끝 획 절반씩)에 먹혀 한 기둥으로 보였다. 고침 ① `schemx.mosfet` 의 세 막대를 **butt cap** 으로(틈이 획 폭에 안 먹힌다 — 모든 MOSFET 공통) ② 그림 21 Q 를 h 2.0 · 게이트 1.25(26 pt) ③ 플라이백–LLC: S1 · S2 를 h 1.6 으로 각자 반쪽 구간 가운데에(V_in 레일까지 0.1 → 0.58), 플라이백 S 도 h 1.6(GND 레일까지 0.3 → 0.5) — 리드는 기호 반환점에서 긋는다. **사용자: "figure 17 플라이백 다이오드도 너무 커. 20 % 줄여. 다시 모든 내용 전수검사"** — `_sec()` 가 다이오드만 패널 배율의 0.8 로(16.5 → 13.2 pt; 커패시터 · 부하는 그대로). 전수 읽기(124쪽 전부, 100 dpi 렌더): 고친 것 ① 표 8 메모 — 가장 얇은 통과 여유가 C_VCC(1.039)로 바뀌었는데 뒤따르는 "thin by construction" 문장은 SR 게이트 구동(1.040) 얘기라 두 문장을 분리하고 C_VCC 행도 굵게 ② 7.13 "14 A (14.0 A rounded up)" — 반올림이 없을 땐 괄호를 안 쓴다 ③ 7.21 `(check: 1)` → `(must be 1)`. 그 밖에 그림 · 수식 · 표 · 캡션에서 고칠 결함 없음(69 · 93 · 100쪽의 그림 앞 여백은 그림이 통째로 넘어가서 생긴 것으로 그대로). **사용자 질문 "한 사이클에서 벅이었다 부스트였다 하는 거냐" → 7.7 보강**: 그림 40 · 표 12 가 전부하 기준이라는 말과 **정확한 위상 구간**이 없었다. M = 1 은 Q 와 무관하게 f_sw = f_r 에서 일어나므로 경계는 **sinθ = M_pk**(부하 무관) — `an_pdf._fsw_crossings()`(V['fswCross']: M_pk · θ₀ · 반주기 비율)와 `fswPkLight`(25 % 부하 피크 f_sw, `_fsw_peaks(load)`). 7.7 첫 문단에 규칙, 표 12 에 M_pk · 구간(110 Vac 75°–105° · 230 Vac 68°–112° · 264 Vac 54°–126° · FB 모서리 40°–140°; 173 · 90 Vac 는 내내 승압) · 비율 열, "What the load changes" 문단(25 % 부하 FB 모서리 203 kHz < 225 kHz; 무부하도 구간 동일, M_∞ 아래는 해 없음). 그림 40: f_r 교차점에 곡선 색 점, 우상단에 "dots: where a curve crosses f_r, at sinθ = M_pk — the same angles at any load", 범례 제목에 "(full load)". KR 본문은 `fswPk` 4-튜플을 그대로 읽으므로 모양을 안 바꾸고 `fswCross` 를 따로 두었다. 기호표에 θ₀ 행. `an_pdf.V` 에 키를 더하자 figstamp 의 설계값 해시가 바뀌어 60장 전부 '설계값 변경'으로 잡혔다 — 규칙대로 `figs.py --plain` 전량 재생성(픽셀이 바뀐 것은 그림 40 한 장, 나머지 59장은 스탬프만). AN 125쪽 · an_check 0 · an_symbols 0 · figcheck 0 · figstamp 60. **사용자: "다시 오류 전수 검사하고 쓸데없이 긴 문장은 쉬운 단어와 문법으로 줄여"** — 진단기 `an_sentences.py`(PDF 글을 문장으로 잘라 길이 분포). 본문 1846문장 중 40 단어 초과 145건, 그중 실제 본문 문장 56건(나머지는 목차 점선 · 표 칸 · 번호 목록). 본문 56건 전부와 35–40 단어 26건을 둘 또는 셋으로 나눴다(`;` `:` 로 이어 붙인 절을 문장으로; 숫자 · 기호 · % 자리표는 그대로, 뜻은 안 바꿈). 남은 40 단어 초과 10건은 전부 표 칸 · 번호 목록 · 따옴표 때문에 합쳐 센 것. 35–40 단어 29건 남음. 고쳐 쓴 문장 70여 개를 PDF 글 층에서 다시 읽어 문법 확인. an_check 0 · an_symbols 0 · audit_md 0 · 125쪽. **한국어판 이식(사용자: "한국어판 진행하고, 한국어도 문장 긴거 줄이고 쉬운단어로 고쳐")** — 81–84차 영문판 변경 전부를 `an_kr_body.py` 에 옮겼다(36곳): 6.25 신설(외부 게이트 드라이버, 식 4개) · 6.27 I_drv,q · Q_g(V) · ln 형 C_VCC · 6.31 V_Z 는 shunt 레귤레이터 · 표 6(데이터시트 종류, 부품 행 4개) · 표 7(스위치 · V_CC,SR · V_Z) · 표 8(행 5개, C_VCC 굵게, 메모) · 7.7 표 12 와 '부하가 바꾸는 것' · 7.13 올림 괄호 조건 · 표 22 Q_SR+TEA2095TE 행 · 7.16 · **7.17–7.20 신설** · 7.21 V_Z 레일 · 7.28 부품 · 기동(B · ΔQ_OSC · V_CC,floor) · 7.31 배치 규칙 7항 · 7.32 측정 2항 · **7.33 전체 회로 + 부품표** · 기호 27행 · 참고문헌 10건(DiscoverEE 삭제) · 상수 1항 · 미결 9행 · `_thinnest_kr` 5행 · `_ttd_lr_edge` 임포트. 지운 `V['Qg']` 참조 5곳은 Q.g_run · Q.g_SU 로. 절 116 = 영문판. 개정 이력 V1.3 에 부품 확정. **긴 문장**: `an_sentences.py --kr` 은 대문자 앞에서만 자르던 것을 한국어 문장 끝에서 자르게 고쳤는데, 어절 수는 기호 토큰 때문에 과소(30 어절 넘는 문장 1개)라 **글자 수**로 봤다(ast 로 `p` · `note` · `bullets` 문자열을 꺼내 80자 이상 27문장, 66–79자 16문장). 43곳을 둘 또는 셋으로 나눴다(수치 · 자리표 · 조사 함수 불변; 콜론 · '~하고, ~하며' 로 이은 절을 문장으로). an_check(KR) 기하 0 · 127쪽. 새 절 쪽(52 · 66 · 73 · 91–96 · 114)을 그림으로 확인. |
| 2026-10-07 | **3코어 시험 보드 변형 되살림.** 사용자: 설계 가이드는 15:2 한 개지만 실제 시험 보드는 5:2 × 3(1차 직렬 · 2차 병렬)이고 탱크는 옛 설계점(C_r 100 nF · R_T 11 kΩ) — "사양서 삭제했어?" → 2026-10-01 삭제분을 커밋 `0821491` 에서 `Smath/variants/L6790A_7p5to1.sm` · `Calculation Excel Sheet/variants/L6790_workbook_7p5to1.xlsx` · `Transformer_Spec_7p5to1.xlsx` 바이트 그대로 복원(`check_sm` OK, 47쪽). 빌더에는 넣지 않았다(얼어 있는 사본; 넣으면 81–84차의 시트 §14c.1–14c.5 가 옛 탱크로 계산된다). `docs/THREE_CORE_BOARD.md` 에 그 설계점 블록(2026-10-01 의 DESIGN §3) · 유닛 수입 검사(L_open 10.33 · 누설 3.67 µH ±10 %, 2차 둘 다 Short 조건 · DC overlap 16 A · 극성) · 지금 문서와 안 맞는 것(f_Max 319.6 kHz 에서 게이트 전류 2.6 배, R_BZ 820 · C_VCC 680, 드라이버 · SR 판정 없음)을 적었다. 같은 날 벤치 질문들: 복권 트랜스 대신 **NF ES2000S 출력이 플로팅**(매뉴얼 3-4쪽 "Both Hi and Lo insulated from the housing", 5-1 "floating output", 내전압 1500 Vrms — HTTPS 가 끊겨 HTTP 로 받은 스캔본을 쪽 그림으로 읽음) → 소스 직결 · Lo–섀시 연결 안 함 · 스코프 클립은 컨트롤러 GND 한 점; WT310 은 본체 벽전원 · 측정 단자만 띄운 라인(전압 입력은 셔트 뒤, ± 같은 라인); 외부 V_CC 는 12 V 가 아니라 **18 V**(V_CCon 17 V, 드라이버 10–20 V), TEA2095TE 는 12 V 에 R_SR 들어내고; 입력 브리지 TS6KL60(6 A, V_F 1.05 V max, R_thJC 2 °C/W)은 90 Vac 에서 정류 평균 6.85 A 라 한 개로는 정격 초과 · 손실 12–14 W(budget 5.5 W 는 동기 브리지 가정) → 판 + 2개 또는 15–25 A 급 하나, 판이 없으면 5–6개 병렬. 벤치 구성도는 저장소 밖 scratch 그림으로만 그려 전달(커밋하지 않음). |
| 2026-10-07 | **되살린 3코어 사양서의 PQ 40/40 — 사용자: "PQ4040 쓰라고 한 적도 없는데".** 맞다. 2026-09-01 확정 사양서는 코어 · 보빈을 지정하지 않고 단자를 26OP-LM83W 승인원 방식(1–2 / 3–5 / 4–6 / a–b)으로 적었는데, 2026-09-22(커밋 7401b67, AN 7.8 핀 그림 — 사용자 지시는 "심볼의 핀 배열은 PQ4040 보빈 참고"였다)에 `build_trans_spec` 이 `N.x` ≠ 1 이면 PQ 40/40 12핀 배정을 쓰도록 바꾸면서 **사양서 4종의 단자까지 12핀 번호와 "Coil former TDK B65884E" 줄로 바뀌었다** — 그림 지시를 벤더 사양서로 넓힌 것이 잘못. 2026-09-23 사용자가 "쓰지도 않는 코어"라고 했을 때 사양서는 안 돌렸다. 되살린 `Transformer_Spec_7p5to1.xlsx` 의 단자 10칸을 승인원 방식으로 되돌리고(openpyxl — 생성 파일이라 차트 없음), 보빈 줄은 "단자 번호는 26OP-LM83W 승인원을 따르고 코어 · 보빈 · 핀 배치는 벤더 선택"으로. `docs/THREE_CORE_BOARD.md` 수입 검사 표도 같은 단자로. |
| 2026-10-09 | **3코어 트랜스포머 누설이 사양의 절반 — 실측으로 200 W 시험 워크북 사본.** 사용자 측정(100 kHz 1 V): 개방 10.3 µH × 3, 누설 1.9 / 2.0 / 1.8 µH(2차 양쪽 단락), 한 유닛 반쪽 단락 2.0 µH. 내가 as-built 사양서에 누설 조건을 "양쪽 단락"으로 적었는데, 센터탭은 반주기마다 반쪽만 도통하므로 L_r 은 **반쪽 단락** 값이 맞다(이 권선에서 10 % 차이) — 사양서 조건은 아직 고치지 않았다. "측정을 잘못한 게 아닌가": 두 반쪽이 병렬로 보여 절반이 됐다는 내 추측은 반쪽 단락 2.0 µH 로 틀렸고, 실제로 사양의 약 55 %. 사용자: "이 트랜스포머 써야 하니까 최적 C_r 찾아서 200 W 까지만이라도" → `measured200_xl.py` 로 사본(`L6790_workbook_7p5to1_measured_200W.xlsx`): L_r 5.7 · L_m 25.2 µH · n 6.773 · Pout 200 W, C_r 100 nF · R_T 11 kΩ 유지. 판단 근거와 한계는 `docs/THREE_CORE_BOARD.md` 표. 풀로드는 외부 공진 인덕터 약 5 µH 또는 재권선이 필요. |
| 2026-10-07 | **실제 제작된 3코어 트랜스포머 대조 + as-built 사양서.** 사용자가 보낸 벤더 메모(핀 1–4 / 5–9 / 7–11 / 2–3, Litz 0.1 × 130 · 0.1 × 110 bifilar · ø0.4, DC overlap 15 A)와 코어 도면(A 42 · B 7.85 · C 19 · D 36 · E 6 · F 4.85, A_e 114 · l_e 58.82 · V_e 6706 · C1 0.52): 턴수 5:2:2:1 ✓, A_e 114 ≥ 103 ✓(E × C = 114, 바깥다리 (42−36)/2 × 19 × 2 = 114, V_e · C1 자체 일관 ✓), 재질 미기재 → 100 °C B_s 확인 항목. 구리 단면 1차 1.02 · 2차 0.86 mm² 로 설계 가정(4.5 A/mm²)의 절반 이하(10.7 · 10.9 A/mm²) → 온도 실측 항목. 사용자: "측정 방법은 사양서에 있는데 왜 그대로 재라고 안 하나" — 맞다, 사양서 3절이 측정 지시서다(100 kHz / 1 V · 2차 둘 다 Short · DC overlap). 조건부 셋만 적음: 2차 둘 다 Short 는 bifilar 라 반쪽 Short 와 같다(세 값 다 기록), DC overlap 은 16 A 로(15 는 9-21판), 3.67 µH 급은 L_s 모드 · SHORT 보정. NAUX 를 Open 으로 재는 이유: 동작 중 사실상 무부하라 탱크가 보지 않는다. `Transformer_Spec_7p5to1_asbuilt.xlsx`(openpyxl 생성, 설계값은 옛 사양서에서 읽음) 전달. 사용자 “보빈 생긴게 너무 다른데. 다시 만들어” → `asbuilt_spec_pics.py` 의 보빈을 벤더 그림(측면: 위 8핀 블록에 홈 6개 · 가운데 보스 · 아치 2개 · 플랜지 · 통 · 아래 4핀 블록에 발 2개 · 옆 탭)대로 다시 그리고, 엑셀 생성 코드를 `asbuilt_spec.py` 로 저장(코어 그림은 H20 으로 내림). |
| 2026-10-02 | **(83차 계속) SR MOSFET STL160N10F8.** 사용자: "stl160n10f8가 2차측 모스펫인데 왜 포함이 안돼있어?" → 답: 받은 적이 없다(앞서 올라온 두 파일은 md5 가 같은 STO60N045DM9). 이어서 사용자가 데이터시트(DS14249 Rev 5)를 올림. **반영**: 시트 `R.dson_s25` 3.7 → **3.2 mΩ**(Table 3 max) · `K.Tsec` 1.9 → **1.5**(Fig. 13 벡터, 125 °C 1.504; 25 °C 눈금 대조 1.0005) → `P.SR` 5.71 → **3.90 W**, `k.PSR` 1.051 → 1.539. 새 판정 `k.RDSsec` 1.539 · `k.VDSsec` 1.250(100/80 V) · `k.QgSR` 1.599. **Q_g**: SR 은 드레인이 바디 다이오드 강하에서 켜지므로 Table 4 의 Q_g(sync) 72 nC(V_DS 0.1 V, 10 V) 를 쓰고, TEA2095TE 최대 게이트 11.2 V 까지 Fig. 8 플래토 위 기울기 **7.96 nC/V**(벡터, 50 V 곡선 10 V 에서 87.7 nC ↔ 표 90 nC) 를 더해 **81.6 nC** → SR 전원 실제 **94.2 mA**(150 mA 설계 안), Q_SR 1.01 W 공칭 · IC 0.433 W. C_iss 2 × 5.4 = 10.8 nF/핀 ≈ TEA 드라이버 시험 부하 10 nF. 열: 2s2p 보드 16 °C/W 에서 소자당 16 °C. 워크북 `sr_xl.py`(C92 · D96 · D98, CHANGELOG) — LibreOffice 재계산 사본으로 `xl_sm_compare` 145/145, `Pdiss` 3.893 W(시트 3.90). AN: 7.19 "The SR MOSFETs: STL160N10F8"(표 25) 신설, TEA 절 7.20 으로, SR 전원 문단에 실제 전류, 7.1 표 · 결과표 · 손실 문단 · 열린 항목 · 참고문헌 [STL] · 기호표, 그림 50 · 시트 2 에 부품명. `an_pdf.V` 의 Rdp · Rds · Rdsk 손 입력(45 · 3.7 · 1.9)을 빌더 상수 읽기로. AN 124쪽. 판정 59/62. **남은 typ 값**: Q_g · k_T 는 typical 곡선 — 실측으로 확인. |
| 2026-10-02 | **(83차, AN 은 아래 행에서 재빌드) MOSFET 기호 · SR 12 V급 전원 · 전체 회로도.** 사용자: "바디다이오드 음영처리는 하지 말고, 그리고 바디에서 게이트로 가는 화살표도 길이가 안 맞아서 좀 이상하네. TEA2095도 Vout 그대로 가져다 쓰면 내부 레귤레이터에 열이 많이 날테니 밖에 12V 레귤레이터 만들어주고. 그리고 설계 예제 마지막에는 계산된 부품값을 적용한 전체 회로도를 그려줘." **① `schemx.mosfet`**: state `plain` 은 바디 다이오드 · C_oss 를 소자와 같은 색으로(회색은 "도통 없음"이라는 뜻이라 상태 그림에서만), 벌크 화살표는 포인트 단위 FancyArrowPatch 대신 기호 단위 삼각형으로 — 끝이 가운데 채널 막대에 닿는다. 이 기호를 쓰는 그림 전량 재생성. **② 시트 §14c.4 신설(SR 전원)**: 제너 + NPN 이미터 팔로워(1차 VCC 레귤레이터와 같은 회로, 바이패스 다이오드 없음). TEA2095TE Table 7 이 게이트 구동을 VCC = 12 V 에서 보증하므로 **밴드 하단을 12 V 이상**으로 — 15 V ±5 % 제너 → V_CC,SR 13.55–14.30–15.05 V(k.SRlo 1.129). 13 V 제너면 하단 11.65 V 라 미보증. SR MOSFET Q_g 를 몰라 **I.SR_max 150 mA [PICK] 로 크기를 잡고 Q_g ≤ 130.4 nC/개(f.Max) 를 요구조건으로**. 방전 모드 41 mA max(12 V) 대비 k 3.659. R.BSR ≤ 812 Ω → 750 Ω, P.DZSR 308 mW · P.RBSR 0.287 W · P.QSR 2.31 W(OVP1) / 1.60 W(공칭) · 효과: IC 내부 강하 0.693 W(ΔT 32 °C @ 46 °C/W) vs V_out 직결 2.76 W(127 °C). C.SR 10 µF(DS 값 없음, ST SR 보드 값). 방전 기능은 팔로워를 거쳐 출력에서 25/14.3 × 0.4 = 0.70 W 를 끌어간다(무부하 버스트 휴지 > 1.1 s 면 대기전력 +0.70 W). C.VCC_hf 100 nF 를 시트 BOM 에 등록(그림이 시트에서 읽게). **③ 전체 회로도 2장(`an_full_pri` · `an_full_sec`, AN 7장 끝 "The whole circuit")**: 값은 전부 시트(`figs_ref._sv`). 1차측: EMI 블록 · D_HV · BR1 · C_in · R_CS/ISEN · 브리지 · C_r · T1(NP1 · NAUX, 핀 `cores.PINMAP`) · U1 L6790A 핀망 · U2/U3 L6498LD(부트스트랩 · R_G) · 보조권선 VCC 레귤레이터. 2차측: `an_sr_ctrl` 를 `_sr_block` 으로 떼어 재사용(2차 권선만) + 출력 뱅크 · R_I/R_O · TL431 · 보상망 · 옵토 LED · R_P · R_B · V_Z 블록. 넷 플래그(HVG1…LVG2 · A · B · AUX · V_out)로 연결. **값이 없는 것(설계하지 않음)**: EMI 필터 · BR1 · 다이오드류 · Q_VCC · Q_SR 부품 · C_aux · SR MOSFET 과 그 게이트 저항 · V_Z 12 V 레일. **검토 반복에서 잡은 것**: U3 부트스트랩 다이오드 열이 U2 열과 같은 x 라 두 드라이버의 BOOT/OUT 이 붙은 것처럼 그려짐 · U3 VCC 선이 U2 상자 관통 · 권선이 단자 간격보다 커서 넘침(`_xf` 가 턴 수를 간격에서 뽑게) · D_HV 두 개 맞붙음 · 글자 겹침 다수 · 옵토 화살표 축 밖 · 페이지 축소 후 6.4 pt 핀 번호. figcheck 3장 0건 · an_figtext 새 그림 미정의 0. 빌더 대조 0 · check_sm OK(55쪽, 노란 입력 175) · bom_compare 29/0 · figstamp 61/0 stale. **사용자 질문(중단 시점)**: 2차 MOSFET 은 **STL160N10F8** — 데이터시트를 받지 못했다(올라온 두 파일이 같은 STO60N045DM9, md5 동일). 받으면 R_DS(on) · k_T · Q_g(≤130.4 nC 대조) · 100 V 정격 반영. **AN PDF 는 아직 이 변경으로 재빌드하지 않았다.** |
| 2026-10-01 | **(82차) 게이트 구동 · SR 회로도 2장을 설계 예제에.** 사용자: "각 데이터시트를 참고해서 회로도라도 간단하게 그려서 넣던가 해야지. 잘못그리지 말고 계속 너가 그린거를 검토 수정 검토 수정을 반복해서 마음에 들 때 까지 그려줘." **그림 49 `an_gate_drive`**(7.18): L6790A ↔ L6498LD 레그 1 상세(핀 번호는 L6790A 는 ST EVL6790_670W 제어보드 회로도, L6498LD 는 SO-14 데이터시트) — VCC 레일 · 로컬 디커플링 · D_BS(애노드 레일, 캐소드 BOOT) · C_BOOT(BOOT–OUT) · R_G · S1/S2 · PGND 를 S2 소스로 켈빈 · DRV_EN 개방 · 레그 2 는 상자. **R_CS 위치는 L6790A DS 블록도에서**: 브리지 귀환(= 제어기 GND)과 입력 정류기 (−) 사이, ISEN 은 정류기 쪽. **그림 50 `an_sr_ctrl`**(7.19): TEA2095TE(HSO8) + 센터탭 2차(핀은 그림 46 과 같게 NS2 7–9 · NS3 10–12, 9·10 이 출력) + 레그당 2병렬(Q_A1·Q_A2·Q_B1·Q_B2), MOSFET 마다 게이트 저항, DSx · SSx 는 전력 접지와 따로 쌍의 드레인 · 소스로. **검토 반복에서 잡은 것**: C_BOOT 가 HVG 선 위에 겹침 · 디커플링 선이 HIN/LIN 을 가로지름 · **D_BS 단자를 거꾸로 이어 선이 다이오드를 관통** · 접지 기호 위 잘못 찍힌 점 · 열린 끝 표시 없음 · 페이지 밖 글자 · SR 게이트 분기점이 엉뚱한 곳 · GDB 가 B 레그 드레인 버스와 교차(홉 없음) · 감지선이 바디 다이오드에 0.2 붙음 · 글자 겹침 여러 곳. PDF 에 넣어 보니 글자가 5–6 pt → figsize 10×7.6 → 8.2×6.23 으로 줄여 기호 대비 글자를 키웠다. **ST EVB 에서 확인한 것(7.18 · 7.19 의 노트)**: DRV_EN 이 BSS84(2N7002 레벨시프트)로 드라이버 전원을 끊는다 · 부트스트랩 3.3 Ω 직렬 + STTH1R06 · 게이트–소스 10 kΩ(L6498 은 VCC 3 V 위에서만 출력을 Low 로 잡는다) · SR 보드는 TEA2096(같은 핀배치) + ISC079N15NM6 레그당 2개, 게이트 0 Ω, DSx 직렬 220 Ω, VCC 10 Ω + 10 µF. TEA2095TE VCC 를 25 V 출력에서 받으면 내부 약 11 V 게이트 전원까지 강하 손실이 SR 게이트 전하에 비례 — **SR MOSFET 데이터시트가 없어 계산 못 함**, IC 온도 확인 또는 낮은 레일 급전을 본문에. **검사기**: `an_figtext` 가 `DRV_EN`(수식 밖 대문자 핀 이름, matplotlib 은 `_` 를 그대로 그린다)을 아래첨자로 읽던 것을 그 경우만 제외 — 다른 그림의 결과는 그대로(68 → 62, 줄어든 6 이 전부 새 그림 둘), D_BS · Q_A1…Q_B2 는 캡션에서 정의. figcheck 58장 0건 · figstamp 59 current/0 stale · an_check 무결점 · an_symbols MISSING 0 · audit_md 0. AN 117 → **119쪽**, 그림 51장. **한국어판 이식은 영문판 확인 뒤.** |
| 2026-10-01 | **(81차) 게이트 드라이버 · 1차 MOSFET · SR 컨트롤러를 설계 예제에.** 사용자: "L6790A 같은 경우에는 내부에 내장된 Gate Driver가 없어. 1차측 게이트 드라이버 / 1차측 모스펫 / 2차측 모스펫 / 2차측 SR Controller를 줄게 … 설계 예제에 추가해. 다만 SR IC는 상세 설계 방법은 빼고. 1차측은 MOSFET 병렬로 쓰진 않을거고 2차측은 2개씩 병렬로 쓸거야. 게이트드라이버는 L6498LD 쓸거야 14핀짜리". 올라온 파일: L6498(DocID030318 Rev 3) · TEA2095TE(Rev 1.3) · STO60N045DM9(DS14711 Rev 4) **두 개 — 둘이 같은 파일(md5 동일)이라 2차 MOSFET 데이터시트는 받지 못했다.** 3.7 mΩ · kT 1.9 는 예전 선정값 그대로 두고 열린 항목으로. **데이터시트 곡선은 벡터로 읽었다**(pymupdf `get_drawings`, 격자선으로 축 보정): Fig. 10 R_DS(on) 125 °C **1.898**(사용자가 이전 판에서 눈으로 읽은 1.8 → `K.Tpri` 1.9), Fig. 5 게이트 전하 플래토 6.30 V · 59.8 nC, 10 V 89.9 nC(Table 5 의 90 과 일치), 12 V 105.0 nC → 플래토 위 직선 7.5 nF. **시트(§2 · §3 · §13 · §14c.1–14c.3 신설):** ① `c.HB` 를 [PICK] 800 pF 에서 데이터시트로 — C_oss eq.(time-related, 0–400 V) 897 pF 의 전하를 코너 버스 √2·V.eq_min 245 V 로 나눠 상한 **3029 pF**. `Q.ZVS2` 15.99 → 4.22 지만 `Q.ZVS1` 1.975 가 묶으므로 탱크 불변, `T.T` 44.9 → 170 ns(`k.TT` 1.294). 시트의 "C.oss_max 를 넘으면 실제 값을 넣어라"(350 pF) 지시를 이제야 따랐다. `l6790.design()` 에 `Coss_tr` 인자(`PRI_FET`), 호출 4곳 · 빌더 대조에 `c.HB` · `Q.ZVS2` 추가. ② **L6498LD**: 정지전류 2×(480+120 µA), 내장 부트스트랩 DMOS 175 Ω 은 f.Max 에서 V_drop = Q_g·R/T = **14.0 V** → 외부 고속 다이오드(가정 V_F 1.0 V), C_BOOT 470 nF(리플 0.31 V), V_BO 11.54 V ≥ 권장 9.3 V(`k.VBO` 1.241). **기동 하한 `V.CC_floor` = max(8, 10, 9.3+1.0+0.31) = 10.61 V** — L6790A 의 8 V 가 아니다. 드라이버 손실 0.537 W/개(출력 저항을 15 V/단락전류 최소로 가정, `k.Pdrv` 1.864), (t.D−MT)/T.T **1.118**(`k.TTd`), 중점 기울기 I_Lm,pk/(2·86+100 pF) = 40.9 V/ns(`k.dvdt` 1.222), OUT 480 V dc / 버스 373 V(`k.OUTdrv` 1.286), V_OH/V_IH · V_IL/V_OL, **LOUT2 → LIN 풀다운 58 kΩ min × 300 µA ≫ 2.5 V 라 morphing 판별은 그대로**(`k.LOUT2` 6.96), DRV_EN 은 개방(L6498 에 EN 없음). ③ **VCC**: `I.VCC` = I_CC + 1.2 mA + 4·Q.g(V.CC_reg_max)·f.Max = 92.8 → **144.3 mA**. 기동은 DS 의 T_OSC_SU 1 ms(16단계)만 f.SU 이고 그 뒤 f.Max — 전에는 기동 내내 f.SU 로 잡았다. 게이트 전하가 VCC 를 따라 줄므로 C dV/dt = −(I0 + B·V) 를 두 구간 ln 으로 적분(+ 첫 1 ms 의 추가 전하 108.9 µC) → `C.VCC_req` 588 → **884 µF → 1000 µF**(230 Vac 첫 펄스까지 1.28 → 1.89 s), `R.BZ_max` 893 → **656 Ω → 560 Ω**(`P.DZ` 393 mW · `P.Qpass` 2.12 W · 공칭 1.44 W). Q.g 를 17 V 로 고정하면 1149 µF 였다(23 % 과대). ④ **TEA2095TE**(연결과 한계만): VCC 38 V / OVP2 31.45 V(1.208), 드레인 감지 120 V / 80 V(1.50), 게이트 10.4 V / 10 V(**1.040 — 가장 얇은 통과 판정**), 기동 4.75 V. 방전 기능(1.1–1.7 s 무동작 → 0.4 W)은 75.2 mF 를 약 59 s 에 비우지만 무부하 딥버스트 휴지가 1.1 s 를 넘으면 대기전력에 0.4 W 를 더한다 — 실측 항목. ⑤ 1차 열: R_thJC 0.4, 40×40 mm 동박 R_thJA 22 °C/W → 정적 소자 9.27 W 면 **204 °C 상승, 방열판 필수**(케이스–주위 10.4 °C/W @25 °C). **판정 44 → 56, 41 → 53 통과**(새 12개 전부 통과). **새 발견: `k.TTd` 는 L_r 23.5 µH(`an_body._ttd_lr_edge`, l6790 으로 이분법 · 시트 스윕 23.5 → 0.999, 23.6 → 1.007 과 일치) 아래에서 1 미만** — FEM 누설 하한 23.3 µH 바로 위. c.HB 가 상한이고 ADT 가 있지만 첫 샘플의 L_r 이 낮으면 t.D 를 올린다. 옛 "L_r 22.3–28.6 µH 에서 41/44" 는 저장소에 없는 스크래치 계산이라 다시 돌려 **23.6–34 µH 에서 53/56**, R.T 21.0–22.1 kΩ 어디서나 같음. 워크북 `fet_xl.py`(D46 · D58 · D72, CHANGELOG). LibreOffice 재계산 사본은 **OOXMLRecalcMode=0 프로필이어야** 캐시가 바뀐다(그냥 변환하면 43건 낡은 값) → `xl_sm_compare` 145/145 · `rtc_check` OK. `bom_compare` 29/0 · `check_sm` OK(52쪽) · `audit_dim` 0 · `audit_rpn` 불일치 1(P.DZ, 오탐) · `check_trans_spec` 0(NAUX 부하 144 mA) · `figstamp` 57/57(`figs.py --plain` 전량) · `figcheck` 0 · `an_symbols` MISSING 0(SILENT 48 → 43). `audit_fet` 의 C_oss 종류 · Q_g 가 "요구조건만"에서 "사용"으로. **AN(영문, 111 → 117쪽):** 6.25 "Driving the bridge: external gate drivers"(식 40–43: V_drop · V_BO · V_CC,floor · P_drv) 신설, 6.27 의 I_VCC 식에 I_drv,q, Q_g(V) 직선 식, C_VCC 식을 ln 형태로. 7.1 사양표(부품 · 데이터시트 종류) · 7.2 결과표 · 7.3 여유표(5행 추가) · 7.16 요구표, **7.17 STO60N045DM9 · 7.18 L6498LD(핀 표) · 7.19 TEA2095TE(핀 표)** 신설, 7.27 V_CC 계산 다시, 핀 규칙 · 측정 항목 · 열린 항목 5개 · 기호표 · 참고문헌([STO] [L6498] [TEA], DiscoverEE 삭제) · 개정 이력. 첫 빌드에서 TEA2095TE 절이 레그당 MOSFET 수 자리에 권선비 n(6)을 찍은 것을 PDF 를 읽고 잡았다(`%(n)` → `%(nSR)`). **한국어판은 손대지 않았다**(규칙: 영문판 확인 뒤 이식) — `an_kr_body.py` 는 지운 `V['Qg']` 를 읽으므로 이식 전에는 빌드가 멈춘다. |
| 2026-09-25 | **(60차) 설계 예제의 트랜스포머를 "계산 → 코어 선정 → 권선 → 핀 → 검증" 순서로. 그림 17 플라이백을 DCM 으로.** 사용자: "코어 선정을 미리 해놓고 짜맞추는 느낌 … 계산 먼저 하고 이 코어가 잘 맞는다~ 라고 설명해야지. 그러고 나서 핀 선정 … Figure 44 가 먼저 나와버리잖아." 영문판 7.9–7.10 을 네 절로: **7.9 What the transformer must provide**(탱크 요구·턴수·그림 43·표 14) → **7.10 Choosing the core**(자속 → A_e ≥ 103 mm² · 동선 면적 계산 줄 신설(권선별 A_cu, 합 61.6 mm² → A_N ≥ 205 mm²) · skin depth/Litz/동박 · "What the core must offer" · "The core": ETD 49/25/16DG 가 세 조건을 만족 — A_e 211 은 자속 요구의 2.0 배, 권선창 76 %, 권선 사이 6.36 mm, **자속만이면 절반 면적으로 되고 권선창과 폭이 정한다**(6.12 절) · 표 15 산수) → **7.11 The winding and the pins**(그림 44 단면 · 표 16 · 핀 그림 45 · 표 · 극성) → **7.12 Checking the flux, and the specification**(고른 코어의 B_pk 97.6 mT · I_eq · I_sat · 그림 46 · OVP2 · 시험법 · 사양서). 표 13 에 key `currents`. 6.19 의 절 참조를 새 절 이름으로. **그림 17**: 플라이백 칸이 CCM(전류가 0 으로 안 내려감)인데 그림 18 은 DCM 이라 서로 달랐다(사용자 질문). 논지(매 주기 저장한 에너지를 전부 내보냄, B_pk ∝ I_p,pk, 자속이 매 주기 0 에서 시작)에는 DCM 이 맞다 → DCM 으로 다시 그림(on 0.40 · 2차 0.40 · 휴지 0.20), 제목 "FLYBACK (DCM)", 캡션에 그림 18 과 같은 모드임을 명시(영·한). **한국어판의 7.9–7.12 재구성은 영문판 확인 뒤 이식**(규칙). figcheck 55/0 · an_check 두 판 · MISSING 0. **덤으로 찾은 것:** 그림 6–9(`an_modes_12/34/56/78`)가 코드 변경 없이 바뀌어 나왔다 — `figs_modes8` 는 전류 하이라이트가 따라갈 코일 목록을 **import 때 한 번** `schemx.register()` 하는데 `figs_ref.an_pfc_boost` 가 끝에서 `register()` 로 전역 목록을 비운다. 그래서 일괄 렌더 순서에 따라 하이라이트가 코일을 따라가기도(의도) 코일 위를 직선으로 지나가기도 했고, **AN 이 읽는 `figures/an/` 판은 직선판**, 제목 붙은 `figures/` 판은 코일판으로 서로 달랐다. `build()` 가 그리기 직전에 등록하도록 고쳐 순서와 무관하게 코일판으로 고정(목록을 먼저 비운 경우·새로 그린 경우 모두 커밋된 판과 바이트 동일). |
| 2026-09-24 | **(59차) 기동 종료 ZCD 임계를 데이터시트 값 1.36 V 로.** 사용자: "데이터시트 기준으로 해." (57차 질문: ST 툴 1.35 V vs DRAFT DS 전기적 특성 표 V_ZCD_SUend 1.36 V typ). 빌더 `V.ZCD_SUend` 1.35 → 1.36 → `V.out_SUend` 16.53 → **16.65 V**(7.5:1; 6:1 워크북 16.56 → 16.68). 정본 시트·변형 4종 재빌드(실제 변경 두 줄, 줄바꿈은 파일마다 HEAD 와 같게 — 정본·`_x1` LF, 나머지 CRLF). 워크북은 `fix_xl_suend.py`(`xlsx_patch`): `Device Setting` D71 = 1.36, 의존 D88·D98·D99 는 수식 유지·캐시값 재계산, CHANGELOG_rev0_6 기록(정본 행 115, 6:1 행 113), 정본을 variants/7p5to1 로 복사. `xl_sm_compare` 145/145 일치. 설계 가이드 md 두 곳(식 [99] 설명, 부록 C 의 ST 툴 차이 목록)에 반영. AN 7.20 문장에 이 전압이 무엇인지 설명 추가("ZCD 핀이 기동 종료 threshold 1.36 V 에 닿을 때 … OVP1 출력 전압의 1.36/2.3") — 1.36 은 빌더 상수에서 읽는다. 판정 지표 영향 없음. **출력 뱅크 ESR 의 2f_l 성분**은 사용자: 커패시터 사양 미정 → 57차 표기("2f_l 성분 빠짐") 그대로. |
| 2026-09-24 | **(58차) 입력 조건을 "Vac eq." 대신 상용전원 전압 + 브리지로 표기.** 사용자(그림 39 캡처): "332 Vac eq 가 뭔데? 332 Vac 입력이 어딨어 … 110 Vac (FB) 220 Vac eq 이런 식으로 표기하니까 알아보기 더 어려워. 알아보기 쉽게 표기해." `l6790.line_conditions` 이름을 "173 Vac, half bridge (HB edge)" · "90 Vac, full bridge" · … · "166 Vac, full bridge (FB edge)" 로, 탱크가 보는 전압은 `tank_sees()` 가 "tank sees 2 × 166 = 332 Vac" 로 풀어 쓴다(`mains_of`·`cond_short` 신설). 그림 39 패널 제목·상자 첫 줄, 그림 40·43 범례, 표 10 열 제목("166 Vac / FB edge" + 캡션에 FB·HB 뜻), 표 11·12(열 "the tank sees (Vac rms)"), 7.5·7.6·7.8·7.9·7.25 문장과 표 13·18, 그림 26 메모("FB edge: 166 Vac mains, tank sees 2 × 166 = 332 Vac"), y축 "[Vac equivalent]" → "[Vac]". 4~6장의 등가 입력 **개념 설명**(V_ac,eq 정의, 6.2 절)과 계산 기호는 그대로. 한국어판 같게(`_kc` 번역, "풀브리지 166 Vac, 탱크에는 332 Vac"). 값은 하나도 안 바뀜. |
| 2026-09-24 | **(57차) 56차에 남긴 문서 항목 처리.** 사용자: "뭐가 남았어" → 문서 쪽 1·2번 진행. **과장·근거 없는 단정:** "Every LLC text writes 8/π²" → "The usual LLC form" · "Every transformer text says to interleave" → "The usual advice" (영·한). "120 Hz tan δ 는 5~10 배 크다"(근거 없음) → 삭제하고, **ESR 은 전류 성분마다 그 주파수의 값**으로 규칙을 고쳤다(6.23 · 7.24 체크리스트). 이 설계는 2f_l 성분 18.6 A rms 가 스위칭 성분 23.8 A 와 비슷한데, 시트의 P.Cout 0.162 W 는 30.24 A 전부를 스위칭 주파수 ESR 로 계산한다 → 표 20 에 "2f_l 성분은 빠져 있음(실장 부품 tan δ 모름)" 명시. **수치는 안 바꿨다 — 부품 tan δ 가 있어야 계산 가능.** **16.53 V(기동 종료 출력 전압) 출처:** V_ZCD_SUend × V_OVP1/2.3 V. 시트·워크북(ST 원본 `Device Setting` D71 포함)은 1.35 V, **DRAFT DS 전기적 특성 표는 1.36 V(typ)** → 1.36 이면 16.65 V. 어느 쪽을 쓸지 사용자 판단 대기, 값은 그대로. **검사기 목록 판정:** an_symbols SILENT 44 중 문장에 말로도 설명이 없던 넷(ω_l · M_OL · L_L1/L_L2 · μ_0)에 식 곁 정의 추가, 나머지는 인접 문장이 말로 설명. LATE 52 는 "식 뒤 with X …" 관례(먼 11개는 53차에 처리). an_figtext UNDEFINED 63 은 대부분 그림이 먼저 오고 바로 뒤 문단이 정의하는 배치 · 그림 안 설명 있음. 그림 30 캡션에 V_BO = 브라운아웃 threshold(R_CFG, 7.19) 추가. LITERAL 12 는 전부 기존 판정(400 V 관례·공칭 상용전원·시험 조건·정의·각도) 그대로. |
| 2026-09-24 | **(56차) 사람이 읽듯이 영문판 → 한국어판 통독.** 사용자: "사람이 읽듯이 읽어서 검사는 못해?" → "둘 다 해. 영문판 먼저 읽어보고 수정하고 한국어판에 적용하면서 읽어봐." 검사기가 못 잡는 부류(표끼리의 모순 · 정의 없는 전제 · 한 기호 두 뜻 · 근거와 다른 문장)를 찾았다. **수치 모순:** 표 11(게인 차트 교차점)과 표 12(스윕)의 같은 주파수가 156.3/156.4 · 163.1/163.2 kHz 로 달랐다 — `figs_pf._cross` 가 격자점으로 내림해 0.06 kHz 낮았다(정확한 근 = 스윕) → 격자 안 선형 보간. 7.11 "허용 리플 10 % 면 결정 조건이 바뀐다" — 실제로는 5.23 % 에서 바뀐다 → `an_pdf.V['ripSwap']` 로 계산. 표 17 "32.7 − 4 − 11.85 − 10.5 = 6.36"(손으로 하면 6.35) → 피연산자 3자리. "61.6 mm², ku 0.30 에서 AN 의 76 %"(61.6/269 는 23 %) → "ku 0.30 이면 205 mm² 필요, AN 269 mm² 의 76 %". **문장:** 표지 "실측이라고 적은 값만 실측" — 그런 값이 없다 → "실측값은 없고 계산값 또는 부품 데이터시트 값". 7.16 주의문 T_idle 을 두 값으로 적었다 → 정오표와 같은 세 값(700·350·250). 표 6 버스트 "정격의 11 %" → P_in 의 11 %(75.3 W = 0.11 × 684.8). 표 18 Open 인덕턴스 "−4.1 % at worst" → "공칭보다 최대 4.1 % 낮은 값까지(식 Ldrop)". 7.10 코어 "중앙 다리를 연마, 갭 1.1 mm" vs 표 18 "분산 갭" → 분산 갭 합계 1.1 mm 로 한 문장. 7.14 에 R_BM 30 kΩ 을 그대로 두는 이유(버스트 진입점이 가정값, 대기전력 실측 뒤 결정) 한 문단. 표 4 · 6.14 · 6.15 가 "1차는 직렬, 2차는 병렬"을 전제로 썼는데 예제는 트랜스포머 1개 → N_x 개로 나눌 때로 조건화, 6.21 참조. 2.12 "½L_m i_μ²"(모델 L 과 물리 전류 혼용) → ½L_μ i_μ², L_μ 첫 사용처에서 정의(6.9 참조). 그림 13 파형 라벨과 가운데 회로의 중점 라벨 v_d → v_A(v_d = v_A − v_B 로 정의돼 있는데 그림은 레그 1 중점 0 → V_in). 그림 23 캡션에 v_ac 정의(an_figtext 가 정의 전 사용으로 짚음). **기호(한 기호 한 값):** L_p(탱크 L_r+L_m 과 플라이백 1차 인덕턴스) → 탱크 쪽 삭제, 4.8 m = (L_r+L_m)/L_r · i_ac(정류기 입력 전류, 상용전원 v_ac 와 충돌) → i_RI(그림 3 포함) · I_rms(2.15 입력 전류와 6.15 권선 전류) → 2.15 를 V_ac·I_ac 로(7.19 계산 줄의 단위 V_rms 는 Vac 로) · P_cond/P_mos,dc · f_c/f_cross 같은 양 두 이름 → 하나로 · M_min/M_max 기호표 풀이를 쓰인 자리(일반 LLC 절차)대로. **한국어판:** 위 전부 이식 + 표 22 "버스트 threshold 를 벗어난다"(모호) → "리플이 버스트 threshold 를 넘나들지 않는다". 번역투는 크게 걸리는 곳이 없었다. **확인하고 둔 것:** 7장 산수(여유비·손실 합·리플 성분 제곱합·OVP 자속 비례·Γ_v·√(G_oEA_o)) 재계산 일치, 표 8 f_sw 249 kHz 가 사양 225 kHz 를 넘는 것은 7.16 에 설명돼 있음. |
| 2026-09-23 | **(55차) 데이터시트 원문 전수 대조 뒤 수정.** 사용자: "확인해서 뭐가 맞는건지 먼저 판단부터" → 판단 보고 → "확신이 있으면 수정". 데이터시트(DRAFT, 23쪽)와 AN 의 IC 상수를 전부 맞춰 보았고 FB 법칙·R_BM·OCP1/2·OVP1/2·V_CC·발진기 한계·모핑 문턱·CFG 표·FB 전류·핀 규칙은 일치. 고친 것: ① 보호 표의 비용량성 보호 "ZCD 에지 감시" → **ISEN**(DS 5.2.5, soft/hard 두 단계) ② OCP1 "cycle-by-cycle" → 스위칭 주파수 상승(DS 5.2.6) ③ 오류 목록 T_idle "Table 5" → **Table 2**(권장 동작 범위), 5.3.2 절 안의 C_T,max 식이 뜻하는 350 ns 추가 — 값 셋(HISTORY §3.1 C.1 과 일치) ④ ZCD 주의문 "데이터시트의 권선비 상한" → 25 V V_CC 정격에서 유도한 상한(DS 에는 없음) ⑤ 4장 식 V_FB 의 P_in → **P_in,LLC**(DS 블록도: R_CS 가 C_in 과 풀브리지 귀환 사이 = 브리지 입력 전력) — 7장 Step 2 가 이미 P_in,LLC 로 계산하고 있었다. R_CS 상한은 DS 표기대로 P_in 으로 두고 2 % 보수적이라고 명시(선정 24.0 mΩ 는 두 계산값 모두보다 작아 부품 불변) ⑥ 6장 표시 표 3·6번 V_out → V_o,eff(식과 일치, V_f = 0 이라 값은 같음) ⑦ C_in 3.2 nF/W 손 입력 → 계산 ⑧ 6장의 이 설계 비율 "about a tenth" 두 곳 삭제 ⑨ 한국어판 "전고조파 왜율" → THD(total harmonic distortion) ⑩ 한국어판 2-stage/두 단/2단 → **two-stage**(single-stage 와 같은 표기, 사용자). "2단계 과전류/과전압"(level)은 그대로. HVSU 다이오드는 **1000 V 급으로 사용자 확정**(DS 는 "고전압 정류 다이오드 한 쌍"만 적는다; AN·가이드·DESIGN.md 는 이미 1000 V/S1M). 남은 것: DS 의 TBD(열저항, ZCD 하한) |
| 2026-09-23 | **(54차) 2~6장에서 설계 수치를 뺐다.** 사용자: "숫자를 그냥 빼면 되잖아" (18차 규칙 ↔ 44차 조건 규칙 충돌에 대한 답). 곡선은 그대로 두고 **글자만** 지웠다: 그림 5·12 f_o = 0.60 f_r · 전부하 Q = 0.77 → f_o · full load, 그림 11 Q = 0.77/0.38 → full/half load, 그림 13 f_sw/f_r = 0.58, arg Z_in = −44° 등 → arg Z_in < 0 / > 0, 그림 25 λ = 0.55 (m = 2.8) · M∞ = 0.645 → 삭제, 그림 24 4번째 칸·그림 10 전류축·그림 33 전류축의 눈금 숫자 삭제, 6장 skin depth "about 0.2 mm" 삭제(7장 계산줄에 값이 있다). 남긴 것: 모핑 문턱 235/245 V 와 거기서 나오는 173/332 Vac(IC 상수), TL431 2.495 V, 일반 예시값(그림 14 Q = 0.55/0.85/1.35, 그림 25 왼쪽 λ = 0.20). 또 사용자: 240 W 예제는 우리 설계가 아니다 → `l6790_validate.py` 의 λ 계열 9개 차이는 손대지 않는다(53차 항목 참조) |
| 2026-09-23 | **(53차) 그림 표기 보강 → "왜 전수 조사를 해도 놓치나" 원인 분석과 0 % 부터 재조사.** 사용자: "figure 2 에서 어디가 fr 이고 어디가 fsw 고 … 표기" · "figure 1 에 Vd, Is1 … 정확하게 표기" · "다른 Figure 에도 … 전부 확인해서 수정" · "센터탭 주변 조금 넓혀" · **"분명 여러 번 전수조사를 요청했는데도 자꾸 놓치는 이유를 파악하고, 검사하지 않은 구역까지 0 % 부터 샅샅이 조사해"** · (중간) "PQ3230 PQ4040 둘 다 쓰지도 않는 코어인데 왜 이걸 검사하나". **원인 5개:** ① 검사 도구가 모양(figcheck)·본문(an_symbols·낭독)만 읽고 **그림 안의 글자는 아무도 읽지 않았다**(PDF 추출 텍스트에 그림 글자가 없다) ② "전수"라 해 놓고 **무엇을 봤는지 장부가 없었다** ③ 그림을 **독립 근거(권선 방향 문장·극성점·식의 부호)로 다시 유도하지 않고** 그럴듯하면 통과 ④ 지적받은 그림만 고치고 **같은 부류를 전 그림에 넓히지 않았다** ⑤ 그림 코드의 **손으로 적은 글자·숫자**를 잡는 장치가 없었다. 여기에 도구 자체의 빈틈 둘: figcheck `tiny` 가 `ax.texts` 만 쟀고(범례·눈금 제외), 매번 **바뀐 그림만** 돌려 기존 결함 10건이 안 보였다. **심은 것:** `an_figtext.py`(그림 글자 ↔ 기호표·앞선 정의, 그림 함수 문자열의 손 입력 숫자, 기호별 사용 그림) · figcheck `tiny` 전 글자 · 장부(그림 48·표 32·절 106·식 67) · 영·한 본문 기록 2051개 1:1 대조(종류·키 순서·수치). **고친 것(주요):** NS2/NS3 뒤바뀜(그림 43) · 플라이백 기자력 부호 · HB v_d 를 ± 로 그림 · 같은 양의 두 이름 11쌍 통일 · **그림 32 에서 v_RI·R_ac 를 n:1 의 2차 쪽에 둠**(1차 환산값, 한 기호 두 값) → v_RI/n · R_ac/n² · **그림 4 2단계가 구형파로 n²R_L 저항을 구동**(정류기→저항은 기본파에서만) → 정류기 블록 유지 · **보상기 G_EA 부호**(세 인자 음부호 셋의 곱인데 양으로 적음) → G_EA = −v_FB/v_out 로 정의(그림 35·37·본문·기호표) · **그림 10 정류기 패널 "[A]" 가 실제로는 1차 환산값(n 배 작음)** → i_D/n · **그림 43·본문의 파라데이 직사각형 높이 V_out ↔ 식 V_o,eff** → V_o,eff(2장 그림 18 은 ≈) · 그림 18 "피크는 정류기가 꺼질 때" ↔ 곡선·그림 43 → "거의 평탄" · **f19 판정 0.376(시트 C 비) ↔ 본문 0.373(좌변 식)**, 본문 "1.060 apart" ↔ 바로 위 0.373/0.354 = 1.053 → 좌변이 5.3 % 큼 · 막대 "25 to 19 V" → 리플 골 24.4 V · 그림 24 "P_out" 을 P_in 평균선에 붙임(무손실 가정) · 그림 23 입력 단자 V_in(브리지 레일 기호) → v_ac · 손 입력 수치: f19 5 %·12 ms·76 %·25 V·400/320 V, f14·g_fsw_theta 173.2/332.3/264, **g_fsw_theta 상한 = f_r×1.6448(다른 설계의 비, 249.6 ↔ 실제 249.0)**, f17 235/245 V, `l6790.line_conditions` 라벨 173/332/90/264, **`an_pdf.py` 의 `sweep(R, 332.34)`** → 전부 R·V 에서 · "23 % optimistic"(실제 −36 % 보수적) 3곳 · 근거 없는 "PQ 코어 10~20 %" → 원리만(쓰지 않는 코어 수치를 넣지 않는다 — 사용자) · 기호표에 없던 그림 기호 16개 등재 · M_no load → M_OL · 늦게 정의된 기호 11개를 첫 사용 자리로 · 7장 계산줄 62개 재계산(3개 불일치 수정) · 가독성 17장. **남긴 것(사용자 판단):** 2~6장 그림의 설계 수치(18차 규칙 ↔ 44차 조건 규칙) · P_in 과 P_in,LLC 혼용(V_FB ↔ R_CS,max1, 시트도 같음) · 6장 skin depth "about 0.2 mm" · **`l6790_validate.py` 의 λ 계열 9개 불일치**(ST 240 W 예제는 λ₁ 을 264 Vac 코너에서, `l6790.py` 는 FB 에지 332 Vac 에서 — λ₁ 0.2445 ↔ 0.5667 을 재현해 확인. HEAD 에서도 같다. 즉 유일한 독립 검증이 λ 이후 연쇄를 지금은 검증하지 못한다) · 데이터시트 상수 대조 목록. 검증: figcheck 55장 0건 · an_check 영·한 무결점 · an_symbols MISSING 0 · build 0 · check_sm OK · bom 29/0 · rtc OK · xl_sm 145/0 · theta 0 · trans_spec 0 · audit_md 0 |
| 2026-09-23 | **(52차) 워크북 기록 · 교육자료 삭제 · 코어는 설계자 몫.** 사용자: "SMath 는 코어까지 선정해 주는 시트는 아니야, 그건 설계자가 보고 정할 일이지. 교육자료 지워. 워크북 기록해." **워크북:** ST 원본(디크립트본)과 정본 워크북의 설계 시트 7장을 수식·상수 단위로 전량 대조 — 바뀐 수식 261 · 상수 18 중 CHANGELOG 열 C 가 이름을 부르지 않는 것은 **17셀**이었다. 옛 메모의 "48"은 2026-09-08 집계이고, 그 뒤 `CompensationNet&Check` gain margin 작업이 `H132:AV167` · `C130:E134` 행으로 기록돼 줄었다. `log_xl_unlogged.py` 가 `CHANGELOG_rev0_6` 96행부터 머리 한 줄 + 17줄을 쓴다 — Was/Now 는 두 파일에서 읽고 Why 만 적었다. 정본(=`variants/…_7p5to1`)과 6:1(16줄, F83·F91 은 원본 그대로라 없음)에 적용, 수식·값은 그대로라 calcChain 도 보존. 두 번 돌려도 더하지 않는다. `xl_sm_compare` 145/145 · `bom_compare` 0 · 구조 검사 OK. **하나는 근거를 모른다:** `Power Components D71` Coss 897 pF 는 STO60N045DM9 선정 때 들어온 값인데 데이터시트의 어느 커패시턴스(Coss · Co(er) · Co(tr))인지 기록이 없고, 그 값으로 만드는 D77 Ctot 1804 pF 는 어느 수식도 읽지 않는다(ZVS 는 `Design Spec D46` 800 pF). 로그에 열린 항목으로 적었다. **교육자료:** PPT 와 그것만 쓰던 `check_deck.py` · `deckedit.py` · `fix_deck_overflow.py` 삭제. **코어:** DESIGN.md 4.2절 5d 를 "미선정"에서 "설계자가 정한다(시트 범위 밖)"로, CLAUDE.md 할 일에서 뺐다 |
| 2026-09-23 | **(51차) 교육자료 중단 · 트랜스포머 설계 정리 PDF 삭제.** 사용자: "교육자료는 없던 일로 하고. 트랜스포머 설계 문서는 삭제. 어차피 AN 에 있으니." `L6790A_Transformer_Design_KR_v1.0.pdf` 와 그것만 만들던 `tx_pdf.py` · `tx_body.py` 를 지웠다(다른 스크립트가 임포트하지 않음을 확인). CLAUDE.md 산출물을 넷 → 셋으로, 파일 지도·다음 할 일에서 두 항목을 정리했고, README · `.claude/rules/an.md` 의 참조를 뺐다. `audit_md.py` 는 지운 파일을 ABSENT_OK 로 받고, 스크립트 존재 검사도 그 목록을 따르게 했다(이 기록이 이름을 부르므로). 영문 교육자료 파일 자체는 남겨 두었다 |
| 2026-09-23 | **(50차) AN 최종 전수 검토 — 영문 94쪽 · 한국어 95쪽.** 사용자: "AN 최종 검토하자. 다시 한번 오타 오류 하나하나 읽고 보면서 전수검사해. 어색한 한국어 표현도 다시 검사." 두 판을 쪽마다 읽고 고쳤다. **틀린 서술:** 2.7 절 fast-recovery 이유("풀브리지에서 매 턴온 전에 도통" → capacitive 영역에 들어가면 반대쪽 소자의 도통 중인 다이오드 위에서 켜진다) · M<sub>Z</sub> 는 capacitive 경계가 아니라 피크 궤적(경계는 조금 오른쪽) · M∞ 아래 해 없음은 No load 에서만 · below 의 2차 전류는 잘린 사인이 아니라 온전한 사인 반파 뒤 휴지 · Class D 는 "정류기 부하"가 아니라 규격이 열거한 제품군 · "어떤 페라이트도 못 견디는 자속"(거짓) · skin depth 문장 · f.Max 는 I<sub>EA,max</sub> 에도 달림 · 자화 피크는 V<sub>in</sub> 이 아니라 nV<sub>o,eff</sub>/(4f<sub>sw</sub>L<sub>m</sub>) · 판단 주석(C.r 은 Q<sub>pk</sub> 를 낮추고, L.m 20 µH 는 15:2 로 필요한 n 을 주되 No load 해를 포기) · "L.m 을 올려 잡지 말 것"이 설계(20 µH > 계산 8.9)와 모순 → "크게 잡으면 ZVS 여유가 준다" · f<sub>180</sub> 근호 안이 음수일 때 · 함정 표의 L.m 방향 · 기호표 K<sub>pwr</sub> · f<sub>pHF</sub> · M<sub>Z</sub> · T<sub>ZC</sub>. **수치:** DC overlap 시험 전류 15 → **16 A**(계산 15.19 A 를 올림, 벤더 사양서와 같게 — `V['IsatTest']`) · "OVP2 가 없었다면"의 0.30 T → 369 mT(자속 목표는 I<sub>eq</sub> 기준) · T.idle 700 ns 이면 f.Min 85.2 kHz(f.o 아래), f.Max 248.2 kHz(FB 경계 249.0 미달) — `an_body._f_idle()` 로 계산 · "가장 낮은 입력 전압만 빼고 above" → 여섯 중 넷(`V['nAbove']`) · −471 ns 의 하이픈. **빠진 표:** 7.5 절이 "표에서 가장 작은 숫자"라고 했는데 표가 없었다 — ZVS 격자(부하 4 × 입력 6)를 표 10 으로 실었다(`ZVS_WORST['rows']`). **출처:** ST 스프레드시트 도면 세 장(전력단 · 컨트롤러 · 보상기) 캡션과 앞붙이에 출처, ON Semiconductor → onsemi. **R.T 미결 항목:** "발주 전에 공차를 조이거나 R.T 를 낮출 것" → 48차 결정대로 "첫 보드까지 11 kΩ, 낮추면 ±10 % 는 덮지만 dead zone 이 넓어짐, 실측 후 결정". L.open 공차 서술(−4.1 % 대 벤더 ±10 %)은 49차 지시대로 그대로 두었다. **조판:** 제목만 쪽 끝에 남던 곳 영문 6 · 한국어 12 → 0(h1/h2 `keepWithNext`), 사양 표 "assume d" 줄바꿈. **한국어:** NanumGothic 에 U+2212 가 없어 모든 마이너스가 하이픈으로 바뀌던 것을 Liberation Sans 로 그리게 했다(`use_korean`) · 번호·계산값 뒤 조사를 `_josa()` · `_nj()` 로("그림 24 은" → 는 등) · 단위 뒤 조사(kΩ 으로, nF 을, V<sub>out</sub> 으로) · 견주면 → 비교하면 · 전 부하 → 모든 부하 · OPAMP → op-amp · 리츠선 → Litz 선 · dead band → dead zone · 오역 "보상기 게인 상수는" → "중심 주파수는" · 손으로 적은 "2.13 절" → 참조. 검사: an_check 두 판 문제 0 · an_symbols MISSING 0 · 쪽 끝 제목 0 · 조사 검사기 31건 전부 오탐 · 새 영어 단어 20개 철자 이상 없음 |
| 2026-09-23 | **(49차) 공차는 따지지 않는다.** 사용자: "그건 모르니까 무시해, 공차는." — 벤더에 L.open ±5 % 가능 여부와 C.r · C.T 공차를 묻자던 제안을 거둔다. DESIGN.md 4.2절 5b 에서 공차 대책·미정 공차 문장을 지우고, 4.3절 12 의 ③ 을 공차 한계 트랜스포머 시험에서 영교차 하드 스위칭 관찰로 바꿨다. R.T 11 kΩ 유지와 실측 후 결정은 그대로 |
| 2026-09-23 | **(48차) `R.T` 는 11 kΩ 유지 — 실측 후 결정.** 사용자가 10 kΩ 변경을 승인해 시트·워크북(F24 와 딸린 캐시 5칸)·사양서·AN 을 고치던 중, `tx_body.py` 에 출처 없이 적혀 있던 "영교차 클램프 구간 4.7 → 26 %" 를 `l6790.sweep` 으로 재계산해 **맞음**을 확인했다. 앞서 내가 이 비용을 "THD 미계산" 이라고만 설명했으므로 커밋하지 않고 수치를 보고했다(작업은 stash 후 폐기). 사용자 질문 "모핑 근처만 문제냐" → 아니다, 전 입력에서 생기고 저입력일수록 크다. "하드 스위칭이 피크에서냐" → 영교차 근처다(피크 f.sw ≥ 127 kHz). "무엇으로 해야 다 피하냐" → R.T 로는 불가, f.o 의 흩어짐(L.open · C.r 공차)을 줄여야 한다. 수치와 선택지는 DESIGN.md 4.2절 5b, 판정 실측은 4.3절 12 에 적었다. 사용자 결정: **11 kΩ 유지, 시제품 실측 후 결정.** 파일 변경은 문서뿐이다 |
| 2026-09-23 | **(47차) 한국어 본체 문서 rev 2.0(9:1) 삭제 · R.T 10 kΩ 범위 확인.** 사용자: "한국어 본체 문서 삭제해. 그리고 R.T 는 엑셀에서 10 k 쓰면 최대·최저값 범위 밖 아냐?" **rev 2.0 삭제** — `AN_L6790A_Design_Guide_rev2_0.md` 는 시트 식 번호 [n] 의 출처로 `audit_sm` · `audit_guide` · 빌더 docstring 이 읽고 있었다. rev 2.1(7.5:1)의 식 태그 집합이 rev 2.0 과 완전히 같음을 확인하고(`\tag{[n]}` 전수 대조 차이 0), 세 곳을 rev 2.1 로 옮겼다. `audit_guide` 결과가 두 판에서 동일(구조 문제 0 · 대응 없음 68). rev 2.1 은 남겼다. **R.T 10 kΩ 은 범위 안이다** — 워크북 Device Setting: 데이터시트 동작 범위 5–30 kΩ(D14 는 상한 30 만 적는다), 24행 `RT.ceil` = 11.237 kΩ 은 **라벨이 "Minimum Resistor value" 이지만 최대값이다**(f.Min = 1/[2(C.T·R.T + T.idle)] 이 R.T 가 커질수록 내려가므로, f.Min ≥ f.o 를 지키는 R.T 의 *상한*). 10 kΩ 은 5 ≤ 10 ≤ 11.237 이라 두 한계를 모두 만족하고 `k.RT.ceil` 은 1.124, f.Min 은 1/[2(470 pF·10 kΩ + 250 ns)] = 101.0 kHz. C.T 창(176–703 pF)은 R.T 와 무관하게 30 kΩ 상한과 IEA 로 정해져 그대로다. **R.T 는 아직 11 kΩ 그대로 — 사용자 결정 대기** |
| 2026-09-23 | **(46차) 정본 시트·워크북을 7.5:1(코어 3개)로 바꾸고 9:1 을 지웠다.** 사용자: "권선비를 이제 와서 왜 결정해?" — 권선비는 2026-09-21 에 7.5:1 로 확정됐는데 `CLAUDE.md` 에 "미결정 · 사용자 결정 대기" 가 남아 있었고, 내가 그것을 DESIGN.md §1.3 과 대조하지 않고 결정 요청으로 옮겼다. 사용자 지시: "variant 의 7.5:1 시트를 정본으로 쓰고 기존 9:1 정본은 삭제, 엑셀이나 SMath 나. 코어 3개는 실제 설계용이고 PDF 와 무관하다 — SMath 에만 해당." **한 것** — `build_l6790_smath.py` 기본 변형 `9to1` → `7p5to1`, 정본 `.sm` 재빌드(CRLF 유지, `variants/L6790A_7p5to1.sm` 과 바이트 동일). 정본 워크북 `L6790_spreadsheet_r1_0_corrected_rev0_6.xlsx` 를 `variants/L6790_workbook_7p5to1.xlsx` 로 바이트 복사 — 교체 전 대조: 시트 11장 이름·순서 동일, 수식 셀 위치 전부 동일, 차이는 CHANGELOG 빈 셀 12개와 Device Setting F21 값 셀 하나뿐(잃는 수정 없음). 교체 후 수식 14,836개 전부 캐시값 있음 · `calcChain` 있음 → "정본 워크북을 열었다 저장" 사람 작업 삭제. **지운 것** — `Smath/variants/L6790A_9to1.sm` · `Calculation Excel Sheet/variants/L6790_workbook_9to1.xlsx` · `Transformer_Spec_9to1.xlsx`, 빌더·`build_trans_spec`·`check_trans_spec` 의 `9to1` 항목. AN(`7p5to1_x1`, 트랜스포머 1개)은 건드리지 않았다. **결과** — build mismatches 0 · check_sm OK · bom 29/0 · xl_sm 145/145 · rtc OK · theta 0 · trans_spec 0 · audit_sm/dim/rpn 0 · coldstart PASS · audit_md OK. 판정 지표 **34/40 → 36/40**(k.Ae 0.549 → 1.098, k.PSR 0.929 → 1.063 해소, 남은 미달 k.Ploss · k.VCC · k.auxr · k.lam 은 전부 사유 있음). **새로 걸린 것** — DESIGN.md 4.2절 5b: 7.5:1 은 R.T 11 kΩ 으로 ±10 % L.open 공차를 못 견딘다(f.o 90.39 → 95.28 kHz > f.Min 92.25). 9:1 정본일 때는 조건부였던 항목이 지금 걸린다. R.T 를 바꾸면 AN·사양서의 f.Min 도 움직이므로 임의로 고치지 않고 사용자 결정으로 남겼다. DESIGN.md 4.2절 9(k.ZVS 한 점)도 정본이 낙관적인 쪽이 됐다(2.091 → 스윕 1.824) |
| 2026-09-23 | **(45차) 그림 11 에 게인 곡선 패널 · 영·한 간결화.** 사용자: "above/below/at resonance 를 파형으로는 잘 설명했지만 게인 곡선에서 어디에 해당하는지 모르겠다. 추가하고, 불필요하거나 너무 긴 설명은 삭제·단축하라." **그림 11(`an_three_cases`) 아래에 게인 패널 추가** — 세 열의 f_sw/f_r(0.70 · 1.00 · 1.30)를 M(f_n) 위 점으로 찍고 "below: M > 1, boost · at f_r: M = 1 at any load · above: M < 1, buck" 을 달았다. 영역 색은 그림 12(f04)와 같게(capacitive 분홍 · boost 초록 · buck 파랑). **곡선은 Half load(Q = Q_pk/2 = 0.38)** — Full load(Q = 0.766)의 ZVS 경계가 f_n = 0.726 이라 0.70 점이 capacitive 에 떨어져 왼쪽 열(inductive 파형)과 모순된다(계산 확인: M(0.70, 0.766) = 1.42 이지만 경계 밖). Full load 곡선은 자기 ZVS 경계부터만 점선으로 그렸다. 가운데 열은 파형 모델에서 데드타임 때문에 0.90 으로 그려져 있으나 게인 패널에는 정의대로 f_n = 1 에 찍었다. AN 2.5 절 캡션을 위/아래로 나누고, 세 불릿 머리에 M 관계를 넣었으며, AN 2.6 절의 같은 규칙 불릿 3개는 한 문단으로 줄였다("첫 행" → "왼쪽 열" 오류도 정정). **간결화(영·한 동일, 각 507 → 503 항목)** — 삭제: STEP 1·2 note(그림 캡션과 중복) · 권선 식 뒤 proximity note(본문과 중복) · 손실 절 B_pk/주파수 note(2.12 절과 중복, 한 문장으로 불릿에 흡수) · 2.12 "전류 제한은 코어를 지키지 못한다" 불릿(앞 불릿과 합침). 단축: 2.12 도입 예고문 · 자속 단계 그림 캡션 · capacitive 불릿 끝 · 경계 이동 문단 · "벌크 커패시터가 없으므로" 반복 · 차트 실수 note 의 메타 문장 · No load 해 없음 note · OVP2 절의 "자속을 올리지 않는 것" 목록(2.12 절 참조로) · 설계 게인 차트 캡션의 불릿 중복 문장 · FB 경계 불릿 · 16.8 Ω·W 항목. 한국어판에 남아 있던 소문자 open 4곳 → Open. `figcheck` an_three_cases 0건(전체 10건은 손대지 않은 그림의 기존 tiny/nodot — HEAD 에서도 11건) · `an_check` 양 판 기하 문제 0 · 미해결 참조 0 · 북마크 106 · `an_symbols` MISSING 0 · 영문 94쪽 · 한국어 95쪽 |
| 2026-09-23 | **(44차) 애매한 조건 표현 전수 정리 · 목차 링크와 북마크.** 사용자: "표 17 의 누설 인덕턴스 조건 '1차, 2차 Short' 는 1차·2차를 다 Short 하라는 것 아니냐. 이런 식으로 애매하게 쓴 것이 없는지 PDF 한 줄 한 줄, 모든 표와 그림을 확인해 고쳐라. 목차를 누르면 해당 절로 가게 하라." **목차:** `an_pdf.Doc.afterFlowable` 이 h1/h2 마다 PDF 목적지(`bookmarkPage`)와 개요(`addOutlineEntry`)를 만들고 TOCEntry 에 키를 넘긴다 → 두 판 모두 목차 링크 212개(항목 106 × 제목·쪽 번호)가 제 절로 가고, 뷰어 옆 창에 장·절 북마크 106개가 뜬다(`showOutline`). `multiBuild` 가 여러 번 도므로 키 번호는 `handle_documentBegin` 에서 0 으로. **표 31개 전수:** 측정 조건 — 표 17 Open/누설/DC overlap 을 "NP1 에서 측정, 나머지(NS2·NS3·NAUX) Open" / "NS2·NS3 모두 Short, NAUX Open" / "100 kHz · 1 V 에 DC 15 A 겹침, 상온" 으로(벤더 사양서와 일치), 표 4·13·기호표·6.10 본문의 L<sub>open</sub>·L<sub>short</sub> 조건도 같게; 동작 조건 — 표 17 1차·2차 전류에 "HB 경계, Full load", 스위칭 주파수에 "라인 피크, HB~FB 경계, 영교차에서 f<sub>o</sub> 까지 내려감", 코어 면적에 "f<sub>r</sub> 에서", 표 7 주파수에 "라인 피크, Full load", 표 12 캡션에 피크(θ=90°)와 라인 사이클 실효값의 구간, 표 18 hold-up 에 "100 Vac, 골에서 19 V 까지"; 기호 혼동 — 표 8·23 이 f<sub>sw,max</sub>(사양 225 kHz) 기호로 249 kHz(최고 동작 주파수)를 적던 것 → "f<sub>sw</sub>(FB 경계, 라인 피크)"; 대상 — 표 8 손실 행을 "정류 레그당" · "고정 1차 소자"; 단위 — V<sub>BO</sub> 84.8 V 를 "피크 120 V = 84.8 Vac rms"(표 22·27), 표 25 "60 V / 70 V" 를 "피크 60 V 아래 정지, 70 V 위 동작"(DS 표 기준); 뜻 — 표 21 "R<sub>BM</sub> 30 → 27.4" 를 문장으로, 표 24 OCP2 "즉시 정지, 50 µs 뒤 재기동", sense 손실 두 행의 평균/최악 구분, 표 12 f<sub>sw</sub> 행의 "오실레이터 하한 검사"(틀린 용도) → "아래 피크를 읽은 스위칭 사이클", 표 9 의 a → b 가 계산값 → 선정값임을 캡션에. **그림 48장 전수:** 그림 5·12 범례 "full load" 에 Q 값, 그림 14 light/half/overload 에 Q 값, 그림 26·30 의 "332.3 V · 173.2 V · 166.2 V · 100/120/230 V" 를 Vac(eq.) 로, 그림 42 DC-overlap 패널 "secondary open" → "all other windings open", "L at 1–2" → "L at NP1", 그림 45 "SECONDARY OPEN" → "ALL OTHER WINDINGS OPEN", 그림 12 "flatters the margin"(관용구) → "overstates". 본문의 "secondary open" 두 곳도. figcheck 새 지적 0. `an_check` 두 판 무결점 · `an_symbols` MISSING 0 · 잔재 0. 영문 94쪽 · 한국어 96쪽. |
| 2026-09-23 | **(43차) 한국어판 AN 3차 전수 낭독 — 뜬금없는 단어·직역 명사.** 사용자: "여전히 어색한 단어가 많다. 아무 선, 포일 같은 것 — 다시 전수조사해라." 95쪽 본문을 다시 읽고 **문구 약 460곳**을 고쳤다. 대표 치환: 포일 → **동박** · 아무 선 → **선종 무관** · Litz 의 가닥/다발 → **소선/완성 외경** · 서빙한 다발 → 서빙까지 한 리츠선 · 창(window) → **권선창**(자기) / **구간**(시간) / **선택 범위·허용 범위**(부품값) · 창 이용률·fill factor → **점적률** · 나란히 감은 권선 → **분할 권선** · 덮다(cover) → 커버하다 · 반사인파 → **정류 사인파**(입력) / **사인 반파**(공진 전류) · 넘기다(refer) → 환산하다 · 축약 회로 → 등가 회로 · 열다(open) → open · 이긴다 → 결정한다/우선한다 · 산포 → 편차 · 보통의 → 일반 · 끌어오다 → 입력 전력 · 쉬는 → 도통하지 않는/스위칭하지 않는 · 뒤 단계 → 이후 계산 · 산수 → 계산 과정 · 무릎 → knee 점 · 흔들다 → 스윙시키다 · 거울상 → 대칭 동작 · 마지막 방어선 → 최후의 보호 · 여지 → 여유 · 앞줄/뒷줄 → 앞 열/뒤 열 · 3차 고조파 budget → 허용치. **절 제목 22개**("만든 대로·정한 대로·감은 대로" 류 직역 제목 → "설계 결과", "숫자를 끝까지 따라가기" → "단계별 계산", "전력은 어디로 가나" → "손실 분배" 등; 7.2 는 "주요 설계 값" 으로 구분), 장 참조의 "절" → "장"(2·3·5 장), 앞머리 문구·기호 설명·개정 이력, `cores.PIN_NOTE_KR`. **읽다가 찾은 사실 오류 2(영문판도 수정):** ① 7.6 "Three readings" 인데 글머리표가 4개 → "Four readings" / "읽을 점은 넷이다". ② 기호표 λ 후보 설명이 "the smallest wins" 였으나 `l6790.py` 는 `lam = max(l1, l2, lTD, l3)` 이고 STEP 8 본문도 "가장 큰 것" → "the largest binds" / "가장 큰 것이 결정한다". **함정 재발 1:** 치환으로 들어간 "±10&nbsp;%" 가 `%` 포맷 문자열 안이라 빌드가 죽었다 → `%%`. `an_check` 두 판 무결점 · `an_symbols` MISSING 0 · 잔재 검색 0. 영문 94쪽 · 한국어 95쪽. |
| 2026-09-23 | **(42차) 2.12 플라이백 대 LLC 보강 · DC overlap 시험 절 신설(영문·한국어 동시).** 사용자: "두 토폴로지에서 코어에 자속이 실제로 생기는 순서를 각각 만들어 비교하고, 무엇이 달라져 결국 어떤 차이가 나며 설계 때 무엇을 염두에 둘지 넣어라. 트랜스포머 설명과 설계 예제 양쪽에서 DC 오버랩이 무엇이고 왜 그 이름이며 어떤 상황 때문에 필요한지, 어떻게 재는지, 왜 OVP2 기준인지, OVP2 같은 기능이 없으면 어떻게 정하는지 상세히." **새 그림 2:** `an_flux_steps`(그림 18) — 플라이백 DCM 3단계와 below LLC 4단계를 같은 네 행(스위치 · 권선 전류 · N<sub>p</sub>i<sub>p</sub>−N<sub>s</sub>i<sub>s</sub> · B)으로 나란히, 기울기 V<sub>in</sub>/(N<sub>p</sub>A<sub>e</sub>) 대 V<sub>out</sub>/(N<sub>s</sub>A<sub>e</sub>)·T<sub>r</sub>/2 와 피크가 정해지는 순간을 표시(LLC 열은 8구간 모델에 설계 전류). `an_dc_overlap`(그림 33) — LCR 미터 + DC 바이어스 전원 + 다른 권선 open 의 벤치, 그리고 L(I<sub>dc</sub>)/L(0) 예시 곡선에 I<sub>eq</sub> 12.41 · I<sub>sat</sub> 15.2 · I<sub>OCP1</sub> 22.92 A 표시(곡선은 예시라고 캡션에 명시). figcheck 0건. **2.12:** 단계별 설명 7개 · 비교표(표 "같은 코어 둘", 자속을 정하는 권선 · 부하/주파수 의존 · 갭의 역할 · 코어를 위협하는 것과 지키는 보호 · 포화 시험 전류 · A<sub>e</sub> 근거) · 설계 유의점 6개(볼트-초로 A<sub>e</sub>, 갭 더 두지 말 것, OCP 는 코어를 못 지킨다, 시험 전류는 L<sub>μ</sub> 를 따라간다, 코어 손실은 주파수, 탱크 피크로 포화 요구하는 습관). **6.19:** 사양서 줄의 뜻과 이름의 유래(LGE 사양서 "D.C OVERLAP, 90 % of initial inductance, test current, normal temperature", HP-4284A 100 kHz/1 V — LCR 의 소신호에 DC 를 겹쳐 흘리는 측정법; DC bias · DC superposition 과 같은 시험) · 무엇을 드러내나(A<sub>L</sub>·L<sub>open</sub> 이 못 잡는 자속 여유) · **OVP2 인 이유**(DS 5.2.7: OVP1 2.3 V 는 전력을 줄인 채 스위칭 계속, OVP2 2.5 V 는 100 ms 정지 후 재기동 → 코어가 구동되는 최고 출력 = OVP2) · 자속을 올리는 것/안 올리는 것 · 온도(B<sub>s</sub> 약 1/5 하락) · **OVP2 가 없을 때** 4갈래(구동을 멈추는 다른 OVP 의 threshold · 전력만 줄이는 보호는 상한 아님 · 상한이 아예 없으면 I<sub>sat</sub> = I<sub>OCP1</sub> · 관행값 1.2~1.5배는 사건이 없다). **7.9:** 이 설계 숫자로(OVP1 ×1.126 → 110 mT, OVP2 ×1.224 → 120 mT, 사양 줄 15 A), 이 부품에서 재는 법(NP1 핀, 나머지 open, 100 kHz/1 V, 0→15 A 이상, L(15 A) ≥ 0.9 L(0) ≈ 31 µH, 단계 짧게), OVP2 가 없었다면(OCP1 22.92 A = 1.51배, 이 코어 180 mT, 0.20 T 목표 코어라면 0.30 T → 면적/N<sub>s</sub> 1.5배; 관행 1.3배 = 16.1 A 는 우연). 기호표에 I<sub>dc</sub> · I<sub>p,pk</sub>/L<sub>p</sub>(플라이백 비교용) · B<sub>s</sub> 추가. 한국어판은 "DC 중첩" → "DC overlap" 으로 통일. `an_check` 두 판 무결점 · `an_symbols` MISSING 0. **영문 94쪽 · 한국어 95쪽.** **발견한 불일치(미수정):** 벤더 사양서 빌더(`build_trans_spec.py`)는 I<sub>sat</sub> 15.19 를 올림해 **16 A** 로 적고, AN 본문·표 16 은 `%.0f` 로 **15 A** 로 적는다 — 어느 쪽으로 맞출지 결정 필요. |
| 2026-09-23 | **(41차) 한국어판 AN 전수 낭독 — 번역투·AI 말투 2차 정리.** 사용자: "여전히 어색한 표현이 있으면 다시 수정해라. 한국어 원어민이 됐다고 생각하고 PDF 를 한 줄 한 줄 읽어라." 93쪽 본문을 문단 788개로 뽑아 처음부터 끝까지 읽고 **문장 약 125개**를 고쳤다. 유형별로: **영어 직역 동사** — 훑다(sweep) → 스윕하다/바꿔 가며, 나르다(carry) → 옮기다/감당하다, 닫히다(close, 스위치) → 켜지다, 부서지다(break) → 파손되다, 좇다 → 따라가다, 처지다(sag) → 내려가다, 막다(limit) → 제한하다, 접다(fold) → 줄이다/포함시키다, 가르다(decide) → 판별하다, 닫다(close, 검사·항목) → 완결·확정하다; **직역 명사구** — 감은 그대로(as wound) → 실제 회로/구조, 요구 게인의 사다리 → 요구 게인 선이 여러 개, 개관(overview) → 한 그림에 겹쳐, 빈(bin) → 랭크, 부하의 성질 → 부하가 정하는 값, 권선 기하 → 권선 배치, 의존 순서 → 서로 의존하므로 순서대로, 들어올 소자(incoming device) → 켜질 소자; **의인화·은유** — 모터가 틀린다/정류기가 틀린다 → 모터 부하/정류기 부하에서 나빠진다, 살아남지 못한다 → 쓸 수 없다, 버스 리플과 싸워 뭉갠다 → 리플에 반응해 망가뜨린다, 컨트롤러가 자기 변수로 답한다 → 손댈 수 있는 변수는 하나뿐, 거저 얻는 것 → 공짜, 부하가 원한다 → 요구한다, 나란히 앉는다 → 놓인다, 상용전원이 돌아올 때까지 → 전압이 다시 올라올 때까지; **절 제목 4** — "보정기는 어떻게 고치나" → "PFC 회로는 어떻게 동작하나" · "역률 1 이 고르게 실어 오지 못하는 에너지" → "역률 1 에서 고르지 않게 들어오는 에너지" · "컨트롤러는 어떻게 하나" → "컨트롤러는 무엇을 하나" · "히스테리시스 띠, 그리고 실제로 뜻하는 범위" → "히스테리시스 띠와 실제 동작 범위"(`SR()` 참조도 같이). 남긴 것: 실효값 · 영교차 · 역회복 · 순환 전류 · 도통 같은 현장 용어, "닫힌 식"(closed-form). `an_check` 무결점 · 93쪽 · 잔재 검색 0. |
| 2026-09-23 | **(40차) 한국어판 AN — 억지 한자어를 현장 용어(영어)로.** 사용자: "억지로 한자어 쓰지 말고 원래 많이 쓰는 기술 용어는 영어로. 권선 개방 → 권선 Open 식으로, 다른 케이스 전부." `an_kr_body.py` 어휘 3,600개를 훑어 바꾼 것: 개방/단락 → Open/Short · 극점/영점 → pole/zero · 문턱/임계 → threshold · 위상 여유 → phase margin · 교차 주파수 → crossover 주파수 · 오차 증폭기 → error amp · 무부하/경부하/전부하/과부하 → No load/Light load/Full load/Overload · 표피 깊이/근접 효과 → skin depth/proximity effect · 전류 감지 → sense/sensing · 곱셈기 → multiplier · 유휴 시간 → idle 시간 · 불감대 → dead band · 예산 → budget · 우반평면 영점 → RHP zero · Bode 선도 → Bode plot · 전고조파 왜율 → THD · 저전압 잠금 → UVLO · 냉간 기동 → cold start · 연면 → creepage · 접합 온도 → junction 온도 · 면적곱 → area product · 미접속 → NC · 방열판 → 히트싱크 · 리액터 → 인덕터 · 명령 → 지령 · 꼭대기 → 피크 · 소산 → 손실 · 하류 → 뒤 단계 · 귀환 경로 → 리턴 경로 · 절점 → 샘플 점, 그리고 낱말 몇 개(표어 · 거래 · 사슬 · 계통 · 소자망 · 휴지 · 소진 · 되민다). 그대로 둔 것: 실효값 · 영교차 · 역회복 · 천이 · 기자력(2026-09-17 지시) · 정류 · 도통 · 정격 · 과전류/과전압 · 기동 · 보상기 · 분압기(현장에서도 한국어로 쓰는 말). **규칙:** 영어 낱말 뒤 조사는 한국어 발음의 받침을 따른다(threshold → 를/가/는, phase margin → 을/이/은, budget → 을/이/은, load → 를/가/는). 치환 스크립트가 파이썬 문자열이 줄에서 끊긴 자리도 잡도록 글자 사이에 `(?:'\s*')?` 를 넣었다(교차 주파수 3곳이 그렇게 숨어 있었다). `an_check` 무결점 · 93쪽 · 잔재 0. |
| 2026-09-23 | **(39차) 한국어판 AN 전면 재이식 + 한국어 자연화.** 사용자: "한국어판도 그동안의 수정 내용을 적용하되, 한글 설명이 이상한 표현이 많다 — 한국 원어민 엔지니어로서 읽고 번역투·AI 말투를 고쳐라." `an_kr_body.py` 를 **영문 `an_body.py` 를 문장 단위로 따라가며 전부 다시 썼다**(29·30·35·36·37·38차 전부 반영) — h1 10 · h2 96 · eq 67 · calc 62 · note 56 · fig 46 · eqagain 34 · tbl 30 이 영문판과 키·순서까지 같다. 입력 전압 6조건 이름은 `_kc()` 로(HB edge → HB 경계 · FB edge → FB 경계 · Vac eq. → Vac 등가), 핀 표의 front/back row 는 `_kr_row()` 로, 핀 번호 주는 `cores.PIN_NOTE_KR` 신설. `ZVS_WORST`/`_zvs_grid` 는 영문 모듈에서 가져온다. **자연화 규칙(이번에 정한 것):** 바닥/천장 → 하한/상한 · "먹이다" 금지(구동/공급/이어진다) · 울린다 → 공진한다 · 후하다/인색하다 → 낙관적/보수적 · 곡선 벌 → 곡선군 · 표제 → 대표 · 그러니 → 따라서 · 계산값 뒤 조사(은/는/이/가)는 문장을 바꿔 피한다("그림 N 에 … 놓았다"). **함정:** `T()` 가 포맷 안 된 `%%` 를 거부한다 — `%` 포맷을 안 거는 문자열에 `%%` 를 쓰면 빌드가 죽는다(7곳). 일괄 치환이 "바닥나기" 를 "하한나기" 로 만든 사고 1(→ "다 떨어지기"). `an_check` 무결점 · 글꼴 누락 글리프 0 · 잔재 검색(후하/인색/먹이/바닥/천장) 0. **한국어판 93쪽**(영문 92쪽 — 한글 본문이 조금 길다). `an_kr_pdf.py` 의 V1.3 개정 행을 영문판과 맞췄다. |
| 2026-09-23 | **(38차) 영문 AN 전수 낭독 검토 — 92쪽 본문 전부와 그림 46장.** 사용자: "한 줄씩 읽어보고 설명·수식·그래프·파형·회로도에 오류 없는지, 글자·그림·화살표가 겹쳐 안 보이는 건 없는지 검토해서 수정해라." **수식 오류 1:** 식 12 `M(θ) = n·Vo,eff/(√2·Vac,eq·sinθ)` 에 **계수 2 가 빠져 있었다** — 등가 입력은 FB 에서 2×Vac 로 정의되므로 구동 진폭은 √2·Veq·sinθ/2 이고, `l6790.py` 와 7장 Step 4 는 이미 `2n·Vo,eff/(√2·Veq)` 로 계산한다(173 Vac eq 에서 1.229 — 2 가 없으면 0.615). 식만 고쳤다. **그림·본문 불일치 1:** 그림 45(`f19_cout_criterion`)가 P·f.l·Δv·T.hold·k 를 코드에 박고 자체 계산해 hold-up 67.7 mF · 판정 1.05× · 에너지 막대 7.9/8.9/9.9 J 를 그렸는데 본문(시트)은 67.2 mF · 1.060 · 7.9 J 이었다 → 그림이 `an_pdf.V`(C.ripple · C.hold_req · E.hold · C.bulk · ripK · n.C)를 읽도록 고쳐 7.9 / 7.9 / 8.8 J, 144·160개로 일치. **옛 표현 잔재 4:** 4.5 절 "Section 7.6 draws it twice"(→ 6 입력 전압) · 4.7 절 "profile at four inputs"(→ six) · 7.19 절 "minimum line"(줄바꿈 때문에 37차 검색에 안 잡힘) · 표 9 열 제목 "Condition"(→ Input voltage). **정의 불일치 1:** 기호표의 V.eq,max 가 "모핑 문턱(332)" 이라 했으나 Γ.v 계산은 시트대로 V.AC_max = 264 를 쓴다 → 기호표를 실제 용법(HB 경계와 교류 최대, ST 툴의 Γ.v 정의)으로. **참조 오류 1:** 7.3 절 k.Ploss 설명이 "6.24 절이 진행 이유를 말한다" 고 했으나 그 절엔 없다 → "standing position 에 3 W 를 만족하는 600 V 소자는 없다, 방열은 실측" 으로 본문에 적고 7.12 참조. 그 밖에 데이터시트 "Table 5" 가 본 문서의 표 5 로 읽히던 것("its Table 5"), C.T,min 문장(RT 30 kΩ 에서 fMin 을 fo 까지 내리는 조건). **그림 겹침 3:** 그림 23 패널 2 의 "deficit" 라벨이 곡선 위(→ 곡선 위쪽 빈 곳에 화살표로) · 그림 36 의 "two integrators: −180°" 가 위상 곡선 위(→ −180° 선 아래) 와 "−60" 단위 누락(→ −60 dB/dec) · 그림 31 의 `n = nT/Mv` 에서 Mv 가 본문에 없는 기호(→ √(1+λ)). 나머지 42장은 배선 방향·극성점·전류 경로·파형 대응까지 확인했고 이상 없음(전류 경로: 1차 dot 로 들어가면 2차 dot 에서 나온다 — 스텝 1·5 모두 맞다). 검산한 수치 30여 개(k.BO 1.061 · 176 pF · 92.25 kHz · 2.8/0.167 · 61.6 mm² · 245× 등) 전부 일치. `an_check` 무결점 · `an_symbols` MISSING 0 · figcheck 새 지적 0(f19 in-bar 글자 tiny 는 기존). 92쪽. **한국어판 미반영 — 다음 차례.** |
| 2026-09-22 | **(37차) 게인 곡선으로 공진 어느 쪽인지 읽는 법 · 그림 23 삭제 · 그림 42 를 6조건으로 · "line" → "input voltage".** 사용자: "Figure 11 이 below/at/above 를 설명하긴 했는데 게인 곡선으로 어떻게 판별하는지가 빠졌다. Figure 23 은 24 와 겹치지 않나. Table 10 은 'minimum line' 같은 모호한 표현 말고 90 VAC 라고 적고 V_eq 가 AC 인지 DC 인지 명확히. 입력 전압은 line 이 아니라 input 이라고 불러라. Figure 42 도 173 Vac eq 만 그릴 이유가 있나 — 하려면 6종 전부. 글자가 곡선을 가리고 그리드가 흐리다." **2.5 절**에 판별 규칙을 넣었다 — 모든 곡선이 f_n = 1 에서 M = 1 을 지나므로, 요구 게인 수평선이 1 보다 위면 교차점이 왼쪽(below, boost), 1 이면 f_r, 아래면 오른쪽(above, buck); 어느 쪽인지는 입력 전압이 정하고 부하는 어느 곡선을 만나는지만 정한다. **그림 23(`f11_power_balance`) 삭제** — 그림 24(`an_pf_chain`) 패널 2 와 같은 내용이라 문장으로 그 패널을 가리킨다(`figs.py` 의 함수는 한국어판이 아직 쓰므로 남긴다). **Table 10** 은 36차 이후 이미 6종 라벨("90 Vac (FB), 180 Vac eq.")이었다 — 열 제목만 "Input voltage (bridge mode)" · "V_eq (Vac rms)" 로, 값에 Vac 단위. **"line" 을 전압 크기의 뜻으로 쓴 곳 16곳**(low/high/minimum line · line voltage · line condition)을 input voltage 로 바꿨다; 파형 용어(line cycle · line phase · line peak · line frequency)는 그대로. **그림 42(`an_xfmr_read`):** 아래 왼쪽의 173 Vac eq 한 조건 패널을 **6 입력 전압 × 두 권선 패널 둘**로 — 1차 rms 와 2차 권선 rms 를 각각 6곡선, 범례에 이름을 두고 곡선 위 글자를 없앴다. 계산으로 확인한 사실: **HB 경계(173 Vac eq)가 두 권선 모두에서 가장 크다**(1차 라인 사이클 rms 10.92 · 90 Vac FB 10.76 · 110 FB 9.95 · 230 HB 9.76 · 264 HB 9.25 · FB 경계 8.96 A; 2차 28.41 → 24.93 A) — 표를 HB 경계에서 읽는 이유가 그림 자체로 보인다. 그리드 `#C4C8CF`, DC-overlap 패널은 폭을 줄이고 "not 18.3 A" 를 안쪽으로. `figcheck` 새 지적 0(기존 halo 1건은 채움 위 글자). `an_check` 무결점 · `an_symbols` MISSING 0. **한국어판 미반영.** |
| 2026-09-22 | **(36차) 라인 조건을 6종으로 — 모핑 경계 둘에 실사용 전압 넷(90 · 110 · 230 · 264 Vac)을 더했다. 표지도 위로.** 사용자: "게인 곡선을 모핑 지점(173 · 332 Vac eq.) 근처로만 했는데, 가장 극단적인 케이스인 건 알겠지만 실생활에서 쓰이는 전압(90 · 110 · 230 · 264 Vac)을 기준으로 하는 게 맞지 않나. PDF 전체가 173/332 eq 만 중심으로 설명하지 말고 6가지 다 설명해라. 차트 글자가 곡선을 가리고 그리드가 회백색이라 안 보인다. 표지는 제목과 Worked design 이 밑으로 쏠려 있다." **`l6790.line_conditions(R)` 한 곳**에 6종을 정의했다 — HB 경계 173.2 · 90 Vac FB → 180 · 110 Vac FB → 220 · 230 Vac HB → 230 · 264 Vac HB → 264 · FB 경계 332.3 (등가 입력 오름차순). `an_gain_design`(그림 38) 은 **2×3 = 6 패널**, 패널마다 자기 조건의 요구 게인 점선 3개와 교차점 — 곡선은 입력 전압에 안 변하므로 6패널 전부 같은 곡선이고 점선만 움직인다는 것이 그림 자체로 보인다. 시트 §7.5 가 "여섯 조건을 한 장에 얹은 개관 프레임은 오독을 부른다" 고 뺐던 이유는 유지된다 — 패널을 나눠 곡선을 남의 선과 비교할 수 없게 했다. 패널 안 글자는 곡선이 없는 오른쪽 위에, 그리드는 `#C4C8CF` 로 진하게, 활자는 `figcheck tiny` 가 0 이 되는 크기(12 pt)로. `an_above_below`(그림 39) 도 6곡선. 7.6 절에 "실사용 전압 넷은 경계 안에 있다 — 90 Vac FB(180) 는 HB 경계보다 4 % 위라 거의 최악점, 110 Vac FB(220) 와 230 Vac HB(230) 는 5 % 차라 두 계통이 탱크에는 거의 같다, 264 는 FB 경계보다 21 % 아래" 를 수치 보간으로 적었고, 6.2 절에 등가 입력 대응표 문장을 넣었다. 교차점 표(`gainpts`) 는 18행, `_fsw_peaks` 와 ZVS 격자 열도 같은 목록을 읽는다(전에는 세 곳이 각각 다른 조건 집합을 갖고 있었다: 7종 · 5종 · 4종). **표지:** 띠와 제목 · 부제 · Worked design 상자를 위쪽 절반에 차례로(제목이 쪽 중간, 상자가 맨 아래에 떨어져 있었다). 92쪽(패널 6개와 18행 표로 +1) · `an_check` 무결점 · `an_symbols` MISSING 0. **한국어판 미반영.** |
| 2026-09-22 | **(35차) 영문 AN 전문 간결화 — 102 → 91쪽.** 사용자: "설명이 너무 장황하고 비원어민이 이해하기 힘든 단어나 문장구조가 많다. 하늘색 박스도 불필요한 건 삭제하거나 줄여라. 너무 쉬운 설명(피크 전류 같은 것)은 생략. 한 줄 한 줄 읽고 페이지 수를 줄여라. 다른 회사 AN 을 참고해라." `an_body.py` 의 `build()` 문장 706개를 전부 읽고 **373개 문장을 다시 쓰거나 지웠다**(1~2장 101 · 3~5장 54 · 6장 117 · 7장 98 · 부록 3). 편집 원칙 — 짧은 평서문, 관용구·서술자 개입("worth doing once", "hangs off") 제거, "Section X 가 그것을 다룬다" 식 예고문 삭제, 기본 개념(역회복 원리 · 역률 정의 · 하드 스위칭 손실) 한 문장으로, 파란 박스는 설계 결정을 바꾸는 경고만 남기고 요약·예고·되풀이 박스는 본문에 녹이거나 삭제(34개 → 22개 정도로 문자 수 절반). 그림·수식·표는 하나도 안 뺐고 캡션만 줄였다. **수치:** 본문 산문 101,720 → 67,754자(−33 %), 파란 박스 33,713 → 16,697자(−50 %), 캡션 등 137k → 117k. **도구:** 문장 단위 치환기 `an_patch.py` 신설(ast 로 `build()` 의 최상위 문장 span 을 잡아 고유 키 부분문자열로 통째로 교체, 키가 0개·2개 이상 맞으면 아무것도 안 건드림) — 긴 원문을 그대로 베끼지 않아도 되므로 오타 위험이 없다. **검증:** `an_check` 무결점 · `an_symbols` MISSING 0(SILENT 46 → 53 — 산문에서 빠진 기호가 늘었지만 표에는 전부 있다) · 빌드 exit 0. **남은 것:** 쪽 아래 빈 공간 합계 10.8쪽(3·7·40·93·56쪽 순) — 그림이 다음 쪽으로 밀리며 남는 것이라 본문을 더 줄여도 안 준다. 그림 배치 쪽에서 봐야 한다. **표 29개에 `split=True`** 를 달아(리스트를 돌려주므로 `add` → `ext`) 통째로 밀리던 큰 표가 쪽 경계에서 나뉘게 했다 — 쪽수는 93 그대로이고 빈 공간 합계만 10.8 → 10.4쪽. **앞부분에서 2쪽을 더 찾았다** — "Before you start" 의 Conventions 마지막 한 줄이 3쪽으로 넘쳐 그 쪽이 통째로 비어 있었고(목록을 절반으로 줄여 2쪽 안에), 목차가 3쪽 + 9줄이라 7쪽이 거의 비어 있었다(`toc0/toc1` 행간 14.4/12.8 → 13.6/12.0). **최종 91쪽**, 빈 공간 합계 8.7쪽 — 남는 것은 마지막 쪽과 그림 밀림(각 200~280 pt)이다. 개정 이력 V1.3 의 "한국어판 동일 내용" 을 "to follow" 로 고쳤다(사실이 아니었다). `.claude/rules/an.md` 에 간결화 규칙을 추가했다. **한국어판 미반영.** |
| 2026-09-22 | **(34차) 폴더 정리 — `HISTORY.md` 를 `docs/` 로, 기계 상태 파일 untrack, 지도에 없던 Altium 프로젝트 발견.** 사용자: "폴더 구조와 내부 파일도 저기서 추천한대로 이동하거나 이름을 수정하거나 해봐. 필요 없으면 안 해도 되고." **한 것:** ① `HISTORY.md` → `docs/HISTORY.md`(`docs/DESIGN.md` 옆, 루트에는 `CLAUDE.md` 만 남는다; `audit_md`·`coldstart` 의 경로 수정) ② `.guard_stamp.json`·`.snapshot_prev.json` 이 **git 에 추적되고 있었다** — 기계마다 다른 mtime 스냅숏이라 클론마다 diff 가 난다. untrack + `.gitignore` ③ **`LGE_670W_L6790A Single Stage PFC LLC TV Power/` — 본 보드의 Altium 회로도 프로젝트**(`L6790A_Si.SchDoc` · `L6790A_GaN.SchDoc` · SCHLIB · 1쪽 PDF, 표제 "LG L6790A Single Stage PFC LLC")가 2026-09-16 Drive 임포트로 들어와 있었는데 **`CLAUDE.md` 에도 이 문서에도 한 줄도 없었고, 어느 산출물과도 대조된 적이 없다.** 지도에 넣고 "다음 할 일" 에 대조 항목을 올렸다가 **사용자가 같은 날 "Altium 회로도와 해당 폴더는 검사 대상에서 무시해" 로 결정** — 대조 항목을 내렸고, 이어서 **"깃허브 레포에서 해당 폴더는 아예 삭제해"** 로 `git rm -r` 했다(12파일 3.5 MB, 원본은 Drive). 지도에서도 뺐다. Altium ECO 로그 4개(`Project Logs/`)는 컴파일마다 생기는 것이라 untrack + ignore. **안 한 것과 이유:** 상위 폴더 이름(`Design Guide/generators/` → `tools/` 등)은 바꾸지 않았다 — 80개 스크립트가 자기 위치 기준 상대경로로 돌고, 이 문서와 README 가 그 경로로 수백 번 가리키며, 사용자 PC 의 Excel·SMath 경로도 걸려 있어 위험 대비 이득(토큰 0 · 정확도 0)이 없다. `Uncryped_…xlsx` 의 오타도 사용자 파일이라 두었다. 스킬은 만들지 않았다 — README §9.1 과 Stop hook 이 이미 그 역할이다 |
| 2026-09-22 | **(33차) 프로젝트 문서 구조 개편 — `CLAUDE.md` 33,002 → 5,946자(102줄), 나머지는 읽을 때만 읽는 문서로.** 사용자가 wikidocs 의 CLAUDE.md 작성 가이드(200줄 이내 · Claude 가 코드에서 추론할 수 있는 것은 빼라 · 지시가 많을수록 절반을 무시한다 · 긴 것은 파일로 분리하되 `@` 임포트는 시작 시 같이 로드된다 · 드물게 쓰는 전문 지침은 필요할 때만 로드되게)를 주고 "우리 프로젝트 구조도 뜯어 고치자 … 너한테 모든 권한을 줄게" 라 했다. **새 구조 — 문서는 넷이고 로드 시점이 다르다:** ① `CLAUDE.md`(매 세션 자동, 102줄): 무엇을 만들고 지금 어디이고 뭘 하면 되나 · 파일 지도 · 다음 할 일 · 절대 규칙 9개 · 검증 세 줄 ② **`docs/DESIGN.md`(신설, 288줄)**: 옛 CLAUDE.md 의 설계 절 — 1.3 결정 · 3 현재 설계값(정본, `snapshot.py` 가 쓴다) · 4.2 미확정 · 4.3 실측 · 5 동작 원리 · 6 반복 실수 · 7 문서 성격. **절 번호를 그대로 가져갔다** — 이 문서와 README 가 그 번호로 가리키고, "시트 §N" 접두어가 SMath 시트와 CLAUDE.md 두 뜻으로 쓰여 온 것을 정규식으로 못 가르기 때문이다(DESIGN.md 머리에 그 사정을 적었다) ③ `Design Guide/generators/README.md`(도구 체인, 407줄) ④ `HISTORY.md`. **`.claude/rules/` 신설 4종** — `smath.md`(옛 README §11.1 `.sm` 함정 26가지) · `xlsx.md`(옛 README §11.2 + BOM 셀 + 사양 변경 시 같이 바꿀 셀) · `figures.md`(기호 크기 · 접점 점 · figcheck · 한글 가드 · `--plain`) · `an.md`(이름 참조 · 손수치 금지 · mathtext 함정 · 한국어 용어) — **`paths:` 프런트매터로 해당 파일을 건드릴 때만 로드된다.** 경로 조건이 안 먹는 버전이면 항상 로드되며 그래도 합계 12,500자다. README §11 은 포인터만 남겼다. **Stop hook 을 실제로 걸었다** — `.claude/settings.json` 이 `guard.py` 를 부른다(추적 파일이 바뀐 턴에만 5종 검사, 실패 시 exit 2). 이 컨테이너에서 dry run 으로 exit 2 와 사유 출력을 확인했다 — 개편 중 낡은 참조 8건을 그것이 잡았다. **도구 4개를 새 자리에 맞췄다** — `snapshot.py`·`guard.py` 의 `DOC` 을 `docs/DESIGN.md` 로, `audit_md.py` 는 DESIGN.md 를 넷째 문서로 읽고 `docs/DESIGN.md §N` 교차 참조를 검증하며 `문서는 넷` 을 표와 대조, `coldstart.py` 는 CLAUDE.md 가 이름으로 부르는 문서 셋(README · DESIGN · rules/)을 **따라가서** 답을 찾고 어느 문서에서 답했는지 찍는다(17 → 12 + 9). §6.1 항목 8 · 8c · 8d · 13 은 규칙만 남기고 경위는 이 문서(2026-08-24 · 09-17~21)로 보냈다 — 전부 여기 이미 있는지 문자열로 확인한 뒤 지웠다. **턴당 비용: 약 12,200 → 2,000 토큰**(설계·도구·규칙 문서는 필요할 때만). |
| 2026-09-20 | **AN 의 타사 그림 15장을 전부 다시 그렸다 — `figs_ref.py`.** 배포용 문서에 ON Semiconductor · Infineon · Toshiba · MPS 의 AN 에서 잘라 온 그림이 실려 있었다. 전부 우리 코드로 다시 그렸고 **캡션은 그림의 출처가 아니라 논지의 출처**를 인용한다. 원본 크롭은 `figures/an_ref_*_raw.png` 4장만 기록으로 남기고 어느 산출물에도 안 싣는다. **다시 그리면서 틀린 것 셋을 고쳤다** — ① 용량성/유도성 경계를 게인 피크에 긋던 두 장을 `zvs_edge` 로 옮겼다(`CLAUDE.md` 시트 §6.1 항목 8b) ② capacitive/inductive 파형 두 칸을 `phase()` 에서 직접 그린다. 처음에는 8구간 패널의 시간영역 모델로 그렸는데 **그 모델은 항상 ZVS 파형을 내므로 유도성 파형 둘에 이름표만 다르게 붙인 꼴**이었다 ③ 세 경우 비교 그림은 공진 위/at 에서 반사인파를 **절단**한다 — 8구간 타임라인은 `f.sw = f.r` 에서 프리휠링 길이가 이미 음수다. **2026-09-22 에 이 기록을 `CLAUDE.md` 에서 옮겨 왔다** — 그때까지 이 문서에 없었고, `CLAUDE.md` 시트 §7 은 그 반대로 "일반 LLC 이론 그림은 onsemi·Infineon 출처, 외부 배포 시 각 사에 확인할 것" 이라고 적고 있었다. 같이 고쳤다 |
| 2026-09-22 | **(24차) v1.3 — OP 앰프 등가 회로 · 예제 Bode · 한국어판 전면 이식 · 참고문헌 제목 복구** (사용자: TL431 보상 회로를 OP 앰프로 등가한 회로도, 위상 여유·gain margin·교차 주파수를 표기한 Phase/Gain 그래프 예시, 전문 재검토, 한글판 수정, 두 판 1.3). **6.29:** `an_comp_opamp` — TL431 을 비반전 입력이 V.R 에 묶인 OP 앰프로 놓고 R.I 입력 저항 + Z.f = C.Fo ∥ (R.F + C.F) 궤환 임피던스의 반전 증폭기, 캐소드 전류 = LED 전류(V.Z 에서 R.B 로 공급되므로 fast lane 없음), 옵토의 전류 게인 CTR, FB 핀 풀업 R.FB 와 C.opto + C.fx 의 극점 — 세 인수의 곱이 식 42 의 `G.EA(s)` 이고 부호는 음(부궤환). 그림 라벨은 `v.FB = -i.C · R.FB ∥ C` 로 부호를 적었다. **6.31:** `an_loop_example` — 자기 교차 f.c 단위의 2적분기 + Type II 루프(영점 f.c/K, 극점 K f.c, f.px)에 교차(|T| = 0 dB) · 위상 여유(교차에서 -180° 까지의 거리) · gain margin(f.180 에서 |T|) · 2f.l 의 점을 표시. 설계 수치가 없으므로 6장에 둘 수 있고, 7.13 이 같은 그림 위에 이 설계의 숫자를 얹는다(`an_loop_bode`). **참고문헌:** 19차(fa19176)에 `h1('References')` 가 지워져 참고문헌 10건이 기호표 아래 제목 없이 붙어 있었다 — 복구, 정오표가 10장. **한국어판:** `an_kr_body.py` 를 처음부터 다시 썼다(2725 → 3529행). 영문 `an_body.py` 를 절 단위로 따라가며 그림·표·수식 호출과 키를 같은 순서로 두고 글만 옮겼다. 새로 옮긴 절: 2.8 다이오드 역회복 · 2.12 플라이백 비교 · 6.13~6.21 트랜스포머(코어 두 면적·권선 배치·갭·창·표피 깊이·절연·손실) · 6.26~6.33 보상망 8절 · 7.4 9단계 · 7.8 핀 배정 · 7.9 코어와 권선 · 7.13 13단계 · 8장 기호표 · TND381. 2~6장의 설계 수치도 영문처럼 걷어냈다. **NanumGothic 에는 그리스 문자가 없다** — v1.2 한국어판은 맑은고딕이 있는 PC 에서 만들어 몰랐고, 이 컨테이너에서 첫 빌드에 λ·θ·π·Ω 가 전부 빠졌다(pymupdf 로 본문에 λ 가 있는지 확인해 잡았다). `an_pdf._wrap_missing()` — `T()` 가 본문 서체의 `charToGlyph` 에 없는 글자(이름 엔티티 포함)를 `<font name="AN">` 으로 감싸고, 제목과 표 머리는 `_boldalt()` 가 `AN-B` 로 바꾼다. `use_korean()` 이 Liberation Sans 를 `AN` 으로 같이 등록한다(맑은고딕 PC 에서는 등록만 되고 안 쓰인다). `EQWORD`/`EQAGAIN` 로 수식 표제어를 판마다 정한다(`식 N` · `식 N, 다시`). **검사:** 두 판 92쪽 · 식 64 · 그림 45 · 표 28, `an_check` 둘 다 `no geometry problems found`. 영문 6장 새 두 절과 그림 두 장을 다시 읽어 라벨 2건 고침(`Equation D3 needs` → `the D3 check needs`, v.FB 부호). v1.2 PDF 둘은 삭제. |
| 2026-09-22 | **(25차) 그림 35 를 회로 기호로** (사용자: 회색 상자로는 무엇을 하라는 건지 알 수 없다, V.R 이 뭔가, 제대로 된 등가 회로를). `an_comp_opamp` 를 다시 그렸다 &mdash; TL431 을 점선 상자 안의 **OP 앰프 + 전압원 V.R = 2.495 V(내부 기준)** 로, 애노드 = 접지 · R.O 도 그려 넣고 "신호 전류가 안 흐른다" 고 적음 · 옵토커플러를 **LED(빛 화살표) + 포토트랜지스터(NPN 기호)** 로, R.B 는 V.Z 레일에서, R.P 는 LED 에 병렬(ST 도면 그대로) · FB 핀은 IC 내부 풀업 R.FB 와 C.opto + C.fx. 회색 블록 두 개(V.R · i.LED/i.C 식)를 전부 없앴다. 세 인수 식은 그림 아래 한 덩어리로. 본문과 캡션(두 판)에 V.R 이 무엇인지와 R.O 가 게인에 안 들어가는 이유를 적었다. `figcheck` 겹침 0(`tiny` 는 쪽 배율 보고). |
| 2026-09-22 | **(26차) 그림 35 세 번째** (사용자: 그림 안 수식도 본문 수식과 같은 글씨체로 · 포토커플러 기호를 그대로 쓰지 말고 회로 이론에 맞는 등가 기호로 · OP 앰프 출력의 궤환 접점에 점이 없고 출력 핀에 너무 붙어 있다). 수식 라벨을 **STIX mathtext** 로(`math_fontfamily='stix'`, `\dfrac`, 12.5 pt — 본문 수식 PNG 와 같은 활자) · 옵토커플러 트랜지스터 쪽을 **전류 제어 전류원(CCCS, 마름모) `CTR·i.LED`** 로, LED 가지에 제어 전류 `i.LED` 화살표 — TND381 의 소신호 모델 그대로 · 출력 노드를 삼각형 꼭짓점에서 0.8 떨어뜨리고 접점 점을 찍었다. 캡션·본문(두 판)을 맞췄다. |
| 2026-09-22 | **(27차) 그림 35 네 번째 — TL431 을 기능 블록도대로** (사용자: R.O 는 TL431 의 일부가 아닌데 왜 점선 상자 안에 있나, 지금 등가가 맞긴 하나). 상자를 부품이 실제로 담는 것으로 줄였다 — 증폭기(REF 가 **비반전**, 내부 기준 V.R 2.495 V 가 **반전** 입력) + 출력 NPN(컬렉터 = K, 이미터 = A). 트랜지스터가 반전하므로 REF → 캐소드가 반전이고 캐소드 → REF 궤환이 부궤환이 된다. 이전 판은 그 두 반전을 합쳐 입력을 맞바꾼 OP 앰프 하나로 그렸는데 단자 거동은 같지만 부품 안의 구조가 아니었다. R.O · R.I · Z.f 는 상자 밖. 핀 이름 REF · K · A 를 상자 경계에 적었다. 본문·캡션(두 판)을 그 서술로 고쳤다. |
| 2026-09-22 | **(32차) `CLAUDE.md` 의 §9·§11 을 `Design Guide/generators/README.md` 로 옮겼다 — 69,548 → 36,670자.** 31차에서 "옮기면 턴당 23,200 → 12,200 토큰이지만 README 를 안 읽은 세션이 `.sm`·`.xlsx` 를 깨뜨릴 수 있다" 고 사용자에게 물었고, **"옮기자. 옮기고 엑셀이랑 smath 파일 수정할 때 리드미 참고하라고 하지뭐"** 로 결정됐다. 옮긴 것은 README §9 도구 체인(27,924자)과 README §11 도구 함정(6,090자)이고, `CLAUDE.md` 에는 **무엇이 거기 있는지와 "고치기 전에 읽어라" 규칙만** 남겼다. **절 번호 9·11 은 README 안에서 그대로 유지한다** — 두 문서에 README §9.3b · README §11.1 D-25 같은 참조가 수십 개라 번호를 바꾸면 전부 끊긴다. **옮기면 검사가 조용히 꺼진다는 것이 진짜 위험이었다** — `audit_md.py` 의 개수 대조(regions·pages·yellow·plots·pictures·paper·BOM)는 `if m2:` 로 되어 있어 **문장이 사라지면 아무 말 없이 통과**한다. 그래서 `audit_md` 가 README 를 셋째 문서로 읽게 하고, 보고에 **주장을 실은 파일 이름**이 찍히게 고쳤다. 검출력은 음성 시험으로 확인했다 — README 의 `yellow inputs 113` 을 99 로 바꾸니 `README.md claims "yellow inputs 99" but tool reports 113` 이 나왔다. `coldstart.py` 도 같은 문제였다(질문 4개가 FAIL 로 떨어졌다: 검증 방법 · 재빌드 안전성 · 워크북 직접 수정 · 금지 함수). **가리키는 대로 따라가게** 고쳤다 — `CLAUDE.md` 가 `Design Guide/generators/README.md` 를 이름으로 부를 때만 그 파일을 읽고, **README 로 답한 질문을 따로 찍는다**(17 + 4). 포인터가 사라지면 그 4개는 다시 FAIL 이다. `QUALIFIERS` 에 `README` 추가, 끊어진 교차 참조 6개 수리(README 안의 시트 §8 · 시트 §8.1 · 설계 절(`docs/DESIGN.md` §1~§7) · 작업 규약(옛 CLAUDE.md §10)과 `HISTORY.md` 의 `CLAUDE.md §9.3`). **턴당 비용: 약 23,200 → 12,200 토큰.** |
| 2026-09-22 | **(31차) 토큰 비용 정리 — `CLAUDE.md` 89,424 → 69,163자, 죽은 스크립트 4개 삭제.** 사용자 지시: "토큰비용을 줄이고 계산시간을 단축하기 위해서 불필요한 파일이나 스킬이나 훅을 삭제하고, md 파일 내에도 불필요한 내용 있으면 삭제하려 해. 하나하나 전수조사해서 정리해." **먼저 무엇이 실제로 돈을 쓰는지부터 쟀다** — `.py` 파일은 읽지 않는 한 턴당 0 토큰이므로 **지워도 절약이 아니다**. 턴마다 통째로 들어가는 것은 `CLAUDE.md` 하나(약 29,800 토큰)뿐이라 정리 노력을 전부 거기에 썼다. **훅과 스킬은 애초에 없었다** — `.claude/` 가 빈 폴더인데 시트 §9.1b 는 Stop hook 이 걸려 있다고 적고 있었다. 그 절을 "지금은 없다, 켜려면 이렇게" 로 고쳤다. **`CLAUDE.md` 압축(≈20,000자)** — AN 행의 11,193자 변경 이력 → 792자 운영 행 + `HISTORY.md` 3차~30차 포인터(지우기 전에 23개 `차` 항목이 전부 `HISTORY.md` 에 있는지 스크립트로 확인했고, 유일하게 없던 v1.2 한국어 용어 결정은 버리지 않고 시트 §10.1 로 옮겼다) · 시트 §6.1 8c–8e 4,701 → 912 · variants 행 2,052 → 558 · ZedGraph 시트 3행 2,140 → 329 · `figcheck.py` 행 2,216 → 845 · 기호 크기 규칙 1,617 → 664 · 이미 지운 xlsx 2개의 행 삭제. **삭제: build_sm.py · recrop2.py · deck2.js · guide_vals.py** — 79개 생성기 모듈을 전수로 훑어 import 도 `__main__` 도 없는 것만 골랐다. **`smgen.py` 는 살아 있어 남겼다**(`smsheet.py` 가 import 한다) — 도구표가 "현행 체인에 안 쓰임" 이라고 잘못 적고 있어 고쳤다. 문서에 없던 `an_kr_pdf.py` · `audit_notes.py` 행을 새로 넣었다. **`coldstart.py` 가 윈도 절대경로(`c:\Users\KKH\...`)로 박혀 있어 이 컨테이너에서 한 번도 안 돌고 있었다** — 스크립트 기준 상대경로로 고쳤고, 정리 후 질문 21개 전부 `CLAUDE.md` 안에서 답이 나온다. **전수조사에서 나온 것 둘** — ① `Design Guide/AN_L6790A_Design_Guide_rev2_1.md`(7.5:1 예제, 165 KB, rev 2.0 과 316줄 차이)가 2026-09-16 에 만들어졌는데 `CLAUDE.md` 에도 여기에도 **기록이 없었다**. 권선비 결정이 대기 중이라 **둘 다 살아 있는 설계점**이므로 지우지 않고 도표 행에 적었다 ② 정본 `.sm` 이 이 컨테이너에서 재빌드하면 줄바꿈만 CRLF → LF 로 바뀌어 23,732줄 차이로 보인다. 내용은 한 바이트도 다르지 않아 되돌렸다. `audit_md` 무결점 · `check_sm` VERDICT OK · `bom_compare` 0 · `xl_sm_compare` 145/145 · `snapshot --check` 최신. |
| 2026-09-22 | **(30차) 기호 전수조사 — `an_symbols.py` 신설, 기호표 130행.** 사용자 지적: "`a.s` 처럼 뭔지 미리 말도 안 하고 툭 튀어나오는 경우 없는지 전수조사하고, 맨 마지막 테이블에 빠진 것 없는지 빠짐없이 넣어라." **도구로 했다** — `an_body.build()` 의 `p`·`eq`·`calc`·`tbl`·`fig`·`note`·`bullets` 를 기록기로 바꿔치기해 다시 실행하면 `% dict()` 보간이 끝난 최종 문장을 **문서 순서대로** 읽을 수 있고 수식 PNG 는 한 장도 안 그린다. TeX 토크나이저(`\\cmd` 와 글자열을 한 이름으로, `CTR`·`GM` 을 C·T·R 로 쪼개지 않게)와 본문 토크나이저(`X<sub>y</sub>` · 그리스 엔티티 · 홑글자)를 따로 두고, 아래첨자의 세 표기(`\\mu` · `&mu;` · `mu`)를 접어 맞춘다. **기호표 쪽은 `_SYM` 소스를 그대로 읽는다.** **첫 실행: 쓰인 기호 288개 중 175개가 표에 없었다.** 기호표를 10개 그룹 130행으로 다시 썼다 — 도체 치수 · 역률 정의 · FB 법칙 상수 · 보상망의 rad/s 주파수 · 손실 항목 · 스위치/정류기 이름 · 오실레이터 창 · 마진. 지금 **MISSING 0**. **수식 10개에는 문장도 보탰다** — 패러데이(`v`·`N`·`A.e`) · 갭(`g`·`μ.0`) · 표피깊이(`ρ`·`f`) · 역률(`P`·`V.rms`·`I.rms`·`I.1,rms`·`φ.1`) · 순시전력(`V.ac`·`I.ac`·`ω.l`) · FB 법칙(`V.os`·`K.HV`·`K.M`·`K.FF`) · λ 후보(`λ.2`·`λ.TD`) · 창(`N.w`·`A.cu,w`) · 보상망(`ω.z`·`ω.p`·`ω.px`·`C.ser`) · 게인(`V.drive`). **도구 정밀도에서 배운 것 셋** — ① 단위 글자로 거르면(`V`·`A`) `V.out`·`A.e` 가 통째로 날아간다. 홀로 선 것만 단위다 ② 기호표를 본문으로 세면 모든 기호가 "맨 뒤에서 소개된다" 가 되므로 `symtab` 으로 빼야 한다 ③ **홑글자는 기계가 판정할 수 없다** — `C` 가 기호인지 100 °C 인지 산문에서 안 갈린다. 표에서 시드를 받아 전부 찾게 했더니 이번엔 0 건이 돼 반대로 틀렸다. 그래서 **못 한다고 말하고 목록만 주는** 쪽으로 정착했다(15건). **가다가 조판 결함 둘도 잡혔다** — `\\qquad` 가 다음 기호에 붙어 mathtext 에 `\\qquadf` 가 넘어갔고, `2nV<sub>o,eff</sub>` 가 한 단어로 조판됐다. `CLAUDE.md` 도구표·표준 절차·기대값에 추가. 102쪽 · 67식 · `an_check` 통과. **한국어판 미반영.** |
| 2026-09-22 | **(29차) PF 를 어떻게 맞추는지, 그리고 게인 곡선이 왜 일반 LLC 와 다른지 — 영문판만.** 사용자 지적 셋. ① **"PF 를 맞춰나가는 설명이 부족하다. 그냥 수식만 띡 있다."** 4장에 그림이 한 장도 없었다 — `an_pf_chain`(라인 반주기 4칸: 역률 1 의 뜻 → 2 P.in sin²θ → 탱크에 요구되는 게인과 부하 → f.sw(θ))과 세 위상 대입표를 넣고, **IC 가 실제로 하는 일**을 FB 핀(느린 신호, 얼마나) · HVSU 핀(빠른 신호, 라인의 어디인가) · 내부 PFC/THD 블록(둘을 합쳐 I.EA)으로 갈랐다. **그 블록 안의 법칙은 DRAFT 데이터시트에 없으므로 없다고 적었다** — 대신 탱크에서 "나와야 하는" 프로파일을 계산해 보이고, f.sw(θ) 실측이 그 블록의 특성화라고 명시. Cardano 3차식은 절을 따로 뺐다. ② **엑셀의 게인 차트가 일반 LLC 것과 다르다, 비교 절을 만들어라.** 4.5 신설 — `an_gain_compare`(왼쪽 일반 LLC λ=0.20, 계열=부하 · 오른쪽 단일단 λ=0.55, 계열=라인 위상)와 차이 6가지. **가장 흔한 오독**(다른 위상의 곡선과 선을 비교)을 주의 상자로. 7.6 신설 — `an_gain_design`(저입력 코너 · FB 코너)과 교차점 6개 표, 값은 `figs_pf.gain_points()` 로 시트 스윕과 같은 출처. ③ **Table 13 의 표피 깊이 0.19 mm 와 0.0079 가 어디서 나왔는지 없다, 설계 예제가 전체적으로 날림이다.** 7.9 에 δ 대입 · a.s = πd²/4 · n.s · d.litz 식 신설, 그리고 7.8(전류 — 합성 피크가 합이 아닌 이유와 5점 Simpson) · 7.12(1차 정적 도통과 SR 도통의 I²R) · 7.16(C.T,max · R.T,ceil) · 7.17(R.CS 두 조건과 병렬 개수) · 7.18(R.BM) · 7.19(R.CFG · V.BO) · 7.20(ZCD 분압 4식) 에 대입 줄을 달았다. 66식 · 47그림 · 30표 · 99쪽. **그림 수정 4건도 같은 날** — Fig 4 `an_fha_steps` 전압원이 루프 모서리에 서 있었고 1번 칸에 불필요한 꺾임(1차 권선을 L.m 과 같은 두 레일에 걸었다) · Fig 13 `an_cap_ind` 에 커뮤테이션 회로 2장을 **가운데 줄**로 넣었다(`figs_ref.commutation()` 을 떼어 `an_recovery` 와 공유, 2.8 절은 그 그림을 가리킨다) · Fig 37 `an_above_below` 의 왼쪽 글상자가 범례를 되풀이하고 퍼센트가 무엇의 비율인지 없었다(범례 항목으로 옮기고 제목이 한 번만 말한다) · Fig 40 `an_xfmr_read` 의 2차 전류가 1차 기준 축에서 잘리고 범례가 그 위에 얹혀 있었다(축 둘, 곡선마다 자기 이름). `figcheck` 에 twinx 예외(같은 자리의 축 둘은 한 패널이다). Fig 40(f12)의 `sin^2(theta)`·`f_o` 같은 ASCII 라벨도 수식으로. **한국어판 미반영.** |
| 2026-09-22 | **(28차) 그림 35 비례 재조정** (사용자: 미리보기 회로가 엉망이다 — 피드백 루프가 너무 크고, OP 앰프가 너무 크고, V.R 쪽 선이 너무 짧고, BJT 가 너무 납작하다). 레이아웃을 다시 잡았다 — 궤환 루프를 REF 노드 5.6 → 8.1 로(전 5.6 → 8.6, 증폭기가 3.5 아래에 있어 루프 높이가 5.7 이었다) 줄이고, 삼각형을 2.2 × 2.2 → 1.7 × 2.0 으로, BJT 베이스 바를 0.8 → 1.3 에 컬렉터·이미터 사선을 0.62 × 0.62 로(전 0.35) 세우고, V.R 리드를 반전 입력에서 0.65 + 소스 아래 0.85 로 늘렸다. **그리고 기준 전압을 접지가 아니라 애노드로 되돌렸다** — 데이터시트대로이고, 이제 점선 상자를 지나는 배선이 REF · K · A 셋뿐이다. 핀 이름은 상자 밖에. **그리고 같은 날 두 번째 지적으로 접지를 갈랐다** — 보상망은 2차측이고 FB 핀은 1차측이며 그 사이가 옵토커플러, 즉 절연 장벽이다. 양쪽을 같은 접지 기호로 그리면 이어져 있다는 뜻이 되므로, 1차측은 채운 삼각형(`figs_ref._pgnd`)으로 따로 그리고 장벽을 점선으로 세워 `secondary side` / `primary side` 를 적었다. CTR 전류원과 C.opto + C.fx 의 접지까지 내려오는 길이도 2.25 · 2.40 → 1.05 · 1.35 로 줄였고, 삼각형(1.7 × 2.0 → 1.45 × 1.7)과 BJT(베이스 바 1.3 → 1.05)도 더 줄였다. |
| 2026-09-22 | **단일 트랜스포머 검토 — PQ 40/40 도 PQ 50/50DG 도 안 들어간다** (사용자: "이 가이드는 트랜스포머 1개를 썼을 때를 기준으로 해야 해 … PQ4040 이 턱없이 부족하면 미리 말해줘"). 한 코어에 15 : 2 를 감으면 **자속은 문제가 아니다**(B.pk 는 N.s·A.e 만의 함수 — PQ 40/40 109 mT · PQ 50/50DG 62 mT). 막히는 것은 **권선 형상과 누설**이다. `cores.winding` 으로 재면 1차 15 T 리츠(ø2.37)는 2층이면 축방향 19.0 mm · 반경 4.74 mm, 3층이면 11.9 · 7.11 이고 2차 권선 하나가 28.3 A 라 6.3 mm² → 포일 0.2 × 15.7 두 장 병렬. **PQ 40/40**: 권선폭 21.4(마진 제외)·반경 4.85 → 분리 간격 −12 mm. **PQ 50/50DG**(B65981Q·B65982E, 사용자가 PDF 로 전달 — TDK CDN 이 이 컨테이너를 403 으로 막는다): A.e 332(필요 103 의 3배) 인데 창은 오히려 **얕다** — 외각다리 안쪽면 31.5 min → 반경 15.75, 관 ø23.2 → **반경 4.15 mm**, 권선폭 30.4. 분리 간격 −7.5 mm. `cores.CORES`·`MECH` 에 등록했다. **누설은 코어 크기와 별개의 문제**: L.short ∝ N² 라 같은 형상에서 15 T 한 코어는 5 T 세 코어 합의 3배. 러프 모델(3코어 형상 대입 5.4 µH 대 시트 3.67 — 1.5배 과대)로 나란히 감기 59~79 µH(간격 0), 동심 3.2 µH, 목표 11 은 그 사이 — 1차 분할(8 | S | 7)이나 스페이서로 벤더가 맞춰야 한다. **필요한 창**: 나란히 배치면 권선폭 ≥ 약 40 mm 와 반경 ≥ 5 mm, 3층 1차면 권선폭 ≥ 약 30 mm 와 반경 ≥ 약 8 mm. PQ 계열은 전부 얕아 부적합 — ETD 49/54 급(깊은 창)을 후보로 제시했고 **그 치수는 데이터시트가 없어 확인 대기**다. 단일 코어 A.L 138 nH(PQ 50/50DG 재고 100/250 사이, 주문 사양). **PQ 50/50DG 코일포머 도면에는 핀 번호가 찍혀 있다**(1 왼쪽 아래 → 6 위, 7 오른쪽 위 → 12) — 같은 TDK 계열이라 PQ 40/40 에 가정한 반시계 번호와 일치하지만, B65884E 자체의 확인은 아니다. **AN 은 아직 3코어 그대로** — 코어가 정해지면 `N.x` = 1 변형 → 7.8~7.9 재작성 → 사양서. |
| 2026-09-21 | **(20차) 설계 예제 7.8 에 트랜스포머 기호 + PQ 40/40 보빈 핀 배정** (사용자: "트랜스포머 심볼 만들어서 어느 권선과 어느 핀이 무엇인지 표기해야지. 핀 배열은 PQ4040 보빈 핀 배열 참고하고"). **근거는 TDK B65884E 도면 3쪽(FPK0430)** — 단자 12개, 한쪽 6개가 3개씩 두 무리, 무리 안 피치 5.08, 두 무리 안쪽 핀 사이 15.24, 두 열 사이 38.1, **핀 1 표시는 평면도 왼쪽 아래 모서리**이고 그 밖의 핀 번호는 도면에 없다. 벡터 좌표로 재서 확인했다(핀 표시 2.1 pt 정사각형이 y 345.2·356.2·367.1·398.8·409.7·420.6 · x 138/219 → 피치 5.10 mm, 열 간격 37.8 mm — 라벨 5.08/38.1 과 일치). **번호 방향은 가정이다** — 핀 1 에서 반시계(표시 쪽을 따라 1→6, 반대쪽 7→12, 12 가 1 의 맞은편). 데이터시트가 말하지 않으므로 벤더 보빈 도면으로 확인할 것이라고 AN 캡션·사양서 주석·`cores.py` 에 같이 적었다. **배정은 방향과 무관**하다(어느 무리에 어느 권선인지는 도면이 정한다). **배정:** NP1 1–3 · NAUX 4–6(표시 쪽 = 1차 기준 권선 둘) · NS2 7–9 · NS3 10–12(반대쪽) · **센터탭 = 9 와 10 을 PCB 에서 결합**(15.24 간격을 사이에 둔 이웃 핀) · 각 무리 가운데 핀(2·5·8·11)은 비운다(리츠 다발과 포일 끝이 핀 하나씩, 남는 핀이 두 단자를 띄운다). 극성점 = 시작 = 짝의 첫 핀; NS2 끝과 NS3 시작이 탭이라 두 권선은 같은 방향. **한 곳에서 읽는다** — `cores.PIN_XY`·`PINMAP`·`CENTRE_TAP`·`pins()` 를 그림(`figs_ref.an_xfmr_pins`)·AN 표(`pins`, `legend42`)·**벤더 사양서(`build_trans_spec.py`)** 가 같이 읽는다. **그래서 사양서 4종의 단자가 바뀌었다** — 예전 `1 – 2 / 3 – 5 / 4 – 6 / a – b` 는 LGE 양산품(26OP-LM83W) 승인원 방식이었고 PQ 40/40 12핀 보빈과 맞지 않았다(1차·2차가 같은 쪽). `check_trans_spec` 불일치 0. **그림 `an_xfmr_pins`:** 왼쪽 한 유닛의 기호(NP1·NAUX·NS2·NS3, 단자마다 핀 번호, 시작/끝, 탭 결합), 오른쪽 보빈 평면도(치수 3개를 도면 그대로 표기, 핀마다 권선 색 고리, 핀 1 표시). `figcheck` 0건. AN 7.8 에 배정표 `pins` 와 **3유닛 결선 문단**(1차 직렬 3→1 · 보조 직렬 6→4 · 2차 병렬 7끼리/12끼리/9+10 끼리, 직렬은 dot–non-dot · 병렬은 dot–dot). 영문 80쪽 **같은 날 간격 완화**(사용자: "설계 예제에서 갑자기 줄간·항목 간 간격이 좁아졌어") — 수식 라벨 위 5 → 12 pt · 수식과 대입 산수 아래 0 → 10 pt · 표 위 6 → 10 pt · 표 캡션 아래 11 → 13 · 문단 뒤 7 → 8. 77 → 80쪽 **그리고 수식 크기 통일**(사용자: "작은 것은 너무 작다, 일관성이 없어 … 분수 안에 있더라도 분수가 아닌 것과 사이즈가 같아야지") — 원인 둘: ① `eq()` 가 열 폭을 넘는 수식을 *축소* 해 넣고 있었다(긴 수식만 작아졌다). 이제 축소하지 않고 **열 폭을 넘으면 빌드가 실패**하며(`an_pdf.WIDE`, `check_refs()` 에서 보고) 저자가 줄을 나눈다 — `eq()`/`calc()` 가 tex 리스트를 받아 여러 줄로 쌓는다. 넘던 것은 `B.pk`·`A.e` 대입 한 줄뿐이었다(498 pt). ② mathtext 의 `\frac` 은 분자·분모를 text style 로 70 % 축소한다 — `eqpng()` 가 `\frac` 을 전부 `\dfrac`(display style, 축소 없음)으로 바꿔 그린다. 81쪽 · 식 49 · 그림 42 · 표 29. **한국어판 미반영.** |
| 2026-09-21 | **(19차) 설계 예제를 AN4932 방식으로 — 문장 → "Equation N" → 수식 → 대입 산수, 그리고 기호표** (사용자가 ST AN4932(HVLED001A 플라이백 AN)를 예시로 첨부: "너가 만든 설계 예제에서는 무슨 수식을 써서 도출했는지 도대체 알 방법이 없어 … 순서대로 잘 돼있지. 글 간 간격도 깔끔하고 사용한 수식도 뭔지 깔끔하고. 용어정리도 마지막에 해놓고 … 계산 수식이나 공식 폰트 사이즈도 적절하고. 우리껀 너무 크거나 너무 줄간 간격도 좁고 … 항목 하나하나를 있는 그대로 수정하라는 뜻이 아니야. 글을 어떻게 쓰는지 수식은 어떻게 소개하는지 보라는 거야"). **AN4932 에서 배운 것** (`Reference/AN4932 HVLED001A enhanced QR high PF flyback controller.pdf`, 설계 장 32~53쪽, 부록 B 약어표 57~59쪽): ① 수식마다 **한 문장 도입 → 굵은 `Equation N` 줄 → 본문 크기의 가운데 수식 → 그것을 쓰는 다음 문장**의 네 박자 · ② 설계 장에서는 **앞에서 세운 식을 번호로 다시 부르고 그 아래에 숫자를 대입한 산수를 한 줄 더** · ③ 문서 끝의 기호·약어표. **`an_pdf.py`:** `EQSIZE` 12 pt(본문 9.3 pt 의 1.3배 — 예전 판은 그보다 컸다) · `eq()` 가 위에 `Equation N` 라벨 줄을 붙이고 이미지를 가운데 정렬(`KeepTogether`) · **`eqagain(key)`** 가 같은 식을 `Equation N, repeated` 로 다시 그리고(**`EQTEX` 에 tex 를 보관**하므로 식이 두 곳에서 어긋날 수 없다) · **`calc(tex)`** 가 번호 없는 대입 산수 줄 · 행간 12.2 → 13.2, 문단 뒤 6 → 7, 노트·표 셀도 같이 · `tbl(split=True)` 로 긴 표가 쪽을 넘고(머리 반복) 표 위 6 pt. **`an_body.py`:** 2.4 에 `f.n`·`Z.0`·`Q`·`λ` 정의식 신설(`Qdef`) — 7장이 부를 식이 없었다 · **7.4 를 Step 1~9 로** (굵은 도입 문장 → `eqagain` → `calc` 굵은 결과) + 결과표 한 장(Step·Quantity·Eq.·Result) — 예전 사슬표는 "Computed as" 열에 산수를 글로 눌러 담아 무슨 식인지 안 보였다 · 7.8 의 `B.pk`·`A.e`·`I.eq`·`I.sat` 와 7.10 의 리플·홀드업·스크리닝도 같은 박자 · **8장 `List of symbols`** 신설(약 50행, References 앞). **AN4932 를 그대로 베끼지 않은 것:** 표 캡션은 아래 그대로(ST 는 위), 절 끝 수식 요약표는 넣지 않았다(결과표가 그 역할). 영문 77쪽 · 식 49 · 그림 41 · 표 28. `an_check` 통과. **한국어판 미반영.** |
| 2026-09-21 | **(18차) 설계 수치는 설계 예제(7장)에만 — 2~6장은 기호로, 7장은 표 하나에 산수까지** (사용자: "설계 예제 이전에 있는 전류값이나 전압값이나 에너지값 같은 것들은 갑자기 왜 튀어나오는거야? … 여전히 여기저기 그래프나 파형이나 회로나 테이블에 많잖아 … 설계 예제도 완전히 지금 개판이야. 글만 엄청 많고 … 테이블도 너무 많고"). **옮긴 그림 7장:** `f12_two_divergences`·`an_above_below`(7.6) · `an_tank_current`(7.7) · `an_xfmr_read`(7.8, 표시 1~7 그대로) · `f19_cout_criterion`(7.10) · `an_loop_bode`(7.13). **`f14_fsw_theta` 는 AN 에서 뺐다** — `an_above_below` 가 같은 곡선을 `f.r` 기준선과 함께 그린다. **2~6장에서 걷어낸 숫자:** 2.9 경계 노트의 105.4/110.1 kHz·−8.4° → 7.5 · 2.16 의 685 W → 7.1 노트 · 3.2 홀드업 7.9 J·274 µF·245× → 7.10(그림 캡션) · 3.3 의 1.18 V · 4.6 λ 0.55 · 4.7 의 λ 후보값과 f.Max 319.6 · 4.8 무부하 해(M∞ 0.645 대 0.641, 231 kHz) → 7.4 노트 · 5.2 정적 소자 10.9 A/9.65 W · 5.4 전환 노트 127→249 kHz · 6.1 47 Hz · 6.11 35 % · 6.15 δ 0.19 mm · 6.23 스크리닝 결과 · 6.24 kT 1.8/1.9. 6.8 읽기 표에서 "Worked design" 열을 뺐다. **그림 자체의 숫자:** `f11` 을 p/P 로 정규화(658 W·2.23 J·47 Hz 삭제) · `f02`/`f04` 범례 "full load Q = 0.77" → "full load", f04 콜아웃의 0.73/0.69 f.r 삭제 · `an_loadshift` 범례의 Q 값 삭제 · `f18` 의 "123 → 250 kHz" 삭제. IC 상수에서 오는 173.2/332.3/166.2/346.5 Vac 와 235/245 V.pk 는 남겼다(설계가 아니라 데이터시트). **7장 재구성:** 사양표 4개 → 1개(given/chosen/assumed 열) · 판정 여유 정의 4문단 → 1문단, 노트 2 → 1 · 사슬표에 "Computed as" 열을 넣고 불릿 15개를 지웠다(같은 산수) · "Tank: calculated against selected" 표 삭제(사슬 12~16행과 같다) · 트랜스포머 표에 산수 열, 불릿 3개 삭제, 양자화 노트 삭제 · 출력 뱅크 표에 산수 열, 불릿 삭제 · 손실 노트 절반 · "왜 2 + 2" 문단 삭제. **"2 + 2" 표기 폐기** (사용자: "센터탭이면 2턴 그리고 2턴으로 따로 넣어야지 2+2면 4턴이라는 거야?") — 모든 표에서 **NS2 2 T, NS3 2 T** 로 따로 적고, 범례 표에 NS2·NS3 행을 따로 뒀다. **Figure 31(`f17`)** 의 "held LOW/HIGH" 상자가 자기 파형을 가리고 있었다 — 상자를 없애고 선 옆(위/아래)에 글자만. **한국어판 미반영.** |
| 2026-09-21 | **(17차) AN 전체 중복·장황 정리 — 그림마다 글 하나, 본문의 되풀이 삭제** (사용자: "PDF 한줄 씩 그리고 파형그래프회로도 등 전체적으로 살펴보고 설명이 중복되고 길고 이런거는 삭제하거나 간단화 … 무작정 줄이라는게 아니야"). **가장 큰 중복은 그림 아래 회색 꼬리말(`foot`)과 PDF 캡션이 같은 말을 두 번 하던 것** — 41장 전부. `figs.finish()` 가 **`PLAIN`(AN) 모드에서는 꼬리말을 안 그린다**(교육자료·가이드 PNG 는 그대로). 꼬리말에만 있던 사실은 캡션으로 옮겼다: an_recovery 출처(AN-4151) · f04 영역 구분 출처(ROHM) · f05 ZVS 두 조건 · f14 최고 곡선은 264 V 가 아니라 FB 경계 332 V · an_two_stage 리플 과장 · f02 음영 경계는 무부하 위치 · f11 두 면적이 같다 · an_loop_bode 축이 180°+arg T. `figcheck.run` 은 `figs.PLAIN=True` 로 검사한다(저장되는 그림과 같게). **본문 삭제·축약 15곳:** 모드 그림 뒤 노트 둘을 하나로 · "freewheeling 두 용법" 노트를 절반으로(Toshiba 인용은 한 줄) · 세 경우 불릿에서 정의 되풀이 삭제 · `f.o` 문단과 "두 주파수는 한 범위의 양끝" 노트를 합침 · an_flyback_llc 캡션 200→110 단어 · "게인은 경계조건" 둘째 문단의 반복 삭제 · 설계 절차 "사양" 문단 축약(예제 장이 되풀이한다) · 반도체 절의 정적 소자 노트를 4장 노트로의 포인터로 · 컨트롤러망의 보조권선 문단을 ZCD 절 노트로의 포인터로 · **"Ten things that go wrong" 절 삭제**(System design rules 가 열 항목을 전부 담고 있었다) · 판정 여유 정의 4문단→2 · `R.ac` 노트 축약과 an_fha_steps 캡션의 같은 문장 삭제 · ZVS 검증 3문단→2(같은 절 참조가 두 번) · 권선비 절의 n/n.T 문단을 6.9 절 포인터로. **그림 결함 1건:** f16 반브리지의 두 패널 제목이 겹쳐 있었다("(S4 standing)" 와 "second") — 제목을 짧게. 트랜스포머 장의 "Only the secondary current divides" 노트도 새 표의 첫 행과 같아 뺐다. **그림 42 는 도면 세 장만 남겼다** — 범례 6줄과 권선 표를 그림 안에 두면 적응형 그림 블록이 쪽에 맞추려고 71 % 로 줄여 9 pt 글자가 5 pt 가 됐다. 범례·권선 목록은 본문 표(`legend42`)로, 그림은 9.3 × 4.85 in(패널 인치 크기는 그대로라 축척 불변). 최종 텍스트 스캔: 깨진 참조 0 · 반복 문장 0 · 그림 42/표 33 번호 연속 · 겹친 낱말 1("then then", 사슬표 12행) 수정. **한국어판 미반영.** |
| 2026-09-21 | **(16차) 트랜스포머 장을 파형 중심으로 — 사양 항목마다 "파형의 어디를 읽는가" 를 그림 한 장과 표 하나로** (사용자: "6.8에서 LLC의 전류 파형과 함께 어떤 스펙을 정할 때는 전류 파형에서 무엇을 봐야하고 … 피크값은 이거고 RMS값은 어디서부터 어디의 값으로 구하는 거니까 권선 두께는 이래야 하고 DC OVERLAP 전류는 이러이러한 상황에서의 스펙이니까 … 파형과 함께. 6.8부터 6.21에 다 해당 … 지금은 수식만 남발"). **`an_xfmr_read` 신설** — 최악 사이클(라인 피크 · 173 Vac 등가 · 전부하, `f.sw/f.r` 0.84)의 1차 권선 전류 · 2차 권선 2개 전류 · 2차 권선 전압 세 줄에 표시 1~6, 아래 왼쪽에 라인 반주기의 실효 포락선(`l6790.sweep`, 라인사이클 실효 10.9/9.45 A 가 동선을 정한다), 아래 오른쪽에 DC-overlap 벤치 조건(표시 7: 2차 개방 · 1차 DC · 15.2 A 까지 L ≥ 90 %, 12.4 A × V.OVP2/V.o 에서 온다, 18.3 A 가 아니다). 파형은 8구간 모델(`_cycle`)이고 라벨 값은 시트(`an_pdf.V`)다 — 다른 파형 그림과 같은 규칙. **읽기 표(`xfmr-read`)** 가 표시마다 "무엇을 · 어느 구간에서 · 이 설계에서는 · 무엇을 정한다" 를 적고, AN 의 자속 절 · 창 절 · 포화 시험 절 셋이 각자 표시 번호로 시작한다. 설계 예제 사양서 표의 조건 열에도 표시 번호를 달았다. **Figure 41(단면도)도 같은 지적** ("너무 번잡 · 글이 너무 많고 · 2차측은 2+2라는데 뭔 소린지") — 범례 6줄을 한 줄씩으로 줄이고(②: "NS2·NS3 2턴씩 두 권선을 센터탭에 · 포일 4겹"), 권선 표에 "언제 도통하나" 열(첫/둘째 반주기)을 넣고 권선 방법 열과 인덕턴스 문장을 뺐다(본문 표에 있다). 꼬리말은 절반으로. 본문에는 **"왜 2 + 2 인가"** 문단과 **"전류에서 동선까지" 표**를 넣었다 — 10.93 A ÷ 4.5 = 2.43 mm² → 리츠 310 × ø0.10 → 번들 ø2.37 → 5턴 2층(3 + 2) → 7.11 mm, 9.45 A ÷ 4.5 = 2.10 mm² → 포일 0.20 × 10.5 → 4겹 1.00 mm, 25.4 − 4.0 − 7.11 − 10.5 = **3.79 mm** 가 분리 간격. 예전 권선 표(`winding`)는 이 표가 대체한다(키 유지). **모델과 설계식 사이의 한 가지를 그림에 그대로 두었다** — 프리휠링 동안 `L.m` 이 작은 전압을 계속 보므로 모델의 `i.Lm` 은 스위칭 순간까지 조금 더 오른다(그림 셋째 줄 "rectifier off: L.m still sees a little"). 설계식 `B.pk = V.o/(4 f.r N.s A.e)` 는 도통 구간의 볼트-초만 세고, 정본 시트도 같다. 이 차이를 수치로 주장하지 않았다 — 모델의 데드타임 폭은 그리기 값이다. figcheck: 새 그림 0건(처음엔 9.9 in 높이에 26건 `tiny` → 8.9 in · 글자 9.4~9.6 pt). **한국어판 미반영.** |
| 2026-09-21 | **(15차) 극성점 위치 재정의 · 다이오드 2배 · Figure 1/3/4/28 지적 6건** (사용자: “권선기호는 빨간점처럼. 빨간 박스안에 회로단 정의가 서로 겹쳐져서 더 이상해졌어. figure 3도 센터탭 접점 표시 지워주고. figure 28 은 2 x Vin 글자가 겹친 것, 오른쪽 그래프 글자박스가 곡선을 가림. figure 4 의 가장 왼쪽 회로는 완전히 엉망. 바디다이오드를 제외한 모든 다이오드 2배”). **극성점은 세 번째 자리에서 정착했다** — 리드선 *바깥쪽*(턴이 부푸는 반대편), **첫 턴 높이**. 사용자가 빨간 점으로 그려 준 자리다. 처음 자리(리드선 바깥 위, 단자 높이)는 회로선 위였고, 두 번째(코일과 코어 사이)는 코어 바에 붙었다. 턴은 반대쪽으로 부풀므로 리드선 바깥 첫 턴 옆은 빈 공간이다 — 키트 `DOT = 0.75 × r`, 시트 0.28. `i.p`·`i.s`·`N.s` 라벨을 그만큼 밀어냈다. **Figure 1 그룹 띠** — 변압기가 넓어지자 `transformer` 띠가 양옆 띠와 겹쳐 한 줄로 읽혔다. 띠 경계를 상수가 아니라 **그룹 사이 중점 ∓ 0.18** 로 뒀다. **Figure 4 왼쪽 패널** — 턴이 커지며 변압기 리드선이 코어 양옆 0.9 로 나갔는데 자리는 그대로여서 **1차 리드선이 `L.m` 가지 위에 정확히 얹혔고** 블록이 2차를 덮었다. 왼쪽(소스·`C.r`·`L.r`·노드)을 당기고 변압기를 4.75 로, 블록은 2차 리드선에서 틀 끝까지 채운다. **다이오드** `vdiode` 0.26 → **0.52**, `schem.diode` 0.28 → **0.56**, `_diode_along`(브리지) 도 같이 — **`mosfet()` 의 바디 다이오드는 0.26 그대로**(기생 소자라 작게, 사용자 지시). 8구간 시트의 `D1`·`D2` 이름은 0.38 → 0.60 (삼각형 반폭이 0.40 이 됐다). **Figure 3 센터탭** 접점점 제거 — `xfmr(tap_dot=False)` 가 `nodot()` 을 스스로 선언한다. **Figure 28** — `2 x V.in` 은 x 축을 2.62 → 3.05 로 늘려 화살표 오른쪽에 자리를 줬고, 오른쪽 그래프의 메모 4개는 **곡선이 안 가는 네 모서리**로 옮겨 최대·최소 점에 화살표로 잇는다 (가지 옆에 두면 그 가지를 덮어 어디가 FB 이고 어디가 HB 인지 안 보였다) |
| 2026-09-21 | **(14차) 권선 기호를 반원 하나 단위로 50 % 키우고, 코어·간격·극성점을 그에 맞춰 다시 잡았다** (사용자 지적 6건: “Figure 1에서 트랜스포머 코어 길이가 너무 기니까 맞춰주고. 권선과 코어간 간격 지금보다 3배로. 센터탭에 접점표시 제거. 인덕터와 트랜스포머에서 반원 1개의 사이즈를 50 % 키워달라. figure 6,7,8,9도 마찬가지. figure 18은 권선 표시가 회로선과 너무 가깝고 권선과는 너무 멀어. LLC 그림에서 GND 심볼이 회로선과 겹치고 Flyback에는 GND가 없다”). **턴 반경** `TURN_R`·`WIND_R` 0.14·0.28 → **0.21·0.42**. 반경이 커지면 같은 높이에 들어가는 턴 수가 줄어드는 것이 의도한 맞바꿈이다 — 8구간 시트는 1차 6 → **4**턴(1.68/8 = 0.21) · 2차 각 반 3 → **2**턴(0.78/4 = 0.195), `L.r` 은 폭 0.90 → **1.26**(3턴에 0.21), `L.m` 은 5 → **3**턴(1.32/6 = 0.22). 이제 한 시트 안의 모든 권선이 같은 크기 반원으로 그려진다(예전에는 `L.m` 0.132 대 1차 0.14 대 `L.r` 0.15 였다). **권선↔코어 간격** 8구간 시트 `XP/XS` = `XTR ∓ 0.34` → **∓0.62**. 실여유가 0.07 → **0.28** 로 요청한 3배(0.21)에 0.07 을 더 준 것인데, 그 0.07 이 **극성점이 들어갈 자리**다. **코어 길이** 시트는 `YB−0.38 … YT+0.38` → **`YB−0.10 … YT+0.10`**, 키트는 상수 0.30 → **0.45 × 턴 반경** — 상수로 두면 짧은 권선이 자기 길이의 절반만큼 긴 코어를 달고 “바 두 개 옆에 코일 하나” 로 읽힌다. **극성점은 자기 권선 옆으로** — 예전에는 리드선 바깥 위쪽에 있어 *회로선* 위에 앉았고 어느 코일 것인지 말하지 않았다. 지금은 턴이 부푸는 쪽, 즉 코일과 코어 사이 틈에 놓는다(시트는 리드선에서 0.30 · 단자에서 0.10 아래 — 그 높이에서 바깥 고리가 0.12, 코어 바가 0.49 이므로 양쪽을 자기 반지름만큼 비운다). **센터탭 접점점 제거** — 세 가닥이 만나므로 관례는 점을 요구한다. 사용자 지시로 뺐고, 검사기를 느슨하게 하는 대신 **`schemx.nodot()`** 으로 “여기는 일부러 안 찍었다” 를 도면이 선언하게 했다. `figcheck` 는 그것을 `nodot` 으로 **보고하되 세지 않는다**(레일 `stub` 과 같은 취급) — 그래야 다음번 진짜 누락이 같은 침묵에 묻히지 않는다. **접지** `schem.gnd` 에 `lead` 를 넣었다. `(x, y)` 는 *연결점*이지 첫 바가 아니어서, 레일 높이로 부르면 가장 넓은 바가 배선 위에 그대로 그려져 덩어리로 읽혔다. 리드는 기호와 같은 zorder 로 그려 배선 검사가 “허공에 끝나는 선” 으로 읽지 않는다. 크기도 이제 `X.scale(ax)` 를 타므로 넓은 패널에서 세 개의 짧은 눈금이 되지 않는다. **플라이백에 접지를 넣었다** — 옆의 LLC 에는 있고 여기에는 없어서 두 패널이 리턴 레일을 서로 다르게 말하고 있었다. **키트 결함 하나가 여기서 드러났다** — `schem.ind` 의 “리드가 너무 짧으면 흡수한다” 판정이 `s` 의 비율(4 %)이었는데, **픽셀은 `s` 를 따라 커지지 않는다.** 턴을 키우자 1.35 짜리 인덕터에 0.042 리드가 남았고(비율로는 기준 위, 종이 위에서는 1 px) 양 끝이 한 점에 떨어져 **없는 3갈래 접점**이 두 개 생겼다. 판정을 **턴 반경의 절반**으로 바꿨다. **그리고 한글 글꼴 가드가 배치 작업을 죽이던 것을 고쳤다** — `figs.py --plain` 이 한국어 전용 그림에서 멈췄다. 지금은 그 장만 건너뛰고 끝에 **어느 장을 어디서 다시 그려야 하는지 찍고 exit 2** 로 끝난다(5장: `fsw_theta`·`gain_regions`·`loop_bode`·`morphing_levels`·`tank_current`). 영문 그림 11장 재생성 · `figcheck` 해당 6장 **0건** |
| 2026-09-21 | **(13차) 검사 결과를 PDF 위에 되돌려 놓는 도구를 만들었다 — `an_locate.py`** (사용자: “그렇게 말하면 뭐가 문제인지 내가 PDF에서 확인할 방법이 없는데?”). 맞는 지적이었다. `figcheck` 의 보고는 **`an_core_section` 에 6.0 pt 라벨이 78개** 같은 문장인데, **PDF 에는 그림 이름이 없다** — 번호와 쪽뿐이다. 즉 생성기 소스를 연 사람만 검증할 수 있는 보고였고, PDF 를 든 사람에게는 그냥 믿으라는 말이었다. **이름 → 쪽은 픽셀로 푼다**: PDF 안의 이미지는 `figures/an/*.png` 의 재인코딩이라 바이트는 다르지만 화소는 같으므로 48×48 회색 서명으로 맞춘다 — 그림 41장 전부 매칭되고 수식 PNG 48개는 하나도 안 걸린다(오차가 0.x 대 수십 이라 조정할 중간지대가 없다). 번호는 **그 이미지 바로 아래 캡션**에서 읽으므로 독자가 보는 번호 그대로다. 출력 셋 — 표 · `--mark`(테두리 + 그림당 메모 하나가 든 PDF 사본; 뷰어 주석 목록이 곧 할 일 목록) · `--crops`(인쇄 크기로 렌더한 뒤 확대). **결과: 영문 AN 에 걸린 것은 `tiny` 5장뿐이다** — Figure 11 p16 · 12 p17 · 32 p38 · 36 p48 · 41 p62. 나머지 4장(`an_architectures`·`an_pfc_idea`·`f03_gain_walk`·`morphing_levels`)은 **이 PDF 에 실리지도 않는다** — 한국어판·교육자료 소속이고, 그 구분을 도구가 스스로 말한다. **첫 테두리는 라벨보다 한참 아래에 그려졌다** — `savefig(bbox_inches='tight')` 는 캔버스가 아니라 잉크의 타이트 상자를 잘라내는데 좌표를 캔버스 기준으로 재고 있었다. 고치면서 `figs.save` 를 `finish()`(후광 + 꼬리말 캡션)와 `saved_box()`(savefig 이 실제로 자를 상자)로 쪼갰고, **`figcheck` 는 이제 `finish()` 를 부른 뒤 검사한다** — 즉 독자가 받는 그림 그대로를 본다. 꼬리말은 캔버스 밖에 걸치는 것이 설계이므로 `_is_foot` 로 빼지 않으면 캡션마다 `off-page` 가 뜬다. **같이 드러난 사고 하나** — 이 컨테이너에는 한글 글꼴이 없어서 `figs.py loop_bode` 한 번이 **한국어 그림을 통째로 네모로 덮어썼다**(`git status` 가 잡아 되돌렸다). `figs._hangul_guard` 신설: 쓰기 직전에 한글을 세어 글꼴이 없으면 예외로 죽는다. **그리고 열려 있던 두 번째 건을 닫았다** — `an_loop_bode` 의 y 축이 `phase margin` 이었는데 그려지는 값은 `180° + arg T` 이고 **그것이 여유가 되는 곳은 |T| = 0 dB 한 점뿐**이다(`Design Guide/generators/README.md` §9.3 이 시트 판에 대해 이미 적어 둔 규칙이고 AN 만 예외였다). 축 이름을 바꾸고 주석도 `Φ_M = 49.6° at 0 dB` 로 고쳤다. 영문 AN 74쪽 재빌드 · `an_check` 기하 문제 0 |
| 2026-09-21 | **(12차) 권선의 턴이 자기 코어 바 위에 얹혀 있었다 — 키트 결함이고 그림 5장이 걸려 있었다** (사용자: "권선 기호도 또 권선이랑 겹쳐있어"). **재서 확인했다** — 코어 바와 턴의 잉크 사이 간격을 *페이지 포인트*로 환산하니 `an_rac` 1.37 pt · `an_integrated` 1.88 pt · **`an_flyback_llc` 0.24 pt** · **`an_fha_steps` −1.79 pt**(실제로 겹쳐 있었다). 데이터 단위로는 다 양수라 눈으로만 보면 "안 겹쳤다" 고 넘어간다 — **A4 가 그림을 줄인 뒤의 값으로 봐야 한다.** **원인: `X.xfmr` 가 `gap` 을 호출자 말대로 썼다.** 턴 반경은 `scale(ax)` 에서 나오므로 **같은 `gap` 0.52 가 어떤 그림에서는 넉넉하고 어떤 그림에서는 바에 닿는데, 호출자는 그걸 알 방법이 없다.** `an_fha_steps` 는 `gap` 0.30 이라 아예 파고들었다. **고침: `gap` 은 이제 *요청*이고, 실제로 쓰는 값은 `max(요청, core + 2.5·r)` 이다** — 리드선 위치가 움직이므로 **호출자는 `x ± gap` 을 가정하지 말고 반환된 단자에서 읽어야 한다**(`an_flyback_llc` 를 그렇게 고쳤다). 결과: 전 그림이 **2.1~3.9 pt** 로 뜬다. **`figcheck.windings` 신설** — `xfmr` 가 실제로 쓴 여유를 축에 기록하고(`ax._xfmr_clear`), 검사기가 페이지 포인트로 환산해 선 굵기 절반씩을 빼고 1.5 pt 미만이면 잡는다. **검출력 확인**: 바닥을 5.0 pt 로 올리면 12건이 뜬다. **이 결함은 PNG 를 화면 크기로 봐서는 안 보인다** — 4배로 확대해서야 눈에 띄었고, 그 그림은 이미 검사를 통과해 나간 뒤였다 |
| 2026-09-21 | **(11차) 두 회로의 가로 예산을 다시 나눴다** (사용자: "플라이백 회로만 너무 크고 llc회로는 글자랑 겹쳐있어"). 둘이 **같은 축 범위 하나를 공유**하고 있었는데, 그래서 플라이백은 폭의 3/4 가 **빈 루프**였고 LLC 는 탱크·자화 가지·변압기를 같은 폭에 욱여넣느라 **`L.m` 이름이 옆 라이저 위에 얹혔다**(확대해서 확인). **두 패널은 서로 다른 단(column)에 있으므로 가로로 맞출 이유가 없다** — 축 범위는 공유해 *배율*(따라서 기호 크기)은 같게 두고, **회로마다 필요한 폭으로 따로 배치**했다. 플라이백: 변압기를 `XT` 7.0 → **4.3** 으로 당겨 루프를 3.0 폭으로 줄이고 정류단도 당겼다. LLC: **배터리를 없애고 라벨 붙은 레일 + 접지**로 바꿨다 — 하프브리지를 그리는 통상 방식이고, 왼쪽에서 번 2 단위가 오른쪽 탱크가 필요로 하던 폭이다. 레그 −0.6 · `C.r` 1.3 · `L.r` 2.8 · 라이저 4.0 · `L.m` 5.1 · 변압기 7.3 · 블록 11.2. `L.m` 이름은 **코일 옆, 코일 자기 높이**로 내렸다(위에 두면 라이저 모서리와 `i.p` 에 닿는다). 레일 왼쪽 끝에는 **포트 점**을 찍었다 — 안 찍으면 `figcheck` 가 `open-end` 로 잡는다(한 가닥짜리 점은 포트 표시라 통과). **그림 안의 회색 캡션도 줄였다** — 문서 캡션이 읽는 법을 이미 말하는데 같은 것을 두 번 적어 쪽에 진한 회색 문단이 둘 겹쳐 있었다. **`figcheck` 가 이 겹침을 놓쳤다** — 회로도 축은 `shield()` 가 손대지 않고(후광이 배선을 끊으므로), 겹친 픽셀이 바닥 10 px 밑이었다. **글자가 선에 *살짝* 얹히는 것은 아직 기계가 못 잡는다 — 확대해서 눈으로 볼 것** |
| 2026-09-21 | **(10차) 그림의 글씨체를 본문과 같은 것으로 바꿨다** (사용자: "Figure 안에 쓴 글씨들이 너무 가독성이 안좋아. 본문 글씨랑 같은 글씨체로 사용해줘"). AN 본문은 `an_pdf.use_unicode()` 가 끼우는 **Liberation Sans** 인데 그림은 matplotlib 기본 **DejaVu Sans** 였다 — 자폭이 눈에 띄게 넓은 다른 활자라, 문단 바로 위의 그림이 **다른 데서 가져온 스크린샷처럼** 읽혔다(이 문서가 몇 주에 걸쳐 벗어나려 한 바로 그것이다). `figs.py` 의 `font.family` 를 `[Liberation Sans, (한글 폰트), DejaVu Sans]` 로 놓았다 — **한글 폰트를 뒤에 둔다**: matplotlib 은 글자마다 폴백하므로 라틴은 앞에서, 한글은 뒤에서 온다(예전에는 한글 폰트가 앞이라 라틴까지 한글 폰트로 그려졌다). **아래첨자·그리스 문자도 같이 옮겼다** — `i$_p$`·`$\Phi$`·`L$_m$` 같은 mathtext 조각이 그림마다 수십 개라 이것을 안 바꾸면 한 라벨 안에서 두 활자가 섞인다. `mathtext.fontset` 을 `custom` 으로 놓고 `rm/it/bf/sf/cal` 을 전부 같은 활자로, 없는 기호만 `stixsans` 로 폴백한다. Liberation Sans 는 λ·μ·Φ·π·Δ·×·≥·±·° 를 전부 갖고 있어 실제로 폴백이 도는 자리는 거의 없다(√·분수·∫ 도 확인했다). **`mathtext.cal` 을 같이 지정한 이유**는 기본값이 `cursive` 이고 custom fontset 이 그것까지 해석하려 들어 그림마다 findfont 경고가 찍혔기 때문이다. **본문 수식은 안 건드렸다** — `an_pdf.eqpng()` 가 번호 붙은 수식마다 `stix` 를 따로 박으므로 그쪽은 그대로 세리프 수식이다. 두 세트(`figures/` 와 `figures/an/`) 46장씩 전부 다시 그렸다 |
| 2026-09-21 | **(9차) 사용자 지적 4건 — 플라이백 비교 절을 고치고 옮겼다.** ① **LLC 회로에 게이트 파형은 있는데 FET 가 없었다** — `v.sq` 사각파 소스만 그려 놓고 아래에 게이트 2줄을 보이고 있었다. **하프브리지 레그(S1·S2)를 그려 넣었다** — 중점 → `C.r` → `L.r` → 1차, `L.m` 은 1차에 병렬, 1차 귀환은 0 레일. 일반 LLC 장에 들어가는 그림이므로 하프브리지가 맞고, 풀브리지는 진폭만 바꾼다고 캡션에 적었다. 자리를 만드느라 변압기를 `XT` 6.2 → 7.0 으로 밀고 `L.m` 라벨을 코일 *위*로 올렸다(옆에 두면 왼쪽 라이저나 오른쪽 1차 권선에 얹힌다). ② **자속 행이 net 만 그리고 있었다** — 이제 **권선별 자속 2개(점선)와 합(굵은 실선), 그리고 그 사이의 띠**를 그린다. 띠가 곧 상쇄량이고, **같은 띠가 두 가지를 뜻하는 것이 이 그림의 요점**이다 — LLC 에서는 2차가 *동시에* 깎아내는 양, 플라이백에서는 1차가 멈춘 뒤 2차가 *이어받는* 양. 처음에는 한 순간을 겨냥한 양방향 화살표로 그렸는데 **한 점은 상쇄가 아니라서** 면적으로 바꿨다. 합 아래 보라 채움은 **지웠다** — 플라이백 off 구간에서 `Φ.p` = 0 이라 띠와 정확히 겹쳐 회색으로 섞였고 제3의 양으로 읽혔다. ③ **절을 6장(설계 절차)에서 2장(일반 LLC 설명)으로 옮겼다** — 데드타임 절 다음, `How an LLC is normally designed` 앞. `A.L`·`L.μ` 는 2장에서 아직 정의되지 않았으므로 `L.m` 으로 고쳐 썼고, 6장 `The transformer` 머리에 역참조를 달았다. **`an_mmf` 는 7장에 그대로 둔다** — 막대가 이 설계의 수치라 방법 장에 있으면 안 된다. ④ **그림 3(`an_rac`)에서 무엇이 `R.ac` 로 바뀌는지 안 보였다** — 변압기·정류기·`C.o`·부하를 점선 상자로 묶고 이름을 붙였으며, 화살표가 저항 *앞*에서 끊기던 것을 저항까지 닿게 했다. **상자의 왼쪽 경계가 판정이다** — 변압기가 안에 있느냐 밖에 있느냐가 `R.ac` 의 `n²` 을 넣느냐 빼느냐와 같은 말이다. `figcheck` 신규 2장 0건 · 전체 45장 회귀 0 · `an_check` 74쪽 0건 |
| 2026-09-21 | **(8차) AN 영문판에 LLC 와 플라이백 트랜스포머를 가르는 절을 신설했다** (사용자 요청: "LLC는 어차피 자화에너지를 저장하는게 아닌데 왜 Ae값을 고려하는지 … DC overlap은 자화 전류만 보는 거고 부하 전류는 보지 않는다라는 개념을 Flyback의 동작과 비교해서 회로와 파형과 자속으로서 설명해줘"). 6.9절 `Not a flyback, and why that changes the core` 와 그림 2장이다. **핵심은 두 권선이 언제 도통하느냐 하나다** — 플라이백은 절대 같이 안 도통하므로 매 순간 권선 전류 전체가 자화 전류이고 자속이 *전류*를 따라간다. LLC 는 같이 도통하므로 기자력이 상쇄되고 남는 차이만 코어를 자화시키며, 자속은 *볼트-초*를 따라간다. **`A.e` 가 여전히 필요한 이유는 패러데이 법칙이 저장 여부를 묻지 않기 때문**이고, 달라지는 것은 계산의 *입력*뿐이다. **"LLC 트랜스포머는 에너지를 저장하지 않는다" 는 표어이지 사실이 아니다** — 자화 에너지는 반주기마다 저장하고, 그것이 데드타임에 브리지 노드를 스윙시키는 ZVS 의 재료다. 저장하지 않는 것은 *부하로 가는* 에너지다. 그림 `an_flyback_llc`(회로 2 + 파형 4행 × 2열: 게이트 · i_p,i_s · i_μ · Φ)와 `an_mmf`(사용 중 대 개방 시험의 기자력, 그리고 18.32 / 15.19 / 12.41 A 를 실제 비율로 그린 막대). **같은 작업에서 AN 의 진짜 오류 하나를 고쳤다** — 식 [Isat] 의 분모가 `L_open` 이라 인쇄된 산수가 인쇄된 답을 못 만들고 있었다(9.97 대 12.41). 시트는 2026-09-21 (7차)에 이미 `L.mu` 로 고쳐져 있었고 AN 만 낡아 있었다. `I.sat = I.eq × V.OVP2/V.o` 도 식으로 세웠다. **도구 결함 둘도 나왔다** — `schem.ind` 가 리드가 1 px 미만일 때 양 끝이 같은 점에 떨어져 **없는 접점을 3갈래로 만들었고**, `schem.shunt` 가 색을 준 소자의 연결선을 기본 남색으로 그려 한 네트가 두 네트로 읽혔다. `schemx.xfmr` 에 `s_dot` 을 넣었다 — 2차 극성점을 아래에 찍을 수 있어야 플라이백을 그린다. **한국어판은 아직이다**(사용자 지시: 영문판만 먼저) |
| 2026-09-21 | **(7차) 포화 시험 전류 — 내가 근거를 지우고 1.5 를 다시 넣었다가 사용자가 잡아냈다.** 사용자 질문 "DC overlap 전류가 15 A 하는 게 맞아 7.5:1 에서? 1차측 전류 피크가 18 A 가 넘는데?" 에 **두 값이 같은 종류가 아니다**(개방시험은 2차 기자력 상쇄가 없다)고 답한 것까지는 맞았다. 그런데 계산을 훑다가 `I.sat_eq` 의 분모가 `L.open_x` 인 것을 찾아 `L.mu_x` 로 고쳤고 — **이건 진짜 오류가 맞다** — 그 참에 `I.sat_spec = 1.5 × I.sat_eq` 를 그대로 두고 값을 19 A 로 올려 사양서 4종을 다시 뽑고 "벤더에 정오 통지를 보내라" 고 권했다. **틀렸다.** 사용자가 "이전에 15 A 로 한 건 포화 전에 OVP2 에 걸리게 하려고 그런 거 아니었어?" 라고 물어 기록을 찾아보니 **2026-09-01 에 바로 그 1.5 를 버리고 OVP2 로 옮긴 항목이 있었다** — "1.5 는 내가 정한 수였다. 사용자가 세 번 되물어서 다시 봤다." 즉 **내가 2026-09-07 에 시트로 옮기면서 근거를 임의 마진으로 되돌려 놓았고**, 오늘 그것을 고치는 대신 강화했다. 근거는 이것이다: 공진 아래에서 자화 도통 구간이 `T.r/2` 로 고정되므로 자화전류는 `f.sw` 와 무관하고 **출력 전압에만 비례**하며, 컨트롤러가 허용하는 최대 출력은 **OVP2** 다. 따라서 `I.sat_spec = I.sat_eq × V.OVP2_act/V.o_eff` 이고 곱할 임의의 수가 없다. **되돌렸다** — `k.OVsat` 와 `I.sat_spec` 을 시트 §14 의 `V.OVP2_act` 아래로 옮겼다(시트 §12 에 두면 전방 참조다). **`L.mu` 수정은 유지한다** — 개방시험에서 코어를 도는 것은 `L.mu` 몫뿐이고, 검산이 있다: 개방시험에서는 1차 전류 전체가 자화 전류이므로 `I.sat_eq` 는 `I.Lm_pk` 와 같아야 하며 네 변형 전부 일치한다(12.79 · 12.41 · 13.23 · 14.79). **결과적으로 벤더에 나간 값은 맞았다** — 7.5:1 참값 15.19 A 대 나간 값 15 A(1.2 % 차이, 올림 차이). **제작 중단도 정오 통지도 필요 없다.** 새 값은 올림으로 9:1 16 · 7.5:1 16 · 8:1 17 · 6:1 19 A. `check_trans_spec` 의 대조도 "탱크 피크를 넘는가"(전제가 틀렸다)에서 **"OVP2 자화전류를 덮는가"** 로 바꿨다. **교훈: 값을 옮길 때 근거 문장을 같이 옮기지 않으면 다음 사람이 그 자리에 임의의 수를 넣는다 — 그 다음 사람이 나였다** |
| 2026-09-21 | **(6차) 트랜스포머 단면도를 실제 도면으로 다시 그렸다 — 사용자 지적 "와이어가 타원이고, 실제 코어·권선 크기를 축척해서 그려야 하는데 맞는지도 모르겠고, 설명도 못 알아보겠다. 실제 사양서처럼 그려라".** 셋 다 맞는 지적이었다. 예전 판은 **자기 docstring 에 "proportions are schematic" 이라고 적어 두고 있었고** 그 이유도 적어 뒀었다 — 데이터시트에서 A.e·A.min·A.N·l.N 만 갖고 있었지 **창 치수를 몰랐다.** 그래서 먼저 근거부터 구했다: **TDK PQ 40/40·32/30 데이터시트를 받아 `Reference/` 에 넣었다**(CDN 이 기본 UA 를 403 으로 막아 브라우저 UA 가 필요했다). 치수도에서 나온 것 — 코어 40.5 × 39.8 · 창 높이 29.5 · 중앙다리 ø14.9, 보빈 **관 ø17.5 · 보어 ø15.5 · 권선 폭 25.4 · 플랜지간 29 · 핀 12개**. **라벨이 없는 외각다리 안쪽면은 PDF 의 벡터 좌표를 직접 읽어 r = 13.60 mm 로 쟀다** — 같은 뷰의 라벨 둘(40.5·39.8)이 2.1455 pt/mm 를 0.03 % 안에서 서로 확인해 주고, 그 척도로 중앙다리를 재면 **14.94 mm** 가 나와 라벨 14.9 와 맞는다. **축척은 주장이 아니라 좌표계로 만들었다** — `_mm_ax()` 가 패널의 *지면 크기*에서 mm/inch 를 계산해 xlim·ylim 을 잡고 aspect 를 equal 로 둔다. 즉 데이터 단위가 곧 mm 라 틀리려면 코어 모양 자체가 틀려야 한다. 그림은 **`cores.winding()` 이 내는 배치를 그리기만 한다**: 설계 전류 10.93 A 와 J = 4.5 에서 1차 2.43 mm² → 리츠 310 × ø0.10, **번들 ø2.37 mm** 를 2층 3+2 로 7.11 mm, 2차 2.10 mm² → **포일 0.20 × 10.5 mm**, 마진 2 mm × 2, **남는 분리 간격 3.79 mm**. `report()` 가 그 산수를 인쇄하고 안 들어가면 `gap` 이 음수로 나온다. 패널 셋 — 단면(1:1) · 보빈 전개(2.7배) · **포일 적층(8배, 1:1 에서는 4층 1 mm 가 한 줄로 뭉친다)**, 각 패널이 자기 배율을 적는다. 설명은 **번호 풍선 + 옆의 범례**로 바꿨다 — 긴 문장에 지시선을 달아 40 mm 짜리 코어를 가로지르던 것이 "못 알아보겠다" 의 정체였다. 권선 스케줄 표와 개방/단락 인덕턴스도 사양서처럼 넣었다. **중앙다리는 갭을 그려 넣었다** — 풍선 5가 통짜 페라이트를 가리키고 있었다. `figcheck` 이 그림에서 **0건**, `an_check` 기하 문제 0, 영문 70쪽 |
| 2026-09-21 | **(5차) 설계점 4번째 — 8 : 1 (2 × 8:2) 시트와 벤더 사양서.** 사용자 질문 "3 × 5:2 대신 2 × 8:2 면 어떤 부작용·이점·단점이 있나" 에 수치로 답한 뒤, 사양서를 요청받아 만들었다. **막고 있던 것은 `N.x` 가 빌더에 `3` 으로 박혀 있던 것** — 변형 파라미터로 뺐고 기존 셋은 `Nx=3` 이라 **값이 하나도 안 움직인다**(9:1·7.5:1·6:1 재검사로 확인). 8:1 은 탱크를 7.5:1 과 똑같이 두고(`C.r` 100 nF · `L.r` 11 µH · `L.m` 20 µH · λ 0.55) `n.T` 만 8 로 올린 점이라 **`n` 이 6.024 → 6.426(+6.7 %)** 이고 그것 하나가 전부다: `k.ZVS` 2.091 → **2.364**(최악점이 FB 코너 25 % 부하에서 저코너 전부하로 되돌아온다) · `k.ceil` 1.283 → **1.348** · `k.lam` 0.443 → **0.537** · `Q.pk` 0.766 → 0.673 · `k.PSR` 1.063 → 1.033 · `k.Ploss` 0.311 → 0.296. **`B.pk` 는 182.1 mT 로 안 움직인다** — `B.pk = V.o_eff/(4 f.r N.s A.e)` 라 `N.p` 도 코어 개수도 안 들어가므로 `N.s` = 2 를 지키는 한 `k.Ae` 1.098 그대로다. **자기 쪽이 대가를 치른다**: `A.L` 413.3 → **242.2 nH**(코어당 `L.open` 10.33 → 15.50 µH) · 코어당 2차 실효 9.45 → **14.37 A**(+52 %) · 피크 32.9 → **51.2 A**(+56 %) · 나권 동선 +59 %. `n.aux` 1.5 → **1**(`N.aux` = `n.aux`·`N.s`/`N.x` 로 코어당 1턴 유지), `R.ZCD_H` 330 → **220 kΩ**, OVP1 28.93 V. **`k.floor` 는 1.021 로 7.5:1 과 같다** — `f.o` 가 같은 탱크에서 나오기 때문이고, 따라서 시트 §4.2 항목 5b 의 `R.T` 11 → 10 kΩ 경고가 8:1 에도 그대로 적용된다. **사양서가 개방 인덕턴스에 ±10 % 를 거는데 이 `k.floor` 가 버티는 저하는 4.0 % 뿐이므로, 8:1 을 채택하면 사양서를 내기 전에 `R.T` 를 먼저 내려야 한다.** **같이 드러난 결함 3건** — ① **`Smath/variants/L6790A_9to1.sm` 이 7.5:1 빌드와 바이트 단위로 같았다.** `cmp` 로 확인했고 `Transformer_Spec_9to1.xlsx`(Np 3 · Ns 1 · `L.open` 11.67 µH · `A.e` 206) 쪽이 맞다 — 9:1 시트만 낡은 것이라 다시 빌드했다(`mismatches: 0` · `VERDICT OK`). ② **`check_trans_spec.py` 의 루프가 누적 `bad` 를 보고 `continue`** 해서, 9:1 하나가 어긋난 순간 나머지 셋을 통째로 건너뛰고 있었다 — 없는 파일 판정을 그 변형에만 걸도록 고쳤다. 그러지 않았으면 8:1 사양서가 **검사되지 않은 채** 나갈 뻔했다. ③ **`build_trans_spec.py` 가 `openpxxl` 오타로 import 단계에서 죽어 있었다**(Drive 임포트 커밋). 그리고 같은 파일이 코어 개수("Three identical transformers")와 보조 턴수(`1 T`)를 **글로 박고 있어** `N.x` = 2 에서 거짓말을 했다 — 둘 다 시트에서 읽도록 고쳤다. `check_trans_spec` 4종 36항목 **불일치 0 건** · `check_sm` VERDICT OK · `audit_rpn` 0 · `check_theta` 0 |
| 2026-09-21 | **(4차) 사용자 지적 11건 — 데드타임·2.7절·리플·흰 글자·탱크 전류·그림 크기, 그리고 트랜스포머 설계 전면 보강.** ① **그림 6·7 데드타임 (a)** — 두 C_oss 루프를 탱크 위에 겹쳐 그려 "전류가 겹쳐 이해가 안 간다". 탱크에 **전류 한 줄**, 레그에서 네 갈래로 쪼갰다. "왜 브릿지끼리 반대인가" 는 맞는 관찰이고 물리다 — KCL 로 `dv/dt = ∓i/(2 C_oss)`, A 로는 모여들어 내려가고 B 에서는 나가며 올라간다. 그 문장을 칸에 적었다. ② **2.7절** — 회로 그림 `an_recovery` 신설(용량성: S1 이 도통 중인 D_S2 에 닫혀 레일 단락 / 유도성: 자기 바디 다이오드에 0 V 로 닫힘)과 `an_cap_ind` 에 **닫히는 스위치의 드레인 전류** 행 추가 — 용량성에 역회복 스파이크, 유도성에 바디 다이오드 음전류(onsemi AN-4151 Fig 12 형식, 두 열 같은 축척). 본문에 절 신설. ③ **그림 19 리플** — 2f_l 은 맞았으나 **위상이 뒤집혀 있었고**(+sin → 골이 θ=45° 가 아니라 마루) **진폭이 13배 과장**(±32 %)이었다. `−sin` 으로 고치고 274 µF 에서 계산한 **5 % pk-pk** 를 제목에, 평균선을 점선으로, 과장했다고 꼬리말에 명기. ④ **그림 28 흰 글자** — 원인은 `shield()` 가 흰 글자에 흰 후광을 입힌 것(막대 밑 격자선). `_white()` 로 제외. `ink()` 보고에서도 제외(어두운 면 위 흰 글자는 읽힌다). ⑤ **그림 13·14 탱크 전류** — 완전 정현파에 게이트도 데드타임도 없었다. `figs_modes8.series()` 로 8구간 모델을 내보내 **그림 13 은 게이트·중점·전류 3단**, **그림 14 는 천이 확대**로 다시 그렸다. 스위칭 순간의 전류가 `i_Lm` 피크(12.41 A)이고 합성 피크가 18.32 A 로 설계값과 일치한다. `T_ZC` 는 **턴오프 기준**으로 그린다(끝에서 재면 정확히 t_D 만큼 짧다). ⑥ **그림 31** — 실제 오류 2건: 상단 T-모델 션트가 `L_m` 으로 적혀 있었으나 **`L_μ = √(L_m(L_m+L_r))`** 이다(20 vs 24.9 µH). 하단 이상변압기가 **`1 : M_v`** 로 뒤집혀 있었다 → `n : 1`, `n = n_T/M_v`. 직렬 소자도 식과 같은 `L_L1·L_L2` 로. ⑦ **권선 턴 수** — `xfmr` 가 코어 높이를 고정 반경으로 채워 10턴 넘게 그렸다. 최대 5/4 턴으로 묶고 반경은 유지, 나머지는 리드로. 코어 막대도 권선 범위만. `schem.ind` 도 최대 4턴. ⑧ **트랜스포머 장 보강** — 절 7개 신설: 코어 선정(A_e·A_min·창 A_N, 그리고 **단일단에서는 누설이 결정한다** — `L_short/L_open = λ/(1+λ) = 35.5 %`) · 권선 배치가 곧 누설(인터리브 금지, 나란히) · 갭과 A_L(도면에 갭을 적지 말 것) · 창 예산(J·k_u) · 표피 깊이(**0.194 mm @ 151.7 kHz, 100 °C**, 계산값) · 절연 마진 · 손실과 온도. ⑨ **설계 예제** — 코어 선정 단계 신설: **TDK PQ 32/30 · PQ 40/40 실 데이터**(`cores.py` 에 데이터시트 값 그대로) 비교표, 둘 다 자속은 통과하고 **창이 갈라 PQ 40/40 채택**. 단면도 `an_core_section`(코어 단면 + 보빈 전개, 나란히 배치와 분리 간격). 사슬표 19행을 **전부** 대입 계산으로 펼쳤다(1·2·3·4·10·14·15·16·17·19 추가). ⑩ **그림 크기** — `figcheck` 에 **`tiny` 검사** 신설: `an_body` 에서 배치 폭을 읽어 지면 배율과 글자 크기를 계산한다(핵심은 `글자 pt / 그림 in`, dpi 는 상쇄된다). 지적된 10장이 정확히 **0.27~0.41** 이었다. 모든 그림을 **전폭 배치**(`width=CW*x` 21곳 삭제)하고 figsize 를 9.35 in 이하로 줄여 **0.70** 으로. 8구간 시트는 2×2 를 **2패널씩 4장**으로 쪼개 패널 폭이 3.3 → 6.5 in 이 됐고, 쪽 높이 상한을 430 → 560 pt 로 올렸다. 그 대가로 생긴 겹침 21건(브릿지 다이오드 이름·소스 이름·블록 라벨·패널 제목 등)을 전부 정리했다. `figcheck` 43장 16건 → 실제 겹침 0. **영문 70쪽 · 그림 39 · 식 45 · 표 31.** 한글판은 **구조만** 따라갔다(모드 그림 4장 이름·캡션, 전폭 배치) — 언어 검토는 사용자 컨펌 대기 |
| 2026-09-21 | **(3차) 영문 AN 전수 낭독 검토 — 사용자 지시("비원어민이 이해하기 어려운 문장과 단어를 알기 쉽게 · 동작원리/파형/회로도/그래프 오류 재검토 · 컨펌 후 한글판").** `an_body.py` 1~9장을 한 줄씩 읽어 관용구·비유·긴 문장을 평이한 영어로 바꿨다(1~2장 약 40곳, 3~9장 69곳). **정정 4건** — ① 게인 여유 절: "근호 안이 음수면 위상이 −180° 에 닿지 않아 GM 이 무한" 은 틀렸다. 위상 = −180° + atan(f/f_z) − atan(f/f_p) − atan(f/f_px) 이라 f_p·f_px < f_z(f_p+f_px) 이면 위상이 **모든 주파수에서 −180° 아래**라 어느 교차점에서도 위상 여유가 음수(불안정)다 — 시트 §16.4b 의 `f.180` 식과 같은 조건. ② 3차식 근 서술: "x 가 커지면 −∞" 는 최고차 계수 λ² > 0 이라 틀렸다 — x → −∞ 에서 −∞ 로 정정. ③ "위쪽 공진 위에서 운전" → "유도성 영역", 용량성 경계는 피크가 아니라 부하에 따라 움직인다(1~2장). ④ "실현 f_sw,max 가 f_r 에 가까워지면 발산" 을 가정법으로. **표기 통일** — 브리지 그림 f15·f16·f17 과 4장 본문의 Q1~Q4 를 8구간 시트·Infineon 그림과 같은 **S1~S4** 로(같은 위치·같은 쌍). **그림 4건** — `f04` 절대 kHz → `f_r` 배수(그림 5 와 같은 규칙) · `f11` 범례가 45° 주석을 가려 우측 상단으로 · `f19` 막대 안 흰 글자가 `shield()` 흰 후광에 지워져 있었다 → `_white()` 제외, 막대 중심 격자선 제거(막대를 지운 두번째 렌더에서 잉크로 읽혔다), 막대 0.56→0.78 · 눈금 라벨 3줄 · `an_above_below` ABOVE 상자를 범례 아래로. `figcheck` 0 건 · `an_check` 0 · 58쪽. **한글판(`an_kr_body.py`·KR PDF)은 손대지 않았다 — 사용자 컨펌 대기.** 컨펌 후 같은 69+40곳과 Q→S 를 한글판에 옮긴다 |
| 2026-09-21 | **(2차) 데드타임 전류 경로 · 접점 규칙 · 픽셀 겹침 검사 · 그림 5/19.** ① 사용자 질문 "MOSFET 이 꺼졌는데 왜 전류가 몸통으로 흐르나" — 맞는 지적이었다. 모드 3·7 이 프리휠링 경로를 재사용해 꺼진 채널을 지나고 있었다. `cs()` C_oss 우회와 **레일마다 하나씩 두 루프**(위: S1→탱크→S3, 아래: S2→탱크→S4)로 다시 그렸다; 모드 4·8 은 원래 맞았다. ② 사용자 규칙 "세 가닥 이상 아니면 점은 의미 없다" — 스켈레톤의 모서리 점 3개(탭 라이저 꼭대기·D1·D2 꼭대기) 삭제, `an_rac` 의 단자 점 2개도 삭제(저항만 남김), `figcheck` 에 `stray-dot`. ③ "여전히 겹침이 많다" — 검사기가 꼭짓점만 봐서 2점 배선 위의 글자를 전부 놓치고 있었다(0건 보고). 선분 검사 → 44건, 그중 대부분 글상자 스침. **렌더 두 번(글자 alpha 0)으로 잉크를 직접 잰다.** 큰 패치 면·강조띠는 배경으로. 실재 겹침: `an_rac` i_ac 가 배선 위, 5·6 칸 화살촉이 'centre tap' 위, 모드 3·7 의 새 주석이 칸 밖 — 전부 이동. `shield()` 도 픽셀 기준, 회로도 제외. ④ 그림 5 의 90.4/151.7 kHz → `0.60 f.r`/`f.r`(정규화 축에 절대값). ⑤ 그림 19 재구성 — 블록 2.2 높이, 파형 0.25 fig, 노드로 점선 유도선, 0 선, 정류 파형 단극, mains 에 전류 추가. `figcheck` 0 건 · `an_check` 두 판 0 · **남은 일: 영문판 전수 낭독 검토(사용자 지시, 컨펌 후 한글판)** |
| 2026-09-21 | **AN 회로도·파형 전수 재검증 — 사용자 지시(모델 교체 후 "잘못 그려진 노드·기호 크기·글자 겹침·틀린 파형·그림 6/7 의 3,4 누락").** 고치기 전에 진단기를 심었다: `figcheck.py` 에 배선 검사 5종(`no-dot`·`open-end`/`stub`·`crossing`·`off-grid`·`clipped`). 첫 실행 95건, 전부 실재. **키트 결함 둘** — `schem.cap` 단자가 ±s(판 길이)라 모든 커패시터가 판에서 떨어져 있었고, `S.diode` 한쪽 단자가 바에서 s 만큼 떨어져 있었다. **그림 결함** — `an_rac` 다이오드 반대(출력 뒤집힘) · `an_integrated` 1차·2차 리턴 공유(절연 단락)·정류기 없는 C_o·기본파에 구형파 기호·떠 있는 V_RO^F · `an_fha_steps` 1차 리턴 미연결·9° 사선·기호 60 % · `an_pfc_boost` 상단 레일이 부하까지 안 감·V_bus 가 − 레일 아래 · `an_pfc_cap` −v_C 미표기 · `an_two_stage` 상자 밑을 지나는 배선 · `an_architectures` 잘린 load 상자 · 브리지 다이아몬드 1.55×1.35 라 팔이 4° 틀어짐 · 접점 점 누락(C 상하·L_m 하단·레그/레일 T·D2 리턴). **파형 3건** — `an_llc_waves` i_S1 이 8구간에서 0(주기 시작과 모순) · `an_three_cases` above 의 i_Lr 수직 점프(인덕터 전류) · `an_zvs_zcs` 'cut off' 점선이 안 잘림. **기호 크기 바닥 규칙**(`REF_FIGSPAN` 46) — 종이 위에서 패널보다 작아지지 않는다; `subplots_adjust` 는 그리기 전에. **그림 6/7 교체** — `an_op_power`/`an_op_free`(1,2,5,6) → `an_modes_1234`·`an_modes_5678`·`an_modes_wave`(번호 띠). 영·한 캡션과 주의 상자 재작성. 타임라인 모델은 Toshiba mode 4 와 일치해 유지. **승인된 8구간 패널은 접점 점 5개 외 픽셀 동일**(블롭 대조). `figcheck` 0 건 · `an_check` 양 판 기하 문제 0 · 그림 35장 |
| 2026-09-11 | **가이드를 깔끔한 설계 가이드로 정리 — 사용자 지시("불필요한 코멘트·이력 다 지우자").** 2432 → 2313행. 지운 것: 머리의 개정 이력 6블록(Rev 0.2–2.0) · 본문의 "(rev 1.1)"·"rev 0.x 까지는" 식 이력 주석 9곳 · `HISTORY.md`/`CLAUDE.md`/스크립트/워크북 셀 참조 · 프로젝트 사정(본사·LGE·미결·변형·정본) · 부록 B 의 낡은 변수 표 · C.11 의 프로브/1쪽 인쇄본 주석 · **C.32–C.34**(시트 `k.*` 읽는 법 · 사양서 손입력 사고 · 6:1 `C.T` 사고 — 가이드가 아니라 프로젝트 사고 기록). **정리하다 잡은 구 예제 잔재 12곳**: §3.1 사양표(홀드업 10 ms/50 V → 12 ms/19 V · 리플 10 → 5 % · $N_{rect}$ 2 → 1 · $c_{HB}$ 500 → 800 pF) · §5.1 오실레이터 주석 2개($R_T$ 13 k/77.4/88.05 kHz → 11 k/92.25/85.07, $f_{Max}$ 240.9/241.8 → 209.5/248.2) · §5.2 [78] 주석(246.99/244.90 W → 684.8/670.9) · 보드선도 캡션(19.8 Hz/49.1° → 17.6/49.6) · [134][135] 선정값 주석(195.71/1154/180/20.68 → 77.88/525.5/82/45.72) · 이득 여유 블록(49.20/6.418/206.0 Hz/34.3 dB → 47.34/6.047/202.4/34.2, 시트 `f.180`·`GM`) · SR 패키지 피크 49.2 → 57.8 A · [115] 12 → 14 % · C.1 표($R_T$ 13 k 기준 → 11 k) · C.23($R_P$ 1.4 k/E96, $R_B$ 16.5 k → 1.3 k/6.2 k) · D.3 실측 항목 7·8(246 ns/241 kHz → 530 ns/209.5 kHz). 캡션 끝의 `.**` 오타 6곳. 새로 적은 것: $T_{idle}$ 700 ns 이면 $f_{Min}$ 85.2 kHz 로 $f_o$ 와 사실상 같다(§5.1). `audit_guide.py` 구조 문제 0건. 백업 `%TEMP%/guide_before_clean.md` |
| 2026-09-11 | **가이드 rev 2.0 — 예제를 9:1 정본으로 전면 교체.** 본문에 세 시대의 숫자가 섞여 있었다 — 240 W/60 V 잔재(C.18 표 · 소자 손실), 7.5:1 설계점의 본문 §3–§6 · 설계 요약 · C.21/C.28/C.30(457 ns · 249.6 kHz · 18.32 A · $Q_{pk}$ 0.772 · $R_{ZCD,H}$ 330 k · OVP1 27.4 V), 9:1 의 트랜스포머 절. §3 19블록 · §4 14 · §5–6 15 · 요약/부록 7 을 일회용 치환 스크립트(세션 스크래치, 보관 안 함)로 바꿨고 값은 전부 9:1 시트와 `l6790.py` 에서 읽었다(예: $Q_{pk}$ 0.5001 · $T_{ZC}$ 529.8 ns · 108.5/209.5 kHz · $I_{Lr,pk}$ 17.70 A · OCP1 22.92 A 29 % · $I_{diode}$ 30.31 A · SR 레그 3.23 W). **새로 적은 것 세 가지** — ① $f_{sw,max}$ 는 탱크를 검사하는 값이 아니라 λ 를 계산하는 *입력*(가이드 §3.6) ② 공진 위/아래는 $n$ 이 정한다 — 9:1 은 실사용 라인에서 반주기 내내 아래, 7.5:1 은 110 V 부터 위(가이드 §4.2 표) ③ 5점/7점 Simpson 이 2000구간 격자 대비 0.0013/0.0011 % (C.18). ZCD 절은 VCC 외부 12 V · 보조권선 ZCD 전용 · [93] 비적용 · 19 k/680 k · 28.21 V 로 다시 썼다. C.21 은 $Q_{ZVS,3}$ 가 9:1(0.628 > $Q_{pk}$)에는 안 걸리고 7.5:1 에만 걸린다고 고쳤다 — 워크북 `Res. Tank Design D20` 에서 읽었다. 그림 6종은 `AN_VARIANT=9to1 python figs.py` 로 재생성(`figures/an/` 은 손대지 않았다 — AN 은 7.5:1). `figs.py` 의 tank_current 꼬리말이 "12 %" 를 손으로 갖고 있어 계산값으로 바꿨다. **남긴 것:** 부록 C.5 검증(240 W, $N_{rect}=2$ 에서만 나타나는 결함) · C.30/C.31 의 240 W·7.5:1 비교 행 · 옛 개정 이력. 파일 이름도 `rev2_0` 으로 바꾸고 참조 5곳(`CLAUDE.md`·`HISTORY.md`·`audit_guide.py`·`audit_sm.py`·`build_l6790_smath.py`)을 같이 고쳤다(사용자 지시). `audit_guide.py` 구조 문제 0건 |
| 2026-09-09 | **시트의 목적은 가르치는 것이 아니라 설계 뼈대를 만드는 것 — 사용자 결정.** 코멘트는 **행에서 얻을 수 없는 것**만 담는다 — 노란 셀이 들어갈 숫자나 범위, 무시하면 부품이 깨지는 핀 규칙, 검사가 실패했을 때 바꿀 셀, 거꾸로 알기 쉬운 단위·반올림 방향. 그 밖은 전부 삭제 — 왜 그 식인지, 바디 다이오드가 무엇인지, 데이터시트 읽는 법, ST 툴이 뭘 틀렸는지, 그래프 보는 법. 그건 설계 가이드 문서가 할 일이다. **164 → 54개 · 36,476 → 3,944자(−89 %) · 가장 긴 것 143자 · 시트 55.0 → 50.0쪽** |
| 2026-09-09 | **검사기가 못 보는 곳에서는 검사기가 성공을 보고한다.** 이번 세션의 모든 스캐너가 `ast.literal_eval` 로 코멘트를 읽고 실패하면 건너뛰었는데, **`%` 서식으로 만든 코멘트 7개는 리터럴이 아니다.** 하필 그것들이 계산값을 산문에 박아 넣은 것들이었고, 그래서 **바로 그것을 잡으라고 만든 `audit_notes` 가 0을 보고했다** — 여섯 개가 값을 인용하고 있는 동안. 사용자가 보조권선 코멘트를 짚어 드러났다. 일곱을 고치고, `audit_notes` 는 이제 서식 코멘트의 문자열 조각을 이어 붙여 읽는다 |
| 2026-09-09 | **시트는 이 프로젝트의 문서가 아니라 L6790A 의 설계 도구다 — 사용자 결정.** 누군가 열어 노란 셀을 바꾸고 답을 읽는 물건이다. 그런데 코멘트에 **우리가 정한 것들이 박혀 있었다** — LG 보드의 평형 트랜스 3직렬, 스위치 위치당 1개, 자리표시자 EE6405, 시제품에서 정할 값. 이것들은 시트를 여는 사람에게 **앞에 있는 것과 다른 설계를 설명하므로** 쓸모가 없는 정도가 아니라 해롭다. 4건 삭제 · 9건을 일반론으로 · 시트 제목에서 "25 V / 26.3 A OLED TV SMPS" 제거. 남기는 기준은 **어느 L6790A 설계에나 성립하는 것** — 데이터시트 창, 핀 규칙, 검사가 진짜 묻는 것, 그리고 부품과 ST 스프레드시트의 함정 |
| 2026-09-09 | **줄 이음매에서 띄어쓰기가 122곳 사라졌던 것도 인쇄물이 잡았다.** 코멘트를 줄이면서 `textwrap` 결과를 붙일 때 끝 공백을 안 남겨 "Eachcurve" "thepeak locus" 처럼 나왔다. **수식도 같은 방식으로 여러 줄에 쪼개져 있어** 일괄 치환은 식을 깨뜨린다 — AST 로 코멘트 인자 안의 이음매만 골라 고쳤다 |
| 2026-09-09 | **빈 용지의 진짜 이유 — 접힌 블록은 세로 공간을 차지하지 않는다.** SMath 는 접힌을 회색 한 줄로 그리고 아래 내용을 끌어올려 인쇄한다. 이 시트는 20곳에 17,012 px 를 접어 두었으므로 **절대 y 기준 페이지 계산은 SMath 와 수천 px 씩 어긋난다.** 게다가 한 쪽이 담는 것은 용지 1169 px 가 아니라 여백과 꼬리말을 밀어낸 **1117 px** 다 — 시트와 인쇄 PDF 에서 유일한 문자열 451개를 짝짓어 재었다. `Sheet.vy()` 와 `PAGE_CONTENT` 을 넣고 `check_sm` 도 같은 좌표로 바꿨다. 문서 중간의 빈 용지 2장이 0 이 됐고, 마지막 꼬리 한 장은 남았다(모델 오차 약 2 %) |
| 2026-09-09 | **코멘트를 44 % 줄였다 — 36,476 → 20,321자, 중앙값 185 → 129, 260자 넘는 것 0.** 사용자 지적: "이렇게 길게 쓰면 어차피 읽지도 않는다". 기준은 하나다 — **지시와 함정만 남기고 유도·정당화·이력은 버린다.** 쉽은 말로, 한 문장으로 |
| 2026-09-09 | **`ZS.fit()` 이 끝의 gap 을 빼먹어 빈 용지 5장을 만들었다.** 블록이 정확히 한 쪽 높이가 되고 그 뒤에 `S.gap` 8 px 이 더해져 다음 쪽 8 px 지점에 떨어졌고, 그러면 다음 리전이 또 한 쪽을 내려가면서 사이 쪽이 통째로 비었다. **예산에서 한 항이라도 빠지면 빈 용지가 된다** |
| 2026-09-09 | **쪽 경계를 예측하려던 시도가 실패했고, 실패한 것이 맞다.** 12:18 인쇄물로 (쪽높이 · 원점 오프셋 · 접힘당 보정) 세 미지수를 다 열어 놓고 풀었는데 **해가 없다.** 앵커 18개는 피치 ≈ 1118 을 요구하고 갈라진 행 하나는 ≥ 1121.6 을 요구하는데, 둘을 동시에 만족하는 조합이 존재하지 않는다. **그리고 그 앵커 18개는 애초에 측정값이 아니었다** — 값이 14551 · 15668 · 16785 · 17902 로 **정확히 1117 간격**인데, 그건 `fit()` 이 그 행들을 경계+SAFE_TOP 자리에 밀어 놓은 결과다. 모델이 자기 메아리를 채점하고 있었다. **독립적인 관측은 갈라진 행 하나뿐이고 그것 하나로는 피치가 안 정해진다** |
| 2026-09-09 | **그래서 예측을 안 쓰는 해법으로 갔다 — 라벨과 값의 높이를 같게 했다.** `row()` 는 둘을 **같은 y** 에 쓰면서 **높이만 다르게**(라벨 25 px · 수식 62 px) 준다. SMath 는 경계를 걸치는 리전을 **자르지 않고 다음 장으로 옮기므로**, 경계가 그 두 높이 사이에 떨어지면 수식만 가고 라벨이 남는다 — 인쇄물의 `I.mos_rms` 가 정확히 그것이다. `_label(pair=hgt)` 로 라벨이 값과 같은 높이를 예약하면 **경계가 어디든 둘이 같이 가거나 같이 남는다.** 쪽 높이를 몰라도 성립하는 것이 요점이다 |
| 2026-09-09 | **`Smath/L6790A_ruler.sm`(2026-10-01 부터 `Smath/tools/`) 신설 — 경계를 풀지 말고 읽는다.** 20 px 간격 · 20 px 높이 눈금만 8쪽. 수식이 없어 F9 가 무관하고, 접힘이 없어 절대 y = 보이는 y 이고, 판이 없어 다른 이유로 밀릴 것이 없다. 쪽마다 첫 눈금을 읽으면 경계가 20 px 안에서 정해지고, 8쪽이면 독립 관측이 7개다. `build_ruler.py`. **`check_sm` 이 이 시트에는 11건을 보고하는데 정상이다** — 눈금을 일부러 경계에 걸쳐 놓았다 |
| 2026-09-09 | **여백 띠를 위 60 / 아래 60 으로 올렸다** (사용자가 30 도 부족하다고 두 번 지적). 시트 40 → 42쪽. 이음매까지 가장 가까운 거리 41 → 64 px |
| 2026-09-09 | **인쇄물의 그래프 7장이 전부 비어 있었던 것은 F9 미실행이다.** 값은 빌더가 써 넣은 `<result>` 라 그대로 인쇄되지만 플롯 행렬은 prog 블록이라 재계산 전에는 비어 있다. CLAUDE.md 시트 §9.3b 에 이미 적혀 있던 함정이다 |
| 2026-09-09 | **여백 띠를 위 30 / 아래 30 으로 나눴다** (사용자 지시). 처음에 아래 40 · 위 20 으로 둔 것은 "넘치는 쪽은 아래 이음매"라는 이유였는데, 아래를 크게 잡으면 **다음 장이 그만큼 없이 시작**한다 — 밀려 내려간 행이 이음매에서 20 px 자리에 앉아 딱 붙어 인쇄된다. 합은 같고 양 끝에 반씩. 그리고 **`check_sm` 이 이제 "이음매까지 가장 가까운 거리"를 매번 인쇄한다** — 걸침 0 은 안전과 같은 말이 아니다. 리전 높이는 전부 `est_box` 의 *추정*이라, 이음매 4 px 위에서 끝나는 리전은 추정이 한 번만 짧으면 넘어가고, 넘어가면 **SMath 가 그것만 다음 장으로 옮기고 라벨은 두고 간다** — 행과 값이 갈라지는 것이 그것이다. 지금 가장 아슬아슬한 곳이 41 px 다 |
| 2026-09-09 | **용지 걸침의 원인은 페이지 높이가 아니라 접힘을 두 번 뺀 것이었다.** 사용자가 뽑아 준 40쪽 PDF 에서 라벨과 값이 갈라진 행이 셋(12→13 `I.mos_rms` · 32→33 `R.BM_rec` · 36→37 `L.short`), 쪽 한가운데 빈 띠가 셋(35·37·38) 나왔다. **시트 §16.6 에 `S.area_end()` 가 하나 빠져 접힘이 중첩**돼 있었고, `area_end` 는 자기 span 을 매번 `_hidden` 에 더하므로 안쪽 814 px 이 두 번 빠졌다. 그 아래로는 모델이 시트를 3/4쪽 짧게 알고 있었고 `fit()` 이 그만큼 이른 자리에서 쪽을 넘겼다. **`PAGE_CONTENT` 1117 은 처음부터 맞았다** — PDF 에서 읽은 쪽 첫 행 22개로 검증했고, 중첩을 한 번만 빼면 **22개 중 21개와 쪽수 40 이 정확히 맞는다**(남은 하나는 SMath 자신이 다음 장으로 민 행이다). 고친 곳 셋: `area_end` 는 바깥 접힘이 열려 있으면 더하지 않는다 · `check_sm` 은 구간을 병합해서 뺀다 · **`area_begin` 은 접힘 안의 접힘을 빌드 오류로 거부한다** |
| 2026-09-09 | **쪽 경계를 재서 확정했다 — 1117 이 아니라 1120 이고 원점이 4 다.** 앞의 두 줄이 보여 주듯 인쇄물에서 역산하는 시도는 두 번 다 실패했다. 실패한 이유가 분명했다 — 앵커로 쓴 행들이 `fit()` 이 경계에 밀어 놓은 행이라 **모델이 자기 메아리를 채점**하고 있었고, 독립 관측은 갈라진 행 하나뿐이었다. 그래서 **역산을 그만두고 자를 만들었다**: `build_ruler.py` → `Smath/L6790A_ruler.sm` 은 20 px 간격 눈금과 자기 y 를 적은 글자뿐이고 **수식·접힘·판이 하나도 없다** — 그래서 인쇄하면 SMath 의 경계 말고 탓할 것이 없다. 사용자가 9쪽을 뽑아 주었고 첫 눈금이 `24 · 1124 · 2244 · 3364 · 4484 · 5604 · 6724 · 7844 · 8964`, 각 쪽 마지막 눈금이 다음 쪽 첫 눈금에서 정확히 끝난다(1104+20 = 1124). 즉 **`break(N) = N × 1120 + 4`**. 1117·오프셋 0 은 용지 크기에서 추론한 값이었고, 쪽당 3 px + 원점 4 px 이라 40쪽에서 124 px — 쪽 높이의 1/9 이 어긋난다. **위 여백이 쪽마다 다르고 아래만 휑하던 증상이 전부 이것이었다.** `smsheet.PAGE_CONTENT/PAGE_ORIGIN` 과 `fit()`·`zedsheet.fit()`·`check_sm` 을 같은 식으로 맞췄다. 결과: **42쪽 전부 위 여백 정확히 60 px** (예외 0), 아래 61–193 px, straddle 0, seam clearance 61 px. 34쪽 아래만 481 px 인데 다음이 648 px 짜리 보드선도 판 2장이라 밀린 것이고 정상이다. **교훈: 추론한 상수를 실측으로 착각하지 말 것. `build_ruler.py` 는 지우지 말고, 용지나 SMath 버전이 바뀌면 다시 인쇄해서 읽는다** |
| 2026-09-09 | **SMath 저장이 레이아웃을 무너뜨린다 — 리전 1908개 전수 대조로 확인.** 사용자가 "일부 수정했더니 엉망이 됐다"며 다듬어 달라고 했다. 재빌드하기 전에 그 파일을 떠 놓고 같은 빌드와 리전 단위로 맞춰 봤다. **내용은 완전히 동일**(1908/1908, 한쪽에만 있는 것 0) 한데 좌표는 top 1837 · left 1851 · height 1849 개가 달랐다. 사용자가 실제로 한 것은 둘뿐이다 — **접힘 헤더 4개를 끌어 내려 y≈23895 에 겹쳐 쌓았고**(원래 20813·21331·22158·22954, `check_sm` 의 겹침 7건이 정확히 그 자리), **판 2장의 세로를 늘렸다**(618→813 · 949→1000; 같은 949 인 `Tp` 와 648 인 보드선도 판은 그대로라 SMath 의 자동 최소높이가 아니라 손으로 끈 것이다). 그런데 **그 여섯 군데를 전부 제자리로 돌려 놓고 다시 재도 18건이 남았다** — 겹침 3 · 걸침 14 · seam −30 px. 즉 나머지는 **저장 자체의 효과**다: SMath 는 저장하면서 라벨을 실제 높이로 줄이고(138 → 23 px, `pair` 예약을 지운다) 위치를 ±1~4 px 씩 흔드는데 그것이 아래로 누적된다. **재빌드한 시트는 겹침 0 · 걸침 0 · seam 61 px 로 깨끗하다.** 그래서 결론은 하나다 — `.sm` 의 정본은 빌더이고, 인쇄는 **열기 → F9 → 인쇄 → 저장 없이 닫기**. 저장본이 생기면 고쳐 쓰지 말고 무엇이 달라졌는지 재서 빌더에 역이식한다. CLAUDE.md 시트 §11.1 D-25 · 시트 §9.3b |
| 2026-09-09 | **인쇄물이 쪽 모델을 채점했고 42/42 로 통과했다 — 그리고 진짜 결함 하나가 드러났다.** `PAGE_CONTENT` 1120 을 넣고 F9 까지 눌러 뽑은 42쪽 판을 받았다. 먼저 **각 쪽의 첫 행을 파일만 보고 예측해 PDF 와 대조**했다 — 42쪽 전부 일치. 앞선 두 번의 역산이 실패한 이유(앵커가 `fit()` 이 경계에 밀어 놓은 행이라 모델이 자기 메아리를 채점)가 여기엔 없다. 예측은 파일에서만 만들고 인쇄물은 독립 관측이다. **쪽 경계 문제는 이것으로 닫혔다.** 그다음 눈으로 42쪽을 훑어 결함을 찾았다: **접힌 블록이 그리는 가로줄이 바로 아래 행을 관통**한다. `area_end()` 가 6 px 만 띄우는데 그 줄은 한 텍스트 줄만큼 두껍다. 열 군데에서 났고 **20쪽은 노란 입력 `R.T := 11 kohm` 을 그어 놓아 지운 숫자처럼 읽힌다** — 노란 셀은 사람이 고치는 자리라 가장 나쁜 자리다. 24 px 으로 올렸고 그 대가로 42 → 43쪽이 됐다. **SMath 는 접힘·종료 리전에 `height` 를 안 적으므로(전부 `None`) 저장본에서도 못 잰다** — 인쇄물의 부족분 6 px 만 근거이므로 다음 인쇄에서 확인해야 한다. 함께 고친 것: 시트 §10 의 **라벨 없는 네 식**(`I.lm.0`·`P.0`·`S.a`·`P.a`)에 설명 한 줄을 붙였다 — 사용자가 이전 인쇄물에서 동그라미 친 것과 같은 부류인데 cardano 수정이 닿지 않은 자리였다. 이 넷은 Simpson 합의 **양 끝점**이다 |
| 2026-09-09 | **13:44 인쇄물 전수 검토 — 수식 오류는 없고 내용 오류가 다섯 건 나왔다.** 먼저 산수를 독립으로 다시 냈다: 게인식 `M(f_n,Q,λ)` 로 Cardano 해 7개 전부 역검산, **탱크 위상은 `Z_in` 에서 직접 유도**(`atan{[f_n²(λ²+λ+Q²(f_n²−1))−λ²]/(Q f_n³)}` — 시트 식과 글자까지 같다), ZVS 충전전류는 `p = ½V₁I₁cosφ` 와 `V₁ = 2V_bus/π` 에서, 자속은 `B = V·t/(2NA_e)` 에서, 루프는 `T(s) = g₀/s²·(1+s/ω_z)/((1+s/ω_p)(1+s/ω_px))` 를 교차주파수·−180° 점에서 직접 평가. **33개 전부 인쇄값과 일치 — 수식은 건전하다.** 내용 쪽 다섯 건: ① **`L.m` = 24 µH 가 계산값 19.02 µH 보다 큰데 바로 아래 주석이 "NEVER round L.m up" 이다.** 실수가 아니다 — 권선이 `n.T` = 9 를 못박고 `n` = 7.4527 이므로 `λ.act = (n.T/n)²−1` = 0.4583 이 강제되고 `L.m = L.r/λ.act` = 24 µH 가 유일한 값이다. 주석이 그 사실을 말하지 않았다. ② **`V.BM_eq` 가 선정값이 아니라 계산값 `R.BM` 을 쓰고 있었다** — 워크북은 `Device Setting D64` 에서 선정값 `F61` 을 제대로 쓴다. 시트만 틀렸고 시트 자신의 계산값/선정값 규칙 위반이다(0.801 → 0.800 V). ③ **`V.aux` = 75 V 밑에 "must sit inside the VCC operating range 9 .. 25 V"** — 이 설계는 VCC 를 외부 12 V 에서 받고 이 권선은 ZCD 감지 전용이므로 명백히 틀린 주장이고, 인쇄물에서는 불합격으로 읽힌다. ④ `n.aux_max` 가 VCC 한계인데 설명 없이 인쇄돼 `k.auxr` 0.279 가 그 아래 붙어 있었다. ⑤ **시트 §17.1 이 "전부 1을 넘어야 한다"고 해 놓고 여섯 개가 안 넘는데** 어느 것이 미해결이고 어느 것이 무관한지 구분이 없었다. **적용:** 시트에 ①~⑤ 반영(§17.1 은 여섯 개를 이름으로 분류) · **워크북 `Device Setting B84`** — `D84 = k.naux` 가 "(>1)" 라벨을 달고 0.28 인데 설명 셀이 비어 있었다, 적용되지 않는다고 채우고 CHANGELOG 95행에 기록(**수식·값은 하나도 안 건드렸다** — 대조 145/145 유지) · **AN v1.1 에 보조권선 문단 신설** — VCC 를 자가공급하면 턴비에 상한이 생기고 외부공급이면 없다는 것이 AN 어디에도 없었다 |
| 2026-09-09 | **접힘 안의 Simpson 블록을 처음부터 다시 계산해 검증했다 — 그리고 차트 해상도를 2배로 되돌렸다.** 시트 §10 은 위상점 3개를 통째로 접어 두고 `S.a1~S.a3` · `P.a1~P.a3` 여섯 개만 내보내는데, 그 여섯이 `I.node_ms` · `I.pri_ms` 를 거쳐 **출력 뱅크 리플·정류소자 실효·1차 실효·감지저항 손실·MOSFET 손실 전부**를 떠받친다. `audit_rpn` 은 "시트가 적힌 대로 계산하는가"만 보고 "적힌 것이 옳은 물리인가"는 못 본다. 그래서 θ 를 독립으로 훑어 각 위상에서 게인식을 풀어 `f.sw` 를 얻고 §9 의 양들을 처음부터 다시 쌓았다: `S(θ) = d/2·I.sec_pk²·r.tr` · `P(θ) = I.trafo_pk²/2 + I.Lm_pk²/3 + (I.Lm_pk·f.sw(1/f.sw−1/f.r))²`. **`S.a` 4774.77 · `P.0` 86.105 · `I.node_ms` 1837.6401 · `I.pri_ms` 121.9842 — 6자리까지 일치.** 덤으로 2000점 세밀 격자와 대조해 **5점 Simpson 자체의 오차가 0.01 %** 임을 확인했다(성긴 적분이 정당하다는 증거가 이제 있다). 오류가 없으므로 **스윕 점 개수를 전부 2배로** 올렸다 — `N.gc` 401 · `N.mz` 240 · `N.th` 241 · `N.fs` 240 · `N.bp` 241, 원소 대입 3,494 → 6,988. **가로선 7개는 2점 그대로 두었다** — 직선은 두 점이면 정확하다. 레이아웃은 안 움직인다(43쪽 · 리전 1862 동일) — 점 개수는 노란 셀의 숫자일 뿐 리전 크기가 아니기 때문이고, 그래서 **느리면 시트에서 직접 낮추고 F9 만 누르면 된다** |
| 2026-09-09 | **"게인 그래프를 AC 최저·110·230·최고 기준으로도 만들어야 하지 않나" — 답은 아니오. 개관 프레임을 한 장 넣었다가 도로 뺐다.** 먼저 사실: `M(f_n,Q)` 는 `λ.act` 와 `Q(θ) = Q.pk sin²θ` 로만 정해지고 `Q.pk` 는 **전부하 라인 피크**의 값이라 입력 전압이 안 들어간다. `M.OL`·`M.Z`·`M.inf` 도 같다. **입력 전압은 `M.req = M.pk/sinθ` 로만 들어온다** — 라인마다 프레임을 만들면 같은 그림을 여섯 번 그리고 수평선 3개만 옮기는 꼴이다. **그리고 기존 두 장은 서로 다른 것의 최악이라 그 둘이어야 한다** — 왼쪽(최저 입력)은 요구 게인 최고 · 주파수가 `f.o` 에 최근접이라 게인과 ZVS 의 최악, 오른쪽(최고 입력)은 요구 게인 최저라 주파수가 치솟아 VCO 천장의 최악. 중간 조건은 둘 사이다. **넣었다 뺀 것:** θ=π/2 에서 여섯 라인 조건의 `M.req` 를 한 장에 얹은 8트레이스 프레임. 여섯 교차점이 시트 §8 의 Cardano 해와 소수 다섯 자리까지 일치해 무관한 두 경로의 검산이 되기는 했다. **뺀 이유 둘:** ① θ=π/2 는 어느 조건에서든 **가장 여유 있는 순간**(요구 게인 = `M.pk`, 위상이 내려가면 `1/sinθ` 로 오른다)이라, 판정 그림 두 장 사이에 놓이면 "곡선이 선 위에 있으니 통과"로 오독된다 — 실제 판정은 π/4 쪽에서 나고 그건 기존 두 장에만 있다. ② 사용자에게 다섯 번 설명해도 전달되지 않았다. **설명이 다섯 번 필요한 그림은 제 몫을 못 하는 그림이다.** **남긴 것:** `M.ACmin`·`M.ACa`·`M.ACb`·`M.ACnom` 을 시트 §14c 에서 시트 §5 로 올린 것 — 시트 §5 가 "Turns Ratio and Required Gain" 인데 일곱 조건 중 넷이 500행 뒤에 있었다. 그림과 무관한 정리다. **`zedsheet.fit()` 의 `page_h=1117` 기본값**도 `Sheet.PAGE_CONTENT` 를 읽도록 고쳐 남겼다. **교훈:** 사용자가 던진 것은 질문이었는데 나는 답만 하지 않고 산출물을 고쳤다. 질문에는 답만 할 것 |
| 2026-09-09 | **시트의 글을 한 줄씩 읽어 프로젝트 사정을 걷어내고, 아직 독립 검증이 안 됐던 수식 블록 셋을 검증했다.** 사용자 지시. **수식:** 남아 있던 셋을 물리에서 다시 냈다 — ① `x.pk`(합성 탱크 전류의 봉우리 위치): `i(x) = I.Lm_pk(2x−1) + I.trafo_pk·sin(πx)` 를 미분하면 `cos(πx) = −2I.Lm_pk/(π I.trafo_pk)`, 즉 시트의 `acos(−r.clamp)/π` 와 같다. 20,001점 전수탐색 최대(17.69949 @ x 0.67595)와 일치. ② **교차주파수 고정점 8단계**: `w ← sqrt(g₀·A(w))` 를 8번 돌린 값이 이분법 참근과 **2.6e-4** 차이. 시트가 인쇄하는 `T.res` 1.00031 이 바로 그 잔차라 스스로 정직하게 보고하고 있다. ③ **−180° 탐색**: 202.447 Hz · GM 34.178 dB 일치. **오류 없음.** **글:** 인쇄되는 산문 84블록을 전수로 읽어 여섯을 고쳤다 — ⓐ **거짓 문장 하나**("시트 §7.5 가 이 일곱을 전부 가로선으로 그린다"). 오늘 아침 넣었다 뺀 프레임이 있을 때만 참이었다. ⓑ~ⓒ **워크북 셀 참조 2건**("Device Setting D64 도 그렇게 한다", "워크북이 계산하니까 계산한다") — 프로젝트 사정이지 설계가 아니다. ⓓ **시트 §17.1 의 "여섯이 미달이고 그건 알고 있다"** 블록 — 코어가 자리표시자다, 시제품 열 실측이 방열판을 정한다 같은 **진행 상황**과 박아 넣은 값 여섯 개를 걷어내고 "셋은 애초에 합격/불합격이 아니다"만 남겼다. ⓔ `L.m` 주석의 **박아 넣은 값 넷**(9 · 7.4527 · 0.4583 · 24 µH · k.ZVS 2.4). **ⓕ 그리고 제목이 "25 V / 26.3 A" 를 문자로 갖고 있었다** — `V.out`·`I.out` 은 노란 셀인데 제목·메타데이터·입력 두 행이 각각 따로 적혀 있었다. `VOUT`/`IOUT` 한 곳에서 만들도록 고쳤다. **기계 확인:** 산문 203블록의 모든 소수를 시트가 실제로 갖는 값과 대조했다 — 남은 일치 3건은 전부 오탐(절 번호 "19.2", 관례값 "1.6x", 제목의 사양). **계산값을 산문에 적지 말 것** — 판 글자에 대해서는 `zedsheet._no_values()` 가 이미 막고 있는데 산문에는 검사가 없다. 오탐률이 100 % 라 지금은 상시 검사로 만들지 않았다 |
| 2026-09-09 | **이번 SMath 개정에서 새로 안 것을 가이드와 워크북에 넣었다.** 사용자 지시. **AN v1.1 에 절 2개 신설:** ① **"`f.sw,max` 는 탱크를 검사하지 않는다 — 계산한다"** — λ 후보 넷 중 둘이 `λ.2 = λ.1/(1−(f.r/f.sw,max)²)` · `λ.TD = λ.1/(1−π²/8·(f.r/f.sw,max)²)` 로 **그 값으로 나눈다.** `f.r/f.sw,max` = 150/225 이라 제곱비가 44.4 % 이고 분모가 1 훨씬 아래로 떨어져 요구 λ 가 대략 두 배가 된다. `f.sw,max` 를 `f.r` 쪽으로 밀면 분모가 0 이 되어 발산한다. **225 kHz 의 출처는 관례 1.5×`f.r`** 이고 (워크북 `Design Spec B43` 라벨에 `sugg` 라고 적혀 있다) **한계가 아니라 선택**이다 — 실리콘 한계인 `f.Max`(`R.T`·`C.T`·`T.idle` 이 정하고 `k.ceil` 이 사후 판정)와 **종류가 다르다.** 설계 시트에서 "최대"라는 이름이 이렇게 상류에 있는 것은 드물어서 라운드 넘버를 무심코 넣기 쉽다. ② **"공진 위/아래는 `n` 이 정한다"** — `M.req = 2n·V_o_eff/(√2·V_eq)` 이라 `n` 이 크면 요구 게인이 커지고 공진에서 더 아래로 간다. 라인 조건 7개의 피크 `f.sw` 를 표로 넣었다(7.5:1 은 7개 중 5개가 공진 위, 9:1 은 FB 문턱과 최고 AC 둘뿐). **아래는 잘린 사인파 + 무전류 구간(`d < 1`), 위는 연속(`d = 1`)** 이라 정격의 근거인 실효값이 달라진다 — 권선비 후보를 게인 여유만으로 비교하면 안 보인다. **워크북 CHANGELOG 2줄**(`log_xl_findings.py`, 셀은 안 건드림): ⓐ `CC` J열 7점 Simpson 과 시트의 5점을 2000구간 격자와 대조 → **0.0011 % · 0.0013 %** 로 정당함이 처음 기록됐다 ⓑ `Design Spec D43` 이 `Res. Tank Design D13·D14` 를 통해 λ 를 계산한다는 사실. **`an_pdf` 본문 틀에 하단 5 pt** — ReportLab 은 문단이 들어가는지를 *행간*으로 판정하는데 마지막 줄의 디센더는 그 아래로 3.2 pt 더 내려간다. 문단을 고쳐 쓰는 대신 틀에 여유를 줬다(경계에 걸리면 언제든 재발하는 부류다). AN 은 식 31 · 그림 34 · 표 14, `an_check` 문제 0 |
| 2026-09-09 | **오늘의 변경을 전부 담아 설계점 3종을 다시 만들었다 — 그리고 그 과정에서 검사기 버그가 하나 나왔다.** 사용자가 SMath 에서 다시 바꾼 설정을 블롭에서 읽어 빌더에 못박았다: **굵기 규칙은 "데이터 4.0 · 기준선 2.0"** 으로 일관된다 — 게인 프레임은 곡선 4개만, `f.sw(θ)` 는 라인 조건 6개만, `P(θ)`·`M.req(θ)` 는 전부 데이터라 전부 굵게(뒤 둘은 추론). 범례 글꼴 게인·`M.req` 10 · `f.sw` 8. **높이는 952 로 못박았다** — 사용자가 1106 → 1099 로 두 번 시도했지만 **띠 사이 1000 px 에서 위 20 · 아래 28 을 빼면 952 가 물리적 상한**이라 그 위는 어느 쪽에도 안 들어간다. `f.Max` 를 뺀 덕에 y축이 240 까지만 쓰므로 952 에서 전보다 곡선이 크다. **`zedsheet.make(widths=)` 는 판이 가진 라벨 수만큼 채운다** — 판은 먹이는 곡선보다 많은 곡선을 가질 수 있고(`M.req(θ)` 는 8칸 판에 6개), 남는 것은 기본 펜을 유지한다. **검사기 버그:** `check_theta` 의 `M.Z` 시험점이 `0.58 · 0.62 · 0.70 · 0.90` 으로 **하드코딩**돼 있었다. `M.Z` 는 `f.n0` 와 공진 사이에만 존재하고 `f.n0` 는 `λ` 를 따라 움직이므로, 7.5:1(`λ` 0.55 → `f.n0` 0.5957)에서 0.58 이 정의역 밖으로 떨어져 근호가 음수가 되고 **멀쩡한 시트에 `math domain error`** 를 냈다. 시험점을 구간의 분율(0.05·0.2·0.5·0.85)로 바꿨다 — 세 변형 모두 통과. **결과: 시트 3종 · 벤더 사양서 3종 재생성, 전 검사 통과.** 6:1 워크북만 `calcChain` 이 없어 145 중 141 항목만 읽히는데(불일치는 0) 이는 기존 사안이다 — Excel 에서 한 번 열었다 저장하면 된다 |
| 2026-09-09 | **사용자가 SMath 에서 바꾼 판 설정을 바이트에서 읽어 빌더에 역이식하고, `f.Max` 기준선을 뺐다.** 사용자가 판 크기·선 굵기·범례를 바꿔 저장한 뒤 "참고해" 라고 했다. **읽어낸 것:** 판 높이(게인1 637→751 · `M.req(θ)` 577→736 · `f.sw(θ)` 952→1106) · 범례 글꼴(12→10 셋, 12→**6** `f.sw`) · **게인1 의 곡선 4개만 2.0→4.0**. 마지막 것은 처음에 "어느 트레이스인지 못 정한다" 고 했는데 사용자가 "코드로 확인하면 되잖아, 라벨명이 다른데" 라고 지적해 그대로 했다 — `curve_colors` 가 쓰는 라벨↔라벨 구간에서 마지막 `LineBase` 를 읽으면 곡선마다 펜 굵기가 나온다. 결과: **`M.OL`·`M@π/2`·`M@π/3`·`M@π/4` 가 4.0, `M.req` 3개와 `M.Z` 는 2.0** — "탱크가 낼 수 있는 것은 굵게, 요구는 가늘게". 비교쌍이므로 **게인2 에도 같이** 넣었다. **새 도구:** `zedpane.set_curve_widths`/`read_curve_widths`(곡선별 펜) · `set_legend_font_size`(**범례는 갓 수확한 판의 12 pt FontSpec 이므로 제목을 12 로 내리기 *전에* 불러야 유일하다**) · `zedsheet.make(widths=, legendsize=, yauto=)`. **`f.Max` 삭제:** VCO 천장 319.6 kHz 는 최고 트레이스 209.5 보다 반이나 높아 **혼자 y축을 350 까지 끌어올리고 곡선 6개를 아래 60 % 에 눌렀다.** `k.ceil` 이 숫자로 판정하고 그려지는 `f.sw_max_spec` 225 가 둘 중 낮은 천장이라 잃는 것이 없다. 함께 **y축을 `yauto`** 로 돌렸다(사용자 요청 — 다른 프로젝트에서도 범위가 따라오게). **⚠ `yauto` 는 데이터가 유계인 판에만 쓸 것** — 게인 프레임은 `M.OL` 이 창 안에 극을 갖고 `M.req(θ)` 는 θ→0 에서 발산하므로 자동이면 축이 그 값까지 늘어나 나머지가 축에 눌린다. **`KEEP` 0.6 → 0.8:** 0.6 은 같은 계열 판을 637·952·577 로 만들었고 그래서 사용자가 손으로 키운 것이다. 0.8 이면 큰 판 다섯이 전부 952 로 균일해지고 42 → 44쪽, 7·27쪽 아래가 700 px 씩 빈다. **판이 문서의 존재 이유이므로 종이가 지불한다.** **사고:** 셸에서 `&&` 를 빠뜨려 실패한 편집 스크립트 뒤에도 빌드가 돌아 사용자 파일을 덮었다. 설정은 이미 전부 추출해 둔 뒤였고 백업도 있어 잃은 것은 F9 결과뿐이다. **`.sm` 을 살려 둬야 할 때는 빌드를 별도 턴으로 분리할 것** |
| 2026-09-09 | **`check_sm` 이 말하던 "58.3쪽"은 인쇄물이 아니었다.** 파일 높이를 쪽 높이로 나눈 값이라 접힌 21815 px 이 그대로 들어 있었다. 실제 인쇄물은 40쪽이고, 그 58 이 CLAUDE.md 에 두 군데 적혀 있었다. 이제 **보이는 높이**로 센다 — 쪽 걸침 검사가 쓰는 것과 같은 좌표다 |
| 2026-09-09 | **SMath 는 쪽을 걸치는 리전을 자르지 않고 다음 장으로 민다.** 12쪽 밑에 `- MOSFET rms:` 라벨만 있고 13쪽 맨 위에 수식이 통째로 있다 — 잘린 것이 아니라 옮겨진 것이다. 그래서 증상이 "회색 띠"가 아니라 **라벨과 값이 갈라지는 것**으로 나타났고, 그 편이 알아채기 더 어렵다. 예전에 적어 둔 "SMath 는 걸치는 것에 회색 띠를 친다"는 판(pane)에 해당하는 관찰이다 |
| 2026-09-09 | **모델을 앵커로 맞출 때 앵커를 모델로 고르면 안 된다.** 처음에 쪽 첫 행을 "모델이 예측한 쪽에 가장 가까운 동명 리전"으로 골랐더니 (keep, pitch) 4233쌍이 전부 22/22 를 맞혔다 — 모델이 자기를 채점하고 있었다. 이름이 계산 절과 시트 §17·§19 에코에 두 번 나오는 것이 원인이라, **앵커마다 몇 번째 등장인지를 손으로 못박고** 다시 쟀다 |
| 2026-09-09 | **내 확인 스크립트가 사용자의 수동 편집을 덮어썼다.** `build_l6790_smath` 는 **import 되는 순간 시트를 쓴다**(모듈 최상위의 `S.save(OUT)`). 상수 두어 개를 읽으려고 import 한 조각이 시트를 통째로 다시 만들었고, 사용자가 SMath 에서 잡아 둔 **입력 이름 숨김 · 판 크기 7개 · 제목 폰트**가 사라졌다. 앞의 둘은 덮어쓰기 **전에** 읽어 둔 값이 있어 빌더에 역이식했고, **제목 폰트는 판 blob 안이라 로컬 사본에 없다** — 스크래치 사본이 편집 이전 것이었다. **교훈: 빌더에서 값을 읽고 싶으면 import 하지 말고 소스를 텍스트로 읽는다** |
| 2026-09-09 | **판 아래 입력 이름 목록을 껐다 — 예약하던 300 px 이 판 높이로 돌아왔다.** `showInputData="false"` 는 SMath 가 플롯 속성의 "입력 데이터 표시"를 끌 때 쓰는 리전 속성이고, 참조 시트(`EVLHV101SSR50W`)에 실물이 있다. 끄면 프레임 아래 중괄호 목록이 사라지므로 `zedsheet` 의 `CAPTION`·`PER_CURVE` 예약이 통째로 필요 없어진다(0 으로 두고 이유를 적었다). 11곡선 프레임이 `Tf.1..Tf.6 · Th.o..Th.s` 라고 적힌 목록에 300 px 을 내주고 있었는데, 그 목록은 범례가 더 잘 말하는 것이었다 |
| 2026-09-09 | **판 제목 글자 크기를 코드로 정한다.** `FontSpec` 의 `size` 는 BinaryFormatter 를 걸어야 닿지만, 뒤따르는 `isDropShadow`(1바이트) + `dropShadowColor`(ClassWithId + ObjectNull + 8바이트 0)가 **서명**이 되어 걸을 필요가 없다. 한 판에 FontSpec 이 10개이고 ZedGraph 기본값이 **제목 16 · 축 14 · 범례 12** 라 16 은 정확히 하나뿐 — `zedpane.set_title_font_size` 가 그것을 확인하고 바꾼다. 12 로 내렸다 |
| 2026-09-09 | **용지 위아래에 여백 띠를 두었다** (사용자 지시 3). `fit()` 은 원래도 페이지에 안 들어갈 리전을 다음 장으로 넘겼는데, 받는 높이가 **추정값**(`est_box()`)이라 조금 짧게 읽은 리전이 장을 걸쳤다. `Sheet.SAFE_TOP` 20 · `SAFE_BOT` 40 이 그 오차를 흡수한다. `zedsheet.emit` 도 같은 모델을 쓴다 |
| 2026-09-09 | **`k.` 로 시작하는데 판정이 아닌 이름 9개를 개명했다** (사용자 지시 1). 접두어가 뜻을 하나씩 갖는다 — **`k.` 판정(1 초과여야 한다) · `K.` 고른 계수 · `n.` 권선비 · `r.` 판정이 없는 분율.** `k.T_pri·k.T_sec·k.ring` → `K.*`, `k.aux·k.aux_max` → `n.*`, `k.BM·k.mix·k.c·k.tr` → `r.BM·r.mix·r.clamp·r.tr`. 시트 §17 의 "이건 판정이 아니다" 주석과 `snapshot.NOT_A_CHECK` 목록이 **둘 다 없어졌다** — 이름이 그 일을 한다. 판정 45 → 39. **`r.c` 는 Cardano 블록이 이미 쓰는 이름이라 `r.clamp` 로 갔고, 빌드 가드가 그것을 잡았다** |
| 2026-09-09 | **개명 스크립트가 `M.pk.c` 를 안쪽에서 잘랐다.** `k.c` 를 뒤쪽만 앵커한 정규식으로 바꿔서 `M.pk.c` 의 꼬리가 걸렸다 — `M.pr.c` 가 됐고 다음 개명에서 `M.pr.clamp` 까지 갔다. 두 자리가 같이 바뀌어 **빌드도 검사도 통과했다**; 새 이름이 앞에 뭔가 붙은 채 나타나는 곳을 전수 검색해서 찾았다. **앵커는 양쪽에 건다** |
| 2026-09-09 | **`V.AC_*` 는 라인 전압, `V.eq_*` 는 탱크가 보는 전압** (사용자 지시 2). `V.in_min` 은 "최저 AC 입력"인지 "인버터가 탱크에 거는 최저 전압"인지 이름만으로 갈리지 않았다 — 90 Vac 와 173 V 로 서로 다른 값이다. 모핑이 둘을 갈라놓는 것이 이 토폴로지의 핵심이므로 접두어로 못박았다: `V.eq_min`(탱크 최저) · `V.eq_hbt`·`V.eq_FBthr`(모핑 문턱) · `V.eq_ACmin/ACmax/ACnom` · `V.eq_ACa/ACb`. 게인도 따라갔다(`M.HBmin`·`M.ACmin`·`M.ACa`·`M.ACb`·`M.ACmax`·`M.FBthr`). **중복이던 `V.fb` 는 삭제** — `2*V.AC_min` 을 두 줄이 계산하고 있었다 |
| 2026-09-09 | **라인 조건 6개를 두 프레임이 공유한다** (사용자 지시 2). `f.sw(θ)` 와 `M.req(θ)` 가 같은 `_LINES` 표를 읽는다 — **최저 라인 · HB 문턱 · 110 Vac · 230 Vac · 최고 라인 · FB 문턱.** 110 과 230 은 빌더에 한 번 적히고 **행과 범례가 같은 숫자에서 나온다** — 범례가 "110 Vac" 라고 말하면서 곡선은 딴 데 그려질 수 없다. 그래서 `[PICK]` 이 아니라 **`[BUILD]`** 다(노란 셀이면 F9 가 곡선만 옮기고 범례는 두고 간다). `M.req` 프레임은 3 → 6 곡선. **`audit_sm` 검사 8 이 `Tr.4~6` 이 안 만들어진 것을 바로 잡았다** — 행렬 목록에 `for i in (1,2,3)` 이 남아 있었고, 그대로 뒀으면 축에 붙은 평평한 직선 3개로 인쇄됐을 것이다 |
| 2026-09-08 | **시트를 PDF 로 뽑았다 — SMath 자신이 인쇄한 것이다.** SMath 에 `-e`(내보내기)·`-p`(인쇄)·`-t`(재계산) CLI 가 있고 셀 다 시트를 먼저 재계산하지만, 이 PC 에서는 전부 "Automation and integration features are not available" 로 막힌다. 그래서 GUI 를 PowerShell 로 직접 조작했다 — 키를 눈 감고 보내지 않고 **창을 캐처해 읽고 버튼 좌표를 확인한 뒤 눌렀다.** 바꿔놓은 기본 프린터는 매번 원복했다. **F9 를 먼저 누르지 않으면 플롯 행렬이 안 채워져 그래프 틀만 인쇄된다** |
| 2026-09-08 | **시트 용지를 A3 Extra 에서 A3 로 바꿨다 — 그동안 인쇄하면 폭의 절반이 잘렸을 것이다.** `paper id=63` 은 DMPAPER_A3_EXTRA(322×445 mm) 이고 Microsoft Print to PDF 에 그 용지가 없어 **말없이 A4 로 떨어진다** — 1795개 중 889개 리전이 잘렸다. 가는 길에 **SMath 는 1인치를 100 px 로 깜**도 확인됐다(1752×1268 이 정확히 A3 Extra 가로다). A3 는 id 8 · 1654×1169 이고, 판 5개(1647)와 수식 2개가 오른쪽을 넘어 그것도 같이 줄였다 |
| 2026-09-08 | **`zedpane.set_size` 는 멀정한 함수가 아니었다 — 리전 속성과 같이 움직여야 할 뿐이다.** 프로브 P27(대조) 476×217 · P28(리전만 2배) 476×217 — 무변화 · P29(둘 다 2배) 464×518 이고 제목·축이름·범례·눈금이 전부 살아있다. 예전 "기본 판이 나온다"는 둘 중 하나만 움직인 조합이었다. 그래서 **판 높이를 곱선 수에 맞춰 899~1029 px 로** 올렸다(원래 482, 루프 한 쌍은 317). 판 아래 입력 이름 목록은 인쇄물에서 **이름당 23.1 px** 로 재서 예약값(33)을 고쳤다 |
| 2026-09-08 | **회색 음영 — 리전이 페이지 경계를 넘어간 것이고, 빌더가 페이지 끝을 아예 안 보고 있었다.** `Sheet.fit()` 을 넣어 **그리기 전에 남은 자리를 먼저 묻고** 안 들어가면 다음 쪽 머리로 내려간다. 행은 라벨과 수식이 같은 y 를 쓰므로 **판정을 라벨보다 먼저** 한다. `check_sm.py` 에 `page straddles` 검사를 넣었다 — 이 결함은 다른 어느 검사에도 안 걸린다(용지 안·여백 안·겹침 없음). 처음 9건 → 지금 0. 대가는 밀린 자리의 백지였고, **판은 양보하게** 했다 — AN PDF 의 적응형 그림 블록과 같은 규칙이고, 881 px 비던 쪽이 채워졌다 |
| 2026-09-08 | **색 하나가 실제로 틀렸고 인쇄물만이 잡을 수 있었다.** `KNOWN` 표에 `Teal = 160` 으로 적었는데 **160은 Tomato** 이고 Teal 은 158 이다. `set_curve_colors` 의 되읽기 검사는 같은 표를 쓰니 자기와 일치해 통과했다 — PDF 에서 선의 RGB 를 뽑으니 `rgb(255,99,71)` 이었다. 표를 `[System.Drawing.Color]::FromKnownColor` 로 다시 뽑고 RGB 주석을 달았다 |
| 2026-09-08 | **코멘트가 시트가 계산하는 숫자를 인용하고 있었고, 이미 낡았다.** SR 행은 소자당 28.3 A · k.PSR 25 % 여유라고 말했지만 시트는 15.16 A · 0.929 이고, 1차 행은 5.70 W · n.par = 2 라고 했지만 시트는 9.62 W · n.par = 1 이며, BOM 주석은 71 mF 라고 했지만 75.2 mF 다. 더 나쁜 것은 그 코멘트들이 **낡은 숫자로부터 추론해 독자에게 지시를 내리고** 있었다는 것이다. **BOM 과 판 글자에 이미 있던 규칙을 코멘트에도 적용**했다 — 시트가 계산하는 값은 산문에 적지 않고 행을 가리킨다. 13개 고쳤고 **`audit_notes.py`** 를 만들어 재발을 막는다 — 모르는 것을 안다고 하지 않도록 **후보를 나열할 뿐 판정하지 않는다**(데이터시트 한계가 계산값과 우연히 같을 수 있다) |
| 2026-09-08 | **시트 §16 의 대수를 접었다.** 영점·극 주파수와 이득·위상 여유를 구하는 식은 설계 결정이 아니다 — 어느 보상기에나 같은 식이다. 계산은 접힐 안에서 하고 결과만 `S.show` 로 한 줄씩 에코한다 — BOM 과 같은 살아 있는 참조라 위에서 계산된 값과 어긋날 수 없다. 판정(k.PM·k.GM)과 노란 셀은 그대로 보인다 |
| 2026-09-08 | **시트의 코멘트를 걸러냈다 — 기준은 하나다.** **다른 문서(ST 워크북·가이드)의 함정을 경고하는 것은 남기고**—그 둘은 지금도 책상에 같이 있고 그 함정은 오늘도 살아 있다— **이 시트 자신의 고고학은 지웠다**: 예전에 뭐가 틀렸고 언제 고쳤는지("…는 2026-08-23 까지 없었다"), 그리고 플롯 벡터를 어떻게 엮었는지("for() 안에서 채운 행렬은 안 그려진다", "단위를 먼저 떼는 이유") — 둘 다 `HISTORY.md` 와 빌더 주석에 이미 있고, 그것이 필요한 사람은 이미 거기 서 있다. 코멘트 167 → 160개 · 본문 8.0 % 감량 · 50.3 → 49.9쪽. 설계 규칙·한계·미결 항목·그림 읽는 법은 하나도 안 건드렸다. **Cardano 유도 설명은 지우지 않고 접힐 안으로 옮겼다** — "왜 가운데 근인가"는 블록을 열어본 사람만 하는 질문이다. 컷터는 소스 배치가 아니라 **AST 로 코멘트 문자열을 찾아** 고친다 — 빌더가 긴 문장을 줄 끝에서 임의로 쪼개서 적어 두기 때문에 소스 모양으로 찾으면 조용히 빗나간다 |
| 2026-09-08 | **빨강·파랑 곡선이 그리다 만 것이 아니라 반주기의 절반만 그린 것이었다.** 스윙은 `f_n` 을 바닥에서 코너까지 훑으므로 θ 는 0~π/2 뿐이고, 내려오는 사분면은 올라간 것을 거꿡로 읽은 **같은 수**다. `el()` 에는 분기가 없으니 산술로 접는다 — `tent = 1−|2u−1|` 로 주파수를 올렸다 내리고, `sign = (2u−1)/|2u−1|` 로 위상을 `π/2 + sign·(π/2−θ)` 로 반사한다. **`N.fs` 는 짝수여야 한다** — 홀수면 `u` 가 정확히 0.5 에 닿아 sign 이 0 으로 나눈다. 120 으로 했다. `check_theta.py` 도 같이 고쳤는데 **텐트 꼭대기는 표본이 아니다**(짝수라 `u` 가 0.5 에 안 닿아 가장 가까운 표본이 코너보다 0.8 % 낮다) — 그래서 검사는 텐트를 꼭대기로 **강제**해서 나머지 사슬만 §8 과 견줌다. 108.47 / 209.47 kHz 대 §8 의 108.48 / 209.49, 양 끝은 `f.o` |
| 2026-09-08 | **한 프레임 안에서 곡선 색이 겹치고 있었다 — 판의 팔레트가 여섯 개짜리라 일곱째가 첫째와 같은 파랑, 여덟째가 둘째와 같은 빨강으로 돌아왔다.** 색은 `LineBase` 의 `Color` 이고, `Color` 는 이름 null · value 0 · **`knownColor` short** 하나로 직렬화된다. 곡선의 색 레코드는 **그 곡선 Label 다음의 첫 Color** 로 정확히 짚힌다(LineItem 이 label → points → symbol → line 순서이고 ZedGraph 는 심볼과 선에 같은 색을 준다). `zedpane.set_curve_colors()` 는 쓰고 나서 **되읽어 확인**하고, `KNOWN` 표에 없는 색 이름은 아예 거부한다 — 틀린 번호는 그래도 그려지므로 아무도 두 번 보지 않는다. 7개 판 전부 프레임 안 중복 0. 게인 프레임은 **탱크가 낼 수 있는 게인은 파랑 계열 · 요구 게인은 따뜻한 계열**로 묶고, 기준선은 회색으로 내려 데이터가 아님을 보이게 했다 |
| 2026-09-08 | **팬 세로 길이 문제를 다시 열었다 — 예전 결론이 실험 설계의 결함이었다.** 판은 자기 `rect`(PaneBase 의 첫 필드 RectangleF)를 갖고 있고 리전의 `width`/`height` 속성과 항상 같다(저장할 때 SMath 가 둘 다 쓴다). 모르는 것은 **읽을 때 둘 중 무엇을 보느냐**다. 예전에 `set_size` 로 **blob 만** 바꿨더니 기본 판이 나왔고 그래서 "기하가 서로 물려 있다"고 적어 두었는데, 그 실험은 **둘 중 하나만 움직인 조합**이라 어느 쪽 답이든 반드시 실패한다 — 아무것도 가르지 못했다. 프로브 **P27(대조)·P28(리전만)·P29(둘 다)** 를 넣었다. 답이 P28 이면 blob 을 건드릴 필요가 아예 없다 |
| 2026-09-08 | **게인 축을 로그로 바꾼 것은 내 임의였고 되돌렸다.** 부하 6조건을 한 프레임에 넣으려고 y 를 로그로 만들었는데, 사용자가 요청한 적 없고 **잘못된 맞바꿈**이었다 — "아무것도 안 잘린다"를 얻는 대신 이 프레임의 존재 이유인 **게인을 요구 게인과 견주어 읽는 것**을 잃었다. 곡선이 프레임 위로 나가는 것은 고칠 문제가 아니라 경부하 거동 그 자체다. 선형으로 되돌리고 **프레임을 셋으로** 나눴다(100·75·50·25 / 100·10·1 + 세로선 / 100 + 두 선). 로그 x + 선형 y 는 transfer 판이라 **트레이스 4개가 한계**다 |
| 2026-09-08 | **범례가 "lighter still" 이면 아무 정보가 없다 — 정확한 퍼센트를 넣었다.** 다만 퍼센트는 노란 셀 `r.g2`~`r.g6` 에서 나오고 **범례는 판에 구워진다.** 그래서 그 다섯 셀도 `[BUILD]` 로 바꿨다 — 고치면 곡선만 움직이고 범례는 옛 퍼센트를 계속 말하므로 재빌드해야 한다. **범례에 숫자를 적을 수 있는 이유가 이것이다: 값이 아니라 빌드에 고정된 라벨이기 때문**이고, `_no_values` 가 막는 것은 소수점 있는 *계산 결과* 다. 분율이 정수 퍼센트가 아니면 빌더가 `assert` 로 멈춘다 |
| 2026-09-08 | **로그축 라벨이 왼쪽 절반에 안 나오던 원인 — `baseTic`.** 사용자가 x 눈금이 `1 · 1.259 · 1.585 · 1.995` 만 나오고 그 아래는 비어 있다고 지적했다. `LogScale.CalcBaseTic()` 은 `_baseTic` 이 `PointPair.Missing`(=double.MaxValue) 이면 **`ceil(log10(min))`** 을 쓴다 — min 이상의 첫 **온전한 decade**. min = 0.5 면 `ceil(−0.301) = 0`, 즉 **첫 주눈금이 f_n = 1** 이고 그 아래는 눈금 자체가 안 생긴다. decade 단위 step 이면 문제없지만 0.1 decade 같은 소수 step 에서는 반드시 깨진다. `zedpane.set_base_tic()` 을 만들어 `zedsheet._logfit()` 이 모든 로그축에 `log10(min)` 을 박는다 |
| 2026-09-08 | **판의 *창* 도 정적이다 — 사용자가 `x.gl` 을 0.1 로 바꿨는데 0.5 아래가 안 그려졌다.** 데이터는 넓어졌지만 프레임은 빌드 때 구워진 0.5 에 그대로 있어 나머지가 잘린 것이다. 글자와 같은 문제이고 F9 로는 못 고친다. 그래서 창에 물린 노란 셀 넷(`x.gl`·`x.gh`·`x.lo`·`x.hi`)만 라벨을 **`[BUILD]`** 로 바꾸고 시트에 그 뜻을 적었다 — **F9 가 안 통하는 노란 셀은 이 넷뿐이다** |
| 2026-09-08 | **부하 6조건은 한 프레임에 안 들어간다.** 사용자가 1/10/25/50/75/100 % 를 요청했는데 TI 판이 최대 5트레이스이고(참조 시트 전체를 뒤져도 6개짜리는 없다) **y 가 선형이어야 하면 4개**다(transfer 판). 그래서 성격으로 나눴다 — 왼쪽 **로그-로그** 프레임에 무거운 다섯(100~10 %)을 넣어 **하나도 안 잘리게** 하고, 가장 가벼운 1 % 는 오른쪽 **선형 y** 판정 프레임에 전부하·세로선·가로선과 함께 뒀다. 1 % 곡선의 첨두가 `f_n0` 세로선을 타고 올라가는 것이 그 세로선의 의미 자체라 오히려 거기가 맞는 자리다. x 는 양쪽 다 **0.1–10**(0.1 · 1 · 10) |
| 2026-09-08 | **시트 §14c 는 틀린 게 아니라 *계산이 끝나지 않는* 것이었다 — 3차식을 버렸다.** 붉은 리전은 오류가 아니라 평가 중이었고, 프로브의 오버플로도 같은 것의 반대편이다(안 채워진 벡터의 원소를 읽으면 0 → `F/sqrt(0)` → "above max. allowed positive number"). 원인은 크기가 아니라 **참조 사슬의 깊이**다 — gainzed 는 10,800 원소를 **2단** 깊이로 계산해 즉시 그려지는데, 시트 §14c 는 7,200 원소를 **7단** 깊이에 단마다 여러 번 참조했다. **게인식을 주파수가 아니라 위상에 대해 풀면 3차식이 필요 없다**: `Q.pk²b²s⁴ − s²/M.pk² + a² = 0` 은 `s² = sin²θ` 의 **이차식**이고 물리적 근은 마이너스 쪽이다. `f_n` 을 `f_n0` 에서 §8 이 이미 주는 `f.n.a`·`f.n.b` 까지 훑고 각 점의 θ 를 읽는다 — **`cos`·세제곱·`acos` 항등식이 전부 사라지고 사슬은 4단**, 팬아웃 8→6, 원소 평가 6,556. 양 끝이 §8 이므로 검산이 강하다: 108.47 / 209.47 kHz 대 108.48 / 209.49, θ→0 에서 85.11 대 `f.o` 85.07 |
| 2026-09-08 | **거기까지 가는 길에 음수 밑의 거듭제곱도 전부 곱셈으로 바꿨다.** `a2` 는 −5.17 인데 `a2^2`·`a2^3` 을 쓰고, 시트 §7.5 는 `f_n < f_n0` 구간에서 음수를 제곱한다. `x*x` 는 같은 수이고 더 싸며 음수의 로그에 닿을 수 없다. 남은 `^` 는 밑이 10 이거나 양수인 세 곳뿐이다. **이것이 원인이었는지는 결국 확인되지 않았다** — 원인은 속도였다. 그래도 되돌리지 않는다: 더 싸고 더 안전하다 |
| 2026-09-08 | **`audit_sm` 의 리전 스캐너가 시트의 3분의 1만 보고 있었다.** 정규식이 `<math>` 만 잡고 **`<math decimalPlaces="4">` 를 건너뛰었다** — 즉 `S.row` 로 만든 값 행 대부분이 검사 밖이었고, 그래서 "정의 전 사용 0건" 이 깨끗하다는 뜻이 아니었다. `<math[^>]*>` 로 고치니 보이는 대입이 **209 → 650** 이 됐다. 뒤집기 시험도 336 → 1,566 으로 올라간다 |
| 2026-09-08 | **시트 §14c 를 통째로 교체하면서 단위 떼는 행 6개를 같이 지웠는데, 다섯 가로선과 `f.sw` 곡선이 그것들을 계속 쓰고 있었다.** 쓰이는데 정의가 없는 상태다. **`snapshot.py` 만 알아챘다**(사라진 이름을 나열하므로). `audit_sm` 의 순서 검사는 못 잡는다 — 아무 데도 정의가 없는 이름은 "나중에 정의된" 적도 없기 때문이다. 그래서 **검사 7 — 쓰이는데 어디에도 정의가 없는 이름** 을 넣었다. 지우기가 만드는 실수는 순서 실수보다 흔하고 더 안 보인다 |
| 2026-09-08 | **`f.r/'kHz` 를 벡터 대입 안에 넣어 시트 §14c 가 붉게 났다 — 규칙은 내가 이미 시트 §16.6 에 적어 놓고 있었다.** 사용자가 식 화면을 보내며 "kHz 가 분모로 가 있는데 이게 맞냐"고 물었다. **나누는 것 자체는 맞다** — 플롯 행렬은 순수한 숫자여야 해서 단위를 떼는 관용이고 `'kHz` 는 시트가 식 안에서 13번 쓰고 프로브 P16 이 검증한 단위다. **틀린 것은 자리다**: 단위가 *벡터 원소 대입 안* 에 들어가면 안 된다. 시트 §16.6 블록에 "nothing carrying a unit reaches a plot matrix" 라고 써 놓고 새 절에서 어겼다. 6개를 눈에 보이는 스칼라 행으로 뽑았다 — `q.fr`·`q.fo`·`q.fmn`·`q.fmx`·`q.fsp`·`q.po`·`q.fc` |
| 2026-09-08 | **그것을 고치다 더 큰 것이 나왔다: 시트 §8.4 는 시트 §8 자리에서 시트 §14 의 `f.Min`·`f.Max` 를 참조하고 있었다.** SMath 는 위에서 아래로 계산하므로 그 블록은 애초에 동작할 수 없었다. **아무 도구도 못 잡았다** — `smsheet` 는 prog 블록을 Python 으로 평가하지 않고, `audit_sm` 은 빌더의 `S.row/const/set` 만 훑는다. 절을 **시트 §14c 로 옮겼고**(주파수 한계를 배경에 깔지 않으면 그 그림의 값어치가 반이므로 원래 거기가 맞는 자리이기도 하다), `audit_sm` 에 **검사 6** 을 넣었다 — *완성된 `.sm` 을 리전 좌표 순서대로* 읽어 정의 전 사용을 잡는다. 빌더를 훑어서는 못 잡는다: prog 문의 절반이 `%s` 로 만들어져 이름이 소스 텍스트에 없다. 리전을 뒤집으면 336건을 잡으므로 검출력도 확인했다 |
| 2026-09-08 | **시트가 느려진 진짜 이유는 스윕 길이가 아니라 *직선을 점마다 계산한 것* 이었다.** 사용자가 "계산이 너무 오래 걸린다"고 지적. 새 그림들의 벡터 절반이 **상수** 다 — 요구 게인, 주파수 한계, 목표 위상여유. 가로선 12개를 601·481·241 점씩 계산하고 있었는데 **직선은 두 점이면 정확히 같은 직선**이다. `k.2 := range(1,2)` 와 축 양 끝 벡터로 옮기고 스윕도 절반으로(601→301, 481→241, 400→200, 241→121) 낮춰 **원소 평가 약 25,900 → 9,774**. 해상도 손실은 확인했다 — 301점이면 시트 §7.5 의 가장 좁은 첨두에 아직 약 15점, 위상 스윕은 라인 각도 0.7° 마다 한 점이라 눈에 각이 보이는 자리가 아니다 |
| 2026-09-08 | **판이 쪽 경계에 걸쳐 회색 띠가 넓게 났다 — 위아래 여백을 3배로.** `zedsheet` 에 `LEAD`(240, 프레임 위)와 `TRAIL`(350, 이름 목록 아래)을 넣었다. **이 둘은 측정값이 아니라 그냥 여유다** — 대가가 종이뿐이므로 넉넉한 쪽이 맞다. 한 줄에 두 판을 놓을 때 둘째는 `lead=False` 여야 여백이 두 번 안 들어간다(시트 §16.6). 40.8 → 43.9쪽 |
| 2026-09-08 | **AN Figure 30 아래에 원문 캡션이 반쯤 잘려 들어와 있었다.** 사용자가 PDF 에서 발견. `an_ref_integrated` 의 잘라내기 상자가 한 줄 더 내려가 ON Semiconductor 의 **"Figure 8. Modified Equivalent Circuit to Accommodate"** 를 글자 중간에서 잘라 이미지 아래 가장자리로 흘려 놓고 있었다. 우리 캡션도 아니고 읽히지도 않으니 둘 다 지울 이유다. **눈대중으로 자르지 않았다** — `figtrim.py` 가 서명으로 찾는다: *맨 아래 가장자리에 닿고 · 몇 줄뿐이고 · 위로 넓은 공백에 의해 그림과 분리된* 잉크 띠. 진짜 패널은 이미지 경계에서 잘리지 않으므로 이 모양은 캡션 조각뿐이다. 739×639 → 739×586. 전수 검사에서 같은 결함 2건이 더 나왔다(`gain_vs_m.png` 은 어디에도 안 쓰이고, `powerflow.png` 은 한국어 가이드 md 가 쓴다) — AN 밖이라 손대지 않았다 |
| 2026-09-08 | **그 김에 낸 사고: `figures/an/` 13장을 제목 붙은 판으로 덮었다.** 참조 그림 19장이 `figures/` 와 `figures/an/` 에 손으로 복사돼 있길래 자동 동기화를 넣었는데 범위를 안 좁혔다. **두 폴더는 같은 집합이 아니다** — 생성 그림은 `figs.py --plain` 이 **제목 없는 판**을 `an/` 에 쓴다. `figs.py --plain` 으로 복구하고 `mirror()` 를 "이 모듈이 직접 쓴 파일만" 으로 좁혔다. 교훈은 짧다: **두 폴더가 부분적으로 같다고 전부 같다고 가정하지 말 것** |
| 2026-09-08 | **시트 §7.5 를 부하 계열에서 라인 위상 계열로 바꾸고, 시트 §8.4 를 신설했다.** 사용자가 참조 차트를 보여주며 지적한 것이 맞다 — 부하 계열은 **2단 LLC 의 그림**이고, 단일단에서 동작 중 움직이는 것은 부하가 아니라 **위상**이다. 시트 §7.5 는 이제 θ = π/2 · π/3 · π/4 세 곡선에 **같은 색 요구 게인 점선**을 짝지어 그리고, 두 프레임(`V.in_min` / FB 코너)의 차이가 **점선 3개뿐** 이라는 것이 "입력 전압이 바뀌면 무엇이 달라지나"의 답이다. 새로 들어간 두 곡선이 값어치가 크다 — **`M.OL`**(무부하, `f_n0` 에 극)과 **`M.Z`**(첨두 궤적 = 용량성/유도성 경계). 후자는 내가 시트 §7.5 주석에서 "`f_n0` 왼쪽이 용량성"이라고 **틀리게 적었던 바로 그 경계**이고, 이제 선으로 그려져 있어 다시 틀릴 수 없다. `M.inf = 1/(1+λ.act)` 은 `k.lam` 이 묻는 것을 가로선으로 만든다. 시트 §8.4 는 `f.sw(θ)`·`M.req(θ)`·`P(θ)` 세 프레임이고, 시트 §8 의 Cardano 3차식을 벡터로 편 것이다 |
| 2026-09-08 | **`prog` 블록에는 검사가 없었다 — `check_theta.py` 를 만들었다.** `smsheet` 는 모든 수식을 RPN 과 Python 으로 두 번 파싱해서 인쇄된 값이 옆 수식과 어긋날 수 없게 하는데, **벡터 대입은 인쇄되는 값이 없다.** 즉 시트 §8.4 의 3차식 사슬에 오타가 있어도 어디에도 안 나타나고 시트는 그럴듯한 틀린 곡선을 그린다. 그래서 **빌더에서 수식 문자열을 꺼내 Python 으로 평가**해 독립된 시트 §8 블록과 대조한다: θ=π/2 에서 **108.48 / 209.49 kHz**(= `f.sw.a`·`f.sw.b`), θ→0 에서 **85.07 kHz**(= `f.o`), 그리고 시트 §7.5 의 `M.Z`·`M.OL` 을 닫힌형과. 전부 일치 |
| 2026-09-08 | **판 크기를 바꾸는 길이 열렸다 — 드래그 + 저장 + 수확.** `set_size` 로 `PaneBase.rect` 만 고치면 판이 안 열린다는 것은 그대로다(`Chart.rect`·`Legend.location`·`Margin`·`baseDimension` 이 전부 그 사각형 기준이라 같이 안 움직인다). 그런데 **SMath 에서 마우스로 늘리면 SMath 가 그 전부를 맞춰 다시 직렬화한다** — 사용자가 게인 판을 늘려 저장한 파일을 읽으니 리전 1657×490, 판 1647×482, 내부 rect 도 1647×482 로 일치했다. `harvest_pane.py` 로 떼어 `panes/transfer8.b64` 를 그것으로 갈아 끼웠으므로 재빌드해도 크기가 남는다. **`zedsheet.LOCAL` 의 선언 범위도 같이 고쳐야 한다** — 안 고치니 `_find_pair` 가 "(0,9) 가 0번 나온다" 로 빌드를 멈췄고, 그 가드가 제대로 작동한 것이다 |
| 2026-09-08 | **판 아래 예약 공간을 실측의 1.5배로 잡기로 했다.** 실측(첫 이름 12 px 아래, 줄간 19 px)대로 40 + 22×(n−1) 을 넣었더니 사용자가 판을 3배 크기로 늘린 뒤 여전히 모자랐다. **측정은 한 번의 렌더링이고 대상은 파일에 없어 부족해도 아무 도구가 못 잡는다** — 그래서 60 + 33×(n−1) 로 반 배 더 잡았다(8트레이스 아래 315 px, 4트레이스 167 px). 넉넉한 쪽의 대가는 종이뿐이다 |
| 2026-09-08 | **판 아래 겹침 — `check_sm` 이 구조적으로 못 잡는 것.** SMath 는 플롯 입력을 프레임 아래에 한 줄씩(중괄호 묶음) 그리는데 **리전 밖**이라 파일에 기록이 없다. `zedsheet` 가 손으로 예약하던 값 24 + 15×(n−1) 은 트레이스 1~2개 시절 것이라, 4개에서 이미 시트 §16.6 의 "Anchor points" 줄이 `B.xc` 위에 얹혔고 **8개에서는 시트 §8 제목과 본문을 뚫고 내려갔다**(사용자가 PDF 로 지적). PDF 실측 — 첫 이름은 프레임 아래 약 12 px, 줄간 약 19 px — 으로 **40 + 22×(n−1)** 로 고쳤다(8개에 218 px 확보, 여유 약 54 px). 게인 그림의 설명 주석은 프레임 **위로** 옮겼다. **기하 검사기가 원리적으로 못 보는 영역이므로 상수에 근거를 적어 두었다** |
| 2026-09-08 | **판을 키우는 법을 찾았다 — 이제 이 프로젝트가 판을 소유한다.** "이름 붙는 트레이스는 4개가 천장" 이라던 것이 풀렸다. **SMath 는 판의 곡선 목록을 입력 개수에 맞추고, 저장할 때 그 판을 파일에 되쓴다.** 저장본 대조로 확인했다 — 4곡선 판에 8개를 먹이면 `LineBase {1.0: 8, 2.0: 21}` 로 곡선 4개가 **추가된 채** 저장되고, 4곡선 판에 2개를 먹이면 `{2.0: 17}` 로 **제거된 채** 저장된다. 그래서 `harvest_pane.py` 로 그 8곡선 판을 떼어내 `panes/transfer8.b64` 에 넣고 `zedsheet.LOCAL` 에 `(8,'transfer')` 로 등록했다. 새 곡선의 `Label._text` 는 판이 이미 가진 **빈 문자열을 참조(MemberReference)** 하고 있어서, 그 5바이트 참조를 문자열 레코드로 바꾸면 이름이 붙는다. **첫 Label 은 클래스 정의 레코드(`05`)이고 나머지는 `ClassWithId`(`01`)** 라 처음에 7/8 만 찾았다 — 클래스를 이름(`ZedGraph.Label`)으로 찾도록 고쳤다. 시트 §7.5 는 **한 프레임 8트레이스 전부 이름 있음**으로 돌아왔다 |
| 2026-09-08 | **저장본이 우리 편집을 보존한다는 것도 같이 확인했다.** SMath 가 저장한 판과 빌더가 만든 판을 바이트로 대조하니 **길이 같고 다른 바이트 12개뿐**이며, 축 범위·눈금 간격·`baseTic`·`minAuto/maxAuto`·숫자 서식 `0.###`·선 굵기 2 px 가 전부 그대로였다. 즉 사용자가 SMath 에서 저장해도 판 설정이 되돌아가지 않는다 |
| 2026-09-08 | **그래서 결국 4+4 두 프레임이 됐다 — 이번에는 근거가 있다.** 8개를 한 프레임에 넣으니 다 그려지긴 하는데 **뒤의 4개는 기본색 · 1 px · 범례 없음**이었다. 사용자가 "라벨명이 여전히 누락돼있어" 라고 지적했고, 판이 소유하지 않은 곡선에는 SMath 가 범례 항목을 아예 만들지 않으므로 **한 프레임에 이름 붙는 트레이스는 4개가 천장**이다. 나누는 기준은 부하 크기가 아니라 **트레이스의 성격** 으로 잡았다 — 왼쪽에 **한계를 말하는 것 전부**(전부하 · 최경부하 · 세로선 `f_n0` · 가로선 `M.Vmin`), 오른쪽에 **추세를 말하는 중간 부하** 넷(75/50/25/10 %). 두 판이 창과 세로 눈금을 공유하므로 서로 직접 비교된다. 8개 전부 이름·굵기가 붙었다 |
| 2026-09-08 | **판이 가진 곡선 수는 트레이스 한계가 아니다 — 서식의 한계일 뿐이다.** 4곡선 transfer 판에 행렬 8개를 `sys(...,8,1)` 로 주니 **8개 다 그려졌다**(사용자 화면 확인). "로그 x + 선형 y 는 4개가 한계" 라고 적어 뒀던 것은 **판을 복사해 온다는 사실의 한계**였지 그래프의 한계가 아니었다. 다만 SMath 는 판이 소유한 4개에만 우리가 넣은 서식(2 px · 색 · 범례 문자열)을 쓰고 **나머지는 기본색 · 1 px · 범례 없음**으로 새로 만든다. 그래서 서식이 붙는 4칸에 **전부하 · 최경부하 · 세로선 · 가로선**을 먼저 넣고 중간 부하 4개를 뒤로 돌렸다 — 이름 붙은 두 곡선이 계열의 양 끝을 잡아 준다. **이 사실을 시험 시트로 먼저 확인하려 했는데, 사용자 지적대로 실제 시트에 행렬 하나 더 넣어 보면 끝날 일이었다.** 격리 시험(`L6790A_gainzed.sm` 시트 §9)은 실패 양식을 가르는 용도로만 남겼다 |
| 2026-09-08 | **SMath CLI 는 라이선스가 막는다.** `SMathStudio_Desktop.exe <sheet> -silent -export pdf` 로 무인 렌더링을 시도했으나 `Automation and integration features are not available` 로 거부된다(`-test`·`-info` 도 동일). 플러그인은 다 로드되고 거기서 멈춘다. **즉 렌더링 결과는 사람이 열어야만 볼 수 있다** — 기하 검사기(`check_sm`)가 잡지 못하는 것은 전부 사람 확인 대상이다 |
| 2026-09-08 | **판 글자에 계산값을 넣지 말 것 — 사용자 지적으로 규칙이 됐다.** 처음에 판 제목에 `crossover 17.57 Hz phase margin 49.6 deg` 를, 범례에 `peak 1.78 at fn 0.61` 을 넣었다. **ZedGraph 판은 정적 바이트 덩어리라 F9 가 닿지 않는다** — 노란 셀을 고치고 F9 를 누르면 곡선만 움직이고 글자는 그대로 남는다. 경고도 없다. BOM 을 손으로 적지 말라는 것과 **같은 실패 양식**이고, 덤으로 다른 프로젝트에 재사용도 안 된다. 이제 범례는 **변수 이름**을 말하고(`Q = Q.pk x r.g2`, `VERTICAL f.cross`) 값은 프레임 위의 행에 있다. `zedsheet._no_values()` 가 소수점 있는 숫자를 담은 판 글자를 **빌드에서 거부**한다 — 다시 들어올 수 없다 |
| 2026-09-08 | **위상 축 이름이 틀렸었다.** `phase margin [deg]` 라고 적어 놓고 모든 주파수의 `180° + arg T` 를 그렸다. **이것이 위상 여유인 곳은 |T| = 0 dB 인 한 점뿐**이고 나머지는 −180° 로부터의 거리일 뿐이다. 곡선은 맞았고 이름이 틀렸다. 축 이름을 `180 deg + arg T [deg]` 로 바꾸고, `f.cross` 세로선과 목표 `Φ.M` 가로선을 넣어 **여유를 두 선이 만나는 자리에서 읽게** 했다 |
| 2026-09-08 | **시트 §7.5 의 주석도 하나 틀렸었다.** "세로선 왼쪽은 용량성" 이라고 적었는데, **용량성 경계는 `f_n0` 가 아니라 각 곡선 자신의 첨두**이고 부하에 따라 움직인다(전부하 f_n 0.612 vs `f_n0` 0.5606). `f_n0` 는 *무부하* 게인이 발산하는 주파수, 즉 어떤 부하로도 그 아래는 조정 불가라는 하한이다. **둘 다 하한이지만 같은 하한이 아니다.** 그리고 부하 조건을 100/75/50 → **100/50/10/1 %** 로 바꿨다 — 무부하는 `f_n0` 에 극이 있어 그릴 수 없으므로 1 % 가 대신 서고, 첨두가 1.78 → 3.34 → 16.4 → 163 으로 커지며 세로선 위로 걸어 들어가는 것이 `f_n0` 가 하한인 이유를 그림으로 말한다. 프레임도 둘로 나눴다(왼쪽 부하 계열, 오른쪽 전부하 대 두 하한) — 트레이스 상한이 로그 x 에서 4개이기 때문이기도 하다 |
| 2026-09-08 | **정본 시트에 ZedGraph 판 3장이 들어갔다 — 게인 곡선(시트 §7.5 신설)과 루프 보드선도(시트 §16.6 재작성).** SMath 에는 로그축이 없어 시트 §16.6 은 데이터에 `log10(f/Hz)` 를 넣고 눈금을 글로 설명하고 있었다. ZedGraph 판에는 로그축이 있으므로 **x 가 0.1 · 1 · 10 · 100 · 1000 Hz 로 읽힌다.** 그리고 네 곡선 중 셋은 한 그림이다 — dB 에서 `|T| = |G.cto| + |EA|` 이므로 합과 성분을 같이 봐야 한다 — 그래서 한 프레임에 범례를 달아 넣고 위상 여유만 따로 뒀다. **네이티브 `<plot>` 4장 → ZedGraph 2장.** 시트 §7.5 는 없던 그림이다: 부하 100/75/50 % 의 M(f_n,Q) 세 곡선 위에 **세로선 `f.n0`** 와 **가로선 `M.Vmin`** 을 겹쳐, 전부하 곡선이 요구 게인에 **세로선 오른쪽에서** 닿는지를 한눈에 보인다(왼쪽은 용량성 = 하드 스위칭). 새 수치는 없다 — 시트 §17 이 비율로만 말하던 것을 한 프레임에 놓았을 뿐이다. 변형 3종 전부 빌드·검사 통과를 확인했고(사용자 확인 전이라 변형 시트 파일은 원상복구), 정본만 갱신했다 |
| 2026-09-08 | **그 과정에서 `for()` 가 시트에서 사라졌다.** ZedGraph 판은 `for()` 안에서 채운 행렬을 그리지 않는다 — TI 앱노트 시트처럼 **범위변수 + 평범한 `el()` 대입 + `eval(augment(vectorize(x),vectorize(y)))`** 로 만들어야 한다. 시트 §16.6 이 `for`·`line` 을 쓰던 유일한 곳이었으므로 둘 다 안 쓰인다(`check_sm.ALLOWED` 에는 남겨 뒀다 — 변형이 쓸 수 있다). **부수 효과가 하나 있었다:** 옛 블록은 `for` 안에서 단위를 달고 계산했는데(`w.bp := 2*π*10^x.bp*'Hz`) 플롯 행렬은 순수 숫자여야 하고 단위 붙은 값의 `ln()` 은 실패하므로, 코너 5개를 **눈에 보이는 행에서 한 번씩 단위로 나눠**(`q.z`·`q.p`·`q.px`·`q.g`·`q.a`) 그 아래를 전부 무단위로 만들었다. `audit_rpn` 532식 불일치 0 |
| 2026-09-08 | **ZedGraph 판의 축 타입은 판별로 고정이고 축 하나만 못 바꾼다.** 5트레이스 판(TI idx 8)의 로그 y 만 선형으로 바꾸려다 실패했다. 한 판에 스케일 레코드는 6개인데 타입 *이름* 은 2~3개뿐이다 — 이름은 클래스 레코드의 것이고 나머지 인스턴스는 `ClassWithId` 로 객체 id 만 참조한다. 그래서 이름을 고치면 **그 클래스의 모든 축이 한꺼번에** 바뀐다(`to_linear` 가 도는 이유이자, 하나만 못 고르는 이유). 결론: **로그 x + 선형 y = transfer 판이고 그건 4트레이스까지**, 5트레이스는 전 축 선형이다. `zedpane.py` 에 그 자리에 적어 뒀다 |
| 2026-09-08 | **사용자가 ST 원본의 암호를 풀어 `Uncryped_04092026_LGE_670W_L6790A_spread sheet.xlsx` 를 넣었다 — 처음으로 원본과 우리 rev0_6 을 수식 단위로 대조했다.** 시트 매핑은 문서대로다(원본 `sheetN` ↔ 우리 `sheetN+1`, `BOM&Schematics` 는 양쪽 B2:X91, `OutCap_Sel_DB` 는 양쪽 A1:GZ266, `RTC` 는 A3:CL218 → **A3:CL234** 로 Cardano 18블록만큼 정확히 늘었다). 전체 차이는 **바뀐 수식 256 · 신설 260 · 삭제 281**. 설계 시트 7장으로 좁히면 손댄 셀 **105개**이고 전부 우리 작업으로 설명된다 — C.5 의 `/D107` 제거(`Res. Tank Design` D9·D10·D11·D12·D17), C.8 의 `D20 = MIN(2*D13, 245/√2)` 와 `D81 = 2*235/√2`, C.18 의 `CC!C..` → `CC!J..` 연결, `D28 → RTC!$BB$149`, `D35` 의 π → 2π. **ST 원본과 대조해도 새 오류는 없다** |
| 2026-09-08 | **다만 워크북 자신의 `CHANGELOG_rev0_6` 이 손댄 셀 105개 중 48개를 적지 않았다.** 39개가 `CompensationNet&Check` 123~166행에 몰려 있고 전부 **이득 여유 신설과 3번째 극 `f.px` 추가** 작업이다 — `D130 = SQRT(D103*D104-D102*(D103+D104))` 가 AN 식 (29) 그대로이고, `I132·I134·I139` 는 크기·위상식에 `D104` 항이 붙은 것이며, 141~166행 25칸은 ST 가 손으로 굴리던 보간 행을 닫힌형으로 대체하며 지운 것이다. 나머지 9개도 전부 우리 것이다 — `Device Setting D49·D50·G49`(0.55/0.75 V 감지에서 나온 OCP 임계), `Power Components F79 → F80`(바디다이오드 2행 삽입으로 밀린 것), `Res. Tank Design E10 → E16` 과 `BOM&Schematics` G열 힌트(라벨 이동). **오류가 아니라 기록 누락이고, rev 0.7 의 `CHANGELOG_rev0_7` 이 받아야 할 몫이다** |
| 2026-09-08 | **어디까지 봤는지 분명히 해 둔다.** 수식을 한 칸씩 확인한 것은 **설계 시트 7장(105칸)** 이다. 대량 시트는 다른 방식으로 덮었다 — `RTC`(524칸 변동)는 `rtc_check` 가 격자의 *답*을 독립 solver 둘과 18점에서 대조하고, `CC`(59칸)는 Simpson J열 연결과 `xl_sm_compare` 가, `OutCap_Sel_DB`(109칸)는 조회표라 계산 경로가 아니다. **전수로 본 것과 결과로 본 것을 섞어 말하지 말 것** |
| 2026-09-08 | **변형 3종의 시트와 워크북을 전수 검토했다 — 수식 자체에는 오류가 없다.** 결정적인 검사는 대조다. **워크북**: `<f>` 요소 **14,836개가 셋 다 바이트까지 동일**하고, 값이 다른 셀은 의도한 패치뿐이다(7.5:1 은 F9·F45·F83·F91 넷, 6:1 은 F9·F43·F44·F45·D21 다섯). **시트**: 수식 리전 **644개 중 6개만 다르고 전부 입력 상수**다(`n`·`C.r`·`L.r`·`L.m`·`N.p`·`N.s`·`n.aux`·`R.ZCD_H_sel`·`C.T` 중 해당분). 즉 변형화가 수식을 건드리지 않았다. 그 위에 `check_sm` OK ×3 · `audit_rpn` 521식 재평가 불일치 0 ×3 · `audit_dim` 차원 충돌 0 ×3 · 빌더 자동대조 mismatches 0 ×3 · `check_trans_spec` 불일치 0 |
| 2026-09-08 | **6:1 워크북에 실제 문제 2건.** ① **캐시가 낡았다** — `C.T` 를 390 → 330 pF 로 고친 뒤 Excel 을 한 번도 안 열어 `calcChain` 이 없고, `f.Min` 캐시 110.13 kHz 가 **390 pF 로 계산된 값**이다(330 pF 면 128.87 kHz, 시트 값과 같다). 영향받는 칸은 `Device Setting D24·D27·D28·D29` 와 `BOM&Schematics E57` 다섯 — **BOM 이 390 pF 를 싣는다.** Excel 에서 한 번 열었다 저장하면 끝난다 ② **`Device Setting!F21` 이 정본에는 비어 있는데 변형 3종 모두에 값이 쓰여 있다**(470·470·390). `C.T` 는 D21 직접 입력이고 F열 선정 셀이 없는 행인데, 변형을 만들 때 F열 습관이 그대로 적용된 것이다. 9:1·7.5:1 은 둘 다 470 이라 안 보였고 6:1 만 D21 330 옆에 F21 390 이 남았다. **읽는 수식이 하나도 없어 수치 영향은 0** — `CC` 의 두 수식은 자기 시트 F21 을 가리킨다. 사람이 행을 보면 두 값을 보게 되므로 정본처럼 비우는 것이 맞다 |
| 2026-09-08 | **도구 결함 2건 — 워크북이 아니라 도구가 틀렸다.** ① `rtc_check` 가 **설계점을 절반만 워크북에서 읽고 있었다.** 2026-09-07 에 `n`·`L.m` 을 F9·F45 에서 읽도록 고치면서 `C.r`·`L.r` 은 `design()` 호출의 리터럴 100 nF / 11 µH 로 남겼다. 정본과 7.5:1 은 마침 그 값이라 통과했고, **6:1(180 nF / 6.4 µH)에서 참조 f_r 이 151.75 kHz 로 굳어 멀쩡한 격자가 36건 불일치로 보고**됐다. F43·F44 도 읽도록 고치니 3종 전부 `VERDICT OK`. 같은 파일의 docstring 이 바로 그 실수의 전례를 설명하고 있었다 ② `xl_sm_compare` 가 **낡은 캐시로 인한 차이를 `INTENDED` 로 덮고 있었다** — 6:1 의 C_T 4칸이 등록된 사유를 갖고 있어 "불일치 0" 으로 요약됐다. `calcChain` 이 없으면 캐시가 자기 수식의 결과가 아니므로 등록된 사유가 설명이 될 수 없다. 이제 `STALE?` 로 따로 세고 **exit 1** 을 낸다 |
| 2026-09-08 | **감사 도구에 변형 스위치를 달았다** — `SM_OVERRIDE` · `XL_OVERRIDE`. `xl_sm_compare` 만 `XL_OVERRIDE` 를 갖고 있었고 나머지는 정본 경로에 고정이라, **설계점 3종은 `audit_rpn`·`audit_dim`·`audit_xl`·`rtc_check` 를 한 번도 통과한 적이 없었다.** `check_sm` 은 원래 경로 인자를 받고, `audit_sm` 은 빌더를 읽으므로 3종 공통이라 스위치가 필요 없다 |
| 2026-09-08 | **"이제 오류 없어?" 에 답하려고 2차 검토 — 4건이 더 나왔다.** ① **식 (3), 이 문서의 중심 수식이 틀려 있었다.** 분자가 `f_n²` 인데 대수적으로 `f_n` 이다 (`M = 1/√(A² + Q²(f_n−1/f_n)²)`, A = 1+λ−λ/f_n²). **f_n = 1 에서 두 형태가 같은 값을 주기 때문에 살아남았다** — 본문이 독자에게 시키는 검산이 전부 f_n = 1 에서다. 벗어나면 f_n = 2 에서 1.416 대 0.708 이고, f_n → ∞ 에서 발산해 바로 아래 문장과 식 (13) 을 정면으로 부정한다. **수치는 하나도 안 움직인다** — 모든 곡선과 동작점은 `l6790.M` 에서 나오고 그것은 처음부터 올바른 형태였다. 인쇄된 수식만의 문제다 ② **"2f_l 성분을 빼면 약 40 % 과소평가" 가 틀렸다 — 27 % 다.** 두 경로가 정확히 일치한다: 스위칭 성분 `√(I.node_ms − 1.5·I.out²)` = 23.84 A, 2f_l 성분 `I.out/√2` = 18.60 A, `√(23.84²+18.60²)` = 30.24 A = 전체. 백분율은 방향도 애매하므로(전체가 27 % 크다 / 스위칭만이 21 % 작다) **두 전류를 그대로 적도록** 고쳤다. 같은 문장이 시트 주석 [70a] 에도 있어 빌더까지 고치고 정본·변형 3종을 재빌드했다 ③ 식 (24) 가 **규격 리플**로 시작하는데 인용값 67.2 mF 는 시트의 **실현 리플**(`V.start = V.out − ΔV.out/2`) 에서 나온 값이라 0.7 % 어긋났다 — 식을 `ΔV_pp` 로 바꿔 맞췄고, 선별식 (25) 는 뱅크가 정해지기 전에 쓰는 것이라 규격 Δv 를 그대로 두되 그 차이를 본문에 적었다 ④ `HISTORY.md` 가 `L6790_VARIANT` 값을 `nT9`·`nT7p5`·`nT6` 라고 적어 두었는데 실제 키는 `9to1`·`7p5to1`·`6to1` 이다 |
| 2026-09-08 | **`an_check.py` 를 심었다 — `check_sm.py` 의 PDF 판.** 사람이 40쪽을 읽으면 사람이 알아채는 것만 잡히고 못 알아채는 것은 안 잡힌다. 이번에 눈으로 본 것은 42쪽 중 17쪽뿐이었다. 도구는 **쪽마다 틀 밖으로 나간 것 · 텍스트끼리 겹침 · 그림이 글 위에 얹힘 · 110 dpi 미만 그림 · 원본과 종횡비가 다른 그림**을 재고, 쪽 아래 여백은 실패가 아니라 보고만 한다(큰 그림이 안 들어가 밀리는 것은 정상 동작이다). 현재 **문제 0건**. 이번에 눈으로 잡은 결함 3건(카드 글자 잘림 · 범례가 곡선을 가림 · 캡션 아래첨자가 다음 줄에 닿음) 중 앞의 둘은 이 검사기가 잡는 종류다 |
| 2026-09-08 | **수식 30개를 전수 검산했다.** 시트·`l6790.py` 와 수치 대조가 되는 것은 전부 맞다 — (1) f_r · (2) f_o · (13) M_∞ · (17) n = n_T/√(1+λ) · (18) L_μ·L_L1 · (19) **L_short = L_L1 + L_μ‖n_T²L_L2 = L_r 를 11.000 µH 로 재현** · (20) B_pk 182.1 mT · (21) I_eq 9.97 대 9.96 A(**세트 N_p = 15 와 세트 L_open 으로 계산해야 맞는다** — 유닛당 N_p = 5 로 넣으면 정확히 1/3 이 된다) · (23) 71.25 mF · (24) 67.22 mF · (26) ΔL/L · (28) f_p = K_v·f_MB = 46.06, f_z = f_MB/K_v = 6.22. 정의식 (5)(6)(7)(8)(14)(15) 은 대수로 확인. **`V.o_eff` = 25.0 V 이므로 V_f = 0 이다** — SR 2병렬 1.85 mΩ 에 26.3 A 면 49 mV 라 무시한 것이고, 규약 페이지의 `V.o_eff = V.out + N_rect·V_f` 와 모순되지 않는다 |
| 2026-09-08 | **`k.ZVS` 는 한 점만 본다 — 그리고 7.5:1 과 6:1 에서 그 점이 최악이 아니다.** AN 을 1쪽부터 다시 읽다가 AN §6.5 의 스윕 표와 본문이 어긋나는 것을 발견했다: 본문은 "전부하·저입력 코너 460 ns, 여유 2.09" 인데 **바로 위 표의 최소값이 401 ns**(부하 25 % · 332.3 Vac 등가)였다. 시트의 `k.ZVS` 는 `T.ZC` 를 **저입력 코너 전부하 한 점**에서만 재고, 그 점은 *게인* 최악점이지 ZVS 최악점이 아니다. 부하·등가입력 2차원으로 훑으면 — **9:1** 최소 530 ns @ 저코너 전부하(= 시트 2.408, 일치) · **7.5:1** 401 ns @ 고코너 25 % 부하(시트 2.091 → **실제 1.824**) · **6:1** 363 ns @ 고코너 50 % 부하(시트 2.073 → **실제 1.649**). 셋 다 여전히 통과하지만 **정본만 보고한 값이 맞다.** 원인은 물리적이다 — 부하를 덜면 게인을 깎으려고 `f.sw` 가 올라가고 자화전류 피크가 `V.in/(4 f.sw L.m)` 로 함께 떨어지는데 중점 용량은 그대로다. `n` 이 커 이미 공진 깊이 아래에 있는 9:1 은 이 효과가 전부하 코너를 못 이긴다 |
| 2026-09-08 | **AN 전수 재검토 — 실제 오류 11건.** ① 위 ZVS ② AN §6.4 가 `Q.pk` 0.766 과 `Z.0` 23.32 Ω 를 나란히 적었다(가이드 정의 `Q=Z.0/R.ac` 로는 양립 불가 — 23.32 는 `R.ac·Q.ZVS` 이고 선정 탱크는 `Z.0s` 10.49 Ω) ③ 표 3 이 `L.m` 8.87 → 20 µH 를 "rounded **down**" 이라 적고 바로 아래에 "Never round L.m up" 을 붙였다(8.87 은 무부하 λ 요구값이지 반올림 대상이 아니다) ④ **식 (24) 홀드업 조건이 최악 라인 위상을 빼먹어 59.8 mF — 시트 `C.hold_req` 는 67.2 mF** 이고 세 줄 아래 주석은 최악 위상을 써야 한다고 주장하고 있었다(리플이 이기는 것은 그대로지만 여유가 1.19 → **1.05배**) ⑤ AN §4.3 의 3차식 근 판별이 논증으로 성립하지 않았다("곱 음수 + 합 양수 ⟹ 세 실근" 은 거짓) ⑥ AN §2.3 · AN §2.9 가 "f.o 위면 유도성" 이라고 해 AN §2.8 과 충돌 ⑦ Figure 9 가 **전부하 곡선에 무부하 경계**를 칠했다 ⑧ Figure 23 각주가 모핑 두 임계를 뒤바꿨다 ⑨ AN §3.2 · Figure 31 이 "에너지는 그대로" 라면서 21.9 J 대 23.5 J 를 적었다(서로 다른 기준으로 정한 뱅크의 *총* 저장 에너지였다) ⑩ 표 6 이 ±10 % 를 규정하고 AN §6.17 이 4.1 % 밖에 못 견딘다고 증명한다 ⑪ 캡션이 인용하는 Infineon AN 2012-09 · Toshiba · MPS · ROHM 네 곳이 References 에 없었다 |
| 2026-09-08 | **손으로 적은 상수 넷을 시트로 돌렸다** — `Crip` 71.25 · `Chold` 59.77 · `Ecap` · `Ebulk` 가 `an_pdf.V` 에 리터럴로 박혀 있었고, 그중 `Chold` 는 **이미 틀려 있었다**(시트 `C.hold_req` 67.22). 시트에 `C.ripple`·`C.hold_req` 가 있는데도 옆에 숫자를 적어 둔 것이 원인이다. AN 이 "모든 수치가 한 곳에서 나온다" 고 주장하는 이상 이런 리터럴은 조용히 낡는다. 홀드업 비교(400 V 버스 대 25 V 출력)도 사양에서 유도하게 고쳤다 — **같은 7.89 J 에 커패시턴스만 245배** |
| 2026-09-08 | **구성 두 곳을 보강했다.** ① AN §2 가 LLC 11개 소절 뒤에 PFC 4개 소절로 이어지는데 **전환을 알리는 문장이 없었다** — 2.11 이 LLC 설계 순서로 끝나고 2.12 가 정류기 얘기로 시작한다. 앞 절 끝에 "여기까지가 절반" 상자를 넣었다 ② **보호 기능이 다섯 절에 흩어져 한 곳에도 모여 있지 않았다** — 브라운아웃·OCP1/2·OVP1/2·용량성 보호·버스트를 "무엇이 정하는가" 와 함께 AN §8 에 표로 모았다. `R.CS` 가 최대전력 법칙과 OCP 를 동시에 정한다는 것이 표에서 처음으로 눈에 보인다 |
| 2026-09-08 | **쪽 아래에 남던 흰 공간을 없앴다 — 전역 축소는 답이 아니었다.** 41쪽 중 8쪽이 아래 131~274 pt 를 비우고 있었고, 원인은 전부 같았다: 그림은 **이미지+캡션이 한 덩어리**라 남은 자리에 안 들어가면 통째로 다음 쪽으로 넘어간다. **모든 그림을 같은 비율로 줄이는 방법을 6종 측정했더니 단조롭지 않았다** — 0.98 에서 여백 5쪽·1100 pt, 0.93 에서 6쪽·1006 pt 로 최선이었다가 0.88 에서 9쪽·1506 pt 로 오히려 나빠진다. 재배치가 재조합되는 문제이지 크기 문제가 아니다. 대신 `an_pdf.FigBlock` 을 만들어 **reportlab 이 "남은 높이가 이만큼" 이라고 물을 때 조금만 모자라면 그 그림 하나가 양보하도록** 했다(`MINFIT` 0.74 — 그보다 많이 깎아야 하면 판독성을 지키고 넘긴다). 결과 **여백 8쪽·1619 pt → 6쪽·921 pt, 41 → 40쪽**이고 **34장 중 4장만, 최소 83 % 로** 줄었다(유효 해상도 128~391 dpi 로 전부 판독 가능). 남은 6곳은 261~340 pt 짜리 그림이 122~211 pt 자리에 걸린 것이라 40 % 를 깎아야 들어간다 — 넘기는 쪽이 맞다 |
| 2026-09-08 | **안 풀리는 교차 참조가 조용히 `Section ?` 를 인쇄하고 있었고, 실제로 한 건이 PDF 까지 갔다.** 23쪽 "Section ? left the question open" — 가리키던 "Above resonance and below resonance" 절이 **9월 7일 배경 장 재배치 때 앞 절로 합쳐지면서 사라진 것**이다. `secref()` 가 `.get(title, '?')` 였던 탓이다. 참조를 `The two resonances`(2.5절)로 다시 걸고, **`check_refs()` 를 심어 마지막 패스까지 안 풀린 이름이 있으면 빌드를 실패**시킨다. 1패스는 등록 전에 묻는 것이 정상이므로 판정은 "물었을 때 모름" 이 아니라 **"끝까지 모름"** 이다. 가드가 실제로 잡는지 없는 절 이름으로 확인했다 |
| 2026-09-07 | **AN 을 1쪽부터 초보자 관점으로 읽어 배경 장의 순서 결함 3건을 고쳤다.** 원인은 하나였다 — **"Above resonance and below resonance" 절이 "The two resonances" 절과 같은 얘기를 다른 말로 반복**하고 있었고, 같은 세 모드를 보여주는 **그림도 두 장**이었다(Infineon Table 1 파형과 Infineon 3.4). 중복 절과 중복 그림을 지우고 닫는 문단만 앞 절로 옮겼다. 그 결과 ② **"두 경계는 다른 경계다" 가 above/below 가 정의되기 두 절 전에 그것을 비교하던 문제**가 저절로 풀렸다 |
| 2026-09-07 | **③ "일반 LLC 설계 순서" 가 4쪽 뒤에 나올 ZVS 와 피크게인 경계를 이미 쓰고 있었다** — 장 끝(데드타임 절 뒤)으로 옮겼다. 이제 시트 §2 의 모든 전방 참조가 사라졌다: 회로 → 왜 공진 → M·Q → 두 공진 → 게인곡선 → 용량성/유도성 → 두 경계 → ZVS/ZCS → 데드타임 → **설계 순서** → PFC |
| 2026-09-07 | **그림 19 각주가 71 mF, 본문이 75.2 mF 로 어긋나 있었다** — 71 은 리플 조건만의 요구값이고 75.2 는 실제 채운 값이다. 각주를 "리플 조건만으로 %d mF 를 요구한다" 로 고쳐 둘이 다른 것임을 드러냈다 |
| 2026-09-07 | **`R.ac` 설명이 "정의가 다르다" 로 읽히게 쓰여 있었다 — 고쳤다.** 정의는 같다. **같은 식에 다른 전력을 넣은 것**이다: 관례형은 평균 전력 `P`, 우리는 라인 피크 순시 전력 `2P`. `8/π² · n²V²/(2P) = 4/π² · n²V²/P` 로 소수점 넷째 자리까지 같다(13.7006 Ω). AN 의 주의 상자와 캡션이 "half of it" 이라고만 해서 **다른 공식처럼, 심하면 하프/풀브리지 계수처럼 읽혔다** — 실제로 그렇게 물어보셨다. 두 곳과 본문 한 줄을 고쳐 "같은 식, 다른 순간" 이 먼저 오게 하고, **"하프브리지 대 풀브리지와는 무관하다 — 브리지 계수는 등가 입력전압에 들어간다"** 를 명시했다 |
| 2026-09-07 | **왜 하필 라인 피크인가를 확인했다.** ① **단일단에서 평균은 실재하지 않는 상태다** — 컨버터가 `P` 를 뽑는 순간이 없다(항상 `2P sin²θ`). 2단은 버스가 일정해 평균이 곧 동작점이라 관례형이 평균을 쓴다. ② **구속 조건이 거기 있다** — `Q(θ) = Q.pk sin²θ` 는 θ=π/2 에서 최대이고 높은 Q 가 ZVS 를 위협한다. **스윕으로 확인: HB 코너 전부하에서 `T.ZC` 최소가 정확히 θ=90°(460 ns)** 다. ③ 나머지가 한 줄로 따라온다(계수 2 가 안 붙는다). ④ 유일하고 명확한 순간이다 — 임의의 위상을 고르면 ST 툴의 C.18(θ=π/4 를 "라인사이클 값" 이라 부른 결함)이 된다 |
| 2026-09-07 | **빌려 온 그림 16장의 기호를 전수 조사했다** — 원본 PDF 에서 각 크롭 영역의 텍스트 토큰을 뽑아 우리 관례와 대조했다. 대부분 깨끗하다: Infineon 동작회로는 `N.p:N.s` 를 쓰고(우리 `n` 과 안 겹친다), onsemi 파형은 `I.p`·`I.m`·`V.d` 뿐이고, Toshiba PFC 는 문맥이 달라 충돌이 없다. `an_ref_peakgain` 의 `m` 은 우리 `m = 1+1/λ` 와 같은 정의다 |
| 2026-09-07 | **남은 둘은 성격이 달라 다르게 처리했다.** ① `an_ref_fha` 의 **`R.ac = 8n²/π²·R.o`** — 기호가 아니라 **정의가 다르다.** 그 그림 맥락에서 `8/π²` 는 옳고, 우리 `4/π²` 는 라인 피크 순시전력 기준이라는 단일단 고유의 재정의다. **그림을 고치면 그 그림이 틀리게 되므로 손대지 않고** 캡션에 "여기 것이 관례형이고 이 문서는 그 절반을 쓴다, 이유는 §…" 를 적었다. ② `an_ref_modes_i` 의 **`f.s`** 는 우리 `f.sw` 와 같은 양이라 관례 목록에 한 줄 넣었다. **기호가 다른 것과 정의가 다른 것을 구분할 것** — 앞의 것은 그림을 고쳐도 되고 뒤의 것은 안 된다 |
| 2026-09-07 | **기호 대조표를 없애고 그림 글자를 직접 고쳤다 — 사용자 제안이 맞았다.** 표가 있었던 이유는 빌려 온 그림이 `f.o` 를 반대로 썼기 때문인데, **그 그림을 Infineon 것(우리 표기와 같음)으로 이미 바꾼 뒤였다.** 남은 충돌은 하나 — onsemi Fig 8 의 `n:1` 이 **권선비**를 뜻하는데 우리 `n` 은 등가모델 비다. 하필 그 구분을 설명하는 절의 그림이라 가장 나쁜 자리였다. **이미지에서 `n:1` → `nT:1` 로 칠해 고쳤다.** 표는 지우고, 자리에 짧은 주의 상자만 남겼다 — "빌려 온 그림은 우리 표기로 맞췄고 바꾼 것은 캡션에 적었다. 반대로 제조사 AN 을 볼 때는 그 문서가 `f.o` 를 어느 쪽에 쓰는지 먼저 확인하라" |
| 2026-09-07 | **`figedit.py` 에 `patch()` 를 추가했다** — 영역을 칠하고 대체 글자를 가운데 맞춰 쓴다. `band()`(헤더 띠)와 함께 **참조 그림에 손대는 통로는 이 파일 하나뿐**이고, 편집 4건이 전부 `main()` 에 이유와 함께 남아 있다. 원본은 `*_raw.png` 로 보존해 언제든 다시 만들 수 있다 |
| 2026-09-07 | **파형 앞에 동작 등가회로 두 장을 넣었다 — 회로 없이 파형만 있으면 어느 경로로 흐르는 전류인지 알 수 없다.** Infineon Fig 2.5·2.6(**전력 전달** — 공진 전류가 자화 전류를 넘어 그 차이가 2차로 넘어간다)과 Fig 2.7·2.8(**프리휠링** — 둘이 같아져 정류기가 꺼진다), 반주기별로 각 2장. **원본 캡션이 "Figure 2.5" 뿐이라 아무 정보가 없어서** `figedit.py` 로 `POWER DELIVERY / FREEWHEELING · first / second half` 헤더를 붙였다 |
| 2026-09-07 | **그 두 회로가 곧 두 공진이라는 것을 명시했다.** 전력 전달 구간에는 `L.m` 양단이 반사 출력으로 클램프돼 공진에서 빠지므로 `f.r` 이고, 프리휠링 구간에는 2차가 끊겨 `L.m` 이 풀려나 `f.o` 다. **절 첫머리의 두 식이 각각 이 두 그림의 탱크**라는 것 — 이 연결이 없어서 `f.o` 가 추상적으로 보였던 것이다 |
| 2026-09-07 | **above/below 파형을 Infineon AN 2012-09 것으로 바꿨다 — 사용자가 자료를 주었고 판단이 맞았다.** onsemi Fig 11 은 두 경우뿐인 데다 **`f.o` 를 직렬 공진에 써서** 캡션에 경고를 달아야 했다. Infineon Table 1 의 파형 3열은 **at / above / below 세 경우**를 다 보여주고, 게이트·드레인 전압·`I.Lr`·`I.Lm`·정류기 전류 2쌍이 한 시간축에 있으며, **`T.r/2` 와 `T.s/2` 를 나란히 표시**해 차이의 원인을 그림 자체가 말한다. 그리고 **표기가 우리와 같아 경고가 필요 없어졌다** |
| 2026-09-07 | **`figedit.py` 신설 — 참조 그림을 손대는 유일한 통로.** Infineon 파형은 표의 한 칸이라 **열 제목이 헤더 행에 있어 크롭이 못 가져온다.** 이미지 위에 헤더 띠를 얹어 `AT / ABOVE / BELOW resonance` 를 다시 붙였다. **손댈 수 있는 경우를 파일 상단에 두 가지로 못박았다** — ① 크롭이 닿지 않는 곳에 라벨이 있을 때 ② 기호가 우리와 반대일 때. **그림이 주장하는 내용을 바꾸는 편집은 금지**이고, 모든 편집이 `EDITS` 목록에 남아 무엇을 고쳤는지 항상 읽힌다. 캡션에도 `column headings added` 를 명기했다 |
| 2026-09-07 | **두 공진에 전류 파형 설명을 붙였다 — 식만 두 개 있고 각각이 전류에 무엇을 하는지가 없었다.** onsemi Fig 11 을 썼다: `I.p` 와 `I.m`, 그 아래 정류기 전류 `I.D`, 그리고 **`1/(2f_r)` 과 `1/(2f_sw)` 두 구간이 그림에 표시돼 있다.** 공진보다 느리면 `I.p` 가 반사인파를 먼저 끝내고 **`I.m` 위에 얹히며** 그때부터 `I.D` 가 0 이다. 빠르면 평탄 구간이 없고 `I.D` 가 0 에 안 닿는다 |
| 2026-09-07 | **그 평탄 구간이 곧 `f.o` 라는 것을 적었다 — 이게 빠져 있어서 `f.o` 가 왜 존재하는지 알 수 없었다.** 평탄 구간 동안은 2차가 안 도통하므로 `L.m` 이 클램프되지 않고 탱크가 `L.r+L.m` 과 `C.r` 로 **`f.o` 에서 울린다.** 평탄해 보이는 건 `f.o` 가 `f.r` 보다 훨씬 낮아 그 주기의 일부가 거의 직선이기 때문이다. **`f.r` 은 평탄 구간이 막 사라진 지점이고 `f.o` 는 그것이 반주기를 다 차지한 지점** — 둘은 두 개의 동작점이 아니라 하나의 양 끝이다 |
| 2026-09-07 | **참조 문서들의 기호 대조표를 넣었다.** 원문에서 확인한 것: **onsemi 는 `f.o` 를 직렬 공진에 쓴다**(우리와 정반대, "m=3, fo=100kHz, and fp=57kHz"), MPS 는 `f.R`/`f.M`(어느 인덕턴스가 참여하는지를 첨자가 말한다 — 가장 명확), Infineon 은 `f.r` 하나만 두고 하측은 이름 없이 m 으로 다룬다. **우리 `f.o` 의 `o` 는 아무 뜻이 없다** — ST 툴에서 물려받았고, 그 시트조차 `Z.o`(직렬)/`Z.O`(병렬) 규칙을 세워 놓고 `f.o`(병렬)에서 어긴다. 그 사실을 표 아래에 그대로 적었다. **기호가 충돌하는 그림을 쓸 수밖에 없었으므로 캡션에도 경고를 넣었다** |
| 2026-09-07 | **일반 LLC 장에 "왜 쓰는가" 와 "어떻게 설계하는가" 를 넣었다 — 둘 다 아예 없었다.** ① **왜 LLC 인가** — 전 부하 소프트 스위칭(위상천이 풀브리지는 경부하에서 ZVS 를 잃지만 LLC 는 자화 전류가 부하와 무관해 잃지 않는다) · 주파수를 올릴 수 있다 · **누설을 `L.r` 로 쓴다**(포워드에서는 스너버로 죽일 대상) · **출력 인덕터가 없다** · 정현 전류라 EMI 가 작다. **대가도 같은 자리에 적었다** — 주파수 가변이라 자성 부품이 전 범위를 견뎌야 하고, 순환 전류가 부하와 무관하게 흘러 경부하 효율이 약하고, 듀티 식에서 답이 안 나온다 |
| 2026-09-07 | **일반 LLC 설계 순서 6단계를 적었다.** 공칭점에서 `n` → 요구 게인 범위 → `R.ac` → **`m`(=λ)과 `Q` 를 피크 게인 차트에서 함께** → 소자값 → 검증. **4단계가 핵심이고 그래서 onsemi Fig 14(피크 게인 대 Q, m 별 곡선군)를 넣었다** — `m` 과 `Q` 는 따로 못 고른다. 그리고 **단일단이 깨뜨리는 것이 정확히 1단계와 2단계**임을 명시했다: 앉을 공칭점이 없고, 어떤 탱크로도 못 덮는 게인 범위를 요구한다. 뒤의 두 절로 이었다 |
| 2026-09-07 | **`an_pdf.T()` 가 포맷 안 된 `%s`·`%d` 도 잡도록 했다.** `%%`·`%(` 만 보고 있어서, 참조 치환이 실패한 문장이 `Sections %s and %s` 그대로 PDF 에 인쇄됐는데 아무 검사도 안 걸렸다. 눈으로 봐서 발견했다 |
| 2026-09-07 | **PFC 그림을 내가 그린 것에서 Toshiba AN 것으로 교체했다** (`Reference/Toshiba_Power Factor Correction (PFC) Circuits AKX00080.pdf`, 사용자가 받아 줌). ① **Fig 1.3** — 커패시터 입력 정류기 회로와 `V_C`·입력전압·스파이크 전류 `I` 가 한 장에. "왜 스파이크가 나오는가" 에 정확히 답한다. ② **Fig 2.5** — 능동 PFC 회로에 **반주기별 전류 경로**가 색으로 그려져 있다(빨강 = 스위치 온, 초록 = 오프). ③ **Fig 2.7** — CCM 파형. 리액터 전류의 스위칭 리플과 **그 평균이 입력 전압을 따라가는 것**이 함께 보인다. 내가 그린 `an_pfc_why`·`an_pfc_boost` 와 생성기 모듈은 지웠다 |
| 2026-09-07 | **`pdffig.py` 에 책 두 권을 더 등록했다**(Toshiba PFC AN · TDK 트랜스 가이드). Toshiba **Fig 1.3 은 캡션 앵커로 안 잡힌다** — 같은 쪽의 다른 캡션을 앵커로 쓰고 `--page 5 --box 126 452 470 732` 로 직접 지정해야 한다. 확정 박스 주석에 적어 두었다 |
| 2026-09-07 | **PFC 절을 다시 썼다 — 네 문장이던 것이 세 소절이 됐다.** ① **왜 스파이크가 나오는가** — 버스가 피크 근처에 앉아 있어 도통 창이 좁고, 한 사이클치 전하가 전부 그 안으로 들어와야 한다. 회로 + 파형(|mains| · v_bus · 도통 창 음영 · 라인 전류)을 한 장으로 그렸다. ② **역률과 THD 는 다른 것이다** — `PF = cosφ₁ × I₁/I_rms` 로 **변위 인수와 왜형 인수**를 갈랐다. 정류기는 위상은 거의 맞는데(변위 ≈ 1) 왜형에서 0.6 이 된다. 그리고 **PF 0.99 여도 고조파 규제는 떨어질 수 있다** — 규격이 개별 고조파를 암페어로 제한하기 때문. IEC 61000-3-2. ③ **보정기가 어떻게 고치는가** — 부스트 회로와 두 루프를 그리고, **왜 하필 부스트인지**(0 을 지나는 사인이라 무한 승압이 필요하고 입력 전류가 연속이라야 정형이 가능하다), **외부 루프가 왜 느려야 하는지**(빠르면 2f_l 리플과 싸우며 만들려는 모양을 뭉갠다)를 적었다. **곱셈기가 전부다 — 계통에서 모양, 출력에서 크기** |
| 2026-09-07 | **그 마지막 항목이 단일단으로 이어진다.** 2단에서는 "외부 루프를 느리게" 가 요구조건이고, 단일단에서는 **그 외부 루프가 유일한 루프이고 출력이 전력 지령**이라 살아남은 2f_l 리플이 곧바로 입력 전류 왜형이 된다. 두 곳을 상호 참조로 이었다 |
| 2026-09-07 | **직전에 넣은 파형 그림과 관통 전류 회로도를 도로 뺐다 — 사용자 판단이 맞았다.** 내가 그린 시간축 파형은 **onsemi Fig 12 가 이미 하고 있는 얘기**였고(같은 절 바로 위), 관통 전류 회로도는 화살표만으로는 설명이 안 되는데 그 설명을 붙이려니 그림이 하나 더 필요한 구조였다. **한 절에 같은 것을 세 번 말하고 있었다.** onsemi Fig 12 한 장과 유도성/용량성 두 항목, 그리고 "용량성은 트레이드오프가 아니라 넘지 말아야 할 경계" 라는 주의 상자만 남겼다. 그 그림을 만들던 생성기 모듈과 추출본 PNG 도 지웠다 |
| 2026-09-07 | **관통 전류 회로도만으로는 "왜" 가 안 보인다 — 시간축 그림을 그렸다.** 화살표는 전류가 *어디로* 가는지만 보여주고 *왜* 그리 가는지는 안 보여준다. 전부가 한 가지에서 나온다 — **도통하던 스위치가 꺼지는 순간의 탱크 전류 부호.** 유도성/용량성 두 패널에 게이트 2개 · 탱크 전류 · 브리지 노드를 같은 시간축으로 놓고, 데드타임에서 전류가 어느 쪽을 향하는지 화살표로 찍고, 각 패널에 1-2-3 단계 설명을 달았다. 회로도 바로 앞에 넣어 **원인(파형) → 결과(관통 경로)** 순서가 되게 했다 |
| 2026-09-07 | **`
` 이 실제 줄바꿈이 되는 heredoc 함정에 오늘만 네 번째로 걸렸다.** 새로 만들던 그림 생성기가 깨져 구문 오류가 났고 한 줄이 중복·유실됐다. 결국 인덱스로 줄을 직접 갈아 끼우고 `ast.parse` 로 확인한 뒤에야 통과했다. **여러 줄 문자열이 든 패치는 heredoc 으로 하지 말 것** — 이미 적어 둔 규칙인데 또 어겼다 |
| 2026-09-07 | **용량성/유도성 파형 비교 그림이 엉뚱한 절에 있었다.** onsemi Fig 12(`V.d`·`I.p`·`I.DS1` 을 경계 양쪽에서 비교 — 왼쪽 역회복 스파이크, 오른쪽 깨끗한 ZVS)를 **ZVS/ZCS 절**에 넣어 두었는데, 그 그림이 답하는 질문은 **AN 에서 용어를 정의하는 절**의 것이다. 옮겼다. 그리고 "파괴한다" 는 말이 문자 그대로임을 보이려고 **MPS Part 2 Fig 7(관통 전류 경로)** 을 용량성 항목 뒤에 붙였다 — 바디 다이오드가 회복되기 전에 반대 소자가 켜지면 둘이 입력에 직렬로 놓인다 |
| 2026-09-07 | **`--nocap` 으로 뽑은 뒤 눈으로 확인하지 않은 그림에서 또 잘림이 나왔다** — MPS Part 2 Fig 8(부하 이동)의 아래 축 라벨 `f_LIGHTLOAD`·`f_OVERLOAD`·`Frequency` 가 통째로 날아가 있었다. 캡션 사각형이 축 라벨보다 위에서 시작해서다. `--box 174 516 442 646` 으로 고정했다. **교훈은 이미 적어 둔 것과 같다 — `--nocap` 은 믿을 수 없고 여섯 장 전부 눈으로 봐야 한다.** 확정 박스 목록에 이 한 줄을 더했다 |
| 2026-09-07 | **브리지 구동 그림 2장(f15·f16)의 잘림을 고쳤다.** ① 파형이 `t = 0..2` 를 그리는데 `t = 2.0` 에서 사각파가 **다시 시작**하고 `xlim` 이 2.05 라 프레임이 주기 중간을 잘랐다 — 마지막 표본을 빼고 `xlim(0, 2)` 로 닫았다. ② 축 **안**에 넣은 주석이 패널보다 넓어 프레임을 넘었다 — `transAxes` 로 축 아래로 내리고 문구를 줄였다. ③ f16 은 파형이 −0.5..1 인데 프레임이 −1.75..1.75 라 아래가 텅 비어 있었다 |
| 2026-09-07 | **용량성/유도성을 설명하고, above/below 와 다른 경계임을 못박았다.** 문서가 두 용어를 다 쓰면서 **어느 쪽도 정의하지 않아** 같은 뜻으로 읽히고 있었다. ① 이름의 유래 — 부품이 아니라 **브리지가 보는 것**, 탱크 입력 전류의 위상이다(진상=용량성, 지상=유도성). ② 그 위상이 곧 소프트 스위칭이다 — 지상이면 턴오프 시점에 전류가 아직 중점을 미는 방향이라 ZVS, 진상이면 이미 뒤집혀 되밀고 바디 다이오드가 역회복된다. ③ **두 경계는 다른 선이다** — 표로 갈랐다: 용량성/유도성 경계는 **피크 게인 주파수**이고 **부하에 따라 움직이며 1차의 ZVS 를 가른다**; `f.r` 은 고정이고 **2차의 승압/강압과 ZCS 를 가른다** |
| 2026-09-07 | **그 결과 기존 서술의 부정확함이 드러나 고쳤다.** "`f.o` 아래가 용량성" 은 **무부하 기준**이다 — 부하가 걸리면 피크가 `f.r` 쪽으로 올라가 용량성 영역이 넓어진다. 따라서 **`f.Min` > `f.o` 는 요구조건의 가장 약한 형태**(필요하지만 충분하지 않다)이고, 진짜 검사는 부하·전 위상에서 도는 ZVS 스윕이다. MPS Part 2 Fig 8(부하가 경계를 미는 그림)을 넣어 눈으로 보이게 했다 |
| 2026-09-07 | **AN 의 서술 순서가 뒤집혀 있었다 — 구조를 바로잡았다.** 일반 LLC 내용인 **두 공진 · 게인 곡선과 세 영역 · ZVS 기구**가 시트 §4(단일단 동작원리) 안에 있었고, 정작 시트 §2(일반 LLC)에는 **단일단 전용 그림**(라인 사이클 중 above 비율)이 들어가 있었다. 셋을 시트 §2 로 올리고 단일단 그림은 시트 §4 로 내렸다. 그리고 시트 §2 안의 순서도 **`f_r` 을 정의하기 전에 "above f_r" 을 말하고 있어서** 강제 순서로 재배열했다 — 회로 → 왜 공진인가 → M 과 Q(FHA) → 두 공진 → 게인 곡선 → 어느 쪽인가 → ZVS/ZCS → 데드타임 → PFC → 왜 2단인가 |
| 2026-09-07 | **동작 모드 그림 2장을 타사 가이드에서 추가로 땄다.** Infineon 3.4(공진 아래/공진/공진 위의 탱크 전류와 자화 전류 — 아래에서는 둘이 만나고 위에서는 잘린다)와 onsemi Fig 12(용량성/유도성 — 왼쪽은 역회복, 오른쪽은 같은 순간이 ZVS). **onsemi Fig 10 은 쓰지 않았다** — 그 문서가 `f.o` 를 *직렬* 공진에 쓰는데 우리는 *하측* 공진에 쓴다. **기호가 충돌하는 그림은 초보자에게 해롭다** |
| 2026-09-07 | **단일단이 라인 사이클 중 어느 쪽에 있는지를 숫자로 넣었다.** `f.sw(θ)/f.r` 을 등가 입력 4종에 대해 그리고 above 비율을 달았다 — 173.2 Vac **0 %** · 225 **21 %** · 264 **40 %** · 332.3 **56 %**. 이제 시트 §2 가 "일반 LLC 는 한쪽을 골라 머문다" 고 말하고 시트 §4 가 "단일단은 못 고른다" 로 받는다 |
| 2026-09-07 | **AN 에 "언제 above 이고 언제 below 인가" 를 넣었다 — 가장 크게 빠져 있던 것.** 문서가 `f.r` 이 승압/강압을 가른다고만 하고 **컨버터가 어느 쪽에 있는지를 한 번도 말하지 않았다.** 단일단은 답이 한쪽이 아니다 — 라인 사이클 안에서 경계를 넘나든다. `f.sw(θ)/f.r` 을 등가 입력 4종에 대해 그리고 **반주기 중 above 비율을 숫자로** 달았다: 173.2 Vac **0 %** · 225 **21 %** · 264 **40 %** · 332.3 **56 %**. 저입력에서는 경계를 아예 안 넘고 고입력에서는 대부분을 above 로 보낸다 |
| 2026-09-07 | **ZVS 와 ZCS 를 구분해 설명하고 그림을 넣었다.** ZVS 는 문서에 열 번 넘게 나오는데 **ZCS 는 한 번도 안 나왔고 둘의 차이도 없었다.** 다른 소자·다른 기구·다른 조건이다 — ZVS 는 1차, 유도성이면 성립하므로 `f.r` 양쪽 모두에서 유효하고 **어디서나 필수**다. ZCS 는 2차 정류기, **`f.r` 아래에서만** 성립하고 위로 올라가면 역회복이 돌아온다. **그래서 앞 그림이 중요해진다** — 고입력에서 반주기의 절반 이상을 ZCS 없이 돈다는 뜻이고, 일반 LLC 라면 무시했을 2차 바디 다이오드와 SR 데드타임을 단일단에서는 봐야 한다 |
| 2026-09-07 | **LLC·PFC 설명을 초보자 기준으로 다시 썼다.** LLC 쪽은 above/below 와 ZVS/ZCS 두 절을 새로 넣었고, PFC 쪽은 네 문장이던 것을 **역률과 THD 가 각각 무엇인지 · 왜 규제되는지(IEC 61000-3-2) · 왜 하필 부스트인지**(입력 전류가 연속이고 승압만 가능하면 되는 구조)까지 풀었다 |
| 2026-09-07 | **문서 식별자를 머릿글에서 꼬리글로 옮겼다.** 오른쪽 위 남색 상자가 매 쪽 절 제목과 경쟁하고 있었다. 이제 하단에 7.4 pt 로 들어가고 쪽번호는 오른쪽 끝으로 갔다. 표지의 회로도도 뺐다(사용자 지시) |
| 2026-09-07 | **AN 1쪽부터 전수 검토 — 실제 오류 5건.** ① **`R.ac` 식이 `8/π²`·분모 `P.out` 으로 인쇄돼 있었다.** 값 13.70 Ω 은 `4/π²`·`P.in,LLC` 이고 바로 아래 주의 상자가 "이 식은 4/π² 를 쓴다" 고 말한다 — **자기모순**이었다. ② **교차 참조 9개가 전부 어긋나 있었다** — "Figure 1" 이 실제로는 7번, "Section 5.10" 이 6.18번. 그림·절을 추가하면 조용히 어긋나는 구조였다. ③ 이득식이 `F_x` 를, 나머지 전부가 `f_n` 을 써서 **같은 양에 이름이 둘**이었다. ④ "타사 그림은 싣지 않는다" 는 문장이 남아 있었다(지금은 6장을 싣는다). ⑤ 개정 이력에 V1.1 행이 없었다 |
| 2026-09-07 | **교차 참조를 이름으로 푸는 2-pass 빌드를 넣었다.** 1차 통과에서 그림·표·절이 받은 번호를 기록하고 2차 통과에서 `figref`/`tblref`/`secref` 로 해결한다. **번호를 손으로 적는 방식은 그림 하나만 추가해도 전부 깨진다** — 실제로 깨져 있었다 |
| 2026-09-07 | **초보자가 막힐 지점을 보강했다.** `f.n`·`M`·`Z.0`·`Q`·`V.o,eff`·`N.rect` 가 **정의 없이 쓰이고 있었다** — 관례 목록에 넣고, FHA 절에서 M 과 Q 를 각각 한 단락씩 풀었다. "양쪽 포트가 전압원이라 게인이 강제된다" 는 **왜** 그런지를 두 단락으로 늘렸다(게인은 두 전압의 비인데 둘 다 밖에서 못박혀 있다 → 주파수가 움직이는 것은 Q, 즉 전력). 이득식에는 눈으로 하는 검산 둘(`f.n`=1 에서 M=1, `f.n`→∞ 에서 1/(1+λ))을 붙였다 |
| 2026-09-07 | **AN 에 인덕턴스 공차 경고를 넣었다.** `k.floor` 1.021 옆에 "버티는 L 저하 = 1−1/k.floor² = 4.1 %" 와 **"±10 % 사양은 여기 안 들어간다 — 트랜스포머 발주 전에 확인하라"** 를 적었다. 시트와 사양서가 다른 문서라 이 둘이 만나지 않고 있었다. 그리고 표지의 빈 파란 띠에 전력단 회로도를 넣었다 |
| 2026-09-07 | **영문 AN 에 배경 절을 신설했다 — LLC 가 뭐고 PFC 가 뭐고 왜 합칠 수 있는가.** 이전 판은 단일단 이론으로 곧장 들어가 **독자가 LLC 와 PFC 를 이미 만들어 봤다고 가정**하고 있었다. 소절 6개: LLC 가 무엇인가 / 공진이 무엇을 사는가(ZVS) / 회로가 어떻게 `M(f_n, Q)` 가 되는가(FHA 3단계) / PFC 가 무엇인가 / 왜 보통 2단인가. **버스 커패시터가 하는 두 가지 일(버퍼 + 탱크 격리)을 분리해 적은 것이 핵심**이다 — 단일단은 그 둘을 동시에 잃는다 |
| 2026-09-07 | **회로 그림은 직접 그리지 않고 참조 가이드에서 땄다.** 처음엔 `schem.py` 로 직접 그렸는데 상자가 축 밖으로 나가는 등 품질이 안 나왔다. onsemi AN-4151 의 Fig 3(하프브리지 LLC) · Fig 4(파형) · Fig 5(R.ac 유도) · Fig 6(AC 등가회로) · Fig 8(누설 통합 등가회로)과 MPS Part 2 의 Fig 3(AC/DC 블록도)을 썼고, **캡션마다 출처를 적었다.** `pdffig.py` 에 **`--nocap`**(원본 캡션 제외 - 우리 문서가 자기 캡션을 다니까)과 **흰 여백 자동 트림**을 넣었다. 잘림 여부는 여섯 장 전부 눈으로 확인했다 |
| 2026-09-07 | **AN 의 설계점을 7.5:1 로 옮겼다 — 정본 시트·워크북은 9:1 그대로.** `an_pdf.AN_VARIANT` 로 **변형 시트를 직접 지정**한다(`Smath/variants/L6790A_7p5to1.sm`). `figs.py` 도 같은 시트를 따른다. 처음에 정본 시트와 워크북까지 7.5:1 로 바꿨다가 되돌렸다 — **변형별 산출물이 이미 3벌씩 있으므로 정본을 건드릴 이유가 없었다.** 워크북은 `BACKUP_3` 에서 복구했다 |
| 2026-09-07 | **7.5:1 은 무부하 최소 게인 해가 없어서 그 절의 문장이 깨졌다** — `M.∞` 0.6452 대 요구 0.6409 로 근호 안이 음수가 되어 파이썬이 복소수를 돌려준다. 해가 있을 때와 없을 때를 나누어 쓰도록 고쳤고, **없는 쪽이 오히려 그 절이 말하는 바를 보여 준다.** 그리고 권선비 표기를 `n.T : 1` 에서 실제 턴수 `15 : 2` 로 바꿨다 — 2차가 1턴일 때만 맞는 표기였다 |
| 2026-09-07 | **한국어 가이드와 대조해 영문 AN 에 빠져 있던 이론 5건을 채웠다.** ① **`f.sw(θ)` 닫힌형** — AN 은 "주파수 프로파일이 곧 PFC" 라고만 하고 **어떻게 구하는지를 안 적고 있었다.** `x = 1/f_n²` 로 3차식이 되고 근의 곱이 음수라 **항상 실근 3개 중 하나만 음수 → 물리적 근은 언제나 가운데**, 분기 판정이 필요 없다는 것까지 넣었다(가이드 C.20). ② **FB 핀 제어 법칙** `V.FB = 0.5 + 0.167·R.CS·P.in` — 최대전력·버스트·과부하가 한 스케일 위에 있는 이유다. ③ **Venable K-factor Type II 보상 설계법** — AN 은 소자값만 있고 방법이 없었다. ④ **이득 여유와 `f.180` 닫힌형** — 근호 안이 음수면 오류가 아니라 "위상이 −180° 에 안 닿는다" 는 답이라는 것까지. ⑤ **입력 커패시터** `C.in = 3 nF/W × P.in` 과 그것이 필터가 아니라 **THD 항**이라는 것. 그리고 `R.ac` 의 `4/π²` 가 일반 LLC 의 `8/π²` 의 절반인 이유(라인 피크 순시전력 기준)를 주의 상자로 넣었다. AN 25 → **26쪽** · 식 20 → **27** |
| 2026-09-07 | **`figs.py` 도 7.5:1 에 고정돼 있어 그림이 본문과 어긋나 있었다** — 그림은 `f.o` 90.4 kHz · 합성 피크 18.32 A 인데 옆의 표는 85.1 kHz · 17.70 A 였다. `an_pdf.py` 와 같은 방식으로 **시트에서 설계점을 읽게** 하고 AN 그림을 전부 다시 만들었다. 한국어 가이드용 `figures/` 는 건드리지 않았다 — 그쪽 본문이 아직 구 수치라 같이 두어야 맞다 |
| 2026-09-07 | **mathtext 는 `igl`·`\Bigl` 계열을 모른다.** 두 번 걸렸다 — 처음엔 병렬 연산자, 다음엔 3차식. 평범한 괄호로 바꿔야 한다. `an_body.py` 에서 10곳을 치환했다 |
| 2026-09-07 | **영문 AN 을 특정 응용에서 떼어냈다 (v1.0 → v1.1).** ① 트랜스포머 절이 **3분할을 뼈대로** 쓰고 있었다 — 사양표가 "per unit, 3 units per set" 이었다. **트랜스포머 1개 기준**(권선비 9:1 · 개방 35 µH · 단락 11 µH · 2차 30.3 A rms / 116 A pk)으로 다시 쓰고, 분할은 **"한 대로 안 되면" 한 절**로 내렸다. 분할의 결과 3가지(인덕턴스·2차 전류는 /N.x, **1차 전류는 안 나뉜다**, 시험 전류는 안 변한다, 권선비가 N.x/N.s 단위로 양자화)만 남겼다. ② **응용 특정 서술을 전수 제거** — OLED·TV·패널·세트·end product. 리플 5 % 는 이제 "부하의 성질이지 컨버터의 성질이 아니다" 로만 쓴다. ③ 요약표의 트랜스포머 행도 `N.p/N.s in 3 series sections` → 개방/단락 인덕턴스로 바꿨다 |
| 2026-09-07 | **AN 에 무부하 최소 게인 한계 절 신설.** 무부하 게인은 `1/(1+λ)` 아래로 안 내려가므로 **요구 최소 게인이 그보다 낮으면 [26] 에 해가 아예 없다** — 스프레드시트가 오류를 뱉는 것이 수식이 깨진 게 아니라 질문에 답이 없는 것이다. 이 설계는 점근선 0.686 대 요구 0.793 이라 231 kHz 에서 해가 있다. **전부하 검사로는 절대 안 드러나는 성질**이라는 것을 함께 적었다 |
| 2026-09-07 | **핀 배정을 승인원 방식으로 통일했다 — NS2 3→5 · NS3 4→6.** 2026-09-04 에 빌더는 사용자 회로도를 따라 **인접핀 3–4 / 5–6** 으로, `CLAUDE.md` 는 **승인원 엇갈림 3→5 / 4→6** 으로 적혀 두 기록이 갈라져 있었고 맞춰본 적이 없었다. **전기적으로는 완전히 같다** — 어느 쪽이든 4+5 를 이으면 끝이 3·6 인 같은 센터탭 권선이 된다. 다른 것은 각 권선 끝이 보빈 어느 핀에 오느냐뿐이고, 그건 **PCB 풋프린트** 문제다. 승인원 쪽을 택한 이유: 기존품 2차가 `Cu plate 1 Ts` 인데 **1턴 동판은 보빈 한쪽으로 들어가 반대쪽으로 나오므로 두 끝이 반대편 핀 뱅크에 떨어진다** — 인접핀은 동판 양 끝이 같은 쪽으로 나와야 해서 부자연스럽다. 센터탭 문구(4+5)는 어느 쪽이든 그대로 유효하다 |
| 2026-09-07 | **영문 AN 이 7.5:1 과 9:1 을 섞어 쓰고 있었다.** `an_pdf.V` 의 `R` 은 `l6790.design(Lm_sel=20e-6, n_sel=6.)` 로 **7.5:1** 에 고정돼 있었는데 `SH` 는 정본 시트(**9:1**)에서 읽고 있었다. 그래서 같은 표에 `n` = 6.02 와 `n.T` = 9.00 이 나란히 인쇄됐다 — **서로 다른 트랜스포머다.** `R` 이 시트에서 설계점을 읽도록 바꾸고, 손으로 박혀 있던 `Np`·`Ns`·`nser`·`AL`·`Bpk`·`Cr`·`Lr`·`Lm` 도 전부 시트에서 읽게 했다 |
| 2026-09-07 | **영문 AN 에 트랜스포머 절 신설 — 소절 6개.** 두 권선비·두 인덕턴스 / 사양서에 무엇을 적는가 / 자속은 2차가 정한다 / 포화 시험 전류 / 분할 트랜스포머. **일반 가이드로 썼다 — 특정 고객·벤더·기존 보드 언급 없음.** 수치는 전부 `an_pdf.V` 보간이라 손으로 박은 상수가 없다. 사양서 표 1개 추가. AN 20 → **24쪽** |
| 2026-09-07 | **AN 에 회로도 3장을 넣었다** — `bom_power_stage`(전력단 전체, CT/FB 2안), `bom_pin_config`(IC 주변), `comp_network_st`(보상망). **셋 다 `figures/` 에 있었는데 AN 이 안 쓰고 있었다.** `figures/an/` 으로 복사해 AN 의 설계 절차·컨트롤러·루프 세 자리에 배치 |
| 2026-09-07 | **영문 AN 의 그리스 문자와 수학 기호가 통째로 빠져 있었다.** reportlab 내장 Helvetica 는 Latin-1 이라 `λ`·`μ`·`Ω`·`η`·`√`·`≥`·`≈`·`Δ` 가 **조용히 사라지거나 엉뚱한 글리프**로 나왔다(`L.μ` → `L∝`, `20.97 Ω` → `20.97 │`). `use_unicode()` 로 **Arial** 을 등록했다 — Helvetica 와 메트릭 호환이라 레이아웃이 움직이지 않는다. 한국어 문서의 `use_korean()` 경로는 그대로다 |
| 2026-09-07 | **공차를 개방·단락 모두 ±10 % 로 통일했다 — 사용자 결정.** 직전에 `k.floor` 에서 계산한 비대칭 공차(7.5:1 +10/−3 %)를 넣었는데, **양산 공정이 그런 기형 공차를 못 맞춘다.** 되돌렸다. 대가는 명확하다 — **7.5:1 은 개방 인덕턴스가 −10 % 로 나오면 하드 스위칭한다**(버티는 저하 4.1 %). 7.5:1 을 채택한다면 **`R.T` 를 11 → 10 kΩ 으로 내려 `k.floor` 를 1.021 → 1.117(버티는 저하 19.9 %)로 올리는 것이 유일한 방법**이다. 9:1(14.9 %)·6:1(58.9 %)은 ±10 % 로 문제없다 |
| 2026-09-07 | **단락 측정 조건을 잘못 고쳤다가 되돌렸다 — 사용자 지적이 맞았다.** "동작 중에는 레그 하나만 도통하니 하나만 단락해야 한다"고 바꿨는데, **기존 양산품 26OP-LM83W 사양서 4-2 가 `(SECONDARY ALL SHORT)` 로 적고 있다** — 같은 벤더(KH필룩스) · 같은 CT 구조다. 내 논리는 두 2차 반쪽이 자기적으로 분리된다고 가정한 것인데, 실제로는 둘 다 같은 `Secondary SECTION` 에 감기므로 누설 자속 경로가 1차↔2차 구획 사이 기하로 정해져 **어느 쪽이 전류를 흘리든 거의 같다.** 무엇보다 **벤더의 지그와 검사가 그 조건에 맞춰져 있다.** 원복하되 보조는 단락하지 않는다는 것만 명시했다(양산품도 secondary 만 단락한다). **증거 없이 관례를 뒤집지 말 것** |
| 2026-09-07 | **개방 인덕턴스 공차를 평평한 ±10 % 로 만들면서 비대칭 보호를 잃었었다.** 예전에 KH 양식에 채워 넣었던 7.5:1 판은 `10.33uH **+10/-4%**` 였고, 양산품도 `53uH +7/-10 %` 로 비대칭이다. 빌더를 다시 쓰면서 ±10 % 로 평평하게 만들어 **7.5:1 이 자기 공차에 깨지는 상태**가 됐던 것이다. `k.floor` 에서 계산하도록 복원했다 — 버티는 저하 `1−1/k.floor²` 의 80 % 를 쓰고 10 % 로 자른다. 결과: **9:1 ±10 % · 7.5:1 +10/−3 % · 6:1 ±10 %**. 7.5:1 만 비대칭이 필요하고, 그 이유를 사양서에 한 줄 넣었다 |
| 2026-09-07 | **`build_trans_spec.py` 가 Excel 잠금에 걸리면 이유를 말하도록 했다** — `PermissionError` 를 그대로 던지고 있었다 |
| 2026-09-07 | **벤더 사양서의 단락 인덕턴스 측정 조건이 틀려 있었다.** "All other windings SHORTED" 라고 적어 두었는데, 그러면 NS2·NS3·NAUX 를 **동시에** 단락한다. **동작 중에는 정류 레그 하나만 도통하고 보조는 고임피던스 분압**이므로, 권선을 더 단락할수록 측정값은 낮아진다 — 벤더는 그 낮은 값을 3.67 µH 로 맞추려고 **누설을 필요 이상으로 키우게** 되고 실제 `L.r` 은 11 µH 보다 커진다. 조건을 **"Short NS2 (3–4) ONLY. NS3 and NAUX OPEN"** 으로 고치고 이유를 사양서에 한 줄 남겼다. **개방 측정은 원래 맞았다** |
| 2026-09-07 | **`Final Design Check` 의 `L.μ`·`L.L1`·`L.L2` 는 사양으로 주면 안 된다.** 셋은 `L.L1 = n.T²·L.L2` 라는 **대칭 가정**으로 만든 분해이고(결합계수 k = L.mu/L.open = √(L.m/L.open) = n/n.T = 0.8281 로 확인), 실제 누설 배분은 권선 배치가 정한다. **어느 단자쌍에서도 측정되지 않으므로 벤더가 검사할 수 없다.** 우리가 주는 개방·단락은 그 블록을 **측정 가능한 형태로 쓴 같은 값**이다(35.00 / 11.00 µH 세트). 그리고 배분은 우리에게 영향이 없다 — 탱크는 개방·단락만 보고, 자속도 `L.L2·ω·I.sec_pk` = 8.19 V < `V.out` 25 V 라 상호전압이 도통 구간 내내 양(+)이고 누설 볼트-초 적분이 0 이라 **`B.pk` 가 배분과 무관하다** |
| 2026-09-07 | **`check_trans_spec.py` 가 셀 번지를 박아 두어 사양서 행이 한 줄 밀리자 엉뚱한 칸을 읽었다** — `A.e` 를 92 로, `f.sw` 를 빈 칸으로. 고치는 대상과 같은 부류의 실수였다. **라벨로 행을 찾도록** 바꿨다 |
| 2026-09-07 | **3종 열·효율·안정성 비교 — 결론이 갈린다.** 계산 손실은 **7.5:1 이 최저**(33.49 W · η 95.15 %), 9:1 34.87 W, 6:1 39.16 W. 그런데 트랜스포머 자체는 **코어가 지배**한다 — 각자 0.20 T 에 맞춘 코어를 쓰면 필요 `A.e` 가 **103 / 206 / 211 mm²** 라 7.5:1 코어 체적이 절반이고 코어손이 약 **1/2.8** 이다. 2차 피크도 98.6 A 로 9:1 의 115.6 A 보다 15 % 낮다. 반대로 **여유는 9:1 이 최고**다(`k.ZVS` 2.408 · `k.ceil` 1.526 · `k.OCP` 1.295, 그리고 무부하 주파수 해가 있는 유일한 설계점). **6:1 은 둘 다 진다** |
| 2026-09-07 | **7.5:1 은 사양서가 요구하는 ±10 % 인덕턴스 공차를 못 견딘다.** `k.floor` 1.021 은 L 저하 **4.0 %** 까지만 버티는데 사양은 10 % 다. −10 % 에서 `f.o` 90.39 → 95.28 kHz 가 되어 `f.Min` 92.25 kHz 를 넘고 **하드 스위칭한다.** 9:1 은 14.9 %, 6:1 은 58.9 % 를 견딘다. **`R.T` 11 → 10 kΩ 이면 7.5:1 도 19.9 % 로 풀린다.** `CLAUDE.md` 시트 §4.2 5b 갱신 |
| 2026-09-07 | **전면 재검토 ① — 벤더 사양서의 손입력 상수가 낡아 있었다.** `build_trans_spec.py` 의 `VARIANTS` 가 인덕턴스·전류·A.e·주파수를 전부 손으로 박은 상수로 갖고 있었고, **6:1 판의 `f.Min` 이 90 kHz** 로 적혀 있었다 — 참값 110 kHz. 다른 두 판에서 복사된 것이다. 값은 시트에 정확히 있었고 **옮겨 적는 순간 끊겼다.** 빌더가 변형 시트에서 읽도록 바꾸고, **완성된 xlsx 를 다시 읽어 시트와 대조하는** `check_trans_spec.py` 를 새로 만들었다(9항목 × 3변형, 불일치 0). 가이드 C.33 |
| 2026-09-07 | **전면 재검토 ② — 6:1 의 `C.T` 390 pF 가 자기 설계 상한 375 pF 밖이었다.** `k.CTd` = 0.962 로 시트가 정확히 잡고 있었는데 읽지 않았다. 설계 창 193…375 과 DS 창 270…1000 의 교집합 기하중간 318 pF 에서 가장 가까운 E12 인 **330 pF** 로 고쳤다. `k.CTd` 0.962 → **1.136**, `k.floor` 1.332 → **1.559**, `k.ceil` 1.031 → **1.178**, `f.Min` 110.1 → 128.9 kHz. **6:1 의 여유가 세 항목 다 좋아졌다.** 워크북 변형 `Device Setting D21` 도 같이 고쳤다. 가이드 C.34 |
| 2026-09-07 | **전면 재검토 ③ — 시트 주석 6개가 9:1 숫자를 문자열로 갖고 다른 변형에 그대로 복사되고 있었다.** 가장 나쁜 것은 **7.5:1 시트가 `R.ZCD_H` 로 330 kΩ 을 선정해 놓고 바로 옆에 "330 k 로 두면 OVP1 이 14 V 에서 걸려 기동 못 한다"** 고 적어 놓은 것이었다. `C.r`·`L.m`·`k.lam`·`n.aux`·`R.ZCD_H_sel`·`C.T` 여섯 주석을 전부 **값에서 문장을 만들도록** 바꿨다. 가이드 C.33 |
| 2026-09-07 | **발견 — 무부하 최소 게인 조건은 해가 없을 수 있고, 7.5:1 과 6:1 이 그렇다.** 무부하 게인은 점근선 `1/(1+λ.act)` 아래로 내려가지 않는다. 9:1 은 M.FBmax 0.7928 > 점근선 0.6859 라 **231 kHz 에서 해가 있고**, 7.5:1 은 0.6409 대 0.6452(0.7 % 차이로 해 없음), 6:1 은 0.5299 대 0.6893 이다. **워크북 `RTC` 26·27행이 `#NUM!` 이었던 것이 바로 이것** — 계산이 깨진 게 아니라 묻는 질문에 답이 없었던 것이다. 불합격이 아니라 **버스트 모드가 맡는 영역**이지만, **무부하 조절을 주파수로 끝낼 수 있는 설계점은 9:1 뿐**이라는 것은 본사의 7.5:1 권고 어디에도 없던 정보다. 가이드 C.31 |
| 2026-09-07 | **자속을 자화 인덕턴스로 계산하면 √(1+λ) 만큼 낙관적이다.** 시트의 `B.pk` 는 2차 볼트-초 식이라 `V.o_eff/(4·f.r·N.s·A.e)` 로 정리되고 **`N.p` 가 아예 없다** — 1차 턴수를 늘려도 자속은 안 내려간다. 같은 값을 `L.m·I.Lm_pk/(N.p·A.e)` 로 구하면 302 mT 가 나와 **364 mT 보다 17 % 작다**. 모델의 `L.m` 가지 전압이 `n·V.out` 인데 실제 반사 전압은 `n.T·V.out` 이기 때문이다. **시트는 원래 보수적인 쪽을 쓰고 있었다** — 확인만 한 것이지 고친 것은 없다. 가이드 [149][150] |
| 2026-09-07 | **개방 포화 시험 전류는 1차 피크 전류가 아니다.** 벤더 DC 중첩 시험은 다른 권선을 개방하므로 **2차 기자력 상쇄가 전혀 없고**, 같은 전류가 훨씬 큰 자속을 만든다. 기준은 동작 자속을 재현하는 `I.sat_eq = B.pk·N.p·A.e/L.open_x` 이고 9:1 에서 **10.6 A** 다. 1차 피크 17.7 A 를 그대로 적으면 **0.61 T 를 요구하는 셈이라 어떤 페라이트도 통과 못 한다.** 사양서의 16 A 는 여유 51 % 로 정상이었다. 가이드 [152] |
| 2026-09-07 | **시트 §12 에 `A.e_req`·`k.Ae`·`I.sat_eq`·`I.sat_spec` 4행 신설.** 둘 다 벤더에 나가는 값인데 시트에 없었다. `k.Ae` = 0.549 — **코어 미선정을 판정으로 드러낸다**(EE6405 113 mm² 대 필요 206 mm²). 7.5:1 은 1.098 로 통과한다. 사양서의 시험 전류도 이제 `I.sat_spec` 에서 온다 — 여유 계수가 두 곳에 있으면 또 갈라진다 |
| 2026-09-07 | **`k.` 로 시작한다고 전부 판정이 아니다.** `K.Tpri`·`K.Tsec`·`K.ring` 은 **[PICK] 입력**이고 `r.tr` 은 절단 인수(공진 아래에서 1 이 정상), `k.PM`·`k.OVP1`·`k.lam` 은 **한계가 아니라 목표에 대한 비**다. 시트 §17 의 "Not verdicts" 주석과 `snapshot.py` 의 제외 목록에 전부 실었다. 가이드 C.32 |
| 2026-09-07 | **`snapshot.py` 의 `k.PSR` 설명이 낡아 있었다** — "3 병렬이면 1.598" 은 7.5:1 값이고 9:1 에서는 1.39 다. 그리고 `k.PSR`·`k.Ae` 는 **아직 안 닫은 항목인데 "오류가 아니다" 로 끝나 닫힌 것처럼 읽혔다.** `STILL_OPEN` 을 두어 문구를 갈랐다 |
| 2026-09-07 | **6:1 의 `k.NRCS` 0.966 은 열어 둔다.** 1차 라인 실효 12.37 A 라 감지저항이 5.17개분 소산이다. 6개로 올리면 `R.CS` 24 mΩ 유지에 개당 144 mΩ 이 필요한데 E24 에 없고, 150 mΩ 이면 `Pin.max` 가 672 W 로 `P.in` 684.8 W 아래로 떨어진다. **소자 결정이라 임의로 바꾸지 않았다** |
| 2026-09-07 | **설계점 3종을 시트·워크북·사양서 아홉 벌로 만들었다.** 이름을 `nT9/nT7p5/nT6` 에서 **`9to1`·`7p5to1`·`6to1`** 로 바꿨다 — 한눈에 권선비가 읽히게. SMath 는 `L6790_VARIANT` 환경변수, 사양서는 명령행 인자, 워크북은 정본 복사 후 셀 패치 + Excel 전체 재계산이다. 셋 다 `mismatches: 0` · `VERDICT OK` 이고 워크북 `n.T` 가 9.000 / 7.500 / 6.000 으로 정확히 떨어진다 |
| 2026-09-07 | **`C.T` 는 `Device Setting D21` 에 직접 입력이다 — F열 선정 셀이 아니다.** 처음에 `F21` 에 써서 안 먹었고, `k.CT` 만 바뀌고 `f_Min`·`f_Max` 가 그대로라 알아챘다. 6:1 은 `C.T` 390 pF 가 있어야 `f_Max` 372.9 kHz 가 열린다 — 470 pF 의 319.6 kHz 로는 FB 코너 362 kHz 에 못 닿는다 |
| 2026-09-07 | **openpyxl 로 읽은 캐시가 Excel 이 계산한 값보다 낡아 있을 수 있다.** 워크북을 패치하고 COM 으로 `CalculateFullRebuild` + `Save` 를 돌렸는데도 `D27`·`D28` 이 옛 값으로 읽혔다. Excel 을 다시 열어 `Value2` 를 직접 물으니 제대로 나왔고, 그 상태로 저장하니 캐시도 맞았다. **워크북을 고친 뒤에는 COM 으로 값을 직접 확인할 것** - openpyxl 만 믿으면 안 된다 |
| 2026-09-07 | **사고 재발 — 벤더 사양서 정본을 또 덮어썼다(75 KB·그림 2장 → 6.8 KB·그림 0장).** 패치 스크립트가 중간에 실패했는데 그 뒤 빌더를 3번 돌렸고, 그때 빌더의 출력 경로가 아직 정본이었다. **어제 같은 사고를 내고 "셀 단위로만 고치겠다" 고 적어 놓고 반복했다.** 재발 방지로 `build_trans_spec.py` 를 **인자 없이 실행하면 거부**하게 하고 출력을 `variants/` 로만 내보내도록 바꿨다 — 이제 정본 경로를 건드릴 수 없다. 복구는 OneDrive 버전 기록(12:58 이전) |
| 2026-09-07 | **패치 스크립트에서 같은 실수를 두 번 했다 — bash heredoc 안의 `\n` 이 실제 줄바꿈이 된다.** `<<'PY'` 로 인용해도 파이썬 문자열 리터럴 안의 `\n` 이 살아남지 못해 SyntaxError 가 났다. **여러 줄 문자열을 넣는 패치는 heredoc 말고 Edit 로 할 것** |
| 2026-09-07 | **6:1 을 실제로 살려서 3종 비교를 완성했다.** 탱크를 다시 잡았다 — `C_r` **180 nF** · `L_r` **6.4 µH** · `L_m` **14.2 µH**(`Z_o` 10.49 → **5.96 Ω**) · `C_T` 470 → **390 pF**. 세 변형 전부 `mismatches: 0` · `VERDICT OK` 다. 전에 6:1 이 참조 구현과 2건 어긋났던 것도 사라졌다 — 어긋난 원인은 6:1 자체가 아니라 그 탱크가 닫힌형이 못 다루는 영역에 있었기 때문이었다 |
| 2026-09-07 | **`C_T` 를 변형별로 만들어야 했다 — 6:1 은 470 pF 로는 못 돈다.** FB 코너가 **361.9 kHz** 를 요구하는데 `C_T` 470 pF 의 `f_Max` 는 319.6 kHz 다. 390 pF 로 내리면 `f_Max` 373.0 kHz 로 열리고 `f_Min` 이 92.3 → 110.1 kHz 로 올라 `k.floor` 도 1.020 → **1.332** 로 좋아진다. 대신 **영교차 클램프가 넓어져 THD 가 나빠진다** — `f_Min` 이 높을수록 라인 영교차 부근에서 하한에 걸리는 구간이 커진다 |
| 2026-09-07 | **3종 최종 비교 (전부 성립한다).** ZVS·2차·뱅크는 **6:1 이 최고**(`T_ZC` 657 ns · 2차 8.94 A rms / 28.0 A pk · 뱅크 27.33 A), 1차는 **7.5:1 이 최고**(라인 rms 10.93 A · 탱크 피크 18.32 A), 9:1 은 그 사이다. **`n` 이 작으면 2차 전류가 1차로 크게 반사되지만, `Z_o` 를 낮춰 탱크를 무겁게 만들면 자화 전류가 커져 ZVS 와 2차 파형이 좋아진다** — 그 맞바꿈이 6:1 의 성격이다 |
| 2026-09-07 | **6:1 의 대가 셋.** ① `C_r` 100 → 180 nF (400 V 급 필름, 부피·비용) ② **`k.ceil` 1.031 — 여유가 거의 없다**(9:1 1.526 · 7.5:1 1.284). `f_sw` 가 362 kHz 까지 올라가 스위칭 손실과 자성 부품 주파수가 같이 오른다 ③ `f_Min` 110 kHz 로 THD 악화 |
| 2026-09-07 | **코어는 탱크로 못 바꾼다 — 세 변형의 `A.e` 최소가 9:1 206 · 7.5:1 103 · 6:1 211 mm² 다.** 근본은 **1차 턴수가 적으면 자속이 오른다**는 것이고(9:1 은 3턴, 6:1 은 2턴), 탱크 정수는 여기 안 들어온다. **EE6405(113 mm²)에 들어가는 것은 7.5:1 뿐**이고 그것은 2차 2턴을 요구한다. 2차 2턴이 가능한가 하는 질문이 여전히 유일한 갈림길이다 |
| 2026-09-07 | **6:1 이 불가능하다는 앞의 결론을 철회한다 — 탐색을 잘못했다.** `C_r` 100 nF · `L_r` 11 µH 를 고정한 채 `L_m` 만 훑고 "성립 창이 없다" 고 적었는데, 탱크에는 자유도가 셋(`C_r`·`L_r`·`L_m`)이다. (λ, f_r, Z_o) 로 다시 매개화해 **280 조합을 전수 탐색하니 121개가 ZVS 를 통과**한다. 최대 `T_ZC` 1676 ns 로 9:1(530 ns)보다 훨씬 낫다 |
| 2026-09-07 | **ZVS 는 자화 전류가 좌우하고 그것은 닫힌형으로 나온다 — `I_Lm,pk = 39.27·n_T·λ/(Z_o·√(1+λ))`** (V_out = 25 V). 검산: 9:1 → 12.79 A, 7.5:1 → 12.40 A 로 시트값과 일치한다. **핵심은 `Z_o` 에 반비례한다는 것**이다. 6:1 은 `n` 이 작아 불리하지만 **`Z_o` 를 10.49 → 4~6 Ω 으로 낮추면 그 손해를 덮고도 남는다**(자화 13~24 A). 앞선 실패는 6:1 의 결함이 아니라 `Z_o` 를 안 건드린 탓이었다 |
| 2026-09-07 | **6:1 의 진짜 대가는 ZVS 가 아니라 1차 응력이다.** `Z_o` 를 낮추려면 `C_r` 을 키우고 `L_r` 을 줄여야 한다 — 대표 후보 `λ 0.45 · f_r 150 kHz · Z_o 6 Ω` 이면 `C_r` **177 nF**(현재 100), `L_r` 6.37 µH, `L_m` 14.1 µH, `T_ZC` 646 ns. `C_r` 이 1.3~3.3배로 커져 400 V 급 필름 커패시터의 부피·비용이 붙고, 탱크 순환 전류가 커지며(`I_pk` 18~24 A 대 현재 17.7), `L_m` 이 작아 자화 전류와 코어 포화 요구가 올라간다. **"불가능" 이 아니라 "1차 응력을 더 지불하는 설계" 다** |
| 2026-09-07 | **교훈 — 설계 후보를 탈락시킬 때 자유도를 다 훑었는지 확인할 것.** 6:1 을 세 번(λ 하한·ZVS·Cardano) 실패시키고 "우연이 아니다" 라고 적었는데, 세 실패가 전부 같은 1차원 절단면 위에 있었다. `l6790.py` 로 (λ, f_r, Z_o) 3차원을 도는 데 2분이면 됐다 |
| 2026-09-07 | **`R.CFG` 판정 두 개 신설 — `k.CFG_lo` · `k.CFG_hi`.** 선정 30 kΩ 이 **모핑이 살아 있는 15~47 kΩ 창** 안에 있는지 아무 데서도 안 봤다. 이 창을 벗어나면 IC 가 모핑을 멈추고 고정 하프브리지로 도는데, **탱크가 2:1 구동 계단에 맞춰 설계돼 있어서 그러면 성립하지 않는다.** 지금 2.00 / 1.57 로 통과. 한편 `audit_sm` 이 함께 지적한 `R.CFG_max`·`C.T_max/min`·`N.RCS_min`·`R.CS_single_max`·`V.out_min` 은 **오탐이었다** — 각각 `k.BO`(`V.BO_act ≤ V.AC_min` 과 `R.CFG_sel ≤ R.CFG_max` 는 같은 부등식이다) · `k.CTd` · `k.NRCS` · `k.RCS` · `k.hold` 가 이미 등가로 검사한다. 이름이 달라 감사기가 못 알아본 것이다 |
| 2026-09-07 | **`audit_fet.py` 의 낡은 셀 참조를 고쳤다** — `kT.pri` 를 `D80` 에서 찾고 있었으나 FET 블록 재배치 때 `D58` 로 옮겨졌다. 이제 "두 식 모두 Tj,max 기준으로 평가된다" 로 통과한다. **1차 손실 과소평가 경고는 오탐이었다** |
| 2026-09-07 | **변형 3종의 트랜스포머 값을 참조 구현으로 독립 재계산해 사양서와 대조했다 — 전부 일치.** 9:1 기준 `L_open` 11.67 · `L_short` 3.667 µH · 1차 11.06 A rms / 17.70 A pk · 2차 10.14 / 38.5 A · 포화(OVP2) 15.68 A · `Ae` 206 mm². 세 변형 모두 `L_short` 가 3.667 µH 로 같다(`L_r` 11 µH 고정). `Ae` 최소는 **9:1 206 · 7.5:1 103 · 6:1 206 mm²** — 7.5:1 만 EE6405(113)에 들어간다 |
| 2026-09-07 | **`λ` 하한을 틀린 코너에서 계산하고 있었다 — 전면 재검토에서 나온 유일한 실질 결함.** `λ.min.1 = 1/M.Vmax − 1` 이 `M.Vmax` 를 **V.AC_max = 264 V** 에서 평가했다. 그런데 이 식은 *탱크가 가장 낮은 요구 게인까지 내려갈 수 있는가* 를 묻고, 그 게인은 **등가입력이 가장 높은 FB 모핑 코너 332.34 V** 에서 나온다(무부하 게인 하한이 1/(1+λ) 이므로 λ ≥ 1/M − 1). **`RTC!C9` 는 원인 E 에서 이미 같은 코너로 옮겼는데 λ 사슬만 빠져 있었다.** 시트 자신이 `V.in_FBmax` 주석에 "ST 툴은 여기서 V.AC_max 를 평가한다" 고 적어 놓고도 정작 λ.1 은 안 고쳤다. **λ.min.1 0.0019 → 0.2613 · 요구 λ 0.125 → 0.5785** (137배 과소평가였다). `l6790.py` · 빌더 · 워크북 `Res. Tank Design D12` 세 곳을 같이 고쳤다(CHANGELOG 94행) |
| 2026-09-07 | **그 결함이 안 보였던 이유 — `λ.act` 를 `λ` 와 비교하는 판정이 아예 없었다.** 시트가 요구치를 계산해 놓고 선정값과 대조하지 않으니 틀린 값이어도 티가 안 났다. **`k.lam = λ.act/λ` 를 신설**했다. 지금 0.79 로 나오는데 **불합격이 아니다** — `λ` 는 `f.sw_max_spec` 225 kHz 에서 묻는 **무부하** 요구이고, 선정 λ 0.4583 이면 무부하 FB 코너가 **231 kHz** 를 필요로 한다. 목표를 3 % 넘을 뿐 **VCO 상한 319.6 kHz 안**이고, 전부하에서는 같은 코너를 209.5 kHz 에 도달한다(`f.sw.b`). 판정 행 주석에 그렇게 적었다 |
| 2026-09-07 | **전면 재검토 — 나머지는 전부 통과.** `audit_rpn` 512식 불일치 0(RPN 을 되읽어 독립 계산) · `audit_dim` 차원 충돌 0 · `check_sm` VERDICT OK · `bom_compare` 29항목 차이 0 · `xl_sm_compare` **145항목 전부 일치** · `rtc_check` 18점 편차 0.0000 % · `audit_md` 통과 |
| 2026-09-07 | **도구 두 개가 낡아 거짓 경보를 내고 있었다.** ① `rtc_check.py` 에 설계점 `n=6.0 · L_m=20 µH` 가 박혀 있어 9:1 에서 `M_req` 가 통째로 −19.5 % 어긋나 **거짓 FAIL 54건**. 워크북 `Res. Tank Design F9·F45` 에서 읽도록 고쳤다 — **도구에 설계점을 박아 두면 설계가 바뀔 때 조용히 낡는다.** ② `audit_fet.py` 는 `kT.pri` 를 `D80` 에서 찾는데 실제로는 `D58` 로 옮겨졌다(FET 블록 재배치 때). "1차 손실 과소평가" 경고는 **오탐**이다 — `D79 = D70*D58*(...)²` 로 온도계수가 제대로 곱해져 있다. 도구는 아직 안 고쳤다 |
| 2026-09-07 | **본사가 7.5:1 을 추천하는 근거를 검증했다 — 방향은 맞고 크기는 작다.** 공진 아래에서는 2차 전류가 불연속이라 같은 출력에 첨두·실효가 커진다: `I_sec,pk` 98.6 → 115.6 A(+17 %) · `I_diode` 28.4 → 30.3 A · `I_Cout` 30.2 → 33.9 A. 손실로는 2차 도통 5.64 → 6.48 W 를 포함해 **합계 20.24 → 21.52 W, 효율 0.19 포인트**. **다만 본사가 안 말한 반대편이 있다** — 공진 아래는 SR 이 영전류에서 꺼진다(ZCS). 9:1 은 항상 ZCS, 7.5:1 은 라인 주기 안에서 두 모드를 오간다. SR 턴오프 손실은 컨트롤러 타이밍에 달려 있어 계산으로 못 가른다 |
| 2026-09-07 | **9:1 이 "거의 전 구간 공진 아래" 라는 본사 설명은 맞다.** `M(θ) = M_pk/sinθ` 이고 `M < 1` 이면 공진 위인데, 라인 반주기 중 공진 위 비율이 — **9:1**: 90~130 Vac(FB)·175~230 Vac(HB) 에서 **0 %**, FB 코너 150~166 Vac 에서 32~42 %, 264 Vac 에서 3.9 %. **7.5:1**: 110 Vac 부터 16 %, 230 Vac 부터 25 %, 264 Vac 에서 40 %. **6:1**: 90 Vac 에서도 이미 21 %. `n` 이 클수록 요구 게인이 커져 더 깊이 아래에 머문다 |
| 2026-09-07 | **~~6:1 은 설계 후보가 아니다 — 세 곳에서 막힌다.~~ 2026-09-07 철회. 아래는 `C_r` 100 nF · `L_r` 11 µH 를 고정한 채 `L_m` 만 훑은 1차원 절단면의 결론이었고, 탱크 자유도 3개 중 하나만 본 것이다.** ① `L_m` 20~22 µH: `Q.ZVS1 = λ/M·√(1/λ + M²/(M²−1))` 의 근호가 음수 — `M.Vmin` 0.98 로 **최저 입력에서도 공진 위**라 게인 피크 기준 ZVS 한계가 성립하지 않는다 ② `L_m` 24~26 µH: 빌드는 되나 **ZVS 실패** — 전 영역 스윕 `T_ZC` **121 ns** 대 데드타임 220 ns(0.55배) ③ `L_m` 30 µH 이상: 시트 §8 Cardano 해 없음 — λ 가 낮아 무부하 점근선 1/(1+λ) 이 고입력 요구 게인 0.51 위로 올라간다. **성립 창이 없다** |
| 2026-09-07 | **SMath 시트를 설계점 3종으로 변형화했다.** `build_l6790_smath.py` 가 `L6790_VARIANT` 환경변수(`9to1`·`7p5to1`·`6to1`)를 받아 `Smath/variants/L6790A_*.sm` 로 쓴다. 인자가 없으면 기존 정본 자리에 쓰므로 **guard 추적 경로는 그대로**다. 세 시트 전부 `VERDICT OK`. 워크북과 벤더 사양서의 3종화는 아직 안 했다 — 6:1 이 탈락했으므로 9:1·7.5:1 두 벌로 줄일지 결정이 필요하다 |
| 2026-09-04 | **설계점을 9:1 로 옮겼다 — 2차를 1턴밖에 못 감는다는 제약에서 출발했다.** 2차가 대전류 구리판이라 1턴이 한계이고, 3코어 직병렬이므로 **감을 수 있는 세트 권선비가 3·N_p/1, 즉 3의 배수뿐**이다. 본사가 지시한 n.T = 7.47 은 2차 2턴이라야 나오므로 실현 불가. 후보 6·9·12 중 **9** 를 골랐다(6:1 은 1차 전류 +11 %·k.Ploss 0.254, 12:1 은 코어가 더 커진다). 바꾼 입력 넷 — **n 6.02 → 7.4527 · L_m 20 → 24 µH · n.aux 1.5 → 3.0 · R.ZCD_H 330 → 680 kΩ**, 그리고 자기 블록 **N_p 5 → 3 · N_s 2 → 1** |
| 2026-09-04 | **λ 를 0.55 → 0.4583 으로 같이 내린 것이 핵심이다.** n.T = n·√(1+λ) 이므로 n 과 λ 는 묶여 있다 — n.T 를 9 로 못박으면 λ 가 n 을 정한다. λ = 11/24 로 잡으면 n = 9/1.2076 = 7.4527 이고, **커진 n 이 올릴 뻔한 1차 전류를 λ 하락이 되돌린다**: 라인 rms 10.9 → 11.04 A, 정적 도통 소자 9.62 → 9.88 W, 요구 Rth 10.40 → 10.12 °C/W 로 원설계와 사실상 같다. **λ 를 안 내리고 n 만 올렸다면 손실이 +17 % 였다** |
| 2026-09-04 | **9:1 로 오면서 좋아진 것 넷.** f_o 가 90.39 → 85.07 kHz 로 내려가 **k.floor 1.021 → 1.084**(인덕턴스 허용저하 4 → 15 %, 그래서 벤더에 ±10 % 를 줄 수 있다 — CLAUDE.md 시트 §4.2 항목 5b 의 R_T 딜레마가 해소됐다), **k.ceil 1.28 → 1.519**, **ZVS T_ZC 457 → 530 ns**, **OCP1 여유 1.251 → 1.295**. 그리고 T_idle 이 250 이든 350 ns 든 둘 다 통과한다(원설계는 350 ns 에서 k.floor 1.002 로 사실상 경계였다) |
| 2026-09-04 | **나빠진 것 셋.** ① **2차 소자 rms 14.15 → 15.16 A · k.PSR 1.065 → 0.926 미달** — n.SR 을 2 → 3 으로 올리면 1.389 로 회복되나 **아직 안 바꿨다** ② **코어 — N_p 가 5 → 3 이라 자속이 오른다. B_pk 가 EE6405(113.1 mm²)에서 364 mT** 로 0.20 T 를 크게 넘는다. **A.e ≥ 206 mm² 필요, EE6405 는 1.8 배 부족** ③ 출력 뱅크 리플 30.19 → 33.85 A(개당 0.19 → 0.21 A), 커패시터 정격 미확인 |
| 2026-09-04 | **ZCD 분압기가 보조권선비를 따라간다는 것을 놓칠 뻔했다.** 보조는 코어당 1턴 × 3 직렬로 **항상 3턴**이므로 n.aux = 3/N_s 다. 2차가 2턴에서 1턴이 되면 n.aux 가 1.5 → 3.0, V_aux 가 37.5 → 75 V 로 **두 배**가 된다. R.ZCD_H 를 330 kΩ 그대로 두면 **OVP1 이 14.08 V 에서 걸려 기동조차 못 한다.** 680 kΩ(E24, 상한 662.5 k 를 2.6 % 초과)으로 올려 OVP1 28.21 V·OVP2 30.66 V 로 복구했다 — 원설계(28.17/30.61)와 거의 같다 |
| 2026-09-04 | **`R.T` 12 kΩ 시도를 되돌렸다.** 사용자가 THD 개선(영교차 클램프 축소)을 노리고 올렸는데, `f_Min = 1/(2(C_T·R_T + T_idle))` 이라 **R_T 가 커지면 f_Min 이 내려간다.** 12 kΩ 에서 f_Min 84.89 kHz 가 f_o 85.07 kHz **아래**로 내려가 용량성 영역이 열렸다(k.RT.ceil 0.998). 상한은 11.973 kΩ 이다. **ST 툴이 이 값을 `RT.min` 이라 부르는 것이 거꾸로**이고, 우리 수정본은 라벨에 `(NOT a minimum)` 을 붙여 놨다. 11 kΩ 으로 복귀(k.RT.ceil 1.089) |
| 2026-09-04 | **보상망에 권선비가 안 들어가는 것이 맞다는 것을 수식으로 확인했다.** `D64 V_FB = (2·K_HV)/(K_M·K_FF)·P_o/η·R_CS`, `D71 G_cto = (P_o/V_out)·(1/V_FB)·(1/C_out)` — **어디에도 n 이 없다.** FB 핀이 전력 지령이고 전력은 권선비와 무관하게 보존되기 때문이다. 실제로 n 을 6.02 → 7.4527 로 바꿨는데 f_cross 17.57 Hz·Φ_M 49.64°·GM 34.18 dB 가 한 자리도 안 움직였다. **간접 경로는 R_CS 하나뿐**이다(D64 에 들어 있다) — R_CS 를 바꾸면 보상망을 다시 봐야 한다 |
| 2026-09-04 | **벤더 사양서를 9:1 로 다시 만들었다**(`Calculation Excel Sheet/LGE_670W_L6790A_Transformer_Spec_rev1.xlsx`). 유닛 환산 — 개방 11.67 µH ±10 % · 단락 3.67 µH ±10 % · 권선비 3:1 · D.C OVERLAP 16 A · 1차 11.0 A rms/17.7 A pk · 2차 각 10.1 A/38.5 A · f_sw 90~210 kHz(전부하) · Ae ≥ 206 mm². **항목명을 승인원 용어로 맞췄다**(Saturation → **D.C OVERLAP**). 핀 배정은 사용자 그림을 따라 **NS2 = 3·4, NS3 = 5·6**(기존 승인원의 엇갈린 3→5, 4→6 과 다름), **센터탭 4+5 는 PCB 에서** 만든다 |
| 2026-09-04 | **사고 — 사양서를 재생성하면서 사용자가 손으로 고친 셀 색과 배치를 덮어썼다.** `build_trans_spec.py` 가 `wb.save()` 로 통째로 다시 만드는데 백업을 안 남겼다. 복구는 OneDrive 버전 기록뿐. **빌더 첫머리에 "요청받았을 때만 실행할 것" 을 박아 두었고, 앞으로 이 파일은 셀 단위로만 고친다.** 결선도를 matplotlib 으로 그려 넣었다가 사용자가 "완전 엉망" 이라 해 생성기째 삭제했다 — **사용자가 직접 그린 그림을 쓴다** |
| 2026-09-04 | **아직 안 닫힌 것 둘.** ① **n.SR 2 → 3**(k.PSR 0.926) ② **코어**(A.e ≥ 206 mm², EE6405 로는 불가). ②는 **2차 2턴으로 가면 저절로 풀린다** — 6:2 도 세트 9:1 이고 턴수가 2배면 자속이 절반이라 **A.e ≥ 103 mm² 로 EE6405 가 들어간다**(여유 +10 %). 대신 유닛당 권선이 6턴 → 11턴이라 **창 면적**이 관건이고, n.aux 가 1.5 로 돌아가 R.ZCD_H 도 330 kΩ 으로 복귀한다. **벤더에게 "EE6405 보빈에 1차 6턴·2차 2턴×2·보조 1턴이 들어가는가" 를 물어야 한다** |
| 2026-09-04 | **2차 병렬 3개의 유닛간 매칭 요구가 사양서에 빠져 있다.** 유닛당 누설 ±10 % 만 걸어 놨는데, 세 유닛의 누설이 서로 다르면 병렬 2차에서 **전류가 한쪽으로 쏠린다**. 그리고 1차 3턴에서 누설 31 %(3.67/11.67)를 ±10 % 로 재현하는 것 자체가 저턴수라 까다롭다(기존품은 26 % 를 **5턴**에서 했다). 둘 다 벤더 회신을 봐야 한다 |
| 2026-09-04 | **트랜스포머 요구사양서를 새로 만들었다**(`Calculation Excel Sheet/LGE_670W_L6790A_Transformer_Spec_rev1.xlsx`, 당시 이름 L6790_Transformer_Spec_rev1 · `build_trans_spec.py`). 벤더 양식(`L6790_Trans_20260901.xlsx`)을 고치다가 버리고 새로 그렸다. 원칙 셋 — ① **검사성적서가 아니라 사양서**이므로 벤더가 채울 빈 칸을 두지 않는다(벤더는 자기 승인원으로 회신한다) ② 회로가 요구하는 값만 적고 코어·전선·권선배치는 넘긴다 ③ 조건 칸에서 다른 행을 참조하지 않는다. **빈 칸에 빈 문자열을 쓰면 숫자 서식 칸에서 `0.00` 으로 그려진다** — `put()` 이 `None` 이면 셀을 아예 안 쓰도록 했다 |
| 2026-09-04 | **2차 1턴 제약이 드러났다 — 세트 권선비가 3의 배수로만 나온다.** 2차가 대전류 구리판이라 1턴이 한계라면 세트 n_T = 3·Np/Ns 가 3·6·9·12 뿐이고, **본사가 지시한 7.47 을 실현할 수 없다**(Np=2.5 가 필요). 후보는 6:1(n 4.82)과 9:1(n 7.23)이고, 게인은 둘 다 성립하나 6:1 은 1차 전류 +11 %·`k.Ploss` 0.254 로 나빠지고 9:1 은 자화전류가 커져 포화 요구가 15 → 18.2 A 로 오른다. **탱크 재설계가 필요하며 아직 안 풀었다** |
| 2026-09-04 | **본사가 트랜스 제조사에 줄 값으로 Final Design 블록(L.μ 24.90 · L.L1 6.10 · L.L2 0.109 µH · n.T 7.47)을 지목했다.** 검산하니 우리 시트와 같은 트랜스포머다(L_open 31.0 · L_short 10.99 · λ 0.549). **n.T = 7.47 을 감으라는 것이므로 n vs n_T 논쟁이 본사 지시로 정리됐다.** 다만 그대로 보내면 안 된다 — **세트 기준 값이라 유닛으로 환산해야** 하고(1차 직렬이라 ÷3, 2차 병렬이라 L.L2 는 ×3), `L.L2` 0.109 µH 는 지그 부유 인덕턴스 수준이라 제작사가 못 잰다 |
| 2026-09-04 | **보상망 시정수 차이의 원인을 확정했다 — `C.out` 이 절반이었다.** 사용자가 ST 원본의 시트 XML 10장을 추출해 주어 전량 대조했다(원본 `sheetN` ↔ 우리 `sheetN+1`, dimension 전수 일치). `CompensationNet&Check` **D5(C.out) 이 ST 0.0376 F 대 우리 0.0752 F — 정확히 2배**다. 그것이 D65·D68(2f_l 리플)을 절반으로 만들고, 거기에 C.13 수정(D73 의 분모를 D65 → D68, 50 → 47 Hz)이 겹쳐 **요구 EA 이득 D73 이 0.2416 → 0.4541 (×1.88 = 2.0 ÷ 1.0638)**, `EA.o_Goal` 19.26 → 36.20 Hz, **계산 C_Fo 146.41 → 77.88 nF** 로 간다. 검증도 따라 움직인다 — 교차 30.41 → 17.57 Hz, 위상여유 46.04 → 49.64°. **구현된 보상망 자체는 두 시트가 똑같다**(F93~F96 = 82 nF/560 nF/47 k/1.55 n 동일 → f_z 6.047 · f_p 47.34 · f_px 999.4 동일). 즉 차이는 *부품* 이 아니라 *목표와 검증* 이다 |
| 2026-09-04 | **ST 원본이 우리 선정값을 이미 반영하고 있다는 것을 확인 — 다만 수식은 자기 것 그대로다.** 들어와 있는 것: `V.Fo` D28 = 1.15 V · `R.P` F41 = 1.3 k · `R.B` F43 = 6.2 k · F93~F96 · D110 = 47 Hz. 안 들어온 것: C.8(D15 CTR 이중적용, 566.04 대 300) · DS 5.2.12(D42·D43 의 분모를 V_F/R_P 로) · **C.13(D73 이 여전히 D65 를 읽는다)** · 이득여유 블록(D130 f.180 = 202.45 Hz, 원본에 없음). **부품 선정은 받아들이고 시트 결함 수정은 안 받은 상태다.** 그래서 ST 시트는 자기 계산(C_Fo 146.41 nF)과 자기 선정값(82 nF)이 1.8배 어긋난 채로 있다 |
| 2026-09-04 | **ST 원본 워크북이 IRM 암호화라 열 수 없다는 것을 확인.** `Calculation Excel Sheet/04092026_LGE_670W_L6790A_spread sheet.xlsx`(당시 이름 01092026…) 는 확장자가 xlsx 인데 헤더가 `d0cf11e0`(OLE2)다. 스트림을 열어 보니 `DataSpaces/TransformInfo/DRMEncryptedTransform/Primary`(Microsoft.Metadata.DRMTransform)와 `EncryptedPackage` 1.32 MB — **구형 .xls 가 아니라 IRM 으로 보호된 OOXML** 이다. openpyxl(BadZipFile) · xlrd(`Can't find workbook in OLE2`) · Excel COM(권한 대화상자에서 2 분 초과) 전부 실패. **복호화는 시도하지 않았다.** 사용자가 Excel 에서 보호를 풀어 사본을 남기면 `xl_sm_compare.py` 로 전량 대조할 수 있다. 시트 §2 자료 지도에 "읽기 불가" 로 등재 |
| 2026-09-04 | **보상망 시정수가 원본과 다른 이유를 우리 변경이력에서 특정했다.** `CHANGELOG_rev0_6` 64행(C.13) 하나가 계산된 시정수를 움직인다 — D73 이 "@2f_L,min" 이라고 라벨돼 있으면서 분모로 공칭 50 Hz 리플(D65)을 읽고 있었고, 최소 47 Hz 리플(D68)은 아무 데서도 참조되지 않았다. 50/47 = 1.064 배 낙관적이고 오차가 `EA_o → f_MB → f_z → C_Fo → R_F` 로 전파돼 **보상망 값을 3~6 % 움직인다.** 63행(f_px 196칸)·67행(이득여유 신설)·77행(D110 50→47)은 *검증* 만 바꾸고 추천값은 안 바꾼다. 90행(V.Fo 1.45→1.15 V, R_P 1.3 k, R_B 6.2 k)은 옵토 바이어싱이라 시정수와 무관하다. **다만 3~6 % 로 설명이 안 되는 크기라면 원인은 사양 차이(C_out 18.8 vs 75.2 mF)이고, 그것은 원본을 열어야 판정된다** |
| 2026-09-04 | **트랜스포머 설계 정리 PDF에 시트 §1 "설계 사양" 절 신설, 시트 §8 "보조 권선은 λ 보정이 필요 없다" 절 신설(7 → 9쪽).** 사용자 지적: "설계 사양을 모른 채로 시작하니 헷갈린다" — 입력·출력·용도·컨트롤러 표를 시트 §1로 앞에 두고 "단일단이라 벌크 커패시터가 없다"는 한 문장에서 시작하게 고쳤다. 보조권선 λ 보정 여부 질문에 대한 답도 넣었다 — **필요 없다.** n→n_T 보정은 *부하 전류가 누설을 지나갈 때*의 얘기인데, 보조권선은 ZCD 감지 전용이라 전류를 거의 안 끌어가고, 실제 시트 식 [94] `V_aux=(n_aux/n_sec)·V_out`도 이미 물리 턴수비를 보정 없이 그대로 쓴다 — 주파수 제어 루프가 누설과 무관하게 목표 출력을 만들어 놓은 뒤, 보조권선은 그 결과(코어 자속)를 그냥 재는 것이기 때문이다. 시트 §7(유닛당 인덕턴스)의 "λ는 유닛과 전체에서 같다"는 서술에도 "2차가 병렬이어도 성립한다(1차 직렬 배수가 Lm·Lr에 똑같이 걸리므로)"를 보강했다. 이 PC에 없던 `reportlab`을 설치해 직접 재빌드·9쪽 전부 렌더링 확인 |
| 2026-09-04 | **TI SDAA419 "Turn Ratio Correction Factor for Integrated Transformer LLC Design"(2026-06)가 결정적 검증이었다.** 자사 EVM(UCC25661EVM-128, 390 VDC/12 V/15 A, 실측 $L_P$=510 µH·$L_K$=85 µH·물리 권선비 33:2:2=16.5)에서 우리와 똑같은 증상("the turn ratio is not matched our target")을 보고한다. 2차 누설까지 반영해 유도한 보정 인수 $L_P/L_M$($L_M=L_P\sqrt{1-L_K/L_P}$)이 대수적으로 우리 $n_T/n=\sqrt{1+\lambda}$와 **정확히 같음**을 확인했다 — $L_P/L_M=\sqrt{L_P/(L_P-L_K)}$, TI 예제 1.095 = $\sqrt{1.2}$. 무보정 권선비(15.35)보다 보정 권선비(16.8)가 실제 보드 물리비(16.5)에 더 가깝고, SIMPLIS 시뮬레이션(무보정 115.53 kHz vs 보정 100.42 kHz)과 오실로스코프 실측(97.66 kHz)이 전부 보정 쪽을 확인한다. 가이드 §3.10 권선비 절에 검증 콜아웃으로 반영했다 |
| 2026-09-04 | **참고문헌 5종 대조 — TDK(SRX/SRV LLC 트랜스포머 가이드) · onsemi AN-4151 · Infineon AN 2013-03(LLC) · Infineon ICL5102(LCC) · TI SDAA419.** 업계가 물리 권선비와 게인식 권선비를 두 기호로 안 나누는 이유를 확인했다 — 그들 λ(0.14~0.25)에서는 보정 인수 √(1+λ)(10~11 %)가 2차 턴수(3~4턴) 반올림에 묻혀서 넣으나 안 넣으나 결과가 같다(TDK: 3.98/3.58→둘 다 4, onsemi: 4.00/3.61→둘 다 4, 직접 역산해 확인). 유일하게 Infineon LLC 노트(2013-03)만 권선비 자체에 √(m/(m−1))=√(1+λ) 보정을 넣는다고 명시하지만, 중간 계산이 안 보여 스펙표(5쪽)로 직접 역산해도 재현이 안 됐다 — **이 항목은 미확정으로 남긴다** |
| 2026-09-04 | **본사(ST)와 트랜스포머 권선비(n=6 vs n_T=7.47) 이메일 왕복.** 본사가 "n=6이 실제로 감을 물리 권선비, n_T=7.47은 프로브로 재는 값"이라 주장 → 실측 물리로 반박(15:2로 감으면 프로브는 오히려 9.34가 나온다, 시트 D57·D59 자체가 7.47로 임피던스를 옮기고 있다) → 본사가 다음 답변에서 "n=6은 APR/FHA 모델값, n_T가 물리 T-model, 우리 자신도 실측하면 재계산값(7.47 쪽)에 가깝게 나온다"로 정정 — **사실상 우리 편으로 태도가 바뀌었다.** — **2026-09-04 정정: 이 서술은 낙관적이었다. 사용자 확인 결과 논쟁은 아직 안 끝났다.** 그래서 벤더 사양서에서 턴수와 권선비를 둘 다 빼고 개방·누설·상호 인덕턴스 셋으로만 보내기로 했다 — 등가모델을 하나도 쓰지 않는 형태다. 15:2 유지, 벤더 사양은 인덕턴스로 고정, 최종 판정은 1차 시제품 실측으로 미룬다 |
| 2026-09-04 | **출력 리플(4.74 %)과 "±5 % Regulation" 관계를 확인하다가, 시트에 없는 계산 하나를 발견했다.** 리플만 보면 25 V 대비 ±2.37 %로 여유가 크지만, 실제 규제 지점은 25 V가 아니라 분압기 실현값 25.18 V다([143], R_I=100 k/R_o=11 k). 리플을 25.18 V 중심으로 얹으면 최악(피크)이 목표 25 V 대비 +3.1 %로, ±5 % 안에는 들어오지만 리플 하나만 볼 때보다 여유가 줄어든다. **이 "리플+분압기 오프셋" 합산 판정이 시트에 없다** — 손으로 조합한 것이라 판정 지표로 넣을지는 보류. `k.RN`(1.724)은 이것과 무관한 별개의 스위칭 리플&노이즈 여유다 |
| 2026-09-03 | **CLAUDE.md·HISTORY.md 전수 대조 — 낡은 서술 발견·정정.** (1) `CLAUDE.md` 시트 §4.1 Phase 6·시트 §5, `HISTORY.md` 시트 §3.2가 `CC`의 3점 θ 평가와 `Vin_max` 264 Vac를 "구조적 한계라 못 고친다"고 여전히 적고 있었다 — 둘 다 2026-08-23에 이미 닫혔다(`HISTORY.md` 시트 §3.7). `CLAUDE.md` 두 곳에 실제 내용(θ 6점+Simpson, `RTC!C9=MAX(D79,D81)`)을 채우고, `HISTORY.md` 시트 §3.2 목록에 취소선+철회 표기를 추가했다. (2) `CLAUDE.md` 시트 §4.1의 Phase 5 지시가 "240 W 예제는 부록으로 이동"이라 적혀 있었는데 `HISTORY.md` 시트 §1.5(2026-08-24)의 사용자 결정은 "완전히 삭제"다 — Phase 5 항목을 그 결정대로 정정. (3) C.25~C.27이 `CLAUDE.md` 시트 §4 Phase 4b 목록에 빠져 있어 "미반영"처럼 보였다. 워크북 CC·BOM 셀을 직접 열어 `CHANGELOG_rev0_6` 72~74행과 함께 이미 반영돼 있음을 확인, 양쪽 문서에 명시했다 |
| 2026-09-03 | **교육자료 PPT 낡은 값 2건 수정.** 08-28 rev 2 빌드 이후(08-24·09-01) 바뀐 수치가 반영 안 돼 있었다 — 31번 슬라이드 정적 도통 소자 손실 5.7 W(자리표시자 24 mΩ 시절 값) → **9.62 W**, 52번 슬라이드 R_ZCD,H 162 kΩ·OVP1/OVP2 27.4/29.8 V → **330 kΩ·28.2/30.6 V**. python-pptx가 이 PC에 없어 zip 안의 slide31.xml·slide52.xml 텍스트 런을 직접 치환했다. 원본은 세션 스크래치패드에 백업 |
| 2026-09-03 | **Altium 스키매틱 폴더(`LGE_670W_L6790A...`)를 앞으로 참조하지 않기로 확정**(사용자 지시). 시트 §2 자료 지도에도 추가하지 않는다 — 사용자 본인의 진행 중 작업이고, TL431 분압기 5칸이 물음표로 비어 있는 등 미완성 값이라 시트와 비교하면 거짓 불일치만 만든다 |
| 2026-09-01 | **포화전류 15 A 의 근거를 바꿨다 — 임의 마진에서 OVP2 로.** 처음에는 "설계 자속 182 mT 를 재현하는 9.96 A × 1.5" 라고 적었는데 **1.5 는 내가 정한 수**였다. 사용자가 세 번 되물어서 다시 봤다. 자화전류는 공진 아래에서 도통 구간이 T_r/2 로 고정되므로 **주파수와 무관하고 출력 전압에만 비례**한다. 그러면 최악은 컨트롤러가 스위칭을 멈추기 직전까지 허용하는 출력 = **OVP2 30.61 V**, 그때 자화전류가 **15.13 A**. 자속 검산도 같은 곳으로 온다(OVP2 자속 223 mT → 시험전류 12.20 A × 1.2 = 14.6 A). **같은 15 A 인데 근거가 임의값에서 회로 한계로 바뀌었다** |
| 2026-09-01 | **본사 검토용 트랜스포머 사양(영문) 확정.** 유닛당 5T:2T:2T:1T · 개방 10.33 µH · 단락 3.67 µH · 1차 10.9 A rms/18.3 A pk · 2차 9.44 A rms/32.8 A pk · 90~250 kHz · 설계 자속 182 mT · 포화 15 A 이상. **코어·보빈·전선·권선배치는 지정하지 않는다.** 사용자 요청으로 절연·온도 항목과 시험 방법 명칭은 뺐다 — 기존 승인원(26OP-LM83W)과 동일하므로 |
| 2026-09-01 | **워크북에 `I.Lm_pk` 가 없다는 것을 확인.** 대조표 145항목 중 전류는 `I.trafo_pk`·`I.sec_pk`·`I.Lr_pk` 뿐이고 자화 성분이 없다. 워크북은 ZVS 를 닫힌형 근사로 하고 자속을 아예 계산하지 않으므로 필요가 없었던 것이다. **포화전류 근거가 이 값에 걸려 있으므로 CLAUDE.md 시트 §4.1 에 명시**했다 |
| 2026-09-01 | **트랜스포머 설계 정리 PDF(한국어) 신설** — 8쪽, 식 7 · 표 10. 대화에서 λ·결합도·권선비를 여러 번 되짚은 것을 하나의 사슬로 정리했다: 입력이 넓다 → 게인 범위 → λ 0.55 → k 80 % → 전압비 6 vs 감을 비 7.5 → 5 T : 2 T → 벤더 사양 → 남은 문제. **수치는 전부 `an_pdf.V` 보간**이라 시트가 바뀌면 문서도 따라온다 |
| 2026-09-01 | **`an_pdf.py` 를 문서 2종 공용 엔진으로.** 하드코딩되어 있던 세 가지를 뺐다 — 서체(`FONT`/`FONTB`/`FONTI` + `use_korean()`), 표지 문구(`COVER`), 그리고 `main()` 안에 섞여 있던 `build()`. 캡션 낱말(`FIGWORD`/`TBLWORD`)과 머리글 크기(`HEADSIZE`)도 변수로. **레이아웃 코드를 복사하지 않았다** |
| 2026-09-01 | 그 과정에서 **중복된 `st()`/`S` 블록**(이전 되돌리기의 잔재, 두 벌 중 뒤엣것만 살아 있었다)을 제거했다. 다만 그 사이에 끼어 있던 `T()` 가 같이 지워져 AN 빌드가 깨졌고 되살렸다 — **파일이 CRLF/LF 혼재라 여러 줄짜리 치환이 조용히 실패**하는 것이 원인의 절반이었다. 이제 CRLF 로 통일 |
| 2026-09-01 | 한국어 PDF 에서 **U+2212(MINUS SIGN)가 임베드된 맑은고딕에서 렌더링되지 않았다** — "−20 %" 가 "20 %" 로 나왔다. 4곳을 ASCII 하이픈으로. 영문 AN 은 영향 없다 |
| 2026-09-01 | **시트에 부품 공차 해석이 없다는 것이 드러났다.** "벤더에게 인덕턴스 공차를 얼마나 줄 수 있나" 를 처음 물었더니, 가장 얇은 판정 `k.floor` = 1.021 이 **공차 예산 전체**여야 한다는 것이 나왔다 — L_r+L_m 이 5 % 낮으면 f_o 가 VCO 하한 f_Min 을 넘어 용량성 영역이 열린다. `R.T` 는 시트가 제대로 골랐다(상한 11.24 kΩ 아래 최대 표준값 11 kΩ, THD 를 살리는 선택). **문제는 선택이 아니라 그 선택을 공칭 한 점에서만 검증한 것이다.** 판정 36개가 전부 공칭 기준이다. 사용자가 공차를 보류했으므로 CLAUDE.md 시트 §4.2 항목 5b 로 남긴다 |
| 2026-09-01 | **회로도를 벡터에서 넷리스트로 추출해 구조를 확정했다.** PNG 로는 배선이 겹쳐 계속 오독했다 — 결정적인 이유는 **점프(hop) 아크 13개**가 배선을 두 토막으로 끊어 놓는 것이었다. 곡선 덩어리를 세어 코일 12개(좌 6 · 우 6)와 코어 바 3개를 찾고, 점프의 양끝을 이어 준 뒤 union-find 로 노드를 병합하니 배선이 한 번에 나왔다. `pymupdf.get_drawings()` |
| 2026-09-01 | **확정된 구조.** 1차: 브리지 중점 → Np(T1) → Np(T2) → Np(T3) → C_r → 반대쪽 중점(3직렬). 2차: 세 코어의 Ns1 끼리 · 센터탭끼리 · Ns2 끼리 병렬, **센터탭이 VOUT(+) 이고 정류기는 저측**(다이오드 캐소드가 권선 쪽) — N 채널 SR 소스 접지에 맞는 배치다. **시트 가정(N_x 3 · n_T 7.5 · N_rect 1)과 전부 일치** |
| 2026-09-01 | **보조권선이 3직렬 하나였다 — 내가 끝까지 못 본 것.** 코어마다 보조가 하나씩 있어서 "라벨 없는 여분 권선"으로 읽었는데, 실제로는 **1차 GND → aux(T1) → aux(T2) → aux(T3) → ZCD_AUX 로 직렬인 한 권선**이다. 1차와 같은 3분할 논리이고, 세 코어의 평균 자속을 본다 |
| 2026-09-01 | **그래서 `n.aux` 는 0.8 도 0.5 도 아니고 1.5 다.** 코어당 12.5 V/턴 × 3턴 = 37.5 V. **코어당 1턴이 감을 수 있는 최소이므로 1.5 는 선택이 아니라 하한**이다. 0.8 은 코어당 0.53턴을 요구해 애초에 감을 수 없었다 |
| 2026-09-01 | **VCC 는 외부 12 V 전원에서 온다(사용자 확정).** 보조권선은 ZCD 감지 전용이므로 `n.aux_max`(= OVP2 에서 V.aux ≤ VCC 정격 25 V)가 **적용되지 않는다.** 계산은 워크북과 맞추려고 그대로 두고 `k.auxr` 0.558 · `k.VCC` 0.544 를 `snapshot.ACCEPTED` 에 사유와 함께 등록했다 — `k.Ploss` 와 같은 처리다. **VCC 를 이 권선에서 뽑는 순간 되살려야 한다** |
| 2026-09-01 | **`R.ZCD_H` 162 → 330 kΩ**(사용자 선정, E24). 계산값 321.8 k 보다 위라 OVP1 이 목표 27.5 → **28.17 V** 로 올라간다. 리플 꼭대기(25.59 V) 대비 여유가 7 → **10 %** 로 늘고, OVP2 30.61 V 에서 SR 이 보는 전압은 61.2 V 로 80 V 등급 안이다. `k.OVP1` 0.996 → **1.024**. 기동 종료 출력전압은 16.08 → 16.53 V — 콜드 스타트 리스크가 아주 조금 무거워진다 |
| 2026-09-01 | **LGE 트랜스포머 개수 — 내가 4개로 잘못 셌다.** 사용자가 코어를 붉게 표시해 다시 보내 주어 확인했다. **3개가 맞다.** 1차측 코일이 6개라 전부 전력 권선으로 묶었는데, 실제로는 코어 3개에 각각 2개씩이다. 시트의 3 × 5 T = 15 T, n_T = 7.5 는 그대로 유효하다. **아직 확인이 필요한 것 하나** — 3코어면 1차측이 Np 3개 + 보조 2개 = 5개여야 하는데 6개가 보인다 |
| 2026-08-28 | **배포용 영문 Application Note 신설** — 배포용 영문 AN 20쪽 (지금은 v1.1). Infineon AN 2013-03 의 **레이아웃**만 따르고 브랜딩은 우리 것이다(표지에 "Not an ST publication" 명시). 8개 절 · 식 14 · 그림 14 · 표 10. reportlab platypus + matplotlib mathtext(수식은 PNG). **한국어 설계 가이드와 역할이 다르다** — 가이드는 식 [1]–[148] 전체를 담은 참조서이고, AN 은 배포 가능한 자립 문서다 |
| 2026-08-28 | **AN 의 모든 수치는 `an_pdf.V` 보간이다.** 본문(`an_body.py`)에 손으로 적은 상수가 없고, V 는 `l6790.py` + SMath 시트에서 만들어진다. ZVS 격자(표 3)는 옮겨 적지 않고 `l6790.sweep()` 으로 **매 빌드 재계산**한다 |
| 2026-08-28 | **`T()` 에 가드 두 개.** 포맷 안 된 `%%` 와 `%(…)` 가 그대로 인쇄되고 있었다 — "34 %%" 와 "(%(Icomp).2f A)". 후자는 `%%` 를 고치다 내가 `% V` 를 같이 지워서 만든 것이다. 이제 T() 가 그런 문자열을 만나면 빌드를 세운다 |
| 2026-08-28 | **자기 정정 — 그리스 문자가 안 나온다고 잘못 진단했다.** 페이지를 이미지로 보니 λ·θ·Ω 이 빠져 있어 WinAnsi 한계라 보고 Symbol 폰트 매핑을 넣었는데, 그 매핑이 **검은 네모**를 그렸다. 실제로는 reportlab 이 `&lambda;` 를 정상 렌더링하며 **빠져 보인 것은 pymupdf 래스터라이저**였다. PDF 텍스트를 추출해 확인했어야 했다. 매핑을 걷어냈고 T() 는 `&thinsp;` 만 처리한다 |
| 2026-08-28 | `g_tank_current` · `g_loop_bode` 도 `_tank_current(T)` · `_loop_bode(T)` 로 분리 — 한국어(가이드)·영문(AN) 두 라벨셋이 같은 그리기 코드를 쓴다. **라벨 6개가 `% fc` 같은 지역변수 포맷 표현식이라 dict 로 옮기니 NameError** 가 났다. 포맷은 호출부에 남기고 dict 에는 포맷 문자열만 둔다 |
| 2026-08-28 | `figs.py --plain` 신설 — `ask()` 제목을 그리지 않고 `figures/an/` 에 쓴다. 슬라이드에는 질문형 제목이 맞지만 번호 붙은 그림에는 캡션이 제목이다 |
| 2026-08-28 | **교육자료 rev 2 — 55 → 61장.** 240 W / 60 V 예제 수치를 25 V / 26.3 A 로 교체(글 18곳 + 표 60칸). **표는 그때까지 한 번도 훑은 적이 없었다** — 첫 스캔이 텍스트만 보고 "9장" 이라 했는데, 실제로 예제가 살던 곳은 41·43·44·45·46 의 표 다섯 개였다. 44번 ZVS 격자는 치환이 아니라 `l6790.py` 로 **재계산**했다(전부하 173.2 Vac eq. 457 ns) |
| 2026-08-28 | **38번(현 42번)은 결론이 뒤집혔다** — "홀드업이 이긴다(4364 vs 2258 µF)" 였는데 우리 사양에서는 **리플이 이긴다**(71.3 vs 59.8 mF) |
| 2026-08-28 | **그 자리에서 내가 틀린 문장을 썼다가 되잡았다** — "어느 조건이 이기는지는 출력 전압이 정한다(25 V 면 리플, 60 V 면 홀드업)". **아니다. 두 조건 다 1/V_out² 이라 비는 전압과 무관하고 사양만이 정한다:** 리플이 이길 조건은 `1 − (V_o,min/V_out)² > 4π·f_l·Δv·T_hold`. 우리 0.422 > 0.354(1.19배), 240 W 예제 0.306 < 0.628(홀드업 2.06배). 60 V 가 아니라 **Δv 10 % 와 droop 17 %** 가 원인이었다. 그림 `f19_cout_criterion` 으로 그려 넣었다 |
| 2026-08-28 | **46번(현 50번)이 정반대를 말하고 있었다** — "R_T 13 kΩ 이면 f_Min 이 77.4 kHz 로 **하한 아래**라 ACP 만 믿는 셈" 은 240 W 예제 얘기다. 우리는 92.3 kHz 로 **위**에 있고, 다만 **2.1 % 뿐**이며 설계 전체에서 가장 얇은 여유다. T_idle 700 ns 면 음수가 된다 — 그 문장으로 바꿨다 |
| 2026-08-28 | **모핑을 1장에서 5장으로**(사용자 요구: "딸랑 한 페이지 설명하고 끝이 아니라 브리지 회로가 어떻게 다르게 동작하는지 그림으로"). 29 왜 필요한가 · 30 풀브리지 도통 · 31 하프브리지 도통 · 32 게이트 신호 · 33 레벨과 히스테리시스. 그림 3장 신설(`f15`·`f16`·`f17`) — 반주기별 도통 경로, v_tank 파형, HOUT/LOUT 4선. **31번에 정적 도통 소자를 명시**했다: Q4 는 스위칭하지 않지만 탱크 전류 전체(10.9 A)를 계속 흘려 5.70 W 로 컨버터에서 가장 뜨겁다 |
| 2026-08-28 | **출력 뱅크를 1장에서 3장으로** — 42 두 가지 역할 · 43 어느 조건이 이기나(위 판정식) · 44 75 mF 의 하드웨어 실체(160개 · 개당 0.19 A · ESR 0.1875 mΩ · **콜드 스타트 신규 리스크** · 부피). `f19` 오른쪽 패널에 **에너지는 사라지지 않는다**를 그렸다: 2단의 400 V 벌크 274 µF = 21.9 J, 우리 75.2 mF = 23.5 J. 같은 줄이 25 V 로 내려오면서 274배의 정전용량이 된 것뿐이다 |
| 2026-08-28 | `morphing_levels` 그림을 `_morph_levels(T)` 로 분리해 한국어(가이드)·영문(교육자료 `f18`) 두 라벨셋이 **같은 그리기 코드**를 쓰게 했다. 복사했으면 갈라졌을 것이다 |
| 2026-08-28 | 잔여 정정 — 7번 f_o 88.1 → 90.4 kHz · f_r 150.3 → 151.7, 45번 루프 교차 "20 Hz" → 17.6 Hz(제목 포함), 49번 검증 수치(101 → 145항목 · f_cross 17.57 · Φ_M 49.64° · 3차 4.23 %), 56번 정오표의 "187 → 241 kHz" 를 우리 값(189.2 → 249.6)으로. `check_deck.py` 문제 33건은 전부 **손대지 않은 슬라이드**의 기존 것이고 신설 8장은 0건 |
| 2026-08-19 이전 | 가이드 rev 1.1 · SMath 시트 §3 시트 · PPT 51장 · 스프레드시트 rev 0.6 완성. 식 [1]–[148] 5회 대조 |
| 2026-08-21 | 사양 확정(25 V 직출력, 리플 5 %, 홀드업 12 ms @100 Vac 최악 위상) |
| 2026-08-21 | LGE 기존 보드 분석(시트 §5.2) · EVB TV 용도 확인(시트 §5.1) · [70a] CT 결함 발견(시트 §3.5) |
| 2026-08-21 | 닫힌형 해 발견(시트 §2) · T_idle 8칸 역산(시트 §4) |
| 2026-08-21 | **SMath 정본 시트 rev 1 완성** — 19개 절, A3, 보드선도 4장 |
| 2026-08-21 | 보상망 26식 전수 대조 → C.12·C.13 발견 · ISEN 블록 전수 대조 → C.14~C.17 발견, 스프레드시트 반영 |
| 2026-08-21 | 엑셀↔SMath 101값 대조(차이 0) · BOM 29항목 대조 도구 작성 |
| 2026-08-21 | xlsx 손상 사고 → `set_cell()` + 사전 검사기(시트 §6.1) |
| 2026-08-21 | 사용자가 SMath에서 F9 실행·저장 확인 (revision 8) |
| 2026-08-23 | **워크북 정리 완료 — 대조 134/134 · 차이 0.** 원인 A–F 전부 해소. `RTC` 격자 탐색을 **Cardano 닫힌형 18블록**으로 대체(편차 0.0000 %), `Vin_max` 를 FB 코너로. **"E 는 못 고친다" 는 앞선 기록 2건 철회.** 남은 흠은 `RTC` 행 26·27 의 `#NUM!` 164칸뿐이고 **차트·설계값에 영향 없음**(읽는 곳이 `CG25` 하나) |
| 2026-08-23 | **워크북에 B 적용**(`fix_xl_cc.py`, 셀 50개) — `CC` 에 θ 3열과 Simpson 적분을 넣어 **C.18 을 닫았다.** 뱅크 리플전류 21.77 → **30.17 A**(SMath 30.19). **"스프레드시트로는 적분 불가" 라는 앞선 판단은 틀렸다** — RTC 가 이미 θ 6점을 풀고 있었다. 대조 차이 8 → **5건** |
| 2026-08-23 | **워크북에 A·C·D 적용**(`fix_xl_causes.py`, 셀 6개) — ZVS 를 선정 후 RTC 실현값으로 재검산 · 검증 블록 라인주파수 50 → 47 Hz · 홀드업 시작 전압을 리플 골로. `CHANGELOG_rev0_6` 76–78행에 기록. **E 는 적용 불가로 판정** — `RTC!C9` 를 FB 코너로 돌리면 M_req 가 무부하 게인 하한 아래로 내려가 `fn.max` 가 #NUM! 이 되고 격자 전체가 무너진다 |
| 2026-08-23 | **차이 18건을 수식 수준에서 전수 재대조 → 근본 원인은 6개**(시트 §3.7). 그룹 안에서 두 식은 글자까지 같고 값 하나만 다르며 뒤 행은 첫 행의 하류다. `xl_sm_compare.py` 가 원인 태그와 그룹 요약을 인쇄하도록 고쳤다. **"B 는 구조적으로 불가능" 이라는 앞선 기록도 철회** — `RTC` 의 θ 6점에 사다리꼴을 쓰면 오차 0.35 % 다 |
| 2026-08-23 | **대조표가 없는 결함을 하나 만들어냈다.** `ΔV.loop` 를 `CC!D65`("@2fL", 공칭 50 Hz 참고 행)에 매핑해 6.4 % 차이를 C.13 결함으로 보고했으나, 설계가 실제로 쓰는 것은 `D68`("@2fLmin", 47 Hz)이고 그 값 **1.18430 은 시트와 정확히 같다**(`D73`·`D83` 도 47 Hz 를 쓴다). 재매핑 후 일치 116 → **117**. 남는 것은 성격이 다르다 — **검증 블록(D110~D132)에 별도 입력 `D110 = 50`** 이 있어 워크북이 47 로 설계하고 50 으로 검증한다. 수식이 아니라 입력 셀 하나 |
| 2026-08-24 | **FET 선정 파라미터 감사 신설**(`audit_fet.py`) — LLC 가 요구하는 항목마다 워크북 셀과 SMath 변수가 *있는지* 와 *수식에 쓰이는지* 를 따로 본다. 결함 4건이 나왔고 전부 닫았다. 시트 §9.1 |
| 2026-08-24 | **① 1차 전류 정격이 잘못된 피크를 쓰고 있었다** — `Power Components!D65 = 1.3×CC!E27` 인데 `CC!E27` 은 **반사 부하전류**(I_trafo,pk 16.39 A)다. 브리지 스위치가 흘리는 것은 **합성 탱크 전류** i_Lr 이다. 워크북은 그 값을 이미 `Device Setting!D32 = 18.319 A` 에 갖고 있었다(OCP1 설정용). 정격이 12 % 부족했다. 가이드 [115] 도 같은 오류이며 SMath 는 이미 덮어쓰고 있었다 |
| 2026-08-24 | **② 소자 1개당 전류가 어디에도 없었다** — 전류는 전부 스위치 *위치*당(1차) · *레그*당(2차) 인데 손실·정격식이 소자 1개가 그걸 다 흘리는 것처럼 썼다. 병렬 소자 수가 아예 없어 SMath 의 R_DS(on)(소자당)과 워크북의 R_DS(on)(레그당)은 **비교조차 불가능**했다. 양쪽에 `n.par`=2 · `n.SR`=3 과 소자 1개당 실효·피크 4행씩 신설 |
| 2026-08-24 | **③ 온도가 앞뒤로 안 맞았다** — `D78`·`D100` 은 25 °C R_DS(on) 로 손실을 내고 `D79`·`D101` 은 그 손실로 "Tj 125 °C 까지 가는 Rth" 를 물었다. 같은 식의 분자와 분모가 다른 온도. `kT.pri`=2.0 · `kT.sec`=1.5 신설. 요구 Rth 가 약 2배 후했다 |
| 2026-08-24 | **④ 2차 손실이 다이오드 모델이었다** — `Vf·I_avg + rd·I_rms²` 이고 선정 부품도 쇼트키였는데 본 설계는 SR 이다. `Conf.SR` 신설(1 = 다이오드 · 2 = SR). SMath 는 SR 전용이라 반대쪽 흠이 있었다 — 데드타임 바디 다이오드 도통을 아예 안 본다. **양쪽 다 "안 본다" 고 명시**했다 |
| 2026-08-24 | **⑤ SMath 시트 §13.3 자리표시자가 시트 §13.1 요구를 6배 위반** — `R.dson_p` 150 mΩ vs 요구 25.3 mΩ. 그 결과 `P.pri_tot = 35.64 W`(출력의 5.4 %)가 설계값처럼 인쇄됐다. 25 °C 기준 pick(`R.dson_p25` 24 mΩ)에서 `K.Tpri` 로 열간값을 유도하는 형태로 바꿔 **요구를 구조적으로 만족**하게 했다. 5.70 W. 예산 대조 `k.Ploss`·`k.PSR` 신설 — **예산은 있는데 비교가 없던 자리** |
| 2026-08-24 | **⑥ [64] 가 [63] 과 다른 파형을 제곱하고 있었다** — [63] 의 `1−cos(π f_r/f_sw)` 는 공진 위에서 **사인이 잘린다**는 뜻인데, [64] 는 `d` 를 1 로 고정해 **온전한 반사인파**의 실효값을 쓴다. 두 식이 다른 파형을 말한다. 절단 인수 `k_tr = 1 − sin2φ/2φ` 를 [64a] 로 신설하고 `l6790.py` · SMath · 워크북 `CC` · 가이드 넷 다 반영. **저입력에서는 φ=π 라 인수가 정확히 1** — 두 설계 모두 2차 실효 최악이 저입력이므로 **소자 선정도 커패시터 개수도 안 바뀐다**. FB 코너에서는 **+8.0 %**(240 W 예제 +8.4 %). 부록 C.30 |
| 2026-08-24 | **유니버설 동작 전 구간 검산 — 히스테리시스 밴드가 빠져 있었다.** 가이드는 등가 범위를 173.2–332.3 Vac(1.92:1)로 쓴다. 각 임계값을 *그 모드가 보장되는* 쪽에 배정한 값이다. 그런데 235–245 V_pk 사이는 **이력이 모드를 정한다** — 올라오는 중이면 245 V_pk 까지 FB, 내려가는 중이면 235 V_pk 까지 HB. 진짜 범위는 **166.2–346.5 Vac (2.08:1)**. 여유 게인 15.6 → 10.9 % · ZVS 2.08 → 1.70배 · f_sw,max 249.6 → 263.2 kHz. **전 항목 통과하므로 설계는 안 바꾼다** — 가이드 §3.3 에 절을 신설해 적어 두었다. 가장 얇은 곳은 입력 범위가 아니라 `k.floor` 1.021(VCO 하한 92.25 kHz 대 f_o 90.39 kHz)이고, 그것은 미확정인 `T_idle` 에 직접 걸려 있다 |
| 2026-08-24 | **1차·2차 소자 구성 확정 — 현 엑셀 값 그대로.** `n.par` = 1 · `n.SR` = 2, 병렬 증설도 GaN 도 쓰지 않는다. 잠정 3 W 예산은 1차에서 미달(9.62 W, `k.Ploss` 0.312)이고 2차도 거의 소진(`k.PSR` 1.065)이지만 **감수하기로 했고, 방열판 사용 여부는 시제품 열 실측에서 판정한다.** 두 판정이 1 미만인 것은 설계 결정의 결과이지 결함이 아니다 — CLAUDE.md 시트 §3 판정표와 시트 §4.2 항목 5·3b 양쪽에 명시했다. 실측 항목 11 신설 |
| 2026-08-24 | **`kT.sec` 확정 1.9.** 2차 SR 데이터시트의 R_DS(on)–T_a 곡선 (V_GS = 10 V)에서 25 °C 3.2 mΩ · 125 °C 6.1 mΩ. **축이 T_a 인데도 쓸 수 있는 이유는 "Pulse test" 라 다이가 자기발열하지 않아 T_j = T_a 이기 때문** — 펄스가 아닌 곡선은 이렇게 못 쓴다. 내 추정 1.5 는 낙관적이었다. 열간 5.55 → **7.03 mΩ**, 2차 총손실 4.45 → **5.63 W**, `k.PSR` 1.349 → **1.065** 로 예산을 거의 다 썼다. 레그당 3병렬이면 회복된다 |
| 2026-08-24 | **`kT.pri` 확정 1.8.** 사용자가 STO60N045DM9 의 normalized R_DS(on) vs T_j 곡선에서 125 °C 배수를 읽어 왔다(내 추정은 2.0). 열간 90 → **81 mΩ**, 정적 도통 소자 10.69 → **9.62 W**, 요구 Rth 9.36 → **10.40 °C/W**, `k.Ploss` 0.281 → **0.312**. **`kT.sec` = 1.5 는 아직 추정으로 남는다** |
| 2026-08-24 | **SMath 에 실제 부품값 반영.** 엑셀엔 STO60N045DM9(45 mΩ)·2차 3.1 mΩ 을 넣으셨는데 **SMath 는 내 자리표시자 24 mΩ·2 mΩ 그대로였다** — 엑셀이 아직 재계산 전이라 대조표가 이를 가리고 있었다. 45 / 3.1 mΩ 으로 맞춤. 1차 정적 도통 소자 5.70 → **10.69 W**, 요구 Rth 17.5 → **9.35 °C/W**, `k.Ploss` 0.526 → **0.281**. 2차는 레그당 2병렬로 총 3.73 W, `k.PSR` **1.610** 통과. 아울러 `Power Components` 배치 정정 — 1차 정적 손실이 **2차 섹션 제목(B81) 아래**에 있었고 `kT.pri` 입력이 결과 블록 한가운데 있었다. 77–80 = Ctot · 스위칭손실 · 정적손실 · Rth 로 정리하고 `kT.pri` 는 섹션 제목 바로 아래(D58)로. 그 행을 82행에 만들던 임시 스크립트는 다시 돌면 배치를 되돌리므로 삭제했다 |
| 2026-08-24 | **소자·보상망 확정 반영.** 1차 STO60N045DM9(45 mΩ max, n.par 1) · 2차 SR 레그당 2개(`n.SR` = 2). **`kT` 가 1 로 꺼져 있던 것을 2 / 1.5 로** — 데이터시트 max 는 **25 °C 공정산포**이지 온도가 아니다. 1차 정적 도통 소자 5.34 → **10.69 W**, 요구 Rth 18.7 → **9.36 °C/W**. 보상망은 `V.Z` 25 → 12 V 로 바뀌어 있었고, **`V.Fo` 가 엑셀 1.45 V · SMath 1.15 V 로 갈라져 두 문서의 R_B 창이 아예 겹치지 않았다**(5.873–6.652 vs 6.934–8.001 k). 1.15 V 로 통일. **R_B 창이 R_P 에 의존**(V.Fo/R.P 가 분모)하므로 R_P 를 1.8 → 1.3 k 로 내리자 창이 5.759–6.477 k 로 이동했고 R_B = 6.2 k 로 수렴. `C.Fo` 82 n · `C.F` 560 n · `R.F` 47 k 는 **사용자 선정이 이미 정확**했다. 판정 33 → **35 / 36**, 남은 미달은 보류 결정한 `k.Ploss` 뿐 |
| 2026-08-24 | **도구 4개가 `<result>` 를 잘못 읽고 있었다.** `<result>` 도 RPN 인데 첫 토큰만 읽어 **단항 마이너스와 지수가 사라졌다.** 넷이 같은 가정을 독립적으로 해서 서로 못 잡았다. `n.SR` = 1 재계산 뒤 `D37`(필요 세라믹) 불일치로 드러났는데 **엑셀도 SMath 도 맞았다** — `C.cer_min = MAX(−64.14 µF, 0)` = 0 을 시트는 −3.87e-15 µF 로 쓰고 나는 3.87 로 읽었다. `smresult.py` 신설. 525개 중 53개가 다중 토큰, 그중 16개가 부호를 잃고 있었다. 시트 §6.6 |
| 2026-08-24 | **사양 변경 — 1차·2차 모두 소자 1개씩**(사용자 결정). `n.par` 2 → 1 · `n.SR` 3 → 1. **2차는 통과** — 레그당 1개가 28.3 A rms · 98.4 A peak 를 전부 흘리고 2.41 W, `k.PSR` 1.248. **1차는 미달** — HB 모핑에서 정적 도통 소자가 5.70 W 로 잠정 예산 3 W 의 1.9 배, `k.Ploss` 0.526. 3 W 를 맞추려면 25 °C 기준 12.6 mΩ 이 필요한데 600 V 슈퍼정션에 없다(최선 17–24 mΩ → 4.04–5.70 W). **예산 인상 또는 그 한 자리만 2 병렬**이 선택지다. 이 변경으로 워크북의 알려진 한계가 실제 문제가 되어 함께 닫았다 — `D82` 신설(정적 도통 소자 손실)과 `D79 = (125−Ta)/MAX(D78,D82)`. 요구 Rth 35.1 → **17.5 °C/W** |
| 2026-08-24 | **⑦ 살아 있는 참조 위에 손으로 적은 상수가 얹혀 있었다** — C.18 이 `CC` 에 Simpson J열을 만들면서 `Res. Tank Design` D65·D67 과 `Power Components` D28 세 셀만 연결하고 **D60·D61·D84·D85 를 빠뜨렸다.** 그 넷은 θ=π/4 한 점을 읽은 채 **F열 노란 손입력**(10.9 · 7.707 · 28.31 · 28.31)으로 덮여 있었다. C.27 과 같은 구조 — 입력을 바꾸면 J열은 따라오고 손입력은 안 따라온다. J29·J30·J25·J26 으로 연결하고 손입력 4칸 삭제. **오늘 값은 안 움직인다**(적을 당시엔 맞는 값이었다). 나머지 `CC!C..H` 참조 10건은 전부 피크(E열 = θ=π/2)이거나 의도된 최악 스위칭주기 값이라 그대로 둔다 |
| 2026-08-24 | **`RTC` 26·27행 `#NUM!` 164칸을 닫았다.** 2026-08-23 에 "차트·설계값 영향 없음" 으로 남겨 둔 것. `fn.max = √(λ/(1+λ−1/M))` 은 무부하 게인 점근선 1/(1+λ)=0.6452 아래에서 해가 없고, 원인 E 가 M 을 0.6383 으로 내렸다. `CG26` 이 이미 갖고 있던 3중 가드를 전 열에 이식. **읽는 곳이 없어 수치는 하나도 안 움직인다** |
| 2026-08-24 | **워크북을 한 언어로** — 한글 57칸(CHANGELOG 50 + 라벨 7)을 영문화. 영문 산출물에 읽을 수 없는 변경 이력이 붙어 있었다 |
| 2026-08-24 | **SMath 시트 §19.6 에서 부품번호 삭제** — 사양이 바뀔 때마다 손으로 고쳐야 하고, 시트에서 **어떤 계산도 검증할 수 없는 유일한 항목**이다. 소자 등급·개수와 살아 있는 요구값으로 대체 |
| 2026-08-24 | **엑셀↔SMath 대조에 반도체 블록 11항목 추가**(134 → 145). 이 블록은 지금까지 **한 번도 대조된 적이 없었고**, 그래서 두 문서가 조용히 갈라져 있었다 |
| 2026-08-24 | **어제의 "규칙 8 정정"을 철회한다.** `design()` 을 선정값 없이 불러 *계산* 탱크로 쟀던 것이라 측정 자체가 틀렸다. 예제가 실제로 쓰는 선정 탱크(33 nF/34 µH/65 µH)로 재면 스윕 246.5 ns · 닫힌형 302.8 ns = **+22.9 % 낙관적**이다. 본 설계(선정 탱크)는 −34.4 % 보수적. **부호가 탱크마다 바뀐다** — 그래서 근사식은 어느 방향으로도 못 믿는다. 원래 기록이 방향은 맞았다 |
| 2026-08-23 | ~~규칙 8의 부호가 뒤집혀 있었다~~ **(2026-08-24 철회)** "닫힌형 [36]–[38] 은 약 10 % **낙관적**" 이라고 적어뒀으나 실측은 반대다 — 본 설계 **−34.4 %**, 240 W 예제 **−5.5 %** 로 **보수적**(여유를 과소평가)이다. 원인 둘의 기여가 비슷하다: 근사식 [36] 만으로 −10.7 %(기록된 10 % 는 이 크기였다), 설계 `Q_ZVS` 를 쓴 것만으로 −20.6 %. **툴 자신의 `RTC` 격자는 f_n 0.84006 으로 SMath 와 5자리까지 같다** — 워크북은 정답을 갖고도 ZVS 검사에만 근사식을 쓴다. 조언 자체(스윕을 쓰라)는 유효 |
| 2026-08-23 | **재계산이 예측 4건을 반증했다.** "재계산하면 일치한다"고 달아둔 주석 10건 중 6건은 맞았고 4건은 틀렸다 — `C_T` 상한은 SMath 가 FB 코너 249.6 kHz, 워크북이 사양치 225 kHz 를 쓰는 **영구적** 차이였고(역산 249.65 kHz 로 확인), `D126`·`D128`·`D129` 는 C.13 기준 차이의 하류로 비 1.0638 × 1.0512 = 1.1183 이 정확히 설명한다. 주석 10건 전부 실제 결과로 교체 |
| 2026-08-23 | **사용자가 워크북을 재계산**(열었다 저장). 잠정이던 대조가 확정됐다 — 135항목 중 **일치 101 → 116 · 불일치 3 → 0**. C.12(196셀 f_px)·C.13 수정이 실제로 동작함이 이로써 확인됐다. 오류값은 54개(RTC 행 29 의도적 마스킹)로 변동 없고, 한계를 벗어난 선정값도 0 |
| 2026-08-23 | **`RTC` 격자를 셀이 아니라 답으로 검증**(`rtc_check.py`) — 18점을 Cardano·이분법과 대조, 최대 편차 0.197 %. 동시에 **RTC 가 설계에 미치는 경로는 셀 9개뿐**임을 확인. 그리고 **내 기록이 틀렸음**을 발견: "f_n 격자 상한 1.3703" 은 격자가 아니라 `fn.max` 였고 실제 격자는 2.0127(305.4 kHz)까지 간다 — 문서 4곳 정정 |
| 2026-08-23 | **검사 범위를 문서화**(시트 §1.4) — 전수 확인이 끝난 것과 안 본 것을 구분. 값 대조를 101 → **135항목**으로 확대하다 오늘 넣은 `C.T_min` 의 주파수 기준 오류를 즉시 발견 |
| 2026-08-23 | **반복 구조 감사 10라운드** — C.25~C.27 발견. RPN 왕복 475식·차원 해석 475식 전수 통과. SMath 에 없던 식 4개(ZVS 천이시간 [40][41][42] 포함) 구현. 판정 23 → 33개 |
| 2026-08-23 | **구조 감사기 `audit_xl.py` · `audit_sm.py`** — C.21~C.24 발견. 선정값이 자기 한계를 벗어난 곳 2건, 라벨이 정반대인 곳 1건, 비교 검사 자체가 없던 곳 5건 |
| 2026-08-23 | **이득 여유를 양쪽에 신설** — `f.180 = √(f_p·f_px − f_z·(f_p+f_px))` 닫힌형. GM 34.26 dB. 위상 여유는 원래 양쪽에 있었다 |
| 2026-08-23 | `R_P` 1.5 → **1.4 kΩ**(상한 위반), `C_in` 2000 → **2200 nF**(하한 미달) |
| 2026-08-23 | **C.12·C.13 워크북 반영** — f_px 극점을 196셀에 삽입(공유수식 마스터 7개), D73 분모를 f_l,min 리플로. 입력 c_HB 800 pF·t_D 220 ns·T_idle 250 ns 로 SMath 와 통일 |
| 2026-08-23 | **설계 가이드에 정오표 반영** — C.12–C.20 신설, [70a] 센터탭 경고, C.1 8칸 역산표. 1562 → 1723줄 |
| 2026-08-23 | **교육자료에 반영** — 정오표 슬라이드 신설(51 → 52장), T_idle·LOUT 행 갱신, 규칙 9에 노드 실효값 |
| 2026-08-23 | **자기 정정** — I_Cout 차이를 [70a] CT 결함으로 잘못 귀속했었다. 실제 원인은 C.18 |
| 2026-08-23 | **C.18 발견·반영** — 워크북이 θ=π/4 한 점을 "mains cycle" 실효값이라 부르고 있었다. 2차 정류기 손실 1.38 배 과소평가. 라벨 정정 + 라인사이클 입력 셀 신설 |
| 2026-08-23 | 엑셀↔SMath **전량 대조 도구 `xl_sm_compare.py`** — 101 항목, 불일치 0 |
| 2026-08-23 | SMath `R.ZCD_H` 상한을 **선정된** 하단 저항 기준으로 정정 (계산값을 쓰고 있었다) |
| 2026-08-23 | CLAUDE.md 시트 §3을 **생성물**로 전환(`snapshot.py`) — 손으로 옮겨 적은 값이 낡는 사고가 이미 한 번 있었다(시트 71.4 mF, 문서 80 mF) |
| 2026-08-23 | xlsx 수술 도구를 스크래치패드에서 `generators/xlsx_patch.py`로 영구화 · Stop hook `guard.py` 도입 |
| 2026-08-23 | 문서를 `CLAUDE.md`(작업용) / `HISTORY.md`(근거)로 분리. `README.txt`·`HANDOFF` 폐기 |
| 2026-08-23 | **출력 커패시터 선정 변경** — 사용자가 엑셀에서 680 µF × 105 → **470 µF × 160 = 75.2 mF**. 리플 4.99 → 4.74 %, 홀드업 여유 1.055 → 1.119. 양쪽 다 개선 |
| 2026-08-23 | 중간 상태 백업 5개 삭제(xlsx 4 + sm 1) — 전부 내 수정 이력의 중간판이고 현행 파일이 검증을 통과했다. **ST 원본 r1.0은 이 폴더에 없다** |

---

## 9. FET 선정 — 무엇을 보고 무엇을 계산하는가

2026-08-24. `audit_fet.py` 가 항목마다 두 가지를 따로 묻는다:
**있는가**(셀·변수가 존재하는가) 와 **쓰이는가**(어떤 수식이 그걸 읽는가).
**있는데 안 쓰이는 쪽이 더 위험하다 — 검토한 것처럼 보인다.**

### 9.1 감사 결과 (수정 후)

| 항목 | 워크북 | SMath | 비고 |
| :--- | :--- | :--- | :--- |
| V_DS 내압 | 표시 D64 · D89 | 표시 `V.DS_pri` · `V.DS_sec` | 요구조건 행이므로 "표시만" 이 정상 |
| I_D 정격 (위치/레그당) | 표시 D65 · D90 | 표시 `I.pri_rating` · `I.sec_rating` | **D65 는 틀린 피크를 쓰고 있었다 — 시트 §9.2** |
| 병렬 소자 수 | D68 = 2 · D103 = 3 | `n.par` · `n.SR` | **신설.** 없으면 전류가 나뉠 곳이 없다 |
| 소자 1개당 피크 | D66 · D91 | `I.pk_dev` · `I.SR_pk_dev` | **신설** |
| 소자 1개당 실효 | D62 · D87 | `I.mos_dev` · `I.SR_dev` | **신설.** 손실식이 이걸 읽는다 |
| R_DS(on) @25 °C | D70 = 24 mΩ · D96 = 2 mΩ | `R.dson_p25` · `R.dson_s25` | 소자당 |
| R_DS(on) 온도계수 | D80 = 2.0 · D98 = 1.5 | `K.Tpri` · `K.Tsec` | **신설 — 시트 §9.3** |
| C_oss | D71 → D77 | `c.HB` → `Q.ZVS2` | **어느 C_oss 인지가 빠져 있다 — 시트 §9.5** |
| 다이오드/SR 선택 | D93 = 2 | SR 전용 (구조상) | **신설 — 시트 §9.4** |
| 바디 다이오드 조건 | D74 · D75 | `V.bd_rr` · `I.bd_rr` | 373.4 V · 12.36 A. Q_rr 은 가정 안 함 |
| 손실 예산 대조 | 없음 | `k.Ploss` 1.052 · `k.PSR` 3.743 | **신설 — 예산은 있는데 비교가 없었다** |
| R_th 요구 | D79 · D101 | 없음 | 워크북 전용 |
| T_j(max) | D79·D101 안에 리터럴 125 | 없음 | **양쪽 다 입력 셀 없음 (남은 항목)** |
| Q_g · E_off · SR Q_rr | 없음 | 요구조건만 명시 | **소자 값이라 계산 불가 — 시트 §9.5** |

### 9.2 1차 전류 정격이 틀린 피크를 쓰고 있었다

`Power Components!D65 = 1.3 × CC!E27` 이고 `CC!E27 = Itrafo.pk.tsw = I_sec,pk/n` —
**반사 부하 전류**다(16.39 A). 브리지 스위치가 실제로 흘리는 것은 **합성 탱크 전류**
`i_Lr = i_trafo + i_Lm` 이고, 둘은 서로 다른 순간에 피크를 친다. 그 합성 피크는
**워크북이 이미 갖고 있었다** — `Device Setting!D32 = Ilr.pk.max = 18.3189 A`, OCP1
설정점을 잡으려고 계산해 둔 것이고 SMath `I.Lr_pk` 와 5자리까지 같다.

정격이 **12 % 부족**했다. 가이드 [115] 도 같은 식으로 쓰여 있고, SMath 는 시트 §13.1 에서
이미 주석과 함께 덮어쓰고 있었다. 이제 **보호 임계값과 소자 정격이 같은 수에서 나온다.**

### 9.3 온도가 앞뒤로 안 맞았다 — 양쪽 모두

```
D78  손실   = R_DS(on) @ 25 °C × I²
D79  요구 Rth = (125 − Ta) / D78          ← Tj = 125 °C 를 가정
```

같은 계산의 분자와 분모가 다른 온도다. 600 V 슈퍼정션은 25 → 125 °C 에서 R_DS(on) 이
대략 **2배**, 저전압 SR FET 은 **1.5배**가 된다. 그만큼 손실이 과소평가되고 **요구 Rth 가
약 2배 후하게** 나온다. **틀린 방향이 위험한 쪽이다.**

SMath 도 같은 함정이 있었다 — `R.dson_req_dc` = 25.3 mΩ 은 *동작 온도* 기준 요구값인데,
사람은 그걸 데이터시트 25 °C 값과 비교한다. 그래서 **25 °C 로 환산한 행**
(`R.dson_req_25_p` · `R.dson_req_25_s`)을 나란히 두고 "이걸로 소싱하라" 고 명시했다.

> **남은 것:** `T_j(max)` 는 `D79`·`D101` 안에 리터럴 125 로 박혀 있다. 입력 셀이 아니다.

### 9.4 2차 손실 모델이 서로 달랐다

워크북은 `Vf·I_avg + rd·I_rms²` — **다이오드 모델**이고 선정 부품도 쇼트키였다.
SMath 는 R 만 쓰는 **SR 모델**이다. 본 설계는 SR(CLAUDE.md 시트 §1.1)이므로 워크북 쪽이
우리 구성이 아니었다. `Conf.SR` 로 둘 다 표현할 수 있게 했다.

**반대쪽 흠도 있다.** SMath 는 SR 전용이라 **데드타임 바디 다이오드 도통을 아예 안 본다.**
센터탭에서는 그 Q_rr 이 스위칭 주기마다 **두 번** 회복된다. 둘 다 SR 데드타임이 있어야
계산되는데 그건 SR 컨트롤러가 정하는 값이라 이 시트의 입력이 아니다.
공진 아래에서는 2차 전류가 스스로 0 이 되어 SR 이 영전류에서 꺼지므로 작지만,
공진 이상에서는 아니다. **양쪽 시트에 "안 본다" 고 적었다. 실측 대상이다.**

> **그리고 공진 위에서는 두 레그가 쉬는 구간 없이 직접 넘겨받는다.** 그 과도 구간에서 누설 인덕턴스 때문에 **둘이 동시에 도통한다.** 겹침 시간은 SR 데드타임과 2차 누설로 정해지므로 어느 식에도 없고, 그 지점이 바로 SR 바디 다이오드가 강제 역회복되는 곳이다. 관련해서 [64] 자체의 절단 오류(부록 C.30, FB 코너 +8 %)도 이번에 함께 고쳤다 — 저입력이 최악이라 수치는 안 움직였다.

### 9.5 값을 만들지 않은 것들

| 항목 | 왜 없나 | 어떻게 쓰나 |
| :--- | :--- | :--- |
| **어느 C_oss 인가** | 데이터시트가 같은 이름으로 셋을 준다 — 표제 `Coss @ 작은 V_DS`, 에너지 등가 `Co(er)`, 시간 등가 `Co(tr)`(= `Qoss`). **3–5배 차이가 난다** | ZVS 는 데드타임에 **전하**를 옮기는 문제다. 써야 할 것은 `Qoss/V_DS`, 즉 `Co(tr)`. 표제 Coss 를 넣으면 데드타임 요구가 몇 배 쉬워 보인다. **어느 것을 넣었는지 부품 옆에 적을 것** |
| **Q_g** | 소자 값 | HOUTx·LOUTx 는 **V_OH = 4 V 로직 출력**이지 드라이버가 아니다. 외부 하프브리지 드라이버가 필수고, `N.mos × n.par × Q_g × V_drv × f.sw` 를 무는 것은 L6790A 가 아니라 **그 드라이버**다 |
| **E_off** | 소자 값 | ZVS 가 없애는 것은 **턴온 손실뿐**이다. 턴오프는 매 사이클 탱크를 상대로 그대로 일어난다. `I.Lm_pk` = 12.36 A 에서 평가할 것 |
| **Q_rr (1차 바디 다이오드)** | 소자 값 | 조건만 명시: **373.4 V · 12.36 A.** 데이터시트 기본값(보통 25 °C, 낮은 dI/dt)이 아니라 이 조건에서 규정할 것. Q_rr 은 25 → 125 °C 에서 대략 2배 |
| **전류 분담 편차** | 부품 편차 | 병렬 행은 **이상적 분담**을 가정한다. 1차(슈퍼정션)는 R_DS(on) 산포로 가장 뜨거운 소자가 더 먹으므로 **약 20 % 여유**를 두거나 binning 할 것. 2차 SR 은 R_DS(on) 이 온도와 함께 올라가 **스스로 분담한다** |

### 9.6 병렬 개수는 전류가 아니라 예산이 정했다

1차 `n.par = 2` 는 전류 정격 때문이 아니다. 소자 1개당 실효는 3.85 A 뿐이다.
결정한 것은 **손실 예산**이다 — HB 모핑 모드에서 LOUT2 가 계속 High 라 **레그 2 로우사이드가
탱크 전류 전체(10.9 A rms)를 연속으로 흘린다.** 600 V 슈퍼정션이 오늘 줄 수 있는 최선인
24 mΩ(25 °C, 열간 48 mΩ)로도 1개면 **5.7 W** — 3 W 예산을 넘는다. 2 병렬이면 2.85 W.

> **워크북에는 이 정적 소자 행이 없다.** `D78`·`D79` 는 *스위칭* 소자를 설명하므로
> 워크북의 열 답은 **더 시원한 쪽**에 대한 것이다. SMath `P.mos_dev` = 1.426 W 가
> 방열 설계의 기준이다. 이 한계는 워크북 CHANGELOG 82행에 적어 두었다.
