yohan924-ops/L6790A-Single-Stage-PFC-LLC-Converter/PQ50/docs/HISTORY.md

# HISTORY — L6790A 단일단 PF LLC 프로젝트의 근거 문서

**이 문서의 역할.** `CLAUDE.md`는 "무엇을 하면 되는가"만 담는다. 이 문서는 **"왜 그렇게 정했는가"**다.
근거·검증 이력·발견한 오류 전부·사고 기록이 여기 있다.

**언제 읽나:** 어떤 값이나 판단의 근거가 필요할 때, 또는 "이거 이미 확인한 건가?"가 궁금할 때.
평소에는 읽을 필요 없다.

---

## 1. 검증 이력 — **다시 하지 말 것**

### 1.1 식 전수 대조

**설계 가이드 식 [1]–[148] 전체를 6회 독립 재구현으로 대조했다. 불일치 0건.**

- 기준 구현: `Design Guide/generators/l6790.py` (식 [1]–[106] + θ 스윕)
- 대조 스크립트: `l6790_validate.py` — 240 W 예제를 재현하는지 한 번에 찍는다
- 6회차 대조 결과: 스칼라 28개 전부 일치 · `f_sw(θ)` 표 25칸 전부 0.1 kHz 이내 ·
  `[38a]` T_ZC 스윕 20칸 전부 일치 · 최악 코너 전류 6종 소수 3자리까지 일치

### 1.2 개별 검증 항목

| 항목 | 결과 |
| :--- | :--- |
| FHA 실제 동작점 | 수치해와 일치 |
| 위상식 [37] | 탱크 입력 임피던스 위상과 10⁻¹⁶ 수준 동일 |
| 파형 수치적분 | [63] 엄밀 · [64]의 √d 엄밀 · 합성 탱크 피크 일치 |
| 제어 루프 (240 W 예제) | f_cross 19.76 Hz · Φ_M 49.09° · D_3rd 4.54 % |
| EVL6790_670W 역산 | 보드 주석까지 재현 — λ_act 0.5000 · f_o 88.05 kHz · f_r 152.5 kHz · R_CS,max1 24.07 mΩ(실장 23.4 mΩ) · OCP1 여유 23 % |
| Cardano k=1 분기 | λ 0.35–0.80 × Q_pk 0.2–1.4 × 등가입력 6종 × θ 2°~90°, **6,089건 전수 · 예외 0 · 오차 4.8e-14** |
| 닫힌형 vs bracketed solver | 5개 코너 × θ 2°~90° 전 구간, **최대 오차 2.9e-15 · 실패 0** |
| SMath 시트 ↔ `l6790.py` | 22개 항목 자동 대조, 불일치 0 (`build_l6790_smath.py` 실행 시 매번) |
| 엑셀 ↔ SMath 전량 | **101개 값 대조, 차이 0** (의도된 차이 4건은 시트 §3.5) |
| 엑셀 ↔ SMath BOM | **29개 항목, 차이 0** (`bom_compare.py`) |

### 1.3 SMath 실행 검증

**2026-08-21 사용자가 SMath에서 직접 열고 F9까지 돌린 뒤 저장했다** (파일 revision 8).
저장된 `<result>` 값이 `l6790.py`와 일치하므로 **SMath 엔진이 시트를 우리 의도대로 계산한다는
독립 확인**이 끝났다. 붉은 리전 없음, 겹침 0.

---

### 1.4 검사 범위 — 무엇이 닫혔고 무엇이 안 닫혔나

**"다 찾았다"고 말할 수 없다.** 닫힌 것과 안 본 것을 구분해 둔다. 2026-08-23 기준.

#### 전수 확인이 끝난 것 (그 부류 안에서는 더 나올 것이 없다)

| 무엇 | 규모 | 결과 |
| :--- | ---: | :--- |
| SMath RPN 왕복 (`audit_rpn.py`) | 485식 | 불일치 0 — **SMath 가 인쇄된 값 그대로 계산한다** |
| SMath 차원 해석 (`audit_dim.py`) | 485식 | 충돌 0 · 표시 단위 불일치 0 |
| SMath 구조 (`audit_sm.py`) | 변수 328개 | 죽은 변수·정의 전 사용·검사 없는 한계 전부 해소 |
| 판정 지표가 시트 §17 요약에 나오는가 | 33개 | 33/33 |
| 엑셀 ↔ SMath 값 대조 (`xl_sm_compare.py`) | **135항목** | 일치 101 · 의도된 차이 31 · 나머지 3은 캐시 지연뿐 |
| BOM 대조 (`bom_compare.py`) | 29항목 | 차이 0 |
| 워크북 구조 (`audit_xl.py`) | 설계 시트 수식 781개 | 7개 부류 전수 |
| 워크북 캐시 오류값 | 전 시트 | 54개, **전부** RTC 행 29 의 의도적 `NA()` 차트 마스킹 |
| 보상망 이분법 수렴 | 27회 반복 | 독립 수치해와 0.013 % 이내 (17.564 vs 17.562 Hz) |
| `RTC` 격자가 선정 권선비를 쓰는가 | 2,803셀 | 가드 없는 셀 **0개** — C.5 수정이 완전하다 |
| **`RTC` 격자탐색의 답** (`rtc_check.py`) | **18점** (θ 6 × 입력 3) | Cardano·이분법과 **최대 0.197 %** — 격자 한 칸(2.199 kHz)의 14 %. 요구 게인 `M_req`는 18점 전부 0.000 % |

#### 아직 안 본 것 — 여기서 더 나온다면 이 중 하나다

| 무엇 | 규모 | 왜 안 봤나 |
| :--- | ---: | :--- |
| `RTC` 시트의 나머지 셀 | 수식 **10,008개** 중 설계에 안 쓰이는 부분 | **우선순위가 내려갔다(2026-08-23).** RTC가 설계에 영향을 주는 경로는 **셀 9개뿐**이고(`CC` 9수식 + `Device Setting` D2, 서로 겹침) 그 9개가 전부 `rtc_check.py` 18점 안에 들어 있다. 나머지는 차트 23장의 데이터다. 골격 750종의 전수 확인은 여전히 안 했다 |
| **`OutCap_Sel_DB`** | 수식 **3,172개** | 설계가 참조하지 않는다(시트 §3.2). 그래서 틀려도 지금은 영향이 없지만, 누가 쓰면 그때 드러난다 |
| **워크북의 차원 해석** | 수식 781개 | SMath 쪽만 했다. 엑셀은 수식 파서가 필요해 아직 없다 — `10^-6` 하나가 빠져도 잡을 방법이 없다 |
| 수식에 박아 넣은 상수 | 207건 | `audit_xl.py` 가 세기만 하고 검토하지 않았다 |
| 부록 C.9 의 근거 불명 상수 | 4개 | \[28\] 의 π²/8, \[36\] 의 지수 5, \[128\] 의 0.744, `K_HV`. **ST 문서에 근거가 없다** |
| 240 W 예제 전반 | 가이드 전체 | `R_P` 만 정정했다. 다른 반올림 방향 오류가 더 있을 수 있다 |
| `T_idle` | 1개 | 실측 전까지 확정 불가 (시트 §4) |

#### 그리고 이것이 원리적 한계다

**여기 있는 검사는 전부 *일관성* 검사다. *정확성* 검사가 아니다.**

`l6790.py` · SMath 시트 · 스프레드시트 셋이 같은 답을 낸다는 것은, 셋이 같은 식을 구현했다는
뜻이지 그 식이 물리적으로 옳다는 뜻이 아니다. **C.18 과 \[70a\] CT 결함은 일관성 검사로
찾은 것이 아니다** — 물리와 어긋나서 찾았다. θ=π/4 를 라인사이클 실효값이라 부르는 것은
세 구현이 모두 그렇게 했더라도 여전히 틀렸을 것이다.

> 그러므로 남은 위험의 대부분은 **셀이 아니라 모델에** 있다. 실측(`CLAUDE.md` 시트 §4.3)이 그것을 판정하는
> 유일한 수단이다.

### 1.5 240 W 예제 — 삭제 전 보존한 검증 기준

**2026-08-24.** 가이드 rev 2.0 에서 240 W / 60 V 예제를 **완전히 삭제**한다(사용자 결정).
그 예제는 `l6790.py` 가 지금까지 받은 **유일한 독립 검증**이었다 — ST 가 낸 수치를 우리
구현이 재현하는지 보는 것. `l6790_validate.py` 는 아래 29개 값을 코드 안에 갖고 있으므로
가이드에서 지워도 **검사는 계속 돈다.** 지워지는 것은 그 값들의 **출처**다. 그래서 여기 남긴다.

```
설계 조건   Vout 60 V · Pout 240 W · Nrect 2 (FB) · Cr 33 nF · Lr 34 uH · Lm 65 uH · n 2.5

Pin_LLC 244.90 W   Iin_max 2.721 A    Pd_BR 0.984 W    Pd_EMI 1.111 W   Pin 246.99 W
Vin_min 173.24 V   n_calc 2.519       MVmin 1.2245     MVmax 0.8035
l1 0.2445          l2 0.4401          lTD 0.5413       lam 0.5413       Rac 37.24 ohm
Qz1 0.9736         Qz2 4.073          Qz 0.8466        Z0 31.52 ohm     Cr_c 33.66 nF
lam_a 0.5231       nT 3.085           Z0s 32.10 ohm    Z0p 54.77 ohm
fr 150.25 kHz      fo 88.05 kHz       Lmu 80.22 uH     LL1 18.78 uH     LL2 1.973 uH
Qpk 0.862

라인사이클 (최악 코너 173.24 Vac 등가, 전부하)
  Isec 6.185 A   Idio 4.374 A   Ipri 3.760 A   ICout 4.72 A
  Isec_pk 15.42 A   Itr 6.169 A   ILm 3.840 A   comp 6.660 A   Tzc 246 ns
```

> **▷ 이 값들이 왜 중요한가.** 우리 25 V 설계에는 대조할 상대가 없다 — ST 가 25 V 예제를
> 낸 적이 없다. `l6790.py` 가 맞다는 근거는 **오직 이 240 W 예제를 재현한다는 것뿐**이고,
> 그 위에 SMath·워크북 삼중 대조가 얹혀 있다. 그러므로 `l6790_validate.py` 를 **절대
> 지우지 말 것.** 예제가 문서에서 사라져도 검사는 남아야 한다.

## 2. 닫힌형 해 — 이 프로젝트의 방법론적 발견

가이드 §4.2/부록 B.2는 `M(f_n,Q) = M_req`를 **수치적으로** 풀되 근이 두 개(용량성/유도성)이므로
반드시 큰 쪽을 잡으라고 경고한다. **이 방정식은 애초에 수치로 풀 필요가 없다.**

`M_req = M_pk/sinθ`, `Q = Q_pk sin²θ`를 [2]에 넣고 `x = 1/f_n²`로 정리하면 **x에 대한 3차식**:

```
λ² x³ + (q − 2λ(1+λ)) x² + ((1+λ)² − 2q − u/M_pk²) x + q = 0 ,   u = sin²θ , q = Q_pk² u²
```

- 근의 곱 = −q/λ² < 0, 근의 합 > 0 → **세 근은 항상 실근이고 정확히 하나만 음수**
- 따라서 물리적(유도성) 근은 **언제나 "가운데 근"** — 분기 판정 자체가 필요 없다
- Cardano 삼각함수형의 **k = 1 분기** `w·cos(ang − 2π/3) − a₂/3` 가 항상 그 근이다
  (6,089건 전수 확인, 시트 §1.2)

**의의:** 근 탐색·격자 해상도·초기값 문제가 **전부 사라진다.** ST 툴은 `RTC`에서 83칸 격자를
훑고 인접 두 칸 사이를 선형보간해 답을 얻는다 — 닫힌형에는 그 잔차(현재 최대 0.197 %)조차
없다.
역방향(주어진 f_n에 대한 sin²θ)은 2차식이며 역시 기계정밀도.

> **미반영:** 가이드 §4.2·부록 B.2가 아직 수치해 방식으로 서술되어 있다. rev 2.0에서 역이식할 것.

### 2.1 합성 탱크 피크의 닫힌형

`i_Lr(x) = I_Lm,pk(2x−1) + I_trafo,pk·sin πx` 의 최대는 `cos πx = −z`, `z = 2·I_Lm,pk/(π·I_trafo,pk)`
에서 발생 →

```
I_Lr,pk = I_Lm,pk·(2·acos(−z)/π − 1) + I_trafo,pk·√(1−z²)
```

격자 최대값과 **7e-6 A 이내 일치**. 스프레드시트 `Device Setting` D32가 이 식을 쓴다.

---

## 3. 발견한 오류 전부

### 3.1 데이터시트 (DRAFT, 2026-04-30)

| # | 위치 | 내용 |
| :-- | :--- | :--- |
| C.1 | T_idle | **3중 모순.** 시트 §5.3.2 `C_T,max` 식의 700 ns = 2·T_idle → 350 ns / 같은 절 `f_sw_min/max/SU` 식의 700 ns = T_idle 그 자체 → 700 ns / **Table 5 실측표 8칸 역산 → 250 ns** (시트 §4) |
| C.2 | V_BO | min/max 표기 뒤바뀜 |
| C.3 | 전류 규격 | peak/rms 혼용 |
| C.6 | 시트 §5.3.2 | 상수 **541.34 µA/V** = `(400 + 412.0)/1.5` — Table 5의 `I_OSC_SU = 412.5 µA`와 어긋난다(541.67이어야 함). 툴 전용 오차로 알려졌던 412 µA가 **DS 자신의 식에도 있다** |
| C.7 | 시트 §5.3.4 | `R_ZCD,L` 차원 오류 |
| — | 시트 §5.3.1 | 본문은 "a strong pull down on **LOUT1**"이라 쓰지만 Table 6의 열 제목과 실제 핀스트랩 동작은 **LOUT2**다. EVL 보드도 LOUT2 풀다운(R7 100 k)을 미실장하여 morphing을 쓴다 → **본문 오타** |

### 3.2 ST 스프레드시트 r1.0 — rev 0.6에서 수정 완료

| # | 위치 | 내용 |
| :-- | :--- | :--- |
| C.5 | `Res.Tank!D9` + **RTC 2,803셀** | N_rect=2에서 권선비 2배. 두 곳을 함께 고쳐야 한다 |
| C.6 | `D35` `D60` `CC!D26/E26` | 평균전력/rms/참조 오류 |
| C.8 | 14건 | `Design Spec!D20/D79` 등가입력 · `Device Setting!D83` /N_rect · `CC!C25` √d 누락 · `CC!C31` 2f_l 누락 · `Comp!D15/D43` CTR 이중 |
| C.10 | 3건 | `Device Setting!D3` 누락된 max · `Preliminary!D17` η 오라벨 · `Comp!D42` I_min |

**셀 수정으로는 못 고친다고 적었던 구조적 한계 — 셋은 철회됐고 둘이 남았다:**

- ~~`RTC`의 f_n 격자 상한 1.3703 — f_sw,max가 격자 밖~~ → **틀린 기록. 2026-08-23 철회.**
  1.3703은 격자가 아니라 `fn.max`(RTC 행 26 = √(λ/(1+λ−1/M)), 현재 **1.34178**)였다.
  격자 축은 행 25이고 `CG25 = 1.5·CG26` = **2.0127** = 305.4 kHz까지 간다. 우리 f_sw,max
  249.6 kHz는 f_n 1.6448이므로 **격자 안**이다. 격자의 실제 오차원은 상한이 아니라
  **해상도**이며, 칸 간격 f_r/69 = 2.199 kHz에 선형보간이 붙어 잔차는 0.2 % 미만이다.
  **2026-09-22: 상한 숫자는 그 뒤로 움직였다** — `CG26` 은 세 후보의 MAX 라 입력이 바뀌면 따라
  움직이고, 지금 워크북을 열어 보면 `CG26` 1.5251 · **`CG25` 2.2877** 이다. `CLAUDE.md` 는
  한때 2.2241 이라고 적고 있었다 — **세 숫자가 다 다르고 전부 어느 시점의 스냅숏이다.**
  **결론만 그대로다**(1.6448 < 상한). 이 값을 문서에 다시 박지 말 것 — 셀에서 읽으면 된다
- ~~`CC`의 3점 θ 평가~~ → **틀린 기록. 2026-08-23 철회** (시트 §3.7 원인 B). `RTC`가 이미 θ를
  6점 풀고 있었으므로 `CC`에 열 F·G·H와 J열 심프슨 적분을 넣어 닫았다. 뱅크 리플전류
  21.77 → **30.17 A**. "스프레드시트로는 적분을 못 한다"는 판단이 틀렸던 것이다
- `OutCap_Sel_DB` 미참조 · `D48` 죽은 셀 · `D77`의 c_HB 미피드백 · `B113` 빈 절
- ~~**`Device Setting` D2의 주파수 상한은 `RTC!BD212`, 즉 V_in,max = 264 Vac에서의 값이다.**~~
  → **틀린 기록. 2026-08-23 철회** (시트 §3.7 원인 E). 격자 탐색을 Cardano 닫힌형 18블록으로
  바꾸고 `RTC!C9`를 `MAX(D79, D81)`로 연결해, 시트가 계산만 해 두고 안 쓰던 `Design Spec`
  D81 = 332.34 V가 실제로 쓰이게 했다. f_sw,max 189.3 → **249.6 kHz**.
  670 W 실험의 툴 189.1 kHz vs 실제 249.8 kHz는 수정 전 상태를 말한 것이다
- **`Res. Tank Design` D30의 ZVS는 V_in,min·전부하 한 점만 본다.** 진짜 최악은 대개
  FB 코너의 경부하다 (670 W 실험: 툴 309.6 ns vs 전 영역 스윕 최악 375 ns @ 332.3 Vac·25 %)

> **그래서 스프레드시트는 정본이 아니다.** 정본은 `l6790.py`와 SMath 시트다.

### 3.3 ST 스프레드시트 — 보상망 시트 (C.12 · C.13, 2026-08-21 신규)

`CompensationNet&Check` [133]–[148] **26개 식을 셀 단위로 전부 대조했다. 수식 자체는 26개 모두
가이드와 일치**한다 (`D37 D38 D41 D42 D43 D64 D65 D66 D67 D72 D73 D74 D78 D83 D84 D85 D86
D93 D94 D95 D96 D101 D102 D103 D104 D128 D129`). 회로 토폴로지도 동일 — 시트에 박혀 있는
도면(H14, 894×531 px)을 추출해 확인했고 SMath 시트 §16 첫머리에 실려 있다
(`Design Guide/figures/comp_network_st.png`).

**그러나 루프 검증부에 결함이 2건 있다.**

| # | 위치 | 내용 | 영향 |
| :-- | :--- | :--- | :--- |
| **C.12** | `CN!H132/H134/H139`, 이분법 `H141:N167`, `D124` | **고주파 극점 `f_px`가 통째로 빠져 있다.** 이득·위상·교차주파수 모두 `f_z`·`f_p`만으로 계산 | 교차 근방에서 위상 약 **0.8–1.1° 낙관** |
| **C.13** | `CN!D73` | 라벨은 *"Required E/A Gain @ 2fLmin"* 인데 분모가 **`D65`(공칭 f_l의 리플)**다. `D68`이 바로 아래에서 f_l,min 리플을 계산해 놓고도 **어디에서도 참조되지 않는다.** `D125`도 `AV122 = 2·D110`(공칭 f_l)에서 읽는다 | 50/47 = **1.064배 낙관.** 3차 고조파 예산이 그만큼 헐거워진다 |

두 건 모두 **SMath 시트는 보수적인 쪽으로 이미 고쳐져 있다**(시트 §16.4, `f.line_min` 전면 적용).
차이는 시트 §16.7 표에 명시. 부수 확인: `D64`의 계수 `2·K_HV/(K_M·K_FF)` = 2×0.00334/(0.2×0.2)
= **0.167 V/(Ω·W)** 로 [122]와 정확히 일치.

### 3.4 ST 스프레드시트 — ISEN 블록 (C.14~C.17, 2026-08-21 신규)

**부록 C.8·C.10에도, `CHANGELOG_rev0_6`에도 없던 항목이다.** rev 0.6에서 Device Setting은
D3와 D83만 고쳤고 ISEN 블록(D38~D48)은 손대지 않았다.

- **C.14 — `D39 R.CS.max2`의 분모가 `I_trafo,pk`다.** R_CS는 브리지 리턴에 있으므로
  자화 성분을 포함한 **합성 탱크 전류 피크**를 본다. 670 W 실험: 16.90 대신 **18.62 A** →
  32.54가 아니라 **29.54 mΩ**. **1.10배 낙관.** 최대전력 조건이 지배하는 설계에서는 결과가
  안 바뀌지만, λ가 크거나 반사 전압이 높아 D39가 지배하면 그대로 위험하다.
- **C.15 — `D45`는 라벨이 "Select…"인데 수식 셀이다.** `(3/220+1/440)^-1` = 62.857 mΩ는
  **EVL 보드의 220‖220‖220‖440 실장망을 박아 넣은 상수**이고, 거기에 D43을 곱해 뒤의
  `D46 = D45/D43`이 같은 값을 다시 뱉게 해 놓았다. **계산이 아니라 상수 왕복이므로 사양을
  무엇으로 바꿔도 R_CS는 영원히 62.857 mΩ이다.** 게다가 `D46 = D45/D43`은 "동일 저항 D43개
  병렬"을 전제하는데 실제 망은 220 3개 + 440 1개다. 결정적으로 **D45(188.57)가 바로 위
  D44(72.20)를 2.6배 위반해도 경고가 없다** — 240 W 원본에서는 D44 = 204.05 > 188.57이라
  우연히 통과했을 뿐이다.
- **C.16 — `D33`의 전류 기준이 틀렸다.** `MAX(CC!C29, Prelim!D11)`인데 `CC!C29`는
  **θ = π/4 한 점**의 스위칭주기 실효값이다. 670 W 실험에서 10.239 A. 라인사이클 실효는
  10.880 A(손실의 물리적 정답), 가이드가 쓰는 최악 스위칭주기(θ=π/2)는 13.932 A.
  **툴 값은 둘 중 어느 것도 아니다.** R_CS = 24 mΩ에서 2.52 / 2.84 / 4.66 W →
  1 W 부품 **3개가 아니라 5개**가 맞다.
- **C.17 — OCP가 아예 없다.** 워크북 전체에 `0.75`(V_OCP2)도 "OCP"라는 문자열도 어떤 수식·
  라벨에도 없다. R_CS를 고른 뒤 **OCP가 몇 A에서 트립하는지 시트가 알려주지 않는다.**
  670 W 실험에서 62.86 mΩ이 조용히 살아남은 이유가 이것이다 — I_OCP1 = 8.75 A인데 실제
  합성 피크는 18.62 A로 상시 트립인데도 시트 어디에도 그 사실이 안 나온다.

**▷ 스프레드시트에 반영 완료 (2026-08-21).** `Device Setting` 9셀 수정 + 11셀 신설:

| 셀 | 전 | 후 |
| :--- | :--- | :--- |
| D32 | `=CC!E27` (I_trafo,pk) | 합성 피크 **닫힌형** (시트 §2.1) |
| D33 | `MAX(CC!C29,…)` θ=π/4 | `MAX(CC!E29,…)` θ=π/2 |
| D44 | (그대로) | `=MIN(D38,D39)*D43` — 단일 저항의 **상한** |
| D45 | `=D43*(3/220+1/440)^-1` | `=LOOKUP(D44/10^INT(LOG10(D44)),{E24 24개})*10^INT(LOG10(D44))` — 상한 이하 최대 **E24 실물값**. 실제 선택은 F45(노란 셀) |
| F45 / D43 / D46 | 텍스트 / 3 / `=D45/D43` | **120** / 5 / `=IF(ISNUMBER(F45),F45,D45)/D43` |
| F61 | 78 kΩ | **30 kΩ** — R_BM ∝ R_CS이므로 D61 상한이 78.7 → 30.1 kΩ. 안 고치면 버스트 진입이 75 → 195 W |
| D49·G49·D50 (신설) | 없음 | `I.OCP1 = 0.55/R.CS` · `I.OCP2 = 0.75/R.CS` · `k.OCP1 = I.OCP1/D32` |

### 3.4b ST 스프레드시트 — θ=π/4 를 "라인사이클"이라 부른다 (C.18, 2026-08-23 신규)

> **정정.** 이전 판의 시트 §3.6 표는 `Power Components` D28(I_Cout)의 차이를 **[70a] CT 결함**
> 탓으로 적었다. **틀렸다.** `CC!C31 = √(0.5·d·I_sec,pk² − I_o,inst² + I_out²/2)` 의
> `0.5·d·I_sec,pk²` 는 이미 **노드** 평균제곱이다(권선당 값의 2배). 워크북은 CT 함정에
> 빠지지 않는다. 실제 원인은 아래 C.18 — 그 열 전체가 θ=π/4 한 점이라는 것이다.
> **[70a] CT 결함은 가이드 본문의 문제이고(시트 §3.5), 워크북의 문제가 아니다.**

`CC` 시트는 θ 를 **세 점(π/4, π/3, π/2)** 에서만 평가한다. 그 중 **θ=π/4 열(C열)** 이
여러 곳에서 *"(mains cycle)"* 라벨을 달고 라인사이클 실효값 행세를 한다:

| 셀 | 참조 | 라벨 | 실제 내용 |
| :--- | :--- | :--- | :--- |
| `Res. Tank Design` D65 | `=CC!C29` | Ipri.rms **(mains cycle)** | θ=π/4 한 점의 스위칭주기 실효값 |
| `Res. Tank Design` D67 | `=CC!C25` | Isec.rms **(mains cycle)** | 같음 |
| `Power Components` D60·D61 | `=CC!C29`·`=CC!C30` | Ipri.rms / per mos | 같음 → **D78 손실식으로 들어간다** |
| `Power Components` D84·D85 | `=CC!C25`·`=CC!C26` | Isec.rms / Idiode.rms | 같음 → **D100 손실식으로 들어간다** |

**왜 θ=π/4 인가.** 포락선이 정확히 `sin θ` 라면 그 점의 값이 라인사이클 실효값과 같아진다
(`sin(π/4) = 1/√2`). 근거 없는 선택이 아니라 **의도된 근사**다.

**그런데 실제 포락선은 `sin²θ` 다.** `I_out,inst = 2·I_out·sin²θ` 이므로 근사가 성립하지 않는다.
`l6790.py` 의 5점 Simpson 적분과 대조하면:

```
                θ=π/4 한 점      라인사이클 실효      차이
  I_pri          10.302 A         10.912 A        +5.9 %
  I_diode(권선당) 24.146 A         28.401 A       +17.6 %
```

**손실은 전류의 제곱이므로 영향이 커진다:**

```
  D100 Pdiss_d   7.93 W  ->  10.98 W   (1.38 배)
  D101 필요 Rth  12.60   ->   9.11 °C/W
  D78  Pdiss.s   2.65 W  ->   2.98 W   (1.12 배)
```

**▷ 스프레드시트에 반영 완료 (2026-08-23).** `CC` 시트는 θ 열이 3개뿐이라 적분이 불가능하다.
그래서 워크북 자신의 패턴을 따랐다 — 계산 열은 근사를 유지하되 **라벨을 `@θ=π/4 (approx.)`
로 정정**하고, F열에 SMath 시트의 라인사이클 실효값을 받는 **노란 입력 셀을 신설**했다
(F60 10.90 / F61 7.707 / F84·F85 28.31 A). 손실식 D78·D100 은
`IF(ISNUMBER(F..), F.., D..)` 로 선정값을 우선한다.

> **SMath 시트는 처음부터 5점 Simpson 라인사이클 실효값을 쓴다** (시트 §10). 영향 없음.

### 3.4c 2026-08-23 — 남아 있던 워크북 오류 전부 반영

`xl_sm_compare.py` 로 101항목을 대조하며 "아직 안 고친 것"을 뒤졌다. 넷이 남아 있었다.

| # | 무엇 | 어떻게 고쳤나 |
| :-- | :--- | :--- |
| **C.12** | 고주파 극점 `f_px` 가 `D104` 에 계산만 되고 **어디에서도 참조되지 않는다** | 루프 검증식 **196셀**에 f_px 항 삽입 — 이득 120개에 `/(1+(f/f_px)²)`, 위상 76개에 `−atan(f/f_px)`. 공유 수식이라 **마스터 7개**만 고치면 전체가 따라온다 |
| **C.13** | `D73` 이 `D65`(공칭 f_l 리플)로 나눈다. `D68`(f_l,min)이 계산되고도 미참조 | 분모를 `D68` 로 |
| **입력** | `Design Spec` D46·D47 이 ST 툴 기본값 500 pF / 270 ns | **800 pF / 220 ns** — 본 설계의 실제 선정 소자. SMath 는 처음부터 이 값이었다 |
| **입력** | `Device Setting` D13 T_idle = 350 ns, SMath 는 250 ns | **250 ns 로 통일.** 두 문서가 같은 값을 써야 대조가 의미를 갖는다. **실측 전까지 확정 아님** (시트 §4) |

> **⚠ Excel 을 한 번 열어야 한다.** 수식을 바꿨으므로 캐시값이 낡아 있다. 파일에
> `fullCalcOnLoad="1"` 이 설정되어 있으므로 **열기만 하면** 재계산된다. 그 전까지
> `xl_sm_compare.py` 는 옛 값을 비교한다.
>
> 재계산 후 기대: C.12·C.13 계열 **9행**과 T_idle 계열 **5행**이 `INTENDED` 에서
> `same` 으로 바뀌어야 한다. 안 바뀌면 조사할 것.

### 3.4d 구조 감사 — 2026-08-23, C.21 ~ C.24

C.12(계산만 하고 아무도 안 읽는 극점)와 C.15(자기 상한을 2.6배 위반하는 선정값)는 **읽어서
찾은 것이 아니라 구조가 이상해서 찾았다.** 그 두 가지 *모양*을 전 시트에서 기계로 훑도록
`audit_xl.py`(워크북)와 `audit_sm.py`(SMath)를 만들었다. 넷이 더 나왔다.

**`audit_xl.py` 가 보는 것**
① 계산만 하고 아무도 안 읽는 셀 ② 캐시에 남은 오류값 ③ 빈 셀을 읽는 수식
④ **선정값이 자기 한계를 벗어남** ⑤ 셀로도 존재하는 값을 수식에 박아 넣음
⑥ 라벨은 max 인데 수식은 MIN(그 반대도)

**`audit_sm.py` 가 보는 것**
① 계산만 하고 아무도 안 쓰는 변수 ② 정의보다 먼저 쓰임 ③ **한계는 있는데 비교가 없음**
④ 설명 없는 판정값 ⑤ 가이드에는 있는데 시트에 안 보이는 식

#### C.21 `Res. Tank Design` D20 `QZVS.3` — 계산하고 버린다

`D26 QZVS = 1/(1+m)·MIN(D18:D19)` 는 **가이드 [34] 와 정확히 일치**한다 — [34]도
`min(Q_ZVS,1, Q_ZVS,2)` 두 개뿐이다. 그런데 툴은 D20 에 세 번째 값을 계산해 놓고 쓰지 않는다.

역산하면 `Q_ZVS,3 = √(λ(1+λ)) / M_Vmin,pk` = **0.7460**. 우리 설계의 `Q_pk = 0.7717` 은
그보다 3.4 % 크다. 만약 이것이 실제 한계라면 위반이다.

**한계가 아니다 — 두 가지로 직접 확인했다.**

```
FHA 게인 천장 @ Q_pk=0.7717, λ=0.550 : M_peak = 1.4161
요구 게인 M_Vmin                      : M      = 1.2245   -> 여유 15.6 %
[38a] 전 영역 ZVS 스윕                : T_ZC 457 ns vs t_D 220 ns -> 여유 108 %
```

즉 탱크는 요구 게인을 여유 있게 내고 ZVS 도 넉넉하다. `Q_ZVS,3` 는 **근거를 확인할 수 없는
과보수 식**이며(부록 C.9 계열), 그대로 적용하면 Q 를 불필요하게 3 % 낮추게 된다.
**가이드와 SMath 는 [34] 를 따르므로 영향 없다.**

#### C.22 `Device Setting` D24 `RT.min` — 라벨이 정반대다

`f_Min = 1/(2·(C_T·R_T + T_idle))` 은 **R_T 가 커질수록 내려간다.** D24 가 계산하는 값은
`f_Min` 이 `f_o` 와 정확히 같아지는 R_T 이므로, R_T 는 그 **아래**에 있어야 한다.
"min" 이라고 적혀 있으면 R_T 를 올림하게 되고, 그러면 VCO 클램프가 `f_o` 아래로 내려가
용량성 영역 진입을 ACP 보호에만 의존하게 된다 — 설계 규칙이 명시적으로 금지하는 상황이다.

**▷ 정정 완료.** 워크북 `C24` 를 `RT.ceil (NOT a minimum)` 으로, SMath 변수를
`R.T_min` → **`R.T_ceil`** 로 바꾸고 양쪽에 비교 검사를 넣었다
(`k.RT.ceil` / `k.RTd`, 현재 1.022). 선정 11 kΩ 은 상한 11.02 k 아래라 **방향은 원래 맞았다.**

#### C.23 `R_P` 선정값이 자기 상한을 4.3 % 위반 — 가이드 예제도 같다

`R_{P,max} = V_F/I_min` [144] = 1.15/0.8 mA = **1.4375 kΩ**. 그런데 워크북과 SMath 와
**가이드의 240 W 예제까지 전부 1.5 kΩ** 을 쓴다 — 상한을 올림한 것이다.

1.5 kΩ 이면 션트 레귤레이터 캐소드 전류가 `1.15/1.5 = 0.767 mA` 로 최소 0.8 mA 아래로
떨어져 FB 범위 하단에서 조정 능력을 잃는다. **상한은 내림한다.**

**▷ 1.4 kΩ (E96) 로 변경.** 부수 효과로 `R_B` 창이 16.02–18.22 → **15.39–17.41 kΩ** 로
이동하지만 선정 16.5 kΩ 은 여전히 안쪽이고 오히려 여유가 균형 잡혔다
(`k.RB_lo` 1.030 → **1.072**, `k.RB_hi` 1.104 → **1.055**).

#### C.24 `C_in` 선정값이 하한 미달 · 그리고 비교 검사 자체가 없던 곳 3군데

`C_in` 선정 2000 nF, 하한(3 nF/W) 2054 nF — **2.6 % 미달**. → **2200 nF (E6)** 로 변경.

그리고 **한계를 계산해 놓고 비교하지 않는 곳**이 양쪽 문서에 있었다:

| 한계 | 선정값 | 검사가 없었다 | 새 검사 |
| :--- | :--- | :--- | :--- |
| `C.T_max` / `C.T_min` | C_T 470 pF | 없음 | `k.CTd` 1.489 / 워크북 `k.CT` |
| `R.T_ceil` | R_T 11 kΩ | 없음 | `k.RTd` 1.022 / 워크북 `k.RT.ceil` |
| `n.aux_max` | n_aux/n_sec 0.8 | 없음 | `k.auxr` 1.045 / 워크북 `k.naux` |
| `R.P_max` | R_P | 없음 | `k.RP` 1.027 |
| `C.in` (하한) | C_in | 없음 | `k.Cin` 1.071 |

> **한계를 계산만 하고 비교하지 않으면 위반이 조용히 지나간다.** C.15 가 정확히 그 구조였다.
> SMath 판정 지표는 이제 **29개, 전부 통과**.

### 3.4e Phase margin 과 Gain margin

**위상 여유는 원래 양쪽에 다 있었다** — 워크북 `CN!D124 = 180 + AT139`, SMath `Φ.act`.
독립 수치해로 검산하면 **49.275°** 이고 두 문서가 인쇄하는 값과 일치한다(49.28).
다만 워크북 쪽은 `f_px` 극점이 빠져 있었고(C.12), 그것은 오늘 고쳤다.

**이득 여유(gain margin)는 어느 쪽에도 없었다.** 위상 여유만으로는 안정성 논증이 닫히지
않는다 — 이 보상망은 고주파에서 영점 1개 대 극점 2개라 위상이 −270° 로 가고, 따라서
`arg T` 가 **유한 주파수에서 −180° 를 지난다.**

**이분법이 필요 없다.** `atan(f/f_z) = atan(f/f_p) + atan(f/f_px)` 의 양변에 탄젠트를 취하고
`f` 로 나누면 제곱근 하나가 남는다:

```
f_180 = √( f_p·f_px − f_z·(f_p + f_px) )
      = √(49172.6 − 6730.4) = 206.02 Hz          (수치 근 206.013 과 일치)
|T(f_180)| = 0.01935   ->   GM = 34.26 dB
```

근호 안이 음수가 되면 위상이 −180° 에 닿지 않고 이득 여유는 무한대다 — 식 자체가 그 경우를
말해 준다.

**▷ 양쪽에 반영 완료.** SMath 시트 **시트 §16.4b** (`f.180` `T.180` `GM` `GM.t` `k.GM`),
워크북 `CompensationNet&Check` **C130:E134**. 현재 `k.GM` = **3.426** (목표 10 dB).

### 3.4f 반복 구조 감사 — 10라운드, C.25 ~ C.27

한 번 훑고 끝내는 대신 **매 라운드 다른 종류의 결함을 찾도록 검사를 바꿔 가며** 돌렸다.
음성 결과도 결과다 — 무엇을 이미 확인했는지가 남는다.

| 라운드 | 무엇을 찾았나 | 결과 |
| :-- | :--- | :--- |
| 1 | 독립적으로 중복된 입력 (하나만 고치면 조용히 어긋나는 것) | `Config.` 이름 충돌 1건. **배선 오류는 없음** |
| 2 | bulk 시트에서 θ 열들의 구조 불일치 | **C.25** — `CC` 4셀이 잘못된 셀 참조 |
| 3 | `.sm` 의 RPN 을 되읽어 독립 평가 | **475식 전수, 불일치 0** |
| 4 | 차원 해석 (V + A 같은 것, ln 인자의 단위) | **475식 전수, 충돌 0 · 표시 단위 불일치 0** |
| 5 | 아무도 읽지 않는 노란 입력 | `N.mos` · `R.ZCD_H_sel` 2건이 진짜 |
| 6 | 열 골격 일관성을 전 시트로 확대 | C.25 외 새 예외 없음 |
| 7 | 선정값(F)이 있는데 계산값(D)을 읽는 곳 | **C.27** 1건. `RTC` 격자 n 은 **0건**(C.5 수정 완전) |
| 8 | SMath 시트 §19 BOM 이 선정값을 보는지 | 깨끗함. 뒤바뀐 라벨은 워크북 쪽만 |
| 9 | 판정값이 시트 §17 요약에 나오는지 | **31개 중 26개가 안 나왔다** |
| 10 | 가이드 152식을 두 구현과 대조 | **네 식이 SMath 에 없었다** |

#### C.25 `CC` D39·E39·D52·E52 — C.6 수정이 절반만 적용돼 있었다

`IF('Design Spec'!$D$108=1, ...)` 이 정류 구성(`D107`) 대신 **`Vf.BR`(0.08 V)** 를 본다.
0.08 은 1 이 아니므로 조건이 **항상 거짓**이 되어, CT 설계인데도 FB 분기(`/√2`)가 돈다.

`CHANGELOG_rev0_6` 이 이 오류를 C.6 으로 기록하고 **행 26(100 % 부하 블록)만** 고쳤다.
75 % / 50 % 블록의 같은 셀 넷은 남았다. **지금 행 34–54 를 읽는 셀이 하나도 없어 수치 영향이
없다 — 그래서 살아남았다.** 그 블록을 쓰는 순간 권선당 실효값이 29 % 낮게 나온다.

#### C.26 BOM 의 ZCD 저항 설명이 서로 바뀌어 있다

`BOM&Schematics` 행 55 는 `R.ZCD.L`(19 kΩ)을 **"Upper ZCD resistor"**, 행 56 은
`R.ZCD.H`(162 kΩ)를 **"Lower ZCD resistor"** 라고 적는다. 값과 링크는 맞고 **말만 뒤바뀌었다.**

**이 BOM 대로 실장하면 분압비가 뒤집힌다.** OVP1 임계가 27.4 V 가 아니라
`2.3/0.8 × (19/162 + 1) = 3.2 V` 가 되어 **기동 즉시 OVP 로 걸린다.**
SMath 시트 §19 는 정상이다.

#### C.27 BOM 이 선정값 대신 계산값을 읽는 곳

`BOM&Schematics` E37 "Single Rsense value" 가 `Device Setting!D45`(계산된 E24 값)를 읽는다.
워크북의 관용구는 `IF(F,F,D)` 이고 다른 BOM 행은 전부 그것을 쓴다. **현재 D45 와 F45 가 우연히
둘 다 120 mΩ 이라 보이지 않는다.**

> **▷ C.25 · C.26 · C.27 은 셋 다 워크북에 반영됐다** — `CHANGELOG_rev0_6` **행 72 · 73 · 74**.
> 2026-09-02 에 셀을 직접 열어 확인한 현재 상태:
>
> - C.25 → `CC` D39·E39·D52·E52 가 전부 `'Design Spec'!$D$107` 을 본다
> - C.26 → BOM 행 55 = "Lower ZCD resistor (to GND)" · 행 56 = "Upper ZCD resistor
>   (to aux winding)". **이 BOM 대로 실장해도 기동 즉시 OVP 로 걸리지 않는다**
> - C.27 → BOM E37 = `IF('Device Setting'!F45, F45, D45)`
>
> 이 세 건이 시트 §3.4c 의 Phase 4b 목록과 `CLAUDE.md` 시트 §4 표에 빠져 있어서 "반영 안 된 것" 처럼
> 보였다. **C.26 은 라벨 오류라 "계산 결함" 이라는 말에 안 걸리므로 특히 눈에 안 띈다.**

#### 라운드 5 · 9 · 10 에서 SMath 에 채운 것

| 무엇 | 왜 필요했나 |
| :--- | :--- |
| `V.OVP1_act` `V.OVP2_act` `k.OVP1` `k.VCC` — 식 [97][98] | 선정한 ZCD 분압기가 **실제로** 만드는 OVP 임계를 되계산하지 않고 있었다. `R.ZCD_H_sel` 은 BOM 에만 쓰이는 죽은 입력이었다. 워크북은 D94~D99 에 갖고 있다 |
| `N.mos` 를 `P.pri_tot` 에 연결 | `2·R·I²` 의 "2" 가 실은 `N.mos/2` 였다. 입력이 아무 일도 안 하고 있었다 |
| **시트 §17.1 전 판정값 표** | 31개 중 **26개가 시트의 설계 요약에 없었다.** 시트 §14b 깊은 곳에서 실패하면 요약만 읽는 사람에게는 보이지 않는다 |
| `I.R1_pk` `I.R0` `T.T` `k.TT` — 식 [40][41][42] | **ZVS 조건이 둘인데 하나만 검사하고 있었다.** 공진 전류가 아직 흐를 것(`k.ZVS`)과 **천이가 데드타임 안에 끝날 것**(`k.TT`). 두 번째가 통째로 없었다. 현재 T_T = 29.7 ns, k.TT = 7.41 |
| `C.T_min` — 식 [73] | 설계 하한이 없었다. DS 의 270–1000 pF 창과는 다른 조건이다. `k.CTd` 가 이제 양쪽을 본다 (1.489 → 1.446) |
| `N.RCS_req` `k.NRCS` — 식 [82] | 저항 개수가 근거 없는 자유 선택이었다. 최악 스위칭주기 손실 기준으로 4.54 → 5개 필요, 현재 5개 |
| `V.out_SUend` — 식 [99] | 기동이 넘어가는 출력 전압. 75 mF 뱅크의 콜드 스타트 판정에 직접 쓰인다 |

> **판정 지표 23 → 33개.** 전부 통과. 새 검사기 `audit_xl.py` · `audit_sm.py` ·
> `audit_rpn.py` · `audit_dim.py` 가 이 열 라운드를 매번 재현한다.

### 3.7 엑셀 ↔ SMath 의 차이 — 행 18개가 아니라 **원인 6개**다

2026-08-23. 두 수식을 나란히 놓고 전수 대조한 결과다. **각 그룹 안에서 두 식은 글자까지
같고 들어가는 값 하나만 다르며, 뒤의 행들은 첫 행의 하류다.** 행을 세면 문제가 실제보다
많아 보인다. `xl_sm_compare.py` 가 이 태그를 매번 인쇄한다.

| 원인 | 무엇 | 영향 행 | 수정 |
| :-- | :--- | :--- | :--- |
| **A** | **ZVS 를 선정 후 재검산하지 않는다.** `D28` 은 근사식 [36](f_n 0.82111), `D29` 는 선정 Q(0.8466). 실제 동작점은 f_n 0.84006 · Q 0.7717 이고 **툴 자신의 `RTC!BB149` · `RTC!C41` 에 있다** | D30·D35·D36·D37 | 셀 2개 |
| **B** | **C.18 — `CC` 가 θ 를 3점만 본다.** `D65`·`D67`·`D28` 은 각각 `CC!C29`·`C25`·`C31` **한 칸을 그대로 읽는다** | D65·D67·D28·D40 | `CC` 확장 |
| **C** | **검증 블록의 입력 `D110 = 50 Hz`.** 설계 블록(`D7`·`D68`·`D73`·`D83`)은 47 Hz 다 — 47 로 설계하고 50 으로 검증한다 | D125·D126·D128·D129 | **입력 1개** |
| **D** | **홀드업 시작 전압이 공칭 `D14` = 25 V.** 실제 출력은 리플로 24.41–25.59 V 를 오간다 | D22·D33 | 수식 2개 |
| **E** | **`RTC!C9` 가 264 V(AC 최대)를 가리킨다.** 탱크가 보는 최대 등가입력은 `Design Spec!D81` = 332.34 V 이고 **그 셀은 아무도 읽지 않는다**(읽는 곳 0) | D19 | 링크 1개 |
| **F** | **정의가 다르고 양쪽 다 맞다.** 목표 25 V vs 분압기 실현 25.18 V · `CEILING` 적용 여부 · `R_CFG` 는 90 V 절대상한 vs 85 V 설계값 | D23·D42·D108 | 없음 |

> **B 는 "구조적으로 불가능" 이 아니다** — 앞서 그렇게 기록했으나 틀렸다. `RTC` 는 이미 θ 를
> **6점**(15°·30°·45°·60°·75°·90°) 푼다. `CC` 에 3열을 더하고 θ=0 끝점(전류가 0)을 넣어
> 사다리꼴로 적분하면 181점 스윕 대비 **오차 0.35 %** 다. 단순평균은 θ≈0 구간을 빼먹어
> +9.7 % 가 되므로 반드시 끝점을 넣어야 한다.

#### 이 표가 필요했던 이유 — 내가 반복해서 틀린 방식

이 세션에서 나는 차이를 **숫자만 보고** 진단했고 그래서 네 번 틀렸다:

1. `RTC` 를 "설계가 안 쓰는 참고용" 이라고 했다 → 실제로는 `CC` 9수식 + `Device Setting` D2 가 읽는다
2. 개당 리플전류 0.19 A 를 **정격**이라고 했다 → `I.Cout_rms/n.C` 로 계산된 **스트레스**다
3. B 와 E 를 "셀 수정으로는 불가능" 이라고 했다 → 둘 다 가능하다 (위 참조)
4. `ΔV.loop` 를 `CC!D65`("@2fL" 참고 행)에 매핑해 **없는 결함을 만들어냈다** → 설계가 쓰는 것은
   `D68`("@2fLmin") 이고 그 값 1.18430 은 시트와 정확히 같다

**교훈: 두 수식을 나란히 놓고 같은 양인지 먼저 확인할 것.** 숫자 차이는 진단이 아니다.

#### 2026-08-23 워크북에 적용 — A · C · D (`fix_xl_causes.py`)

셀 6개. 전부 **워크북이 이미 갖고 있는 값으로 링크를 바꾼 것**이고 새로 계산한 값은 없다.
순환 참조가 없음을 의존 그래프로 먼저 확인했다.

| 원인 | 셀 | 바꾼 것 | 예상 (재계산 후) |
| :-- | :--- | :--- | :--- |
| A | `Res.Tank D28` | 근사식 [36] → `RTC!$BB$149` | f_n 0.82111 → **0.84006** |
| A | `Res.Tank D29` | Q 두 곳을 `D26`(0.8466) → `RTC!$C$41`(0.7717) | 위상 0.23476 → **0.36621 rad** |
| A | `Res.Tank D30` | 분모를 `Design Spec!D102`(목표 150 kHz) → `D55`(실제 151.748) | T_ZC 303 → **457.2 ns** |
| C | `CC D110` | 50 → **47 Hz** | 3차 고조파 3.86 → **4.31 %** 외 4행 |
| D | `Power D22` | `D14^2` → `(D14−D31/2)^2` | 요구 용량 59.77 → **67.22 mF** |
| D | `Power D33` | 같음 | 홀드업 15.10 → **13.42 ms** |

> **예상값은 SMath 와 소수점까지 같다.** 다만 오늘 "재계산하면 일치한다" 는 예측이 4건 틀린 적이
> 있으므로, **사용자가 Excel 에서 열었다 저장한 뒤 `xl_sm_compare.py` 로 확인해야 확정이다.**

`CHANGELOG_rev0_6` 시트에 3행(76–78)으로 기록했다 — 워크북만 받은 사람도 이유를 알 수 있다.

#### 2026-08-23 워크북에 적용 — B, C.18 을 닫았다 (`fix_xl_cc.py`)

**"스프레드시트로는 적분을 못 한다" 는 판단이 틀렸다.** `RTC` 는 이미 θ 를 **6점**
(π/12 · π/6 · π/4 · π/3 · 5π/12 · π/2, 15° 간격) 푼다. `CC` 가 그중 3점만 읽고 있었을 뿐이다.

| 무엇 | 어디 |
| :--- | :--- |
| θ 열 3개 추가 | `CC` 열 **F**(5π/12) · **G**(π/6) · **H**(π/12), f_sw 를 `RTC!BC150 · BC153 · BC154` 에서 |
| 노드 전류의 제곱 | `CC` **행 32** — 적분에 필요한 양 |
| Simpson 적분 | `CC` **열 J** — 가중치 1,4,2,4,2,4,1 ÷ 18. **θ=0 표본은 정확히 0**(부하가 sin²θ) |
| 설계 연결 | `Res.Tank D65 → CC!J29` · `D67 → CC!J25` · `Power D28 → CC!J31` |

**결과 (721점 스윕 대비):**

```
2차 실효 (권선당)   24.14 -> 28.299 A   오차 −28 %  ->  −0.04 %
뱅크 리플전류       21.77 -> 30.167 A   오차 −28 %  ->  −0.08 %     <- 커패시터 160개를 정하는 값
1차 실효           10.30 -> 10.701 A   오차 −11 %  ->  −1.83 %
뱅크 손실          0.0839 -> 0.1610 W  (SMath 0.161)
```

**1차 전류만 잔차가 남는다.** 자화 전류는 θ=0 에서도 사라지지 않으므로 그 끝점이 0 이 아니다.
그런데 끝점을 f_o 기준으로 외삽하면 **+4.7 % 로 오히려 나빠진다** — θ→0 은 실제로 버스트
영역이라 도달하지 않기 때문이다. 0 이 최선이다. 사다리꼴과 Simpson 을 둘 다 재보고
Simpson 을 택했다 (1차 −1.83 % vs −2.70 %, 나머지는 동일).

> **`CC!C31` 의 `C15^2/2` 항은 그대로 두었다.** `C15 = C14/C5 = 0` 이라 값에 영향이 없지만,
> 그 항이 무엇을 뜻하는지 알아내지 못했다. 새 열에는 `$C$15` 로 고정해 열 C 와 같게 했다.

#### 2026-08-23 워크북 정리 완료 — 대조 134/134, 차이 0

원인 A–F 를 전부 닫았다. 마지막 상태:

```
xl_sm_compare   134항목 — 일치 134 · 의도된 차이 0 · 불일치 0
rtc_check       18점   — 최대 편차 0.0000 %
bom_compare     29항목 — 차이 0
```

| 원인 | 무엇을 했나 | 결과 |
| :-- | :--- | :--- |
| A | `D28`→`RTC!$BB$149`, `D29` 의 Q→`RTC!$C$41`·λ→`D50`, `D30` 분모→`D55` | T_ZC 303 → **457.2 ns** |
| B | `CC` 에 θ 3열(F·G·H) + 행 32 + Simpson 적분(열 J), 설계를 `CC!J..` 로 | 뱅크 리플 21.77 → **30.17 A** |
| B 잔차 | `I28`·`I29` 에 θ=0 끝점(자화 전류), `J29` 에 가중치 1 항 | 1차 실효 −1.83 → **−0.02 %** |
| C | `CC!D110` 50 → **47 Hz** | 3차 고조파 3.86 → 4.31 % |
| D | `Power D22`·`D33` 의 `D14^2` → `(D14−D31/2)^2` | 홀드업 15.10 → **13.42 ms** |
| E | **Cardano 닫힌형 18블록**(RTC 220–234) + `BB149..BB202` 연결, `fn.max` 클램프, `RTC` 행 9 → `MAX(D79,D81)` | f_sw,max 189.3 → **249.6 kHz** · C_T 상한 839 → **699.6 pF** |
| F | 대조 짝 3건이 잘못돼 있던 것 — 워크북은 이미 `D38`(25.177 V)·`D109`(84.85 V)·`D42`(5)를 맞게 갖고 있었다 | 전부 일치 |

**`E` 는 "고칠 수 없다" 고 두 번 기록했으나 둘 다 틀렸다.** 격자 탐색을 닫힌형으로 바꾸니
범위 문제가 사라졌고, 보간 잔차 0.2 % 까지 없어졌다.

#### 남은 흠 — `RTC` 행 26·27 의 `#NUM!` 164칸

`Vin_max` 가 FB 코너로 옮겨가면서 `fn.max = √(λ/(1+λ−1/M))` 이 82칸에서 음수의 제곱근이
됐다. `CG26` 만 3항 MAX 로 클램프해 두었고 나머지는 옛 수식 그대로다.

**기능적 영향은 없다** (2026-08-23 확인):

```
행 26·27 을 그리는 차트        없음
f_n 축(행 25)의 오류           0개   <- 14개 차트가 쓰는 행, 멀쩡
행 26·27 을 읽는 곳            CG25 하나 + 행 27 자기 자신뿐
```

격자 열마다 같은 값을 82번 반복 계산하는 칸들이고, 실제로 쓰이는 것은 `CG26` 하나다.

**공유 수식 마스터를 고치려다 파일이 깨졌다.** `<f t="shared" ref=... si=...>` 의 텍스트만
바꾸는 것은 XML 문법으로는 맞지만 Excel 이 거부한다 — 열 때 "내용에 문제가 있습니다" 가
뜨고 `sheet9.xml` 의 수식과 공유 수식을 통째로 제거하려 한다. `xlsx_patch.validate()` 도,
급히 만든 괄호·셀타입 검사도 이것을 잡지 못했다. **`BACKUP_5` 로 되돌려 복구했다.**

> **교훈: 공유 수식 마스터는 텍스트만 바꾸지 말 것.** 고쳐야 하면 공유를 풀어 각 칸을
> 독립 수식으로 쓰거나, 손대지 말 것. C.12 가 196셀에 성공한 것은 **항을 삽입**한 것이지
> 수식 구조를 바꾼 것이 아니었다.

#### E 는 적용하지 않았다 (철회 — 아래 참조) — 링크를 바꾸면 워크북이 깨진다

`RTC!C9` 를 `Design Spec!D81`(332.34 V)로 돌리면:

```
M_req = 2·n·V_o / (√2 · 332.34) = 0.6383
탱크의 무부하 게인 하한 = 1/(1+λ) = 0.6452        ->  M_req 가 그보다 낮다
RTC 행 26  fn.max = √(λ/(1+λ−1/M)) = √(0.55/−0.0167)  ->  #NUM!
RTC CG25  = 1.5·CG26                              ->  f_n 격자 전체가 죽는다
                                                  ->  RTC · 차트 23장 · CC · 설계
```

**에러가 아니라 물리다.** FB 코너에서 경부하면 어떤 주파수로도 게인을 그 아래로 못 낮추므로
버스트로 가야 하고, 격자는 그런 점을 표현할 수 없다. 고치려면 격자 범위를 `fn.max` 에서
떼어내는 설계 변경이 필요하다. **rev 0.7 의 과제로 남긴다.**

### 3.5 설계 가이드 자체의 오류

- **[70a]는 풀브리지 전용이다 — CT 설계에서 2.8배 과소평가.**
  [70a]의 첫 형태 `√(⟨I_sec,rms²⟩ − I_out²)`에 쓰는 `I_sec,rms`는 **출력 노드로 들어가는
  전류의 실효값**이어야 한다. 그런데 [64]는 N_rect=1(CT)에서 `I_sec,pk√(d/4)`, 즉 **권선
  하나의 실효값**을 준다. CT에서는 두 권선이 번갈아 도통하므로 노드 전류 실효값은
  `I_sec,pk√(d/2)`다.

  | 무엇을 넣느냐 | I_Cout,rms |
  | :--- | ---: |
  | [64]의 CT 값 28.3 A (권선당) | 10.8 A ← **틀림** |
  | 노드 실효값 40.0 A | **30.2 A** ← 맞음 |
  | [70]+2f_l 교차 검증 | 30.2 A ✓ |

  **2.79배.** 240 W 예제는 N_rect=2라 이 결함이 드러나지 않았다. **우리는 CT다.**
  [70]과 [70a]의 두 번째 형태는 원래 맞으므로 그쪽을 정본으로 삼는다.
- [125] [126] [130] [137]의 `G_o`·`EA_o`는 Hz가 아니라 **rad/s**
- [134] [135]는 **선정값** 기준

### 3.6 엑셀과 SMath의 **의도된** 차이 4건

같은 사양을 넣어도 다르게 나오는 곳이다. 전부 SMath가 보수적이다.

| 항목 | 엑셀 | SMath | 사유 |
| :--- | ---: | ---: | :--- |
| 홀드업 시작 전압 | V_out에서 시작 | **V_out − ΔV_pp/2** | 리플 골(θ=45°)에서 AC가 끊기는 것이 최악. 툴이 **13.2 % 낙관** |
| I_Cout,rms | 21.8 A | **30.2 A** | **C.18** — `CC!C31`의 수식은 옳다(노드 실효값을 제곱한다). 그 열이 θ=π/4 한 점인 것이 원인 |
| f_sw 최대 | 189.3 kHz | **249.6 kHz** | 툴은 264 Vac를, SMath는 FB morphing 경계(등가 332.3 Vac)를 본다 |
| ZVS T_ZC | 303 ns 한 점 | **457 ns 전 영역 최악** | 툴은 V_in,min·전부하 한 점, SMath는 [38a] 전 영역 스윕 |

추가로 C.12(f_px 누락, Φ_M 약 1° 낙관), C.13(f_l vs f_l,min), C.18(θ=π/4 근사)도 SMath 쪽이 맞다.

**전체 대조는 `xl_sm_compare.py` 가 자동으로 한다** — 사양·전력예산·탱크·전류·출력뱅크·
IC 정수·루프·보상망에 걸쳐 **101 항목**. 2026-08-23 기준 **일치 79 · 의도된 차이 22 ·
불일치 0**. 의도된 차이는 전부 행마다 사유가 붙어 있으므로, 새 세션이 같은 22건을 다시
조사할 필요가 없다.

---

## 4. T_idle — 증거는 250 ns 쪽이지만 **확정 아님**

DS Table 5의 `fosc` 행 **8개 값 전부**(RT/CT 4조합 × min/max 2열)를 역산했다.

| RT / CT | min 열에서 역산 | **max 열에서 역산** |
| :--- | ---: | ---: |
| 10 k / 330 p | 251.1 ns | **250.0 ns** |
| 20 k / 330 p | 249.3 ns | **249.9 ns** |
| 10 k / 560 p | 248.0 ns | **250.2 ns** |
| 20 k / 560 p | 241.6 ns | **250.1 ns** |

max 열은 `I_EA,max` 경로가 추가로 들어가는 **다른 식**인데도 4개가 **250.0 ns에 0.2 ns 이내로
일치**한다. 우연일 수 없다.

**판단:** 실리콘 값은 250 ns일 가능성이 높고, 시트 §5.3.2의 700 ns는 한 상수를 두 자리에 잘못 쓴
것으로 보인다. **확정은 실측으로만 한다.** 그때까지 마진 확인은 700 ns(가장 보수적)로,
성능 예측은 250 ns로 병기한다.

**왜 중요한가** — f_o 90.4 kHz, f_sw,max,op 249.6 kHz, C_T = 470 pF 기준:

| T_idle | R_T = 13 kΩ → f_Min / f_Max | R_T = 11 kΩ → f_Min / f_Max | f_Max 여유 |
| :--- | :--- | :--- | ---: |
| 250 ns | 78.6 k / 309.0 k | 92.3 k / **319.6 k** | **+28 %** |
| 350 ns | 77.4 k / 291.1 k | 90.6 k / 300.4 k | +20 % |
| **700 ns** | 73.4 k / 241.8 k | 85.2 k / **248.2 k** | **−0.6 %** |

- **T_idle = 700 ns라면 FB morphing 경계 전부하 운전이 VCO 상한에 걸린다.**
  회피책: f_r을 150 → 130 kHz 부근으로 내려 주파수 범위 전체를 스케일 다운
- R_T = 13 kΩ에서는 f_Min이 f_o보다 **낮아** 용량성 영역 진입을 클램프로 못 막고 ACP 보호에만
  의존하게 된다. **R_T = 11 kΩ**이면 f_Min/f_o = 1.02–1.04로 클램프가 f_o 위에 놓인다

---

## 5. 하드웨어 분석 기록

### 5.1 ST 평가보드 EVL6790_670W

**ST 자신도 OLED 레일을 단일단 LLC로 직접 만들지 않는다.** 마더보드 회로도의 부하 주석:
48 V 중간 버스를 만든 뒤 후단 벅 3개 —

- BUCK1 **24 V / 21 A = 504 W → OLED CNTR**
- BUCK2 20 V / 3 A = 60 W → SOUND CNTR
- BUCK3 12 V / 8 A = 96 W → T-con CNTR

우리 사양(25 V 직출력)은 그 후단 벅을 없애는 구성이며, 그 대가가 75 mF 출력 뱅크다.
**이것이 이 프로젝트의 가장 큰 아키텍처 판단이다.**

**도터보드 실장값** (`DAUGHTER BOARD_L6790_REV1`):
R4=13 k(RT) · C4=470 pF 1 %(CT) · R5=24 k(BM) · R6=31 k(CFG) · R2=150 k / R3=23 k(ZCD) ·
**R7=100 k N.M.**(LOUT2 풀다운 미실장 → morphing) · C2=100 nF(VCC).
주석 BMi=55 W · VBO=85 V · OVP1=52 V · OVP2=57 V. 가이드 부록 A와 전부 일치.

2차: TEA2096 + ISC079N15NM6(150 V, 7.9 mΩ) × 4 = **2채널 × 2병렬 센터탭 SR**.
입력: TEA2209T + ST8L65N044M9(44 mΩ) × 4 동기 브리지.
1차: STDRIVEG600 + ISG6123TA(GaN, TOLL) × 2.

> **미확정:** EVL 보드의 n = 3.2가 n인지 n_T인지. 마더보드 BOM에 별도 공진 인덕터가 보이지
> 않아 **누설 통합형(→ 3.2가 n_T)일 가능성**이 있으나, 그 경우 반사 전압이 125 V로 낮아져
> 설계 등가 입력이 177 Vac가 되어 가이드 부록 A의 217 Vac 해석과 충돌한다.
> **자료만으로 확정 불가 — 트랜스포머 실측(개방/단락 인덕턴스 + 턴수)으로 판정할 것.**

### 5.2 LGE 기존 2단 양산 보드

회로도의 벡터 경로에서 배선을 직접 추적하여 확정한 것.

| 항목 | 내용 |
| :--- | :--- |
| 구성 | UCC256403 하프브리지 LLC (Q151/Q152 = TK190U65Z 650 V) + TEA2095 센터탭 SR (TPH3R70APL1 × 4) |
| 출력 | **25 V (25VD)** — 우리 사양과 동일 |
| 트랜스포머 | **26OP-LM83W × 3개, 1차 직렬** (핀2→핀1 배선). **2차 결선은 직렬이다** — 시트 §5.2a |
| 권선 | N_p = 5 T (리츠 0.04 × 360), N_s = 1 + 1 T (**동판 0.5 × 4.5 mm**) → 합계 N_p = 15 |
| 인덕턴스 | 개방 53 µH · 단락 14 µH (개당) → 직렬 합계 159 / 42 µH → **λ = 0.359 (m = 3.79)** |
| 코어 | EE6405 (64 × 33.5 × 8 mm 편평형), **A_e = 113.1 mm²**, l_e = 57.13 mm, V_e = 6461 mm³, GP98 |
| 공진 커패시터 | 0.01 µF/630 V 2직렬 × 5병렬(1열 미실장) = **25 nF** |
| 제조 | KH필룩스, P/N EBJ30067801 |

**이 프로젝트에 직접 쓰이는 결론 3가지:**

1. **자기부품 구조를 그대로 가져올 수 있다.** 25 V/26 A에서 2차를 1턴 동판으로 감고 여러 개를
   병렬하는 것이 검증된 해법이다. 1차 직렬이므로 전류 분배가 자동으로 맞는다.
2. **기존 설계의 λ = 0.359는 이미 단일단 영역에 가깝다.** 통상 2단 LLC는 λ = 0.1–0.2인데 이
   보드는 m = 3.79다. **같은 코어·보빈 플랫폼에서 갭만 키우면 단일단이 요구하는 λ ≈ 0.55에
   도달**한다.
3. **N_s만 1 → 2턴으로 바꾸면 권선비가 정확히 맞는다.** N_p = 5 × 3직렬 = 15, N_s = 2 →
   n_T = 7.5 → n = 6.04 (필요값 6.046).

> **위 3가지는 그대로 유효하다.** 아래 시트 §5.2a 의 정정은 *기존 보드의 동작점*에 대한 것이고,
> 우리가 물려받는 것은 *기계 플랫폼*이므로 영향받지 않는다.

### 5.2a 2026-08-28 정정 — 버스는 400 V 이고, 2차는 병렬이 아니다

**사용자가 "버스가 400 V 아니냐"고 물어서 사양서 원본으로 되돌아갔고, 두 가지가 틀려 있었다.**

**① 버스 전압.** 나는 "보드가 M ≈ 1 에서 돈다"고 가정하고 권선비에서 640 V 를 역산했다.
**틀린 것은 버스가 아니라 그 가정이다** — 1차 스위치가 **TK190U65Z(650 V)** 이므로 640 V
버스는 성립할 수 없다. 유니버설 입력 부스트 PFC 의 출력은 **400 V** 다. 이 근거(소자 내압)는
처음부터 내 손에 있었고 쓰지 않았다.

**② 2차 결선.** "핀4+5 CT 공통 버스" 를 3개 병렬의 증거로 읽었는데, 승인원 6쪽 권선표는

| No. | 단자 | 전선 | 턴수 |
| :-- | :--- | :--- | :--- |
| NP1 | 1 → 2 | MIW-F(LZ) 0.04Φ × 360 (리츠) | 5 Ts |
| NS2 | 3 → 5 | Cu plate 0.5T × 4.5W | 1 Ts |
| NS3 | 4 → 6 | Cu plate 0.5T × 4.5W | 1 Ts |

로, **한 유닛 안에 1턴 2차가 두 개** 있다. 핀 4·5 를 잇는 것은 그 유닛 자신의 센터탭일
뿐이고 유닛 간 병렬의 증거가 아니다.

**포화가 결선을 정한다.** 1차 직렬이므로 유닛 하나가 받는 전압은 `n_T·V_o,eff/3` 이고,
공진 아래에서 도통 구간은 `T_r/2` 로 고정된다:

| 2차 결선 | n_T | n | **B_pk** | 400 V 에서 요구 M |
| :--- | ---: | ---: | ---: | ---: |
| 병렬 (N_s,eff = 1) | 15.0 | 12.87 | **356 mT** | 1.608 |
| **직렬 (N_s,eff = 3)** | 5.0 | 4.29 | **119 mT** | 0.536 |

페라이트는 100 °C 에서 약 390 mT 에 포화하므로 356 mT 는 여유가 9 % 뿐이고, 더 결정적으로 **코어손이 대략 B^2.5 로 가므로 356 대 119 mT 는 손실이 약 16배**다. 평면 TV 트랜스포머에서 성립할 수 없다. 따라서 2차는
직렬이고, 3개는 사실상 **하나의 15 : 3 트랜스포머**로 동작한다 — 평면 TV 높이 때문에 코어를
셋으로 쪼갠 것이다.

**아직 안 닫힌다.** n_T = 5 로 보면 400 V 에서 요구 게인이 **0.536** 인데, 이 탱크의
Q→0 최저 게인이 `1/(1+λ)` = 0.736 이라 상당한 Q 와 f_sw ≫ f_r 이 필요하다. 그런데
Z_0 = 41 Ω(C_r = 25 nF 가정) 에 25 V 출력이면 **부하 Q 가 1 을 넘는다**(600 W 에서 2.6).
정상적인 LLC 설계 영역이 아니다. **내가 회로도에서 읽은 C_r = 25 nF 가 틀렸거나, 그 레일의
전력이 내 짐작보다 훨씬 작거나 둘 중 하나다.** 더 추측하지 않는다 —
**PFC단 도면 또는 공진 커패시터 실측이 있으면 닫힌다.**

> **▷ 이것이 우리 설계를 막지 않는다.** 우리는 기존 보드의 동작점을 물려받지 않는다.
> 물려받는 것은 코어(EE6405, A_e 113.1 mm²) · 보빈 · 3분할 구조 · 리츠 1차 · 동판 2차 ·
> 벤더 · 절연 시스템이고, 우리 권선비는 우리 요구에서 나온다.

### 5.3 참고 논문이 가이드 §2.2를 독립 증명한다

ECCE (Wenbo Liu et al., 1.65 kW 단일단 LLC OBC) 식 (14): `sin²θ ≤ sinθ`이므로
**G_req(θ) = G_req,pk/sinθ ≤ G_req,pk/sin²θ = M_fr2(θ)**. 즉 라인 피크·전부하에서 게인을
만족시키면 **모든 위상에서 자동으로 만족**한다. 가이드 §2.2 "두 발산의 상쇄"와 같은 결론.

논문의 λ = L_r/L_m = 8.5/21 = **0.405**로, "λ ≈ 0.5가 단일단의 지문"을 외부 설계가 독립적으로
뒷받침한다. Infineon AN 2013-03도 "m > 5는 게인 부족"이라 적는다.

---

## 6. 사고 기록 — 같은 실수를 반복하지 않기 위해

### 6.1 xlsx가 열리면서 "복구했습니다" 대화상자를 띄웠다 (2026-08-21)

Excel이 *"제거된 레코드: /xl/worksheets/sheet8.xml 부분의 셀 정보"* 로 복구했다.
**셀을 "추가"하다가 깨뜨렸다. 원인 3가지 — 전부 규칙 위반이다:**

1. **한 `<row>` 안에 같은 `r=` 셀이 두 번 있으면 안 된다.** `G18`이 이미
   `=IF(E18,"","Power Components")`로 존재하는데 뒤에 `G18`을 또 붙였다.
2. **`<row>` 안의 셀은 열 번호 오름차순이어야 한다.** 새 `H` 셀을 행 끝(= `I`, `W` 뒤)에 붙였다.
3. **수식을 추가/삭제하면 `xl/calcChain.xml`이 낡는다.**

**그래서 만든 것: `Design Guide/generators/xlsx_patch.py`의 `set_cell()`** — 있으면 교체, 없으면 올바른 위치에 삽입하고 `spans`를 다시
계산한다. 그리고 **쓰기 전에 전 시트를 훑어 "행 안의 셀이 중복 없이 오름차순인가"를 검사**한다.
이 검사를 통과 못 하면 설치하지 않는다.

**부수 교훈:** `BOM&Schematics`의 **G열은 비어 있지 않다.** 모든 행이
`=IF(E.., "", "<출처 시트>")` 힌트를 갖고 있으므로 남의 열을 뺏지 말 것.
그리고 **H·I열은 "Power Part Schematics" 그림이 I열에 앵커되어 있어 그림 밑에 깔린다.**
결국 커패시터 뱅크는 표 안쪽(C~F)에 **행으로** 넣었다 — 빈 행 22를 써서 행 삽입 없이.

### 6.2 PDF에서 글자가 겹치는데 검사기는 "겹침 0"이라고 했다

검사기가 **선언된 크기**만 봤기 때문이다. 세 단계로 고쳤다.

1. **리전 높이를 "슬래시 개수"로 추정하고 있었다** (`28 + 20*src.count('/')`). SMath는 수식을
   2차원 트리로 배치하므로 분수는 쌓이고 근호는 막대 한 줄, 지수는 위첨자 한 줄이 붙는다.
   → `smsheet.py`의 `_rh()`/`_rwid()`가 트리를 재귀로 재고 `est_box()`가 픽셀을 돌려준다.
2. **텍스트 줄바꿈을 SMath에 맡기고 있었다.** TextRegion은 폭에 안 맞는 `<p>`를 **말없이 다시
   줄바꿈**하고, 늘어난 줄이 선언 높이 밖으로 나가 다음 리전 위에 찍힌다.
   → `_wrap()`이 미리 줄을 나눈다. 관건은 글자폭 상수: PDF 실측 **폭 1100 px · fontSize 9에
   약 208자** → 0.58 × 폭/글꼴크기. `CH_PER_PX = 0.67`로 잡아 15 % 여유를 뒀다.
   `check_sm.py`가 0.60 기준으로 모든 `<p>`를 다시 재어 "재줄바꿈이 일어날 것"을 미리 잡는다.
   **회귀 시험으로 확인함** — 0.52로 되돌려 빌드하면 정확히 겹쳤던 문단들을 집어낸다.
3. **텍스트 리전 높이를 추정하고 있었다.** SMath가 직접 저장한 워크시트에서 실측:

   | fontSize | 1줄 | 2줄 | 3줄 | 4줄 |
   | ---: | ---: | ---: | ---: | ---: |
   | 8 | 20 | 47 | | |
   | 9 | 21 | 49 | 77 | 105 |
   | 10 | 23 | | | |
   | 12 | 26 | | | |
   | 15 | 30 | | | |

   → **첫 줄 ≈ 1.4·size + 8.7, 이후 한 줄당 ≈ size + 19.** 종전 `n·(size+4)+6`은
   fontSize 9·3줄에서 **45 px vs 실제 77 px** — 시트 §18 표가 겹친 원인이 정확히 이것이다.

**결정적 사실:** SMath는 저장할 때 텍스트 리전을 **내용 크기로 다시 맞춘다.** 그래서 두 줄짜리
라벨은 선언 높이보다 커지고 그대로 다음 행 위에 얹힌다. → **좌측 라벨은 무조건 한 줄**로 만들고,
두 줄이 되려 하면 **빌드를 실패시킨다**(`_label(nowrap=True)`). 추정으로 버티지 말고 실패 모드를
없애는 쪽이 맞다.

### 6.3 보드선도의 위상 곡선이 통째로 안 보였다

**그래프에는 로그 축이 없을 뿐 아니라 자동 스케일도 없다.** `<plot>`의 `scale_*`/`transpose_*`가
창을 고정하는데, **그 창 밖의 데이터는 빈 그래프로 보인다.** 위상 곡선(−130 ~ −222°)이
−64부터 시작하는 창 밖에 있었다. 캘리브레이션 결과:

- **격자 한 칸 = 20 px, `scale_*` = 칸당 단위수** → `px/단위 = 20/scale`
- **`transpose_*` = −(창 중심 × px/단위)** [px]
- `smsheet.py`의 `Sheet.plot_view(w, h, x0, x1, y0, y1)`가 이 계산을 해 준다

부수 조치: 위상 대신 **위상 여유(180 + arg T)**를 그린다. 0–50° 안에 들어와 바로 읽힌다.

### 6.4 SMath 파일이 아예 안 열렸다 (NullReferenceException)

*"개체 참조가 개체의 인스턴스로 설정되지 않았습니다"* — 원인 2가지:

1. **리전은 `<regions type="content">` 안에 넣어야 한다.** `<worksheet>` 바로 아래에 두면 실패.
2. **`<dependencies>`에 사용한 리전 타입의 어셈블리를 전부 선언해야 한다** —
   `SMath Core` 외에 `MathRegion`, `TextRegion`, `PictureRegion`, `SpecialFunctions`,
   그래프를 쓰면 `PlotRegion`, 접기를 쓰면 `AreaRegion`.

정확한 GUID는 `Reference/EVLHV101SSR50W Design Guide.sm`에서 복사한다.

### 6.5 BOM 대조 스크립트가 24항목 불일치를 냈다 (2026-08-21)

**틀린 쪽은 스크립트였다.** SMath의 `<result>`는 이미 **표시 단위(contract)** 값인데 SI로
착각해 한 번 더 나눴다. 설계값은 처음부터 같았다.
→ `bom_compare.py`가 `<contract>`를 읽어 환산하도록 고쳤다. 교훈: **대조 도구 자신도 검증
대상이다.** 전부 다르게 나오면 도구를 먼저 의심할 것.

---

### 6.6 `<result>` 도 RPN 이다 — 첫 토큰만 읽으면 부호와 지수가 사라진다

**2026-08-24.** `snapshot.py` · `xl_sm_compare.py` · `bom_compare.py` · `audit_rpn.py`
넷이 전부 `float(list(res)[0].text)` 로 결과를 읽고 있었다. **넷이 같은 가정을 독립적으로
했으므로 아무도 서로를 잡아주지 못했다.**

`<result>` 는 값 하나가 아니라 **RPN 식**이다:

```
<e>22.26</e><e args="1">-</e>                        -> -22.26   (22.26 로 읽힘)
<e>3.87</e><e>10</e><e>15</e><e args="1">-</e>
   <e args="2">^</e><e args="2">*</e><e args="1">-</e>  -> -3.87e-15  (3.87 로 읽힘)
<e style="unit">nF</e><e>92.21</e>                   -> 92.21 (단위가 먼저, 곱셈 생략)
```

**발견 경위.** `n.SR` 을 1 로 바꾸고 사용자가 엑셀을 재계산한 뒤 `xl_sm_compare` 가
`Power Components!D37`(필요 세라믹 용량)에서 **엑셀 0 · SMath 3.87 µF** 불일치를 냈다.
파고 보니 **양쪽 다 맞았다** — `C.cer_min = MAX(C.cer_raw, 0)` 이고 `C.cer_raw` 는
**−64.14 µF**(ESR 만으로 이미 30 mV 예산을 지키므로 세라믹이 불필요)라 시트는
−3.87e-15 µF, 즉 0 으로 클램프하고 있었다. **틀린 것은 내 리더였다.**

전체 결과 525개 중 **토큰이 2개 이상인 것이 53개**다 — 부호가 날아가던 것 16개
(Cardano 중간값 `a2.*` `p.*` `r.b`, 보드선도 스칼라 `Ta.4` `Ta.5` `Ma.5`, `C.cer_raw`),
지수까지 날아가던 것 1개(`C.cer_min`), 나머지는 단위 토큰이라 수치에는 무해했다.

`smresult.py` 로 평가기를 하나만 두고 넷 다 거기에 연결했다.

> **▷ 고치다 두 번 더 틀렸다.** ① `audit_rpn` 에서 `val` 을 재사용해 **독립 평가값을
> 덮어썼다** — 인쇄값끼리 비교하게 되어 81건이 거짓 불일치로 떴다. ② 단위가 앞에 오고
> 곱셈이 생략된 형태를 스택 잔여 2개로 보고 `None` 을 냈다. **둘 다 도구가 즉시 소리를 내서
> 잡혔다** — 검사기가 있다는 것의 값어치가 이것이다.
>
> **▷ 비교기에 절대 허용치도 넣었다.** 정답이 0 일 때 상대오차는 발산한다.
> `1e-15` SI 미만이면 같은 값으로 본다 — 두 문서에서 가장 작은 실제 물리량이
> 100 pF 기생용량(1e-10 F)이므로 안전하다.

## 7. 구 산출물과 그 제작 규약

### 7.1 rev 1.1 시대의 산출물

| 파일 | 상태 |
| :--- | :--- |
| `AN_L6790A_Design_Guide_rev2_0.md` + `figures/` | **현행 — rev 2.0 (2026-09-11).** 예제는 9:1 정본 설계점. 240 W 는 부록 C.5·C.30·C.31 에만 남는다 |
| `Smath/L6790A_Section3_PowerStage_Tank_rev1_1.sm` | **2026-08-23 현재 폴더에 없다.** 구 시트(240 W 예제, 시트 §3.1–3.13). 진단 프로브는 현행 `L6790A_probe.sm`이 대체한다. build_sm.py 가 있었으나 옛 `fig/` 그림 세트가 없어 그대로는 재생성되지 않았고, 그 빌더는 2026-09-22 에 삭제했다 |
| `L6790A_Section3_Calculation_Sheet_1page.sm` | **프로젝트 폴더에 없음.** A1 세로 1페이지 4단 판이었다 |
| `Training Material/…Training.pptx` | 영문 **61장**, 25 V 예제로 교체 완료. 한국어판이 남았다 |

### 7.2 PPT 제작 규약 (Phase 7에서 필요)

- 테마: navy `03234B` / yellow `FFD200` / magenta `E6007E` / cyan `3CB4E6`, 폰트 Arial
- ST 로고: `ST_Template__16-9_.potx` → `ppt/media/image1.png`
- 수식: matplotlib mathtext → PNG(26 pt, dpi 260), 슬라이드에는 **15 pt 크기로 자연 배치**
  (`inches = px × (15/26)/260`). 박스 폭에 늘려 채우면 30 pt가 되어 너무 커진다
- `\dfrac` · `\left\{` · `\begin{array}` 미지원. `\frac`과 단순 나열로
- 그림: pymupdf 200 dpi 래스터화 → 넉넉히 크롭 → **잉크 경계로 자동 트림**(recrop2.py — 2026-09-22 삭제).
  좌표로 직접 자르면 캡션이 잘린다
- pptxgenjs: `LAYOUT_16x9` = **10 × 5.625 in**. 색상에 `#` 금지
- **기하 검사기 필수**: python-pptx로 전 도형 좌표를 훑어 `y+h > 5.26 in` 위반을 자동 검출.
  눈으로 51장을 보는 것보다 훨씬 빠르고 정확하다
- 변수명: 유니코드 아래첨자가 있으면 진짜 아래첨자(Lᵣ Cᵣ fₒ Z₀ Vₒᵤₜ), 없으면 언더바 제거

### 7.3 구 워크북 수정 방식 (지금은 쓰지 않음)

rev 0.6까지는 `shutil.copy` → openpyxl 수정 + `Comment` → `recalc.py <file> 600` 방식이었다.
**차트 30개 때문에 지금은 XML 직접 편집만 쓴다** (`CLAUDE.md` 시트 §6.2).
정상 상태의 잔여 오류는 **54건**이며 전부 RTC 행 29의 의도적 `NA()` 차트 마스킹이다
(rev 1.1 기록의 "53건"은 하나 적게 센 것 — 2026-08-23 전수 확인).
CHANGELOG의 텍스트 셀은 `cell.data_type='s'`를 명시해야 `=`로 시작하는 문자열이 수식이 되지 않는다.

---

## 8. 타임라인 — 수정 이력

**설계값이 바뀌면 여기에 한 줄 적는다.** 무엇을 왜 바꿨고 그래서 무엇이 나빠지거나
좋아졌는지. 발견·사고·결정도 같이 담는다 — 이 프로젝트에서 시간순으로 남는 기록은
이 표 하나뿐이다.

`snapshot.py`를 돌리면 지난번 대비 움직인 값을 전부 찍어 주므로, 그것을 보고 여기에
요약해 적으면 된다. **스크립트가 이 파일에 직접 쓰지는 않는다** — 근거 문서를 기계가
건드리게 두지 않기 위해서다.

| 날짜 | 한 일 |
| :--- | :--- |
| 2026-09-22 | **(21차) 설계 예제를 단일 트랜스포머로 — ETD 49/25/16DG 채택** (사용자 확정 "진행해줘"). **시트 변형 `7p5to1_x1`** (`build_l6790_smath.VARIANTS`: `N.x` 1 · `N.p` 15 · `N.s` 2 · `n.aux` 1.5 → `N.aux` 3 · **`Ae` 211**, 이제 `A.e_mm` 은 변형 파라미터고 기본은 113.1) — `mismatches: 0`. `an_pdf.AN_VARIANT` 기본을 이것으로. **코어 판정은 `cores.py` 한 곳에서**: `CHOSEN` = ETD 49/25/16DG, `BOBBINS`(ETD 49 20핀 · PQ 40/40 12핀 기하와 배정), `winding()` 이 **포일을 `W_FOIL_MAX` 12 mm 초과 시 병렬 스트립으로 나누고 1차 층수를 반경 창 안에서 고른다**(전에는 단일 코어 입력에서 퇴화했다). 네 후보 결과 — PQ 40/40 분리 간격 −8.1 · PQ 50/50DG −19.7 · **ETD 49 +6.35(1차 3층 5+5+5, 반경 7.11/8.40)** · ETD 54 +3.34(2층). **핀 배정(20핀, 두 줄 × 10):** NP1 1+2 – 4+5 · NAUX 8 – 10(앞줄) · NS2 11+12 – 14+15 · NS3 16+17 – 19+20(뒷줄) · **탭 = 14·15·16·17 PCB 결합** · 빈 핀 3·6·7·9·13·18. **2차 단자는 핀 2개씩** — 권선 하나가 28 A rms 를 흘리는데 □0.8 핀 하나로는 부족하다(벤더가 핀 정격 확인 또는 러그). **ETD 49 도면에는 핀 번호도 핀 1 표시도 없다** — 한 줄 따라 세고 반대 줄로 돌아오는 관례를 가정으로 적었다(PQ 50/50DG 도면은 그렇게 찍혀 있다). **AN:** 7.4 `n.T` 줄 "15 : 2" 단독 · 7.8 도입(한 부품, 3유닛은 6장의 대안으로만) · `trafo-built` 표 3열 · 핀 문단·그림·표(`pins`)·**극성 문단**(3유닛 결선 문단 삭제) · **7.9 후보 4종 표**(A.e·B.pk·A.N·권선폭·반경·1차 층/축/반경·분리 간격·l.N·질량·판정) + 노트 2개(**창 깊이가 결정**, **누설은 벤더가 배치로 맞춘다** — N² 라 3배) · `legend42`·`winding`·사양표(코어 행 신설) 단일화. **그림:** `an_core_section` 이 `cores.CHOSEN` 을 그린다(ETD 49 단면 48.5 × 49.8, 3층 1차, 포일 12층, 판 크기·배율 S2 7.7·S3 2.4 재조정, 포일 패널은 NS2 6층만) · `an_xfmr_pins` 오른쪽 패널을 `BOBBINS[CHOSEN]['plan']` 으로 일반화(ETD 는 두 줄, PQ 는 두 열) · `an_xfmr_read` 라벨 "one unit/per unit" 을 `nser` 로 분기. `figcheck` 3장 tiny 만. **사양서:** `build_trans_spec` 이 `N.x` 로 보빈을 고른다(1 → `CHOSEN`, 아니면 PQ 40/40) — **한 번 이 분기 없이 돌려 3코어 사양서 셋에 ETD 핀이 들어갔다가 바로 잡았다**. 5종 재생성, `check_trans_spec` 불일치 0. **손실·온도는 실측 항목** — 러프 추정 동손 3.4 + 철손 3.7 ≈ 7 W(철손은 ETD 54 데이터시트의 N87 값을 환산, ±50 %). 영문 82쪽 · 식 49 · 그림 42 · 표 29, `an_check` 통과. 한국어판 미반영. |
| 2026-09-22 | **(22차) 7.8·7.9 를 설계만 남기고 정리** (사용자: "table 11 은 필요없는 내용 … 단면도만 봐서는 2차측을 어떻게 권선하라는건지 모르겠어 … 2, 3 strips 가 무슨 말이야 … enlarged 7x 는 뭔데 … 이유를 덧붙이고 덧붙이고 너무 복잡해"). **뺀 것:** 7.9 의 후보 코어 4종 비교표(구 Table 11)와 설명 상자 2개(창 깊이 · 누설 N² 배율) — 후보 비교의 근거는 이 표(21차 행)에만 남는다. 7.8 도입·핀 문단·극성 문단·자속/자화/포화 문단·`an_mmf` 캡션을 사실만 남기고 절반 이하로 줄였다. 절 이름 `Choosing the core, and building the winding on it` → **`The core and the winding`**. **그림 40 (`an_core_section`) 다시 그림:** 권선 색을 핀 그림(Figure 38)과 같게 — NP1 자홍 · NS2 초록 · NS3 하늘 — 단면·전개 패널에서 12층 포일이 아래 6층 NS2 · 위 6층 NS3 로 갈린다(전에는 전부 빨강 한 덩어리). 셋째 패널을 **"the secondary, layer by layer (not to scale)"** 로 교체 — 보빈 위로 NS2 turn 1·2, NS3 turn 1·2 를 층마다 그리고 권선별 괄호에 핀(11+12 – 14+15 / 16+17 – 19+20), "one turn = 3 foils 0.20 × 10.5 mm, wound together, connected in parallel", 절연 0.05 mm, 반경 3.0 mm. **배율 표기("enlarged 2.2×/7×")와 "strips" 라는 말을 전부 없앴다** — 포일은 "3 foils in parallel". 범례 번호 1~7 로 재배열(1 NP1 · 2 NS2 · 3 NS3 · 4 분리 · 5 마진 테이프 · 6 중앙다리 갭 · 7 창). `figcheck` tiny 만(쪽 배율 0.70, 기존). 영문 **81쪽 · 표 28**, `an_check` 통과. 한국어판 미반영. |
| 2026-09-22 | **(23차) 보상망을 수식과 함께 · 그림 40 확대 · 전수 낭독 검토** (사용자 3건: 그림 40 15 % 확대 · 전 문장/파형/그래프/회로도 재검토와 비원어민 영어 · Feedback compensation 이 계산 과정 없이 덩그러니 나온다, onsemi TND381 수준의 설명). **6장:** 6.26 을 절 8개로 — 루프 블록도 신설(`an_loop_blocks`, 보상기/플랜트 괄호) · 플랜트가 적분기인 이유와 `G.o` 식 · **목표와 어긋났을 때 표**(`loop-aims`: 교차·위상 여유·이득 여유·`G.EA(2f.l)` 각각 너무 낮으면/높으면 — TND381 의 76°/45°/Q 대응, CTR 2:1 산포) · 2f.l 리플이 3차 고조파가 되는 식(`D.3 = G.EA ΔV/(4 V.FB)`, 4 의 출처: 진폭 절반 × 변조 m/2) · TL431·옵토·FB 핀 회로의 동작 서술과 전달함수(`EA.o`·f.z·f.p·f.px), fast lane 없음, `R.B` 창의 뜻, CTR 두 값 · K-factor 배치와 부품 식 · **solver 없는 검사**(|T|·arg T 닫힌형, 교차 고정점 반복, 위상 여유) · 이득 여유 · 버스트 리플(`ΔR.BM` 식). 식 49 → 64. **7.13 을 13단계 대입 산수로**(분압 → 플랜트 → 2f.l 허용 이득 → K.v → EA.o → f.MB/f.p/f.z → 바이어스 R.P·R.B 창 → 부품 4개 → 실제 구현값 → 교차·위상 여유(atan 세 항) → 이득 여유 → 실제 3차 고조파 → 버스트 리플·R.BM). 시트 상수(V.Fo·R.FB·I.FB·CTR.m·C.opto·f.pHF·Φ.M·α.v·D.3rd·I.min·GM.t)는 **`an_pdf._builder_const()` 가 빌더의 `S.const` 줄에서 읽는다** — 손으로 다시 적지 않는다. `an_loop_bode` 에 f.180/이득 여유 표시. **그림 40:** figsize 를 1/1.15 로, mm/inch 배율을 1.15 로 — 같은 쪽 폭에서 코어·권선·글자가 15 % 커진다. `fig(shrink=False)` 신설(MINFIT 1.0) — 쪽에 안 맞으면 줄이지 않고 다음 쪽으로. **낭독 검토(89쪽 전부):** 수치·수식 오류 0 · 몽타주 15장 겹침 0 · 문장 6곳 평이하게(`Why resonance buys anything` → `What resonance is for` 등) · **표지 '그림 일부는 타사 AN 에서' 문장이 낡아 있었다**(9-20 이후 전부 자작) → 고침 · 'PF LLC' 명칭 1곳 · 3.3/2.16 의 절 참조를 리플 절로 · 기호표에 루프 기호 10줄 · 참고문헌에 TND381. mathtext 에 `\le`·`\text` 가 없어 `\leq`·`\mathrm` 으로. 영문 **90쪽 · 식 64 · 그림 43 · 표 28**, `an_check` 통과. 한국어판 미반영. |
| 2026-09-25 | **(61차) OVP2 와 I_sat 의 관계를 식으로.** 사용자: "OVP2 와 Isat 이 왜 관계가 있는지 상세한 설명 … 수학적 수식도 붙여서." 영문판 6.19 "Why the ceiling is OVP2" 를 유도로 바꿨다: 같은 피크 자속을 2차 볼트-초(식 24)와 자화 전류(식 32)로 두 번 쓰면 A_e 가 약분되어 **식 33 (신설) i_μ,pk = n_T V_o,eff / (4 f_r L_μ)** — 부하·입력·(below 에서의) f_sw 가 하나도 안 남고 출력 전압에만 비례. → 코어가 구동되는 동안의 최고 출력은 V_OVP2(OVP1 은 전력만 줄이고 스위칭 계속, OVP2 는 100 ms 정지) → 벤치에서는 다른 권선이 Open 이라 I_dc 가 유일한 암페어턴이고 B = L_μ I_dc/(N_p A_e) 로 같은 관계 → I_sat = I_eq V_OVP2/V_o,eff(식 34). V_f ≠ 0 이면 실제 자속비는 (V_OVP2 + N_rect V_f)/V_o,eff 로 조금 작아 식 34 가 안전 쪽이라는 한 줄. 7.12 에 검산 한 줄: 7.50 × 25.0 V / (4 × 151.75 kHz × 24.90 µH) = **12.41 A** = I_eq(코어 데이터 없이). 식 번호가 하나씩 밀림(참조는 이름이라 자동). 한국어판은 60차 재구성과 함께 영문판 확인 뒤 이식. |
| 2026-09-25 | **(62차) 영문판 AN 전수조사 + 수식 굵기 +10 %.** 사용자: "1. 설명/수식 오류 2. 파형/그래프/회로도 오류 3. 가독성 4. 용어 테이블 누락 5. 수식 폰트 굵기 딱 10%만 증가." **수식 103개** 전부 유도로 대조 — 오류 둘: 식 100 V_BM,eq 의 단위(0.01 V/kΩ 로 적음), **식 34 I_sat = I_eq V_OVP2/V_o,eff** → **V_OVP2/V_out**. 정확한 자속비는 (V_OVP2+N_rect V_f)/(V_out+N_rect V_f) 이고 그 이상인 것은 V_OVP2/V_out 뿐 — 61차 식은 V_f > 0 이면 정확한 비보다 **작은** 유일한 비였고 바로 아래 "안전 쪽" 문장과 모순. 시트 `k.OVsat` 도 V.OVP2_act/V.o_eff → V.OVP2_act/V.out(빌더, 5벌 재빌드 · mismatches 0; SR 이라 V.rect = 0, 값 1.2246 그대로), `DESIGN.md` §4 13 동기. 7.12 검산 줄은 식 33 의 기호대로 V.o_eff 값을 대입. **그림 48장** 전부 확인 — 고친 것: **Fig 41** 왼쪽 "탱크가 낼 수 있는 게인"이 f_o 에서의 게인이었고 θ ≳ 79° 에서 요구 게인 **아래**로 내려가 제목("ceiling stays ABOVE")과 모순 → ZVS 경계(zvs_edge)에서의 게인 M_Z 로(θ = 90° 에서 1.407 > 1.229), 범례·주석 재배치. **Fig 18** LLC 구간 번호 1·2·3·4 → 8단계 번호 1·2·3,4·5(4 가 Fig 6–10 에선 바디 다이오드 클램프, 여기선 반대 반주기 전력 전달이었다), 본문 "LLC, 3 and 4 / LLC, 5", 캡션이 Fig 10 을 가리킴. **Fig 26** HB edge 상자가 y 축 눈금 150 을 가림 → HB 가지 위로, `2 x` → `2 ×`. **Fig 24** 패널 3 "loading" 글자가 곡선 위에 앉음 → 정점 위로, 회색 주석도 곡선에서 뗌. **Fig 19** 호출 글자가 m = 2.25 곡선에 닿음 → 빈 곳으로. **Fig 40** "then a dead interval"(dead time 과 혼동) → "then freewheels (steps 2, 6)". **Fig 43** "freewheeling · dead time" 글자를 점선이 관통 → 흰 바탕. **Fig 42** 캡션에 계산 모델(반주기 전체 사인 + 선형 자화 램프)임을 명시. 확인만 한 것: Fig 16 은 dead time 동안 i_Lr = i_Lm 으로 그린 8구간 모델의 단순화(스텝 4 에서 2차가 도통을 시작하는지는 동작점에 따라 다르다) — 바꾸지 않음. Fig 26 은 "보장되는" 모드 기준(173/332), Fig 30 은 히스테리시스 포함(166.2–346.5) — 본문 4.5 가 두 범위를 모두 적어 모순 아님. **용어 표**: 그림·본문·수식에 쓰였는데 표에 없는 기호 0(an_symbols MISSING 0, 그림 기호 대조 0). **수식 굵기**: `an_pdf.EQ_BOLD = 0.0096` — 같은 색 테두리 path effect 로 획마다 0.0096 × 글자 크기(pt)를 더한다. STIX 줄기 평균 0.096 em 의 10 %. 3000 dpi 실측 l 45→50 px(+11 %) · I 50→55(+10 %) · T 50→54(+8 %). 캐시 키에 EQ_BOLD 포함. 한국어판은 an_pdf 를 공유하므로 이식 때 자동. figcheck 55장 0건. 한국어판(60·61·62차)은 영문판 확인 뒤. |
| 2026-09-25 | **(63차) 영문판 AN 한 줄씩 전수조사 — 97쪽 전부(본문 · 수식 68개 이미지 · 표 · 그림 48장), 지난번에 건너뛴 도구 보고서(an_symbols · an_figtext · an_check)까지.** 사용자: "찾을 때마다 오류가 발견되잖아 … 이번에 안 하고 넘어간 것까지 모두 포함해서 … 한 줄 한 줄". 41건, 기록은 스크래치 findings.md. **값이 틀렸던 것:** ① 7.10·표 16 **공극 "약 1.1 mm" → 2.2 mm** — TDK ETD 49/25/16DG 의 G2·G3 는 반쪽 하나의 치수이고 세트는 같은 반쪽 둘이라 합계 2(G2+G3). 250 nH 행 2×0.54 = 1.08 mm 가 μ0A_e/A_L = 1.06 mm 와 맞는다(`cores.AL_gaps` ETD49 · PQ50DG 2배). ② 표 20 **"Primary switching, three positions 4.83 W"** — P.mos_sw 는 스위칭 위치 **하나**의 도통 손실; HB 에서 S1·S2 둘이라 9.65 W, 스위칭 손실 아님 → 합계 23.15 → **27.97 W**(시트의 P.pri_tot 19.3 W 사용), 효율 주석 23.2 → 28.0 W. ③ 표 18·10.4 **L_open 허용 저하 4.1 % → 4.0 %** — 표시용으로 반올림된 k.floor 1.021 을 제곱했다(`an_pdf.Ldrop` 을 f.o/f.Min 에서). **틀린 서술:** 2.3 "Lower f_sw towards f_o and the interval fills the whole half period, no power" · 2.5 "conventional LLC … just above f_r, where circulating current is smallest" · 2.12 "reflected voltage exceeds V_out" · 4.7 "crosses f_r … within one line cycle"(173 · 90 Vac 는 안 넘는다) · Fig 5 "nothing can push the converter below it" → "below it the tank is capacitive at any load" · 표 2 "current limit does not"(6.19 와 모순) · "far below the winding peak"(15.2 vs 18.3) · 6.22 C_in 하한/THD 상한 뒤섞임 · 6.29 "crossover rises with √CTR"(실측 CTR×2 → f_c×1.73, 거의 비례) · 6.31 "A changes slowly"(A ∝ ω; 수렴 이유는 제곱근이 변화를 반으로) · 7.3 "k_floor … thinnest margin"(k_Ploss 0.311 이 같은 표에) · 6.6 "dead interval" · "centre tap halves the secondary conduction loss"(정류기 손실). **빠진 조건 · 정의:** 6.26 플랜트 적분기는 정전력 부하일 때만 — 저항 부하면 1/(πR_LC_out) 극(이 설계 4.5 Hz), 문단 추가 · 7.11 ZCD 극성: 데이터시트 5.3.4(LOUT1 on 에서 ZCD 양) → 보조 권선 점 끝(8번) GND, 10번 R_ZCD,H 명시 · Γ_v 의 V_eq,max 가 **상용 최대(264)** 임을 첫 사용처에 · K_pwr · √(L1/L2) · w_f,max(가정 12.0 mm) 정의 · 표 16 margin 2.0 mm 는 가정이며 안전 규격 확인 필요 · Fig 34(ST 도면) 는 AUX→VCC 인데 설계는 외부 레일 → 캡션 · Fig 32 "L_p − L_r" → L_m · 참고문헌에 Toshiba Resonant Circuits and Soft Switching(2019, 본문 인용) 추가 · 표 6 r_BM 을 비율로 · 기호표 미사용 P_v · l_N · ρ20 · C_o(er) 삭제 · kPloss 주석 참조 6.24 → 7.27 · 4.3 THD 참조 6.26 → 6.28. **가독성:** 표 셀 행간 11.2 → 12.2 pt(8.4 pt 글자, 줄바꿈된 셀의 첨자가 다음 줄에 얹혔다 — 표 2) · Fig 25 "family is LOAD / LINE PHASE" 라벨을 곡선 밖으로. **확인만 한 것(검산 일치):** 목차 106 항목 · 북마크 108 · 7장 모든 대입 줄 재계산 · 식 14 3차식 전개 · 식 21–23 변압기 모델(대칭 누설로 L_short = 11.0 µH 재현) · 식 38·39·42·49–56·60–68 유도 · 표 8·10·11·19·22–25 수치 · 데이터시트(OVP1 2.3 V 감전력 계속, OVP2 2.5 V 100 ms, ACP-hard 50 µs 후 f_Max, OCP2 50 µs 후 f_SU). **고치지 않고 보고:** C_fx 1.55 nF · R_ZCD,L 19 kΩ 는 E24/E96 에 없는 값(6.30 "표준 부품으로 반올림" 과 어긋남) — 설계 선정값이라 사용자 결정 필요. 식 49(K_v)는 ST 원본(Device Setting D78)과 같다; α=1 에서 Venable tan(45°+Φ/2) 로 안 돌아가지만 ST 의 α 정의를 알 수 없어 부록 10.3 에 사실만 기록. Fig 16 은 dead time 동안 i_Lr = i_Lm 인 8구간 모델 단순화. figcheck 55장 0건 · an_check · an_symbols MISSING 0 · audit_md · 시트 5벌 mismatches 0 · bom 29/0 · xl_sm 145/0. 한국어판(60–63차)은 영문판 확인 뒤. |
| 2026-09-25 | **(64차) 보조권선 2T + 제너 VCC · 트랜스포머 안전 절연(미·EU·일·한·중).** 사용자: "트랜스포머 절연을 위한 테이핑이나 절연거리는 고려한 설계야?" → 아니었다(표 16 margin 2.0 mm 가 가정뿐). 이어서 "aux 권선은 외부 VCC 안 쓴다는 가정하에 … 2T + Zener 구조로. 이 부분은 워크북과 차이점" · "TV 같은 가정용 기기 … 미국/유럽/일본/한국/중국의 모든 조건을 충족하는 절연 조건". **VCC(시트 §14c 신설):** `n.aux` 1.5 → **1.0**(15:2 에 2 T, 3코어는 유닛마다 1 T · 둘만 직렬), `R.ZCD_H` 330 → **220 k**(계산 208.17 k) → OVP1 28.93 · OVP2 31.45 · 기동 종료 17.11 V · `k.OVsat` 1.258 → 개방시험 전류 16 A. 레귤레이터: C_aux → NPN 에미터 팔로워(15 V 제너 ±5 %, `R.BZ` 820 Ω) → 바이패스 다이오드(DS 5.1.8) → VCC 13.6 V(12.85–14.35). 판정 신설 `k.VCClo` 1.071(> HVSU 12 V) · `k.VCC` 재정의 25 V/V.CC_reg_max 1.742 · `k.RBZ` 1.013 · `k.CVCC` 1.132(`C.VCC` 680 µF) · `k.thand` 3.29 → **44개 중 41개 통과**, `k.auxr` 0.836 은 직결 판정이라 **워크북과 의도된 차이**. 게이트 전류 `I.VCC` = I_CC + 4·Q_g·f.Max = 103.5 mA — `Q.g` 78.6 nC 는 **DiscoverEE 목록 typ**(ST 데이터시트는 이 컨테이너에서 못 받았다). 기동: f.SU 에서 161.3 mA, 부하 없이 정격 전류로 출력을 12.75 V 까지 36.4 ms → C_VCC ≥ 601 µF, HVSU 충전 1.28 s. 6:1 은 R.BZ 680 Ω · C.VCC 1000 µF. 워크북 `fix_xl_aux2t.py`(F83 · F91 · B84 · D84–D100 캐시 · BOM E56 · CHANGELOG, 정본·복사본·6:1) — xl_sm 145/0 · bom 29/0. **절연(`insulation.py` 신설, 출처 7건 URL):** 강화절연(1차 = NP1 · NAUX · 코어), 5000 m(GB 4943.1-2022 범위 조항 원문 확인), PD2 · OVC II · IIIb → **공간 4.5 mm**(2500 V 과도, 강화는 4000 V 단계 3.0 mm × 1.48, 두 CB 성적서 모두 4.5) · **연면 6.4 mm**(320 V 행 × 2, 보간 안 함 — UL 은 보간, TÜV 는 행) · 고체 0.4 mm 또는 테이프 2층 · **3000 V ac 60 s / 4242 V dc**(TÜV 성적서, Class II 100–240 V 5000 m). 작업전압은 설계에서 추정(FB/HB · C_r 스윙 · 중성선=대지) 187 V rms · 373 V pk @264 Vac — 인증기관 측정 항목. **구조:** 나란히 감기의 **분리 간격이 곧 강화절연**이자 누설 → `cores.winding()` 이 간격 ≥ 6.4 mm 를 강제(마진 1차 1.0 · 2차 2.0 mm, 코어는 1차로 간주), ETD 49 는 3층 15 T 유지 · 간격 6.36 → **7.36 mm**. NAUX 는 **TIW 로 2차 위에**(출력을 따라가야 V_aux = n_aux·V_out 이고, 1차 회로라 강화절연 필요). 기하 검사 6항목 전부 통과(표 19). **발견:** 3코어 PQ 40/40 은 남는 폭 4.79 mm < 6.4 → `DESIGN.md` §4.2 11. **열린 것:** 30 kHz 초과 공간거리 표, 개정판 내전압 값, 양산 내전압, 2차 리드 ↔ 요크, TIW 승인 500 kHz < f.SU 503.5 kHz. 벤더 사양서 5절 신설(4종, check_trans_spec 에 NAUX 턴 · 연면 · 공간 · 간격 추가, 불일치 0). AN: 6.17 절연 원칙 재작성 · 6.26 VCC 공급(식 40–43) 신설 · 7.12 안전 절연(표 18 · 19) 신설 · 7.24 VCC 설계 · 표 6 · 표 16/17 · 그림 42(비대칭 마진 · TIW) · 측정 항목 2개 · 참고문헌 8건. 한국어판은 영문판 확인 뒤. |
| 2026-09-25 | **(65차) 전수조사 — 영문 AN 103쪽 한 줄씩 + 그림 43쪽 + 64차 산출물.** 사용자: "오류 다시 전수조사해". 28건(스크래치 r65/findings.md). **틀렸던 값 · 식:** ① **그림이 낡았다** — 64차가 시트를 바꾸고 `an_core_section` 만 다시 그려 **그림 45 핀도 "NAUX 3 T"**, **그림 46 막대 15.19 A**(본문 15.6 A), 그림 43 "15.2 A", 그림 33 이 옛 값이었고, **`f13_morphing` 은 63차의 "2 ×" 수정이 PNG 에 한 번도 반영되지 않았다**. 전량 재생성 · **`figstamp.py` 신설**(PNG 에 설계값 해시와 그린 함수 소스 해시를 새기고 그리지 않고 대조) · Stop hook 6번째 검사. ② **기호 충돌 V_Z** — TL431 LED 전원(12 V)과 레귤레이터 제너(15 V)에 같은 기호 → 제너는 **V_DZ**, 다이오드 강하 V_F(정류기 V_f 와 대소문자만 다름) → **V_D**. ③ **C_VCC 식** — HVSU 충전 전류를 17 → 8 V 전 구간에서 뺐는데 DS 는 12 V 아래에서만 켠다 → `t/[(17−12)/I + (12−8)/(I−I_HV)]`, 601 → **629 µF**, `k.CVCC` 1.132 → 1.082(6:1 1.215). ④ **절연 기하** — 플랜지 끝 반경에 보빈 **축 길이** `flange_h/2` 를 썼다 → `min(flange_w/2, r_win_out)`, 연면 7.05 → 7.30 · 공간 5.43 → 5.66 mm. ⑤ 7.3 "k_floor 가 통과한 것 중 가장 얇다" — **k_RBZ 1.013** 이 더 얇다 → 문장 정정(입력이 전부 최악값이라는 것과 함께). ⑥ 7.10 "3.6 mm foil build" 는 TIW 포함 → 3.0 mm · "all four windings" → NP1·NS2·NS3. **근거 없던 서술:** 6.26 · 시트 "12 V 아래면 HVSU 가 다시 켜져 선전력을 태운다" — DS 는 120 ms 뒤 재가동 여부를 말하지 않는다 → 그렇게 적고 10.1 표에 추가. 6.17 "중앙다리가 1차 밑에 있다" — 두 권선 모두 밑에 있다 → "1차가 창을 외각 다리 1.3 mm 앞까지 채워 코어를 떼어 놓을 수 없다". 7.12 GB "제품 표시" → "제조사가 달리 정하지 않으면"(원문). 내전압 60 s 근거 [PI] 추가, TIW 승인(원문 재확인: TÜV EN IEC 62368-1:2020+A11 · VDE IEC 62368-1:2018 Annex J · 1000 V rms · 500 kHz · **Class B**) → 130 °C 한계 명시. `Q_g` 78.6 nC 는 DiscoverEE 원문으로 재확인. **빠져 있던 것:** 개정 이력 V1.3 · 머리말(수치 출처) · 범위 노트 · 6.20 · 표 6(Q_g · 조정기 가정 · 안전 조건) · 표 7(V_CC · 절연 줄) · 표 8(k_VCClo · k_RBZ · k_CVCC) · 표 20 사양서(절연 · 내전압 · TIW) · 표 22 손실(V_CC 패스 트랜지스터 1.03 W 공칭, 시트 `P.Qpass_nom` 신설) · 표 23(패스 트랜지스터 · 제너 · 다이오드 요구) · 표 25 · 7.27 규칙 2개 · 10.4 미결 5줄 · 기호표. `CLAUDE.md` AN 쪽수. 시트 5벌 mismatches 0 · bom 29/0 · xl_sm 145/0 · 사양서 0. |
| 2026-09-25 | **(65차 뒤) 트랜스포머 예제 재확인 — 진단만 심었다.** 사용자: "트랜스포머 설계 예제에서 제대로 설계한건지 테이프는 실제로 저렇게 붙는게 맞는건지 등등 꼼꼼히 다시 확인해." **누설 인덕턴스를 기하에서 계산한 적이 한 번도 없었다** — AN 6.13 은 "간격이 누설을 정한다", 사양서는 11.0 µH ±10 % 라고만 했다. `leakage.py` 신설: 창 단면 2D 자계를 코어 µ=∞ 경계로 정확히 푸는 이중 코사인 급수(Roth), 동심·나란히 두 해석해와 상대오차 1e-9. ETD 49 · 15 T · 간격 7.36 mm → **15.6–38.7 µH**(목표 11.0). 간격을 0 으로 붙여도 약 20 µH. 3코어 PQ 40/40 은 11.8–14.7 µH. 같은 해에서 2차 구간 자계가 **포일 면에 수직**(1.18 대 0.37 mT/A) — 나란히 감기와 포일은 맞지 않는다. 설계 방향(외장 L_r · 2차 Litz · 다유닛)이 걸린 문제라 AN · 사양서 · 시트는 고치지 않고 `DESIGN.md` §4.2 13 에 올려 사용자 결정을 기다린다. `figs.py` 가 `figs_modes8` 이 쓴 그림 5장에도 도장을 찍는다(도장 없는 것은 ST 도면 3장만). 기호표에 k_RBZ. |
| 2026-09-25 | **(66차) 트랜스포머 예제 재설계 — 사용자 "(나)": 누설 적분 유지 + 2차 Litz.** 탐색(`leakage.py` 에 창 밖 계산 추가 — 중앙다리 면 위 자유공간 영상법, 창 안 대비 길이당 0.50–0.62): 2차를 Litz 로만 바꾸면 간격 6.4 mm(절연 하한)에서 **약 28 µH**, 1차 TIW 로 간격을 풀어 0 mm 로 붙여도 나란히 감기는 **12.6 µH** — 나란히 감기로는 11 µH 불가. **분할(P–S–P)** 이 답: ETD 49 에서 1차 **12 T + 3 T**(비대칭 — 11 µH 가 간격 범위 한가운데 오도록), **1차 TIW-Litz** 309 × ø0.10(+0.2 mm 가정, ø2.57), 2차 Litz 권선당 **2가닥**(401 × ø0.10, ø2.70 — 한 가닥 ø3.82 면 NAUX 까지 8.24/8.40 mm 로 반경이 빠듯), 2층 × 4열로 NS2 · NS3 교대, **층간 뒤집기**(안 하면 반쪽 누설 10.22 대 12.76 µH, 하면 11.09 · 11.11). 간격 공칭 2 × 2.0 mm → **10.90 µH**, 0–3.53 mm 에서 8.41–12.68. AN 식 26(1차원 상한, 신설) 13.7 µH, 나란히 + 절연 간격이면 35 µH. **절연:** 강화절연은 NP1 · NAUX 의 TIW 가 맡고 코어는 2차 쪽(`insulation.checks` 를 "경로마다 무엇이 맡나"로 재작성) — 열린 것은 1차 핀·벗긴 끝 ↔ 코어·2차 리드, TIW 승인 500 kHz < f.SU 504 kHz, TIW-Litz 이 굵기의 공급. 3코어 PQ 40/40 도 절연 간격 문제가 사라졌다(누설은 분할 없이 나란히가 맞다, 세트 8.1–13.4 µH). `cores.winding()` 새 배치(옛 것은 한국어판용 `winding_v64`), 그림 44 재작성(단면 · 펼친 권선 · 2차 묶음 배치도, 마진 테이프는 옆 구간 높이까지), AN 6.13(분할 · 식 26) · 6.16(포일은 동심 권선에서만) · 6.17(절연은 거리 또는 전선) · 7.10–7.13 · 표 6 · 7 · 15–20 · 34 · 7.27 규칙 · 기호표, 사양서 5절(NP1 TIW-Litz, 간격 무절연) · `check_trans_spec` NP1 선재 검사. 그림 44 옆 `an_xfmr_read` 의 "→ foil" → "→ secondary Cu", 원래 있던 figcheck 1건(격자선 위 글자)도 정리. 한국어판은 영문판 확인 뒤. |
| 2026-09-25 | **(67차) 섹션 권선으로 — 사용자: "나눠 감는 구조가 싫어서 큰 코어", "나눠서 감지 말라니까, 온세미처럼", "칸막이 넣는 방식으로", "온세미는 층층이 테이핑도 했는데 그것도 추가".** 큰 코어 검토: 나누지 않는 배치는 코어가 클수록 누설이 커진다(ETD 49 최소 14.6 · ETD 54 16.0 µH — 턴 길이 증가). ETD 54 원문(사용자 제공 URL, 저장소 파일과 바이트 동일): N27 · N87 · N97(N95 없음), 단일 공극, A_L 식 0.10–3.50 mm. 온세미 EER3542(Fair-Rite EER35 치수) 를 모델로 재현 66–77 µH vs 사양 ≤ 118 µH — 모델이 과장하지 않는다. 차이는 요구치(0.049 대 ≤ 0.091 µH/T²)와 2차 구리. **결정: ETD 49 · 2칸 보빈 섹션 권선** — 1차 TIW-Litz 15 T 한 칸(3층 × 5), 칸막이 1.0 mm(가정; TDK B66368 은 1칸뿐), 2차 Litz 권선당 한 가닥(ø3.82) 2층 · 층간 자리 바꿈(안 하면 12.42 대 18.68 µH), 층마다 테이프 0.05 mm(가정). **추정 14.13 µH — 목표 11.0 µH 보다 28 % 높고 +10 % 한계도 넘는다**(칸막이 0 이어도 12.46). AN · DESIGN 에 그대로 적고 첫 샘플로 판정, 넘으면 실측값으로 탱크 재검토. 반경 8.39 / 8.40 mm. `cores`: `PRI_SPLIT` 1.0 · `SEC_PAR` 1 · `G_NOM` 1.0 · `T_TAPE` 신설, 1차 1칸이면 간격 1개. 그림 44: 칸막이를 보빈 벽으로, 층간 테이프를 노란 선으로(축척 아님). AN 7.10–7.12 · 표 6 · 15–17 · 19 · 20 · 34(보빈 · 반경 여유 행 추가) · 7.27 규칙, 사양서 5절, `insulation.checks` 문구. |
| 2026-09-25 | **(68차) 코어를 E 60/22/16 으로 — 사용자: "1차/2차 높이를 맞추면서, 탱크값을 바꾸지 않으면서, 절연 기준에 어긋나지 않으면서, 보빈 안 빈 공간 없는 최적 코어", 이어서 "2차가 너무 두꺼워 감을 수 없다 — 4선 병렬이든 포일이든", "권선 사이 미세한 간격을 염두에".** **탐색:** Magnetics 2022 카탈로그(ETD 39–59 · EER 35L–53 · EC 41–70 · E 40–72)와 TDK 데이터북 2013(ER 35–54 · E, 사용자 제공 URL)의 창 치수로, 두 칸이 반경을 채우는 모든 층·병렬 조합을 `leakage.py` 모델에 넣었다(보빈 튜브 벽 1.3 · 플랜지 1.35 mm 는 TDK ETD 보빈에서 역산한 가정). 칸이 창 깊이를 채우면 누설 ∝ l_N × 구리 면적 / h_w² — **깊고 짧은 창**이어야 한다. 표준 보빈 그대로는 어느 코어도 네 조건을 동시에 못 맞춘다(층·가닥이 정수라 권선 폭이 계단식, 11 µH 에서 축 방향 3–5 mm 가 남음). 남는 폭을 **주문 보빈 플랜지 두께**로 흡수하는 것으로 정리하고, 전류밀도 · 철손 · Ae 여유로 **E 60/22/16**(Magnetics 0R46016EC, R 재질, Ae 248, 창 14.19 × 27.6) 선택. 2순위 E 42/21/9 는 Ae 107 로 B 192 mT — 철손이 ETD 49 의 약 2.4배(β 2.5 가정 상대치)라 제외. **포일 기각:** 2차 칸 안 누설 자기장이 반경 방향 12.5–13 mT 대 축 방향 ≤ 0.8 mT(1차 10 A) — 포일 면을 수직으로 뚫는다. **4선 병렬 기각:** 한 턴 높이가 3.06 mm 로 고정이라 한 줄 4개는 ø3.01 그대로, 2 × 2 는 J 7.5. 대신 턴을 2단으로 — **2차 턴당 8다발(96 × ø0.10, ø1.32) = 4다발 부분권선 2개(NS2a ∥ NS2b)**, 층 순서 NS2a · NS3a · NS2b · NS3b(모두 NS2 안쪽이면 반쪽 누설 13.91 · 12.75, 이 순서면 11.95 · 11.34), 층 바꿀 때 4다발 묶음을 반 꼬아 뒤집음(묶음 안 다발이 반경 방향 자기장을 다르게 쇄교 — 순환전류는 계산하지 않았다). **1차 TIW-Litz 2가닥 병렬**(156 × ø0.10, ø1.68 + 0.2), 6층 × 5자리. **권선 피치 k_w = 1.10**(가정 — 첫 샘플 실측으로 교체): 선경을 k_w 로 감은 빌드가 반경 12.70 mm 를 채우도록 정하므로 J 가 오른다 — 1차 4.48, **2차 4.73 A/mm²(J_CU 4.5 초과, 발열 실측)**. 칸막이 **G_NOM 1.1 mm → 11.00 µH**(꽉 감으면 10.77, 칸막이 ±0.5 mm 에 10.2 · 11.8), 플랜지 4.19 mm 씩, 권선 폭 19.23 mm. **새로 드러난 위험:** 카탈로그 E 60/22/16 은 A_L 연마 = **중앙다리 단일 갭 약 2.3 mm**(첫 추정)이고 1차 첫 층이 튜브 벽 1.49 mm 너머에 있다 — ETD 49DG 의 분포 갭이 없어졌다. 분할 · 분포 갭 가능 여부는 코어 업체, 갭 근처 권선 온도는 실측(AN 미결 항목표). 코드: `cores` — `CORES`/`MECH`/`BOBBINS` 에 E 60/22/16(사각 다리 `shape 'E'`, 주문 보빈 `custom`, 핀은 ETD 49 보빈 배치를 사양으로), `turn()`(사각 다리 평균 턴 · 코어 안 비율), `winding()` 재작성(반경에서 선경, `PRI_PAR` · `SEC_PAR` · `SEC_SUB` · `SEC_ORDER` · `K_WIND` · `FLANGE_MIN`, 인자 `k` · `order`), `V64_CORE`(한국어판은 ETD 49 로 고정). `leakage` — `k` · `order` 인자, `turn()` 사용. `insulation` 미결 문구. 그림 44 재작성(축척 · 8층 2차 배치도), 핀 그림 제목 · 각주. AN 7.10–7.13 · 사양 · 입력 · 미결 표(`openitems` 키) · 개정 이력. 사양서 1 · 2 · 3 절 문구. 한국어판은 영문판 확인 뒤. |
| 2026-09-25 | **(68차 뒤) 자체 검사 — 사용자: "이 설계가 맞는지 다시 검사해".** 카탈로그 옮겨 적기(E 60/22/16 치수 · Ae · 창) 재확인, 누설 급수 수렴(M·N 4배 → 10.998 µH 동일). **새로 계산해 드러난 것(1차 근사, `leakage.proximity` · `sharing` · `dc_loss` 신설):** ① 스트랜드 와전류 — 누설 자기장 13.6 mT rms 에서 NP1 3.9–5.5 W, 2차 2.6–3.7 W, 직류 3.2 W 의 2–3배. AN 은 ø0.10 을 표피깊이로만 골랐고 이 항을 계산한 적이 없다(직전 ETD 설계는 더 컸다). ② 2차 부분권선 안에서 옆으로 나란한 4다발은 반경 방향 자기장을 다르게 쇄교 — 층 바꿈 뒤집기로도 약 2.5 A rms 순환(다발 부하 3.5 A), NS2a–NS2b 2.9 A. 1차 2가닥 병렬은 약 0.1 A 로 무시 가능. ③ R 재질 철손 곡선 판독 약 1.8 W. ④ AN 문장 오류: "이 노트의 전류밀도 안에서"(실제 2차 4.73 > 4.5) · "뒤집어서 균등 분담"(실제로는 줄일 뿐) 수정. AN 에 교류 손실 단락과 미결 2행 추가. **사용자 지시로 ETD 49 · ETD 54 데이터를 코드 · 영문 AN · DESIGN 에서 삭제**(`CORES` · `MECH` · `BOBBINS`, `V64_CORE`, `PRI_SPLIT`) — 한국어판은 `winding_v64` 를 현재 코어로 돌려 빌드만 되게 두었다(이식 전). |
| 2026-09-27 | **(71차, 이 복사본) 예제 트랜스포머를 TDK ETD 54/28/19 + 카탈로그 보빈 B66396W + 칸막이 2.0 mm 로, 탱크를 그 누설에 맞춤.** 경위: 70차 전수조사("오류없나 검토해 다시 전수조사")에서 ① R.T 11 kΩ 이 새 f_o(80.1 kHz)에 안 맞아 dead zone 이 HB 경계 34 % ② AN 의 L_m `%.0f` 표시로 식이 서로 안 맞음(14/25 = 0.550 이라 적힘) ③ L_r 11.26 → 14 설명 없음 ④ 칸막이 기울기 −0.15 → −0.14 ⑤ 워크북 rtc/xl 경보는 캐시 탓(LibreOffice 재계산 사본으로 OK) 을 찾았다. 사용자: "트랜스포머 맨 끝에 테이핑하는게 맞는 방식이라서 자꾸 하는거야?" — **여백 테이프 1 mm × 2 는 근거 없는 가정이었고, "빈 공간 안 남긴다"는 지시에 사실상 2 mm 를 비워 둔 것**이었다(LGE 26OP-LM83W 사양서에 barrier tape 는 있으나 폭 · 목적은 적혀 있지 않다; 그 전에 "참고자료에 언급 없음"이라 한 것은 pdftotext 가 없어 검색이 돌지 않은 상태에서 한 말 — 틀렸다). → "칸막이 1mm 로" → "보빈 데이터가 없는 코어 쓰는게 좀 그래. 너 마음대로 24핀짜리라고 했는데, 근거가 있어?" — **E60 보빈 · 24핀은 근거 없는 우리 사양이었다.** → E 65/32/27(보빈 1칸 · 핀 없음, 창이 높고 얕아 채우면 동심 2.9 · 좌우 28.9 µH) → "ETD 코어로 찾자, 핀수도 데이터시트, 칸막이 없으면 따로 제작" → "혼합배치 안 해" → "칸막이 2mm 로 빈공간 안 만들 코어" → "ETD 44 · Cr 150 · Lr 18.4"(블록 모델 값 — 실제 다발로는 1차 J 6.6, 3.5–17 mm 가 빈다: 블록 모델 표를 다발 확인 없이 내민 것이 잘못) → "다시 진행" · "필요한 계산과 검토는 너가 알아서". **다발 단위 탐색**(1차 1–5층 × 1–3다발, 2차 층당 1·2·4턴 × 1–8다발, 칸막이 2.0 mm, 빈 틈 ≤ 0.25 mm, J ≤ 6): TDK 카탈로그 핀 보빈 11종 중 6종 성립 — PQ 50/50 21.6 · PM 62/49 23.7 · ETD 54 23.4 · E 55/28/21 25.4(핀당 28.6 A) · ETD 59 · PM 74 27.5 µH(f_o 38.5 kHz 로 R.T·C.T > 12 µs, `k.tau_hi` 미달). 각 후보를 스크래치 빌더(Lr14 를 579 결과 차이 0 으로 재현)로 시트 전체 계산 · R.T 재선정 · dead zone · 손실 비교. "자속 152 mT 가 카탈로그 기준점보다 높아 부담"이라 한 말에 사용자: "무슨 카탈로그?" — ETD 54 DS 의 P_V 측정 조건(100 mT · 100 kHz · 100 °C)이지 한계가 아니었고, 손실은 계산하지 않은 채 한 말이었다(N97 도 빠뜨림). N97 재질 DS(2025-06) 전형값 표로 운전점 자속(최대 122 mT, 152 는 시트 판정식 값)을 라인 주기 적분 → **코어 1.2–1.4 W**(DS 최대 비율로 약 2.2 W), 구리 직류 2.08 W + 스트랜드 와전류 약 2.7–3.9 W → 합계 E60 판보다 작다 → "ETD54 가 괜찮으면 진행". **적용**: 1차 TIW-Litz 턴당 3다발 · 4층, **층마다 묶음을 뒤집는다**(안 뒤집으면 1차 다발 순환 28 A, 뒤집으면 1.3 A — `leakage.sharing_pri` 새로 추가), 2차 5다발 · 4층 교대, 칸막이 2.00 mm, 축 방향 피치 1.106 으로 폭을 정확히 채움, L_short 23.34 µH · 반쪽 23.97 · 23.27. 탱크 L_r 23.4 · L_m 42.55 · C_r 200 nF · R.T 23.2 kΩ(k.floor 1.023, dead zone 5.0 %). 핀: 2차가 끝마다 3핀이면 12핀이 한 줄 11핀에 안 들어가 **센터탭을 핀 15–19 에서 공유**(핀당 NS2 · NS3 한 다발씩). 정본(3코어 자리표시자) 40/44(`k.Ae` 0.53), AN 예제 41/44. 워크북 F43 · F44 · F45 · Device Setting F24(`etd54_xl.py`) |
| 2026-09-26 | **(69차) 예제 트랜스포머를 B안으로 — TDK PC47EE60-Z, 두 칸 맞닿은 섹션 권선.** 사용자: "1차 2가닥 병렬인데 레이어마다 5개씩 … 짝수개로 들어가야지", "2차 8가닥 병렬 … 테이프가 있으면 병렬권선끼리도 나눠져", "병렬권선수가 너무 많으면 … 핀에서 나눠서 납땜", "TDK 카탈로그도 참고", "빈공간을 최소화", "평각 리츠는 비싸서 못써", A(2차 2다발 · 칸막이 0.5) · B(2차 3다발 · 칸막이 없음) · B′ 중 "B로 하자. 얼마 차이 안나니까 … 이전 예제와 트랜스포머 흔적 남기지 말고". **설계**(`cores.winding`): 1차 TIW-Litz 1가닥 378 × ø0.10(ø2.82) 4층 × 4자리(마지막 층 3턴 벌려 감음), 2차 턴당 Litz 3다발 389 × ø0.10(ø2.66) 나란히 · 층당 1턴 · 4층, 층마다 테이프, 두 칸 맞닿음, 플랜지 2.22 mm, J 3.69 · 3.10 A/mm². 코어 수치는 TDK 카탈로그(20231117) p.22 · p.31 로 옮겼다 — E min 43.8 · 창 반높이 14.05 ± 0.25 · 중앙다리 15.6 ± 0.4 → 반경 여유 12.60(68차 Magnetics 치수로는 12.70), A_e 247, A_L 5670 ± 25 %, 재고 갭 250 · 500 nH, 철손 11.35 W max(100 kHz · 200 mT · 100 °C). **L_short 11.46 µH**(+4.2 %), 꽉 감으면 11.03. **새로 드러난 것 둘**: ① 갭 — A_L = 373.02·lg^−0.7405 곡선이 약 2 mm 까지만 그려져 있어 137.8 nH 의 약 3.84 mm 는 외삽(68차 AN 의 "2.3 mm 첫 추정"은 프린징을 뺀 식이었다) ② **반쪽 누설** — CT 는 한 번에 반쪽만 도통하므로 탱크가 보는 값은 한쪽 단락값이다. 층 순서 3종을 풀어(`leakage.orders`) 교대 순서 NS2 · NS3 · NS2 · NS3 을 골랐다: 12.26 · 11.61 µH(NS2·NS2·NS3·NS3 13.99 · 12.75, NS2·NS3·NS3·NS2 11.60 · 12.51). 높은 쪽이 L_r +11 % 로 ±10 % 밖 — AN 에 그대로 적고 미결 항목으로. 2차 3다발 순환 전류는 둘째 턴에서 순서를 뒤집어 3.7 A rms(안 뒤집으면 18 A), 손실로는 약 0.09 W. 스트랜드 와전류 1차 근사 NP1 4.1–5.8 · 2차 3.7–5.2 W 대 직류 2.4 W. **x1 변형 시트의 `A.e` 가 21차 ETD 49 값 211 mm² 그대로였다** — AN 의 자속 검산(97.6 mT)이 고른 코어가 아닌 값이었다. 빌더가 `cores.CHOSEN` 에서 읽게 바꿔 247 mm² · 83.4 mT. 핀은 24핀(2 × 12, 5.08) — 2차 끝마다 다발당 1핀(핀당 9.45 A rms, 보빈 업체 확인). 옛 예제의 흔적(2가닥 병렬 · 8다발 부분권선 · 칸막이 · 평각 Litz 권고 · Magnetics R · PQ 32/30 · PQ 50/50DG 데이터)을 코드 · 그림 · AN · 사양서 · 문서에서 지웠다. 한국어판은 규칙대로 영문판 확인 뒤 이식(`winding_v64` 는 그때까지 남는다) |
| 2026-09-26 | **(70차) L_r 14 µH 복사본 `Lr14/`** — 사용자: B안 뒤 "칸막이 안 넣는 것도 일반적이야?"(참고 자료 전부가 2칸 보빈 — onsemi AN-4151 · TDK SRX/SRV · Infineon · LGE 26OP-LM83W · 삼성 JPE 2009 · Fairchild · Frenetic) → "플랜지 두껍게는 근거 없음" → Pollock APEC 2020(권선 사이 공기에 에너지를 두면 Q 가 좋아진다) → "여유공간 아예 안남기고 싶어": L_r 11 µH 에서는 창을 다 채우면 L 이 14 µH 이상이 된다(식 26) → "Lr 14uH Lm 25.46uH 로 … 검토" → "Cr=100nF 유지" → "이거 용으로 따로 복사해서 만들어 기존꺼 수정하지 말고". **탱크 L_r 14 · L_m 25.46 µH · C_r 100 nF**: λ 0.55 · n 그대로, f_r 151.8 → 134.5 kHz, I.pri_lc 10.91 → 10.38 A, I.Lm_pk 12.41 → 10.99 A, `k.ZVS` 2.09 → 1.52, **`k.floor` 1.02 → 1.15 · `k.RTd` 1.02 → 1.16**(R.T 여유 커짐), 정본(EE6405 자리표시자) B_pk 182 → 205 mT 로 **`k.Ae` 미달**(40/44), AN 예제(E60) 41/44. 트랜스포머: 1차 4층 × 4 · 2차 3다발 × 4층 · 플랜지 1.35 · 칸막이 1.73 mm(남는 폭 전부) → **13.99 µH**, 반쪽 14.83 · 14.12. 워크북 F44 · F45(`lr14_xl.py`, 캐시는 Excel 재계산 필요). 원본 파일은 하나도 바꾸지 않았다 |
| 2026-09-30 | **(72차, 이 복사본 `PQ50/`) 트랜스포머를 TDK PQ 50/50 한 개(15:2)로, 탱크를 그 누설에 맞춤.** 경위(Lr14 대화의 연장): ETD 54 의 1차 3다발 · 층마다 뒤집기가 "양산 불가" → 8:1 · 2차 1턴 · 박형 코어 탐색(ELP 64 E-E 만 성립, 보빈 데이터 없음) → "보빈 데이터 있는 코어만 · 복잡한 구조 금지 · 인위적으로 굵은 선 금지 · 빈 공간 금지 · 외부 인덕터 절대 안 씀 · 칸막이는 정상 두께" → 8:1 · 2차 1턴은 1차 8턴이라 정상 칸막이로 누설 5–7 µH(탱크 하한 약 8–12 µH) — **해 없음** → 사용자 "15:2 로 찾자". 데이터시트 보빈 20종 스캔에서 **PQ 50/50(B65982E, 12핀)** 만 전류 기준 선경으로 반경을 채운다. **치수는 TDK PDF 벡터에서 읽었다**: 코어 창 바깥면 22.0 mm(원호 ø44, 안쪽 16 mm 선은 바깥다리 끝의 숨은선), 플랜지 끝 반경 21.3–21.6 mm, 권선 폭 30.4(튜브 쪽) → 약 31.7 mm(바깥), **요크는 직사각형이 아니라 나비넥타이**(날개 가장자리 (4.80, 11.21)–(16.02, 15.18) mm) — 직사각형으로 본 첫 계산이 누설을 약 17 % 과대(29.8 → 24.8 µH)했다. 권선: NP1 3층 × 5 T TIW-Litz ø2.9(ø3.0 은 반경 10.05 로 플랜지를 넘는다) · 칸막이 3.0 mm · NS2 2 T 한 층 → NS3 2 T 한 층 Litz ø4.0 · NAUX 2 T 맨 위 (사용자: 층 안에서 NS2 · NS3 자리 바꾸기 금지 — "그냥 칸막이만 만드는 쉬운 권선"; 두 가닥 동시 감기는 반쪽 차 38 % 라 탈락). 2D FEM(스트랜드 근접 · 코어/끝단 두 단면, 나비넥타이 가중) 누설 23.3–26.4 µH · 반쪽 NS2 24.5 / NS3 25.1. 탱크 **L_r 25 · L_m 45 · C_r 180 nF(E12) · R.T 21.5 kΩ(E96)** — C_r · L_m · R.T 고정, L_r 22.3–28.6 µH 에서 41/44. 시간영역 손실(스크래치 계산 — 스크립트는 저장소에 없다) 4.7–6.0 W(구리 3.8–5.1 · 코어 0.9–1.0 @100 °C, 80 °C 면 코어 약 1.5 배), 반쪽 누설 차로 평균 전류 3.7–6.0 % 차, 자화 DC 0.19 A. NAUX 위치: 2차 위 2.4 % · 아래 5.3 % 추종 오차(FEM) → 위. N97 손실식은 재질 DS(2025-06) 두 점과 B 지수 2.7–2.8 로 확인, 갭 공차는 손실에 0.7 % 미만. **적용**: `cores.CORES['PQ 50/50']`(DS 값), 빌더 `7p5to1` · `7p5to1_x1` 탱크, R.T 21.5 k, 워크북 `pq50_xl.py`(F43 · F44 · F45 · F24 · **F9 n 6.0241 → 6.0134**). **F9 를 처음에 빠뜨려 `xl_sm_compare` 11칸이 0.4–0.9 % 어긋났다** — λ 가 0.556 이 되면 n 이 움직인다; 그 뒤 145/145. 검증: 빌더 4변형 0 · `check_sm` OK · `bom_compare` 29/0 · `rtc_check` OK · `check_theta` 0 · `audit_dim` 0 · `audit_rpn` 1(P.DZ W↔mW 표시 오탐, Lr14 와 같음) · `audit_xl` 78건(Lr14 와 같음). `_x1` 41/44 · 정본 40/44(`k.Ae` — 3코어 자리표시자). **남은 것**: AN · 그림 · 벤더 사양서 · `cores.winding()` · `leakage.py` 는 아직 ETD 54 판; 핀 전류 · Litz ø4.0 굽힘 · EFOLIT 절연 두께 · 누설 실측 · 온도는 벤더/시제품 |
| 2026-09-30 | **(73차, 이 복사본 `PQ50/`) AN(영문) · 그림 · 벤더 사양서를 PQ 50/50 판으로 — 옛 코어 흔적 삭제.** 사용자: "진행하고, 지난 코어에 대한 흔적은 다 지워버려 가이드에서." **`cores.py`** 를 다시 썼다: `CORES` 에서 E 60/22/16 · ETD 54 삭제(PQ 40/40 은 3코어 시트가 읽어 남김), `MECH['PQ 50/50']`(TDK PDF 벡터 치수), `zones()`(한 턴을 바깥다리 옆 · 요크 밑만 · 코어 밖으로, `YOKE_SHARE` 0.5 가정), `BOBBINS` 12핀(핀당 한 가닥, 센터탭 9–10 은 보드에서), 둥근 선경 `D_PRI` 2.9 · `D_SEC` 4.0. **`leakage_fem.py` + `fem2d.py`(신규, scipy)** — 2D 유한체적, 코어 · 끝단 두 단면을 반경별 턴 길이로 가중. 반쪽 NS2 24.50 · NS3 25.14 µH, 둘 다 단락 23.09 µH, 갭 1.784 mm, 와전류는 자화 전류 장까지. `leakage.py`(1D)는 턴 길이 하나라 PQ 에서 반쪽 순서를 거꾸로 낸다 — 기준에서 뺐다. **사양 측정 조건을 바꿨다**: 탱크가 보는 것은 한 반쪽이 도통할 때라 **반쪽마다 단락 ±10 %**, 둘 다 단락은 기록값(더 낮게 읽힌다). AN 6장 표 · 7장 · 벤더 사양서(항목 2 · 주석 26) 같이. AN 7장: 빌드 · 누설 · 나비넥타이 요크 · 칸막이 손잡이 · ac 손실 · 코어 · 갭(데이터시트에 A_L–갭 관계 없음, μ0Ae/A_L 과 FEM) · 권선표 · 핀 절 · 절연 · 사양 · 열린 항목. 그림 44(세 번째 판을 요크 평면도 + 턴 구간 색으로) · 45(B65982E 핀). `insulation.py` 에 1차 핀 ↔ 코어 공간거리 6.01 mm 행. **`R.T` 서술 두 건**: ① `%(RT).0f` 가 21.5 를 "22 kΩ" 으로 찍던 다섯 곳을 `%g` 로 ② 이 탱크는 `k.floor` 1.077 · 허용 L_open 하락 13.8 % 라 ±10 % 공차가 **들어간다** — Lr14 문장("안 들어간다, R_T 를 낮추면 덮는다")이 틀려 열린 항목 행을 여유에 따라 갈리게 했고, 여유 주석의 "가장 얇은 여유 · 2 % 로도 모른다"를 뺐다. `DESIGN.md` 5b 도 23.2 kΩ(Lr14) → 21.5 kΩ, **dead zone 비율은 이 탱크로 다시 계산하지 않았다**고 적었다. 빌드 수식 한 줄이 열 폭 530 pt 로 넘쳐(`an_pdf` exit 1) h_A · h_S 를 두 줄로, `an_symbols` 가 잡은 h_A · h_S 를 기호표와 본문에 추가. **한국어판 PDF 는 이 복사본에서 뺐다**(ETD 54 판, 영문 확인 뒤 이식). **8:1 · 6:1 시트**: 2112d65 에 공용 `R.T` 21.5 kΩ 으로 빌드된 판(f.sw 하한이 그 탱크에 안 맞음)이 들어가 있어 Lr14 판으로 되돌렸다 — 빌더의 `R.T` 가 변형마다 다르지 않아서이고, 두 파일은 `check_sm` OK. 검증: 빌더 `mismatches 0` · `check_sm` OK · `bom_compare` 29/0 · `check_trans_spec` 0 · `figcheck` 55장 0건 · `figstamp` 0 stale · `an_check` 기하 문제 0 · `an_symbols` 표에 없는 기호 0 · `an_figtext` 그림 44 · 45 지적 0 · `audit_md` 0. PDF 본문에서 ETD · E 60 · PC47 · B6639 · PQ 40 · 옛 탱크 값(23.4 µH · 200 nF · 42.55 µH · 23.2 kΩ) 검색 0건. `.fem_cache.json` 은 무시 파일 |
| 2026-09-30 | **(74차, 이 복사본 `PQ50/`) 핀 그림 — 어느 쪽에서 본 것인지 밝히고 보빈 형상을 데이터시트 도면대로.** 사용자: "밑에서 보는건지 위에서 보는건지 정확하게 해줘야지. 그리고 좀 더 형상을 구체적으로 그려줘". 73차 그림은 데이터시트의 번호 뷰를 옮기며 "VIEW IN MOUNTING DIRECTION"이라고만 적었다 — 근거 없는 이름이었다(도면에 뷰 이름이 없다). **판단**: 도면은 정면도(핀 아래) 위에 핀 끝이 ⊕ 로 보이고 1 · 6 · 7 · 12 · 핀 1 표시가 있는 뷰, 아래에 핀이 없는 뷰를 둔다. 위에서 보면 핀은 베이스 블록 안에 가려진다(단면 A-A 에서 핀이 밑에서만 들어간다) → **번호 뷰는 밑면도(핀 쪽)**, 제1각법. 두 뷰 모두 모따기 모서리가 왼쪽이라 투상과 모순 없다. **적용**: `bobbin_outline.py`(신규)가 데이터시트 한 쪽(`data/TDK_B65982E_coil_former.pdf`)의 벡터에서 세 뷰 윤곽을 읽어 `data/B65982E_outline.json` 으로(`--check` 도면 치수 7개 통과, 선 두께로 +0.4 mm). 그림 45 를 네 판으로: 회로 기호 · 정면도(PCB 위, 보는 방향 화살표 A · B) · **A 밑면도(핀 쪽, 데이터시트와 같음, 핀 실선)** · **B 윗면도(권선 쪽 = PCB 부품면, 좌우 바뀜, 핀은 가려져 점선)**, 모따기(핀 1 표시)를 양쪽에 화살표로. 윤곽선은 zorder 1.6 — `figcheck` 가 z 2 선을 전선으로 읽어 처음 439건이 났다(도면이지 배선이 아님). `cores.PIN_NOTE`(AN 캡션 · 벤더 사양서 주석 18)와 AN 핀 문단에 "밑면도 기준, 부품면에서는 좌우 반대"를 적었고 `cores.py` 주석에 `PIN_XY` 가 밑면도 좌표임을 명시. 검증: `figcheck` 0 · `an_check` 0 · `an_symbols` 누락 0 · `check_trans_spec` 0 · `figstamp` 0 stale. 같이 고침: `CLAUDE.md` 워크북 행이 아직 ETD 54 탱크 값(200 · 23.4 · 42.55 · 23.2, `etd54_xl.py`)이었다 → `pq50_xl.py` 값 |
| 2026-09-30 | **(75차, 이 복사본 `PQ50/`) "위에서 본 코어" 판을 알아볼 수 있는 별도 그림으로 · 핀 그림에서 옆면도 삭제.** 사용자: 그림 44 셋째 판("the core from above")이 "뭔 그림인지 이해가 안 간다", 핀 그림의 코일 포머 옆면도는 "없어도 될 듯". **핀 그림(`an_xfmr_pins`)**: 옆면도(보는 방향 화살표) 대신 "A · B 읽는 법"을 글로 — A 밑에서(핀 끝이 보임, 데이터시트 방식), B 위에서 = PCB 풋프린트(부품면, 좌우 반대); B 의 핀은 패드로 보아 실선. **새 그림 `an_core_plan`**(그림 44 에서 분리): 왼쪽은 위에서 본 코어(축척, `cores.MECH`) — 바깥다리 · 나비넥타이 등판 · 중앙다리에 이름표, NP1 전체를 옅은 고리로 등판 밑에 깔고, 가운데 턴을 색 셋으로; 앞 · 뒤는 코어가 없다고 적음. 오른쪽은 색의 뜻(페라이트로 둘러싸임 · 위아래 판만 · 공기 중)과 왜 필요한지(L_r 가 누설이고, 두 경우를 풀어 이 비율로 반경마다 더한다, 가운데 몫은 반씩 — 가정). 백분율은 `cores.zone_pct()`(최대 잔여 반올림, 합 100)로 그림과 본문이 같은 값 — 예전 48 · 11 · 42(합 101)는 반올림 탓, 이제 47 · 11 · 42. 그림 44(단면)는 두 판으로. **중앙다리 쪽 등판 끝점 (3.5, 9.33)** 이 그림 코드에 적혀 있었다 → `MECH['neck']` 로 옮기고 출처 기록: 04/13 databook 도면(`data/TDK_B65981A_core.pdf`, FPK0457-U) 벡터에서 (16.14, 15.30)–(5.17, 11.30), 필렛, (3.52, 9.41) — 기존 값과 0.1 mm 안. 검사: `figcheck` 세 그림 0(처음엔 범례 막대가 전선으로 · 글자 6.4 pt · 설명 글 그림 밖 — 고침) · `an_check` 0 · `an_symbols` 누락 0 · `figstamp` 0 stale. 그림 번호가 하나씩 밀렸다(평면 44 · 단면 45 · 핀 46) **뒤이어**: 사용자 "이런 설명은 없어도 돼. 탑뷰 바텀뷰 적어놨는데" — 핀 그림의 "A · B 읽는 법" 글 판을 지우고 회로 기호를 위 가운데로, 판 제목을 **A BOTTOM VIEW (pin side)** · **B TOP VIEW = PCB FOOTPRINT** 로. `figcheck` 0 |
| 2026-09-30 | **(76차, 이 복사본 `PQ50/`) 최종 검토 1회차 — 영문 AN 111쪽 한 줄씩, 그림 49장.** 사용자: "한 줄씩 다 읽어보고 철저하게 … 길게 쓴 문장 · 비원어민 표현 · 수식/그래프/파형/그림/설계 오류 · 빠진 핵심 설명". **이번 설계와 틀린 내용 6건**(모두 옛 탱크 · 옛 코어에서 남은 문장): ① 6.10 L_short "2차 전부(센터탭은 두 반쪽) 단락" — 표 4 · 7장 · 사양서의 "반쪽씩, 둘 다 단락은 기록"과 모순 ② 7.3 "k_RBZ 1.089 가 통과한 것 중 가장 얇다" — 실제는 k_PSR 1.051(k_VCClo 1.071 · k_floor 1.077 도 더 얇음) → 표 값에서 골라 쓰는 `_thinnest_text()` ③ 7.19 "f_sw,max,op = 177.7 kHz, 실제로 도는 최고 주파수" — 빌더 정의는 1.5 × 118.5 kHz(운전 최고)를 225 kHz 로 제한한 설계값 → 기호 f_sw,des · 설명 · 기호표 ④ 7.19 · 표 6 · 10.1 "T_idle 700 ns 면 f_Min 이 f_o 아래 / 바닥 여유가 닫힌다 / 두 클램프가 운전 범위를 못 감싼다" — 이 탱크는 700 ns 에서 f_Min 46.3 > f_o 44.8(여유 1.032) · f_Max 227 > 118.5 → 비교 결과로 문장을 고르는 `_idle700_text()` ⑤ 7.28 "f_sw(θ)… the thinnest margin in the design" ⑥ 기호표 L_short 정의. **그림 결함 4**: 그림 24 셋째 판 설명 둘째 줄이 x축에 잘림, 그림 41 f_o 상자가 f_sw 곡선을 가림, 그림 10 "(b) is the ZVS window" → "4 is …", 그림 17 "the gap shaded"(공극으로 읽힘) → "the difference shaded" · 캡션 "what the secondary removed"(플라이백에선 반대) 수정, 그림 21 · 22 "reactor" → "inductor". **표현**: V1.3 개정 이력 축약(이 복사본에 없는 "Korean edition published" 삭제), n_T 정의, 6.4 첫 항목 · 6.26 첫 문장 · 7.10 배치 문장 분할, 6.16 "두 가지 방법" 목록의 셋째 항목 분리, 6.17 "The core counts as the side it cannot be kept away from" → 쉬운 문장, 6.20 "공급자 선택"을 7장과 맞게, √d 서술 정확히(실효값은 √d 에 비례), 7.4 7단계 "L_r pairs with C_r" → 누설이 L_r, 7.10 "평균 24.82 is L_r 25.0" → 1 % 안, "3.0 mm is the most this note allows"(근거 없음) → 얇게만 바꿀 수 있다, 7.13 시동 경로 목록에 머리말, 표 6 f_r 150 kHz 주석 "magnetics size" → 출발점. **설명 보강**: 손실표에 트랜스포머 권선 4.6–5.6 W(7.10 의 dc + 스트랜드), 코어 손실은 계산하지 않음. 쓰이지 않는 기호 K₁ · K₂ · s · d_b 삭제. 검증: `figcheck` 56장 0 · `an_check` 0 · `an_symbols` 누락 0 · `figstamp` 0 stale · `audit_md` 0 · `check_trans_spec` 0. PDF 텍스트로 수정 21곳 반영 확인 |
| 2026-09-30 | **(77차, 이 복사본 `PQ50/`) 최종 검토 2회차 — 1회차에서 안 본 것 위주.** 사용자: "한 번 더 같은 작업 진행 하되, 안보고 넘어간 것 들 위주로". **수식 108개 · 계산 블록 74개를 전부 숫자로 다시 계산**(예: K_v 2.7218, EA_o 32.53, ω_c 110.4, Φ_M 49.64°, f_180 202 Hz, GM 34.2 dB, D3 4.23 %, C_T,max 894 pF, R_T 상한 23.20 kΩ, OVP 28.93/31.45 V, I_VCC 92.8 mA, R_BZ 0.893 kΩ, C_VCC 587–588 µF) — 식과 대입값 · 결과가 어긋난 곳 없음. 1회차에 이미지로 안 본 그림들 확인 — 결함 없음. **벤더 사양서**: NP1 턴 수 "15 Ts" → "15 T"(다른 권선과 같게), 32행 주석을 변형별로 — 트랜스포머 1개(`_x1`)는 "참조 설계의 코어 · 코일 포머 · 권선 배치가 3-2 를 정한다, 다른 구조는 3 · 5절을 만족하고 첫 샘플 승인 뒤에만", 코어 3개는 종전대로 "공급자 선택"(`build_trans_spec.py`, 두 사양서 재생성). **표 자릿수 통일**: 표 7 λ 0.56 → 0.556, n 6.01 → 6.013, Φ_M 49.64° → 49.6°(표 7 · 25, 표 24 · 그림과 같게), 7.10 첫 누설 계산과 그 문장의 l_N 100 → 100.5 mm(둘째 계산과 같게), 사양 요약표 f_o 45 → 44.8 kHz. |
| 2026-09-25 | **(60차) 설계 예제의 트랜스포머를 "계산 → 코어 선정 → 권선 → 핀 → 검증" 순서로. 그림 17 플라이백을 DCM 으로.** 사용자: "코어 선정을 미리 해놓고 짜맞추는 느낌 … 계산 먼저 하고 이 코어가 잘 맞는다~ 라고 설명해야지. 그러고 나서 핀 선정 … Figure 44 가 먼저 나와버리잖아." 영문판 7.9–7.10 을 네 절로: **7.9 What the transformer must provide**(탱크 요구·턴수·그림 43·표 14) → **7.10 Choosing the core**(자속 → A_e ≥ 103 mm² · 동선 면적 계산 줄 신설(권선별 A_cu, 합 61.6 mm² → A_N ≥ 205 mm²) · skin depth/Litz/동박 · "What the core must offer" · "The core": ETD 49/25/16DG 가 세 조건을 만족 — A_e 211 은 자속 요구의 2.0 배, 권선창 76 %, 권선 사이 6.36 mm, **자속만이면 절반 면적으로 되고 권선창과 폭이 정한다**(6.12 절) · 표 15 산수) → **7.11 The winding and the pins**(그림 44 단면 · 표 16 · 핀 그림 45 · 표 · 극성) → **7.12 Checking the flux, and the specification**(고른 코어의 B_pk 97.6 mT · I_eq · I_sat · 그림 46 · OVP2 · 시험법 · 사양서). 표 13 에 key `currents`. 6.19 의 절 참조를 새 절 이름으로. **그림 17**: 플라이백 칸이 CCM(전류가 0 으로 안 내려감)인데 그림 18 은 DCM 이라 서로 달랐다(사용자 질문). 논지(매 주기 저장한 에너지를 전부 내보냄, B_pk ∝ I_p,pk, 자속이 매 주기 0 에서 시작)에는 DCM 이 맞다 → DCM 으로 다시 그림(on 0.40 · 2차 0.40 · 휴지 0.20), 제목 "FLYBACK (DCM)", 캡션에 그림 18 과 같은 모드임을 명시(영·한). **한국어판의 7.9–7.12 재구성은 영문판 확인 뒤 이식**(규칙). figcheck 55/0 · an_check 두 판 · MISSING 0. **덤으로 찾은 것:** 그림 6–9(`an_modes_12/34/56/78`)가 코드 변경 없이 바뀌어 나왔다 — `figs_modes8` 는 전류 하이라이트가 따라갈 코일 목록을 **import 때 한 번** `schemx.register()` 하는데 `figs_ref.an_pfc_boost` 가 끝에서 `register()` 로 전역 목록을 비운다. 그래서 일괄 렌더 순서에 따라 하이라이트가 코일을 따라가기도(의도) 코일 위를 직선으로 지나가기도 했고, **AN 이 읽는 `figures/an/` 판은 직선판**, 제목 붙은 `figures/` 판은 코일판으로 서로 달랐다. `build()` 가 그리기 직전에 등록하도록 고쳐 순서와 무관하게 코일판으로 고정(목록을 먼저 비운 경우·새로 그린 경우 모두 커밋된 판과 바이트 동일). |
| 2026-09-24 | **(59차) 기동 종료 ZCD 임계를 데이터시트 값 1.36 V 로.** 사용자: "데이터시트 기준으로 해." (57차 질문: ST 툴 1.35 V vs DRAFT DS 전기적 특성 표 V_ZCD_SUend 1.36 V typ). 빌더 `V.ZCD_SUend` 1.35 → 1.36 → `V.out_SUend` 16.53 → **16.65 V**(7.5:1; 6:1 워크북 16.56 → 16.68). 정본 시트·변형 4종 재빌드(실제 변경 두 줄, 줄바꿈은 파일마다 HEAD 와 같게 — 정본·`_x1` LF, 나머지 CRLF). 워크북은 `fix_xl_suend.py`(`xlsx_patch`): `Device Setting` D71 = 1.36, 의존 D88·D98·D99 는 수식 유지·캐시값 재계산, CHANGELOG_rev0_6 기록(정본 행 115, 6:1 행 113), 정본을 variants/7p5to1 로 복사. `xl_sm_compare` 145/145 일치. 설계 가이드 md 두 곳(식 [99] 설명, 부록 C 의 ST 툴 차이 목록)에 반영. AN 7.20 문장에 이 전압이 무엇인지 설명 추가("ZCD 핀이 기동 종료 threshold 1.36 V 에 닿을 때 … OVP1 출력 전압의 1.36/2.3") — 1.36 은 빌더 상수에서 읽는다. 판정 지표 영향 없음. **출력 뱅크 ESR 의 2f_l 성분**은 사용자: 커패시터 사양 미정 → 57차 표기("2f_l 성분 빠짐") 그대로. |
| 2026-09-24 | **(58차) 입력 조건을 "Vac eq." 대신 상용전원 전압 + 브리지로 표기.** 사용자(그림 39 캡처): "332 Vac eq 가 뭔데? 332 Vac 입력이 어딨어 … 110 Vac (FB) 220 Vac eq 이런 식으로 표기하니까 알아보기 더 어려워. 알아보기 쉽게 표기해." `l6790.line_conditions` 이름을 "173 Vac, half bridge (HB edge)" · "90 Vac, full bridge" · … · "166 Vac, full bridge (FB edge)" 로, 탱크가 보는 전압은 `tank_sees()` 가 "tank sees 2 × 166 = 332 Vac" 로 풀어 쓴다(`mains_of`·`cond_short` 신설). 그림 39 패널 제목·상자 첫 줄, 그림 40·43 범례, 표 10 열 제목("166 Vac / FB edge" + 캡션에 FB·HB 뜻), 표 11·12(열 "the tank sees (Vac rms)"), 7.5·7.6·7.8·7.9·7.25 문장과 표 13·18, 그림 26 메모("FB edge: 166 Vac mains, tank sees 2 × 166 = 332 Vac"), y축 "[Vac equivalent]" → "[Vac]". 4~6장의 등가 입력 **개념 설명**(V_ac,eq 정의, 6.2 절)과 계산 기호는 그대로. 한국어판 같게(`_kc` 번역, "풀브리지 166 Vac, 탱크에는 332 Vac"). 값은 하나도 안 바뀜. |
| 2026-09-24 | **(57차) 56차에 남긴 문서 항목 처리.** 사용자: "뭐가 남았어" → 문서 쪽 1·2번 진행. **과장·근거 없는 단정:** "Every LLC text writes 8/π²" → "The usual LLC form" · "Every transformer text says to interleave" → "The usual advice" (영·한). "120 Hz tan δ 는 5~10 배 크다"(근거 없음) → 삭제하고, **ESR 은 전류 성분마다 그 주파수의 값**으로 규칙을 고쳤다(6.23 · 7.24 체크리스트). 이 설계는 2f_l 성분 18.6 A rms 가 스위칭 성분 23.8 A 와 비슷한데, 시트의 P.Cout 0.162 W 는 30.24 A 전부를 스위칭 주파수 ESR 로 계산한다 → 표 20 에 "2f_l 성분은 빠져 있음(실장 부품 tan δ 모름)" 명시. **수치는 안 바꿨다 — 부품 tan δ 가 있어야 계산 가능.** **16.53 V(기동 종료 출력 전압) 출처:** V_ZCD_SUend × V_OVP1/2.3 V. 시트·워크북(ST 원본 `Device Setting` D71 포함)은 1.35 V, **DRAFT DS 전기적 특성 표는 1.36 V(typ)** → 1.36 이면 16.65 V. 어느 쪽을 쓸지 사용자 판단 대기, 값은 그대로. **검사기 목록 판정:** an_symbols SILENT 44 중 문장에 말로도 설명이 없던 넷(ω_l · M_OL · L_L1/L_L2 · μ_0)에 식 곁 정의 추가, 나머지는 인접 문장이 말로 설명. LATE 52 는 "식 뒤 with X …" 관례(먼 11개는 53차에 처리). an_figtext UNDEFINED 63 은 대부분 그림이 먼저 오고 바로 뒤 문단이 정의하는 배치 · 그림 안 설명 있음. 그림 30 캡션에 V_BO = 브라운아웃 threshold(R_CFG, 7.19) 추가. LITERAL 12 는 전부 기존 판정(400 V 관례·공칭 상용전원·시험 조건·정의·각도) 그대로. |
| 2026-09-24 | **(56차) 사람이 읽듯이 영문판 → 한국어판 통독.** 사용자: "사람이 읽듯이 읽어서 검사는 못해?" → "둘 다 해. 영문판 먼저 읽어보고 수정하고 한국어판에 적용하면서 읽어봐." 검사기가 못 잡는 부류(표끼리의 모순 · 정의 없는 전제 · 한 기호 두 뜻 · 근거와 다른 문장)를 찾았다. **수치 모순:** 표 11(게인 차트 교차점)과 표 12(스윕)의 같은 주파수가 156.3/156.4 · 163.1/163.2 kHz 로 달랐다 — `figs_pf._cross` 가 격자점으로 내림해 0.06 kHz 낮았다(정확한 근 = 스윕) → 격자 안 선형 보간. 7.11 "허용 리플 10 % 면 결정 조건이 바뀐다" — 실제로는 5.23 % 에서 바뀐다 → `an_pdf.V['ripSwap']` 로 계산. 표 17 "32.7 − 4 − 11.85 − 10.5 = 6.36"(손으로 하면 6.35) → 피연산자 3자리. "61.6 mm², ku 0.30 에서 AN 의 76 %"(61.6/269 는 23 %) → "ku 0.30 이면 205 mm² 필요, AN 269 mm² 의 76 %". **문장:** 표지 "실측이라고 적은 값만 실측" — 그런 값이 없다 → "실측값은 없고 계산값 또는 부품 데이터시트 값". 7.16 주의문 T_idle 을 두 값으로 적었다 → 정오표와 같은 세 값(700·350·250). 표 6 버스트 "정격의 11 %" → P_in 의 11 %(75.3 W = 0.11 × 684.8). 표 18 Open 인덕턴스 "−4.1 % at worst" → "공칭보다 최대 4.1 % 낮은 값까지(식 Ldrop)". 7.10 코어 "중앙 다리를 연마, 갭 1.1 mm" vs 표 18 "분산 갭" → 분산 갭 합계 1.1 mm 로 한 문장. 7.14 에 R_BM 30 kΩ 을 그대로 두는 이유(버스트 진입점이 가정값, 대기전력 실측 뒤 결정) 한 문단. 표 4 · 6.14 · 6.15 가 "1차는 직렬, 2차는 병렬"을 전제로 썼는데 예제는 트랜스포머 1개 → N_x 개로 나눌 때로 조건화, 6.21 참조. 2.12 "½L_m i_μ²"(모델 L 과 물리 전류 혼용) → ½L_μ i_μ², L_μ 첫 사용처에서 정의(6.9 참조). 그림 13 파형 라벨과 가운데 회로의 중점 라벨 v_d → v_A(v_d = v_A − v_B 로 정의돼 있는데 그림은 레그 1 중점 0 → V_in). 그림 23 캡션에 v_ac 정의(an_figtext 가 정의 전 사용으로 짚음). **기호(한 기호 한 값):** L_p(탱크 L_r+L_m 과 플라이백 1차 인덕턴스) → 탱크 쪽 삭제, 4.8 m = (L_r+L_m)/L_r · i_ac(정류기 입력 전류, 상용전원 v_ac 와 충돌) → i_RI(그림 3 포함) · I_rms(2.15 입력 전류와 6.15 권선 전류) → 2.15 를 V_ac·I_ac 로(7.19 계산 줄의 단위 V_rms 는 Vac 로) · P_cond/P_mos,dc · f_c/f_cross 같은 양 두 이름 → 하나로 · M_min/M_max 기호표 풀이를 쓰인 자리(일반 LLC 절차)대로. **한국어판:** 위 전부 이식 + 표 22 "버스트 threshold 를 벗어난다"(모호) → "리플이 버스트 threshold 를 넘나들지 않는다". 번역투는 크게 걸리는 곳이 없었다. **확인하고 둔 것:** 7장 산수(여유비·손실 합·리플 성분 제곱합·OVP 자속 비례·Γ_v·√(G_oEA_o)) 재계산 일치, 표 8 f_sw 249 kHz 가 사양 225 kHz 를 넘는 것은 7.16 에 설명돼 있음. |
| 2026-09-23 | **(55차) 데이터시트 원문 전수 대조 뒤 수정.** 사용자: "확인해서 뭐가 맞는건지 먼저 판단부터" → 판단 보고 → "확신이 있으면 수정". 데이터시트(DRAFT, 23쪽)와 AN 의 IC 상수를 전부 맞춰 보았고 FB 법칙·R_BM·OCP1/2·OVP1/2·V_CC·발진기 한계·모핑 문턱·CFG 표·FB 전류·핀 규칙은 일치. 고친 것: ① 보호 표의 비용량성 보호 "ZCD 에지 감시" → **ISEN**(DS 5.2.5, soft/hard 두 단계) ② OCP1 "cycle-by-cycle" → 스위칭 주파수 상승(DS 5.2.6) ③ 오류 목록 T_idle "Table 5" → **Table 2**(권장 동작 범위), 5.3.2 절 안의 C_T,max 식이 뜻하는 350 ns 추가 — 값 셋(HISTORY §3.1 C.1 과 일치) ④ ZCD 주의문 "데이터시트의 권선비 상한" → 25 V V_CC 정격에서 유도한 상한(DS 에는 없음) ⑤ 4장 식 V_FB 의 P_in → **P_in,LLC**(DS 블록도: R_CS 가 C_in 과 풀브리지 귀환 사이 = 브리지 입력 전력) — 7장 Step 2 가 이미 P_in,LLC 로 계산하고 있었다. R_CS 상한은 DS 표기대로 P_in 으로 두고 2 % 보수적이라고 명시(선정 24.0 mΩ 는 두 계산값 모두보다 작아 부품 불변) ⑥ 6장 표시 표 3·6번 V_out → V_o,eff(식과 일치, V_f = 0 이라 값은 같음) ⑦ C_in 3.2 nF/W 손 입력 → 계산 ⑧ 6장의 이 설계 비율 "about a tenth" 두 곳 삭제 ⑨ 한국어판 "전고조파 왜율" → THD(total harmonic distortion) ⑩ 한국어판 2-stage/두 단/2단 → **two-stage**(single-stage 와 같은 표기, 사용자). "2단계 과전류/과전압"(level)은 그대로. HVSU 다이오드는 **1000 V 급으로 사용자 확정**(DS 는 "고전압 정류 다이오드 한 쌍"만 적는다; AN·가이드·DESIGN.md 는 이미 1000 V/S1M). 남은 것: DS 의 TBD(열저항, ZCD 하한) |
| 2026-09-23 | **(54차) 2~6장에서 설계 수치를 뺐다.** 사용자: "숫자를 그냥 빼면 되잖아" (18차 규칙 ↔ 44차 조건 규칙 충돌에 대한 답). 곡선은 그대로 두고 **글자만** 지웠다: 그림 5·12 f_o = 0.60 f_r · 전부하 Q = 0.77 → f_o · full load, 그림 11 Q = 0.77/0.38 → full/half load, 그림 13 f_sw/f_r = 0.58, arg Z_in = −44° 등 → arg Z_in < 0 / > 0, 그림 25 λ = 0.55 (m = 2.8) · M∞ = 0.645 → 삭제, 그림 24 4번째 칸·그림 10 전류축·그림 33 전류축의 눈금 숫자 삭제, 6장 skin depth "about 0.2 mm" 삭제(7장 계산줄에 값이 있다). 남긴 것: 모핑 문턱 235/245 V 와 거기서 나오는 173/332 Vac(IC 상수), TL431 2.495 V, 일반 예시값(그림 14 Q = 0.55/0.85/1.35, 그림 25 왼쪽 λ = 0.20). 또 사용자: 240 W 예제는 우리 설계가 아니다 → `l6790_validate.py` 의 λ 계열 9개 차이는 손대지 않는다(53차 항목 참조) |
| 2026-09-23 | **(53차) 그림 표기 보강 → "왜 전수 조사를 해도 놓치나" 원인 분석과 0 % 부터 재조사.** 사용자: "figure 2 에서 어디가 fr 이고 어디가 fsw 고 … 표기" · "figure 1 에 Vd, Is1 … 정확하게 표기" · "다른 Figure 에도 … 전부 확인해서 수정" · "센터탭 주변 조금 넓혀" · **"분명 여러 번 전수조사를 요청했는데도 자꾸 놓치는 이유를 파악하고, 검사하지 않은 구역까지 0 % 부터 샅샅이 조사해"** · (중간) "PQ3230 PQ4040 둘 다 쓰지도 않는 코어인데 왜 이걸 검사하나". **원인 5개:** ① 검사 도구가 모양(figcheck)·본문(an_symbols·낭독)만 읽고 **그림 안의 글자는 아무도 읽지 않았다**(PDF 추출 텍스트에 그림 글자가 없다) ② "전수"라 해 놓고 **무엇을 봤는지 장부가 없었다** ③ 그림을 **독립 근거(권선 방향 문장·극성점·식의 부호)로 다시 유도하지 않고** 그럴듯하면 통과 ④ 지적받은 그림만 고치고 **같은 부류를 전 그림에 넓히지 않았다** ⑤ 그림 코드의 **손으로 적은 글자·숫자**를 잡는 장치가 없었다. 여기에 도구 자체의 빈틈 둘: figcheck `tiny` 가 `ax.texts` 만 쟀고(범례·눈금 제외), 매번 **바뀐 그림만** 돌려 기존 결함 10건이 안 보였다. **심은 것:** `an_figtext.py`(그림 글자 ↔ 기호표·앞선 정의, 그림 함수 문자열의 손 입력 숫자, 기호별 사용 그림) · figcheck `tiny` 전 글자 · 장부(그림 48·표 32·절 106·식 67) · 영·한 본문 기록 2051개 1:1 대조(종류·키 순서·수치). **고친 것(주요):** NS2/NS3 뒤바뀜(그림 43) · 플라이백 기자력 부호 · HB v_d 를 ± 로 그림 · 같은 양의 두 이름 11쌍 통일 · **그림 32 에서 v_RI·R_ac 를 n:1 의 2차 쪽에 둠**(1차 환산값, 한 기호 두 값) → v_RI/n · R_ac/n² · **그림 4 2단계가 구형파로 n²R_L 저항을 구동**(정류기→저항은 기본파에서만) → 정류기 블록 유지 · **보상기 G_EA 부호**(세 인자 음부호 셋의 곱인데 양으로 적음) → G_EA = −v_FB/v_out 로 정의(그림 35·37·본문·기호표) · **그림 10 정류기 패널 "[A]" 가 실제로는 1차 환산값(n 배 작음)** → i_D/n · **그림 43·본문의 파라데이 직사각형 높이 V_out ↔ 식 V_o,eff** → V_o,eff(2장 그림 18 은 ≈) · 그림 18 "피크는 정류기가 꺼질 때" ↔ 곡선·그림 43 → "거의 평탄" · **f19 판정 0.376(시트 C 비) ↔ 본문 0.373(좌변 식)**, 본문 "1.060 apart" ↔ 바로 위 0.373/0.354 = 1.053 → 좌변이 5.3 % 큼 · 막대 "25 to 19 V" → 리플 골 24.4 V · 그림 24 "P_out" 을 P_in 평균선에 붙임(무손실 가정) · 그림 23 입력 단자 V_in(브리지 레일 기호) → v_ac · 손 입력 수치: f19 5 %·12 ms·76 %·25 V·400/320 V, f14·g_fsw_theta 173.2/332.3/264, **g_fsw_theta 상한 = f_r×1.6448(다른 설계의 비, 249.6 ↔ 실제 249.0)**, f17 235/245 V, `l6790.line_conditions` 라벨 173/332/90/264, **`an_pdf.py` 의 `sweep(R, 332.34)`** → 전부 R·V 에서 · "23 % optimistic"(실제 −36 % 보수적) 3곳 · 근거 없는 "PQ 코어 10~20 %" → 원리만(쓰지 않는 코어 수치를 넣지 않는다 — 사용자) · 기호표에 없던 그림 기호 16개 등재 · M_no load → M_OL · 늦게 정의된 기호 11개를 첫 사용 자리로 · 7장 계산줄 62개 재계산(3개 불일치 수정) · 가독성 17장. **남긴 것(사용자 판단):** 2~6장 그림의 설계 수치(18차 규칙 ↔ 44차 조건 규칙) · P_in 과 P_in,LLC 혼용(V_FB ↔ R_CS,max1, 시트도 같음) · 6장 skin depth "about 0.2 mm" · **`l6790_validate.py` 의 λ 계열 9개 불일치**(ST 240 W 예제는 λ₁ 을 264 Vac 코너에서, `l6790.py` 는 FB 에지 332 Vac 에서 — λ₁ 0.2445 ↔ 0.5667 을 재현해 확인. HEAD 에서도 같다. 즉 유일한 독립 검증이 λ 이후 연쇄를 지금은 검증하지 못한다) · 데이터시트 상수 대조 목록. 검증: figcheck 55장 0건 · an_check 영·한 무결점 · an_symbols MISSING 0 · build 0 · check_sm OK · bom 29/0 · rtc OK · xl_sm 145/0 · theta 0 · trans_spec 0 · audit_md 0 |
| 2026-09-23 | **(52차) 워크북 기록 · 교육자료 삭제 · 코어는 설계자 몫.** 사용자: "SMath 는 코어까지 선정해 주는 시트는 아니야, 그건 설계자가 보고 정할 일이지. 교육자료 지워. 워크북 기록해." **워크북:** ST 원본(디크립트본)과 정본 워크북의 설계 시트 7장을 수식·상수 단위로 전량 대조 — 바뀐 수식 261 · 상수 18 중 CHANGELOG 열 C 가 이름을 부르지 않는 것은 **17셀**이었다. 옛 메모의 "48"은 2026-09-08 집계이고, 그 뒤 `CompensationNet&Check` gain margin 작업이 `H132:AV167` · `C130:E134` 행으로 기록돼 줄었다. `log_xl_unlogged.py` 가 `CHANGELOG_rev0_6` 96행부터 머리 한 줄 + 17줄을 쓴다 — Was/Now 는 두 파일에서 읽고 Why 만 적었다. 정본(=`variants/…_7p5to1`)과 6:1(16줄, F83·F91 은 원본 그대로라 없음)에 적용, 수식·값은 그대로라 calcChain 도 보존. 두 번 돌려도 더하지 않는다. `xl_sm_compare` 145/145 · `bom_compare` 0 · 구조 검사 OK. **하나는 근거를 모른다:** `Power Components D71` Coss 897 pF 는 STO60N045DM9 선정 때 들어온 값인데 데이터시트의 어느 커패시턴스(Coss · Co(er) · Co(tr))인지 기록이 없고, 그 값으로 만드는 D77 Ctot 1804 pF 는 어느 수식도 읽지 않는다(ZVS 는 `Design Spec D46` 800 pF). 로그에 열린 항목으로 적었다. **교육자료:** PPT 와 그것만 쓰던 `check_deck.py` · `deckedit.py` · `fix_deck_overflow.py` 삭제. **코어:** DESIGN.md 4.2절 5d 를 "미선정"에서 "설계자가 정한다(시트 범위 밖)"로, CLAUDE.md 할 일에서 뺐다 |
| 2026-09-23 | **(51차) 교육자료 중단 · 트랜스포머 설계 정리 PDF 삭제.** 사용자: "교육자료는 없던 일로 하고. 트랜스포머 설계 문서는 삭제. 어차피 AN 에 있으니." `L6790A_Transformer_Design_KR_v1.0.pdf` 와 그것만 만들던 `tx_pdf.py` · `tx_body.py` 를 지웠다(다른 스크립트가 임포트하지 않음을 확인). CLAUDE.md 산출물을 넷 → 셋으로, 파일 지도·다음 할 일에서 두 항목을 정리했고, README · `.claude/rules/an.md` 의 참조를 뺐다. `audit_md.py` 는 지운 파일을 ABSENT_OK 로 받고, 스크립트 존재 검사도 그 목록을 따르게 했다(이 기록이 이름을 부르므로). 영문 교육자료 파일 자체는 남겨 두었다 |
| 2026-09-23 | **(50차) AN 최종 전수 검토 — 영문 94쪽 · 한국어 95쪽.** 사용자: "AN 최종 검토하자. 다시 한번 오타 오류 하나하나 읽고 보면서 전수검사해. 어색한 한국어 표현도 다시 검사." 두 판을 쪽마다 읽고 고쳤다. **틀린 서술:** 2.7 절 fast-recovery 이유("풀브리지에서 매 턴온 전에 도통" → capacitive 영역에 들어가면 반대쪽 소자의 도통 중인 다이오드 위에서 켜진다) · M<sub>Z</sub> 는 capacitive 경계가 아니라 피크 궤적(경계는 조금 오른쪽) · M∞ 아래 해 없음은 No load 에서만 · below 의 2차 전류는 잘린 사인이 아니라 온전한 사인 반파 뒤 휴지 · Class D 는 "정류기 부하"가 아니라 규격이 열거한 제품군 · "어떤 페라이트도 못 견디는 자속"(거짓) · skin depth 문장 · f.Max 는 I<sub>EA,max</sub> 에도 달림 · 자화 피크는 V<sub>in</sub> 이 아니라 nV<sub>o,eff</sub>/(4f<sub>sw</sub>L<sub>m</sub>) · 판단 주석(C.r 은 Q<sub>pk</sub> 를 낮추고, L.m 20 µH 는 15:2 로 필요한 n 을 주되 No load 해를 포기) · "L.m 을 올려 잡지 말 것"이 설계(20 µH > 계산 8.9)와 모순 → "크게 잡으면 ZVS 여유가 준다" · f<sub>180</sub> 근호 안이 음수일 때 · 함정 표의 L.m 방향 · 기호표 K<sub>pwr</sub> · f<sub>pHF</sub> · M<sub>Z</sub> · T<sub>ZC</sub>. **수치:** DC overlap 시험 전류 15 → **16 A**(계산 15.19 A 를 올림, 벤더 사양서와 같게 — `V['IsatTest']`) · "OVP2 가 없었다면"의 0.30 T → 369 mT(자속 목표는 I<sub>eq</sub> 기준) · T.idle 700 ns 이면 f.Min 85.2 kHz(f.o 아래), f.Max 248.2 kHz(FB 경계 249.0 미달) — `an_body._f_idle()` 로 계산 · "가장 낮은 입력 전압만 빼고 above" → 여섯 중 넷(`V['nAbove']`) · −471 ns 의 하이픈. **빠진 표:** 7.5 절이 "표에서 가장 작은 숫자"라고 했는데 표가 없었다 — ZVS 격자(부하 4 × 입력 6)를 표 10 으로 실었다(`ZVS_WORST['rows']`). **출처:** ST 스프레드시트 도면 세 장(전력단 · 컨트롤러 · 보상기) 캡션과 앞붙이에 출처, ON Semiconductor → onsemi. **R.T 미결 항목:** "발주 전에 공차를 조이거나 R.T 를 낮출 것" → 48차 결정대로 "첫 보드까지 11 kΩ, 낮추면 ±10 % 는 덮지만 dead zone 이 넓어짐, 실측 후 결정". L.open 공차 서술(−4.1 % 대 벤더 ±10 %)은 49차 지시대로 그대로 두었다. **조판:** 제목만 쪽 끝에 남던 곳 영문 6 · 한국어 12 → 0(h1/h2 `keepWithNext`), 사양 표 "assume d" 줄바꿈. **한국어:** NanumGothic 에 U+2212 가 없어 모든 마이너스가 하이픈으로 바뀌던 것을 Liberation Sans 로 그리게 했다(`use_korean`) · 번호·계산값 뒤 조사를 `_josa()` · `_nj()` 로("그림 24 은" → 는 등) · 단위 뒤 조사(kΩ 으로, nF 을, V<sub>out</sub> 으로) · 견주면 → 비교하면 · 전 부하 → 모든 부하 · OPAMP → op-amp · 리츠선 → Litz 선 · dead band → dead zone · 오역 "보상기 게인 상수는" → "중심 주파수는" · 손으로 적은 "2.13 절" → 참조. 검사: an_check 두 판 문제 0 · an_symbols MISSING 0 · 쪽 끝 제목 0 · 조사 검사기 31건 전부 오탐 · 새 영어 단어 20개 철자 이상 없음 |
| 2026-09-23 | **(49차) 공차는 따지지 않는다.** 사용자: "그건 모르니까 무시해, 공차는." — 벤더에 L.open ±5 % 가능 여부와 C.r · C.T 공차를 묻자던 제안을 거둔다. DESIGN.md 4.2절 5b 에서 공차 대책·미정 공차 문장을 지우고, 4.3절 12 의 ③ 을 공차 한계 트랜스포머 시험에서 영교차 하드 스위칭 관찰로 바꿨다. R.T 11 kΩ 유지와 실측 후 결정은 그대로 |
| 2026-09-23 | **(48차) `R.T` 는 11 kΩ 유지 — 실측 후 결정.** 사용자가 10 kΩ 변경을 승인해 시트·워크북(F24 와 딸린 캐시 5칸)·사양서·AN 을 고치던 중, `tx_body.py` 에 출처 없이 적혀 있던 "영교차 클램프 구간 4.7 → 26 %" 를 `l6790.sweep` 으로 재계산해 **맞음**을 확인했다. 앞서 내가 이 비용을 "THD 미계산" 이라고만 설명했으므로 커밋하지 않고 수치를 보고했다(작업은 stash 후 폐기). 사용자 질문 "모핑 근처만 문제냐" → 아니다, 전 입력에서 생기고 저입력일수록 크다. "하드 스위칭이 피크에서냐" → 영교차 근처다(피크 f.sw ≥ 127 kHz). "무엇으로 해야 다 피하냐" → R.T 로는 불가, f.o 의 흩어짐(L.open · C.r 공차)을 줄여야 한다. 수치와 선택지는 DESIGN.md 4.2절 5b, 판정 실측은 4.3절 12 에 적었다. 사용자 결정: **11 kΩ 유지, 시제품 실측 후 결정.** 파일 변경은 문서뿐이다 |
| 2026-09-23 | **(47차) 한국어 본체 문서 rev 2.0(9:1) 삭제 · R.T 10 kΩ 범위 확인.** 사용자: "한국어 본체 문서 삭제해. 그리고 R.T 는 엑셀에서 10 k 쓰면 최대·최저값 범위 밖 아냐?" **rev 2.0 삭제** — `AN_L6790A_Design_Guide_rev2_0.md` 는 시트 식 번호 [n] 의 출처로 `audit_sm` · `audit_guide` · 빌더 docstring 이 읽고 있었다. rev 2.1(7.5:1)의 식 태그 집합이 rev 2.0 과 완전히 같음을 확인하고(`\tag{[n]}` 전수 대조 차이 0), 세 곳을 rev 2.1 로 옮겼다. `audit_guide` 결과가 두 판에서 동일(구조 문제 0 · 대응 없음 68). rev 2.1 은 남겼다. **R.T 10 kΩ 은 범위 안이다** — 워크북 Device Setting: 데이터시트 동작 범위 5–30 kΩ(D14 는 상한 30 만 적는다), 24행 `RT.ceil` = 11.237 kΩ 은 **라벨이 "Minimum Resistor value" 이지만 최대값이다**(f.Min = 1/[2(C.T·R.T + T.idle)] 이 R.T 가 커질수록 내려가므로, f.Min ≥ f.o 를 지키는 R.T 의 *상한*). 10 kΩ 은 5 ≤ 10 ≤ 11.237 이라 두 한계를 모두 만족하고 `k.RT.ceil` 은 1.124, f.Min 은 1/[2(470 pF·10 kΩ + 250 ns)] = 101.0 kHz. C.T 창(176–703 pF)은 R.T 와 무관하게 30 kΩ 상한과 IEA 로 정해져 그대로다. **R.T 는 아직 11 kΩ 그대로 — 사용자 결정 대기** |
| 2026-09-23 | **(46차) 정본 시트·워크북을 7.5:1(코어 3개)로 바꾸고 9:1 을 지웠다.** 사용자: "권선비를 이제 와서 왜 결정해?" — 권선비는 2026-09-21 에 7.5:1 로 확정됐는데 `CLAUDE.md` 에 "미결정 · 사용자 결정 대기" 가 남아 있었고, 내가 그것을 DESIGN.md §1.3 과 대조하지 않고 결정 요청으로 옮겼다. 사용자 지시: "variant 의 7.5:1 시트를 정본으로 쓰고 기존 9:1 정본은 삭제, 엑셀이나 SMath 나. 코어 3개는 실제 설계용이고 PDF 와 무관하다 — SMath 에만 해당." **한 것** — `build_l6790_smath.py` 기본 변형 `9to1` → `7p5to1`, 정본 `.sm` 재빌드(CRLF 유지, `variants/L6790A_7p5to1.sm` 과 바이트 동일). 정본 워크북 `L6790_spreadsheet_r1_0_corrected_rev0_6.xlsx` 를 `variants/L6790_workbook_7p5to1.xlsx` 로 바이트 복사 — 교체 전 대조: 시트 11장 이름·순서 동일, 수식 셀 위치 전부 동일, 차이는 CHANGELOG 빈 셀 12개와 Device Setting F21 값 셀 하나뿐(잃는 수정 없음). 교체 후 수식 14,836개 전부 캐시값 있음 · `calcChain` 있음 → "정본 워크북을 열었다 저장" 사람 작업 삭제. **지운 것** — `Smath/variants/L6790A_9to1.sm` · `Calculation Excel Sheet/variants/L6790_workbook_9to1.xlsx` · `Transformer_Spec_9to1.xlsx`, 빌더·`build_trans_spec`·`check_trans_spec` 의 `9to1` 항목. AN(`7p5to1_x1`, 트랜스포머 1개)은 건드리지 않았다. **결과** — build mismatches 0 · check_sm OK · bom 29/0 · xl_sm 145/145 · rtc OK · theta 0 · trans_spec 0 · audit_sm/dim/rpn 0 · coldstart PASS · audit_md OK. 판정 지표 **34/40 → 36/40**(k.Ae 0.549 → 1.098, k.PSR 0.929 → 1.063 해소, 남은 미달 k.Ploss · k.VCC · k.auxr · k.lam 은 전부 사유 있음). **새로 걸린 것** — DESIGN.md 4.2절 5b: 7.5:1 은 R.T 11 kΩ 으로 ±10 % L.open 공차를 못 견딘다(f.o 90.39 → 95.28 kHz > f.Min 92.25). 9:1 정본일 때는 조건부였던 항목이 지금 걸린다. R.T 를 바꾸면 AN·사양서의 f.Min 도 움직이므로 임의로 고치지 않고 사용자 결정으로 남겼다. DESIGN.md 4.2절 9(k.ZVS 한 점)도 정본이 낙관적인 쪽이 됐다(2.091 → 스윕 1.824) |
| 2026-09-23 | **(45차) 그림 11 에 게인 곡선 패널 · 영·한 간결화.** 사용자: "above/below/at resonance 를 파형으로는 잘 설명했지만 게인 곡선에서 어디에 해당하는지 모르겠다. 추가하고, 불필요하거나 너무 긴 설명은 삭제·단축하라." **그림 11(`an_three_cases`) 아래에 게인 패널 추가** — 세 열의 f_sw/f_r(0.70 · 1.00 · 1.30)를 M(f_n) 위 점으로 찍고 "below: M > 1, boost · at f_r: M = 1 at any load · above: M < 1, buck" 을 달았다. 영역 색은 그림 12(f04)와 같게(capacitive 분홍 · boost 초록 · buck 파랑). **곡선은 Half load(Q = Q_pk/2 = 0.38)** — Full load(Q = 0.766)의 ZVS 경계가 f_n = 0.726 이라 0.70 점이 capacitive 에 떨어져 왼쪽 열(inductive 파형)과 모순된다(계산 확인: M(0.70, 0.766) = 1.42 이지만 경계 밖). Full load 곡선은 자기 ZVS 경계부터만 점선으로 그렸다. 가운데 열은 파형 모델에서 데드타임 때문에 0.90 으로 그려져 있으나 게인 패널에는 정의대로 f_n = 1 에 찍었다. AN 2.5 절 캡션을 위/아래로 나누고, 세 불릿 머리에 M 관계를 넣었으며, AN 2.6 절의 같은 규칙 불릿 3개는 한 문단으로 줄였다("첫 행" → "왼쪽 열" 오류도 정정). **간결화(영·한 동일, 각 507 → 503 항목)** — 삭제: STEP 1·2 note(그림 캡션과 중복) · 권선 식 뒤 proximity note(본문과 중복) · 손실 절 B_pk/주파수 note(2.12 절과 중복, 한 문장으로 불릿에 흡수) · 2.12 "전류 제한은 코어를 지키지 못한다" 불릿(앞 불릿과 합침). 단축: 2.12 도입 예고문 · 자속 단계 그림 캡션 · capacitive 불릿 끝 · 경계 이동 문단 · "벌크 커패시터가 없으므로" 반복 · 차트 실수 note 의 메타 문장 · No load 해 없음 note · OVP2 절의 "자속을 올리지 않는 것" 목록(2.12 절 참조로) · 설계 게인 차트 캡션의 불릿 중복 문장 · FB 경계 불릿 · 16.8 Ω·W 항목. 한국어판에 남아 있던 소문자 open 4곳 → Open. `figcheck` an_three_cases 0건(전체 10건은 손대지 않은 그림의 기존 tiny/nodot — HEAD 에서도 11건) · `an_check` 양 판 기하 문제 0 · 미해결 참조 0 · 북마크 106 · `an_symbols` MISSING 0 · 영문 94쪽 · 한국어 95쪽 |
| 2026-09-23 | **(44차) 애매한 조건 표현 전수 정리 · 목차 링크와 북마크.** 사용자: "표 17 의 누설 인덕턴스 조건 '1차, 2차 Short' 는 1차·2차를 다 Short 하라는 것 아니냐. 이런 식으로 애매하게 쓴 것이 없는지 PDF 한 줄 한 줄, 모든 표와 그림을 확인해 고쳐라. 목차를 누르면 해당 절로 가게 하라." **목차:** `an_pdf.Doc.afterFlowable` 이 h1/h2 마다 PDF 목적지(`bookmarkPage`)와 개요(`addOutlineEntry`)를 만들고 TOCEntry 에 키를 넘긴다 → 두 판 모두 목차 링크 212개(항목 106 × 제목·쪽 번호)가 제 절로 가고, 뷰어 옆 창에 장·절 북마크 106개가 뜬다(`showOutline`). `multiBuild` 가 여러 번 도므로 키 번호는 `handle_documentBegin` 에서 0 으로. **표 31개 전수:** 측정 조건 — 표 17 Open/누설/DC overlap 을 "NP1 에서 측정, 나머지(NS2·NS3·NAUX) Open" / "NS2·NS3 모두 Short, NAUX Open" / "100 kHz · 1 V 에 DC 15 A 겹침, 상온" 으로(벤더 사양서와 일치), 표 4·13·기호표·6.10 본문의 L<sub>open</sub>·L<sub>short</sub> 조건도 같게; 동작 조건 — 표 17 1차·2차 전류에 "HB 경계, Full load", 스위칭 주파수에 "라인 피크, HB~FB 경계, 영교차에서 f<sub>o</sub> 까지 내려감", 코어 면적에 "f<sub>r</sub> 에서", 표 7 주파수에 "라인 피크, Full load", 표 12 캡션에 피크(θ=90°)와 라인 사이클 실효값의 구간, 표 18 hold-up 에 "100 Vac, 골에서 19 V 까지"; 기호 혼동 — 표 8·23 이 f<sub>sw,max</sub>(사양 225 kHz) 기호로 249 kHz(최고 동작 주파수)를 적던 것 → "f<sub>sw</sub>(FB 경계, 라인 피크)"; 대상 — 표 8 손실 행을 "정류 레그당" · "고정 1차 소자"; 단위 — V<sub>BO</sub> 84.8 V 를 "피크 120 V = 84.8 Vac rms"(표 22·27), 표 25 "60 V / 70 V" 를 "피크 60 V 아래 정지, 70 V 위 동작"(DS 표 기준); 뜻 — 표 21 "R<sub>BM</sub> 30 → 27.4" 를 문장으로, 표 24 OCP2 "즉시 정지, 50 µs 뒤 재기동", sense 손실 두 행의 평균/최악 구분, 표 12 f<sub>sw</sub> 행의 "오실레이터 하한 검사"(틀린 용도) → "아래 피크를 읽은 스위칭 사이클", 표 9 의 a → b 가 계산값 → 선정값임을 캡션에. **그림 48장 전수:** 그림 5·12 범례 "full load" 에 Q 값, 그림 14 light/half/overload 에 Q 값, 그림 26·30 의 "332.3 V · 173.2 V · 166.2 V · 100/120/230 V" 를 Vac(eq.) 로, 그림 42 DC-overlap 패널 "secondary open" → "all other windings open", "L at 1–2" → "L at NP1", 그림 45 "SECONDARY OPEN" → "ALL OTHER WINDINGS OPEN", 그림 12 "flatters the margin"(관용구) → "overstates". 본문의 "secondary open" 두 곳도. figcheck 새 지적 0. `an_check` 두 판 무결점 · `an_symbols` MISSING 0 · 잔재 0. 영문 94쪽 · 한국어 96쪽. |
| 2026-09-23 | **(43차) 한국어판 AN 3차 전수 낭독 — 뜬금없는 단어·직역 명사.** 사용자: "여전히 어색한 단어가 많다. 아무 선, 포일 같은 것 — 다시 전수조사해라." 95쪽 본문을 다시 읽고 **문구 약 460곳**을 고쳤다. 대표 치환: 포일 → **동박** · 아무 선 → **선종 무관** · Litz 의 가닥/다발 → **소선/완성 외경** · 서빙한 다발 → 서빙까지 한 리츠선 · 창(window) → **권선창**(자기) / **구간**(시간) / **선택 범위·허용 범위**(부품값) · 창 이용률·fill factor → **점적률** · 나란히 감은 권선 → **분할 권선** · 덮다(cover) → 커버하다 · 반사인파 → **정류 사인파**(입력) / **사인 반파**(공진 전류) · 넘기다(refer) → 환산하다 · 축약 회로 → 등가 회로 · 열다(open) → open · 이긴다 → 결정한다/우선한다 · 산포 → 편차 · 보통의 → 일반 · 끌어오다 → 입력 전력 · 쉬는 → 도통하지 않는/스위칭하지 않는 · 뒤 단계 → 이후 계산 · 산수 → 계산 과정 · 무릎 → knee 점 · 흔들다 → 스윙시키다 · 거울상 → 대칭 동작 · 마지막 방어선 → 최후의 보호 · 여지 → 여유 · 앞줄/뒷줄 → 앞 열/뒤 열 · 3차 고조파 budget → 허용치. **절 제목 22개**("만든 대로·정한 대로·감은 대로" 류 직역 제목 → "설계 결과", "숫자를 끝까지 따라가기" → "단계별 계산", "전력은 어디로 가나" → "손실 분배" 등; 7.2 는 "주요 설계 값" 으로 구분), 장 참조의 "절" → "장"(2·3·5 장), 앞머리 문구·기호 설명·개정 이력, `cores.PIN_NOTE_KR`. **읽다가 찾은 사실 오류 2(영문판도 수정):** ① 7.6 "Three readings" 인데 글머리표가 4개 → "Four readings" / "읽을 점은 넷이다". ② 기호표 λ 후보 설명이 "the smallest wins" 였으나 `l6790.py` 는 `lam = max(l1, l2, lTD, l3)` 이고 STEP 8 본문도 "가장 큰 것" → "the largest binds" / "가장 큰 것이 결정한다". **함정 재발 1:** 치환으로 들어간 "±10&nbsp;%" 가 `%` 포맷 문자열 안이라 빌드가 죽었다 → `%%`. `an_check` 두 판 무결점 · `an_symbols` MISSING 0 · 잔재 검색 0. 영문 94쪽 · 한국어 95쪽. |
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
