yohan924-ops/L6790A-Single-Stage-PFC-LLC-Converter/EVB Schematic/DAUGHTER BOARD SR REV1 _ SR BOA.pdf

# SR BOARD

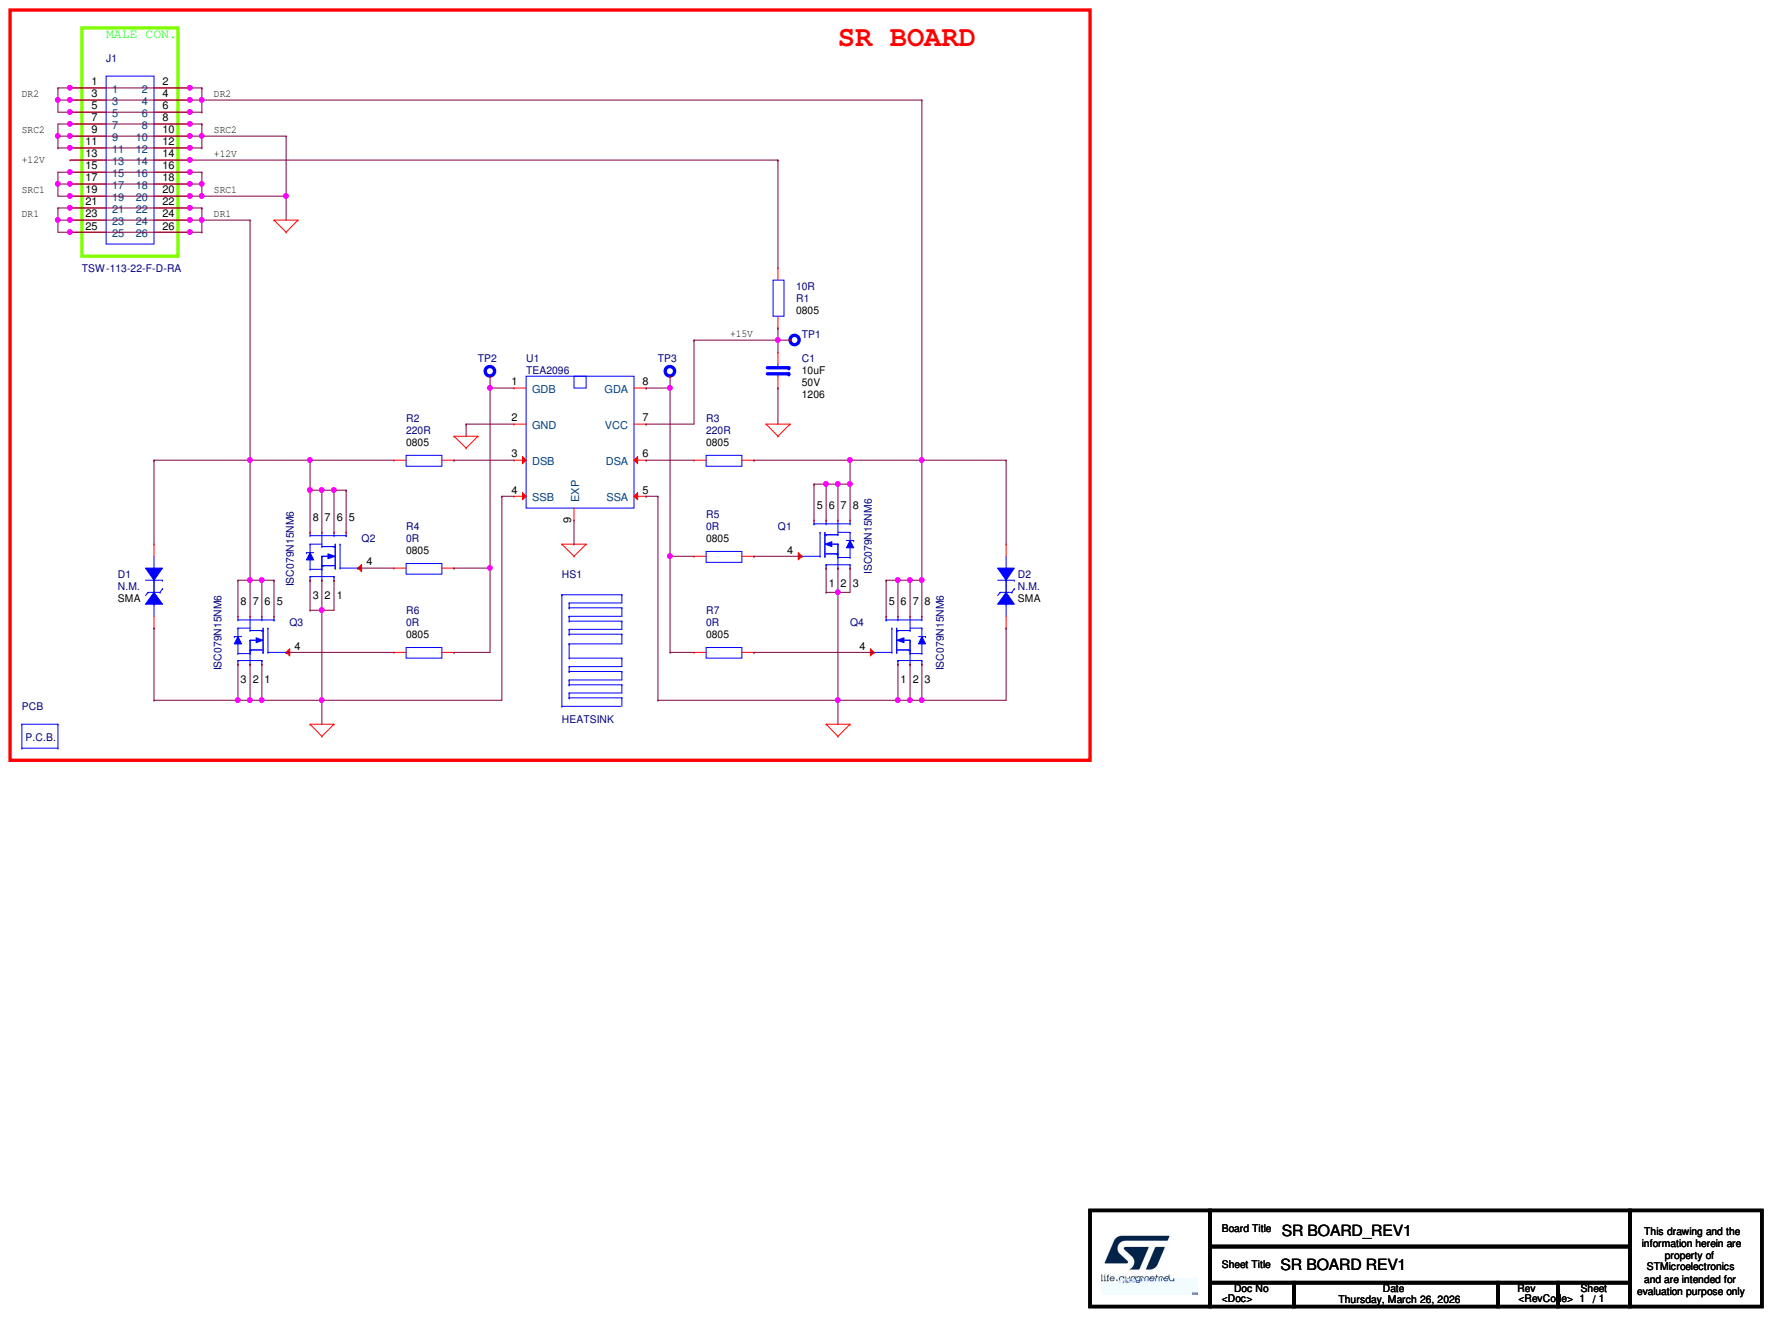
[picture p167: page 1]

This drawing and the
information herein are
property of
STMicroelectronics
and are intended for
evaluation purpose only
