yohan924-ops/L6790A-Single-Stage-PFC-LLC-Converter/EVB Schematic/HBGANPWR_Schematic.pdf

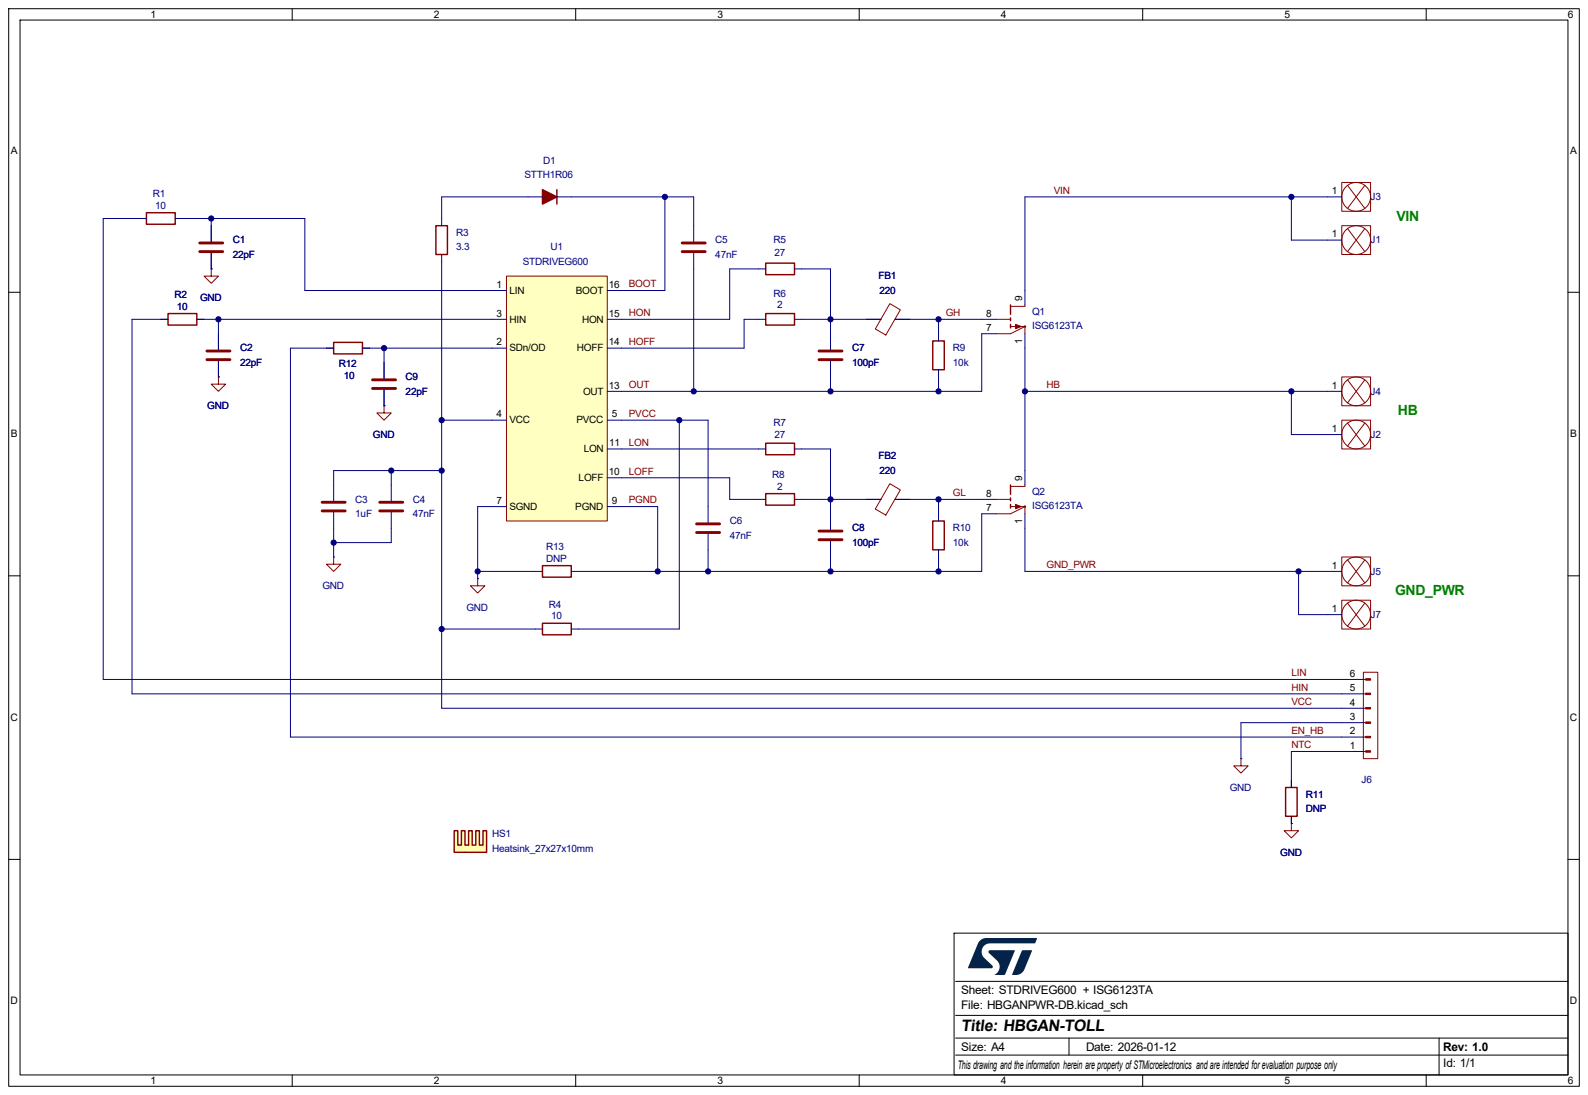
[picture p168: page 1]

LOFF BOOT HOFF HON OUT PGND

This drawing and the information herein are property of STMicroelectronics and are intended for evaluation purpose only C8

HIN 5
VCC 4

File: HBGANPWR-DB.kicad_sch Sheet: STDRIVEG600 + ISG6123TA
Id: 1/1 Title: HBGAN-TOLL
