yohan924-ops/L6790A-Single-Stage-PFC-LLC-Converter/EVB Schematic/MOTHER B_EVL6790_670W_REV1 _ MO.pdf

## 90-264Vac

HBGANPWR 1 | HBGANPWR 2

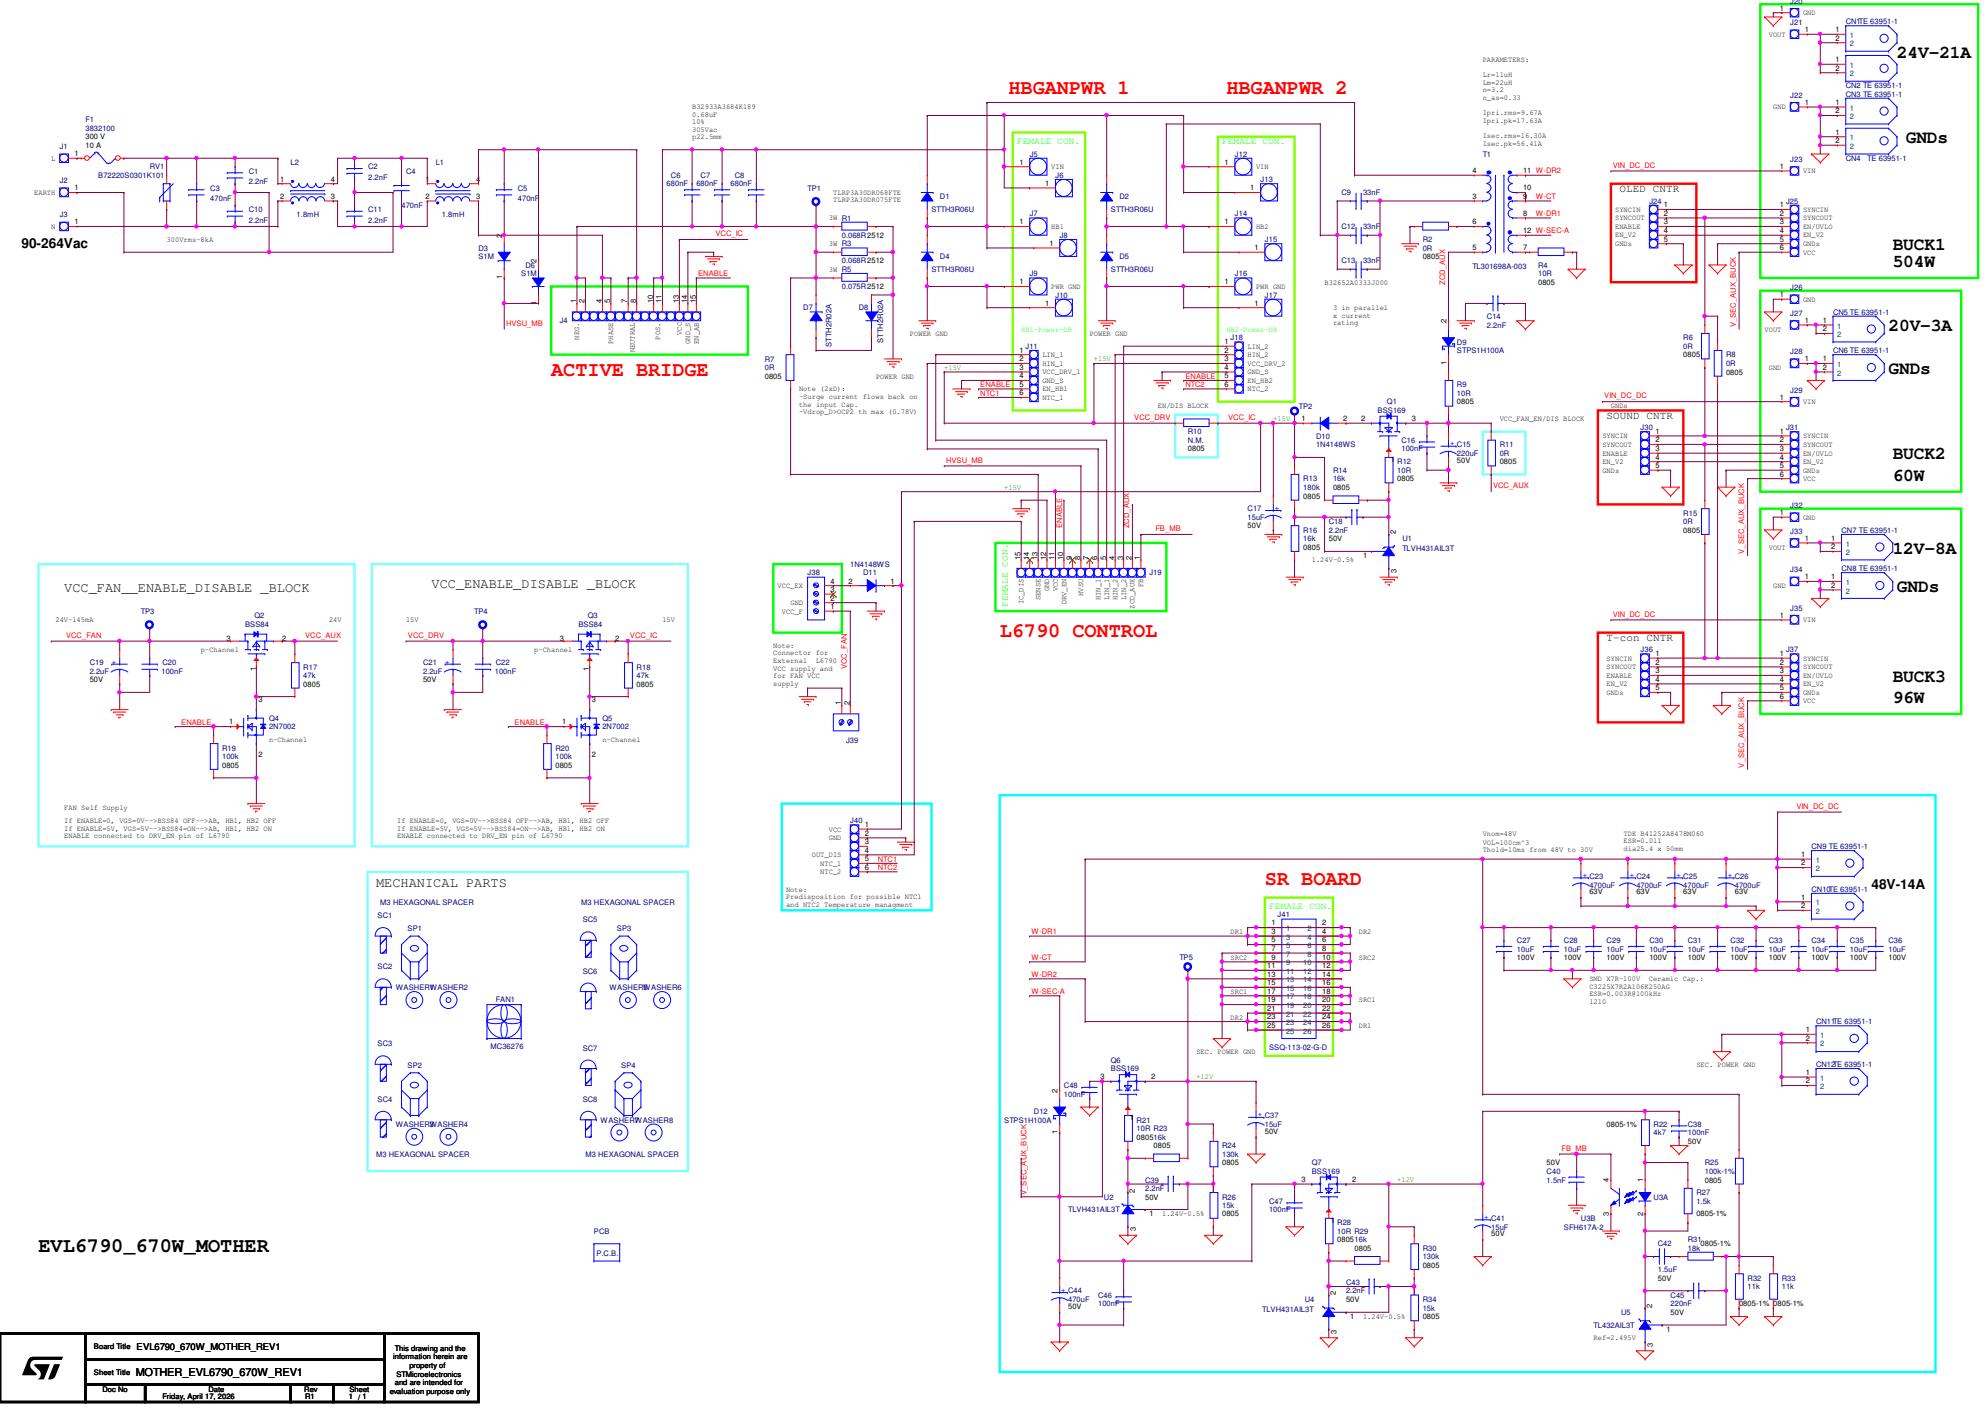
[picture p169: page 1]

J12 1 VIN

4 ENABLE 5 NTC1 6 | ENABLE 5

Note (2xD):
-Surge current flows back on
the input Cap.
-Vdrop_D>OCP2 th max (0.78V)

If ENABLE=0, VGS=0V-->BSS84 OFF-->AB, HB1, HB2 OFF
If ENABLE=5V, VGS=5V-->BSS84=ON-->AB, HB1, HB2 ON
ENABLE connected to DRV_EN pin of L6790

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
