yohan924-ops/L6790A-Single-Stage-PFC-LLC-Converter/Design Guide/generators/data/TDK_B65982E_coil_former.pdf

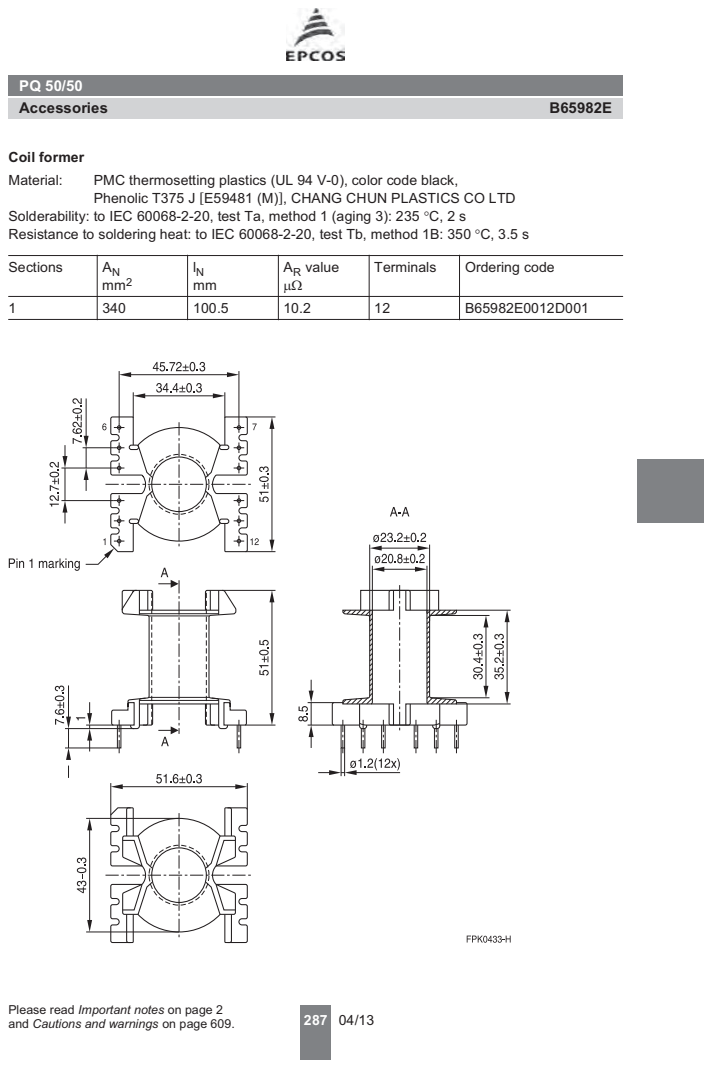
[picture p170: page 1]
Coil former; Material:; PMC thermosetting plastics (UL 94 V-0), color code black,; Sections; mm²; AR value ; Terminals; Ordering code; Accessories

Phenolic T375 J E59481 (M), CHANG CHUN PLASTICS CO LTD

Solderability: to IEC 60068-2-20, test Ta, method 1 (aging 3): 235 C, 2 s
Resistance to soldering heat: to IEC 60068-2-20, test Tb, method 1B: 350 C, 3.5 s

Please read Important notes on page 2
and Cautions and warnings on page 609.
