yohan924-ops/L6790A-Single-Stage-PFC-LLC-Converter/EVB Schematic/DAUGHTER BOARD_L6790_REV1 _ L6790.pdf

# L6790 CONTROL

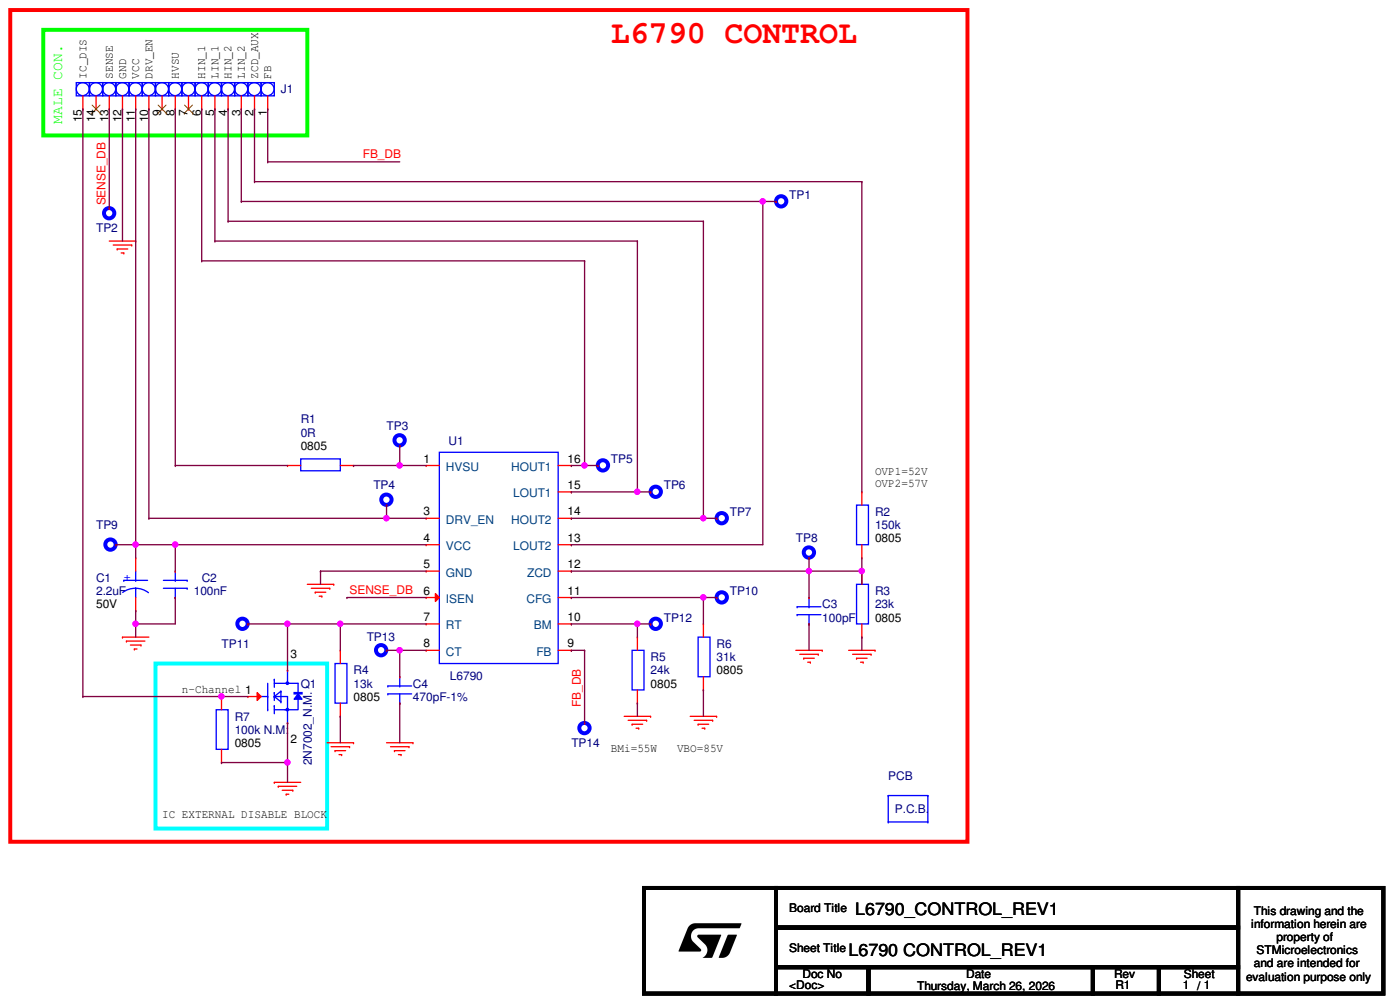
[picture p171: page 1]

IC EXTERNAL DISABLE BLOCK

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
