yohan924-ops/L6790A-Single-Stage-PFC-LLC-Converter/LGE Material/LGE Previous LLC Schematic.pdf

IC251

## TEA2095TE/1

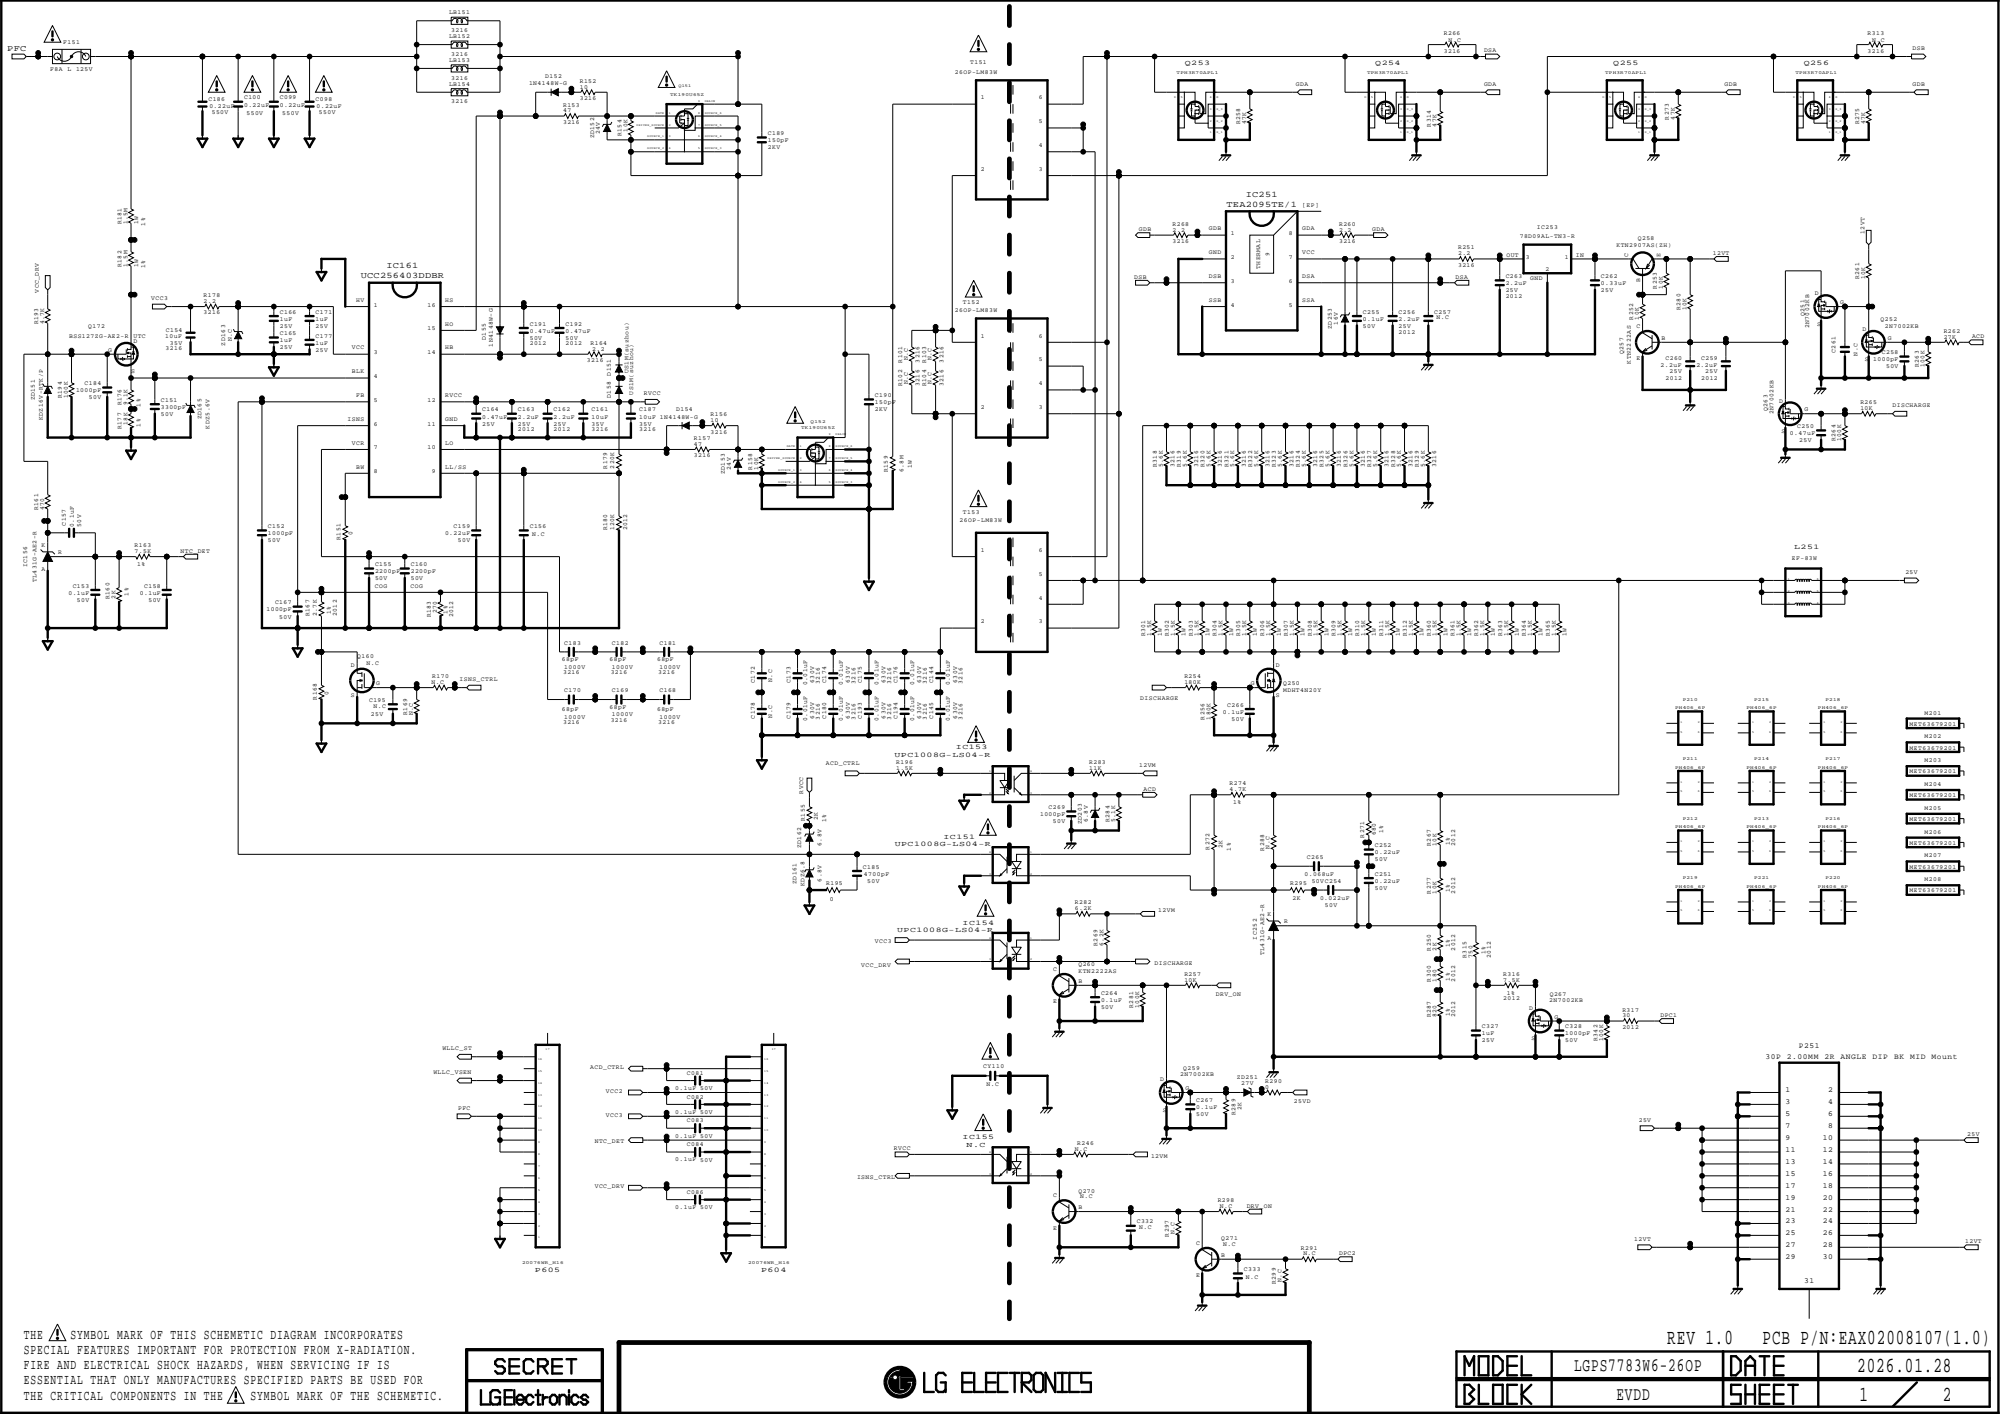
[picture p172: page 1]

30P 2.00MM 2R ANGLE DIP BK MID Mount

SPECIAL FEATURES IMPORTANT FOR PROTECTION FROM X-RADIATION.
FIRE AND ELECTRICAL SHOCK HAZARDS, WHEN SERVICING IF IS
ESSENTIAL THAT ONLY MANUFACTURES SPECIFIED PARTS BE USED FOR
