yohan924-ops/L6790A-Single-Stage-PFC-LLC-Converter/(list of files, drawings)

Other design files:
LGE_670W_L6790A Single Stage PFC LLC TV Power/L6790A_GaN.SchDoc
LGE_670W_L6790A Single Stage PFC LLC TV Power/L6790A_Si.SchDoc
LGE_670W_L6790A Single Stage PFC LLC TV Power/LGE_670W_L6790A Single Stage PFC LLC TV Power.PrjPcb
