yohan924-ops/L6790A-Single-Stage-PFC-LLC-Converter/(commit log)

2026-09-16 Import L6790A single-stage PFC+LLC design materials from Drive (partial, batch 1)
    Design guide docs, Smath models, calculation spreadsheets, Altium schematics,
    reference app notes, design-guide figures, and LGE/EVB material transferred
    from the project's Google Drive folder. More batches to follow.
    Claude-Session: https://claude.ai/code/session_01L3H8Na8buSZY2uPpuuSkn7
    [BACKUP_L6790_workbook_6to1.xlsx, L6790A_GaN.SchDoc, L6790A_Si.SchDoc, L6790_spreadsheet_r1_0_corrected_rev0_6.xlsx, L6790_workbook_7p5to1.xlsx, L6790_workbook_9to1.xlsx, LGE_670W_L6790A Single Stage PFC LLC TV Power.PrjPcb, Transformer_Spec_7p5to1.xlsx]
2026-09-16 Import L6790A design materials from Drive (partial, batch 2)
    More figures/an PNGs transferred from Google Drive.
    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
2026-09-16 Import L6790A design materials from Drive (partial, batch 3)
    More Design Guide figures transferred from Google Drive.
    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
2026-09-16 Import L6790A design materials from Drive (partial, batch 4)
    Calculation Excel Sheet files transferred from Google Drive.
    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
    [L6790_workbook_6to1.xlsx, Transformer_Spec_6to1.xlsx]
2026-09-16 Import L6790A design materials from Drive (partial, batch 5)
    LGE_670W project misc files (PrjPcb, Library, Project Logs, panes).
    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
2026-09-16 Import L6790A design materials from Drive (partial, batch 6)
    Reference app-note PDFs and remaining figures/an PNGs.
    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
2026-09-16 Import L6790A design materials from Drive (partial, batch 7)
    Smath Bode plot example + bundled ZedGraph docs (license/help only,
    third-party library binaries excluded).
    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
2026-09-16 Import L6790A design materials from Drive (partial, batch 8)
    Remaining Design Guide figures (2 of 16 pending retry due to a
    truncated-download issue).
    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
2026-09-16 Import L6790A design materials from Drive (partial, batch 9)
    EVB Schematic PDFs and more generators scripts.
    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
2026-09-16 Import L6790A design materials from Drive (partial, batch 10)
    More generators scripts (batch 3/3 complete).
    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
2026-09-16 Import L6790A design materials from Drive (partial, batch 11)
    More generators scripts.
    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
2026-09-16 Import L6790A design materials from Drive (partial, batch 12)
    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
2026-09-16 Import L6790A design materials from Drive (partial, batch 13)
    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
2026-09-16 Import L6790A design materials from Drive (partial, batch 14)
    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
2026-09-16 Import L6790A design materials from Drive (partial, batch 15)
    Application note PDF (previously missed) + more generators scripts.
    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
2026-09-16 Add files via upload
    Training Material/PPT uploaded
2026-09-16 Import L6790A design materials from Drive (partial, batch 16)
    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
2026-09-16 Fix corrupted files from earlier transfer (batch 17, final)
    Re-downloaded 5 files that had silent content corruption despite
    matching byte sizes (2 xlsx with bad zip CRC, 2 py with encoding/
    syntax corruption); also picked up build_probe.py from the
    generators completion pass.
    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
    [Transformer_Spec_7p5to1.xlsx, Transformer_Spec_9to1.xlsx]
2026-09-16 Restructure the AN and add a Korean edition
    Both editions now carry the worked example at the end, with the
    controller-constant derivations, the pin rules, the system design rules
    and the measurement list in it, and the errata as the final chapter.
    1-6 method, unchanged in substance
    7 design example (was chapter 6.1/7/8, plus new material)
    8 references
    9 errata and open items (new)
    New:
    an_kr_pdf.py / an_kr_body.py Korean edition, same layout engine, same
    section structure, every number still
    interpolated from the sheet
    AN ..._KR_v1.0.pdf 50 pages, no geometry problems
    Defects found while che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
2026-09-16 AN: fix seven defects found in the line-by-line re-read
    Read both editions end to end against the sheet and the 7.5:1 workbook.
    Seven things were wrong; none of them changed a design value.
    1. Auxiliary voltage at OVP2 quoted 44.8 V, which is n_aux x the OVP2
    *target* (29.89 V). The fitted E24 divider gives OVP2 = 30.61 V, so
    the winding actually sees 45.9 V - the value the workbook carries in
    Device Setting D97. The sentence quoted the fitted threshold two
    lines earlier, so it contradicted itself. Now computed from
    n.aux * V.OVP2_act. Both editions.
    2. The system-design-rule bullet said dropping the conduction ratio
    overstates the *loss* by 12 %. 12 % is the rms err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
2026-09-17 AN: drop the self-promotional voice, and plainer English
    Two things.
    1. The cover read like a sales sheet and the front matter read like an
    internal status page. "Design worked through in this note", "Every
    design value traced to the reference implementation", "Unofficial
    engineering document. Not an ST publication." - all gone. The cover
    now carries the title, the part, and the two lines of the worked
    design's specification, and nothing else.
    The same voice ran through the body: "this note" appeared 22 times,
    with tables captioned "Every value is recomputed from the reference
    implementation; none is transcribed" and "Nothing here is a new
    calculation". A documen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
2026-09-17 AN: rename to single-stage PFC LLC, and align both editions at V1.2
    The topology is a PFC LLC, not a PF LLC. Renamed in the title, the
    cover, the running footer, the PDF metadata and the prose of both
    editions - 61 occurrences each. The output files are renamed to match,
    and an_check.py follows.
    Versions aligned. The English goes V1.1 -> V1.2. The Korean was still
    V1.0, so it skips to V1.2 to sit on the same number as the English it
    mirrors; its revision history says so rather than leaving the gap
    unexplained. Each edition keeps its own history: the English lists
    V1.0/V1.1/V1.2, the Korean V1.0/V1.2.
    The CLAUDE.md row for the application note was still describing the
    42-page V1.1 with 30 e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
2026-09-17 AN: keep single-stage out of the background chapter
    Chapter 2 is ordinary LLC and ordinary power factor correction, written
    for a reader who knows neither. It kept reaching forward to an
    architecture it had not introduced yet, which is exactly the reader it
    cannot afford to lose. Eight mentions in each edition are gone; the
    sentences are now plain LLC statements, and the note listing the two
    design steps this converter breaks moved to the head of chapter 3, where
    the architecture is actually the subject.
    Also removed the anthropomorphic phrasing ("where an LLC lives", "spends
    most of its life", "사는 구간", "일생의 대부분") from both editions and
    from two generated figures.
    Q: th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
2026-09-17 AN (KR): put 품질계수 back
    Reverts the Q gloss removed in the previous commit, at the user's
    decision. The five places that name it read 품질계수 again; the English
    edition was never touched.
    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
2026-09-17 AN (KR): use the English terms engineers actually say
    The Korean edition had translated terms into Sino-Korean that nobody
    says out loud. Replaced, on the user's instruction:
    용량성 / 유도성 -> capacitive / inductive (26 + 19)
    공진 아래 / 위 -> below / above (7 + 3)
    첨두 -> 피크 (11, the file already said 피크 42 times)
    승압 / 강압 -> boost / buck (18 + 5, and it already said boost)
    이득 / 이득 여유 -> 게인 / gain margin (7 + 3)
    왜형 -> distortion (5; 변위/왜형 인수 -> displacement/distortion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
2026-09-17 Fix the capacitive/inductive boundary in Figure 9, and say what it really is
    The user spotted it: Figure 9 draws the full-load gain curve but shaded the
    capacitive/inductive boundary at f_o. The band between f_o and the curve's
    own edge was coloured green and captioned "inductive, ZVS" while at that
    load the bridge is still hard switching. The figure's own card already said
    "below the GAIN PEAK", so it contradicted its shading.
    Checking it turned up a second thing. The boundary is not the gain peak
    either. The tank is capacitive while arg Z_in < 0, and that zero crossing
    sits ABOVE the peak of the gain curve - at lambda 0.55, Q 0.766 the peak is
    at 105.4 kHz and the phase does not reach zer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
2026-09-17 Restore the sheet's CRLF line endings
    I ran build_l6790_smath.py to check that adding zvs_edge() to l6790.py had
    not disturbed the sheet (it had not - mismatches 0, BOM 29/29), but the
    build rewrote 1.5 MB of .sm from CRLF to LF. The content is byte-identical
    once newlines are normalised. Putting the file back so the diff does not
    carry 23672 phantom lines.
    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
2026-09-18 Say what order power delivery and freewheeling actually run in
    The user asked whether "power delivery, first half" is followed by
    "freewheeling, second half". It is not, and the note never said so. Checked
    against the source of Figures 6-8, Infineon AN 2012-09, which is in
    Reference/.
    Section 2.2 of that note: "Freewheeling operation, which can occur
    FOLLOWING the power delivery operation", and its Table 1, below resonance:
    the freewheeling "starts and carries on to the end of the switching half
    cycle". Its waveform figure shows it directly - the S1,S4 gate stays high
    for the whole of Ts/2, power delivery runs to Tr/2 inside it, freewheeling
    fills the rest. So the order is
    P(S1,S4) -> F(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
2026-09-18 Redraw the second-half freewheeling path, and bracket the four intervals
    Two changes to the borrowed operation figures, both on the user's explicit
    instruction to correct anything wrong in the four panels.
    1. Figure 7's right panel is redrawn. Infineon AN 2012-09 Figure 2.8 labels
    it "freewheeling, second half" but sends the current backwards through S1
    and S4 and out of the + terminal. Nothing can take that path in that half:
    S1 and S4 are off, and with S2,S3 holding the two mid-points at 0 and Vin
    their body diodes are reverse biased. What the source drew is the dead
    time at the end of the half, where the negative tank current commutates in
    those body diodes. figedit.fix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
2026-09-20 Number the four operation panels, and say which interval "freewheeling" means
    "1st half" and "2nd half" still did not tell a reader which panel comes
    first, because the two figures are grouped by what the circuit is doing
    rather than by time. Each panel header now carries its place in the
    sequence - Figure 6 holds STEP 1 and STEP 3, Figure 7 holds STEP 2 and
    STEP 4 - and the four brackets on Figure 8 carry the same numbers, so the
    circuits and the waveform lock together.
    1 power delivery, S1,S4 on
    2 freewheeling, S1,S4 still on
    dead time <- ZVS
    3 power delivery, S2,S3 on
    4 freewheeling, S2,S3 still on
    dead time <- ZVS
    Both editions also gain a note on the word itself,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
2026-09-20 Check the operation sequence against the Toshiba LLC application note
    The reference arrived in this branch, so the four-step ordering now has an
    independent source. Its section 3.2 splits the half cycle into eight modes
    that map one to one onto ours: modes 1-1/1-2 are step 1, mode 2 is step 2
    (same switch on, load current zero, secondary off), modes 3 and 4 are the
    dead time where ZVS happens, and 5-1/5-2, 6, 7/8 repeat it for the other
    half. Its figures 3.7 and 3.12 are mirror images of each other, each with
    only the dashed magnetising loop on the primary and no secondary loop --
    so both halves do freewheel.
    What differs is the label, not the physics: that note never names modes 2
    and 6,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
2026-09-20 Draw the eight operating intervals, dead time included
    The note has four circuit panels and no picture of the dead time, which is
    the one interval ZVS happens in. The gap came from the source: the
    reference figures those four panels were taken from have no dead-time panel
    either, and the one that did draw body-diode conduction was captioned as
    freewheeling and got redrawn as freewheeling.
    This draws the whole switching period from scratch as our own circuit -
    full bridge on the primary, since the application note whose eight-mode
    treatment this follows is a half bridge and every path had to be re-derived.
    Eight panels: power delivery, freewheeling, C_oss transition, body-diode
    clamp, and t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
2026-09-20 Redraw the eight panels as an actual schematic
    The first version was not one. Each switch was a labelled rectangle with a
    diode-shaped thing beside it - no gate, no channel, no MOSFET symbol at all.
    The output capacitor's plates came out three times the size of C_r's because
    its shunt helper sized the symbol as a fraction of the rail-to-rail span.
    The transformer's coils sat close enough to L_m that the three read as one
    row of coils. And the callouts were written over the wiring.
    So the panels no longer borrow symbols: everything is defined here against
    one proportion table. A switch is now the MOSFET, its body diode and its
    C_oss in parallel, drawn in every panel and coloured by which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
2026-09-20 Fix the MOSFET symbol, the polarity dots, and rectify with a centre tap
    Three things were wrong with the drawing.
    The switch symbol was a depletion device: the three channel bars were drawn
    tight enough to merge into one column, and a solid channel is exactly what
    distinguishes depletion from enhancement. The bars are now separated by a
    gap you can see at print size, each with its own lead - drain to the top
    bar, source to the bottom, bulk to the middle and tied back to the source -
    and the gate plate stands off across the oxide gap touching nothing.
    The polarity dots were placed a hair outside the widest loop of their own
    winding, so they sat on the coil. They are now clear of it, and c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
2026-09-20 Fix four things the panels were getting wrong
    The magnetising branch carried an arrowhead in the two power-delivery
    panels, and it should not: i_Lm ramps THROUGH zero inside that interval -
    the waveform in the same figure shows it doing so - so it has no one
    direction there. Only the load component keeps its sign all the way, which
    is what the magenta loop is. The L_m branch now has no arrowhead and both
    notes say why.
    The C_oss carried an arrow meant to read as V_ds direction. Next to a
    capacitor an arrow reads as current, and panel 7 showed it with nothing
    anywhere saying otherwise - the one line explaining it was in panel 3's
    caption. The arrows are gone; the colour carries it, both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
2026-09-20 Make the highlight follow the windings, and stop lighting L_m everywhere
    Moving the highlight under the schematic fixed one thing and broke another:
    a coil is drawn as loops off a chord, so a straight band under it runs down
    the chord and leaves the loops hanging off one side. Every winding is now
    one polyline that the drawing and the highlight share, and a run that
    covers a winding is replaced by that winding's own points - so the trace
    goes round the loops. A run can hold more than one of these (the tank wire
    crosses the right leg AND goes through L_r), so they are all collected and
    laid down in travel order; returning at the first match left L_r flat.
    L_m was lit in all eight panels, w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
2026-09-20 Draw the windings properly
    Two things were wrong and both were in the symbol, not the highlight.
    A winding is a stack of half circles whose diameters sit on the lead line,
    so consecutive turns meet tangent to tangent pointing opposite ways - a
    cusp. Rendered as one polyline with a join, every cusp came out as a
    little hook, and a column of hooks is what a frayed coil looks like. The
    turns are now separated by a break in the same plot call: no joins, and the
    round caps close the seam. The highlight shares the points and the breaks.
    And the transformer's windings had their turns bulging AWAY from the core,
    so each coil opened toward the wire feeding it and the symbol read
    inside-out. The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
2026-09-20 Pull the windings in to the core and fix the dots
    Drawn on their own at size, three things were wrong with the transformer.
    The gap between each winding and the core was 0.32, wider than a turn, so
    the two coils read as unrelated inductors that happen to sit either side of
    two grey bars. The lead lines moved in: the turns now stop about one turn
    radius short of the core bars, 0.07 on the primary and 0.08 on the
    secondary.
    The polarity dots floated 0.26 above the top terminal with the lead wire
    between them and the winding, so each one marked nothing. They now sit
    beside the terminal on the side the turns leave free - outside the primary,
    outside the secondary - which is where a dot belon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
2026-09-20 Give the second secondary half its own polarity dot
    The centre-tapped secondary is drawn as two labelled windings, so each
    one needs a dot; only N_s1 had one. The two halves are continuous and
    wound in the same sense, so N_s2's dot marks its start, which is the
    tap. That is what makes the lower end conduct while the upper one
    blocks, and it now reads the same way in the figures as it does in the
    current paths already drawn.
    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
2026-09-20 Put the mode panels' symbols in a kit the whole note can draw with
    The eight-mode panels grew their own MOSFET, windings and current
    highlight because the ones in schem.py were rejected: a switch drawn as
    a labelled box is not a schematic, and butted half circles hook at every
    turn. Those symbols were accepted, so they move to schemx.py and
    schem.py takes its windings and its switch from there. The panels
    re-render pixel-identical, which is how the move was checked.
    The MOSFET now scales with its drain-to-source span, and its body diode
    and C_oss are optional, so the same symbol serves a full-page panel and a
    switch in a stage drawing. A transformer with a centre-tapped secondary
    is in the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
2026-09-20 Draw the figures that were screenshots of other vendors' notes
    Fifteen figures in the application note were crops from ON Semiconductor,
    Infineon and Toshiba documents. They are good teaching figures and they
    stay cited, but they are somebody else's artwork in a document that gets
    distributed, and each one is set in a different typeface from the text
    around it. figs_ref.py draws them with the kit the mode panels
    established, from numbers l6790.py produces.
    Three of them are also corrected rather than copied:
    - the borrowed figures put the capacitive/inductive boundary at the peak
    of the gain curve. The boundary is where the input impedance phase
    crosses zero, which is above the peak, s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
2026-09-20 Switch the note to its own figures and retire the borrowed ones
    All fifteen figures the application note took from other vendors' notes
    are replaced by drawings of ours, in both languages, and the files they
    used are gone; only the four _raw crops stay, as the record of what was
    replaced. Each caption now cites the source of the argument rather than
    the source of the picture.
    The two operating-interval figures come from the eight-mode panels, so
    they carry this design's own centre-tapped secondary and show each switch
    with its body diode and C_oss. That changes the step numbering the
    section uses from four to eight - the dead time now has numbers of its
    own (3, 4, 7, 8) instead of being the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
2026-09-20 Check the figures instead of eyeballing them, and fix what it finds
    The replacement figures went out after a review at contact-sheet size,
    which is the one size that hides everything wrong with them. At full
    size: every diode in both bridges pointed backwards and its cathode bar
    was hidden under the triangle; a current arrowhead swallowed the boost
    reactor's first turn; a wire hop sat over a crossing that no longer
    existed; the centre tap's junction dot and the lower half's polarity dot
    merged into one blob; the secondary's polarity dot sat under L_lks; and
    in a dozen figures a label lay across a curve or a wire.
    figcheck.py reports the three faults a person catches only at full size -
    text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
2026-09-21 Size every component symbol by one rule, and measure that it held
    The capacitors went back to being wrong because upgrading schem.py only
    replaced its windings and its switch. Its capacitor, resistor and
    inductor were left as they were, so every figure built on them inherited
    the symbol that had already been rejected - plates 1.67 long for each
    unit of gap where the reviewed one is 2.73, and shunt() sizing the symbol
    as a fraction of the branch it hangs on, which made the same capacitor
    0.73 units long in one figure and 1.38 in another.
    A symbol is now a fixed fraction of its own drawing's width, taken from
    the mode panels' 22.45-unit span. A winding fixes its TURN RADIUS and
    takes its turn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
2026-09-21 AN figures: wiring checks in figcheck, kit terminal fixes, eight-mode sheets replace Figures 6/7
    Plant five wiring checks in figcheck.py (no-dot junction, open wire end,
    unmarked crossing, off-grid wire, clipped patch) and read the eight-mode
    sheets with them. The first run found 95 real faults, among them two in
    the kit itself: schem.cap returned its terminals at the plate length, so
    every capacitor drawn through it stopped short of its plates, and
    S.diode returned one terminal a full s past its bar.
    Redraw what the checks and a full-size review turned up: an_rac's
    rectifiers conducted the wrong way (output upside down), an_integrated
    shared one return rail between primary and secondary an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
2026-09-21 AN figures: dead-time current through C_oss, corner dots removed, pixel-measured overlap check, Figures 5 and 19
    Modes 3 and 7 reused the freewheeling path and so drew the tank current
    down a leg whose channel the caption says is off. Add cs(), the C_oss
    detour, and draw the two loops the dead time really has: V_in rail ->
    C_oss(S1) -> A -> tank -> B -> C_oss(S3) -> V_in, and 0 -> C_oss(S2) -> A
    -> tank -> B -> C_oss(S4) -> 0. Modes 4 and 8 already detoured through
    the body diodes and are unchanged.
    Drop the three junction dots that marked plain corners (the tap riser's
    turn onto the + rail, the top of each rectifier) and the two terminal
    dots on the lone R_ac; add a stray-dot check for dot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
2026-09-21 AN (EN): plain-English read-through, four corrections, S1-S4 naming, figure fixes
    Text (an_body.py, chapters 1-9): idioms, metaphors and long sentences
    rewritten for non-native readers. Corrections:
    - gain margin: a negative discriminant in f_180 is not an infinite
    margin - the phase is then below -180 deg at every frequency, so
    any crossover has negative phase margin
    - cubic root argument: the cubic goes to -inf as x -> -inf, not as x
    grows (leading coefficient lambda^2 > 0)
    - "above the lower resonance" -> "in the inductive region"; the
    capacitive boundary moves with load and is not the gain peak
    - "as f_sw,max approaches f_r ... diverges" stated as a hypothetical
    Figures: bridge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
2026-09-21 AN: dead-time paths, commutation circuits, real tank currents, transformer design, figure sizes
    Eleven points raised on the English note.
    Drawings and physics
    - Dead time (steps 3 and 7): both C_oss loops were drawn on top of the
    tank, so two currents shared one wire. The tank now carries one line
    that splits at the legs. Why leg 1 converges and leg 2 diverges is KCL
    at a midpoint, dv/dt = -/+ i/(2 C_oss), and the panel says so.
    - Capacitive vs inductive: new circuit figure for the commutation itself
    (the incoming switch closing onto a conducting body diode, against
    closing onto its own), and the drain current of that switch added to
    the waveform columns with the recovery spike,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
2026-09-21 Add the 8:1 design point (2 x 8:2) and its vendor transformer spec
    N.x, the number of transformers in the series string, was hard-coded to 3
    in build_l6790_smath.py. It is now a variant parameter; the three existing
    design points carry Nx=3 so not one of their values moves.
    The new 8to1 point keeps the 7.5:1 tank exactly (Cr 100 nF, Lr 11 uH,
    Lm 20 uH, lambda 0.55) and only raises the wound ratio to 8, so n goes
    6.024 -> 6.426. Every electrical verdict improves: k.ZVS 2.091 -> 2.364,
    k.ceil 1.283 -> 1.348, k.lam 0.443 -> 0.537, Q.pk 0.766 -> 0.673. B.pk
    stays at 182.1 mT because it is set by the secondary volt-seconds alone,
    so k.Ae is unchanged. The magnetics pay instead: A.L 413.3 -> 242.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
    [Transformer_Spec_8to1.xlsx]
2026-09-21 Redraw the transformer cross-section to scale from the TDK drawings
    The old figure said so itself: "proportions are schematic ... nothing
    here is drawn to a dimension that was not published", because the
    datasheet values in hand were A_e, A_min, A_N and l_N and none of those
    gives the window. So the dimensional drawings were fetched first and are
    now in Reference/. From them: core 40.5 x 39.8, window height 29.5,
    centre leg 14.9; coil former tube 17.5, bore 15.5, winding width 25.4,
    flange to flange 29.
    The outer-leg inner face carries no label, so it was measured from the
    PDF's own vector coordinates rather than guessed. The two labelled
    dimensions on that view fix the scale to 2.1455 pt/m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
2026-09-21 Fix the DC-overlap test current: divide by L_mu, not by L_open
    The vendor spec sheet asked for a 15 A DC-overlap test on the 7.5:1
    transformer while the primary really carries 18.3 A peak. Those two are
    not the same kind of number - the open-circuit test has no secondary MMF
    to cancel, so the same current makes far more core flux, and the test
    current is the one that REPRODUCES the operating flux, not the operating
    current. So 15 < 18.3 is not by itself a contradiction.
    But the conversion was wrong. With the secondary open the primary
    current passes through L_L1 and then L_mu in series, and only the L_mu
    share goes round the centre leg. The sheet divided by L_open_x, which
    puts the leakage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
    [Transformer_Spec_6to1.xlsx, Transformer_Spec_7p5to1.xlsx, Transformer_Spec_8to1.xlsx, Transformer_Spec_9to1.xlsx]
2026-09-21 Put the saturation test current back on OVP2; keep only the L_mu fix
    The user asked whether the 15 A DC-overlap current had been set so that
    OVP2 trips before the core saturates. It had. HISTORY records it from
    2026-09-01: "the 1.5 was a number I chose. The user asked three times, so
    I looked again" - and the basis was moved from an arbitrary margin to
    OVP2. Below resonance the magnetising conduction window is fixed at
    T_r/2, so the magnetising current does not depend on f_sw at all; it is
    proportional to the output voltage alone. The highest output the
    controller ever allows is OVP2, so that is the worst core flux the part
    ever sees, and the test current is simply the magnetising peak there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
    [Transformer_Spec_6to1.xlsx, Transformer_Spec_7p5to1.xlsx, Transformer_Spec_8to1.xlsx, Transformer_Spec_9to1.xlsx]
2026-09-21 AN: explain the LLC transformer against the flyback one
    The question this answers is the one everybody who designed a flyback
    first asks: if the LLC transformer stores none of the energy it
    delivers, why does A_e matter at all, and why is the saturation test
    current nothing like the peak winding current?
    New section 6.9, "Not a flyback, and why that changes the core", with
    two figures. The whole difference is when the two windings conduct.
    A flyback's never conduct together, so at every instant the entire
    winding current is magnetising current and the flux follows the
    CURRENT. An LLC's conduct together, their ampere-turns oppose, and
    only the difference magnetises the core - so the flux f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
2026-09-21 AN: switches, per-winding flux, and where R_ac starts
    Four things the section was missing.
    The LLC panel had two gate waveforms under it and no gates. It is now
    drawn with a half-bridge leg, S1 and S2, with the midpoint feeding
    C_r, L_r and the primary and L_m across the primary - which is also
    the ordinary LLC the chapter it now lives in is about. A full bridge
    changes the amplitude and nothing in the argument, and the caption
    says so. The transformer moved right to make room; the L_m label
    moved above its own coil, because beside it the name lands either on
    the riser to its left or on the primary winding to its right.
    The flux row plotted only the net. It now plots what each winding'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
2026-09-21 Give the two circuits the width each one needs
    They were sharing one set of axis limits, and it cost both of them.
    The flyback spent three quarters of its width on an empty loop, so it
    read as the larger drawing while carrying less; the LLC had its tank,
    its magnetising branch and its transformer crushed into the same span,
    and L_m's name ended up sitting on the riser beside it. Magnified,
    the 'L' is on the wire.
    The panels are in separate columns, so nothing has to line up across
    the gap. The axis limits stay shared - that is what keeps a symbol
    the same size in both - but each circuit is now laid out to the width
    it actually needs. The flyback transformer moves left so its loop is
    3 un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
2026-09-21 Make the figure findings locatable in the PDF, and redraw the windings
    an_locate.py puts every figcheck finding back on the printed page. The
    old report named a figure and quoted a label, which is what a person with
    the generator source open needs and nothing at all for a person holding
    the PDF: there the figure has a number, not a name, and it is one page
    out of seventy. Figure name to page is resolved by pixel content - the
    PDF carries re-encoded copies of figures/an/*.png, so the bytes differ
    and the pixels do not - and the number is read off the caption under that
    image. It prints a table, writes a copy of the PDF with each offender
    ringed and one note per figure, and saves crops rend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
2026-09-21 Note which Korean figures this machine cannot redraw
    figs.py skips five Korean-only figures here for want of a font. One of
    them, loop_bode, has a fix in its source and a stale PNG - the axis that
    was labelled phase margin - so the Korean note still prints the old
    label until someone rebuilds it where the font exists.
    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
2026-09-21 Put the polarity dots where the reviewer marked them, and double the diodes
    The dot now sits on the outer side of the lead line, level with the
    first turn - the side the turns bulge away from, where the space beside
    the coil is empty. Two other places were tried: out past the lead at
    terminal height, which is on the circuit wire, and in the gap between
    coil and core, which is against the bars. The current and winding
    labels move out to make room.
    Figure 1's three group bands ran into each other once the transformer
    grew; each band now ends at the midpoint of the gap to the next group.
    Figure 3 loses its centre-tap junction dot the same way Figure 1 did,
    declared through nodot(). Figure 4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
2026-09-21 AN figures: Figure 11 callout merged, Figure 18 symbols and labels doubled
    - an_three_cases: one three-line truncation callout; cyan sentence only
    in the non-truncated columns; freewheeling bracket redrawn
    - an_flyback_llc: symbol multiplier 2.0 on both circuit axes, larger
    reference labels, GND lead, horizontal secondary wires, captions moved
    - schemx.scale: per-axes symbol multiplier (ignored for the transformer)
    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
2026-09-21 AN: transformer chapter read off the waveforms; redundancy pass across the note
    - new figure an_xfmr_read: primary/secondary winding currents and the
    secondary winding voltage of the worst cycle with marks 1-6, the
    line-cycle rms envelope, and the DC-overlap bench condition (mark 7);
    reading table that says what each mark sets, and lead-ins in the flux,
    window and saturation-test sections
    - Figure 42 reduced to its three drawings; legend, winding list and a
    current-to-copper table moved into the body, with the 2 + 2 explained
    - in AN mode figures no longer carry the grey footer (the caption said
    the same thing); the footers' unique facts folded into the captions
    - body: fifteen d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
2026-09-21 AN: Figure 42 reduced to its drawings, legend moved to a body table; chain-table typo
    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
2026-09-21 AN: design numbers only in the design example; chapter 7 rebuilt around one spec table and worked tables
    - chapters 2-6 are symbolic; the six figures that carry design values
    move to chapter 7, f14 dropped (an_above_below shows the same curves)
    - f11 normalised to p/P; f02/f04/an_loadshift legends without Q values;
    f18 without the design frequencies; f17 held-level labels beside the
    traces instead of boxed over them
    - chapter 7: one specification table, margins, a chain table with the
    arithmetic as a column, tables with computed-as columns for the
    transformer and the output bank; NS2 2 T and NS3 2 T instead of 2 + 2
    Claude-S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
2026-09-22 AN: present the design example the AN4932 way — equation label, repeated equations with substituted arithmetic, symbol list
    Every equation now follows one rhythm: a lead-in sentence, a bold
    "Equation N" line, the equation centred at 12 pt, and the sentence
    that uses it. In the design example the equations established
    earlier are recalled as "Equation N, repeated" and the numbers are
    substituted on the line below (an_pdf.eqagain / calc; the tex lives
    once in EQTEX so the two renderings cannot drift). Section 7.4 is
    now Steps 1–9 plus one results table; 7.8 and 7.10 follow the same
    pattern. Leading 12.2 → 13.2, paragraph gap 6 → 7, tables get 6 pt
    above and long tables may split across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
2026-09-22 AN 7.8: transformer symbol with the winding-to-pin map on the PQ 40/40 coil former
    New figure an_xfmr_pins: one unit's schematic symbol (NP1, NAUX, NS2,
    NS3) with a pin number on every terminal, beside the B65884E coil
    former in the plan view of the TDK drawing with its twelve pins at
    their drawn positions (5.08 / 15.24 / 38.1 mm, pin-1 marking bottom
    left). The datasheet marks pin 1 only, so the numbering direction is
    recorded as an assumption to confirm on the bobbin drawing; the
    assignment itself does not depend on it.
    The geometry and the assignment live once, in cores.PIN_XY / PINMAP /
    CENTRE_TAP, and the figure, the AN tables (pins, legend) and the
    vendor specification builder all rea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
    [Transformer_Spec_6to1.xlsx, Transformer_Spec_7p5to1.xlsx, Transformer_Spec_8to1.xlsx, Transformer_Spec_9to1.xlsx]
2026-09-22 Single-transformer check: PQ 40/40 and PQ 50/50DG both fail on window shape; PQ 50/50DG datasheet added
    cores.py gains the PQ 50/50DG core and coil former (B65981Q / B65982E,
    from the datasheet the user supplied). With one core wound 15 : 2 the
    flux is fine on either PQ (109 / 62 mT) but the copper does not fit:
    the 15-turn Litz primary needs 4.74 mm radially in two layers and the
    PQ windows offer 4.85 (40/40) and 4.15 mm (50/50DG). Findings and the
    window the design needs are in HISTORY.md; the note stays on three
    units until a core is chosen.
    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
2026-09-22 cores: ETD 49/25/16DG and ETD 54/28/19 registered; winding model splits wide foils and respects the radial room
    Both datasheets (user supplied) are in Reference/. winding() now splits
    a secondary foil wider than W_FOIL_MAX into parallel strips and picks
    the primary layer count inside the radial room, so a single-core build
    can be laid out on a deep-window core instead of degenerating. The
    three-unit PQ 40/40 result is unchanged (fits, 3.79 mm separation).
    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
2026-09-22 Design example on one transformer: ETD 49/25/16DG, sheet variant 7p5to1_x1, pin map, spec
    The note's worked design is now a single part: sheet variant
    7p5to1_x1 (N.x 1, 15 : 2, N.aux 3, A.e 211 mm2 - A.e is a variant
    parameter now) and an_pdf reads it by default. cores.py names the
    chosen core (CHOSEN), carries both coil-former pin maps (ETD 49
    20-pin, PQ 40/40 12-pin) and lays the winding out on any registered
    core: foils wider than 12 mm are split into parallel strips and the
    primary layer count is chosen inside the radial room. Section 7.9
    tries PQ 40/40, PQ 50/50DG, ETD 49/25/16DG and ETD 54/28/19 in one
    table; the PQ windows are too shallow for a 15-turn primary. 7.8 has
    the 20-pin assi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
    [Transformer_Spec_6to1.xlsx, Transformer_Spec_7p5to1.xlsx, Transformer_Spec_7p5to1_x1.xlsx, Transformer_Spec_8to1.xlsx, Transformer_Spec_9to1.xlsx]
2026-09-22 AN 7.8/7.9: design only, secondary drawn layer by layer, no jargon
    Remove the four-candidate core table and the two explanatory notes from
    7.9; shorten the 7.8 prose to the facts. Redraw an_core_section with the
    pin figure's winding colours (NP1/NS2/NS3) and a layer-by-layer secondary
    panel (turns, pins, 3 foils in parallel per turn, insulation); drop the
    "enlarged N x" and "strips" wording everywhere.
    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
2026-09-22 AN: compensation chapter with equations and a worked loop chain, Figure 40 larger, full read-through
    Rewrite 6.26-6.33 (loop blocks figure, plant integrator, aims-and-failures
    table, 2f_l ripple to third harmonic, TL431/optocoupler transfer function,
    K-factor placement, solver-free crossover/phase/gain margin, burst ripple)
    and turn 7.13 into a 13-step substituted calculation. Sheet constants are
    read from the builder by an_pdf._builder_const(). Figure 40 drawn 15 %
    larger with fig(shrink=False). Full read-through fixes: front-matter figure
    sentence, six plain-English rewordings, PFC naming, section references,
    symbol list and TND381 reference; mathtext \leq/\mathrm.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
2026-09-22 AN v1.3: op-amp equivalent of the TL431 compensator, example Bode plot, Korean edition rebuilt to match
    - 6.29: TL431 network redrawn as an inverting op-amp stage, optocoupler current gain and FB-pin pole (an_comp_opamp)
    - 6.31: example loop Bode plot with crossover, phase margin, gain margin and the 2f_l point marked (an_loop_example)
    - References heading restored (lost when the symbol list was added); errata is now chapter 10
    - Korean body rewritten section by section from the English one, same figure/table/equation keys
    - Korean face without Greek: T() wraps missing glyphs in the Latin face; EQWORD/EQAGAIN per edition
    - figure labels: v_FB sign, D3 check wording; both editions pass an_che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
2026-09-22 AN v1.3: Figure 35 redrawn with circuit symbols (TL431 as op-amp + V_R source, LED, phototransistor, R_O, R_P)
    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
2026-09-22 AN v1.3: Figure 35 formulas in STIX, optocoupler as a controlled current source, output node with a junction dot
    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
2026-09-22 Figure 35: smaller amplifier and BJT, separate primary/secondary grounds with the isolation barrier, shorter ground leads
    The PDFs are deliberately left at the previous build: the figure is out for
    review, and both editions are rebuilt once it is confirmed.
    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
2026-09-22 Figure 35: put the input marks exactly on their pins
    A '+' or a '-' set with va='center' lands about 1.7 pt above its anchor,
    because matplotlib centres the glyph's layout box and the ink of both signs
    sits above that box's centre. Measured on this face at this size and pushed
    back down in points, so it holds at any figure scale. Verified on the saved
    image: the plus stroke centres on the REF wire to within half a pixel and
    the minus bar on the V_R wire exactly, at 193 px per data unit.
    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
2026-09-22 English AN: how the power factor is corrected, the gain chart, four figure fixes
    The note stated the control law as three equations and never showed it.
    Chapter 4 now walks one line half cycle in four panels (what unity power
    factor asks for, the power that implies, what that asks of the tank, and
    the f_sw(theta) that answers it), says which pin carries which half of
    the job, and says plainly that the draft datasheet does not publish the
    law inside the PFC block. The cubic moved into a section of its own.
    New section 4.5 puts the ordinary LLC gain chart beside the single-stage
    one and lists the six differences: the family is line phase, not load;
    the operating point is a trajectory, not a p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
2026-09-22 Design example: give every number its equation and its substitution
    The reader could not see where the skin depth or the 0.0079 came from,
    and that was true of more of chapter 7 than Table 15. Added, in the
    AN4932 form the rest of the chapter already uses - equation restated,
    then one line of arithmetic:
    7.8 why the composite peak is not the sum of its parts, and the
    five-point Simpson the line-cycle rms values actually come from
    7.12 the two rows that carry the loss: I^2 R for the standing primary
    device and for each secondary rectifier, both with R_DS(on) hot
    7.16 C_T,max and R_T,ceil worked out
    7.17 both R_CS conditions, and the dissipation that fixes how man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
2026-09-22 Define the conductor terms and move their equations into the method chapter
    The design example divided by a_s before anything had said what a strand
    is or what a_s means, and the equations that produce it existed only in
    chapter 7 - so the method chapter described the problem (skin depth) and
    then jumped straight to a finished winding.
    6.16 now says what Litz actually is - a bundle of individually insulated
    fine wires, one of which is a strand, with d_s its diameter and a_s its
    copper cross-section - and carries the three sizings that follow:
    Equation 29 a_s = pi d_s^2 / 4 and the strand count
    Equation 30 the served-bundle diameter, with k_litz defined
    Equation 31 the foil width, a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
2026-09-22 Move the tool chain and tool traps into generators/README.md
    CLAUDE.md enters every turn whole, so its two longest sections were also
    its most expensive: section 9 (the tool chain, 27,924 chars) and section
    11 (the tool traps, 6,090). Neither is design content - both are
    procedure for whoever is regenerating or checking an artefact. They now
    live in Design Guide/generators/README.md, next to the scripts they
    describe.
    CLAUDE.md 69,548 -> 36,670 chars, roughly 23,200 -> 12,200 tokens a turn.
    What stays behind is a stub naming what moved and one rule: read that
    README before editing a .sm or an .xlsx. The traps are not advice - each
    one already cost a file once (uppercase Ohm killing the she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
2026-09-22 Strip finished work out of CLAUDE.md; move three facts it alone held
    CLAUDE.md is the project plan, so it should say where the project is and
    what is next - not what was done in August. Removed section 4.1 (Phase
    4/5/6 detail, 2,658 chars) and the quoted block re-telling how two
    "structural limits" were closed in August; both are in HISTORY.md. The
    Phase table collapses to one line for the finished phases plus a table
    of what is actually left.
    Corrected two stale claims in the overview: it said "판정 지표 23개 전부
    합격" while section 3 reports 34 of 40 with six explained shortfalls, and
    "다음에 할 일" still pointed at guide rev 2.0, finished on 2026-09-11.
    The next work is th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
2026-09-22 smgen.py: no backslash inside an f-string, so the hook runs on Python 3.11
    The Stop hook fired for the first time and failed: it runs `python`,
    which on this machine is 3.11, and smgen.text() had a backslash inside
    an f-string expression - legal from 3.12, a SyntaxError before it. The
    whole check_sm chain imports smgen, so every check behind it reported
    "?" and the guard blocked the turn.
    Hoisted the attribute string out of the f-string. The generated sheet is
    byte-identical (compared against HEAD ignoring line endings); the hook
    now exits 0 under both 3.11 and 3.12.
    Claude-Session: https://claude.ai/code/session_01L3H8Na8buSZY2uPpuu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
2026-09-22 Tidy the tree: HISTORY.md into docs/, untrack machine state, map the Altium project
    HISTORY.md moves next to docs/DESIGN.md, so the repository root holds
    CLAUDE.md and the artefact folders only. audit_md.py and coldstart.py
    read it from the new path; every prose mention is by bare name and the
    path check resolves by basename, so nothing else changes.
    Two files that record per-machine state - guard.py's mtime stamp and
    snapshot.py's previous-values cache - were tracked in git, which makes
    every clone disagree with the last one to commit. Untracked and ignored.
    The sweep also found a top-level folder no document had ever named:
    "LGE_670W_L6790A Single Stage PFC LLC TV Power/", the Altium pro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
2026-09-22 Altium project: not a check or comparison target, per user decision
    The schematic folder stays in the file map as a one-line 'ignore' entry
    so a later sweep does not rediscover it and raise it again; the open
    comparison item is withdrawn.
    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
2026-09-22 Remove the Altium schematic project from the repository, per user
    Twelve files, 3.5 MB, imported from Drive on 2026-09-16; the source
    stays on Drive. Map row and ignore rule dropped with it.
    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
    [L6790A_GaN.SchDoc, L6790A_Si.SchDoc, LGE_670W_L6790A Single Stage PFC LLC TV Power.PrjPcb]
2026-09-22 AN (EN): rewrite the whole body for concision, 102 -> 93 pages
    Read every one of the 706 statements in an_body.build() and rewrote or
    removed 373 of them. Short declarative sentences; idiom and narrator
    asides gone; "Section X covers that" forward references gone; basic
    concepts (reverse recovery, the power-factor definition, hard-switching
    loss) cut to one sentence; the blue note boxes kept only where they
    change a design decision, the summary/preview/repeat ones folded into
    the text or dropped. No figure, equation or table was removed; captions
    were shortened.
    Prose 101,720 -> 67,754 chars (-33 %), notes 33,713 -> 16,697 (-50 %),
    captions and table text 137k -> 117k. Pages 102 -> 93.
    Edi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
2026-09-22 AN (EN): six line conditions in one list; gain chart as six panels; cover text moved up
    The mains voltages a supply actually meets - 90 and 110 Vac in full
    bridge, 230 and 264 Vac in half bridge - now sit beside the two morphing
    edges in one list, l6790.line_conditions(). The gain chart of the design
    (Figure 38) is one panel per condition, low to high, so every curve is
    read against its own required-gain line and nothing else; the text
    spells out where the real-world voltages fall between the edges. The
    above/below-resonance figure, the peak-frequency table and the ZVS grid
    read the same list, where before three places carried three different
    sets. Panel annotations moved off the curves, gri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
2026-09-22 AN (EN): gain-curve side rule, Fig 23 removed, Fig 42 at six input voltages, "line" -> "input voltage"
    - Section 2.5: how the gain chart tells below/at/above resonance
    (required gain against 1, crossing left or right of f_n = 1)
    - Figure 23 (f11_power_balance) duplicated panel 2 of the PF chain
    figure; the text now points at that panel
    - Table 10: columns named "Input voltage (bridge mode)" and
    "V_eq (Vac rms)", values with the Vac unit
    - an_xfmr_read: lower panels redrawn for all six input voltages, one
    panel per winding, names in the legend, darker grid; the HB edge
    draws the most current in both windings (computed), which the
    caption now states
    - 16 places that used "line" for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
2026-09-23 Korean AN: re-port from English v1.3 body and naturalize the Korean text
    an_kr_body.py rewritten statement by statement from an_body.py so the
    Korean edition carries rounds 29-38 (PF explanation, gain-comparison
    section, 130-row symbol table, shorter preamble, six input voltages,
    resonance-side rule, Figure 23 removed, Eq 12 factor 2, Figure 45 sourced
    from the sheet). Section/figure/table/equation keys and order match the
    English body.
    Naturalization pass on the Korean prose: translated idioms and
    AI-flavoured phrasing replaced (floor/ceiling -> 하한/상한, "먹이다"
    removed, 울린다 -> 공진한다, 후하다/인색 -> 낙관적/보수적, 곡선 벌 ->
    곡선군, particles after c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
2026-09-23 Korean AN: replace forced Sino-Korean terms with the English terms engineers use
    User direction: no forced Sino-Korean coinages; technical terms that are
    normally said in English stay in English (e.g. 권선 개방 -> 권선 Open).
    an_kr_body.py vocabulary swept (about 3,600 distinct tokens). Replaced:
    Open/Short, pole/zero, threshold, phase margin, crossover 주파수, error
    amp, No/Light/Full load, Overload, skin depth, proximity effect,
    sense/sensing, multiplier, idle 시간, dead band, budget, RHP zero, Bode
    plot, THD, UVLO, cold start, creepage, junction 온도, area product, NC,
    히트싱크, 인덕터, 지령, 피크, and a handful of awkward single words.
    Kept the terms Korean engin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
2026-09-23 Korean AN: second full read-through, translationese and AI-style phrasing removed
    Read all 93 pages paragraph by paragraph as a native-speaker engineer and
    rewrote about 125 sentences in an_kr_body.py: literal verb calques
    (sweep, carry, close, break, sag, fold, decide), literal noun phrases
    (as wound, ladder of lines, bin, dependency order, incoming device),
    personification and metaphor (the motor is wrong, fight the ripple,
    the controller answers with its variable, free lunch), and four section
    titles (with their SR() references). Kept the field terms Korean
    engineers use in Korean and the mathematical "closed form".
    KR PDF rebuilt: 93 pages, an_check clean, leftover scan 0.
    HISTORY 41차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
2026-09-23 AN (EN+KR): flyback-vs-LLC flux sequence, DC-overlap test explained, OVP2 basis
    Section 2.12: new figure an_flux_steps builds the core flux interval by
    interval for a DCM flyback and a below-resonance LLC side by side, with
    step-by-step text, a comparison table (what sets the flux, load and
    frequency dependence, the gap's role, what threatens and what guards the
    core, the saturation test current, what sizes Ae) and six design rules.
    Section 6.19: what the DC-overlap line on a transformer specification
    says and where the name comes from (dc current overlapped on the LCR
    meter's small ac signal; also called dc bias or dc superposition), what
    the test reveals that AL and L_open cannot, new fig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
2026-09-23 Korean AN: third full read-through, field vocabulary and literal titles fixed
    Re-read all 95 pages of the Korean edition and rewrote about 460
    phrases: foil -> 동박, "any wire" -> 선종 무관, Litz strands and bundle
    -> 소선 / 완성 외경, window -> 권선창 (magnetics), 구간 (time) or
    선택 범위 (component values), fill factor -> 점적률, side-by-side ->
    분할 권선, cover / half-sine / refer / win / spread / swing calques,
    22 literal section titles ("as built" etc.), chapter references,
    front matter, revision row and the Korean pin note.
    Two factual errors found while reading, fixed in both editions:
    section 7.6 announced three readings over four bullets, and the symbol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
2026-09-23 AN (EN+KR): clarify every ambiguous condition; clickable TOC and bookmarks
    Table of contents: every h1/h2 now drops a PDF destination and an outline
    entry, and the TOC entries link to them (212 links, 106 bookmarks per
    edition, every target verified).
    Tables: measurement conditions spelled out (measured across NP1; the
    other windings open, or NS2 and NS3 both shorted with NAUX open; LCR
    100 kHz / 1 V; dc overlapped, normal temperature) in Tables 4, 13, 17,
    the symbol table and section 6.10, matching the vendor specification.
    Operating conditions added where a value had none (input voltage, load,
    line phase). Tables 8 and 23 no longer print the 249 kHz operating
    maximum under the fsw,max sym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
2026-09-23 AN 45차: 그림 11 게인 곡선 패널, 영·한 간결화
    - an_three_cases 아래에 게인 패널: below/at/above 세 열을 M(fn) 위 점으로
    (Half load 곡선, Full load 는 ZVS 경계부터만), 영역 색은 f04 와 동일
    - 2.5 절 캡션·불릿에 M 관계, 2.6 절 판독 규칙을 한 문단으로("첫 행" 오류 정정)
    - 중복 note/불릿 4개 삭제, 장황한 문단·캡션 11곳 단축(영·한 동일)
    - 한국어판 소문자 open → Open
    - 영문 94쪽 · 한국어 95쪽, an_check 0, 미해결 참조 0
    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
2026-09-23 정본 시트·워크북을 7.5:1(코어 3개)로, 9:1 삭제
    - build_l6790_smath 기본 변형 9to1 -> 7p5to1, 정본 .sm 재빌드
    (variants/L6790A_7p5to1.sm 과 바이트 동일)
    - 정본 워크북을 variants/L6790_workbook_7p5to1.xlsx 로 교체
    (시트·수식 구조 동일, 캐시값 전부 있음)
    - 9:1 시트·워크북·벤더 사양서와 도구의 9to1 항목 삭제
    - DESIGN.md §3 재생성(판정 34/40 -> 36/40), §1.3·§4.2, CLAUDE.md 정리
    - AN(7p5to1_x1, 트랜스포머 1개)은 변경 없음
    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
    [L6790_spreadsheet_r1_0_corrected_rev0_6.xlsx, L6790_workbook_9to1.xlsx, Transformer_Spec_9to1.xlsx]
2026-09-23 한국어 본체 문서 rev 2.0(9:1) 삭제, 식 번호 출처를 rev 2.1 로
    - audit_sm · audit_guide · 빌더 docstring 이 rev 2.1 을 읽는다
    (식 태그 166개 집합 동일, audit_guide 결과 동일)
    - HISTORY 47차: R.T 10 kΩ 은 워크북 한계(5–30 kΩ, RT.ceil 11.24 kΩ) 안
    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
2026-09-23 R.T 11 kΩ 유지 — 트랜스포머 공차 대 영교차 dead zone 기록, 실측 후 결정
    - DESIGN.md 4.2 5b: R.T 별 f.Min · 견디는 L.open 하락 · dead zone 표,
    하드 스위칭 위험 위치(영교차), L.open ±5/±3 % 선택지, 미정 공차(C.r · C.T)
    - DESIGN.md 4.3 12: R.T 판정 실측 항목 신설
    - CLAUDE.md 다음 할 일 갱신, HISTORY 48차
    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
2026-09-23 R.T 항목에서 공차 대책·미정 공차 제거 (사용자: 공차는 무시)
    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
2026-09-23 AN 최종 전수 검토(50차) — 틀린 서술·수치 수정, ZVS 격자 표, 한국어 마이너스·조사 - 틀린 서술: fast-recovery 이유, M_Z 와 capacitive 경계, M∞ 아래 해 없음(No load), below 의 2차 전류 모양, Class D 범위, skin depth, f_Max 의 I_EA,max, 자화 피크 식, 판단 주석(C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
2026-09-23 트랜스포머 설계 정리 PDF 삭제, 교육자료 중단 (사용자 지시) - L6790A_Transformer_Design_KR_v1.0.pdf, tx_pdf.py, tx_body.py 삭제 — 내용은 AN 에 있다 - CLAUDE.md 산출물 넷 -> 셋, 파일 지도·다음 할 일 정리, README · rules/an.md 참조 제거 - audit_md: 지운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
2026-09-23 워크북 CHANGELOG 에 빠진 17셀 기록, 교육자료 삭제, 코어는 설계자 몫으로
    - log_xl_unlogged.py: ST 원본과 설계 시트 7장을 전량 대조해 CHANGELOG 가
    부르지 않는 셀을 CHANGELOG_rev0_6 96행부터 기록 (정본 · 7p5to1 · 6to1).
    수식·값 무변경, calcChain 보존. xl_sm_compare 145/145, bom_compare 0
    - Power Components D71 (Coss 897 pF) 은 근거 불명으로 열린 항목에 적음
    - 교육자료 PPT 와 전용 도구 3개(check_deck, deckedit, fix_deck_overflow) 삭제
    - DESIGN.md 5d: 코어는 시트가 고르지 않는다 — 설계자 몫. CLAUDE.md 할 일 정리
    - HISTORY 52차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
    [L6790_spreadsheet_r1_0_corrected_rev0_6.xlsx, L6790_workbook_6to1.xlsx, L6790_workbook_7p5to1.xlsx]
2026-09-23 AN figures: mark every plotted quantity on its circuit, fix sign/name errors
    - Figure 1 and the four mode panels: secondary spread by about a third
    around the centre tap.
    - Figure 1: v_d between nodes A and B, and reference arrows for i_S1,
    i_Lr, i_Lm, i_D1 and i_D2, each in its Figure 2 trace colour.
    - Figure 2: T_r/2 and T_sw brackets; the two rectifier humps are named
    i_D1 and i_D2.
    - Flyback/LLC figure: on-wire reference arrows for i_p, i_s, i_mu. The
    LLC i_p label sat on the branch carrying i_s.
    - Flux-steps figure: the flyback row read N_p i_p - N_s i_s while
    plotting a positive ramp with only i_s flowing; it now reads +.
    - Transformer reading figure: the first-half pulse is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
2026-09-23 AN round 53: root cause of missed errors, re-audit from zero
    Why past full reviews missed errors: no check read the text drawn
    inside figures, reviews kept no ledger, figures were not re-derived
    from independent evidence, fixes were not widened to the whole class,
    and typed numbers in figure code went unchecked. figcheck measured
    only ax.texts for tiny text and was run on changed figures only.
    New checks: an_figtext.py (figure symbols vs the symbol table,
    typed numbers in the string literals of the drawing functions, symbol
    use per figure); figcheck tiny now measures every text.
    Fixes: v_RI/R_ac on the secondary of n:1 in Fig 32; FHA step 2 kept
    the rectifier; G_EA sign defined as -v_FB/v_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
2026-09-23 AN: take this design's numbers out of chapters 2-6
    Curves stay; only the printed values go: f_o = 0.60 f_r and Q = 0.77 /
    0.38 labels, the cap/ind operating points, lambda = 0.55 and M_inf =
    0.645 in the gain comparison, numeric current and frequency axes of
    the mode strip, PF chain and DC-overlap figures, and the skin depth in
    chapter 6 (the value remains in the chapter 7 calculation).
    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
2026-09-23 AN: fixes from a line-by-line check against the draft datasheet
    Capacitive-mode protection senses ISEN, not ZCD; OCP1 raises the
    switching frequency rather than limiting cycle by cycle; T_idle has
    three readings in the draft (700, 350, 250 ns) and the 250 ns one comes
    from Table 2; the auxiliary turns-ratio ceiling is derived from the
    25 V VCC rating. The V_FB law is written with P_in,LLC, the power the
    sense resistor in the bridge return sees; R_CS,max1 keeps P_in and says
    it is 2 % conservative. Mark table uses V_o,eff as the equation does,
    C_in nF/W is computed, design ratios leave chapter 6. Korean edition:
    THD wording and two-stage throughout.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
2026-09-23 HISTORY: HVSU diodes 1000 V class, confirmed by the user
    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
2026-09-24 AN v1.3: human-style read of the EN edition, fixes carried into KR (round 56)
    - Table 11 vs Table 12: gain-chart crossing floored onto the grid
    (156.3 vs 156.4 kHz) -> interpolate inside the step in figs_pf._cross
    - 7.11 ripple/hold-up swap point computed (5.2 %, not "10 %")
    - Table 17 arithmetic shown to the precision that reproduces it;
    window-use sentence states the 205 mm2 it compares
    - Table 18 open-circuit tolerance wording; 7.10 distributed gap
    - Cover: no number in the example is measured
    - T_idle note lists all three draft values; burst entry is % of P_in;
    why R_BM stays at 30 kOhm until standby power is measured
    - Table 4 / 6.14 / 6.15 conditional on splitting into N_x units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
2026-09-24 AN v1.3: settle the open text items from the round-56 read (round 57)
    - Soften two unsupported absolutes (8/pi^2 "every text", interleave)
    - ESR rule: each ripple component at its own frequency; the unsourced
    "5 to 10 times" dropped. Loss table notes that the 2f_l part in the
    120 Hz ESR is not in the 0.162 W (fitted part's tan delta unknown)
    - Define omega_l, M_OL, L_L1/L_L2 and mu_0 beside their equations
    - Fig 30 caption says what V_BO is
    - EN and KR alike
    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
2026-09-24 AN v1.3: name input conditions by mains voltage and bridge (round 58)
    "332 Vac eq." read as an input that the specification does not have.
    Conditions are now named "166 Vac, full bridge (FB edge)", "90 Vac,
    full bridge", ..., and what the tank sees is spelled out ("tank sees
    2 x 166 = 332 Vac") in Fig 39 panels, Tables 10-13 and 18, the 7.5-7.9
    and 7.25 text, and the Fig 26 notes. The equivalent-input concept in
    chapters 4-6 is unchanged; no value changed. Korean edition alike.
    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
2026-09-24 Start-up end threshold at ZCD: datasheet 1.36 V instead of 1.35 V (round 59)
    The ST tool carried 1.35 V; the draft datasheet's electrical
    characteristics give V_ZCD_SUend = 1.36 V (typ). User decision: datasheet.
    - Builder constant 1.35 -> 1.36; canonical sheet and four variants rebuilt
    (V.out_SUend 16.53 -> 16.65 V)
    - Workbooks (canonical, its variants copy, 6:1) via fix_xl_suend.py:
    D71 = 1.36, D88/D98/D99 formulas kept with recomputed caches,
    CHANGELOG_rev0_6 row added; xl_sm_compare 145/145
    - Design guide md and AN 7.20 say what the 16.65 V is and where the
    1.36 V comes from
    Claude-Session: https://claude.ai/code/session_0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
    [L6790_spreadsheet_r1_0_corrected_rev0_6.xlsx, L6790_workbook_6to1.xlsx, L6790_workbook_7p5to1.xlsx]
2026-09-25 figs_modes8: register the coils where they are used, not only at import
    an_pfc_boost clears the global schemx registry when it finishes, so the
    mode sheets' current highlight followed the windings or ran straight
    across them depending on the render order; the AN's plain set had the
    straight version. build() now registers right before drawing.
    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
2026-09-25 AN 6.19: derive why the saturation test current follows OVP2 (round 61)
    The same peak flux written from the clamped secondary's volt-seconds and
    from the magnetising current gives i_mu,pk = n_T V_o,eff / (4 f_r L_mu):
    A_e cancels and nothing the load or input sets is left, so the worst case
    is the highest output the bridge still switches at, V_OVP2. The bench
    current obeys the same B = L_mu I / (N_p A_e). 7.12 checks the 12.41 A
    from the output voltage alone. English edition; Korean after review.
    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
2026-09-25 AN line-by-line audit (round 63): gap, loss total, L drop, 30+ text fixes
    - Core gap: TDK DG G2/G3 are per half; set total 2(G2+G3) -> 2.2 mm,
    not 1.1 mm (cores.AL_gaps).
    - Loss table: the switching-position row counted one of two positions;
    itemised total 23.15 -> 27.97 W from the sheet's P.pri_tot.
    - L_open allowed fall 4.1 -> 4.0 % (unrounded f.o/f.Min).
    - Plant integrator assumption (constant-power load), crossover vs CTR,
    iteration convergence, ZCD pin polarity, Gamma_v definition, C_in
    floor vs THD, and ~25 wording/definition/reference fixes.
    - Table cell leading 12.2 pt; Fig 5, 25, 32 label fixes; missing
    Toshiba reference; unused symbol-table entries removed.
    Co-Authored-B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
2026-09-25 Round 64: auxiliary winding supplies VCC (2 T + Zener regulator); transformer safety insulation for US/EU/JP/KR/CN household AV
    - Sheet section 14c: n.aux 1.0 (2 T), R.ZCD_H 220 k, Zener emitter-follower VCC
    regulator with k.VCClo, k.VCC, k.RBZ, k.CVCC, k.thand (44 checks, 41 pass;
    k.auxr is the ST direct-feed test, an intended difference from the workbook)
    - Workbook F83/F91 via fix_xl_aux2t.py, caches and CHANGELOG
    - insulation.py: reinforced insulation at 5000 m (clearance 4.5 mm, creepage
    6.4 mm, DTI 0.4 mm / two tape layers, 3000 V ac), sources, working-voltage
    estimate and geometry checks; cores.winding enforces the separation floor
    - Vendor spec section 5 (safety insulation),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
    [L6790_spreadsheet_r1_0_corrected_rev0_6.xlsx, L6790_workbook_6to1.xlsx, L6790_workbook_7p5to1.xlsx, Transformer_Spec_6to1.xlsx, Transformer_Spec_7p5to1.xlsx, Transformer_Spec_7p5to1_x1.xlsx, Transformer_Spec_8to1.xlsx]
2026-09-25 Round 65: re-audit fixes, figure stamps, leakage diagnostic
    Audit round 65 (28 findings): stale figures regenerated and stamped
    (figstamp.py, guard check 6, figs_modes8 output now stamped too),
    V_DZ / V_D symbols, two-segment C_VCC requirement (629 uF),
    flange-rim insulation geometry, k_RBZ wording and symbol entry,
    missing table rows, revision history and scope notes.
    leakage.py: exact 2D window-field estimate (Roth series) of the
    leakage the drawn side-by-side winding gives, plus the field direction
    on the secondary foil. ETD 49, 15 T, 7.36 mm separation estimates
    15.6-38.7 uH against the 11.0 uH the tank asks, and the field across
    the foil face dominates. Recorded as DESIGN.md 4.2 item 1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
    [Transformer_Spec_6to1.xlsx, Transformer_Spec_7p5to1.xlsx, Transformer_Spec_7p5to1_x1.xlsx, Transformer_Spec_8to1.xlsx]
2026-09-25 Rebuild the example transformer so it reaches its leakage
    User decision: keep the resonant inductance in the transformer and
    make the secondary Litz. leakage.py now adds the part of each turn
    outside the core (free space over the centre leg, by images) to the
    in-window solution. With the gap as the reinforced insulation no
    side-by-side layout reaches 11 uH (about 28 uH with Litz), so the
    insulation moves into the wire:
    - NP1 in triple-insulated Litz, split 12 T + 3 T on either side of the
    secondary; the gaps (2 x 2.0 mm nominal) set the leakage only.
    - NS2/NS3 in Litz, two bundles per turn, alternating and turned over
    at the layer change (balanced halves: 11.09 / 11.11 uH).
    - Estimated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
    [Transformer_Spec_6to1.xlsx, Transformer_Spec_7p5to1.xlsx, Transformer_Spec_7p5to1_x1.xlsx, Transformer_Spec_8to1.xlsx]
2026-09-25 Wind the example transformer as a section winding, like onsemi
    User decision: do not split the primary; wind it the way the onsemi
    reference transformers are wound, on a two-section coil former with a
    partition and tape over every layer.
    - NP1 triple-insulated Litz, 15 T in one section (3 layers of 5); a
    1.0 mm partition (assumed: TDK lists the ETD 49 former with one
    section only); NS2/NS3 in Litz, one bundle per turn, two layers,
    swapping places at the layer change; 0.05 mm layer tape (assumed).
    - leakage.py estimates 14.13 uH, 28 % above the 11.0 uH target and
    above its +10 % limit (12.46 uH even with no partition). The AN and
    DESIGN.md say so and leave it to the first samples;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
    [Transformer_Spec_6to1.xlsx, Transformer_Spec_7p5to1.xlsx, Transformer_Spec_7p5to1_x1.xlsx, Transformer_Spec_8to1.xlsx]
2026-09-25 Move the example transformer to E 60/22/16 at the tank's leakage
    The section winding leaked about 14 uH on ETD 49 against the 11 uH the
    tank is built on. A filled section winding leaks in proportion to the
    mean turn times the copper area over the window depth squared, so it
    needs a deep, short window: across the Magnetics and TDK ETD, EER, ER,
    EC and E ranges, E 60/22/16 (14.19 x 27.6 mm) is the one that takes it
    at L_r within the current density of the note.
    - cores: E 60/22/16 (Magnetics 0R46016EC, R), rectangular centre leg,
    custom two-section former whose flanges take what the winding leaves
    (nothing inside the former is empty); pins specified as the ETD 49
    former's. winding() siz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
    [Transformer_Spec_7p5to1_x1.xlsx]
2026-09-25 Audit the E 60/22/16 winding; drop the ETD 49 and ETD 54 data
    Self-audit of the example transformer:
    - leakage: new first-order diagnostics. proximity() gives the strand eddy
    loss in the leakage field, dc_loss() the I^2 R, sharing() the current
    driven around bundles put in parallel. Results: strand loss is 3.9-5.5 W
    in NP1 and 2.6-3.7 W in NS2+NS3, against 3.2 W dc. The four
    side-by-side bundles of a secondary sub-winding carry about 2.5 A rms of
    circulating current, against a 3.5 A load per bundle. The series
    converges to 10.998 uH at four times the terms.
    - AN source: corrected two claims ("within the current density of this
    note"; the half twist "shares the current equally")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
2026-09-26 Rebuild the example transformer as design B on TDK PC47EE60-Z
    The AN example transformer moves to the layout chosen by the user
    ("B"): E 60/22/16 as TDK PC47EE60-Z, NP1 one TIW-Litz bundle in four
    layers (4, 4, 4, 3 turns), each secondary turn three Litz bundles side
    by side, one turn a layer in the order NS2, NS3, NS2, NS3, the two
    sections touching with no partition. Every trace of the previous layout
    (two-bundle primary, eight-bundle sub-windings, partition, profiled
    Litz, Magnetics R, PQ 32/30 and PQ 50/50DG data) is removed from the
    code, figures, AN, vendor spec and docs.
    - cores.py: TDK catalogue data (A_e 247, A_L gap curve, core loss
    point), E min 43.8 geometry, 24-pin custom for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
    [Transformer_Spec_7p5to1_x1.xlsx]
2026-09-26 Add Lr14/: a separate copy of the design with L.r 14 uH, L.m 25.46 uH
    The user asked for the tank L.r 14 uH / L.m 25.46 uH / C.r 100 nF to be
    worked in a separate copy, the existing files untouched. Lr14/ copies
    Design Guide, Smath, Calculation Excel Sheet, docs and CLAUDE.md;
    Reference/ is a link to the original.
    - builder: 7p5to1 and 7p5to1_x1 at 14 / 25.46 uH; sheets rebuilt
    (0 mismatches); canonical 40/44 (k.Ae: B.pk 205 mT on the EE6405
    placeholder), AN point 41/44
    - workbook: Res. Tank Design F44/F45 via xlsx_patch (lr14_xl.py),
    logged in CHANGELOG_rev0_6
    - example transformer: flanges 1.35 mm, partition 1.73 mm taking the
    whole width left, NP1 4 layers, NS 3 bundles a turn: 1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
    [BACKUP_L6790_workbook_6to1.xlsx, L6790_spreadsheet_r1_0_corrected_rev0_6.xlsx, L6790_workbook_6to1.xlsx, L6790_workbook_7p5to1.xlsx, Transformer_Spec_6to1.xlsx, Transformer_Spec_7p5to1.xlsx, Transformer_Spec_7p5to1_x1.xlsx, Transformer_Spec_8to1.xlsx]
2026-09-26 Lr14: figures and AN rebuilt for the new tank; checks wired for the copy
    - all figures regenerated (figs.py --plain), AN rebuilt; an_check,
    an_symbols, figstamp, bom_compare, check_sm and the copy's guard pass
    - links to the original input folders (Datasheet, EVB Schematic, LGE
    Material, Reference) and .claude/rules; audit_md follows links;
    Lr14/.gitignore for the per-machine guard state
    - wording where the gap and the header comments still said the sections
    touch (a final AN rebuild follows)
    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
2026-09-26 Lr14: partition trim slope is -0.14 uH per 0.1 mm (leakage.py), not -0.15
    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
2026-09-27 Lr14: example transformer on TDK ETD 54/28/19 with its catalogue former
    The copy's transformer moves from E 60/22/16 (custom former, pins with no
    data-sheet basis, 1 mm margin tape) to TDK ETD 54/28/19 on its catalogue
    coil former B66396W (22 pins) with a 2.0 mm partition added and nothing
    left empty. Of eleven TDK cores with a pinned catalogue former, six fill
    with a 2.0 mm partition at bundle level; ETD 54 was taken for pins and loss.
    - cores.py: ETD 54 core, former, pins (two bundles a pin, centre tap shared
    on pins 15-19); winding() with parallel primary bundles (PRI_PAR 3), a
    fixed partition on a catalogue former, flange-limited radial room and an
    along-layer pitch that fills the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
    [L6790_spreadsheet_r1_0_corrected_rev0_6.xlsx, L6790_workbook_7p5to1.xlsx, Transformer_Spec_7p5to1.xlsx, Transformer_Spec_7p5to1_x1.xlsx]
2026-09-30 PQ50: copy of Lr14 with one TDK PQ 50/50 15:2 transformer
    New project copy PQ50/ (Lr14 untouched). Sheet, workbook and core data
    are moved to the PQ 50/50 design point:
    - cores.CORES['PQ 50/50'] from the TDK B65981A/B65982E data sheet
    - builder 7p5to1 and 7p5to1_x1: C.r 180 nF, L.r 25 uH, L.m 45 uH;
    R.T 21.5 kOhm; x1 reads A.e 332 from cores
    - workbook (pq50_xl.py): Res. Tank Design F43/F44/F45/F9 and
    Device Setting F24, logged in CHANGELOG_rev0_6; F9 (n 6.0134) is
    needed because lambda moves to 25/45
    Checks run in PQ50: builder 4 variants mismatches 0, check_sm OK,
    bom_compare 29/0, rtc_check OK and xl_sm_compare 145/145 on a
    LibreOffice-recalculated copy, check_theta 0, audit_dim 0.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
    [BACKUP_L6790_workbook_6to1.xlsx, L6790_spreadsheet_r1_0_corrected_rev0_6.xlsx, L6790_workbook_6to1.xlsx, L6790_workbook_7p5to1.xlsx, Transformer_Spec_6to1.xlsx, Transformer_Spec_7p5to1.xlsx, Transformer_Spec_7p5to1_x1.xlsx, Transformer_Spec_8to1.xlsx]
2026-09-30 PQ50: application note, figures and vendor spec on the PQ 50/50 transformer
    - cores.py: PQ 50/50 (B65981A / B65982E) geometry read from the TDK drawing,
    turn zones for the bow-tie back plate, one conductor per turn, round wire
    sizes; ETD 54 and E 60/22/16 removed
    - leakage_fem.py + fem2d.py: 2-D field solution of the drawn winding (halves,
    both shorted, gap, strand loss); leakage.py is no longer the reference on PQ
    - Leakage is specified per secondary half (what the tank sees); both-shorted
    is recorded
    - AN chapter 7, figures 44/45, insulation rows and vendor spec rewritten;
    no trace of the previous cores left in the note
    - R_T printed with its real digits (21.5, not 22); tolerance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
    [Transformer_Spec_7p5to1.xlsx, Transformer_Spec_7p5to1_x1.xlsx]
2026-09-30 PQ50: pin figure says which side it is seen from, outline from the data sheet
    - bobbin_outline.py reads the B65982E vector drawing (one data sheet page
    kept in generators/data) into bottom, front and top view outlines; its
    --check compares them with the printed dimensions
    - The numbered data sheet view is the bottom (pin side) view: it shows the
    pin ends and sits above the front view (first-angle projection)
    - Figure 45: schematic, side view with the two viewing directions, (A)
    bottom view as on the data sheet and (B) top view from the component
    side with left and right exchanged and the pins hidden
    - Pin note, AN pins paragraph and vendor spec state the viewing side;
    cores.PIN_X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
    [Transformer_Spec_7p5to1.xlsx, Transformer_Spec_7p5to1_x1.xlsx]
2026-09-30 PQ50: core-from-above as its own labelled figure; pin figure without side view
    - an_core_plan: the core seen from above to scale with its parts named,
    the whole NP1 winding as a ring under the plate, one turn coloured by
    what surrounds it, and the meaning of each colour and why the split
    matters for the leakage written beside it
    - cores.zone_pct(): whole per cents that sum to 100, used by the figure
    and the text (47 / 11 / 42)
    - The back plate's end point at the centre leg moves from the figure code
    to cores.MECH['neck'], checked against the databook core drawing (kept
    in generators/data)
    - Figure 44 keeps the section and the unrolled winding
    - Pin figure: the side view is replac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
2026-09-30 PQ50: pin figure without the reading guide; views titled bottom and top
    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
2026-09-30 PQ50: final review, round 1 - six wrong statements, four figure faults, wording
    Wrong for this design (left over from earlier tanks and cores):
    - Lshort in 6.10 and the symbol list now one secondary half at a time
    - the thinnest passing margin is picked from Table 8 (kPSR 1.051), not
    asserted as kRBZ
    - the oscillator design frequency is 1.5 x the highest operating
    frequency, capped by the specification; renamed f_sw,des
    - what 700 ns of idle time does is computed (the floor still clears fo)
    - the first measurement no longer claims the thinnest margin
    Figures: clipped note in the power-factor chain, fo box hiding the curve,
    "(b)" step name, "the gap shaded", "reactor".
    Wording shortened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
    [Transformer_Spec_7p5to1.xlsx, Transformer_Spec_7p5to1_x1.xlsx]
2026-09-30 PQ50: final review round 2 - vendor spec wording, table precision
    Every equation and calculation block of the English AN was recomputed;
    none disagreed. The figures not viewed in round 1 were checked.
    - Vendor spec: NP1 "15 Ts" -> "15 T"; note 32 now depends on the
    variant (single transformer: the reference construction sets item 3-2).
    - Tables: lambda 0.556, n 6.013, phase margin 49.6 deg, lN 100.5 mm in
    the first leakage estimate, fo 44.8 kHz in the spec summary.
    - HISTORY row 77.
    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
    [Transformer_Spec_7p5to1.xlsx, Transformer_Spec_7p5to1_x1.xlsx]
2026-10-01 Move the PQ50 and Lr14 study copies under archive/
    The root (E 60/22/16, Lr 11 uH) stays the canonical design. The two full
    project copies made for other core and tank studies move unchanged to
    archive/PQ50 and archive/Lr14, with archive/README.md saying what each
    is. Their scripts use paths relative to themselves and still run there.
    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
    [BACKUP_L6790_workbook_6to1.xlsx, L6790_spreadsheet_r1_0_corrected_rev0_6.xlsx, L6790_workbook_6to1.xlsx, L6790_workbook_7p5to1.xlsx, Transformer_Spec_6to1.xlsx, Transformer_Spec_7p5to1.xlsx, Transformer_Spec_7p5to1_x1.xlsx, Transformer_Spec_8to1.xlsx]
2026-10-01 Make the PQ 50/50 design the only design; delete the earlier ones
    The PQ50 copy becomes the repository root. The earlier root design
    (E 60/22/16, Lr 11 uH, with its Korean AN) and the Lr14 copy (ETD 54)
    are deleted; the last state with all three is tag
    archive/before-pq50-root. HISTORY already held every line of both.
    One design point remains, 7p5to1_x1 (one PQ 50/50, 15:2):
    - builder default and VARIANTS, spec builder and checker lists;
    PQ 40/40 (three-core placeholder) removed from cores.py
    - canonical sheet rebuilt from it (N.x 1, N.p 15, A.e 332; k.Ae 1.594,
    41/44) and byte-identical to Smath/variants/L6790A_7p5to1_x1.sm
    - variant sheets, workbooks and specs for 6:1, 8:1 and three-c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
    [BACKUP_L6790_workbook_6to1.xlsx, L6790_spreadsheet_r1_0_corrected_rev0_6.xlsx, L6790_workbook_6to1.xlsx, L6790_workbook_7p5to1.xlsx, L6790_workbook_7p5to1_x1.xlsx, Transformer_Spec_6to1.xlsx, Transformer_Spec_7p5to1.xlsx, Transformer_Spec_7p5to1_x1.xlsx]
2026-10-01 Korean AN: port the English V1.3 edition
    The Korean body was last matched to the English text of round 59
    (E 60 core). Of the 111 sections of the current English edition, 58 are
    unchanged since then and keep their Korean text; 45 changed sections
    carry the changes over; 8 new sections (transformer insulation, the
    auxiliary-winding VCC supply, and the PQ 50/50 core, winding, pins,
    insulation and flux sections of the design example) are written new.
    The figure, table and equation calls match the English edition key for
    key and in order (285 calls).
    - an_kr_body.py: Korean helpers for the insulation table rows, the
    700 ns idle-time sentence and the thinnest-margin sentence; particles
    after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
2026-10-01 Add gate drivers, primary MOSFET and SR controller to the design example
    The L6790A has no gate driver. The worked design now fits the parts the
    user named and checks them against their datasheets:
    - STO60N045DM9 primary switches, one per position. c.HB is built from
    C_oss eq. 897 pF (0-400 V charge over the corner bus): 3029 pF instead
    of the 800 pF pick. Q.ZVS1 still binds, so the tank is unchanged.
    kT.pri is 1.9 from the Fig. 10 vector curve. The standing device
    needs a heatsink.
    - Two L6498LD drivers. The internal bootstrap DMOS drops 14 V at f.Max,
    so an external diode is fitted. The start-up floor V.CC_floor of
    10.61 V comes from the floating-supply range. Also checked: dri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
    [L6790_spreadsheet_r1_0_corrected_rev0_6.xlsx, L6790_workbook_7p5to1_x1.xlsx, Transformer_Spec_7p5to1_x1.xlsx]
2026-10-01 AN: gate-drive and SR schematics in the design example (round 82)
    Figure 49 (7.18): L6790A to L6498LD, leg 1 in detail - external bootstrap
    diode, C_BOOT, gate resistors, Kelvin PGND to the low-side source, R_CS
    between the bridge return and the rectifier negative (L6790A block
    diagram), DRV_EN open; leg 2 as a box. Figure 50 (7.19): TEA2095TE on
    the centre-tap secondary, two MOSFETs per leg, one gate resistor each,
    separate drain and source sense lines. Notes on what ST's EVL6790_670W
    boards do (driver supply switched by DRV_EN, bootstrap series resistor,
    gate-source resistors, SR drain-sense resistors) and on the TEA2095TE
    supply from the 25 V output. an_figtext no longer reads an upper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
2026-10-02 Round 83 (in progress): MOSFET symbol, SR 12 V-class supply, whole-circuit schematic
    - schemx.mosfet: a plain switch draws its body diode in the device's own
    ink; the bulk arrow is a triangle in symbol units with its tip on the
    channel bar. Every figure using the symbol regenerated.
    - Sheet 14c.4: Zener follower feeding the TEA2095TE from V_out, band held
    at 12 V or more (15 V Zener, 13.55-15.05 V); sized for 150 mA, which
    bounds the SR MOSFET gate charge at 130.4 nC; ratings and the IC
    temperature it saves. C.VCC_hf added to the BOM.
    - AN 7.19 text, Figure 50 with the follower; new section "The whole
    circuit" with two schematic sheets (an_full_pri, an_full_sec), every
    value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
2026-10-02 SR MOSFET STL160N10F8 in the sheet, workbook and AN; AN rebuilt (round 83)
    - Sheet: R.dson_s25 3.2 mOhm (Table 3 max), K.Tsec 1.5 (Fig. 13 read from
    the vector curve, 1.504 at 125 C); SR conduction loss 5.71 -> 3.90 W.
    New checks k.RDSsec, k.VDSsec (100 V / 80 V) and k.QgSR: Q_g(sync)
    72 nC plus the Fig. 8 slope 7.96 nC/V to the 11.2 V drive = 81.6 nC
    against the 130.4 nC the SR supply follower allows; it then carries
    94.2 mA. C_iss per gate pin 10.8 nF.
    - Workbook: sr_xl.py sets Power Components C92, D96, D98 and logs them;
    a LibreOffice recalculated copy matches the sheet 145/145.
    - AN: new section "The SR MOSFETs: STL160N10F8" with its table, the SR
    supply paragraph with th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
    [L6790_spreadsheet_r1_0_corrected_rev0_6.xlsx, L6790_workbook_7p5to1_x1.xlsx]
2026-10-02 Round 84 (in progress): regulator heat, part numbers, LED rail, one-page schematic draft
    Sheet: 14c.5 heat in the two Zener followers and their Zeners at the f.Max
    bound (PHPT61003NY on a 6 cm2 collector pad, BZT52H-C15 on 1 cm2), 16.1b
    the LED rail V_Z as a TL431B shunt regulator (V_Z = V.R (1 + R.Z1/R.Z2)
    = 12.05 V), part numbers for every diode in the semiconductor table.
    Workbook CompensationNet&Check D14 follows V_Z (vz_xl.py, logged).
    Figure an_full: the whole converter on one landscape page, diodes at 0.8
    of the other symbols. Drawn for review; the note does not use it yet.
    Claude-Session: https://claude.ai/code/session_01L3H8N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
    [L6790_spreadsheet_r1_0_corrected_rev0_6.xlsx, L6790_workbook_7p5to1_x1.xlsx]
2026-10-02 Round 84 (in progress): one-page schematic redrawn, ES1J and 1N4148W, SR gate resistor
    Sheet: D.BS is ES1J (DS39406: 600 V, V.F 1.30 V max at 1 A replaces the
    assumed 1.0 V; k.VBO 1.209, k.VRbs 1.236, start-up floor 10.91 V, k.CVCC
    1.039). D.aux and D.byp are 1N4148W (DS30086) with current and heat rows
    in 14c.5. R.G_SR 0 ohm picked as on ST's SR board.
    Figure an_full: 12 x 8.7 in for a page of its own, blocks spread out,
    MOSFETs drawn larger with thinner strokes so the oxide gap and bulk arrow
    show, transformer turns 0.8 x and further from the core, flag circles
    0.8 x, values beside every part, DRV_EN / RT disable switches and a DRV_EN
    timing sketch. schemx.mosfet gains lws / arrow / ox (d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
2026-10-02 Round 84 (in progress): one-page schematic reworked after review
    Dropped the DRV_EN timing sketch and the legend notes; BR1 drawn as a
    diode bridge; NAUX with its dot (pin 4) at the bottom, straight down to
    ground; local grounds instead of rails; input stage compressed so the
    bridge, T1, the bootstrap columns, the V_CC regulator, the SR pairs and
    the SR follower get room. SR gate resistors sit at their own gates.
    MOSFETs larger with a longer bulk stub (schemx.mosfet wx) and BJTs with
    larger emitter arrows (_npn arrow); defaults unchanged elsewhere.
    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
2026-10-02 Round 84 (in progress): C_aux sized, schematic primary side spread out
    Sheet 14c.5: C.aux 10 uF / 50 V picked; sag over half a period at f.Min
    at the I.Daux bound 0.175 V, 14.6 x inside the follower's headroom at the
    end of hold-up; 1.63 x OVP2 on voltage.
    Figure an_full: primary power band taller and the controller, drivers
    and regulator moved into the free space below; NAUX back with pin 4 on
    top, its ground on a stub and a lead of its own; regulator parts spread
    20 %; pins 1 and 7 level; T1's name beside its core; pin numbers one rule.
    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
2026-10-02 Round 84 (in progress): aux column straight, SR stage tidied
    D_aux, R_BZ and D_Z in one column under NAUX pin 6, the node under D_aux
    feeding Q_VCC and C_aux; C_aux pulled back from the secondary. V_out
    leaves the centre tap on a short run and the feedback taps the rail
    further on. TEA2095TE: GDA level with leg A's gate resistors, GDB a
    bottom pin straight down to leg B; SR MOSFETs wider apart; leg-A drain
    bus lower so pin 7 no longer stands up; T1's name centred on its core.
    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
2026-10-02 Round 84 (in progress): straight runs, Kelvin SR sensing
    an_full: D_HV1 straight down into HVSU; C_aux to the left of the aux
    column; the secondary pair spans exactly what NP1 spans; V_out drops
    from the centre tap straight to R_I with the rail and the R_Z feed
    branching off it; feedback and LED rail parts spaced evenly. SR stage
    redrawn the usual way: leg A upright with its drain bus on top, leg B
    upside down with its drain bus below, the TEA2095TE between them, each
    DS/SS pair running straight across to the nearest MOSFET's drain lead
    and source node; source buses grounded at their far ends on leads.
    schemx.mosfet gains flip (drain at the bottom); default unchanged.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
2026-10-02 Round 84 (in progress): full schematic — SR Kelvin wires straight, secondary centred, V_Z rail spread, electrolytic symbols
    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
2026-10-02 Round 84 (in progress): full schematic — secondary and SR stage lower, T1 caption centred, one aux node, SR pitch wider
    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
2026-10-02 Round 84 (in progress): full schematic — SR stage mirrored, buses at the primary's wire heights, one secondary ground, NAUX ground stub doubled
    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
2026-10-02 Round 84 (in progress): full schematic — TEA2095TE title clear of its pins, electrolytic marks legible
    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
2026-10-02 Round 84 (in progress): full schematic — U1 wider, drivers smaller, SR stage taller, R_Z over R_Z1
    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
2026-10-02 Round 84 (in progress): full schematic — T1 as the line between the sides, Q_VCC left of its column, TEA2095TE supply pins top and bottom
    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
2026-10-02 Round 84 (in progress): full schematic — L_m/L_r caption, IC names outside the boxes, HVSU pin in from the edge, one pull-down switch form, Q4/Q5/Q6, drivers 20 % taller
    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
2026-10-02 Round 84 (in progress): full schematic — U2/U3/U7 names beside the boxes on two lines, Q6 label on its right
    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
2026-10-02 Round 84 (in progress): full schematic — U1 pins spread, supply pins centred on the boxes, rail voltages, SR caption under the MOSFETs, C_Z and R_F labels
    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
2026-10-02 Round 84 (in progress): full schematic — T1 and the aux regulator 1.4 left, TEA2095TE box wider with its name inside, short VCC run
    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
2026-10-02 Round 84 (in progress): full schematic — Q4A/Q4B with SFH617A-2, centre tap undotted, TEA2095TE box wider; sheet 19.6 designators as drawn
    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
2026-10-02 Round 84 (in progress): TEA2095TE VCC as a 10 ohm / 100 nF RC filter (sheet rows, both SR figures, AN text), TL431B for Q5 and Q6; every figure redrawn
    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
2026-10-02 README: check_sm figures after the RC-filter rows (regions 2464, 60 pages, 201 inputs)
    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
2026-10-02 Round 84 (in progress): full schematic — Q4B named, C_fx label at its symbol
    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
2026-10-03 Round 84 (in progress): 2.2 uF bulk beside C_SR at the TEA2095TE pin (k.SRpin 1.045), both SR figures, AN text; every figure redrawn
    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
2026-10-04 Round 84 (in progress): full schematic — SR supply RC filter drawn at the follower with room, a short net flag at U7's VCC pin
    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
2026-10-04 Round 84 (in progress): pass transistors Q_VCC / Q_SR to FZT651 (SOT-223, Diodes DS33149): sheet thermal rows, V_CEO check, table, schematic; every figure redrawn
    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
2026-10-04 Round 84 (in progress): full schematic — page 1.9 taller, U7's RC filter back beside the IC in the top band with room, follower back to a plain flag
    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
2026-10-04 Round 84 (in progress): full schematic — U7 RC-filter capacitors on leads off the run, label beside them
    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
2026-10-04 Round 84 (in progress): gate turn-off path D_G,off + R_G,off at every primary gate — sheet rows (peak and average current, fall time, driver share), full schematic (taller driver blocks), gate-drive 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
2026-10-04 Round 84 (in progress): gate turn-off branches spread out — full schematic: branch 2.0 under each gate run, run 4.3 long, diode and resistor a wire apart, R_G,off value under its resistor, driver pin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
2026-10-04 Round 84 (in progress): full schematic at the A4-landscape ratio — PNG 1.426 (text frame 672 x 471 pt); width 56.7 -> 61.9 with symbol multipliers held, the extra spread over the drivers (+1.0), the 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
2026-10-04 Round 84 (in progress): full schematic lettering 8.4/8.6 -> 9.1/9.3 pt (6.5 pt on the page at the 0.72 print scale), bold names 9.7; _ic gains pdy to lift side-pin numbers off the stub; R_T, R_SR, R_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
2026-10-04 Round 84: AN rebuilt (123 pages) — the whole circuit on one page turned 90 degrees (an_pdf.FigPage, caption up the margin; figcheck and an_check taught the turned page), gate turn-off path paragraph 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
2026-10-04 Round 84: Figure 50 redrawn from the whole-circuit SR stage — _sr_stage / _sr_follower / _kit shared by an_full and an_sr_ctrl (an_full pixel-identical after the split); the two-sheet an_full_pri / a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
2026-10-04 Round 84: full read of the English AN (124 pages) — Fig 20 legend off the traces, real arrows in Fig 12 and 26, Fig 45 trimmed of its blank margins, Conventions on their own page, V1.3 revision entry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
2026-10-04 Round 84: diode symbols measured on the printed page — new diode_survey.py (diodes now recorded by schem.diode, _diode_along and vdiode); Figures 15, 20 and 21 drew them at 7–10 pt against 16 pt in t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
2026-10-04 Round 84: symbol sizes second pass and one MOSFET symbol everywhere — Figures 20 and 21 keep their bridge at the enlarged size and draw the rest four fifths of it, Figure 3 likewise; Figure 1 and the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
    Claude-Session: https://claude.ai/code/se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
2026-10-04 Round 84: 7.7 says when the tank bucks and when it boosts — the crossing of f_r is where sin θ = M_pk, independent of load; Table 12 gains M_pk, the bucking window of line phase and its share; a para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
2026-10-04 Round 84: Korean edition carries every change of rounds 81–84 — the external gate-driver section, the I_drv,q / Q_g(V) / ln-form C_VCC derivation, the shunt-regulated V_Z, the fitted-part sections 7.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
2026-10-07 Restore the three-core test-board variant (5:2 x 3, old tank) from commit 0821491 as a frozen copy — sheet, workbook and vendor spec — with docs/THREE_CORE_BOARD.md giving its design point, per-unit 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
    [L6790_workbook_7p5to1.xlsx, Transformer_Spec_7p5to1.xlsx]
2026-10-07 Three-core spec: terminals back to the 26OP-LM83W approval-sheet naming (1-2 / 3-5 / 4-6 / a-b, tap at 4-5), no coil former named — the PQ 40/40 pin numbers had crept in from the AN pin figure on 202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
    [Transformer_Spec_7p5to1.xlsx]
2026-10-07 As-built spec for the three-core transformer the vendor wound: its pin numbers, wire and core drawing beside the frozen design point's measurements
    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
    [Transformer_Spec_7p5to1_asbuilt.xlsx]
2026-10-07 As-built three-core spec cut to one page: wire column gives the current the vendor's wire can carry at 4.5 A/mm2, bobbin and core pictures drawn after the vendor's, notes removed
    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
    [Transformer_Spec_7p5to1_asbuilt.xlsx]
2026-10-07 As-built spec: bobbin picture redrawn after the vendor's side view (8-pin block with slots and boss, flanges, tube, 4-pin block with feet); spec builder saved as asbuilt_spec.py
    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
    [Transformer_Spec_7p5to1_asbuilt.xlsx]
2026-10-09 Three-core board: workbook copy for a 200 W test with the measured transformers (L_r 5.7 uH, L_m 25.2 uH, n 6.773, C_r 100 nF and R_T 11 kOhm kept), written by measured200_xl.py
    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
    [L6790_workbook_7p5to1_measured_200W.xlsx]
2026-10-13 Three-core board: compensation proposal for the 34 mF output bank
    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
2026-10-13 Three-core board: R_T comparison baseline corrected (10k worse than 8.2k)
    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
2026-10-13 Three-core board: 90 Vac 200 W holds with R_T 6.8 kOhm
    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
2026-10-13 Three-core board: second board load-regulation note and divider trim
    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
2026-10-14 3-core board: record the 2026-10-14 bench result of the C_r/C_T/R_T retune (PF worse, output drops)
    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
2026-10-14 3-core board: FB-saturated power limit after the C_r retune points at ACP-soft; f_r/f_o is fixed by L_r/L_m
    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
2026-10-14 3-core board: ZCD 270k drops the output, 540k restores it (OVP1 power limit suspected)
    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
2026-10-14 3-core board: ZCD measured, aux ratio about 1.5, R_ZCD,H 390k
    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
2026-10-14 3-core board: R_T 9.1k / ZCD 360k+20pF as fitted, PF 0.98 at 110 Vac, no-load start-up spike record; opt copy marked superseded
    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
2026-10-15 3-core board: 230 Vac PF 0.7 candidates - HF ripple into the line (no EMI filter, HB bus ripple at f_sw) vs IC HB control; user sees dirty input current, worse at 220 V
    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
2026-10-15 3-core board: with a CLCLC EMI filter PF is 0.99 at 110 Vac and 0.96 at 220 Vac - the 0.7 was HF ripple
    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
2026-10-16 3-core board: 200 W bring-up test report read - f.Min 110 kHz confirmed, 230 V peak 253 kHz points at X7R C_r bias loss, real efficiency with 24.3 V out, ripple vs cap tolerance
    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
2026-10-16 3-core board: HB half-cycle asymmetry (HS 53 / LS 47, +7.5/-6.6 A) - candidates and the tests that separate them
    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
2026-10-16 3-core second winding: keeping 2 T (or 1 T) and lowering f.r is blocked by flux; switching loss is small and I.m is independent of f.r; the thin-core option is the re-centred 5:2 tank (68 nF film / 1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
2026-10-16 3-core second winding: 657.5 W loss budget - switching loss does not follow the load, halving f.sw buys 1.3-4 W and costs 5 W of core loss with a 2 T secondary; 110 V ceiling ~93 % (bridge + filter 1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
2026-10-16 3-core board: why 85 % at 200 W can read 92 % at 657.5 W - fixed losses (core, circulating current) are 19-25 W either way; the 6-12 W the model cannot explain decides whether the current board lands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
2026-10-16 3-core board: why the ST 240 W EVK reads 94/96 % - same loss model applied to its parts (60 V output, 91 mOhm at 2.9 A, I.m 2.6 A, R.g 1 ohm, core under 2 W); per-item shares against our 200 W board 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
2026-10-16 3-core board: the 13 %-point gap to the ST EVK split by item - half transformer (core loss, circulating current), half the 12 W only a measurement can place
    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
2026-10-17 3-core board: port the LGE copy of the old ST workbook (2026-10-16) into the rev0_6 bench copy - lge200_xl.py, 17 cells checked against the schematic, recalculated and compared with their Excel cache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
2026-10-17 3-core board: LGE workbook copy - ZCD lower resistor is 18 k + 1 k = 19 k (no discrepancy), c.HB set from the parts (2 x Coss(tr) + 2.2 nF snubber = 5229 pF) instead of the typed 500 pF
    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
2026-10-17 3-core board: LGE workbook copy - every MOSFET also carries a 150 pF drain-source snubber (N.C. on the schematic, fitted on the board), c.HB 5229 -> 5529 pF
    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
2026-10-17 3-core board: why the two 150 pF drain-source caps add at the midpoint; datasheet table values bound the Coss term to 2767-2820 pF at 245 V, so c.HB 5529 pF stays (at most 3 % conservative)
    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
2026-10-17 3-core board: is 5.5 nF at the midpoint normal - transition 154-195 ns against the IC's 40-420 ns adaptive dead-time window (ST EVK fills it at ~390 ns); only a liability when ZVS is lost, where the 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
2026-10-17 3-core board: LGE workbook copy - UPC1008G-LS04-R from the UTC datasheet (CTR 0.54/0.65 at the FB operating points, rank minimum), V.Z 14.5 V from the 12V_FB divider, C.F 2.3 uF, bridge label; with t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
2026-10-17 3-core board: LGE workbook copy - user decisions: 12V_FB divider 100 k (V.Z 11.74 V) and compensation 470 nF / 4.7 uF / 10 k; R.B 6.2 k verdict hinges on the opto LED V.F (1.45 V datasheet value fail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
2026-10-17 3-core third option: variant 7p5to1_x3m3 - three TDK ELP 43/10/28 flat cores, 5:2+2 kept, 193 kHz; the canonical normalised tank fails k.ZVS at this frequency (T.ZC scales 1/f, collapses within 1 ohm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
2026-10-17 3-core third option: the ST EVL6790_670W tank read from the mother-board schematic in EVB Schematic/ (3 x 33 nF = 99 nF, 11 / 22 uH, n 3.2 -> f.r 152.5 kHz, Q 0.74, corner margin +11 %); the HQ-norma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
2026-10-17 LG transformer core re-read: one unit holds two EE6405 sets (bobbin hole 8.5 x 68, bond area 3216 = 2 x 2 x 24 x 33.5), so the unit's effective A_e is 226 mm2 and the flux condition of 7p5to1_x3m3 is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
2026-10-18 Three-core third option: requirements-only vendor specification (no core, coil former or pin layout named) - build_trans_spec.py gets a nocore mode on a row cursor (one-transformer output unchanged c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
2026-10-18 Three-core requirements spec: sections 4 and 5 cut to one line an item (operating conditions f.sw / f.r / A_e / material, insulation six rows), the resonant-frequency line says the winding current is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
2026-10-18 Three-core notes: resonant capacitor in MLCC - X7R is what fails (1325 var at DF 1-2.5 % is 13-33 W, HB bias V_in/2 drops its capacitance 20-40 %), C0G 630 V 2220 in parallel works (peak 324 V at the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
2026-10-18 Three-core notes: the 200 W board's 47 nF 2S x 5P X7R array handles 280-440 var at 6.4 A rms, 1.27 A and 22 V rms a piece - its loss is 1.4-2.2 W at DF 0.5 %, 7-11 W at 2.5 %, unknown until a thermal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
2026-10-18 Three-core notes: the resonant capacitor the user specified is Würth 885342208026 (WCAP-CSMH 1206, 47 nF, 630 V, X7R, DF 2.5 % max at 1 kHz / 1 Vrms) - its datasheet carries no ESR, DC-bias or AC-vol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
2026-10-18 REDEXPERT curves of the Würth 885342208026 resonant capacitor (user-provided SVGs) read with redexpert_read.py: ESR 208 mOhm / DF 1.16 % at 194.5 kHz (small signal) -> the 200 W board's C_r array dis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
2026-10-18 Three-core notes: TDK C4532C0G2J473J320KA (1812, 47 nF, 630 V, C0G) as 2S x 3P = 70.5 nF for the resonant capacitor - TDK characteristic CSVs kept under Datasheet/: ESR 3 mOhm (DF 0.017 %) flat to 30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
2026-10-18 Three-core notes: TDK allowable-current, allowable-voltage and ripple-temperature-rise curves of C4532C0G2J473J320KA (user-provided CSVs kept under Datasheet/) against the 2S x 3P array - at 190 kHz 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
2026-10-18 Three-core requirements spec: no safety-insulation section (the customer's safety engineering writes it), operating conditions reduced to the frequency the windings see and the core area, the resonan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
2026-10-18 Three-core notes: the spec row's primary copper minimum follows the rebuilt current (2.9 mm2 at 3.75 A/mm2)
    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
2026-10-18 LG transformer core: the outline drawing measured at 600 dpi with its own 143.9 mm dimension shows a 66.9 mm core region (2 x 33.5) split exactly in the middle in both views, with one fixing-tape ban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
2026-10-18 LG 26OP-LM83W construction drawing from its approval sheet: one EE6405 pair, the two-pair exploded view with bobbin and windings, a to-scale top view, a width section (rail, secondary plates, partiti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
2026-10-18 Requirements spec builder: approval-sheet winding table instead of the conductor note; board notes for the 18 Oct schematic
    Requirements spec builder: an approval-sheet style winding table (terminal S -> F, turns, wire, location) replaces the conductor note - Litz 0.10 x 370 / 320 from the 2.9 / 2.5 mm2 copper, NAUX 0.40, NS2 and NS3 bifilar in the secondary section with NAUX beside them; winding currents move to the operating conditions. The spec files are not regenerated yet (awaiting the user); the one-transformer spec output is unchanged. Board notes: the 18 Oct schematic keeps the transformer polarity of datasheet Fig. 9, adds 150 pF D-S on all four FETs and R197 100 k; C115/C117 sit ac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
2026-10-18 Requirements spec: schematic diagram and winding table generated; start-up asymmetry and drive review in the board notes
    The x3m3 spec (English and Korean) now carries the approval-sheet schematic diagram (trans_diagram.py: primary row 1 a b 2 with the auxiliary inside NP1, secondary row 6 5 4 3, dots at the winding starts) above the winding table. The one-transformer spec is not regenerated and its builder output is unchanged.
    Board notes: the 110 Vac start-up zoom shows leg 1 at about 0.6 us high / 1.3-1.5 us low while leg 2 stays near 50/50 - read as the controller's demagnetization sensing (DS 5.2.3) stretching LOUT1 while ZCD is blind below about 2.7 V output; a half-bridge start hypot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
2026-10-18 Requirements spec reduced to values; gate-drive budget script
    The x3m3 spec (English and Korean) keeps the diagram, the winding table, one line on equivalent wire and one on the accepted leakage band, and five values under operating conditions; the winding-direction, centre-tap, terminal-source, section and condition notes are gone, the Korean edition writes Litz, bifilar and peak in English. The one-transformer spec output is unchanged.
    gate_budget.py compares the LGE board's drive network, the sheet's and a 1206 proposal at the start-up frequency and in run: gate delays against the dead time the controller can give, the window before the tank current reverses, the driver / resistor / diod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
2026-10-18 Gate drive at 18 V: keep 47 / 10 ohm in 1206, bootstrap 3.3 ohm; VCC sequencing and Kelvin-source PGND reviewed against the L6498LD and STO60N045DM9 datasheets
    The two datasheets the user supplied are added as input material. With their values the line-cycle average switching frequency of the x3m3 design (143-213 kHz) keeps a 47 ohm 1206 turn-on resistor at 54-78 % of 0.25 W and the driver at an upper bound of +36-50 K; a lower resistor moves the gate power into the driver, a higher one lets the node drift back during the start-up dead time, a higher turn-off resistor costs MOSFET turn-off loss. The first low-side pulse charges a 10 ohm x 100 nF bootstrap to 5.3-8.8 V, below the 9.1 V maximu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
2026-10-18 Board notes: AC-first start latches through ISEN disconnection; the HVSU is a 12/17 V hysteretic charger; the driver decoupling returns to SGND so the Kelvin source is bypassed
    With AC applied before the external VCC the controller starts from the HVSU while the drivers are unpowered, sees no ISEN or ZCD signal for seven cycles and latches; the HVSU then holds VCC at 4.5 mA so the latch outlives the later VCC. The power-up figure's sawtooth between VCCon and VCC_HVSUon shows the charger off above 17 V and on below 12 V, so a 15 V pre-bias that rose from zero most likely still charges to 17 V when AC arrives - one test decides. C65/C68 and C78/C80 return to VCC_GND, not to PGND, so the low-si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
2026-10-18 Board notes corrected: the start-up sawtooth sits just below VCCon (12 V is the re-enable level after the 120 ms timeout), C65/C78 already return the low-side gate pulses to the Kelvin source, and th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
    Two readings of the previous note were wrong and are corrected in place: the HVSU keeps VCC near VCCon during the 120 ms start-up with a shallow hysteresis and holds it at VCC_HVSUon only after the generator shuts down without an auxiliary supply; and the 10 uF driver capacitors sit between VCC and PGND, so the Kelvin loop is closed locally and no decoupling change is needed. The AC-first latch is reached about 14 us after the controller'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
2026-10-18 Board notes: consolidated action list for the bench board and the 670 W design
    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
2026-10-18 Board notes: RT-held start with a load switch on the driver rail - a timing problem of the present PNP switch, two workable arrangements
    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
2026-10-18 Board notes: AC first, VCC3 later, external EN releasing RT - workable, one datasheet gap to test
    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
2026-10-18 EVB Schematic: ST 240 W / 60 V EVK board and technical-marketing deck added as input material
    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
2026-10-18 엑셀 8개를 용도별 이름으로 — GUIDE_PQ50_657W / 3CORE_670W / BENCH_200W / ST_ORIGINAL
    - 가이드 워크북 · 사본 · 사양서, 3코어 670 W 사양서(영문 · 한국어),
    200 W 벤치 워크북 · 실물 사양서, ST 원본을 git mv
    - 스크립트 · 문서 36개의 경로 치환, 사양서 이름은 check_trans_spec.SPEC_FILE 로 모음
    - audit_md 의 지운 이름 목록에 옛 이름 추가, CLAUDE.md 에 이름 규칙, HISTORY 한 줄
    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
2026-10-18 가이드 워크북의 variants/ 바이트 사본 삭제
    - GUIDE_PQ50_657W_workbook_rev0_6_copy_unencrypted.xlsx 는 정본과 같은 바이트였고 읽는 스크립트가 없었다
    - pq50_xl · vz_xl · fet_xl · sr_xl 의 사본 복사 줄 제거
    - CLAUDE.md 의 사본 언급 정리, audit_md 지운 이름 목록, HISTORY 한 줄
    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
2026-10-18 3코어 670 W 워크북 — 가이드 워크북에 x3m3 탱크와 R_T
    - x3m3_xl.py: 가이드 워크북을 variants/3CORE_670W_workbook_unencrypted.xlsx 로 복사하고
    F9 n · F43 C_r · F44 L_r · F45 L_m · Device Setting F24 R_T 를 x3m3 시트의 입력값으로
    - LibreOffice 재계산 사본이 x3m3 시트와 xl_sm_compare 145/145, rtc_check OK
    - CLAUDE.md · README · THREE_CORE_BOARD · HISTORY 기록
    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
2026-10-18 3코어 670 W — LG 보드의 피드백 부품 · 출력 뱅크를 시트와 워크북에
    - 빌더: 출력 뱅크 · V_Z 분압 · 옵토 · R_B · 보상망을 변형 키로(가이드 시트는 바이트 동일)
    - x3m3: V_Z 11.74 V(100 k / 27 k) · UPC1008G-LS04-R(CTR 0.54 / 0.65, V_F 1.45)
    · R_B 5.23 k · 보상망 100 nF / 680 nF / 39 k · Rubycon PX 6800 µF/35 V × 16
    · ESR 50.7 mΩ(120 Hz tan δ 상한) · 세라믹 160 µF — 판정 71/75 그대로
    - x3m3_xl.py: 위 값과 h 37 mm · 옵토 이름을 워크북에, LibreOffice 재계산 사본 145/145
    Claude-Session: https://claude.ai/code/session_01L3H8Na8buSZY2uPpuuSkn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
2026-10-18 부하별 합성 탱크 피크(시트 §9b · 워크북 블록) · 670 W 에 LG 보드 부품 · 200 W 워크북 정렬
    - 빌더 §9b: 부하 0 · 25 · 50 · 75 % 마다 §8 3차식으로 f_sw 를 다시 풀어 자화 피크에
    부하 전류가 더해지는지(r.add) 판정, §14.1 에 부하별 OCP1 여유와 영점 교차 자화 바닥;
    l6790.sweep(load=0.25/0.5) 대조 2점 추가(mismatches 0). 0 % 의 MIN() 정밀도 문제는
    두 단계 클램프로
    - peak_xl.py: 같은 표를 세 워크북 Device Setting 116–141행에 살아 있는 수식으로;
    xl_sm_compare 8항목 추가 → 가이드 · x3m3 153/153
    - x3m3: c.HB 5529(Cpar 2600) · SR TPH3R70APL1 3.7 mΩ/1.9 · TL431G-AE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
2026-10-18 c.HB 5529 → 3329 pF — C115/C117 은 레그 양단이라 중점 용량이 아니다
    - x3m3 변형 Cpar 2600 → 400 pF(기생 100 + D–S 150 × 2); 시트 c.HB 3329, k.TT 1.95 · k.TTd 1.68
    - x3m3_xl: D46 3329 · D72 400; bench200_sync_xl 두 번째 패스로 200 W 워크북도 같은 값
    - x3m3 워크북 ↔ 시트 153/153 · rtc OK; 문서 정정
    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
2026-10-18 3코어 670 W 출력 뱅크 PX 6800 µF × 16 → 11, 보상망 150 nF / 1 µF / 27 k
    - 사용자: 16개는 못 쓴다. C_out 74.8 mF · 리플 4.8 % · 홀드업 13.3 ms 충족,
    개당 리플 전류 2.62 A rms 는 PX 정격(1.92 A @120 Hz, 2.21 A @≥10 kHz)을 넘는다 — 보드 온도 확인
    - 뱅크가 줄어 3차 고조파 6.0 % 가 되어 보상망을 영점 · 극 유지로 다시 키움(4.06 %, PM 49.2°)
    - 판정 71/75, x3m3 워크북 ↔ 시트 153/153
    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
2026-10-18 3코어 670 W 보상망 220 nF / 1.5 µF / 18 k — 3차 고조파 2.8 %, PM 48.9°, f_c 12.6 Hz
    - 사용자 선택(추천안). 영점 · 극 유지, 2fL 게인만 낮춤; 비교한 여섯 조합은 HISTORY
    - 시트 판정 71/75, 워크북 F93 · F94 · F95 갱신, 시트 ↔ 워크북 153/153
    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
2026-10-19 부하별 탱크 피크를 Res. Tank Design 70–79행으로 — 기존 양식, 결과 7줄
    - 사용자: 수식이 너무 많다, Res. Tank Design 에 기존 양식 유지하며 간단하게
    - 결과: I.Lm.pk · I.Lm.zc · ld.add(부하가 피크에 더해지기 시작하는 부하) · Ilr.pk 25/50/75/100 %
    - 중간 계산은 CC 59–74행(기존 블록 모양); Device Setting 116–141행 표는 제거
    - 세 워크북 재적용(670 W 는 x3m3_xl, 200 W 는 bench200_sync_xl 다시), 100 % 값 = D32
    - xl_sm_compare 매핑 새 위치로 — 가이드 · 670 W 153/153, rtc OK, bom 29/0
    Claude-Session: https://claude.ai/code/session_01L3H8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
2026-10-21 gate_budget: 200 W 보드 옵션(bench200) — 기동 515 kHz 를 지금 게이트 회로가 감당하는지
    - 입력은 200 W 워크북(F9 · F43–F45 · C_T · R_T · c.HB) + l6790.sweep(264 Vac HB)
    - 결과: 타이밍 · 드라이버 열 · 피크 전류 모두 감당; 약점은 부트 10 Ω 의 첫 HOUT 누락 가능과 R_on 0603 연속 정격
    - x3m3 에서 c.HB 에 D–S 300 pF 를 이중으로 더하던 줄 수정
    - THREE_CORE_BOARD · HISTORY · README 기록
    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
2026-10-21 gate_wave.py — 레그 전이 시간 영역 해석: 게이트 지연 · 밀러 · 스너버 · ZVS 여유
    - STO60N045DM9 그림 6(C_iss/C_oss/C_rss) · 그림 4(전달 특성)를 벡터로 읽어 data/ 에
    - L6498LD 출력 · 게이트 저항망 · 비선형 C · 바디 다이오드 · D–S 스너버 · 탱크를 LSODA 로
    - 200 W 보드: 차단 305–328 ns · 켜짐 +293–320 ns(IC 에지부터), ZVS 유지,
    데드타임 420 ns 에서 반전 여유 62–69 ns, 스너버 150 pF 로 dv/dt 반감(54 → 27 V/ns @230 Vac 기동)
    - README · CLAUDE.md · THREE_CORE_BOARD · HISTORY 기록
    Claude-Session: https://claude.ai/code/sessio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
2026-10-22 Power Components 121–208: 기동 조건 · 게이트 구동 · 부트스트랩 점검 블록(gate_xl.py, 세 워크북)
    출력 0 V 근처의 직렬 L_r–C_r 기동 전류 · OCP2 여유 · OCP1 없이 내려갈 최저 주파수 · dv/dt,
    그리고 gate_budget.py 와 같은 모델의 게이트 구동(Conf.DRV 1/2 · 외부 C.gs · 타이밍 · 손실 ·
    Miller · 부트스트랩)을 살아 있는 수식과 F열 Check 로. 테스트 리포트 기동 확대 파형 재판독 기록.
    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
2026-10-22 게이트 드라이버 선택을 스위치 섹션 안에(MOSFET 선택과 같은 양식) · 기동 조건은 Res. Tank Design 으로
    Power Components 76–82 스위치 게이트 데이터, 88–120 LLC Half Bridge Gate Driver Selection
    (부품 · 드라이버 데이터시트 값 · 게이트 회로망 추천/선정 · Check 5개 · 회로도). 행 삽입은
    xl_rows.py — 기존 셀 값 전부 동일 확인, 행 번호를 쓰는 도구를 새 번호로. 기동 I.su · k.su ·
    f.su.OCP1 은 Res. Tank Design 81–86.
    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
2026-10-22 게이트 드라이버 선택: 추천 · 허용 범위 · 판정 보강, 일반 회로도, 기동 OCP1 여유
    R.on/R.off/C.boot/R.boot/C.gs/V.drv 에 추천값(E 계열)과 허용 범위 OK/CHECK(G 열),
    드라이버 손실(≤ (Tj.max − Ta)/Rth) · 최대 주파수(f.SU ≤ f.max) · 자체 데드타임(t.DT) ·
    운전 데드타임 상한 판정 추가. 그림은 품번 없는 하프브리지 드라이버. 블록을 45행으로
    고정(옛 81–119행 → 133–171). Res. Tank Design 에 k.su.OCP1.
    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
2026-10-22 게이트 드라이버 섹션을 Device Setting 의 Min / Max / Select 양식으로 — 판정은 최종 값 여섯만
    허용 범위 열(G)과 칸마다의 판정을 없애고 X.max / X.min / Select X 행으로. k.tD ·
    V.g.su · V.bs.1 · k.Miller · P.drv · f.SU 만 OK/CHECK. V.drv 의 '추천 15 V' 제거.
    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
2026-10-22 게이트 드라이버: R.off 기준을 경로 저항으로(겹침 · 소프트 턴오프 · Miller), 한계 행과 Select 행 분리
    R.off 는 R.on 과 병렬이라 'R.off 최대'가 정의되지 않던 문제를 경로 저항 R.off.eff 의
    최대로 바꿈. R.off · C.gs · R.boot 에 별도 Select 행. 판정 일곱(R.off.eff · k.tD · V.g.su ·
    V.bs.1 · k.Miller · P.drv · f.SU ≤ 드라이버 f.max 와 L6790A 675 kHz). 블록 50행
    (옛 81–119행 → 138–176).
    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
2026-10-22 게이트 드라이버 선택: 다이오드 품번 · 데이터시트 값, V.drv 15 V, 기동 데드타임 창 · 게이트 전류 · 드라이버 정격 · 다이오드 여유 판정
    부트 · 턴오프 다이오드를 품번 행 + V.F · V.RRM · I.F · I.FSM 으로. R.on.min 에 소스 전류 한계,
    R.off.min · R.boot.min(서지) 추가. 판정 12: k.IG · R.off.eff · k.tD · k.tD.su · V.g.su · V.bs.1 ·
    k.Miller · k.drv · P.drv · f.SU · k.D.boot · k.D.off. 블록 90행(옛 81–119행 → 178–216).
    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
2026-10-22 게이트 드라이버: R.on/R.off 최소 기준 셋(온도 · 전류 · 루프 감쇠), C.gs.max, V.gs 정격, 드라이버 Ta 행, R.so/R.si 표시
    R.on.min 이 0 인 이유를 식으로 드러냄(L6498 의 R.so 10.7 Ω 이 세 기준을 다 덮는다).
    C.gs 상한(선정 R.on 으로 펄스 안에 10 V), V.drv.max 에 MOSFET V.gs.max, 겹침 기준은
    상대쪽 V.th.min, R.on.max 는 짧은 쪽 펄스. 스위치 블록 8행(옛 81–119행 → 179–217).
    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
2026-10-22 게이트 드라이버: 출력 저항 입력 칸, 빈 행 2씩, BOM 탭 게이트 부품 표, ST 원본 EMF 그림 셋 복원
    R.o.src/R.o.sink(0 = V.test/I 로 유도), L.loop · V.bus 행 제거, 섹션 앞뒤 빈 행 2(옛 81–119행 →
    177–215). BOM&Schematics 91–105 에 드라이버 · 다이오드 품번과 게이트 회로망 값. restore_emf_xl.py 가
    Device Setting I19 · I108, BOM C62 의 EMF 를 원본에서 되살림.
    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
2026-10-22 게이트 드라이버: 출력 저항을 Value(유도) / Selected(데이터시트) 한 행으로, BOM 탭에 회로도
    R.o.src · R.o.sink 를 시트 양식대로 한 행에(Value = V.test/I, Selected = 데이터시트 값), 결과의
    R.so · R.si 중복 행 제거. 회로도 드라이버를 U.drv1 로 하고 BOM&Schematics I91 에도 넣음.
    옛 81–119행 → 175–213.
    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
2026-10-22 워크북 전체 검토: 부트 다이오드 식 통일(R.boot + 0.5 Ω), V.OH 상수화, I.su 보호, 라벨 정정
    재계산 사본에서 모든 수식 셀 점검(오류 0). R.boot.min 과 k.D.boot 의 모순을 다이오드 동저항
    가정을 CC 상수로 꺼내 다섯 식에 같이 적용해 해소. 기존 셀 전부 동일, xl_sm_compare 153/153.
    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
2026-10-22 게이트 드라이버 섹션 라벨을 시트 어투로 짧게(최장 110 → 57자), 이름 셋 단축
    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
2026-10-22 게이트 드라이버 · 기동 검사의 SMath 쌍둥이 시트 — build_gate_smath.py → Smath/tools/L6790A_gatedrive.sm
    워크북(gate_xl.py)의 Power Components 76–83 · 89–174, Res. Tank Design 81–87 을
    같은 식 · 같은 이름으로 10절 347 리전에. 선정값 여섯은 먼저 넣고 한계를 뒤에서
    대조(SMath 는 위에서 아래로). E12/E6 반올림과 IF 분기는 반올림 전 값 + 고정 분기,
    한계를 바꾸는 IF 둘은 abs() 계단으로 재현. 빌더 자체 검사: LibreOffice 재계산
    가이드 워크북 값 82개 전부 일치. MIN/MAX 보조 함수는 인자 · 결과를 괄호로 감싼다
    (괄호 없는 형태로는 12칸이 조용히 틀렸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
2026-10-22 게이트 드라이버 · 기동 SMath 시트를 3코어 670 W 입력으로 — L6790A_gatedrive_x3m3.sm, 드라이버는 "이번 빌드" 값 블록으로
    build_gate_smath.py 에 변형 표(x3m3 기본 · guide)와 워크북별 대조표. 3코어 재계산
    워크북 값 82개와 전부 일치. 드라이버 · 다이오드 절은 품번 고정이 아니라 데이터시트
    값 블록(제목에 이번 빌드 L6498LD · ES1J · 1N4148W 만 표시, 값은 전부 노란 입력).
    가이드 입력으로 만든 첫 판 L6790A_gatedrive.sm 은 지움(인자 guide 로 재생성 가능).
    Claude-Session: https://claude.ai/code/session_01L3H8Na8buS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
2026-10-27 200 W 벤치 기동 링잉 후속(10-26·27) 기록 — 입력 필터 6.5 MHz, 기동 ±30 A, C_T 330 p / R_T 13 k, R_CS 증가
    게이트 입력 RLC 필터가 6.5 MHz(VDS 링과 같음)에서 ×0.40 뿐이라 효과가 작았던 이유,
    필터 강화를 하지 않는 이유(L6498 문턱 비대칭으로 데드타임 손실), 110 Vac 기동 ±30 A
    측정과 기동 주파수 상향, 그 뒤 R_on 47 Ω 의 기동 게이트 판정, R_CS 증가의 해석과
    200 W 한정 범위, 미결 항목.
    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
2026-10-27 무부하 AC 기동 VDS 피크 230 Vac 650 V · 110 Vac 280 V 기록과 해석(2 × 버스, 국부 용량 대 Q_rr)
    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
2026-11-02 양전압 게이트 구동 드라이버 손실 · 전류 SMath 시트 — build_gatepower_smath.py → Smath/tools/Gate_Driver_Power_Unipolar.sm
    올린 계산 시트와 같은 입력 · 결과를 재현하고, 게이트 전력을 드라이버 · 외부 R_g · 내부 R_G 로
    나눠 드라이버 몫만 발열로 보는 행, C.eq = Q_g/V 타이밍, 정지 전류 · 채널 수 · 저항 손실 ·
    T_j,max 여유를 추가. check_sm OK, 자체 검사 mismatches 0.
    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
2026-11-02 README · HISTORY: 업로드 파일 이름을 경로 표기에서 빼기(audit_md)
    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
2026-11-02 게이트 구동 손실 시트를 단일 출력 핀(STGAP3SXS) 회로망으로 — R_g,on 과 D_off + R_g,off 병렬
    턴오프 테브난(R_eff, V_eff), 다이오드 · R_g,on 가지 피크 전류, 다이오드 경로 하강 시간,
    다이오드 손실과 부품별 손실 합 검산, 드라이버 · 다이오드 정격 여유. STGAP3SXS 데이터시트를
    못 읽어 드라이버 칸은 [TBD DS] 자리값. check_sm OK, 자체 검사 mismatches 0.
    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
2026-11-02 게이트 구동 손실 시트: 설계에 없는 비교 줄 둘 삭제(다이오드 없는 하강 시간, C_iss 상승 시간)과 C_iss 입력
    사용자: 다이오드와 R_g,off 가 없는 경우는 없다. 자체 검사는 t.r 로 대조, mismatches 0.
    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
2026-11-02 게이트 구동 손실 시트를 STGAP3SXS 데이터시트(DS14758 Rev 3) · 평가 보드(DB5386 Rev 2) 값으로
    드라이버 출력 저항 · 단락 전류 · VH/VDD 정지 전류 · CLAMPdrv · VH UVLO · f_SW 최대 ·
    R_thJA 를 데이터시트에서, 회로망 예제를 평가 보드에서. 로직측 VDD 손실 · Miller 클램프
    프리드라이버 손실 · UVLO/주파수 판정 · 미사용 기능 연결 주석 추가. 턴오프 다이오드
    (STPS2L40ZFY) V_F · I_FSM 은 데이터시트가 없어 TBD. check_sm OK, mismatches 0.
    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
2026-11-02 STGAP3SXS 게이트 구동 손실 시트를 필요한 항목만으로 줄임 (161 → 71 리전)
    입력 · 피크 전류 · 상승/하강 · 손실 · 접합 온도만 남기고, 중간값은 접힌 블록에 pack 으로
    정의(Sheet.set 은 .sm 에 정의를 쓰지 않아 SMath 에서 미정의가 됨). 모든 피연산자가 사용 전
    정의됨을 확인. check_sm OK, mismatches 0.
    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
2026-11-02 STGAP3SXS 게이트 구동 시트를 SiC 하프브리지 모듈 값으로, 0 V 오프 Miller 판정 추가
    Q_g 0 -> 18 V 1200 nC(그림 16 에서 읽음), 회로망 예제 3.3 / 4.7 Ω + 다이오드(드라이버 최소
    7 A 안). Miller: Q_gd 391 nC / 43 ns 로 오프 게이트 약 8.7 V 상승, V_th 최소 1.9 V 대비 0.22.
    모듈 내부 R_G 와 f_sw 는 TBD. check_sm OK, mismatches 0, 미정의 변수 0.
    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
2026-11-02 STGAP3SXS 게이트 구동 시트: 버스 400 V 기준, 라벨 앞 [DS] 등 꼬리표 제거
    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
2026-11-02 STGAP3SXS 게이트 구동 시트: 평가 보드 회로망(22 Ω · 2.2 Ω + D)으로 복원, +19 / −4.7 V, Q_g 1419 nC
    사용자 지적: 회로도의 저항을 임의로 바꾸지 말 것, 19 V / −4.7 V 구동. Q_g 는 표 3 꺾임점으로
    −4.7 -> 19 V 1419 nC(0 -> 19 V 는 1252 nC). 전압 폭 V.H − V.L 로 전력 · 전류 · 시간 · Miller
    여유를 계산. 파일 이름 STGAP3SXS_Gate_Driver_Power.sm. check_sm OK, mismatches 0, 미정의 0.
    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
2026-11-02 STGAP3SXS 게이트 구동 시트: 버스 800 V 기준(Q_gd · dv/dt 와 같은 조건), HISTORY 의 옛 경로 표기 정리
    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
